wachi-yoshitaka-11-dev/deskcat/crates/README.md

# 共通Rust crate

このディレクトリには、host workspace用のlibraryを置く。

| crate | 責務 | 状態 |
|---|---|---|
| [`deskcat-protocol`](deskcat-protocol/README.md) | ESP32–Pi間のmessage型、serialization、byte列からの上限付き受信 | 作成済み（#9、#10） |
| [`deskcat-serial`](deskcat-serial/README.md) | host側のserial session。上限付きI/O、切断の観測、再接続の上限とrate limit、上限のある送信queue。**実deviceのopenは含まない** | 作成済み（#11） |
| [`deskcat-face`](deskcat-face/src/lib.rs) | `set_expression`の表情の図形（矩形の列）、受理の判定の順序、帯への分け方。LCDもSPIも知らない | 作成済み（#21） |
| [`deskcat-tap`](deskcat-tap/src/lib.rs) | ADXL345のtap検出の設定値（レジスタへ書く(address, 値)の列）、`INT_SOURCE`の読み方、`tapped`を送ってよいかの判定（boot ACK後だけ、最小間隔、製品buildはタッチの接触中と直後は送らず、見つけたtapを短く保留して接触が始まれば捨てる）。I2Cを知らない | 作成済み（#21） |
| [`deskcat-accel`](deskcat-accel/src/lib.rs) | ADXL345の連続測定（±2 g・100 Hz・FIFO Stream）の設定値（レジスタへ書く(address, 値)の列）、FIFO_STATUSとINT_SOURCEの読み方、3軸の復号、窓ごとの統計。I2Cを知らない | 作成済み（#15） |
| [`deskcat-touch`](deskcat-touch/src/lib.rs) | XPT2046の制御byteと3 byte応答の復号、raw sampleの列から触れた・離れた・撫でのeventを導く状態機械（しきい値は呼び出し側が渡す。値を持たない）。SPIを知らない | 作成済み（#14。製品buildが状態機械で撫でを判定する（#21）） |
| [`deskcat-domain`](deskcat-domain/README.md) | 感情、接触event、行動判断、純粋ロジック | 作成済み（#491） |
| `deskcat-config` | 型付き設定と検証 | 予定 |
| `deskcat-api` | 文章生成の境界とfallback動作 | 予定 |
| `deskcat-storage` | snapshot、event log、rotation、復旧 | 予定 |

各Cargo packageは、最初の着手可能なIssueを実装するときに作成する。作成したcrateはroot `Cargo.toml`の`members`へ追加する。
