wachi-yoshitaka-11-dev/deskcat/docs/hardware/README.md

# ハードウェア文書

このディレクトリは、softwareとfirmwareが必要とするハードウェア情報の正式な定義元である。

正式文書:

- `hardware-bom.md`
- `gpio-assignment.md`
- `power-budget.md`
- `servo-safety-limits.md`
- `sensor-datasheet-notes.md`
- `sd-health-check.md`
- `enclosure-and-neck.md`（#34 の設計案。方式は選定済み。現物適合は未了）
- `led-514-demo.md`（#514 の LED デモ回路案。実機での点灯試験の観察は experiment-log.md の EXP-025。継続通信の判定と赤 LED の経路は未実装）
- `experiment-log.md`（実験記録）
- `tbd-register.md`（未確定項目と解決状況の正本）

正確な部品型番、公式資料、記録済み実測値だけを使用する。不明値は`TBD`とする。

top-levelの`hardware/`は、回路図、PCB source、機構CADなど、version管理する設計sourceが存在する場合に使用する。
