wachi-yoshitaka-11-dev/deskcat/firmware/esp32/README.md

# ESP32 firmware

このディレクトリには、ESP-WROOM-32D開発ボード（秋月電子 M-13628）用のRust firmwareを置く。基板裏面silkscreenは`ESP32_DevKitc_V4`である（2026-08-15に大文字小文字を訂正。旧記載 `ESP32_DevkitC_V4`）。

専用のESP-IDF/Xtensa toolchainを使用するため、rootのhost workspaceとは別のCargo workspaceとする。

責務:

- LCD
- touch、加速度、環境sensor
- サーボPWMと強制安全上限
- JSON Lines通信
- watchdog、reset reason、診断、fail-safe動作

## 現在の状態

Issue #5 でtoolchainを固定し、最小projectのclean buildを確認した。既定の製品build（featureなし）は、Pi link、heartbeat／health snapshot、`ACCEL-01`のID読み出しとtap検出、`ENV-01`の周期測定と`environment`の送出（同じI2C busを共有する。`src/env_report.rs`）、LCDの表情描画、タッチの撫での判定を1つのmain loopで扱う（#487、#21）。表情とtapの動作は、それぞれ`face-21`と`tap-21`の試験buildから製品経路へ接続した。列挙した試験featureを指定すると試験構成を選び、従来の`tap-21,face-21,bringup-display-13`のデモを含め、各featureが有効にするI/Oは従来どおりである（ただし、`bringup-display-13`か`face-21`を含む構成は`TOUCH-CS`（GPIO21）をHighに保つ。下の「build構成と通電」の表の注記）。`bringup-i2c-15-16`は、以前のfeatureなしbuildと同じ、LCDに触れないセンサー単体試験である。構成の一覧は`src/main.rs`のmodule doc「buildの構成」節が持つ。

LCDのpinは`docs/hardware/gpio-assignment.md`の`信号inventory`が正本である。製品buildと`face-21`試験buildはLCDを初期化し、backlightを点けたまま`set_expression`の表情を描く。Pi commandを受けなくても、描ける状態になった時点で`neutral`を1回描く。`bringup-display-13`試験buildは単色fillと四隅patternを1段ずつ描く（`src/display_test.rs`）。その試験のflash・通電・目視結果は`docs/hardware/experiment-log.md`の`EXP-016`〜`EXP-018`にあるが、現在の段階描画経路と製品経路は実機で確認していない。`ACCEL-01`／`ENV-01`のID読み出しは既存のI2C driverを使う。`env-sample-16`試験buildと製品buildが、BME280のID一致後に補正係数とraw値を読み、測定設定を書いて補償値をUART0にlogする（製品buildは60 sごとに測り、session確立後に`environment`をPiへ送る。`src/env_report.rs`）。製品buildと`tap-21`試験buildは、ADXL345のIDが一致した場合だけ設定を書き、tapを検出する。`SERVO-PWM`、`ADC-*`は製品buildでは駆動しない。`TOUCH-*`は、`TOUCH-CS`（GPIO21）でLCDと同じbusのタッチを読み、撫でを判定する。`TOUCH-IRQ`（GPIO34）は使わない（下の「build構成と通電」の表の注記）。servoの安全gateは[servo-safety-limits.md](../../docs/hardware/servo-safety-limits.md)が持つ。製品buildの通電は、[Power Budget](../../docs/hardware/power-budget.md)の`製品build（featureなし）の通電の条件`が`TBD`として持つ（通電不可）。下の「build構成と通電」の表の「通電」欄は、その結果である。

`crate::led`（[#514](https://github.com/wachi-yoshitaka-11-dev/deskcat/issues/514)）は`LED-COMM`（GPIO2）と`LED-REACT`（GPIO5）を駆動する。**既定の製品buildは、起動時に両pinを出力にして消灯側へ設定し、白（GPIO2）を1秒周期で点滅させ、Piの`set_expression`で`happy`を受理したら赤（GPIO5）を1秒点ける。**LEDの2枝を配線していない台では、pinを駆動しても電流の流れる先が無い。`bringup-led-514` featureを付けた試験buildは、その前に点灯試験（赤→白→両方）を行う。`bringup-display-13`とも組み合わせられる。**白を通信成立で点灯へ切り替える判定は無い。**`BootSession::is_established`は`boot`のACKで一度立つと、Piが止まっても下りない。点灯に使うと通信喪失を示せないため、喪失を決める時間の値（`PROTO-TBD-010`／`HW-TBD-017`が未確定）が決まるまで、白は点滅のままである。赤の`happy`点灯は、`pi_link`が受理した`set_expression`だけで点く（LCDを描けない状態では拒否されるため点かない）。**この製品buildの動作は、build-onlyの確認までで、実機で動かした記録は無い。**配線と試験の手順は[led-514-demo.md](../../docs/hardware/led-514-demo.md)が持つ。実機での点灯の観察は[EXP-025](../../docs/hardware/experiment-log.md#exp-025-追加ledの点灯試験赤だけ白だけ両方)にある。

heartbeat と health snapshot は、いずれのbuildでもloopが動き続け、ESP logger の log にのみ出す（どのbuildでも出る。[#487](https://github.com/wachi-yoshitaka-11-dev/deskcat/issues/487)より前の`pi-protocol-mode`はloggingを止めており、出力されなかった。`src/console.rs`参照）。**「log へ出す」は「serial へ出ない」ではない。**logger の出力は UART0（USB）を通って serial monitor に現れる。送らないのは、protocol の message として application の serial link（#11）へ流すことである。周期は `src/config.rs` が持ち、**いずれも暫定値である**（Protocol §5.7 が heartbeat の interval を `TBD` としているため、一次資料の根拠が無い）。health snapshot は `crates/deskcat-protocol` の `Status` を組み立てて JSON 1 行として出す。**`ProtocolCounters` はすべて 0 のままである。**いずれのbuildにも`ProtocolCounters`を増やす経路が無いためである（`src/health.rs`のmodule doc参照）。

`src/protocol.rs`の`PiSession`は`hello`のsession遷移、`ping`／`get_status`への応答、`stale_session`の判定を実装し、`crates/deskcat-serial/src/peer.rs`（Pi側、Issue #12）と対になる。Pi linkを持つbuildでは、`src/pi_link.rs`の`PiLink`がPi linkのUARTから受けた行をdecodeし、`hello`／`ping`／`get_status`をこの型へ渡して応答を書き、`boot`のACKを`BootSession`へ渡す（#487）。**Pi linkはGPIOのUARTである**（`PI-UART-TX`＝GPIO13、`PI-UART-RX`＝GPIO14。pinと接続の条件の正は[gpio-assignment.md](../../docs/hardware/gpio-assignment.md)の`Pi–ESP32間のtransport`節）。`bench-servo-test-17`を有効にするbuild（`bench-servo-90-17`を含む）以外のすべてのbuild（既定buildを含む）が、UART0以外のUART（UART1）をこの2本へ割り当てて使う（[#487](https://github.com/wachi-yoshitaka-11-dev/deskcat/issues/487)。`bench-servo-test-17`のbuildは、#17の測定用buildとしてPi linkを持たない）。**既定buildも起動のたびにGPIO13をTXとして駆動し、既定buildでもJTAG debugは使えない**（gpio-assignment.mdの`PI-UART-TX`行）。**UART0（board上のUSB-UARTブリッジ、GPIO1／GPIO3）は書き込みとdebug logに使う。**例外として、`bench-servo-test-17`を有効にするbuild（`bench-servo-90-17`を含む）は、servoを動かす前に人間が入力する確認の語をstdin（UART0）から読む（[#17](https://github.com/wachi-yoshitaka-11-dev/deskcat/issues/17)。`src/main.rs`の`wait_for_bench_confirmation`）。`touch-sample-14`の試験buildも、操作の区切りの`MARK`をstdin（UART0）から別threadで読む（[#14](https://github.com/wachi-yoshitaka-11-dev/deskcat/issues/14)、`src/touch.rs`。Pi linkのUARTではない）。`debug-motion-19`の試験build（製品buildには入らない）も、`MOTION <name> <target>`の行をstdin（UART0）から別threadで読む（[#19](https://github.com/wachi-yoshitaka-11-dev/deskcat/issues/19)、`src/debug_motion.rs`。Pi linkのUARTではない）。#487より前は、UART0をbuild時のfeatureでdebug logとPi–ESP32 protocol streamのどちらかへ排他的に使っていた。詳細は`docs/protocol/esp32-pi-protocol.md`§2、`src/console.rs`参照。Pi linkを持つbuildは、`src/boot_session.rs`の`BootSession`が`boot`のACK待ち・再送・`stale_session`受信時の`sid`選び直しを行い（[#446](https://github.com/wachi-yoshitaka-11-dev/deskcat/issues/446) PR B）、受信の異常（ring bufferの満杯など）を数えてhealth snapshotの行へ出す（#487）。**Piとつないでよい場面と条件は、gpio-assignment.mdの`信号線をつないでよい条件`が持つ**（とくに条件3（つないでよい試験）と条件5（給電の構成）。ここへ書き写さない。protocolの既知の制約は`src/console.rs`）。**host testと実機での動作確認はまだ無いため、session確立の成立は主張しない**（確かめていないことは`src/pi_link.rs`のmodule doc「確かめていないこと」）。`sid`の生成方法は`src/main.rs`の`generate_sid`が決める（`PROTO-TBD-011`のうち生成方法を部分解決。PR A）。この型（`PiSession`）自体は生成方法を持たない。

| 項目 | 確定版 |
|---|---|
| Crate | `deskcat-esp32` |
| Rust target | `xtensa-esp32-espidf` |
| Rust channel | `esp-1.95.0.0`（Xtensa Rust 1.95.0.0） |
| ESP-IDF | `v5.5.3`（tools install dirは`workspace`） |
| linker | `ldproxy` |

採用根拠と確定条件は[ESP32 Rust toolchain](../../docs/toolchains/esp32-rust-toolchain.md)、導入手順は[ESP32開発端末セットアップ](../../docs/runbooks/esp32-development-machine-setup.md)、実測環境は[Version Record](../../docs/toolchains/version-records/2026-08-06-esp32-build-linux.md)にある。

## Build

**commandの正本は[検証済みコマンド](../../docs/toolchains/verified-commands.md)である。**
ESP32 Build profileの端末で、このディレクトリにて実行する。**ここへcommandを写さない**（[ADR-0018](../../docs/decisions/0018-instruction-file-structure.md)）。

`export-esp.sh`を読み込まないと失敗する。`ESP_IDF_TOOLS_INSTALL_DIR=workspace`のため、ESP-IDF本体とmanaged toolは`.embuild/`（約4.4 GB）へ展開される。`.embuild/`と`target/`は`.gitignore`で除外し、applicationの`Cargo.lock`は追跡する。

環境に`IDF_PATH`が設定されていると、`.cargo/config.toml`で選んだESP-IDF versionを上書きする。`[env]`の`force = true`はこの変数を保護できないため、**`build.rs`が設定を検出してbuildを止める。**意図した外部SDKを使う場合だけ`DESKCAT_ALLOW_EXTERNAL_IDF_PATH=1`（値は厳密に`1`。`0`や`false`では通らない）を設定して通し、出力される`cargo:warning`をVersion Recordの`IDF_PATH present`へ記録する。

**止めるのが`build.rs`とは限らない。**`IDF_PATH`の指す先が実在しない場合は、依存の`esp-idf-sys`が先に別のerror（`could not determine esp-idf version from ...`）で失敗する。どちらでもbuildは止まるが、`build.rs`のguardのmessageは出ない。実測は[Version Record](../../docs/toolchains/version-records/2026-08-06-esp32-build-linux.md)にある。

## host crateの再利用

`deskcat-protocol`、`deskcat-servo`、`deskcat-face`、`deskcat-accel`、`deskcat-tap`、`deskcat-env`、`deskcat-touch`をpath dependencyで使う。wire protocolの実装、
servoのhard limitとtrajectory limitingの実装、`set_expression`の表情の図形と受理の判定の順序、`accel-sample-15`のADXL345連続測定の設定値と復号・統計、tap検出の設定値と`tapped`の送出条件、BME280の生値と補正係数からの補償計算、`touch-sample-14`のXPT2046の制御byteと応答の復号を、
それぞれhostのtestとfirmwareで1つに保つためである。
判断の記録は[ADR-0008](../../docs/decisions/0008-firmware-protocol-crate-reuse.md)にある
（`deskcat-servo`、`deskcat-face`、`deskcat-tap`、`deskcat-accel`、`deskcat-touch`は同ADRの追記。`deskcat-env`には同ADRの追記が無い）。

```toml
deskcat-protocol = { path = "../../crates/deskcat-protocol" }
deskcat-servo = { path = "../../crates/deskcat-servo" }
deskcat-face = { path = "../../crates/deskcat-face" }
deskcat-accel = { path = "../../crates/deskcat-accel" }
deskcat-tap = { path = "../../crates/deskcat-tap" }
deskcat-env = { path = "../../crates/deskcat-env" }
deskcat-touch = { path = "../../crates/deskcat-touch" }
```

- root workspaceの`exclude = ["firmware/esp32"]`は**維持する。**lockfileはroot `Cargo.lock`と
  このディレクトリの`Cargo.lock`の2つに分かれたままでよい。
- **共有crateの`rust-version`は、host（1.97.1）とESP toolchain（rustc 1.95.0-nightly）の
  両方を満たす下限にしてある。**`crates/deskcat-protocol/Cargo.toml`、
  `crates/deskcat-servo/Cargo.toml`、`crates/deskcat-face/Cargo.toml`、`crates/deskcat-accel/Cargo.toml`、`crates/deskcat-tap/Cargo.toml`、`crates/deskcat-env/Cargo.toml`、`crates/deskcat-touch/Cargo.toml`が理由込みで宣言している。
  ここを上げるとfirmwareのbuildが`rustc 1.95.0-nightly is not supported`でcompile前に止まる。
- `crates/deskcat-protocol/**`、`crates/deskcat-servo/**`、`crates/deskcat-face/**`、`crates/deskcat-accel/**`、`crates/deskcat-tap/**`、`crates/deskcat-env/**`、`crates/deskcat-touch/**`の変更でも
  `.github/workflows/firmware.yml`が発火する。
  host側だけの変更でfirmware buildが壊れるのを検知するためである。
- `bench-servo-test-17`付きのbuildを除くbuildで、`src/servo.rs`を通って角度を出せるのは、同fileの`LimitedServo`だけである。`bench-servo-test-17`付きのbuildは、`Sg90::move_to_angle_once`でlimiterを通らずに1回動かす（`src/servo.rs`のmodule docの例外段落）。
  `bench-servo-test-17`単独の指令角は規約上の105度、派生の`bench-servo-90-17`は規約上の90度である。実機の機械的中央は未確認（`HW-TBD-010`）。buildと実行の条件は[servo-safety-limits.md](../../docs/hardware/servo-safety-limits.md#初回動作の実行手順人間とaiの作業順序)に従う。
  `Sg90`と`deskcat-servo`の`Limiter`を1つずつ所有し、`Limiter`も`Setpoint`も受理済みのtargetも
  外から受け取らず、`tick`の間隔を自分で測る。**成立の条件**（`bench-servo-test-17`の経路を除く、
  `LedcDriver`を直接作る経路は型では止められない、`unsafe`を使わない）は同fileのmodule docにある。
  **既定buildの`main()`はservoを駆動しない。**
  limiterへ渡す値（可動域、速度、加速度等）はどれも未確定であり、firmwareはまだ持たない。

`src/health.rs`がこのcrateの`Status`と`ProtocolCounters`を組み立てる。ただし**送信はしない。**
serial deviceは[#11](https://github.com/wachi-yoshitaka-11-dev/deskcat/issues/11)、
session stateとserial taskの配線は
[#12](https://github.com/wachi-yoshitaka-11-dev/deskcat/issues/12)の担当である。
現時点で示せているのは、固定toolchainで`xtensa-esp32-espidf`向けにcross compileできること、
および同crateの`status` payloadを実機上でserializeできることまでで、
**共有fixtureへの合格は主張しない。**

実機でのserializeの証拠は
[Version Recordの「2026-08-25 再検証」](../../docs/toolchains/version-records/2026-08-20-esp32-flash-boot-native.md)
にある（`status` payloadのJSON 1行と`serialize失敗 0`）。**同記録の2026-08-20の確認とは別である。**
そちらが示したのは#6の起動出力とchip名までであり、`deskcat-protocol`を呼んでいなかった。

## build構成と通電

**この表にある組み合わせについて、どのfeatureの組み合わせが、何に触れ、何を書き、通電してよいかは、この表が持つ。**表に無い組み合わせは、表の下の注記を参照する。他の文書はこの表を参照だけで指し、
build構成の説明を書き写さない（featureの一覧と、各featureが足すものは`src/main.rs`のmodule doc「buildの構成」節）。
通電の手順と条件は[Power Budget](../../docs/hardware/power-budget.md)が正本であり（`ACCEL-01`／`ENV-01`単体bring-upの手順の条件(2)は`bringup-i2c-15-16`単独、`DISP-01`追加接続の手順の条件(2)は`bringup-display-13`付きbuildを要求する。featureなしの製品buildは、同書の別の節が`TBD`を持つ）、この表の「通電」欄は、その条件を各構成に当てた結果である。

| build構成（`--features`） | LCD・backlight | ADXL345へ書く | BME280へ書く | Piへ送る | 通電（Power Budgetの手順） | 値の所在 |
|---|---|---|---|---|---|---|
| （既定・製品） | 初期化と点灯。点けたまま表情を描く。**LCDとタッチは`SpiDriver`を共有し、busは転送ごとに取る。**タッチ（`X`・`Y`・`Z1`）を20 msごとに読み、状態機械で撫でを判定する | **ADXL345のDevice IDが`0xE5`のときだけ書く**。INT線を使わず`INT_SOURCE`をI2Cで読む | **Chip IDが`0x60`のときだけ書く**（`ctrl_hum`、`ctrl_meas`。forced・×1・IIR off。60 sごとに1回測る。`src/env_report.rs`） | `boot`、ACK、`status`、`tapped`・`shaken`（IDが一致した場合）、`head_touched`（撫でと判定した場合）、`environment`（測れた量だけ。session確立後） | **不可**（`TBD`。`touch panel`の駆動電流の上界が無い。Power Budgetの`製品build（featureなし）の通電の条件`） | `crates/deskcat-face`、`crates/deskcat-tap`、`crates/deskcat-touch`、`crates/deskcat-env`、`src/touch.rs`（撫での判定の値）、`src/led.rs`（GPIO2／GPIO5。白の点滅と、`happy`を受理したときの赤の1秒点灯。上の`crate::led`の段落） |
| `no-touch-487`（単独。既定・製品の変種） | 初期化と点灯。点けたまま表情を描く（既定・製品と同じ）。**タッチは読まない** | 既定・製品と同じ | 既定・製品と同じ | 既定・製品と同じ。ただし`head_touched`は送らない | **可**（`DISP-01`追加接続の手順のうち、当てるものはPower Budgetの節が挙げる。LEDは駆動しない（GPIO2・GPIO5に触れない）。条件(7)の承認は実行する日。Power Budgetの`touchを読まない製品build（no-touch-487）の通電の条件`。実機では動かしていない） | `crates/deskcat-face`、`crates/deskcat-tap`、`crates/deskcat-env`、`src/touch.rs`の`IdleTouch` |
| `bringup-i2c-15-16` | 触れない | 書かない（Device IDを読むだけ） | 書かない（Chip IDを読むだけ） | `boot`、ACK、`status` | `ACCEL-01`／`ENV-01`単体bring-upの手順で可 | — |
| `env-sample-16`（単独） | 触れない | 書かない（Device IDを読むだけ） | **Chip IDが`0x60`のときだけ** `ctrl_hum` と `ctrl_meas` へ書き、forced測定を1回行う。raw・補償値・fault件数と、変換の所要時間（`env_conversion`）はUART0へlog | `boot`、ACK、`status`（センサー値は載せない） | **不可**（新しい書き込みを含む構成の通電手順と承認は未確定） | `crates/deskcat-env` |
| `env-sample-16-slow`（単独。`env-sample-16`を含む） | 触れない | 書かない（Device IDを読むだけ） | 上と同じ。ただしoversamplingを温度・気圧・湿度とも×16にして変換を遅くする | 上と同じ | **不可**（実機未確認） | `crates/deskcat-env` |
| `env-sample-16-repeat`（単独。`env-sample-16-slow`を含む） | 触れない | 書かない（Device IDを読むだけ） | 上と同じ（×16）。ただし変換を、最初の変換の開始から30秒、130 ms周期で繰り返す（`ctrl_meas`への書き込みも毎回）。`env_conversion`は毎回（`seq`・`started_ms`付き）、`env_raw`・`env_reading`は1回目だけ、終了時に`env_repeat_done`をUART0へlog | 上と同じ | **不可**（実機未確認） | `crates/deskcat-env` |
| `accel-sample-15`（単独） | 触れない | **Device IDが`0xE5`のときだけ**、`POWER_CTL`・`INT_ENABLE`（tapを止める）・`BW_RATE`・`DATA_FORMAT`・`FIFO_CTL`へ書き、±2 g・100 Hzの連続測定を始める。FIFOを読み、raw値と窓ごとの統計をUART0へlog | 書かない（Chip IDを読むだけ） | `boot`、ACK、`status`（センサー値は載せない） | **不可**（新しい書き込みを含む構成の通電手順と承認は未確定。2026-10-17にユーザーが承認した1回の通電が[EXP-033](../../docs/hardware/experiment-log.md#exp-033-accel-01adxl345の静止sampleaccel-sample-15の初回通電)にあり、この表の可否を変えない） | `crates/deskcat-accel`、`crates/deskcat-tap`（`INT_SOURCE`のaddress） |
| `touch-sample-14`（単独） | 初期化しない。`LCD-CS`（GPIO22）をHighに固定するだけ | 書かない（Device IDを読むだけ） | 書かない（Chip IDを読むだけ） | `boot`、ACK、`status` | **不可**（`EXP-038`はこの表の「不可」のまま、条件6つを満たさずにユーザーの承認を得て1回書き込んだ。touch用5本は`EXP-041`の終わりに足した状態のまま（同記録の「終わりの状態」）で、その後の現物は確認していない。`EXP-041`も同じく「不可」のまま、ユーザーの承認を得て1回書き込んだ。実機に書き込んだのはdevelop `79f29ea`の版（`EXP-038`）とdevelop `b9a04e8`の版（`EXP-041`。`T_IRQ`の変化と`MARK`のlog、busの持ち方の置き換えを含む）である。Power Budgetにこの構成の手順が無い。LCD module上のXPT2046はLCDのVCCで動くため、LCDのVCCを抜いたまま起動しない。実機側でユーザーの新たな承認が要る） | `crates/deskcat-touch`、`src/touch.rs` |
| `touch-lcd-14`（単独） | 初期化と点灯。表情を帯ごとに塗り続ける。**LCDとタッチは`SpiDriver`を共有し、busは転送ごとに取る**（製品buildも同じ型。握り続ける型は`touch-sample-14`だけ） | 書かない（Device IDを読むだけ） | 書かない（Chip IDを読むだけ） | `boot`、ACK、`status`。`set_expression`は`hardware_unavailable`で拒否する | **不可**（`EXP-041`はこの表の「不可」のまま、ユーザーの承認を得て1回書き込んだ（develop `b9a04e8`の版）。LCDのVCC・9本・touch用5本が挿さった構成の手順と承認が要る。Power Budgetにこの構成の手順が無い） | `crates/deskcat-touch`、`crates/deskcat-face`、`src/touch_lcd.rs` |
| `debug-motion-19`（単独。製品buildには入らない） | 触れない | 書かない（Device IDを読むだけ） | 書かない（Chip IDを読むだけ） | `boot`、ACK、`status`。UART0のconsoleから読んだ`MOTION <name> <target>`は、servoを駆動せず、catalogが空のため全て拒否する。`set_expression`は`hardware_unavailable`で拒否する | **不可**（Power Budgetにこの構成の手順が無い。実機では動かしていない） | `src/debug_motion.rs`、`crates/deskcat-servo` |
| `bringup-display-13` | 初期化と点灯。fillと四隅patternの後に消灯 | 書かない | 書かない | 同上 | `DISP-01`追加接続の手順で可 | — |
| `face-21` | 初期化と点灯。点けたまま表情を描く | 書かない | 書かない | 同上。`set_expression`に受理のACKを返しうる | **不可**（`ACCEL-01`／`ENV-01`単体の手順は`bringup-i2c-15-16`単独限定、`DISP-01`の手順は`bringup-display-13`必須） | `crates/deskcat-face` |
| `face-21,bringup-display-13` | bring-upの後も点灯のまま表情を描く（bring-upの間は`set_expression`を`busy`で拒否） | 書かない | 書かない | 同上 | `DISP-01`追加接続の手順で可（条件(7)の承認は実行する日） | `crates/deskcat-face` |
| `tap-21` | 触れない | **ADXL345のDevice IDが`0xE5`のときだけ書く**（`deskcat_tap::shake::registers`。`SHAKE`が`Some`なら8件。一致しなければ何も書かず、Device IDを読むだけ）。INT線は使わず`INT_SOURCE`をI2Cで読む | 書かない | `boot`、ACK、`status`、`tapped`・`shaken`（Device IDが`0xE5`でなければどちらも送らない） | **不可**（`ACCEL-01`／`ENV-01`単体の手順は`bringup-i2c-15-16`単独限定） | `crates/deskcat-tap` |
| `mem-probe-23,face-21,tap-21`（#23の計測用。製品buildと同じ構成（タッチの撫での判定と`ENV-01`の周期測定・`environment`の送出を除く）にlogを足す） | 初期化と点灯。点けたまま表情を描く（製品buildと同じ）。タッチは読まない（製品buildと違う） | **ADXL345のDevice IDが`0xE5`のときだけ書く**（製品buildと同じ） | 書かない（Chip IDを読むだけ） | `boot`、ACK、`status`、`tapped`・`shaken`（IDが一致した場合）。`show_text`と`set_expression`を受理する。`environment`は送らない（周期測定は製品buildだけ） | **不可**（`DISP-01`追加接続の手順の条件(2)は`bringup-display-13`を要求し、製品buildの節（Power Budgetの`製品build（featureなし）の通電の条件`。`TBD`）の対象でもない。この構成の通電は、ユーザーの承認が要る） | `src/mem_probe.rs`。health snapshotと同じ周期（10秒）で、空きheap、起動からの最小の空きheap、main taskのstackのhigh water markを1行logへ出す。**この構成だけが`unsafe`を持つ**（`main.rs`の先頭の`cfg_attr`。製品buildは`forbid(unsafe_code)`のまま） |
| `tap-21,face-21,bringup-display-13`（デモ用） | `face-21,bringup-display-13`と同じ | `tap-21`と同じ（Device IDが`0xE5`のときだけ書く） | 書かない | 上の全部。ただし`head_touched`と`environment`は送らない（撫での判定と`ENV-01`の周期測定・送出は既定・製品だけ） | `DISP-01`追加接続の手順で可（条件(7)の承認は実行する日） | `crates/deskcat-face`、`crates/deskcat-tap` |

**LCDを点けるbuild（既定・製品と、`bringup-display-13`か`face-21`を含む構成）は、`TOUCH-CS`（GPIO21）をHighに保つ**（転送の間だけLowにする）。この段の構成のうちタッチを読むのは既定・製品だけで（`src/touch.rs`の`StrokeDetector`。`no-touch-487`付きは`IdleTouch`で読まない）、`bringup-display-13`か`face-21`を含む構成は読まない（`IdleTouch`）。`touch-sample-14`・`touch-lcd-14`は別の型でタッチを読む（上の表）。GPIO21には外部10 kΩのpull-upがあり、High はその電気的な状態と同じ側である。

この表に無い組み合わせ（`bringup-led-514`、`bench-servo-test-17`・`bench-servo-90-17`（`bench-servo-test-17`を含む）、`debug-motion-19`と`face-21`・`tap-21`・`bringup-display-13`との組み合わせなど）は対象外であり、この表は通電の可否を決めていない。`bringup-led-514`は、2026-10-12にユーザーが承認した条件（LEDの2枝を足して通電すること。書き込みと各回の通電）で、ESP32単体へ通電した。承認と観察は[led-514-demo.md](../../docs/hardware/led-514-demo.md)と[EXP-025](../../docs/hardware/experiment-log.md#exp-025-追加ledの点灯試験赤だけ白だけ両方)にある。
`tap-21`が足す負荷（測定modeの`ACCEL-01`の約140 µA typ）の扱いは、Power Budgetの`face-21`の常時点灯の段落が持つ。
**揺れ（`shaken`。Protocol §4.3a、#685）の検出は、`deskcat_tap::shake::SHAKE`の暫定の値で有効になる**（値と根拠、確かめていないことは`deskcat_tap::shake`が持つ。`None`なら有効にならず、Activityを設定せず、`shaken`も送らない）。実機で`shaken`がPiへ届くことは確かめていない。
デモのジェスチャは、`tap-21`では「撫でる」ではなく「指で、ADXL345のモジュールを軽く叩く」である（閾値の根拠は`crates/deskcat-tap`）。

## 未確定の前提

機種と搭載moduleは確定している（ESP-WROOM-32D開発ボード／秋月電子 M-13628。基板にrevision表示は無い）。根拠は[hardware-bom.md](../../docs/hardware/hardware-bom.md)のMCU-01である。

**公式pin表と現物pin表記の照合は2026-08-15に完了し、[HW-TBD-001](../../docs/hardware/tbd-register.md)はcloseした**（38pinヘッダ両側のsilkが公式`J2`／`J3`と19pin×2列すべてで一致した）。照合先は[ESP32-DevKitC V4公式回路図](https://dl.espressif.com/dl/schematics/esp32_devkitc_v4-sch.pdf)と公式guideのpin description表である（秋月商品ページの添付はモジュールとチップのdatasheetのみで、boardのpin配列表を含まない）。GPIO割り当ては[gpio-assignment.md](../../docs/hardware/gpio-assignment.md)の`信号inventory`に従う。**中核chipの識別（`HW-TBD-031`）は2026-08-20に満たした。**中核chipは半田付けされた金属シールドの内側にあり刻印を読めないため、要件は2026-08-15にesptoolの報告で満たす形へ再定義され（[esp32-rust-toolchain.md](../../docs/toolchains/esp32-rust-toolchain.md)の`chip識別の満たし方`）、#6のflash時に`esptool`が`ESP32-D0WD`を報告した。**値と未加工の出力はそちらとVersion Recordが持ち、ここへ再掲しない。**

ESP-WROOM-32D datasheet v2.7にはPSRAM内蔵variantの記載が無いため、PSRAMを前提とする設定は不要である。

**flash、serial monitor、実機起動は2026-08-20に#6で実施した**（記録は[Version Record](../../docs/toolchains/version-records/2026-08-20-esp32-flash-boot-native.md)）。**確認したのは起動出力とchip名までであり、周辺回路とservoには触れていない。****USB抜き差しによる電源再投入後の起動出力は未検証である**（host側のserial portがUSB enumerate後にしか存在せず、その時点で起動出力が終わっているため。再現は`espflash`のresetによる4回で示した）。

**Issue #13の`DISP-01`driverのこの版そのものは、ESP32 Build profile端末でのbuild確認までである**（書き込んだのは`EXP-018`のB2である。driver（`src/display.rs`）は、B2と同じcommandの列を送る版として`EXP-018`の後にcommitしたものであり、それ自体は書き込んでいない。#487からbring-upの描画は帯ごとにCASET／PASET／RAMWRを送るため、bring-up全体として送るcommandの列はB2と同じではなく、実機では動かしていない）。flash・実機通電はESP32 Flash / HIL profile端末と人間の監視を要する（[Hardware Safety Policy](../../docs/governance/hardware-safety-policy.md)、初回通電）。実機での結果（単色fillの色、color order、四隅と向き、更新timing。controllerのIDは読まない）は`docs/hardware/experiment-log.md`の`EXP-016`〜`EXP-018`にある。
