wachi-yoshitaka-11-dev/deskcat/crates/deskcat-storage/README.md

# deskcat-storage

感情snapshot、event log、発話履歴、rotation、atomic update、破損復旧を扱う永続化libraryとして計画している。

Raspberry Piのストレージに適した書込み量を維持する。
