wachi-yoshitaka-11-dev/deskcat/docs/hardware/sensor-datasheet-notes.md

# Sensor and Display Datasheet Notes

> 状態: Blocked — 正確なmoduleの現物確認が必要
> 正本とする情報: Driverに必要な、データシート由来のdevice動作
>
> **公開specから確定する欄は2026-08-10に埋めた。**残る`TBD`は次のいずれかである。
> (a) 現物確認が要るもの（jumper状態、address、backlight回路）。**touch controller型番は2026-08-13に`XPT2046`と確定した**、**backlight回路は2026-09-05に`U1`の3本足（入力／GND／出力）を確定し、`LED` pinが公式User Manualの定める制御信号線であることも確認した。ただしLEDへの給電ライン（`VCC`側か`U1`出力側か）は引き続き未確定。LED個数はカプトンテープに隠れ非分解では未確認のまま残る**、
> (b) メーカーが公開していないもの（MSP2807のSPI mode／max clock、初期化sequence、消費電流）、
> (c) bench試験で決めるもの。**推定で埋めない**（[AGENTS.md](../../AGENTS.md) 推測禁止）。

## 使用方法

物理moduleごとに一つのsectionを完成させる。ICのデータシートとmodule board文書の両方を記録する。候補例をもとにsectionを埋めない。

各文書について次を記録する。

- メーカー
- 正確なmodelとsuffix
- 文書名
- Revision／date
- 公式URL
- 関連page／table
- Module回路図／pinout
- 現物識別の根拠

## LCD module

出典: メーカーdatasheet [`msp2807.pdf`](https://akizukidenshi.com/goodsaffix/msp2807.pdf)（[秋月商品ページ](https://akizukidenshi.com/catalog/g/g116265/) 添付、revision表記なし）、
[LCD Wiki MSP2807](http://www.lcdwiki.com/2.8inch_SPI_Module_ILI9341_SKU:MSP2807)。2026-08-10取得。
controllerの挙動は`ILI9341 Datasheet V1.13`（Ilitek、2011-08-05）による。2026-08-12取得。
**Ilitek公式の配布先は見つかっていないため、[Adafruitがhostする版](https://cdn-shop.adafruit.com/datasheets/ILI9341.pdf)を開いた**
（PDF metadataのTitleが`ILI9341_DS_V1.13_20110805.doc`。245page）。**mirrorであり、公式配布物との同一性は確認していない。**

> **module datasheetとcontroller datasheetが矛盾する箇所がある**（`DC/RS`の極性）。
> **その1箇所については後者を正とする。**理由は下表の`Data／command動作`欄に記す。

| 項目 | 値 |
|---|---|
| Module識別情報 | MSP2807（touch付。touch無しは MSP2806）。PCB 50.0×86.0 mm、AA 43.2×57.6 mm（datasheet記載のまま） |
| Controller IC | `ILI9341` |
| 解像度 | **現物silkは`2.8 TFT SPI 240X320 V1.2`である**（2026-08-13確認。パネルは`HSD028309 A2`）。[hardware-bom.md](hardware-bom.md) DISP-01の`240×320`と一致する。**一方メーカーdatasheetの表記は`320×240`で向きが逆である。**向きの取り方の違いと思われる。**firmwareは横向き（論理座標320×240、MADCTL `0x28`）を基準にする**（[experiment-log.md](experiment-log.md)の`EXP-018`。下の`対応orientation command`行） |
| Color format／order | RGB 65K color（16 bit/pixel、RGB565）。**2つを分けて記録する。**(1) byte order: 1 pixelを上位byteから送る（big-endian）。`0xF800`（赤）・`0x07E0`（緑）・`0x001F`（青）が、それぞれ赤・緑・青に表示された（[experiment-log.md](experiment-log.md)の`EXP-018`の写真）。(2) 色の並び: **BGR**。MADCTL（36h）の`BGR`（B3）が0のままでは赤と青が入れ替わり（`EXP-016`）、`BGR=1`で正しい色になった（`EXP-017`の目視、`EXP-018`の写真） |
| Interface | 4-wire SPI（14pin。LCDとtouchでbusを共有し、CSを分ける） |
| 供給電圧 | VCC 3.3–5 V |
| Logic電圧 | **3.3 V TTL**。`hardware-bom.md` DISP-01のとおり、5 V給電時の出力levelがメーカー資料で不明なため3.3 V給電とする |
| SPI mode／max clock | TBD（datasheetに記載なし。**現物のbench試験で確認する**） |
| Reset polarity／timing | polarityは**low activeでreset**（`RESET` pin）。timingはTBD |
| Chip-select timing | `CS`は**low activeで有効**。timingはTBD |
| Data／command動作 | `DC/RS` pin。**`low`＝command、`high`＝data。**`ILI9341 Datasheet V1.13`が`When DCX = '1', data is selected. When DCX = '0', command is selected.`と定め、4-line serial interfaceの節も`If the D/CX bit is "low", the transmission byte is interpreted as a command byte`と一致する。**MSP2807のメーカーdatasheetは`high level: register, low level: data`と逆に記載しているが、この値は採らない。**`DC/RS`はcontrollerの`D/CX`へ直結し、送出byteの解釈を決めるのはILI9341であるためである（この表の`Controller IC`欄のとおり、本moduleのcontrollerはILI9341である）。**現物での確認はLCD bring-up（[#13](https://github.com/wachi-yoshitaka-11-dev/deskcat/issues/13)）のbench試験で行う** |
| Backlight回路／電流／polarity | polarityは**highで点灯**（datasheet記載）。**回路と電流は未公開**であり、datasheetの`Power Consumption`欄は`TBD`と印字されている。**`LED` pinは公式User Manual（LCDWIKI、`2.8inch_SPI_Module_MSP2807_User_Manual_EN.pdf`、Interface Description表、Pin 8）が「LCD backlight control signal (high level lighting, if you do not need control, please connect 3.3V)」と定めており、電源ラインではなく制御信号線である。**`akizukidenshi.com`配布の`msp2807.pdf`（`Power Consumption`欄が`TBD`）とは別文書であり、2026-09-05に新たに参照した。**2026-09-05に現物の非通電導通測定を行った。**`LED` pinと`VCC` pinの間は導通なし（オーバーレンジ）であることを確認した。`U1`（3.3V LDO、刻印`662K`／`UMW S4T`）の3本足を識別した: 1本は`VCC`と導通（入力側）、1本は`GND`と導通（安定した再測定で確認）、残る1本はどちらとも非導通（出力側、消去法）。`LED` pinは、`VCC`および`U1`の3本の足のいずれとも導通しない（オーバーレンジ）ことを確認した。**これは`LED` pinが上記の通り制御信号線であることと整合する。****実際の物理LEDへ電力を供給しているライン（`R5`の先）が`VCC`側か`U1`出力側かの特定は試みたが、決められなかった。**`R5`（6.8Ω、部品が小さく確実にプローブを当てられない）の両脚は`VCC`・`U1`出力側のいずれとも非導通と読めたが、部品サイズから読み取りの信頼性が低い。代わりに`Q1`（SOT-23、刻印`J3Y`）の3本足で`VCC`・`U1`出力側との導通を試みたが、3本とも両方に非導通だった。**`Q1`はトランジスタであり、非通電・単純な抵抗測定では接合の向き次第で導通を示さないため、この方法では判定できないと判断した。**したがって、backlightのLED給電経路が`VCC`側か`U1`出力側かは、非通電の導通測定では確定できないと結論する。LED個数と、`R5`／`R6`／`Q1`／`J1`を経た正確な電流経路はパネル端のカプトンテープに隠れており未確認のまま（分解を要するため確認しない）。**配線方法はここに書かない。**配線規則の正本は[power-budget.md](power-budget.md)であり、ここへ再掲しない。接続可否と阻害対象の現在状態は[HW-TBD-024](tbd-register.md#hw-tbd-024)、[以前の接続判断の記述](tbd-register-history.md#sensor文書の接続判断の旧記述)を参照する |
| 初期化sequence | TBD（datasheetに記載なし） |
| 対応orientation command | MADCTL（36h、`ILI9341 Datasheet` §8.2.29の`MY`／`MX`／`MV`）。DeskCatの判定の向き（横向き320×240、14 pinの`J2`のheaderを右の辺。[#13の判断(2)](https://github.com/wachi-yoshitaka-11-dev/deskcat/issues/13#issuecomment-5860773100)）では**`0x28`**（`MV=1`、`BGR=1`、他は0）で、論理座標の原点が左上、`x`が右、`y`が下へ増える。`MV=0`で描いた生の座標の向きから§9.3（p.208）の表で決め、`0x28`で四隅が一致することを写真で確かめた（`EXP-018`）。値の置き場所は`firmware/esp32/src/display.rs`の`MADCTL_LANDSCAPE`。**[#34](https://github.com/wachi-yoshitaka-11-dev/deskcat/issues/34)の仮筐体で頭への載せ方が決まったら見直す** |
| Readback機能 | `SDO(MISO)`あり。**read機能が不要なら未接続でよい**とdatasheetが明記。**実機では、IDの読み出しが期待する値を返さなかった**（D3hは`EXP-016`〜`EXP-018`、DAh〜DChは`EXP-018`。`EXP-018`ではすべて`00`）。firmwareは読み出しを行わない（`firmware/esp32/src/display.rs`のmodule doc） |
| 電源投入後に必要なdelay | TBD |
| 動作／保存温度 | 動作 -20〜60 ℃、保存 -30〜70 ℃ |
| Driver／library候補 | TBD |

### pin定義（datasheet記載、14pin）

| No. | ラベル | 説明 |
|---|---|---|
| 1 | `VCC` | 5V／3.3V power input |
| 2 | `GND` | Ground |
| 3 | `CS` | LCD chip select（low有効） |
| 4 | `RESET` | LCD reset（low有効） |
| 5 | `DC/RS` | command（`low`）／data（`high`）選択。**メーカーdatasheetの14pin表は逆に記載している**（上表`Data／command動作`欄を参照） |
| 6 | `SDI(MOSI)` | SPI write |
| 7 | `SCK` | SPI clock |
| 8 | `LED` | backlight制御（high点灯） |
| 9 | `SDO(MISO)` | SPI read（不要なら未接続可） |
| 10 | `T_CLK` | touch SPI clock |
| 11 | `T_CS` | touch chip select（low有効） |
| 12 | `T_DIN` | touch SPI input |
| 13 | `T_DO` | touch SPI output |
| 14 | `T_IRQ` | touch割り込み（touch検出時low） |

### pin定義（LCDWiki公式User Manual原文、9pin。touch用5pinを除く）

**上のpin定義表はメーカーdatasheet（`msp2807.pdf`）を出典とする。**この節は同じ9pinについて、
**別文書であるLCDWiki公式User Manual**（`2.8inch_SPI_Module_MSP2807_User_Manual_EN.pdf`、
sha256 `0e0d3e57ca24213841907d845e509545819ec7303f0f43584c521a3f57a1d72c`。`Backlight回路／電流／polarity`行が
2026-09-16取得として既に引用しているものと同一file。**2026-09-22に再取得し、sha256の一致で
同一性を確認した**）の`Interface Description`表（3〜4ページ）を、原文のまま並べる。
**記憶で埋めず、資料の記載だけを根拠にする（[#13](https://github.com/wachi-yoshitaka-11-dev/deskcat/issues/13)）。**

| No. | Module Pin | 原文（User Manual, Interface Description表） |
|---|---|---|
| 1 | `VCC` | LCD power supply is positive (3.3V~5V) |
| 2 | `GND` | LCD Power ground |
| 3 | `CS` | LCD selection control signal |
| 4 | `RESET` | LCD reset control signal |
| 5 | `DC/RS` | LCD register / data selection control signal |
| 6 | `SDI(MOSI)` | LCD SPI bus write data signal |
| 7 | `SCK` | LCD SPI bus clock signal |
| 8 | `LED` | LCD backlight control signal (high level lighting, if you do not need control, please connect 3.3V) |
| 9 | `SDO(MISO)` | LCD SPI bus read data signal (can not be connected if not needed) |

**同User Manualはこの9pinについて、ESP32向けの推奨接続例を持たない**（掲載されている
接続例はArduino UNO／MEGA2560、STC89C52RC／STC12C5A60S2、STM32F103の4種のみであり、
ESP32は無い）。**したがってESP32側のGPIO割り当てはこの節では決めない。**正本は
[gpio-assignment.md](gpio-assignment.md)の`信号inventory`である（`LCD-SCLK`=GPIO18、
`LCD-MOSI`=GPIO23、`LCD-MISO`=GPIO19、`LCD-CS`=GPIO22、`LCD-DC`=GPIO17、
`LCD-RST`=GPIO16、`LCD-BL`=GPIO4。**ここへ再掲しない**）。**`VCC`／`GND`は`信号inventory`に
現れない**（ESP32の`3V3`／`GND` pinとの電源経路であり、信号pinではないため）。この経路の
安全条件は[power-budget.md](power-budget.md)と[tbd-register.md](tbd-register.md)の
`HW-TBD-024`が正本である。

必要なベンチ試験の根拠:

- 単色fill
- Color-order pattern
- 四隅の座標pattern
- Rotation
- 全体更新と部分更新の時間
- Touchとserialがactiveな状態での動作
- **`DC/RS`の極性**（module datasheetとcontroller datasheetで記載が逆であるため）

## Touch controller

出典: moduleは上記と同じdatasheet（`msp2807.pdf`。**controllerの型番は記載が無い**ため、
**型番は2026-08-13に現物chip刻印で`XPT2046`と確定した**。追跡は[tbd-register HW-TBD-003](tbd-register.md)）。
**controllerの挙動は、メーカー（SHENZHEN XPTEK TECHNOLOGY CO.,LTD）の`XPT2046 Data Sheet`による。**
表紙は`2007.5`、全30ページ。

- URL: `https://grobotronics.com/images/datasheets/xpt2046-datasheet.pdf`（販売店のmirror。XPTEKの配布先`http://www.xptek.com.cn`は表紙・頁脚に書かれているが、今回は取得していない）
- sha256: `90d1c9dcf8c53fc79e40c53f5045c3b6d7634826daece83326ff80e6076bc6c4`
- 取得日: 2026-10-21（HTTP 200、`application/pdf`、810641 byte）。PDF metadataのCreatorは`Google`、CreationDateは2013-10-31であり、**PDFの作成日は版（2007.5）の根拠にならない。版は表紙の表記による**
- **mirrorであり、XPTEK公式配布物との同一性は確認していない。**gpio-assignment.mdが既に引く`XPT2046 Datasheet（2007.5）`と同じ表記の版である
- **TIの`ADS7843` datasheetなど別ICの資料は、この節の値の根拠にしていない。**datasheet自身が`ADS7843`との互換に言及する箇所（`Internal Reference`、p.15）は、`XPT2046`の挙動の記述として読んだだけである
- **資料の欠陥**（読み取りの注意）: (1) 表4（p.15、`VBAT`／`AUXIN`／`TEMP`を含む表）の見出しが`Differential Reference Mode (SER/DFR low)`となっているが、同じ頁の表5と同じ文言であり、本文が「差動modeは`X`・`Y`・圧力の測定だけに使える。他は単一端modeを要する」と書くこととも合わない。**表4は単一端（`SER/DFR`＝1）の表の誤記と読む**（本文に基づく読み。資料内の訂正は無い）。(2) pin表（p.9）の`DOUT`の説明が`This output is high`で終わり、文が途切れている。(3) 本文は表を`Table 3`／`Table 1`などと番号がずれて参照している（`Control Byte`節が制御bitの表を`Table 3`と呼ぶが、実際の表番号は6）。**この節は表の番号ではなく、表の見出しと中身で引く**

**メーカー自身のsiteから、もう1つの版を取得した（2026-11-10、[#487](https://github.com/wachi-yoshitaka-11-dev/deskcat/issues/487)）。電源電流の行（下表）だけがこの版による。**

- URL: `http://www.xptek.com.cn/uploadfile/download/201707171401161883.pdf`（XPTEK（深圳市矽普特科技有限公司）のsite。製品一覧にあるXPT2046の製品ページ`productview.asp?id=326`の「用户手册」のlink先）
- sha256: `4041f60a16fe76523a53b689b2276b83b70844e48553c75a171622ed4a982073`
- 取得日: 2026-11-10（HTTP 200、`application/pdf`、1561902 byte、26ページ）。PDF metadataのModDateは2017-07-17、CreationDateは2011-12-06であり、**版の根拠にしない**（表紙に版の表記は読めなかった）
- **中国語の資料で、上の2007.5の版（mirror）と同じ版かどうかは照合していない**（mirrorの再取得は403で、今回は比べられなかった）。**この節のほかの行は引き続き2007.5の版による。2つの版の間で値が違うかも確かめていない**
- 品の特定: moduleの現物`U2`の刻印が`XPT2046`（上の`Module／controller識別情報`行）。メーカーのsiteの資料なので、`hardware-safety-policy.md`の分類では甲に当たる。ただし**刻印の`XPT2046`と、この資料の`XPT2046`（`-90`版かどうかを含む）が同じ品かは、刻印だけでは確かめられていない**

**下表の値のうち、「導出」と書いたものは、資料の記載から読んだ結果であり、資料が明記した値ではない。**
実機で確かめるまでは、導出と明記したまま扱う。

| 項目 | 値 |
|---|---|
| Module／controller識別情報 | Moduleは MSP2807（DISP-01と同一）。**controller ICは`XPT2046`（確定）。**現物裏面`U2`（TSSOP-16）の刻印を2026-08-13に読み取った（`XPT`ロゴ、`XPT2046`、ロット`ABDEAB`）。**メーカーdatasheetには型番の記載が無いため、刻印が唯一の根拠である**。`-90`版（`PENIRQ`のpull-upが約90 kΩ）かどうかは刻印からは判別していない |
| Touch方式 | **4線式抵抗膜のtouch screen controller。**12 bit・125 kHz samplingのSAR型ADCを内蔵する（`General Description`、p.3）。入力は`XP`／`YP`／`XN`／`YN`の4線、ほかに`VBAT`・`AUX`・温度（温度は`MUX`経由） |
| Interface | SPI（LCDとbusを共有し、`T_CS`で分ける）。信号は`T_CLK`／`T_CS`／`T_DIN`／`T_DO`／`T_IRQ`。**資料の端子名は`DCLK`／`CS`／`DIN`／`DOUT`／`PENIRQ`であり、`BUSY`も持つが、14pinのmoduleには`BUSY`の端子が出ていない**（module側の対応は`pin定義`表） |
| 供給／logic電圧 | DISP-01と同一（VCC 3.3–5 V、logic 3.3 V TTL）。**ICの規格は、`+VCC`が`Specified Performance`で2.7–3.6 V、`Operating Range`で2.2–5.25 V、`IOVDD`が1.5 V〜`VCC`**（`Electrical Characteristics`、p.6）。**3.3 V給電は`Specified Performance`の範囲内である** |
| 電源電流（`VCC`と`IOVDD`の合計） | **XPTEK site版（2026-11-10取得）の`表1 XPT2046電気特性表`による。**条件は`VCC`＝+2.7 V、`fSAMPLE`＝125 kHz、`fCLK`＝2 MHz、内部参考電圧2.5 V。**静止電流**: 内部参考off、typ 280 µA・max 650 µA。内部参考on、780 µA（max欄なし）。`fSAMPLE`＝12.5 kHzで220 µA。power-down（`CS`＝`DCLK`＝`DIN`＝`IOVDD`）3 µA。同じ頁の図（p.8）は、`VCC`＝3.3 V付近・125 kHzで約280 µA、`IOVDD`側は約30 µAを示す（図から読んだ概数）。**`CS`をhighにすると直ちにpower-downに入り、変換は打ち切られる**（`PD`＝00は変換の間だけ上電する。同資料の電源管理の節）。**touch panelの駆動**: 駆動switchの導通抵抗`YP`・`XP`が5 Ω、`YN`・`XN`が6 Ω、`X`・`Y`の駆動電流は100 ms保持で50 mA（同表の注2は「50 mAを超えない」）。**touch panelの層の抵抗は、この資料にも本repositoryにも無い**。`PENIRQ`のpull-up（公称50 kΩ）は上の`IRQ polarity／type`行 |
| AddressまたはSPI mode | **Mode 0（`CPOL=0, CPHA=0`）。導出。**(a) `DIN`は`DCLK`の立ち上がりで取り込まれる（pin表、p.9`If CS is low, data is latched on the rising edge of DCLK`）。(b) `DOUT`は`DCLK`の立ち下がりで出る（同`Data is shifted on the falling edge of DCLK`、`tDO`＝`DCLK`の立ち下がりから`DOUT`有効まで最大200 ns、`Table 9`）。(c) Figure 12（p.23）の`DCLK`は`CS`がlowになった後、先頭のclockが立ち上がるまでlowである（idle low）。**資料は「Mode 0」という語を使っていない。**addressは無い（`CS`で選ぶ） |
| 検証済み最大bus速度 | **検証済みは無い（TBD。実機で`DOUT`が読めることを確かめる）。**資料から導ける上限は**2.5 MHz**（`tCH`＝`DCLK` high最小200 ns、`tCL`＝`DCLK` low最小200 ns、`Table 9`から周期400 ns以上。導出）。電気特性表の測定条件は`fCLK = 16 × fSAMPLE = 2 MHz`（`fSAMPLE`＝125 kHz）。**8 bit modeでは「clockを最大50 %速くできる」と資料は述べる**（`8-Bit Conversion`、p.29）が、`試験build`は使わない。`15 clocks-per-conversion`は、ほとんどのMCUのserial interfaceでは1回の転送を15 clockにできないと資料が書く（p.28）ため、使わない。`16 clocks-per-conversion`の重ねる方式（p.26）も、1回24 clockの転送を重ねないこの試験buildは使わない |
| IRQ polarity／type | **touch検出時にlow。**`PENIRQ`はactive lowで、`X+`入力が`Y−`側（power-down中は`Y−`switchがon）へtouch screenを介して引かれることでlowになる（`PENIRQ Output`、p.24）。**内部pull-up付きの出力**（公称50 kΩ、36 k〜67 kΩ。`logic low 0.35 × (+VCC)`を保証するには`X+`と`Y−`の間の合成抵抗が21 kΩ未満。**`-90`版は公称90 kΩで30 kΩまで**）。**edge／levelの語は資料に無い。**動作は、touch中lowが保たれるlevel出力と読める（導出）。**測定中の動作: `X`／`Y`／`Z`測定のあいだ`PENIRQ`は無効でlowになり、`VBAT`／`AUX`／温度の測定のあいだは無効でhighになる。**最後の制御byteが`PD0=1`だと`PENIRQ`は無効のままである。**資料は、制御byteを送るあいだ`PENIRQ`に結ぶ割り込みをmaskするよう勧める**（`PENIRQ Output`）。**試験buildはISRを使わず、`T_IRQ`のlevelをpollする** |
| 制御byte | `S`（bit7、常に1）\|`A2 A1 A0`（bit6–4）\|`MODE`（bit3。0＝12 bit、1＝8 bit）\|`SER/DFR`（bit2。0＝差動、1＝単一端）\|`PD1 PD0`（bit1–0）（表6）。`PD`: `00`＝変換ごとにpower-down（`PENIRQ`有効。**最初の変換から有効**）、`01`＝reference off・ADC on（`PENIRQ`無効）、`10`＝reference on・ADC off（`PENIRQ`有効）、`11`＝常時電源on（`PENIRQ`無効）（表8）。**差動modeで`X`・`Y`・圧力を測るチャネル（表5）: `A2 A1 A0`＝`001`が`Y`位置、`101`が`X`位置、`011`が`Z1`、`100`が`Z2`。**12 bit・差動・`PD=00`にすると制御byteは、`Y`＝`0x90`、`X`＝`0xD0`、`Z1`＝`0xB0`、`Z2`＝`0xC0`（導出。bit配置から組み立てた値であり、資料が16進で示した値ではない） |
| Raw出力 | **12 bit、straight binary**（`DIGITAL INPUT/OUTPUT`表の`Data Format`、`Data Format`節）。8 bit modeもある（`MODE=1`）。**1回の変換は8 clockの転送3回（計24 clock）。**1回目の8 clockで制御byteを送り（`DOUT`は無視する）、変換結果は2回目の転送から`DOUT`へ上位bitから出る（Figure 12）。**24 clockの転送のbit位置は、図の`DOUT`が、制御byteの後でまだ`BUSY`の区間を示すlowの後に`11`から始まることと、`DOUT`が立ち下がりで変わる（Mode 0でmasterが立ち上がりで読む）ことからの導出である:** 2回目の転送の先頭bitは0、続く7 bitが`D11`〜`D5`、3回目の転送の上位5 bitが`D4`〜`D0`で、残りは0。したがって12 bitの値は`((rx[1] << 8) \| rx[2]) >> 3`と読める（**資料にこの式は無い。導出であり、実機で、復号した値がtouch無しとtouch有りで妥当な範囲に収まること（例: 上位bitを落とした値と比べて、`>> 3`が12 bitの全範囲を使うこと）を確かめるまで確定しない**） |
| 座標／強度の動作 | `X`・`Y`は差動modeで測る（`ratiometric`。資料が推奨）。**圧力は`Z1`と`Z2`（または`X`・`Y`・`Z1`）から接触抵抗を求める**（`Pressure Measurement`、p.20。式(3)`Rtouch = RX-plate × X-Position/4096 × (Z2/Z1 − 1)`、式(4)）。**`RX-plate`（`X`面板の抵抗）はmoduleのtouch panelについて未測定であり、TBD。**資料は圧力の測定に8 bit modeを勧める（「高い性能は要らない」） |
| Reset／起動sequence | **reset端子は無い。**電源投入後は、`CS=0`かつ`DCLK=IOVDD`で立ち上げるのでなければ、制御byteに`PD0=0`を書くまで約20 µAを流す（`Power Dissipation`、p.30）。**電源投入後は`PD1=0`の書き込みでreferenceをoffにする必要がある**（`Internal Reference`、p.15。`ADS7843`との互換のため、後の書き込みなしにはoffにならない）。**`PD=00`の制御byteを送れば両方を満たす。**`CS`がhighになると変換を打ち切ってpower-downに入る（internal referenceはoffにならない） |
| 変換timing | `tACQ`（acquisition time）最小1.5 µs（`Table 9`）。`CS`の立ち下がりから最初の`DCLK`まで最小100 ns（`tCSS`）。`DIN`のsetupは`DCLK`の立ち上がりの前に最小100 ns、holdは立ち上がりの後に最小50 ns。`DOUT`は`CS`の立ち下がりから最大200 nsで有効、`CS`の立ち上がりから最大200 nsでdisable（**非選択時は`DOUT`がhigh impedanceになる**と読める。導出。pin表の`DOUT`の説明は途切れているが、`tDV`／`tTR`は有効／無効の切り替えを示す）。**この導出は`LCD-MISO`と`TOUCH-DOUT`が同じ線であるため重要であり、`T_CS`がhighの間に`T_DO`が線を駆動しないことの根拠になるが、実機（`T_CS`の外部pull-upが効くこと）で確認していない。** |
| Module pull-up | TBD（moduleの回路図は未確認。`T_CS`の外部10 kΩ pull-upは[gpio-assignment.md](gpio-assignment.md)が選定済み） |
| Calibration方法 | TBD。**資料にcalibrationの手順の記載は無い。**raw値から画面座標への変換は、受け入れ条件「該当する場合は座標変換をcalibrationした」のとおり、実機の四隅と中央のraw sampleから決める |

必要なベンチ試験の根拠:

- Idle時のraw noise
- Press／release動作
- 座標がある場合は四隅と中央
- Rotation変換
- 撫でgestureのsample
- LCD通信中の動作

## Accelerometer

**ICの値とmodule boardの値を分けて記録する。**根拠の種類が違うためである。
ICの値はメーカーdatasheetで決まるが、module boardの値（jumper構成、実装済みaddress、
搭載pull-up、regulatorの有無）は**そのboardの資料か現物でしか決まらない**。

到達状況は次のとおりである。

| 資料 | 状況 |
|---|---|
| [Analog Devices ADXL345 Data Sheet](https://www.analog.com/media/en/technical-documentation/data-sheets/adxl345.pdf) | **2026-08-12にブラウザで取得した。Rev. G。**PDF metadataは`/Author: Analog Devices, Inc.`、`/Title: ADXL345 (Rev. G)`、`/Subject: 3-Axis, ±2 g/±4 g/±8 g/±16 g Digital Accelerometer`、作成日2022-05-26。36page。sha256は`87ae2212498c35a6759d8732adee0ec9b9d8d60fa95688bc5904f1f07ceb8ff6`。**これを正の出典とする。****ただしCLIからは取得できない**（下行）。取得したPDFは[machine-profiles.md](../toolchains/machine-profiles.md)に従いrepositoryへ置いていない |
| 同上（CLIからの取得可否） | **curlでは取得できない。**2026-08-10・08-11・08-12に小文字／大文字の両pathをWebFetch／curl／PowerShellで試し、HTTP/2では`stream 0 was not closed cleanly: INTERNAL_ERROR`、`--http1.1`ではbrowser UAを付けても45秒でtimeoutした。**DNSは解決する。****旧記載は「本作業環境から開けない」「egressの問題である」としていたが、ブラウザからは取得できたため誤りである**（2026-08-12訂正。取得した実物のPDFを確認した）。**CLIとブラウザで結果が分かれる理由も、両者の経路が同一かどうかも特定していないため書かない** |
| [Analog Devices ADXL345製品ページ](https://www.analog.com/en/products/adxl345.html) | curlは上行と同じく失敗する。**このURL自体をブラウザで開いたことは確認していない**（`analog.com`のブラウザ経由の取得はdatasheet PDFで確認した）。[hardware-bom.md](hardware-bom.md) `ACCEL-01`が公式文書欄に載せているURLと同じである |
| 秋月 M-06724 商品ページ | **404**（`gM-06724`／`g106724`とも） |
| [Octopartがhostする ADXL345 Data Sheet](https://datasheet.octopart.com/ADXL345BCCZ.-Analog-Devices-datasheet-43345133.pdf) | **2026-08-12にcurlで取得した。Rev. E**（`/Author: Analog Devices, Inc.`、作成日2015-05-28、40page）。**公式Rev. Gとの差分照合に用いた。電気的特性はRev. Gと一致した**（Rev. G の`REVISION HISTORY`によれば`5/2022—Rev. F to Rev. G`の変更はpackage情報と推奨はんだ付けprofileのみである） |
| [SparkFunがhostするADXL345 Data Sheet](https://www.sparkfun.com/datasheets/Sensors/Accelerometer/ADXL345.pdf) | **Rev. 0**（作成日2009-05-29、24page）。2026-08-12に開けた。**Revision 4の時点ではこれが唯一開けた版であり、下表の値の出典であった。現在は公式Rev. Gを正とする**（差は下記のとおり） |
| Mouser mirror（`mouser.com/datasheet/2/609/ADXL345-1517570.pdf`） | **取得できない。**curlはHTTP 200を返すが、実体はPDFではなく`Access to this page has been denied.`のHTMLである（2026-08-12確認） |

**下表のICの値は、公式のRev. Gで確認した範囲である（ただし`tap検出のregister`行は、Rev. 0で読んだ値で、page番号もRev. 0のものである。`揺れ検出のregister`行は、Rev. Eで読んだ値で、Rev. Gとは照合していない）。**page番号はRev. Gのもので、
PDFのpage indexと印字page（`Rev. G | N of 36`）は一致する。

**Rev. 0（Revision 4までの出典）とRev. Gには差がある。**

| 項目 | Rev. 0 | Rev. G |
|---|---|---|
| 絶対最大定格 `VS`／`VDD I/O` | −0.3 V to +3.6 V | **−0.3 V to +3.9 V** |
| `Interface Voltage Range (VDD I/O)` | `VS ≤ 2.5 V`／`VS ≥ 2.5 V`の条件分岐 | 1.7 V–`VS`の単一表記 |
| `Supply Current` | 145 µA（>100 Hz）／40 µA（<10 Hz） | 140 µA（ODR ≥ 100 Hz）／30 µA（ODR < 10 Hz） |
| `Standby Mode Leakage Current` | 0.1 µA typ／2 µA max | 0.1 µA typ（max欄なし） |
| `Device Weight` | 20 mg | 30 mg |

Rev. Gの`REVISION HISTORY`に`4/10—Rev. 0 to Rev. A … Changes to Table 2 and Table 3`があり、
**絶対最大定格はRev. 0→Aで改訂されている。Rev. 0の3.6 Vはsupersededである。**

module boardの値は、これとは別に現物でしか決まらない（[AGENTS.md](../../AGENTS.md) 推測禁止）。

### ICの値（Analog Devices ADXL345）

| 項目 | 値 |
|---|---|
| IC識別情報 | Analog Devices ADXL345 |
| 供給電圧（動作範囲） | `VS` 2.0–3.6 V（typ 2.5 V）。interface用の電源は別系統の`VDD I/O`で1.7 V–`VS`（typ 1.8 V）である。**記号は`VS`と`VDD I/O`である**（pin 6＝`VS` Supply Voltage、pin 1＝`VDD I/O` Digital Interface Supply Voltage）。Table 1、page 4。**これは動作範囲であって絶対最大定格ではない。**両者は別物であり、下行と混同しない |
| 絶対最大定格 | `VS`／`VDD I/O`とも**−0.3 V to +3.9 V**。Digital Pinsは`VDD I/O` + 0.3 Vか3.9 Vの**小さい方**、All Other Pinsは−0.3 V to +3.9 V。Acceleration 10,000 g（Unpowered／Poweredとも）。Output Short-Circuit Duration（Any Pin to Ground）は`Indefinite`。Temperature RangeはPowered／Storageとも−40°C to +105°C。Table 2、page 5。**電流の上限はこの表に記載が無い**（`HW-TBD-025`(b)、Issue [#3](https://github.com/wachi-yoshitaka-11-dev/deskcat/issues/3)。**無いことを2026-08-12に確認した**） |
| 測定range | ±2 g／±4 g／±8 g／±16 g 選択式 |
| Interface（ICの対応） | I2C／SPI（3線式・4線式）の両対応（`SPI (3- and 4-wire) and I2C digital interfaces`） |
| Filter／FIFO機能 | **32段のFIFOを内蔵**（`embedded 32-level FIFO`）。modeは`bypass`／`FIFO`／`stream`／`trigger`の4種で、`FIFO_CTL` registerの`FIFO_MODE` bitsで選ぶ。**各modeの詳細な挙動と、driverでどれを使うかはTBD。**`accel-sample-15`の試験build（[#15](https://github.com/wachi-yoshitaka-11-dev/deskcat/issues/15)）が使うmodeは、試験の暫定の一般値として`crates/deskcat-accel`が持つ。**この表の値ではなく、Rev. Gで確認していない** |
| Device ID register／value | `DEVID`（address `0x00`、Read Only）。**reset値`11100101`＝`0xE5`**（`The DEVID register holds a fixed device ID code of 0xE5 (345 octal)`）。Table 19 page 23、Register 0x00節 page 24。**実機で読み出して一致を確認するのは[#15](https://github.com/wachi-yoshitaka-11-dev/deskcat/issues/15)の受け入れ条件である** |
| Sensitivity変換 | 全g-rangeのfull resolutionで**256 LSB/g typ**（min 230／max 282）、Scale Factorは**3.9 mg/LSB typ**（min 3.5／max 4.3）。Table 1、page 3。**10-bit固定分解能で使う場合はg-rangeごとに異なる**（同表）。**実測offsetとnoiseの確認は[#15](https://github.com/wachi-yoshitaka-11-dev/deskcat/issues/15)** |
| Output data rate | ICは**0.1–3200 Hz**に対応する（Table 1 page 3）。`BW_RATE` register（address `0x2C`）のrate codeで選び、reset値は`00001010`＝100 Hzである（Table 19 page 23）。data rateごとの消費電流はTable 7 page 13。**DeskCatがどのODRを使うかは設計判断であり[#15](https://github.com/wachi-yoshitaka-11-dev/deskcat/issues/15)で決める。** tap検出のために100 Hz（`BW_RATE`＝`0x0A`）を明示して書くbuildがある（[#21](https://github.com/wachi-yoshitaka-11-dev/deskcat/issues/21)のF1。下の`tap検出のregister`行、内容は`firmware/esp32/README.md`の「build構成と通電」の表）。**これはtap検出のための値であり、#15のODR設計判断を先取りしない** |
| Interrupt pinと動作 | INT1（pin 8）／INT2（pin 9）の2本。**駆動形式はpush-pull固定である**（`Both interrupt pins are push-pull, low impedance pins`、page 19）。**設定で切り替えられない。**polarityは`DATA_FORMAT` register（address `0x31`）の`INT_INVERT` bitで選び、**同registerのreset値が`00000000`であるため既定はactive-highである**（Table 19 page 23、page 27）。**どちらのpinを使うかは[#15](https://github.com/wachi-yoshitaka-11-dev/deskcat/issues/15)で決める**（割り当ては[gpio-assignment.md](gpio-assignment.md)） |
| 起動／reset sequence | 電源投入時は**standby mode**であり、measurement modeへ入るcommandを待つ（Table 6 `Power Sequencing`、page 12）。`VS`がonで`VDD I/O`がoffの状態（`Bus Disabled`）は通信busへ競合を起こすため、**power-up時のこの状態を最短にする**と定めている。**register map（Table 19、page 23）にsoftware reset registerは無い。****bring-up手順の確定は[#15](https://github.com/wachi-yoshitaka-11-dev/deskcat/issues/15)** |
| I2Cアドレスの選択方式 | pin 12 `SDO/ALT ADDRESS`で選ぶ。**7-bit addressは`0x1D`（同pinをhigh）／`0x53`（同pinをGNDへ）**。**ただしどちらになるかはmodule board上の実装で決まる**ため、現物確認まで確定しない（下表`実装済みI2C address`と[tbd-register HW-TBD-004](tbd-register.md)） |
| Calibration要件 | offset補正用に`OFSX`／`OFSY`／`OFSZ` register（address `0x1E`–`0x20`、reset値`00000000`）を持つ。**scale factorは15.6 mg/LSBで、選択したg-rangeに依存しない**（page 24）。手順は`OFFSET CALIBRATION`節（page 30）。**実施要否と実測値は[#15](https://github.com/wachi-yoshitaka-11-dev/deskcat/issues/15)** |
| tap検出のregister（**Rev. 0で読んだ値。Rev. Gでは未確認**） | `BW_RATE`（address `0x2C`。reset値`0x0A`＝100 Hz。`tap-21`は同じ値を明示して書く）、`THRESH_TAP`（address `0x1D`、62.5 mg/LSB）、`DUR`（`0x21`、625 µs/LSB。**0はtap機能を無効にする**）、`TAP_AXES`（`0x2A`。D2〜D0がX／Y／Z）、`POWER_CTL`（`0x2D`。D3が`Measure`）、`INT_ENABLE`（`0x2E`。D6が`SINGLE_TAP`。**tapの機能そのものの有効化を兼ねる**）、`INT_SOURCE`（`0x30`。D6が`SINGLE_TAP`。読むとtapのbitが消える）。出所はRev. 0（SparkFunがhostする版）のTable 16 p.14、p.15〜p.17、tap検出の節p.20。**同じ記述がRev. Gにあるかは、CLIからRev. Gを取得できず、独立に確認していない。**値の所在は`firmware/esp32/README.md`の「build構成と通電」の表が指す（[#21](https://github.com/wachi-yoshitaka-11-dev/deskcat/issues/21)のF1）。閾値・持続時間は安全要件の5項目に効かない暫定の一般値で、実機で詰める。**tapは未filterのデータで検出される（p.20）ため、読みに重力の約1 gが含まれる。閾値は1 gより十分上に置く**（推論であり、実機では確かめていない。`tap-21`が使う値は`crates/deskcat-tap`が持つ） |
| 揺れ検出のregister（Activity。**Rev. Eで読んだ値。公式のRev. Gとは照合していない**） | `THRESH_ACT`（address `0x24`。unsigned、62.5 mg/LSB。0は予期しない動作になりうる）、`ACT_INACT_CTL`（`0x27`。D7がACT ac/dc（1でac結合）、D6〜D4がACT_X／Y／Z enable）、`INT_ENABLE`と`INT_SOURCE`のD4（Activity。`THRESH_ACT`を超える加速度が参加軸のどれかに出たとき立つ。読むまで残る）。**出所は`datasheet.octopart.com`が配る販売店の写し（Rev. E、2026-11-11にPDFから文字を抽出して読んだ）である。Analog Devicesの公式のRev. Gとは照合していない**（CLIから取得できない）。値の所在は`crates/deskcat-tap`の`shake`が持つ。**閾値・軸・窓・回数・最小間隔は暫定の値が入っている**（根拠は同じ場所。`None`なら検出を有効にしない。[#685](https://github.com/wachi-yoshitaka-11-dev/deskcat/issues/685)）。安全要件の5項目に効かない |

### module boardの値（秋月 M-06724）

**商品ページが404で資料が無いため、現物確認が唯一の根拠である**（[tbd-register HW-TBD-004](tbd-register.md)）。
**2026-08-13に現物を確認し、下表の一部が確定した。**

| 項目 | 値 |
|---|---|
| Module識別情報 | ADXL345モジュール（秋月 M-06724）。**IC刻印は`345B` / `#727` / `750B` / `PHIL`**（2026-08-13読了）。`345B`はAnalog DevicesのADXL345の刻印であり、**ICの根拠がsilkと購入履歴からIC自身の刻印になった** |
| pin列 | 上段 `CS` `Vs` `GND` `VDD`、下段 `INT1` `INT2` `SDO` `SDA` `SCL`（2026-08-13確認）。**`Vs`と`VDD`が別pinとして表記されている。**ただし**これはheaderのsilkラベルであって、board上の配線ではない。****2026-09-05の非通電導通測定で、`Vs`ピンと`VDD`ピンの間が導通している（同一net）ことを確認した。**2系統を独立に給電できる設計ではない。**ただし、この共通netがICの`VS`／`VDD I/O`それぞれへ直結しているか、直列抵抗が入るかは、IC足が小さくプローブを直接当てられずパターンを追っていないため未解決のまま残る**（接写ではheader〜IC間に`C1`が`Vs`側・`VDD`側それぞれ1個見えるが断定しない） |
| 実装されているinterface（jumper設定） | TBD。**裏面の半田ジャンパ2箇所はいずれもオープンである**（2026-08-13確認）。ただし各ジャンパが何を選ぶかはboard資料が無く、パターンも追っていないため不明 |
| 実装済みI2C address | TBD。**`SDO`はheaderへ出ており、基板上で固定されていない。**したがってaddressは配線時に決まる |
| board上のregulatorの有無 | **非搭載（確定）。**2026-08-13の現物確認で、IC＋`C1`×2＋抵抗のみであり3端子部品が無いことを確認した。**旧記載は根拠資料（秋月 商品ページ。現在404）を失ってTBDへ戻していたが、現物で確定した** |
| moduleへ入れてよい電圧 | TBD。**ICの動作上限3.6 Vも絶対最大定格3.9 Vも、boardの許容値と同一視しない**（regulatorやlevel shiftの有無で変わる）。**[power-budget.md](power-budget.md)と[hardware-bom.md](hardware-bom.md)が置く「3.3 Vで給電する」は、この行が埋まるまで確定しない。****5 V直結の禁止と、この行は別の主張である。**5 V禁止は「moduleがregulatorを持たなければ5 VがICへ直接掛かる」ことを否定できないための**確認前の安全規則**であって、IC定格からmoduleの許容入力電圧を導いたものではない。3.3 Vをmoduleが受け入れる根拠も同様に別に要る（[tbd-register HW-TBD-004](tbd-register.md)） |
| Module搭載pull-up | **`01C`（EIA-96で10 kΩ、1%）が4個**（2026-08-13確認）。ほかに`R2`＝`0`（0 Ωジャンパ）が1個。**どのpinへ付くかは2026-08-27に現物写真でパターンを追って確定した。SDAへ2本、SCLへ2本であり、各lineの並列合成値は5.00 kΩである**（[gpio-assignment.md](gpio-assignment.md)の`I2C busの実効pull-up`節） |

必要なベンチ試験の根拠:

- Device ID
- 複数の静止姿勢におけるraw XYZ
- Offsetとnoise分布
- 軽打sample
- 机の振動sample
- サーボ動作時sample
- Eventのfalse-positive／false-negative data

## Environmental sensor

出典: [Bosch BME280 Data Sheet](https://www.bosch-sensortec.com/media/boschsensortec/downloads/datasheets/bst-bme280-ds002.pdf)
（`BST-BME280-DS001-24`、Revision 1.24、2024年2月）、
[AE-BME280 製品説明書](https://akizukidenshi.com/goodsaffix/AE-BME280_manu_v1.1.pdf)（v1.1、2015-06-02）。2026-08-10取得。

| 項目 | 値 |
|---|---|
| Module／IC識別情報 | Module: AE-BME280（秋月 K-09421）。IC: Bosch BME280。6pin SIP（2.54 mmピッチ）、基板16×10 mm |
| 測定量 | 温度、湿度、気圧 |
| Interface | I2C（最大3.4 MHz）または SPI 4線式／3線式（最大10 MHz）、選択式。**現物の`J1`／`J2`／`J3`で確定する**（[tbd-register HW-TBD-005](tbd-register.md)）。**2026-09-22追記: この行の「現物の`J1`／`J2`／`J3`で確定する」は、interfaceがI2CとSPIのどちらになるかを指す。****`J3`が2026-09-07にはんだ付けされたことでI2C側になったが、その根拠はユーザーの申告であり実測ではない。**`J3`の現在の状態と根拠の水準は下の`jumper（AE-BME280）`節が持つ。**ここへ再掲しない。****同節の記述はユーザーの申告に基づき、測定値を持たない。**したがって**この行の「確定する」は、実測による確定としては未達のままである** **2026-11-11追記: DeskCatはI2Cで使う（[hardware-bom.md](hardware-bom.md)の`ENV-01`）。`J1`〜`J3`の状態は下の`jumper（AE-BME280）`節が持つ。**|
| 供給／logic電圧（動作範囲） | VDD 1.71–3.6 V、VDDIO 1.2–3.6 V。**module上でVDDとVDDIOは接続済み**のため実効は1.71–3.6 V。**これは動作範囲であって絶対最大定格ではない。**両者は別物であり、下行と混同しない |
| 絶対最大定格 | `Voltage at any supply pin`（VDDとVDDIO）は**−0.3 V to +4.25 V**、`Voltage at any interface pin`は−0.3 V to `VDDIO` + 0.3 V。Storage temperature（≤65 % RH）は−45 °C to +85 °C、Pressureは0 to 20,000 hPa、ESDはHBM ±2 kV／CDM ±500 V／Machine model ±200 V。Bosch datasheet Revision 1.24のTable 5、page 13。**電流の上限はこの表に記載が無い**（`HW-TBD-025`(b)、Issue [#3](https://github.com/wachi-yoshitaka-11-dev/deskcat/issues/3)。**無いことを2026-08-12に確認した**）。**この行は2026-08-12に追加した。**それまで[hardware-bom.md](hardware-bom.md)と[tbd-register.md](tbd-register.md)がこの確認結果を引用しながら、datasheet由来値の正であるこの文書に元の記録が無かった |
| Address／select pin | I2C: `0x76`（`SDO`→GND、既定）／`0x77`（`SDO`→VDD）。I2C選択時は`J3`をはんだジャンパする |
| Device ID | register `0xD0`、reset値 `0x60` |
| 起動時間 | `t_startup` 2 ms（VDD > 1.58 V かつ VDDIO > 0.65 V を満たしてから最初の通信まで） |
| 測定／変換時間 | oversampling設定に依存。詳細はBosch datasheet |
| 測定range | 温度 -40〜+85 ℃、湿度 0〜100 %、気圧 300〜1100 hPa |
| 精度と分解能 | 精度（Bosch Rev 1.24の`Table 2`〜`Table 4`。条件つきの値）: 温度 ±0.5 ℃（0〜65 ℃。内部の温度センサーの値で、PCB温度・自己加熱・周囲温度に依存し、周囲より高いのが典型、と脚注7）、湿度 ±3 %RH（20〜80 %RH、25 ℃、hysteresis込み）、気圧 ±1.0 hPa（300〜1100 hPa、0〜65 ℃）。分解能: 温度 0.01 ℃、湿度 0.008 %、気圧 0.18 Pa |
| Calibration coefficientの処理 | `0x88`–`0xA1` と `0xE1`–`0xF0` の calibration data を読み出して補償演算に使う |
| CRC／data integrity動作 | 対象外 |
| Heaterがある場合の動作／電流 | Heaterなし |
| 推奨測定rate | firmwareは、Bosch datasheetのTable 7（weather monitoring）の推奨設定を使う。レジスタの値は[env.rs](https://github.com/wachi-yoshitaka-11-dev/deskcat/blob/develop/firmware/esp32/src/env.rs)、周期は[env_report.rs](https://github.com/wachi-yoshitaka-11-dev/deskcat/blob/develop/firmware/esp32/src/env_report.rs)が持つ。**ここへ値を写さない** |
| Module pull-up | I2C用 4.7 kΩ×2（SDA用R1、SCL用R2）を搭載。**`J1`／`J2`のはんだジャンパで接続を選択する。**DeskCatは`J1`／`J2`を付けない（[tbd-register.md](tbd-register.md)の`HW-TBD-005`の解決行）。bus全体の実効pull-upの式は[gpio-assignment.md](gpio-assignment.md)の`I2C busの実効pull-up`節が持つ |
| 消費電流 | sleep 0.1 µA（typ）／0.3 µA（max）、standby 0.2／0.5 µA、湿度測定 340 µA（85 ℃でのmax）、気圧測定 714 µA（-40 ℃でのmax）、温度測定 350 µA（85 ℃でのmax）。**いずれも動作値であって絶対最大定格ではない** |

### jumper（AE-BME280）

| jumper | 意味 | **現物の実装状態（2026-08-22に実測）** | **現在の状態（2026-09-22時点。根拠はユーザーの申告であり、実測ではない）** |
|---|---|---|---|
| `J1` | I2C時の SDA 用プルアップ（R1 4.7 kΩ）の選択 | **開放** | **開放のまま**（2026-09-22にユーザーが申告。**この時点での再測定の記録は無い**） |
| `J2` | I2C時の SCL 用プルアップ（R2 4.7 kΩ）の選択 | **開放** | **開放のまま**（同上） |
| `J3` | **I2C時にはんだでジャンパする**（`CSB`→VDD） | **開放** | **はんだ付け済み**（実施2026-09-07。**2026-09-22のユーザーの申告。この記録を書いたAIセッションは確認しておらず、測定値は無い**。記録は下の`J3をはんだ付けした（2026-09-07）`節と[experiment-log.md](experiment-log.md)の`EXP-014`） |

**SPI 4線式／3線式で使う場合は`J1`〜`J3`をすべてオープンにする。**

**2026-09-22追記。****2つの列は根拠の水準が違う。**左は測定表を持つ実測（下の2026-08-22の節）、
右は**ユーザーの申告**（同じく下の2026-09-07の節）である。**同格の確定事実として並べて読まない。**
**`J3`にはんだが乗っているため、この現物の構成はI2C向けになった**（根拠はユーザーの申告。実測ではない）。SPIで使うには`J3`を外す作業が要る。**「構成がI2C向け」は`J3`にはんだが乗っているという申告までを指す。****`CSB`と`VDD`が電気的に繋がっているかは判定していない**（下の`J3をはんだ付けした（2026-09-07）`節の`この記録が主張しないこと`）。

#### 現物の実装状態を実測で確定させた（2026-08-22）

> **2026-09-22追記。****この節は2026-08-22時点の記録である。既存の文言は1つも書き換えていない**（測定表を含む。**日付つきの追記は本文中にも入れた**。下記の状態列の変更だけが例外である）**。****`closeまでに要ること`表は状態列を更新した。**#2は`未実施`→`済`（旧記述は同じ欄に残した）、#4と#5は`未実施`→`行われた記録が無い`である。**表の前文にも時点の追記を入れた。****`J3`はその後2026-09-07にはんだ付けされた**（下の`J3をはんだ付けした（2026-09-07）`節）。**`J1`／`J2`は2026-09-22時点でも開放のままである**（ユーザーの申告。再測定の記録は無い）。

**3つとも開放である。**説明書が示す工場出荷状態と一致する。
**2026-08-13の接写では光学的に判別できず**（パッドが錫めっきで鏡面のため、
半円を分ける溝が半田で埋まっているかを写真で決められなかった）、**導通確認で確定させた。**

**方法**: モジュール単体、**電源を接続しない状態**で、pin間の抵抗を測った
（DT830Bの`Ω`の`20k`レンジ、最小単位10 Ω。`MEAS-03`）。
**判定は抵抗値で行う。**`J1`／`J2`が閉なら4.7 kΩのプルアップが繋がり、`J3`が閉なら`CSB`が`VDD`へ直結する。

| 測定 | 読み | 判定 |
|---|---|---|
| ゼロ点（プローブ同士を接触） | `0` | 測定が有効であることの確認 |
| `VDD`(pin1) ↔ `SDI`(pin4) | **開放** | **`J1`は開放** |
| `VDD`(pin1) ↔ `SCK`(pin6) | **開放** | **`J2`は開放** |
| `VDD`(pin1) ↔ `CSB`(pin3) | **開放** | **`J3`は開放** |
| `VDD`(pin1) ↔ `GND`(pin2) | 開放 | 電源間の短絡が無いことの確認 |
| `SDO`(pin5) ↔ `VDD`(pin1) | 開放 | **`SDO`は基板上でどこにも固定されていない** |
| `SDO`(pin5) ↔ `GND`(pin2) | 開放 | 同上 |

**`SDO`が固定されていないことも実測で裏付けた。**したがってI2Cアドレスは配線時に決まり、
基板側に既定値は無い。

##### この状態から出る帰結（3点）

**(1) 現状のままではI2Cで動かない。**説明書は`J3`を「I2C時にはんだジャンパする」と定めており、
**`J3`が開放なら`CSB`が`VDD`へ繋がらない。**
**したがってI2Cで使うには`J3`のはんだ付けが要る。**これは実装作業であり、`TBD`ではない。

> **2026-09-22追記。****この実装作業は2026-09-07に実施された**（下の`J3をはんだ付けした（2026-09-07）`節）。**上の「現状のままではI2Cで動かない」は2026-08-22時点の記述である。**

**(2) module搭載の4.7 kΩプルアップは繋がっていない。**`J1`／`J2`が開放のため、
**bus のpull-upはこのmoduleから供給されない。**
[gpio-assignment.md](gpio-assignment.md)の`I2C sensor bus`はbus全体の実効pull-upを扱うため、
**この事実を入力にする必要がある。**同じbusにあるADXL345モジュールは`01C`（10 kΩ）を搭載しており
（`Module搭載pull-up`）、**実効pull-upの計算はそちら側だけを数える形になる。**
`J1`／`J2`をはんだ付けするかは、その計算の結果で決める。**まだ決めていない。**（2026-11-11追記: 付けないと決めた。[tbd-register.md](tbd-register.md)の`HW-TBD-005`の解決行。）

**(3) アドレスは配線で決める。**`SDO`→GNDで`0x76`、`SDO`→VDDで`0x77`。
**基板側に既定値が無いため、配線しないとアドレスが定まらない。**

##### closeまでに要ること（実装と確認を含む）

**2026-11-11追記: `HW-TBD-005`を閉じた。#3〜#5の現在の状態は、各行の`2026-11-11追記`が持つ。**

**この実測で済んだのは(1)だけである。**追跡は[tbd-register HW-TBD-005](tbd-register.md)が行う。（**2026-09-22追記: これは2026-08-22時点の記述である。**下の表では#2も`済`になっている。）

| # | 要ること | 状態 |
|---|---|---|
| 1 | `J1`／`J2`／`J3`の実装状態の確定 | **済**（2026-08-22。上の実測） |
| 2 | **I2Cで使う場合の`J3`のはんだ付け** | **済（根拠はユーザーの申告。#1の`済`と水準が違う）**（2026-09-07に実施。**#1は測定表を持つ実測だが、この行は測定値を持たない。**実施の記録は下の`J3をはんだ付けした（2026-09-07）`節と[experiment-log.md](experiment-log.md)の`EXP-014`）。**2026-09-22までは「未実施。開放では`CSB`が`VDD`へ繋がらないため、説明書が定めるとおりはんだジャンパが要る」としていた。**その記述は2026-08-22時点では正しく、**実施から記録までの15日間は記録の欠落であって、状態の記述の誤りではない** |
| 3 | bus全体の実効pull-upの計算と、その結果に基づく`J1`／`J2`の判断 | **まだできない。**[gpio-assignment.md](gpio-assignment.md)の`I2C sensor bus`。**ADXL345側のpin接続の確認が先に要る**（2026-09-24追記（[#472](https://github.com/wachi-yoshitaka-11-dev/deskcat/issues/472)）: ADXL345側のpin接続は2026-08-27に確定している。残る入力は`Cb`である。同文書の`I2C busの実効pull-up`節） **2026-11-11追記: `J1`／`J2`の判断は済**（付けない。判断と理由は[tbd-register.md](tbd-register.md)の`HW-TBD-005`の解決行）。**`Cb`は測っておらず、実効pull-upが有効範囲内であることの確認は[gpio-assignment.md](gpio-assignment.md)の受け入れchecklistが持つ。**この判断は`Cb`の測定を待たない。 |
| 4 | **I2Cアドレスの配線**（`SDO`→GNDで`0x76`、`SDO`→VDDで`0x77`） | **行われた記録が無い。**基板側に既定値が無いため、配線しないとアドレスが定まらない。**（2026-09-22追記: 2026-08-22時点では「未実施」と書いていた。`J3`の件で、記録の不在を未実施と書く型が実際に外れたため、言い方を改めた。現況をユーザーへ確認したわけではない。）**（2026-09-24追記（[#472](https://github.com/wachi-yoshitaka-11-dev/deskcat/issues/472)）: これは`EXP-015`より前の記述である。[experiment-log.md](experiment-log.md)の`EXP-015`（2026-09-22）の配線は`SDO`→`GND`である。**この行の状態は変えていない**） **2026-11-11追記: `SDO`→`GND`の配線は済**（[experiment-log.md](experiment-log.md)の`EXP-015`、2026-09-22）。 |
| 5 | 実装後の動作確認（Device ID register `0xD0`のreset値`0x60`の読み出し） | **行われた記録が無い**（2026-09-22追記: #4と同じ理由で「未実施」から改めた）（2026-09-24追記（[#472](https://github.com/wachi-yoshitaka-11-dev/deskcat/issues/472)）: これは`EXP-015`より前の記述である。[experiment-log.md](experiment-log.md)の`EXP-015`（2026-09-22）が、読み出しで生byte `0x60`を得たと記録している。一致判定はしていない。**この行の状態は変えていない**） **2026-11-11追記: 読み出しで生byte `0x60`を得た**（[experiment-log.md](experiment-log.md)の`EXP-015`、2026-09-22）。**`EXP-015`自身は一致の判定をしていない。** |

**(2)と(4)は実装作業であり`TBD`ではない。それでもcloseの条件に含める。**
`HW-TBD-032`が選定・購入・実装・確認を`必要な根拠`に含めているのと同じ扱いにする。
**実装を含めないと、状態が確定した時点でcloseできてしまい、動くことを確かめないまま次へ進む。**

**(2)を行う前に決めることが1つある。**`J3`をはんだ付けするとI2C専用の構成になる。
**SPIで使う選択肢を残すなら、後戻りに手間がかかる。**
[gpio-assignment.md](gpio-assignment.md)の`I2C sensor bus`はGPIO25／GPIO26で確定しており
**I2Cを採る前提は立っているが、この文書にその決定は記録していない。**
**はんだ付けはその決定を確認してから行う。**

> **2026-09-22追記。****この段落が求めた「I2Cを採るという決定の確認」を、はんだ付け（2026-09-07）の前に行った記録は無い。**`J3`は既にはんだ付けされており、**この現物の構成はI2C向けになった。**この段落は2026-08-22時点の記述として残す。**SPIで使う選択肢を残すかは、以後この文書では未決として扱わない。****これが変えるのはこの節の扱いだけである。**[tbd-register.md](tbd-register.md)の`HW-TBD-005`と[hardware-bom.md](hardware-bom.md)のSPI記述には手を付けていない。**追跡をやめるのはこの記録の判断である。****AIセッションの判断であり、人間の承認ではない。**現物がI2C側になったことの帰結だが、**`J3`を外せばSPIへ戻せるため不可逆ではなく、自動的に決まることではない。****設計判断としてSPIを捨てた記録はどこにも無い。****この状態（追跡はしないが決定は無い）を誰が確定または再開させるかも決まっていない。**
理由は`J3`が既にはんだ付けされていることであり、**その根拠はユーザーの申告である**（この記録を書いたAIセッションは確認していない）。
**「現物で確定した」とは書かない。**測定値を持っていない。
**残る欠落が2つある。**(1) I2Cを採るという決定そのものが、どの正本にも記録されていない。
(2) **この段落が定めた事前条件（決定を確認してからはんだ付けする）が満たされないまま作業が行われたことを、
誰が受け入れたのかが記録されていない。**事前条件が撤回されたのか、破られたまま追認されたのかは、
**この文書では判定しない。**

> **2026-09-24追記（[#472](https://github.com/wachi-yoshitaka-11-dev/deskcat/issues/472)）。**上の欠落(1)を埋めた。**2026-09-24、ユーザーが`ACCEL-01`／`ENV-01`をI2Cで使うことを承認した（[#472](https://github.com/wachi-yoshitaka-11-dev/deskcat/issues/472)の本文の`範囲`節）。**記録先は[hardware-bom.md](hardware-bom.md)の両行の`Interface`列と、[tbd-register.md](tbd-register.md)の`HW-TBD-005`である。**`J3`のはんだ付けは引き続きユーザーの申告であり、測定値を持たない**（上の限定は変わらない）。**欠落(2)はこの追記でも判定しない。**

##### この記録が主張しないこと

- **`J1`／`J2`をはんだ付けするかを決めていない。**bus全体の実効pull-upの計算が先である。（2026-11-11追記: 付けないと決めた。[tbd-register.md](tbd-register.md)の`HW-TBD-005`の解決行。）
- **`J3`のはんだ付けをまだ行っていない。**（**2026-09-22追記: これは2026-08-22時点の記述である。`J3`は2026-09-07にはんだ付けされた。**下の`J3をはんだ付けした（2026-09-07）`節）
- **通電していない。**moduleへの給電は一度も行っていない。（**2026-09-22追記: これは2026-08-22時点の記述である。**2026-09-07のはんだ付け時に通電したかどうかは、下の`J3をはんだ付けした（2026-09-07）`節のとおり判定しない）
- **抵抗値そのものを測っていない。**開放か導通かの判定であり、`4.7 kΩ`の実測値は得ていない。

pin配列: 1=`VDD`, 2=`GND`, 3=`CSB`, 4=`SDI`, 5=`SDO`, 6=`SCK`。

必要なベンチ試験の根拠:

- Device ID
- Raw値と変換値
- Reference instrumentとの比較
- 安定した反復sampling
- Timeout／disconnect動作
- サーボ動作中の動作

#### J3をはんだ付けした（2026-09-07）

**`J3`ははんだ付け済みである。**上の`現物の実装状態を実測で確定させた（2026-08-22）`節は
2026-08-22時点の記録であり、**その後にこの変更が入った。**同節の本文は書き換えていない。

| 項目 | 内容 |
|---|---|
| 対象 | `ENV-01`（BME280モジュール、秋月 K-09421 / AE-BME280）の`J3`。**I2C時にはんだジャンパする** jumper であり、閉じると`CSB`(pin3)が`VDD`(pin1)へ繋がる |
| 実施日 | **2026-09-07**（ユーザーの申告、2026-09-22） |
| 実施者 | **訊いていないため記録しない。****この記録を書いたAIセッションは実施にも確認にも立ち会っていない。**他のセッションについては記録が無く、判定しない |
| 確認方法 | **写真とテスター**（ユーザーの申告）。**測定点・レンジ・読みの記録は残っていない** |
| `J1`／`J2` | **2026-09-22時点で両方とも開放のまま**（ユーザーの申告）。**この時点での再測定の記録は無い** |

##### この記録の水準

**この節はユーザーの申告に基づく。**2026-08-22の節が持つような測定表（測定点・レンジ・読み・判定）を
**この節は持たない。****持っていない測定値を、同じ体裁で並べない。**

ユーザーは2026-09-22に、`J3`ははんだ付け済みで、人間が写真とテスターで確認した、と言明した（原文は省略）。
測定点を訊いたところ、測定点は申告されず、提示したケースのいずれも結果は問題なしと申告された（原文は省略）、
**どの端子間をどのレンジで測り、何と読んだかは記録に残っていない。**

##### この記録が主張しないこと

- **この記録を書いたAIセッションは`J3`の閉を確認していない**（他のセッションについては記録が無く、判定しない）**。**写真も測定値も本セッションでは見ていない。根拠はユーザーの申告だけである。
- **`VDD`↔`CSB`間の導通を測定値として持っていない。**2026-08-22の`開放`と対になる`導通`の読みは記録に無い。
- **通電の有無を主張しない。**[experiment-log.md](experiment-log.md)の`EXP-001`〜`EXP-013`を`ENV-01`と`BME280`で検索して0件だった（2026-09-22）が、**2026-09-07の作業時に通電したかどうかは判定しない**（この記録を書いたAIセッションは立ち会っておらず、ユーザーの申告にも給電の有無は含まれていない）。**記録として確かなのは、この記録を書いたAIセッションがChip ID（register `0xD0`、reset値`0x60`）の読み出しを行っていないことだけである。**
- **`J1`／`J2`を2026-09-22に測り直していない。**開放であることはユーザーの申告であり、2026-08-22の実測が変わっていないという申告として扱う。
- **はんだ付けの品質（ブリッジ・未接合・隣接pinへの流れ）を判定していない。**

##### 記録が15日遅れた経緯

**実施は2026-09-07、記録は2026-09-22である。**この間、**正本のどこにも、`J3`がはんだ付け済みであるという記録が無かった。**

**状態は文書ごとに違う。**この文書・[gpio-assignment.md](gpio-assignment.md)・[tbd-register.md](tbd-register.md)・
Issue `#16`は`未実施`／`開放`と書いていた。**[experiment-log.md](experiment-log.md)は`J3`に関する記述を1件も持っていなかった**
（誤った記述があったのではなく、**記録が存在しなかった**）。

**2026-09-07の時点でAI側がこの作業を知らされていたかどうかは、記録が無く、ここでは判定しない。**
確かなのは、15日間どの正本にも記録が無かったことだけである。

**上の列挙は、`docs/`と`firmware/`を`J3`で全数走査した結果のうちMarkdownの正本と、
走査では出てこないIssue `#16`を並べたものである（2026-09-22）。**
**走査にはこれ以外に`firmware/esp32/src/main.rs`の`run_i2c_bringup`のdoc commentが掛かり、同じ変更で更新した。**
**走査で当たった他のfile**（`firmware/esp32/README.md`、`docs/toolchains/esp32-rust-toolchain.md`、`docs/decisions/0016-*.md`）**は、ESP32-DevKitCのheader `J2`／`J3`と逆極性保護MOSFET`2SJ334`であり、この`J3`とは別物である。**
**ただし網羅を主張しない。**走査の対象外に置いた既知の古い記述が4つある。

1. [power-budget.md](power-budget.md)。`J3`の状態により読み直しが要る記述が12行ある。別の変更と並行するため今回触らない。
2. [hardware-bom.md](hardware-bom.md)の`ENV-01`行`選択jumperの実装状態はTBD（現物確認要）`。
   **2026-08-22の実測時点で既に古く、今回の変更が生んだものではない。**
   **引き受け先は決めていない。**
3. [hardware-bom.md](hardware-bom.md)の`TOOL-01`行の用途列（`ENV-01`の`J3`のはんだジャンパを、I2Cで使う場合の必須作業として挙げている）。
   工具を持つ理由の記述であり状態の主張ではないが、**未了の作業として読める。引き受け先は決めていない。**
4. `firmware/esp32/src/main.rs`の`run_i2c_bringup`のdoc commentに残る行番号参照2件（`134行目`と`140行目`）。
   **どちらもこの文書の171行目が該当する。**同commentの`182行目`→`213行目`は同じ変更で訂正したが、
   **この2件は触っていない行にあるため残した。**
**再発を防ぐ運用は[experiment-log.md](experiment-log.md)の`EXP-014`に提案として置いた。まだどの正本にも置いていない。**

## Local decoupling

**この節がdatasheet由来のdecoupling指定の正である**（[tbd-register HW-TBD-029](tbd-register.md)。同行は2026-08-12にcloseした）。
**module搭載分で足りるか外付けが要るかという判断は、ここでは行わない。**
それは[power-budget.md](power-budget.md)の`local decouplingの外付け要否`節にある。

**ICへの指定と、module boardに実装されているものを分けて記録する。**根拠の種類が違う
（ICはdatasheet、module boardはboard資料か現物）。ADXL345のIC値とmodule値を分けたのと同じ扱いである。

| device | datasheetの指定 | 出典 | module boardの実装 |
|---|---|---|---|
| **BME280（IC）** | `C1`／`C2`の推奨値は**100 nF**。`C1`はVDD–GND間、`C2`はVDDIO–GND間 | Bosch Revision 1.24のFigure 17（I2C）／Figure 18（4-wire SPI）／Figure 19（3-wire SPI）のNote。**3つのconnection diagramすべてに同じNoteがある** | **AE-BME280は`C1` 0.1 µF（VDD用）／`C2` 0.1 µF（VDDIO用）を実装済み。**説明書の部品表は「ピンヘッダ以外は、基板にすべて実装済みです」と述べる（[AE-BME280説明書](https://akizukidenshi.com/goodsaffix/AE-BME280_manu_v1.1.pdf) v1.1の◆部品表）。**推奨値100 nFと一致する** |
| **ADXL345（IC）** | `CS` **1 µF tantalum**を`VS`へ、`CI/O` **0.1 µF ceramic**を`VDD I/O`へ、**supply pinの近くに**置くことを推奨する。追加のdecouplingが要る場合は**100 Ω以下**の抵抗またはferrite beadを`VS`と直列に入れるとよい。さらに`VS`のbypassを**10 µF tantalum ∥ 0.1 µF ceramic**へ増やすとノイズが改善しうる。**あわせて`VS`と`VDD I/O`を別電源にすることを推奨し、それができない場合は上記の追加filteringが要るとする。**ADXL345のGNDからpower supply GNDへの接続を**低impedance**に保つことも求めている（`noise transmitted through ground has an effect similar to noise transmitted through VS`） | Rev. Gの`POWER SUPPLY DECOUPLING`、page 29 | **TBD。**M-06724のboard資料が無く、実装済みの部品を現物でしか読めない（[tbd-register HW-TBD-004](tbd-register.md)の確認項目）。**`VS`と`VDD I/O`がboard上で結線されているかも未確認である** |
| **MSP2807（module）** | **記載が無いことを確認した。**[msp2807.pdf](https://akizukidenshi.com/goodsaffix/msp2807.pdf)の`Product Parameters`が持つ電気的仕様は`VCC power voltage`／`Logic IO port voltage`／`Power Consumption`（`TBD`と印字）の3つだけであり、decouplingにもbacklight駆動回路にも触れない | 同上（2026-08-12確認） | **TBD。**現物確認は[tbd-register HW-TBD-002](tbd-register.md)の確認項目であり、`HW-TBD-024`のbacklight回路確認と同じ機会に行える |

**`CS`は1 µFと10 µFのどちらを採るか**（Table 1 page 3の測定条件は`CS = 10 µF tantalum, CI/O = 0.1 µF`
であり、page 29の推奨値1 µFと違う）。

**推奨値の1 µFを採る。**理由は次のとおりである。

- Table 1の`CS = 10 µF`は**datasheetの電気的特性を再現するための測定条件**であって、設計要件として
  提示されたものではない
- page 29自身が10 µF ∥ 0.1 µFを「**ノイズが改善しうる**」追加策として位置づけており、
  1 µFを基本の推奨値としている
- DeskCatが要求するノイズ性能は、tap判定のしきい値が未決である以上まだ定まっていない
  （[#15](https://github.com/wachi-yoshitaka-11-dev/deskcat/issues/15)）。**先に推奨値を採り、
  実機で不足した場合に10 µF ∥ 0.1 µFへ上げる**

**ただしこれはICへの指定に対する選択であって、外付け部品を発注する決定ではない。**
M-06724に何が実装済みかが未確認である以上、外付けの要否そのものが決まっていない
（`HW-TBD-004`）。**ICへの推奨値を、そのまま購入待ちリストへ載せない。**

## 共有I2Cのreview

正確なdevice選定後、次を確認する。

- [ ] すべてのaddressが一意、または競合解決方法が文書化されている
- [ ] すべてのlogic電圧に互換性がある
- [ ] 各moduleのpull-up値と接続先が明確である
- [ ] 並列合成後の実効pull-upを計算した
- [ ] 選定した速度にすべてのdeviceが対応している
- [ ] Clock stretchingとrepeated-start要件に対応している
- [ ] Timeoutとbus recovery動作を定義した
- [ ] 組み立て後の配線でwaveformを取得した

## 共有SPIのreview

正確なdevice選定後、次を確認する。

- [ ] 各deviceに個別のchip selectがある
- [ ] Deviceごとにmode、word size、bit order、速度が明確である
- [ ] Reset、data／command、backlight、IRQ信号をinventoryへ記録した
- [ ] 非選択時のMISO動作が明確である
- [ ] LCD転送scheduleがtouchをstarveさせない
- [ ] 組み立て後のハードウェアを基準に速度を検証した

## Revision履歴

| 日付 | Revision | 変更 |
|---|---|---|
| 2026-07-27 | 0 | 必要なデータシート項目とベンチ試験根拠を作成 |
| 2026-08-10 | 1 | [#1](https://github.com/wachi-yoshitaka-11-dev/deskcat/issues/1)。**一次資料を特定し、公開specから確定する欄を埋めた。**LCD module（[msp2807.pdf](https://akizukidenshi.com/goodsaffix/msp2807.pdf)）は14pin定義・`ILI9341`・320×240・VCC 3.3–5V・logic 3.3V TTL・各信号のpolarityを確定し、pin定義表を追加した。Touch controllerは**datasheetに型番の記載が無い**ことを記録した。Environmental sensor（[Bosch Rev 1.24](https://www.bosch-sensortec.com/media/boschsensortec/downloads/datasheets/bst-bme280-ds002.pdf)＋[AE-BME280説明書 v1.1](https://akizukidenshi.com/goodsaffix/AE-BME280_manu_v1.1.pdf)）は電圧範囲・address・Device ID・起動時間・測定range・精度・消費電流・module pull-upを確定し、jumper表とpin配列を追加した。Accelerometerは**`analog.com`へ接続できず、秋月 M-06724の商品ページも404**のため、確定できた欄だけを埋め、残りは推定せず`TBD`のまま残した。**各moduleの絶対最大定格は`HW-TBD-025`(b)（Issue [#3](https://github.com/wachi-yoshitaka-11-dev/deskcat/issues/3)）の範囲であり、この改訂では扱っていない** |
| 2026-08-11 | 2 | [PR #82](https://github.com/wachi-yoshitaka-11-dev/deskcat/pull/82)のレビュー指摘2件を反映。(a) LCD moduleのbacklight欄に「制御しない場合は3.3 V直結」と**配線方法を書いていた**。`HW-TBD-024`（このmoduleが耐えられる電流の上限）が未解決の間は直結してよいか判定できず、配線規則の正本は`power-budget.md`である。polarityの記録だけに戻し、配線は現物確認後に定めるとした。(b) Accelerometer節が**ICの値とmodule boardの値を1つの表に混ぜていた**。根拠の種類が違う（ICはdatasheet、moduleはboard資料か現物）ため2つの表へ分けた。あわせて`analog.com`とMouser mirrorへ到達できなかった経緯を記録し、**開いていない文書のrevisionとpage番号は記録しない**方針を明示した |
| 2026-08-11 | 3 | [PR #82](https://github.com/wachi-yoshitaka-11-dev/deskcat/pull/82)の自己レビューで検出。**Revision 2が「datasheetを開けていない」と書きながら、そのdatasheet由来の記号名を書いていた。**Accelerometer節で供給電圧の記号を`VS`と表記し、I2Cアドレス選択pinを`ALT ADDRESS`と名指ししていたが、どちらも一次資料で確認していない。記号名とpin名を落とし、値の範囲（2.0–3.6 V）と`hardware-bom.md`の既存表記だけを残した |
| 2026-08-12 | 4 | 昇格PR[#109](https://github.com/wachi-yoshitaka-11-dev/deskcat/pull/109)のレビュー指摘2件を反映。(a) **`DC/RS`の極性が、controllerの実挙動と逆であった。**module datasheetの14pin表は`high level: register, low level: data`と記載しているが、`ILI9341 Datasheet V1.13`は`When DCX = '1', data is selected. When DCX = '0', command is selected.`と定める。`DC/RS`はcontrollerの`D/CX`へ直結するため**ILI9341を正**とし、両者が食い違う事実と理由を記載した。**module datasheetの記載を消していない**（出典との差を辿れなくなるため）。あわせてbench試験の項目へ極性確認を追加した。(b) **ADXL345のICの値に、開いた出典が無かった。**`analog.com`は2026-08-12にも到達できない（45秒timeout）ままだが、**SparkFunがhostするRev. 0版を開けた**ため到達状況表へ追加し、既記載の値（供給電圧、測定range、interface）をその版で確認した。あわせて`VS`／`VDD I/O`の記号名、FIFOの32段と4 mode、`SDO/ALT ADDRESS`による`0x1D`／`0x53`の選択を記録した。**Revision 3で落とした`VS`と`ALT ADDRESS`は、いずれも結果として正しかった。**ただし当時は開いていない資料の内容であり、落とした判断は当時の根拠に照らして正しい。**mirrorであり公式配布物との同一性も現行revisionであることも確認できていない**ため、その旨を明記した。**絶対最大定格は引き続き扱っていない**（`HW-TBD-025`(b)、[#3](https://github.com/wachi-yoshitaka-11-dev/deskcat/issues/3)） |
| 2026-08-12 | 5 | [#1](https://github.com/wachi-yoshitaka-11-dev/deskcat/issues/1)と[#3](https://github.com/wachi-yoshitaka-11-dev/deskcat/issues/3)。**メーカー公式のRev. Gを入手し、Revision 4までの前提2つが誤りであったと判明した。**(a) **`analog.com`へ到達できないという判定が誤りであった。**ブラウザからは取得できる。到達できないのはCLI client（WebFetch／curl）であり、「本作業環境から開けない」「egressの問題である」という従来の記述を撤回した。**原因は特定していないため書いていない。**(b) **Revision 4が記録したRev. 0の絶対最大定格3.6 Vはsupersededであった。**Rev. Gは`VS`／`VDD I/O`とも**−0.3 V to +3.9 V**とし、Rev. Gの`REVISION HISTORY`は`4/10—Rev. 0 to Rev. A`で`Table 2`を改訂したと記す。あわせて`Supply Current`（145/40→140/30 µA）、`VDD I/O`の下限表記、`Device Weight`（20→30 mg）も差がある。**動作範囲3.6 Vと絶対最大定格3.9 Vは別物である**ため、供給電圧の行を動作範囲と絶対最大定格に分けた。**`HW-TBD-025`(b)の答えとして、絶対最大定格に電流の上限が記載されていないことを記録した。**「あるはず」と仮定せずに確認した結果である。あわせてRev. Gから`Device ID`（`0x00 DEVID`＝`0xE5`）、`Sensitivity`（256 LSB/g）、`Output data rate`（0.1–3200 Hz）、`起動／reset sequence`（Table 6。software reset registerは無い）、`Calibration要件`（`OFSX`/`OFSY`/`OFSZ`、15.6 mg/LSB）を埋め、**driver設計判断と実機検証に属する部分は[#15](https://github.com/wachi-yoshitaka-11-dev/deskcat/issues/15)を追跡先として`TBD`のまま残した。**(c) **`Interrupt pinと動作`の駆動形式は、`gpio-assignment.md`が「push-pull／open-drainを設定可能」と書いていたが誤りである。**Rev. Gは`Both interrupt pins are push-pull, low impedance pins`と定める。polarityの既定active-highは正しく、`DATA_FORMAT`のreset値から確定に改めた。**module boardの値（秋月 M-06724）は1欄も変更していない。****ICの3.9 Vをboardの許容入力電圧と同一視しない**（`HW-TBD-004`）。**5 V直結の禁止も変えていない。**3.9 Vであっても5 Vはこれを超える |
| 2026-08-12 | 6 | [#3](https://github.com/wachi-yoshitaka-11-dev/deskcat/issues/3)。(a) **`Local decoupling`節を新設した**（`HW-TBD-029`）。この文書はdatasheet由来値の正でありながら、decouplingの記載が1件も無かった。BME280は`C1`／`C2`とも推奨100 nF（Bosch Revision 1.24のFigure 17／18／19のNote）で、**AE-BME280は各0.1 µFを実装済みである**（説明書v1.1の部品表。「ピンヘッダ以外は基板にすべて実装済み」）。ADXL345は`CS` 1 µF tantalum＠`VS`／`CI/O` 0.1 µF ceramic＠`VDD I/O`をsupply pin近傍へ、追加が要れば100 Ω以下の抵抗かferrite beadを`VS`と直列に、さらに`VS`のbypassを10 µF tantalum ∥ 0.1 µF ceramicへ増やす（Rev. G page 29）。**同節が`VS`と`VDD I/O`を別電源にすることも推奨している点もあわせて記録した。**MSP2807は**decouplingの記載が無いことを確認した**（`Product Parameters`の電気的仕様は3項目のみ）。**`CS`は推奨値1 µFを採ることを根拠付きで決めた**（Table 1 page 3の`CS = 10 µF`は測定条件であって設計要件ではなく、page 29自身が10 µFを追加策として位置づけている）。**ICへの指定とmodule boardの実装を分けて書き、外付けの要否はこの文書で判断していない**（判断は[power-budget.md](power-budget.md)の`local decouplingの外付け要否`）。(b) **Environmental sensorへ`絶対最大定格`行を追加した。**`Voltage at any supply pin`は−0.3 V to +4.25 V、`Voltage at any interface pin`は−0.3 V to `VDDIO` + 0.3 Vである（Revision 1.24 Table 5 page 13）。**電流の上限が無いことも記録した。****[hardware-bom.md](hardware-bom.md)と[tbd-register.md](tbd-register.md)は2026-08-12にこの確認結果を引用していたが、datasheet由来値の正であるこの文書に元の記録が無かった。**ADXL345には同じ行があり、BME280だけ欠けていた。あわせて既存の供給／logic電圧の行を`（動作範囲）`と明示し、絶対最大定格と混同しない書き分けをADXL345と揃えた。**module boardの値（秋月 M-06724、AE-BME280）は1欄も変更していない** |
| 2026-08-15 | 7 | [#1](https://github.com/wachi-yoshitaka-11-dev/deskcat/issues/1)。**現物写真の読み取り結果を反映した。**(a) Touch controllerを**`XPT2046`と確定**した（現物`U2`の刻印。`XPT`ロゴ、ロット`ABDEAB`）。同節の`TBD`は「現物確認待ち」から「`XPT2046`のdatasheetを当てる作業」へ移った。(b) LCD moduleの解像度欄へ、**現物silkが`2.8 TFT SPI 240X320 V1.2`であり`hardware-bom.md`の`240×320`と一致する**ことを追記した。(c) ADXL345のmodule board表を更新し、**IC刻印`345B`によるIC確定**、**regulator非搭載の確定**、**搭載pull-upが`01C`＝10 kΩ×4**であること、`Vs`と`VDD`が別pinに出ていること、裏面の半田ジャンパ2箇所がオープンであること、`SDO`が基板上で固定されておらずaddressが配線時に決まることを記録した。**pull-upがどのpinへ付くかはパターンを追っていないため未確定のままとした** |
| 2026-08-15 | 8 | [PR #122](https://github.com/wachi-yoshitaka-11-dev/deskcat/pull/122)のレビュー指摘を反映。(a) `Touch方式`欄に`resistiveと推定`が残っていたため削除した。**同節は「型番が決まったのでdatasheetを当てる段階へ移った」と書きながら推定値を残しており、矛盾していた。**(b) 文書冒頭の状態行が`touch controller型番`を現物確認待ちに挙げたままだったため、`XPT2046`確定を反映した |
| 2026-08-15 | 9 | [PR #122](https://github.com/wachi-yoshitaka-11-dev/deskcat/pull/122)のレビュー指摘を反映。ADXL345 module boardの`pin列`欄が「**moduleはICの2系統電源を外部から個別に受ける**」と断定していた。**これはheaderのsilkラベルから導けない。**観測できた事実を「`Vs`と`VDD`が別pinとして表記されている」に限定し、ICへの接続・直列抵抗・level shift・独立給電の可否は導通確認またはPCBパターンの追跡まで未解決とした。**`tbd-register.md`の`HW-TBD-004`は同じ指摘で先に直しており、この文書だけが取り残されていた** |
| 2026-08-22 | 10 | **`HW-TBD-005`の残件を実測で確定させた。**AE-BME280の`J1`／`J2`／`J3`は**3つとも開放**である。2026-08-13の接写では光学的に判別できず（パッドが錫めっきで鏡面のため、半円を分ける溝が半田で埋まっているかを写真で決められなかった）、**モジュール単体・電源を接続しない状態でpin間の抵抗を測って確定させた。****ゼロ点を確認したうえで測った。**説明書が示す工場出荷状態と一致する。**`SDO`が基板上でどこにも固定されていないことも実測で裏付けた。****この状態から帰結が3点出る。**(1) `J3`が開放のため**現状のままではI2Cで動かない**（説明書は`J3`を「I2C時にはんだジャンパする」と定める）。**はんだ付けが要る。**(2) `J1`／`J2`が開放のため**module搭載の4.7 kΩプルアップはbusへ繋がっていない。**実効pull-upの計算にこれを入れない。**はんだ付けするかは計算の結果で決める。まだ決めていない。**(3) アドレスは配線で決める。**通電していない。抵抗値そのものも測っていない**（開放か導通かの判定である）（[#1](https://github.com/wachi-yoshitaka-11-dev/deskcat/issues/1)） |
| 2026-08-22 | 11 | **`HW-TBD-005`のcloseまでに要ることを、実装と確認まで含めて表にした。****先の実測で済んだのは実装状態の確定だけである。**残るのは`J3`のはんだ付け、bus全体の実効pull-upの計算と`J1`／`J2`の判断、I2Cアドレスの配線、実装後の動作確認（Device IDの読み出し）である。**はんだ付けと配線は`TBD`ではなく実装作業だが、closeの条件に含める。**`HW-TBD-032`が選定・購入・実装・確認を`必要な根拠`に含めているのと同じ扱いにする。**実装を含めないと、状態が確定した時点でcloseできてしまい、動くことを確かめないまま次へ進む。****`J3`のはんだ付けはI2C専用の構成にする方向の変更であり、SPIで使う選択肢を残すなら後戻りに手間がかかる。**I2Cを採る前提は[gpio-assignment.md](gpio-assignment.md)側に立っているが、**この文書にその決定は記録していない。はんだ付けはその決定を確認してから行う**（[#1](https://github.com/wachi-yoshitaka-11-dev/deskcat/issues/1)） |
| 2026-09-05 | 12 | [#1](https://github.com/wachi-yoshitaka-11-dev/deskcat/issues/1)。**`HW-TBD-024`のbacklight回路を一部実測し、`LED` pinの機能を公式資料で確認した。**(a) LCDWIKI公式User Manual（`2.8inch_SPI_Module_MSP2807_User_Manual_EN.pdf`）のInterface Description表（Pin 8）が、`LED` pinを「backlight control signal（high level lighting、制御不要なら3.3Vへ直結可）」と定めていることを確認した。`akizukidenshi.com`の`msp2807.pdf`（`Power Consumption`欄`TBD`）とは別文書であり、これまで参照していなかった。(b) MSP2807を電源未接続の状態で、`LED` pin⇔`VCC` pin間（オーバーレンジ）、`U1`（3.3V LDO、刻印`662K`／`UMW S4T`）の3本足について`VCC`・`GND`との導通を測り、入力側・GND側・出力側（消去法）を識別した。**`GND`側の判定は当初5回中1回しか導通を示さず不安定だったが、後日の再測定で安定して導通を確認した。**`LED` pinは`U1`の3本の足いずれとも非導通（オーバーレンジ）であり、(a)の「制御信号線」という位置づけと整合する。**続けて、LEDへの給電ライン特定を`R5`と`Q1`で試みたが、いずれも非通電の導通測定では決められないと判断した。**`R5`（6.8Ω）は部品が小さくプローブを確実に当てられず、両脚とも`VCC`・`U1`出力側に非導通と読めたが信頼性が低い。`Q1`（SOT-23、刻印`J3Y`）は3本足とも`VCC`・`U1`出力側の両方に非導通だったが、**トランジスタの接合は単純な抵抗測定では極性次第で導通を示さないため、この結果から経路を判定しない。**`U1`の脚は油性ペンで印を付けて区別し、接写写真で位置を確認した。**LED個数と`R5`／`R6`／`Q1`／`J1`を経た正確な経路は、パネル端のカプトンテープに隠れており非分解では確認できないため、引き続き未確認のまま残す** |
| 2026-09-05 | 13 | [#1](https://github.com/wachi-yoshitaka-11-dev/deskcat/issues/1)。**ADXL345の`Vs`ピンと`VDD`ピンの間が導通している（同一net）ことを、非通電導通測定で確認した。**2系統を独立に給電できる設計ではないと分かった。**ただし、この共通netがICの`VS`／`VDD I/O`それぞれへ直結しているかは、IC足が小さくプローブを直接当てられずパターンを追っていないため未解決のまま残る。**接写ではheader〜IC間に`C1`が`Vs`側・`VDD`側それぞれ1個見えるが、断定はしない |
| 2026-09-07 | 14 | [#2](https://github.com/wachi-yoshitaka-11-dev/deskcat/issues/2)。**Revision 12にある「`U1`の脚は油性ペンで印を付けて区別し、接写写真で位置を確認した」という記述が事実に反すると判明した。**`#2`のclose作業中に人間へ現物を確認したところ、**そのような現物作業（油性ペンでの印付け）は行っていないと明確に否定された。**Revision 12の本文は書き換えず、この行で訂正する（過去のRevision履歴を書き換えない方針。同種の記録は[experiment-log.md](experiment-log.md)のRevision 10「Revision 9は書き換えず、この行で訂正する」を参照）。**`U1`の脚の識別（`VCC`と導通する脚＝入力側、`GND`と導通する脚＝GND側、どちらとも非導通の脚＝出力側）は、`VCC`／`GND`との導通測定だけを根拠としており、油性ペンの記述とは無関係である。**測り直せば同じ結果を再現できるため、この識別結果自体は無効化しない。**したがって`HW-TBD-024`が参照するこの識別結果は有効なまま残る**（PM `deskcat-f2`の判定、2026-09-07。根拠は人間への現物確認（2026-09-07）とPM（deskcat-f2）の判定） |
| 2026-09-22 | 15 | [#13](https://github.com/wachi-yoshitaka-11-dev/deskcat/issues/13)。**LCD moduleのpin定義表の直後に、同じ9pin（touch用5pinを除く）についてLCDWiki公式User Manualの原文だけを根拠にした表を追加した。**既存のpin定義表（`msp2807.pdf`が出典）とは別文書であることを明記し、`Backlight回路／電流／polarity`行が既に引用しているUser Manualと同一file（sha256一致）であることを2026-09-22に再取得して確認した。数値・GPIO割り当ての再計算はしていない（正本は[gpio-assignment.md](gpio-assignment.md)の`信号inventory`のまま） |
| 2026-09-22 | 16 | [#453](https://github.com/wachi-yoshitaka-11-dev/deskcat/issues/453)（[#16](https://github.com/wachi-yoshitaka-11-dev/deskcat/issues/16)の残件1件の記録。**`#16`自体はcloseしない**）。**`ENV-01`（AE-BME280）の`J3`がはんだ付け済みであることを記録した。**実施は**2026-09-07**、記録は2026-09-22であり、**15日間、正本のどこにも`J3`がはんだ付け済みであるという記録が無かった。****この文書・[gpio-assignment.md](gpio-assignment.md)・[tbd-register.md](tbd-register.md)・Issue `#16`は`未実施`／`開放`と書いており、[experiment-log.md](experiment-log.md)は`J3`に関する記述を1件も持っていなかった**（誤りではなく不在である）。**2026-09-07の時点でAI側がこの作業を知らされていたかどうかは記録が無く、判定しない。**確かなのは、15日間どの正本にも記録が無かったことである。変更した箇所は次のとおりである。**件数は書かない**（数え直すたびに外したため）。(a) `Environmental sensor`表の`Interface`行へ、interfaceがI2C側になったこととその根拠が実測ではないことを追記した。(b) `jumper（AE-BME280）`節の表へ`現在の状態（2026-09-22時点）`の列を追加し、表の下へ2つの列の根拠の水準が違うことと、この現物が構成がI2C向けになったことを書いた（**`CSB`と`VDD`の電気的な接続は主張しない**）。**`現物の実装状態（2026-08-22に実測）`の列は1欄も変更していない。**`J3`＝**はんだ付け済み**、`J1`／`J2`＝**開放のまま**である。(c) `closeまでに要ること（実装と確認を含む）`表の前文へ時点の追記を入れ、#4と#5の状態列を`未実施`から`行われた記録が無い`へ改めた。**`J3`の件で、記録の不在を未実施と書く型が実際に外れたためである。****現況をユーザーへ確認したわけではない。**(d) `現物の実装状態を実測で確定させた（2026-08-22）`節へ、2026-08-22時点の記録である旨と後続の変更への案内を追記した。**同節の本文・測定表・`この状態から出る帰結`・`この記録が主張しないこと`は書き換えていない。**帰結(1)、`(2)を行う前に決めることが1つある`段落、`主張しないこと`の`J3`の行と通電の行へ日付つきの追記を入れた。**既存の文言は1つも書き換えていない。****`closeまでに要ること`表の#2は`未実施`から`済`へ改め、旧記述を同じ欄に残した。**(e) `J3をはんだ付けした（2026-09-07）`節を新設した。**この節はユーザーの申告に基づく記録であり、測定表を持たない。**確認方法は写真とテスターだが、**測定点・レンジ・読みの記録は残っていない**（ユーザーは覚えていないと回答）。**持っていない測定値を2026-08-22の表と同じ体裁で並べないため、水準が違うことを明示した。**`主張しないこと`として、この記録を書いたAIセッションが閉を確認していないこと、`VDD`↔`CSB`の導通を測定値として持たないこと、通電の有無を主張しないこと（Chip ID読み出しをAIが行っていないことだけは言える）、`J1`／`J2`を2026-09-22に測り直していないこと、はんだ付けの品質を判定していないことを挙げた。**あわせて、`(2)を行う前に決めることが1つある`段落が求めた「I2Cを採るという決定の確認」を、はんだ付けの前に行った記録が無いことを明記した。**この現物の構成はI2C向けになった（**根拠はユーザーの申告であり実測ではない。`CSB`と`VDD`の電気的な接続は判定していない**） |
| 2026-09-23 | 17 | [#461](https://github.com/wachi-yoshitaka-11-dev/deskcat/issues/461)。**`Backlight回路／電流／polarity`行の末尾が、`HW-TBD-024`が未解決の間は`LED` pinへの3.3V直結を判定できないとしていたが、この記述は2026-09-23（ユーザー承認）に偽になった。**`HW-TBD-024`は今も未公開のまま未解決だが、`LED` pinを3.3Vへ直結する構成（backlight点灯を含む）自体を一律に妨げる扱いは終了した。判断根拠・残る限定は[tbd-register.md](tbd-register.md)の`HW-TBD-024`行（[#461](https://github.com/wachi-yoshitaka-11-dev/deskcat/issues/461)）を参照し、ここへ再掲しない。値・配線規則・他の記述は変えていない |
| 2026-09-24 | 18 | [#472](https://github.com/wachi-yoshitaka-11-dev/deskcat/issues/472)（[PR #471](https://github.com/wachi-yoshitaka-11-dev/deskcat/pull/471)のCodeRabbit review指摘）。`closeまでに要ること（実装と確認を含む）`の後の段落への2026-09-22追記が挙げた欠落(1)（I2Cを採る決定がどの正本にも無い）を埋めた。**2026-09-24にユーザーがI2Cの採用を承認した**ことを日付つきの追記で残し、[hardware-bom.md](hardware-bom.md)と[tbd-register.md](tbd-register.md)の`HW-TBD-005`にも同じ決定を記録した。**欠落(2)は判定していない。**あわせて、`closeまでに要ること`表の#3〜#5へ、`EXP-015`とADXL345側のpin接続の確定（2026-08-27）より前の記述であることを日付つきで追記した。**表の状態列の判定は変えていない。既存の文言は書き換えていない** |
| 2026-09-28 | 19 | [#13](https://github.com/wachi-yoshitaka-11-dev/deskcat/issues/13)。LCD moduleの表の`Color format／order`（TBD）と`対応orientation command`（TBD）を、[experiment-log.md](experiment-log.md)の`EXP-018`の結果で埋めた。byte order（big-endian）と色の並び（BGR）は別の事柄として分けて書いた。`解像度`行の「どちらをdriverの基準にするかはbench試験で確定する」を、firmwareが横向き（320×240）を基準にすることへ改めた（物理の240×320の記述は変えていない）。`Readback機能`行へ、IDの読み出しが期待する値を返さず、firmwareは読み出しを行わないことを足した |
| 2026-10-09 | 20 | [#21](https://github.com/wachi-yoshitaka-11-dev/deskcat/issues/21)のF1。ADXL345の`ICの値`の表へ、tap検出のregister（`BW_RATE`・`THRESH_TAP`・`DUR`・`TAP_AXES`・`POWER_CTL`・`INT_ENABLE`・`INT_SOURCE`）を、Rev. 0で読んだ値として足し、`Output data rate`行に`tap-21`が100 Hzを書くことを足した（Rev. Gでの確認は未了） |
| 2026-10-18 | 21 | [#15](https://github.com/wachi-yoshitaka-11-dev/deskcat/issues/15)。`ICの値`の表の`Filter／FIFO機能`行へ、`accel-sample-15`の試験buildが使うFIFO modeは`crates/deskcat-accel`が持つ暫定の一般値であり、この表の値ではなく、Rev. Gで確認していないことを足した。製品のdriverでどれを使うかはTBDのままである |
| 2026-10-21 | 22 | [#14](https://github.com/wachi-yoshitaka-11-dev/deskcat/issues/14)。`Touch controller`節の`TBD`のうち、`XPT2046 Data Sheet 2007.5`（XPTEK、販売店mirror、sha256を記録）から読める欄を埋めた。**SPI mode（Mode 0）、bus速度の上限（2.5 MHz）、制御byteの16進値、24 clock転送のbit位置、`DOUT`のhigh impedanceは、資料が明記した値ではなく導出であり、そのまま書いた。**資料の欠陥（表4の見出しの誤記、`DOUT`の説明の途切れ）も記録した。`RX-plate`、`Module pull-up`、`Calibration方法`、検証済みbus速度は`TBD`のまま。実機には触れていない |
| 2026-10-25 | 23 | [#16](https://github.com/wachi-yoshitaka-11-dev/deskcat/issues/16)。`Environmental sensor`節の`精度と分解能`行の精度を、Bosch Rev 1.24の`Table 2`〜`Table 4`（2026-10-24に取得し直した版で、`Table 4`の頁を画像で確かめた）の条件つきの値へ直した。温度は±1 ℃と書いていたが、表は±0.5 ℃（0〜65 ℃）で、内部の温度センサーの値であることを足した。湿度（20〜80 %RH、25 ℃、hysteresis込み）と気圧（300〜1100 hPa、0〜65 ℃）には条件を足した |
| 2026-11-10 | 24 | [#487](https://github.com/wachi-yoshitaka-11-dev/deskcat/issues/487)。`Touch controller`節へ、XPTEK自身のsiteから取得した版（sha256を記録。2007.5の版との同一性は未照合）を足し、表へ「電源電流（VCCとIOVDDの合計）」行を足した（静止電流・power-down・touch panel駆動switchの導通抵抗と駆動電流）。ほかの行は変えていない |
| 2026-11-11 | 25 | [#487](https://github.com/wachi-yoshitaka-11-dev/deskcat/issues/487)。`HW-TBD-005`を閉じたことに合わせ、`Environmental sensor`節の`CRC／data integrity動作`行を`対象外`に、`推奨測定rate`行を`env.rs`（レジスタの値）と`env_report.rs`（周期）への参照に、`Module pull-up`行の未決の書き方を解決行への参照に直した。日付つきの記述は書き換えず、`Interface`行、`J1`／`J2`の判断を扱う文、`closeまでに要ること`の#3〜#5へ、日付つきの`2026-11-11追記`を足した |
| 2026-11-11 | 26 | [#685](https://github.com/wachi-yoshitaka-11-dev/deskcat/issues/685)。ADXL345の`ICの値`の表へ、揺れ検出（Activity）のregister（`THRESH_ACT`・`ACT_INACT_CTL`・`INT_ENABLE`と`INT_SOURCE`のD4）を足した。**出所はRev. E（販売店の写し）で、公式のRev. Gとは照合していない**。値は`TBD` |
