wachi-yoshitaka-11-dev/deskcat/docs/hardware/enclosure-and-neck.md

# #34 筐体・実装基板・首機構の設計案

> 状態: 3つの方式は、2026-10-14 にユーザーが選んだ（[記録](https://github.com/wachi-yoshitaka-11-dev/deskcat/issues/34#issuecomment-6172627887)）。首の固定方法は 2026-11-01 に実機側の PM が選んだ（[決定の記録](https://github.com/wachi-yoshitaka-11-dev/deskcat/issues/34#issuecomment-6552579410)）。頭の保持枠・天板の線の通り道・14線の取り回しは 2026-11-11 に実機側の PM が決めた（[下の節](#頭の保持枠天板の線の通り道14線の取り回し2026-11-11実機側の-pm現物に当てる前)）。寸法・固定具・ねじは `TBD` を含み、現物適合は未了。製作、購入、通電、サーボ駆動の許可ではない。
> 基準: [Issue #34](https://github.com/wachi-yoshitaka-11-dev/deskcat/issues/34)、[BOM](hardware-bom.md)、[電源](power-budget.md)、[GPIO](gpio-assignment.md)、[サーボ安全制限](servo-safety-limits.md)、[TBD 台帳](tbd-register.md)。日程は GitHub project 5 の board を正とする。

## 選ぶ方式と理由

| 対象 | レビューに出す方式 | 判断の根拠と範囲 |
|---|---|---|
| 胴内の実装 | 最終の電源実装先には、選定済みの片面ユニバーサル基板 `PROTO-02` を使う方式を提案する。仮筐体では未結線の基板と Pi・ESP32 の現物を仮置きし、配置と固定位置を確認する | [BOM の `PROTO-02`](hardware-bom.md) と [電源経路](power-budget.md) は大電流経路に breadboard 接点や定格不明のジャンパー線を使わず、基板パターンにも大電流を流さない。breadboard 継続は完成品の電源実装に不適。custom 基板は現物配置と配線が未確定の段階では根拠が足りない。電源部品の結線・はんだ付けは [#405](https://github.com/wachi-yoshitaka-11-dev/deskcat/issues/405) の開始条件を満たした後の作業であり、#34 の配置確認では行わない |
| 仮筐体 | 胴と頭をスチレンボードまたは段ボールで作り、着脱可能な補強板とねじ留め部を設ける。背面を開けられる構造とし、USB・端子・配線へアクセスする | [#34 の記録（回答と承認された方針）](https://github.com/wachi-yoshitaka-11-dev/deskcat/issues/34#issuecomment-5863029148)。3D プリンターは使わない。外観は [コンセプト画像](https://github.com/wachi-yoshitaka-11-dev/deskcat/blob/develop/pages/assets/deskcat-concept.jpg)を目標とするが、外形寸法と本番材料は仮筐体の現物測定後に決める |
| 首 | 1 軸の横振り。サーボ本体の取付耳を胴の補強付き天板へ固定し、垂直な出力軸のホーンを頭の底板へ固定する。頭に載せる電気部品は LCD/touch のみとする | [#34 の記録（回答と承認された方針）](https://github.com/wachi-yoshitaka-11-dev/deskcat/issues/34#issuecomment-5863029148)。これで首の回転方向と固定先を一つに絞る。ホーンの穴、ねじ、胴とのすき間は未測定であり、この記述だけでは固定方法を確定しない |

胴には Pi、ESP32、`PROTO-02`、電源関連部品、加速度センサーを収める配置と固定位置を検討する。BME280 は Pi の熱から離した通気位置を候補とし、熱影響は現物で確かめる。基板、電源部、ケーブル、サーボの交換と抜き差しが背面からできる配置にする。各基板の固定穴と電子部品の下面に干渉しない絶縁スペーサー／固定台の材質と寸法は現物から決める。#34 では未結線で現物合わせし、電源経路のはんだ付け・結線は行わない。#405 は段階 B-2 の定常電流と必要な単体確認を入力とする。GPIO の割当もここでは変更しない。

## 首と頭の固定を現物で確定する手順

1. 電源を外した状態で、LCD 基板の外形、表示・touch 面、取付穴、背面突起、14 pin の向き、サーボ本体・取付耳・ホーンの形状と穴、頭の底板を測って、寸法の値と測り方を記録する（写真は Git にも Issue にも上げない。撮った場合は値と sha256 だけを残す）。メーカーが想定しない不可逆な分解はしない。
2. LCD 基板の部品・配線・touch 面を押さえない着脱式の保持枠を頭に作る。サーボ本体は取付耳で胴の補強板へ、ホーンは頭の底板へ、どちらも帯（結束バンド）で固定する（[選んだ首の固定方法](#選んだ首の固定方法2026-11-01実機側の-pm実物に当てる前)。耳とホーンの穴には通さない）。切り込みの位置、帯の幅、緩み止め、補強板の厚さは `TBD` とし、現物で嵌合と保持を確認してから記録する。
3. サーボを駆動せず、出力軸も手で回さない。頭を軸に嵌めない状態で、頭の底板・胴天板・配線の寸法を照合し、頭の回転中心とのすき間、配線と筐体の干渉、首の想定回転方向における配線逃げを確認する。ホーンと固定具の嵌合、固定位置、干渉を寸法の値で示す。ホーンだけで頭の荷重を安全に支えられるという動作上の主張はこの確認から導かない。
4. #34 の完了条件は、全部品の配置方式、仮筐体方式、実物のサーボ・ホーンに適合する首の固定方法と干渉の確認を示し、人間が3方式を選定した記録である。サーボへの通電、荷重をかけた駆動、角度・neutral の校正はここに含めない。

後続の [#17](https://github.com/wachi-yoshitaka-11-dev/deskcat/issues/17) はサーボの電気動作の確認、[#18](https://github.com/wachi-yoshitaka-11-dev/deskcat/issues/18) は #34 の固定方法を入力とした可動域と動作制限の校正である。仮筐体を作った後に #18 を行う。頭の荷重を伴う動作適合は、必要なサーボ出力 gate と人間の監視を満たしてから後続試験で判断する。#17・#18 の結果を #34 の完了条件にはしない。

## 頭と胴の14線

[MSP2807 の資料](https://akizukidenshi.com/goodsaffix/msp2807.pdf)は LCD/touch の 14 pin を列挙する。[#34 の決定](https://github.com/wachi-yoshitaka-11-dev/deskcat/issues/34#issuecomment-5864974935)に従い、14 pin をそれぞれ首に通し、touch 側の `T_CLK`／`T_DIN`／`T_DO` を胴側で LCD 側の `SCK`／`SDI`／`SDO` と対応付ける。11線化のため頭内に分岐基板を置く案は採らない。対応表は接続の識別用であり、現物の向きと [GPIO 正本](gpio-assignment.md)との照合前に通電してよいという意味ではない。

| LCD pin | 表記 | 胴側での接続先 |
|---:|---|---|
| 1 | VCC | LCD 電源経路。電流上限・供給経路は [電源](power-budget.md)を参照 |
| 2 | GND | LCD GND 戻り。経路は [電源](power-budget.md)を参照 |
| 3 | CS | LCD-CS |
| 4 | RESET | LCD-RST |
| 5 | DC/RS | LCD-DC |
| 6 | SDI | LCD-MOSI、pin 12 と同じ信号 |
| 7 | SCK | LCD-SCLK、pin 10 と同じ信号 |
| 8 | LED | LCD-BL |
| 9 | SDO | LCD-MISO、pin 13 と同じ信号 |
| 10 | T_CLK | pin 7 と同じ信号 |
| 11 | T_CS | TOUCH-CS |
| 12 | T_DIN | pin 6 と同じ信号 |
| 13 | T_DO | pin 9 と同じ信号 |
| 14 | T_IRQ | TOUCH-IRQ |

### 仮筐体

[手持ち品についてのユーザー申告](https://github.com/wachi-yoshitaka-11-dev/deskcat/issues/34#issuecomment-5866477571)と[最新の訂正](https://github.com/wachi-yoshitaka-11-dev/deskcat/issues/34#issuecomment-5868309922)に従い、両端メスのジャンパー線14本を使う。14線を両端で番号付けし、一本ずつ導通と隣接線間の短絡がないことを電源 off で確認する。線を首に挟まず、コネクタを引っ張らないよう胴と頭の固定部へ余長を逃がす。手持ち線の長さ、端子の保持、首の動きへの適合は未確認であり、反復屈曲の最終配線として認定しない。購入候補だった圧着済み QI コードはこの段階に追加しない。

### 本番筐体の可動部ケーブルと未解決点

[後のユーザー決定](https://github.com/wachi-yoshitaka-11-dev/deskcat/issues/488#issuecomment-5868574686)に従い、本番筐体の可動部ケーブルは、その段階で手持ち品から検討する。[#34 で記録した `KRT` AWG28 の 8C＋6C](https://github.com/wachi-yoshitaka-11-dev/deskcat/issues/34#issuecomment-5864974935)は過去の候補であり、採用や購入を前提にしない。`KRT` が手持ちにあるかも未確認である。同じく、[ジャンパー線の端を切って `KRT` へはんだ付けする案](https://github.com/wachi-yoshitaka-11-dev/deskcat/issues/34#issuecomment-5868309922)は現行の製作指示ではない。手持ち品の加工は、ケーブルと端末方式を選んだ後に別途判断する。

仮筐体では14線の通り道と胴・頭側の固定位置を現物で確かめる。本番筐体では手持ち品の芯数、長さ、導体、端子の嵌合を確認してから、14本の識別と端末・絶縁方式を選ぶ。首の曲げ・ねじりを受ける区間、余長、最小曲げ半径、固定点間隔と被覆の保持方法は `TBD`。U 字の余長を設ける場合も筐体との干渉を現物で確かめ、接続部に曲げ・引張荷重を受けさせない。手持ち品には反復屈曲の資料が無いことを[#488 の決定](https://github.com/wachi-yoshitaka-11-dev/deskcat/issues/488#issuecomment-5868574686)が弱点として記録している。

LCD の消費電流、特にバックライトは `HW-TBD-024` が未解決である。選ぶ手持ち線の VCC・GND 経路も、許容電流を含む適合は未確認。給電する前に [電源](power-budget.md)の該当 gate と、線材・接点・端末を含む経路の電流条件を満たす根拠を揃える。胴側で共有信号を接続するため、実ケーブルの長さで SPI の波形・表示・touch 通信も未確認である。固定クロックと現物での試験条件は [GPIO 正本](gpio-assignment.md)および #13 の結果を参照し、#13 の文書変更と同じ行をこの Issue では編集しない。#24 の反復動作試験も別途必要である。

## #34 の現物確認と後続試験

| 対象 | #34 で人間が現物から示すもの | 後続で確認すること |
|---|---|---|
| 収納・固定 | 全部品を未結線で現物配置したときの寸法の値。Pi、ESP32、電源基板、LCD、センサー、サーボの取付位置・高さ・配線出口・USB アクセス・通気を確認し、仮筐体と固定方法を選ぶ | 電源部品のはんだ付けと実配線の確認は #405。仮筐体の外形、ねじ、固定具は現物確認まで `TBD` |
| 首 | 現物のホーン、取付耳、固定具の嵌合、固定位置、頭と胴の干渉、配線の逃げを寸法の値で確認し、固定方法を選ぶ | サーボの電気動作は #17、荷重を伴う駆動と校正は #18 の gate の下で確認する |
| 仮配線 | 手持ち線14本の識別、長さ、端子保持、1対1導通、短絡なし、首での取り回しを非通電で確認 | 通電しての SPI/touch 通信と反復動作は別途確認する |
| 本番筐体の首配線 | 仮筐体で14線の取り回しに必要な空間と胴・頭側の固定位置を現物で検討する | 本番筐体の段階で手持ち品からケーブルを検討する。端末と絶縁、許容電流、最小曲げ半径とねじり逃げ、実ケーブルでの SPI/touch 通信、#24 の反復試験は未確認 |

この案で Issue の3受け入れ条件に対する方式候補は具体化した。現物適合が揃うまで、受け入れ条件のチェックを付けず、Issue を close しない。

## 決定案と、ユーザーの選定

> 3つの決定は、2026-10-14 にユーザーが推奨のとおり選んだ。費用の判断はユーザーのものであり、購入・発注はこの文書も作業セッションも決めない。

### 前提（ユーザーの回答と、ユーザーが承認した方針。選択肢を作る前に固定する）

出所は[2026-09-28 の記録](https://github.com/wachi-yoshitaka-11-dev/deskcat/issues/34#issuecomment-5863029148)。「ユーザーの回答」の節と、AI の提案をユーザーが記録承認した「方針」の節がある。

- 3D プリンターは使えない。→ 3D 印刷の部品・筐体は選択肢に入れない。
- 首は簡単な横振り（1軸、サーボの軸を縦）。→ うなずき（2軸目）は入れない。承認された方針の文は「頭の重さは軸受けにかかり、うなずき式のように重力に逆らって支え続けない」（AI の提案をユーザーが記録承認したもの）。
- 頭に載せるのは LCD（touch 付き）だけ。→ 基板類を頭へ載せる案（ESP32 を頭へ置く案を含む）は入れない。
- 仮筐体は紙系材料。本番は仮筐体の寸法から決め、#405 のはんだ付けの前に確定する。

### 選定（2026-10-14、ユーザー）

出所は[ユーザーの回答の記録](https://github.com/wachi-yoshitaka-11-dev/deskcat/issues/34#issuecomment-6172627887)。

- 実装方式: 仮筐体ではブレッドボードのまま。電源部は `PROTO-02`。
- 筐体方式: 仮筐体は手作りで、胴の背面を開けられる。本番の材料は、仮筐体の寸法が出てから選ぶ。
- 首機構: 横振りの1軸。付属の十字形ホーンを頭の底板へ。首を通す14線は、サーボ脇を通す（2026-09-28 の「首の中心をたるませて通す」を直す案を、ユーザーが承認した。[記録](https://github.com/wachi-yoshitaka-11-dev/deskcat/issues/34#issuecomment-6172543174)）。

### 決定1: 実装方式

| 案 | 利点 | 欠点・未確認 | 出所 |
|---|---|---|---|
| A. breadboard 継続 | 手元にある。#13〜#16 の bring-up の配線を変えやすい | 電源の大電流経路に breadboard の接点を使わない方針と合わない。筐体内で固定できない。首振りの振動での抜けは未確認 | [BOM `PROTO-02`](hardware-bom.md)、[電源](power-budget.md) |
| B. ユニバーサル基板 `PROTO-02`（72×47.5 mm） | 電源部品（`PROT-OC-01`、`PROT-RP-01`、端子台）の実装先として BOM が選定済み。取付穴径 3.2 mm（BOM）。取付穴の間隔は未確認 | Pi・ESP32・周辺 module をこの基板に載せるか、別に固定してコネクタで受けるかは記録が無い。基板上の座標は着荷後の現物合わせ（Owner: Human） | [BOM](hardware-bom.md)、[秋月 100517](https://akizukidenshi.com/catalog/g/g100517/)、[#405](https://github.com/wachi-yoshitaka-11-dev/deskcat/issues/405) |
| C. custom 基板 | 寸法と接続を自由に決められる | 発注と費用が要る。現物配置と配線が決まる前は、寸法と接続の入力が無い | [#34 の記録（回答と承認された方針）](https://github.com/wachi-yoshitaka-11-dev/deskcat/issues/34#issuecomment-5863029148) |

推奨: **仮筐体では A のまま、未結線の `PROTO-02` を置き合わせる。最終の電源実装は B。**C は仮筐体の寸法が決まってから、必要が出た場合に検討する。理由は、電源経路に A が合わず、C には根拠となる寸法がまだ無いことによる。

### 決定2: 筐体方式

| 案 | 利点 | 欠点・未確認 | 出所 |
|---|---|---|---|
| A. 既製ケース | 作る手間が少ない | 頭と胴が分かれて首が通る構成に合う既製ケースがあるかは、この session では探していない。胴に既製のプラ容器を流用する案は、2026-09-28 の承認された方針にある（本番の候補） | [記録](https://github.com/wachi-yoshitaka-11-dev/deskcat/issues/34#issuecomment-5863029148) |
| B. 自作（仮は紙系、本番は容器または MDF） | 作り直しがきく。背面を開けられる。頭と胴を分けられる | 材料の厚みと、頭底板がホーンの荷重を受けられるかは未確認 | 同上 |
| C. 当面 breadboard 露出 | 追加の工作が要らない | 頭を載せた状態の #18 の校正ができない（承認された方針の「進め方」は「#18 の校正は仮筐体に頭を載せた状態で行う」）。#34 の受け入れ条件のうち、首の固定方法が示せない | [記録](https://github.com/wachi-yoshitaka-11-dev/deskcat/issues/34#issuecomment-5863029148) |

推奨: **仮筐体は B（紙系材料、背面開閉、補強板つき）。本番の材料（流用する容器か MDF か）は、仮筐体の寸法が出てから人間が選ぶ。**C は #18 の前提を満たさない。

### 決定3: 首機構

固定する形: サーボ本体の取付耳を胴の補強天板へ。出力軸は上向き。ホーンを頭の底板へ。

| 論点 | 選択肢 | 利点・欠点・未確認 |
|---|---|---|
| ホーン | 十字形／細長い両腕／短い片腕（付属品。[ユーザー申告](https://github.com/wachi-yoshitaka-11-dev/deskcat/issues/34#issuecomment-5890447239)） | 十字形と両腕は対向する2点で固定でき、片腕は1点になる。付属の十字形ホーンのねじ穴に、付属の黒いねじ（長いほう）が通ることは、ユーザーの申告（[記録](https://github.com/wachi-yoshitaka-11-dev/deskcat/issues/34#issuecomment-6172543174)）。穴径・穴間隔・軸穴の嵌合・ねじ径と長さは未測定 |
| 頭の荷重の受け方 | (a) ホーンだけで受ける／(b) 頭底板の縁を胴天板の上で滑らせて受け、軸は回すだけにする | (a)(b) とも、SG90 の出力軸が頭の鉛直荷重を受けられるかを示す一次資料は、この session では確認していない。(b) は摩擦でサーボの負荷が増え、拘束に近づく可能性がある。頭の質量と摩擦の負荷は未測定で、#18 の監視下の試験で確かめる |
| 14線の通し方 | 天板のサーボ脇の穴を通す／サーボ本体の外側を回す | 天板中央にサーボ本体を置くと、首の「中心」はサーボ本体が占める。2026-09-28 の「首の中心をたるませて通す」を「サーボ脇の穴を通す」に直すことを、2026-10-14 にユーザーが承認した。この場合、ねじれに加えて曲げと伸びを受ける。余長と最小曲げ半径は `TBD` |
| 可動域の限界 | ケーブル、頭と胴の接触のどちらで機械的に止まるか | **持続的拘束は[安全要件の5項目](../governance/hardware-safety-policy.md#安全要件の5項目)の1つ。**頭が胴またはケーブルに当たったまま PWM を出し続ける構成は、サーボの過熱の原因になる。可動域の確定は #18 だが、当たる位置が機構で決まる。#34 では干渉が起きうる位置を現物で洗い出す |

推奨: **ホーンは十字形を第一候補。荷重の受け方は、#34 では (a)(b) を寸法で比べるだけにし、荷重をかけた確認は #18 の監視下の試験に送る。14線の通し方は、サーボ脇（ユーザーが承認）。**根拠は資料の寸法で、嵌合・固定具・頭の質量は未測定である。

### 選んだ首の固定方法（2026-11-01、実機側の PM。実物に当てる前）

出所は[決定の記録](https://github.com/wachi-yoshitaka-11-dev/deskcat/issues/34#issuecomment-6552579410)（実機側の PM が直した4点）と、実機側の PM が4点を直して採用した[作業セッションの案の本文](https://github.com/wachi-yoshitaka-11-dev/deskcat/issues/34#issuecomment-6552629703)（表の「十字形」「底板の中央」「両面テープは補助」「天板の切り欠き」「(a)」はこの案に由来する）。入力は[ユーザーの回答と資料の読み取り](https://github.com/wachi-yoshitaka-11-dev/deskcat/issues/34#issuecomment-6552567539)。**PM の決定であり、実物に当てた確認ではない。受け入れ条件2は未達のままである。**

| 部位 | 選んだ方式 | `TBD`・未確認 |
|---|---|---|
| サーボ本体 | 胴の天板に切り欠きを開けて本体を通す。取付耳の上から、天板に開けた切り込み2つへ通した帯（結束バンド）をかぶせて締める。**耳の穴には通さない。付属の短い黒ねじは使わない**（段ボールにねじが効かないため） | 段ボールの厚みと、天板を何枚重ねるか（**厚みが分かってから決める**）。切り欠きの寸法。耳の穴は丸で縁が一部欠けている（ユーザーの回答。欠けの形は未確認） |
| ホーン | 十字形。頭の底板の中央へ。向かい合う2本の腕の上から、底板に開けた切り込み2つへ通した帯をかぶせて締める。**腕の穴には通さない。**両面テープは補助 | 腕の穴数（ユーザーの回答は短いほうの数字が欠けていて読み取れない）。ホーンの高さと底板の位置 |
| ホーンと出力軸 | 軸へ押し込むだけ。**軸を手で回さない**（歯車を傷めるおそれ）。中心の固定にはサーボに付属の小ねじを使う前提 | 小ねじの種類・径・長さ |
| 14線 | 天板のサーボ脇の穴を通す（2026-11-11 に、天板の縁からの切り込みへ改めた。[下の節](#頭の保持枠天板の線の通り道14線の取り回し2026-11-11実機側の-pm現物に当てる前)）。余長は「首を動かす範囲いっぱいまで回しても線が張らない長さ」 | 動かす範囲は #18 で決まるため、余長の確認は #18 の窓。最小曲げ半径。線の長さは20cm（ユーザーの申告、2026-11-01）。端子の保持は回答なし |
| 頭の荷重 | ホーンだけで受ける（(a)）で記録する | **確かめていない。#18 の監視下の試験へ送る** |

計算値（SG90 の寸法表の記号の読みによる。実物では未測定）：取付耳の面から本体の上面まで 10 mm（C−F）、耳の面から出力軸の先まで 13.3 mm（A−F）、耳の面より下に出る本体 17 mm（F）。

### 14線に関する未確認の点（推奨の根拠にしない）

頭へ通す14線は、LCD の14 pin と同じ数で、VCC・GND を含む。`gpio-assignment.md` と `power-budget.md` には、頭と胴の間を通す線の本数・ケーブルを述べた記述が無い（2026-10-14、「首」「頭と胴」などの語で検索して、記述が見つからなかった。語の検索であり、全行の通読ではない）。LCD の14 pin の定義は[sensor-datasheet-notes.md](sensor-datasheet-notes.md)の `pin定義（datasheet記載、14pin）` が持つ。首を通す線の本数と経路は、検索した範囲ではこの文書と #34 の記録にだけ現れる。VCC・GND の許容電流は、LCD のバックライト電流が未解決（`HW-TBD-024`）で、手持ちのジャンパー線の許容電流も未確認である。実ケーブル長での SPI と touch の通信は未確認。これらは推奨の理由に使わない。

資料で分かった寸法と、その出所（取得日、sha256、読み取りの注記）は、#34 の記録にある（[1](https://github.com/wachi-yoshitaka-11-dev/deskcat/issues/34#issuecomment-6172543174)、[2](https://github.com/wachi-yoshitaka-11-dev/deskcat/issues/34#issuecomment-6172627887)）。docs へは、仮筐体の寸法を決める時に載せる。

### 現物の当て合わせ（残り。非通電。2026-11-01 に1回訊いた。答えは[記録](https://github.com/wachi-yoshitaka-11-dev/deskcat/issues/34#issuecomment-6552567539)、回答のない項目は未確認のまま）

**#34 の当て合わせでは、サーボの出力軸を手で回さない**（軸の自由回転の確認は、#17 の初回動作の手順 `ホーン除去`（[servo-safety-limits.md](servo-safety-limits.md)）が持つ）。干渉の確認は、頭を軸に嵌めない状態の寸法の照合で行う。

1. サーボの取付耳の穴の間隔・穴径・厚み、ホーンの穴径・穴間隔・腕の長さ・軸穴、付属ねじの径と長さ、出力軸への嵌合（嵌めて回さない）（資料に無い）。
2. Pi Zero W と ESP32 開発ボードの高さ（ヘッダー・USB コネクタを含む）。ピンの列が実装されているか。Pi Zero W の USB の向きは公式の図から読み取った（長辺側に micro USB 2つ。図の読み取りで、測定値ではない。[記録](https://github.com/wachi-yoshitaka-11-dev/deskcat/issues/34#issuecomment-6552567539)）。MCU-01 の USB の向きは、結線表（[wiring-table.md](https://github.com/wachi-yoshitaka-11-dev/deskcat/blob/develop/hardware/breadboard-rebuild/wiring-table.md)）の MCU-01 の行が「USB を30列の側（板の端）、アンテナを12列の側にする」と記す（結線表の記述。DevKitC V4 の図は外形が違うため使わない）。
3. ADXL345 の取付穴と実装後の高さ（資料が取得できない）。取付穴は、ユーザーの回答で0個（2026-11-03、現物を抜かずに見た）。実装後の高さは未確認（`TBD`）。
4. 仮配線14本を頭と胴に仮置きしたときの有効長と、端子の保持（回答なし。線そのものの長さは 20cm の申告）。
5. 段ボールの厚み（ユーザーの回答：1枚 約2.5 mm、2枚重ね 約5 mm。2026-11-03。定規で、おおよその値（人間が測定）。この後の当て合わせは発泡スチロールで行った。[下の記録](#現物に当てた記録2026-11-03非通電発泡スチロール)）。固定具の手持ちは両面テープと結束バンド（ユーザーの回答）。
6. 机上に置ける最大寸法の希望：無し（ユーザーの回答）。

### 現物に当てた記録（2026-11-03、非通電、発泡スチロール）

[選んだ首の固定方法](#選んだ首の固定方法2026-11-01実機側の-pm実物に当てる前)を、非通電で現物に当てた。**見たことだけを書く。**答えはユーザーの回答（はい・いいえと数字）による。写真は取っていない。測定は求めていない。**サーボに通電していない。サーボの軸は回していない。ホーンは軸に嵌めていない。Pi・ESP32・14本の線には触れていない。**

- **材料：**ユーザーが、段ボールの代わりに発泡スチロールを使った（段ボールで切ったり当てたりはしていない）。厚みはユーザーの回答で、発泡スチロール1枚 約14 mm、2枚重ね 約28 mm（定規で、おおよその値。人間が測定）。
- **天板：**発泡スチロール1枚、縦40 mm × 横70 mm（作業セッションが決めた作業用の寸法。資料の値ではない）。天板を1枚にしたのは作業セッションの判断で、2枚重ねにはしていない。理由：2枚重ね（約28 mm）だと、耳の面から 17 mm 下の本体の底が、板の中に埋まって板の下へ出ないため。この 17 mm は SG90 の寸法表から出した計算値（上の「計算値」）で、実物では測っていない。
- **切り欠き：**サーボの四角い本体の外形を、軸を上にして鉛筆でなぞり、線の内側を切った。切り欠きの寸法は測っていない。
- **サーボ本体：**切り欠きに入った。耳は発泡スチロールの上に載った。本体は傾いていない（いずれも人間が確認した）。
- **耳の帯：**切り込み4か所（耳ごとに手前側と奥側の1つずつ）、結束バンド2本（耳1つに1本）。帯は耳をまたぐだけで、耳の穴には差し込まず、軸にも触れていない（止まる点B・Cの確認は、人間が確認した）。締めたあと、本体を横から軽く押して、動かなかった。締めたときに耳が割れそうな音がしたかは、訊いていない。
- **底板：**発泡スチロール1枚、縦60 mm × 横60 mm（作業用の寸法。資料の値ではない）。十字形ホーンは、60 mm 角の底板に収まった（ユーザーの回答）。
- **ホーンの帯：**切り込み4か所（向かい合う2本の腕に、腕ごとに手前側と奥側の1つずつ）、結束バンド2本。帯は腕をまたぐだけで、腕の穴には差し込まず、軸穴もふさいでいない（止まる点Dの確認は、人間が確認した）。締めたあと、ホーンを軽く押して、動かなかった。両面テープは使っていない。
- **見て答えたもの：**
  - 取付耳の穴の縁の欠けの形：選び直しの回答を求めず、2026-11-01 の回答（穴が丸く縁が一部欠けている。ねじは丸い穴には入るが縁の欠けには通らない、との申告。原文は省略）のままにする。形は未確認。
  - ホーンの短いほうの腕の穴の数：2（ユーザーの回答。質問は「1本につき何個か」）。
  - ADXL345 のモジュールの取付穴：0（上の項目3）。
- **止まる点A〜E：**Aは、人間がなぞれた。B・C・Dは、人間が確認した。Eは、手順の確認「2本とも腕の上をまたいで通ったか」が同じ内容だったため、別に訊いていない。おかしいと感じたことの申告は無かった。
- **確かめていないこと：**段ボールでの切り欠き・帯の保持。頭の重さをかけたときの保持（#18 の監視下の試験へ送る）。ホーンの軸への嵌合。14本の線の取り回しと端子の保持。帯の幅と切り込みの幅（測っていない）。発泡スチロールでの結果は、段ボールの結果の代わりにしない。
- **現物の状態：**後片付け（サーボを元の場所へ戻すこと）は未実施で、帯は切らず、サーボは天板に留めたままである。

### 頭の保持枠・天板の線の通り道・14線の取り回し（2026-11-11、実機側の PM。現物に当てる前）

**PM の決定であり、現物に当てた確認ではない。**#18 の段2で、最終と同じ荷重の頭（LCD と14線を載せ、LCD には通電しない）を使うために決める。**決めるのは、保持枠、天板の線の通り道、14線の取り回しの3つだけである。**筐体全体の設計へは広げない。材料は手持ちの発泡スチロール・段ボール・結束バンド・両面テープだけとし、購入しない。目的はデモであり、作り込まない。

**入力：**LCD 基板（`DISP-01`、MSP2807）の外形は PCB 50.0 × 86.0 mm、表示の領域は 43.2 × 57.6 mm（[sensor-datasheet-notes.md](sensor-datasheet-notes.md)の LCD module の表。datasheet の値で、現物では測っていない）。14 pin の header は、横向きにしたときの右の辺にある（同じ表の orientation の行）。底板は発泡スチロール 60 × 60 mm で、十字形ホーンを帯で留めてある（[現物に当てた記録](#現物に当てた記録2026-11-03非通電発泡スチロール)）。14線はメスオス（[wiring-table.md](https://github.com/wachi-yoshitaka-11-dev/deskcat/blob/develop/hardware/breadboard-rebuild/wiring-table.md)。#34 の決定の両端メスとは違う暫定）で、長さは 20 cm（ユーザーの申告、2026-11-01。上の[選んだ首の固定方法](#選んだ首の固定方法2026-11-01実機側の-pm実物に当てる前)の14線の行）。LCD のメス側は LCD に挿したまま、オス側は板に挿したままにする（抜いて挿し直さない。挿し間違えると電圧違いの pin へ入りうるため）。**ただし VCC の線（LCD pin 1、赤）は、[EXP-055](experiment-log.md) で板から抜いたまま、挿さない（EXP-056〜EXP-059 は抜いたままと記録し、EXP-060 以降は記録に無いので、手作業の前に抜けていることを見る）。**これが LCD に通電しない手段である（[servo-safety-limits.md](servo-safety-limits.md) の`通電前の現物確認`の (d)）。挿したままにするのは、ほかの13本である。抜いた VCC の線は束から分け、空いた端を頭の側（背板の後ろ）に帯とテープで留める。胴の側へ垂らさないのは、端子台 S の＋に入る servo 5 V の jumper wire の針（[servo-safety-limits.md](servo-safety-limits.md) の段0の2）に、空いた端が触れないようにするためである。挿したままの13本を通した LCD への回り込みがあるかは、確かめていない（`EXP-055` 以降、同じ状態のまま）。

| 部位 | 決めたこと | `TBD`・未確認 |
|---|---|---|
| 保持枠 | 段ボールの「背板」1枚を、底板の後ろの縁に立てる。背板は LCD 基板より一回り大きくし（作業用の寸法 約100 × 約65 mm。datasheet の外形に余白を足した値）、LCD を横向きで、表示面を前に向けて当てる。底板（60 mm）より横に長いので、左右にはみ出す。LCD は、基板の縁だけを背板に留める。留め方は、基板の四隅の外側の縁に、背板へ通した結束バンドをかける形とする。**部品・配線・touch 面・header には帯をかけない。**背板の下の辺は、底板の後ろの縁に沿わせ、底板の後ろ寄りに開けた切り込み2つへ通した結束バンドで留め、両面テープで補う。中央のホーンと、ホーンの帯の切り込みには重ねない | 背板の寸法は、LCD 基板の現物の外形を当ててから決める。帯をかける位置（取付穴の位置と、縁の部品の有無）。背板を留める切り込みが、ホーンの帯の切り込みと重ならない位置。背板の立ち方（倒れないか）。頭の質量と、重心が軸から後ろへずれること（どちらも測っていない） |
| 天板の線の通り道 | 天板（発泡スチロール 40 × 70 mm）の縁から、サーボの切り欠きの横まで、切り込み（スリット）を1本入れる。束ねた13本（VCC の線を除く）を、挿したまま横から滑り込ませる | 切り込みの位置（サーボの耳の帯の切り込みと重ならない所）と幅。切り込みで天板の強さが足りるか。線が切り込みから抜け出ないか（現物を当てて見る） |
| 14線の取り回し | VCC の線を除く13本を、LCD の header から背板の後ろへ回し、背板に結束バンドで1か所、緩く束ねる（端子を引っ張らない）。底板の縁を越えて下へ垂らし、天板の切り込みを通して胴の側へ出す。底板の縁と天板の切り込みの間に、首を回しても張らない余長を取る | 余長が足りるか（20 cm の線で、段2の可動域いっぱいまで回したとき）。最小曲げ半径。端子の保持 |

**頭の荷重：**ホーンだけで受ける（(a)。[選んだ首の固定方法](#選んだ首の固定方法2026-11-01実機側の-pm実物に当てる前)）。受けられるかは、#18 の段2の監視下で確かめる。

**ユーザーの手作業（#18 の段2の窓の前に、非通電で行う）：**
1. 段ボールで背板を切り、LCD を当てて大きさを合わせ、縁に帯をかけて留める（13本は挿したまま。VCC の線は抜いたまま、空いた端を背板の後ろに留める）。
2. 底板の後ろ寄りに切り込みを2つ入れ、背板を後ろの縁に立てて帯で留め、両面テープで補う。
3. 天板の縁から切り込みを入れ、束ねた13本を横から滑り込ませる。
4. 首を回さずに、余長を見て、張りそうなら束ね方を直す。

この手作業を窓のどこで行うかは、#18 の段2の窓の実行計画に書く。頭の荷重をかけた駆動の条件は、[servo-safety-limits.md](servo-safety-limits.md) の段2の節が持つ。この文書は形だけを決める。

**確かめていないこと：**LCD 基板の現物の外形と取付穴。頭の質量。背板が倒れないこと。余長が段2の可動域に足りること。端子の保持。LCD に通電しての表示（`HW-TBD-024`・#722 の TBD は変えない）。

### #17・#18・#14・#405 との関係

- [#17](https://github.com/wachi-yoshitaka-11-dev/deskcat/issues/17): 初回のサーボ動作（無負荷、ホーンを外す）は #34 を待たない。
- [#18](https://github.com/wachi-yoshitaka-11-dev/deskcat/issues/18): #34 の固定方法を入力とする。#18 の校正の完了は #34 の前提にしない。[servo-safety-limits.md の「機械組み立て」](servo-safety-limits.md#機械組み立て)の `Horn type と取付 index` などは #34 の結果を受けて #18 が埋める。
- [#14](https://github.com/wachi-yoshitaka-11-dev/deskcat/issues/14): 14線のうち touch 側の `T_CLK`／`T_DIN`／`T_DO` を胴側で LCD 側と対応付ける前提は、bring-up の配線と同じである。
- [#405](https://github.com/wachi-yoshitaka-11-dev/deskcat/issues/405): 本番筐体の寸法は、#405 のはんだ付けの前に確定する。#34 の仮筐体では電源部品のはんだ付けをしない。
