wachi-yoshitaka-11-dev/deskcat/docs/governance/hardware-safety-policy.md

# Hardware Safety Policy

> 状態: Active
> 適用範囲: DeskCatの電子回路、firmware出力、ベンチ試験、機械動作

## 1. 安全原則

いかなるfirmware機能も、損傷、予期しない動作、過熱、診断根拠の喪失を防ぐことより優先しない。

必要な電気的または機械的情報が不明な場合は、次を行う。

1. `TBD`と記録する。
2. 影響する出力を無効のままにする。
3. 必要な公式文書または測定を特定する。
4. 結果をハードウェアの正本文書へ記録した後にのみ再開する。

### 測定は現物を改変しない

**メーカーが公開対象として想定していない内部構造・情報を、分解・被覆除去など
不可逆な手段で取得しない。**安全要件5項目に効くか否かを問わない。

上の3（必要な公式文書または測定を特定する）が指す「測定」は、メーカーが提供した
外部interface（pin、コネクタなど）を、公開された条件の範囲内で使う経路に限る。
分解・被覆除去・封止の破壊など、現物を改変してメーカーが公開していない内部情報へ
アクセスする経路は含めない。

**非破壊で得られない値は、その値を必要とする構成を採らない。**値を取りにいくの
ではなく、構成を変える。

**この policy は、破壊的な確認へ進む経路を提供しない。**予備品の使用や人間の
承認を、値を取得するための例外として置かない。どうしてもその構成が必要な場合は、
[AGENTS.md](https://github.com/wachi-yoshitaka-11-dev/deskcat/blob/main/AGENTS.md)の
「判断に迷う場合は作業を止め、該当箇所を引用して人間へ確認する」に従う。**これは
人間の決定であり、この規則が用意する経路ではない。**

**ケーブルのコネクタを切って端子台へ直付けするような、通常の電子工作はこの節の
対象ではない。**その後に完成品としての定格をその区間の根拠に使えなくなる点は、
「[5項目の中での根拠の水準](#5項目の中での根拠の水準)」が扱う。

### 安全要件の5項目

**次の5項目は、外したときの帰結が部品またはboardの破損である。**
**根拠を要求し続ける。この5項目を減らさない。**

**要求する根拠の水準は、下の「[5項目の中での根拠の水準](#5項目の中での根拠の水準)」が定める。**
判定に効く数（A）は実際の値を要し、資格として求める数（B）は桁の余裕で足りる。
**この節に「一律で一次資料または実測」とは書かない。**2つの規則が並ぶと、
どちらを適用するかが決まらなくなる。

**この5項目は列挙であり、導出ではない。網羅性は証明していない。**
追加は安全側への変更であり、[ADR-0014](../decisions/0014-safety-requirements-and-general-values.md)の
改訂を要さない。**削除は要する。**

| 項目 | 外したときに起きること | 値と状態の正本 |
|---|---|---|
| **短絡** | **電源の供給能力が、経路の最弱部品の定格を上回る。****過電流保護部品（`PROT-OC-01`）が入るまで、故障電流を制限するものが経路に無い。**connectorと線材の発熱は秒から分のorderで進むため、人が読み取って電源を落とすのでは止まらない | [過電流保護（段階Cのgate）](../hardware/power-budget.md#過電流保護段階cのgate)、[power-budget](../hardware/power-budget.md)の`配線・保護表`。`HW-TBD-021`／`HW-TBD-022` |
| **逆極性** | 5 Vを逆に入れると、Pi・ESP32・moduleが同時に死ぬ | [逆極性保護のdesign review](../hardware/power-budget.md#逆極性保護のdesign-review)。`HW-TBD-030` |
| **給電経路の重複** | 電源系統は排他であり、2つ以上から同時に給電するとboardまたは電源が破損する | [ESP32の給電経路](../hardware/power-budget.md#esp32の給電経路最終の経路は未決定)。[§3 電源](#3-電源)のbackfeed確認と合わせて読む |
| **電圧違いのpinへ挿す** | 3.3 Vのpinへ5 Vを入れると、その部品が死ぬ | [§4 Logic信号とGPIO](#4-logic信号とgpio)。[GPIO割り当て](../hardware/gpio-assignment.md)。servoへ入れてよい電圧は`HW-TBD-035` |
| **servoの持続的拘束** | 開放loopのhobby servoは、機構に押し付けられても最大torqueを出し続け、静かに過熱してギアボックスが焼ける | [拘束（stall）と過負荷](../hardware/servo-safety-limits.md#拘束stallと過負荷)。`HW-TBD-020` |

**値と状態をここへ再掲しない。**正本が持つ。この表が持つのは「どれが安全要件か」だけである。
未確定項目の状態は[TBD台帳](../hardware/tbd-register.md)が正本である。

**この5項目は、gateの開閉とは別の話である。**どれが安全要件かを定めることは、
[サーボ出力を有効化してよい条件](../hardware/servo-safety-limits.md#サーボ出力を有効化してよい条件)や
技術ガイドのゲートを開くことではない。

### 5項目の中での根拠の水準

**この節は[ADR-0016](../decisions/0016-evidence-bar-inside-the-safety-requirements.md)（判定に効く数と資格として求める数を分ける）の決定を詳細化したものである。ADR-0016 は`Accepted`のまま、この節が現在の運用の正本である。**

**5項目に当たるからといって、公開された定格がすべての値に要るわけではない。**
本projectは学習とプロト開発である。**求める根拠の水準は、量産の型式認定ではない。**

**5項目の中でも、必要な根拠は2つに分かれる。分かれ目は「その数を変えたら結論が変わるか」である。**

| 種別 | 何か | 要求する根拠 |
|---|---|---|
| **A: 判定に効く数** | **機能の成否がその数で決まる。**値が違えば結論が変わる | **実際の値が要る。**一次資料でも実測でもよい。**値が無いなら、その部品を使わない** |
| **B: 資格として要求している数** | **桁の余裕で決着する。**値が多少違っても結論が変わらない | **公開されていないことだけを理由に却下しない。**経路の最悪値と比べて桁で余裕があることを示し、根拠と余裕を記録すれば足りる |

**Aの例。**ヒューズの溶断特性と電源の供給能力（切れるかどうかが決まる）。PTCの保持電流と
定常負荷（誤トリップするかが決まる）。logic閾値と駆動電圧（動くか、壊れるかが決まる）。
servoの可動域と機構の物理的境界（拘束するかが決まる）。

**Bはさらに2つに分かれる。**

**B-1: 別の条件で公開されており、余裕で決着するもの。**
例: 定常1 A付近で使う素子の`RDS(on)`が、`ID`=−15 Aでだけ規定されている。
**実在する値があるため、条件4つを満たせる。**

**B-2: どこにも公開されていないもの。**
例: 定格を1つも公開していないヒューズホルダ。遮断定格を公開していないヒューズ。
**公開されていないこと自体は却下理由にしない。**ただし**比較する実在値が無ければ
条件1を満たせない。**同等品の公開値、実測、または保守側に倒した選定で、比較対象を別に立てる。

**「同等品」と呼べる条件。3つとも満たす。**別の品の値を持ち込む以上、
**同等だと言えなければ、その値は選定品の根拠にならない。**

1. **どの品の値かを記録する。**メーカー名、型番、出所、日付。
   **粒度は、下の[一次資料に当たるもの](#一次資料に当たるもの)が乙へ課す条件2と同じである**
   （どの品に対する記述かが特定できること）
2. **選定品と違う点を書き出し、その違いが余裕の向きに働くことを示す。**構造、材料、接触の仕方、
   温度条件、電流の通り方のうち、**この値に効くものだけを見ればよい。**
   **違いが不利の向きに働く、または向きが分からない場合は使わない**
3. **保守側の値を採る。**同等品の値に幅があるときは悪い側を採る。**平均や代表値を採らない**

**3つを示せないなら、同等品の値は使わない。**実測へ回すか、保守側に倒した選定にする。
**「同じような部品だから」は同等性の根拠ではない。**

**B-2で「公開されていないから桁で余裕がある」とは言えない。**
非公開の値と桁は比べられない。言えるのは回路条件の側である
（例: 250 V定格のヒューズを5 V・3 Aの回路で遮断させる）。

#### 一次資料に当たるもの

**この文書と[AGENTS.md](https://github.com/wachi-yoshitaka-11-dev/deskcat/blob/main/AGENTS.md)は
「一次資料または実測」を繰り返し要求してきたが、「一次資料」が何を指すかを定めていなかった。**
ここで定める（[ADR-0017](../decisions/0017-what-counts-as-a-primary-source.md)）。**この節が正本である。**

**この節は、安全要件5項目に効く値だけを対象とする。**5項目に効かない値は下の
[5項目以外の扱い](#5項目以外の扱い)のとおり一般値で開始してよく、**甲乙丙の区分を通す必要は無い。
出所を問わない。**

**分かれ目は、出した主体と載り方の2つである。**

| 段 | 何か | 値の根拠としての扱い |
|---|---|---|
| **甲: メーカーの仕様書** | datasheet、製品ページの仕様表、回路図、公式SDK文書。**発行元が販売代理店を兼ねる会社であっても、その会社の自社製品についての仕様書はここに入る**（例: 秋月電子通商の`AE-`module） | **品の特定ができていれば、そのまま一次資料として使える**（特定の要求は下の段落。**表だけで読まない**） |
| **乙: メーカー自身による、仕様書以外の記述** | 公式siteのQ&A欄でのメーカー側の回答、現物に同梱された説明書、メーカーへの問い合わせの回答 | **下の3条件をすべて満たすときだけ使える** |
| **丙: メーカー以外** | **他社製品**を扱う販売代理店の商品ページ、第三者が掲載したPDF、解説記事、AIの一般知識 | **値の根拠にしない**（識別の扱いは下の[§2 必須の根拠](#2-必須の根拠)） |

**甲を使うときも、どの品に対する仕様書かが特定できることを要する。**
**これは乙の条件2と同じ問題であり、甲だから免除されるのではない。**
同名で仕様の異なる品が複数あるとき、**仕様書がメーカー発行であっても、現物がどれかを特定できなければ
その値は現物の根拠にならない。**model suffix、variant、revisionの一致を含めて確かめる。

**識別そのものの規則は[§2 必須の根拠](#2-必須の根拠)が持つ**（`正確なメーカー名とmodel suffix`、
`搭載ICだけではなくmodule boardの識別情報`を接続前に確認する）。**ここへ再掲しない。**
この節が定めるのは値の根拠としての格であり、**識別が済んでいることはその前提である。**

**甲と乙で違うのは、識別が満たせなかったときの扱いではない。**どちらも満たせなければ使えない。
違いは、識別が済んだ後に**そのまま使えるか（甲）、さらに2条件を要するか（乙）**である。

**乙を使うときの条件。3つとも満たす。**

1. **出所・日付・原文を記録する。**要約で置き換えない
2. **どの品に対する記述かが特定できる。**同名で仕様の異なる品が複数あるとき、
   現物がどれかを特定できなければ満たさない
3. **甲と矛盾しない。**矛盾する場合は甲を採る

**乙は甲の代わりではない。**甲があるならそれを使う。乙は甲に記載が無いときの手段である。

**乙は、再現可能な実測と矛盾する場合、実測を採る。**乙の条件2で現物に対する記述であることを
確かめていても、**現物を測った値のほうが強い。**[権限の優先順位](README.md#権限の優先順位)で言えば、
**甲は3、実測は4であり、乙はその4より下に置く。**

**この区分は根拠の格だけを定める。**AとBのどちらを要求するかは、上の[5項目の中での根拠の水準](#5項目の中での根拠の水準)のA／Bの表が決める。
**乙で満たせるのは、その値に要求されている水準までである。**Aの値を乙で満たした場合も、
要求はAのままであり、桁の議論へ落とさない。

**現に効いている例。**`SERVO-01`（SG90）の供給電圧`4.8–6 V`のうち、
**5項目に効くのは上限側である**（`HW-TBD-035`が問うているのは5 Vを入れてよいかであり、
**下限は下の[5項目以外の扱い](#5項目以外の扱い)の対応表により一般値で開始してよい側にある**）。**その上限の出所は乙であり、
乙の条件2を満たさない。**
公式siteに同名3品（`SG90 Digital`／`SG90 Analog`／`SG90 360 degree`）があり、
現物がどれかを特定できていないためである（`HW-TBD-035`／`HW-TBD-026`。
値と状態の正本は[TBD台帳](../hardware/tbd-register.md)であり、**ここへ再掲しない**）。

#### Bで済ませるときの条件

**4つとも満たす。**

1. **比較する最悪値を、実在する値で示す。**「たぶん大丈夫」は根拠ではない
2. **余裕を数で書く。**何倍か。桁が1つ以上あることを示す
3. **公開値が無いことを記録する。**何が公開されていないか、代わりに何で担保したかを残す
4. **Aを代替しない。**判定に効く数を余裕の議論で置き換えない

**迷ったらAとして扱う。**

#### この水準が変えないもの

**5項目そのものは変わらない。**短絡・逆極性・給電経路の重複・電圧違いのpin・servoの
持続的拘束は、引き続き根拠を要求する。**変えたのは、その中で何を根拠として認めるかである。**

**gateの開閉とも別である。**この節は有効化条件を満たすことではない。

### 5項目以外の扱い

**5項目に効かないものは、一般的な値で始めて、動かして観察してよい。**
対象は、外した場合の帰結が**「動かない」または「作り直す」に留まるもの**である。

**判断の分かれ目は「外したら壊れるか」であって「根拠が一次資料か」ではない。**

[AGENTS.md](https://github.com/wachi-yoshitaka-11-dev/deskcat/blob/main/AGENTS.md)の
「推測禁止」が挙げる8分類は、この基準で次のように分かれる。**この対応表がその正本である。**

| 推測禁止の分類 | 扱い | 理由 |
|---|---|---|
| 部品型番 | **一次資料または実測** | 型番が電圧・電流・pinoutのすべてを決める。外すと5項目のすべてに効く |
| GPIO | **一次資料または実測** | 挿し先を間違えると電圧違いのpinへ入る。起動時状態も含む |
| 供給電圧とロジック電圧。ただし**供給電圧の動作の下限を除く** | **一次資料または実測** | 電圧違いと逆極性に直結する |
| サーボPWM、可動域、速度、加速度 | **一次資料または実測** | 可動域を外すと機構へ押し付け、持続的拘束になる |
| 電源・抵抗・コンデンサ値のうち、**故障電流を決めるか制限するもの**と**耐圧** | **一次資料または実測** | 短絡の帰結を決める。耐圧を超えたcapacitorは破裂しうる |
| **供給電圧の動作の下限** | 一般値で開始してよい | 下回ると起動しないか、hangするか、書き込み中の記録が壊れうる。**下回る方向では絶対最大定格を超えないため、部品は壊れない** |
| I2Cアドレス | 一般値で開始してよい | 外れると応答しない。壊れない |
| I2C／SPIの速度とmode | 一般値で開始してよい | 外れると通信しないか化ける。壊れない |
| タッチ、加速度のしきい値 | 一般値で開始してよい | 外れると誤検知する。壊れない |
| 電源・抵抗・コンデンサ値のうち、**pull-upとdecouplingの値** | 一般値で開始してよい | 外れると通信または安定性が悪くなる。壊れない。**耐圧は上の行で扱う** |

**「電源・抵抗・コンデンサ値」は1つの分類として扱えない。**同じ分類の中に、短絡の帰結を
決めるものと、外しても動かないだけのものが混在する。**分類名で判断しない。**

**「供給電圧とロジック電圧」も1つの分類として扱えない。**上限と誤接続は部品の破損に直結するが、
**供給電圧の動作の下限を下回って起きるのは「動かない」である。**起動しないか、hangするか、
書き込み中の記録が壊れうる。

**部品が壊れないのは、下回る方向では絶対最大定格を超えないためである。**破損は定格を
超えたときに起きる。5項目が扱っているのは、いずれも定格を超える側の事象である
（過電流、逆電圧、重複給電、より高い電圧の印加、拘束時の連続torque）。
**下限はその向きに無い。**

**下限を一般値側へ移すのは供給電圧だけである。ロジック電圧は下限も一次資料側に置く。**
閾値を満たさない入力は不定になり、CMOS入力段に貫通電流が流れうる。
**「壊れない」と言い切れない。**迷ったら一次資料の側に置く。

**下限が安全要件へ伝わる経路も、現時点では無い。****「現時点では」を落として読まない。**
Piが落ちてもservoの危険にはならないが、
**そう言える理由は、servo出力そのものが有効になっていないことである**
（[サーボ出力を有効化してよい条件](../hardware/servo-safety-limits.md#サーボ出力を有効化してよい条件)。
gateが閉じており、firmwareはservoをdriveしない）。**駆動していないものは拘束しない。**

**設計上は、servoの角度・速度・通信断処理をESP32が強制する**（[AGENTS.md](https://github.com/wachi-yoshitaka-11-dev/deskcat/blob/main/AGENTS.md)の
「プロジェクト境界」）。**しかしこれは分担の定義であって、現在の実装ではない。**
通信断の検知方式とfail-safe sequenceは`HW-TBD-020`で未確定であり、
**Piの停止がESP32側で安全な出力状態へ落ちることを実機で確認していない。**

**したがってこの分担を、現時点の根拠として使わない。**
**servo出力を有効化する時点で、この経路は測り直す。**
そのとき確認するのは、**servo動作中にPiが停止し、link断が起きた状態で、
供給電圧の下限付近でもESP32が安全な出力状態へ移ることである。**
**確認するまでは、下限をこの分担で正当化しない。**
**下限を一般値側へ置く根拠は、上の「部品が壊れない」だけで足りる。**

**この切り分けは`HW-TBD-028`(a)（Pi入力で許容する最低電圧）で実際に必要になった。**
同項目は一次資料が存在しないことが確定しており、行の名前だけで「一次資料または実測」と
読むと、可変電源の購入以外に進む道が無くなる。**外しても壊れないものの確定のために
機材を買うことになる。**

**一般値で開始する場合も、記録は落とさない。**採った値、それが暫定であること、
確定させる手段を記録する。**追跡可能性は緩めていない。**緩めたのは、着手前に一次資料を
そろえる要求だけである。

**この対応表は、現在の構成（LCD、touch、環境sensor、servo）に対するものである。**
**出力を持つdeviceや、別の電圧domainを足したら、表を見直す。**

先例がある。§5のSPIは「検証済みの保守的な速度から開始し、根拠がある場合だけ速度を上げる」と
既に定めている。**速度について、この文書はもともと「一般値で開始して観察する」を採っていた。**
この節はその考え方を、5項目に効かない範囲へ明示的に広げたものである。

**迷ったら一次資料の側に置く。**

### ハードウェア文書の行は事実を書く。判定を書かない

**`docs/hardware/**` の表（`状態`欄など）には、分類名（`B-1`／`B-2`／`A`／`B`等）や
「未充足」「まだ通っていない」のような判定結果を書かない。**書くのは事実だけである。

- メーカーが何を公開しているか、していないか
- 型番・印字・ラベルにある記載そのもの
- 実測した値と、いつ・誰が・どう測ったか

**判定（この値がどの分類に当たるか、gateを通るか）は、その判定を使う側が、
読む時点でこの policy に照らしてその場で下し、根拠を添える。**

**理由。**判定を行へ書き込むと、規則が後で変わっても行は追随しない。
`CABLE-PI-PWR-01`（[hardware-bom.md](../hardware/hardware-bom.md)）がその実例である。
ある行は「5項目のいずれでもない」と記録し、別の行は同じ値を古い分類（`B-2`・未充足）に
置いたままにした。**判定を書いた時点の規則と、読む時点の規則が異なる場合に、
この食い違いが起きる。**事実だけを書けば、判定は常に読む時点の規則で下し直される。

**この節はここから先の記述に適用する。**既存の`docs/hardware/**`の行を、この節を根拠に
一括で書き換えることはしない。個々の行の適用は、その行を扱うIssueが判断する。

## 2. 必須の根拠

deviceを接続する前に、次を確認する。

- 正確なメーカー名とmodel suffix
- 搭載ICだけではなくmodule boardの識別情報
- 供給電圧
- logic電圧
- 絶対最大定格
- 通常電流とpeak電流
- pinoutとconnector方向
- 起動時状態
- 必要な外付け部品
- bus address、mode、対応速度

販売業者の掲載情報や、外観が似ているmoduleは十分な根拠にならない。
**これは識別（どの品か）に対する規則である。**定格の値については、上の「[5項目の中での根拠の水準](#5項目の中での根拠の水準)」が種別ごとの要求を定める。

**この10項目のうち、接続前に一次資料または実測を要するものと、一般値で開始してよいものの区別は、上の「[5項目以外の扱い](#5項目以外の扱い)」の対応表による。**

**識別と値を分けて読む。**

| 10項目のうち | 扱い |
|---|---|
| `bus address、mode、対応速度` | **一般値で開始してよい** |
| `必要な外付け部品`の**識別**（どの部品が要るか） | **接続前に確認する** |
| `必要な外付け部品`のうち**pull-upとdecouplingの値** | **一般値で開始してよい**（対応表による。耐圧と、故障電流を決めるか制限するものは除く） |
| `供給電圧`のうち**上限** | **接続前に確認する** |
| `供給電圧`のうち**動作の下限** | **一般値で開始してよい**（対応表による。**`logic電圧`の下限は含まない**） |
| 残る7項目 | **接続前に確認する** |

**「どの部品が要るか」と「その部品の値をいくつにするか」は別である。**
前者を外すと回路が成立しないが、後者は5項目に効かない範囲なら観察して詰められる。

## 3. 電源

- サーボをESP32のGPIO、3.3 V rail、board regulatorから給電しない。
- 容量を適切に設計した独立5 Vサーボ電源を使用する。
- ESP32、サーボ電源、周辺deviceのGNDを意図的に共通化する。
- USBと外部電源の経路にbackfeedがないか確認する。
- 電源予算には、通常電流と同時動作時のpeak電流を含める。
- regulator、wire、connector、保護deviceの定格を確認する。
- 必要なdecoupling部品を各deviceの近くへ配置する。
- 大電流のサーボ経路と、長いsensor return pathを共有させない。
- サーボ過渡動作中の5 V、3.3 V、reset動作を測定する。

一般的なsampleをコピーしてcapacitorや電源容量を決定しない。初期値を計算し、実負荷のwaveformで検証する。

## 4. Logic信号とGPIO

- 正確なboard文書に別の記載がない限り、ESP32信号を3.3 V domainとして扱う。
- 不明な出力または5 V出力をESP32入力へ直接接続しない。
- module上のpull-upと、その接続先電圧を確認する。
- 一方のdeviceだけに給電されている場合の動作を確認する。
- bootstrap、flash、debug、UART、board予約pinを確認する。
- pinをoutput modeへ切り替える前に、安全な初期出力を定義する。
- reset、LCD backlight、chip select、サーボPWMの起動時glitchを確認する。

GPIO割り当ては`docs/hardware/gpio-assignment.md`を正本とする。

## 5. I2CとSPI

### I2C

- addressの衝突を確認する。
- pull-up先の電圧と、並列合成後の実効抵抗を確認する。
- すべてのtransactionにtimeout上限を設ける。
- NACK、timeout、CRC、not-ready errorを区別する。
- 組み立てた配線で信号のrise timeとnoiseを確認する。
- サーボ動作中にもtestする。

### SPI

- 共有bus上の各deviceに個別のchip selectを割り当てる。
- 同時にactiveになるchip selectを一つだけにする。
- deviceを切り替えるたびに、そのdeviceの正しいmodeと速度を適用する。
- 長いLCD転送がタッチ入力をstarveさせないことを確認する。
- 検証済みの保守的な速度から開始し、根拠がある場合だけ速度を上げる。

## 6. サーボ

最初のPWM出力前に次を行う。

- 正確なサーボmodelを確認する。
- 電圧、電流、PWM周期、pulse width要件を確認する。
- 可能であればサーボhornまたは機械負荷を外す。
- 故障電流を制限する手段を明記する。手段が無い場合は、無いことと、代わりに何が守るのかを書く。
- 狭いpulse範囲と可動域を設定する。
- 直ちに操作できる電源遮断手段を用意する。
- 手やcableを動作範囲の外へ置く。

**この行は2026-09-22に書き換えた。**旧文「電流制限を設定でき、十分な定格を持つ電源を使用する。」は
commit `19853d0`（2026-07-28、リポジトリ最初のcommit「Establish DeskCat development foundation」）で
定型文として入り、この行に対応するユーザーの判断・承認の記録は、この文書にも、
`power-budget.md`・`hardware-bom.md`・`servo-safety-limits.md`のRevision履歴にも見つからなかった。
ユーザーが2026-09-22、「電流制限付き電源」は用意されず、実現不可能な規約が紛れ込んでいたものとして、明示的に外した（原文は省略）（[#454](https://github.com/wachi-yoshitaka-11-dev/deskcat/issues/454)）。
単に削除すると、この行が守ろうとしていた「故障電流を止める手段が要る」という問いそのものが
記録から消えるため、上の形へ置き換えた。**この書き換えは、実行できない要求を、記録できる
要求へ置き換えたものである。制御としては弱くなる**（電源の条件を満たさないまま駆動することを、
規約が禁じなくなる）。**それがユーザーの判断である**（実現不可能な規約という判断。原文は省略）。**記録としては
強くなる**——手段が無い場合に「無い」と書かせる分だけ、判断する人が実態を知れる。

Firmwareでは次を強制する。

- calibration済み最小位置
- neutral位置
- calibration済み最大位置
- 最大角速度
- 最大角加速度
- 最大command範囲
- 単位時間あたりに受理するmotion command数
- 最大連続動作時間とduty cycle
- 拘束または過負荷を検知した場合の停止
- 通信断時の定義済み動作
- resetまたはdriver故障時の定義済み動作

debug commandでもこれらの制限を迂回してはならない。

**この段落は受理判定にだけ適用する。**上限を超えたcommandは、無言で破棄せず理由を返す。

計数の境界（設定値がNのとき何番目から拒否するか）は
[Servo Safety Limits](../hardware/servo-safety-limits.md)を正本とする。
ここでは規則を再掲しない。同じ規範を2箇所に置くと、片方だけが更新されて食い違う。

**実行中の動作に対する安全停止はこれとは別である。**最大連続動作時間、duty cycle、
拘束・過負荷は、理由を返すだけでは足りず、trajectoryの中止またはPWM disableと
fault eventを要する。理由を返して動作を続ける実装にしない。
停止の要件は[Servo Safety Limits](../hardware/servo-safety-limits.md)を正本とする。

正本の分担は次のとおり。

| 対象 | 正本 |
|---|---|
| 安全要件（何を満たすか、検知時に何をするか）と計数の規則 | [Servo Safety Limits](../hardware/servo-safety-limits.md) |
| しきい値・時間・窓・上限の**実測値** | [TBD台帳](../hardware/tbd-register.md) |
| stale commandの拒否条件 | Protocolの`PROTO-TBD-013` |

可動域は小さいstepで拡大し、電流、電圧、noise、干渉、機械的clearanceを記録する。

次の場合は試験を停止する。

- 予期しない方向への動作
- 衝突または拘束
- 異音
- 過熱
- resetまたはbrownoutの反復
- 過電流
- commandまたは緊急停止応答の喪失

## 7. 人間の監視が必要な操作

次の操作では、人間が立ち会い、電源を遮断できる状態にする。

- 新しい配線revisionの初回通電
- 新しい電源の初回使用
- 初回サーボPWM
- 機構へ接続したサーボの初回動作
- 可動域の拡張
- GPIOまたは電源変更後の試験
- 意図的なbrownoutまたはfault injection
- 長時間の機械動作試験

AIエージェントはcommandとchecklistを準備できるが、人間の観察または取得済み測定値がなければ、物理的結果を確認済みと表現してはならない。

## 8. 通信のfail-safe

ESP32は次を検証する。

- message length
- JSON構造
- protocol version
- command名
- field type
- 列挙値
- 数値範囲
- commandの識別と重複
- 該当する場合はcommand age

通信断時、ESP32は承認済みのサーボfail-safe動作に従う。上限のない動作sequenceを継続したり、再接続後に古いrelative commandを再実行したりしてはならない。

この要求が成立する前提として、ESP32が通信断を自力で検知できなければならない。Heartbeat source、loss timeout、fail-safe sequenceが未確定の間は、サーボ出力を有効にしない。追跡は[HW-TBD-017／018](../hardware/tbd-register.md)で行う。

ただしこれは有効化条件の一部である。条件の全体は[Servo Safety Limits](../hardware/servo-safety-limits.md#サーボ出力を有効化してよい条件)を正本とする。ここに挙げた項目だけを満たしても、出力を有効化してよいことにはならない。

また、送信側の再起動によってmessage IDが振り直されるため、duplicate判定はsession境界を考慮しなければならない。詳細は[Protocol](../protocol/esp32-pi-protocol.md)を参照する。

## 9. Interruptとwatchdogの安全

- ISRを最小限に保つ。
- queueに上限を設け、overflowを記録する。
- logまたはserial出力によってsensor処理やwatchdogの進行をblockしない。
- watchdog feedは、重要taskが実際に進行したことを表さなければならない。
- 再起動後にreset reasonを記録する。
- watchdog、brownout、panic、external resetを区別できるfault contextを保存する。

## 10. ベンチ試験記録

次の項目を含む記録を使用する。

```text
Test ID:
Date:
Operator:
Hardware revision:
Exact components:
Wiring revision:
Power supply and current limit:
Firmware commit/profile:
Configuration:
Measurement equipment:
Procedure:
Expected result:
Measured result:
Faults:
Conclusion:
Next safe step:
```

## 11. 緊急時の対応

危険な動作が発生した場合は、次の手順を取る。

1. actuator電源を遮断する。
2. 同じcommandを繰り返し再実行しない。
3. logとreset reasonを保存する。
4. 安全に実行できる場合は、変更前に配線を撮影または記録する。
5. actuatorを外して電源railを測定する。
6. 焦点を絞ったIssueまたは実験記録を作成する。
7. 妥当な原因候補と安全な試験を定義した後にのみ、より小さい独立試験から再開する。

## Revision履歴

**この文書には従来Revision履歴の節が無かった。**この変更を機に追加した。過去の変更は追跡していない。

| 日付 | Revision | 変更 | 根拠 |
|---|---|---|---|
| 2026-09-22 | 1 | [#454](https://github.com/wachi-yoshitaka-11-dev/deskcat/issues/454)。§6サーボの「電流制限を設定でき、十分な定格を持つ電源を使用する。」を「故障電流を制限する手段を明記する。手段が無い場合は、無いことと、代わりに何が守るのかを書く。」へ書き換えた。旧文はcommit `19853d0`（2026-07-28、初期commit）の定型文で、人間の判断・承認の記録が無かった。ユーザーが2026-09-22に明示的に外した | ユーザー指示（2026-09-22） |
