wachi-yoshitaka-11-dev/deskcat/docs/hardware/power-budget.md

# Power Budget

> 状態: 範囲別に確認する（下記）。単体bring-upと電源経路全体の受け入れを区別する。
> 正本とする情報: DeskCatの電源rail、負荷、margin、測定計画

## 現在の判断への入口

| 判断する対象 | 現在状態・解除条件の確認先 | 手順・根拠 |
|---|---|---|
| ACCEL-01／ENV-01の単体bring-up | [HW-TBD-023](tbd-register.md#hw-tbd-023)の限定判断 | 本書の`ACCEL-01`／`ENV-01`単体bring-up手順。#445の範囲だけに適用 |
| DISP-01の通常接続 | [HW-TBD-024](tbd-register.md#hw-tbd-024) | 本書の`DISP-01`追加接続手順。接続判断と当日の実行承認は別 |
| 3点の定常電流測定 | [HW-TBD-025](tbd-register.md#hw-tbd-025)・[HW-TBD-024](tbd-register.md#hw-tbd-024) | [段階B-2の測定](#段階b-2の測定)。B-2a／B-2bの条件を混用しない |
| 合成給電・案Aを採る場合の再試験 | [過電流保護](#過電流保護段階cのgate)・[経路部品と定格](#経路部品と定格) | [ESP32の給電経路](#esp32の給電経路最終の経路は未決定)。段階C全条件と安全な再開判断を要する |
| 次の製品作業 | [MVPの実行順序](../planning/development-foundation-plan.md) | #464で整理した開始条件と完了条件を区別する |

過去の判断・訂正とRevisionは[判断記録](power-budget-history.md)へ分離した。
手順の条件・停止条件、測定値の導出は本書に残る。入口だけで通電を決めない。

## 確定している制約

- 初期prototypeには有線電源を使用する。
- サーボをESP32 GPIO、3.3 V、ESP32 board regulatorから給電しない。
- 外部のサーボ電源経路を使用する。
- ESP32とサーボ電源のGNDを意図的に共通化する。
- Raspberry Piのundervoltageはresetとstorage破損を引き起こす可能性がある。
- 負荷dataと測定結果が得られるまで、capacitor値と電源定格は`TBD`とする。

## 電源rail構成案

この図はarchitecture案であり、最終配線図でも通電許可でもない。
単一入力源の案は維持する。単一ACアダプターへの限定は撤回済みだが、複数構成の採用は決めていない。
[決定日・撤回理由と旧記述](power-budget-history.md#電源rail構成案の旧記述)を参照する。

```text
スイッチングACアダプター(USB ACアダプター) MicroBオス 5V3A（秋月 M-12001）— 単一入力源
│  ※plugをbreadboardへ引き込む変換部品の調達（発注・着荷）の状態は[#205](https://github.com/wachi-yoshitaka-11-dev/deskcat/issues/205)が持つ（`5 V ingress`節）
├─ 過電流保護部品（`PROT-OC-01`、5V往路へ直列。調達の状態は[#205](https://github.com/wachi-yoshitaka-11-dev/deskcat/issues/205)が持つ）
│  ※これが無い間は段階C（合成給電）へ進まない（`過電流保護（段階Cのgate）`節）
├─ Logic/Pi rail 5V（breadboard上で分岐、追加regulatorなし）
│  ├─ Raspberry Pi Zero W（PWR IN portへ）
│  │  └─ （案Aの場合のみ）USB OTG port ──[USB cable]── ESP-WROOM-32D開発ボード（秋月電子 M-13628）
│  │        ※案Aではこのcableのみで給電する
│  └─ （案Bの場合のみ）ESP-WROOM-32Dの`5V` pinへ直接
│        ESP32の最終の給電経路は未決定。#405の見直しで決め、案A・案Bはその候補（`ESP32の給電経路（最終の経路は未決定）`節）
│        Pi–ESP32の信号はGPIOのUART（`gpio-assignment.md`のtransport節）。この図には描かない
│        board上regulatorが3.3Vを生成し、board上の3V3 pinから出力
│        ├─ ADXL345（接続条件はHW-TBD-004・HW-TBD-023と単体bring-up手順を参照）
│        ├─ BME280（電源電圧DC1.71～3.6V。5V直結不可）
│        └─ MSP2807（LCD＋touch。VCC 3.3–5V対応だがlogic IOは3.3V TTL。
│              接続条件は下記のHW-TBD-024を参照）
└─ Servo rail 5V（breadboard上で分岐、直近にbulk capacitor）
   └─ SERVO-01（TowerPro SG90）
```

周辺moduleを5 V railへ直結しない。ADXL345の電圧判定と残件は[HW-TBD-004](tbd-register.md#hw-tbd-004)、
ESP32側の条件は[HW-TBD-023](tbd-register.md#hw-tbd-023)、DISP-01の通常接続判断は
[HW-TBD-024](tbd-register.md#hw-tbd-024)で確認する。IDがOpenかどうかだけで接続可否を決めない。
3点合算測定は[段階B-2の測定](#段階b-2の測定)、単体bring-upはそれぞれの手順を適用する。
合計消費電流の見積もりと実測は[負荷表](#負荷表)・[測定計画](#測定計画)を参照する。
すべての信号domainで意図的に基準GNDを共有し、接続前にUSBと外部電源間のbackfeed経路をreviewする。

## 5 V ingress（物理的な引き込み経路）

上図の「単一入力源」から`breadboard上で分岐`までの間には、**まだ実在しない物理interface**がある。
M-12001はMicro-Bオスplugであり、breadboardへ直接挿せない。

ただし**この節が埋まるまで作業全体が止まるわけではない**。段階を分ける。

| 段階 | 引き込み方 | 追加部品 | 通せる電流 |
|---|---|---|---|
| bring-up前半（**現在ここ**） | **Piを単体で起動する。**段階Aのadapter（[hardware-bom.md](hardware-bom.md)の`PSU-PI-A-02`。cable一体）のplugをPiの`PWR IN`へ挿して給電する（2026-10-11の差し替え以降。それまでは`PSU-PI-A-01`と`CABLE-PI-A-01`）。M-12001のplugは[experiment-log.md](experiment-log.md)の`EXP-012`で切断済みであり、`PWR IN`へ直挿しできない。**breadboard railを作らず、Piの5V GPIO pinへ何も接続しない** | **不要** | Pi単体のみ。gate不要（下記） |
| 合成給電以降 | 下表の端子台でM-12001のcableを受け、railへ引き出す（**2026-09-09、案Bにより「変換基板でMicro-Bを受け」から差し替え**）。Piへは別途Micro-Bオスcableで給電する | 端子台、Piへの給電cable、過電流保護部品、大電流経路の線材・接続部材。**調達（発注・着荷）の状態は[#205](https://github.com/wachi-yoshitaka-11-dev/deskcat/issues/205)が持つ。この表は持たない** | ingress定格まで（下記`ingressの電流制限`）。**保護部品の実装が前提**（`過電流保護（段階Cのgate）`） |

**servo電流をPiのconnectorとPCB traceへ通してはならない。**servoを繋ぐ前に、必ず下段の構成へ移す。

### 合成給電を部品が揃うまで行わない理由

当初は「bring-up前半ではPiの5V GPIO pinからbreadboard railを作り、ESP32とLCDとsensorを
合成給電する。合計1.0 Aを超えたら中止する」という段階を置いていた。**これは成立しない。**

そのgateが見るのはPiの`PWR IN`を通る合計電流だが、M-12001はMicro-Bオスplugの直結cableであり、
**アダプターとPiの間に測定器を挿入できない**。挿入するには途中に受け口が要る（**2026-09-09に
人間が決定した案Bにより、この受け口は端子台である。当時の記述は「変換基板」だった**）。
つまり**合成給電を許可するgateを、合成給電の構成では測れない**。測れないgateはgateではない。

したがって段階を次のように分ける。**gateが要る作業と、要らない作業を混ぜない。**

| 段階 | 内容 | 電流の扱い | 追加購入 |
|---|---|---|---|
| **A** | Piを単体でアダプターから起動する（段階Aのadapter（`hardware-bom.md`の`PSU-PI-A-02`。cable一体）のplugから`PWR IN`へ給電し、GPIOへ何も繋がない。2026-10-11の差し替えまでは`PSU-PI-A-01`から`CABLE-PI-A-01`を通して給電した。例外は下の`検証の構成の扱い`。M-12001は`EXP-012`で切断済みであり、段階Aに使えない） | gate不要。Pi単体は通常の使い方である。**2026-10-11の差し替えまで使った`PSU-PI-A-01`のlabelの出力は5.0V=1.0Aであり、Raspberry Pi公式がZero Wに推奨するPSU容量1.2 Aを下回った**（下の`(a)の一次資料は存在しない`の表の`Power supply`行）。2026-10-11以降の`PSU-PI-A-02`のlabelは`DC5V 3.0A`である（label表記であり、実測していない。極性と出力電圧も実測していない）。bssidの固定の後の1時間の監視で切断1回だった観察は、`EXP-020`の起動7にある。2026-10-11の差し替えまで使った`CABLE-PI-A-01`の型番と定格は分からなかった。**ただしこれは探索的な通電であって、電源経路の受け入れではない。**Raspberry Pi公式が要求するのは5.1 Vであり、`PSU-PI-A-02`のlabelの5 Vがそれを満たすかは未判断である。判定に使う最低電圧も未確定である（`HW-TBD-028`(a)）。**段階Aが正常に起動したことをもって、Piの電源経路を合格としない** | 不要 |
| **B-1** | ESP32を単体でPCのUSBから給電し、flashingとADC loggingを行う | gate不要。**board上のUSB portをメーカーが意図した用途で使うだけ**であり、段階Aと同じく通常の使い方である。board自身の消費以外を足さない。**PC hostのOCPは未確認であり、保護として当てにしない**（`段階B-2の測定`） | 不要 |
| **B-2** | B-1に周辺module3点（MSP2807、ADXL345、BME280）を足し、**選んだ給電経路（B-2aは`3V3` pin、B-2bは外部の3.3 V電源）**から給電して3.3 V側の定常電流を測る。5 V railもPiも使わない | **gate必要。**給電元により**B-2a**（`3V3` pinから。board上regulatorの定格と過電流／短絡保護の確認が条件）と**B-2b**（外部の電流制限付き3.3 V電源から。設定値の根拠と上限が条件）に分かれる。**どちらの条件も満たせない場合は実施しない。**経路ごとの実施条件・測定点・停止条件は`段階B-2の測定` | 不要 |
| **C** | 端子台でM-12001を受けてbreadboard railへ引き出し、そこからPi（`PWR IN`へcable）・ESP32・LCD・sensorへ合成給電する（**2026-09-09、案Bにより「変換基板」から差し替え**。**2026-10-27更新：段階Cの構成にMSP2807（LCD）は接続しない**（`MSP2807の電流上限の扱いと、段階Cの測定4（2026-10-27、#556）`））。**Piの5 V GPIO pinを経由して配電しない** | **gate必要。右列の部品がすべて揃い、`経路部品と定格`表に未確定の行が無くなり、ingressで実測できるようになるまで実施しない**（`過電流保護（段階Cのgate）`） | 端子台、Piへの給電cable、過電流保護部品、大電流経路の線材・接続部材 |

**AとB-1は通常の使い方であり、gateも追加購入も要らない。**どちらもメーカーが意図した
給電口をそのまま使い、boardやPi自身の消費以外を足さないためである。
ここには #8（Pi Rust環境）と #40（ESP32 toolchain）が収まる。

**B-2だけはgateが要る。**周辺module3点という外部負荷を足すためであり、**gateの中身は
給電経路によって違う**（`段階B-2の測定`）。

- **B-2a（`3V3` pinから給電）** — boardの設計想定を超えて`3V3` pinから外部負荷を取るため、
  `3V3` pinの電流定格と、board上regulatorの過電流／短絡保護を確認する
- **B-2b（外部の3.3 V電源から給電）** — `3V3` pinを使わないため上記は条件にならない。
  代わりに電源の電流制限が唯一の保護であり、その動作確認と無負荷出力電圧の確認を行う
- **共通** — 許容電圧範囲の確定と、周辺module3点それぞれの安全な電流上限

**検証の構成の扱い。**[gpio-assignment.md](gpio-assignment.md)の`Pi–ESP32間のtransport`節の検証の構成（PiとESP32を別々に給電し、UARTでつなぐ構成）は、
段階Aと段階B-1（ESP32に周辺moduleをつながない）を同時に行い、両者の間にUARTの信号線2本とGNDの線だけをつなぐものとして扱う。
Piの給電は段階Aのadapter（段階表のA行）である。

- PiとESP32の間で電源の線（5 V、3.3 V）をつながない。合成給電ではないため、段階Cのgateは掛からない
- 段階Aの「GPIOへ何も繋がない」の例外は、この3本だけである
- 周辺moduleをつないだ台での検証の構成は、`DISP-01`追加接続のbring-upの手順の条件(3)(a)が、その手順に限って定める
- 3本をつなぐ条件と、通電前の配線の確認は、同節の`信号線をつないでよい条件`が持つ
- この扱いを、GNDを共通にしたときのPC–Pi間の電流経路を確かめた根拠にしない（`HW-TBD-036`）

接続判断の現在状態は[HW-TBD-023](tbd-register.md#hw-tbd-023)・[HW-TBD-024](tbd-register.md#hw-tbd-024)、負荷側の共通条件は[HW-TBD-025](tbd-register.md#hw-tbd-025)を参照する。[接続判断の経緯](power-budget-history.md#接続判断の経緯)は現在状態の代わりに使わない。

**手段によっては外部電源の追加購入が要る。**
**部品待ちになるのはCだけだが、部品待ちでないこととgate不要は別である。**

段階Cの配電先は、この節の末尾で定める構成表（`servo試験以降で用いる構成を次に定める`
以下）と同じであり、**Piの5 V GPIO pinから他へ配る構成ではない**（定格の理由は同表の
`分岐点`行）。**2026-09-09に人間が決定した案Bにより、ingressは`PSU-INGRESS-01`（Micro-B変換基板）ではなく端子台で受ける構成へ変わった**（`経路部品と定格`の該当行を参照。ここへ再掲しない）。

#### 段階B-2の測定

購入前の見積もりで唯一の未知数はMSP2807の定常電流である（`負荷表`）。これは
**5 V railを立てなくても測れる。**周辺module3点はいずれも3.3 Vで動くため、3.3 Vの
給電元と周辺moduleのrailの間へ**`MEAS-01`を直列**に入れて両端電圧を読めば、3点合計の定常電流が読める。

**その給電元は`3V3` pinとは限らない。**下記のとおりB-2aとB-2bの2経路があり、測定点も
gateも経路ごとに違う。

**給電元によって守るべき対象が変わるため、B-2を2つの経路に分ける。**どちらを採るかを
先に決め、その経路の条件だけを適用する。**片方の条件をもう片方へ流用しない。**

| 経路 | 給電元 | 守るべき対象 | 故障電流を制限するもの |
|---|---|---|---|
| **B-2a** | ESP32 boardの`3V3` pin | board上のregulator | regulator自身の過電流／短絡保護（要確認） |
| **B-2b** | 外部の3.3 V電源 | 周辺module3点と配線 | **電源に設定した電流制限** |

両経路に共通するのは次だけである。

| 項目 | 内容 |
|---|---|
| 測る量 | **定常電流**（MSP2807のbacklight点灯とLCD描画、I2C通信を継続した状態） |
| 許容電圧範囲 | 周辺module3点が**moduleとして受け入れてよい電圧**の積集合とESP32のlogic levelから決める。IC単体の積集合ではない。この行が値の正であり、**3.234–3.366 Vを暫定の根拠に基づく設計判断として運用する**。無条件の保証値・worst-caseの境界ではない。導出・適用条件・backlightがU1を経由する場合の再導出条件は下記`3.3 V railの許容電圧範囲`・`3.3 V rail下限の設計判断`。module別の状態は[HW-TBD-004](tbd-register.md#hw-tbd-004)・[HW-TBD-025](tbd-register.md#hw-tbd-025)、[旧判断と訂正](power-budget-history.md#許容電圧範囲の判断記録)を参照する |
| **全moduleの安全な電流上限** | 経路によらず周辺module3点それぞれの安全な電流上限が必要。B-2bでは設定電流制限の上限、B-2aではregulatorのtrip点がmoduleに安全かを判定する。公開値を得られない場合は現物回路の確認を要し、満たさないmoduleへB-2で給電しない。**module別の充足状態・根拠は[HW-TBD-025](tbd-register.md#hw-tbd-025)**。単体通常接続の判断をこの測定のgateへ流用しない |
| **単体bring-upとB-2の区別（2026-09-21追記）** | 単体bring-upと3点合算の定常電流測定は別の範囲。現在の適用範囲は[HW-TBD-023](tbd-register.md#hw-tbd-023)・[HW-TBD-024](tbd-register.md#hw-tbd-024)、手順は本書の対象別bring-up節を読む。[2026-09-21以降の判断とpull-up電流上界の計算](power-budget-history.md#単体bring-upの判断とpull-up計算)を保存している。上界計算は負荷側の現物確認やB-2bの保護設定値を代替しない |
| 5 V railとPi | 使わない。合成給電ではないため段階Cのgateの対象外である |
| 停止手順 | 給電元を切る（B-2aはUSB cableをhost側から抜く、B-2bは電源出力を切る）。これは**停止手順であって保護機構ではない。**人が手を掛けられる状態で行い、無人で継続しない |

この2つの共通条件（許容電圧範囲、全moduleの安全な電流上限）の追跡は
[HW-TBD-025](tbd-register.md)で行う。**MSP2807の上限は未公開であり（`HW-TBD-024`）、
これが得られるまではB-2aもB-2bも実施できない。**
**ただし2026-09-28のユーザー決定により、今の接続のままの電流測定はこの規則の例外とする（次の段落）。**

**今の接続のままB-2aとして測る（2026-09-28、ユーザー決定）。**ユーザーは、段階B-2の電流を今の接続のまま測ると決めた。
決定の記録は[#488](https://github.com/wachi-yoshitaka-11-dev/deskcat/issues/488)のコメントにある。

- **対象の構成:** `ACCEL-01`／`ENV-01`（[#445](https://github.com/wachi-yoshitaka-11-dev/deskcat/issues/445)）と`DISP-01`（[#461](https://github.com/wachi-yoshitaka-11-dev/deskcat/issues/461)）を、ESP32 boardの`3V3` pinから給電する構成。
  **両Issueで接続が認められ、すでに通電して使っている。**経路はB-2aにあたる。B-2bは対象外である。
- **測り方:** `3V3` pinと周辺module3点のrailの間へ`MEAS-01`（0.1 Ω）を入れ、両端電圧を`DT830B`で読む（`DT830Bを電流測定に使うときの制約（2026-08-21）`節）。`DT830B`の電流端子は使わない。
- **この測定を止めないもの:** 上の「B-2aもB-2bも実施できない」と、下の`B-2a: 3V3 pinから給電する経路`の`実施条件（定格）`・`実施条件（保護）`。
  接続そのものは両Issueで認められて通電しており、測定で増えるのはshunt 1本だけである。
  また同節のとおり、B-2aの実施条件を満たす手段は実測しか残っておらず循環している。その実測を、この決定で行う。
- **変わらないこと:** MSP2807の安全な電流上限は未公開のままである（`HW-TBD-024`）。**測った値は確度が未取得の読みとして扱い、しきい値との照合にそのまま使わない。**
  B-2aの`停止条件（電圧）`と`停止条件（その他）`（brownout、reset、LCDの表示異常、regulator周辺の発熱）は適用する。
  `停止条件（電流）`は、基にする`3V3` pinの定格が未確定のため数値を持たない。
- **実施:** shuntを入れる配線替えは、通電前に配線を確かめてから行い、人間が監視する。停止手順は上の共通条件表のとおり（USB cableをhost側から抜く）。
- **2026-10-01に実施した**（[experiment-log.md](experiment-log.md)の`EXP-019`）。上の共通条件表の`測る量`（backlightの点灯とLCDの描画、I2C通信を継続した状態の定常電流）は得ていない。

#### B-2bの電流制限値の上限が決められない理由（要約）

**LED個数、`R5`／`Q1`の経路、`U1`の供給能力は、いずれも[tbd-register.md](tbd-register.md)の
HW-TBD-024行が持つ事実であり、ここへ再掲しない。**この節に残すのは、それらの帰結として
「B-2bの電流制限値の上限が決められない」という一文だけである。**したがって、給電構成
（次項）の電流制限値は、この上限が未解決のまま暫定値（`150 mA`、上記
`B-2b を採る決定と MSP2807 の電流制限（2026-09-07）`節）で運用するか、上限が出るまで
実施を待つかのいずれかを、実施者・PMが別途判断する必要がある。詳細はHW-TBD-024行を見る。

#### MSP2807の電流上限の扱いと、段階Cの測定4（2026-10-27、[#556](https://github.com/wachi-yoshitaka-11-dev/deskcat/issues/556)）

**机上の調査の結果と、PMの判断である。ユーザーは2026-10-27に、この記録を正本へ入れることを承認した。実機は使っていない。**
`HW-TBD-024`と`HW-TBD-025`(b)は`Open`のままで、値は書かない。

**判断。**

1. `HW-TBD-024`の上限は、公開資料からも非破壊の方法からも得られていない。
   `U1`の過電流保護`Ilimt`は、datasheetの表にtypの値しか無く、上界にならない（下の表）。
2. 段階Cの測定4（MSP2807）は行わず、「判定しない」と記録する。**測定1〜3・5と
   [#405](https://github.com/wachi-yoshitaka-11-dev/deskcat/issues/405)の配線は止めない。**
   `HW-TBD-025`(b)は、段階CでDISP-01を使わないため、段階Cの測定の条件から外れる。
   最終の構成でDISP-01を載せるときの確認は、#405の構成の見直しへ渡す。
3. メーカー・販売元への問い合わせは、予備として残し、今は送らない。通電による正常動作の電流の測定も、今は頼まない
   （単独では`HW-TBD-024`を解かない）。
4. 最終の機体でMSP2807をどう給電するかは、#405の見直しで決める。**第一候補として検討するのは、`VCC`を5 Vにし、J1を開放のままにする
   使い方である（下の回路図の注記が示す使い方。回路図が現物と同じ版なら、メーカーの指定）。**ただし、`HW-TBD-025`(a)の経路(2)が未確認とする2点
   （logic IOのlevelと、`sensor-datasheet-notes.md`のLogic電圧欄）と、回路図が現物と同じ版かどうかが解けるまでは、採らない。
   採るかどうかの決定は#405が持つ。採らないのは、3.3 Vのまま`J1`を短絡する
   使い方である（回路図どおりなら、`U1`の制限が無くなり、`HW-TBD-024`の観点で不利になる）。パネルの`Vcc`の最大3.3 Vを超えうる点は、どちらの使い方にもある（#405の見直しで扱う。#405のcommentに置く）。

**今の構成の事実。**`VCC`へ`3V3` pinの3.3 Vを入れ、J1は開放である（2026-08-13の現物確認）。回路図の注記は、
3.3 V入力のときJ1を短絡する使い方を示す。**回路図が現物と同じ版なら、今の構成は、メーカーが注記で示す使い方の外である。**
**版は確定していない（下の`回路図が現物と同じ版かどうか`）。**
**版に依らず言えること。**`U1`の入力脚が`VCC` pinと導通することは、現物の導通測定で確かめた（2026-09-05、`sensor-datasheet-notes.md`のBacklight行）。そのため`U1`の入力は、`VCC`が3.3 Vなら3.3 Vである。
`U1`の入力が、出力の目標値に`Vdrop`（160／240 mV@50 mA）を足した値を下回る領域（dropout）で動き（`3.3 V`の上側でも同じである。下の`3.3 V railの許容電圧範囲`の節）、`Ilimt`・`Ishort`・`IOUT(max)`の表の条件
（`VIN`＝出力の目標値＋1 Vまたは＋1.5 V）に入らない。**この領域での値は、datasheetに無い。**
今のデモの給電（[#461](https://github.com/wachi-yoshitaka-11-dev/deskcat/issues/461)）は、この状態で動いている。#461の承認が、回路図の注記を知ったうえでのものかは、記録に無い。

**資料と、取得した事実。**取得日はすべて2026-10-27である（回路図と仕様書のsha256は、[#556の2026-10-06のコメント](https://github.com/wachi-yoshitaka-11-dev/deskcat/issues/556#issuecomment-6018962528)の値と一致した）。

| 資料 | sha256 | 示すこと |
|---|---|---|
| LCDWikiの回路図 [`MSP2807-2.8-SPI.pdf`](https://www.lcdwiki.com/res/MSP2807/MSP2807-2.8-SPI.pdf)（Altium Designerの出力、2019-06-15） | `1d2d7af2f26d922e0c91da9118ca4ce211105b06fb4827366dd9eb30de2bacd0` | `VCC`は`U1`（XC6206）の入力、出力が`VCC3.3`。`LEDA`・`VDD`・`XPT2046`・SD slotの電源・`R4`は`VCC3.3`。`J1`（0 Ω）は`VCC`と`VCC3.3`の間。注記は「外部VCCが5 VのときJ1を開放、3.3 VのときJ1を短絡」。`R5`は10 Ω。title blockの`File:`欄は`TFT_TM022HDH26.SchDoc`で、MSP2807とは別の名前である（何の型番かは未確認）。`Title`・`Number`・`Revision`は空 |
| パネル仕様書 [`QD-TFT2803 specification_v1.1.pdf`](https://www.lcdwiki.com/res/MSP2807/QD-TFT2803%20specification_v1.1.pdf) | `58395e17e8823119c35a79b20d51e88dcc9790f1193eb521ee6c4482744b5e83` | `Back Light`は`White LED*4`。`BL CIRCUIT DIAGRAM`は4個の並列で、`LEDK`が4本。注記は`Vf=3.2V, If=60mA`（全体か1個あたりかは図に無い）。`IF`はtyp 60／max 80 mA。`Vcc`はmin 2.5／typ 2.8／max 3.3 V。許容電流のグラフは軸の名前と曲線の向きが合わず、読まない。絶対最大定格の電圧は載っていない |
| LCDWikiのUser Manual（`2.8inch_SPI_Module_MSP2807_User_Manual_EN.pdf`） | `0e0d3e57ca24213841907d845e509545819ec7303f0f43584c521a3f57a1d72c` | `Power Consumption 0.31w`。条件（`VCC`の値、backlightの状態）は書かれていない。同じ表に`Operating Voltage 5V`がある（0.31 Wの条件としては書かれていない） |
| 秋月の[`msp2807.pdf`](https://akizukidenshi.com/goodsaffix/msp2807.pdf) | `98ecfa67963b32d9553bdca3b40e5a1960a7c5220b69569d51efa5009e578d59` | `Power Consumption`は`TBD` |
| [UMW XC6206 datasheet](https://www.umw-ic.com/static/pdf/e442437afc9daa185da86486e2bfe8c5.pdf)（UTD Semiconductor、Mar.2025、13 page） | `8d8e3e30dbf48a39e0b4e11122ac242c2849b68ee8225ba0d672d83decf30504`（2026-08-15の記録と一致） | 絶対最大定格：`VIN` 9 V、`IOUT` 500 mA、`PD`（SOT-23）300 mW。3.3 V品（25 ℃、`Cin`＝`Cout`＝10 µF）：`IOUT(max)` min 100 mA（`VIN`＝出力の目標値＋1 V）、`Vdrop` typ 160／max 240 mV（`IOUT`＝50 mA）、`VIN`の範囲1.8〜8 V、`Ishort` 30 mA・`Ilimt` 380 mA（表のTyp欄にだけ値がある。条件は`VIN`＝出力の目標値＋1.5 V）。**datasheetに無いもの：`Ilimt`のminとmax、熱抵抗、周囲温度ごとの`PD`の低減、保護が折り返し型かどうか、100 mAを超える電流での`Vdrop`の表の値** |

**取得の経路。**UMWのdatasheetは、curlでの直接取得が403だった。回避せず、WebFetchが保存した原本のコピーを使い、sha256が2026-08-15の記録と一致することを確かめた。
取得したPDFはrepoへ入れない。LCDWikiのAltium library（`Altium_Package_library.zip`）はフットプリントと記号だけで、部品の値は無い。

**回路図が現物と同じ版かどうか。**番号の一致は、`R5`・`R6`・`Q1`・`U1`・`J1`・`U2`（XPT2046）である。`R5`だけ値が違う（回路図10 Ω、現物6.8 Ω）。回路図のファイル名はMSP2807ではない（上の表）。
パネルのFPC割り当て（`LEDA`が10番、`LEDK`が11〜14番）は、回路図と仕様書で一致する。**確定していない。**`LEDA`と`ILI9341`の`VDD`は、パネル端のカプトンテープの下にあり、非破壊では触れない。

**実機が使えるときの確認（今は頼まない）。**

- 無電源で、`U1`の出力脚と、`XPT2046`の`VCC`脚、SD slotの電源pin、`R4`との導通を見る。期待は、どれも`U1`の出力脚と導通し、`VCC` pinとは非導通である。
- 基板の表と裏の部品番号と値を、回路図と照合する。基板のsilkに版の表記があれば記録する。分解はしない。
- どちらも`LEDA`の位置は決めない。決まらなくてもよい形にする案（5 V給電で`VCC`を段階的に上げて入力電流を見る）は、電流制限の値の根拠が要り、`HW-TBD-024`と循環する。

**#405の見直しで、5 V給電（第一候補）を決めるときに扱う点は、#405のcommentに置く**（5 V側の短絡の保護、回路図の版、`U1`の発熱と出力電圧、`周辺moduleを5 V railへ直結しない`の例外、`HW-TBD-025`(a)の経路(2)の引き直し、#461の範囲外）。この文書には重ねて書かない。

**問い合わせの内容の案（予備。今は送らない）。**現物（`R5`＝6.8 Ω、`U1`＝662K／UMW）の、backlight電流の上限とLEDの個数、パネルの型番、`VCC`側の許容電流。
回答は乙の扱いになる（出所・日付・原文を記録し、品の特定と、甲との矛盾が無いことを確かめる）。

#### `DISP-01`初回通電の手順（給電構成の確定待ち）

**この節は次の2点が揃うまで実行しない。**(1) B-2b用の外部3.3 V電源（電流制限を設定でき、
制限が働いたことを表示できる機材）が確保され、設定する電流制限値が決まっていること。
`B-2b を採る決定と MSP2807 の電流制限（2026-09-07）`節が`150 mA`を「暫定の初期候補（単独で
通電を許可する値ではない）」として記録しているが、**同節が明記するとおり上限の3入力
（`HW-TBD-024`、`HW-TBD-025`(b)、B-2b用配線の許容電流）はいずれも未解決であり、
`実施前に満たす条件`はまだ揃っていない。**この節はその値の採否を決めない（実施者・PMが
別途判断する）。**2026-09-23（[#461](https://github.com/wachi-yoshitaka-11-dev/deskcat/issues/461)）で
`HW-TBD-024`は「`DISP-01`を3.3 V系へ通常接続すること自体」を一律に妨げる扱いではなくなったが、
**B-2b（この節が扱う、電流制限つき外部電源で給電する経路）の要求はそのまま残る。**
`HW-TBD-025`(b)の代替条件（現物回路の確認）をMSP2807が満たしていないため、上記の3入力は
依然として未解決であり、この節の実施条件は変わらない。(2) 人間が「通電してよい」と明示すること。
**AIは以下を準備するだけであり、実行と判定は人間が行う**（[Hardware Safety Policy](../governance/hardware-safety-policy.md)
「7. 人間の監視が必要な操作」）。

**給電構成（実施時に埋める。この文書は空欄のまま置く）:**

| 項目 | 値 |
|---|---|
| 使用する電源の型番 | TBD |
| 設定する電流制限値 | TBD |
| 制限動作時の表示方法 | TBD |

1. [人間] [gpio-assignment.md](gpio-assignment.md)の`電源pinの短絡・誤配線の確認（非通電）`の
   うち、`DISP-01`に適用される項目（項目1〜4）がすべて完了していることを確認する。**同表は
   2026-09-22に`ACCEL-01`／`ENV-01`向けの項目5〜7が追加され、7項目になっている**
   （[gpio-assignment.md](gpio-assignment.md) Revision 36）。
2. [人間] 電源に手を掛けられる状態（コンセント／電源出力ボタンへすぐ手が届く）を確保する。
3. [人間] 給電を開始する。**AIはこの操作を行わない。**
4. [人間] 次のいずれかを認めた場合、直ちに給電を止める。
   - 異音
   - 発熱（moduleまたは給電源）
   - 火花・変色・異臭を伴う発光（画面が点かないこと自体は`#13`の受け入れ条件未達であり
     停止理由ではないが、これらは停止理由である）
   - 電圧降下（給電源側の出力電圧が測定できる場合、垂れがあれば停止）
   - 電流制限の作動（設定値に達し、給電源が制限動作を表示した場合）
   - テスターでの異常値（`VCC`–`GND`間抵抗が通電中に急変する等）
5. [人間] 停止後、`VCC`–`GND`間抵抗を再測定し、通電前と有意に変わっていないことを
   確認してから再開の是非を判断する。
6. [AI] 結果（成功・停止のいずれも）を[experiment-log.md](experiment-log.md)へ
   `EXP-0xx`として記録する。

#### `ACCEL-01`／`ENV-01`単体bring-upの手順（ESP32`3V3` pin給電、`#445`承認範囲）

**AIは以下を準備するだけであり、実行と判定は人間が行う**（[Hardware Safety Policy](../governance/hardware-safety-policy.md)
「7. 人間の監視が必要な操作」）。

**`ENV-01`（BME280）の`J3`は、2026-09-07にはんだ付け済みと、ユーザーが申告している**（[EXP-014](experiment-log.md#exp-014-env-01bme280のj3はんだジャンパの実施記録)。
根拠はユーザーの申告だけで、測定表は無く、はんだ付けの品質と`CSB`–`VDD`間の導通は確かめていない）。
**`ENV-01`のDevice ID読み出しは、`J3`がはんだ付け済みとの申告の下で応答した**（[EXP-015](experiment-log.md#exp-015-accel-01adxl345env-01bme280のesp323v3-pin給電による初回通電とdevice-id読み出し)の`env_chip_id raw=0x60`。
応答があったことは、`J3`が閉じていることと整合するが、`J3`の導通を測ったものではない）。
**この手順は`J3`がはんだ付け済みとの申告を前提に始める。**「`J3`をはんだ付けせずに始める」選択は、
この手順に置かない。条件(1)の項目5（`CSB`→`VDD`を含む）は、通電の前に`ACCEL-01`／`ENV-01`両方について満たすことを求める。**`ENV-01`の`CSB`→`VDD`は、今は満たしたと言えない**（導通を測っていない）。

**実施前に満たす条件(1)〜(6)。**すべて満たすまで通電（手順8以降）しない。手順1〜7で確認・
充足する。根拠・出所は末尾の`条件と手順の根拠`にまとめてある。

- [ ] (1) [gpio-assignment.md](gpio-assignment.md)の`電源pinの短絡・誤配線の確認（非通電）`の
      項目1・5・6・7が完了している（`ENV-01`の項目5`CSB`→`VDD`を含む）
- [ ] (2) firmware（`main()`の`run_i2c_bringup`）が**`bringup-i2c-15-16`だけを付けたbuild**で
      ビルド済みである（書き込みは手順8で行う）。**この手順で通電してよいのは、この単体試験buildだけである。**
      featureなしの製品buildはLCDを点灯し、ADXL345のDevice IDが一致した場合は設定を書くため、
      この手順の条件(4)と両立しない。
      他の試験featureを組み合わせたbuildもこの条件を満たさない（各構成にこの条件を当てた結果は、
      `firmware/esp32/README.md`の「build構成と通電」の表）。`bringup-i2c-15-16`も
      Pi link（UART1）を持ち、GPIO13をTXとして駆動する。この手順の配線（手順1）にGPIO13は無く、
      駆動しても接続先が無い（`gpio-assignment.md`の`PI-UART-TX`行）
- [ ] (3) 電流の余裕計算（`B-2b を採る決定と MSP2807 の電流制限（2026-09-07）`節の
      2026-09-22追記、Revision 117）を確認した
- [ ] (4) `DISP-01`が`3V3` pinへ接続されていない（この節の条件(1)〜(6)はすべて、
      `ACCEL-01`／`ENV-01`だけを`3V3` pinへ接続する場合の前提である。`DISP-01`を追加接続する
      場合は、この節の条件ではなく`DISP-01`追加接続のbring-upの手順が持つ条件(1)〜(7)を
      別途満たす。特に条件(2)（`bringup-i2c-15-16`単独限定）と条件(3)（101.5 mAの計算）は、同手順の
      条件(2)（`bringup-display-13`必須）・条件(3)（4点合算の計算）と両立しない）
- [ ] (5) [gpio-assignment.md](gpio-assignment.md)の`module電源pinの独立性`／`pin header対応`と、
      受け入れchecklistの`Moduleのpull-upを並列合成した実効抵抗が有効範囲内である`が完了している
- [ ] (6) 人間が「通電してよい」と明示している

**現時点で判明している未達（列挙。網羅ではない）:** `ENV-01`の`CSB`→`VDD`（`J3`はんだ付け済みは申告で、導通は未確認。上記）、
条件(5)（現物確認が未実施。`EXP-015`以降の実施でも同じ理由で満たせていない）。詳細は末尾を参照。

1. [人間] `ACCEL-01`／`ENV-01`を配線する（`VDD`／`Vs`→ESP32の`3V3` pin、`GND`→`GND`、
   `SDA`→GPIO25、`SCL`→GPIO26、`CS`→`VDD`（ADXL345）、`SDO`→`GND`（両module）。`DISP-01`は
   配線しない）。`CSB`→`VDD`（BME280）は本節では配線しない（末尾`条件(1)の根拠`参照）。
2. [人間] [gpio-assignment.md](gpio-assignment.md)の`電源pinの短絡・誤配線の確認（非通電）`
   の該当項目（1・5・6・7）がすべて完了していることを確認する（末尾`手順2の根拠`参照）。
3. [人間] [gpio-assignment.md](gpio-assignment.md)の`module電源pinの独立性`／`pin header対応`
   と、受け入れchecklistの`Moduleのpull-upを並列合成した実効抵抗が有効範囲内である`を実施する
   （末尾`手順3の根拠`参照）。
4. [人間] `DISP-01`が`3V3` pinへ接続されていないことを確認する。**この節を単独で実施する場合の
   前提である。既に`DISP-01`が接続された状態へ本節を後から適用する意味ではない。**`DISP-01`を
   このrailへ追加接続する場合の手順は`DISP-01`追加接続のbring-upの手順（本節の下に新設）を見る。
5. [人間] 電源に手を掛けられる状態（USB cableをすぐ抜ける状態）を確保する。
6. [人間] 通電開始前に、給電を止めるまでの待機時間の上限を決めておく（末尾`手順6の根拠`参照）。
   **firmwareの書き込み自体がUSB接続＝通電を伴うため、この手順は書き込みより前に行う。**
7. [人間] 条件(6)（人間が「通電してよい」と明示すること）を満たしていることを確認する。
8. [人間] USB経由でESP32へ接続し、firmwareを書き込む。**この接続が最初の通電である。**
   **書き込みのcommand（`espflash`）は、人間が立ち会って監視している状態であれば、実機Linuxの
   AIセッションが実行してよい**（[#489](https://github.com/wachi-yoshitaka-11-dev/deskcat/issues/489)）。
   USBの接続（通電の開始）と、給電を止める判断は人間が行う。
   ESP32が有効化されると同時に、手順1で配線済みの`ACCEL-01`／`ENV-01`も`3V3` pinを
   経由して同時に通電される（`DISP-01`は手順4で未接続を確認済みのため通電されない）。
9. [人間] 書き込み中および書き込み後、次のいずれかを認めた場合、直ちに給電を止める
   （USB cableを抜く）。
   - 異音
   - 発熱（module、ESP32 board、`U2`のいずれか）
   - 火花・変色・異臭
   - 下記10の(c)（手順6で決めた待機時間の上限に達しても`run_i2c_bringup`側の出力が
     何も出ない）に至った場合
   - 下記10の(b)のうち、`ENV-01`分のlogが成功・失敗のどちらも出ないまま止まる場合
     （異常である。理由は同(b)）

   通電中のテスターによる`VCC`–`GND`間抵抗の監視は、この手順では設定していない（末尾
   `手順9の根拠`参照）。
10. [人間] シリアルログを確認する（末尾`手順10の根拠`参照）。`run_i2c_bringup`は`ACCEL-01`と
    `ENV-01`を順に読み、それぞれ独立に成功／失敗をlogへ出す（片方の失敗がもう片方の読み出しを
    止めない設計。`main.rs`の`run_i2c_bringup`実装）。
    (a) `ACCEL-01`のDevice ID読み出しの結果（成功時は生byte。期待値`0xE5`は
    [sensor-datasheet-notes.md](sensor-datasheet-notes.md)のDevice ID行が出典であり、一致するかは
    判定せず、値をそのまま記録する）がlogに出る。
    (b) `ENV-01`のDevice ID読み出しの結果（成功時は生byte、期待値`0x60`。**`J3`はんだ付け済みの
    前提なので、`ACCEL-01`と同様に成功を期待する。`env_chip_id_read_failed`（失敗）が出た場合は、
    `J3`の導通を含めて配線を疑う（`J3`の導通は未確認）。**また、`ENV-01`分のlogが成功・失敗の
    どちらも出ないまま止まるのは異常である。**
    [#451](https://github.com/wachi-yoshitaka-11-dev/deskcat/issues/451)でI2C読み出しは
    有限timeoutになり、応答が無くても短い有界の待ちのあとに必ず`Err`としてlogへ出る
    （1回あたりの上限は`firmware/esp32/src/config.rs`の`I2C_TRANSACTION_TIMEOUT_MS`、
    上限がどう効くかは`main.rs`の`run_i2c_bringup`のdoc。**どちらもここへ再掲しない**）。
    **したがって「出力が無いまま止まる」を、sensorの予期された結果として扱わない。**
    扱うと、firmwareが本当に停止している状態を見逃す。
    **この状態に至った場合は(c)と同じく手順9の停止条件として扱い、給電を止める。**
    (c) 手順6の待機時間内は`run_i2c_bringup`側の出力が何も（`ACCEL-01`分すら）出ないまま止まる
    （`ACCEL-01`の読み出し自体が止まっている状態であり、異常）。
    (a)(b)(c)いずれも確認し、待機時間・観測内容を記録する。**(a)(b)が確認でき次第、(c)と、(b)で`ENV-01`分のlogが成功・失敗のどちらも出ないまま
    止まる場合は、手順9の停止条件として、給電を止める（USB cableを抜く）。**
11. [人間] 給電を止めた後（手順9の停止、手順10の(a)(b)確認後の停止のいずれでも）、
    `VCC`–`GND`間抵抗を再測定する（末尾`手順11の根拠`参照）。通電後に「低いまま動かない」への
    変化を認めた場合は、短絡が新たに生じた可能性として再開しない。
12. [AI] 結果（成功・停止のいずれも）を[experiment-log.md](experiment-log.md)へ
    `EXP-0xx`として記録する。

##### `ACCEL-01`／`ENV-01`単体bring-upの手順：条件と手順の根拠

**この節は`DISP-01`初回通電の手順（B-2b、外部の3.3 V電源）とは別経路である。**この節は
ADXL345（`ACCEL-01`）とBME280（`ENV-01`）の2点に限り、[#445](https://github.com/wachi-yoshitaka-11-dev/deskcat/issues/445)
の2026-09-22承認によりESP32自身の`3V3` pinから給電する。**`DISP-01`はこの承認（`#445`）の対象外
であり、B-2b・将来の合成給電（段階B-2）には引き続き`B-2b を採る決定と MSP2807 の電流制限
（2026-09-07）`節が適用される。この手順はB-2のgateを開けない**（MSP2807分の`HW-TBD-024`が
未解決のまま残るため、段階B-2は引き続き実施できない。**2026-09-28のユーザー決定により、今の接続のままの電流測定は例外とした。**`段階B-2の測定`参照）。**`DISP-01`は別途`#461`（2026-09-23）で
このrail（`3V3` pin）への通常接続も認められており、その場合の手順は`DISP-01`追加接続の
bring-upの手順（本節の下）を見る。**共通条件表（`許容電圧範囲`／
`全moduleの安全な電流上限`）の「1点でも上限が無ければB-2を実施しない」は、周辺module3点を
合算する段階B-2そのものに掛かる規則であり、この単体bring-upを止めない。**根拠は共通条件表の
`単体bring-upとB-2の区別（2026-09-21追記）`行（`許容電圧範囲`はADXL345`#436`／BME280`#433`で、
`全moduleの安全な電流上限`が求める現物回路の確認は両module分とも`#430`で、それぞれ満たされたと
判定済み。**厳密な電流上限の値そのものは依然として無い**）である。

**条件(1)の根拠。**[gpio-assignment.md](gpio-assignment.md)の`電源pinの短絡・誤配線の確認
（非通電）`のうち、`ACCEL-01`／`ENV-01`に適用される項目1・5・6・7を指す。**項目5の判定基準は
`CS`→`VDD`（ADXL345、IC pin名`VDD I/O`。header silkには`VDD I/O`という表記は無く、`Vs`と同一net
の`VDD`が配線先である。[tbd-register.md](tbd-register.md)の`HW-TBD-004`(5)）、`CSB`→`VDD`
（BME280、`J3`はんだジャンパ経由。`J3`は2026-08-22時点で未はんだ（開放）と実測したが、
2026-09-07にはんだ付けされた。根拠はユーザーの申告だけである。`EXP-014`と
[tbd-register.md](tbd-register.md)の`HW-TBD-005`。導通は確かめていない）を
含む。****`SDO`→`GND`（両moduleとも）も項目5の判定基準に明記済みである。**firmwareは`ACCEL-01`の
I2C addressを`0x53`、`ENV-01`のI2C addressを`0x76`へhardcodeしており（`main.rs`。`SDO`→GNDを
前提とする値）、`SDO`の配線先が異なれば期待するaddressで応答しない。手順1が`CSB`→`VDD`（BME280）
を配線しないのは、`J3`のはんだ付けが済んでいる前提なので、board上で既に接続されているため
（`J3`のはんだ付けはこの節の対象外）。

**条件(2)の根拠。**実装commitは`4486de5`であり、`origin/develop`上に存在する。**書き込み自体は
手順8で行う（書き込みはUSB接続＝通電を伴うため、この節の実行前提には含めない）。**書き込みの
実行者は手順8が定める（[machine-profiles.md](../toolchains/machine-profiles.md)は`ESP32 Flash / HIL`
profileの必須要件を「実機 Linux に限る」「人間の監視」と定めている。同文書自体は「AIがUSB busへ
アクセスできない」とは書いていない）。USBシリアルでのlog読み取りは人間が行う（手順10）。

**条件(3)の根拠。**同計算はWi-Fi/BT不使用を前提とする。**この前提は満たされる**（現在の
firmwareの`main.rs`はWi-Fi／Bluetooth APIを一切呼び出しておらず、`Cargo.toml`にも該当featureが
無い。2026-09-22に走査して確認した。#487のPR B1の後（2026-09-30）にも、`firmware/esp32/src`、`firmware/esp32/Cargo.toml`、`firmware/esp32/sdkconfig.defaults`を`wi-fi`（`wifi`を含む）／`bluetooth`／`ble`／`bt`／`nimble`／`bluedroid`（大文字小文字を区別しない。`ble`と`bt`は語として）で走査し、commentを除いて0件であることを確かめた）。

**条件(4)の根拠。**計算はESP32＋`ACCEL-01`＋`ENV-01`の合計（約101.5 mA）であり、`DISP-01`を含まない。
`DISP-01`が同じ`3V3` railに同時接続されている場合、この計算はDISP-01分の電流を含まないままになり、
成立しない。**2026-09-23（[#461](https://github.com/wachi-yoshitaka-11-dev/deskcat/issues/461)）で、
`HW-TBD-024`は「`DISP-01`を3.3 V系へ通常接続すること自体」を一律に妨げる扱いではなくなった。**
それでも条件(4)がこの手順で未接続を求める理由は別にある。**この節の余裕計算はDISP-01分の電流を
含めずに101.5 mAとして組まれているため、DISP-01を接続すると、この手順固有の余裕計算がそのまま
では成立しなくなるからである。**`HW-TBD-024`が一律に妨げなくなったことは、この手順固有の
余裕計算を組み直したことを意味しない。

**この条件の根拠は2026-09-23に変わった。**[#451](https://github.com/wachi-yoshitaka-11-dev/deskcat/issues/451)
より前は、firmware側の理由が主だった。`main()`が`run_display_bringup`を無条件に呼び、その中で
`lcd.backlight_on()`を実行していたため、`DISP-01`が配線されているだけでbacklightへ給電された。
**`#451`で`run_display_bringup`は`bringup-display-13`か`face-21`のfeature付きbuildだけが
呼ぶようになり、当時の既定buildはLCD関連pinへ触れなかった。**#487の製品build統合以降、
この手順は`bringup-i2c-15-16`単独buildを使う。この試験buildにはbacklightを点ける経路が無い
（正は`firmware/esp32/src/main.rs`のmodule docの
「`DISP-01`のbring-upを有効にする手順」節。**ここへfeature名以外を再掲しない**）。

**それでも条件(4)は外さない。**理由が1つ減っただけである。(1) この節の電流の余裕計算は
`DISP-01`を含まない。backlightが消えていても`DISP-01`のlogic側は`3V3` railから電流を引く。
`DISP-01`を3.3 V系へ通常接続すること自体は2026-09-23（`#461`）以降妨げられていないが、この手順
固有の余裕計算（約101.5 mA）はDISP-01分を含んでおらず、接続すると計算が成立しなくなる。
**`#461`はこの手順の余裕計算を組み直すものではない。**(2) **「GPIO4がLowだから、繋いでも点かない」とは判断できない。**
`EXP-011`が確認したのはESP32側の信号レベルまでであり、`DISP-01`を接続していない状態の測定
である。**backlightをdriveする実際の回路（module側）を含めた消灯確認は、LCD接続後に残る**
（正は[gpio-assignment.md](gpio-assignment.md)の`信号inventory`の`LCD-BL`行と
[experiment-log.md](experiment-log.md)の`EXP-011`。**ここへ再掲しない**）。(3) この手順は
`#445`承認の範囲（`ACCEL-01`／`ENV-01`のESP32`3V3` pin給電）に閉じている。**`DISP-01`を
ESP32`3V3` pinへ通常接続すること自体は2026-09-23（`#461`）で別途認められたが、`#461`は
この手順（`#445`の余裕計算）へ`DISP-01`を合流させることを意味しない。**`DISP-01`を含む構成の
手順は、この節とは別になる（作成は`#13`が引き受け、`DISP-01`追加接続のbring-upの手順として
本節の下に新設済みである。同手順は`HW-TBD-024`行が既に持つ計算をそのまま参照し、余裕の
再計算はしていない）。**したがって「製品buildならLCDを繋いでよい」とは読まない。**

**条件(5)の根拠。**`main.rs`の`run_i2c_bringup`のdoc commentが「実機で動かす前に要る」と挙げる
現物確認2件を指す。**(a) `module電源pinの独立性`／`pin header対応`（[gpio-assignment.md](gpio-assignment.md)
の`ESP32の電源投入前に外部moduleがESP32 pinをdriveしない`節にある測定項目表。moduleがESP32へ
配線されるまで検証対象が存在しないため`#15`／`#16`側へ送られた確認）は、`ACCEL-01`／`ENV-01`と
も未実施である。**`ACCEL-01`の`Vs`／`VDD`間導通
（2026-09-05確認済み、[tbd-register.md](tbd-register.md)の`HW-TBD-004`(5)）は、header内部の
別pin同士が同一netであることの確認であり、この表が求める`各moduleの電源pin ⇔ ESP32の3V3 pin`
間の測定とは別の測定である。この表自体はACCEL-01についても未実施のまま残る。**(b) `Moduleの
pull-upを並列合成した実効抵抗が有効範囲内である`（受け入れchecklist、`bus容量Cb`が未測定のため
未達のまま）。**これら2件は条件(1)が引用する`電源pinの短絡・誤配線の確認（非通電）`表の対象外
であり、別途満たす必要がある。

**条件(6)の根拠。**`DISP-01`初回通電の手順の条件(2)と同じ扱い。[#445](https://github.com/wachi-yoshitaka-11-dev/deskcat/issues/445)
の2026-09-22承認は給電経路の例外であり、個々の初回通電の実施可否を自動的に認めるものではない。

**手順2の根拠。**手順1で配線済みのため、項目1の測定はESP32側の`3V3`／`GND`railを含む状態で
行うことになる。module単体を切り離した測定ではないが、判定基準（低いまま動かない＝短絡）自体は
railを含んでいても成立する（railを含む短絡もrailを含まない短絡も、同様に低いまま停滞する読みと
して現れる）。

**手順3の根拠。**`pin header対応`の対象は`信号inventory`の各signalだが、`ACCEL-IRQ`は手順1で
意図的に未配線のため、この項目の対象から除く（項目5の判定基準と同じ扱い。`ACCEL-IRQ`の配線・
確認は割り込みを使う段階で別途行う）。受け入れchecklistの`Moduleのpull-upを並列合成した実効抵抗
が有効範囲内である`は、[gpio-assignment.md](gpio-assignment.md)が定める2通りのいずれかで満たす。
**(a)** 実配線の`bus容量Cb`を実測する、または**(b)** `Cb`≤400 pFを裏付ける設計上の根拠を得る。
**実測の結果が400 pFを超え488 pF以下の場合、同文書はrise timeの計算は通るが、Standard-mode
として規定範囲内と言い切れない可能性が残ると明記している**（fall time等、rise time以外の
制約を同文書が引用した一次資料の範囲では確認できていないため）。**この場合、この項目を達成済み
とは扱わず、同文書のこの記述に従って判断する。**いずれの方法も採らない限り、この項目は未達の
まま残る。

**手順6の根拠。**firmware側はこの呼び出し（手順10）の応答時間を保証しないため、上限は実施者が
事前に決める。

**手順9の根拠。**項目1の抵抗測定は電源off状態で行う測定であり、通電中に別途計器を当てる手段は
本節のどの手順にも無い。実施者が独自に安全に監視できる場合は追加の停止根拠として使ってよいが、
この手順の必須条件ではない。

**手順10の根拠。**手順の(a)(b)(c)は`run_i2c_bringup`側（`ACCEL-01`／`ENV-01`のDevice ID
読み出し）のlogを指す。**この手順の`bringup-i2c-15-16`単独buildでは、その手前にdisplay側のlog
（`display_madctl`／`display_fill`／`display_corner_pattern`）は出ない。**[#451](https://github.com/wachi-yoshitaka-11-dev/deskcat/issues/451)
で`run_display_bringup`が`bringup-display-13`か`face-21`のfeature（既定off）の付いたbuildだけの経路に
なったためである（`main.rs`）。**`#451`より前の記述（display側のlogが先に現れるのは異常では
ない）は、この手順の試験buildについては当てはまらない。**`--features bringup-display-13`を付けて
buildした場合は従来どおりdisplay側のlogが先に出るが、その構成はこの節の対象外である
（この節は`DISP-01`を接続しない手順である。条件(4)参照）。

**読み出しが返らないまま止まることは無い。**`#451`で`run_i2c_bringup`のI2C読み出しは有限
timeoutになった。1回あたりの上限は`firmware/esp32/src/config.rs`の
`I2C_TRANSACTION_TIMEOUT_MS`が持ち、上限がどう効くかは`main.rs`の`run_i2c_bringup`の
doc commentが持つ。**どちらもここへ値を再掲しない。**busが低のまま固着していれば、読み出しは
`Err`としてlogに出る（`accel_device_id_read_failed`／`env_chip_id_read_failed`）。
**ただし実機で`Err`が返るまでの実測時間は、まだ取っていない。**上限の根拠はESP-IDF実装を
読んだものであって実機観測ではない（同doc comment）。手順6で実施者が決める待機時間の上限は、
この未実測を前提に置いたままにする。

**手順11の根拠。**[gpio-assignment.md](gpio-assignment.md)の項目1の判定基準により、条件(1)
（項目1）を通過した個体は通電前の観測が「上昇して安定」または「最初から高い値で安定」の
いずれかであったはずである（「低いまま動かない」は項目1で短絡と判定され、この節へ進まない）。

#### `DISP-01`追加接続のbring-upの手順（ESP32`3V3` pin給電、`#461`承認範囲）

**AIは以下を準備するだけであり、実行と判定は人間が行う**（[Hardware Safety Policy](../governance/hardware-safety-policy.md)
「7. 人間の監視が必要な操作」）。

**この手順はB-2bの手順（上記`DISP-01`初回通電の手順（給電構成の確定待ち）節）とは別経路である。**
B-2bは外部の電流制限つき3.3 V電源を給電元とし、その前提2点（電流制限電源の確保、設定電流制限値の
決定）は`HW-TBD-024`／`HW-TBD-025`(b)未解決のため引き続き揃わない。**この手順はESP32自身の`3V3`
pinを給電元とし**（[#461](https://github.com/wachi-yoshitaka-11-dev/deskcat/issues/461)、2026-09-23
承認）、B-2bの前提2点はこの手順には掛からない。**逆に、この手順が要求するACCEL-01／ENV-01先行接続
という前提は、B-2b側の手順には掛からない。**2つの手順の条件を混用しない。

**前提: `LED` pin配線とfirmwareのbacklight制御の関係。**`HW-TBD-024`行の2026-09-17追記・
2026-09-23追記が扱う「通常接続」はLCDWiki公式User Manualの原文（`LED` pinを3.3Vへ直結する構成）を
含むが、それに限る書き方ではない（2026-09-17追記は「`LED` pinを能動制御せず3.3Vへ直結する構成を
採っても…論点は消えない」と述べ、懸念自体を`LED` pinの配線方法に依存しないものとして立てている）。
`DISP-01`のfirmware側配線は`LCD-BL`（GPIO4、外部4.7 kΩ pull-down。[gpio-assignment.md](gpio-assignment.md)の
`信号inventory``LCD-BL`行、2026-09-06確定）経由でこの`LED` pinを能動的にHighへ駆動する。
[sensor-datasheet-notes.md](sensor-datasheet-notes.md)の`Backlight回路／電流／polarity`行が
記録するとおり、`LED` pinは`VCC`および`U1`の3本の足のいずれとも非導通（オーバーレンジ）である。
同行はこの非通電測定だけで断定しておらず、backlightの実電流が`R5`の先で`VCC`側と`U1`出力側の
どちらを経由するかも、`Q1`側の経路（接合の性質上この方法では判定できない）も未確定のまま残して
いる。**それでも、`HW-TBD-024`行の2026-09-17追記が示す枠組み（懸念は`LED` pinの配線方法に
依存しないという整理。上記）に従えば、電流上界の計算（`HW-TBD-024`行が持つ通常動作約245.4 mA・
故障時約646.5 mA）自体は`LED` pinの配線方法（GPIO経由の能動制御か、3.3Vへの直結か）に依存しない
という結論は変わらない。**この結論の根拠は、`LED` pinの非導通という個別の実測結果ではなく、
`HW-TBD-024`行がbacklight経路そのもの（`VCC`→`R5`→LED列という表記は、`VCC`直結か`U1`出力側
経由かを区別せず経路全体を指す出典側の略記であり、ここでもその意味で使う。`LED` pinとは別の
経路である）を対象に組んだ電流上界の計算が、`LED` pinの状態を入力に使っていないことにある。
`R5`先短絡の故障電流上界は`R5`の値と
rail電圧だけで決まり、通常動作の値（LCD Wikiの0.31 W）もbacklightが点灯した状態の値であって
駆動元（railかGPIOか）で変わらない。**`main.rs`のmodule docは「`run_display_bringup`が追加で
引く負荷は無い」と述べているが、これは`3V3` railの負荷合計（backlight・ILI9341ロジック分）が
`#461`の余裕計算にすでに含まれているという意味であり、GPIO4自身が吐き出す電流（`LED` pinの
入力電流）について述べたものではない。**GPIO4（`LCD-BL`）の電源domainは`VDD3P3_RTC`
（[gpio-assignment.md](gpio-assignment.md)の`reset時のpin状態（IO_MUXから）`表）である。**
この電流がESP32自身の`3V3` rail（外部から供給される`3V3` pin）を経由するかどうかを裏付ける
記録は正本のどこにも無く、断定しない。**いずれにせよ、この電流の大きさは正本のどこにも値の
記録が無く、`#461`の余裕計算の対象にもなっていない。この値を推定して足さない（`R6`（1 kΩ）が
どこへ繋がるかも未確定であり、そこから電流を導出しない）。

**ここまでは電流上界の計算が成立する根拠であり、`run_display_bringup`を実行してよいかの
承認ではない。**`main.rs`のmodule docが明記するとおり、**`#461`は接続そのものを許可するだけで、
`run_display_bringup`（初期化とbacklight点灯を行う。GPIO4によるbacklight点灯を含む。#487のPR B1から、fill・四隅patternは
この関数が返した後にmain loopの中で`crate::display_test`が進める。以下、この一連を指す）を`3V3` pin経路で実行してよいかは決めていない。**この実行の承認は、下記条件(7)で人間から
個別に得る（`#461`の残余risk受け入れを再審議するものではない。firmwareの経路を1つ実行してよいか
という別の判断である）。

**前提: `gpio-assignment.md`が`#13`（この手順）へ送った2件の確認。**この手順はいずれにも
新たに答えるものではなく、既存の記録どおり未解決のまま扱う。(1) MSP2807のlogic IOが3.3Vで
動作することの現物確認（[gpio-assignment.md](gpio-assignment.md)の`実機check（電源off）の確認方法`
節。`U1`出力経由なら`VOH`が約34–133 mV不足しうるという計算は、`ILI9341`と`XPT2046`の両方の
`VOH`を確認したうえで行われており、**`ILI9341`（`DISP-01`のcontroller）自体がこの計算の対象に
含まれている。**「moduleからESP32への向き（touchの`DOUT`／`PENIRQ`等）」という同節の例示は
touch限定ではなく、module→ESP32方向の信号一般を指しており、`LCD-MISO`もこれに含まれると読める。
**この対応は同節では確認されておらず、この手順が新たに確認するものでもない。**firmwareは
`LCD-MISO`からcontrollerのIDを読まない（手順9(a)）ため、この未解決事項は今の手順の判定には
効かない。`EXP-016`〜`EXP-018`でIDの読み出しが期待する値を返さなかった原因の候補の一つとして
残る）。
(2) 実機`DISP-01`を接続した状態でbacklightが実際に消灯していることの物理確認（[gpio-assignment.md](gpio-assignment.md)の
`競合check`節の受け入れchecklist「Resetとbacklight lineが安全な状態で起動する」項目。`信号inventory`の
`LCD-BL`行はこの項目を参照するだけで、項目自体はここに無い。同項目が「確認は`#13`（LCD bring-up）
で行う」と定める。`EXP-011`はLCD／touch未接続での測定に限る）。
**この手順は(2)を確かめる確立した手段を持たない**（`run_display_bringup`が動き出すとbacklightを
点灯させる。手順7が示すとおり、書き込み前にESP32へ残っているimageが`run_display_bringup`を
呼ばない構成とは限らず、`EXP-015`が使ったimage（`35bcc36`）はむしろ無条件に呼ぶ版であるため、
USB接続からflash書き込み完了までの間も消灯していると仮定できない。消灯状態の確立した確認は
別途・別の機会に要る）。いずれも解決したと主張せず、実施時の記録（手順11）へ未解決事項として残す。

**前提: 接続順序。**この手順は、`ACCEL-01`／`ENV-01`単体bring-upの手順（上記節、`#445`承認範囲）が
既に実施され、両moduleがESP32`3V3` pinへ接続され通電済みの状態（[EXP-015](experiment-log.md#exp-015-accel-01adxl345env-01bme280のesp323v3-pin給電による初回通電とdevice-id読み出し)）へ、
`DISP-01`を同じrailへ追加接続する場合を扱う。**まだ`ACCEL-01`／`ENV-01`を接続していない場合は、
先に同節を実施すること。**この手順の電流余裕計算（条件(3)）は、`HW-TBD-024`行が計算で出した
ESP32＋`ACCEL-01`＋`ENV-01`＋`DISP-01`の負荷合計（測定ではない。段階B-2＝周辺module3点合算の
定常電流「測定」とは別物であり、混同しない）を前提としており、`DISP-01`単独接続
（`ACCEL-01`／`ENV-01`なし）には使えない（`HW-TBD-024`行の計算自体がこの3点構成を前提として
組まれており、異なる構成への適用は同行が明示的に検証した範囲を超える。負荷が減る分には
数値上は保守側へ動く可能性が高いが、それを理由に前提を無断で広げない）。**`ACCEL-01`／`ENV-01`単体bring-upの手順の
条件(4)（`DISP-01`が`3V3` pinへ接続されていないこと）は、同節を単独で実施する場合の前提であり、
この手順（`DISP-01`を追加接続する場合）には適用しない。**この手順の条件(4)（下記）が代わりに適用
される。配線の変更（`DISP-01`の追加）は、ESP32・周辺module3点とも無給電の状態で行う
（[Hardware Safety Policy](../governance/hardware-safety-policy.md)「7. 人間の監視が必要な操作」、
新しい配線revisionの初回通電にあたる）。

**実施前に満たす条件(1)〜(7)。**すべて満たすまで通電（手順7以降。firmwareの書き込み＝
この配線revisionでの最初の通電にあたる）しない。**ただし条件(5)は例外として扱いうる**
（末尾`条件(5)の根拠`が示すとおり、`EXP-015`はこの条件が未達のまま人間の現場判断で通電した
先例を持つ。この手順でも同じ判断がありうることを明記しているのは条件(5)だけであり、他の
条件を人間の現場判断で省略してよいことにはならない）。

- [ ] (1) [gpio-assignment.md](gpio-assignment.md)の`電源pinの短絡・誤配線の確認（非通電）`の
      項目1（共通）・2（一覧照合）・3（逆極性）・4（給電経路の重複。判定基準「単一経路である
      こと」は`3V3` pinの1系統だけから受電し、USBの5V・外部3.3V電源等が同時に到達しないこと）が、
      `DISP-01`について完了している
- [ ] (2) firmwareが`--features bringup-display-13`付きでbuild済みである。**commandの正本は
      [検証済みコマンド](../toolchains/verified-commands.md)であり、ここへ写さない。**同feature
      はLCDの試験構成を選び、Pi link（UART1）も同時に動く
      （[#487](https://github.com/wachi-yoshitaka-11-dev/deskcat/issues/487)。GPIO13をTXとして駆動する。
      Piをつながない回は、手順1の配線がGPIO13を使わないため、GPIO13に接続先は無い。Piをつなぐ回は
      条件(3)(a)による。`gpio-assignment.md`の`PI-UART-TX`行）。既定の製品buildでは
      表情を描き、fill・四隅patternの試験を行わないため、受け入れ条件（初期化・fill・四隅・timing）を確認する材料と、
      controllerの識別に使うcommandの実機での効果が得られない。build-onlyのCI結果は
      実機通電の根拠ではなく、実行する端末でbuildと通電条件を別途確認する）
- [ ] (3) 電流の余裕計算（[HW-TBD-024の判断記録](tbd-register-history.md#hw-tbd-024)の2026-09-23追記）を
      確認した。**この計算はESP32＋`ACCEL-01`＋`ENV-01`＋`DISP-01`（backlight点灯＋ILI9341ロジック
      50 mA）の負荷合計（計算であり、段階B-2の定常電流「測定」ではない）を前提とする。**次の4点が
      すべて成立する場合にだけこの計算を使える。**1点でも異なれば通電を保留し、条件を揃え直す。**
      (a) `3V3` railに載る負荷はESP32本体・`ACCEL-01`・`ENV-01`・`DISP-01`だけである（servo・
      Pi・他のmoduleを同時に接続しない）。**この計算にLEDの2枝（#514）は含まない。**LEDの2枝を足す承認と、その差分の見積もりは[回路案](led-514-demo.md)の`3V3 pinへ負荷を足す条件`にある。**Piは、次をすべて満たす場合に限ってつないでよい。**Piを
      別電源で給電する。PiとESP32の間は、UARTの信号線2本とGNDの線だけにする。
      [gpio-assignment.md](gpio-assignment.md)の`信号線をつないでよい条件`の番号付きの条件をすべて守る。
      servoと他のmoduleは、今までどおり同時に接続しない。Piをつなぐと、GPIO13（`PI-UART-TX`）が
      直列抵抗の先のPiのRXを駆動する分が、`3V3` railに加わる。その上界は、Piの側の電位に関わらず、
      `3V3` railの上限の電圧を直列抵抗で割った値である（PiのRXの入力の特性は使っていない）。
      電圧は[3.3 V railの許容電圧範囲](#33-v-railの許容電圧範囲)の上限3.366 V、直列抵抗は
      [gpio-assignment.md](gpio-assignment.md)の`信号線をつないでよい条件`の1の4.7 kΩである。
      **抵抗の許容差は[hardware-bom.md](hardware-bom.md)の`RES-PULL-01`行に記録が無い。**許容差の代わりに、
      抵抗が半分（2.35 kΩ）になる保守側の仮定を置く。上界は3.366 V ÷ 4.7 kΩ ≈ 0.72 mA、半分の仮定で
      3.366 V ÷ 2.35 kΩ ≈ 1.43 mAである。この計算（[tbd-register.md](tbd-register.md#hw-tbd-024)の
      `HW-TBD-024`。計算は同節が指す元の行）の余裕と比べる。電流は、`U2`の連続定格1 Aと通常動作の
      合計約245.4 mAの差の約754.6 mAに対し、半分の仮定でも約1.43 mAで、約520倍の余裕がある。熱は、
      損失の増分を電流 × `U2`の電圧降下（`Vdrop`≈1.7 V）× `Rθja`（88 ℃/W）とし（値はどれも同じ元の行の
      熱の計算から取る）、半分の仮定で約1.43 mA × 1.7 V × 88 ℃/W ≈ 0.21 ℃である。故障時に`TSD`まで
      残る約9 ℃に対し、約40倍の余裕がある（約9 ℃は、元の行が`TSD`のtyp 150 ℃から出した残りであり、
      保証された値ではない。約40倍は、そのtypに基づく残りとの比較である）。GPIO14（`PI-UART-RX`）に
      PiのTXから入る側は、両方の電源が入っている間は`3V3` railの負荷として加わらない。ESP32の電源が
      切れてPiのTXがHighのまま残ると、入力の保護を通じて電流が流れ込みうる。これは
      [gpio-assignment.md](gpio-assignment.md)の`信号線をつないでよい条件`の後の段落と`HW-TBD-036`が扱い、
      直列抵抗で縛られるが、許容値は確かめていない。Piの電源が切れてESP32のTX（GPIO13）がHighのまま
      残ると、PiのRXの入力の保護を通じて電流が流れ込みうる。これも同じ段落と`HW-TBD-036`が扱い、
      直列抵抗で縛られるが、許容値は確かめていない。両方の電源が入っている間に、PiのTXの電位が
      ESP32の電源の電位を上回るかどうかも確かめていない。GNDを共通にしたときのPC–Pi間の電流経路も
      確かめていない（`HW-TBD-036`）。(b) ESP32はUSB経由でPCから給電する（[EXP-015](experiment-log.md#exp-015-accel-01adxl345env-01bme280のesp323v3-pin給電による初回通電とdevice-id読み出し)と
      同じ給電源。計算が`Vin=5V`前提の熱計算（`Vdrop`≈1.7 V）を使っているため、Piからの給電・
      5 V rail経由など別経路へは変えない）。(c) 周囲温度はambient 40℃の仮定に収まる範囲である。
      (d) firmwareがWi-Fi／Bluetoothを使用しない（計算の基礎となる101.54 mA自体がこの前提に
      立つ。確認結果は`ACCEL-01`／`ENV-01`単体bring-upの手順`条件(3)の根拠`が持ち、現在の
      firmwareはWi-Fi／Bluetooth APIを呼び出していないことを確認済みである）
- [ ] (4) `ACCEL-01`／`ENV-01`が`3V3` pinへ接続済み（[EXP-015](experiment-log.md#exp-015-accel-01adxl345env-01bme280のesp323v3-pin給電による初回通電とdevice-id読み出し)）であり、
      `DISP-01`が同じ`3V3` railへ追加接続されている
- [ ] (5) [gpio-assignment.md](gpio-assignment.md)の`module電源pinの独立性`／`pin header対応`と
      受け入れchecklistの`Moduleのpull-upを並列合成した実効抵抗が有効範囲内である`を確認した
      （末尾`条件(5)の根拠`参照。**`ACCEL-01`／`ENV-01`単体bring-upの手順と同じく、この条件は
      `EXP-015`の時点でも未達のまま通電された先例がある。**ただし未達の内訳は一様ではない。
      `module電源pinの独立性`測定（配線構造上物理的に成立しない）は人間の現場判断、
      `bus容量Cb`（未測定のまま進めた）はPMの判断に基づく、と`EXP-015`自身が別々に記録している）
- [ ] (6) `HW-TBD-025`(b)（現物回路の確認という手続き）がMSP2807について引き続き満たされていない
      ことを実施者が把握している。**満たされているのは既知の経路（`R5`・`U1`）の電流上界計算だけ
      であり、隠れた経路の不在は確認できていない**（[tbd-register.md](tbd-register.md)の
      `HW-TBD-024`行）
- [ ] (7) 人間が、`run_display_bringup`（GPIO4による`DISP-01`のbacklight点灯を含む）を`3V3` pin
      経路で実行することを明示的に承認しており、その記録（[Issue #13](https://github.com/wachi-yoshitaka-11-dev/deskcat/issues/13)
      のコメント等、通電前に確認できる記録）がある。**通電後に手順11で作る`EXP-0xx`は、この
      条件の記録にはならない**（承認は通電前に済んでいる必要がある）。承認を求めるときは、次を示す。
      描画は`run_display_bringup`が返った後にmain loopの中で`firmware/esp32/src/display_test.rs`が
      1段ずつ進めること。Piをつなぐかどうか。backlightが点く起動の回数（USBを挿した時点の起動、
      monitorや`espflash`が起動し直す分、書き込みの前に前のimageが動く区間を含める）。**承認した
      回数を超えそうなときは、通電の前に人間へ確かめる**

1. [人間] `DISP-01`を配線する（`VCC`→ESP32の`3V3` pin（`ACCEL-01`／`ENV-01`と共通のrail）、
   `GND`→`GND`、`LCD-CS`→GPIO22、`LCD-DC`→GPIO17、`LCD-RST`→GPIO16、`LCD-MOSI`→GPIO23、
   `LCD-SCLK`→GPIO18、`LCD-BL`→GPIO4、`LCD-MISO`→GPIO19。touch用5pinは配線しない。
   pinの正は[gpio-assignment.md](gpio-assignment.md)の`信号inventory`であり、ここへ再掲しない）。
   **`LCD-CS`／`LCD-RST`の外部10 kΩ pull-upと`LCD-BL`の外部4.7 kΩ pull-downは、この手順の対象
   外である（いずれも実装済み。`LCD-BL`のpull-downは2026-09-07、`LCD-CS`／`LCD-RST`のpull-upは
   それより前に実装済みと[gpio-assignment.md](gpio-assignment.md)冒頭の実装状況が記録する。
   ここへ個別の日付は再掲しない）。**
   配線はESP32・周辺module3点とも無給電の状態で行う。**この手順は`ACCEL-01`／`ENV-01`の既存配線
   （`EXP-015`時点のもの）が`DISP-01`を追加する間に変わっていないことを前提とする。**同moduleの
   `電源pinの短絡・誤配線の確認（非通電）`表の項目5〜7（一覧照合・逆極性確認・給電経路重複確認）の
   再確認はこの手順の対象外
   とし、疑わしい場合は`ACCEL-01`／`ENV-01`単体bring-upの手順の該当項目へ戻って確認する。
2. [人間] 手順1の配線を終えた状態で、[gpio-assignment.md](gpio-assignment.md)の
   `電源pinの短絡・誤配線の確認（非通電）`の項目1・2・3・4を実施する。
3. [人間] [gpio-assignment.md](gpio-assignment.md)の`module電源pinの独立性`／`pin header対応`
   と、受け入れchecklistの`Moduleのpull-upを並列合成した実効抵抗が有効範囲内である`を実施する
   （末尾`条件(5)の根拠`参照。**`ACCEL-01`／`ENV-01`側の`module電源pinの独立性`測定は、`EXP-015`が
   記録するとおりブレッドボード配線（ESP32側pinとmoduleの電源・信号pinが同一行にある）では
   物理的に成立しない。この手順でも同じ配線を使う限り同様に成立しない見込みであり、条件(5)は
   未達のまま人間の現場判断で先へ進む可能性がある**）。
4. [人間] 電源に手を掛けられる状態（USB cableをすぐ抜ける状態）を確保する。
5. [人間] 通電開始前に、給電を止めるまでの待機時間の上限を決めておく。**単色fillの各色と
   向きのpatternは表示したまま保つため（保つ時間は`firmware/esp32/src/config.rs`の`DISPLAY_HOLD_MS`。
   ここへ値を再掲しない）、手順9(d)のlogはその分と、描画の時間（`firmware/esp32/src/config.rs`の`DISPLAY_HOLD_MS`のdoc）の分と、描画の段と段の間の分（`firmware/esp32/src/display_test.rs`のmodule doc）だけ遅れて出る。
   条件6を確かめる回は、手順9の末尾の延長の分も加わる。上限はこれらを含めて決める。**
6. [人間] 条件(7)（`run_display_bringup`を`3V3` pin経路で実行することの明示的な承認と、
   その記録）を満たしていることを確認する。
7. [人間] USB経由でESP32へ接続し、`--features bringup-display-13`でbuildしたfirmwareを書き込む。
   **この接続がこの配線revisionでの最初の通電である。**
   **書き込みのcommand（`espflash`）は、人間が立ち会って監視している状態であれば、実機Linuxの
   AIセッションが実行してよい**（[#489](https://github.com/wachi-yoshitaka-11-dev/deskcat/issues/489)）。
   USBの接続（通電の開始）と、給電を止める判断は人間が行う。
   ESP32が有効化されると同時に、`ACCEL-01`／
   `ENV-01`（既存配線）と`DISP-01`（今回追加）が`3V3` pinを経由して同時に通電される。
   **書き込み前にESP32へ入っているfirmwareのimageは、`run_display_bringup`を呼ばない構成とは
   限らない。**`EXP-015`が使ったimage（commit `35bcc36`）は`#451`（`bringup-display-13`
   feature gateの導入）より前の版であり、`run_display_bringup`を無条件に呼ぶ（feature gate
   自体が存在しない。`main.rs`のmodule docが「`#451`より前、`run_display_bringup`は既定build
   でも無条件に呼ばれ」と記録するとおり）。**このimageが残っていれば、USB接続の直後から
   （flash書き込みが完了する前に）`DISP-01`が駆動され、backlightが点灯すると想定する。**
   その電流は条件(3)の計算（backlight点灯・ILI9341ロジック動作を含む想定）の範囲内であり、
   この点だけを理由に手順を止めない。**ただし、この間に生じるlogやbacklightの状態は、条件(7)が
   管理する`run_display_bringup`の実行（この手順が対象とする実行）とは無関係であり、手順9の
   判定材料にしない。**手順9で確認するのは、書き込み完了後に実行される
   `--features bringup-display-13` build由来のlogだけである。**この間に旧imageが出したlogと
   backlightの状態は、手順9の判定とは別に、手順11の`Measured result`／`Faults`へ記録する。
8. [人間] USB接続（手順7）の直後から、書き込み中および書き込み後まで通して、次のいずれかを
   認めた場合、直ちに給電を止める
   （USB cableを抜く）。
   - 異音
   - 発熱（`DISP-01`、`ACCEL-01`、`ENV-01`、ESP32 board（`U2`周辺を含む）のいずれか）
   - 火花・変色・異臭
   - 電圧降下（給電源側の出力電圧が測定できる場合、垂れがあれば停止）
   - 手順5で決めた待機時間の上限に達しても、手順9が挙げる(a)〜(d)いずれのlogも一切出ないまま
     止まる場合（`run_display_bringup`・`run_i2c_bringup`とも出力が無い状態）
   - 手順9(a)は出た（成功または`display_driver_new_failed`／`display_init_failed`）のに、
     `i2c_driver_new_failed`も含め、`accel_device_id`・`env_chip_id`関連のlogが待機時間内に
     一切出ない場合（下記`失敗時の扱い`参照）
   - `accel_device_id`関連のlogは出たにもかかわらず、`env_chip_id`関連のlogだけが待機時間内に
     一切出ない場合（下記`失敗時の扱い`参照）

   **通電中のテスターによる`VCC`–`GND`間抵抗の監視は、この手順では設定していない**
   （`ACCEL-01`／`ENV-01`単体bring-upの手順`手順9の根拠`と同じ理由。同根拠が挙げるのは、
   この手順のどの段階にも通電中に計器を当てる手段を設定していないという実施上の理由であり、
   実施者が独自に安全に監視できる場合はその手段を追加の停止根拠として使ってよい）。

   **`HW-TBD-024`が記録する故障時の熱余裕は`TSD`まで約9℃と薄い**（`R5`の先が短絡した場合。
   [HW-TBD-024の判断記録](tbd-register-history.md#hw-tbd-024)）。発熱の確認は`DISP-01`周辺と
   ESP32 board（`U2`周辺）の両方で行う。
9. [人間] シリアルログを確認する。`main()`は`run_display_bringup`を`run_i2c_bringup`より先に
   呼ぶ（`main.rs`）。`hb`のseqだけを見て行が抜けたと判断しない。抜けは`bringup_hb`と`hb`の行を
   合わせて見る（`main.rs`の`service_bringup_step`のcomment）。
   (a) `display_madctl`（初期化が済んだことと、書き込んだMADCTLの値・論理座標の幅と高さ。
   受け入れ条件「Controller識別情報と初期化の根拠」の初期化の側）。**firmwareはcontrollerの
   IDを読まない**（`firmware/esp32/src/display.rs`のmodule doc。`EXP-018`でどのregisterも期待する
   値を返さなかったため。controllerの識別は、moduleのsilkと資料、およびcommandが実機で
   期待どおりに効いたことで記録する）、
   (b) `display_fill`×5色（受け入れ条件「単色fillが正しい」「Color orderが正しい」
   「更新timingを測定した」。`elapsed_us`を記録する。`elapsed_us`は#487から意味が変わったので、
   `EXP-016`〜`EXP-018`の値と比べない（`firmware/esp32/src/display_test.rs`のmodule docの「logの行」）。各色は`hold_ms`だけ表示したまま保たれるので、
   その間に色ごとに写真を撮る）、
   (c) `display_pattern_element`と`display_corner_pattern`（受け入れ条件「四隅とorientationが正しい」。
   続く`display_pattern_hold`の`hold_ms`の間に、`J2`のheaderを入れて写真を撮る。patternの見方と
   一致の判定のしかたは`firmware/esp32/src/display_test.rs`のmodule docの「四隅pattern」節が持つ（#487のPR B1の前は`main.rs`の`run_corner_pattern`のdoc commentが持っていた）。軸の線の描画失敗は
   `display_axis_failed`として出て、後続を止めない）。**受け入れ条件
   「単色fillが正しい」「Color orderが正しい」「四隅とorientationが正しい」は、logに加えて
   人間がpanelを目視（写真記録）で確認し、その結果を手順11へ記録したときだけ達成とする。**
   logだけでは描画処理の実行結果を示すにとどまり、実際の色順・四隅位置・orientationを
   保証しない。
   (d) `accel_device_id`・`env_chip_id`（`ACCEL-01`／`ENV-01`の読み出し。期待値は
   [sensor-datasheet-notes.md](sensor-datasheet-notes.md)のDevice ID行。**`ENV-01`の`J3`
   （`CSB`→`VDD`）は`EXP-014`によれば2026-09-07にはんだ付けされたとユーザーが申告している。
   ただし`EXP-014`自身が明記するとおり、この記録は測定値を持たずユーザーの申告のみを根拠とし、
   閉（導通）は確認されていない。**`J3`をはんだ付けしていない場合は、この手順では
   扱わない**（`ACCEL-01`／`ENV-01`単体bring-upの手順も、`J3`がはんだ付け済みの前提で始める。この手順は、`EXP-015`が記録する
   両device IDの読み出し成功（`accel_device_id raw=0xe5`、`env_chip_id raw=0x60`。一致・不一致の
   判定はEXP-015自身も行っていない）からの追加接続であり、この配線を変えていない。**`EXP-015`の
   値は別セッション（実機Linux）が実施した結果の報告であり、この手順を書いているセッションが
   直接読み取ったものではない。**それでも、`J3`のはんだ付け申告単独より、応答が実際にあった
   という記録の方が強い根拠である）。

   **失敗時の扱い。**(a)〜(d)は独立ではない。**firmwareのcode（`main.rs`の`run_display_bringup`と、#487からは`display_test.rs`の`DisplayBringup::poll`）は、
   (a)（`display_madctl`）の段階で`display_driver_new_failed`または`display_init_failed`が出た場合、
   その場で関数を`return`し、(b)（`display_fill`）・(c)（`display_corner_pattern`）は一切
   実行されない。**この場合、(b)(c)のlogが無いのは異常ではなく(a)の失敗の帰結であるため、
   (b)(c)を個別の停止条件として扱わない。**(a)が成功した場合（`display_madctl`が出た場合）、`display_backlight_on_failed`が
   出ても(b)(c)は続けて実行される。(b)は色ごとに独立しており、ある色の`display_fill_failed`が
   他の色の実行を止めない。(c)は`display_corner_background_failed`が出た場合その場で`return`し
   四隅の描画自体を行わないが、四隅のうち1つの`display_corner_failed`は他の隅の描画を止めない。
   (d)（`accel_device_id`・`env_chip_id`）は(a)(b)(c)から独立している。**ただし(d)自身の内部は
   完全に独立ではない。**`run_i2c_bringup`は`I2cDriver::new`が失敗すると`i2c_driver_new_failed`
   を出してその場で`return`し、`accel_device_id`・`env_chip_id`のどちらのlogも一切出ない。
   `I2cDriver::new`が成功した後は、`main.rs`の`run_i2c_bringup`の実装（`accel`読み出しと`env`
   読み出しが独立したmatch文であり、`accel`側の`Err`がreturnを伴わないこと）が示すとおり、
   `accel_device_id`の失敗が`env_chip_id`の読み出しを止めない（両方とも有限timeoutを持つ）。

   **したがって、失敗logが出た項目は未達として記録し、それが原因で実行されなかった後続項目
   （(a)の失敗による(b)(c)の不在、(c)の背景描画失敗による四隅描画の不在、`i2c_driver_new_failed`
   による`accel_device_id`・`env_chip_id`双方の不在）は同じ理由によるものとして記録し、個別の
   停止条件としては扱わない。**それ以外の理由でlogが欠ける場合（下記）は停止条件として扱う。

   - (a)自体（成功・失敗いずれのlogも）が待機時間内に一切出ない場合
   - (a)は出た（成功または失敗）にもかかわらず、`i2c_driver_new_failed`も含め
     `accel_device_id`・`env_chip_id`関連のlogが待機時間内に一切出ない場合
   - `accel_device_id`関連のlog（成功または`accel_device_id_read_failed`）は出たにもかかわらず、
     `env_chip_id`関連のlog（成功または`env_chip_id_read_failed`）だけが待機時間内に一切出ない場合
     （`accel`読み出しと`env`読み出しは独立したmatch文であり、`accel`側が終われば`env`側は
     必ず有限timeout内に何らかのlogを出す設計である。出ないのは異常である）

   これらは`ACCEL-01`／`ENV-01`単体bring-upの手順の手順10(b)(c)と同じ考え方（firmwareが実際に
   停止している可能性を、bring-up未実施の予期された結果と誤認しない）に基づく扱いであり、
   手順8の停止条件として給電を止める。今回の配線変更（`DISP-01`追加）が原因である可能性を
   優先して調べる。

   **(a)〜(d)について、実行されるべきものがすべて出そろったら（成功・失敗いずれの結果で
   あっても）、給電を止める。**継続して観察する必要が無い限り、通電を漫然と続けない。
   **ただし、条件6を確かめる回は、`display_pattern_hold`の行より後の`health`の行が1行出るまで
   給電を続ける。**その間も手順8の停止条件は効く。出なければ、描画の最後の区間の値は得られて
   いないと手順11に記録する。
10. [人間] 給電を止めた後、`VCC`–`GND`間抵抗を再測定する。測定点は手順2の項目1（`DISP-01`の
    `VCC`／`GND`。ESP32・`ACCEL-01`・`ENV-01`と共通のrailを含む）と同一とし、手順2で得た
    通電前の読みと比較する。通電後に「低いまま動かない」への変化を認めた場合は、短絡が
    新たに生じた可能性として再開しない。
11. [AI] 結果（成功・停止のいずれも）を[experiment-log.md](experiment-log.md)へ`EXP-0xx`として
    記録する。**`main.rs`のmodule docが明記するとおり、記録は[Hardware Safety Policy](../governance/hardware-safety-policy.md)
    「10. ベンチ試験記録」の形式（Test ID／Date／Operator／Hardware revision／Exact components／
    Wiring revision／Power supply and current limit／Firmware commit/profile／Configuration／
    Measurement equipment／Procedure／Expected result／Measured result／Faults／Conclusion／
    Next safe step）に従う。**受け入れ条件6件（[Issue #13](https://github.com/wachi-yoshitaka-11-dev/deskcat/issues/13)）
    のうち何が確認でき、何が未達のまま残るかを明記する。**「更新中も通信とwatchdogがactiveである」
    （条件6）は、Piを条件(3)(a)に従ってつなぎ、#487のB2（Pi→ESP32の`hello`／`ping`／`get_status`を受信の
    経路へつなぐ変更）がmergeされたbuildを使う回で確かめる。Piをつながない回では条件6を示せない。
    条件6を確かめる回では、次を記録する。`health`の行の`max_read_gap_ms`と`overrun_ticks`、
    `heartbeat_overrun`の行の有無、描画の間に`task_wdt`のerrorのlogが出たかどうか、Pi側のhostのlog
    （描画の間に送ったrequestと、返ったACKの対応）、`rx_buffer_full`と`rx_fifo_overflow`。task watchdogが
    有効であることは、書き込むdebug profileのbuildで生成されたsdkconfigの`CONFIG_ESP_TASK_WDT_EN`・
    `CONFIG_ESP_TASK_WDT_INIT`で確かめる。`CONFIG_ESP_TASK_WDT_PANIC`の設定も記録する。次は根拠にしない。保持の間に出た
    `hb`の行。`reset_reason`と`rst:`の行。ESP32の側のUARTの誤りのcounterと`ProtocolCounters`。

##### `DISP-01`追加接続のbring-upの手順：条件の根拠

**条件(1)の根拠。**[gpio-assignment.md](gpio-assignment.md)の項目2（一覧との目視照合）・項目3
（逆極性・電圧違いpinの確認）が求める確認内容は給電元によらず成立し、そのまま適用する。項目4
（給電経路の重複確認）はB-2b経由の接続を前提に元々書かれていたが、[gpio-assignment.md](gpio-assignment.md)
Revision 39で、給電元（B-2bか`3V3` pinか）ごとに参照先の節が変わる形へ更新済みである。この手順
（`3V3` pin経路）を実施する際は、項目4が定める判定基準「単一経路であること」（`3V3` pinの1系統
だけから受電し、USBの5V・外部3.3V電源等が同時に到達しないこと）を適用する。

**条件(2)の根拠。**`main.rs`の`run_display_bringup`は製品buildと`bringup-display-13`か`face-21`の試験buildが
持つ関数である。ただしfill・四隅・timingの試験を行うのは`bringup-display-13`付きbuildだけである。受け入れ条件のうち初期化の記録は
この関数のlogから、fill・四隅・timingの記録は`crate::display_test`（`firmware/esp32/src/display_test.rs`）のlogから得る。controllerの識別は、moduleのsilkと資料、およびこの関数が
送るcommandの実機での効果から記録する（logだけの証拠にはしない）。

**条件(3)の根拠。**[HW-TBD-024の判断記録](tbd-register-history.md#hw-tbd-024)の2026-09-23追記が持つ
電流上界の計算（通常動作約245.4 mA、`R5`先短絡の故障時約646.5 mA）は、`ACCEL-01`／`ENV-01`が
既に`3V3` pinへ接続されている状態（`#445`、`EXP-015`）へ`DISP-01`を足した合計として組まれている。
**この手順はその前提（条件(3)(a)〜(d)、ESP32＋`ACCEL-01`＋`ENV-01`＋`DISP-01`の負荷合計という
計算上の前提。段階B-2の定常電流「測定」とは別物）を満たす場合にだけ、この計算をそのまま使える。**
値の再掲はしない。

**条件(4)の根拠。**`ACCEL-01`／`ENV-01`単体bring-upの手順の条件(4)は「`DISP-01`未接続」を
求めるが、それは同節固有の電流余裕計算（約101.5 mA、`DISP-01`分を含まない）がDISP-01の追加で
成立しなくなるためである（同節`条件(4)の根拠`）。この手順は逆に`DISP-01`の接続を前提とし、
条件(3)の計算（ESP32＋`ACCEL-01`＋`ENV-01`＋`DISP-01`の負荷合計）を使うことでその前提を
成立させる。

**条件(5)の根拠。**`ACCEL-01`／`ENV-01`単体bring-upの手順の条件(5)と同じ根拠（同節
`条件(5)の根拠`）であり、[EXP-015](experiment-log.md#exp-015-accel-01adxl345env-01bme280のesp323v3-pin給電による初回通電とdevice-id読み出し)は
この条件が未達（`module電源pinの独立性`が測定として成立しない配線だった）のまま、人間の現場判断で
通電された記録を持つ。**この手順もその状態を引き継ぐ可能性がある。**同じ現場判断を今回も行うか、
先に条件を満たすかは人間が判断する（条件(7)）。

**条件(6)の根拠。**[HW-TBD-024の判断記録](tbd-register-history.md#hw-tbd-024)の2026-09-23追記が明記する
とおり、`#461`の承認は接続を許可するだけであり、「MSP2807が耐えられる電流の上限」自体
（`HW-TBD-024`が問う値）にも、`HW-TBD-025`(b)（現物回路の確認）にも答えていない。この手順は
その残余riskをユーザーが受け入れた範囲の中で実施する。

**条件(7)の根拠。**`main.rs`のmodule docが明記するとおり、`#461`は`DISP-01`の`3V3` pinへの
接続そのものを許可するだけであり、`run_display_bringup`（GPIO4によるbacklight点灯を含む）を
`3V3` pin経路で実行してよいかは決めていない。**この承認は`#461`の残余risk受け入れを再審議する
ものではない。**`#461`が既に受け入れた残余risk（未知の経路の可能性、故障時の熱余裕の薄さ、`R5`の
公差不明）は変わらない。ここで人間から個別に得るのは、firmwareの実行経路を1つ実行してよいかと
いう別の判断であり、条件(1)〜(4)(6)（および条件(5)の例外規定に従った状態）を満たしたうえで問う。

**`face-21` feature（[#21](https://github.com/wachi-yoshitaka-11-dev/deskcat/issues/21)）の常時点灯。**
条件(3)の計算は、`HW-TBD-024`の判断記録の2026-09-23追記が「通常動作（定常）」として出した値（約245.4 mA、
熱の見積もりも定常状態）であり、点灯の時間では限っていない。そのため、backlightを点けたまま動かす
`face-21`の通常動作は、この計算に含まれる。ただし、この計算は周囲40 ℃（`Rθja` 88 ℃/W）を仮定する。
筐体に入れた状態は、この計算に含まれない。故障時（`R5`の先の短絡）の電流上界は、`R5`の値とrail電圧だけで
決まり、点灯の長さを入力に使っていない（`DISP-01`追加接続のbring-upの手順の前提の節）。
`face-21`付きbuildの実行は、実行する日に、条件(7)と同じ形（`3V3` pin経路でbacklightを点けたまま
動かすことの承認）で人間から1件得る。**`DISP-01`追加接続の手順の条件(2)は`bringup-display-13`付きbuildを要求する。**そのため、`face-21`単独と`tap-21`単独は、この手順でも通電してよいbuildではない。featureなしの製品buildの通電は、次の節が`TBD`として持つ（各構成にこの条件を当てた結果は、`firmware/esp32/README.md`の「build構成と通電」の表）。`tap-21`は`ACCEL-01`を測定modeにする。その約140 µA typ（`sensor-datasheet-notes.md`の`Supply Current`行、Rev. G、ODR 100 Hz以上）は、条件(3)の計算（約245.4 mA）が内訳として持つ101.54 mA（内訳は本書の「この2点限定の給電」の行）に既に含まれる。`tap-21`が足す負荷は、この計算の外には無い見込みである。

##### 製品build（featureなし）の通電の条件

[#487](https://github.com/wachi-yoshitaka-11-dev/deskcat/issues/487)の範囲である。**この節は、featureなしの製品buildを`3V3` pin給電で通電してよいと書かない（`TBD`）。**

**`DISP-01`追加接続の手順の条件(2)は、この`TBD`の理由ではない。**条件(2)の本文が挙げる理由は、`#13`のbring-upの受け入れ条件（初期化・fill・四隅・timing）を確かめる材料であり、電流や熱の条件ではない。製品buildは、その試験を行わない。

**不可の理由。**製品buildは`TOUCH-CS`（GPIO21）で`XPT2046`を読む（`firmware/esp32/README.md`の「build構成と通電」の表）。`XPT2046`が`touch panel`へ流す駆動電流は、`touch`の5本を挿しても挿さなくても上界が無い。挿す構成は、`TOUCH-CS`がlowの割合に上界が無い（読みの間隔は`firmware/esp32/src/touch.rs`の`POLL_INTERVAL_MS`以上だが、lowの間に割り込みや他のtaskが入る時間の上限は、コードからは出せない）。挿さない構成は、module側の`T_CS`・`T_CLK`・`T_DIN`が浮き、`module`のpull-upは`TBD`である（[sensor-datasheet-notes.md](sensor-datasheet-notes.md)の`Module pull-up`行）。資料の駆動電流の上限（50 mA。同`電源電流`行）を平均として置くと、温度の増分は約7.5 ℃（約149.6 ℃/A。[HW-TBD-024の判断記録](tbd-register-history.md#hw-tbd-024)の熱の計算の式）で、LEDを足した故障時の余裕（`TSD`まで約5.2 ℃、[回路案](led-514-demo.md)の`3V3 pinへ負荷を足す条件`）を超える。実際の平均は、割合と`touch panel`の層の抵抗（資料にも本repositoryにも無い）で決まり、どちらも分からない。

**要る根拠。**`touch panel`の駆動電流の上界、または同等の実測。測定手段を使うなら、その仕様を先に確定する（`MEAS-05`の値は[hardware-bom.md](hardware-bom.md)が確定値として使わないと定めている）。これまでの窓（`EXP-038`・`EXP-041`・`EXP-044`）は、記録として指すだけで、この節の根拠にしない。

##### touchを読まない製品build（`no-touch-487`）の通電の条件

[#487](https://github.com/wachi-yoshitaka-11-dev/deskcat/issues/487)の範囲である。feature `no-touch-487`を単独で付けた製品build（`firmware/esp32/README.md`の「build構成と通電」の表）は、`3V3` pin給電で通電してよい。実行する日に、条件(7)と同じ形で人間から1件承認を得る。実機ではまだ動かしていない。

- **`XPT2046`とLEDの扱いは、通電してよいとしている`face-21,bringup-display-13`と同じである。**`TOUCH-CS`（GPIO21）は、`firmware/esp32/src/main.rs`の`run_display_bringup`が`touch::IdleTouch::with_shared_bus`で出力Highにして保つ（`firmware/esp32/src/touch.rs`の`PinDriver::output`と`set_high`。以後main loopが終わらないかぎり保持する）。この呼び出しは`face-21,bringup-display-13`の構成と同じ行で、`IdleTouch`は転送せず、`XPT2046`へ命令を送らない。LEDは、`mod led`と`Leds::new`が`bringup-led-514`か`deskcat_product_led`（`firmware/esp32/build.rs`。`no-touch-487`では出さない）のときだけ有効であり、この構成は`crate::led`を作らず、GPIO2・GPIO5に触れない。前提は、その構成と同じ配線である（`GPIO21`の外部10 kΩのpull-upと、`T_CS`が挿さっているか否か）。この節は、`XPT2046`の電流の値を新たに主張しない。
- **ADXL345とBME280への書き込み。**安全要件の5項目に効かない（書き込みはregisterの設定であり、外れても測れないか誤検出になる）。電流は、条件(3)の計算の内訳（101.54 mA。本書の「この2点限定の給電」の行）に`ACCEL-01`と`ENV-01`が入っている。`firmware/esp32/README.md`の`env-sample-16`の行にある「新しい書き込みを含む構成の通電手順と承認は未確定」は、その試験buildの行の注記であり、この構成には当てない。
- **`DISP-01`追加接続の手順のうち、この構成に当てるのは、条件(1)・(3)〜(7)、手順1〜4・手順6、書き込むimageをこの構成のbuildに置き換えた手順7、手順8のうち異音・発熱・火花・変色・異臭・電圧降下による停止、手順10、手順11の記録の形式だけである。**条件(2)は、電流や熱の条件ではない（直前の`製品build（featureなし）の通電の条件`の節）。

##### 3.3 V railの許容電圧範囲

**この節は上の`許容電圧範囲`行の導出である。値の正はその行であり、この節ではない。**
他の文書はその行を参照し、値を書き写さない。**見出し階層上は直前の`ACCEL-01`／`ENV-01`単体
bring-upの手順・条件と手順の根拠の小節のように見えるが、この節が導出する`許容電圧範囲`行は
`段階B-2の測定`節の共通条件表にあり、その節の続きである。**（`DISP-01`初回通電の手順を
挟んだことで生じた見出し階層のずれは`#447`由来であり、本節の追加でさらに1段離れた。**見出し
levelの再構成はこの差分の範囲外とする。**）

積集合を取る対象は各moduleが**moduleとして受け入れてよい電圧**である。**IC単体の動作範囲を
代入しない**（board上のregulatorやlevel shiftの有無で変わるため）。

| module | moduleとして受け入れてよい電圧 | 出典 | 積集合に使えるか |
|---|---|---|---|
| `DISP-01`（MSP2807） | VCC **3.3–5 V**。logic IOは3.3 V TTL | [msp2807.pdf](https://akizukidenshi.com/goodsaffix/msp2807.pdf)の`Product Parameters`（`VCC power voltage`／`Logic IO port voltage`）。**module levelの資料である** | **使える** |
| `ENV-01`（AE-BME280） | VDD **1.71–3.6 V**。module上でVDDとVDDIOは結線済みのため実効も同じ | [AE-BME280説明書](https://akizukidenshi.com/goodsaffix/AE-BME280_manu_v1.1.pdf) v1.1の`主な仕様`（電源電圧DC1.71V〜3.6V）。**module levelの資料である** | **使える** |
| `ACCEL-01`（秋月 M-06724） | **IC自体の動作範囲と同一（`VS` 2.0–3.6 V）と2026-09-18に判定した**（module boardの資料は無いが、ユーザーへの確認結果から regulator等の能動部品が存在しないと判断した（推論であり、ユーザーの発言そのものではない）。この判定は対GNDの絶対値として見た場合であり、正しく製造された個体を前提とする。この前提（製造欠陥前提の故障モードを範囲外とする）は`#0PM`の判定である。**2026-09-21、この前提について人間の承認を得た**（PMが判定を提示し、ユーザーが承認した。2026-09-21より前は「人間の最終承認が未了である。承認されなければこの行も未解決へ戻る」としていた）（[tbd-register.md](tbd-register.md)の`HW-TBD-004`）。2026-09-18より前は「TBDのまま」としていた。詳細は[HW-TBD-004](tbd-register.md)） | ユーザーへの確認（口頭申告）と[tbd-register.md](tbd-register.md)の`HW-TBD-004` | **使える（2026-09-21、人間の承認を得た）**（2026-09-18から。正しく製造された個体を前提とする判定である。**それ以前は「一般には使えない」としていた。2026-09-21より前は「人間の最終承認が未了。承認されるまでの暫定」としていた**） |

**2026-09-06に確定した`3.3 V rail下限の設計判断`のrail値（3.234–3.366 V）に対しては、`ACCEL-01`について暫定の根拠に基づく設計判断を置く。**根拠はICの`VS`動作範囲2.0–3.6 V（typ 2.5 V。sensor-datasheet-notes.mdの`供給電圧（動作範囲）`行に既に記録済みのため値を再掲しない）とADXL345のsupply current **140 µA（ODR ≥ 100 Hz、typ値）**である。3.234–3.366 Vは`VS` 2.0–3.6 Vの内側に両端とも余裕を持って入る（下側余裕約1.234 V、上側余裕約0.234 V）。headerとIC足の間の直列抵抗は現物未確認のままだが、下側余裕を使い切る抵抗値は`1.234 V ÷ 140 µA ≈ 8.8 kΩ`である。

**この140 µAはtyp値であり、worst-caseの境界ではない。**sensor-datasheet-notes.mdが記録するとおり、ADXL345のdatasheet（Rev. G）には`Supply Current`のmax欄が無く、絶対最大定格にも電流の上限は記載が無い（`HW-TBD-025`(b)が既にこの事実を確認している）。**したがって`8.8 kΩとの3桁差`は、確認された最大電流に対する余裕ではなく、typ値に対する余裕にすぎない。**実際の消費電流がtypを上回った場合、この余裕は縮む。**worst-caseの境界を得る手段は、ADXL345のdatasheetからは得られない。**headerからIC電源pinまでの実際の直列抵抗をパターン追跡で確認するか、実測（電流・電圧の実測）によるしかない。

**`HW-TBD-025`(a)は、このrail値についてはこの暫定の根拠に基づく設計判断として確定する。**`hardware-safety-policy.md`の「供給電圧の動作の下限」に当たり安全要件5項目に該当しないため、**一般値で開始してよい分類に基づく暫定の設計判断として運用してよい。**同policyが求める記録（採った値・それが暫定であること・確定させる手段）は次のとおりである。値はtyp 140 µAに基づく評価（8.8 kΩとの3桁差）、暫定であることは上記のとおりworst-caseの保証ではないこと、確定させる手段はheaderからIC電源pinまでの直列抵抗のパターン追跡または実測である。**この暫定判断を「未解決」へ戻さない。**より強い根拠（worst-case電流での再評価、または直列抵抗の実測）が得られた場合に限り、この判断を更新する。**これは`HW-TBD-025`(a)（このrail値に対する扱い）の判断であり、`HW-TBD-004`（module一般としての受け入れ電圧範囲の確定。I2Cアドレス等も含む）をcloseするものではない。**

**この段落は、この節の冒頭が禁じている「IC単体の動作範囲を代入する」ことをしているように読める。していない理由をここに書く。**
冒頭の規則が代入を禁じる理由として挙げているのは**board上のregulatorとlevel shiftの有無**である。
この2つがあると、headerへ入れた電圧とICが受ける電圧が別物になるためである。
**`ACCEL-01`については、そのうちregulatorの有無が現物確認で解決している。**
2026-08-13の現物確認で**regulatorは非搭載**（IC＋`C1`×2＋抵抗のみで、3端子部品が無い）と確定した
（正は[tbd-register.md](tbd-register.md)の`HW-TBD-004`。**ここへ再掲しない**）。
**能動的なlevel shiftについては断定しない**（[tbd-register.md](tbd-register.md)の`HW-TBD-004`が
「直列抵抗やlevel shiftの有無をパターンで追っていないため断定しない」と明記しており、ここでも
新しい証拠なくそれを覆さない）。**ただし断定する必要もない。**この段落が示すのは、**受動的な
電圧降下（現物確認で排除できない経路）について、typ値140 µAに基づく評価では下側余裕約1.234 Vが
覆うという暫定の見積りである**。**能動的なlevel shiftの有無そのものは、この段落では閉じない。**引き続き
`HW-TBD-004`の範囲であり、`HW-TBD-004`はcloseしていない。

**2026-09-18訂正。**上の`3.3 V railの許容電圧範囲`表の`ACCEL-01`行は、現在の状態を述べる行（この値の正）であるため直接更新した（旧文「module一般としての受け入れ電圧範囲はTBDのまま」「一般には使えない」は、行内に過去の判断の経緯として残した。書き換えたのではなく、現在の状態を最新化した）。一方、上記2段落の「能動的なlevel shiftについては断定しない」「引き続き`HW-TBD-004`の範囲であり、`HW-TBD-004`はcloseしていない」は、この日付時点の判断の経緯を述べており書き換えない。**前提が変わった経緯は次のとおりである。**ユーザーへ確認したところ回答を得た（質問と確認した部品の内訳（回答の原文は省略した）は[tbd-register.md](tbd-register.md)の`HW-TBD-004`を参照し、**ここへ再掲しない**）。**同行が示すとおり（推論であり、ユーザーの発言そのものではない）、この回答は作業セッションが提示した一覧（5行・合計10個。IC・`C1`×2・`R1`×4・`R2`×1・裏面の半田ジャンパ×2）に対するものであり、この一覧の呼称を提示時に「6種8個」と誤っていたことも同行が記録している。**このうち裏面の半田ジャンパ2箇所は未橋絡のpadであり、部品として数えるかどうかに関わらず電流経路には無い（判定と根拠は[tbd-register.md](tbd-register.md)の`HW-TBD-004`。**ここへ再掲しない**）。したがって、`Vs`／`VDD`の経路に、この一覧以外の未知の部品（能動的なlevel shift段、未知の追加抵抗）が入る余地は無いと判断できる。このうちpull-up4個は`ACCEL-SDA`／`ACCEL-SCL`用と特定済みで電源経路ではなく、`0`Ωジャンパは電源経路上にあっても電圧降下を生まない。**確定したのはここまでである。**headerの共通net（`Vs`／`VDD`）からICの`VS`／`VDD I/O`各pinまでの経路（直結か、`0`Ωを経由するか、断線しているか）は、IC足が小さくパターンを追えていないため未確定のまま残る（[tbd-register.md](tbd-register.md)の`HW-TBD-004`）。**ただしこの未確定は電圧の判定に効かない。**受動素子は電圧を上げず、能動部品が存在しないことは確定しているため、ICが受け取る電圧はheaderに入れた電圧を超えない。経路が断線していれば起きるのはmoduleが動作しないことであり、過電圧ではない。**したがって`ACCEL-01`分は満たされたと判定する**（`#433`がBME280について行った判定と同じ形。**MSP2807分（`HW-TBD-024`）は残る**）。**あわせて「headerからICへの経路のうち片方だけ断線した場合」を検討した。**この判定（IC自体の動作範囲を超えない）は各pinを対GNDの絶対値として見た場合であり、正しく製造された個体を前提とする。`VDD I/O`のトレースだけが断線した場合に`Digital Pins`の相対定格（`VDD I/O`基準）へ触れうる懸念は把握したが、これは購入品の製造欠陥を前提とする故障モードであり範囲外とした（BME280（`#16`）も同じ理由で対象外。詳細は[tbd-register.md](tbd-register.md)の`HW-TBD-004`を参照し、ここへ再掲しない）。`moduleへ入れてよい電圧`はIC自体の動作範囲（`VS` 2.0–3.6 V。Analog Devices Rev. G）と同一とする。**`HW-TBD-004`自体は実装済みI2Cアドレスの残件があり、closeしていない。**

**したがってheaderの電圧は、regulatorを経ない限りICへそのまま、または受動部品を経て届く。**
下側余裕は約1.234 Vであり、**typ値140 µAに基づけば、介在する受動部品が合計でこれを超えて
電圧を落とす場合に限り結論が変わる**（直列抵抗については`8.8 kΩ`との3桁差）。**ただしこの140 µAは
worst-caseの値ではないため、実際の消費電流がtypを上回れば、この見積りは前倒しで崩れうる。**
**これは規則の例外であって、規則の適用の省略ではない。**例外が成り立つのは
`ACCEL-01`について**regulator非搭載が現物で確定しているから**であり、
**この根拠を持たないmoduleへ同じ扱いを広げない。**`ACCEL-01`についても、この見積りは
**worst-caseを示す確定判断ではなく、暫定の根拠に基づく設計判断のままである。**

**この積集合はservoを含まない。**`SERVO-01`は3.3 V railではなく5 Vのservo railから給電するため、
この表の対象外である。**ただし対象外であることは、確認しなくてよいことを意味しない。**
`PSU-SERVO-01`が供給する5 Vをservoへ入れてよいかは、
**[tbd-register.md](tbd-register.md)の`HW-TBD-035`が追跡する**（2026-08-24に登録）。
**この節でservoの入力電圧を判定しない。値も条件もここへ再掲しない。**

**ESP32側も積集合の一員である。**この3.3 V railはESP-WROOM-32D module自身の`VDD33`でもあるため、
moduleの推奨動作条件はperipheral 3点と同じ資格で積集合へ入る。**2026-08-12時点ではたまたま
bindingになっていないだけであり、「ESP32は積集合に関与しない」とは書かない**（`ACCEL-01`分が
入って下限が動けば、上限側は依然としてESP32 moduleが決める）。

| 対象 | 積集合へ入れる値 | 出典 |
|---|---|---|
| ESP-WROOM-32D module（`VDD33`） | **3.0–3.6 V**（推奨動作条件） | 下記のとおり |

- **module自身の電源**: 推奨動作条件は
  **3.0／3.3／3.6 V**（min／typ／max）、絶対最大定格は**−0.3〜3.6 V**である
  （[ESP32-WROOM-32D & ESP32-WROOM-32U Datasheet](https://documentation.espressif.com/esp32-wroom-32d_esp32-wroom-32u_datasheet_en.pdf) v2.7、Table 14／Table 13、page 26。
  **推奨動作条件と絶対最大定格は別物であり、下限の判定に使うのは推奨動作条件の3.0 Vである**）
- **logic level**: [`電圧domain`節](gpio-assignment.md#電圧domainすべての外部pull-upに適用)のとおり、
  この設計に5 V logicは存在しない

したがって2026-08-12時点で置けるのは`DISP-01` ∩ `ENV-01` ∩ ESP-WROOM-32D moduleの積集合であり、
**その値を上の`許容電圧範囲`行へ暫定値として置いた。****確定値ではない。**
`ACCEL-01`分の一般的な受け入れ電圧範囲が入ると下限が上がりうるため、確定形で書かない。**2026-09-06に、この積集合から出た具体的なrail値（3.234–3.366 V）について`ACCEL-01`の暫定の根拠に基づく設計判断を置いた**（上表`ACCEL-01`行の注記。**typ値に基づく評価であり、worst-caseの境界ではない**）。**このrail値に関する限り、`HW-TBD-025`(a)の`ACCEL-01`側はこの暫定判断で確定している。**より強い根拠（worst-case電流での再評価、または直列抵抗の実測）が得られるまで、この判断を「未解決」へ戻さない。

###### 暫定値の下限は、そのままでは成立しない

**下限3.3 Vはrailの公称値と同一であり、下振れの余裕が原理的に無い。**加えて`U2`側の値が
すでにこれを下回る。

| 事実 | 値 | 出典 | 根拠の種類 |
|---|---|---|---|
| 暫定の積集合の下限 | 3.3 V | 上表（`DISP-01`のVCC下限） | **module levelの一次資料** |
| 現物の`U2 = UMW LD1117-3.3`の出力電圧 | **3.234–3.366 V**（typ 3.300 V、`IOUT = 10 mA`、`VIN = 5 V`、`TJ = 25 ℃`。固定版の出力精度は2%） | [UMW LD1117 datasheet](https://www.umw-ic.com/static/pdf/a5e0c99cefdefaf03cfa7777b369e45b.pdf) Mar.2025の`9.Electrical Characteristics`、`Output Voltage`行（`LD1117-3.3`） | **現物の一次資料**（`HW-TBD-023`。2026-08-15に刻印`LD1117AG` / `33AQVCUV`とdatasheetのSOT-223 templateの一致でメーカーを特定した） |

**2026-08-15に、この行の根拠が参照設計から現物へ移った。**それ以前は参照設計の`AMS1117-3.3`の値
（狭い方3.251–3.349 V、広い方3.201–3.399 V）を暫定値として置いていたが、**現物の`U2`は`AMS1117-3.3`ではない。**
**結論は変わらない。**現物の下限3.234 Vも3.3 Vを下回るためである。

**この2つを並べると、`3V3` pinの出力は規定どおりでも下限3.3 Vを割りうる。**したがって
**B-2aは、暫定値のままでは`許容電圧範囲`条件を満たせる保証が無い。****これは現物のdatasheetで確定した事実であり、
もはや「メーカーが判明すれば変わりうる」という留保は付かない。**

**B-2bも進まないが、理由は違う。**外部電源なら設定点を上げられるため、regulatorのtoleranceは
関係しない。**それでも進まないのは、許容電圧範囲が経路によらない共通条件であり、その範囲自体が
まだ確定していないからである。**確定していない範囲に対して「範囲内である」ことは確認できない。

よって**この下限が成立する形になるまで、B-2はどちらの経路でも実施しない。**

**この矛盾を数値の丸めや「3.3 Vは公称値だろう」という解釈で埋めない**（[AGENTS.md](../../AGENTS.md) 推測禁止）。
`msp2807.pdf`はVCCについて`3.3V~5V`の一行しか持たず、toleranceも絶対最大定格も示さない。
**下限が公称値なのか絶対最小値なのかは、この資料からは決まらない。**

解決経路は3つあり、いずれも人間の判断か現物確認を要する。**別の台帳行は立てない。**
これは`許容電圧範囲`そのものの中身であるため、[HW-TBD-025](tbd-register.md)(a)で追跡する。

| 経路 | 状況 |
|---|---|
| (1) MSP2807のmodule level資料に下限の性質（公称か絶対最小か）を求める | **不可。**2026-08-12に確認した。`msp2807.pdf`に該当する記載が無い |
| (2) MSP2807のVCCを5 V railへ移す（module specは3.3–5 Vを許す） | **引き続きBlocked。**`HW-TBD-002`は2026-09-06にcloseしたが、close内容はpin配列・電源pin照合（`VCC`→`U1`入力側、`GND`→`U1`のGND側）・decoupling実装の3点のみであり、この経路が要求する「logic IOのlevel shiftの有無」（`VCC`を5 Vへ上げたときILI9341の出力が5 Vになりうるか）は確認項目に含まれていない。`sensor-datasheet-notes.md`のLogic電圧欄も「5 V給電時の出力levelがメーカー資料で不明なため3.3 V給電とする」のまま、close後も未更新である。**したがってこの経路は、この2点と、回路図が現物と同じ版かどうかが解けるまで採らない。****2026-10-27更新：#405の見直しで、最終の機体の第一候補として検討する。採るかどうかの決定は#405が持つ**（`MSP2807の電流上限の扱いと、段階Cの測定4（2026-10-27、#556）`） |
| (3) 周辺module用に別途3.3 V regulatorを置き、設定点とtoleranceで下限を成立させる | **採らない。**下の`3.3 V rail下限の設計判断`のとおり、部品追加なしで下限を成立させる経路(4)を採ったため不要になった |

###### 3.3 V rail下限の設計判断（2026-09-06）

**採る経路: (1)〜(3)のいずれでもない第4の経路。**暫定下限3.3 V（`DISP-01`のVCC下限、一次資料の範囲の下端）を**下回って運用することを受け入れる**形で下限を確定する。3.3 Vが「公称値」だったという読み替えではない。一次資料（`hardware-bom.md`／`sensor-datasheet-notes.md`）が示す`VCC 3.3–5 V`はそのまま範囲であり、3.3 Vはその最小値である。

**下限値: 3.234 V**（`U2 = UMW LD1117-3.3`のdatasheet値。上表`現物のU2=UMW LD1117-3.3の出力電圧`の値、**直接のdatasheet値**）。`ACCEL-01`のmodule許容電圧（`HW-TBD-004`）が確定し、その下限がこの値を上回る場合は置き換える。

**この3.234 Vを「無条件の保証最小出力」として扱わない。**datasheetがこの値に付けている条件は
**`IOUT = 10 mA`、`VIN = 5 V`、`TJ = 25 ℃`**である（上表に記載のとおり）。
**実際の負荷電流、実際の接合温度、実際の入力電圧におけるworst-caseの下限は、この値では示されていない。**
したがってこの下限は、**その条件下のdatasheet値を採る**という設計判断であって、
あらゆる動作条件で3.234 Vを下回らないという主張ではない。

**それでもこの値で下限を確定する理由**（分類は下記`分類と根拠水準`のとおり）。
この項目は`hardware-safety-policy.md`の「供給電圧の動作の下限」であり、**安全要件5項目に該当しない。**
同policyは、該当しない項目を**一般値で開始してよい**と定め、
**採った値・それが暫定であること・確定させる手段を記録すること**を求めている。この段落がその記録である。

**確定させる手段。**`U2`出力の実測である。`#13`（LCD bring-up）で`DISP-01`の`VCC` rail電圧と
`U1`出力電圧を先に実測すると下の`#13`への記録節が定めており、**その実測が実負荷・実温度での値を与える。**
接合温度の前提（`TJ = 25 ℃`）については周囲温度`T`が`MEAS-04`の実測量である。
**実測が3.234 Vを下回った場合は、この下限値を実測側へ置き換える。**

**上限値3.366 Vも同じ条件（`IOUT = 10 mA`、`VIN = 5 V`、`TJ = 25 ℃`）下のdatasheet値であり、
無条件の値として扱わない。**実測の入力・負荷・温度が異なれば上限側も変わりうる。**確定させる
手段は下限と同じ実測（`#13`での`VCC` rail電圧・`U1`出力電圧の実測、周囲温度`T`は`MEAS-04`）である。
**実測が3.366 Vを上回った場合は、この上限値も実測側へ置き換える。**

**この値で判定してよい範囲。**`DISP-01`のmodule仕様（`VCC` 3.3–5 V）の下端を下回っているため、
**「moduleが機能的に正常動作する」ことをこの下限が保証するとは主張しない。**
表示不良に遭遇した場合の扱いは下の`#13`への記録節にある。
**保証しないと言えるのは機能であって、部品が壊れないことは`分類と根拠水準`のとおり別に押さえてある。**

**分類と根拠水準**（[hardware-safety-policy.md](../governance/hardware-safety-policy.md)の対応表）: この下限は「供給電圧の動作の下限」に当たり、安全要件5項目のいずれにも該当しない。下回っても絶対最大定格を超えず、部品は壊れない（起動しないかhangするか、書き込み中の記録が壊れうるだけ）。「ロジック電圧の下限は一次資料側に置く」という同policyの例外は、異なる電圧domain間のlevel mismatch（貫通電流のリスク）を指す。本rail上の`DISP-01`／`ENV-01`／ESP32は同一railを共有しており、rail全体が一様に振れても跨domainの閾値ずれは生じないため、この例外には当たらない。**先例: `HW-TBD-028`(a)**（Pi入力の最低許容電圧）。同policyはこの項目を、一次資料が存在せず確定のためだけに機材購入が必要になる同じ構造の例として挙げ、「一般値で開始してよい」分類に位置づけている（同policy「5項目以外の扱い」節）。**ここで先例として指すのは分類の適用であり、`HW-TBD-028`(a)自体の値がtbd-register.mdで確定した、という意味ではない**（同行は本稿執筆時点でも数値未確定のまま残っている）。

**`DISP-01`内部のLDO(`U1`)を通した場合の追加の裏付け。**`DISP-01`のboard上には`U1`（UMW `XC6206P332MR`、3.3 V固定LDO、`VCC`入力）が実装されている（`hardware-bom.md` DISP-01、2026-08-13現物確認／2026-08-15品番特定）。[UMW XC6206 datasheet](https://www.umw-ic.com/static/pdf/e442437afc9daa185da86486e2bfe8c5.pdf) Mar.2025 `8.Electrical characteristics`は、出力3.3 V品のVdropを`2.6V≤Vout(T)≤3.3V`区分でtyp 160 mV／max 240 mV（`Iout`=50 mA）と規定する。**したがって`U1`が3.3 Vを完全に規制するために必要な`Vin`は3.46〜3.54 Vであり、`VCC`=3.3 V（rail上限側の値）でも既に`U1`はdropout領域にある。**これは3.234 Vを受け入れて新たに生じる状態ではなく、rail電圧が3.3〜3.6 Vのどこにあってもこの構成（3.3 V rail上に3.3 V品のLDOを直列に置く構成）では常に生じている状態である。

**ILI9341への実際の供給電圧は、経路を問わず次の2通りいずれでも成立する**（ILI9341の`VDDI`／`VCI`が`U1`出力経由か`VCC`直結かのパターン追跡は未了。`HW-TBD-002`はpin配列・電源pin・decouplingの3点のみを確認範囲としており、`HW-TBD-024`もbacklightのLED電流経路（`R5`／`R6`／`Q1`／`J1`）を対象とするだけで、いずれもこのcontroller自身の給電経路を確認範囲に含んでいない。**したがってこの点は現状どのTBD行にも明示的には属していない**）。

| 経路 | ILI9341供給の見積り | `VCI`下限2.5 Vに対する余裕 |
|---|---|---|
| `VCC`直結（`U1`を経由しない） | 3.234 V（`U2`の直接値） | 約0.73 V |
| `U1`出力経由 | 約2.99 V（**導出値。**`Vin` 3.234 V − `Vdrop` max 240 mV@50 mA。`U1`のdropout curveは非公開のため近似であり、実測値ではない） | 約0.49 V |

いずれの経路でも、ILI9341自身の最小動作電圧（[ILI9341 Datasheet V1.11](https://cdn-shop.adafruit.com/datasheets/ILI9341.pdf) §18.2.1 `General DC Characteristics` p.236。`VCI`（analog operating voltage）Min 2.5 V／Typ 2.8 V／Max 3.3 V。`VDDI`（logic）の値は[gpio-assignment.md](gpio-assignment.md#電圧domainすべての外部pull-upに適用)が既に記録済みのため、ここへ値を再掲しない）を満たす。

**受容の条件（caveat。本文としてここに置き、脚注にしない）。**上記の余裕計算は、ILI9341ロジック単体（`Iout`=50 mA相当の最悪ケース）の負荷条件で成立する。backlightのLED電流が`U1`を経由するかは`HW-TBD-024`で未解決であり、経由すると判明した場合は実効負荷電流が50 mAを大きく超えうるため`Vdrop`が増え、この余裕計算は崩れる。**`HW-TBD-024`がbacklight電流の`U1`経由を確定させた場合、この下限は再導出を要する。**

**`#13`（LCD bring-up）への記録。**表示不良に遭遇した場合、driverや結線を疑う前に、`DISP-01`の`VCC`rail電圧と`U1`出力電圧を先に実測する。rail電圧の低下と`U1`のdropoutは、ここまでの記述のとおり既知の受け入れ済みリスクである。

##### 通常動作の上限は保護ではない

**下に定める電流上限と電圧範囲は、通常動作で守るべき値であって、短絡や配線ミスのときの
電流を制限しない。**上限を超えたら人が止めるという運用は、段階Cについて
`過電流保護（段階Cのgate）`で否定したものと同じである。**人による監視は保護機構ではない。**
故障電流を制限するのは、B-2aではregulatorの保護、B-2bでは電源の電流制限である。

##### B-2a: `3V3` pinから給電する経路

**PC hostのOCPはUSB入力を制限するだけで、`3V3` branchを負荷超過から守らない。**
この経路で増える負荷はすべてESP32 board上のregulatorが供給するため、**先に壊れうるのは
hostではなくregulatorである**。したがってgateは`3V3`側に置く。

| 項目 | 内容 |
|---|---|
| 測定点 | ESP32 boardの`3V3` pinと周辺module3点のrailの間。`MEAS-01`を直列に入れ、両端電圧をDT830Bで読む（`DT830Bを電流測定に使うときの制約（2026-08-21）`の2026-09-28の決定） |
| 実施条件（定格） | `3V3` pinの外部供給可能電流の定格を一次資料または現物回路で確認する（`hardware-bom.md`の部品受け入れchecklist、`MCU-01`）。**確認できるまでB-2aを実施しない** |
| 実施条件（保護） | board上regulatorの過電流保護／短絡保護の有無と動作（制限電流、折り返し特性、熱shutdownの有無）を**一次資料または現物回路で確認する**。**保護が無い、または確認できない場合はB-2aを採らない**（B-2bへ移る。**ただしB-2bにも固有の条件があり、共通条件は両経路に掛かる**）。**2026-08-15時点で確認は完了していない。**`U2`＝UMW `LD1117-3.3`は電流制限`Ilimit` min 1.25 A／max 1.6 Aと熱shutdown`TSD` typ 150 ℃を持つことまでは確定したが、**短絡保護の有無と折り返し特性はdatasheetに記載が無い。記載が無いことを「保護が無い」とも「保護がある」とも読まない**（[AGENTS.md](../../AGENTS.md) 推測禁止）。**この項目が求めているのは短絡・配線ミス時の動作であり、そこが未確定である以上、この条件は満たされていない。****あわせて分かったのは、電流制限のtrip点がこの品の定格1 Aより上にあり、`IOUT` 1.0–1.25 Aの区間は電流制限が動作しない範囲だということである。**この区間で熱shutdownが働くかは放熱条件次第でありdatasheetからは決まらない（`HW-TBD-023`(c)） |
| 電流の上限 | 上記電流定格の**80%**（この文書のderating規則と揃える）。**定格そのものを上限にしない** |
| 停止条件（電流） | 3.3 V branchの定常電流がこの上限に達した時点で中止する |
| 停止条件（電圧） | `3V3` railの電圧が共通の許容電圧範囲を外れた時点で中止する。**下限割れはregulatorが電流を出しきれていない兆候**であり、`MEAS-01`両端の読みが上限内でも中止する |
| 停止条件（その他） | ESP32のbrownout、reset、LCDの表示異常、**regulator周辺の発熱**を認めた場合も中止する |
| 上限に達した場合 | 3点の合計が`3V3` pinの供給能力に収まらないということであり、**枠を超えたまま続けない。**B-2bへ移るか、段階Cまで延期する（**2026-10-27更新：段階CではMSP2807を測らない。#405の見直しまで残る**（`MSP2807の電流上限の扱いと、段階Cの測定4（2026-10-27、#556）`））。あわせて`配線・保護表`のとおり別途3.3 V regulatorを追加する構成の検討へ戻る |

あわせてregulatorの**種別**（LDOかswitchingか）も確認する。5 V側への換算根拠に使う（下記）。
**2026-08-15に`LDO`と確定した**（`HW-TBD-023`(b)）。

この経路の実施条件（定格、種別、過電流／短絡保護）の追跡は[HW-TBD-023](tbd-register.md)で行う。
**2026-08-15時点で確定したのは種別と、保護のうち制限電流・熱shutdownの有無だけである。****短絡保護と折り返し特性は未確定であり、`実施条件（保護）`は満たされていない。**残るもう一つは定格である。その定格は
**Espressifがboard levelで公開しておらず、`U2`のdatasheetでも埋まらない。**
ICの供給能力は上限を与えるだけであり、datasheetのNote 1は`Rθja`が実装方法で変わると明記している。
**したがってB-2aの`実施条件（定格）`を満たす手段は、現状では現物の実測しか残っていない。**
**その実測はB-2そのものであるため、この経路は循環している。**
**経路はB-2bを採った**（`B-2bを採る決定とMSP2807の電流制限（2026-09-07）`節。**ここへ再掲しない**）。
**2026-09-28、ユーザーは今の接続（`3V3` pin）のままB-2aとして電流を測ると決めた**（`段階B-2の測定`。この循環する実測を、その決定で行う）。
**判断材料として次の2点を`HW-TBD-009`へ渡す。**(1) B-2aの`実施条件（定格）`は資料では埋まらず循環すること。
(2) B-2aが頼るregulatorの保護は、**短絡・配線ミス時の動作がdatasheetから決まらず、
`IOUT` 1.0–1.25 Aの区間は電流制限が動作しない範囲である**こと。

##### B-2b: 外部の3.3 V電源から給電する経路

`3V3` pinを使わないため、**regulatorの定格も保護も条件にならない。**代わりに、
**電源に設定した電流制限が唯一の保護**である。設定値に根拠が無ければ保護として成立しない。

###### 実施前に満たす条件

**「設定値を表示している」ことは「その値で電流を制限する」ことの証明ではない。**
また電流制限は**出力電圧の誤りを防がない**。B-2bの実施前に次を満たす。

| 条件 | 内容 |
|---|---|
| 使う電源 | **電流制限値を設定でき、制限が働いたことを表示できる電源。**設定できない電源は使わない |
| **全moduleの安全な上限** | 共通条件のとおり（上記`両経路に共通するのは次だけである`）。**B-2bではこれが電流制限値の上限そのものになる。****3点とも公開値からは上限を得られない。**MSP2807は定格が未公開であり（`HW-TBD-024`）、**ADXL345とBME280は絶対最大定格が公開されているものの、そこに電流の上限は記載が無い**（2026-08-12確認）。いずれも現物回路（電流制限抵抗等）の確認か一次資料が要る。得られない限り**B-2bは成立しない**（未知数が3点あり、一部を測っても埋まらないため） |
| **電流制限の動作確認** | 設定値で実際に制限が働くことを、**周辺moduleを繋ぐ前に確認する。**出力へ既知の負荷（または短絡）を与え、電流が設定値で頭打ちになり表示が制限中を示すことを記録する。**確認できない電源は使わない** |
| **無負荷出力電圧の確認** | 周辺moduleを繋ぐ前に、**無負荷の出力電圧を測り、共通の許容電圧範囲内であることを確認する。**電流制限は電圧の誤りを防がない |

**MSP2807の安全な電流上限の追跡は[HW-TBD-024](tbd-register.md)で行う。**これは共通条件(b)の一部であり、**得られるまではB-2bもB-2aも成立しない。**

###### B-2b を採る決定と MSP2807 の電流制限（2026-09-07）

**採る経路: B-2b（外部の3.3 V電源。`3V3` pinを使わない）。**
提案: PM（`deskcat-f2`）、2026-09-07。承認: ユーザー。根拠は次の4点である。

1. **B-2aの`実施条件（定格）`は一次資料では埋まらず、実測（B-2そのもの）でしか埋まらないため
   循環する**（上記`B-2a: 3V3 pinから給電する経路`）
2. **B-2aが頼るregulator（`U2` UMW `LD1117-3.3`）は短絡・配線ミス時の動作がdatasheetから
   決まらず、`IOUT` 1.0–1.25 Aの区間は電流制限が動作しない**（同上）
3. **B-2bは`3V3` pinを使わないため、regulatorの定格も保護も条件にならず、`HW-TBD-023`の
   循環を経路ごと回避できる**
4. **同じ形の循環を、この文書は2026-08-09（Revision 17）に既に解いている。**「案が確定するまで
   通電しない」という書き方から、「経路を絞り、電流制限と監視を付けたbring-upを許可する」という
   書き方へ変えたのが先例である

**`HW-TBD-023`(a)はB-2bでは実施条件にならない。**ただし`HW-TBD-023`はcloseしない
（`3V3` pin給電を将来採る場合に引き続き要る）。

B-2bの選択と、通常接続の限定判断は別である。現在の適用範囲は
[HW-TBD-023](tbd-register.md#hw-tbd-023)と[HW-TBD-024](tbd-register.md#hw-tbd-024)、
承認時の残余risk・#445と#461の区別は[判断経緯](power-budget-history.md#b-2bと通常接続の判断経緯)を参照する。
以下の2点限定の計算はACCEL-01／ENV-01を対象とし、MSP2807を含めない。

この2点限定の給電について、`U2`の余裕を確認した(MSP2807を含まない場合)。想定合計電流は、ESP32-WROOM-32D board(Wi-Fi/BT不使用時)+ ADXL345(140µA typ)+ BME280(測定mode時、後述)の合計として見積もる。ESP32-WROOM-32D boardの電流は、本file後半の`負荷表`節（Wi-Fi idle行）が挙げる文献値約80〜100mAを用いる。**`実施前に満たす条件`(3)がWi-Fi/BT不使用を前提とするのに対し、この値は`Wi-Fi idle`（Wi-Fi機能自体は初期化されているが通信していない状態）の文献値であり、Wi-Fi機能を一切初期化しない現在のfirmwareの状態とは厳密には異なる。Wi-Fi idleはWi-Fi不使用より消費電流が高い側（保守側）だと考えられるが、その関係を示す一次資料は確認していない。****この値を`U2`の出力側電流（`Iout`）として扱う**（`負荷表`の当該行は`ESP32 3V3出力`ではなく`Logic`railの board電流として記録されたものであり、`U2`出力側の負荷という位置づけは本行が置く解釈である）。参考として、Espressif公式[ESP32 Series Datasheet v5.3](https://documentation.espressif.com/esp32_datasheet_en.pdf) Table 4-2「Power Consumption by Power Modes」(4.3節、p.30)はchip単体のModem-sleep・240MHz dual-coreの電流を30〜68mAと記載している。**ただし100mAとの差(約32mA)がboard上の他の消費(WROOM内のflash、USB-UARTブリッジ、電源LED)を覆うかどうかは確認していない。**bridgeの品種も特定していないため、「100mAが保守的である」とは断定しない。BME280は`sensor-datasheet-notes.md`の`消費電流`行（Bosch datasheet由来）が湿度測定340µA(max)・気圧測定714µA(max)・温度測定350µA(max)を挙げており、単純合算では約1.4mAとなる（`負荷表`の「<1mA」は同時発生を想定しない書き方であり、単純合算の約1.4mAより保守的ではない。以下ではこの1.4mAを用いる）。以上より`Iout`の合計は約101.5 mAとなる（ADXL345 0.14mA＋BME280 1.4mA＋ESP32 100mA＝101.54mA、小数第2位を四捨五入）。`U2`の連続定格（`Iout`の定格）1Aに対する電流の余裕は1A÷101.5mAで約9.85倍。

**損失の計算には`U2`自身の`Iq`（quiescent current）も要る。**`Iq`は`U2`（UMW LD1117-3.3）のdatasheetの規格値（実測値ではない）で確認済みであり（[UMW LD1117 datasheet](https://www.umw-ic.com/static/pdf/a5e0c99cefdefaf03cfa7777b369e45b.pdf)の`9.Electrical Characteristics`、`Quiescent Current`行。typ 5 mA／max 10 mA。本file`5 V側への換算には根拠が要る`の段落に既存記録がある。行番号は版により
動くため節の見出しで参照する）、`Iq`は`U2`の`Iout`定格を消費しない（`Iout`に含めない）が、`Vin`側からそのまま流れて損失に加わる（`Iin ≒ Iout + Iq`）ため、**保守側として`Iq` max 10 mAを損失計算に加える。**損失(Vin=5V、Schottky降下を無視した保守値、`Vdrop`≈1.7V)は約222.6mW（`Vdrop`×`Iout`の172.6mW＋`Vin`×`Iq(max)`の50mW）、温度上昇は約19.6℃（222.6mW×88℃/W。`Rθja`＝88℃/Wの出所は[HW-TBD-023の判断記録](tbd-register-history.md#hw-tbd-023)行が既存記録として持つ値であり、**同行もdatasheetの具体的なtable／page番号までは記録していない**。この文書はその既存記録をそのまま用いる）、ambient 40℃(仮定)で`TJ`は約59.6℃。`U2`のdatasheetが持つ温度関連の値は**熱shutdown`TSD` typ 150℃**であり（[HW-TBD-023の判断記録](tbd-register-history.md#hw-tbd-023)。この値を記録したのは`power-budget.md`自身のRevision 45である）、この`power-budget.md`自身は`TJ(max)`（絶対最大接合温度）としての値を記録していない。**`tbd-register.md`の`HW-TBD-023`は「datasheetのNote 1が与えるPD(max)=(TJ(max)-Tamb)/Rθjaに`TJ(max)` 150℃と`Rθja` 88℃/Wを入れる」という形でこの2つを同じ150℃の数値として扱っているが、これは`TSD`とは別の観点（絶対最大定格）からの言及であり、同行自身も`TSD`と`TJ(max)`が同一の150℃であることを明示的に述べてはいない。****したがって以下の余裕は「`TSD`（熱shutdownが動作し始める温度のtyp値）までの余裕」であり、`TJ(max)`までの余裕ではない。**`TSD`とambientの差110℃÷温度上昇19.590…℃（四捨五入前）で、`Rθja`がdatasheetの88℃/Wより約5.62倍悪化すると`TSD`に届く計算になる。**board-levelの内訳を確認していない不確かさが結論に影響しないことを、ESP32の項を仮に2倍(約200mA)へ置いて確認した。**その場合`Iout`合計は約201.5mA、電流の余裕は`U2`の連続定格1A比で約4.96倍、損失は約392.6mW（`Vdrop`×`Iout`の342.6mW＋`Vin`×`Iq(max)`の50mW）、温度上昇は約34.550…℃(四捨五入前。ambient 40℃で`TJ`約74.55℃)、`TSD`までの悪化許容倍率は約3.18倍（110℃÷34.550…℃、四捨五入前の値から算出。基準ケースと同じ丸め方に揃えた）であり、結論(実装依存性は結論を変えない、`TSD`に対しても十分な余裕がある)は変わらない。`I_VDD`(min 0.5A。[ESP32-WROOM-32D & ESP32-WROOM-32U Datasheet v2.8](https://documentation.espressif.com/esp32-wroom-32d_esp32-wroom-32u_datasheet_en.pdf) Table 14「Recommended Operating Conditions」。**これはEspressifが電源側に要求する供給能力の下限（規格値）であり、実際の消費電流の見積りではない。**したがって熱側の感度確認（上記の2倍試算）とは別の軸であり、0.5Aを熱計算の入力に使わない。この確認は「`U2`が規格上要求される供給能力を満たせるか」だけを見る)の確認では、`U2`の連続定格から残る余力は1A−101.5mAで約898.5mAであり、0.5Aを上回る。この評価はWi-Fi/BT不使用、ambient 40℃(仮定)、Vin=5V(保守側の見積り)の前提でのみ成立する。

**MSP2807の電流制限値。**初回設定値は**暫定の初期候補**であり、**単独で通電を許可する値ではない。**
LCD Wikiのtypical消費「0.31 W」（≈94 mA）を上回るという以外の根拠を持たず、**その「0.31 W」自体が
「typicalの消費であって耐えられる上限ではない」**（下表）。したがって150 mAがMSP2807を壊さない
ことは示されていない。`HW-TBD-024`（MSP2807が耐えられる真の電流上限）を確定させるものでもない。
**`HW-TBD-024`はcloseしない。**

**B-2bの保護は、この開始値が担うのではない。**上記`実施前に満たす条件`の4条件（電流制限値を
設定・確認できる電源であること、**全moduleの安全な上限**、電流制限が実際に働くことの事前確認、
無負荷出力電圧の事前確認）と、下記`手順と停止条件`の停止条件（電圧、その他の異常、上限に達した
場合の扱い）が担保する。**ただし`全moduleの安全な上限`は4条件のうち唯一未解決であり**
（上記のとおり`HW-TBD-024`と`HW-TBD-025`(b)が揃うまで導出できない）、**だからこそB-2bを実施
できない。**

| 項目 | 値 | 導出 |
|---|---|---|
| 初回設定値 | **150 mA** | LCD Wikiの「0.31 W」（≈94 mA@3.3 V。下表のとおり判定根拠にはしない）を上回る値。**厳密な導出は不要であり、この値自体を判定に使わない。****暫定の初期候補である（保護を証明する値ではない）** |
| 判定根拠にしない値 | LCD Wikiの「0.31 W」（≈94 mA@3.3 V） | **`HW-TBD-024`が既に「typicalの消費であって耐えられる上限ではない」と明記している。**ここでも判定根拠にせず、誤トリップの傾向を見る目安としてのみ扱う |
| 他の周辺module | ADXL345 140 µA typ、BME280 1 mA未満 | `負荷表`。桁で無関係 |

**引き上げの上限は、いま決められない。**下記`手順と停止条件`の`電流制限値の上限`行が
「上げてよい上限は、判明している中で最も低い上限とする。上記`全moduleの安全な上限`の最小値と、
給電に使う配線の許容電流の小さい方」と定めており、**入力は3つある。**(1) MSP2807の安全な
電流上限（`HW-TBD-024`）、(2) ADXL345／BME280の現物回路確認（`HW-TBD-025`(b)）、
(3) **B-2bの3.3 V給電に使う配線の許容電流**（`WIRE-PWR-01`と同じ選定規則を要求するが、
B-2b用の配線はまだ選ばれていない）。**3つとも未解決である以上、上限は導出できない。**

- **`U1`（XC6206P332MR）の数値は上限の根拠にできない。**過電流保護`Ilimt` typ 380 mA
  （保証値ではない）と絶対最大`IOUT` 500 mAはdatasheet値として存在するが、**backlight電流が
  `U1`を経由するかは`HW-TBD-024`で未解決である**（経由しない場合、VCC側の合計を`U1`の値で
  縛る根拠が無い）。したがってこれらは「破壊しないことの参考」に留め、上限の導出には使わない
- **`過電流保護（段階Cのgate）`の240 mA境界（`境界は240 mAへ広がった（2026-08-26）`）は
  この節で使わない。**あの値は**5 V入力側へ換算した値**であり、正本自身が「**3.3 V側の測定値と
  直接比べない**」と定めている（同節）。**加えて`B-2bの結果で言えないこと`が明記するとおり、
  B-2bの測定値に`Iin ≒ Iout + Iq`等の換算を適用してはならない**（この式は`U2`を実際に電流が
  通る場合にのみ成り立つ物理的な関係であり、B-2bは`U2`を経由しないため適用できる根拠が無い）。
  **したがってB-2bの結果だけでは、ingressの5 V側予算にMSP2807が収まるかどうかを判定できない。**
  その判定にはB-2a経由の値（`HW-TBD-023`の循環により現状得られない）か、段階Cでの実測（**2026-10-27更新：段階CではMSP2807を測らない**（`MSP2807の電流上限の扱いと、段階Cの測定4（2026-10-27、#556）`））が
  別途要る（**次に読む者が同じ誤りをしないための注記。**2026-09-07に、この240 mA境界を
  B-2b側の電流制限の上限として提案したのはPM（`deskcat-f2`）である。**単位系（5 V入力側の
  換算値と3.3 V側の設定値）の誤りに気づいたのもPMであり**、差分をreviewして自ら指摘した。
  **ただしPMが最初に出した是正案（「換算を書いてから使う」）も、`B-2bの結果で言えないこと`と
  「5 V側へ足せるのはB-2aで得た値だけ」の2箇所に反しており、正本が禁じる操作だった。**これを
  見つけて止めたのは`#3`の作業セッションである。**その結果、PMが上限の提案そのものを撤回した。**
  ここに経緯を残すのは、**PMの提案であっても正本と食い違えば止めてよい**ことを次に読む者へ
  示すためである）

**下記`手順と停止条件`の`電流制限値の決め方`（低い値から始めて段階的に上げる）は変えない。**
ただし上げてよい範囲は`電流制限値の上限`行が決めており、その上限は上記3つの入力
（`HW-TBD-024`、`HW-TBD-025`(b)、B-2b用配線の許容電流）がすべて揃うまで存在しない。**上限が
無い状態では、ある設定値まで上げてよいかを判定できない。**したがって150 mAでトリップしたら、
原因（backlight点灯時か、初期化時の突入か、どの操作で起きたか）を記録したうえで**その場で止め、
3つの入力が揃ってから`電流制限値の決め方`の手順へ戻る。**

**この値だけではB-2bを実施できない。**残る2点がある。
- **電流制限の上限そのものが、上記3つの入力がすべて揃うまで未解決である**（`HW-TBD-024`＝
  MSP2807、`HW-TBD-025`(b)＝ADXL345とBME280の現物回路確認、B-2b用配線の許容電流＝未選定）
- **`実施前に満たす条件`が要求する「電流制限値を設定でき、制限が働いたことを表示できる電源」が、
  2026-09-07時点で`hardware-bom.md`に存在しない。**B-2bの実施には、この電源の
  確保も要る

**周囲温度は`MEAS-04`で記録する。**この節の値は温度条件の明記された数値に依存していないため
現時点で読み替えは要らないが、実施時の記録項目としては残す。

###### 手順と停止条件

| 項目 | 内容 |
|---|---|
| 測定点 | 外部電源の出力と周辺module3点のrailの間。`MEAS-01`を直列に入れ、両端電圧を読む（`DT830Bを電流測定に使うときの制約（2026-08-21）`の2026-09-28の決定）。電源側の電流表示は参考とし、**判定は`電流の測定点と読みの確かさの基準`による** |
| 配線 | **外部電源のGNDをESP32のGNDへ接続する**（信号線の基準を合わせるため）。`3V3` pinへは何も接続しない。**外部電源と`3V3` pinを同時に周辺railへ繋がない** |
| 電流制限値の決め方 | **低い値から始めて段階的に上げる。**各段で電圧と電流を記録し、周辺module3点が正常動作する最小の設定値を採る。**制限が働いている間（電圧が設定電圧を保てない間）の読みを定常電流として採用しない** |
| 電流制限値の上限 | 上げてよい上限は、**判明している中で最も低い上限**とする。上記`全moduleの安全な上限`の最小値と、給電に使う配線の許容電流（`WIRE-PWR-01`と同じく公開値のある品を使う）の小さい方 |
| 停止条件（電圧） | rail電圧が共通の許容電圧範囲を外れた時点で中止する。**電流制限が働いて電圧が落ちている場合も中止**とし、設定値を上げるかどうかは上の上限の範囲内で判断する |
| 停止条件（その他） | ESP32のbrownout、reset、LCDの表示異常、**module周辺の発熱**を認めた場合も中止する |
| 上限に達した場合 | 上限まで上げても正常動作しないということであり、**枠を超えたまま続けない。**MSP2807の実測を延ばし（**2026-10-27更新：段階Cでは測らない。#405の見直しまで残る**（`MSP2807の電流上限の扱いと、段階Cの測定4（2026-10-27、#556）`））、経路に必要な定格の見積もりを別に立て直す（**2026-09-09、案Bにより「変換基板の選定根拠」から差し替え**） |

###### B-2bの結果で言えないこと

**B-2bの電流は外部電源から出ており、ESP32 boardのregulatorを通らない。**したがって
B-2bの結果は**周辺module3点の負荷の見積もりにしか使えない**。次は言えない。

| 言えないこと | 理由 |
|---|---|
| `3V3` pinの供給能力が足りること | その電流はpinを通っていない |
| board上regulatorの保護が働くこと | regulatorを通っていない |
| 5 V側の消費（`Iin ≒ Iout + Iq`等の換算） | regulatorを通らないため、入力側の電流が発生しない |

**これらを言うには、B-2a（`3V3` pin経由）を行うか、段階Cで別途3.3 V regulatorを
追加した構成を個別に評価する必要がある。**B-2bの結果を`3V3` pinの承認や5 V側への
換算の根拠に使わない。**測定結果には、B-2aとB-2bのどちらで得たかを必ず記録する。**

**どちらの経路も成立しない場合は、B-2を行わない。**MSP2807の実測を延ばす（**2026-10-27更新：段階Cでは測らない。#405の見直しまで残る**（`MSP2807の電流上限の扱いと、段階Cの測定4（2026-10-27、#556）`））。

##### PC host側の扱い

参考として、使用するhost portの機種名・port種別と公表供給能力を記録する。ただし
**公表供給能力は能力値であって、OCPが動作するしきい値ではない。**hostのOCP特性は
未確認であり、**この測定の保護として当てにしない。**保護を担うのは`通常動作の上限は
保護ではない`で定めた手段、すなわち**確認済みのboard上regulatorの過電流／短絡保護か、
電流制限値を設定した外部3.3 V電源のどちらか**である。`3V3`側の上限も人による監視も
保護ではない。

USB portを通る合計は`3.3 V branchの実測値 ＋ ESP32 board自身の消費`で見積もれる
（ESP32側は負荷表の文献値を上限側で採る）。**Wi-Fiを停止した状態で測り**、この
見積もりの不確かさを減らす。この合計は5 V側への換算とhost側の余裕の把握に使う値で
あって、停止条件そのものではない。

**5 V側への換算には根拠が要る。**この測定で得るのは3.3 V側の電流であり、ingressを
通る5 V側の電流ではない。ESP32 board上のregulatorが**LDOであれば**入力電流は出力電流に
ほぼ等しく（`Iin ≒ Iout + Iq`）、3.3 V側の実測値をそのまま5 V側の寄与として足せる。
switching regulatorであれば電力比で決まるため、この足し方は成り立たない。

**2026-08-15に種別が確定した。`U2`はUMW `LD1117-3.3`であり、LDOである**（`HW-TBD-023`(b)）。
したがって`Iin ≒ Iout + Iq`の側が成り立ち、**`Iq`は同datasheetでtyp 5 mA／max 10 mA**である
（[UMW LD1117 datasheet](https://www.umw-ic.com/static/pdf/a5e0c99cefdefaf03cfa7777b369e45b.pdf)
Mar.2025の`9.Electrical Characteristics`、`Quiescent Current`行。条件は`4.25V ≤ VIN ≤ 6.5V`）。
**ただしこの換算だけで5 V側の必要量を確定しない。**`Iin ≒ Iout + Iq`は**`U2`を通る分にしか掛からない。**
board上で`EXT_5V`から直接取られる負荷があれば別に数える必要があり、**その有無は参照設計の回路図でしか見ていない。**
**現物の`U2`は参照設計の`AMS1117-3.3`ではなくUMW `LD1117-3.3`であった**（`HW-TBD-023`）。
**部品が違った以上、回路図が現物の負荷構成を代表する保証も無い。**現物のboardで`EXT_5V`の直接負荷を
追跡するまで、**この換算値をingress予算の受け入れ判定に使わない。**直接負荷が実在した場合、この換算は
その分を落とし、5 V ingressの負荷を過小に見積もる。

servo試験以降で用いる構成を次に定める。

| 項目 | 内容 |
|---|---|
| 必要な部品 | 端子台（`114217`、6 A。**2026-09-09、案Bにより「Micro-Bメスreceptacleの2.54 mm変換基板（DIP化キット）」から差し替え**）。M-12001のcableをMicro-Bプラグの手前で切り、そこからbreadboard railへ5 V／GNDを引き出す。**調達（発注・着荷）の状態は[#205](https://github.com/wachi-yoshitaka-11-dev/deskcat/issues/205)が持つ。この表は持たない**。着荷済み（[hardware-bom.md](hardware-bom.md) `WIRE-PWR-01`）。この区間を配線するときの手順（2026-09-09、PM判断）: (1) cableを切って端子台へネジ止めする。(2) **下流（`PROT-OC-01`以降）に何も繋がない状態で**、`通電前の配線確認手順`の`確認の方法`3（テスターで導通を読む）に従いVBUS・GNDの対応を確認する。(3) 合っていることを確認してから下流を繋ぐ。**この区間自体は`通電前の配線確認手順`の対象には含めない**（`逆接可否表`の`M-12001 → 端子台`行を参照。この区間の逆接はMOSFETの担当であり、手順の担当ではない。ここへ再掲しない）。**2026-09-10、(1)を実施した。**ユーザーがcableを切り端子台へ接続した。極性は、切り落としたplug片を手元に残る`PSU-INGRESS-01`のreceptacleへ挿して判定した（記録は[experiment-log.md](experiment-log.md)の`EXP-012`。プラグの金属シェルを基準にした判定は不成立だった）。**(2)(3)の下流接続はまだ行っていない**（`PROT-OC-01`・分岐点は未実装。通電もまだ行っていない）。**2026-09-16の訂正。**この文は`EXP-013`（2026-09-14〜09-15）より前の状態を述べたものである。いまは次のとおりである。**(2)を実施し、通電も行った**（[experiment-log.md](experiment-log.md)の`EXP-013`）。**(3)を満たしたかどうかを、`EXP-013`は判定していない。****順序は手順どおりである**（試験0を下流無接続・非通電で行い、そのあと下流を繋いで通電した。`EXP-013`の試験0と試験1）。**未決なのは、その確認が`確認の方法3`(ii)の記録要件を満たしているかであって、順序ではない。**`PROT-OC-01`と分岐点は**`PROTO-02`への実装が未了である**（`EXP-013`はブレッドボード上の仮組みで行った）。**この訂正は、(3)の未決も、`通電前の配線確認手順`の充足状態も動かさない**（同手順については`経路部品と定格`の`M-12001のcableを受ける端子台`行が持つ。**ここへ再掲しない**） |
| 分岐点 | 端子台の直後にbreadboard railへ入れ、そこからlogic railとservo railへ分ける。この構成では**Piの5 V GPIO pinを経由して他へ配らない**（下記の定格問題） |
| Piの5 V入力 | breadboard railからMicro-Bオスcableで`PWR IN`へ入れる。PiのUSB OTG portはPiへの給電に使わない（**2026-09-28、[#446](https://github.com/wachi-yoshitaka-11-dev/deskcat/issues/446)のユーザー決定でPi linkがGPIOのUARTへ変わったため、「PiのUSB OTG portはPi link専用とし、給電に使わない」から差し替え**） |
| Servo railの5 V入力 | breadboard railから分岐し、直近にbulk capacitorを置く |
| **ESP32の5 V入力** | **未決定。**[#405](https://github.com/wachi-yoshitaka-11-dev/deskcat/issues/405)の実装設計の見直し（はんだ付けの前）で決める。案A（PiのUSB OTG portからのVBUS単独給電）と案B（`5V` pin給電）はその候補として残す（下記`ESP32の給電経路（最終の経路は未決定）`）。**2026-09-28、[#446](https://github.com/wachi-yoshitaka-11-dev/deskcat/issues/446)のユーザー決定（最終の経路は#405で決める）に合わせて「案Aで確定・実測待ち（2026-08-22、人間の判断）。PiのUSB OTG portからのVBUS単独給電。案BはA不成立時の再検討先として残す」から差し替え** |

### ESP32の給電経路（最終の経路は未決定）

**2026-09-30追記（[#446](https://github.com/wachi-yoshitaka-11-dev/deskcat/issues/446)）。**ユーザーは、PiとESP32の間を最終の製品構成でもGPIOのUARTでつなぎ、
ESP32のUSBは書き込みとdebug専用にすると決めた（[別電源とUARTの採用](https://github.com/wachi-yoshitaka-11-dev/deskcat/issues/446#issuecomment-5863027108)、
[最終構成でもUART](https://github.com/wachi-yoshitaka-11-dev/deskcat/issues/446#issuecomment-5863142360)）。この節は次のとおり読む。

- **検証の構成:** Piは段階Aのadapter（`5 V ingress`節の段階表のA行）、ESP32はPCのUSBから、別々に給電し、GNDを共通にする。
  信号線をつないでよい条件は`gpio-assignment.md`の`信号線をつないでよい条件`が持つ。**ここへ書き写さない。**
- **ESP32の最終の給電経路は、[#405](https://github.com/wachi-yoshitaka-11-dev/deskcat/issues/405)の実装設計の見直し（はんだ付けの前）で決める。**
  ユーザーの決定は、別電源とUART、最終構成もUART、この一文の3つである。
- **案Aは今の計画ではない。**PiのUSB OTG portからESP32へ給電した状態では、Piと信号線をつながない（同条件の5）。
- 下の案A・案B、それぞれのgateと受け入れ試験は、#405で見直す候補としてこの文書に残す（PM（#0PM）の作業指示による扱い。ユーザーの決定ではない）。
  **値は変えていない。**案A・案Bを採る条件（同条件の5との関係を含む）は、#405の見直しで改めて決める。それまで、下の当時の記録の条件は1つも外さない。
- 2026-08-22に案Aを本線とした判断は、下の`案Aを本線に確定した（2026-08-22、人間の判断。2026-09-28に置き換わった。以下は当時の記録）`に当時の記録として残す。

[Espressifの公式guide](https://docs.espressif.com/projects/esp-idf/en/v5.1/esp32/hw-reference/esp32/get-started-devkitc.html)は、
電源3系統（Micro USB port／`5V` header pin／`3V3` header pin）が**排他**であり、
**2つ以上から同時に給電するとboardまたは電源が破損しうる**と警告している。
**「排他である」だけでなく、破られたときの帰結が破損である**という点がこの節の前提である
（同じ記述が`hardware-bom.md`の`MCU-01`にもある。**食い違わせない**）。

**この警告は案の選択そのものに効く。**案Aと案Bを同時に満たす配線
（**USBを繋いだままbreadboardの5 Vを`5V` pinへも入れる**、など）は、案Aでも案Bでもなく
**警告が禁じている状態**である。**どちらか一方を選び、選んだ側の口だけを使う。**

**段階B-2aとの関係をこの文書の読みとして書いておく。**公式guideが並べる3つはいずれも
**boardへ給電する入口**であり、B-2aは`3V3` pinから**外部へ供給する**側である。したがって
**この文書は、B-2aを排他制約の対象として扱わない。**ただし**これはguideの明示の記述ではなく、
警告の対象を読み取った結果である。****B-2aに固有のgate（`3V3` pinの電流定格とboard上regulatorの
過電流／短絡保護）はこの読みとは無関係に必要であり、1つも免除されない**（`段階B-2の測定`）。

一方、Pi linkはUSB serialに確定しており（`gpio-assignment.md`のtransport節）、
**Pi linkを繋いだ時点でESP32のUSB VBUSは通電する**。したがって「`5V` pinから給電しつつ
USBでPiと繋ぐ」構成は、そのままでは排他制約に反する。次のどちらかを選ぶ。

**2026-09-30追記。**上の段落と次の表は、Pi linkがUSB serialだった当時の前提で書いた。Pi linkは2026-09-28に
GPIOのUARTへ変わり（`gpio-assignment.md`のtransport節）、ESP32のUSBは書き込みとdebug専用になった。
**それでも、`5V` pinから給電したまま書き込みやdebugのためにUSBを繋げば、VBUSと`5V` pinは同時に生きる。**
案Bの排他制約の問題は、USBを繋ぐ理由が変わっただけで残る。
**表の比較は当時のものであり、#405の見直しで候補として見直す。**表の内容と案Bの受け入れ試験は変えていない。

| 案 | 内容 | 未解決の点 |
|---|---|---|
| A: USB VBUS単独給電 | ESP32はPiからのUSB cableだけで給電し、`5V` pinへは何も接続しない。配線が最も単純で排他制約にも反しない | PiのUSB OTG portが、ESP32のpeak（文献値で最大約500 mA spike）とMSP2807の3V3負荷を合わせた電流を供給できるか。Pi自身の入力電流もその分増える |
| B: `5V` pin給電＋USBはdata用 | ESP32を`5V` pinから給電し、USBはPi linkにのみ使う | VBUSと`5V` pinが同時に生きる。公式ESP32-DevKitC V4はVBUS保護のSchottky diodeを実装しているが、**この秋月基板が同じ保護を持つかは未確認**。逆流の有無を現物回路で確認するまで承認しない |

**案Aで確定した**（2026-08-22、人間の判断）。PiのUSB port供給能力の実測（`測定計画`）で不足が判明した場合は
案Bへ切り替え、そのとき秋月基板のVBUS保護有無を回路で確認する。
**この判断は2026-09-28のユーザー決定で置き換わった**（この節の冒頭の追記）。

**回路の確認だけでは案Bを承認しない。**保護diodeが在ることを回路図や現物で確かめても、
**実際に逆流しないことを測ったことにはならない。**案Bを採るには、次の受け入れ試験を通す。

| 確認 | 内容 |
|---|---|
| 組み合わせ1 | `5V` pinから給電し、USBを接続する。**USB VBUS側へ流れ込む電流を測って記録する** |
| 組み合わせ2 | USBから給電し、`5V` pinを接続する。**`5V` pin側へ流れ込む電流を測って記録する** |
| 合格条件 | **両方で、非給電側への逆流が測定分解能の範囲で認められないこと。**片方だけの確認で合格としない |

**この2つを測るまで案Bはblockedである。**測定分解能（使用する計器と最小読み取り値）も
あわせて記録する。**「逆流は無いはずである」で通さない。**

**案Aと案Bはどちらも段階C（合成給電）の話であり、段階Cのgate（端子台、過電流保護部品、
大電流経路の線材が揃うこと。**2026-09-09、案Bにより「変換基板」から差し替え**）を満たすまで実施しない。**
それまでのESP32への通電は、段階B-1／B-2の経路（PCのUSBから給電）で行う。3つを混同しない。

| 経路 | いつ | 電流制限 | 排他制約 |
|---|---|---|---|
| **段階B-1: PC → ESP32のMicro USB** | いま可能 | board上のUSB portをメーカーが意図した用途で使う。**PC host portのOCPは未確認であり、保護として当てにしない**（`段階B-2の測定`） | 満たす（USBのみ。`5V` pinへ何も繋がない） |
| **段階B-2a: 同上＋`3V3` pinから周辺module3点** | `3V3`側のgateを満たしてから | 通常動作の上限は`3V3` pin電流定格の80%。**故障電流を制限するのはboard上regulatorの過電流／短絡保護（要確認）。**PC hostのOCPは`3V3` branchを守らない（`段階B-2の測定`） | 満たす（USBのみ。`5V` pinへ何も繋がない） |
| **段階B-2b: 周辺module3点を外部3.3 V電源から** | 電流制限値の根拠と上限を定めてから | **故障電流を制限するのは電源に設定した電流制限。**`3V3` pinは使わず、GNDのみESP32と共通化する（`段階B-2の測定`） | 満たす（ESP32はUSBのみ。`5V` pinへ何も繋がない） |
| 案A: Pi → ESP32のMicro USB | 段階Cから | **PiのUSB OTG portの供給能力。**値は未確認で、ingressでの実測とあわせて確かめる。実測するまで案Aを常用しない | 満たす（USBのみ） |
| 案B: breadboard rail → ESP32の`5V` pin | 段階Cから、かつ回路確認後 | ingressの上限（`ingressの電流制限`） | **満たさない恐れがある。**USBを繋ぐとVBUSと`5V` pinが同時に生きる |

**案Bは、秋月基板のVBUS保護diodeの有無を回路で確認するまで通電しない。**
確認前に`5V` pin給電とUSB接続を同時に行うと、保護が無い場合に逆流経路ができる。

#### 案Aを本線に確定した（2026-08-22、人間の判断。2026-09-28に置き換わった。以下は当時の記録）

**2026-09-30追記（[#446](https://github.com/wachi-yoshitaka-11-dev/deskcat/issues/446)）。この節は2026-09-28より前の状態を書いたものである。**
2026-09-28のユーザー決定（別電源とUART、最終の経路は#405で決める）により、案Aは本線ではなくなった（決定から導いた扱い）。**現行の状態は`ESP32の給電経路（最終の経路は未決定）`節の冒頭の追記が持つ。**
**この節の条件は、[#405](https://github.com/wachi-yoshitaka-11-dev/deskcat/issues/405)の見直しで改めて決めるまで、1つも外さない。**
下の`案Bを削除しない理由`の「案Aが不成立と判定されるまで、案Bへ進まない」と「判定の前に`5V` pin給電とUSB接続を同時に行わない」も、そのまま効く。

**ESP32の給電経路は案A（PiのUSB OTG portからのVBUS単独給電）を本線とする。**
**この決定は人間が2026-08-22に行った。**案Bの逆流riskと、受け入れ試験の重さを見たうえでの判断である。

**案Aを本線にしても、段階Cのgateは変わらない。**端子台（**2026-09-09、案Bにより「変換基板」から差し替え**）、過電流保護部品、大電流経路の線材が
揃うまで実施しない。**残るgateはPiのUSB OTG portの供給能力の実測だけである。**

##### 案Bを削除しない理由

**案Aが実測で不成立だった場合の再検討先として残す。**削除すると、次に同じ検討をやり直すことになる。

| 項目 | 内容 |
|---|---|
| **採らない理由(1)** | **逆流経路の恐れ。**`5V` pin給電とUSB接続を同時に行うと、秋月基板のVBUS保護diodeが無い場合に逆流経路ができる |
| **採らない理由(2)** | **帰結が破損である。**逆流は動作不良ではなく機器の破損に至りうる |
| **採らない理由(3)** | **受け入れ試験が2通り要る。**回路でのdiode有無の確認と、逆流の実測の両方を通す必要がある |
| **再検討の条件** | **案Aが実測で不成立の場合に限る。**そのうえで逆流の実測2通りに合格することを条件とする |

**案Aが不成立と判定されるまで、案Bへ進まない。**判定の前に`5V` pin給電とUSB接続を同時に行わない。

##### PiのOTG port供給能力に一次資料が無い（2026-08-22の調査）

**この項目は実測しか道が無い。**調査の結果を残す。**次に同じ空振りを繰り返さないためである。**

- Raspberry Piの Product Information Portal（`pip.raspberrypi.com`）で公開されているのは
  **Zero（非W）V1.3のreduced schematics**（文書番号 `RP-008366-DS`）**だけである。**
  **Zero W用のschematicsとproduct briefは公開されていない。**
- 非WのZeroの回路図PDFは**テキストが抽出できない**（ベクター描画）。かつ**手元はZero W V1.1で別基板**であり、
  読めたとしても根拠にならない。
- 「電源入力とOTGコネクターの電源・GNDは銅トレースのみで直結」というforumのmoderatorの記述があるが、
  **公式engineerの回答ではなく一次資料ではない。**

**したがって`未確認`という記載は妥当であり、埋めるには実測が要る。**

いずれの通電も、人が電源を落とせる状態で監視して行う。

#### Pi link経路に許容電流の公開要求を課さない（2026-08-22）

**2026-09-30追記（[#446](https://github.com/wachi-yoshitaka-11-dev/deskcat/issues/446)）。**この節の「Pi link経路」は、Pi linkがUSB serialだった当時の呼び名であり、
案AのUSB cable（PiのUSB OTG port → ESP32のMicro USB）を指す。Pi linkは今はGPIOのUARTである（`gpio-assignment.md`のtransport節）。
**案Aは今の計画ではない**（`ESP32の給電経路（最終の経路は未決定）`節の冒頭の追記）。この節と、その下の`故障電流と温度上昇はこの判定に入っていない（2026-08-26に追記）`の判定と条件は、
[#405](https://github.com/wachi-yoshitaka-11-dev/deskcat/issues/405)で案Aを採るなら要る確認として残す。

**AWG／許容電流を公開している品から選ぶという規則は、5 V ingressの大電流経路に対して書かれたものである**
（`WIRE-PWR-01`／`CABLE-PI-PWR-01`。規則の本体は`経路部品と定格`）。
**Pi link経路（案A）はその対象外とする。**理由と、代わりの判定方法を書く。

##### 対象外とする理由

| 理由 | 内容 |
|---|---|
| **電流の水準が違う** | この経路を流れるのはESP32の消費分（文献値でpeak約500 mA）であり、ingressのgate（暫定1.08 A以下。2026-10-27に40 ℃基準の0.896 A以下へ当て直した）が通す電流とは水準が違う。**この行は2026-08-22まで「桁が違う」と書いていた。**gate値が2026-08-25に1.0 Aへ下がり（`判明している最小定格が1.25 Aへ下がった（2026-08-25）`）、**peak 500 mAとの比は桁ではなくなった**ため表現を直した。**2026-08-26にgate値は1.08 Aへ動いたが（`最小定格は1.35 Aへ上がった（2026-08-26）`）、桁ではないという結論は変わらない。**この行だけでは対象外の根拠として弱い。**対象外とする判断は下の2行（上限を決めるものが違う／市販品がAWGを公開していない）が支えており、**それらはgate値に依存しない。**[#174](https://github.com/wachi-yoshitaka-11-dev/deskcat/pull/174)の決定は引き直さない |
| **上限を決めるものが違う** | 上限はUSB規格とPiのport能力で決まる。**ケーブルの太さで決まらない。**ingressの経路は最弱部品の定格で決まるのであって、ここは事情が違う |
| **市販品がAWGを公開していない** | 下表のとおり、公開されているのは線材規格（`UL2725`）までである。**規則を課しても満たす品が市販されていない** |

**市販OTGケーブルの公開情報**（2026-08-22に確認）。

| 製品 | 公開されている線材情報 | AWG |
|---|---|---|
| サンワサプライ `AD-USB18`（microBオス-Aメス、10 cm） | 線材規格 `UL2725`、ケーブル直径3.8 mm、金メッキpin | **非公開** |
| 秋月 USB OTGケーブル microB 10 cm（通販113430） | 電線外径3.8 mm | **非公開** |
| サンワサプライ `KU-RMCB1W`（A-microB 1 m） | 線材規格 `UL2725` | **非公開** |
| StarTech `UUSBOTG` | — | **確認できず**（公式spec表を取得できなかった） |

**AWG表示がある品を選べたとしても、それだけでは定格にならない。**
`HW-TBD-022`のとおり、**AWGから許容電流への換算方法が未確定である**
（`線材の許容電流をどう確定させるか`。周囲温度・束ね方・許容温度上昇を決めないと定格にならない）。

##### 代わりの判定方法

**判定は実測とし、判定量は「ESP32入力電圧が下限を割らないこと」1つにする。**

**判定はPi側とESP32側の両方を測る。片側では足りない。**

**`ADC-5V`はESP32の`GPIO33`であり、ESP32側の5 V nodeを測る。**
**Piの`PWR IN`やOTGの`VBUS`を測っていない。**
したがって`ADC-5V`だけでは、**OTG負荷がPiの入力電流を増やしたときにPi側の電圧が保たれるかを示せない。**
（この点は[PR #174](https://github.com/wachi-yoshitaka-11-dev/deskcat/pull/174)の自動reviewの指摘である。
**それまでこの節は`ADC-5V`1つで両方を判定できると書いていた。誤りである。**）

| 測る側 | 測る点 | 判定量 | 下限／停止条件 |
|---|---|---|---|
| **ESP32側** | ESP32の5 V入力（`ADC-5V`＝`GPIO33`） | **入力電圧**と**入力電流**（定常とpeak） | **4.6 V**（現物の`U2`のdatasheetによる。上表） |
| **Pi側** | **Piの`PWR IN`とOTGの`VBUS`** | **電圧**（OTG負荷をかけた状態） | **未確定。**Piの最低入力電圧の条件は別に定める必要がある（`HW-TBD-023`(a)とは別の量である） |

**Pi側の下限が定まっていないため、案Aのgateは両方を測るまで開かない。**
`ロジック電圧、電源経路、起動時 GPIO が未確認なら実機駆動しない`という規則の対象である。

**停止条件は両側に置く。**どちらかが下限を割った時点で止める。
**片側だけが下限を満たしたことを合格として扱わない。**

| 項目 | 内容 |
|---|---|
| 判定量 | **ESP32入力電圧** |
| 下限 | **4.6 V**（現物の一次資料に基づく） |
| 下限の出所 | **現物の`U2`＝UMW `LD1117-3.3`のdatasheet。**`IOUT = 1 A`（この品の定格上限）でのdropout最大1.30 Vから`3.3 + 1.30`で導く。**より軽い負荷なら要求は下がる**（`500 mA`で4.55 V、`100 mA`で4.50 V）。正は`定義した値をどの段階で照合するか`の(b)行と`3.3 V railの許容電圧範囲` |
| **`HW-TBD-023`の扱い** | **(b)(c)は2026-08-15に確定しており、この下限は暫定ではない。**ただし**`3V3` pinから取ってよい電流の上限は別途未確定である**（同(a)）。**Pi側の最低電圧の条件も別である** |
| あわせて記録する量 | **ESP32の定常電流とpeak** |

**下限そのものは現物の一次資料で確定している。**
**ただしこの判定を合格として扱えるのは、下の2点を両方測ってからである。**

##### この書き分けが変えていないこと

- **5 V ingressの大電流経路への公開要求は変えていない。**`WIRE-PWR-01`と`CABLE-PI-PWR-01`は
  引き続き`経路部品と定格`の規則の対象である。
- **`経路部品と定格`表の行を増やしていない。**Pi link経路はingressのgate対象経路ではない。
- **段階Cのgateを緩めていない。**端子台（**2026-09-09、案Bにより「変換基板」から差し替え**）、過電流保護部品、大電流経路の線材は引き続き要る。

##### 故障電流と温度上昇はこの判定に入っていない（2026-08-26に追記）

**上の`代わりの判定方法`が測るのは、正常動作時の電圧と電流だけである。**
**短絡したときの故障電流も、そのときの温度上昇も見ていない。**
[PR #235](https://github.com/wachi-yoshitaka-11-dev/deskcat/pull/235)の手動reviewの指摘であり、
[#236](https://github.com/wachi-yoshitaka-11-dev/deskcat/issues/236)で追記した。**この節はgateを開けない条件を増やす。緩めない。**

**この経路の故障電流を制限しうるものは2つだが、どちらも現時点では根拠にできない。**

| 制限しうるもの | 現在の状態 | 根拠にできない理由 |
|---|---|---|
| **PiのUSB OTG portの供給能力と保護** | **未確認** | 上の`PiのOTG port供給能力に一次資料が無い（2026-08-22の調査）`のとおりである。**Zero W用のschematicsとproduct briefは公開されておらず、port側に電流制限素子が入っているかを一次資料で確認できていない。**同節が引くforumの記述（電源入力とOTGコネクターが銅トレースのみで直結）は**一次資料ではないため根拠にしないが、もし事実なら制限素子は無いことになる。****安全側では「制限は無いかもしれない」として扱う。**「USB規格が上限を決める」は規格の話であって、この現物の保護の話ではない |
| **上流の`PROT-OC-01`**（ingressのPTC、`Ihold` 1.35 A） | **未実装**（調達の状態は[#205](https://github.com/wachi-yoshitaka-11-dev/deskcat/issues/205)が持つ） | 実装されるまで**経路に過電流保護部品が1つも無い**（`通電前の配線確認手順`が逆極性について述べているのと同じ状態である）。**加えて、この素子はPi branch全体を通す位置にあり、Pi link経路だけを守る素子ではない。**さらに`遮断までの時間`の合否判定が未確定である（**3 Aでのtrip時間はグラフから確定値として読めず（`3 Aでのトリップ時間を読み、線材と嵌合接点の判定で止まった（2026-08-27）`）、比較する「最弱部品の熱時定数」もどの経路部品についても未確定である**） |

**温度上昇は評価する根拠が無い。**この節の上にある`対象外とする理由`の`市販OTGケーブルの公開情報`の表のとおり、OTG cableはAWGを公開しておらず、
**AWGが分かったとしても許容電流への換算方法が`HW-TBD-022`で未確定である**
（周囲温度・束ね方・許容温度上昇を決めないと定格にならない）。
**したがって「この電流なら何度上がるか」を書ける材料が無い。**

**次の3つを、案Aのgateを開けない条件へ加える。**従来の条件（Pi側の最低電圧が未確定であること）に足す。
**2026-09-30追記。**この3つは、[#405](https://github.com/wachi-yoshitaka-11-dev/deskcat/issues/405)で案Aを採るなら要る確認である。

1. **PiのUSB OTG portの電流制限の有無と値**（一次資料または実測。**未確認**）
2. **短絡時にこの経路を守るものの特定**（`PROT-OC-01`の実装、またはport側の保護の確認。**どちらも未了**）
3. **温度上昇の評価方法**（`HW-TBD-022`の換算方法の確定に従属する）

**この3つは新しい値を1つも確定していない。**未確定であることを、判定に入っていない量として明示しただけである。
**値の追跡先は`HW-TBD-022`（換算方法）と`HW-TBD-021`（保護部品）であり、この節へ再掲しない。**

### ingressの電流制限（未解決）

**上限は経路上の全部品の定格のうち最小値で決まる。**connectorの一般定格ではない。
候補構成で**定格が判明している部品のうち**最小なのは`PROT-OC-01`へ選定したPTCの
`Ihold` 1.35 Aである（**2026-08-25に変換基板の1ピンあたり1.5 Aから1.25 A（ヒューズ）へ下がり、
2026-08-26にPTCへ変更して1.35 Aへ上がった。**`最小定格は1.35 Aへ上がった（2026-08-26）`）。
Micro-B connectorの一般定格（約1.8 A）を上限に使うと、1.35〜1.8 Aの測定値が
「合格」になってしまう。

#### 経路部品と定格

**最小値を出すには、経路上の部品を漏れなく並べる必要がある。**1点だけを見て
「最弱部品の80%」を名乗らない。5 Vの往路、GNDの戻り、保護部品を含めて次を確定させる。
**戻り経路は往路と同じ電流を通す**ため、往路だけを数えない。

| 経路要素 | 定格（定常電流） | 根拠 | 状態 |
|---|---|---|---|
| 入力電源 M-12001の出力 | 5 V／3 A | [秋月商品ページ](https://akizukidenshi.com/catalog/g/g112001/) | 確定（上限を決めるのは下の最小値であり、この値ではない） |
| M-12001に直付けされたcable | 5 V／3 A（製品の出力定格に含める） | **メーカーはcable導体の個別定格を示していないが、この導体はM-12001に直付けされた同一製品の一部であり、メーカーは5 V／3 Aを出力できる製品として販売している。**したがって製品の出力定格がこの区間を含むものとして扱う。**この論法はcable導体そのものに対するものであり、末端の処理（plugか、切って端子台へ受けるか）には依らない。**別途購入するcable（`CABLE-PI-PWR-01`）にはこの論法を適用しない（別製品であり、plugの定格が導体の定格を保証しない） | 確定（製品定格に含まれるものとして扱う）。**2026-09-09に人間が、この出力cableをMicro-Bプラグの手前で切り、導体を下記の端子台へ受ける構成（案B）を決定した。**終端方法（端子台へ直接ネジ止めか、はんだで線先を太らせるか）は`M-12001のcableを受ける端子台`行を参照。**ここへ再掲しない。****2026-09-10、ユーザーがcableをMicro-Bプラグの手前で切り、端子台へ接続した**（極性判定の記録は[experiment-log.md](experiment-log.md)の`EXP-012`）。**通電はまだ行っていない。****2026-09-16の訂正。**この文は`EXP-013`（2026-09-14〜09-15）より前の状態である。**通電は行った**（[experiment-log.md](experiment-log.md)の`EXP-013`）。**`通電前の配線確認手順`の充足状態は動かない**（`経路部品と定格`の`M-12001のcableを受ける端子台`行が持つ。**ここへ再掲しない**）。 |
| M-12001のcableを受ける端子台 | 6 A | **2026-09-09の人間の決定（案B）により追加した行。**[秋月 通販114217](https://akizukidenshi.com/catalog/g/g114217/)（Cixi Wanjie Electronic `WJEK254-2.54-02P-140-00A`、`定格電流：6A`／`定格電圧：150V`、`適合電線範囲(AWG)：18〜26`）。**同品は他の行（`CABLE-PI-PWR-01`をrail側で受ける端子台、分岐点）で既に選定済みの品と同一である。**着荷済み（[hardware-bom.md](hardware-bom.md) `WIRE-PWR-01`）。**2026-09-09、ユーザーが撮影したcable印字の写真により終端方法を確定した。**印字は`E520447`／`AWM STYLE 2464`／`20AWG`／`80℃`／`300V`／`VW-1`／`CU AWM I A`／`FTI`／製造元名（`Xiamen Seebest-B...`、末尾は写真で切れており未確認）。**`20AWG`は端子台の適合電線範囲（`AWG18〜26`）の内側であるため、はんだで線先を太らせる必要はなく、端子台へ直接ネジ止めする。****この`20AWG`は`hardware-bom.md`の`PSU-SERVO-01`行（Revision 61、`PSU-PI-01`＝M-12001の現物確認として記載）が2026-08-22に既に記録していた値と一致する（裏付け）。**`PSU-PI-01`自体はBOM表に独立の行を持たず、`PSU-SERVO-01`行の記述とRevision履歴でのみ扱われている。`E520447`（UL file number）／`2464`（UL flexible cordの型式）／`80℃`／`300V`／`VW-1`／`FTI`（難燃性の試験規格）／製造元名は今回新たに得た一次資料であり、`hardware-bom.md`の`PSU-SERVO-01`行へ追記する。**`20AWG`の表示は定格の主張には使わない**（換算方法が未確定。`HW-TBD-022`。既存規則を維持する）。cableの許容電流は引き続き`M-12001に直付けされたcable`行のとおり、製品出力定格5 V／3 Aに含まれるものとして扱う。**芯数（2C／4Cのような複数芯表記）は印字に無かったが、2026-09-10にcableを切った際に確認した。赤・黒の2本だけであり、それ以外の導体は無かった**（`PROTO-02`（ユニバーサル基板）への直接はんだ付けは採らない。既に端子台が確定したため対象外）。**2026-09-10、ユーザーがcableをMicro-Bプラグの手前で切り、端子台へ接続した。**極性（VBUS／GND）はプラグの金属シェルを基準にした判定が不成立だったため、手元に残る`PSU-INGRESS-01`のreceptacleを使って判定し直し、赤＝VBUS・黒＝GNDとして端子台へネジ止めした（記録は[experiment-log.md](experiment-log.md)の`EXP-012`）。**ただし`確認の方法3`(ii)が要求するテスター自体の自己確認（プローブ短絡・開放時の表示値）は記録できておらず、この判定は`通電前の配線確認手順`の記録要件を満たしていないため、同手順としては未完了のままである（詳細は`EXP-012`）。**この区間の極性は初回通電時に下流を繋ぐ前の電圧確認で確定させる（`サーボ接続前`checklist）。通電はまだ行っていない。**2026-09-16の訂正。**直前の1文は`EXP-013`（2026-09-14〜09-15）より前の状態である。**通電は行った。****ただし、同手順としては未完了であることは変わらない。**`EXP-013`の試験0は各導体が端子台のどちらの足へ出るかを同定したが、**赤＝VBUS・黒＝GNDの同定そのものは`EXP-012`のplug破片による判定に依存している**（[experiment-log.md](experiment-log.md)の`EXP-013`の試験0）。**そして`EXP-012`は、`確認の方法3`(ii)が要求するテスター自体の自己確認の表示値を記録していない**（同欄の上の記述）。**したがって同(ii)の記録要件は依然として満たされていない** | **品は確定済みで着荷済み。**この区間の実装方法は「端子台へ直接ネジ止め」で確定した（2026-09-09、`20AWG`の実測に基づく）。**2026-09-10、実装（切断・端子台への接続）を完了した。通電は未了である**。**2026-09-16の訂正。**この文は`EXP-013`（2026-09-14〜09-15）より前の状態である。**通電は行った**（[experiment-log.md](experiment-log.md)の`EXP-013`）。**`通電前の配線確認手順`の充足状態は動かない**（同じ行の`根拠`列が持つ。**ここへ再掲しない**）。 |
| 過電流保護部品が連続通電できる電流 | **1.35 A**（**2026-08-26にPTCへ変更したため、この量は保持電流`Ihold`である。**23 ℃基準） | **2026-08-26に方式をPTCへ変更した**（`方式をPTCへ変更した（2026-08-26、人間の判断）`。**2026-08-25の決定はヒューズ＋ホルダで`In` 1.25 Aだった**（`方式と品番を決定した（2026-08-25）`、Littelfuse 218 Series `02181.25HXP`の`Electrical Characteristics`表として当時の記録に残る））。Bourns `MF-R135`のdatasheet。**定格は周囲23 ℃基準であり、同datasheetの`Thermal Derating Chart`が減額を与える** | **選定済み**（[hardware-bom.md](hardware-bom.md)の`PROT-OC-01`は`Status`＝`Selected`）。**方式はPTCで確定しており、品はBourns `MF-R135`である**（2026-08-26、人間の判断）。**品番は差し替えうるが、差し替えても方式と保持電流`Ihold` 1.35 Aは変わらない**（書き分けの正本は[hardware-bom.md](hardware-bom.md)の`PROT-OC-01`行であり、ここへ再掲しない）。**調達（発注・着荷）の状態は[#205](https://github.com/wachi-yoshitaka-11-dev/deskcat/issues/205)が持つ。この表は持たない。実装は未了である。この行が経路の最小値である**（`最小定格は1.35 Aへ上がった（2026-08-26）`）。**2026-09-09、案Bの反映で入力元がM-12001のcableを受ける端子台へ変わったが、挿入位置（端子台の直後、分岐点より手前）は変わらず、この行の値も変わらない**（[`挿入位置`](#挿入位置)節を参照。**ここへ再掲しない**） |
| 逆極性保護のP-ch MOSFET（`102846`／`2SJ334`） | 30 A（`ID` DC） | **2026-08-25に確定した。**東芝 `2SJ334`。[datasheet](https://akizukidenshi.com/goodsaffix/2sj334.pdf)（2006-11-14、sha256 `c01da93643cb1cb11075d9137897655c556989de647c38368d5c487274d5da46`）。**この表の最小値に対して桁が違うため、経路の最小定格にはならない。****ただし直列素子であるため電圧降下は経路に効く。**`RDS(on)`は`VGS`=−4 V・`ID`=−15 Aで最大60 mΩであり、**1.0 Aで最大60 mV相当**の降下になる（**`VGS` ≤ −4 Vが成り立つ場合の値である。**実回路の`VGS`は未確定である。`VGSが未確定である（2026-08-27）`）。**[ADR-0016](../decisions/0016-evidence-bar-inside-the-safety-requirements.md)の区分では`B-1`（別の条件で公開されており、余裕で決着する）である。**`Bで済ませるときの条件`への当てはめは`2SJ334をB-1として通す根拠（2026-08-26）`にある。挿入位置と実装方法は`保留を同日に解除し、品番を確定した（2026-08-25、人間の判断）` | 確定。**調達（発注・着荷）の状態は[#205](https://github.com/wachi-yoshitaka-11-dev/deskcat/issues/205)が持つ。この表は持たない。**　**2026-09-09、案Bの反映で入力元が端子台へ変わったが、基板上の配置（分岐点より手前に直列）は変わらない**（`基板上の配置`節を参照。**ここへ再掲しない**） |
| 端子台から分岐点までの5 V線 | **最悪側の条件（周囲40 ℃、`η0`=0.60）で約4.2 A**（2026-10-26。`線材3行の周囲温度と条数を最悪側に置く（2026-10-26、#525）`）。参考：**周囲30℃・2条密着（`η0=0.85`）で約6.6 A**（2026-08-26にグラフから読んだ。当時は周囲温度と条数が未確定であり、`111641は許容電流が公開されている（2026-08-25）`節の表で候補を並べていた。**2026-10-26更新：`PROT-OC-01`より下流の連続電流の許容電流の値について、最悪側の条件で確定した（短絡安全は含まない）**（`線材3行の周囲温度と条数を最悪側に置く（2026-10-26、#525）`）） | **2026-08-25に品を確定した。**[秋月 通販111641](https://akizukidenshi.com/catalog/g/g111641/)（住友電気工業、絶縁体`イラックスA`、導体断面積 0.3054 mm²＝**0.3 sq**、より線12本／0.18 mm、仕上がり外径1.55 mm、温度max. 90 ℃）。**この品は許容電流が公開されている**（`線材の許容電流をどう確定させるか（2026-08-22の調査）`の`111641は許容電流が公開されている（2026-08-25）`）。**数値はグラフの読み取りであり、2026-08-26に読了した。**読んだ点は同節にある。**2026-09-09、案Bの反映で起点が「変換基板」から「端子台」へ変わったが、区間そのもの（`PROT-OC-01`／`PROT-RP-01`より下流〜分岐点）と品・数値は変わらない**（旧行名は`変換基板から分岐点までの5 V線`） | **最悪側の条件で確定（`PROT-OC-01`より下流の、連続電流の許容電流の値に限る。短絡安全は含まない。端子台から`PROT-OC-01`までは`TBD`）**（周囲温度は`MEAS-04`で実測し、配列は[#405](https://github.com/wachi-yoshitaka-11-dev/deskcat/issues/405)が決める）**2026-10-26、ユーザーが最悪側の条件での確定を承認した（`PROT-OC-01`より下流の、連続電流の許容電流の値に限る。短絡安全は含まない。端子台から`PROT-OC-01`までは`TBD`）**（`線材3行の周囲温度と条数を最悪側に置く（2026-10-26、#525）`。**ここへ再掲しない**）。 |
| `CABLE-PI-PWR-01`をrail側で受ける端子台 | 6 A | **2026-08-25に品を確定した。**[秋月 通販114217](https://akizukidenshi.com/catalog/g/g114217/)（Cixi Wanjie Electronic `WJEK254-2.54-02P-140-00A`、2.54 mm／2P、`定格電流：6A`／`定格電圧：150V`、`適合電線範囲(AWG)：18〜26`、動作温度−40〜105 ℃）。**線材の仕上がり外径1.55 mm（AWG22相当）は適合範囲内である。**`rail側の受け方は②（直付け）で確定した（2026-08-24、人間の判断）`で分けた行 | 確定。**調達（発注・着荷）の状態は[#205](https://github.com/wachi-yoshitaka-11-dev/deskcat/issues/205)が持つ。この表は持たない。**　**この端子台への`CABLE-PI-PWR-01`の適合は、2026-09-15に確認した。**`電線外径 3.8mm`は**被覆を含む cable 全体の外径であって、端子へ入れる導体の寸法ではない。**外径から適合を推論しない、という規則は変わらない。**確かめるのは導体の寸法か、実際の締結と保持であるうち、前者を満たした。**`109314`のcable本体の被覆印字（[hardware-bom.md](hardware-bom.md)の`CABLE-PI-PWR-01`行、2026-09-03記録）に`22AWG/2C`とあり、電源対（VBUS／GND）の導体は22AWGである。**端子台の適合電線範囲（`AWG18〜26`）の内側であり、適合する。**この適合は許容電流の適合ではない（`CABLE-PI-PWR-01`のB-2分類には触れない。`経路部品と定格`の同行を参照）。**この判定は`rail側の受け方は②（直付け）で確定した（2026-08-24、人間の判断）`の構成（cableを切り、導体を端子台へ入れる）に対するものである。**印字は2026-09-03と2026-09-15の2回、12日空けて独立に読み取られ、判断に効く`22AWG/2C`の部分は一致した**（`FT1`／`FTI`の表記差と`DePuK`の有無は不一致だが、いずれも本判定には効かない。表記は既存の2026-09-03記録（より鮮明な拡大写真での再確認）を正とする）。**　**`111641`（`0.3sq`、仕上がり外径1.55mm）についての適合とは別に扱う。** |
| 分岐点（logic railとservo railへ分ける接続部材） | **未確定**（端子台は6 A。**基板上の節点は未検証**） | **2026-08-25に構成を確定した。**分岐の節点はユニバーサル基板上のはんだ接続で作り、[秋月 通販114217](https://akizukidenshi.com/catalog/g/g114217/)（`定格電流：6A`／`定格電圧：150V`／`適合電線範囲(AWG)：18〜26`）を**6個**発注して、Pi branch・logic rail・servo railの3分岐の終端に使う（残り3個は予備）。**基板は[秋月 通販100517](https://akizukidenshi.com/catalog/g/g100517/)**（片面ガラス・ユニバーサル基板 Cタイプ 72×47.5 mm、FR-4、ランドピッチ2.54 mm、穴径1 mm、はんだメッキ）**を2枚**。**はんだ接続そのものに定格は無い。**この行の定格は端子台の値であり、**節点の導体は`111641`の線材が決める** | 確定。**調達（発注・着荷）の状態は[#205](https://github.com/wachi-yoshitaka-11-dev/deskcat/issues/205)が持つ。この表は持たない。**　**構成の選定と節点の検証状態は別である。**`6 A`は端子台`114217`自身の定格であって、**この基板のランド・スルーホールめっき・はんだ接続を評価したものではない。**線材`111641`の許容電流も**節点の導体についての根拠であって、基板側の根拠ではない。****配置・導通・絶縁の確認が済むまで、基板上の節点を定格付き部材としても検証済みの節点としても扱わない。**品の選定は済んでいる。**未確定なのは節点である。** |
| `CABLE-PI-PWR-01` Micro-Bオスcable | **非公開**（型番表記`2A`、被覆印字`22AWG/2C`） | **2026-08-25に品を確定した。**[秋月 通販109314](https://akizukidenshi.com/catalog/g/g109314/)（USB2.0 Aオス-マイクロBオス 0.5 m、¥150）。**仕様欄が公開しているのは`長さ：500mm`と`電線外径：3.8mm`だけであり、AWGも導体断面積も許容電流も記載が無い**（型番の`USB CABLE A-MICROB(2A L0.5m)`にある`2A`が何の定格かの説明も無い）。**メーカーは許容電流もAWGも公開していない。**cable本体の被覆印字は`22AWG/2C`である（[hardware-bom.md](hardware-bom.md)の`CABLE-PI-PWR-01`行、2026-09-03記録、2026-09-15に別セッションが独立に再読し一致）。**「非公開だから桁で余裕がある」とは書かない。**負荷側の上界は実在値で示されている。通す電流はPi branchの分だけであり、`負荷表`のRaspberry Pi Zero Wのstress時**350 mA**が上界である。**導体側の許容電流に関する選択肢は次のとおりである。**(1) 同等品の公開値（例: USB 2.0の規格が電源対に課す導体の下限）。(2) 実測（導体抵抗か温度上昇）。(3) 公開値のある品への変更。**(3)の候補として[通販107666](https://akizukidenshi.com/catalog/g/g107666/)**（Useconn `MOUSB-5BM103AS`、ケーブル取付用Micro-Bオス、`定格電圧：30V`／`定格電流(1ピン)：1A`）**を1個発注してある。**導体は`111641`（許容電流が公開されている）になる。**採用した場合、コネクタの1 Aがこの表の新しい最小値になり、上限が0.8 Aへ下がって定常見積840 mAを下回る**（**この表の最小値が幹線だけを見るのか分岐も含むのかは、この文書で定めていない**）。**2026-08-25に人間がこの行へ許容電流の公開を求めないと決めている**（「調達を止めない」という判断）。**2026-09-17訂正（[#424](https://github.com/wachi-yoshitaka-11-dev/deskcat/issues/424)）。**右の`状態`列から分類名（`B-2`）を落とし、事実（許容電流がメーカー資料に無い）へ差し替えた。**`未確定`という評価そのものは変えていない。**この経路の最小値へ算入するかどうかの判定（`確定`／`未確定`をどちらにするか）は、ingressの上限1.08 Aと安全要件5項目の「短絡」に触れるため、本Issueでは扱わない。**[tbd-register.md](tbd-register.md)の`HW-TBD-022`が`CABLE-PI-PWR-01`の許容電流評価と選定を引き続き追跡しており、この判定の引き受け先とする**（同行は「この行はcloseしない」を繰り返し明記している）。過去のRevision行も書き換えていない | **未確定**（許容電流がメーカー資料に無い） |
| `CABLE-PI-PWR-01`のMicro-B plugとPiの`PWR IN` receptacleの嵌合接点 | TBD | **2026-08-24に追加した。**②を採ってもPi側のplugとreceptacleは残るため、この嵌合接点はPi branchの電流を通す。**この行はPi branch内（Pi側）であり、ingress側とは別である。**（**2026-09-09、案Bの反映でingress側のMicro-B嵌合行は表から外れたため、参照先の記述を削除した。この行自体はingressの経路変更の影響を受けず、TBDのまま残る**。追跡は[tbd-register.md](tbd-register.md) `HW-TBD-007`）。定格は一次資料で確認する（Raspberry Pi Zero W側のreceptacle定格は`HW-TBD-007`の範囲） | **未確定** |
| servo railの5 V線 | **最悪側の条件（周囲40 ℃、`η0`=0.60）で約4.2 A**（2026-10-26。`線材3行の周囲温度と条数を最悪側に置く（2026-10-26、#525）`）。参考：**周囲30℃・2条密着（`η0=0.85`）で約6.6 A**（2026-08-26にグラフから読んだ。当時は周囲温度と条数が未確定であり、`111641は許容電流が公開されている（2026-08-25）`節の表で候補を並べていた。**2026-10-26更新：`PROT-OC-01`より下流の連続電流の許容電流の値について、最悪側の条件で確定した（短絡安全は含まない）**（`線材3行の周囲温度と条数を最悪側に置く（2026-10-26、#525）`）） | 上の`端子台から分岐点までの5 V線`と同じ品（`111641`）。**数値も同じである**（同じ品なので同じ曲線を読む） | **最悪側の条件で確定（`PROT-OC-01`より下流の、連続電流の許容電流の値に限る。短絡安全は含まない。端子台から`PROT-OC-01`までは`TBD`）**（周囲温度は`MEAS-04`で実測し、配列は[#405](https://github.com/wachi-yoshitaka-11-dev/deskcat/issues/405)が決める）**2026-10-26、ユーザーが最悪側の条件での確定を承認した（`PROT-OC-01`より下流の、連続電流の許容電流の値に限る。短絡安全は含まない。端子台から`PROT-OC-01`までは`TBD`）**（`線材3行の周囲温度と条数を最悪側に置く（2026-10-26、#525）`。**ここへ再掲しない**）。 |
| GND戻り経路（各railからstar pointまで） | **最悪側の条件（周囲40 ℃、`η0`=0.60）で約4.2 A**（2026-10-26。`線材3行の周囲温度と条数を最悪側に置く（2026-10-26、#525）`）。参考：**周囲30℃・2条密着（`η0=0.85`）で約6.6 A**（2026-08-26にグラフから読んだ。当時は周囲温度と条数が未確定であり、`111641は許容電流が公開されている（2026-08-25）`節の表で候補を並べていた。**2026-10-26更新：`PROT-OC-01`より下流の連続電流の許容電流の値について、最悪側の条件で確定した（短絡安全は含まない）**（`線材3行の周囲温度と条数を最悪側に置く（2026-10-26、#525）`）） | 同上（`111641`）。`GND topology`節の構成に従う。**戻り経路は往路と同じ電流を通す** | **最悪側の条件で確定（`PROT-OC-01`より下流の、連続電流の許容電流の値に限る。短絡安全は含まない。端子台から`PROT-OC-01`までは`TBD`）**（2026-10-26。品は確定、数値は2026-08-26に読了。`T`は`MEAS-04`で実測する量である。Owner: Human。配列は[#405](https://github.com/wachi-yoshitaka-11-dev/deskcat/issues/405)が決める。**導体の許容電流評価そのものは2026-08-29の人間承認が及ぶ範囲であり新規判断を要さない**（`HW-TBD-022`を閉じるために残っていることの(4)を参照。**ここへ再掲しない**）。**`GND topology`節のstar point構成の確認（`方式1で残っている未解決3点`の3）は別に残る**。**2026-09-12、「段階B-1での通電確認」という記述を削除した。**`方式1の記録係をこのtopologyへ足すとき（HW-TBD-034 作業3）`が段階B-1の`確認できない`側にstar pointを置いており、両立しなかった。**段階B-1で何を確認できるかの正は`方式1の記録係をこのtopologyへ足すとき（HW-TBD-034 作業3）`であり、ここへ再掲しない**）**2026-10-26、ユーザーが最悪側の条件での確定を承認した（`PROT-OC-01`より下流の、連続電流の許容電流の値に限る。短絡安全は含まない。端子台から`PROT-OC-01`までは`TBD`）**（`線材3行の周囲温度と条数を最悪側に置く（2026-10-26、#525）`。**ここへ再掲しない**）。**上の「新規判断を要さない」が及ぶのは2条密着までで、最悪側の条件は2026-10-26のユーザー承認が及ぶ（`PROT-OC-01`より下流の連続電流の許容電流の値に限る。短絡安全は含まない）。** |
| servo rail低側のshunt抵抗 | 電力定格5 W／0.1 Ωから逆算して約7 A相当。**メーカーが電流定格として示した値ではない** | `hardware-bom.md` MEAS-01。servo戻り専用であり、logic側は通らない | Selected |

**未確定が1つでも残る間、上限を確定値として扱わない。**現時点で言えるのは
「判明している最弱部品が`PROT-OC-01`のPTC（`MF-R135`）の`Ihold` 1.35 Aであるから、上限は
**その80%である1.08 A以下**である」までであって、1.08 Aそのものではない。**2026-10-27：温度の基準を40 ℃へ揃え、上限は0.896 A以下へ当て直した**（`上限を40 ℃基準の0.896 Aへ当て直す（2026-10-27、#405）`）。未確定の要素が
これより低い定格を持てば上限は下がる。**2026-09-12訂正。**旧文は「**嵌合接点の定格は判明している（1.5 A）が、その他の未確定要素**
（`CABLE-PI-PWR-01`の嵌合接点など）**が残っている**」だった。**その1.5 Aは変換基板`PSU-INGRESS-01`側の
嵌合接点の値であり、2026-09-09の案Bによりingress側のMicro-B嵌合行は上表から外れている。**
**上表に残る嵌合接点はPi側の1行だけで、その定格は`TBD`である**（`CABLE-PI-PWR-01`のMicro-B plugと
Piの`PWR IN` receptacleの嵌合接点）。**そのほかにも分岐点・`CABLE-PI-PWR-01`・線材3行の未確定が残る。****2026-10-26更新：線材3行は、`PROT-OC-01`より下流の連続電流の許容電流の値について最悪側の条件で確定した（短絡安全は含まない）**（`線材3行の周囲温度と条数を最悪側に置く（2026-10-26、#525）`）。**端子台から`PROT-OC-01`までの区間、分岐点、`CABLE-PI-PWR-01`の未確定は残る。**
**したがって未確定は現に残っている。**
**あわせて、上表に現れていない経路要素の候補が1つあった**（次節`rail側の受け方は②（直付け）で確定した（2026-08-24、人間の判断）`）。**②を採ったため、その要素は上表に現れない。**

#### rail側の受け方は②（直付け）で確定した（2026-08-24、人間の判断）

**上表を読んだだけでは、最弱部品が1.5 Aの要素1つ（嵌合接点、変換基板側で決まる）だと読める。
そう読むと「変換基板を別品へ替えれば上限が上がる」という逃げ道があることになるが、rail側の
実装方法によってはその逃げ道が塞がりうる。**この節はその条件と、決定の経緯を残すために置く。
**②を採ったため、逃げ道は塞がっていない**（`②を採ったことで`以下）。

**なおこの節は2026-08-24時点の記述である。**2026-08-25に`PROT-OC-01`を選定した結果
**判明している最小定格はヒューズの1.25 Aへ下がり、2026-08-26に方式をPTCへ変更して
1.35 Aへ上がった**（`最小定格は1.35 Aへ上がった（2026-08-26）`）。**いずれの値も嵌合接点の
1.5 Aを下回るため、変換基板を交換しても上限は上がらないという結論は変わらない。**下の
逃げ道の議論は、当時の最小値である嵌合接点の1.5 Aについてのものである。

`CABLE-PI-PWR-01`（breadboard rail → Piの給電）をrail側で受ける方法が決まっていなかった。

| 方法 | 上表への影響 | 採否 |
|---|---|---|
| ① rail側にAメスの口を立て、市販のA-microBケーブルを挿す | **経路要素が1つ増える。**候補品の定格は`定格電流(合計)：1.5A`であり、**通過電流としていくらになるかは「合計」の定義が公開されていないため確定しない**（次の小節） | **採らない** |
| ② ケーブルを加工し、線をrailへ直付けする | この要素は経路に現れない。導体の定格は`CABLE-PI-PWR-01`の行で扱う | **採用（2026-08-24）** |

**2026-08-24に人間が②を採ると決定した。**終端は端子台のねじ止めとし、その部材は`WIRE-PWR-01`で
選ぶ（**未選定**）。**したがってこの要素は`経路部品と定格`表に現れない。購入待ちリストへも足さない。**
②なら購入自体が不要であり、起票も要らなくなった。

##### ①の候補品の定格は「1ピン」ではなく「合計」だった（2026-08-24の訂正）

**この節は2026-08-24まで、①の候補品の定格を「1ピンあたり1.5 A」と書いていた。誤りである。**
商品ページを一次資料として確認した結果、表記は**合計**であった。

| 部品 | 商品ページの表記 | 出典 |
|---|---|---|
| ①の候補（「USBコネクターDIP化キット (Aメス)」、2.54 mmピッチ、¥140） | **`定格電流(合計)：1.5A`** | [秋月 通販107429](https://akizukidenshi.com/catalog/g/g107429/)（2026-08-24取得） |
| `PSU-INGRESS-01`（「電源用マイクロUSBコネクターDIP化キット」、¥130） | **`定格電流(1ピン)：1.5A`** | [秋月 通販110972](https://akizukidenshi.com/catalog/g/g110972/)（2026-08-24取得） |

**両者は同値ではない。**したがって、この節が置いていた**「①を採っても上限は動かない。1.5 Aは
`PSU-INGRESS-01`と同値であり、最小値は変わらない」という主張を撤回する。**誤った定格表記の上に
立っていた。

**「合計」の定義は商品ページに無い。**ピンの総和という読みなら、電源経路は5 Vの往路とGNDの戻りで
2ピンを使うため通過電流の上限は`1.5 A ÷ 2`になり、`窓が閉じる境界（2026-08-22の計算）`の上限も
その値まで下がる。コネクタ全体の通過電流という読みなら同値である。**どちらとも断定しない**
（[AGENTS.md](../../AGENTS.md) 推測禁止）。**②を採ったため、この未確定は経路に入らない。**
将来①へ戻す場合は、メーカーへ「合計」の定義を確認することがその前提になる。

**あわせて分かったこと**: `PSU-INGRESS-01`は商品名が「**DIP化キット**」であり、商品ページは
基板寸法図を持つ。**組み立てを要する品である。**商品ページは組立手順もセット内容も明記して
おらず、この時点では「未組立である」と断定できる記載が無かった（[AGENTS.md](../../AGENTS.md) 推測禁止）。
**2026-09-03の着荷時現物確認で未組立であることを確定した**（正は[hardware-bom.md](hardware-bom.md)の
`PSU-INGRESS-01`行。同梱物は未組立のキットであり、緑色の小基板・ピンヘッダ・microBメス
receptacle・乾燥剤が個別部品として同一袋に入っている。**ここへ再掲しない**）。
組み立てに要る工具は同文書で扱う。

**②を採ったことで、`HW-TBD-021`の前提から①の制約が消えた。**保護部品の選定は「判明している
最弱部品の定格」を上限に置く（**上限の数値はここへ再掲しない。**正は
`最小定格は1.35 Aへ上がった（2026-08-26）`。2026-08-25時点の記録は
`判明している最小定格が1.25 Aへ下がった（2026-08-25）`にある）。
②では**rail側の**1.5 Aの要素が現れない。**ただし変換基板を交換するだけで上限が上がるとは言えない。**
Pi側のplugとreceptacleの嵌合接点、`CABLE-PI-PWR-01`の導体、`WIRE-PWR-01`の線材と接続部材が
いずれも`TBD`であり、**変換基板の交換で外れるのは「現時点で判明している」最小値だけである**
（`経路部品と定格`）。

**なお、この節に出てくる1.5 Aは変換基板の候補品の値であり、品が変われば変わる**（`経路部品と定格`）。

#### 線材の許容電流をどう確定させるか（2026-08-22の調査）

**この節は2026-08-22の調査であり、当時の件数のまま残す。**当時は上表の`TBD` 6行のうち5箇所が
`WIRE-PWR-01`と`CABLE-PI-PWR-01`の未選定に起因していた（残り1行は`過電流保護部品が連続通電できる電流`で、
`PROT-OC-01`の未選定に起因し`HW-TBD-021`の側で扱っていた）。**2026-08-25に品を確定させたため件数は変わった。
現在の状態は上表そのものを見る**（`111641は許容電流が公開されている（2026-08-25）`）
（`HW-TBD-022`）。**選定の規則は「公称許容電流が公開されている部品を選ぶ」である。**
その規則を満たす経路を調べた。**選定はしていない。**

##### 販売元が公開しているのは計算式であって数値ではない

秋月電子は電線の製品ページから、住友電工の`SUPPLEMENTARY DATA 許容電流計算式`（2014.02）へ
リンクしている（取得物の sha256 は
`31f3293f0c0c84c527eee9f1f5b4800fb5aa759706ccb5d6ec85be4ce1326dc8`）。同資料の式は次のとおりである。

```text
I = η0 * sqrt( (T1 - T) / (r * R) )
  r  = r0 * { 1 + a*(T1 - 20) }        a(銅) = 0.00393
  R  = R1 + R2
  R1 = (P1 / 2pi) * ln(d2/d1)          [degC cm/W]
  R2 = 10 * P2 / (pi * d2)             [degC cm/W]
```

| 記号 | 意味 | 同資料が与える値 |
|---|---|---|
| `T1` | 電線の最高許容温度 | 一般PVC 60 ℃／耐熱PVC 80・105 ℃ ほか材料別の表がある |
| `T` | 周囲温度 | **使う側が決める** |
| `P1` | 絶縁被覆の固有熱抵抗 | PVC 600、PE 450、ナイロン 450 ほか材料別の表がある |
| `P2` | 表面放散の固有熱抵抗 | `500 + 10*d2`（`d2 < 40`のとき） |
| `η0` | 多条布設の低減率 | 1条・中心間隔`S=d`で1.00。条数と間隔の表がある |
| `d1`／`d2` | 導体外径／電線外径 | **電線の仕様から取る** |
| **`r0`** | **20 ℃における導体抵抗（規格値）** | **同資料は与えない。電線の仕様から取る** |

**したがって`r0`が公開されていない製品では、この式を評価できない。**

##### 候補として見た製品では`r0`が公開されていない

[秋月 106753](https://akizukidenshi.com/catalog/g/g106753/)（耐熱ビニル絶縁電線 UL1015 AWG18）の
製品ページが公開しているのは次までである。

| 項目 | 値 |
|---|---|
| 導体断面積 | AWG18 |
| 導体直径 | 1.21 mm |
| 仕上がり外径 | 2.8 mm |
| 構成導体 | 34本／0.18 mm |
| 定格電圧 | 600 V |
| 温度max. | 105 ℃ |
| 絶縁体材質 | 塩化ビニル |
| 導体種類 | スズメッキ軟銅 |

**`導体抵抗`と`許容電流`のいずれも公開されていない**（2026-08-22に確認）。
`d1`／`d2`／`T1`／`P1`は揃うが、**`r0`が無いため式を評価できない。**
**したがってこの製品は、現時点では選定規則を満たさない。**

##### 第三者の公開値は食い違っており、条件も揃っていない

同じ`UL1015 AWG18`について、電線の製造者ではない出典が許容電流を公開しているが**値が一致しない。**

| 出典 | 許容電流 | 条件の記載 |
|---|---|---|
| 検索結果に現れた記載 | 19.2 A | 30 ℃ |
| [電線ナビ](https://www.densen-navi.com/item/ul1015/ul1015-awg18)（発行 KYOWA HARMONET） | **18 A** | **無い** |

**どちらも電線の製造者ではなく、算出条件も一致していない。**
**したがって`WIRE-PWR-01`の定格としてこの数値を採らない。**

##### それでも判断に効くことが1つある

**上の値がどちらであっても、AWG18級の線材は経路の既知の最小値より一桁大きい。**
現時点の既知の最小は`PROT-OC-01`のPTCの`Ihold` 1.35 Aである（上表。**2026-08-25に嵌合接点の
1.5 Aから1.25 A（ヒューズ）へ下がり、2026-08-26にPTCへ変更して1.35 Aへ上がった**）。
**したがって、AWG18級を選ぶ限り線材が最弱部品になる可能性は低い。**

**これは非メーカー値との比較であり、定格の確定ではない。**
上表の`TBD`は埋めない。**「線材は最弱ではない」と確定するには、選んだ製品の公開値が要る。**

##### 線材と接続部材で受け入れ条件が違う

**`r0`は導体の証拠であって、接続部材の接点定格を証明しない。**
`許容電流計算式`は**絶縁電線の導体**についての式であり、接点の発熱や嵌合の抵抗を扱っていない。
**したがって同じ条件で両方を判定できない。**
（この区別は[PR #175](https://github.com/wachi-yoshitaka-11-dev/deskcat/pull/175)の自動reviewの指摘である。
**それまでこの節は両方へ同じ条件を課していた。**）

| 対象 | 受け入れ条件 |
|---|---|
| **線材・cable**（`WIRE-PWR-01`、`CABLE-PI-PWR-01`の導体） | **許容電流そのもの**、または**製造者が公開する`導体抵抗`（`r0`）**のいずれか。後者なら上の式で評価でき、**周囲温度と条数を明示した導出**として記録できる |
| **接続部材**（分岐点の部材、connector、端子台） | **製造者が公開する電流定格。**`r0`では代用できない。**接点の定格は導体抵抗から出ない** |

**plugの定格で導体を代用しない**という既存の規則は、この区別と同じ向きである。
**cableは導体と接点の両方を持つため、両方の条件を満たす必要がある。**

##### 111641は許容電流が公開されている（2026-08-25）

**上の2小節は`UL1015 AWG18`（秋月 通販106753、絶縁体は塩化ビニル）についての調査である。
その結論は当該製品については変わらない。****ただし別の製品では事情が違う。**

**2026-08-25に`WIRE-PWR-01`の線材を[秋月 通販111641](https://akizukidenshi.com/catalog/g/g111641/)
（住友電気工業「耐熱電子ワイヤー 1m×10色 導体外径0.75mm(AWG22相当)」）で確定した。**
**この品は`r0`ではなく許容電流そのものが公開されている。**

**根拠は上と同じPDFの2ページ目である。**取得物の sha256 は
`31f3293f0c0c84c527eee9f1f5b4800fb5aa759706ccb5d6ec85be4ce1326dc8` で、
**2026-08-22に記録した値と一致する。同一文書である**（2026-08-25に再取得して照合した）。
**上の2小節が使っていたのは1ページ目の式だけであり、2ページ目を見ていなかった。**

2ページ目は`各種電線の許容電流 / Permissible Current of Various Kinds of Electronic Wires`として
4つのグラフを載せる。そのうち1つが**`イラックス®A電線（定格温度90℃）`**で、
`0.2sq`／`0.3sq`／`0.5sq`／`0.75sq`／`1.25sq`／`2.0sq`／`3.5sq`の曲線を持つ。
横軸は`最高許容温度と周囲温度の差（℃）`、縦軸は`許容電流（A）`である。

| 製品ページの記載 | グラフ側 |
|---|---|
| 絶縁体材質 **`イラックスA`** | グラフの対象が`イラックス®A電線` |
| 導体断面積 **`0.3054 mm²`** | 曲線 **`0.3sq`** |
| 温度max. **`90 ℃`** | グラフの但し書き`定格温度90℃` |

**3点とも一致する。したがってこの品の許容電流はメーカーが公開している。**
`線材と接続部材で受け入れ条件が違う`の表が線材へ課す条件
（**許容電流そのもの、または`r0`のいずれか**）を、**許容電流の側で満たす。**

**多条布設の低減率`η0`も同PDFの1ページ目にある。**5 Vの往路とGND戻りを束ねるなら**2条**であり、
中心間隔`S=d`で`η0 = 0.85`、`S=2d`で`0.95`、`S=3d`で`1.00`である。

**2026-08-26に数値を読んだ。**両軸が対数目盛のグラフであるため、`0.3sq`曲線の両端を
400 dpiで描画して pixel 座標から読み、上の式が`I`を`T1 - T`の平方根に比例させることを使って換算した。

| 読んだ点 | `T1 - T` | 許容電流 |
|---|---|---|
| 曲線の左端 | 約 10.8 ℃ | 約 3.15 A |
| 曲線の右端 | 約 97.4 ℃ | 約 10.0 A |

**2点から求めた傾きは 0.525 で、理論値 0.5 と読み取り誤差の範囲で一致する。**
以下は理論傾き 0.5 で換算した。**基準点は`I(T1 - T = 100 ℃) = 10.0 A`である**
（読み取り幅は約 9.6〜10.0 A。左端から換算すると 9.59 A、右端から換算すると 10.13 A）。

`T1 = 90 ℃`は商品ページの`温度max.`とグラフ表題の`定格温度90℃`が一致する。

| 周囲温度`T` | `T1 - T` | 許容電流（`η0 = 1`、単条） | 2条`S=d`（`η0 = 0.85`） |
|---|---|---|---|
| 25 ℃ | 65 ℃ | 約 8.1 A | 約 6.9 A |
| 30 ℃ | 60 ℃ | 約 7.8 A | **約 6.6 A** |
| 40 ℃ | 50 ℃ | 約 7.1 A | 約 6.0 A |

**周囲温度`T`は決めていない。**上は候補を並べたものである。**2026-10-26更新：周囲温度は40 ℃に置いた**（`線材3行の周囲温度と条数を最悪側に置く（2026-10-26、#525）`）。
**`T`を決めるのは運用の判断であり、`MEAS-04`で実測する量である。Owner: Human。**
**条数と配列も決めていない**（実配線が存在しない。2026-10-26更新：条数は最悪側の条件で置いた。配列は#405が決める）。追跡は[HW-TBD-022](tbd-register.md)。

**有効数字は2桁までとみなす。**メーカーが数値表を出しておらず、
**グラフからの読み取りがこの品について得られる最良の精度である。**

**この節が主張しないこと。**

- **（2026-08-26時点）線材が最弱部品でないとは、まだ言えない。**2026-08-26に数値を読んだが、**周囲温度`T`と条数・配列が未確定であるため、上表の該当行は読み取り条件つきの値である。**`PROT-OC-01`は同じく2026-08-26にヒューズからPTC(`Ihold` 1.35 A)へ変更されているため、比較の基準は1.35 Aである(`HW-TBD-021`の状態欄が正。ここへ再掲しない)。読んだ範囲（周囲25〜40℃、2条密着で約6.0〜6.9 A）はいずれも1.35 Aより大きいが、**周囲30℃で約4.9倍、40℃の最悪ケースで約4.4倍であって桁ではない。**`ADR-0016`の`B`が求める余裕として足りるかは、2026-08-29に人間がこの倍率を「足りる」側の判断として採用した(経緯は[tbd-register.md](tbd-register.md)の`HW-TBD-022`の該当追記が正。ここへ再掲しない)。**2026-10-26更新：最悪側の条件で、ユーザーが`PROT-OC-01`より下流の連続電流の許容電流の値の確定を承認した（短絡安全は含まない）**（`線材3行の周囲温度と条数を最悪側に置く（2026-10-26、#525）`）。
- **`UL1015 AWG18`について上の2小節が書いたことを撤回しない。**同製品は絶縁体が塩化ビニルで、
  2ページ目のどのグラフの対象でもない（グラフは`イラックスA`／`UL3443`／`UL10368`／`UL3385`である）。
- **接続部材（端子台）はこの根拠では埋まらない。**端子台`114217`は
  **製造者が公開する電流定格6 A**で別に満たしている（`経路部品と定格`）。

##### `HW-TBD-022`を閉じるために残っていること

1. ~~**`WIRE-PWR-01`**: 上表の**線材・cableの条件**を満たす品を選ぶ。~~
   **2026-08-25に`111641`で選定した**（`111641は許容電流が公開されている（2026-08-25）`）。
   **残るのはグラフからの許容電流の読み取りである。**
2. ~~**分岐点の接続部材**~~ **2026-08-25に構成を確定した。**
   分岐の**節点**は`PROTO-02`（ユニバーサル基板、秋月 通販100517）上の**はんだ接続**で作り、
   端子台`114217`（**製造者が公開する電流定格6 A**）を6個発注して各branchの終端に使う
   （Pi branch・logic rail・servo railの3分岐＋予備3）。
   **1極あたり3本を1つの端子で受けるのではなく、節点を基板上に作って各branchを別々の端子台で終端する。**
   **はんだ接続そのものに定格は無く、節点の導体は`111641`が決める。**
   **残るのは基板上の配置である**（着荷後に現物合わせ。Owner: Human）。
3. ~~**`CABLE-PI-PWR-01`**: Micro-Bオスcable。**未調査。**~~
   **2026-08-25に秋月 通販109314で確定した。****ただし同品は許容電流もAWGも公開しておらず、
   上表の線材・cableの条件を満たさない。****同日、人間がこの行へ許容電流の公開を求めないと決めた**
   （根拠の置き方と、`Proposed`のADRへ依拠しない理由は`経路部品と定格`の同行）。
   **したがってこの項目は「条件を満たして閉じる」のではなく「AIが条件を課さないことを提案し、人間が承認して閉じる」。**
   **Pi側の嵌合接点の定格は`TBD`のまま残る。**
4. **GND戻り経路**: 往路と同じ電流を通すため、同じ規則で選ぶ。**線材は`111641`で同じ品であり、
   許容電流の読み取り値も往路と同じ**（周囲25〜40℃・2条密着で約6.0〜6.9 A。Revision 77が
   往路2本とGND戻りの3行へ同時に読み取り値を入れている）。**導体の許容電流評価について、
   2026-08-29に人間が下した「`PROT-OC-01`の`Ihold` 1.35 Aに対し約4.4〜4.9倍の余裕は足りる」
   という判断の対象は`WIRE-PWR-01`（導体）そのものであり、往路・戻り路を区別していない。
   したがって導体の評価については新規の人間判断を要さない**（AI判断としてここに明記する）。**2026-10-26：この判断が及ぶのは2条密着までである。最悪側の条件は、同日のユーザー承認が及ぶ（`PROT-OC-01`より下流の連続電流の許容電流の値に限り、短絡安全は含まない。`線材3行の周囲温度と条数を最悪側に置く（2026-10-26、#525）`）。**
   **ただし残る2点は別である。**(a) **周囲温度`T`と条数・配列は未確定のまま残る**（2026-09-08時点。**2026-10-26更新：`PROT-OC-01`より下流の連続電流の許容電流の値について、最悪側の条件で確定した（短絡安全は含まない）。配列は[#405](https://github.com/wachi-yoshitaka-11-dev/deskcat/issues/405)が決める。**`T`は
   `MEAS-04`で実測する量である。Owner: Human）。(b) この行は`GND topology`節の構成に従うが、
   **同節のstar point構成そのものの確認は完了していない**（**2026-09-09、案Bにより阻害要因を「変換基板が揃うまで」から「端子台へcableを切って留めるまで」へ差し替え**。**2026-09-12更新。**旧文の阻害要因は「端子台へcableを切って留めるまで」で、**その作業は2026-09-10に完了した**（[experiment-log.md](experiment-log.md)の`EXP-012`。**通電は未了**）。**この項目が未解決であることは変わらない。****残る理由をこの訂正では判定しない**（次のPull Requestで扱う）。あわせて「段階B-1での通電確認」という記述を削除した。`方式1の記録係をこのtopologyへ足すとき（HW-TBD-034 作業3）`と`方式1で残っている未解決3点`の3が正であり、**ここへ再掲しない**）。
   **2026-09-08時点では、この行は「確定した」とは書けなかった。2026-10-26更新：(a)は`PROT-OC-01`より下流の連続電流の許容電流の値について、最悪側の条件で確定した（短絡安全は含まない）。(b)のstar point構成の確認は[#405](https://github.com/wachi-yoshitaka-11-dev/deskcat/issues/405)が持ち、残る。`GND戻り経路`行の「確定」は導体の許容電流についてであり、star point構成の確認を含まない**（正は`GND戻り経路（各railからstar pointまで）`行）。

**2026-08-22時点のこの節は選定していなかった。**選定規則を評価可能な形にし、候補が満たすべき
公開項目を特定しただけである。**線材の選定は2026-08-25に行った**（上記）。

##### 線材3行の周囲温度と条数を最悪側に置く（2026-10-26、[#525](https://github.com/wachi-yoshitaka-11-dev/deskcat/issues/525)）

**実配線が無いため、実測ではなく、条件を最悪側に置いたときの値を整理したものである。**`111641は許容電流が公開されている（2026-08-25）`の読み取りに、`η0`の表を読み直して当てた。

- **取得物。**住友電工`SUPPLEMENTARY DATA 許容電流計算式`（2014.02。[秋月 PC-CALCULATION-FORMULA.pdf](https://akizukidenshi.com/goodsaffix/PC-CALCULATION-FORMULA.pdf)）。sha256 `31f3293f0c0c84c527eee9f1f5b4800fb5aa759706ccb5d6ec85be4ce1326dc8`。**2026-10-26に再取得し、2026-08-25の記録と一致した。**1ページ目の`η0`の表を画像で読み直した。
- **`η0`（多条布設の低減率の表。材料にも`T1`にもよらず、中心間隔`S=d`の行）。**`T1`=90 ℃は別の表（最高許容温度）の値である。1条 1.00、2条 0.85、3条 0.80、4条（2×2）0.70、6条（1列）0.70、6条（2×3）0.60。**8条、9条、12条は`S=d`に値が無い**（表は`ー`）。`S=2d`は8条 0.85、9条 0.80、12条 0.80。
- **周囲温度。**40 ℃に置く。**M-12001の動作温度の上限（[秋月 g112001](https://akizukidenshi.com/catalog/g/g112001/)の`動作温度max.：40℃`）に揃えた設計上の仮定であり、室温の実測ではない。**実測する量（`MEAS-04`）は変わらない。
- **値。**40 ℃の単条は約7.1 A（上の表。換算式では7.07 A）。**`η0`=0.60を掛けると約4.2 A**（25 ℃は8.06 A×0.60で約4.8 A）。有効数字は2桁とみなす。
- **条数の条件。**8本以上を`S=d`で束ねない（表に値が無い）。6本以内の`S=d`か、12本以内の`S=2d`以上で配線する。表にある条数は1、2、3、4、6、8、9、12だけで、5、7、10、11条の束は、次に多い条数の値を使う（表の値は条数が増えても上がらない）。13本以上は束ねない。**実配線の配列は[#405](https://github.com/wachi-yoshitaka-11-dev/deskcat/issues/405)が決める。**
- **この値で、`PROT-OC-01`より下流の線が、連続電流について最弱部品にならない理由。**最悪側の約4.2 Aは、`PROT-OC-01`の`Itrip`（23 ℃で2.70 A、40 ℃で2.24 A。`datasheetが与える量`）より大きい。**比べる軸は「どの部品より先に線材が限界に達するか」である。****これが言えるのは、連続して流れる電流についてである。**下流で短絡したときの電流はM-12001の公開されていない特性で決まり、PTCが実際に止めるまでの時間（トリップ時間）を線材と比べる評価は、この節では行っていない。**したがって下流の「確定」は、連続電流の許容電流の値（約4.2 A）の確定にとどめ、短絡安全（短絡しても線が最弱にならないこと）は確定の範囲に含めない。**`servo-safety-limits.md`の`承認の状態`は、同じ線材について、短絡時の電流がM-12001の出力定格3 Aを超えない場合だけ経路が守れるとしている。
- **`PROT-OC-01`より上流の区間は確定しない。**`挿入位置`は`PROT-OC-01`を端子台の直後に置き、段階Cの`MEAS-01`は端子台の直後・`PROT-OC-01`の手前に入る。端子台から`PROT-OC-01`までの区間（測定中の`MEAS-01`を含む）と、その区間の短絡の電流が戻る経路は、`PROT-OC-01`の保護の外である。M-12001の短絡時の特性は公開されておらず（`servo-safety-limits.md`の`承認の状態`）、出力定格3 Aは短絡時の電流の上限ではない。**この区間は`TBD`とし、[#405](https://github.com/wachi-yoshitaka-11-dev/deskcat/issues/405)の構成で扱う。**
- **前の判断との違い。**2026-08-29の人間の判断は、2条密着（周囲30 ℃で約4.9倍、40 ℃の最悪ケースで約4.4倍）を対象にしていた。この節の条件は上の「条数の条件」のとおりで、前提が変わっている。
- **2026-10-26、ユーザーが、この条件で、`PROT-OC-01`より下流の線について上の3行を確定にすることを承認した。**同日、確定を下流に限り、上流を`TBD`にすることを承認し、さらに下流の確定を連続電流の許容電流の値に限り、短絡安全を含めないことも承認した。周囲温度40 ℃は設計上の仮定で、`MEAS-04`で実測する。配列は[#405](https://github.com/wachi-yoshitaka-11-dev/deskcat/issues/405)が決める。

##### Pi側の嵌合接点と`CABLE-PI-PWR-01`：USB-IFの原本で分かったこと（2026-10-26、[#525](https://github.com/wachi-yoshitaka-11-dev/deskcat/issues/525)）

**どちらの行も埋まらない。**何が分かり、何が足りないかを記録する。

- **取得物。**[USB 2.0 Specification一式](https://www.usb.org/sites/default/files/usb_20_20250603.zip)（2026-10-26取得、zipのsha256 `5fe9c53c04033818af396e8852b3acbca5c3a76ba92fab549fd81cd0ea7b3692`）。中の`Micro-USB_final/Micro-USB_1_01.pdf`（MicroUSB Specification to the USB 2.0 Specification Revision 1.01、2007-04-04。sha256 `64157f55767eb32ab0d999e0ddff637744d0feaf316f05203826e7e0b0a9d883`）と`usb_20.pdf`（Revision 2.0。sha256 `d39698a33486c399124af92bd02e4f978fd9a836b5cf4e52e6e4633eb1d89f61`）を読んだ。
- **Micro-Bの接点の定格。**Micro-USB仕様の`5.3.2`は、contact 1と5に1.8 A（同時にcontact 2、3、4に0.5 A）、周囲25 ℃で測り、どの点も温度上昇が+30 ℃を超えないこと、を要求する。**これは仕様に適合する接続器が満たす要求であり、`メーカーが許容電流を定義した温度上昇条件`の形をしている。**
- **それでも埋まらない理由。**Pi Zero W上のreceptacleの型番、製造元、この仕様への適合の主張が、公開資料から見つかっていない（Zero Wのreduced schematicsは取得できない。`(a)の一次資料は存在しない`）。**`同等品`の条件1（どの品の値かを記録する）を満たせない。**1.8 Aはこの品の値と言えない。
- **cableの導体。**USB 2.0仕様の`6.6.1`は電源対を28〜20 AWGとし、`6.6.3`の`Table 6-6`が導体抵抗の上限を与える（22 AWGは5.74 Ω/100 m）。**導体の許容電流の規定は無い。**
- **上界の計算（参考）。**Pi branchの350 mA（`負荷表`のstress時）、0.5 m、往復で、`0.0574 Ω × 0.35 A ≒ 20 mV`、`0.35² × 0.0574 ≒ 7 mW`。**前提は、現物のcableが22 AWG相当で規格の導体抵抗を満たすことであり、確認していない。**被覆印字は`22AWG/2C`だが規格適合の表示は無い。**この計算は許容電流の値ではない。**
- **足りないもの。**(1) Pi上のreceptacleの特定（現物の確認であり、人の作業）。(2) 現物のcableの導体抵抗（公開値か実測）。**5項目に効くTBDを、残るriskとして受け入れない**（[hardware-safety-policy.md](../governance/hardware-safety-policy.md)の`5項目の中での根拠の水準`）。

##### ingressのshuntの挿入降下とU2の入力余裕の見積もり（2026-10-26、[#525](https://github.com/wachi-yoshitaka-11-dev/deskcat/issues/525)）

**見積もりである。**値は既存の節の値を、上限1.08 Aで並べ直した。1.08 Aは、2026-10-27に当て直した上限0.896 Aより大きい電流である。ただしPTCの抵抗は23 ℃の値で、40 ℃の値は無いため、降下の見積もりが安全側に残るとは言えない。`MEAS-01`を入れるのは測定中だけである。

| 項目 | 値 | 出典と扱い |
|---|---|---|
| 公称 | 5 V | M-12001の商品ページ（`出力電圧：5VDC`）。**出力電圧の誤差とリップルの公開値は同ページに無い**（2026-10-26確認） |
| `MEAS-01` | 0.1 Ω × 1.08 A = 108 mV（許容差±5 %で最大113 mV） | はんだ付けしない場合の扱い。**ブレッドボードに挿すと接点抵抗が加わり、この値を上限にできない**（下） |
| `PROT-OC-01`（PTC） | 初期 0.065〜0.115 Ω → 最大124 mV。トリップ後 0.17 Ω → 184 mV | `datasheetが与える量` |
| `PROT-RP-01`（MOSFET） | 最大60 mΩ × 1.08 A = 65 mV | `RDS(on)`は`VGS` ≦ −4 Vの値で、実回路の`VGS`は未確定 |
| 合計 | 初期 302 mV／トリップ後 362 mV | 上の和 |
| `U2`入力 | 4.698 V／4.638 V | 5 Vから引いた値 |
| 要求 | 4.6 V（`IOUT`=1 A）。500 mAなら4.55 V | `(b)のESP32 board 5 V入力の導出` |
| 余裕（4.6 V） | 98 mV／38 mV | 4.55 Vなら148 mV／88 mV |

- **`MEAS-01`の付け方で、表は上限にならない。**(1) ブレッドボードに挿す場合：`EXP-035`の段2bは、約0.27 Aでシャント本体が29.1 mV、両リードの接点が約0.33 Ωずつ（約82 %）と記録している。段階Cの大電流経路はブレッドボードを通さない。(2) はんだ付けする場合：抵抗値の変化は±(2 %＋0.05 Ω)で、上限は約0.157 Ω（0.1 Ω×1.05×1.02＋0.05 Ω）、1.08 Aで約170 mVである。**トリップ後の合計は170＋184＋65＝419 mV、`U2`入力は約4.581 Vで、4.6 Vの要求を下回る**（初期は170＋124＋65＝359 mV、約4.641 V、余裕41 mV）。**余裕の符号が負になる条件がある。**トリップ後の値は、0.17 Ωを運転中の抵抗として置いた仮の値で、datasheetからは言えない。余裕の判定には使わない（下の`段階Cの構成は変えない`の項）。
- **配線の降下は含まれていない。**`111641`は標準の銅の体積抵抗率（0.017241 Ω·mm²/m）と断面積0.3054 mm²から約0.0565 Ω/m、往復で約0.113 Ω/mである（より線は更に高い。メーカーの導体抵抗は取得していない）。**`U2`へ流れる電流が0.5 A、0.3 mなら約17 mV。**
- **M-12001の出力誤差の公開値が無いため、余裕が正だとは言えない。**トリップ後（4.6 Vの要求）では38 mVであり、5 Vの約0.8 %で消える（0.17 Ωを運転中の抵抗として置いた仮の値で、datasheetからは言えない。余裕の判定には使わない）。**参考として、`EXP-013`の試験1は無負荷で`5.35`と表示した（`DT830B`、確度は未取得、無負荷）。判定には使わない。**
- **余裕が負になる場合は、段階Cの構成（[#405](https://github.com/wachi-yoshitaka-11-dev/deskcat/issues/405)）の設計の問題である。**この節では直さない。
- **段階Cの構成は変えない（2026-10-27、[#405](https://github.com/wachi-yoshitaka-11-dev/deskcat/issues/405)）。**`PROT-OC-01`の0.17 Ωは、datasheetの`1 Hour (R1) Post-Trip Resistance`の`Max.`（`at 23 °C`）である。datasheetの本文は、トリップからの時間と23 ℃のほかに、測定の条件（電源を外して測るか、通電中か）を書いていない。**この文書は、トリップから復帰した後の運転で、抵抗がこの値まで上がりうるかどうかを、datasheetから言えない。**そのため、トリップ後（0.17 Ω）の組の`U2`入力の余裕は計算できないものとして扱う。表の「トリップ後」の列（PTC 184 mV、合計 362 mV、`U2`入力 4.638 V、余裕 38 mV（4.55 Vなら88 mV））と、上の`MEAS-01`の付け方の項の(2)の計算（トリップ後の合計 419 mV、約4.581 V）は、0.17 Ωを運転中の抵抗として置いた場合の仮の値であり、余裕の判定には使わない。一方、初期抵抗の最大0.115 Ωの組（`MEAS-01`あり・はんだ付けの最大0.157 Ω、`PROT-RP-01`の最大0.060 Ω）は、上限を40 ℃基準の0.896 Aへ当て直したため（`上限を40 ℃基準の0.896 Aへ当て直す（2026-10-27、#405）`）、`U2`入力が5 V − 0.332 Ω × 0.896 A ≒ 4.703 Vで、4.6 Vの要求に対し約100 mVの余裕という見積もりになる（PTCの抵抗は23 ℃の値で、40 ℃の抵抗の資料は無い。配線の降下とM-12001の出力誤差も含まない）。**M-12001の出力誤差が分からず、余裕が正だとは言えない点は、上の項のまま残る。**`U2`の入力が足りないときに起きるのはESP32のbrownoutとresetであり、安全要件の5項目に入らない。そのため、測定中の`MEAS-01`を含む構成は変えず、ESP32をPCのUSBへ切り替える手順も足さない。brownoutとresetは、停止条件として観察する（`段階Cで`MEAS-01`を直列に入れている間の電圧の見張り方（2026-10-26の案、#525）`）。表の電流1.08 Aは上側の見積もりである。

#### 大電流経路にbreadboard接点とジャンパー線を使わない

`hardware-bom.md`の`PROTO-01`が示すとおり、手持ちのbreadboardとジャンパー線は
**個別の許容電流がメーカー資料で確認できない**。定格の無い部品を経路に入れると
最小値が原理的に出せず、上表がいつまでも埋まらない。

したがって**gate対象の大電流経路（ingress → 分岐点 → 各railの5 V往路、および
GND戻り）は、公称許容電流のある線材と接続部材で構成する**（`WIRE-PWR-01`）。
breadboard接点とジャンパー線は、信号線と、ESP32の`3V3` pinから取る小電流branchに限る。

保守的な仮定値を置いて済ませる案は採らない。根拠の無い電流値を確定値として
扱わないというproject規則（`AGENTS.md`の推測禁止）に反するためである。
追跡は[HW-TBD-022](tbd-register.md)で行う。

#### deratingと判定量

**derating: 上表の定格の最小値の80%を上限とする。**判明している最弱部品（`PROT-OC-01`の
PTC`Ihold` 1.35 A）だけで計算すれば`1.35 A × 0.8 = 1.08 A`（23 ℃基準）だが、未確定の行が残る間は
これが最小値である保証がない。上限は**0.896 A以下**（40 ℃基準。23 ℃基準は1.08 A）である（**2026-08-25に1.2 Aから1.0 Aへ下がり、
2026-08-26にPTCへ変更して1.08 Aへ上がった。**`最小定格は1.35 Aへ上がった（2026-08-26）`）。**2026-10-27に、温度の基準を40 ℃へ当て直し、上限は0.896 A以下になった**（`上限を40 ℃基準の0.896 Aへ当て直す（2026-10-27、#405）`）。

**評価するのは定常値（平均電流）であり、過渡peakではない。**connectorとPCB traceの
電流定格は`I²R`による発熱と放熱の釣り合いで決まる熱の制限であり、時定数は秒から分の
orderである。µsからmsのspikeは発熱にほとんど寄与しないため、peakでこの上限を
評価すると過剰に厳しくなる。

**したがってingressの電流は定常値で測る。**測定点は[#525](https://github.com/wachi-yoshitaka-11-dev/deskcat/issues/525)で定める。
ESP32 ADCによるpeak captureは、この上限の判定には使わない。

peakが問題になるのは別の現象であり、別の量で見る。

| 現象 | 見る量 | 測定点 |
|---|---|---|
| connectorとtraceの過熱 | **定常／平均電流** | ingress（測定点は[#525](https://github.com/wachi-yoshitaka-11-dev/deskcat/issues/525)で定める） |
| peakによる電圧降下（Piのbrownout） | **電圧droop** | `ADC-5V`、`ADC-3V3`（`gpio-assignment.md`） |
| servoのstall電流 | peak電流 | `ADC-SHUNT`（同上） |

ingress低側へshuntを入れてESP32 ADCで測る案は採らない。star pointを基準にすると
adapter return側は`I × R`だけ**負**の電位になり、ESP32のADCでは測れない
（pin破損のriskもある）。high-side current sense ICで解決できるが、
上記のとおりこの上限の判定にpeakが要らないため、部品を追加しない。

80%とする理由は次のとおり。定格は連続通電の条件下で決まる値であり、本projectには
定格側にも測定側にも不確かさが残る。

- servoの連続動作電流は負荷依存で幅がある
- テスターの読みは平均値であり、動作条件によって変わる
- 線材と接続部材を定格既知の品へ置き換えても、接続部の接触抵抗と実装の個体差は残る。
  部品単体の定格が決まったときの条件より不利になりうる

**判定は定常電流で行う。**負荷表の文献値でも、連続側の合計（ESP32 240 mA＋Pi 350 mA
＋LCD未確認＋servoの連続動作分）は候補構成の上限（0.896 A以下。40 ℃基準。`上限を40 ℃基準の0.896 Aへ当て直す（2026-10-27、#405）`）に迫る。
したがって次のいずれかが要る。

- 実測でservoを含む**定常電流の合計**が、**`経路部品と定格`表の最小値の80%以下**に
  収まることを示す。収まらない場合は`servo-safety-limits.md`のtrajectory制限
  （可動域、速度、duty cycle）でservoの連続動作電流を下げ、再度実測する
- または、servo railのingressをMicro-Bを経由しない、より定格の高いconnectorへ変更する。
  その場合も上限は同じ規則（新しい最小値の80%）で決め直す

**peakをこの判定に使わない。**peakは`ADC-5V`／`ADC-3V3`による電圧droopと、
brownout・resetの有無を見るために使う。connector定格の判定には用いない。

#### marginの定義（#3 条件5）

**電源、wire、connectorの定格にmarginを含めた、とは次を指す。**設計に対する定義であり、実配線の検証ではない。

- **規則:** 経路の上限は、`経路部品と定格`表の定格の最小値の80%とする（上記）。値はその表が持ち、ここへ写さない。
- **対象:** 入力電源、線材とcable、端子台と嵌合接点、保護部品、測定用shuntを含み、5 Vの往路とGNDの戻りの両方を数える。この表の最小値が幹線だけを見るのか分岐も含むのかは、同表の`CABLE-PI-PWR-01`行のとおり未定である（`HW-TBD-022`）。
- **前提:** 電源は1系統として扱う（[#3の決定2](https://github.com/wachi-yoshitaka-11-dev/deskcat/issues/3#issuecomment-5863139535)）。机上の作業の前提であり、最終の決定ではない。1系統かservo用を分けるかは、[#17](https://github.com/wachi-yoshitaka-11-dev/deskcat/issues/17)のservo電流の実測の後に[#405](https://github.com/wachi-yoshitaka-11-dev/deskcat/issues/405)で決める。ESP32の最終の給電経路も未決定であり、#405で決める。分けた場合は、系統ごとにこの規則を当て直す。[hardware-safety-policy.md](../governance/hardware-safety-policy.md)の`3. 電源`の「独立5 Vサーボ電源」との関係は、電源の最終の決定（#405）で人間が決める。
- **判定量:** 定常電流。測定点と読みの確かさは[#525](https://github.com/wachi-yoshitaka-11-dev/deskcat/issues/525)で定める。
- **根拠にしないもの:** 同表に未確定の行が残る間の上限値（確定値として扱わない）。connectorの一般定格。この定義があること自体（段階Cのgateを開かない）。
- **未確定の行の解消**は、段階Cの初回通電の前提として扱う（`サーボ接続前`の「`経路部品と定格`表に未確定の行が残っていない」）。追跡は[tbd-register.md](tbd-register.md)の各行が持つ。

### 過電流保護（段階Cのgate）

上限を超えたことを**テスターで読んで人が電源を落とす**のは検知であって保護ではない。
M-12001は5 V／3 Aを供給でき、候補構成で**定格が判明している部品のうち最小**は1.35 Aである
（`経路部品と定格`。未確定の要素がより低ければ、守るべき値はさらに下がる）。上限を超えた状態は、
**人が読み取って手を動かすまでの間、連続して流れ続ける**。connectorと線材の発熱は
秒から分のorderで進む（`ingressの電流制限`）ため、この運用では止められない。

**したがって段階C（合成給電）は、過電流保護部品を選定して実装するまで実施しない。**
これは段階Cのgateの一つである（他に端子台（**2026-09-09、案Bにより「変換基板」から差し替え**）、大電流経路の線材、`経路部品と定格`表に
未確定の行が無いことがある。全部は段階表の`C`行と`受け入れ条件`にまとめてある）。
測定計画の`サーボ接続前`checklistにも同じ確認を置く。

#### 挿入位置

**2026-09-09に人間が決定した案Bにより、ingressの受け方をMicro-B変換基板（`PSU-INGRESS-01`）
から端子台（`114217`）へのネジ止めへ変えた。**挿入位置そのものは変わらない。**M-12001の
cableを受ける端子台の直後、5 Vの往路へ直列**に1個入れる。**GND戻り側には入れない。**
`GND topology`節のstar point構成が崩れ、`ADC-SHUNT`の基準電位が動くためである。

#### 選定基準

**先に方式を決める。**PTCとヒューズでは、メーカーが公開する量そのものが違う。
方式を決めずに基準だけ書くと、どちらのdatasheetを見ればよいか定まらない。
**方式の決定は段階Cのgate値を計算する前に行う。**

| 方式 | 復帰 | メーカーが公開する主な量 |
|---|---|---|
| ポリスイッチ（PTC） | 自己復帰 | 保持電流（`Ihold`）、trip電流（`Itrip`）、trip時間、周囲温度による減額 |
| ガラス管ヒューズ＋ホルダ | 交換式 | 定格電流（`In`）、時間-電流特性（溶断時間）、遮断定格（breaking capacity）、`I²t` |

bring-upでは上限を意図的に探るため、**復帰の手間が運用に効く**。交換式を選ぶなら予備を用意する。

##### 方式と品番を決定した（2026-08-25）

> **この節の方式は2026-08-26に変更された。現行の方式はPTCである**
> （`方式をPTCへ変更した（2026-08-26、人間の判断）`）。
> **以下はガラス管ヒューズを採ると決めた時点の記録であり、書き換えていない。**
> **却下の判断（PTCを採らない）だけが撤回された。**選定の手順と一次資料の扱いは変わっていない。

**方式はガラス管ヒューズ＋ホルダである。PTCは採らない。****品番も選定した。**
**ただし「選定した」は`選定順序（循環にしない）`の手順3を満たしたという意味であって、
その品を買えることまでは確認していない**（`入手性はこの節で確認していない（2026-08-26）`）。
決定の出所は[#205](https://github.com/wachi-yoshitaka-11-dev/deskcat/issues/205)であり、
**PTCを採らなかった理由と、同じ理由で2 A品も採れなかった経緯は同Issueの本文が持つ。
ここへ再掲しない。**

| 項目 | 選定 |
|---|---|
| ヒューズ | Littelfuse **218 Series**（5×20 mm、Time-Lag、ガラス管）、品番 **`02181.25HXP`**（1.25 A／**250 V（AC）**） |
| ホルダ | 秋月 通販110521（`FUC-03A`）。**適用ヒューズ径はø5.2 mm**（メーカー図面。`経路部品と定格`のヒューズホルダ行が正）。**ヒューズ本体は5.2 mm径×20 mmであり径は合う**（`Dimensions`の`0218 000P`は`5.2 +0.1/−0.2`径、`20 +0.5`長）。**ただし2個のクリップの取り付け間隔は図面が与えていない。**長さ方向を受けるのは基板側の穴位置である |

**品番はcartridge型である。**`Part Numbering System`は`0218 xxxx M X E P`の`Option Codes`を
`Blank : Cartidge Type Fuse`／`E : Axial Lead Fuse`と定めており、`02181.25HXP`には`E`が無い。
**ホルダで受ける構成に合う型である**（`HX`は`Packaging`表のbulk 100個入り）。

**一次資料はメーカーのdatasheetである。**`littelfuse.com`は403で取得できないため、
Farnellがhostする同一文書を使った（[218 Series datasheet](https://www.farnell.com/datasheets/3689252.pdf)。
© 2020 Littelfuse、`Revised: BA.08/26/20`。sha256
`a3ad65e22b9514bab92ea69ee1b107be5de8ce42b271f4181401d1b7d031ffec`。**2026-08-25に取得し、
同一性をhashで確認した**）。

| datasheetが与える量 | 1.25 A品の値 | 出所 |
|---|---|---|
| 定格電流 `In` | **1.25 A**（表の値）。**基準は周囲25 ℃である**（`Temperature Re-rating Curve`が25 ℃に基準線を引き、そこで`PERCENT OF RATING`が100%になる）。**曲線は温度とともに減額するため、25 ℃を超える環境では定格を下げて扱う。****曲線はグラフであり、特定の温度での減額率をここへ数値として書かない**（読み取り値を確定値にしない。[AGENTS.md](../../AGENTS.md) 推測禁止） | `Electrical Characteristics`表、`Temperature Re-rating Curve` |
| 定格電圧 | **250 V（AC）。**同表の列見出しは`Voltage Rating (V)`だが、遮断定格の欄は`@ 250 VAC`と交流で表記されている。**DC定格は同datasheetに無い**（下記） | 同表 |
| 遮断定格（`Interrupting Rating`） | **35 A @ 250 VAC。****これは交流の定格であり、この経路（5 V DC）の遮断能力の根拠にならない**（下記`遮断能力はDCで未確定である`）。同列は`0.032 A`〜`3.15 A`の行を覆う結合cellであり、**1.25 A行にも適用される**（**text抽出では空欄に見えるため、2026-08-25に図で確認した**） | 同表 |
| 溶断`I²t`（`Nominal Melting I²t`） | 12.65 A²sec | 同表 |
| 冷抵抗（`Nominal Cold Resistance`） | 0.0446 Ω | 同表 |
| 定格電流時の最大電圧降下 | **150 mV** | 同表 |
| 動作温度 | −55〜+125 ℃ | `Product Characteristics`表の`Operating Temperature`行 |
| 準拠規格 | `IEC 60127-2, Sheet 3`（Time-Lag） | `Features` |

**溶断の関門は`% of Ampere Rating`で与えられる**（`0.125A - 6.3A`の行。1.25 A品はこの帯にある）。

| 関門 | 1.25 Aでの電流 | 開放時間 |
|---|---|---|
| 150% | 1.875 A | `60 minutes, Minimum`（**60分以内には溶断しないことの保証であり、切れないことの保証ではない**） |
| 210% | 2.625 A | `120 sec., Maximum` |
| 275% | 3.4375 A | `600 ms., Min.; 10 sec. Max.` |
| 400% | 5 A | `150 ms., Min.; 3 sec. Max.` |
| 1000% | 12.5 A | `20 ms., Min.; 300 ms. Max.` |

**M-12001の供給上限3 Aは定格の240%である。**210%（2.625 A）の関門を超えているため、
**3 Aでの溶断は120秒以内である。**ただし**これはdatasheetが240%の点そのものに与えた値ではない。**
関門が与えられているのは210%であり、`Average Time Current Curves`が示すとおり
**溶断時間は電流に対して単調に減少する**ため、210%で120秒以内なら240%でもそれより短い。
**この一段の推論を挟んでいることを記録しておく。**
**[#205](https://github.com/wachi-yoshitaka-11-dev/deskcat/issues/205)がPTCを却下した2つ目の条件
（トリップ電流 < 電源の最大供給）を、この品は満たす。**

###### 遮断能力はDCで未確定である

**`方式によらない基準`の`遮断能力`は、M-12001が供給しうる最大電流（3 A）を安全に遮断できることを
求めている。この項目は満たせていない。**

**このdatasheetが与える`Interrupting Rating`は`35 A @ 250 VAC`であり、交流の定格である。**
表中のどの定格電流の行も`VAC`表記であり、**`DC`という語は同文書に1度も現れない**
（2026-08-25に全文で確認した）。**この経路は5 V DCである。**

**交流の遮断定格から直流の遮断能力を導かない**（[AGENTS.md](../../AGENTS.md) 推測禁止）。

> **2026-08-26に方式をPTCへ変更したため、この未確定はPTCでは解消する。**
> Bourns `MF-R135`の`Imax`は**40 A**で、datasheetは電圧を`Vmax 30 V`（直流）として与えている
> （`方式をPTCへ変更した（2026-08-26、人間の判断）`）。
> **以下はガラス管ヒューズを採る場合の記録として残す。**
**交流には電流零点があり、直流には無い。**遮断はこの2つで同じ条件ではないため、
**交流で与えられた値が直流でも成り立つとは言えない。****どちらが厳しいかをこの文書では順位付けしない。**
一次資料が交流の値しか与えていない、という事実だけを根拠にする。
**「5 Vと低電圧だから問題ない」も根拠にしない。**メーカーが5 V DCに対する値を与えていない以上、
それは推定である。

**したがって`遮断能力`は未確定のまま`HW-TBD-021`に残る。**解くには、メーカーがこの品へ与える
DC定格を一次資料で確認するか、DC定格が公開されている品へ替えるかのどちらかが要る。
**この項目が未確定であることは、`記録するtrip動作`の`M-12001の供給上限での動作`行の合否にも及ぶ。**

**溶断そのものは別の話である。**3 Aで120秒以内に溶けることは上の関門から言える。
**溶けることと、溶けるときのアークを安全に断ち切れることは別の量である。**この節が未確定と
しているのは後者だけである。

###### 入手性はこの節で確認していない（2026-08-26）

**この節が確定させたのは方式と、一次資料から読める品の特性である。****どこから買えるかは
確認していない。**調達は[#205](https://github.com/wachi-yoshitaka-11-dev/deskcat/issues/205)が持つ（[#204](https://github.com/wachi-yoshitaka-11-dev/deskcat/issues/204) (6)）。

**同Issueから入手性の報告が来ている。****ただし報告の中身は確度が揃っていない。**
同Issueが**販売店のページを直接取得して確認できた**のは次の2点である。

- **`digikey.jp`が`02181.25HXP`について`This product is no longer available at DigiKey`を表示すること**
- **米国のDigiKeyでは在庫があること**（買うとすれば国際発送になる）

**それ以外は直接取得できていない。**他の販売店に在庫が無いことは**検索結果に現れなかった
という消極的な証拠**であり、代替候補の価格・在庫・特性は**検索結果のsnippet経由**である。
**この文書ではそれらを根拠に採らない。**

**当方でも一次で確認できなかった。**DigiKey（日・米）、RS日本、マルツ、Mouser日本の
いずれも自動アクセスを拒否した（2026-08-26に試行）。**したがってこの文書は入手の可否を
判定しない。**確定するのは調達側であり、この節はその結果を待つ。

**方式と定格は、品が替わっても変わらない。**ガラス管ヒューズ＋ホルダ、定格電流1.25 Aである。
**下限（`1.25 × 0.8 = 1.0 A > 0.84 A`）と上限（経路の最小定格）も、定格電流で決まるため変わらない。**

**変わるのは品目別の数値である。**関門、溶断`I²t`、冷抵抗、定格電流時の電圧降下は品に依存する。
**とくに適合規格が変わると関門の刻みが変わる。**この品が適合するのは`IEC 60127-2 Sheet 3`だが、
**別の規格に適合する品が代替候補に挙がっている**（規格名と関門の値は**同Issueでも一次資料を
取得できておらず、ここへ書かない**）。
**したがって品番が変わったら、上の`datasheetが与える量`と関門の表を取り直す。**
`遮断能力はDCで未確定である`の判定も、品ごとに引き直す。

**発注する品が確定した時点でこの節を更新する。**それまで`02181.25HXP`は
**「一次資料で特性を確認した候補」であって、購入が確定した品ではない。**

**それでもこの節はgateを開けない。**残っているものが5つある。

1. **調達（発注・着荷）の状態は[#205](https://github.com/wachi-yoshitaka-11-dev/deskcat/issues/205)が持つ。この節は持たない。**
   `記録するtrip動作`のうち**実装後にしか埋まらない欄**（復帰と予備の有無、確認方法の実行）が空である
2. **ホルダの定格が一次資料に無い。**記載が無いことの確認と、ヒューズ側のdatasheetが
   ホルダによる減額の参照を求めている点は、**`経路部品と定格`のヒューズホルダ行が正である**
   （**ここへ再掲しない**）。**したがって同表には未確定の行が残り、上限は確定しない**
3. **`遮断までの時間`の合否判定ができない。**判定条件は「最弱部品の熱時定数より短いこと」であり、
   **その熱時定数はどの経路部品についても未確定である。**溶断時間の側は上表で公開値が揃っている
4. **定常電流での締め直しの判断が段階B-2に従属する**（`判明している最小定格が1.25 Aへ下がった（2026-08-25）`）
5. **DCでの遮断能力が未確定である**（`遮断能力はDCで未確定である`）。**メーカーが与えているのは交流の定格だけである**

**あわせて記録する。****このヒューズは5 V経路に直列の電圧降下を持ち込む。**
定格電流時の最大電圧降下は150 mVであり、**`逆極性保護のdesign review`が直列Schottkyについて
述べた「5 V予算を食う」という論点が、規模を変えてこの部品にも掛かる。**
**想定定常840 mA（定格の67%）での降下はdatasheetが与えていない**
（公開されているのは定格電流時の値だけである）。
**冷抵抗0.0446 Ωから計算した値を、その降下として使わない。**溶断直前まで抵抗は温度で上がるため、
冷抵抗は下限側の値である（[AGENTS.md](../../AGENTS.md) 推測禁止）。

**直列素子はヒューズだけではない。**逆極性保護のP-ch MOSFET（東芝`2SJ334`、[#205](https://github.com/wachi-yoshitaka-11-dev/deskcat/issues/205)で発注対象）が
同じ5 Vの往路に入る。**予算はこの2つを合わせて見る必要がある。**

| 直列素子 | 降下 | 条件 |
|---|---|---|
| `PROT-OC-01`（ヒューズ） | **最大150 mV** | **定格電流1.25 Aでの値。**想定定常840 mAでの値はdatasheetに無い |
| 逆極性保護のP-ch MOSFET（`2SJ334`） | `RDS(on) × I`。**最大60 mΩ**から、1.0 Aで**最大60 mV** | **`RDS(on)`の規定条件は`VGS = −4 V`、`ID = −15 A`である**（[2SJ334 datasheet](https://akizukidenshi.com/goodsaffix/2sj334.pdf) 東芝 2006-11-14、sha256 `c01da93643cb1cb11075d9137897655c556989de647c38368d5c487274d5da46`。2026-08-25取得。`VGS = −10 V`では最大38 mΩ）。**1 A付近の値をdatasheetは与えていない。**5 V railでは`VGS`が−5 V付近になる**見込みだが確定していない**ため、**−4 Vの欄を採るのが安全側である**（**`VGS` ≤ −4 Vが成り立つ場合の値である。**実回路の`VGS`は未確定である。`VGSが未確定である（2026-08-27）`） |

**この2つを足した値を合計降下として書かない。**条件（電流）が違うためである。
**`ID`(DC) −30 Aであり、MOSFETは経路の最小定格にならない**（最小はヒューズの1.25 Aのままである。
`経路部品と定格`）。**5 V予算への影響は`受け入れ条件`の(b)で扱い、この節では確定させない。**

##### 方式をPTCへ変更した（2026-08-26、人間の判断）

**方式はPTC（ポリマーPTC、自己復帰型）である。**品はBourns **`MF-R135`**（秋月 通販113013、¥40）。
**2026-08-25の`方式と品番を決定した（2026-08-25）`は書き換えていない。**この節が現行である。

###### 変更した理由

**[#205](https://github.com/wachi-yoshitaka-11-dev/deskcat/issues/205)の訂正③が置いた前提が誤っていた。**
訂正③はPTCを却下した理由を「**在庫のあるPTCに条件を満たす品が無い**」としていたが、
**当時見たのは3品番（`100507`／`112629`／`101344`）だけであり、秋月のPTCカテゴリには41件ある。**
**条件を満たす品が実在した。**

| 理由 | 内容 |
|---|---|
| **遮断能力が直流で埋まる** | `Imax` **40 A**。datasheetは`Vmax`を**30 V（直流）**として与えている。**`遮断能力はDCで未確定である`が挙げた問題が、この方式では起きない** |
| **余裕が広い** | `Ihold` **1.35 A** ＞ ヒューズの定格 1.25 A。**MSP2807の許容上限が広がる**（`境界は240 mAへ広がった（2026-08-26）`） |
| **温度減額が表で公開されている** | 訂正③がPTCを却下した根拠「保持電流は温度で2〜3割下がる」は、**この品では数値の表になっている**（下表）。推測で却下する必要がなかった |
| **bring-upに向く** | `選定基準`が「bring-upでは上限を意図的に探るため、復帰の手間が運用に効く。交換式を選ぶなら予備を用意する」と書いている。**自己復帰は交換を要さない** |

**PTCが全ての点でヒューズに勝るわけではない。****速度ではヒューズが上である。**
`Itrip`直上（定格に近い過電流）でのトリップの遅さはPTCの既知の弱点であり、
`3 Aでのトリップ時間を読み、線材と嵌合接点の判定で止まった（2026-08-27）`が示すとおり、
`M-12001`の供給上限3 A（`Itrip`の111%）でのtypトリップ時間は少なくとも数百秒に及ぶ。
**ガラス管ヒューズ（`02181.25HXP`）はこの帯で明確な関門を持っていた**（`方式と品番を決定した
（2026-08-25）`の関門表）。**210%（2.625 A）で`120 sec., Maximum`という保証がある。**
M-12001の3 Aは定格の240%であり、210%の関門より確実に速く溶断する
（`Average Time Current Curves`が示す単調減少性による）。**したがって「PTCを選んだから
速く済む」という理解は誤りである。**PTCを選んだ理由は上表の4点（DCでの遮断能力・余裕・
温度減額の公開・bring-upへの適性）であり、**`Itrip`直上での速度はPTCの弱点として残る。**
この弱点が、`HW-TBD-021`の詰まりの本体（嵌合接点1.5 Aが3 Aの200%を長時間受ける）を
生んでいる。

###### datasheetが与える量

出典は[MF-R Series datasheet](https://akizukidenshi.com/goodsaffix/mfr.pdf)（Bourns。sha256 `7d980de97abdadc53465454d48a39c6926f1287a2fcfca77d0520a7512245fe4`。2026-08-26取得）である。

| 量 | `MF-R135`の値 |
|---|---|
| `Vmax` | **30 V** |
| `Imax` | **40 A** |
| `Ihold`（保持電流） | **1.35 A** |
| `Itrip`（トリップ電流） | **2.70 A** |
| 抵抗 | 初期抵抗 最小0.065 Ω／最大0.115 Ω／トリップの1時間後（`R1`）の最大0.17 Ω（datasheetの列は`Initial Resistance`の`Min.`・`Max.`と、`1 Hour (R1) Post-Trip Resistance`の`Max.`） |
| `Max. Time to Trip` | **5×`Ihold`＝6.75 Aで 7.3 秒** |
| 消費電力（トリップ状態） | 0.80 W |
| 試験条件 | `Hold Current`: 30 min. at `Ihold` → `No trip`／`Trip Cycle Life`: `Vmax`, `Imax`, 100 cycles → `No arcing or burning`／`Trip Endurance`: `Vmax`, 48 hours → `No arcing or burning` |

**温度減額（`Thermal Derating Chart - Ihold / Itrip (Amps)`）。**

| 周囲温度 | `Ihold` / `Itrip` |
|---|---|
| 23 ℃（基準） | **1.35 / 2.70** |
| 40 ℃ | 1.12 / 2.24 |
| 50 ℃ | 1.04 / 2.08 |
| 60 ℃ | 0.92 / 1.84 |

**`方式によらない基準`への当てはめ。**

| 基準 | 判定 |
|---|---|
| 連続通電できる電流の下限 | **`1.35 × 0.8 = 1.08 A`**。`ingressに必要な定格の見積もり`のMSP2807を除く合計840 mAを**上回る** ✓ **（23 ℃基準。2026-10-27に40 ℃基準の0.896 Aへ当て直した。840 mAを56 mA上回る ✓。`上限を40 ℃基準の0.896 Aへ当て直す（2026-10-27、#405）`）** |
| 連続通電できる電流の上限 | **1.35 A**。`経路部品と定格`の他の判明値（嵌合接点1.5 A）**以下** ✓ **2026-09-14訂正。この✓は2026-08-26時点の記録であり、現在の判定ではない。**比較相手としていた嵌合接点1.5 Aは変換基板`PSU-INGRESS-01`側の値であり、**2026-09-09の案Bで経路から外れた。****比較相手は`経路部品と定格`の保護対象側の最弱部品である**（**`PROT-OC-01`自身は含まない。**同表の判明値の最小は`PROT-OC-01`のPTCであるため、単に「最小値」と書くと循環する）。**案B後の比較相手の具体の値は、この訂正では特定しない。**保護対象側がどこから始まるか（`挿入位置`は`PROT-OC-01`をM-12001のcableを受ける端子台の直後に置く）と、**この表の最小値が幹線だけを見るのか分岐も含むのかが、同表の`CABLE-PI-PWR-01`行のとおりこの文書で定まっていない。****したがって✓が成立するかどうかは、比較相手が特定できるまで確定しない。****同表に残る未確定（分岐点・`CABLE-PI-PWR-01`・線材3行・Pi側嵌合接点の`TBD`）のいずれかが1.35 Aを下回れば覆る。****2026-10-26更新：線材3行は、`PROT-OC-01`より下流の連続電流の許容電流の値について最悪側の条件で確定した（短絡安全は含まない）**（`線材3行の周囲温度と条数を最悪側に置く（2026-10-26、#525）`）。**残る未確定は、分岐点・`CABLE-PI-PWR-01`・Pi側嵌合接点である。**端子台から`PROT-OC-01`までの区間は`PROT-OC-01`の保護の外であり、この表の比べる相手ではない（`線材3行の周囲温度と条数を最悪側に置く（2026-10-26、#525）`で`TBD`）。**提案はPM、承認はユーザー（2026-09-13に取得。正本への反映は2026-09-14）** |
| 遮断特性 | `Itrip` **2.70 A** ＜ M-12001の供給上限3 A。**電源がトリップさせられる** ✓ |
| 定格電圧 | `Vmax` **30 V** ≫ 5 V ✓ |
| 遮断能力 | `Imax` **40 A** ≧ 3 A。**直流の値である** ✓ |

###### 上限1.08 Aは据え置く（2026-09-14）

**2026-10-27：この判断のうち、温度の基準（23 ℃）は当て直した。**`上限を40 ℃基準の0.896 Aへ当て直す（2026-10-27、#405）`が現行である。**以下は2026-09-14の記録であり、書き換えていない。**

**案B後も上限1.08 Aを見直さない。****提案はPM、承認はユーザー（2026-09-13に取得。正本への反映は2026-09-14）。**

理由は4点である。

- **導出の入力が変わっていない。**`1.08 = 1.35 × 0.8`であり、係数0.8は`選定順序（循環にしない）`の手順4が定める規則の側の定数である。**手順4が取るのは`経路部品と定格`の最小値であり、現時点でその最小が`PROT-OC-01`の`Ihold`である。****未確定の行が1.35 Aを下回って確定すれば最小が入れ替わり、上限は導出し直しになる。**
  案Bが経路から外したのは変換基板側の嵌合接点で、この導出に入っていない。
- **上げる要求が無い。**上限を上げたい動機になっていた詰まり（**嵌合接点の定格1.5 Aに対し、その200%にあたる3 Aを長時間受ける**）は
  案Bで対象を失った。**この詰まりは経路が持つかどうかの問題であって、1.08 Aの導出に入っていた量ではない。**需要側は`ingressに必要な定格の見積もり`の定常合計だが、**MSP2807が唯一の未知数**の
  ままであり、上げる必要があるかを言える材料が無い。
- **上げる手段が塞がっている。**上げるには`Ihold`の大きいPTCへ替えることになるが、
  **`Itrip` = 2 × `Ihold`が`MF-R`系列で成り立つかは未確認である。比を一般値で置かない**（**`MF-R135`自身の`Itrip` 2.70 Aはdatasheetの実値であり、この比から導いたものではない。**未確認なのは他品番へ同じ比を当てられるかである）
  （[AGENTS.md](../../AGENTS.md) 推測禁止）。候補ごとにdatasheetを読む作業が要り、
  さらに[tbd-register.md](tbd-register.md)の`HW-TBD-021`が「方式と定格電流は品が替わっても変わらないが、
  関門・`I²t`・冷抵抗は品に依存するため取り直しになる」と書いている。
- **`PROT-OC-01`は安全要件5項目の「短絡」に入る**（[Hardware Safety Policy](../governance/hardware-safety-policy.md)）。
  **動かす理由が無いときに動かさない。**

**再検討の引き金は案Bではない。**
**段階B-2でMSP2807の定常電流を実測し、`ingressに必要な定格の見積もり`の定常合計が1.08 A以上になったときである**（境界そのものが閉じる側である。`窓が閉じる境界（2026-08-22の計算）`）。
そのときの逃げ道は
`servo予算の見直しで窓を広げる（2026-08-26、人間の判断）`が持つ。**ここへ再掲しない。**

**`PROT-OC-01`は`MF-R135`のままである。gateは1つも開かない。**

###### 上限を40 ℃基準の0.896 Aへ当て直す（2026-10-27、[#405](https://github.com/wachi-yoshitaka-11-dev/deskcat/issues/405)）

**提案はPM、承認はユーザー（2026-10-27）。**`上限1.08 Aは据え置く（2026-09-14）`の、温度の基準だけを改める。係数0.8と、最小値が`PROT-OC-01`の`Ihold`であることは変えない。

- **理由。**`線材3行の周囲温度と条数を最悪側に置く（2026-10-26、#525）`は、周囲温度を40 ℃に置いた（M-12001の動作温度の上限に揃えた設計上の仮定）。1.08 Aは`Ihold`の23 ℃の値（1.35 A）から出しており、PTCだけ23 ℃のままだと、経路の温度の前提が混ざる。
- **値**（`Thermal Derating Chart`の点。補間しない）。

| 周囲温度 | `Ihold` | 上限（× 0.8） | 840 mAとの差 |
|---|---|---|---|
| 23 ℃ | 1.35 A | 1.08 A | +240 mA |
| 40 ℃ | 1.12 A | **0.896 A** | **+56 mA** |
| 50 ℃ | 1.04 A | 0.832 A | −8 mA（成立しない） |

- **採る値。**設計の基準は40 ℃の0.896 Aである。測定のときは、`MEAS-04`で読んだ温度が40 ℃以下なら0.896 Aを使う（23 ℃以下でも1.08 Aへ戻さない）。**40 ℃を超えたら、続けずに止める。**M-12001の動作温度の上限が40 ℃であり、40 ℃を超える環境では電源そのものが定格の外にあって、構成が成立しない。PTCの低減で上限を下げて続ける根拠にならない。0.832 Aは50 ℃のPTCの計算値として表に残すだけで、運転の許容ではない。**40 ℃は設計の仮定であり、実測ではない**（筐体の中の温度は、`MEAS-04`で測るまで分からない）。
- **MSP2807の境界。**5 V入力側に換算した電流`x`について、LEDを含まない構成は`840 + x < 896`、すなわち`x < 56 mA`。LEDを含む構成は`864.4 + x < 896`、すなわち`x < 31.6 mA`。23 ℃の240 mA／215.6 mAは、室温の値として残る。**MSP2807の電流が分からない間は、この境界に入るとは言えない。**`EXP-019`の読みは3.3 V側の3点の合計で、5 V入力側に換算した`x`と直接比べない（MSP2807単独の値ではない）。
- **変わらないこと。**`PROT-OC-01`は`MF-R135`のままである。gateは1つも開かない。上限を下げる方向の改訂であり、安全要件5項目の「短絡」に効く値を緩めていない。
- **PTCの抵抗は23 ℃の値である。**datasheetに40 ℃の抵抗は無い。`ingressのshuntの挿入降下とU2の入力余裕の見積もり（2026-10-26、#525）`の降下は23 ℃の値で、電流は上限1.08 Aで置いている（電流の比は0.896 / 1.08 ≒ 0.83倍である。抵抗が23 ℃の値のままなら降下も0.83倍になるが、40 ℃の抵抗は分からない）。

###### 遮断能力は「制限」で満たしたと判断した（2026-08-27、PMの判断）

**上表の`遮断能力`の判定（`Imax` 40 A ≧ 3 A）は、項目名が要求する動作と、PTCが実際に行う
動作が一致しないという論点を残す。****`方式によらない基準`の`遮断能力`は「M-12001が供給しうる
最大電流（3 A）を安全に遮断できること」と定義されており、この項目名はヒューズを想定して付いた。
**PTCは遮断（開放）しない。**高抵抗化して電流を絞るだけであり、トリップ後も約160 mAが流れ続ける
（`この変更が主張しないこと`）。**したがって「遮断」という語を字義どおりに取るなら、PTCはこの
項目を満たさない。**

**この項目は「制限」で満たしたことにする。2026-08-27、PMの判断である。**根拠は基準の目的である。

[Hardware Safety Policy](../governance/hardware-safety-policy.md)の安全要件5項目のうち「短絡」は
「**connector と線材の発熱は秒から分の order で進むため、人が読み取って電源を落とすのでは
止まらない**」と書いている。**この文が求めているのは、故障電流を最弱部品の定格以下へ、
人の介入より速く落とすことである。**電流を止める機構が「遮断（開放）」か「制限（高抵抗化）」
かは、この文の要求に現れない。

`Imax` 40 A ≧ 3 Aは、**PTC自身がM-12001の最大出力3 Aを通しても壊れない（アーク・焼損しない）
こと**を確認する。そのうえでトリップが進めば、経路電流は`Ihold`／`Itrip`の帯からトリップ状態の
約160 mAへ絞られ、**最弱部品（嵌合接点1.5 A）の定格を大きく下回る。**これは「遮断」ではなく
「制限」による到達だが、**基準が求める帰結（故障電流を最弱部品の定格以下へ落とすこと）は
制限でも遮断でも同じように得られる。**

**したがって`遮断能力`の項目名だけで判定を押し切らない。**判定の根拠は項目名ではなく、
この基準が短絡から何を守ろうとしているか（安全要件5項目の「短絡」の文言）に置く。
**この判断は方式の可否そのものではない。**方式（PTC）は既に人間が確定させている
（`方式をPTCへ変更した（2026-08-26、人間の判断）`冒頭）。**ここで判断したのは、確定した方式に
対して`方式によらない基準`の`遮断能力`という既存の項目名をどう当てはめるかだけである。**

###### この変更が主張しないこと

- **PTCは遮断しない。**高抵抗化して絞るだけであり、**トリップ後も電流が流れ続ける。**
  トリップ状態の消費電力0.80 Wから、5 Vでは**約160 mA**が流れ続ける計算になる。
  **これはdatasheetが与えた値ではなく、電力からの見積りである。**
  ただし同datasheetは`Trip Endurance`を`Vmax, 48 hours`で`No arcing or burning`と規定している。
- **抵抗が上側へ寄る。**初期0.065〜0.115 Ω、トリップ後0.17 Ω。1 Aで115〜170 mVの降下になる。
  **トリップを繰り返すと上側へ寄るため、5 V予算に効く。**`Trip Cycle Life`は100 cyclesである。
- **3 Aでのトリップ時間を数値で持っていない。**datasheetが与えるのは`5×Ihold＝6.75 A`での7.3秒
  （最大）だけである。**3 Aは`Itrip` 2.70 Aを超えるためトリップはするが、時間は
  `Time to Trip`のグラフを読むまで確定しない。**
- **50 ℃を超えると下限を割る。**上の減額表で`Ihold`が1.04 Aになり、`1.04 × 0.8 = 0.832 A`が
  840 mAを下回る。**卓上の想定では問題にならないが、周囲温度の記録は要る。**
- **ヒューズホルダは経路から外れる。**`MF-R135`はスルーホール品で基板へ直付けするため、
  ホルダを通らない。**`110521`の調達（発注・着荷）の状態は
  [#205](https://github.com/wachi-yoshitaka-11-dev/deskcat/issues/205)が持つ。この文書は持たない。**
- **gateは1つも開かない。**方式と品が変わっただけである。

###### 3 Aでのトリップ時間を読み、線材と嵌合接点の判定で止まった（2026-08-27）

**短絡時に流れるのは電源の上限3 Aであり、`Itrip` 2.70 Aの111%である。**`Itrip`の直上は、
PTCのTime to Trip特性上もっともトリップが遅い帯である。datasheetが数値で与えるのは
`5×Ihold＝6.75 Aで7.3秒（最大）`の1点だけであり、3 Aの点は`Typical Time to Trip at 23 ºC`
グラフを読むまで確定しない（`この変更が主張しないこと`）。**このグラフを読んだ。**

**読み取り方法。**出典は`方式をPTCへ変更した（2026-08-26、人間の判断）`が持つ
[MF-R Series datasheet](https://akizukidenshi.com/goodsaffix/mfr.pdf)（Bourns、sha256
`7d980de97abdadc53465454d48a39c6926f1287a2fcfca77d0520a7512245fe4`）の4ページ目、
`Typical Time to Trip at 23 ºC`の下側グラフ（横軸`Fault Current (Amps)`、縦軸
`Time to trip (Seconds)`、両軸とも対数目盛、`MF-R090-0-9`〜`MF-R1100`の系列を収める）。
**この曲線群のうち左から3本目が`MF-R135`である**（凡例`MF-R090-0-9`／`MF-R110`／`MF-R135`／
`MF-R160`／`MF-R185`／`MF-R250`…の並びと、各曲線がグラフ上端（縦軸1000秒の位置）へ入る
電流値が、Electrical Characteristics表の各品番の`Itrip`に対して概ね一定の比率になることの
両方で照合した）。**このグラフは`Typical`（typ）であり、`Max`ではない。**同datasheetは
`Max. Time to Trip`のグラフを別に持たず、`5×Ihold`点の数値（表）だけが`Max`保証である。

600 dpiおよび1200 dpiでPDFをrasterizeし、pixel座標を軸の目盛（decade線と数値label）へ
最小二乗で較正した（横軸: `10^0.1〜10^2`の目盛13点、残差最大0.01 decade。縦軸: `1000〜0.001秒`
の7 decade線、残差最大0.03 decade）。較正の妥当性は、`MF-R135`曲線上で読んだ
`I=6.75 A`の`typ`値（約4.2秒）が、表の`Max. Time to Trip`（7.3秒、`max`）より短いという
関係が成り立つことで確認した（`typ < max`は物理的に正しい向きである）。

**読み取った点。**グラフの縦軸最大値は1000秒である。`MF-R135`曲線は、この上端（1000秒の
罫線）のごく直下、電流にして約2.97〜3.06 A（antialiasingを含む線の太さの範囲）でグラフの
描画領域へ入る。**この範囲は3.00 Aをまたいでいる。**曲線が上端へ入る直前の帯
（`I`=3.037〜3.48 A、`t`=909〜98秒）で連続に読めた点から`log₁₀(t) = a + b・log₁₀(I − Itrip)`
の形（`Itrip`=2.70 A、`a`=1.71、`b`=−2.61、残差最大0.03 decade）へ回帰し、**この式を3.00 Aへ
外挿すると約1190秒になる。**ただしこれは外挿であり、**グラフが実際に描いている範囲を
超える。**[AGENTS.md](../../AGENTS.md)の推測禁止に従い、この外挿値そのものを確定値として
扱わない。

**結論。**`MF-R135`の`Typical Time to Trip`グラフは、3.00 Aにおける読み取り可能な点を
提供しない。**曲線がグラフの上端（1000秒）へ到達する電流は3.00 A付近であり、3.00 Aちょうど
の値はグラフの描画範囲の外（1000秒以上）にあるか、境界そのものに一致する。**確度をもって
言えるのは「**3 Aでのtypトリップ時間は、少なくとも数百秒（10分前後）以上であり、datasheetの
プロット範囲（1000秒）に達するか、それを超える**」という下界だけである。**これは
`Itrip`のごく直上ほどトリップが遅くなるというPTCの一般的挙動（`方式をPTCへ変更した`冒頭が
指摘した「`Itrip`の直上はもっともトリップが遅い領域」）と整合する。**

**この時間で線材と嵌合接点が持つかを確認した。**

- **`WIRE-PWR-01`（`111641`、AWG22相当）。**`111641は許容電流が公開されている（2026-08-25）`
  節が読んだ連続許容電流は、周囲25〜40 ℃・2条密着で約6.0〜6.9 Aである。**3 Aはこの連続許容
  電流の範囲内であり、継続時間によらず線材はこの根拠で持つ。**線材はこの経路の制約にならない。
- **嵌合接点（Micro-Bオスplugとreceptacleの嵌合接点、`経路部品と定格`の該当行、定格1.5 A）。**
  **3 Aはこの定格の200%である。**この接点にはPTCのような時間-電流特性（一次資料）が
  無く、**「1.5 A定格の接点が200%の電流を数百秒以上通したときに持つかどうか」を判定する
  一次資料がこの文書に無い。**連続定格を超える電流を長時間（少なくとも数百秒、datasheetの
  プロット範囲では1000秒以上の可能性がある）通すことは、一般に接点の熱的な定格を超える
  方向であるが、**この経路がその条件で「持たない」と確定させる一次資料も、「持つ」と
  確定させる一次資料も無い。**

**したがって、この判定はここで止める。**3 Aの点はグラフから確定値として読めず（上記の
とおり境界上にあるか外挿を要する）、かつ読めた下界（少なくとも数百秒）のもとで嵌合接点が
持つかを判断する一次資料も無い。**設計判断（方式の再検討を含む）はPMへ上げる。**
`HW-TBD-021`はcloseしない。

**2026-09-09に人間が設計判断を決定した（案B）。**M-12001の出力cableをMicro-Bプラグの
手前で切り、導体を端子台（`114217`、6 A）へ受ける（終端方法は`経路部品と定格`の
`M-12001のcableを受ける端子台`行を参照。ここへ再掲しない）。**この判定が対象としていた
嵌合接点（Micro-Bオスplugとreceptacleの嵌合接点、定格1.5 A）は、この決定により経路から
外れる。**したがって「1.5 A定格の接点が200%の電流を数百秒以上通したときに持つか」という
この節の未解決の問い自体が、ingress側については対象を失う。**詳細と、この行が残す他の
条件は[tbd-register.md](tbd-register.md) `HW-TBD-021`行を参照。ここへ再掲しない。**
**2026-09-10、ユーザーがcableをMicro-Bプラグの手前で切り、端子台へ接続した（記録は[experiment-log.md](experiment-log.md)の`EXP-012`）。通電はまだ行っていない。****2026-09-16の訂正。**この文は`EXP-013`（2026-09-14〜09-15）より前の状態である。**通電は行った**（[experiment-log.md](experiment-log.md)の`EXP-013`）。**`通電前の配線確認手順`の充足状態は動かない**（`経路部品と定格`の`M-12001のcableを受ける端子台`行が持つ。**ここへ再掲しない**）。

###### 最小定格は1.35 Aへ上がった（2026-08-26）

**2026-08-26に方式をPTCへ変更した**（`方式をPTCへ変更した（2026-08-26、人間の判断）`）。
**保護部品が連続通電できる電流が1.25 A（ヒューズ定格）から1.35 A（PTCの`Ihold`）へ上がった。**

| 量 | 2026-08-25まで | 2026-08-26以降 |
|---|---|---|
| 判明している最小定格 | 1.25 A（ヒューズの定格電流） | **1.35 A（PTCの`Ihold`、23 ℃基準）** |
| 上限（gate値）＝最小定格 × 0.8 | 1.0 A 以下 | **1.08 A 以下** |

**保護部品は依然としてこの表の最小値である。**嵌合接点の1.5 Aより低いままであり、
`選定順序（循環にしない）`手順4のminの対象であることも変わらない。

**定常の見積り840 mA（MSP2807を除く）に対する余裕は29%である**（`(1.08 − 0.84) / 0.84`）。
**2026-08-25までは19%だった。**

**周囲温度で下がる。**`Ihold`は40 ℃で1.12 A、50 ℃で1.04 Aになる（`方式をPTCへ変更した（2026-08-26、人間の判断）`の減額表）。
**50 ℃では`1.04 × 0.8 = 0.832 A`となり840 mAを下回るため、上限が成立しない。**
**したがって周囲温度の記録は任意ではなく要件である。**測定のたびに周囲温度を記録し、
`MEAS-04`（手持ちのSwitchBot温湿度計。`hardware-bom.md`の`MEAS-04`）で摂氏を読む。
**記録が無い測定は、この節の上限（1.08 A）がどの温度で成立していたかを示せない。****2026-10-27：上限は40 ℃基準の0.896 Aへ当て直した**（`上限を40 ℃基準の0.896 Aへ当て直す（2026-10-27、#405）`）。**この節の1.08 Aは23 ℃の値である。**

###### 境界は240 mAへ広がった（2026-08-26）

**2026-10-27：この境界は23 ℃の値である。**40 ℃基準では、LEDを含まない構成で56 mA、LEDを含む構成で31.6 mAになる（`上限を40 ℃基準の0.896 Aへ当て直す（2026-10-27、#405）`）。

```text
(840 + x) / 0.8 < 1350     =>     840 + x < 1080     =>     x < 240 mA
```

| 量 | 2026-08-22 | 2026-08-25 | 2026-08-26以降 |
|---|---|---|---|
| 上限に置いた定格 | 1500 mA（嵌合接点） | 1250 mA（ヒューズ） | **1350 mA（PTCの`Ihold`）** |
| MSP2807の許容上限 | `x < 360 mA` | `x < 160 mA` | **`x < 240 mA`** |

**境界の240 mAそのものが閉じる側である**（下限が厳密不等号であるため）。
**段階B-2の合否の境界が、ヒューズを採っていたときより緩んだ。**

**この値も周囲温度に従属する。**40 ℃なら`(840 + x) / 0.8 < 1120`で`x < 56 mA`まで狭まる。
**23 ℃を前提にした値である。**
**[#514](https://github.com/wachi-yoshitaka-11-dev/deskcat/issues/514)のLEDを含まない構成の値である。**LEDを足す場合は`#514のLEDを追加する場合の差分`（23 ℃で`x < 215.6 mA`）を使う。

##### 窓が閉じる境界（2026-08-22の計算）

**この節は2026-08-22時点の計算である。2026-08-25に`PROT-OC-01`を選定して判明している
最小定格が下がり、2026-08-26に方式をPTCへ変更して上がったため、窓と境界の現行値は
`境界は240 mAへ広がった（2026-08-26）`が持つ（2026-08-25時点の記録は次の
`判明している最小定格が1.25 Aへ下がった（2026-08-25）`にある）。****以下は当時の計算として残す。**

**`選定順序（循環にしない）`は「下限と上限が両立しない場合」の対処を定めているが、
その境界値を計算していなかった。**手順1〜3の入力は揃っているため計算できる。**新しい仮定は置いていない。**

入力は次の2つで、いずれもこの文書の既存の表から取る。

- **負荷側の想定定常電流**: `ingressに必要な定格の見積もり`の各branch
- **保護対象の最弱部品の定格**: `経路部品と定格`の最小値。**現時点で判明している最小は嵌合接点の1.5 A**

```text
下限  I > (定常電流の合計) / 0.8         ... 連続通電できる電流の80%が想定負荷を「上回る」
上限  I <= (最弱部品の定格)              ... 最弱部品が焼けるまで通さない
```

**下限は厳密不等号である。**`方式によらない基準`は`その電流の80%が、想定する定常電流の合計を上回ること`
と定めており、**等号を含まない。**したがって`合計 / 0.8`そのものは窓に入らない。

**MSP2807を除いた合計は 240 + 350 + 250 = 840 mA である**（ESP32 board、Raspberry Pi Zero W、
SERVO-01の割り当て予算）。**MSP2807は未確認であり、これが唯一の未知数である。**

| 量 | 値 |
|---|---|
| 下限（MSP2807を除く） | **I > 1050 mA**（840 / 0.8。**1050 mA そのものは含まない**） |
| 上限（判明している最弱部品） | **I <= 1500 mA** |
| **窓** | **1050 < I <= 1500 mA** |

**MSP2807の定常電流を`x`とすると、窓が空でない条件は次になる。**

```text
(840 + x) / 0.8 < 1500     =>     840 + x < 1200     =>     x < 360 mA
```

**したがって、MSP2807の定常電流が360 mA以上になると窓は閉じる。**
**境界の360 mAそのものが閉じる側である。**そのとき下限が上限に達し、
**両方を満たす保護部品は存在しない。**

**これは保護部品の選定の問題ではない。**`選定順序（循環にしない）`の末尾が定めるとおり、
**経路の定格が負荷に対して足りていないという結論**であり、対処は
servo railのingressをMicro-Bを経由しない経路へ変更するか、
`servo-safety-limits.md`のtrajectory制限で定常電流そのものを下げるかである。

**この境界値は段階B-2の測定に対する合否の境界になる。**
`段階B-2の測定`でMSP2807の3.3 V側定常電流を測り5 V側へ換算した値が**360 mA以上**なら、
**保護部品の選定へ進む前に経路の変更か制限の締め直しを決める。**
**ただしこの360 mAを段階B-2の合否に使わない。**2026-08-25に境界が下がり、
2026-08-26に方式をPTCへ変更したことで再び動いており、
**段階B-2へ課す現行の境界は`境界は240 mAへ広がった（2026-08-26）`が持つ**
（2026-08-25時点の記録は`判明している最小定格が1.25 Aへ下がった（2026-08-25）`にある）。

**この計算が主張しないこと。**

- **上限の1500 mAは確定値ではない。**`経路部品と定格`には未確定の行が残っており、
  **より低い定格の要素が現れれば上限は下がり、窓はさらに狭くなる**（360 mAの境界も下がる）。
  **2026-08-25にこれが実際に起きた**（次節）。
  **上限を上げる手段はrail側の実装方法に依存する。**2026-08-24に②（直付け）で確定したため
  rail側のAメスは経路に現れないが、**変換基板を交換するだけで上限が上がるとは言えない**
  （Pi側の嵌合接点と線材・接続部材が`TBD`である。`rail側の受け方は②（直付け）で確定した（2026-08-24、人間の判断）`）。
- **方式（PTC／ヒューズ）を決めていない。**窓は方式によらない基準から出したものであり、
  **方式ごとの追加条件**（遮断特性、遮断能力、周囲温度による減額）**は別に満たす必要がある。**
- **品番を選んでいない。**窓の中に実在の品があるかは調べていない。
- **servoの250 mAは割り当て予算であって実測値ではない。**予算を改訂する場合は
  `ingressに必要な定格の見積もり`が定める正式改訂の手順を踏み、この計算をやり直す。

###### 判明している最小定格が1.25 Aへ下がった（2026-08-25）

> **この節の値は2026-08-26に更新された。現行の最小定格は1.35 A、上限は1.08 A（どちらも23 ℃基準）である。2026-10-27に、上限は40 ℃基準の0.896 Aへ当て直した**（`上限を40 ℃基準の0.896 Aへ当て直す（2026-10-27、#405）`）
> （`最小定格は1.35 Aへ上がった（2026-08-26）`）。
> **以下はガラス管ヒューズ1.25 Aを採っていた時点の記録であり、書き換えていない。**

**入力のうち上限側が変わった。**`経路部品と定格`の最小値が、嵌合接点の1.5 Aから
`PROT-OC-01`のヒューズの定格電流1.25 Aへ下がった（`方式と品番を決定した（2026-08-25）`）。
**保護部品は`選定順序（循環にしない）`手順4のminの対象である**ため、選定した品自身が
経路の最小値になりうる。**このやり直しはその帰結である。**

**下限は変わらない。**負荷側の想定定常電流（MSP2807を除く840 mA）に変更が無いためである。

```text
下限  I > 840 / 0.8 = 1050 mA     ... 1050 mA そのものは含まない（厳密不等号）
上限  I <= 1250 mA                ... 判明している最弱部品＝ヒューズの定格電流
```

| 量 | 2026-08-22 | 2026-08-25 |
|---|---|---|
| 判明している最小定格 | 1500 mA（嵌合接点） | **1250 mA（ヒューズの`In`）** |
| 窓 | 1050 < I <= 1500 mA | **1050 < I <= 1250 mA** |
| ingressの上限（gate値） | 1200 mA以下 | **1000 mA以下** |
| MSP2807の許容上限（窓が閉じる境界）。**5 V入力側へ換算した値である** | 360 mA | **160 mA** |

**選定した1.25 Aは窓の上端であり、窓の中にある**（上限は等号を含む）。
境界の計算は次のとおりである。

**`x`は、MSP2807の定常電流を5 V入力側へ換算した値である。**
**段階B-2が測るのは3.3 V側であり、その測定値をそのまま`x`へ代入しない。**
**換算前の3.3 V側の値を代入すると、実際のingress電流が上限を超える負荷を窓の中と判定しうる。**
（この明示は[PR #235](https://github.com/wachi-yoshitaka-11-dev/deskcat/pull/235)の手動reviewの指摘であり、[#236](https://github.com/wachi-yoshitaka-11-dev/deskcat/issues/236)で追記した。**境界値は変えていない。**）

**換算の規則と、それが今は受け入れ判定に使えない理由は、上の[PC host側の扱い](#pc-host側の扱い)が正本である。**
**ここへ再掲しない。**同節が持っているのは、`Iin ≒ Iout + Iq`が成り立つこと（`U2`はLDOであると
2026-08-15に確定した）、`Iq`の一次資料値、**5 V側へ足せるのはB-2aで得た値だけであること**、および
**`EXT_5V`の直接負荷を現物で追跡するまでこの換算値をingress予算の受け入れ判定に使わないこと**である。

**したがってこの境界は、換算の式が書けることとは別に、まだ判定に使えない。**
**段階B-2の測定値が出ても、同節の条件を満たすまで合否を出さない。**

MSP2807の定常電流を5 V入力側へ換算した値を`x`とすると、窓が空でない条件は

```text
(840 + x) / 0.8 < 1250     =>     840 + x < 1000     =>     x < 160 mA
```

**したがってMSP2807の定常電流を5 V入力側へ換算した値が160 mA以上になると窓が閉じる。
境界の160 mAそのものが閉じる側である。****3.3 V側の測定値と直接比べない。**閉じた場合の結論は2026-08-22の計算と変わらず、**保護部品の選定の問題ではなく
経路の定格が足りていないという結論**である（`窓が閉じる境界（2026-08-22の計算）`。
**対処の2案もそこにある。ここへ再掲しない**）。

**この改訂が主張しないこと。**

- **保護部品を入れたことで上限が上がったのではない。下がった。**「保護部品を付けたから
  余裕ができた」と読まない。**定常見積840 mAに対する上限1000 mAの余裕は19%である**
  （[#205](https://github.com/wachi-yoshitaka-11-dev/deskcat/issues/205)）
- **「ヒューズを経路の最弱点に置いたから経路の定格を測らなくてよい」とは言えない。**
  経路には1.5 Aの嵌合接点が残っており、**1.5〜2.625 Aの帯では、このヒューズが120秒以内に
  溶断することが保証されない**（`方式と品番を決定した（2026-08-25）`の関門表。1.5〜1.875 Aは
  `60 minutes, Minimum`により**60分以内には溶断しない**ことが保証され、1.875〜2.625 Aは
  **どちらにも保証が無い**）。**その帯の電流は、1.5 A定格の接点を定格超過で流れうる。
  この帯を守るのは保護部品ではなく、上限1000 mAの運用側である**
- **1250 mAも確定値ではない。**ホルダの定格が未記載であり、`経路部品と定格`には
  ほかにも未確定の行が残る。**より低い定格が現れれば上限と境界はさらに下がる**
- **締め直しの判断はしていない。**境界が下がったことで段階B-2の合否は厳しくなったが、
  **段階B-2は`HW-TBD-025`の共通条件が未確定で実施できない**（`段階B-2の測定`）。
  **とくにMSP2807の安全な電流上限が未公開である限り、B-2aもB-2bも実施できない。**
  （2026-09-28のユーザー決定で、今の接続のままの電流測定は例外とした。`段階B-2の測定`参照）
  **2026-08-26に人間が方針を決めた**（`servo予算の見直しで窓を広げる（2026-08-26、人間の判断）`）

###### servo予算の見直しで窓を広げる（2026-08-26、人間の判断）

**窓が閉じるかどうかは、段階B-2でMSP2807を測るまで分からない。**そして段階B-2は
`HW-TBD-025`の共通条件が未確定で実施できない。**この行き止まりに対して、2026-08-26に
人間が「servo予算の見直しで窓を広げる」方針を採った。**

**測定を待たずに動かせる量が1つあるためである。**`ingressに必要な定格の見積もり`の
servo行の値は、**実測値ではなく設計上の割り当て予算**である（同節が明記している）。
**予算を下げれば下限が下がり、MSP2807に許される幅が広がる。**
**この節へその値を書かない。**この判断で動く値そのものであり、書けば必ず古くなる。

**関係は次のとおりである。**`ingressに必要な定格の見積もり`のservo予算を`S`、
MSP2807の定常電流を`x`とすると、窓が空でない条件は

```text
(ESP32 + Pi + S + x) / 0.8 < 判明している最小定格
```

**左辺の`S`と`x`は同じ側にあり、係数が等しい。****したがって`S`を下げた分だけ、
`x`に許される幅がそのまま同じだけ増える**（1対1である）。

**ここへ再掲しない。**`S`を変えたときの新しい境界は、上の1対1の関係で同節の値から動かせる。
**定数をこの節へ書かない。**右辺が最小定格に従属し、最小定格は今後も動きうるためである
（実際に2026-08-25に1.5 Aから1.25 Aへ動いた）。

**この方針が変えないもの。**

- **gate値は変わらない。**上限は`最小定格 × 0.8`で決まり、`S`に依存しない
- **`PROT-OC-01`の選定も変わらない。**`S`を下げると下限が下がるだけであり、
  選定した品の定格電流は引き続き窓の中にある
- **測定を省けるわけではない。**段階Cでは実際の定常電流を測り、gate値に収まることを確認する。
  **`S`はそのとき守られていることを示す対象であって、示さずに済ませる値ではない**

**この方針はまだ実行されていない。**新しい`S`の値が決まっていないためである。
**値を決めるには2つが要る。**

1. **`S`をいくつにするかの判断。**AIが提案し、人間が承認する
2. **その`S`が実際に守られること。**`servo-safety-limits.md`の可動域・速度・duty cycleで
   強制する。**予算を下げても、servoがそれを超えて引けば意味が無い**

**実行するときは`ingressに必要な定格の見積もり`が定める正式改訂の手順を踏む。**
**電源側とservo側の片方だけを変えない。**

##### 方式によらない基準

| 基準 | 内容 |
|---|---|
| 連続通電できる電流の下限 | **その電流の80%が、想定する定常電流の合計（`ingressに必要な定格の見積もり`）を上回ること。**単に上回るだけでは足りない。この電流が経路の最小値になった場合、上限はその80%になるため、80%の側で判定しないと選んだ直後に上限が想定負荷を下回る。**PTCなら保持電流、ヒューズなら定格電流がこの「連続通電できる電流」である** |
| 連続通電できる電流の上限 | **保護対象の最弱部品の定格以下**であること。これを超える品は、最弱部品が焼けるまで電流を通し続ける |
| 遮断特性 | 過負荷時に、最弱部品の熱定格を超える電流が**その部品の熱時定数より短い時間で**止まること。**時間-電流特性が公開されている品を選ぶ** |
| 定格電圧 | 5 Vに対して余裕があること |
| 遮断能力 | M-12001が供給しうる最大電流（3 A）を安全に遮断できること。**ヒューズでは`breaking capacity`として公開される。PTCは遮断せず高抵抗化するため、この量の扱いが異なる。方式ごとにメーカー資料で確認する** |

**方式を決めたうえで、具体的な品番と数値は発注直前にメーカーの一次資料（時間-電流特性）で選び、
選定後にこの節へ記録する。**現時点は`TBD`である。記憶や一般値で置かない
（`AGENTS.md`の推測禁止）。追跡は[HW-TBD-021](tbd-register.md)で行う。

#### 記録するtrip動作

**品番と数値を書くだけでは、3 Aを供給できる電源に対して最弱部品を守れるか判定できない。**
「何Aで切れるか」だけでなく「**その電流で何秒かかるか**」「**運用電流では切れないか**」が
揃って初めて、最弱部品の熱定格を超える前に止まると言える。選定後に次を記録する。

**採った方式の欄だけを埋める。**もう一方の欄は「採用せず」と記録する。

| 記録する項目 | PTCを採る場合 | ヒューズを採る場合 | 合否の判定 |
|---|---|---|---|
| 定常電流継続時の動作 | 保持電流（`Ihold`）の公表値と、その周囲温度条件 | 定格電流（`In`）の公表値と、その周囲温度条件 | 想定する定常電流の合計を連続して流してもtrip／溶断しないこと。するなら品を選び直す |
| 遮断へ移行する電流 | trip電流（`Itrip`）。**保持電流とは別の値である** | 時間-電流特性上で、対象時間内に溶断する電流 | 保護対象の最弱部品の定格を超える電流で確実に切れること |
| 遮断までの時間 | 上記`Itrip`におけるtrip時間 | 上記電流における溶断時間 | **最弱部品の熱時定数より短いこと。**時間-電流特性から読み、読んだ点（電流・時間・温度条件）を記録する |
| M-12001の供給上限での動作 | 3 Aを流したときのtrip時間 | 3 Aを流したときの溶断時間。あわせて**遮断定格（breaking capacity）が3 A以上**であること | 最弱部品が熱定格を超える前に切れること |
| 通過エネルギー | PTCは遮断せず高抵抗化するため、`I²t`は通常公開されない。**公開が無いことを記録する** | **`I²t`（溶断`I²t`）**。公開されていれば記録する | 最弱部品が耐えられる範囲であること。判定できない場合はその旨を記録する |
| 復帰 | 自己復帰。復帰条件（電源を切る必要の有無、復帰後の抵抗値の戻り）を記録する | 交換式。**予備の有無**を記録する | bring-upでは上限を意図的に探るため、復帰の手間が運用に効く |
| 確認方法 | メーカーの時間-電流特性（一次資料）か、**電流制限を設定できる電源を使った実測**のどちらか | 同左 | 記憶や一般値で埋めない。どちらで確認したかを明記する |

**この記録が揃うまで段階Cを実施しない。**方式・品番・数値の記載だけでgateを通したと扱わない。

**`MF-R135`（PTC）の記入状況（2026-08-27）。**定常電流継続時の動作・遮断へ移行する電流・
復帰・確認方法は`方式をPTCへ変更した（2026-08-26、人間の判断）`の`datasheetが与える量`が
埋めている。**`M-12001の供給上限での動作`（3 Aでのtrip時間）は`3 Aでのトリップ時間を読み、
線材と嵌合接点の判定で止まった（2026-08-27）`のとおり、確定値としては読めなかった
（下界のみ）。****`遮断までの時間`と`通過エネルギー`は、比較対象の熱時定数と`I²t`耐量が一次資料に無いため判定できない**（**2026-09-12訂正。**旧文は
「最弱部品（嵌合接点1.5 A）の熱時定数と`I²t`耐量」だったが、**同嵌合接点は2026-09-09の案Bで経路から外れた。**
比較対象は`経路部品と定格`の**保護対象側の最弱部品**であり（**`PROT-OC-01`自身は含まない。**同表の判明値の
最小は`PROT-OC-01`のPTCであるため、単に「最小値」と書くと循環する）、**具体の品はこの訂正では特定しない**）。したがってこの表は
**未充足のまま残る。**

#### 選定順序（循環にしない）

保護部品も線材も経路上の部品であり、その定格は`経路部品と定格`表の1行である。
一方でingressの上限はその表の最小値から決まる。**「上限が決まってから部品を選ぶ」
と書くと循環する。**次の順序で決め、逆流させない。

| 順 | 決めるもの | 入力（何を参照するか） |
|---|---|---|
| 1 | **負荷側の想定定常電流の合計** | `ingressに必要な定格の見積もり`の各branch。**経路側の定格もgate値も参照しない** |
| 2 | **線材・接続部材（`WIRE-PWR-01`）の定格** | 下限は`許容電流 × 0.8 ＞ 手順1の合計`。公称許容電流のある品から選ぶ。**gate値を参照しない** |
| 3 | **保護部品（`PROT-OC-01`）の方式と、連続通電できる電流** | まず方式（PTC／ヒューズ）を決める。下限は`その電流 × 0.8 ＞ 手順1の合計`、上限は`その電流 ≦ 手順2までに確定した最弱部品の定格`。**gate値を参照しない** |
| 4 | **ingressの上限（gate値）** | 手順1〜3で確定した`経路部品と定格`表の最小値 |

```text
上限 = min(経路部品の定格すべて。保護部品が連続通電できる電流と線材の許容電流を含む) × 0.8
```

手順1〜3はいずれも**負荷側の見積もりと候補部品の公表定格だけ**を入力とし、gate値を
参照しない。したがって`WIRE-PWR-01`が未確定でも手順2から順に埋められる。
gate値は最後に一度だけ計算する。**手順4の結果を手順2や3の入力に使わない。**

**下限と上限が両立しない場合は、経路の定格を上げる。**想定定常電流の合計が最弱部品の
定格に近いと、下限（連続通電できる電流の80%が想定負荷を上回る）を満たす保護部品が、上限
（その電流が最弱部品の定格以下）を満たさなくなる。**これは保護部品の選定の問題ではなく、
経路の定格が負荷に対して足りていないという結論である。**その場合は、servo railの
ingressをMicro-Bを経由しないより定格の高い経路へ変更するか、`servo-safety-limits.md`の
trajectory制限で定常電流そのものを下げる。`ingressの電流制限`の末尾に挙げた2案と同じ選択である。

### ingressに必要な定格の見積もり

ingressを実測できるのは段階Cであり、段階Cのgate（端子台（**2026-09-09、案Bにより「変換基板」から差し替え**）、過電流保護部品、大電流経路の
線材）を満たす必要がある。しかもそのうち2つは、この見積もりを入力として選ぶ
（`選定順序（循環にしない）`）。したがって購入前の見積もりは、
**実測できるbranchは実測し、実測できないbranchは根拠のある保守的な上限を置いて**足す。
定常電流はこの足し方をしてよい（peakと違い、時間的に重なる前提を置く必要がない）。
足す値は、**同時に継続しうる動作条件での定常電流**とする。

| branch | 見積もりの根拠 | 値 |
|---|---|---|
| ESP32 board | 文献値。Wi-Fi TXを継続した場合 | 240 mA |
| Raspberry Pi Zero W | 公式specのstress時。上限側を採る | 350 mA |
| MSP2807（LCD＋backlight＋touch） | **未確認。段階B-2（3.3 V側で定常電流を測る）で実測できる。ここが唯一の未知数である。**実施には**共通条件**（許容電圧範囲と全moduleの安全な電流上限。`HW-TBD-025`）に加えて、B-2a（`3V3` pinの定格とregulator保護の確認）かB-2b（電流制限の動作確認、無負荷出力電圧の確認）のどちらかの条件が要る。**どちらの経路で得た値かを必ず記録する。**5 V側へ足せるのは**B-2aで得た値だけ**である（B-2bはregulatorを通らないため入力側の電流が発生しない。`B-2bの結果で言えないこと`）。**どちらの条件も満たせない場合、この行は段階Cまで実測待ちのまま残る。****2026-10-27更新：段階Cの測定4も行わないと決めた（`MSP2807の電流上限の扱いと、段階Cの測定4（2026-10-27、#556）`）。この行の実測は、最終の構成を決める#405の見直しまで残る** | **実測待ち** |
| SERVO-01（SG90） | **実測できない**（servoへ5 Vを供給する経路がingressしかないため）。**datasheetの保証値ではなく、設計上の割り当て予算である。**一般に示されるSG90の連続動作電流（概ね100〜250 mA）の上限側を採った。stall電流は採らない（connector定格は熱の制限であり、stallは過渡のため） | 250 mA（**予算**） |

**#514のLEDを追加する場合の差分。**上表と本書の「840 mA＋MSP2807」「MSP2807の境界240 mA」はLEDを含まない既存構成の見積もりである。[初回デモ回路案](led-514-demo.md)では3V3 railに最大`2 × 3.6 V / 313.5 Ω + 2 × 3.6 V / 5 kΩ ≈ 24.4 mA`（2本のLED枝と2本のpull抵抗）を数える。LEDの電流はGPIOから出る。その電流が`3V3` pinを通るかは記録が無く、安全側の仮定として数える（[初回デモ回路案](led-514-demo.md)の`3V3 pinへ負荷を足す条件`）。pullの10 kΩは許容差の記録が無いため、抵抗の半分（5 kΩ）として見積もる。313.5 Ωは電流制限抵抗`R`（330 Ωの`CF25J330RB`）のdatasheetの許容差の下限である。ESP32 board上のLDO入力電流の増分も約24.4 mAと置くと、合成給電の基礎値は `840 + 24.4 = 864.4 mA`、PTCの連続通電下限 `1.35 A × 0.8 = 1080 mA` に対するMSP2807の境界は `864.4 + x < 1080`、すなわち **`x < 215.6 mA`** となる（`x`は5 V入力側に換算したMSP2807の定常電流）。**240 mAの境界をLED追加後へ流用しない。**240 mAと同じく**23 ℃を前提にした値である**。**2026-10-27に上限を40 ℃基準の`1.12 A × 0.8 = 896 mA`へ当て直した**ため、設計の基準は`864.4 + x < 896`、すなわち`x < 31.6 mA`である（`上限を40 ℃基準の0.896 Aへ当て直す（2026-10-27、#405）`）。この計算は`R`のdatasheetの許容差の下限での見積もりであり、実機のLED電流、3V3 railの電圧・regulator余裕、MSP2807の電流はまだ測っていない。LEDを含めた合成給電の受け入れはこれらの確認後に行う（2026-10-27更新：段階CではMSP2807を測らない。`MSP2807の電流上限の扱いと、段階Cの測定4（2026-10-27、#556）`）。**上限は`marginの定義`の規則（定格の最小値の80%）による値である（1080 mAは23 ℃、896 mAは40 ℃）。測った電流を合否に使うときは`電流の測定点と読みの確かさの基準`に従い、`DT830B`の読みは合否に使わない。読みを合否に使える条件は[#525](https://github.com/wachi-yoshitaka-11-dev/deskcat/issues/525)が持ち、LED電流の実測値はその条件が定まるまで記録にとどめる。****これは段階C（合成給電）の境界であり、段階B-2a（ESP32 boardの`3V3` pinから取る）の負荷にLEDを数えてよいかは別の問いである。**そちらは[初回デモ回路案](led-514-demo.md)の`3V3 pinへ負荷を足す条件`が持ち、人間の承認は2026-10-12に得た（[#514のコメント](https://github.com/wachi-yoshitaka-11-dev/deskcat/issues/514#issuecomment-6124265343)）。

servoの250 mAは**割り当てた予算**であり、測って得た値ではない。実機がこれを継続して
超えないことは、`servo-safety-limits.md`のtrajectory制限（可動域、速度、duty cycle）で
担保する。**この予算は同文書の動作制限表へ`最大連続電流`として渡してある。**
渡さずに電源側だけで持つと、firmwareが何を守ればよいか分からないまま実装される。

**ただし渡すだけでは強制されない。**予算が守られていることは、`測定計画`の`サーボ試験`と
`servo-safety-limits.md`の受け入れchecklistで、**承認範囲内の最悪動作における定常電流の
実測**として確認する。そのとき強制していた可動域・速度・duty cycleを同文書へ記録する。

**実測でこれを超えた場合、既定の対処は制限を締めることである。**`servo-safety-limits.md`の
可動域・速度・duty cycleを締めて再測定する。

**ingressの定格を上げるだけでは、この予算の違反は解消しない。**250 mAはservoの動作制限へ
渡した値であり、経路側の定格とは別の量である。経路の定格を上げても、firmwareが守るべき
値は変わらない。予算そのものを変えるには次の**正式改訂**を踏む。

1. `ingressに必要な定格の見積もり`のservo行を新しい値へ改訂し、合計を再計算する
2. `servo-safety-limits.md`の動作制限表の`最大連続電流`を同じ値へ改訂する（片方だけ変えない）
3. 新しい合計に対して`選定順序（循環にしない）`をやり直し、線材・保護部品・gate値を決め直す
4. 両文書のRevision履歴へ改訂理由を残し、受け入れchecklistを最初から通し直す

締めるか改訂するかを選ぶのであって、**測定値に合わせて判定を緩めるのではない**。

未知数はMSP2807の1つだけである。**この未知数には上限がある。****5 V入力側へ換算した値が240 mA以上になると過電流保護部品の選定の窓が閉じる**（#514のLEDを含まない構成。LEDを足す場合は`#514のLEDを追加する場合の差分`の215.6 mA。境界そのものが閉じる側である。**3.3 V側の測定値と直接比べない**）（`境界は240 mAへ広がった（2026-08-26）`。**2026-08-22の360 mAが2026-08-25に160 mAへ下がり、2026-08-26にPTCへ変更して240 mAへ広がった。**この値は判明している最弱部品の定格に依存するため、より低い定格が現れればさらに下がる。**23 ℃を前提にした値である。40 ℃基準では56 mA（LEDを含む構成は31.6 mA）である**。`上限を40 ℃基準の0.896 Aへ当て直す（2026-10-27、#405）`）。**したがって段階B-2の測定は、この境界に対する合否の判定でもある。**`3V3` pinの定格を確認したうえで段階B-2で測り、regulatorの種別を確認して5 V側へ
換算すれば合計が確定し、**保護部品（`PROT-OC-01`）の品をingressの実測を待たずに選べる**（**2026-09-09、案Bにより「変換基板の品」から差し替え**）。

段階Cの実測がこの見積もりを超えた場合、**超えたbranchによって扱いが分かれる**。
servo branchは上記の正式改訂の手順による。それ以外のbranchは、この表の見積もりを
実測値へ改め、`選定順序（循環にしない）`を手順1からやり直す。
**実測値に合わせてgate値だけを引き上げる、という直し方はしない。**

**この表が見積もるのは負荷側の消費電流であり、経路側の定格ではない。**上限を決める
のは`ingressの電流制限`の`経路部品と定格`表であって、この表ではない。混同しない。

この制約は`受け入れ条件`にも数値として記載している。

## 負荷表

| Rail | 負荷 | 数量 | Typical電流 | 最大連続電流 | Transient／peak | 根拠 | 確度 |
|---|---|---:|---:|---:|---:|---|---|
| Logic | ESP-WROOM-32D board | 1 | 約80〜100mA（WiFi idle） | 約240mA（WiFi TX時、文献値） | 短時間で最大約500mA相当のspikeが報告例あり | [ESP32技術資料](https://www.espressif.com/sites/default/files/documentation/esp32_datasheet_en.pdf)を含む複数の技術資料（[参考](https://lastminuteengineers.com/esp32-sleep-modes-power-consumption/)） | **文献値。実測前** |
| Logic | Raspberry Pi Zero W | 1 | 約140mA（公式spec） | 実測未定 | Stress時最大約350mAの報告例あり | [Raspberry Pi公式spec](https://www.raspberrypi.com/products/raspberry-pi-zero-w/) | **文献値。実測前** |
| ESP32 3V3出力 | MSP2807（LCD＋backlight＋touch） | 1 | TBD（メーカー未公開） | TBD | TBD | 秋月商品ページに電流記載なし。logic IOが3.3V TTLのため3.3V給電とする（`電源rail構成案`参照）。backlight込みの電流次第では3V3 pinの供給能力を超える可能性があり、その場合は別途3.3V regulatorが必要。2026-10-01に周辺module3点を合わせた電源pinの電流を読んだ（[experiment-log.md](experiment-log.md)の`EXP-019`。MSP2807単独の値ではない） | Blocked（**入手済み・単独の実測は未実施**） |
| ESP32 3V3出力 | ADXL345（accelerometer） | 1 | 140µA typ（ODR ≥ 100Hz。standbyは0.1µA typ） | **TBD**（`HW-TBD-025`(b)） | **TBD**（`HW-TBD-025`(b)） | 消費電流の出典は[ADXL345 Data Sheet](https://www.analog.com/media/en/technical-documentation/data-sheets/adxl345.pdf) Rev. G Table 1 page 4およびTable 7 page 13（**data rate別の表で最大は140µAである。ただしtyp値であり、datasheetにmax欄は無い**）。**旧記載はDigi-Keyの解説記事を出典としていたが、2026-08-12にメーカー一次資料へ差し替えた**（Revision 37）。**Logic 5V railへは直結しない。****確認前の安全規則である**（ICの動作上限3.6Vも絶対最大定格3.9Vも超えうるため。**IC定格からmodule boardの許容入力電圧は決まらない**）。**3.3Vも唯一の候補であって確定ではない**（`HW-TBD-004`）。**旧記載の「M-06724はregulator非搭載のため3.3V直結必須」は、根拠資料（秋月 商品ページ。現在404）を失ったため2026-08-12に削除した**（Revision 36） | **文献値。実測前** |
| ESP32 3V3出力 | BME280（environment sensor） | 1 | 数µA〜1mA未満（測定mode時） | 無視できるほど小さい想定 | 無視できるほど小さい想定 | Bosch公式BME280データシート（一般値）。現物付属説明書の電源電圧DC1.71～3.6Vのため5V直結不可（Logic 5V railへは直結しない） | **文献値。実測前** |
| ESP32 3V3出力 | #514の白・赤LEDと起動用pull | 各2 | TBD（白の3.3 Vでの点灯量は未確認） | 最大約24.4 mA（3.6 V、330 Ω−5%のLED枝×2と、許容差の記録が無いため5 kΩとして見積もった10 kΩ pull×2から計算した値。実測ではない。GPIOの電流が`3V3` pinを通るかは記録が無く、安全側の仮定として数えた） | 同左 | [初回デモ回路案](led-514-demo.md)。合成給電の差分計算は上の「#514のLEDを追加する場合の差分」 | 回路案・実機未確認 |
| Servo | TowerPro SG90 | 1 | 数十〜数百mA（動作時、負荷依存） | **250 mAを予算として割り当て**（`ingressに必要な定格の見積もり`）。実測値はTBD | **動作電流としてのメーカー回答値は0.5〜2 A（負荷依存の広い範囲）。**この欄が指すtransient／peak電流そのものは未確定である（実測が要る。`HW-TBD-010`／`011`）。**`データシート値`という表記を2026-08-24に外した。****この値はメーカーが`operation current`として述べたものであり、transient／peak／stallの実測ではない**（`The operation current for our SG90 is about 0.5A - 2A.`）。**2026-08-25に、この欄の中で種別を書き分けた**（[#193](https://github.com/wachi-yoshitaka-11-dev/deskcat/issues/193)）。**値は落としていない。`TBD`へ戻したのでもない**（[PR #194](https://github.com/wachi-yoshitaka-11-dev/deskcat/pull/194)の判断は維持する）。**250 mAの予算、`確度`欄の`文献値。実測必須`、gate値はいずれも変えていない。** | [TowerPro公式 SG90 Digital](https://towerpro.com.tw/product/sg90-7/)（**公式のdatasheet PDFは無い。**この0.5〜2 Aは仕様表ではなくDigital側ページのQ&A欄にある`admin`（メーカー側）の回答（2021-11-07）にのみ由来し、**Analog側ページは`Reviews (0)`である。どちらの品かが未確定なため、variantに依存しない値として扱わない。**正は[hardware-bom.md](hardware-bom.md) `SERVO-01`） | **文献値。実測必須（`tbd-register.md` HW-TBD-010／011。model自体はHW-TBD-006で解決済み）。予算250 mAと実測の扱いは変えていない** |

**重要**: 上表の大半は「文献値」であり、この文書の目的である実測値ではない。特にLogic railの同時最大peak
（ESP32 TX spike＋Pi stress＋LCD backlight）とServoのstall電流が重なる最悪caseは、単一電源(M-12001、5V/3A)の
margin不足リスクがある。実測するまで、この表の値を最終受け入れの根拠にしない。

**量ごとに見る対象が違う。**connector定格の判定は**定常電流**（テスター直列、
`ingressの電流制限`）、servoのpeakは`ADC-SHUNT`、peakによる電圧降下は
`ADC-5V`／`ADC-3V3`である。混同しない。

## 容量計算

**rail間の従属関係**: 負荷表の`ESP32 3V3出力` railは独立した電源ではなく、ESP32 board上の
regulatorが`Logic` railの5Vから作っている。したがって入力電源（M-12001）の容量を求めるときは、
3V3 railの負荷も5V rail側の消費に含める。regulatorの変換効率と自己消費があるため、
3V3側で消費した電力に対して5V側の消費はそれ以上になる。3V3 railを独立した予算として扱い、
入力電源の合計から除外しない。

**電力で見る上の議論と、電流で見る換算を混同しない。**ingressの上限は**電流**で判定する
（`ingressの電流制限`）ため、3.3 V側の実測値から5 V側の**電流**を出す必要がある。その換算は
regulatorの種別に依存し、LDOなら`Iin ≒ Iout + Iq`、switchingなら電力比で決まる。手順と
前提は`段階B-2の測定`に置く。**2026-08-15に種別がLDOと確定したため、`Iin ≒ Iout + Iq`を採る**
（`U2`＝UMW `LD1117-3.3`。`HW-TBD-023`(b)）。

各railについて次を満たす。

```text
required_continuous_current
  >= sum(maximum simultaneous continuous loads) × design margin

required_transient_current
  >= sum(simultaneous credible transient loads)
```

採用したdesign marginとその理由を記録する。不明なpeak値を割合marginで隠さない。

一次近似によるcapacitor見積もり:

```text
ΔV ≈ I × Δt / C
```

最終値では、電源の応答、配線抵抗、capacitor ESR、測定したサーボwaveformを考慮する。

## 配線・保護表

| 項目 | 要件 | 選定値／部品 | 根拠 | 状態 |
|---|---|---|---|---|
| 入力電源 | 電圧、連続電流、peak電流 | スイッチングACアダプター MicroBオス 5V／3A（秋月 M-12001） | [秋月商品ページ](https://akizukidenshi.com/catalog/g/g112001/) | Selected（実測でmargin確認要）。**なおRaspberry Pi公式documentationは全modelが5.1 V供給を要求すると述べており、この品の5 Vとは一致しない**（`受け入れ条件`の`(a)の一次資料は存在しない`。可否の判断は[HW-TBD-007](tbd-register.md)／[HW-TBD-009](tbd-register.md)） |
| **5 V ingress interface** | Micro-Bオスplugの cable を切り、breadboard railへ5 V／GNDを引き出す物理変換 | **調達（発注・着荷）の状態は[#205](https://github.com/wachi-yoshitaka-11-dev/deskcat/issues/205)が持つ。この表は持たない**。**2026-09-09、案Bにより端子台（秋月`114217`、6 A）で受ける構成へ変わった**（旧候補はMicro-Bメスreceptacleの2.54 mm変換基板、秋月 g110972、定格1ピン1.5 A）。M-12001のplugは`EXP-012`で切断済みであり、`PWR IN`へ直挿しできない。段階A・B-1（検証の構成）の間のPiの給電は、段階Aのadapter（`hardware-bom.md`の`PSU-PI-A-02`。cable一体。2026-10-11の差し替えまでは`PSU-PI-A-01`と`CABLE-PI-A-01`）で代用する | `5 V ingress`節の段階表 | **Blocked（合成給電（段階C）までに端子台から先の実装が必要。段階A・B-1（検証の構成）は段階Aのadapterで進行可。段階B-2はPiも5 V railも使わず、この行の実装に依らない）** |
| ESP32の5 V入力経路 | 3系統（Micro USB／5V pin／3V3 pin）の排他制約を守る | **未決定。**[#405](https://github.com/wachi-yoshitaka-11-dev/deskcat/issues/405)の実装設計の見直し（はんだ付けの前）で決める。案A（PiのUSB OTG portからのVBUS単独給電）と案B（`5V` pin給電）はその候補として残す。検証の構成ではPCのUSBから給電する（`gpio-assignment.md`の`信号線をつないでよい条件`の5）。**2026-09-28、[#446](https://github.com/wachi-yoshitaka-11-dev/deskcat/issues/446)のユーザー決定（最終の経路は#405で決める）に合わせて「案Aで確定（2026-08-22、人間の判断）。PiのUSB OTG portからのVBUS単独給電を本線とする。案B（`5V` pin給電＋USBはdata用）は採らないが、案Aが実測で不成立の場合の再検討先として残す」から差し替え** | Espressif ESP32-DevKitC V4文書（3系統は排他）。`ESP32の給電経路（最終の経路は未決定）`節。2026-08-22の判断は同節の`案Aを本線に確定した（2026-08-22、人間の判断。2026-09-28に置き換わった。以下は当時の記録）` | **Blocked**（#405で経路を決めるまで。PiのUSB OTG portの供給能力は、**一次資料は存在しない**ためこの項目は実測しか道が無い。調査結果は同節に記録した。案Bの再検討は案Aの不成立が判定されてからであり、そのときは秋月基板のVBUS保護diodeの有無の回路確認と逆流の実測2通りが条件になる。案A・案Bを採る条件は#405で改めて決める。**2026-09-28、同じ決定に合わせて「残るgateはPiのUSB OTG portの供給能力の実測だけである」を削った**） |
| Piの5 V入力経路 | PWR IN portから給電し、USB OTG portはPiへの給電に使わない（**2026-09-28、[#446](https://github.com/wachi-yoshitaka-11-dev/deskcat/issues/446)のユーザー決定でPi linkがGPIOのUARTへ変わったため、「USB OTG portはPi link専用とする」から差し替え**） | 段階C以降: breadboard railからMicro-Bオスcableで`PWR IN`へ。段階A（Pi単体起動）: `PSU-PI-A-02`（cable一体）のplugから`PWR IN`へ給電し（2026-10-11の差し替えまでは`PSU-PI-A-01`から`CABLE-PI-A-01`を通した）、**GPIOへは何も接続しない**（例外は`5 V ingress`節の`検証の構成の扱い`） | Raspberry Pi Zero W公式回路（PWR INはdata線未接続の給電専用） | Selected（cableの調達（発注・着荷）の状態は[#205](https://github.com/wachi-yoshitaka-11-dev/deskcat/issues/205)が持つ。段階Aは合成給電ではないため電流gateの対象外） |
| Logic regulator／経路 | Pi／ESP32／周辺deviceの要件 | 追加regulatorなし。M-12001の5Vをbreadboard rail経由でそのまま供給するのは**Piのみ確定**（ESP32は上行のとおり給電経路が未決定）。周辺module3点（MSP2807、ADXL345、BME280）は5V railへ直結せず、ESP32 board上の3V3 pinから給電する（理由は`電源rail構成案`参照） | `hardware-bom.md` PSU-PI-01、DISP-01、TOUCH-01、ACCEL-01、ENV-01 | Blocked（ESP32の給電経路が未決定。加えて定常電流の合計と3V3 pinの供給能力が未実測） |
| Servo regulator／経路 | 正確なservo要件 | 追加regulatorなし。M-12001の5Vをbreadboard上で別railに分岐し、直近にbulk capacitorを配置 | `hardware-bom.md` PSU-SERVO-01 | Selected（bulk capacitor容量は実測待ち） |
| Backfeed防止 | USB／外部電源の共存 | TBD | 回路図review | Blocked |
| Servo bulk capacitor | 測定した過渡電流への対応 | 電解コンデンサ470μF／16V（秋月 g108426、ルビコンWXA）。**10個入手済み**（2026-08-08着荷。2026-08-12に購入履歴と照合して訂正した）。使用個数は2〜3個を想定 | [秋月商品ページ](https://akizukidenshi.com/catalog/g/g108426/)。最終容量はESP32＋shunt抵抗によるADC loggingで確定 | Candidate（**部品は入手済み。使用個数が実測待ち**） |
| 電流測定用shunt抵抗 | 波形測定の手段（Oscilloscope代替） | セメント抵抗5W0.1Ω（秋月、SQP5WJ0R1B、¥30）×1〜2個。ESP32 ADCで電圧降下をsamplingし、電流波形を近似する | [秋月商品ページ](https://akizukidenshi.com/catalog/g/g117836/) | Selected（Oscilloscope未所持のため、その購入を避けて低costで対応。**低側に挿入すること**。理由は`測定計画`参照） |
| Local decoupling | 各deviceのデータシートに従う | **datasheetが指定する値と配置は確定した**（[HW-TBD-029](tbd-register.md)は2026-08-12にclose）。値の正は[sensor-datasheet-notes.md](sensor-datasheet-notes.md)の`Local decoupling`節であり、ここには再掲しない。**`ENV-01`は外付け不要**（module上に`C1`／`C2`各0.1 µFを実装済み）。**`ACCEL-01`／`DISP-01`／`MCU-01`は外付けの要否がTBD。**判断は`local decouplingの外付け要否`節 | 各deviceのdatasheet（同節に出典を記載）。**要否はboardの実装でしか決まらないため、現物確認に従属する** | **一部確定**（`ENV-01`は外付け不要で確定。残る3点の**現物確認**は`ACCEL-01`が[HW-TBD-004](tbd-register.md)、`DISP-01`が[HW-TBD-002](tbd-register.md)、`MCU-01`が[HW-TBD-023](tbd-register.md)。**gateは維持している**） |
| Wire gauge／許容電流 | **定常電流**と配線長。許容電流（ampacity）は導体の発熱と放熱で決まる熱の制限であり、判定量は定常電流である。peakは配線長による電圧降下として`ADC-5V`／`ADC-3V3`のdroop測定で確認する | TBD（`WIRE-PWR-01`が未選定）。**gate対象の大電流経路にbreadboard接点とジャンパー線を使わず、公称許容電流のある線材・接続部材で構成する**（`ingressの電流制限`の`大電流経路にbreadboard接点とジャンパー線を使わない`） | 製品資料／計算。判定量の根拠は`ingressの電流制限` | Blocked（[HW-TBD-022](tbd-register.md)） |
| Connector定格 | **定常電流**と誤接続防止 | 上限は**経路上の全部品（保護部品が連続通電できる電流を含む）の定格の最小値の80%**。判明している最弱部品は`PROT-OC-01`のPTC（`MF-R135`）の`Ihold`（23 ℃で1.35 A、40 ℃で1.12 A）であるため**0.896 A以下**（40 ℃の1.12 A × 0.8。23 ℃基準は1.08 A。`上限を40 ℃基準の0.896 Aへ当て直す（2026-10-27、#405）`）だが、未確定の経路要素が残るため確定値ではない（`経路部品と定格`。**2026-08-25に1.2 Aから1.0 Aへ下がり、2026-08-26にPTCへ変更して1.08 Aへ上がった**）。判定はpeakではなく定常電流で行う（定格は熱の制限のため） | `5 V ingress`節の`ingressの電流制限` | **Blocked（経路部品の定格がすべて確定し、実測で定常電流が上限内に収まることを示すか、servo railのingressを高定格connectorへ変更するまで承認しない）** |
| 過電流保護 | 故障電流の制限。M-12001は3 Aを供給でき、テスターの読みと手動停止では最弱部品が発熱する前に電流を止められない | **方式・品番とも2026-08-25に決定し（ガラス管ヒューズ）、2026-08-26に方式をPTCへ変更した。**Bourns `MF-R135`（秋月 通販113013、`Ihold` 1.35 A／`Vmax` 30 V直流）。**`Vmax`が直流で与えられているため、ヒューズで問題になった`DCでの遮断能力は未確定である`は生じない**（`遮断能力は「制限」で満たしたと判断した（2026-08-27、PMの判断）`）。**調達（発注・着荷）の状態は[#205](https://github.com/wachi-yoshitaka-11-dev/deskcat/issues/205)が持つ。この表は持たない。**選定の全文と一次資料値は`過電流保護（段階Cのgate）`の`方式をPTCへ変更した（2026-08-26、人間の判断）`。**この品の保持電流が経路の最小値になり、ingressの上限は1.08 Aへ上がった**（同節の`最小定格は1.35 Aへ上がった（2026-08-26）`） | `5 V ingress`節の`過電流保護（段階Cのgate）`。品の一次資料は[MF-R Series datasheet](https://akizukidenshi.com/goodsaffix/mfr.pdf) | **Blocked（段階Cのgate。**方式と品番は決まったが**未実装であり（調達の状態は[#205](https://github.com/wachi-yoshitaka-11-dev/deskcat/issues/205)が持つ）、`記録するtrip動作`のうち実装後にしか埋まらない欄が空である。**加えて**3 Aでのtrip時間が確定値として読めておらず**（`3 Aでのトリップ時間を読み、線材と嵌合接点の判定で止まった（2026-08-27）`）、**嵌合接点が持つかの判定はPMへ上げている。**`経路部品と定格`表の未確定行も残る。**trip値の締め直しの判断は段階B-2に従属する。**[HW-TBD-021](tbd-register.md)） |
| 逆極性保護 | 配線リスク | **要否と方式は2026-08-24に人間が承認した**（承認範囲の全文は`逆極性保護のdesign review`の`決定（2026-08-24）`が持つ）。**承認内容は1と2の両方であり、守る区間が違う。****1（ingressのP-ch MOSFET）は2026-08-25に品番が確定した**（東芝`2SJ334`。[#205](https://github.com/wachi-yoshitaka-11-dev/deskcat/issues/205)。**同日に一度保留され、同日のうちに解除された。**経緯と品の定格は`逆極性保護のdesign review`節内の記録が持つ）。**未実装である。実装方法（向き、ゲート抵抗の値、基板上の配置）は2026-09-03に決定した**（`実装方法を決定した（2026-09-03）`）。**決定しただけであり、実装はまだ済んでいない。**調達の状態は[#205](https://github.com/wachi-yoshitaka-11-dev/deskcat/issues/205)が持つ。**2（極性が固定される接続方法と通電前の配線確認手順）は2026-08-25に手順を作成した**（`通電前の配線確認手順`）。**1は下流の手配線区間を守らない。**守る区間の定義は同節の確認箇所表が持つ。**`3V3` pin → 周辺module3点の区間は、2026-08-26に2（通電前の配線確認手順）の対象へ加えた**（従来は1でも2でも守っていなかった）。**1は引き続き守らない**（ingressに1個入るだけである） | Design review。**逆接が起こりうる区間の洗い出しと方式ごとの電圧降下の代償**は同節 | **一部確定。**承認内容の1は品番が確定し、2は手順を作成した。**ただし`Blocked`が残る**（[HW-TBD-030](tbd-register.md)）: **1が未実装である**（実装方法は2026-09-03に決定したが、実装そのものはまだ済んでいない。実装までは経路に逆極性の保護部品が1つも無い。調達の状態は[#205](https://github.com/wachi-yoshitaka-11-dev/deskcat/issues/205)が持つ）、**色分けを成立させる接続部材が未選定**（`WIRE-PWR-01`。[HW-TBD-022](tbd-register.md)）、**2026-08-26に人間がcloseしないと判断した**（[HW-TBD-030](tbd-register.md)。**closeの条件は「方式が決まったこと」ではなく「守れる状態になったこと」と定めた**）。**`3V3` pin → 周辺module3点の区間は2026-08-26に2の対象へ加えたが、1は引き続き守らない。****段階Cの配線承認は与えていない** |

### local decouplingの外付け要否

**datasheetが指定する値と配置の正は[sensor-datasheet-notes.md](sensor-datasheet-notes.md)の
`Local decoupling`節である。**ここで決めるのは**module搭載分で足りるか、外付けが要るか**だけである。

| device | module搭載分 | 外付けの要否 | 根拠 |
|---|---|---|---|
| `ENV-01`（AE-BME280） | **`C1` 0.1 µF（VDD用）／`C2` 0.1 µF（VDDIO用）を実装済み。**説明書は「ピンヘッダ以外は基板にすべて実装済み」と述べる | **不要。**Bosch datasheetの推奨値100 nFを搭載分が満たす | **この表の4点のうち、資料だけで要否が決まるのはこの1点だけである** |
| `ACCEL-01`（秋月 M-06724） | **TBD** | **TBD** | board資料が無く、実装済みの部品を現物でしか読めない（`HW-TBD-004`の確認項目）。**ICへの推奨値を、そのまま「外付けで要る部品」として扱わない** |
| `DISP-01`（MSP2807） | **TBD** | **TBD** | メーカーdatasheetにdecouplingの記載が無いことを確認した（`HW-TBD-029`で確定済み）。現物確認は`HW-TBD-002`の確認項目であり、`HW-TBD-024`のbacklight回路確認と同じ機会に行える |
| `MCU-01`（ESP32 board） | 参照設計では`U2`の入出力とも22 µF | **TBD** | **参照設計由来であり現物の事実ではない**（`HW-TBD-023`の確認項目(d)）。`hardware-bom.md`の`MCU-01`と同じ扱いにする |

**購入待ちリストへは何も足さない。**外付けが要ると確定した部品が1つも無いためである。
現物確認で必要と分かった時点で`hardware-bom.md`の購入待ちリストへ行を足す。

### 逆極性保護のdesign review

**2026-08-24に人間が下記の推奨案を承認した。**この節の
`決定（2026-08-24）`がその承認内容である。**方式は決まったが、品番と定格は未確定であり、
`配線・保護表`の`逆極性保護`行は`Blocked`のままである。**

**下表は段階C（合成給電）の構成に、段階B-2の周辺module配線を加えたものである。**
段階A・B-1にはbreadboard railが無く、Piは段階Aのadapter（段階表のA行）から`PWR IN`へ、ESP32はUSBへ直挿しする。
2026-10-11の差し替えまでの`PSU-PI-A-01`と`CABLE-PI-A-01`はUSBの嵌合であり、**そもそも極性を間違えられない**（`合成給電を部品が揃うまで行わない理由`）。2026-10-11以降の`PSU-PI-A-02`は、plugの形と極性を確かめておらず、この表の区間に入れていない（可否の分類は決めていない。[hardware-bom.md](hardware-bom.md)の`PSU-PI-A-02`）。
**検証の構成（`5 V ingress`節の`検証の構成の扱い`）でPiとESP32の間につなぐGNDの線とUARTの信号線は手配線であり、この前提から外れる。**
その確認は、この節の手順の対象ではなく、[gpio-assignment.md](gpio-assignment.md)の`信号線をつないでよい条件`の6が持つ。
**段階B-2は例外で、`3V3` pinから周辺module3点へ引く配線が手配線になる**（表の最終行）。

**要否の核心は、逆接が起こりうるのが手配線区間だけだという点である。**

| 区間 | 逆接の可否 | 理由 |
|---|---|---|
| M-12001 → 端子台 | **可**（**2026-09-09に`不可`から改めた**。旧区間名は`M-12001 → PSU-INGRESS-01`） | **2026-09-09にPM（`deskcat-f2`）の設計判断（案B）により、この区間が手配線になったためである。**M-12001の出力cableをMicro-Bプラグの手前で切り、端子台（`114217`）へ受ける（終端方法は`経路部品と定格`の`M-12001のcableを受ける端子台`行を参照。ここへ再掲しない）。**Micro-Bの嵌合による極性固定はもう無い。**端子台でVBUSとGNDを入れ替える誤りが起こりうる。**ただしPMが基板上の配置（入力側 → `PROT-OC-01`（PTC）→ `PROT-RP-01`（MOSFET。Drain=入力側／Source=分岐点側）→ 分岐点）を実測で確認したうえで、この区間の逆接はMOSFETが守ると判定した（2026-09-09、PM判断）。**入力側で極性を入れ替えても、MOSFETより下流は守られる。逆電圧に晒されるのは`PROT-OC-01`（PTC）だけであり、**同部品のdatasheet（[MF-R Series datasheet](https://akizukidenshi.com/goodsaffix/mfr.pdf)、Bourns）には極性の指定が無く（全ページを確認した。`polarity`等の語も無く、外形図も対称形状）、PTCは非極性の受動部品であるため害が無い。**したがってこの区間は`通電前の配線確認手順`の対象には含めない**（MOSFETの担当であり、手順の担当ではない。同手順の「守る区間が違う」という既存の分担を変えない、というPMの判断）。**ただし2点、次を明記する。**(1) この区間は従来（Micro-Bの嵌合固定）は逆接が起こりえなかったが、案Bにより起こりうる区間へ変わる。**したがって案BはMOSFET（`PROT-RP-01`）の実装の重要度を上げる**（従来、この区間に対するMOSFETのingress保護は起こりえない事象への備えだったが、案Bでは起こりうる事象への備えになる）。(2) MOSFETは`未実装`である（`逆極性保護のdesign review`節）。**実装されるまで、この区間には保護が無い**（同節の`通電前の配線確認手順が主張しないこと`が既に述べる一般的な警告と同じ） |
| 端子台 → breadboard rail（`PROT-OC-01`／`PROT-RP-01`経由） | **可** | 手配線。**2026-09-09に案Bの反映で`PSU-INGRESS-01` → breadboard railから区間名を改めた。**区間の可否・保護の扱いは変わらない |
| rail → Piの`PWR IN` | **可**（**2026-08-24に`不可`から改めた**） | **rail側が手配線になったためである。**`CABLE-PI-PWR-01`は②（直付け）で確定し、rail側は端子台へのねじ止めになった（`rail側の受け方は②（直付け）で確定した（2026-08-24、人間の判断）`）。**Pi側のMicro-B plugが固定するのはpinの並びであって、どちらの導体が+5 Vかではない。**端子台でVBUSとGNDを入れ替えると、Piへ逆電圧が掛かる。**ingressのP-ch MOSFETはこの区間より上流にあり、守れない** |
| rail → ESP32の`5V`／GND | **可** | 手配線 |
| rail → servo rail | **可** | 手配線 |
| `3V3` pin → 周辺module3点 | **可** | 手配線 |

**したがってingress 1箇所に保護部品を入れても、下流の手配線区間は守れない。**
「逆極性保護部品を付けたから安全」とは言えない構造である。

方式候補と代償を並べる。**電圧降下は5 V側の余裕に直接効くため、`受け入れ条件`の(a)(b)と
切り離して選べない。**

| 方式 | 電圧降下 | 代償と論点 |
|---|---|---|
| 直列Schottky diode | `Vf` 数百 mV order | **5 V予算を食う。**ただし**採否を確定できない。**比較対象の4.6 Vは**2026-08-15に現物の`U2`（UMW `LD1117-3.3`）のdatasheetによる値になり、条件も`IOUT = 1 A`（この品の定格上限）で明確になった**（`(b)のESP32 board 5 V入力の導出`）。**部品が未確認であることを理由とした保留は解消した。**それでも採否は決まらない。**`3V3`から取ってよい電流の上限がboard levelで未確定であり**（`HW-TBD-023`(a)）、**Pi側も(a)が未確定で余裕を評価できない**ためである。**実負荷を確認するまで、この方式の採否を決めない**（`HW-TBD-028`(b)） |
| P-ch MOSFETによるideal diode | `Rds(on) × I`。品次第で桁が変わる | 電圧降下を小さくできる。**ただし具体値は品番を選ばないと出ない。**`Vgs`定格と、逆接時に確実にoffになる回路構成の確認が要る |
| 逆並列diode＋fuse（crowbar） | 順方向は0 | `PROT-OC-01`と組み合わせられる。**ただし溶断までの間、負荷に逆電圧が掛かる。**保護対象が耐えるかを別途評価する必要がある |

**決定（2026-08-24）**

**人間が次の1と2をあわせて承認した。**1だけでは閉じないため、2を承認範囲に含めている。

1. ingressへ**P-ch MOSFETによる逆極性保護**を置く。直列Schottkyは上表の理由で採らない
2. **下流の手配線区間は保護部品では守らない。**極性が固定される接続方法（色分けと極性付き接続部材）と、
   通電前の配線確認手順で守る。**接続部材そのものの選定は`WIRE-PWR-01`が持つ**（`hardware-bom.md`。
   **極性が固定されることを選定条件へ渡す。規則をここへ再掲しない**）。
   **この対象にはrail → Piの`PWR IN`区間の端子割り当てを含める。**②を採ったことでrail側が手配線になり、
   **端子台でVBUSとGNDを入れ替えるとPiへ逆電圧が掛かる**（上表）。**ingressのMOSFETより下流であり、
   1では守れない。**Piは逆接で壊れうる3 deviceのうちの1つであるため、この区間を落とさない
3. 品番と定格は`PROT-OC-01`と同じく**発注直前に一次資料で確定する。**この節では品番を挙げない

**この承認はgateを開けない。****2で守ると決めたのは方針であって手順ではなく、手順の作成は
`HW-TBD-030`に残っていた。****その手順は2026-08-25に作成した**（`通電前の配線確認手順`）。
**それでもgateは開かない**（同節の`この手順が主張しないこと`）。

**1のP-ch MOSFETは2026-08-25に品番が確定した**（東芝`2SJ334`。
[#205](https://github.com/wachi-yoshitaka-11-dev/deskcat/issues/205)。
**同日に一度保留され、同日のうちに解除された。**経緯と品の定格は同節内に別途記録がある）。
**それでも1は下流の手配線区間を守らない。**MOSFETはingressに1個入るだけであり、
**この節の逆接可否表で`可`となっている区間は2が守る。**

#### 通電前の配線確認手順

**これが`決定（2026-08-24）`の2の実体である。**

**保護部品では代替できない。**1のP-ch MOSFET（`2SJ334`）は品番が確定したが、
**ingressに1個入るだけであり、下流の手配線区間の逆接は守らない**（`決定（2026-08-24）`の2、
および上の逆接可否表）。**したがってこの手順は保護部品と択一ではなく、
保護部品が守らない区間を受け持つ。**

**加えて、MOSFETは未実装である**（調達の状態は[#205](https://github.com/wachi-yoshitaka-11-dev/deskcat/issues/205)が持つ。
実装方法も未決）。**実装されるまでは、経路に逆極性の保護部品が1つも無い。**
**その間、手順を飛ばした通電は逆極性保護が無い状態の通電である。**

**対象は上の逆接可否表で`可`となっている区間だけである。**`不可`の区間は嵌合で極性が
固定されるため確認の対象にしない。**分類の正はその表であり、ここへ再掲しない。**

##### 確認する箇所

| 確認箇所 | 何を確認するか | この手順で守るか |
|---|---|---|
| 端子台の出力・GND出力のパッドと、そこから出る5 V幹線・GND戻り | パッドの表記と線の色が対応していること（**2026-09-09、案Bにより`PSU-INGRESS-01`の出力パッドから差し替え。対象・扱いは変えていない**） | **守る** |
| 分岐点の節点（ユニバーサル基板上のはんだ接続） | 5 Vの往路とGND戻りが、基板上で意図した節点に落ちていること。**構成は[#205](https://github.com/wachi-yoshitaka-11-dev/deskcat/issues/205)が決めた**（節点はユニバーサル基板上のはんだ接続、端子台は各branchの終端）。**想定した絶縁の確認は別項目である**（`測定計画`の`サーボ接続前`の導通・絶縁確認） | **守る** |
| 各branchの終端（端子台） | branchごとの`+5 V`側とGND側の端子割り当て。**logic rail、servo rail、Piへの給電のそれぞれについて見る** | **守る** |
| **rail → Piの`PWR IN`**（`CABLE-PI-PWR-01`のrail側終端。②の直付け・ねじ止め） | 加工したcableのどちらの導体がPiの`VBUS`へ行くか。**被覆の色はplug内の結線を保証しないため、導通で確認する**（この区間の分類は上の可否表に従う） | **守る。ただし導体とplug pinの対応を導通で確認した記録が要る** |
| rail → ESP32の`5V`／`GND` | ESP32 board側のpin表記と線の色 | **守る** |
| rail → servo rail | servo railへ分岐する2線（+5 VとGND）の割り当て。**servoのsignal線はこの手順の対象ではない** | **守る** |
| `3V3` pin → 周辺module3点（段階B-2） | module側のsilk表記と、`3V3`側・GND側それぞれの導体の対応。**色で追えないため、確認の方法の3（導通）で読む** | **守る**（**2026-08-26に`守らない`から改めた**）。**この区間は上の逆接可否表で`可`であり、この手順の対象の定義に入る。**除外していた理由は`WIRE-PWR-01`の赤黒の色分けが掛かっていないことだが、**色分けが掛からないことは確認が要らないことを意味しない。**確認の方法の2は既に「**色が付いていない導体が1本でも経路にある場合、目視だけで判定しない**」と定めており、その場合の手段は3（導通）である。**加えて、この区間の誤配線は安全要件の`電圧違いのpinへ挿す`に当たる**（[hardware-safety-policy.md](../governance/hardware-safety-policy.md)の`安全要件の5項目`）。**人間の監視は保護機構の代わりにならない** |

##### 確認の方法

1. **電源を接続しない。**Piと各部へ給電しているadapter（段階Aは`PSU-PI-A-02`、段階Cは`M-12001`）をコンセントから抜いた状態で始める。
   **通電はこの手順の全項目が済んでからである**
2. **目視で色を追う。**5 Vの往路は赤、GND戻りは黒に固定する
   （**この割り当ては**[#205](https://github.com/wachi-yoshitaka-11-dev/deskcat/issues/205)**が決めた**。
   `決定（2026-08-24）`の2が言う「色分け」の具体である）。**色分けが成立する前提は部材側にあり、
   選定条件は`WIRE-PWR-01`が持つ**（[hardware-bom.md](hardware-bom.md)。**規則をここへ再掲しない**）。
   **色が付いていない導体が1本でも経路にある場合、目視だけで判定しない**
3. **テスターで導通を読む。**測る前に次の2つを確認する。**(i) 対象が0 Vであること**
   （電源を外していても、`Servo bulk capacitor`の電解コンデンサに電荷が残りうる。
   残っていれば安全に放電させ、0 Vを再確認してから測る。**電圧が残ったまま抵抗rangeを当てない**）。
   **(ii) DT830B自身が正しく読めること**（プローブ同士を接触させた短絡と、離した開放の2状態で
   期待どおりの表示になることを確認する）。そのうえで、目視で追えない箇所
   （加工したcableの導体とplug pinの対応、端子台の内部結線）を
   **DT830Bの抵抗rangeでpinと導体の対応として読む。**
   **測り方の先例は`HW-TBD-005`である**（`J1`／`J2`／`J3`の開放を、
   **電源を接続しない状態でpin間の抵抗を測って**確認した。その実測の記録は
   [sensor-datasheet-notes.md](sensor-datasheet-notes.md)にある）。
   **電源を接続して電圧を読むのではない**
4. **記録する。**確認した箇所、方法（目視／導通）、日付を
   [experiment-log.md](experiment-log.md)へ残す。**導通で読んだ箇所は、導通側と開放側の
   実測値と、そのどちらを合格としたかも残す**（`HW-TBD-005`の記録と同じ粒度である）。
   **記録が無い確認は、次の通電ではやり直しになる**
5. **配線を触ったらやり直す。**電源経路の線を1本でも抜き差ししたら、それは新しい配線revisionであり、
   この手順を最初から通す。**その初回通電には人間の立ち会いが要る**
   （[hardware-safety-policy.md](../governance/hardware-safety-policy.md)の
   `人間の監視が必要な操作`が`新しい配線revisionの初回通電`と`GPIOまたは電源変更後の試験`を挙げている）

**`測定計画`の`サーボ接続前`checklistの極性確認は、この手順を指す。**

##### この手順が主張しないこと

- **逆接が起きないことを保証しない。**目視と導通確認は人の作業であり、**保護部品と違って
  失敗しうる。**手順は失敗の確率を下げるが、0にはしない
- **段階Cの配線承認を与えない。**この手順が書かれたことは[HW-TBD-030](tbd-register.md)の
  closeでもない（MOSFETが未実装であり、経路に逆極性の保護部品が1つも無いため）
- **段階B-2を実施してよいとは言わない。**この手順は`3V3` pin → 周辺module3点の区間も対象にするが（上表。**2026-08-26に対象へ加えた**）、段階B-2の実施条件は別である（`HW-TBD-025`の共通条件と、B-2aまたはB-2bの条件）。**確認手順を通したことをB-2の実施可否の根拠にしない**
- **P-ch MOSFETの代わりになるとは言っていない。**部品が与える保証と人の確認は同じ強さではない。
  **そもそも守る区間が違う**（MOSFETはingress、この手順は下流の手配線区間）。
  **承認内容の2を満たしたと見るかはHumanの判断である**

#### 1（P-ch MOSFET）を保留した（2026-08-25、人間の判断）

> **この保留は同日のうちに解除された。現在の状態は「品番を確定し発注する」である**
> （`保留を同日に解除し、品番を確定した（2026-08-25、人間の判断）`）。
> **以下は保留を決めた時点の記録であり、書き換えていない。**

**上の決定は書き換えない。**承認内容そのものは2026-08-24のまま残す。
**2026-08-25に、そのうち1の実装だけを当面保留すると人間が決めた。**
[#205](https://github.com/wachi-yoshitaka-11-dev/deskcat/issues/205)の発注に
P-ch MOSFETを含めていない。

| 項目 | 内容 |
|---|---|
| 保留するもの | **承認内容の1**（ingressのP-ch MOSFETによる逆極性保護）。**部品を発注しない** |
| 代替 | **承認内容の2**（極性が固定される接続方法と通電前の配線確認手順）。端子台`114217`で赤黒を色分けして固定する |
| 理由 | 端子台でねじ止めするため、**逆接は通電前の目視で防げる**という判断 |

**この保留が意味することを、3つ明記する。**

- **逆接のriskは消えていない。**保留は判断であって、riskの解消ではない。
- **保留により、承認内容の2が唯一の防御になった。**上の決定は「1だけでは閉じないため2を承認範囲に含めている」
  と書いており、**1と2は補い合う関係だった。**1を外すと、**ingress側の逆接も2で守ることになる。**
  上表が示すとおり、逆接で壊れうるdeviceはPi・ESP32・周辺module 3点である。
- **その2の手順は、まだ書かれていない。**上の段落のとおり`通電前の配線確認手順`は未作成である。
  **したがって現時点で実効的な防御は存在しない。**手順を書くまで段階Cの配線承認は与えられない
  （`HW-TBD-030`はcloseしない。**承認内容の2の手順が書かれ、実装されるまで**）。

**保留を解除する場合は、上の決定の1へ戻る。**この節はそのときのために、外した内容と理由を残している。

##### 保留を同日に解除し、品番を確定した（2026-08-25、人間の判断）

**上の保留は書き換えない。**同日のうちに人間が**保留を解除**した。
[#205](https://github.com/wachi-yoshitaka-11-dev/deskcat/issues/205)の発注を
**まとめ買いに切り替えた**ためであり、送料が一度で済むうちに買う判断である。
**2026-08-24の承認内容の1（ingressへP-ch MOSFETを置く）へ戻った。**

**品番を確定した。**東芝 **`2SJ334`**（P-channel MOSFET、JEITA `SC-67`／東芝 `2-10R1B`、
2.54 mmピッチのスルーホール。秋月 通販102846、¥110）。

| 項目 | 値 | 5 V railでの当てはめ |
|---|---|---|
| `VDSS` | **−60 V** | 5 Vに対して十分。逆接時の逆電圧にも耐える |
| `VGSS` | **±20 V** | `VGS`は5 V rail で**未確定**（実装方法が決まっていない。約−5 Vになる見込みだが、その根拠は無い。`VGSが未確定である（2026-08-27）`）。**見込みの値は`VGSS` ±20 Vの定格内** |
| `ID`（DC） | **−30 A** | ingressの上限に対して桁が違う。**経路の最小定格にならない**（最小値は`経路部品と定格`が持つ） |
| `Vth` | **−0.8〜−2.0 V**（`VDS`=−10 V、`ID`=−1 mA） | **実回路の`VGS`が未確定のため、ONするかを判定できない。**`Vth`は導通が始まる電圧であり、**完全導通の条件でもない。**下記「`VGS`が未確定である」を参照 |
| `RDS(on)` | **`VGS`=−4 V、`ID`=−15 A で 標準46 mΩ／最大60 mΩ**（`VGS`=−10 Vで 標準29 mΩ／最大38 mΩ） | **`VGS` ≤ −4 Vが成り立つ場合**、1.0 Aで**電圧降下 最大60 mV相当、発熱 60 mW**。（**`RDS(on)`の規定条件は`ID`=−15 Aであり、1 A付近の値をdatasheetは与えていない。「1.0 Aで最大60 mV」は条件を移した値である。**5 V railでは`VGS`が−5 V付近になる見込みであり、その場合は−4 Vの欄を採るのが安全側である。ただし見込みは確定していない**（`VGSが未確定である（2026-08-27）`） |
| `Rth(ch-a)` | 62.5 ℃/W | 60 mWなら温度上昇は約3.8 ℃ |

出典は[2SJ334 datasheet](https://akizukidenshi.com/goodsaffix/2sj334.pdf)（東芝、2006-11-14。
sha256 `c01da93643cb1cb11075d9137897655c556989de647c38368d5c487274d5da46`。2026-08-25取得）である。

##### 2SJ334をB-1として通す根拠（2026-08-26）

**`RDS(on)`が運用電流（約1.0 A）で規定されていないことについて、
[ADR-0016](../decisions/0016-evidence-bar-inside-the-safety-requirements.md)の`B-1`として扱う。**
`Bで済ませるときの条件`（[Hardware Safety Policy](../governance/hardware-safety-policy.md)）への当てはめは次のとおりである。

| 条件 | 当てはめ |
|---|---|
| **1. 比較する最悪値を、実在する値で示す** | `RDS(on)`の規定条件 **`VGS`=−4 V・`ID`=−15 A で 最大60 mΩ**（datasheetの実在値。**素子の値の正は[hardware-bom.md](hardware-bom.md)の`PROT-RP-01`である**）。運用側の最悪値は**経路の上限**であり、その正は`判明している最小定格が1.25 Aへ下がった（2026-08-25）`。**ここへ数値を再掲しない** |
| **2. 余裕を数で書く** | **運用側の値はこの節へ再掲しない**（正は`最小定格は1.35 Aへ上がった（2026-08-26）`。2026-08-25時点の記録は`判明している最小定格が1.25 Aへ下がった（2026-08-25）`にある）。その値を`I`とすると、datasheetの規定条件`ID`=−15 Aは`I`の**15倍**、`ID`(DC) −30 Aは**30倍**である（いずれも`I` = 1 A 前後の場合）。**どちらも桁が1つ以上ある** |
| **3. 公開値が無いことを記録する** | **運用電流域の`RDS(on)`はdatasheetに無い。**代わりの担保は、**同じ`VGS`では`ID`が小さいほど自己発熱が減るため、15 Aでの最大値60 mΩを1 Aへ当てるのが保守側になる**という点である。**これは物理からの推論であり、datasheetが述べた値ではない。**したがって記録するのは「60 mV相当」であって「60 mV」ではない |
| **4. Aを代替しない** | **逆極性保護が効くかどうかを決めるのは`RDS(on)`ではない。**5 V railで十分にONするかであり、その入口は`Vth` **−0.8〜−2.0 V**（`VDS`=−10 V、`ID`=−1 mA。**値の正は[hardware-bom.md](hardware-bom.md)の`PROT-RP-01`**）という**実在値でAとして押さえてある**。**実回路の`VGS`は未確定である**（5 V railなら約−5 Vになる見込みだが、実装方法が決まっていないため根拠が無い。`VGSが未確定である（2026-08-27）`）。**したがって`Vth`との比較も`RDS(on)`の規定条件との比較も、いまは成立しない。**`VGS` ≤ −4 Vが成り立つなら`Vth`の最悪値−2.0 Vに対して2.5倍になるが、**それは前提つきの数である。****そもそも`Vth`が示すのは導通の開始であって完全導通ではない。**`RDS(on)`はそのうえでの電圧降下の議論であり、成否の判定には使っていない |

**この節が主張しないこと。**`RDS(on)`の値そのものを1 A域で確定したとは主張しない。
**保守側であることを示しただけである。**確定させるなら実測が要る。

**ゲート抵抗は手持ちで足りる。**`RES-PULL-01`の10 kΩが1袋（100本入）ある
（[hardware-bom.md](hardware-bom.md)）。**追加購入はしていない。**

**5 V予算に効くのは電圧降下のほうである。****この素子は5 Vの往路に直列に入るため、
過電流保護部品の降下と足して見る必要がある。**単独では1.0 Aで最大60 mV相当だが（上表の条件の但し書きと`VGSが未確定である（2026-08-27）`を参照。**`VGS` ≤ −4 Vが成り立つ場合の値である**）、
**同じ往路にはヒューズも直列に入っており、そちらの降下は別に公開されている。**
**合算の扱いは`過電流保護（段階Cのgate）`側が持つ。ここで合計値を出さない**
（片方だけを見て「小さい」と判断しないため）。

**この解除で変わらないこと。**

- **承認内容の2は依然として必要である。**MOSFETはingressに1個入るだけであり、
  **その下流の手配線区間（端子台でVBUSとGNDを入れ替える誤り）は守れない**（上表の逆接可否）。
  **2026-09-09に訂正: 「通電前の配線確認手順は、まだ書かれていない」としていたが誤りだった。**
  同手順は前日のRevision 72（2026-08-25）で既に作成済みであり（[`通電前の配線確認手順`](#通電前の配線確認手順)節）、この節が新設された時点で既に古かった。
- **実装方法（向き、ゲート抵抗の値、基板上の配置）は決めていない。**品番と定格を確定しただけである。
- **`配線・保護表`の`逆極性保護`行は`Blocked`のままである。**`HW-TBD-030`もcloseしない。

##### `VGS`が未確定である（2026-08-27）

**`VGS`≒−5 Vという前提は、実装方法が決まっていないため確定していない。**
同じ`PROT-RP-01`について、**ゲート抵抗の回路上の役割も最終値も未決定であり、`VGS`の確定方法も決まっていない**
（[hardware-bom.md](hardware-bom.md)の`PROT-RP-01`）。**この状態では、実回路が最悪条件で`VGS` ≤ −4 Vを保つ根拠が無い。**
**したがって次を主張しない。**
- **実回路の`VGS`が−5 V付近になること**
- **`VGS`=−4 Vの`RDS(on)`規定（max 60 mΩ）を実回路へ適用してよいこと**
- **完全導通すること**
**上の数値は、`VGS` ≤ −4 Vが成り立つ場合の値である。**成り立つかどうかは実装が決まってから判断する。
**判断は`HW-TBD-030`の実装確定に従う。この節では決めない。**
**`2SJ334`をB-1として通す判断そのものは、`Vth`が実在値であることに拠っており、この未確定はそれを覆さない。**
覆るのは**電圧降下と発熱の見積り**であり、それは成否の判定に使っていない。**`VGS`=−10 V側の規定（max 38 mΩ）は使っていない。**実回路がその条件を満たさないためである。****`ID` −30 Aは経路の上限に対して桁が違うため最小定格にはならない（上限はこの表の最小値の80%で決まる（`deratingと判定量`））。**ゲート抵抗は`RES-PULL-01`の手持ちから取る。**保留を記録した節は書き換えず、解除の節を別に置いた。****承認内容の2の通電前の配線確認手順は未作成のままであり、`配線・保護表`の`逆極性保護`行は`Blocked`を維持した。**(b) **分岐点の構成を確定した。**分岐の節点は`PROTO-02`（ユニバーサル基板、秋月 通販100517）上のはんだ接続で作り、端子台`114217`を**6個**（Pi branch・logic rail・servo railの3分岐＋予備3）で各branchを終端する。**はんだ接続そのものに定格は無く、節点の導体は`111641`が決める。**(c) **`CABLE-PI-PWR-01`を秋月 通販109314で確定した。****同品は導体の許容電流もAWGも公開しておらず、この行の従来の選定規則を満たさない。****同日、人間がこの行へ許容電流の公開を求めないと決め、同日その扱いが正本にも入った**（[Hardware Safety Policy](../governance/hardware-safety-policy.md)の`安全要件の5項目`と`5項目以外の扱い`。根拠は[ADR-0014](../decisions/0014-safety-requirements-and-general-values.md)、**`Accepted`**）。**Pi link経路では[#174](https://github.com/wachi-yoshitaka-11-dev/deskcat/pull/174)が既に同じ判断をしている。**通す電流はPi branchの分だけで、`負荷表`のPi Zero Wのstress時350 mAが上界である。**自作用の選択肢として通販107666（`定格電流(1ピン)：1A`）も1個発注したが、採用すると1 Aが経路の新しい最小値になり上限が0.8 Aへ下がって定常見積840 mAを下回るため、採否は未決である。**(d) `経路部品と定格`表へ`PROT-RP-01`の行を足し、`分岐点`と`CABLE-PI-PWR-01`の行を書き換えた | [#205](https://github.com/wachi-yoshitaka-11-dev/deskcat/issues/205)、[#204](https://github.com/wachi-yoshitaka-11-dev/deskcat/issues/204)(3)、[2SJ334 datasheet](https://akizukidenshi.com/goodsaffix/2sj334.pdf)（東芝 2006-11-14、sha256 `c01da93643cb1cb11075d9137897655c556989de647c38368d5c487274d5da46`、2026-08-25取得）、秋月 通販102846／100517／109314／107666／114217（2026-08-25取得）、ユーザーからの決定 |

##### 実装方法を決定した（2026-09-03）

**向き、ゲート抵抗の値、基板上の配置を決定した。**`VGSが未確定である（2026-08-27）`が
未決定として残していた3点のうち、ゲート抵抗の回路上の役割と`VGS`の確定方法を含む。

**向き（2026-09-04訂正）。**2SJ334のdatasheet（[出典](https://akizukidenshi.com/goodsaffix/2sj334.pdf)、
東芝、2006-11-14、sha256 `c01da93643cb1cb11075d9137897655c556989de647c38368d5c487274d5da46`）
の1ページ目に掲載された外形図・pin配列図が`1. ゲート 2. ドレイン 3. ソース`（SC-67パッケージ、
現品を刻印面から見て左から1・2・3）と明記している。**2026-09-03時点ではSourceを`PROT-OC-01`
（PTC）側（入力側）、Drainを分岐点（rail）側（出力側）としていたが、[PR #342](https://github.com/wachi-yoshitaka-11-dev/deskcat/pull/342)
のCodeRabbit `full review`の指摘を受けて再検討し、逆にする。**Drainを`PROT-OC-01`（PTC）
側（入力側）へ、Sourceを分岐点（rail）側（出力側）へつなぐ。**直列順序は
**端子台**（2026-09-09、案Bにより`PSU-INGRESS-01`から差し替え。当時の記述は`PSU-INGRESS-01`だった）
**→ `PROT-OC-01`（PTC）→ `PROT-RP-01`（この向き）→ 分岐点**とする
（`hardware-bom.md`の行の並びと一致させた。**定常状態では直列順序自体は電流を変えないため、
この順序自体が保護動作を左右するものではない**）。Gateは、向きに関わらず共通GND戻り
（`GND topology`のstar point）へ抵抗を介してつなぐ（**この接続先は今回の訂正で変えていない**）。

**訂正の理由。**2026-09-03時点の記述は、`channel`がOFFであれば逆流を防げるという前提で
向きを決めていたが、**内蔵diodeはDrain-Source間に構造として存在し、channelと並列である。**
`channel`がOFFでも、diodeが順バイアスであれば電流はdiodeを通る。**したがって「channelを
OFFにする向き」だけを基準に選ぶと、diodeの向きを見落とす。**2026-09-03の向きでは、
`逆接可否表`が`可`とする手配線区間（**2026-09-09、案Bにより端子台の2つのパッド**（当時の記述は`PSU-INGRESS-01`だった）**から`PROTO-02`上の
PTC・MOSFET入力までの配線）でVBUSとGNDが入れ替わった場合、Source側（入力側）は真のGND、
Gate側（共通GND戻り経由）は真の+5 Vとなって`VGS`≒+5 Vとなり**channelは確実にOFFになる
が、下流の分岐点（Drain側）は下流loadの帰路（共通GND戻り＝この時真の+5 V）を通じて
引き上げられうるため、DrainがSourceより高くなり得て、**内蔵diode（Drain側がSource側より
高いときに導通する）は順バイアスのまま導通する。channelの状態はこの導通を止めない。**

**訂正後の向きでは、同じ故障で次のようになる。**Drain（入力側）は真のGND、Source（分岐点側）
は下流loadの帰路経由で真の+5 Vへ引き上げられうる。**このときDrainがSourceより高くなること
はない**（Sourceを引き上げる電流は、Gateと同じ共通GND戻り＝star pointから下流loadを
経由してSourceへ流れ込む経路しかなく、star point自身の電位を超えて引き上げることはできない
ため、Sourceはstar point（=Gateの電位）以下に留まる）。**したがってDrain（真のGND、常に
最低電位）がSourceより高くなることはなく、内蔵diodeは逆バイアスのまま導通しない。**同時に
`VGS` = Gate − Source は、SourceがGate（=star point）以下である限り0以上であり、
`Vth`（−0.8〜−2.0 V）よりON側（より負）にはならないため、**channelもOFF側に留まる。**
diode・channelの両方が、下流の帰路（backfeed）の大きさによらず阻止側になる（**backfeed
の実際の大きさ・機構は測定していない。ここで使っているのは「Sourceがstar pointの電位を
超えられない」という配線トポロジーの制約であり、backfeedの値そのものではない**）。

**正しい極性でのVGS。**Drain側（入力側）が+5 Vへ立ち上がる際、Source（分岐点側）は
最初0 Vであるため、内蔵diode（Drain側が高いときに導通）がまず順バイアスとなり、分岐点を
充電する。Sourceの電位が上がるにつれ`VGS`（= Gate（≒0 V）− Source）が負に深くなり、
`Vth`を超えた時点でchannelが導通を始め、以降はchannel（`RDS(on)`はdiodeの順方向降下
よりずっと小さい）が主経路になる。**定常状態でのSourceの電位・`VGS`の見積りは2026-09-03
時点の値（Source側+5 V、`VGS`≒−5 V）から変わらない**（channelが主経路を取れば、Sourceは
Drain（入力+5 V）にほぼ等しくなるため）。**ただし起動直後の短い区間はdiode経由での充電に
依存する。**この区間でdiodeを通る電流は、本回路の運用電流（約1 A）ではなく、**直列の
`PROT-OC-01`（PTC、`Ihold` 1.35 A）・配線抵抗・分岐先bulk capacitorの容量・電源側の
供給能力（`M-12001` 5 V/3 A）で決まる突入電流であり、この値そのものを測っていない。**
datasheetの`IDR`（連続−30 A）と比較できる実在値をまだ持たないため、**「diodeの定格に
十分な余裕がある」とは主張しない。**`PROT-OC-01`（PTC）がこの区間でどう振る舞うか
（分岐先bulk capacitorの充電電流との相互作用を含む）は測定していない。**
`RDS(on)`規定（`VGS`=−4 V）の適用に実回路の最悪条件で`VGS` ≤ −4 Vが成り立つ根拠がまだ
無いことも、2026-09-03時点から変わらない（**`VGS`≒−5 Vと`RDS(on)`規定の適用は条件付きの
見積りのままである**。`Vth`が実在値であることに拠る`B-1`の判断そのものは覆らない。
`2SJ334をB-1として通す根拠`を参照）。

**ゲート抵抗の値は10 kΩとし、`RES-PULL-01`の手持ち（秋月 125103、1袋100本入、追加購入なし）
から取る。**根拠は次の2点で、いずれも同datasheetの実在値である。

**次の2値は、いずれも実動作範囲のworst-caseではなく、`Ciss`のtyp値・`IGSS`の指定条件に
基づく条件付きの見積りである。**安全上限として扱わない。

| 検討 | datasheetの値 | 10 kΩでの評価（条件付き見積り） |
|---|---|---|
| `VGS`確定の速さ（RC時定数） | 入力容量`Ciss` **3300 pF（typ、`VDS`=−10 V、`VGS`=0 V、f=1 MHz）**。**typ値であり、maxの規定はdatasheetに無い** | `τ = R × Ciss ≒ 10 kΩ × 3300 pF ≒ 33 µs`。**`Ciss`の測定条件と同じくSourceを固定電位と仮定した参考値であり、typ値に基づく見積りである。**実機の`Ciss`がこれより大きい場合はより長くなりうる。**worst-caseの`τ`はdatasheetから得られない。**Sourceの電位が起動時に変化する実回路でのgate charge過程やturn-on時間そのものではないため、実際の速さの判定には使わない（詳細は`ゲート抵抗の役割を確定する`を参照） |
| leakageによる基準電位のずれ | ゲート漏れ電流`IGSS` **最大±10 µA（`VGS`=±16 V、`VDS`=0 V）**。**`max`欄の値だが、測定条件`VGS`=±16 Vは実回路（±5 V付近）と異なる** | `IGSS(max) × 10 kΩ = 100 mV`。**実回路の`VGS`（±5 V付近）は測定条件（±16 V）より小さく、実際の漏れ電流はこれ以下と見込まれるが、この見込みは確定しない。**測定条件が違う値をそのまま流用した条件付きの上限であり、実動作範囲でのworst-caseを別途示すものではない。それでも100 mVは`VGS`の判定（±5 V）に対して無視できる |

**なお、絶対最大定格表は`VDGR`（ドレイン・ゲート間電圧）の測定条件として`RGS = 20 kΩ`を
用いているが、これは測定条件であって、ゲート抵抗の許容範囲を示す条件ではない。**
**この回路のゲート抵抗はGateと共通GND戻りの間にあり、通常極性ではSourceは約+5 V付近になるため、**
`VDGR`の測定条件（`RGS`はGate-Source間ではなくGate-Drain間の直列抵抗）とは接続も電圧の
掛かり方も異なる。**したがって`RGS = 20 kΩ`をこの回路の10 kΩの根拠として使わない。**
10 kΩの根拠は上表の`Ciss`によるRC時定数と`IGSS`による基準電位のずれの2点に限る。

**ゲート抵抗の役割を確定する。**`VGSが未確定である（2026-08-27）`は役割の候補として
`VGS`の確定・突入時のdi/dt・放電経路の3つを挙げ未決としていた。**主目的は`VGS`の確定である**
（Gateを共通GND戻りへ基準づけ、floatingにしない）。**上記`τ ≒ 33 µs`は、`Ciss`の測定条件
（`VDS`=−10 V、`VGS`=0 V）と同じくSourceを固定電位と仮定したRC時定数の参考値であり、
実回路のgate charge過程やturn-on時間そのものではない。**訂正後の向きでは、起動直後は
内蔵diodeでSourceの電位自体が上昇し、Gate-Source間電圧も同時に変化するため、**この`τ`を
「gate charge過程がその時間だけ遅れる」「turn-onが十分速い」の根拠として使わない。**
実回路のturn-on時間を主張するには、負荷容量と寄生抵抗を含む過渡解析または実測が要り、
**どちらも行っていない。**電源を外した際は同じ抵抗がgateの放電経路になる（この役割は
Sourceの電位に依存しない）。

**この向きが主張しないこと。**上の「訂正後の向き」の議論は、**この文書が既に置いている
前提（下流loadの帰路経由で分岐点の電位が動きうること）と、Sourceが配線上star point
（Gateの基準）を超えられないという配線トポロジーの制約から導いた結論であり、
backfeedの実測に基づくものではない。**次を主張しない。

- **「向きを直したから安全になった」という主張。**この節が示すのは、上記の1つの故障
  シナリオ（手配線区間でのVBUS/GND入れ替え）でdiode・channelの双方が阻止側になる
  ということであり、他の故障モード（例えば分岐点より下流の手配線での逆接、
  `3V3` pin → 周辺module3点の区間など）を検証したものではない。**それらは`PROT-RP-01`
  1個の保護範囲外であり、`通電前の配線確認手順`側で守る**（従来と同じ扱い）。
- **完全遮断であるという主張。**`Vth`は導通の開始点であって完全なOFFを保証する値ではなく、
  漏れ電流（`IGSS`）や現物のばらつきまでは評価していない。
- **`PROT-OC-01`（PTC）の過渡特性やbackfeedの実測値を確認したという主張。**確認していない。
  必要になれば`HW-TBD-030`または新規TBDで扱う。
- 下流3 device（Pi、ESP32、周辺module）が内蔵diodeの順方向電圧相当の逆電圧に耐えるかどうかは、
  引き続きこの節では評価しない。

**通電を伴う検証は行っていない。**この判定は一次資料（datasheet）とこの文書が既に置いている
配線トポロジーの記述だけから導いており、実機での確認は別途必要になりうる。

**基板上の配置。**`PROTO-02`（ユニバーサル基板）上で、`PROT-OC-01`（PTC）と
`PROT-RP-01`（MOSFET）はいずれも入力パッド側（分岐点より手前）に直列で置く。
**2026-09-09に人間が決定した案Bにより、入力元がMicro-B変換基板（`PSU-INGRESS-01`）から
端子台（`114217`）へ変わったが、分岐点より手前に直列という配置そのものは変わらない。****MOSFETのDrainリードをPTC側（入力側）、Sourceリードを分岐点側（出力側）へ
向け**（2026-09-04訂正。従来はSource/Drainが逆だった）、Gateリードから共通GND戻りへの
配線は最短距離で取る（gate抵抗もこの経路に直列で挿入する）。
**現物合わせでの正確な座標・穴位置は、`PROTO-02`の残作業と同じく着荷後に決める。**
この節が決めるのは向き・直列順序・配線トポロジーであり、現物のレイアウト座標ではない。

出典は[2SJ334 datasheet](https://akizukidenshi.com/goodsaffix/2sj334.pdf)（東芝、2006-11-14。
sha256 `c01da93643cb1cb11075d9137897655c556989de647c38368d5c487274d5da46`。2026-09-03に
1ページ目のpin配列図、2ページ目の電気的特性表（`Ciss`／`IGSS`／`VDSF`）を確認、2026-09-04に
向きの訂正にあたり同じ表を再確認）、[PR #342](https://github.com/wachi-yoshitaka-11-dev/deskcat/pull/342)のCodeRabbit `full review`、
[#205](https://github.com/wachi-yoshitaka-11-dev/deskcat/issues/205)。

## 測定計画

**測定手段**: **この節が書かれた時点ではoscilloscopeを所有していないものとしていたが、2026-08-20に手持ちのdigital storage oscilloscope（`MEAS-05`。`QUIMAT DSO Shell`）が現物で判明した。****下記の既定手段は、その採否が決まるまで変えない**（採否は`HW-TBD-034`の`(1) 測定器の採否`であり人間の判断である）。**2026-09-14に採否を決定した。**方式1の記録係はArduino Uno R3単独である（正は[power-budget.md](power-budget.md#測定計画)の`測定器の採否を決定した（2026-09-14）`。**ここへ再掲しない**）。既定手段は、セメント抵抗0.1Ω（shunt）を
**servo railのGND戻り経路（低側／low-side）**に挿入し、その両端電圧をESP32のADCでsamplingする方法
（「ESP32＋shunt抵抗によるADC logging」）とする。定常電流はデジタルテスター（DT830B）でも確認できるが、
サーボ起動時のms単位の過渡変化にはADC loggingを使う。使用するADC pinは`gpio-assignment.md`で予約済み
（`ADC-SHUNT`＝GPIO32、`ADC-5V`＝GPIO33、`ADC-3V3`＝GPIO36。すべてADC1）。

**この測定手段そのものが`HW-TBD-034`で再検討の対象になっている**（`電源過渡の測定方式のdesign review`）。
**方針はここでは変えない。**この測定系で何を保証しないかは
`ESP32自身のADCは測定対象から独立していない`が定める。

### Pi Zero Wには低電圧検出が無い

**Piのbrownoutをsoftwareで検出できると仮定しない。**

[Raspberry Pi公式documentation](https://www.raspberrypi.com/documentation/computers/raspberry-pi.html)の
`Power supply warnings`は、供給電圧が4.63 V（±5 %）を下回ったことを検出してkernel logへ記録する
低電圧検出回路について、**`On all models of Raspberry Pi since the Raspberry Pi B+ (2014) except the Zero range`**
と述べている。**`SBC-01`はRaspberry Pi Zero Wであり、この`Zero range`に該当する。**

**この一次資料が支えるのは、低電圧検出回路が無いことだけである。**`reset reason`を取得できるかどうかは
この資料が述べておらず、**この文書でも「取得できない」とは主張しない。**必要なら別途確認する。

帰結は2つある。

- **kernel logのundervoltage警告が出ない。**しきい値4.63 Vも、
  Pi Zero Wの動作範囲の下限としては使えない（そもそも検出回路の動作点であって動作範囲の下限ではない）
- **量によって手段が違う。**Pi入力の**定常電圧**はDMMで読める。**瞬時的な電圧低下（droop）と
  rippleは`ADC-5V`の実測でしか捉えられない**（DMMでは捉えられない）。分圧用抵抗（10 kΩ×4）は
  **入手済みである**（`hardware-bom.md`の`MEAS-01`。2026-08-12に購入履歴と照合して訂正した）。
  **したがってADC測定系は部品待ちではなく、実装と検証が残るだけである。****ただし実装できても合否は判定できない。**
  判定に使う最低電圧が`HW-TBD-028`(a)として未確定だからである。
  **2026-09-06にPMが(a)を要件から外すと決定したため、Pi側の電圧判定は対象外である**（復帰条件を満たすまで合否判定を行わない）
  （`(a)を要件から外す（2026-09-06、PM決定）`。観測自体は[#247](https://github.com/wachi-yoshitaka-11-dev/deskcat/issues/247)の診断作業として引き続き行える）

**ESP32側は別である。**ESP32は自身でbrownoutを検出するため、ESP32のbrownoutとreset reasonの
確認は有効であり、そのまま維持する。**Piと同じ扱いにしない。**

**ただしそれは「resetが起きた事実」であって、rail waveformを外部から連続観測したことではない。**
ESP32自身のADCで`ADC-5V`／`ADC-3V3`を測る構成には別の限界があり、
`ESP32自身のADCは測定対象から独立していない`で扱う。**この2つを混同しない。**

判定に使う電圧の値そのものは`受け入れ条件`の(a)にあり、**現時点で確定していない**
（一次資料に無いことを確認済み）。

### ESP32自身のADCは測定対象から独立していない

**測定対象がESP32自身の電源であるとき、そのESP32のADCで測った結果を独立した観測として扱わない。**

`測定計画`が定める測定系は、`ADC-5V`（GPIO33）と`ADC-3V3`（GPIO36）をESP32のADC1で読む
（`gpio-assignment.md`）。**この2つはどちらも、ESP32自身の給電がそこから導かれるrailである。**
3.3 Vはboard上regulatorの出力そのものである。5 V ingressは、案BならESP32の`5V` pinへ直接入り、
案AでもPiのUSB OTG portを経てESP32へ届く（`ESP32の給電経路（最終の経路は未決定）`）。
**どちらの案でも、5 V側の異常はESP32の動作へ直接効く。**そしてESP32が止まればADCも止まる。
**測りたい区間と、測定器が止まる区間が同じである。**

**この節が述べるのは、観測できない区間があることだけである。**ESP32のbrownout検出が働かないとは
述べていないし、ADC loggingが無価値だとも述べていない。`reset reason`を取得できることも変わらない。
**述べるのは、取得できるものが何であるかである。**

**`Pi Zero Wには低電圧検出が無い`とは別の問題である。**あちらはPi自身に検出回路が無いことを述べている。
こちらは検出回路の有無ではなく、**測定系が測定対象から給電されていること**である。
**ESP32は検出回路を持つが、この問題からは免れない。**

帰結は2つある。

- **量によって独立性の要否が違う**
- **未観測区間が3種ある。**どれも「起きなかった」ことの根拠にならない

| 量 | ESP32自身のADCで測ってよいか | 理由 |
|---|---|---|
| `ADC-SHUNT`（GPIO32。servo railの電流） | **条件つきで可** | 監視対象はservoでありESP32ではない。**ただしESP32がresetすれば記録はそこで途切れる** |
| `ADC-5V`（GPIO33。5 V rail） | **独立性が要る** | ESP32の給電はこのrailから導かれる（候補の案Bは`5V` pinへ直接、案AはPiのUSB OTG port経由。最終の経路は[#405](https://github.com/wachi-yoshitaka-11-dev/deskcat/issues/405)で決める）。**測りたい区間が、測定器の止まる区間と同じである** |
| `ADC-3V3`（GPIO36。3.3 V rail） | **独立性が要る** | 同上。ESP32のlogic電源そのものである |
| ESP32のbrownoutと`reset reason` | 可。**ただし別の量である** | **resetが起きた事実**を示す。rail waveformを外部から連続観測したことにはならない |

未観測区間は次の3種である。

| 区間 | 長さ | 正 |
|---|---|---|
| sample間 | sample間隔ぶん。**目標sample rateを達成しても0にはならない** | `Sample rateとlog形式`（sample rateの値は**ここへ再掲しない**） |
| ESP32のbrownout／reset中から再起動完了まで | **TBD。**この長さ自体を測っていない | — |
| capture windowの外 | 取得方式が`burst capture`であるため、1回のcaptureの長さの外は観測しない。**連続観測ではない** | `Sample rateとlog形式`（buffer長も同様に**再掲しない**） |

**何を保証しないか。**次を主張しない。

- 「電源過渡をすべて実測済みである」
- 「sample間隔より短いexcursionは起きなかった」
- 「ESP32がresetした区間のrail電圧は範囲内だった」。**その区間の波形は記録されていない。
  `reset reason`はその代わりにならない**
- 「capture window外の過渡は起きなかった」。**window外は観測対象ですらない**

**したがって`受け入れ条件`の(c)(d)の合否判定は`Blocked`のままである**（`(c)(d)の導出規則`と
`定義した値をどの段階で照合するか`。**ここへ再掲しない**）。
**[技術ガイド](../DeskCat_Microcontroller_Development_Guide.md)のゲートAが求める
「起動時の電源過渡をすべて実測」も、この測定系では満たせない。**

**2026-08-16に方式1（独立した外部観測）を採用した。**ただし**測定器の採否、実装、基準電圧の校正、
取得方式、GND topology、必要帯域の一次資料は未解決である。**材料と残りは`電源過渡の測定方式のdesign review`にあり、
追跡は[tbd-register.md](tbd-register.md)の`HW-TBD-034`である。**方式が決まったことを、
測定できるようになったことと読み替えない。**
**2026-09-14に採否を決定した。**方式1の記録係はArduino Uno R3単独である（`測定器の採否を決定した（2026-09-14）`）。**上の列挙のうち決定したのは測定器の採否だけである。**実装・基準電圧の校正・取得方式・GND topology・必要帯域の一次資料は未解決のままである。

### 電源過渡の測定方式のdesign review

**2026-08-16に人間が方式1を採ると決定した。**
**ただし`HW-TBD-034`はcloseしない。**決まったのは方式であって、**測定器の採否も実装も未了である****2026-09-14訂正: 決定したのは採否だけである。実装（項目2）は残る。**方式1の記録係はArduino Uno R3単独である（`測定器の採否を決定した（2026-09-14）`）。**この記述は決定前のものである。**
（未解決の全数と close 条件は[tbd-register.md](tbd-register.md)の`HW-TBD-034`が持つ。
**件数をここで数えない**）。

論点の出所は[#3](https://github.com/wachi-yoshitaka-11-dev/deskcat/issues/3)の2026-08-16の追記である。
**「Oscilloscopeを購入する」と先に結論づけるものではない**ことは追記自身が明記しており、
**実際にoscilloscopeは購入しない。**購入しないという判断は変わらない。**ただし2026-08-20に、手持ちのdigital storage oscilloscope（`MEAS-05`。`QUIMAT DSO Shell`）が現物で判明した。****したがって候補はArduino Uno R3だけではない。**下の`手持ちの候補`を参照する。**どちらを採るかは決まっていない**（`HW-TBD-034`の`(1) 測定器の採否`。人間の判断である）。**2026-09-14に採否を決定した。**方式1の記録係はArduino Uno R3単独である（`測定器の採否を決定した（2026-09-14）`）。**この記述は決定前のものである。**

**方式1を採ったことでゲートAの改訂は不要になった。**
[技術ガイド](../DeskCat_Microcontroller_Development_Guide.md)は現状のままとする。

#### 方式1: 独立した外部観測を導入する — **採用**

監視対象のESP32がresetしている間も含めて、rail waveformを外部から連続観測する。
**2026-08-16に採用を決定した。**

| 項目 | 現状 |
|---|---|
| 必要帯域の根拠 | **TBD。**現在の根拠は「servo起動の過渡はms order」だけであり、`Sample rateとlog形式`はその目標sample rateを**「未実測の設計目標であり、受け入れの根拠にしない」**と自ら述べている。**必要帯域を決めるには、想定するtransientの立ち上がり時間を一次資料または実測で押さえる必要がある。**ここに値を置かない（[AGENTS.md](../../AGENTS.md) 推測禁止）。**2026-10-26、(6)の一次資料は得られていない。**servoの起動transientの公開値が無い（`SG90`は製品ページの仕様表だけで、突入電流の波形が無い。`HW-TBD-026`と同じ）。**実測の機会は[#17](https://github.com/wachi-yoshitaka-11-dev/deskcat/issues/17)の受け入れ条件`5 Vと3.3 Vのtransientを取得した`である**（servoの通電が要るため、机上では埋まらない） |
| 候補の種別 | (1) 2 ch以上のdigital oscilloscope、(2) PCへ接続するUSB oscilloscopeまたはdata logger、(3) **監視対象とは別のmicrocontroller＋ADC**。(3)も、監視対象のESP32がresetしても記録が続く点では(1)(2)と同じ性質を持つ。**ただし(3)が塞ぐのは「記録係が監視対象と一緒に止まる」区間だけであり、sample間の未観測区間は残る**（`ESP32自身のADCは測定対象から独立していない`）。**「data logger」を名乗る製品には長時間記録向けの低速品も含まれる。**必要な時間分解能を満たすかを、品ごとにメーカー資料で確かめる |
| **手持ちの候補（購入不要）** | **Arduino Unoを所持している**（[hardware-bom.md](hardware-bom.md)の`初期製作の明示的な対象外`。同表の`Not used`は**real-time controllerとして採らない**という意味であり、**測定機材として使えないという意味ではない**）。PCのUSBから給電すれば監視対象のESP32とは別電源になるため、****独立給電**の条件は満たしうる（**「独立した観測」の成立は別である。**`電源過渡の測定方式のdesign review`）。**上記(3)にあたる |
| **手持ちの候補（購入不要）その2** | **2026-08-20に現物の写真でdigital storage oscilloscopeの所持が判明した**（[hardware-bom.md](hardware-bom.md)の`MEAS-05`）。筐体の表示は`DSO Shell`／`QUIMAT`、操作部は`V/DIV`／`SEC/DIV`／`TRIGGER`／`OK`と`ADJ`ノブ、入力は**BNC 1系統**である。**2026-08-21にJYE Techの`DSO150`のmanualを取得した。ただし現物の筐体表示は`QUIMAT`であり、同一機種である根拠は無いため、manualの数値はこの現物に対しては参考値である**（[PR #160](https://github.com/wachi-yoshitaka-11-dev/deskcat/pull/160)の自動reviewの指摘）（値の正は[hardware-bom.md](hardware-bom.md)の`MEAS-05`。**ここへ再掲しない**）。**channel数は現物の入力系統数が1であることから確定でき、上記(1)（2 ch以上）を満たさない。****これはmanualに依らない現物の観測である。**`ADC-5V`と`ADC-3V3`を同時に見られない。**これは判定できないのではなく、満たさないと確定した。**帯域・sample rate・入力範囲・記録長は**同manualの参考値であり、この現物では未確認である。****`Record length`が固定である点が採否に効く**（`2つの手持ち候補は代替ではなく相補である（2026-08-21の材料）`）。**垂直確度は同manualに記載が無く、未取得のままである。****電源は外部のDC入力で、PCにも測定対象にも依存しない。**適合する電源も手元にあり、plugの実物適合も確認した。**したがって独立給電の条件は満たす**（[hardware-bom.md](hardware-bom.md)の`MEAS-05`）。**ただし「独立した観測」の成立は別である**（同じ行の`その1`と同じ扱いにする）。独立給電は必要条件の1つにすぎず、**GND topology、入力headroom、実機での動作は別に検証が要る。****この品ではそのいずれも検証していない。****channel数が1で(1)を満たさないことも変わらない。****2026-08-21に初回通電し、画面が表示されることを確認した**（異音・発熱・異臭なし。人間が基板のそばで観察）。**BNCには何も接続していない。**確認したのは電源が入り画面が出ることまでで、**波形の取得も垂直確度の確認もしていない。**したがって**測定器として使えることは依然として確認できていない。**確認項目が埋まるまで採否を判断しない（[AGENTS.md](../../AGENTS.md) 推測禁止） |
| 手持ち候補の確認項目 | **2026-08-16に(a)(b)(c)を一次資料で確定した**（下記`手持ち候補の現物識別`）。(a) 現物の刻印とArduino公式資料が一致。(b) sample rateは**2026-08-17に実測し、必須要件を2 channel同時で満たした**（値の正は`手持ち候補に固有の制約: SRAMと取得方式`。未加工の観測は[experiment-log.md](experiment-log.md)の`EXP-001`）。(c) 入力範囲は**0〜V<sub>CC</sub>**。**ただし直結の可否は別条件であり、`5 V railをADCへ直結する条件`を満たすまでdividerを外さない。**(d) **USB給電での動作は2026-08-17以降の実測で確認した**（`EXP-001`／`EXP-002`／`EXP-003`。**いずれもPCのUSB給電のみ**）。**2026-08-22には監視対象のESP32へ接続した状態でも異常が無いことを確認した**（`EXP-003`）。**加えて未解決が3点ある**（`方式1で残っている未解決3点`）。**方式1の採用は決定済みだが、この品の採否は確定していない****2026-09-14に採否を決定した。**方式1の記録係はArduino Uno R3単独である（`測定器の採否を決定した（2026-09-14）`）。**この記述は決定前のものである。** |
| 手持ち候補に固有の論点 | **GND topologyが変わる。**外部の記録係を足すと、その GND を測定対象のどこへ落とすかを決める必要がある。`GND topology（測定前に必ず確定させる）`が定めたstar point構成を崩さないこと、およびPCのGNDが経路へ入ることの影響を、**配線前に確定させる。**未確定のまま測定しない |
| 品番と概算 | **TBD。**`PROT-OC-01`と同じく、**発注直前にメーカーの一次資料で確定する。**この節では品番を挙げない |
| 増える部品 | **手持ちのArduino Unoが上記の確認項目を満たせば、購入は不要になりうる。**満たさない場合に限り(1)(2)のいずれか1点と、必要なprobe・配線。**[hardware-bom.md](hardware-bom.md)の購入待ちリストへは、この節では何も足さない。**方式は2026-08-16に決まったが、この品で足りるかは未確認である。**この段階で発注対象へ載せると、要るかどうか決まっていない購入が発注時の唯一の参照先に載る（`local decouplingの外付け要否`節と同じ扱い） |

**方式1を採る場合、[技術ガイド](../DeskCat_Microcontroller_Development_Guide.md)のゲートAは現状のままでよい。**

##### 測定器の採否を決定した（2026-09-14）

**方式1の記録係はArduino Uno R3単独とする。QUIMAT DSO Shellは記録係としては採らない。**
**提案はPM、承認はユーザー（2026-09-13に取得。正本への反映は2026-09-14）。**[tbd-register.md](tbd-register.md)の`HW-TBD-034`の項目1である。

理由は4点である。

- **方式1が塞ぐと決めた区間は`capture window外`と`brownout／reset中`の2つである。**
  `sample間`が残ることは方式によらず維持する規則であり（`方式2: ADC loggingに限定し、合格主張を狭める`の末尾）、
  **Arduinoの約208 µsは方式1の失格要件ではなく、方式1を採ると決めた2026-08-16の時点で受け入れた残余である**（208 µsの値は`2つの手持ち候補は代替ではなく相補である（2026-08-21の材料）`にある）。
- **Arduinoはその2区間を塞ぐ設計である。**連続streamingであり、2 ch同時取得とCSVでの持ち出しは
  `EXP-001`の実測である（**manual由来の参考値ではない**）。
  **ただし`EXP-001`はArduino単体とPCで完結しており、DeskCat側へ接続していない。**
  **監視対象のresetを跨いで記録が続くことは設計上の帰結であって、実測ではない。**
  **記録係が対象と一緒に止まらないこと（独立給電）も候補条件のままであり、`HW-TBD-034`の項目6bに従属する。**
- **DSO Shellは記録係の要求を満たさない。**根拠は現物の観測に置く。
  **channel数が1であることは現物の観測で確定しており**（`2つの手持ち候補は代替ではなく相補である（2026-08-21の材料）`）、
  `候補の種別`の(1)「2 ch以上のdigital oscilloscope」に当たらない。PCへの持ち出し方法も未確認である。
- **併用も今は採れない。**DSOが何を足すかを言うには帯域・記録長・垂直確度のどれかを根拠にする必要があるが、
  **いずれもmanual由来で現物未確認である**（筐体表示は`QUIMAT`、manualは`DSO150`で同一機種の根拠が無い）。
  いま併用と書けば未確認の値を根拠にしたことになる（[AGENTS.md](../../AGENTS.md) 推測禁止）。

**採用の範囲を限定する。**採ったのは**記録係の役割**についてであり、**必要帯域を満たすという主張は含まない。**
`HW-TBD-034`の項目6（必要帯域の一次資料）は独立に残り、この採用では埋まらない。
**DSO Shellの`Analog bandwidth 0–200 kHz`は根拠にならない。**理由は2つあり、**必要帯域そのものが`TBD`で比較相手が無いことと、この値がmanual由来で現物未確認であることである。****同じ理由で、Arduinoのsample rateも「足りる」根拠として書かない。**

**DSO Shellは捨てない。**項目6が解け、その必要帯域がArduinoの`sample間`では足りないと判明したときに、
**帯域側の計測器として別途判断する。**そのときは**現物同定を先に埋める**（manualの値がこの現物に当てはまるかが決まらない限り、帯域・記録長・垂直確度のいずれも根拠に使えない）。**PCへの持ち出し方法も要る。**
**いまの記録係の判断には数えない。**

**この採用が覆る条件を書いておく。**`HW-TBD-034`の項目6b（Power Treeのschematic粒度の確認）で**記録係が監視対象と一緒に止まらないことが否定された場合、Arduinoは`brownout／reset中`を塞げず、採用は覆る。**
**2026-10-26更新。**項目6bのうち、電源電流経路の直列・制御の役割とGNDは回路図で確認し、否定されていない（`手持ち候補の現物識別`の`給電経路は`の行）。**backfeed経路は、回路図の確認の範囲外で未確認である。**

**gateは1つも開かない。**方式1の実装（`HW-TBD-034`の項目2）は別に残る。

##### 2つの手持ち候補は代替ではなく相補である（2026-08-21の材料）

**採否は人間の判断であり、この節は判断しない。**材料だけを置く。
DSO Shellの値の出所はJYE Tech Ltd. `DSO150 Shell User Manual Rev. 07`の`Specifications`である
（URLとsha256は[hardware-bom.md](hardware-bom.md)の`MEAS-05`。**ここへ再掲しない**）。

**この値は参考値である。**現物の筐体表示は`QUIMAT`であり、**同manualの`DSO150`と同一機種である根拠は無い**
（[PR #160](https://github.com/wachi-yoshitaka-11-dev/deskcat/pull/160)の自動reviewの指摘）。
**したがって下表のDSO Shell側の値のうち、manual由来のものはこの現物では未確認である。**
**現物の観測に基づくのはchannel数（入力系統が1）と外部DC給電だけである。**
**このため下の比較は採否の判断材料であって、判断そのものではない。**
Arduino側の値は`EXP-001`の実測である（[experiment-log.md](experiment-log.md)）。

| 論点 | Arduino Uno R3 | DSO Shell |
|---|---|---|
| 取得方式 | **連続streaming。**長さはtransportで決まり、reset区間を跨いで記録が続く | **単発capture。`Record length`が1024 pointsに固定である**（`Trigger position`は`Center of buffer`なのでpre-trigger側も残る） |
| channel数 | **2 ch同時**（`ADC-5V`と`ADC-3V3`を並べて見られる） | **1系統のみ** |
| sample rate | 1 chあたり実測4808.9 Sample/s（125 kHz時） | `1MSa/s`（`Analog bandwidth 0 -- 200KHz`） |
| **sample間の未観測区間** | 約208 µs残る。**`HW-TBD-034`が立った理由そのものである** | 1 MSa/sなら約1 µs。**ただし1024 pointsの窓の中だけである** |
| 分解能 | 10 bit（`DS40002061B`） | `12 bits`。**垂直確度はmanualに記載が無く未取得** |
| 独立給電 | PCのUSBから給電するため、**ESP32とGNDがPC内部で共通化される** | **`9V DC`外部給電。PCにも測定対象にも依存しない** |
| 記録の持ち出し | **host側へstreamし、CSVとtestで再現できる**（治具はmerge済み） | **manualの`Specifications`にPCへの出力が無い。**画面の`Save Waveform`のみで、再現可能な形での持ち出し方法は未確認 |

**どちらも単独では方式1の要求を満たさない。****2026-09-14に採否を決定した。**方式1の記録係はArduino Uno R3単独である（正は[power-budget.md](power-budget.md#測定計画)の`測定器の採否を決定した（2026-09-14）`。**ここへ再掲しない**）。**この「満たさない」は2品の能力の比較であって、記録係として採るかどうかとは別である。**`sample間`が残ることは方式によらず維持する規則であり、失格要件ではない（`方式2: ADC loggingに限定し、合格主張を狭める`の末尾）。

- **DSO Shellは連続observationができない可能性が高い。**`Record length`が固定であるため（**値はmanualの参考値であり、この現物では未確認である**）、
  **brownoutからresetを経て復帰するまでの全区間**を1回のcaptureで覆えるとは限らない。
  **覆えるかは`必要帯域の根拠`と観測したい区間長が決まるまで判定できない**（どちらも`TBD`である）。
- **Arduinoはsample間の未観測区間を消せない。**約208 µsが残る。
  連続streamingで`capture window外`は消えたが、**`sample間`は残っている。**

**したがって「oscilloscopeが手に入ったのでArduinoは不要」とはならない。**
**逆も成らない。**2つを併用する案が成立するかも、この節では判断しない。

**`Analog bandwidth 0 -- 200KHz`は`必要帯域`を満たす根拠にならない。**
**必要帯域そのものが`TBD`である**ため、比較する相手が無い。
**「200 kHzあるから足りる」と書かない。**

**副産物**: DSO Shellの`Input impedance`は`1M ohm/20pF`と確定した。
**DT830Bでは判定できなかった§24.5.2の`high impedance voltmeter`要求は、この機材では判定できる。**
ただし**比率法を採る判断は変えない**（AREFへ何も接続しない方法の方が条件が少ない）。

##### 手持ち候補の現物識別

**2026-08-16に現物の写真で確定した。通電はしていない。**

| 項目 | 読み取った刻印 | 位置 |
|---|---|---|
| board model | **`UNO R3`**（`BOARD MODEL` / `UNO R3`。`OPEN-SOURCE ELECTRONICS PROTOTYPING PLATFORM` / `MADE IN ITALY` / `WWW.ARDUINO.CC`） | 裏面silkscreen |
| microcontroller | **`ATMEGA328P-PU`**（`ATMEL`ロゴ、DIP-28、socket実装。ロット`1344`） | 表面のDIP部品 |
| USB-serial変換 | **`MEGA16U2`**（`ATMEL`ロゴ、QFN。ロット`1336`） | 表面、USB connector寄り |
| 電源regulator | `D113rC` / `17-50`（SOT-223） | 表面。**型番は未特定。**この節では使わない |
| analog入力 | `A0`〜`A5`の6本が`ANALOG IN`として実装されている | 表面silkscreen |
| その他 | `CE`、`FCC`、`RoHS COMPLIANT`。`SDA` / `SCL`のpad表記あり | 裏面 |

刻印はArduinoの公式資料と一致した。**board側は一次資料で裏付けが取れている。**

| 確認できたこと | 一次資料 |
|---|---|
| `ZU4`＝`ATMEGA328P-PU`、`U3`＝`ATMEGA16U2`。**現物の刻印と一致する** | [UNO R3 schematic](https://docs.arduino.cc/resources/schematics/A000066-schematics.pdf)（`UNO-TH_Rev3e`）、[UNO R3 User Manual](https://docs.arduino.cc/resources/datasheets/A000066-datasheet.pdf) SKU A000066 の`3.1 Board Topology` |
| **USB-B connectorから給電される。**`To connect the UNO R3 to your computer, you'll need a USB-B cable. This also provides power to the board` | User Manual `4.1 Getting Started - IDE` |
| 給電経路は`USBVCC → OPAMP → +5V → ATMEGA328P-PU`。**監視対象のDeskCat側railを通らない。****これはPower Treeのblock図の粒度の記述である。**同図の`OPAMP`が電源電流経路に直列なのか、MOSFETを制御する側なのかは**この出典からは決まらない。****`F1`、`T1`、GND、backfeed経路のschematic粒度での一致は未確認であり、`HW-TBD-034`で扱う。****独立給電はそれまで候補条件として扱う****2026-10-26更新（[#525](https://github.com/wachi-yoshitaka-11-dev/deskcat/issues/525)、`HW-TBD-034`の項目6b）。**公式の[UNO R3 schematic](https://docs.arduino.cc/resources/schematics/A000066-schematics.pdf)（`UNO-TH_Rev3e`、sha256 `2c1041200352485393108e03c5117a07d4ea03954654485526c2c56cd01f7a42`、2026-10-26取得）を読んだ。**図の読み取りは目視である。**USBの`VBUS`は`F1`（`MF-MSMF050-2` 500 mA）を経て`USBVCC`になり、`T1`（`FDN340P`、P-ch MOSFET）を経て`+5V`へ入る。**`T1`が電源電流経路に直列である。**`U5A`（`LMV358`）は`VIN`の分圧と`+3V3`を比べて`T1`のgateを駆動する制御側であり、電源電流は通らない。`VIN`側は`D1`（`M7`）と`U1`（`NCP1117ST50T3G`）を経て`+5V`へ入る。GNDは単一のnetに見える。**backfeed経路（Arduinoが給電されていない間に、dividerとGNDを通って回り込む経路）は、この回路図の確認の範囲外で、未確認である。****この確認は、USB給電のとき`+5V`がDeskCat側のrailを通らないことの、schematic粒度の裏付けである。**独立した観測の成立（GND topology、PC groundの影響、入力headroom、実機での動作）は別に残る。 | User Manual `3.3 Power Tree`（block図）、UNO R3 schematic（2026-10-26。粒度は上の更新のとおり） |
| USB connectorからの最大入力電圧`VUSBMax` **5.5 V** | User Manual `2.2 Power Consumption` |
| `A0`〜`A5`が`ADC[0]`〜`ADC[5]`（`PC0`〜`PC5`）としてheaderへ出ている。**boardに分圧は入っていない** | User Manual `5.1 JANALOG`、schematic |
| `AREF`がheaderへ出ており、`C4` 100 nFでGNDへ落ちている。`AVCC`は`+5V`から`L2` 10 µH経由 | schematic |
| `IOREF`は`Reference for digital logic V - connected to 5V` | User Manual `5.1 JANALOG` |

**この経路図が裏付けるのは「独立給電」だけである。**PCのUSBから給電する限り、Arduino側の`+5V`は
DeskCatの5 V ingressから導かれない。**したがって監視対象がbrownoutしても記録係は停止しない。**

**これは「独立した観測」が成立したことを意味しない。**独立給電は必要条件の1つにすぎず、
残る条件は別に検証する。**GND topology**（`手持ち候補に固有の論点`）、**PC groundが経路へ入る影響**、
**入力headroom**（`5 V railをADCへ直結する条件`）、**実機での動作**である。
**これらの検証が済むまで`HW-TBD-034`はOpenのままとする。**

**ADCの性能値は`DS40002061B`で確定した。**現物のPDIP-28（同文書の`SPDIP`）を対象に含む版である。

| 項目 | 値 | 出典 |
|---|---|---|
| 分解能 | **10 bit** | §24.1 Features、Table 29-15 |
| channel数 | **6**（`6 Multiplexed Single Ended Input Channels`。`2 Additional`は`TQFP and VQFN Package only`であり**現物には無い**） | §24.1 |
| sample rate | **最大76.9 kSPS。最大分解能では最大15 kSPS**（`Up to 76.9kSPS (Up to 15kSPS at Maximum Resolution)`） | §24.1 |
| conversion time | **13〜260 µs**（Free Running Conversion） | §24.1、Table 29-15 |
| ADC clock | **50〜1000 kHz** | Table 29-15 |
| 入力電圧範囲 | **0〜V<sub>CC</sub>**。`V_IN`は`GND`〜`V_REF` | §24.1、Table 29-15 |
| 基準電圧`V_REF` | **1.0 V〜AV<sub>CC</sub>。**AREF外部入力、AV<sub>CC</sub>、内蔵1.1 Vから選ぶ | §24.1、§24.2、Table 29-15 |
| 内蔵基準`V_INT` | **min 1.0／typ 1.1／max 1.2 V** | Table 29-15 |
| 絶対確度 | **2 LSB**（`V_REF = 4V, V_CC = 4V, ADC clock = 200kHz`）。**ADC clock 1 MHzでは4.5 LSBへ悪化する** | Table 29-15 |
| 入力帯域 | typ **38.5 kHz** | Table 29-15 |

出典: [ATmega48A/PA/88A/PA/168A/PA/328/P megaAVR Data Sheet](https://ww1.microchip.com/downloads/en/DeviceDoc/ATmega48A-PA-88A-PA-168A-PA-328-P-DS-DS40002061B.pdf)
`DS40002061B`（© 2020 Microchip Technology Inc.）§24 `Analog-to-Digital Converter`、§29.8 `ADC Characteristics`。
sha256 `b9b9d83cda56a95d999ea8d54fe5a540748ae9020e5e7ae19b913d384ba9320e`、2026-08-16取得。

**確認項目(b)(c)はこれで満たされる見込みである。**必須要件の1 kSample/s以上（`Sample rateとlog形式`）に対し
最大分解能でも15 kSPSある。

**ただし「目標帯（5〜10 kSample/s）にも入る」は、この品では成立しない。**
15 kSPSに要るADC clockは、1変換あたりの cycle 数を13.5（Table 24-1）とすれば約202.5 kHz、実測どおり13とすれば195 kHzである。**後者は50〜200 kHzの規定内に入る。****それでもこの品では出せない。prescalerの分周比は2の冪しか選べず**
（Table 24-5 `ADC Prescaler Selections`。2／4／8／16／32／64／128）。
16 MHzから作れるのは125 kHzの次が250 kHzであり、**50〜200 kHzの規定内に収まるのは125 kHzだけである。**
したがって**規定内で選べる最速は125 kHzに限られ、そこから出るrateは目標帯へ届かない。**
実測値と、そこから決めた既定は`手持ち候補に固有の制約: SRAMと取得方式`にある（**ここへ再掲しない**）。

入力範囲が0〜V<sub>CC</sub>であるため、
**AV<sub>CC</sub>を基準に採れば5 V railを分圧なしで測れる可能性がある**（ESP32側で要った10 kΩ×2のdividerが不要になる）。
**ただし無条件ではない。**下記`5 V railをADCへ直結する条件`を満たすまで、dividerを外さない。
**ただし下の基準電圧の論点が未解決であり、この品の採否は確定していない。****2026-09-14に採否を決定した。**方式1の記録係はArduino Uno R3単独である（正は[power-budget.md](power-budget.md#測定計画)の`測定器の採否を決定した（2026-09-14）`。**ここへ再掲しない**）。**方式1の採用は決定済みである。方式の決定と測定器の採否を混同しない。**

**2 channelを同時に見る場合、1 channelあたりの実効rateは下がる。**`ADC-5V`相当と`ADC-3V3`相当を
両方見るなら、上記のrateをchannel数で割った値で評価する。
**この割り算どおりになることは2026-08-17に実測で確認した**（1 chと2 chで合計取得rateが変わらなかった。
[experiment-log.md](experiment-log.md)の`EXP-001`）。

**channel切り替えの扱いは§24.5で確定した**（2026-08-17。同節はそれまで`未確認`としていた）。
free running modeでは、ISRから`ADMUX`を書き換えても**次に上がる結果は「前のchannel」のもの**である。

> In Free Running mode, always select the channel before starting the first conversion. …
> Since the next conversion has already started automatically, **the next result will reflect the
> previous channel selection.** Subsequent conversions will reflect the new channel selection.
> （§24.5.1 `ADC Input Channels`、`DS40002061B`-page 251）

**帰結: 現在の`ADMUX`でsampleにchannelのtagを付けると、labelが1つずれて入れ替わる。**
値そのものは正常に見えたままlabelだけが誤るため、**同じ電圧を2 channelへ入れて確認しても検出できない。**
確認には**異なる既知電圧**を入れる必要がある。
§24.5本体はAuto Triggering下での`ADMUX`更新の安全な条件を3つに限定しており、ISRから書くのは
「trigger source flagのclear前」にあたる。**1変換ぶんの遅れを織り込んだ実装で、実測により
channelの大小関係が入力と一致することを確認した**（`EXP-001`）。

##### 手持ち候補に固有の制約: SRAMと取得方式

**ATmega328PのSRAMは2 KBである**（`DS40002061B` Features `2Kbytes internal SRAM`。
[UNO R3 User Manual](https://docs.arduino.cc/resources/datasheets/A000066-datasheet.pdf)も`2 kB SRAM`）。
**これは`Sample rateとlog形式`が定めるburst captureの前提を満たさない。**

同節は1回のcaptureで最低200 msを要求し、必要RAMを`sample rate × 2 byte × 0.2 s`と定めている。
最大分解能の15 kSPSでは**6 KB**となり、**2 KBに収まらない。**
**buffer長を短くする代替は同節が既に禁じている**（「短くしても取り逃がしたpeakは戻らない」）。

**ただしburst captureを採る理由自体がArduino側には無い。**ESP32がburst captureにしたのは、
Pi–ESP32間のUSB serialが1本しかなく、**Protocolがそのbaudを共有transport parameterとして持つ**
ためである（`Sample rateとlog形式`）。**Arduinoの USBはProtocolと無関係であり、測定に専有できる。**

したがって**連続streamingを選べる。**成立すれば次の2つが同時に片付く。

- SRAM 2 KBの制約が効かなくなる（溜めないため）
- **未観測区間のうち`capture window外`が消える**（`ESP32自身のADCは測定対象から独立していない`）。
  **`sample間`は残る**

**2026-08-17に実測し、2026-08-18に治具の集計の誤りを直して取り直した。**確認はArduino単体で行い、DeskCat側へは接続していない。
未加工の観測と手順は[experiment-log.md](experiment-log.md)の`EXP-001`にあり、
**ここに置くのは要件と照合する値だけである。**

| ADC clock | 2 channel同時・合計 | 1 channelあたり | 取りこぼし | 最大分解能の規定（§24.4の50〜200 kHz） |
|---|---|---|---|---|
| **125 kHz**（ADPS 7。**既定**） | 9617.9 Sample/s | **4808.9 Sample/s** | 0 | **規定内** |
| 250 kHz（ADPS 6） | 19236.7 Sample/s | 9618.4 Sample/s | 0 | **規定外。分解能を落とす取引になる** |

**上表は取りこぼしもblock欠番も0だった条件の値である**（125 kHzはbaud 500000、250 kHzはbaud 1000000）。
baudを入れ替えても同じrateが出た。
**PCの壁時計から出した値とArduino自身の`micros()`から出した値が0.1 %以内で一致している。**
**baud 115200では取りこぼしが出る**（transportが律速。1 sampleあたり2.1875 Bを要し、
**実baudは公称より+2.1 %高い**ため約5.4 kSample/sが上限になる。
`DS40002061B` Table 20-7 が16 MHz・U2X=1の`UBRRn`と誤差を与えている。導出は
[experiment-log.md](experiment-log.md)の`EXP-001`）。**測定にはbaud 500000以上を使う。**

**`Sample rateとlog形式`が定める必須要件を、2 channel同時で満たした**（**要件値はここへ再掲しない**）。
**したがってSRAM 2 KBは取得方式の障害にならない。**

**既定を125 kHzとする理由**: 目標帯へ届かせるには250 kHzが要るが、それは上表のとおり
§24.4が最大分解能に求める範囲を外れる。一方で**目標帯そのものの根拠は`TBD`である**
（`電源過渡の測定方式のdesign review`の`必要帯域の根拠`、および`Sample rateとlog形式`が
目標sample rateを「未実測の設計目標であり、受け入れの根拠にしない」と述べている）。
**根拠が未確定の目標のために、一次資料が保証している分解能を手放さない。**
250 kHzの実測値は上表に残してあり、**必要帯域が確定した時点で選び直せる。**
2026-08-18の判断であり、判断したのは人間である（実測は2026-08-17）。

**この2択に中間は無い。**prescalerの分周比が2の冪に限られるため、
16 MHzからは125 kHzの次が250 kHzになる（`手持ち候補の現物識別`）。
**規定内で目標帯へ届く設定は存在しない。**

**取得rateは`ADC clock / 13`と一致した。**Table 24-1が`Auto Triggered conversions`に
与える13.5 cyclesとは一致しない。**この差の機序は確定していない。**実測値を採る（`EXP-001`）。

##### 5 V railをADCへ直結する条件

**入力範囲が`0〜V_CC`であることは、DeskCatの5 V railを直結してよい根拠にならない。**

ここでの`V_CC`は**Arduino側のAV<sub>CC</sub>**であり、PCのUSBから作られる
（`VUSBMax`は5.5 V。`手持ち候補の現物識別`）。一方、監視対象の5 V railは`PSU-PI-01`（M-12001）が供給する。
**この2つは独立した電源であり、常にどちらが高いとも言えない。**

**帰結**: 監視対象側の過渡がArduinoのAV<sub>CC</sub>を超えると、
**入力範囲を外れてclippingするか、入力保護へ電流が流れる。**
**そしてAV<sub>CC</sub>を超える区間こそ、記録したい過渡である場合がある。**

したがって次のいずれかを満たすまで、**dividerを外さない。**

- **divider を残す**（ESP32側と同じ扱い。分圧比は実装時に決める）。**これが既定である**
- または、**入力保護とheadroomの予算を定義して検証する。**両電源の最大値の差、
  ADC入力の絶対最大定格、直列抵抗による保護電流の上限を数値で示し、**一次資料で裏付ける。**
  **`TBD`。この文書には値を置かない**

**未検証のまま直結しない。**[AGENTS.md](../../AGENTS.md)は、電源経路が未確認なら実機駆動しないと定めている。

##### 基準電圧が未解決である（設計上の論点）

**どの基準を採っても、そのままでは絶対電圧の合否判定に使えない。**

| 基準の採り方 | 分圧 | 問題 |
|---|---|---|
| AV<sub>CC</sub>（Arduino自身の5 V） | **不要** | その5 VはUSBから作られる（UNO R3 schematic）。**`OPAMP`と`T1`（`FDN340P`）のどちらが電源電流経路に直列で、どちらが制御側かは未確認である**（`手持ち候補の現物識別`のPower Treeの行と同じ扱い。schematic粒度の確認は`HW-TBD-034`で行う）。**2026-10-26に確認した。`T1`が直列、`OPAMP`（`U5A`）が制御側である**（`手持ち候補の現物識別`のPower Treeの行）。**精密基準ではない。**測定値はArduino側5 Vに対する相対値になる |
| 内蔵1.1 V | **必要**（5 V／3.3 Vとも1.1 Vを超えるため） | `V_INT`は**min 1.0／typ 1.1／max 1.2 V**で、**個体差が±約9 %ある**（Table 29-15）。校正なしに絶対値を主張できない |
| AREFへ外部基準 | 品次第 | 精密基準の追加購入が要る。**品番と定格は未選定** |

**したがって、既知の基準に対する校正か、外部基準の追加のどちらかが要る。**
**これを解かないまま、絶対電圧の合否判定に使わない。**`HW-TBD-028`(b)の閾値は絶対電圧であり、
**相対値では照合できない。**

##### 採る校正方法と、2026-08-18時点で採れた値

**外部精密基準は追加しない**（未選定であり、購入待ちリストにも載っていない）。
**AV<sub>CC</sub>を基準にして内蔵1.1 Vを読み、この個体の実値を割り出す比率法**を採る。

```text
V_INT_actual = (VBGの生ADC値 / 1024) × AVCC実測
```

**§24.5.2は、素直に見える代替に条件を付けている。**同節は`VREF`を`high impedance source`と述べ、
AREF pinでの測定に`high impedance voltmeter`を要求し、`only a capacitive load should be connected`
とも述べている。**DT830Bの直流電圧測定の入力インピーダンスは未取得であり、
この要求を満たすか判定できない。**したがって**AREF pinを直接測る方法には依らない。**
比率法はAREFへ何も接続しないため、この条件を回避できる。
（**「満たさない」と断定しているのではない。**判定に必要な値が無いため、依存しないという選択である）

2026-08-18に採れた値（AV<sub>CC</sub>基準、10 bit、単発変換、n = 64を4回反復。
未加工の観測は[experiment-log.md](experiment-log.md)の`EXP-001`）。

| 入力 | MUX（§24.9.1 Table 24-4） | mean / 1024 |
|---|---|---|
| `1.1V (VBG)` | `1110` | **0.220535〜0.220688** |
| `0V (GND)` | `1111` | 0.000000 |

**分母は1024である。**§24.7 が単端変換の結果を `ADC = (V_IN × 1024) / V_REF` と定めており、
`0x3FF represents the selected reference voltage minus one LSB` もこれと整合する。
**慣習的に使われる1023ではない。**

**ADC offsetは現分解能では検出されなかった**（内部`0V`と、`GND`へ配線した入力がいずれも0）。

**手順上の必須条件が実測で裏付けられた。**§24.4は「bandgapは安定するまで最初の値が誤りうる」と
述べており、実際に`VBG`へ切り替えた直後の1変換だけが126〜161とばらつき、以降は安定した。
**切替直後の変換を捨てる。**§24.5.2の「基準を切り替えた直後の1変換を捨てる」も併せて守る。

**ただし「1変換捨てれば足りる」とは言えない。**上の観測は4 traceであり、
**周囲温度を記録していない1条件下のものである。**AV<sub>CC</sub>・温度・channel切り替えの
条件が変われば必要数が変わりうる（下記`温度とAV`<sub>`CC`</sub>`の依存が、この品では詰めきれない`）。
**手順としては余裕を持たせた数を捨てる。**実際に捨てた数は
[experiment-log.md](experiment-log.md)の`EXP-001`にある。

##### DT830Bを電流測定に使うときの制約（2026-08-21）

**この文書の複数の手順がDT830Bで電流を測ることを前提にしているが、使う端子も測定時間も余裕も書いていなかった**
（[PR #158](https://github.com/wachi-yoshitaka-11-dev/deskcat/pull/158)の自動reviewの指摘）。
**端子を誤ると測定器を壊し、しきい値を下回る読みが実電流の上限を証明しない。**
一次資料は付属取扱説明書と本体表示である（正は[hardware-bom.md](hardware-bom.md)の`MEAS-03`。**値をここへ再掲しない**）。

| 制約 | 内容 |
|---|---|
| **端子の選択** | `VΩmA`端子はヒューズ付きだが上限が低い。`10A`端子は上限が高いが**取扱説明書が「保護ヒューズは働きません」と明記している。**上限は`MEAS-03`が持つ |
| **時間制限** | **`10A`端子には本体表示の時間制限がある。**取扱説明書も高い電流域では過熱防止のため測定時間を制限している。上限値は`MEAS-03`が持つ |
| **接続の向き** | 電流測定は**回路へ直列**に入れる（取扱説明書）。並列に入れると測定器を短絡経路にする |
| **測定後の復帰** | 取扱説明書は`10A`端子使用後に**リードを`VΩmA`端子へ戻す**ことと、`計測後、必ず戻さないで電圧を測定するとテスターを損傷する`ことを述べている |
| **burden voltage** | **未取得。**取扱説明書に記載が無い。電流端子で測ると測定器の内部抵抗ぶん電圧が落ち、**5 V系では落ちた電圧が測定対象の動作を変えうる。**評価していない。**2026-09-28の決定以降、段階B-2・#17・段階Cの電流では電流端子を使わない**（段階B-2では電圧rangeで`MEAS-01`の両端を読む。`MEAS-01`の挿入降下はこの欄の対象外）。電流端子を使う場合の制約として残す |
| **確度** | **取得できない**（`基準電圧が未解決である（設計上の論点）`の`DT830Bの一次資料で分かったこと（2026-08-21）`）。DC電圧の`最小単位`（`MEAS-01`の両端を読むrange。電流端子を使う場合はDC電流の`最小単位`）はrangeごとに`MEAS-03`が持つ |

**したがって、DT830Bの読みだけで電流のgateを通さない。**

- **`Peak電流`や`定常電流`のしきい値との照合に、確度が未取得の読みをそのまま使わない。**
  しきい値を下回る読みは、**実電流がhardwareの上限を下回ることを証明しない。**
- **合否の最悪ケース余裕を出すには、range別の確度が要る（電流端子を使う場合はburden voltageも要る）。確度は未取得である。**
- **段階B-2以降の電流gateは`Blocked`のままである。**この節はgateを開けない。
- 代替として**特性の判っているshuntか、確度が公開されている測定器**を使う道がある。
  **どちらも未選定であり、購入待ちリストにも載せていない**（必要性が確定していないためである）。
  **2026-09-28にshuntを選んだ（次の項目）。**確度が公開されている測定器は購入しない（同日のユーザー決定。次の項目）。
- **2026-09-28、ユーザーが電流の測り方を決めた**（[#3](https://github.com/wachi-yoshitaka-11-dev/deskcat/issues/3)のコメントに記録）。段階B-2、servoの確認（[#17](https://github.com/wachi-yoshitaka-11-dev/deskcat/issues/17)）、段階Cの電流は、手持ちのshunt（[hardware-bom.md](hardware-bom.md)の`MEAS-01`、0.1 Ω）の両端電圧から求める。DT830Bの電流端子は使わない。
  **同日、ユーザーは測定器を追加で購入しないと決め、段階B-2の電流を、今の接続（[#445](https://github.com/wachi-yoshitaka-11-dev/deskcat/issues/445)・[#461](https://github.com/wachi-yoshitaka-11-dev/deskcat/issues/461)で認めた構成）のまま、`MEAS-01`の両端電圧を手持ちの`DT830B`で読んで測ると決めた**（[#488](https://github.com/wachi-yoshitaka-11-dev/deskcat/issues/488)のコメントに記録）。`MEAS-01`はbreadboardに挿して使い、はんだ付けしないため、抵抗値は許容差±5 %、温度係数±300 ppm/℃で扱い、校正しない（値は[#3](https://github.com/wachi-yoshitaka-11-dev/deskcat/issues/3)の2026-09-28の調査コメントが、秋月の商品ページが示す資料`CementResistor.pdf`から読んだもの。同資料はメーカー名を本文に持たない）。**この扱いは、はんだ付けせずに使う場合に限る。**同資料ははんだ付け後の抵抗値の変化を±(2 %＋0.05 Ω)と規定しており、0.1 Ωに対して大きいため、段階C以降に`MEAS-01`をはんだ付けして使う場合は、この扱いを当てはめない。**`DT830B`は電圧rangeでも確度を取得できないため、測定値の確かさは評価できない。この制約は測定結果とあわせて記録する。**測った値を電流のgateの合否にどう使うかは、この節の上の規則（確度が未取得の読みを、しきい値との照合にそのまま使わない）に従う。段階B-2の実施条件（`段階B-2の測定`）の改訂は、別のPull Requestで行う。

**この節が定めたのは、`MEAS-01`の両端電圧を電圧rangeで読む方式までである（2026-09-28の決定）。**読みを合否に使える条件は定めていない。
**それは`電流の測定点と読みの確かさの基準`が`#525`へ送っている。**

##### DT830Bの一次資料で分かったこと（2026-08-21）

**付属の日本語取扱説明書を確認した**（`ミニデジタルテスター 取扱説明書`。発行はウィキャン株式会社。
現物は[hardware-bom.md](hardware-bom.md)の`MEAS-03`）。

**確度は記載されていない。**同書は`測定レンジと最小単位`を表で示すが、
**range別の確度（`±(x % + n digit)`）も、確度を保証する基準温度も載せていない。**
本体表示にも無い。**したがって確度は、この品に付属する一次資料からは得られない。**

**それでも校正の不確かさに下限は与えられる。**同書の直流電圧の`最小単位`は次のとおりである。

| DC電圧range | 最小単位 |
|---|---|
| 200 mV | 0.1 mV |
| 2000 mV | 1 mV |
| **20 V** | **10 mV** |
| 200 V | 100 mV |
| 1000 V | 1 V |

**5 V railを測るには20 Vrangeを使う**（2000 mVrangeは上限2 Vで足りない）。
したがって**AV<sub>CC</sub>の読みの不確かさは、少なくとも最小単位の10 mVある。**
5 V付近では約0.2 %にあたる。比率法では相対誤差がそのまま`V_INT_actual`へ伝わるため、
**1.1 V付近で約±2 mVに相当する。**

**これは下限であって確度ではない。確度が未取得なので実際はこれより悪い。**
**「±10 mVである」と書かない。「少なくとも±10 mVある」と書く。**

**本体表示と取扱説明書が食い違っている。**本体は`VΩmA`端子に`1000V⎓MAX`／`750V~MAX`と表示するが、
取扱説明書の`禁止事項`は`600Vを越える電圧は計測しないで下さい`と述べている。
**DeskCatの測定はいずれも5 V系であり、この食い違いは今回の用途に影響しない。**
**原因は特定していない。**低い方（600 V）を上限として扱う。

##### `5V` pinと`AVCC` pinの差（2026-08-22の調査）

**`EXP-002`で測ったのは電源ヘッダの`5V` pinであり、ATmega328Pの`AVCC` pinではない。**
その差が未評価であるため、得られた`V_INT`は代理値ベースの推定にとどまる
（[PR #158](https://github.com/wachi-yoshitaka-11-dev/deskcat/pull/158)の自動reviewの指摘）。
**経路を一次資料で特定した。差そのものはまだ出せない。**

**経路**: `+5V` → **`L2`（10 µH インダクタ）** → `AVCC`（pin 20）。
出典は[UNO R3 schematic](https://docs.arduino.cc/resources/schematics/A000066-schematics.pdf)（`UNO-TH_Rev3e`）で、
取得物の sha256 は `2c1041200352485393108e03c5117a07d4ea03954654485526c2c56cd01f7a42` である。

**したがって直流の差は`I_AVCC × DCR(L2)`である。**

**`DCR(L2)`はこのschematicから得られない。**同図は`L2`を`10uH`という値だけで示し、
**部品番号を与えていない**（`BLM21`の表記はUSB側の`L1`に付いている）。
**したがって差を上限で縛れない。**必要なのは`L2`のDCR（部品番号または実測）である。

**代わりの経路を3つ検討し、いずれも採らなかった。**

| 案 | 採らない理由 |
|---|---|
| `AVCC`（pin 20）を直接プローブする | 隣が pin 19 と pin 21 であり、**プローブが滑れば短絡する。**socket実装で足が露出しているぶん危険が増す |
| `AREF` pinを測って`AVCC`の代わりにする | §24.5.2 は`VREF`を`high impedance source`と述べ`high impedance voltmeter`を要求する。**DT830Bの入力インピーダンスは取扱説明書にも記載が無い。**低インピーダンスなら`AREF`を`5V`側へ引っぱるため、**読みは差の下限になる。上限が要るので使えない** |
| `5V` pinをADCへ入れて比を見る | `AVCC < V(5V pin)`であるため**full scaleで飽和する。**符号が分かるだけで、既知の情報しか得られない |

**残る手段は2つである。**

1. **`L2`の両端をDT830Bの`200m`レンジで測る**（最小単位0.1 mV）。`L2`は基板上のSMD部品であり、
   **現物で位置を特定できれば測れる。未実施である。**
2. **`L2`のDCRを一次資料で得る。**部品番号がschematicに無いため、Arduino公式のBOMか現物の刻印が要る。

**2026-08-22に、`L2`のDCRを得ずに(1)を解いた。**`L2`は`0805`でプローブが当てられなかったため、**pin 20を直接測って差の上限を与えた**（[experiment-log.md](experiment-log.md)の`EXP-005`。位置はArduino公式のboard reference designから求めた）。**`DCR(L2)`は依然として未取得だが、差そのものを上限で縛れたため算出が要らなくなった。****上限は`EXP-002`が記録している不確かさに埋もれる。**

##### それでも基準電圧は未解決である（2026-08-22に解消。以下は当時の記録）

**この節は2026-08-22より前の状態を書いたものである。**挙げている未取得の2項目はいずれも決着した。**AV<sub>CC</sub>の実測は`EXP-002`で行い、`5V` pinと`AVCC` pinの差の上限は`EXP-005`で与えた。****DT830Bのrange別確度と基準温度は、取得できないことが確定した**（`DT830Bの一次資料で分かったこと（2026-08-21）`）。**現行の状態は`方式1で残っている未解決3点`の(1)が持つ。**

**得られたのは比だけであり、絶対電圧ではない。**確定には次が要る。

- **AV<sub>CC</sub>（`5V` pin）のデジタルテスター（DT830B）による実測** — 未取得
- **DT830B自身のrange別確度**（`±(x % + n digit)`）と**確度を保証する基準温度** — **未取得。
  この値はrepository内のどこにも記録がない。**校正の精度はこれが上限になるため、
  **テスターの確度を超える主張をしない。**取扱説明書または本体表示から一次情報を取る。
  なお同一型番を複数のvendorが名乗っており、**手元の実物のbrandも合わせて確認する**
- **測定時の周囲温度 — 記録していない。**2026-08-18の測定時に温度計を用意しておらず、
  **測っていない。**内蔵基準は温度で動くため、**この測定は温度条件を伴わない値である。**
- **再校正の条件 — 決められない。**下記の2点が未確定であるため、数値条件を置けない

**これらが揃うまで校正の不確かさは`TBD`であり、`HW-TBD-028`(b)の絶対電圧の閾値へ照合しない。**

##### 温度とAV<sub>CC</sub>の依存が、この品では詰めきれない

**`DS40002061B`は、ATmega328Pの内蔵基準について温度依存の図を載せていない。**
`Calibrated Bandgap Voltage vs. Temperature`の図があるのはATmega88PAとATmega168PAだけであり
（Figure 31-175、Figure 31-270）、**ATmega328P向けは`Calibrated Bandgap Voltage vs. V<sub>CC</sub>`
（Figure 31-365）である。**同じ文書はATmega328のBOD閾値やRC oscillatorには温度図を載せているため、
**内蔵基準の温度図が無いのは網羅の都合ではない。**

**帰結が2つある。**

- **温度を記録していないことの影響を、一次資料から見積もれない。**この品の温度係数が
  公開されていないためである。したがって**温度は測って記録するしかなく、
  それを欠いた今回の値は温度条件が不明な測定である**
- **比率法は、AV<sub>CC</sub>が変わると成り立たなくなりうる。**Figure 31-365 が示すのは
  内蔵基準そのものがV<sub>CC</sub>に依存することであり、**ある
  AV<sub>CC</sub>で求めた`V_INT`を別のAV<sub>CC</sub>へそのまま持ち込めない。**
  ArduinoのAV<sub>CC</sub>はPCのUSB由来で変動しうる（`手持ち候補の現物識別`）。
  **図から数値を引き写さない**（軸の目盛りは仕様値ではない）

**したがって作業2の合格条件（換算係数と手順が別の人が同じ結果を再現できる形で残っていること）は
満たしていない。**温度条件が記録されておらず、AV<sub>CC</sub>依存の扱いも決まっていない。

#### 方式1で残っている未解決3点

**方式は決まったが、これらが解けるまで測定を根拠にできない。**`HW-TBD-034`はOpenのままである。

**2026-08-22時点で1と2は解けた。****3は段階B-1で実測はできたが未解決である**（GNDの確認が片側だけであり、star point構成の確認も残る）。
**ただし3が解けても`HW-TBD-034`はcloseしない。**この3点はclose条件の一部であって全数ではない
（全数は[tbd-register.md](tbd-register.md)の`HW-TBD-034`の`必要な根拠`欄が持つ）。

| # | 未解決 | 状態（2026-08-22時点） | 解けないと何が起きるか | どこで解くか |
|---|---|---|---|---|
| 1 | **基準電圧の校正** | **解けた**（2026-08-22。未加工の観測は[experiment-log.md](experiment-log.md)の`EXP-002`と`EXP-005`）。比率法でAV<sub>CC</sub>を実測し、周囲温度を記録して`V_INT`のこの個体の実値を確定した。**`DS40002061B`の規定内である。****代理値の限定は`EXP-005`で解消した。**`5V` pinと`AVCC` pin（pin 20）の差を直接測り、**その上限がテスターのゼロ点以下で、`EXP-002`が記録している不確かさに埋もれることを確認した。****したがってその不確かさの範囲で絶対値として扱える。****確度を超える主張はしていない。**テスターのrange別確度は取得できないことが確定しているため、不確かさは`最小単位`とADC量子化から出した下限である | 測定値が基準に対する相対値のままになり、`HW-TBD-028`(b)のような**絶対電圧の閾値と照合できない** | `基準電圧が未解決である（設計上の論点）` |
| 2 | **SRAM 2 KBに対する取得方式** | **解けた**（2026-08-17）。連続streamingが必須要件を2 channel同時で満たすことを実測した | burst captureでは200 ms分を溜められない | `手持ち候補に固有の制約: SRAMと取得方式` |
| 3 | **GND topologyへの影響** | **未解決**（2026-08-22。未加工の観測は[experiment-log.md](experiment-log.md)の`EXP-003`と`EXP-004`）。**(i) GNDの両極性の確認は`EXP-004`で解消した。**DT830Bの`200m`レンジ（最小単位0.1 mV、極性を読める）で測り、**ESP32の`GND`はArduinoの`GND`より低く、ADCの1 LSBより大きいoffsetがADCの死角にあった。****`GND`の直結はoffsetを縮めるが消さない。****(ii) star point構成そのものの確認が残る。****2026-09-09、案Bにより阻害要因を「変換基板`PSU-INGRESS-01`が揃うまで」から「端子台へcableを切って留めるまで」へ差し替えた。****2026-09-12更新。**旧文の阻害要因は「端子台へcableを切って留めるまで」で、**その作業は2026-09-10に完了した**（[experiment-log.md](experiment-log.md)の`EXP-012`。**通電は未了**）。**この項目が未解決であることは変わらない。****残る理由をこの訂正では判定しない**（次のPull Requestで扱う）。**したがって(ii)により未解決である。****異常は無かった**（異音・発熱・reset・brownoutのいずれも無し。人間が基板のそばで観察） | star point構成を崩すと**全ADC値がずれる。****`GND`の直結でoffsetが消えないことが実測で分かったため、star pointの設計は「直結すれば同電位になる」という前提で行えない**（`EXP-004`）。**未完了なのは、star point・5 V ingress・shuntを含む完全なtopologyである** | `GND topology（測定前に必ず確定させる）`と、`電源過渡の測定方式のdesign review`の方式1の表にある`手持ち候補に固有の論点`の行 |

**1と2はArduino単体で確認でき、DeskCat側へ接続しない。**3はDeskCat側の配線を伴う。
**いずれもUSBを扱える端末が要るため、Docs / Review端末では実施できない**
（[machine-profiles.md](../toolchains/machine-profiles.md)。**ただしArduinoは測定器であって開発端末ではなく、
profileの新設は要さない。**デジタルテスターと同じ扱いである）。

**3が済むまで、この測定系で得た値を受け入れ判定に使わない。**

**3の(ii) star point構成の実配線での確認は[#405](https://github.com/wachi-yoshitaka-11-dev/deskcat/issues/405)の受け入れ条件が持つ**（`HW-TBD-034`(5)）。#3は持たない。

#### 方式2: ADC loggingに限定し、合格主張を狭める — **採らない**

**2026-08-16に人間が方式1を採ると決定したため、この方式は採らない。**

内容は、未観測区間の存在を認めたうえで、ゲートAの合格条件を
「起動時の電源過渡をすべて実測した」から**「測定分解能とsampling継続区間の範囲で承認範囲内であった」へ
後退させる**ものだった。**安全側の要求を下げる方向の改訂である。**

**改訂が要る箇所の全数と、その未適用の改訂案は削除した。**方式1では
[技術ガイド](../DeskCat_Microcontroller_Development_Guide.md)のゲートAを改訂しないため、
適用先が無い案を正本に残すと、後から誤って適用されうる。**削除の経緯はRevision履歴に残す。**

**方式1を採っても、`ESP32自身のADCは測定対象から独立していない`が挙げた限定は消えない。**
独立した記録係を入れて`capture window外`と`brownout／reset中`を塞いでも、**`sample間`は残る。**
「電源過渡をすべて実測済み」と扱わない規則は、方式によらず維持する。

### GND topology（測定前に必ず確定させる）

低側shuntをGND戻り経路に入れると、shunt両端に電位差が生じる。この電位差がESP32のGND基準を
動かすか否かは、**どこにshuntを入れるかで決まる**。曖昧なまま測ると、ESP32側のGNDが浮いて
全ADC値がずれるか、あるいはservo電流がshuntを迂回して過小評価になる。次の一つに固定する。

```text
                        ┌─ Pi GND
                        ├─ ESP32 GND          ← logic戻り。shuntを通らない
                        └─ 周辺module GND
                        │
5V ingress GND ─────────┴── star point ──┬──[ shunt 0.1Ω ]── servo GND 端子
 (adapterのreturn。        （共通GND基準。 │                        ▲
  star pointと同一node）    ESP32 ADCの    │            servo戻りだけが通る
                            0 V基準）      │
                                           └ ADC-SHUNT(GPIO32)は
                                             servo GND端子側をこのnode基準で測る
```

- **shuntはservo戻り専用**とし、star pointとservo GND端子の間だけに入れる。
- **ESP32のGNDはstar pointへ直結**し、shuntを経由させない。これによりservo電流はESP32のGND基準を動かさない。
- ADCが測るのは、**servo GND端子側のnode（GPIO32）を、ESP32 GND＝star pointを基準とした単端測定**である。
  この電位差がそのまま `I_servo × 0.1Ω` になる。差動amplifierは使わない。
- 測定される極性が正になるよう、shuntの向き（どちら側をstar pointに繋ぐか）を配線時に記録する。
- **許容するGND offset**: shunt両端の電位差は最大で `2 A × 0.1Ω = 0.2 V`。この0.2 Vは
  **servo側にのみ現れ、logic側には現れない**構成であることを、電源off時の導通checkで確認する（[#405](https://github.com/wachi-yoshitaka-11-dev/deskcat/issues/405)の受け入れ条件）。
  logic GNDとservo GNDの間に0.1Ωが入ってしまっている配線は不可とする。

この構成が取れない場合（star pointを作れない、shuntを迂回する戻り経路が残る等）は、
**測定を実施しない**。誤ったtopologyでの実測値は、電源承認の根拠にしない。

#### 方式1の記録係をこのtopologyへ足すとき（`HW-TBD-034` 作業3）

**上図のstar pointは`5V ingress GND`を含む。****2026-09-09に人間が決定した案Bにより、
その5 V ingressは変換基板`PSU-INGRESS-01`ではなく端子台でM-12001を受けて作る**（当時の
記述は`PSU-INGRESS-01`だった。正は[経路部品と定格](#経路部品と定格)。ここへ再掲しない）。
**調達（発注・着荷）の状態は[#205](https://github.com/wachi-yoshitaka-11-dev/deskcat/issues/205)が持つ**。
**上図の完全な構成は、現時点では組めない。****2026-09-12更新。**旧文はこの理由を「cableを端子台へ切って留める作業がまだのため」としていたが、**その作業は2026-09-10に完了した**（[experiment-log.md](experiment-log.md)の`EXP-012`。**通電は未了**）。**組めないこと自体は変わらない。****残る理由をこの訂正では判定しない**（次のPull Requestで扱う）。

**組める範囲は段階B-1に限られる。**同節（`5 V ingress`）は段階B-1を
「ESP32を単体でPCのUSBから給電し、flashingとADC loggingを行う」と定め、
**gateも追加購入も要らない**としている。段階Cが端子台への実装を要するのに対し、B-1は要さない。

**段階B-1で作業3のうち確認できること**を次に限定する。**これ以上を主張しない。**

| 確認できる | 確認できない |
|---|---|
| **PCのGNDが経路へ入る影響。**記録係（Arduino）はPCのUSB給電であり、そのGNDはPC側へ繋がる。ESP32もPCのUSB給電なので、**両者のGNDがPC内部で共通化される**。この経路が測定へ与える影響は段階B-1で評価できる | **servo戻りとshuntを含むstar point。**shuntはservo戻り専用である。**2026-09-12訂正。**旧文は「servoも`PROT-OC-01`も未購入である」だったが、**どちらも未購入ではない**（`SERVO-01`は[hardware-bom.md](hardware-bom.md)の同行が現物確認済みと記録し、`PROT-OC-01`は同fileのRevision 89が2026-09-08の現物刻印の照合を記録している。**調達（発注・着荷）の状態は[#205](https://github.com/wachi-yoshitaka-11-dev/deskcat/issues/205)が持ち、値も日付もここへ再掲しない**）。 |
| **記録係のGNDをESP32 GNDへ落としたときのADC値の妥当性**（既知電圧を入れた状態での照合） | **`5V ingress GND`とstar pointの同一node性。****2026-09-09、案Bにより阻害要因を「変換基板が無いため」から「端子台へcableを切って留めていないため ingress そのものが無い」へ差し替えた。****2026-09-12更新。**旧文の阻害要因は「端子台へcableを切って留めていないため ingress そのものが無い」で、**その作業は2026-09-10に完了した**（[experiment-log.md](experiment-log.md)の`EXP-012`。**通電は未了**）。**この項目が未解決であることは変わらない。** |
| **入力headroom**（`5 V railをADCへ直結する条件`。dividerは既定で残す） | **`ADC-SHUNT`の基準電位**。**2026-09-12訂正。**旧文は「shuntが無い」だった。**「無い」が未所持を指すのか未接続を指すのかは、旧文からは読み取れない。****所持はしている**（記載は[hardware-bom.md](hardware-bom.md)の`MEAS-01`。**ここへ再掲しない**）。**未接続かどうかはこの訂正では判定しない**（次のPull Requestで扱う）。 |

**段階B-1で得た結果を、段階Cのtopologyの検証として扱わない。**`HW-TBD-034`の未解決3点のうち
(3)は、**star point構成そのものの確認を含むため、完了していない。****2026-09-09、案Bにより阻害要因を「変換基板が揃うまで」から「端子台へcableを切って留めるまで」へ差し替えた。****2026-09-12更新。**旧文の阻害要因は「端子台へcableを切って留めるまで」で、**その作業は2026-09-10に完了した**（[experiment-log.md](experiment-log.md)の`EXP-012`。**通電は未了**）。**この項目が未解決であることは変わらない。****残る理由をこの訂正では判定しない**（次のPull Requestで扱う）。

**2026-08-22に段階B-1を実施した。**上表の`確認できる`3項目はすべて実測した
（未加工の観測は[experiment-log.md](experiment-log.md)の`EXP-003`。**値をここへ再掲しない**）。
**`確認できない`3項目は手を付けていない。****2026-09-12更新。**旧文の理由は「shuntもservoも端子台への実装も無い」だった（**2026-09-09、案Bにより「変換基板も無い」から差し替え**）。**このうち端子台への実装は完了した**（M-12001のcableを受ける側。2026-09-10。[experiment-log.md](experiment-log.md)の`EXP-012`。**通電は未了**）。**shuntとservoの「無い」が未所持を指すのか未接続を指すのかは旧文からは読み取れず、どちらも所持はしている。未接続かどうかはこの訂正では判定しない**。**3項目に手を付けていないことは変わらない。****残る理由をこの訂正では判定しない**（次のPull Requestで扱う）。

**入力headroomの実測は、この節の`5 V railをADCへ直結する条件`を定量的に裏付けた。**
ADCのfull scaleはArduinoのAV<sub>CC</sub>であり、監視対象の5 V railとの差が
**AV<sub>CC</sub>の数%しかない。**railがその差を超えて跳ねればfull scaleを超えて飽和し、
**その区間の波形が失われる。****したがってdividerを外さない。**
**これまでこの判断の理由は定性的だった。**具体値は`EXP-003`が持つ。

**PCのGNDが経路へ入る影響は、上表のとおり段階B-1で先に評価できる。**
これは(3)の全部ではなく一部である。

### Sample rateとlog形式

`115200 8N1`のUSB serialは実効約11.5 kB/sであり、16 bit sampleを連続で流すと
framingを除いても約5.7 kSample/s、text encodeではさらに落ちる。**したがって連続streamingはしない。**

| 項目 | 方式 |
|---|---|
| 取得方式 | **burst capture**。ESP32のRAMへ一定期間ぶんを溜め、取得停止後にserialでdumpする。sample rateをserial帯域から切り離す |
| 必要な時間分解能 | servo起動の過渡はms order。これを追うため**1 kSample/s以上**を必須要件とする |
| 目標sample rate | 5〜10 kSample/s（ADC1・oneshot loop、Wi-Fi停止時）。**確定値は実機で測って実験記録へ残す**。sample rate自体は測定treatmentのparameterであり、`HW-TBD-014`が決めるlinkのbaudとは別のfieldである |
| dumpに使うbaud | **`HW-TBD-014`／`PROTO-TBD-001`で決めるlinkのbaudをそのまま使う。**測定用に別のbaudを勝手に選ばない。Pi–ESP32間のUSB serialは1本しかなく、Protocolがそのbaudを共有transport parameterとして持つ（[protocol](../protocol/esp32-pi-protocol.md)の§2）。別baudを使うなら、Protocolを停止する測定modeと両端の再設定手順、通常channelとの排他を先に定義する必要がある |
| Wi-Fiの扱い | capture中はWi-Fiを停止する。Wi-Fi動作中はADC sampling rateが大きく落ちる。ADC2はWi-Fi有効時に使用不可のため、そもそも測定へ割り当てていない |
| buffer長 | 1回のcaptureで最低200 ms（servo起動の突入を含む長さ）。必要RAMは`sample rate × 2 byte × 0.2 s`で見積もる |
| log形式 | dump時はCSV（`時刻[us],生ADC値`）とし、生値のまま出す。電流への換算は事後にPC側で行い、換算式と分圧比を実験記録へ残す |
| CSVを出してよい条件 | **Protocolが動作していない専用の測定modeでのみ出力する。**[Protocol](../protocol/esp32-pi-protocol.md)は「channelから送信するすべてのbyteは有効にframe化されたmessageの一部でなければならない」と定めており、生CSVをJSON Lines channelへ混ぜるとこれに反してPi側のparseを壊す。測定firmwareはProtocol sessionを確立せず、同じlinkでJSON LinesとCSVを同時に流さない。Protocol稼働中に採取したい場合はsampleをProtocol messageへ載せる必要があり、それはProtocol側の変更であってこの文書の範囲外である |

上表の「目標sample rate」は未実測の設計目標であり、受け入れの根拠にしない。

**実測が1 kSample/s未満だった場合、buffer長の短縮で代替しない。**buffer長は取得できる
「期間」を決めるだけで、sample間隔を詰めない。短くしても取り逃がしたpeakは戻らない。
その場合は次のいずれかを取る。

- ADC側を改善して1 kSample/s以上を達成する（Wi-Fi停止、oneshotからDMA continuousへ、
  channel数の削減など）。改善後に再測定する
- または、**必須要件そのものを見直す**。servo起動の過渡が実際には何msなのかを
  別手段（テスターの応答では足りないため、より低速な現象へ分解する等）で確認し、
  新しい根拠を添えて要件を書き換える

いずれも取れない場合は、**この測定手段では電源承認の根拠を作れない**と結論し、
測定機材の追加を検討する。要件を満たさない測定値を、満たしたものとして扱わない。
**測定機材の追加は`電源過渡の測定方式のdesign review`の方式1にあたる。**
**sample rateが要件を満たしても未観測区間は残る**ことは
`ESP32自身のADCは測定対象から独立していない`が扱う。**この2つは別の論点である。**
**linkのbaudを測定の都合で上げる場合は、`HW-TBD-014`／`PROTO-TBD-001`の決定そのものを
変える扱いとし、Protocol側と揃えて確定させる。**片側だけ変更しない。

**ADC入力範囲の制約（必ず守る）**: ESP32のADC入力はおおむね0〜3.3Vであり、これを超える電圧を
直接加えるとpinを破損する。したがって次を守る。

- shuntは必ず低側に置く。高側（5V側）に置くと両端が5V付近になりESP32 ADCで測定できない。
- **低電流側の精度に注意する。**0.1Ωのshuntでは、電流0.5 Aで50 mV、0.1 Aで10 mVにしかならない。
  ESP32のADCは入力0付近の直線性が悪く、減衰0 dBでも実用域はおおむね100 mV以上である。
  したがってこの構成が素直に測れるのは**約1 A以上**であり、typical電流帯（数十〜数百mA）の
  絶対値精度は期待しない。servo起動時のpeakとその継続時間を捉えることを主目的とし、
  小電流の定常値はデジタルテスター（DT830B）側で確認する。
- 5V railそのものの電圧を観測する場合は、直接ADCへ入れず**分圧抵抗で3.3V未満へ落としてから**入力する。
  分圧比は1/2（10 kΩ／10 kΩ）を既定とし、`gpio-assignment.md`と一致させる。実施時に実測した抵抗値を記録する。
- 5V系とESP32のGNDは共通化済みである前提に立つ（`確定している制約`参照）。共通GNDでない状態で
  低側shunt測定を行わない。

### サーボ接続前

**この段階は端子台（案B。2026-09-09に人間が決定。当時の記述は変換基板`PSU-INGRESS-01`だった）、
過電流保護部品（`PROT-OC-01`）、大電流経路の
線材・接続部材（`WIRE-PWR-01`）が揃ってから実施する。**合成給電の電流をingressで測る
必要があり、端子台が無いとアダプターとPiの間に測定器を挿入できない
（`合成給電を部品が揃うまで行わない理由`）。保護部品が無いと上限を超えた電流を
止められない（`過電流保護（段階Cのgate）`）。線材が定格既知でないと`経路部品と定格`表の
最小値が出ず、そもそも上限を判定できない。**servoはまだ繋がない。**

揃う前にできるのは、`5 V ingress`節の段階A、段階B-1、および`3V3` pinの定格を確認したうえでの段階B-2（Pi単体の起動、ESP32の
PC USBからのflashing、周辺module3点の3.3 V側定常電流の実測）と、段階Aと段階B-1を同時に行う検証の構成（同節の`検証の構成の扱い`）だけである。これらは
合成給電ではないため、下記の測定を必要としない。

- [ ] **過電流保護部品の方式（PTC／ヒューズ）が決まり、選定・実装され、`記録するtrip動作`の
      各項目（定常電流継続時の動作、遮断へ移行する電流、遮断までの時間、3 Aでの動作と遮断定格、
      通過エネルギー、復帰、確認方法）が採った方式の欄で`過電流保護（段階Cのgate）`節に
      記録されている。**方式・品番・数値の記載だけでは通さない
- [ ] **gate対象の大電流経路が`WIRE-PWR-01`で構成され、breadboard接点とジャンパー線を通っていない**
- [ ] **`経路部品と定格`表に未確定の行が残っていない**（残る間は上限が確定せず、合否を判定できない）
- [ ] 電源offで導通と想定した絶縁を確認する
- [ ] **極性を確認する。**手順は`配線・保護表`の`逆極性保護のdesign review`の
      `通電前の配線確認手順`である（**確認箇所・方法・記録先はそこが正であり、ここへ再掲しない**）。
      **保護部品では守っていない**ため、この項目を飛ばすと逆極性保護が無い状態で通電することになる
- [ ] **M-12001 → 端子台区間の極性は、初回通電時に下流（`PROT-OC-01`以降）を繋ぐ前に、端子台の2端子間の電圧を符号付きで読んで確定させる。**
      同区間は`通電前の配線確認手順`の対象外（MOSFETの担当）であり、非通電での判定（[experiment-log.md](experiment-log.md)の`EXP-012`）は
      テスター自体の自己確認の記録要件（`確認の方法3`(ii)）を満たしていない。**したがって、この通電時の電圧確認が同区間の極性を
      確定させる場所である。**M-12001をアダプターへ挿し、**赤プローブをVBUSとして配線した端子、黒プローブをGNDとして配線した端子へ当てて電圧を読む。約`+5 V`（正の値）なら想定どおり、負の値が出た場合は極性が逆である。**確認してから
      下流を繋ぐ。**初回通電には人間の立ち会いが要る**（[hardware-safety-policy.md](../governance/hardware-safety-policy.md)の
      `人間の監視が必要な操作`）
- [ ] 確認済み部品に適した電流制限を設定する
- [ ] 無負荷の各railを測定する
- [ ] **ingressを通る合計電流を段階的に測る。**端子台の直後・`PROT-OC-01`の手前（アダプター側）に
      測定点を置き（**2026-09-09、案Bにより「変換基板の直後」から差し替え**）、
      各段階で記録する。**`ingressの電流制限`の上限（経路部品の定格の最小値の80%）を
      超えた時点で中止**する。**中止は人の操作であり保護ではない。**上限を超えた電流を
      実際に止めるのは`PROT-OC-01`である
  - [ ] 測定1: Piのみ（ESP32・周辺module未接続）
  - [ ] 測定2: ＋ESP32（Wi-Fi停止、idle）
  - [ ] 測定3: ＋ESP32のWi-Fi TXを動作させた状態
  - [ ] 測定4: ＋MSP2807（backlight点灯を含む）。**2026-10-27、行わない（判定しない）と決めた**（`MSP2807の電流上限の扱いと、段階Cの測定4（2026-10-27、#556）`）。段階Cの構成にMSP2807を接続しない。測定5（＋ADXL345、BME280）は、MSP2807を足さない構成で行う
  - [ ] 測定5: ＋ADXL345、BME280（**ADXL345は`HW-TBD-004`がcloseするまで接続しない**）

  （この1〜5は段階C内の測定順序であり、`5 V ingress`節の段階A／B-1／B-2／Cとは別の
  番号体系である。混同しない）
- [ ] 各段階で**ingressの定常電流**を、[#525](https://github.com/wachi-yoshitaka-11-dev/deskcat/issues/525)で定める測定点で記録する。
      これが`ingressの電流制限`の判定量である（connector定格は熱の制限のため）
- [ ] 各段階で**5 Vと3.3 Vの電圧droop**を`ADC-5V`／`ADC-3V3`で記録する。
      **この項目はdivider（10 kΩ／10 kΩ）の実装と検証に従属する**（抵抗は入手済み。
      実装と検証が残る。`受け入れ条件`の`定義した値をどの段階で照合するか`）。
      peakによる電圧降下はここで捉える。**ESP32のbrownoutとreset reasonもあわせて確認する**
      （ESP32は自身でbrownoutを検出する）。**Piのundervoltage警告は当てにしない**
      （`Pi Zero Wには低電圧検出が無い`）。**reset reasonはresetの事実であって、その区間の
      rail波形ではない**（`ESP32自身のADCは測定対象から独立していない`）
- [ ] ESP32 board上3V3 pinの外部供給可能電流の定格を確認する。**段階B-2aでは**、周辺module3点（MSP2807、ADXL345、BME280）を接続した状態で3V3 rail電圧と電流を実測する。**段階Cでは、ADXL345とBME280だけを接続して実測し、MSP2807は接続しない**（2026-10-27更新。測定4を行わない。`MSP2807の電流上限の扱いと、段階Cの測定4（2026-10-27、#556）`）。**ADXL345を繋ぐのは`HW-TBD-004`がcloseした後である**（`電源rail構成案`の`（接続不可）`）。3V3 pinの供給能力を超える場合は別途3.3V regulatorを追加する。**定格の確認は段階B-2aの実施条件でもある**（`段階B-2の測定`）。実測自体を段階B-2で先に済ませてよい。段階Cで再測するのは、5 V railからの給電に切り替えた後の値を確認するためである
- [ ] **ESP32の給電経路を決め、そのgateを実測で埋める**（`ESP32の給電経路（最終の経路は未決定）`節）。**経路は[#405](https://github.com/wachi-yoshitaka-11-dev/deskcat/issues/405)の見直しで決める**（**2026-09-28、[#446](https://github.com/wachi-yoshitaka-11-dev/deskcat/issues/446)のユーザー決定（最終の経路は#405で決める）に合わせて「案の選択は2026-08-22に済んでいる（案Aで確定。人間の判断）。残るのは実測だけである。」から差し替え**）。**案Aを採る場合は、**PiのUSB OTG portからESP32＋3V3負荷を給電したときの電流とESP32入力電圧を実測し、ESP32のundervoltageとbrownoutが起きないことを確認する。**Pi側とESP32側を別に測る。****`ADC-5V`は`GPIO33`でESP32側の5 V nodeを測るものであり、Piの`PWR IN`やOTGの`VBUS`を測っていない。**Pi側はundervoltage警告が出ないため実測が要るが、**`ADC-5V`では代用できない。****Pi側の下限は未確定であり、両方を測るまで案Aのgateは開かない**（`Pi link経路に許容電流の公開要求を課さない（2026-08-22）`の判定表）。ESP32側の合否は`HW-TBD-028`(a)とは別に、現物の`U2`のdatasheetによる4.6 Vで判定できる。**不足した場合に案Bへ切り替える**。そのとき秋月基板のVBUS保護diodeの有無を回路で確認してから`5V` pinとUSBを同時接続する
- [ ] サーボなしでlogicへ給電し、電流を記録する（上記の段階測定の結果をそのまま用いる）
- [ ] UndervoltageなしでESP32とPiがbootすることを確認する
- [ ] 外部電源とUSB間のbackfeed動作を確認する
- [ ] **電流の測定点と読みの確かさを決める**（[#525](https://github.com/wachi-yoshitaka-11-dev/deskcat/issues/525)。決まるまで電流の読みを合否に使わない）
- [ ] **方式1の記録係を実装し、必要帯域とPower Treeを確かめる**（`HW-TBD-034`(2)(6)(6b)）
- [ ] **実配線に対して、4文書の合格主張を照合し直す**（`HW-TBD-034`(7b)。(2)と[#405](https://github.com/wachi-yoshitaka-11-dev/deskcat/issues/405)のstar point確認の後）

### サーボ試験

**2026-09-28追記（[#17](https://github.com/wachi-yoshitaka-11-dev/deskcat/issues/17)）。**ユーザーは、はんだ付け（[#405](https://github.com/wachi-yoshitaka-11-dev/deskcat/issues/405)）より前のservoの確認（#17〜#19）を、servo専用の別電源と故障電流の制限手段で行うと決めた。その条件と状態は[servo-safety-limits.md](servo-safety-limits.md)の`承認の状態`の項目6が持つ（ここへ再掲しない）。**次の段落の下段構成への移行は、はんだ付け後の最終構成でservoを試験する場合に適用する。**

**この段階に入る前に、`5 V ingress`節の下段構成（端子台＋Piへの給電cable
＋過電流保護部品＋大電流経路の線材。**2026-09-09、案Bにより「Micro-Bメス変換基板」から差し替え**）へ移す。**Pi直挿しのままservoを繋ぐと、servo電流が
PiのconnectorとPCB traceを通る。

- [ ] ingressを端子台経由へ移し、Piの5 V GPIO pinから他へ配電していないことを確認する
- [ ] 可能であれば機械負荷を外す
- [ ] `GND topology`節のstar point構成が実配線で成立していることを、電源off時の導通checkで確認する（logic GNDとservo GNDの間にshuntが入っていないこと）
- [ ] ADC loggingが必須要件の1 kSample/s以上を満たすことを確認し、実測sample rateを記録する
- [ ] サーボ5 VとESP32 3.3 Vを同時にcaptureする（5V側は分圧してからADCへ入れる。上記「ADC入力範囲の制約」に従う）
- [ ] 起動時の電源電流を記録する
- [ ] 小さく低速な動作時の電流を記録する
- [ ] 承認範囲内で想定される最悪動作時の電流を記録する
- [ ] **その最悪動作でservo railの定常電流が250 mA（`ingressに必要な定格の見積もり`で
      割り当てた予算）以下であることを確認する。**超える場合は`servo-safety-limits.md`の
      可動域・速度・duty cycleを締めて再測定する。**ingressの定格を上げるだけでは
      この項目は合格にならない**（予算はservoの動作制限へ渡した値であり、経路側の
      定格とは別の量である）。予算そのものを変える場合は下記の正式改訂の手順を踏む
- [ ] **そのとき強制していた可動域、最大速度、最大加速度、最大連続動作時間、最大duty cycleを
      `servo-safety-limits.md`の動作制限表へ記録する**（予算を守らせているのはこれらの値である）
- [ ] **ESP32の**brownoutまたはreset reasonを記録する。**Piのundervoltage警告は出ないため当てにしない**（`Pi Zero Wには低電圧検出が無い`）。**記録できるのはresetが起きた事実だけであり、その区間のrail波形は残らない**（`ESP32自身のADCは測定対象から独立していない`）
- [ ] LCDとsensor通信を動作させた状態でも反復する
- [ ] 正確なsetupと電流制限が承認されるまでstall testを行わない

## 受け入れ条件

### 電源品質の数値制限

**この節が`HW-TBD-028`の5項目の正である。**他の文書はここを参照し、値を書き写さない。

**5項目とも規則は定義した。数値は下表の`状態`列のとおりで、確定したものと他の未解決項目へ
従属するものがある。****規則が確定していることと、数値が確定していることは違う**（この区別は
下の確定済み表と同じ扱いである）。

**2026-08-25に`確定／従属／一次資料無し`列を足した。**5項目それぞれについて、**数値が確定して
いるのか、どの行に従属するのか、一次資料が存在しないのかを1つの列で読めるようにするためである。**
**この列は数値を追加していない。**既に本文と`状態`列にあった従属関係を、項目ごとに揃えて書き出した
ものである（**Ownerは`Joint`である**。**2026-09-06にPM（`deskcat-f2`）が(a)を受け入れ試験の
閾値として要求しない（要件から外す）と決定した。**下記`(a)を要件から外す（2026-09-06、PM決定）`節が
根拠と範囲と復帰条件を持つ。**(a)以外の数値・判定・受け入れ承認は引き続きJointが下すものである**）。

| 項目 | 定義した規則 | 数値 | **確定／従属／一次資料無し** | 状態 |
|---|---|---|---|---|
| **(a)** Pi入力で許容する最低電圧 | Piの入力端で、メーカーが示す動作範囲の下限を下回らないこと | **対象外**（2026-09-06。**下記`(a)を要件から外す（2026-09-06、PM決定）`のとおり、受け入れ試験の閾値として要求しない**） | **一次資料無し。**この点は変わらない（下記`(a)の一次資料は存在しない`）。**PM（`deskcat-f2`）が2026-09-06に、要件から外す決定を下した**（Owner `Joint`。[HW-TBD-028](tbd-register.md)） | **対象外。**一次資料に最低電圧も許容範囲も無いことを確認したうえで、受け入れ試験の閾値としては要求しないと決定した（下記`(a)を要件から外す（2026-09-06、PM決定）`） |
| **(b)** ESP32入力／3.3 Vで許容する最低電圧 | 2つに分ける。**ESP32 boardの5 V入力**はboard上regulatorが3.3 Vを出し続けられる入力電圧を下回らないこと。**3.3 V rail**は`3.3 V railの許容電圧範囲`の下限を下回らないこと | 5 V入力: **4.6 V**（**2026-08-15に現物の`U2`＝UMW `LD1117-3.3`のdatasheetによる値になった。**`IOUT = 1 A`（この品の定格上限）でのdropout最大1.30 Vから導いており、より軽い負荷なら要求は下がる）。3.3 V rail: `許容電圧範囲`行の下限に従う（**再掲しない**） | **2つに分かれる。****5 V入力側は確定**（現物の`U2`のdatasheetによる。ただし`3V3`から取ってよい電流の上限は`HW-TBD-023`(a)に従属し、**閾値として公表するかは未判断**）。**3.3 V rail側は従属**（`HW-TBD-025`(a)と`HW-TBD-004`）。**あわせて`PROT-OC-01`のPTCが5 V経路へ直列の電圧降下を持ち込む**（初期抵抗0.065〜0.115 Ω・トリップ後0.17 Ωから、1 Aで115〜170 mV相当。**2026-08-26にPTCへ変更してから抵抗が上側へ寄る点が新たに効く**（トリップを繰り返すたびに上側へ寄る）。`方式をPTCへ変更した（2026-08-26、人間の判断）`） | 5 V入力は**現物の一次資料に基づく**（`HW-TBD-023`(b)(c)は2026-08-15に確定）。**ただし`3V3`から取ってよい電流の上限は別途未確定である**（`HW-TBD-023`(a)）。**3.3 V railの下限は2026-09-06に確定した**（`3.3 V rail下限の設計判断`節。3.234 V。**条件付きのdatasheet値であり、同節の`この3.234 Vを「無条件の保証最小出力」として扱わない`を併せて読む**）。**2026-09-08に訂正した。**それ以前は「3.3 V railは確定しない（`暫定値の下限は、そのままでは成立しない`の3経路）」と書いており、Revision 88を反映していなかった。**残るのは`HW-TBD-004`（module一般としての受け入れ電圧範囲）であって、railの下限ではない。****(a)を要件から外したことによる影響は無い**（(b)は(a)に従属していない） |
| **(c)** 最大定常ripple | 下記`(c)(d)の導出規則`。DC設定誤差とrippleを足した**瞬時値**が許容電圧範囲の内側に収まること | **数値は従属**（ESP32側）。**Pi側は対象外** | **従属。**ESP32側の数値は(b)の下限に従属する。**合否判定はさらに`HW-TBD-034`に従属する**（未観測区間があるため、閾値が確定しても測定値から合格を導けない）。**Pi側は(a)が対象外のため、恒久的に数値を持てない**（下記`(a)を要件から外す（2026-09-06、PM決定）`） | ESP32側は(b)の下限が決まるまで確定しない。**Pi側は対象外（2026-09-06）** |
| **(d)** 最大transient droopと継続時間 | 同上にdroopを加える。**許容するdroopの深さは許容電圧範囲の下限まで**であり、**そこを外れた状態の許容継続時間は0である** | **深さは従属（ESP32側）。Pi側は対象外。継続時間は0で確定** | **2つに分かれる。****継続時間0は確定済み**（この行で唯一の確定値である。**(a)を要件から外しても変わらない**）。**深さはESP32側が(b)に従属し、Pi側は(a)が対象外のため恒久的に数値を持てない。**合否判定はさらに`HW-TBD-034`に従属する | ESP32側の深さは(b)に従属。**Pi側は対象外（2026-09-06）**。継続時間0は確定のまま |
| **(e)** connector／wireで許容する最大温度上昇 | 経路上の各部品について、**そのメーカーが許容電流を定義した温度上昇条件**を超えないこと。経路の上限は各部品の値の最小値とする | **数値は従属** | **従属。**`HW-TBD-021`／`HW-TBD-022`／`HW-TBD-007`。**2026-08-26に`HW-TBD-021`の方式がヒューズ＋ホルダからPTCへ変更されたため**（`方式をPTCへ変更した（2026-08-26、人間の判断）`）、**以前ここに記録していた「ヒューズホルダ（`FUC-03A`）は定格が一次資料に無く、従属先が解けても数値が出ない」という一次資料無し要素は無くなった。**PTCはスルーホール品を基板へ直付けするため、ホルダという経路要素自体が存在しない。**ただし(e)全体の従属状態は変わらない。**`HW-TBD-021`／`HW-TBD-022`／`HW-TBD-007`の他の経路要素（嵌合接点、`CABLE-PI-PWR-01`等）は引き続き未選定・未確認である | 経路部品が未選定（`HW-TBD-021`／`HW-TBD-022`／`HW-TBD-007`）。**一次資料に無い温度上昇値を代わりに置かない** |

**許容するbrownout／reset回数は0回で確定している。**これは上表の5項目には含めない
（`HW-TBD-028`の範囲外である）。受け入れ試験でESP32のbrownoutとresetが1回でも起きたら不合格とする。

**Pi側はこの回数で判定できない。**Raspberry Pi Zero Wには低電圧検出回路が無く、
undervoltageをsoftwareで数えられないためである（`Pi Zero Wには低電圧検出が無い`）。
**0回という規定をPiについて満たしたと主張しない。**Pi側で低電圧を捉える手段は`ADC-5V`の
droop実測だけであり、**2026-09-06にPMが(a)を要件から外すと決定したため、その合否判定は
対象外である**（復帰条件を満たすまで行わない）（`(a)を要件から外す（2026-09-06、PM決定）`。`ADC-5V`による観測自体は
[#247](https://github.com/wachi-yoshitaka-11-dev/deskcat/issues/247)の診断作業として引き続き行える。
合否を導けないだけである）。**この差し替えは判定を緩めるものではなく、
softwareで数えられないものを数えたことにしないための書き分けである。**

#### (a)の一次資料は存在しない

**「あるはず」と仮定せず、存在するかを先に当たった。**結果は次のとおりである。

| 当たった先 | 結果 |
|---|---|
| [Raspberry Pi公式documentationの`Power supply`](https://www.raspberrypi.com/documentation/computers/raspberry-pi.html) | **`All models require a 5.1V supply`**と述べるのみで、**許容範囲も最低電圧も示さない。**`Typical power requirements`表が`Zero W`に与えるのは推奨PSU容量1.2 Aとbare-board動作電流150 mAであり、電圧の下限ではない |
| 同`Power supply warnings` | 低電圧検出回路は**`except the Zero range`**と明記されており、**しきい値4.63 V（±5 %）はPi Zero Wに適用されない**（下記`Pi Zero Wには低電圧検出が無い`） |
| `datasheets.raspberrypi.com`のZero W向けproduct brief／reduced schematics | **取得できない。**`rpizerow`のproduct briefとreduced schematicsはいずれも404であり、取得できるのは`rpizero`向けのreduced schematicsだけである（2026-08-12確認）。**当たったpathの範囲での結果であり、Raspberry Piが他の場所で公開していないことまでは確認していない** |

**したがって(a)は確定しない。**低電圧検出のしきい値4.63 Vは、(i) 動作範囲の下限ではなく検出回路の
動作点であり、(ii) 公式が明示的にZero rangeを除外している。**二次情報でも代用しない**
（[AGENTS.md](../../AGENTS.md) 推測禁止）。

**帰結: 段階AでPiの低電圧を判定する手段が二重に無い。**判定に使う値が無く、Pi自身の検出回路も無い。
Pi入力の**定常電圧はDMMで読める**が、**droopとrippleは`ADC-5V`の実測でしか捉えられない**。
分圧用抵抗は入手済みであり（`hardware-bom.md`の`MEAS-01`）、**残るのは実装と検証である。**
**いずれにせよ合否は判定できない。**判定に使う閾値が(a)として未確定だからである。

**あわせて記録する。**公式documentationが要求するのは**5.1 V**であるのに対し、選定済みの
`PSU-PI-01`（秋月 M-12001）は**5 V**である。**この差の可否はここでは判断しない**
（`HW-TBD-007`／`HW-TBD-009`）。

#### (a)を要件から外す（2026-09-06、PM決定）

**この決定の状態語は`対象外`である。`Blocked`と書かない**（2026-09-08に統一した）。
`Blocked`は未解決の必須gateが残っていることを表し、`対象外`は判定の対象でないことを表す。
(a)は要件から外したため後者である。**復帰条件（可変電源の調達、またはPi Zero W向け一次資料の公開）を
満たすまで合否判定を行わない。**復帰条件が残ることは`Blocked`であることを意味しない。

**決定: (a)を受け入れ試験の閾値として要求しない。**この決定はPM（`deskcat-f2`）が2026-09-06に
下した。**「実測で決める」か「要件から外す」の2択のうち後者を採った。**

**判断材料**（決定に用いた根拠）:

- **外しても新たに失われる能力は無い。**上記のとおりこの節は既に「段階AでPiの低電圧を判定する
  手段が二重に無い」「いずれにせよ合否は判定できない」と記していた。**(a)が無い今日の時点でも
  Pi入力のundervoltage起因の不具合は事実上判定不能であり、「要件から外す」はこの状態を
  TBDとして残し続けるか対象外と明示するかの違いにすぎない**
- **外しても壊れない。**(a)は[hardware-safety-policy.md](../governance/hardware-safety-policy.md)の
  「供給電圧の動作の下限」に分類され、安全要件5項目のいずれにも該当しない。下回っても絶対最大定格を
  超えず、起きるのは起動しない・hangする・SDカードへの書き込み中の記録が壊れる、のいずれかである
- **「実測で決める」は可変電源の調達を伴う。**調達判断は[#205](https://github.com/wachi-yoshitaka-11-dev/deskcat/issues/205)の範囲であり、この節では扱わない

**外すものと外さないもの:**

| 対象 | 扱い |
|---|---|
| (a)（Pi入力で許容する最低電圧） | **対象外。**受け入れ試験の閾値として使わない |
| Pi側の(c)(d)（最大定常ripple、最大transient droopの深さ） | **対象外。**(a)に従属するため恒久的に数値を持てない |
| ESP32側の(b)と、それに従属するESP32側の(c)(d) | **対象外にしない。**(a)を要件から外したことによる影響は無い |
| (d)の継続時間0 | **対象外にしない。**これは(a)とは独立に成立している確定値である |
| `HW-TBD-007`／`HW-TBD-009`（`PSU-PI-01`の5Vと公式要求5.1Vの適合性） | **対象外にしない。**別の問い（nominal値の適合性）であり、(a)の決定では自動的に解決しない。引き続きOpen |
| [#247](https://github.com/wachi-yoshitaka-11-dev/deskcat/issues/247)の診断作業（`EXP-010`の独立観測系によるbaseline比較） | **対象外にしない。**この観測は絶対値に対する合否ではなく`EXP-010`のbaseline（アイドル5.293 V、build負荷で平均−14.8 mV／瞬時最深−18.6 mV）との比較であり、閾値の不在は観測する能力を妨げない |

**復帰条件。**外すのは恒久的な放棄ではない。次のいずれかが起きた場合、(a)を要件へ戻せる。

- 可変電源が調達された場合（実測で決める道が開く）
- Raspberry Pi財団がZero W向けのschematicまたはregulatorの型番を公開した場合（一次資料が得られる）

**2026-10-04追記（ユーザーの購入申告）。**可変・電流制限付き電源が購入された
（[hardware-bom.md](hardware-bom.md#ベンチ電源)の`PSU-BENCH-01`）。上の調達による復帰条件を
再検討する材料が得られた。**2026-10-31追記：現物確認と初回使用は[EXP-051](experiment-log.md#exp-051-ベンチ電源psu-bench-01を無負荷と負荷ボードで初めて使いccに入ることを確かめた)に記録した（DeskCatの回路はつながない）。**Piへ接続する経路・設定値・測定手順の承認、
最低入力電圧の確定についての記録は未取得である。**購入だけで(a)やPi側の(c)(d)の合否判定を再開しない。**
要件へ戻す範囲と試験計画を人間が確認するまでは、上記の`対象外`の扱いを維持する。
追跡は`HW-TBD-028`と[#525](https://github.com/wachi-yoshitaka-11-dev/deskcat/issues/525)で行う。
既存の給電経路とサーボ試験の構成を、この購入記録だけで置き換えない。

**経緯の記録（4.63 Vを一度置いて取り下げたこと）。**この決定に至る過程で、2026-09-06に一度
`HW-TBD-028`(a)へ暫定値4.63 Vを置いたが、後に取り下げた（commit `d5fc023`をrevert）。
**取り下げの理由はPMの誤りである。**PM（`deskcat-f2`）が「`hardware-safety-policy.md`を正本とし
一般値側へ置く」と決定した際、この節（`(a)の一次資料は存在しない`）を読んでいなかった。
同節は既に低電圧検出のしきい値4.63 Vを検討したうえで、**(i) 動作範囲の下限ではなく検出回路の
動作点であること、(ii) 公式がPi Zero Wを明示的に除外していること**を理由に名指しで却下していた。
PMはこの却下を読まないまま「別モデルの閾値を借用してよい」との決定を下し、その決定にもとづき
暫定値4.63 Vが置かれた。**PM自身がこの誤りを発見し、revertを指示した。**「借用値を置く」道は
本節の決定（「実測で決める」か「要件から外す」の2択）では選択肢に入れていない。

#### (b)のESP32 board 5 V入力の導出

**2026-08-15に根拠が参照設計から現物へ移った。**2026-08-13の現物確認で`U2`の刻印が
`LD1117AG` / `33AQVCUV`であり参照設計の`AMS1117-3.3`ではないことが判明し、2026-08-15に
その刻印が**UMW（UTD Semiconductor Co., Limited）の`LD1117-3.3`（SOT-223）**のdatasheetが図示する
SOT-223 template（1行目`LD1117AG`、2行目`xxAQwwT S`）と一致することを確認した（`HW-TBD-023`）。
**以下は現物のdatasheetによる導出である。**参照設計の`AMS1117`のdatasheet値
（dropout最大1.3 V＠`IOUT ≤ 0.8 A`）はもう使わない。

現物の`U2`は`UMW LD1117-3.3`（LDO、1 A）であり、dropout電圧`Vdrop`は**最大1.30 V**（`IOUT = 1 A`）と
規定されている（[UMW LD1117 datasheet](https://www.umw-ic.com/static/pdf/a5e0c99cefdefaf03cfa7777b369e45b.pdf)
Mar.2025の`9.Electrical Characteristics`、`Dropout Voltage`行。`IOUT = 500 mA`で最大1.25 V、
`IOUT = 100 mA`で最大1.20 V）。したがってこの品の定格上限である1 Aまで3.3 Vを出し続けるには入力に
**3.3 + 1.30 = 4.6 V**が要る。

**数値は参照設計から導いていた値と一致するが、根拠は入れ替わった。**以前は別部品のdatasheetの、
しかも`IOUT ≤ 0.8 A`という条件付きの値だった。**現在は現物の部品のdatasheetであり、条件はこの品の
定格上限である`IOUT = 1 A`である。**より軽い負荷なら要求は下がる（`500 mA`で4.55 V、`100 mA`で4.50 V）。

**それでも4.6 Vを無条件の合格下限として公表しない。**残る条件が1つある。

- **`3V3` pinがboard levelで何Aまで出してよいかが未確定である**（`HW-TBD-023`(a)。Espressifは公開しておらず、
  **ICのdatasheetでも埋まらない**）。4.6 Vは`IOUT`がIC定格上限の1 Aに達しても成り立つ値であるため
  **負荷が増えても破れないが、これは「1 Aまで取ってよい」という意味ではない。**
  board側の定格が無い以上、取ってよい電流の上限は依然として不明である

**`HW-TBD-028`(b)の可否はここでは判断しない。**この節が変えたのは根拠の質だけである。
4.6 Vは**別部品由来の暫定値から、現物の部品のdatasheetによる値になった。**
したがって**5 V入力側について「現物の`U2`が未確認である」という理由でのBlockedは解消した。**
**ただし(b)は3.3 V rail側も含む項目であり、そちらは引き続き`HW-TBD-025`(a)に従属する。**
閾値として確定させるかどうかは`HW-TBD-028`で扱う。

#### (c)(d)の導出規則

**推奨動作条件は瞬時値の制約である。**ESP32-WROOM-32Dのdatasheetは絶対最大定格を
「恒久的な損傷を与えうるstress ratingであり、機能動作を意味しない」と定義したうえで、
**動作はTable 14 Recommended Operating Conditionsに従うべきである**と述べる。
**時間平均を許す記述は無い。**したがって次を規則とする。

- 定常・過渡を問わず、rail電圧の**瞬時値**が許容電圧範囲の内側にあること
- (c) `公称値 − DC設定誤差 − ripple(p-p)/2 ≥ 許容電圧範囲の下限`。
  **上限側も同様に**`公称値 ＋ DC設定誤差 ＋ ripple(p-p)/2 ≤ 許容電圧範囲の上限`
- (d) 上式にdroopの深さを加えたものが同じ不等式を満たすこと。**範囲を外れたら継続時間によらず不合格、
  内側なら継続時間を問わない。**よって**範囲を外れた状態の許容継続時間は0である**

**「継続時間0」は設計上の判定規則であって、メーカーが述べた値ではない。**datasheetが時間領域の
許容を示していないため、安全側に倒して置いたものである。

**照合の分解能は測定側で決まる。**`ADC-5V`／`ADC-3V3`のsample rateは1 kSample/s以上と定めており
（`Sample rateとlog形式`）、それより短いexcursionは捉えられない。**判定は「測定分解能の範囲で
範囲を外れないこと」であり、それ以上を主張しない。**

**したがってこのsample列は(d)の「継続時間0」規則を合格にできない。**規則はすべての瞬時値を対象に
するが、1 kSample/sのADCはsample間のより短いexcursionを観測できず、**「観測されなかった」は
「起きなかった」ではない。**受け入れを開けるには、想定するtransientすべてに対して測定帯域と
triggerを検証するか、規則自体を測定可能なenvelopeへ定義し直すかのどちらかが要る。
**それまで(d)の合否判定は`Blocked`のままとし、sampleした測定値から合格を導かない。**

**未観測区間はsample間だけではない。**ESP32自身のADCで測る構成では、**ESP32がbrownout／resetして
samplingが止まる区間**と、**burst captureのwindowの外**も観測できない。どちらにも同じ結論が及ぶ
（`ESP32自身のADCは測定対象から独立していない`。**ここへ再掲しない**）。

#### 定義した値をどの段階で照合するか

**照合（実測）はこの文書の定義とは別の作業である。**段階は`合成給電を部品が揃うまで行わない理由`の
段階表に対応づける。

**「測れる段階」と「合否を判定できるか」は別の列に分ける。**測定はgateさえ満たせば進められるが、
**判定には確定した閾値と、検証済みの測定系の両方が要る。**現状はどの項目も判定側が揃っていない。

| 項目 | 測れる段階 | 測定のgate | **合否判定** |
|---|---|---|---|
| (a) Pi入力の最低電圧 | **段階A**（Piを単体でアダプターから起動） | **DMMで直流値を読むだけなら不要**（追加購入も不要）。**`ADC-5V`でdroopまで見るならdividerの実装と検証が要る**（抵抗は入手済み。実装と検証が残る）。**[#247](https://github.com/wachi-yoshitaka-11-dev/deskcat/issues/247)の診断作業としての観測は、以下の合否判定と無関係に行える** | **対象外（2026-09-06、PM決定。復帰条件を満たすまで合否判定なし）。**閾値`HW-TBD-028`(a)を受け入れ試験の要件から外したため（`(a)を要件から外す（2026-09-06、PM決定）`）。復帰条件（可変電源の調達、またはPi Zero W向け一次資料の公開）が満たされない限り、この項目の合否は判定しない |
| (b) ESP32入力／3.3 Vの最低電圧 | 5 V入力側は**段階B-1**。3.3 V rail側は周辺moduleを足す**段階B-2** | 段階B-1は**不要**。段階B-2は**必要** | **Blocked。**5 V入力側の4.6 Vは**2026-08-15に現物の`U2`のdatasheetによる値になった**ため、部品未確認を理由とするBlockedは解消した（閾値として確定させるかは`HW-TBD-028`で扱う）。**3.3 V rail側の閾値は2026-09-06に確定した**（`3.3 V rail下限の設計判断`節。3.234 V。**条件付きのdatasheet値である**）。**2026-09-08に訂正した。**それ以前は「閾値そのものが未確定」と書いており、Revision 88を反映していなかった。**この項目が引き続きBlockedである理由は閾値の不在ではなく、下記の未観測区間である。****加えて、測定系がESP32自身であることによる未観測区間がある**（`HW-TBD-034`）。**(a)を要件から外したことによる影響は無い**（(b)は(a)に従属していない） |
| (c) 最大定常ripple | 段階A／B-1で各railを単独で、段階Cで合成後を測る。**両者を混ぜない** | **段階を問わず`ADC-5V`／`ADC-3V3`のdivider（10 kΩ／10 kΩ）の実装と検証が要る。**rippleはDMMでは捉えられず、この文書が定める測定手段はADC loggingだけである。**抵抗は入手済みであり**（`hardware-bom.md`の`MEAS-01`）、**残るのは実装と検証である。**段階Cはこれに加えて段階Cのgateが要る | **ESP32側はBlocked。**5 V入力側と3.3 V rail側の下限はいずれも確定しているが（3.3 V railは`3.3 V rail下限の設計判断`節。**2026-09-08に訂正した。**それ以前は「下限が決まらないと不等式を評価できない」と書いており、Revision 88を反映していなかった）、**下限が決まっても、未観測区間があるため測定値から合格を導けない**（`HW-TBD-034`）。**Pi側は対象外**（(a)を要件から外したため。`(a)を要件から外す（2026-09-06、PM決定）`） |
| (d) 最大transient droopと継続時間 | **段階C**（servo起動過渡を含む）。段階A／B-1では出ない | **必要。**段階Cのgateに加えて、(c)と同じく`ADC-5V`／`ADC-3V3`のdividerの実装と検証が要る（抵抗は入手済み） | **継続時間0は確定している。**ESP32側の深さの下限も(b)のとおり2026-09-06に確定した。**この項目が引き続きBlockedである理由は下限の不在ではなく、sample間・reset中・capture window外の未観測区間があるため、「継続時間0」規則をsampleした測定値から合格にできないことである**（`(c)(d)の導出規則`、`ESP32自身のADCは測定対象から独立していない`、`HW-TBD-034`）。**Pi側の深さは(a)を要件から外したため対象外** |
| (e) connector／wireの最大温度上昇 | **段階C**。`HW-TBD-021`／`HW-TBD-022`の部品が揃ってから | **必要** | **Blocked。**経路部品が未選定で、比較対象となるメーカー定義の温度上昇条件が存在しない |

**段階AとB-1の探索的な起動そのものにgateも追加購入も要らない。**DMMで読める直流値は、閾値が
決まる前でも取ってよい。

**ただしADC loggingを使う測定は別である。**`ADC-5V`／`ADC-3V3`のdivider（10 kΩ／10 kΩ、
`gpio-assignment.md`が比1/2を規定）は**抵抗こそ入手済みだが、実装と検証が残る**
（`hardware-bom.md`の`MEAS-01`）。**実装して検証するまでrippleもdroopも測定に着手できない。**
rippleはDMMで代替できない。

**ただし5項目とも、現時点で合否は判定できない。**測定値を記録してよいが、**そこから受け入れの
合否を導かない。**`servo-safety-limits.md`の受け入れchecklistのPi側項目も、2026-09-08にこの表と
同じ`対象外`へ揃えた（この時点までは`Blocked`のままであり、状態語が2文書で食い違っていた）。

**段階AとB-1を実施してよいこと自体は変えていない。**変えたのは、そこで得た値を受け入れ判定に
使わないという点だけである。

### 求め方が確定している制約

次は上表とは別の制約であり、承認時に実測値がこれを満たすことを確認する。
規則が確定していることと、数値が確定していることは違う。**5 V ingressの上限は
規則としては確定しているが、経路部品に未確定が残るため数値としては未確定である**
（`経路部品と定格`）。

| 制約 | 値 | 根拠 |
|---|---|---|
| **合成給電時にingressを通る定常電流** | **経路上の全部品（過電流保護部品が連続通電できる電流を含む）の定格の最小値の80%以下。**判明している最弱部品は`PROT-OC-01`のPTC（`MF-R135`）の`Ihold`（23 ℃で1.35 A、40 ℃で1.12 A）であるため**0.896 A以下**（40 ℃の1.12 A × 0.8。23 ℃基準は1.08 A。`上限を40 ℃基準の0.896 Aへ当て直す（2026-10-27、#405）`）だが（**2026-08-25に1.2 Aから1.0 Aへ下がり、2026-08-26にPTCへ変更して1.08 Aへ上がった。**`最小定格は1.35 Aへ上がった（2026-08-26）`）、`経路部品と定格`表に未確定の行が残る間は**確定値として扱わない**。**connector一般定格（約1.8 A）を上限に使わない**。超えたら直ちに中止する | connector定格は熱の制限であり、評価量は定常値である。最弱部品が経路全体の上限を決める。1.5〜1.8 Aの測定値を「合格」としないため。80%の根拠は`ingressの電流制限` |
| **合成給電時にservo railを通る定常電流** | **250 mA以下**（`ingressに必要な定格の見積もり`で割り当てた予算）。承認範囲内の最悪動作で確認する。**超えた場合はservoの動作制限を締めて再測定する。ingressの定格を上げるだけでは合格にしない**（予算の改訂は同節の正式改訂の手順による） | 予算を超えるとingressの見積もりが崩れる。強制点は`servo-safety-limits.md`の可動域・速度・duty cycleであり、経路側の定格ではない |
| 段階Cのgate部品の実装 | **合成給電の前に必須。**(1) **方式（PTC／ヒューズ）を決めたうえで**過電流保護部品を実装し、**`記録するtrip動作`の各項目**（定常電流継続時の動作、遮断へ移行する電流、遮断までの時間、3 Aでの動作と遮断定格、通過エネルギー、復帰、確認方法）を採った方式の欄で`過電流保護（段階Cのgate）`節へ記録する。**方式・品番・数値の記載だけでは通さない。**(2) gate対象の大電流経路を`WIRE-PWR-01`で構成し、breadboard接点とジャンパー線を通さない。(3) `経路部品と定格`表に未確定の行を残さない | テスターの読みと手動停止は検知であって保護ではない（M-12001は3 Aを供給できる）。「何Aで切れるか」だけでは、最弱部品の熱定格を超える前に止まるかを判定できない。**方式によって公開される量も違う。**定格不明の部品が経路にある間は最小値が出せず、上限も判定できない |
| 段階B-2の実施条件 | **共通:** 許容電圧範囲（周辺module3点が**moduleとして受け入れてよい電圧**の積集合とESP32のlogic level。**IC単体の動作範囲ではない**）を確認する。**B-2a（`3V3` pin給電）:** `3V3` pinの電流定格を確認し定常電流をその80%以下に保つ。かつ**board上regulatorの過電流／短絡保護を一次資料か現物回路で確認する。****B-2b（外部3.3 V電源給電）:** (i) 周辺module3点すべてに安全な電流上限があること（**MSP2807は未公開のため現状無い**）、(ii) 設定値で実際に電流が制限されることをmodule接続前に確認、(iii) 無負荷出力電圧が許容範囲内であることをmodule接続前に確認、の3つを満たす。設定値の根拠（低い値から段階的に上げる）と上限（上記(i)の最小値と配線許容電流の小さい方）を記録する。`3V3` pinは使わない。**B-2bの結果は`3V3` pinの承認にも5 V側への換算にも使えない。****どちらも成立しない場合はB-2を実施せず、測定を段階Cまで延ばす（2026-10-27更新：段階CではMSP2807を測らない。#405の見直しまで残る（`MSP2807の電流上限の扱いと、段階Cの測定4（2026-10-27、#556）`））** | PC hostのOCPはUSB入力を制限するだけで`3V3` branchを守らない。**先に壊れうるのはboard上のregulatorである。**通常動作の上限は短絡・配線ミス時の電流を制限せず、人による監視も保護機構ではない。**B-2aとB-2bでは守るべき対象も保護手段も違うため、片方の条件をもう片方へ流用しない**（`段階B-2の測定`） |
| ADC入力へ加える最大電圧 | 3.3 V以下（5 V／3.3 V railは分圧比1/2を経由） | ESP32のADC入力範囲 |
| ADC loggingのsample rate | 1 kSample/s以上 | servo起動過渡がms orderであるため。`Sample rateとlog形式`節 |
| logic GNDとservo GND間に許容する直列抵抗 | 0Ω（star point直結。shuntを経由させない） | `GND topology`節 |

### 電流の測定点と読みの確かさの基準

電流の測り方の決定は`DT830Bを電流測定に使うときの制約（2026-08-21）`が持つ（ここへ再掲しない）。

| 量 | 測定点 |
|---|---|
| 段階B-2（B-2a）の3点合計の定常電流 | `段階B-2の測定`の`今の接続のままB-2aとして測る（2026-09-28、ユーザー決定）`の構成 |
| 段階B-2（B-2b）の3点合計の定常電流 | `B-2b: 外部の3.3 V電源から給電する経路`の手順の測定点 |
| 段階C（合成給電）の合計電流 | 端子台の直後・`PROT-OC-01`の手前（`サーボ接続前`の記述が正。ここへ再掲しない）。**`MEAS-01`は5 V往路の線に入れる前提で書く（`deratingと判定量`は`ingress低側へshuntを入れてESP32 ADCで測る案は採らない`と定める。`GND topology`は`5V ingress GND`をstar pointと同一nodeに置く）。具体の使い方は[#17](https://github.com/wachi-yoshitaka-11-dev/deskcat/issues/17)の結果を受けて決める（`TBD`）** |

#### 読みを合否に使える条件（2026-10-26の案、[#525](https://github.com/wachi-yoshitaka-11-dev/deskcat/issues/525)）

**この条件は案である。人間の承認までは、段階Cの電流の読みを合否に使わない。**

- **判定。**`I_read + U ≦ 上限`。上限は`経路部品と定格`の最小値の80%（`marginの定義（#3 条件5）`）。
- **`U`に入れてよい項。**一次資料に値があり、その値の測定条件が実際の使い方と一致する項だけである。**値が無い項は、推測で置かない。**
- **`U`を組めないときは、その段階を「判定しない」と記録する。**合格とも不合格とも書かない。
- **`U`の項。**(1) `MEAS-01`の許容差±5 %と温度係数±300 ppm/℃（はんだ付けしない場合のみ。はんだ付け後は±(2 %＋0.05 Ω)で、0.1 Ωに対し大きく使えない）。(2) `MEAS-01`の温度変化（温度を測る手段が無く、値が無い）。(3) 両端電圧を読む計器の確度。(4) 計器が基準電圧を使う場合、その校正の不確かさ（`EXP-002`・`EXP-005`の比率法の値。`V_INT`は1.1122 V、不確かさは少なくとも±0.0033 V）。
- **測定中の電圧の見張りが成立していること**（下の案）。

##### 手持ちの機材の評価

| 機材 | 確度の一次資料 | 評価 |
|---|---|---|
| `DT830B`（200 mVレンジ、最小単位0.1 mV） | 無い（`DT830Bの一次資料で分かったこと（2026-08-21）`） | **使えない。**(3)の項に値が置けない |
| `DSO Shell` | 垂直確度の記載が無い。manualは`DSO150`のもので、現物との同一性が未確認 | **使えない** |
| Arduino Uno R3のADC | `DS40002061B` `Table 29-15`の絶対確度は2 LSB（**Typ欄の値で、Max欄は空である。保証値ではない**）。**条件は`V_REF`=4 V、`V_CC`=4 V、ADC clock 200 kHzである**（取得日・sha256は`ADCの性能値は`の表の出典） | **使えない。**Unoは`V_CC`が約5 V（USB給電）で、100 mV（1 A）を読むなら内蔵1.1 Vを基準にする。**どちらも条件と一致せず、その条件での絶対確度は記載が無い。**`MEAS-01`を5 V往路へ入れると、両端が5 V付近で、単端のADCは差の100 mVを読めない（`V_REF`=`AV_CC`なら1 LSBは約4.9 mV）。**戻りへ入れる案は採らない**（`GND topology`） |
| `PSU-BENCH-01`（`SPS-3010V`） | `SPS-3010V`の説明書（ユーザーの写真、2026-10-31）が、表示精度`0.5%+5digit`、表示分解能（電圧0.01 V・電流0.001 A）、CV／CCの変動率とリップルの上限を載せる。測定条件は説明書に無い。`EXP-051`で、無負荷5.00 V（`DT830B` 5.02 V）とCC（0.100 A、3.80 V）を観察した。`SPS-3010M`の値を流用しない | 判定は書かない（`hardware-safety-policy.md`の事実だけの規則。判定は[#525](https://github.com/wachi-yoshitaka-11-dev/deskcat/issues/525)が下す）。`U`の項としての確度の扱いは未決 |
| ESP32のADC | `MEAS-01`の両端を読む用途として評価していない | **使えない**（既存の方針のとおり、peak captureはこの判定に使わない） |

**結論。**手持ちの機材に、`U`を一次資料の値だけで組める測定器は無い。**段階Cの電流の読みは、現時点では合否に使えない。**`#525`の受け入れ条件「電流の読みの確かさの基準を満たす測定器を決めた」は、手持ちだけでは満たせない。**これは人間の判断が要る事実であり、この節は購入の案を扱わない。**

#### 段階Cで`MEAS-01`を直列に入れている間の電圧の見張り方（2026-10-26の案、[#525](https://github.com/wachi-yoshitaka-11-dev/deskcat/issues/525)）

**この節は手順の案であり、確定ではない。段階Cの前に人間の承認が要る。承認までこの手順を実施しない。**

- **前提。**計器が1台のため、`DT830B`で`MEAS-01`の両端を読む間は、同じ計器で電圧を見られない（`EXP-019`）。
- **見る電圧。**負荷側の5 V（`U2`の入力側。star pointを基準にする）。段階Cでは`MEAS-01`が5 V ingressに入るため、効くのは3.3 V railではなく`U2`の入力余裕である（`ingressのshuntの挿入降下とU2の入力余裕の見積もり（2026-10-26、#525）`）。
- **(a) Arduinoの1 chで、負荷側5 Vを連続に読む。**`ADC-5V`と同じ1/2分圧を通し、ArduinoのGNDはESP32のGNDへ落とす（分圧で5 V側を読む構成は`EXP-030`が使った）。**`MEAS-01`の電流はArduinoで読まない**（上の評価）。
- **(b) ESP32のbrownoutとresetを、事後の停止条件にする。**記録できるのは事実だけで、その区間の波形は残らない（`ESP32自身のADCは測定対象から独立していない`）。
- **採らない手順。**`MEAS-01`を短絡して読む手順。短絡の部材は、大電流経路にjumper線を通さない規則（`大電流経路にbreadboard接点とジャンパー線を使わない`）に当たり、付け外しは新しい配線revisionになる（`通電前の配線確認手順`の`確認の方法`）。
- **採らない。**`DSO Shell`による電圧の目視（確度が未確認）。
- **停止の閾値の数値は`TBD`。**`U2`の要求（4.6 V、または4.55 V）に、(a)のADCの誤差を足して決める。**(a)のADCの誤差は、条件が一致しないため値が置けない**（上の評価）。
- **GND topologyとの両立。**`MEAS-01`は5 V往路に入れるため、`GND topology`は変わらない。ArduinoのGNDをESP32のGNDへ落とす影響は、段階B-1の`EXP-003`・`EXP-004`が評価した。**ただし両者は、段階Cのtopology（star pointと`5V ingress GND`の同一node性）の検証ではないと明記している。**その確認は[#405](https://github.com/wachi-yoshitaka-11-dev/deskcat/issues/405)の受け入れ条件が持ち、未確認である。

## Revision履歴

[従来のRevision履歴](power-budget-history.md#revision履歴)を参照する。過去の番号・日付・根拠は保持し、
重複した93も再採番しない。今後は手動連番を追加せずGitのcommitとIssue／PRで版を識別する。
部品・配線・実験のrevisionとは別であり、それらの識別は続ける。
