wachi-yoshitaka-11-dev/deskcat/docs/hardware/tbd-register.md

# Hardware TBD Register

> 状態: Active
> 目的: 安全な実装を妨げる未確定情報を追跡する

## 優先度

| 優先度 | 意味 |
|---|---|
| P0 | 電源、配線、または最初の関連driverを妨げる |
| P1 | Featureの受け入れまたは安全な統合を妨げる |
| P2 | 後のmilestoneまで保留できる |

## 未解決項目

電源接続の判断に関わる4項目は、同じ台帳内の短い項目別表で読む:
[HW-TBD-004](#hw-tbd-004)、[HW-TBD-023](#hw-tbd-023)、[HW-TBD-024](#hw-tbd-024)、[HW-TBD-025](#hw-tbd-025)。
その他の項目は次の表に置く。

| ID | 優先度 | 不足している情報／判断 | 必要な根拠 | 妨げる対象 | 対応Issue | Owner | 状態 |
|---|---|---|---|---|---|---|---|
| HW-TBD-007 | P0 | **残: 5 V ingressの変換部品の購入と、connector定格の検証。**電源modelはM-12001（5 V／3 A）と確定し、現物も2026-08-08に着荷済み。ただしMicro-Bオスplugをbreadboardへ引き込む変換部品が未購入である（候補: 秋月 g110972、定格1ピン1.5 A）。上限は経路上の全部品の定格の最小値の80%（**値の正は[power-budget.md](power-budget.md)の`判明している最小定格が1.25 Aへ下がった（2026-08-25）`であり、ここへ再掲しない。**未確定の経路要素が残るため確定値ではない。HW-TBD-021／022）であり、**判定は定常電流で行う**（connector定格は熱の制限のため）。**段階A（Pi単体起動）と段階B-1（ESP32をPCのUSBから給電）はこの行に依存せず進められる。ただし段階Aは探索的な通電であって、Piの電源経路の受け入れではない。**M-12001の5 VがRaspberry Pi公式の要求する5.1 Vを満たすかはこの行で未判断であり、判定に使う最低電圧も`HW-TBD-028`(a)として未確定である。**段階Aが正常に起動したことをもって合格としない。****段階B-2（周辺module3点から3.3 V側の定常電流を測る）も同様だが、B-2自体が共通条件のHW-TBD-025と、経路別のHW-TBD-023（B-2a）またはHW-TBD-024（B-2b）にBlockedされている。**なお**合成給電（段階C）はこの部品が要る。****2026-08-12に電源modelそのものについて1件判明した。**Raspberry Pi公式documentationは全modelが**5.1 V**供給を要求すると述べているが、選定済みのM-12001は**5 V**である。**この差の可否はまだ判断していない。**判定に使う最低電圧が`HW-TBD-028`(a)として未確定であり（一次資料に無いことを確認済み）、**電圧の余裕を評価する根拠が無い**ためである。**部品の選定は変更していない**。**2026-08-27の追記。**`PROT-OC-01`をPTCへ変更した経緯で、`HW-TBD-021`の詰まりの本体は保護部品の性能ではなく、この行が持つ`Micro-Bオスplugとreceptacleの嵌合接点`（変換基板側1ピンあたり1.5 A）であると判明した（正は[power-budget.md](power-budget.md)の`3 Aでのトリップ時間を読み、線材と嵌合接点の判定で止まった（2026-08-27）`。**ここへ再掲しない**）。**確認項目を1つ足す。**変換基板（秋月`110972`、`AE-MRUSB-DIP`。DIP化キット）は`VBUS`をブレイクアウトする複数pinを持ちうる。**`VBUS`を複数pinへ渡して並列に受ければ、実効的な定格が1ピンあたり1.5 Aより上がる可能性がある。****着荷後、現物のpin配列とパターン（`VBUS`が何本のpinへ出ているか、pin間がボード上で導通しているか）を確認する。**非通電で行える。この確認は`HW-TBD-021`の詰まりを解く経路の1つであり、確認結果は`power-budget.md`の`経路部品と定格`へ反映する。**2026-09-13訂正（この列について）。****(a) 上限の「正」の指定が古い。**上の`判明している最小定格が1.25 Aへ下がった（2026-08-25）`は、正本側で「この節の値は2026-08-26に更新された」と明示された当時の記録である。**現行の正は`最小定格は1.35 Aへ上がった（2026-08-26）`である**（値をここへ再掲しない）。**(b) 「着荷後、現物のpin配列とパターンを確認する」は残作業ではない。**2026-09-08に実施済みであり（この行の状態欄）、さらに2026-09-09の案Bで`PSU-INGRESS-01`が経路から外れたため、`HW-TBD-021`の詰まりを解く経路としての意味も失っている。**この列の過去の記述は書き換えていない。** | 変換部品の選定＋実測。確定済み部分の根拠: [hardware-bom.md](hardware-bom.md) PSU-PI-01／PSU-SERVO-01、[power-budget.md](power-budget.md#5-v-ingress物理的な引き込み経路)。**5.1 Vと5 Vの差についての根拠**: [Raspberry Pi公式documentation](https://www.raspberrypi.com/documentation/computers/raspberry-pi.html)の`Power supply`（`All models require a 5.1V supply`。2026-08-12取得）。**同documentationは許容範囲を示さないため、5 Vが範囲内かどうかもこの資料からは決まらない**。**2026-09-13訂正（この列について）。**冒頭の「変換部品の選定＋実測」は案B（2026-09-09、人間の決定）で対象を失った。端子台（`114217`、着荷済み）へcableを直接ネジ止めする構成であり、新たな変換部品の購入も選定も要らない。**「変換部品の選定＋実測」に代わって残るのは`CABLE-PI-PWR-01`のPi側`PWR IN` receptacle定格の検証である**（この行の状態欄）。**これはこの行の残件を網羅したものではない。**M-12001の5 VとRaspberry Pi公式要求5.1 Vの適合性は、この行の列3が「この行で未判断」と記録するとおり、未判断のまま残る。**過去の記述は書き換えていない。** | 初回統合通電 | [#3](https://github.com/wachi-yoshitaka-11-dev/deskcat/issues/3)、[#525](https://github.com/wachi-yoshitaka-11-dev/deskcat/issues/525) | Human | Open（範囲を縮小。**2026-08-12に電源modelの供給電圧について未判断の論点が1件加わった**）**2026-09-08に`AE-MRUSB-DIP`のpin配列を現物確認した（非通電、テスターの導通チェック）。**引き出しpinは4本あり、うち2本（シルク印刷`+`側）が`VBUS`として導通で1グループ、残り2本（シルク印刷`-`側）が`GND`として導通で1グループ、receptacle金属シェルは`GND`側グループに含まれることを確認した。`VBUS`グループと`GND`グループの間には導通が無い（短絡していない）。**したがって`VBUS`は2本のpinへ出ている。**ただし、**この2本が基板上で導通していることと、外部配線を2本とも使えば実効的な電流定格が1ピンあたり1.5 Aより上がることは別である。**receptacle内部の配線（内部traceの幅・銅箔厚）はメーカーが公開しておらず、receptacleの内部端子そのものがボトルネックである可能性を排除できないため（[AGENTS.md](../../AGENTS.md) 推測禁止）。**したがってこの確認だけでは`HW-TBD-021`の詰まりは解けない。**確認結果は[power-budget.md](power-budget.md)の`経路部品と定格`へ反映する **2026-09-09に人間が決定した案B（`WORK-INSTRUCTIONS-INGRESS-PLAN-B.md`）により、この行の「connector定格の検証」の対象が変わる。**`PSU-INGRESS-01`（`AE-MRUSB-DIP`）は5 V ingressの経路から外れるため、**同品のconnector定格（1ピンあたり1.5 A）はもう経路の判定に効かない。****ただし`CABLE-PI-PWR-01`のPi側`PWR IN` receptacle定格（`経路部品と定格`表の該当行、定格`TBD`）はPi branch内にあり、ingressの経路変更の影響を受けずそのまま残る。**この行の追跡対象は今後こちらが中心になる。**あわせて、この行冒頭の「残: 5 V ingressの変換部品の購入」は案Bにより対象を失った。**案Bは端子台（`114217`、着荷済み）へcableを直接ネジ止めする構成であり、新たな変換部品の購入は不要である。**残るのは「connector定格の検証」（上記のとおり対象が`CABLE-PI-PWR-01`のPi側receptacleへ移った）だけである。**2026-09-10、ユーザーがM-12001の出力cableをMicro-Bプラグの手前で切り、端子台へ接続した**（極性判定の記録は[experiment-log.md](experiment-log.md) `EXP-012`）。**通電はまだ行っていない。**`PROT-OC-01`の実装はこの作業に含まれず別途残る。****2026-09-12、この行の「合成給電（段階C）はこの部品が要る」が案B決定を反映していないことを確認したが、この訂正では扱わない**（次のPull Requestで扱う） **2026-09-13、その1件を訂正する**（**上の記録は書き換えず、ここへ追記する**）。**「なお合成給電（段階C）はこの部品が要る」は案Bにより成立しない。**ingressは端子台（`114217`）でM-12001を受ける構成になり、`PSU-INGRESS-01`は[hardware-bom.md](hardware-bom.md)で`Not used`である。**段階Cにこの変換部品は要らない。****ただし段階Cがこの行にBlockedされる関係は変わらない。**この行の追跡対象が`CABLE-PI-PWR-01`のPi側`PWR IN` receptacle定格へ移っており、それはPi branch内に残るためである。**追跡対象が移ったことは、この行の2026-09-09の記録にある。**`経路部品と定格`のその行（`CABLE-PI-PWR-01`のMicro-B plugとPiの`PWR IN` receptacleの嵌合接点）が定格`TBD`のまま残り、段階Cのgateの条件の1つが同表に未確定の行が無いことである（**gateの条件はこれだけではない。正は[power-budget.md](power-budget.md)の`合成給電を部品が揃うまで行わない理由`の段階表。ここへ再掲しない**）。**値・上限・gate・受け入れ条件は1つも変えていない。** |
| HW-TBD-008 | P0 | GPIO割り当て | Board／module回路図＋競合review | すべてのhardware driver | [#2](https://github.com/wachi-yoshitaka-11-dev/deskcat/issues/2) | Joint | **004によりBlocked**（**001と003は2026-08-15、002は2026-09-06にclose。006と029も解決済み**）。下書きは[gpio-assignment.md](gpio-assignment.md)にあるが、[競合check](gpio-assignment.md#競合check)に未完了項目が残る。**001のcloseでpin配列の前提は成立した** |
| HW-TBD-009 | P0 | 電源予算とbackfeed review | 部品電流＋回路図＋測定計画 | Servoと全体統合 | [#3](https://github.com/wachi-yoshitaka-11-dev/deskcat/issues/3)、[#525](https://github.com/wachi-yoshitaka-11-dev/deskcat/issues/525) | Joint | **004**、007、**021、022、023、024、025**、および**028、030、034**によりBlocked（**001と003は2026-08-15、002は2026-09-06にclose。006と029も解決済み。029は2026-08-12にclose**。下書きは[power-budget.md](power-budget.md)にあるが、実測値が皆無。021と022が解決するまで合成給電（段階C）へ進めず、**合成給電の実測と受け入れが始まらない**。段階Aと段階B-1は021／022に依存せず実施できる。**段階B-2は021／022には依存しないが、共通条件の025と、経路別の023（B-2a）または024（B-2b）にBlockedされている。****025(a)は`HW-TBD-004`に加えて、3.3 V rail下限の両立方式の決定にもBlockedされている**（2026-08-12に判明）。B-2の3.3 V側の実測はingress部品の選定にも要るため、023と024はその選定も止めている。**なお2026-08-12に、`PSU-PI-01`の5 VがRaspberry Pi公式の要求する5.1 Vと一致しないことが判明した。**予算の判定に使う最低電圧は`028`(a)として未確定であり、**この差の可否は評価できない**（`007`）。**034は2026-08-16に追加した。**同日に方式1（独立した外部観測）を採用済みだが、close条件が未達であり、**閾値が確定しても、測定値から受け入れの合否を導けない。**未解決なのは方式の選択ではなく、測定器の採否とclose条件である**（全数は`HW-TBD-034`の`必要な根拠`欄）**） |
| HW-TBD-010 | P1 | サーボの機械的可動域とneutral | 監視下calibration | 首振り動作の受け入れ | [#18](https://github.com/wachi-yoshitaka-11-dev/deskcat/issues/18) | Human | 007–009、**026**、および首機構（[#34](https://github.com/wachi-yoshitaka-11-dev/deskcat/issues/34)）によりBlocked |
| HW-TBD-011 | P1 | サーボの速度／加速度制限 | 電流・動作試験 | Motion profile | [#17](https://github.com/wachi-yoshitaka-11-dev/deskcat/issues/17)、[#18](https://github.com/wachi-yoshitaka-11-dev/deskcat/issues/18) | Joint | 010によりBlocked |
| HW-TBD-013 | P1 | 軽打／持ち上げしきい値 | サーボ動作を含む取得済みraw sample | 軽打／持ち上げ動作の受け入れ | [#15](https://github.com/wachi-yoshitaka-11-dev/deskcat/issues/15) | Joint | 004、008によりBlocked |
| HW-TBD-014 | P1 | 最終serial baudと最大line length | Pi／ESP32 transport test | Protocol v1の受け入れ | なし（未起票） | Joint | 候補値あり |
| HW-TBD-017 | P0 | 通信断の検知方式（heartbeat source、loss timeout） | Protocol合意＋latency測定。正本: [servo-safety-limits](servo-safety-limits.md#通信断時動作)、[protocol](../protocol/esp32-pi-protocol.md#13-未決定事項) | サーボの実機動作全般 | [#18](https://github.com/wachi-yoshitaka-11-dev/deskcat/issues/18) | Joint | Open |
| HW-TBD-018 | P0 | 通信断時のfail-safe sequenceの選択と検証、および**recovery／reconnect動作**（断からの復帰時にサーボ出力を再有効化してよい条件と手順） | 監視下の機械試験（PWM断時の首の挙動、および復帰時の挙動）。正本: [servo-safety-limits](servo-safety-limits.md#通信断時動作) | #20、MVP受け入れ | [#18](https://github.com/wachi-yoshitaka-11-dev/deskcat/issues/18) | Joint | 010、017、PROTO-TBD-013によりBlocked |
| HW-TBD-019 | P0 | 起動時とdriver故障時のサーボ出力状態（PWM driver初期化前のGPIO state、開始mode、enableまでのdelay、Pi未接続時、reset後、driver故障検知時） | 無負荷でのPWM測定＋起動時glitch確認。正本: [servo-safety-limits](servo-safety-limits.md#起動時とdriver故障時の動作) | 初回統合通電 | [#17](https://github.com/wachi-yoshitaka-11-dev/deskcat/issues/17) | Joint | 010、**027**によりBlocked |
| HW-TBD-020 | P1 | 実行時のサーボ安全制御（採用する検知／予防手段、電流しきい値と判定時間、連続動作時間の上限、duty cycle窓と上限、検知時の物理動作、復帰条件、秒あたり受理command数、単一commandの最大変化量、command timeout、duplicate履歴の保持期間とretry window、retired sessionの保持件数と期間） | 電流測定手段の選定＋温度／電流試験。**正はfield単位**で[下表](#hw-tbd-020のfield単位の正)に定める。要件は[servo-safety-limits](servo-safety-limits.md#拘束stallと過負荷)、link側は[protocol](../protocol/esp32-pi-protocol.md#13-未決定事項) | 長時間動作とM6耐久試験 | [#17](https://github.com/wachi-yoshitaka-11-dev/deskcat/issues/17)、[#24](https://github.com/wachi-yoshitaka-11-dev/deskcat/issues/24) | Joint | 009、全fieldのresolution evidence未記録、およびPROTO-TBD-005／011／012／013／014未解決によりBlocked |
| HW-TBD-021 | P0 | **5 V ingressの過電流保護部品（`PROT-OC-01`）の選定とtrip値。**M-12001は3 Aを供給でき、候補構成で定格が判明している部品のうち最小は**`PROT-OC-01`の定格電流である**（**2026-08-25に変換基板の嵌合接点から入れ替わった。****2026-08-26に方式がヒューズからPTC（Bourns `MF-R135`、`Ihold` 1.35 A）へ変更されている**（この行の状態欄の`2026-08-26の更新`が正。**ここへ再掲しない**）。値の正は[power-budget.md](power-budget.md)の`最小定格は1.35 Aへ上がった（2026-08-26）`。**ここへ再掲しない**。HW-TBD-022が解決するまで、これが真の最小値である保証はない）。現状は「上限を超えたらテスターの読みで人が電源を落とす」だけであり、connectorと線材が発熱する前に電流を止める手段が無い | メーカーの時間-電流特性（一次資料）に基づく選定。選定基準・挿入位置・上限との関係は[power-budget.md](power-budget.md#過電流保護段階cのgate) **2026-08-22に、部品が満たすべき数値の窓と、窓が閉じる境界を計算した。選定はしていない。**手順1〜3の入力は既存の表から揃うため計算できる。**MSP2807を除いた定常電流の合計から下限が出て、判明している最弱部品の定格が上限になる。****MSP2807の定常電流が一定値を超えると窓が閉じ、両方を満たす保護部品が存在しなくなる。**そのときは保護部品の選定の問題ではなく**経路の定格が足りないという結論**である（値と限定の正は[power-budget.md](power-budget.md)の`窓が閉じる境界（2026-08-22の計算）`。**ここへ再掲しない**）。**方式は2026-08-25にヒューズで決定し、品番も選定した**（[#205](https://github.com/wachi-yoshitaka-11-dev/deskcat/issues/205)。**PTCを採らなかった理由と、同じ理由で2 A品も採れなかった経緯は同Issueの本文が持つ。ここへ再掲しない。**選定内容と一次資料値の正は[power-budget.md](power-budget.md)の`方式と品番を決定した（2026-08-25）`。**未購入である**）。**2026-08-26にこの決定は覆り、方式はPTCへ変更されている**（この行の状態欄の`2026-08-26の更新`が正。**ここへ再掲しない**）。**その結果、保護部品自身が経路の最小定格になり、窓とgate値が下がった**（正は同節と`判明している最小定格が1.25 Aへ下がった（2026-08-25）`。**値をここへ再掲しない**）。**上限も確定値ではない**（`経路部品と定格`に未確定の行が残っており、より低い定格が現れれば窓は狭くなる） **2026-08-22に境界の不等号を厳密不等号へ揃えた。**`方式によらない基準`は`その電流の80%が想定する定常電流の合計を上回ること`と定めており**等号を含まない。****したがって下限は`I > 合計/0.8`であり、境界の値そのものは窓に入らない。****MSP2807の定常電流が境界値以上になると窓が閉じる**（境界そのものが閉じる側である。値の正は[power-budget.md](power-budget.md)の`窓が閉じる境界（2026-08-22の計算）`。**ここへ再掲しない**） | **合成給電（段階C）**。保護部品の選定・実装まで実施しない | [#3](https://github.com/wachi-yoshitaka-11-dev/deskcat/issues/3)、[#405](https://github.com/wachi-yoshitaka-11-dev/deskcat/issues/405)、[#525](https://github.com/wachi-yoshitaka-11-dev/deskcat/issues/525) | Human | Open（**2026-08-22に窓と境界を計算した。その時点では選定も方式の決定もしていなかった**（方式と品番は2026-08-25に決まった。下記）**。****この境界は段階B-2でのMSP2807の測定に対する合否の境界になる。境界値以上で窓が閉じる。**その場合は保護部品の選定へ進む前に、経路の変更か`servo-safety-limits.md`の制限の締め直しを決める。**2026-08-25に方式と品番が決まった**（[#205](https://github.com/wachi-yoshitaka-11-dev/deskcat/issues/205)。ヒューズ。**PTCは採らない**）。**それでもcloseしない。****残るのは(0) 実際に買える品番の確定**（**2026-08-25時点の品番は一次資料で特性を確認した候補であり、購入は確定していない**（`digikey.jp`が取扱終了を表示している。**他の販売店は一次で確認できていない**）**。**入手性は[#205](https://github.com/wachi-yoshitaka-11-dev/deskcat/issues/205)が持つ。**方式と定格電流は品が替わっても変わらないが、関門・`I²t`・冷抵抗は品に依存するため取り直しになる。**正は[power-budget.md](power-budget.md)の`入手性はこの節で確認していない（2026-08-26）`）、**(1) 購入と実装、および`記録するtrip動作`のうち実装後にしか埋まらない欄、(2) ヒューズホルダの定格**（**商品ページにもdatasheetにも記載が無いことを確認済み。**ヒューズ側のdatasheetはホルダによる減額の参照を求めているが、その資料が存在しない）、**(3) `HW-TBD-022`**（経路の最小定格の確定）、**(4) `遮断までの時間`の合否判定**（判定条件の「最弱部品の熱時定数」がどの経路部品についても未確定である。溶断時間の側は公開値が揃った）、**(5) DCでの遮断能力**（**メーカーが与えるのは交流の定格だけであり、この経路は5 V DCである。**交流の遮断定格から直流を導かない。正は[power-budget.md](power-budget.md)の`遮断能力はDCで未確定である`。**ここへ再掲しない**）、**(6) trip値の締め直しの判断**である。 **2026-09-13訂正。**上の(0)〜(6)は2026-08-25のヒューズ＋ホルダ決定のもとで書いた並びであり、**(2)と(5)は2026-08-26の方式変更（PTC、`MF-R135`）の後は同じようには残らない。****(2) ヒューズホルダの定格は対象を失った。**ホルダという経路要素自体が無くなったためである（この行の`2026-08-26の更新`が既に「ヒューズホルダは経路要素から外れた」と書いている。**ここへ再掲しない**）。**(5) DCでの遮断能力は、正本が解消したものとして記録している。**(5)が挙げていた理由は**メーカーが与えるのは交流の定格だけである**ことであり、`MF-R135`のdatasheetは定格を直流で与えている（正は[power-budget.md](power-budget.md)の`方式をPTCへ変更した（2026-08-26、人間の判断）`の`変更した理由`の表。**値をここへ再掲しない**）。**ただし「遮断能力」の項目そのものは、datasheetだけで満たしたものではない。**同じ`方式をPTCへ変更した（2026-08-26、人間の判断）`節の下位節`遮断能力は「制限」で満たしたと判断した（2026-08-27、PMの判断）`が、**PTCは遮断（開放）しないため、この項目は「制限」で満たしたことにすると記録している。****残る条件の全体をこの訂正では確定しない。**この行は「実際に買える品番の確定」について、2026-08-27の記録では`(0)`として**解消したと書き**、2026-09-09の記録では`(1)`として**残る条件に挙げている**（元の並びの`(1)`は「購入と実装」である）。**番号の対応だけでなく、この項目が解消済みか残存かが食い違っている。****揃えるのはこの訂正の範囲外であり、この行の残件として`#3`に残る。****(6)は段階B-2に従属する。**段階B-2は`HW-TBD-025`の共通条件が未確定で実施できず、**とくにMSP2807の安全な電流上限が未公開である限りB-2aもB-2bも実施できない。****2026-08-26に人間が方針を決めた。****servo予算の見直しで窓を広げる**（正は[power-budget.md](power-budget.md)の`servo予算の見直しで窓を広げる（2026-08-26、人間の判断）`。**関係式も値もここへ再掲しない**）。**測定を待たずに動かせる量がservo予算だけだからである。****ただしまだ実行していない。**新しい予算値が未定であり、決めるには(1)いくつにするかの設計判断と、(2)その値が`servo-safety-limits.md`の可動域・速度・duty cycleで実際に強制されること、の2つが要る。**実行するときは`ingressに必要な定格の見積もり`（**2026-09-09、PM承認の節見出し改名により`変換基板に必要な定格の見積もり`から差し替え**）の正式改訂の手順を踏み、電源側とservo側の片方だけを変えない。**窓が閉じた場合の結論（保護部品の選定の問題ではなく経路の定格が足りないという結論）は[power-budget.md](power-budget.md)が持つ。**ここへ再掲しない**）。**2026-08-26の更新**: **方式をPTCへ変更した**（人間の判断。[#205](https://github.com/wachi-yoshitaka-11-dev/deskcat/issues/205)）。Bourns `MF-R135`（秋月 通販113013）。**却下の前提が誤っていた。**訂正③は「在庫のあるPTCに条件を満たす品が無い」としていたが、**当時見たのは3品番だけで、秋月のPTCカテゴリには41件ある。条件を満たす品が実在した**（値と理由の正は[power-budget.md](power-budget.md)の`方式をPTCへ変更した（2026-08-26、人間の判断）`。**ここへ再掲しない**）。**判明している最小定格は1.25 Aから1.35 Aへ上がり、上限は1.0 Aから1.08 Aへ、MSP2807の境界は160 mAから240 mAへ広がった。****ヒューズホルダは経路要素から外れた**（PTCは基板へ直付けするため）。**2026-08-27の更新**: **`M-12001の供給上限3 Aでのtrip時間をdatasheetのTime to Tripグラフから読んだ。**確定値としては読めなかった。曲線がグラフの描画上限（1000秒）へ入るのが電流にして約2.97〜3.06 Aであり、3.00 Aはこの範囲をまたぐ。**読めたのは下界（少なくとも数百秒、1000秒に達するか超える可能性がある）だけである**（読み取り方法と根拠は[power-budget.md](power-budget.md)の`3 Aでのトリップ時間を読み、線材と嵌合接点の判定で止まった（2026-08-27）`。**ここへ再掲しない**）。**線材（`111641`）は連続許容電流（約6.0〜6.9 A）が3 Aを上回るため、継続時間によらず持つ。****嵌合接点（定格1.5 A）は3 Aがその200%であり、この下界の時間で持つかどうかを判定する一次資料が無い。****それでもcloseしない。**`記録するtrip動作`の`遮断までの時間`と`通過エネルギー`は、最弱部品側の熱時定数と`I²t`耐量が非公開のため依然として判定できない。**この判定はPMへ上げた。****`(0) 実際に買える品番の確定`は解消した**（秋月で買える）。**発注は次に秋月で買う機会にまとめる**。**2026-08-27、PMの判断。**「持つ」として扱わない（一次資料が無い。ADR-0016の`A`＝判定に効く数であり、桁の余裕や推定では埋められない）。**方式の再検討はしない。PTCを維持する。**ヒューズへ戻すと`DCでの遮断能力が未確定`という別の未検証の穴と、日本での入手性の問題へ戻るだけである。**詰まりの本体はPTCの性能ではない。**`Ihold`を定常840 mAより上に置く必要がある限り、`Itrip`とM-12001の供給上限3 Aの間には必ず遅い帯が残る（方式によらない）。**詰まりの本体は嵌合接点が1.5 Aのままであることである。**変換基板（秋月`110972`）の`VBUS`を複数pinへ渡せば実効定格が上がる可能性があり、`HW-TBD-007`へ着荷後の現物確認項目として追加した。**したがってHW-TBD-021の詰まりを解く経路は保護部品の再選定ではなく、HW-TBD-007の現物確認である** **2026-09-08にその`HW-TBD-007`の現物確認（`VBUS`引き出しpinの導通チェック、非通電）を実施した。**`VBUS`は引き出しpin4本のうち2本へ出て導通していることを確認したが、receptacle内部の配線（trace幅・銅箔厚）が非公開であるため実効定格は上げられなかった（正は[power-budget.md](power-budget.md)の`経路部品と定格`の該当行と本台帳`HW-TBD-007`。**ここへ再掲しない**）。**したがってこの行が名指ししていた「`HW-TBD-007`の現物確認」という経路は尽きた。**嵌合接点1.5 Aという詰まりは残っている。**次の経路は未決である（PMへ上げた、2026-09-08）** **2026-09-09に人間が設計判断を決定した（案B、`WORK-INSTRUCTIONS-INGRESS-PLAN-B.md`）。**M-12001の出力cableをMicro-Bプラグの手前で切り、端子台（`114217`、6 A）へ直接ネジ止めする。**この決定により、この行が詰まりとして名指ししていた嵌合接点（Micro-Bオスplugとreceptacleの嵌合接点、1.5 A）そのものが経路から外れる。**したがって「1.5 A定格の接点が200%の電流を数百秒以上通したときに持つか」という未解決の問いは、ingress側については対象を失った。**最小定格を自分で確かめた。**`経路部品と定格`表を全部足し合わせた結果、`PROT-OC-01`（PTC）の`Ihold` 1.35 Aが引き続き経路の最小値であり、外れた1.5 Aの2行はもともと最小値ではなかったため、最小定格・gate値（1.08 A以下）とも変わらない。**ただしこの行はcloseしない。**残る条件（(1)実際に買える品番の確定、(4)遮断までの時間の合否判定、(6)trip値の締め直しの判断が段階B-2に従属すること等）は、この設計判断の対象外であり、Plan Bとは独立に残る。**「A1が解けた」とは書かない**（Pi側の嵌合接点は`TBD`のまま残り、追跡は`HW-TBD-007`）。**2026-09-10、ユーザーがcableをMicro-Bプラグの手前で切り、端子台へ接続した**（極性はプラグの金属シェル基準の判定が不成立だったため、手元に残る`PSU-INGRESS-01`のreceptacleで判定し直した。記録は[experiment-log.md](experiment-log.md) `EXP-012`）。**通電はまだ行っていない。**この行が対象とする保護部品（`PROT-OC-01`）の選定・実装はこの作業に含まれず、引き続きOpenである。**2026-10-27：上限を40 ℃基準の0.896 Aへ当て直した**（[power-budget.md](power-budget.md)の`上限を40 ℃基準の0.896 Aへ当て直す（2026-10-27、#405）`。ユーザーの承認）。上の「gate値（1.08 A以下）」は23 ℃基準の値である。 |
| HW-TBD-022 | P0 | **大電流経路の線材・接続部材（`WIRE-PWR-01`）と`CABLE-PI-PWR-01`の選定と許容電流。**（`CABLE-PI-PWR-01`は[power-budget.md](power-budget.md#経路部品と定格)で同じ規則の適用対象であり、2026-08-11の照合でこの行に含めることを明示した。）手持ちのbreadboardとジャンパー線は個別の許容電流がメーカー資料で確認できず、経路の最小定格を出せない。最小定格が出ないとingressの上限（経路部品の定格の最小値の80%）が確定しない。**2026-08-25に線材と端子台を選定した。**線材は秋月 通販111641（住友電気工業、絶縁体イラックスA、0.3054 mm²＝0.3 sq）で、**この品は許容電流が公開されている**（同社`許容電流計算式`PDFの**2ページ目**の`イラックス®A電線（定格温度90℃）`の`0.3sq`曲線。**取得物のsha256は2026-08-22に記録した値と一致し、同一文書の当時見ていなかったページである**）。端子台は秋月 通販114217（**製造者が公開する電流定格6 A**、適合AWG18〜26） | 公称許容電流が公開されている線材・接続部材の選定。決定の根拠は[power-budget.md](power-budget.md#経路部品と定格) **2026-08-22に選定規則を評価可能な形にした。選定はしていない。**販売元が公開しているのは住友電工の`許容電流計算式`（式と材料別の係数表）であって数値ではない。**式の入力のうち`r0`（20 ℃における導体抵抗の規格値）だけが電線側の仕様から来るため、`r0`が公開されていない製品では式を評価できない。**候補として見た秋月の`UL1015 AWG18`は`導体抵抗`も`許容電流`も公開していない。**第三者の公開値は18 Aと19.2 Aで食い違い、条件の記載も揃っていない。****したがって定格として採らない。**詳細は[power-budget.md](power-budget.md)の`線材の許容電流をどう確定させるか（2026-08-22の調査）`。**ここへ再掲しない** **2026-08-22に、線材・cableと接続部材で受け入れ条件が違うことを分けた。****`導体抵抗`は導体の証拠であって接点の定格を証明しない。**線材・cableの導体は「許容電流そのものか製造者が公開する`導体抵抗`のいずれか」、**接続部材は「製造者が公開する電流定格」**である（正は[power-budget.md](power-budget.md)の`線材と接続部材で受け入れ条件が違う`。**ここへ再掲しない**）。**cableは導体と接点の両方を持つため、両方の条件を満たす必要がある。** | ingressの上限の確定、**合成給電（段階C）** | [#3](https://github.com/wachi-yoshitaka-11-dev/deskcat/issues/3)、[#525](https://github.com/wachi-yoshitaka-11-dev/deskcat/issues/525) | Human | Open（**2026-08-22に選定規則を評価可能な形にした。選定はしていない。**残るのは(1) **線材・cableの条件**を満たす品の選定、(2) 分岐点の接続部材（**未調査**）、(3) `CABLE-PI-PWR-01`（**未調査**）、(4) GND戻り経路である。**AWG18級なら経路の既知の最小値1.5 Aより一桁大きいことは分かったが、これは非メーカー値との比較であり定格の確定ではない**（**2026-09-12追記。**この1.5 Aは当時の最小値であり、変換基板`PSU-INGRESS-01`側のMicro-B嵌合接点の値である。**同接点は2026-09-09の案Bで5 V ingressの経路から外れた**（**この行が主題とする`CABLE-PI-PWR-01`のPi側嵌合接点とは別である。**Pi側は同行の後段のとおり`TBD`のまま残る）。**現在の最小値は[power-budget.md](power-budget.md)の`経路部品と定格`が持つ。ここへ再掲しない**）。`経路部品と定格`の表の`TBD`は埋めていない。****2026-08-24に選定条件が2つ増えた。**(1) `CABLE-PI-PWR-01`をrail側で受ける端子台がこの行の接続部材に入る（rail側の受け方が②（直付け）で確定したため）。(2) **手配線区間の接続部材は極性が固定される形であること**（`HW-TBD-030`の承認内容の2から渡された条件である）。**どちらも正は[power-budget.md](power-budget.md)であり、ここへ再掲しない**）。**2026-08-25の更新**: 選定が2件済み、**3件が残る。**(1) **線材の許容電流の数値がまだ読めていない。**グラフからの読み取りであり、**周囲温度`T`と条数と`η0`を先に決める必要がある**（`η0`は2条・中心間隔`S=d`で0.85。同PDFの1ページ目）。読んだ点を添えて`経路部品と定格`の3行（往路2本とGND戻り）へ入れる。(2) **分岐点の接続部材は未選定であり、2026-08-25の発注に含めていない。**端子台114217は`CABLE-PI-PWR-01`をrail側で受ける分であって分岐点の部材ではなく、**1極あたり3本（入力1・出力2）を受ける形が決まっていない。**(3) `CABLE-PI-PWR-01`は未選定のまま（導体と接点の両方の条件が要る）。**この行はcloseしない**。**2026-08-25の追記**: **分岐点の構成と`CABLE-PI-PWR-01`が決まり、残るのは線材の許容電流の読み取りだけになった。**(1) 分岐の節点は`PROTO-02`（ユニバーサル基板、秋月 通販100517）上のはんだ接続で作り、端子台`114217`を6個（3分岐＋予備3）で各branchを終端する。**はんだ接続に定格は無く、節点の導体は`111641`が決める。**(2) `CABLE-PI-PWR-01`は秋月 通販109314で確定したが、**同品は許容電流もAWGも公開していない。****同日、人間がこの行へ許容電流の公開を求めないと決め、同日その扱いが正本にも入った**（[Hardware Safety Policy](../governance/hardware-safety-policy.md)の`安全要件の5項目`と`5項目以外の扱い`。根拠は[ADR-0014](../decisions/0014-safety-requirements-and-general-values.md)、**`Accepted`**。**ここへ再掲しない**）。**ただし[ADR-0016](../decisions/0016-evidence-bar-inside-the-safety-requirements.md)の`B-2`であり、比較する実在値が無いため`Bで済ませるときの条件`の1を満たしておらず、この行はまだ通っていない**（負荷側のPi branch上界350 mAは実在値だが、導体側が無い。満たす道は[power-budget.md](power-budget.md)の`経路部品と定格`の同行。**ここへ再掲しない**）。(3) **残るのは線材の許容電流の数値の読み取りである**。**2026-08-26の追記**: **その読み取りを実施した。**`0.3sq`曲線の両端をpixel座標から読み、式が`I`を`T1 - T`の平方根に比例させることを使って換算した。基準点は`I(T1 - T = 100 ℃) = 10.0 A`で、**周囲30℃・2条密着（`η0=0.85`）なら約6.6 A**である（周囲25℃で約6.9 A、40℃で約6.0 A）。**数値と読んだ点の正は[power-budget.md](power-budget.md)であり、ここへ再掲しない。****これで`ADR-0016`の`B-2`が求める「比較する実在値」が導体側にも揃った。**`PROT-OC-01`は2026-08-26にヒューズからPTC(`Ihold` 1.35 A)へ変更されている(HW-TBD-021の状態欄が正。ここへ再掲しない)ため、比較の基準は1.25 Aではなく1.35 Aである。**現行の基準(1.35 A)に対しては約4.4〜4.9倍(周囲30℃で約4.9倍、40℃の最悪ケースで約4.4倍)であり、桁ではない。****2026-08-29に、人間がこの倍率を「桁で余裕がある」の基準として足りるとみなし、この点を承認した。**この承認は`WIRE-PWR-01`・`CABLE-PI-PWR-01`双方の導体側許容電流の評価にのみ及ぶ。****この承認は2条密着までである。2026-10-26に、ユーザーが最悪側の条件（周囲40 ℃、6条以内の`S=d`か12本以内の`S=2d`以上）で、`PROT-OC-01`より下流の線について線材3行を確定にすることを承認した。この確定は連続電流の許容電流の値に限り、短絡安全は含まない（短絡時の電流はM-12001の未公開の特性で決まる）。端子台から`PROT-OC-01`までの区間は`TBD`である**（[power-budget.md](power-budget.md)の`線材3行の周囲温度と条数を最悪側に置く（2026-10-26、#525）`。値と条件はそこが正）。**周囲温度`T`と条数・配列は決めていない**（2026-10-26更新：周囲温度と条数は最悪側の条件で置いた（`PROT-OC-01`より下流）。決めていないのは配列である。`T`は`MEAS-04`で実測する量である。Owner: Human）。**残るのは(4) GND戻り経路である。****ただしこれは線材・接続部材の選定作業における残件であって、closeの条件のすべてではない。****`CABLE-PI-PWR-01`の短絡安全の受け入れは未了である。**同品を`B-2`として扱うことは**証拠区分と選定上の評価**であり、**短絡時の故障電流・保護動作・温度上昇に対する安全受け入れを表さない。両者は独立している。****したがって`B-2`が通っても、短絡安全の受け入れが済むまで段階Cのgateは開かない。**条件と判定の正本は[power-budget.md](power-budget.md)であり、**ここへ再掲しない。****この行はcloseしない** **2026-09-08に(4) GND戻り経路を検討し、「確定した」と一度書いたがPM（`deskcat-f2`）のレビューで訂正した。**`GND戻り経路`は往路と同じ電流を通すため線材は往路と同じ`111641`であり、読み取り値（周囲25〜40℃・2条密着で約6.0〜6.9 A）も往路と同一である。**この行自身が「この承認は`WIRE-PWR-01`・`CABLE-PI-PWR-01`双方の導体側許容電流の評価にのみ及ぶ」と明言しており、往路・戻り路の使用箇所を区別していない。同じ導体（`111641`）を戻り経路にも使う以上、この評価はここにも及ぶと判定する。**したがって導体の評価分については新規の人間判断を要さない（この最後の一文はAI判断としてここに明記する）。****2026-10-26：この判断が及ぶのは2条密着までである。最悪側の条件は、同日のユーザー承認が及ぶ（`PROT-OC-01`より下流の連続電流の許容電流の値に限り、短絡安全は含まない）。**ただし残る2点があり、(4)は解けていなかった（2026-09-08時点。2026-10-26に(a)は`PROT-OC-01`より下流の連続電流の許容電流の値について最悪側の条件で確定し（短絡安全は含まない）、(b)が残る）。**(a) 周囲温度`T`と条数・配列は未確定のまま残る（2026-09-08時点。`T`は`MEAS-04`で実測する量である。Owner: Human）。(b) 同経路は`GND topology`節の構成に従うが、star point構成そのものの確認が別に残る（`power-budget.md`の`方式1で残っている未解決3点`の3）。**2026-09-12に訂正した。**旧文は「変換基板が揃うまで完了しない（…段階B-1での通電確認）」で、**2026-09-09の案B決定を反映しておらず、かつ確認がどの段階の何に当たるかをこの行が独自に述べていた。前提・段階・確認方法をこの行では述べない。**正は[power-budget.md](power-budget.md)の`GND戻り経路（各railからstar pointまで）`行と`方式1の記録係をこのtopologyへ足すとき（HW-TBD-034 作業3）`。**ここへ再掲しない。****`CABLE-PI-PWR-01`の短絡安全の受け入れも別に残る。**この項目は2026-09-08にPM（`deskcat-f2`）が`HW-TBD-021`の詰まり（変換基板側の嵌合接点1.5 Aが`PROT-OC-01`のItrip直上での遅いtripに耐えるか）と同根と判定し、**`HW-TBD-007`の着荷後の現物確認項目（変換基板`VBUS`を複数pinへ渡せるかの現物確認）待ちとした。**ただし2026-09-08のCodeRabbit `full review`指摘（[PR #369](https://github.com/wachi-yoshitaka-11-dev/deskcat/pull/369)）を受け訂正する。**この現物確認が解くのは変換基板側の嵌合接点（ingress側）の実効定格だけである。**`CABLE-PI-PWR-01`自身（downstream側のcableとPi側嵌合接点）が`PROT-OC-01`のトリップまでの故障電流・保護動作・温度上昇に耐えるかは、この現物確認では証明されない別の証拠が要る**（`power-budget.md`の`HW-TBD-022`を閉じるために残っていることの3が「Pi側の嵌合接点の定格は`TBD`のまま残る」と明記するとおり）。**したがってこの項目は、変換基板`VBUS`の現物確認・`GND topology`のstar point構成確認に加え、`CABLE-PI-PWR-01`downstream側の独立した安全受け入れの3点すべてが揃うまでこの行はcloseしない** **2026-09-09に人間が設計判断を決定した（案B、`WORK-INSTRUCTIONS-INGRESS-PLAN-B.md`）。**M-12001の出力cableをMicro-Bプラグの手前で切り、端子台（`114217`）へ直接ネジ止めする。これにより`変換基板側の嵌合接点`という要素自体が経路から外れ、上記3点のうち1点目（変換基板`VBUS`の現物確認）は対象を失う。**残る2点（`GND topology`のstar point構成確認、`CABLE-PI-PWR-01`downstream側の独立した安全受け入れ）はこの決定の影響を受けず、そのまま残る。****`CABLE-PI-PWR-01`の短絡安全の受け入れ（A1）はこの決定では解けない**（Pi側の嵌合接点はingressの経路変更と無関係にTBDのまま残る。追跡は`HW-TBD-007`）。**2026-09-10、ユーザーがM-12001の出力cableをMicro-Bプラグの手前で切り、端子台（`114217`）へ直接ネジ止めした**（極性判定の記録は[experiment-log.md](experiment-log.md) `EXP-012`）。**通電はまだ行っていない。**`WIRE-PWR-01`（`111641`）・`CABLE-PI-PWR-01`側の選定・許容電流評価はこの作業の対象外であり、引き続きこの行が扱う範囲として残る **2026-09-17追記（[#424](https://github.com/wachi-yoshitaka-11-dev/deskcat/issues/424)）。**2026-08-26の追記が`CABLE-PI-PWR-01`について述べる証拠区分の評価（[power-budget.md](power-budget.md)の該当行が持つ）と、短絡時の故障電流・保護動作・温度上昇に対する安全受け入れは、独立した別の判定である。**証拠区分の評価が通っても、短絡安全の受け入れが済むまで段階Cのgateは開かない。**過去の記録は書き換えていない **2026-10-06追記（[#446](https://github.com/wachi-yoshitaka-11-dev/deskcat/issues/446)）。**段階Aと段階B-1のPiの給電に使う`CABLE-PI-A-01`も、この行で追跡する（2026-10-11に給電経路から外れた。[hardware-bom.md](hardware-bom.md)の`CABLE-PI-A-01`）。**後継の`PSU-PI-A-02`のcable一体の線も、短絡安全の対象経路として、この行で追跡する**（許容電流は未確認。[hardware-bom.md](hardware-bom.md)の`PSU-PI-A-02`）。 |
| HW-TBD-026 | P0 | **SG90の電気的駆動条件。**(a) 制御logic要件（ESP32のGPIOは3.3 Vだが、SG90のlogic閾値が未確定であり、3.3 V driveで確実に動作するかを判定できない。[servo-safety-limits.md](servo-safety-limits.md#サーボ識別情報)は現物確認まで確定しないとしている）、(b) PWM周期／rate（50 Hzは一般値であり、確定値として採らない）、(c) 許容最小／最大pulse幅（データシート由来の電気的な駆動範囲。**機械的可動域は`HW-TBD-010`**）。**Stall／peak電流と無負荷／動作電流の実測は`HW-TBD-010`／`HW-TBD-011`の範囲であり、この行では重複させない**。**2026-08-24に一次資料を確認した。結論は「(a)(b)(c)のいずれも一次資料に記載が無い」である。****まず公式のdatasheet PDFが存在しないことが確定した。**[TowerPro公式のDownload](https://towerpro.com.tw/download/)にファイルの掲載がなく、製品ページにも`.pdf` linkがない。**したがって一次資料は製品ページの仕様表だけである。**仕様表が載せているのは`Operating voltage: 4.8v`、`Stall torque: 1.8kg/cm(4.8v)`、`Operating speed`、`Dead band width: 1us`、`Temperature range: 0℃-55℃`、重量・寸法・gear種別・plug種別・wire長であり、**logic閾値（V_IH／V_IL）、PWM周期／rate、許容pulse幅の3つはどこにも無い。****項目別**では次のとおりである。**(a) 記載が無い。**したがって**3.3 V driveの可否をこの資料では判定できず、level shifterの要否も決まらない。****「一般に3.3 Vで動く」という情報は一次資料ではないため採らない**（[AGENTS.md](../../AGENTS.md) 推測禁止）。判断は人間へ渡す。**部品を先に決めない。****(b) 記載が無い。**`50 Hz`は出所を持たない一般値のままである。**(c) 記載が無い。****しかも2026-08-24の再検証で、メーカーが直接聞かれても答えていないことが分かった。**`sg90-7`のQ&A欄で客が2022-03-02に「What is the range for the pulse width to control the angle? Online it says 1ms-2ms but that doesn't seem to cover the full 180 degree range.」と質問しているが、**同日の`admin`の回答はpulse幅に触れず、角度の話に替わっている。**得られたのは`Dead band width: 1 us`の1点だけであり、**これは許容pulse幅範囲ではなく範囲の内側の分解能に当たる量である。この値からpulse幅範囲を導かない。****さらに、適用する一次資料のページ自体が特定できないことが判明した。**公式サイトには同名で**2品**ある。`SG90 Digital`（`Operating speed: 0.1sec/60degree(4.8v)`）と`SG90 Analog`（同`0.12sec/60degree(4.8v)`）で、torque・電圧・dead band・寸法・温度範囲は同一である。**現物ラベル`TOWER PRO Micro servo 9g SG90`はこの2品を区別しない。**`HW-TBD-006`（正確なservo model）の解決記録はDigital側のページだけを引いている。[hardware-bom.md](hardware-bom.md) `SERVO-01`は2026-08-24に両ページを併記したが、**どちらの品かは未確定のままである。****`HW-TBD-006`は解決済みであり、この行では再openしない。**どちらの品かの判断と、`HW-TBD-006`を再openするかの判断は人間へ渡す。**なお(a)(b)(c)は2品で差の出る項目ではなく、どちらのページにも記載が無い。****したがってこの判別が付いても(a)(b)(c)は埋まらない。****2026-08-24の生HTML再検証で、variantについて2件追加で判明した。**(1) **同名の製品は2つではなく3つある。**`SG90 360 degree`（連続回転、SKU`SG90 360 degree`）が別に存在する。寸法が`23×12.5x22mm`で他2品の`23×12.2x29mm`と異なり、`Operating Angle: 360 degree`・`Direction: CCW`を持つため**現物とは別物と見られるが、断定していない**（現物の寸法を測っていない）。(2) **`Operating speed`でDigital／Analogを判別する根拠は弱い。**Analog側ページは箇条書きが`0.12 sec/60degree(4.8v)`だが、**同一ページの`PRODUCT CONFIGURE TABLE`は`Speed(sec/60deg) 0.1`と書いており、ページ内で矛盾している。****一次資料が自己矛盾しているため、速度の実測で品を判別できるとは言えない。****さらに、`4.8–6 V`と`0.5–2 A`の出所はDigital側ページに限られる。****Analog側ページは`Reviews (0)`であり、この2つの値はどちらもDigital側にしか無い**（2026-08-24確認）。**出所の格は2026-08-24の生HTML再検証で1段上がった。****匿名のreviewではなく、`admin`（メーカー側）の回答である**（2021-11-07。`The operation current for our SG90 is about 0.5A - 2A. Voltages from 4.8V - 6V are fine.`）。**それでも仕様表の値ではなくQ&A欄の記述であり、`Operating voltage`の仕様表記載は`4.8v`だけである。****したがってこの2値は、どちらの品かが未確定な状態で、片方の品のページのreview欄だけを出所とする値である。****variantに依存しない定格として扱わない。**`定格電圧範囲`を`TBD`へ戻すか、`Peak／stall電流`を実測まで`TBD`とするかは、**closeした`HW-TBD-006`の扱いと`HW-TBD-010`／`011`の範囲に掛かるため、この行では判断しない。人間へ渡す。****あわせて、この行の範囲外だが`HW-TBD-010`（機械的可動域）に関わる記述をQ&A欄で見つけた。**`admin`が2022-03-02に**「all of our normal servos are operating 0-150 degrees unless specify 180 or 360 degrees」**と述べている。**メーカーが可動域を0〜150度と言っており、hobby servoで一般に前提される180度を否定している。****この行では値として記録しない**（機械的可動域は`HW-TBD-010`であり、`HW-TBD-026`と重複させない）。**`HW-TBD-010`のcalibrationは監視下の実測で決めるものであり、この記述を確定値に採らない。**事実の存在だけを人間へ渡す。**なお、同じ`データシート値`という誤帰属が`HW-TBD-006`の解決記録にも残っていた**（`定格電圧4.8–6 V、stall電流はデータシート値0.5–2 A`）。**2026-08-26に訂正した（[#193](https://github.com/wachi-yoshitaka-11-dev/deskcat/issues/193)）。値は変えておらず、close済みの行を再openしたのでもない。**この行で記録したのは値ではなく、一次資料に何が有って何が無いかである**（[servo-safety-limits.md](servo-safety-limits.md#サーボ識別情報)が「datasheetの代表値を確定値として採らない」と定める） | **メーカー資料では(a)(b)(c)は埋まらないことが2026-08-24に確定した。**公式のdatasheet PDFが存在せず、一次資料である製品ページの仕様表にこの3項目の記載が無いためである（`HW-TBD-023`(a)と同じ構造。**メーカーが公開していないものを推定で埋めない**）。**残る手段は無負荷試験と実測だけであり、それは007／009によりBlockedである。****「datasheetが無い」の検証方法を明記する。**要約に依らず生HTMLで確認した。`robots.txt`が指す`wp-sitemap.xml`からsite全体の**203 URLを列挙し、`.pdf`は0件**。SG90の3ページと`/download/`の生HTMLに**`.pdf`へのlinkが0件**、**`datasheet`／`data sheet`／`spec sheet`の語も0件**。**いずれもHTTP 200で実体を取得しており、403や空応答ではない**（2026-08-24）。根拠とした一次資料は[TowerPro公式 SG90 Digital](https://towerpro.com.tw/product/sg90-7/)、[TowerPro公式 SG90 Analog](https://towerpro.com.tw/product/sg90-analog/)、[TowerPro Download](https://towerpro.com.tw/download/)（いずれも2026-08-24取得）である。**第三者掲載の`Soldered_101246.pdf`を一次資料に採らない。**TowerPro発行と確認できず、取得もできないためである（詳細と扱いは[hardware-bom.md](hardware-bom.md) `SERVO-01`が正）。**(a)については、閾値が確定しないままlevel shifterの要否を決めない。**要件は[servo-safety-limits.md](servo-safety-limits.md#サーボ識別情報)の識別情報表 | `SERVO-PWM`の駆動条件の確定、servoの実機動作全般 | [#17](https://github.com/wachi-yoshitaka-11-dev/deskcat/issues/17) | Joint | Open（**データシートから確定できる部分は2026-08-24に着手し、完了した。結果は「(a)(b)(c)のいずれも一次資料に記載が無い」であり、値は1つも確定していない。**この行に残るのは無負荷試験を要する範囲であり、**007／009によりBlocked**である。**あわせて人間へ渡す判断が残る**（level shifterの要否、どちらの品か、review欄由来の値の扱いなど。**全数はこの行の`不足している情報／判断`欄が正であり、ここで数え直さない**）。**2026-08-25に、3品目`SG90 360 degree`の除外／該当を決める判定基準を確定した。判定は寸法で行う。****これは「現物の品の特定」の全体を解く基準ではない。**寸法で決まるのは3品目かどうかだけであり、**`Digital`と`Analog`の分離は寸法では不可能である**（両者は`23×12.2x29mm`で同一）。仕様表の`Dimension`は`23×12.2x29mm`（`Digital`／`Analog`）に対し**`23×12.5x22mm`（`360 degree`）**であり、**高さが29 mmと22 mmで7 mm違う。定規で判別できる。**幅と奥行の差は0.3 mm（`12.2`対`12.5`）しかないため**判定に使わない。****3ページの仕様表を一次資料から直接再確認した**（2026-08-25。生HTMLを取得して`Dimension`行を読み、`Digital`＝`23×12.2x29mm`／`Analog`＝`23×12.2x29mm`／`360 degree`＝`23×12.5x22mm`を確認した）。**同時に、3品目の仕様表だけが持つ項目も確認した**（`Operating Angle: 360 degree`、`Direction: CCW`、`Control system: Digital`、`Stall torque: 1.3kg/cm(4.8v), 1.5kg/cm(6V)`、`Operating speed: 110RPM(4.8V);130RPM(6V)`、`Operating voltage: 4.8v-6V`、SKU`SG90 360 degree`）。**他2品は`Stall torque: 1.8kg/cm(4.8v)`で`Operating speed`は`sec/60degree`表記である。****ただしこれらはいずれも通電または治具を要するため、判定には使わない。判定は寸法だけで行う。****SKU名だけで断定しない。**現物ラベルは`TOWER PRO Micro servo 9g SG90`であり`360 degree`の文字が無いが、**ラベルがSKU全体を載せるとは限らないため、状況証拠にとどめる。寸法を主根拠、ラベルを補強とする。****2026-08-28に高さを実測した（[Issue #257](https://github.com/wachi-yoshitaka-11-dev/deskcat/issues/257)。27 mm）。**[PR #258](https://github.com/wachi-yoshitaka-11-dev/deskcat/pull/258)がIssue本文の記述をこの行へ反映し漏らしていたため、2026-08-29に反映する。**測定条件（2026-08-29に追記で判明）: 器具はメジャー（巻尺）、端点は筐体の底面から出力軸側の最上部まで。**メジャーは目盛りの読み取りと先端フックの遊びにより、この程度の寸法では定規より誤差が乗るが、**具体的な誤差値は校正されていないため確定値として書かない。**それでも`SG90 360 degree`の仕様値22 mmとの差5 mmは、想定しうる読み取り誤差を超える。**`23×12.2x29mm`（Digital／Analog）との差2 mmについては、仕様表がどの端点を基準に29 mmとしているかが不明であり、この差はその不明に由来しうる。断定しない。****`23×12.2x29mm`（Digital／Analog）側に近く、`23×12.5x22mm`（360 degree）との差5 mmより有意に近いため、`SG90 360 degree`ではないと判定した。****`Digital`と`Analog`の分離は試みない。**両者は寸法が同一で外形では分けられず、分離できる量（`Operating speed`など）は通電を要して`007`／`009`によりBlockedであり、**かつ`HW-TBD-035`の判断には影響しない**（どちらも仕様表は`4.8v`単独）。**`Digital`／`Analog`のどちらかは未確定のまま残る。この行はcloseしない**）。**2026-09-22追記（初回動作着手に伴うユーザーの決定）。**ユーザーが、`Digital`／`Analog`の識別を確定させずに初回動作へ進めることを決定した（現物袋の表示`TH270`が識別の手がかりにならないことは、`HW-TBD-035`行の2026-08-30の調査記録が正であり、ここへ再掲しない）。**「識別できた」のではない。「識別を要さない構成で進める」というユーザーの判断である。**根拠: 本行が既に確認したとおり、両ページの`Operating voltage`・`Stall torque`・`Dead band width`は同一であり、(a)(b)(c)（logic閾値・PWM周期／rate・許容pulse幅）はどちらのページにも記載が無い。したがってDigital／Analogいずれであっても、駆動に使う標準的なhobby servo信号（約50 Hz、パルス幅1〜2 ms。**いずれも一般値であり、この決定によって確定値へ格上げしない**）の前提は変わらない。両者の相違として一次資料から確認できるのは`Operating speed`（Digital`0.1sec/60degree`／Analog`0.12sec/60degree`）だけであり、**本行が既に指摘したとおりAnalog側ページ内で`0.1`とも`0.12`とも矛盾表記があるため、速度による判別根拠は弱い。**したがって相違は動作時の観察でしか確認できない量として扱う。**この決定は(a)(b)(c)を1つも埋めない。**gateの状態、`Digital`／`Analog`未確定の扱い、この行をcloseしない判断はいずれも変えない） |
| HW-TBD-027 | P0 | **`RES-PULL-01`（`SERVO-PWM`の外部pull-down）の抵抗値と本数。**GPIO27はreset時にhigh-Zであり、外部pull-downはPWM driver初期化前にservoが不定pulseを受けないための**必須**部品である。それにもかかわらず抵抗値が未選定である。**部品は10 kΩと4.7 kΩが各1袋2026-08-08に着荷しており、未購入ではない**（[hardware-bom.md](hardware-bom.md) `RES-PULL-01`）。**残るのは必要な本数と抵抗値の選定と実装であり、手元の2種で足りるとは限らない。****この行は`TBD`セルではなく、同じ行の登録時の記述「未購入・未選定」から登録した**（**同記述は2026-08-15に「一部入手済み・未選定」へ訂正済みである。登録根拠として引いた文言は現在のBOMには無い**）（[区別の基準](#区別の基準)） | 抵抗値の選定（ESP32のGPIO駆動能力とservo側入力インピーダンスから決める）。要件は[gpio-assignment.md](gpio-assignment.md#信号inventory)の`SERVO-PWM`行、部品は[hardware-bom.md](hardware-bom.md) `RES-PULL-01`（**同部品は`LCD-RST`／`LCD-CS`のpull-upもまかなう。そちらは`HW-TBD-032`**）。**選定だけではcloseしない。**必要な根拠は[HW-TBD-027の証拠契約](#hw-tbd-027の証拠契約)に定める。**値を決めた文書だけでcloseすると、pull-downが実装されていないのに`HW-TBD-019`のBlockedが外れる** | 初回統合通電、`HW-TBD-019`の起動時状態の確定 | [#2](https://github.com/wachi-yoshitaka-11-dev/deskcat/issues/2) | Human | Open（**2026-08-25に証拠契約の項目1（抵抗値と本数の選定）を満たした。`4.7 kΩ`×`1本`である。****2026-08-26に人間が、この抵抗値を一般値で開始してよい側に置くと決めた**（正本は[hardware-safety-policy.md](../governance/hardware-safety-policy.md)の対応表。「pull-upとdecouplingの値」と「サーボPWM、可動域、速度、加速度」の両方に読めたため判断を要した）。**pull-down自体が必須であることは変わらない。**導出は[gpio-assignment.md](gpio-assignment.md)の`起動時状態を確定させる外部pull`節にあり、**ここへ再掲しない。**reset時のGPIO27が`oe=0, ie=0`＝**内部pullが無い真のhigh-Z**であることをESP32 Datasheet v5.3の`IO_MUX`で確認した。**上限は計算できない。**SG90の`logic閾値`が一次資料に無いため（`HW-TBD-026`(a)）「Lowと解釈される上限電圧」が得られない。**そのため、駆動側の下限に余裕がある範囲で未知に強い側（低い値）を採った**（4.7 kΩでの駆動負荷は`IOH` typ 40 mAの1.8 %、既知漏れによる持ち上がりは0.235 mV）。**残るのは証拠契約の項目2〜4である**（購入は不要。10 kΩと4.7 kΩが各1袋100本入で着荷済みのため、**項目2は`残作業`の`未購入`を消す作業に相当する**）。**2026-08-29に、初回通電後のGPIO27を実測した（[gpio-assignment.md](gpio-assignment.md)のRevision 23）。0 Vであり、pull-down正常。USB抜き差しによる再現性も確認した。**ただし**証拠契約の項目4が求める測定条件（ESP32をresetに保持した状態で測る）を厳密には満たしていない。**測定はUSB電源投入直後の値であり、この board にfirmwareが書き込まれているかを確認していない。**firmwareが書き込まれておらずGPIO27を能動的に駆動していないなら条件を満たすが、確認できていないため、**項目4は「満たした」とは言わず、この制約つきの実測として記録するにとどめる。**同日改めて、**証拠契約の項目4が求める条件を満たす実測を行った。**servoは接続せず、servo電源も投入していない。**人間がESP32のENピンを押し続け、resetに保持した状態**（reset保持中はGPIO27が`oe=0, ie=0`のhigh-Zになることが保証されるため、firmwareの書き込み状態は条件に影響しない）で、`SERVO-PWM`（GPIO27）の信号線（緑線）とGND（オレンジ線）の間をテスターDT830B（**DC電圧20Vレンジ**）で測定し、**0.00 Vだった。**測定条件（servo未接続・servo電源未投入・ESP32をresetに保持）を満たした実測である。**ただし判定閾値は`HW-TBD-026`が決まるまで確定しないため、この値だけで「Lowである」とは結論しない。**証拠契約の項目4はこれで満たした。**項目2・項目3の状態はこの追記では確認・変更していない。****判定閾値は`HW-TBD-026`が決まるまで確定しないため、この行は026より先にcloseできない**） |
| HW-TBD-028 | P1 | **電源品質の数値制限。**(a) Pi入力で許容する最低電圧、(b) ESP32入力／3.3 Vで許容する最低電圧、(c) 最大定常ripple、(d) 最大transient droopと継続時間、(e) connector／wireで許容する最大温度上昇。**許容するbrownout／reset回数は0回で確定済みであり、この行に含めない。****2026-08-12に5項目とも規則を定義した。数値が確定したのは(d)の継続時間0だけである**（値の正は[power-budget.md](power-budget.md#受け入れ条件)の`電源品質の数値制限`節。**ここへ再掲しない**）。残りは下記のとおり他の行に従属するか、一次資料が存在しない | **実測ではなく定義が先である。**各deviceのdatasheetの動作電圧範囲と絶対最大定格、および線材・connectorの温度定格から上限・下限を定める。実測はその後の受け入れ試験で照合する。要件は[power-budget.md](power-budget.md#受け入れ条件)が挙げている一覧。**2026-08-12時点の項目別の状況は次のとおり。****(a) 一次資料が存在しないことを確認した。**Raspberry Pi公式documentationは`All models require a 5.1V supply`と述べるのみで許容範囲も最低電圧も示さず、Zero W向けのproduct briefとreduced schematicsも公開されていない。**低電圧検出のしきい値4.63 Vは`except the Zero range`と明記されており、このboardに適用されない。二次情報でも代用しない**（[AGENTS.md](../../AGENTS.md) 推測禁止）。**帰結として段階AでPiの低電圧を判定する手段が二重に無い**（判定値が無く、Pi自身の検出回路も無い。[power-budget.md](power-budget.md)の`Pi Zero Wには低電圧検出が無い`）。**(b)** ESP32 boardの5 V入力は参照設計のdropout最大1.3 Vから4.6 Vと導いたが、**参照設計由来であり現物の`U2`は未確認である**（`HW-TBD-023`）。3.3 V rail側は`HW-TBD-025`(a)に従属する。**(c)(d)** 推奨動作条件が瞬時値の制約であることから導出規則を定めた。深さは(a)(b)の下限に従属する。**(e)** 規則だけを定めた。経路部品が未選定のため数値は`HW-TBD-021`／`HW-TBD-022`／`HW-TBD-007`に従属し、**一次資料に無い温度上昇値を代わりに置いていない**。**照合できる段階の対応表も同節に置いた。****測れる段階・測定のgate・合否判定を別の列に分けている**（(a)は段階A、(b)は5 V入力側が段階B-1で3.3 V rail側が段階B-2、(c)は段階A／B-1と段階Cを分ける、(d)(e)は段階C。**段階AとB-1はgateも追加購入も要らない**）。**ただし合否判定は5項目とも`Blocked`である。**測定はgateさえ満たせば進められるが、判定には確定した閾値と検証済みの測定系の両方が要り、現状はどの項目も揃っていない。**測定値を記録してよいが、そこから受け入れの合否を導かない。****2026-08-16に、測定方式の独立性と合格主張を張ってよい範囲を`HW-TBD-034`として分離した。**この行が扱うのは**数値**であり、034が扱うのは**測定方式と主張の範囲**である。**ここへ034の内容を再掲しない。****2026-08-25に、5項目それぞれが「確定済み」「どの行に従属するか」「一次資料が存在しないのか」のどれなのかを、正本の表の列として揃えた**（[power-budget.md](power-budget.md)の`電源品質の数値制限`。**数値は1つも追加していない。**既に本文と状態列にあった従属関係を項目ごとに書き出したものである。**列の内容をここへ再掲しない**）。**あわせて(e)について、一次資料が存在しない要素が1件確定した。**`HW-TBD-021`で選定したヒューズホルダである（**確認の内容と根拠は[power-budget.md](power-budget.md)の`経路部品と定格`のヒューズホルダ行が正。ここへ再掲しない**）。**この要素は従属先が解けても数値が出ない** **2026-09-13訂正。**この(e)についての記述（2026-08-25の追記）は現在成立しない。**2026-08-26に`HW-TBD-021`の方式がヒューズ＋ホルダからPTC（`MF-R135`）へ変更され、ヒューズホルダは経路要素そのものが無くなった。**正本は既に反映しており、[power-budget.md](power-budget.md#受け入れ条件)の`電源品質の数値制限`の(e)行が、**以前その(e)行に記録していた一次資料無し要素は無くなったと明記している**（逐語ではない。**ここへ再掲しない**）。**同表の(e)行の分類は`従属`であって`一次資料無し`ではない。****あわせて、根拠として名指しした`経路部品と定格`のヒューズホルダ行は現在存在しない**（**[power-budget.md](power-budget.md)には同行を「正」と指す記述が2件残るが、いずれも`方式と品番を決定した（2026-08-25）`節の中にあり、同節は冒頭で2026-08-26の方式変更を明示している。この訂正では扱わない**）。**(e)が`HW-TBD-021`／`HW-TBD-022`／`HW-TBD-007`へ従属したままであることは変わらない。** | 電源系の受け入れ承認、合成給電（段階C）の合否判定 | [#3](https://github.com/wachi-yoshitaka-11-dev/deskcat/issues/3)、[#525](https://github.com/wachi-yoshitaka-11-dev/deskcat/issues/525) | Joint | Open（**規則は5項目とも定義済み。数値は(d)の継続時間0のみ確定。**(a)は一次資料が無いため確定せず、(b)〜(e)は`HW-TBD-004`／`023`／`021`／`022`／`007`と、`HW-TBD-025`(a)の下限の両立に従属する。**照合（実測）は未着手である。段階A／B-1は他のgateを要さずに測れるが、測れることと合否を判定できることは別である。**(a)は判定値も測定系も無いため、段階Aで得た値から受け入れの合否を導かない。**(c)(d)は閾値が確定しても`HW-TBD-034`が解けるまで合否を判定できない。****2026-08-25に5項目の内訳を正本の表へ列として明示した**（確定は(d)の継続時間0と(b)の5 V入力側、一次資料無しは(a)と(e)のヒューズホルダぶん、残りは従属。**2026-09-13訂正: (e)のヒューズホルダぶんは、正本側で2026-09-07に取り消されている**（[power-budget.md](power-budget.md) Revision 91。**2026-08-26はPTCへの方式変更の日であって、正本が(e)を取り消した日ではない**）。**どの項目が`一次資料無し`かは、正本の`電源品質の数値制限`の分類列が持つ。****正は[power-budget.md](power-budget.md)であり、ここへ再掲しない**）。**Ownerは`Joint`のままである。**2026-08-25時点ではこの行に「数値をAIが決めない」と書いていたが、**2026-09-06にPM（`deskcat-f2`）が(a)を受け入れ試験の閾値として要求しない（要件から外す）と決定した。**根拠・範囲（Pi側の(c)(d)も対象外、ESP32側の(b)(c)(d)と`HW-TBD-007`／`HW-TBD-009`と`#247`の診断は対象外にしない、(d)の継続時間0は確定のまま）・復帰条件の正は[power-budget.md](power-budget.md#受け入れ条件)の`(a)を要件から外す（2026-09-06、PM決定）`節。**ここへ再掲しない。**この決定に至る過程で一度(a)へ暫定値4.63 Vを置き取り下げた経緯（PMが`power-budget.md`の`(a)の一次資料は存在しない`節を読まずに決定したことが原因。PM自身が発見しrevertした）も同節に記録した。**(a)以外の数値・判定は、AIが提案し人間が承認する形で決める**）**2026-10-04追記。**可変・電流制限付き電源の購入がユーザーから申告された（[hardware-bom.md](hardware-bom.md#ベンチ電源)の`PSU-BENCH-01`）。現物確認・使用・最低入力電圧の測定の記録は未取得。復帰条件に関する現在の扱いは[power-budget.md](power-budget.md#受け入れ条件)の同日追記を参照する。OwnerとOpenの状態は変更していない。 |
| HW-TBD-030 | P1 | **逆極性保護の要否と方式。**登録時点は[power-budget.md](power-budget.md)の`配線・保護表`で`TBD`／`Blocked`のまま残っていた（**同行は2026-08-25に`一部確定`へ変えた。**下記）。配線ミス時にPi、ESP32、周辺module3点が同時に破損しうる。**2026-08-12にdesign reviewの材料と推奨案を用意した**（[power-budget.md](power-budget.md)の`逆極性保護のdesign review`節）。**登録時点では決定していない。**採否はAIが提案し人間が承認する。その承認を経るまで確定として扱わない。**要否と方式は2026-08-24に承認された**（状態欄。**行はcloseしていない**）。**2026-08-25に承認内容の1の品番が確定した**（東芝`2SJ334`。[#205](https://github.com/wachi-yoshitaka-11-dev/deskcat/issues/205)。**同日に一度保留され、同日のうちに解除された。**経緯と品の定格の正は[power-budget.md](power-budget.md)の`逆極性保護のdesign review`節内の記録である。**ここへ再掲しない**）。**同日に承認内容の2の手順も作成した**（同文書の`通電前の配線確認手順`）。**1と2は択一ではなく、守る区間が違う** | Design review。**2026-08-12に用意した材料**: (1) 逆接が起こりうる区間の洗い出し。**極性付きconnectorで固定される区間（M-12001→変換基板、rail→Piの`PWR IN`）では起こらず、起こりうるのは手配線区間だけである。**したがって**ingress 1箇所に保護部品を入れても下流の手配線区間は守れない。****この区間の分類は2026-08-24に変わった。**rail側の受け方が②（直付け）で確定してrail側が手配線になったため、**`rail→Piの PWR IN`は`可`である**（正は[power-budget.md](power-budget.md)の`逆極性保護のdesign review`の逆接可否表。**ここへ再掲しない**）。**2026-08-12の材料としての記述は残し、分類の訂正をここに置く。**(2) 方式ごとの電圧降下の代償。**直列Schottkyは5 V予算を食う。ただし採否は確定しない。**比較対象の4.6 Vは`IOUT ≤ 0.8 A`かつ参照設計の`U2`という条件付きの導出値であって確定した合格下限ではなく、**現物の`U2`と実負荷を確認するまで判断できない**（`HW-TBD-023`、`HW-TBD-028`(b)）。P-ch MOSFETによるideal diodeは降下が小さいが品番を選ばないと具体値が出ない。逆並列diode＋fuseは溶断までの間、負荷に逆電圧が掛かる。(3) 推奨案はingressへP-ch MOSFETを置き、**下流の手配線区間は保護部品ではなく極性が固定される接続方法と通電前の配線確認手順で守る**というもので、**2026-08-24に人間がこれを承認した**（状態欄）。**品番と定格は`PROT-OC-01`と同じく発注直前に一次資料で確定する。**(4) **2026-08-25に品番が確定した**（東芝`2SJ334`。[#205](https://github.com/wachi-yoshitaka-11-dev/deskcat/issues/205)。**同日に保留され同日のうちに解除された。**定格と経緯の正は[power-budget.md](power-budget.md)の`逆極性保護のdesign review`節内の記録。**ここへ再掲しない**）。(5) **承認内容の2の実体である通電前の配線確認手順を2026-08-25に作成した。**確認箇所、方法（目視と導通）、記録先、通電前であることの明記、**守る区間と守らない区間の書き分け**を含む（正は[power-budget.md](power-budget.md)の`通電前の配線確認手順`。**ここへ再掲しない**） | 合成給電（段階C）の配線承認 | [#3](https://github.com/wachi-yoshitaka-11-dev/deskcat/issues/3)、[#405](https://github.com/wachi-yoshitaka-11-dev/deskcat/issues/405)、[#525](https://github.com/wachi-yoshitaka-11-dev/deskcat/issues/525) | Human | Open（**要否と方式は2026-08-24に人間が承認した。closeはしない。**承認内容の正は[power-budget.md](power-budget.md)の`逆極性保護のdesign review`の`決定（2026-08-24）`である（**ここへ再掲しない**）。**2026-08-24時点で残っていたのは(1) 品番と定格の一次資料での確定、(2) 通電前の配線確認手順の作成、(3) 極性が固定される接続部材の選定**（`HW-TBD-022`の`WIRE-PWR-01`側で選ぶ）**である。****2026-08-24のreview指摘で、(2)(3)の対象にrail → Piの`PWR IN`区間が加わった。**②（直付け）を採ったことでrail側が手配線になり、端子台でVBUSとGNDを入れ替えるとPiへ逆電圧が掛かる。**ingressのMOSFETより下流であり、承認内容の1では守れない。****方式が決まっただけでは段階Cの配線承認は与えられない。****2026-08-25に(1)の品番が確定し、(2)を作成した**（[#205](https://github.com/wachi-yoshitaka-11-dev/deskcat/issues/205)。品番は東芝`2SJ334`。**同日に保留され同日のうちに解除された。**正は[power-budget.md](power-budget.md)の`逆極性保護のdesign review`節内の記録と`通電前の配線確認手順`）。**2026-08-26に人間がcloseしないと判断した。**判断の理由は下の(ii)〜(iv)であり、**いずれも「記録が足りない」ではなく「実際に守られていない」ものである。****(i) 承認内容を満たしたと見るかは、AIが提案し人間が承認する。2026-08-26時点では「まだ満たしていない」である。****(ii) MOSFETが未実装である。****実装方法（向き、ゲート抵抗の値、基板上の配置）は2026-09-03に決定した**（正は[power-budget.md](power-budget.md)の`実装方法を決定した（2026-09-03）`。**決定しただけであり、実装そのものはまだ済んでいない。**）。**実装されるまで経路に逆極性の保護部品は1つも無い。****(iii) 色分けを成立させる接続部材が未選定である**（`HW-TBD-022`の`WIRE-PWR-01`）。**(iv) `3V3` pin → 周辺module3点の区間について、通電前の配線確認手順を実施した記録が無い。****2026-08-26に同手順の対象へ加えたが**（[#236](https://github.com/wachi-yoshitaka-11-dev/deskcat/issues/236)。正は[power-budget.md](power-budget.md)の`通電前の配線確認手順`の確認箇所表）、**対象に入れたことと実施したことは別である。**実施と記録は段階B-2の実施時であり、まだ行っていない。**なお、この区間を承認内容の1（ingressのP-ch MOSFET）が守らないことは、closeの条件ではない。****MOSFETはingressに1個入るだけであり、下流の手配線区間を守らないのは設計上の限定である。****恒久的に真であるため、close条件に置くとこの行は永久にcloseできない**（2026-08-26に(iv)の書き方を改めた。[PR #238](https://github.com/wachi-yoshitaka-11-dev/deskcat/pull/238)のreview指摘）。**守る手段は2の側であり、2の実施記録を(iv)の条件とする。****この3つが解けたら再度Humanが判断する。**closeの条件は「方式が決まったこと」ではなく「守れる状態になったこと」だと2026-08-26に定めた。**2026-09-04追記: [PR #342](https://github.com/wachi-yoshitaka-11-dev/deskcat/pull/342)のCodeRabbit `full review`の指摘を受け、(ii)の向き（Source/Drain）を訂正した**（内蔵diodeがchannelと並列であるため、旧い向きでは逆接時にchannelがOFFでもdiodeが導通していた。正と検証は[power-budget.md](power-budget.md)のRevision 87）。**(ii)（MOSFET未実装）の状態は変わらない。この行はcloseしない** **2026-09-09訂正: 上の`2026-08-12にdesign reviewの材料と推奨案を用意した`欄が「極性付きconnectorで固定される区間（M-12001→変換基板、rail→Piの`PWR IN`）では起こらず」としていたが、2026-09-09にPM（`deskcat-f2`）の設計判断（案B）により`M-12001 → 変換基板`（現`端子台`）は手配線へ変わり、この前提は成立しない。**同区間の逆接は、PMが基板上の配置を実測で確認したうえでMOSFET（`PROT-RP-01`）が守ると判定した（正は[power-budget.md](power-budget.md)の`逆極性保護のdesign review`の`逆接可否表`。**ここへ再掲しない**）。**過去の記録（2026-08-12時点の材料）は書き換えない。ここに訂正を記す** |
| HW-TBD-034 | P1 | **電源過渡の測定方式と、合格主張を張ってよい範囲。**[power-budget.md](power-budget.md#測定計画)の測定系は`ADC-5V`／`ADC-3V3`をESP32自身のADCで読むが、**そのESP32自身の給電が導かれるrailを測っているため、brownout／resetでsamplingが止まる区間を独立に観測できない。**sample間とburst captureのwindow外にも未観測区間がある。**この状態で「起動時の電源過渡をすべて実測した」とは主張できない。****論点の出所は[#3](https://github.com/wachi-yoshitaka-11-dev/deskcat/issues/3)の2026-08-16の追記であり、この行は同日に登録した。****同日に人間が方式1（独立した外部観測）を採ると決定した。**oscilloscopeは購入せず、手持ちのArduino Uno R3を候補とする。**技術ガイドのゲートAの改訂は不要になった。****数値の項目ではない**（数値は`HW-TBD-028`。**ここへ再掲しない**） | **人間による方式の決定。**材料と全数の改訂対象は[power-budget.md](power-budget.md#測定計画)の`ESP32自身のADCは測定対象から独立していない`と`電源過渡の測定方式のdesign review`に置いた（**値も規則もここへ再掲しない**）。方式1は独立した外部観測を導入する案で、**必要帯域の根拠は`TBD`である**（一次資料が要る。[AGENTS.md](../../AGENTS.md) 推測禁止）。**手持ちのArduino Unoが候補にあり、成立すれば購入は不要になりうる**（[hardware-bom.md](hardware-bom.md) Revision 47）。**2026-08-16に現物の刻印で`UNO R3`／`ATMEGA328P-PU`／`MEGA16U2`まで確定した**（通電なし）。**同日に`DS40002061B`でADCの分解能・sample rate・入力範囲・基準電圧も確定した**（値の正は[power-budget.md](power-budget.md#測定計画)。**ここへ再掲しない**）。**それでも採否は決まっていない。**基準電圧が未解決で**校正か外部基準が要り**、USB給電での動作とGND topologyへの影響も未確認である。**2026-09-14に採否を決定した。**方式1の記録係は**Arduino Uno R3単独**とし、QUIMAT DSO Shellは記録係としては採らない（捨てない）。**提案はPM、承認はユーザー（2026-09-13に取得。正本への反映は2026-09-14）。****採用の範囲は記録係の役割に限り、必要帯域を満たす主張を含まない。**下の項目6（必要帯域の一次資料）は独立に残る。**理由と限定の正は[power-budget.md](power-budget.md#測定計画)の`測定器の採否を決定した（2026-09-14）`であり、ここへ再掲しない。****これにより項目1は解決した。項目2（方式1の実装）は残る。****方式2（ADC loggingへ限定し合格主張を狭める案）は採らないことになった。**ゲートAの合格主張を狭める＝安全側の要求を下げる方向であり、方式1を採ったことで適用先も無くなった。closeには次の全部が要る。**(1) 測定器の採否、(2) 方式1の実装、(3) 基準電圧の校正（または外部基準の採用）、(4) SRAM 2 KBに対する取得方式、(5) GND topologyへの影響の確認、(6) 必要帯域の一次資料、**(6b) Power Treeのschematic粒度の確認**（`F1`／`T1`／`OPAMP`の役割、どちらが電源電流経路に直列でどちらが制御側か、GNDとbackfeed経路の一致。**block図の粒度では足りない**）、(7a) 設計に対して4文書（技術ガイド、[hardware-safety-policy.md](../governance/hardware-safety-policy.md)、power-budget.md、#3）の合格主張が一致したことの確認、(7b) 実配線に対する(7a)の照合し直し。****(1)〜(6)の値と規則の正はpower-budget.mdであり、ここへ再掲しない。****実装と文書整合だけでcloseしない。****(7b)は(2)と(5)の後に行う**。**2026-09-28、ユーザーが[#3](https://github.com/wachi-yoshitaka-11-dev/deskcat/issues/3)を机上の作業と人間の承認だけで閉じると決めた（B案。#3のコメントに記録）。****この行のcloseを#3のcloseと切り離す。**#3が持つのは(7a)である。(5) star point構成の実配線での確認は[#405](https://github.com/wachi-yoshitaka-11-dev/deskcat/issues/405)が持つ。(2) 方式1の実装、(6) 必要帯域の一次資料、(6b) Power Treeの確認、(7b)は、段階Cの初回通電の前提として[#525](https://github.com/wachi-yoshitaka-11-dev/deskcat/issues/525)が持つ（[power-budget.md](power-budget.md)の`サーボ接続前`）。**(7a)が済んでも、この行はcloseしない。** | **[技術ガイド](../DeskCat_Microcontroller_Development_Guide.md)のゲートA**（起動時の電源過渡の実測）、および`HW-TBD-009`（電源予算とbackfeed review） | [#3](https://github.com/wachi-yoshitaka-11-dev/deskcat/issues/3)、[#405](https://github.com/wachi-yoshitaka-11-dev/deskcat/issues/405)、[#525](https://github.com/wachi-yoshitaka-11-dev/deskcat/issues/525) | Human | Open（**2026-08-16に方式1で決定済み。closeはしない。****方式1の技術的な未解決3点のうち、2026-08-22時点で解けたのは(1)と(2)である。(3)はGNDの両極性の確認は解消したが、star point構成の確認が残るため未解決である**（正は[power-budget.md](power-budget.md#測定計画)の`方式1で残っている未解決3点`。**ここへ値も状態の詳細も再掲しない**）。**(2) SRAM 2 KBに対する取得方式は2026-08-17に解けた**（未加工の観測は[experiment-log.md](experiment-log.md)の`EXP-001`）。**(1) 基準電圧の校正は2026-08-22に解けた。**比率法で比を実測し、**AV<sub>CC</sub>の代理値**（`5V` pin）と周囲温度を記録した。**以下の限定は2026-08-22に解消した。当時の経緯として残す。**`5V` pinは`AVCC` pinと同一nodeではなく、当初はその差を測っておらず上限も与えていなかったため、得られた`V_INT`は代理値ベースの推定であって絶対値ではないとしていた（[PR #158](https://github.com/wachi-yoshitaka-11-dev/deskcat/pull/158)の自動reviewの指摘。**限定を書いたうえで解決済みにするのは、限定を書いていないのと同じである**）。**その後、`5V` pinと`AVCC` pin（pin 20）の差を直接測り、上限がテスターのゼロ点以下で、記録済みの不確かさに埋もれることを確認した**（正は[power-budget.md](power-budget.md#測定計画)の`方式1で残っている未解決3点`、未加工の観測は[experiment-log.md](experiment-log.md)の`EXP-005`。**ここへ再掲しない**）。**したがってその不確かさの範囲で絶対値として扱える。****確度を超える主張はしていない。**デジタルテスターのrange別確度は取扱説明書にも本体表示にも無く**確度そのものは取得できないことが確定したため、`最小単位`から不確かさの下限を出している**（正は[power-budget.md](power-budget.md)の`DT830Bの一次資料で分かったこと（2026-08-21）`）。未加工の観測は[experiment-log.md](experiment-log.md)の`EXP-002`。**同日に測定器2品の記載も直した。**テスターの型番は**現物の本体表示`DT830B`**であり、#55以来の`MAS830L`は誤りだった。温度計は**手持ち品で要件を満たし購入不要になった**（[hardware-bom.md](hardware-bom.md)の`MEAS-03`／`MEAS-04`）。**(3) GND topologyへの影響は2026-08-22に段階B-1を実施したが、未解決である。**人間が基板のそばで観察している状態で通電し、**異常は無かった**（異音・発熱・reset・brownoutのいずれも無し）。段階B-1で実測できたのは3項目（ADC値の妥当性、GNDの結合の影響、入力headroom）である。**入力headroomの実測はdividerを外せないことの定量的な根拠になった。****それでも解けていない。理由が2つある。****(i) GNDの両極性の確認は2026-08-22に解消した。**極性を読める手段で測り、**ESP32の`GND`がArduinoの`GND`より低く、ADCの1 LSBより大きいoffsetがADCの死角にあったことが分かった。`GND`の直結はoffsetを縮めるが消さない**（正は[power-budget.md](power-budget.md#測定計画)の`方式1で残っている未解決3点`、未加工の観測は[experiment-log.md](experiment-log.md)の`EXP-004`。**ここへ再掲しない**）。**(ii) star point構成そのものの確認が残る**（値と限定の正は[power-budget.md](power-budget.md#測定計画)の`方式1で残っている未解決3点`、未加工の観測は[experiment-log.md](experiment-log.md)の`EXP-003`。**ここへ再掲しない**）。**2026-08-20に実施可能範囲を確定した。**star point構成は`5V ingress GND`を含み、それは変換基板`PSU-INGRESS-01`で作るものだが**同品は未購入であるため完全な構成は組めない。組める範囲は段階B-1に限られ、そこで確認できるのはPCのGNDが経路へ入る影響までである**（正は[power-budget.md](power-budget.md)の`GND topology（測定前に必ず確定させる）`。**ここへ再掲しない**）。**2026-09-12、この前提が2026-09-09の人間の決定（案B）を反映していないため訂正する。**(a) **ingressは変換基板ではなく端子台でM-12001を受ける**（`PSU-INGRESS-01`は[hardware-bom.md](hardware-bom.md)で`Not used`）。(b) **「同品は未購入」は当時の事実であり、訂正しない**（[hardware-bom.md](hardware-bom.md)の`PSU-INGRESS-01`行が「2026-08-25に発注する品として確定した」と記録しており、この記述の日付 2026-08-20 はそれより前だからである。**発注日そのものは同fileが持たない**。**調達の状態の正は[#205](https://github.com/wachi-yoshitaka-11-dev/deskcat/issues/205)であり、ここへ再掲しない**）。**成立しなくなったのは「変換基板が要る」という阻害要因のほうである。**(c) **端子台への接続は2026-09-10に完了した**（[experiment-log.md](experiment-log.md)の`EXP-012`。**通電は未了**）。**したがって(3)の阻害要因は「変換基板が揃うまで」ではない。(3)が完了していないことは変わらない。残る理由をこの訂正では判定しない。**正は[power-budget.md](power-budget.md)の`方式1の記録係をこのtopologyへ足すとき（HW-TBD-034 作業3）`であり、**ここへ再掲しない。****測定器の採否も未確定である。**2026-09-14訂正: 採否は決定した。**方式1の記録係はArduino Uno R3単独である（`必要な根拠`欄の同日の追記。正は[power-budget.md](power-budget.md#測定計画)の`測定器の採否を決定した（2026-09-14）`）。**項目2（方式1の実装）は残る。****2026-08-20に現物の写真で`QUIMAT DSO Shell`の所持が判明し、**この文書と[power-budget.md](power-budget.md)が#55以来「oscilloscopeは所有していない」前提で候補をArduino Uno R3に限っていたことが誤りだと分かった。**2026-08-21にJYE Techの`DSO150`のmanualを取得したが、**現物は`QUIMAT`であり同一機種である根拠が無いため数値は参考値である。****参考値では`Record length`が固定であり、それが正しければArduinoの連続streamingを置き換えられず、入力もBNC 1系統である。****したがって2品は代替ではなく相補であり、どちらも単独では方式1の要求を満たさない**（2026-09-14訂正: これは2品の能力の比較であって、記録係として採るかどうかとは別である。記録係はArduino Uno R3単独と決定した）****（正は[power-budget.md](power-budget.md)の`2つの手持ち候補は代替ではなく相補である（2026-08-21の材料）`。**ここへ再掲しない**）。**DSO Shellは2026-08-21に初回通電し、画面が表示されることを確認した**（異音・発熱・異臭なし。人間が基板のそばで観察）。**BNCには何も接続しておらず、波形の取得も垂直確度の確認もしていないため、測定器として使えることは確認できていない。****方式と測定器の判断は人間が下すものであり、この行では判断しない。****この3点はcloseの条件の一部であって全数ではない。**close条件は`必要な根拠`欄が持つ。**いずれもUSBを扱える端末が要り、Docs / Review端末では実施できない**） |
| HW-TBD-035 | P0 | **servoへ入れてよい電圧。**`PSU-SERVO-01`はM-12001（5 V）から分岐したservo railであり、**この5 Vをservoへ入れてよいかを確認した文書が無い。**[hardware-bom.md](hardware-bom.md) `SERVO-01`の`定格電圧範囲`は`4.8–6 V`だが、**2026-08-24の一次資料確認で、この範囲の出所が仕様表ではなく`SG90 Digital`ページのQ&A欄にある`admin`（メーカー側）の回答だと判明した**（2021-11-07。`Voltages from 4.8V - 6V are fine.`）。**製品ページの仕様表が載せる電圧は`Operating voltage: 4.8v`だけであり、供給予定の5 Vはこれより上である。**つまり**5 Vの可否は、仕様表ではなくQ&A欄の1文だけに依っている。**しかも**`SG90 Analog`ページは`Reviews (0)`でこの記述が無く、現物がどちらの品かも未確定である**（`HW-TBD-026`）。**そして同名の3品目`SG90 360 degree`は、仕様表そのものが`Operating voltage: 4.8v-6V`を載せている。****つまりどの品かによって、`4.8–6 V`に仕様表の裏付けがあるかどうかが変わる。**3品目は`Operating Angle: 360 degree`の連続回転で寸法も`23×12.5x22mm`（他2品は`23×12.2x29mm`）と異なるため、**現物とは別物である可能性が高い。**2026-08-28の実測（27 mm、[Issue #257](https://github.com/wachi-yoshitaka-11-dev/deskcat/issues/257)）で`SG90 360 degree`ではないと判定した（下の証拠契約の条件1。**Digitalと Analogの分離は未達のまま**）。**[power-budget.md](power-budget.md)の`許容電圧範囲`の積集合は3.3 V railの周辺module3点とESP32の`VDD33`だけを対象としており、servoを含まない。**servo railは5 Vで別系統のため積集合の対象外であるが、**代わりに確認する項目も存在しない。****したがってservoの入力電圧は、どの文書でも適合を確認されていない。**扱いは`HW-TBD-004`の`moduleへ入れてよい電圧`と同じ型である（IC・部品の定格から基板・製品の許容入力を導かない） | **メーカーの一次資料では埋まらない見込みである。**公式のdatasheetが存在せず（`HW-TBD-026`）、仕様表は`4.8v`単独である。**Q&A欄の回答を根拠として採ってよいかは2026-08-26に決まった**（[ADR-0017](../decisions/0017-what-counts-as-a-primary-source.md)。メーカー自身による仕様書以外の記述は3条件を満たすときだけ使える）。**この行の`4.8–6 V`は、その乙の条件2（どの品に対する記述かが特定できる）を満たさないため、現状では採れない。**採れないあいだに残る手段は、(1) メーカーへの問い合わせ、(2) 4.8 Vを供給する構成へ変える、(3) 監視下で5 Vを入れて挙動を観察する、のいずれかである。**(3)は通電を伴うため`007`／`009`のgateに従う。****この行では5 Vを入れてよいと決めない。****closeに必要な記録は[HW-TBD-035の証拠契約](#hw-tbd-035の証拠契約)に定める。**関連は[servo-safety-limits.md](servo-safety-limits.md#サーボ識別情報)の識別情報表と[power-budget.md](power-budget.md)の`許容電圧範囲` | servoへの給電、`SERVO-PWM`の駆動条件の確定、servoの実機動作全般 | [#17](https://github.com/wachi-yoshitaka-11-dev/deskcat/issues/17) | Human | Open（**2026-08-24に登録した。**`HW-TBD-026`の調査で判明した、追跡されていなかった項目である。**2026-08-26に、Q&A欄の回答を根拠として採ってよいかの規則が決まった**（[ADR-0017](../decisions/0017-what-counts-as-a-primary-source.md)。乙は3条件を満たすときだけ使える）。**この行の`4.8–6 V`は、その乙の条件2（どの品に対する記述かが特定できる）を満たしていない**（**下の証拠契約の条件番号とは別の体系である。**理由と追跡先は[HW-TBD-035の証拠契約](#hw-tbd-035の証拠契約)が持つ）。**したがって残るのは規則の判断ではなく品の特定であり、`対応Issue`列を[#17](https://github.com/wachi-yoshitaka-11-dev/deskcat/issues/17)単独へ改めた**（2026-08-26。従来は[#193](https://github.com/wachi-yoshitaka-11-dev/deskcat/issues/193)を併記していた））。**2026-08-25に、証拠契約の項目1のうち「3品目`SG90 360 degree`の除外／該当」を決める判定基準を確定した。****項目1の全体を解く基準ではない。**寸法で分離できるのは3品目だけであり、**`Digital`と`Analog`の判別には使えない**（両者は寸法が同一である）。**その分離は試みない**（通電を要して`007`／`009`によりBlockedであり、かつこの行の判断には影響しない。どちらも仕様表は`4.8v`単独である）。判定は寸法で行い、**高さが29 mm前後なら`Digital`または`Analog`、22 mm前後なら`360 degree`である**（正は`HW-TBD-026`の状態欄。**ここへ再掲しない**）。**3ページの仕様表は2026-08-25に一次資料から直接再確認した。****この判定が[ADR-0017](../decisions/0017-what-counts-as-a-primary-source.md)の段を決める。**`360 degree`なら仕様表そのものが`Operating voltage: 4.8v-6V`を載せているため**甲（メーカーの仕様書）**になり、他2品なら**仕様表は`4.8v`単独で、`4.8–6 V`の出所はQ&A欄の`admin`回答だけ＝乙（メーカー自身による仕様書以外の記述）**にとどまる。**そして寸法の実測は、どちらに転んでも要る。**同policyは**甲についても「どの品に対する仕様書かが特定できること」を要求し、「これは乙の条件2と同じ問題であり、甲だから免除されるのではない」と明記している。****つまりこの実測は、乙の条件2を解くためだけでなく、甲を使う場合の前提としても必要である。****したがって項目1を解かないまま条件4（合否判定の基準）を決めると、根拠の強さを取り違える。****2026-08-28に高さを実測した（[Issue #257](https://github.com/wachi-yoshitaka-11-dev/deskcat/issues/257)。27 mm。正は`HW-TBD-026`の状態欄。ここへ再掲しない）。**[PR #258](https://github.com/wachi-yoshitaka-11-dev/deskcat/pull/258)がIssue本文の記述をこの行へ反映し漏らしていたため、2026-08-29に反映する。**`SG90 360 degree`ではないと判定できたため、[ADR-0017](../decisions/0017-what-counts-as-a-primary-source.md)の段は乙（メーカー自身による仕様書以外の記述）に確定した。****ただし`Digital`と`Analog`の分離はこの実測ではできず、項目1が求める「現物の品の特定」は`Digital`か`Analog`のどちらであるかの1点が未達のまま残る。この行はcloseしない**）。**2026-08-30、人間が袋に`TH270`と印字されていることを報告した。**現物識別（証拠契約の項目1）の新しい手掛かりになりうるため調査した。**結論は「不明」である。**TowerPro公式site（SG90 Digital／Analog／360 degreeの3ページ、Downloadページ）、servodatabase等のSG90関連の実在ページ、主要な販売代理店ページのいずれにも`TH270`という文字列は見つからなかった。**実在が確認できた`TH270`は4件あり、いずれもservoとも本リポジトリの部品とも無関係である**（DMC／Daniels製crimp tool用turret head `M22520/1-12`、Standard Motor Products製throttle position sensor、Sencor製weather station用sensor、Tommy Hilfiger腕時計の型番）。**Web検索toolの要約が「Tower Pro TH270 SG90 Micro Servo」という趣旨の記述を返したことが複数回あったが、実際の検索結果リンクの中にその表題を持つものは1件も無く、要約段階での誤生成と判断した。この記述を採らない**（[AGENTS.md](../../AGENTS.md) 推測禁止。丙にも該当しない出所不明の記述）。**したがって`TH270`は現物識別にも`HW-TBD-035`の根拠にも使えない。**袋の表示自体（`TH270`のみ、他に記載なし）は[hardware-bom.md](hardware-bom.md) `SERVO-01`へ記録した。**項目1の未達（`Digital`／`Analog`の判別）はこの調査によっても変わらない** |
| HW-TBD-036 | P2 | **PiとESP32の間のUART（`PI-UART-TX`／`PI-UART-RX`）で、片方だけ電源が入っているときの回り込みについて、採った対策が安全だという根拠と、GNDを共通にしたときのPC–Pi間の電流経路。**検証の構成では、PiとESP32を別電源で給電する（2026-09-28決定。最終構成の給電経路は[#405](https://github.com/wachi-yoshitaka-11-dev/deskcat/issues/405)の実装設計の見直しで決める）。ESP32の入力の上限はVDD＋0.3 Vであり、ESP32の電源が切れているときにPiの送信線がHighだと上限を超える。**2026-09-28、ユーザーの決定で、対策を手持ち品で決めた。**2本の信号線にそれぞれ直列4.7 kΩ（流れ込む電流は計算で最大約0.7 mA）を入れ、UARTの信号線は両方の電源が入っている間だけつなぐ（電源を切る前に外す）。予期しない電源断（cableの抜け、PCのsleepなど）では手順が働かず、直列抵抗だけが電流を抑える。**残るのは、流れ込んでよい電流がESP32にもPiにも公開されておらず、0.7 mAが安全だという保証が無いこと**と、PC–Pi間の電流経路を確認していないことである。ユーザーはこの弱点を記録したうえで対策を採った。正本: [gpio-assignment.md](gpio-assignment.md)の`Pi–ESP32間のtransport`節 | 流れ込み電流の許容値を示す一次資料、または実測 | なし（2026-09-28以降、信号線の接続は`gpio-assignment.md`の`信号線をつないでよい条件`に従って行い、この行では止めない） | [#446](https://github.com/wachi-yoshitaka-11-dev/deskcat/issues/446) | Joint | 対策を決定済み（2026-09-28、ユーザー決定。購入なし）。保証値が無いことを弱点として記録している。接続を止めないためP2とし、最終構成の給電経路（#405）を決めるときに再評価する。決定の記録: [#488](https://github.com/wachi-yoshitaka-11-dev/deskcat/issues/488) |
| HW-TBD-037 | P0 | **#514のLEDデモ回路・表示の実機成立。**白`OSPW5111B-QR`／赤`OSHR5161A-QR`の各1本を使う。初回デモはGPIO2（白、Highで点灯）／GPIO5（赤、Highで点灯）、各電流制限抵抗`R`（330 Ωの`CF25J330RB`。調達は発注Issue [#538](https://github.com/wachi-yoshitaka-11-dev/deskcat/issues/538)）の直列と10 kΩの起動用pullを使う[回路案](led-514-demo.md)を選んだ。回路の計算は済み、2026-10-12に赤だけ・白だけ・両方の点灯試験を実機で行った（観察は[EXP-025](experiment-log.md#exp-025-追加ledの点灯試験赤だけ白だけ両方)。出所は[#514のコメント](https://github.com/wachi-yoshitaka-11-dev/deskcat/issues/514#issuecomment-6125063215)・[6125489454](https://github.com/wachi-yoshitaka-11-dev/deskcat/issues/514#issuecomment-6125489454)・[6125555742](https://github.com/wachi-yoshitaka-11-dev/deskcat/issues/514#issuecomment-6125555742)）。未了の項目は[回路案](led-514-demo.md)の状態行が持つ。通信断のheartbeat／timeoutは未実装で、白の点灯（通信成立）への切り替えは入れていない。`set_expression`で`happy`を受理したときの赤の1秒点灯と白の点滅は製品buildに入れた（build-onlyの確認までで、実機で動かした記録は無い）。点灯試験用のfirmware（`bringup-led-514` feature）は実機へ書き込んで起動した（[EXP-025](experiment-log.md#exp-025-追加ledの点灯試験赤だけ白だけ両方)。[回路案](led-514-demo.md)の`点灯試験用のfirmware`） | **LEDの2枝を足して通電することへの人間の承認（その電流は安全側の仮定として`3V3`系に数える）。2026-10-12にユーザーが承認した（[#514のコメント](https://github.com/wachi-yoshitaka-11-dev/deskcat/issues/514#issuecomment-6124265343)）**（`HW-TBD-023`の例外は、#445と#461に、LEDの2枝（#514）を足した。判断材料は[回路案](led-514-demo.md)の`3V3 pinへ負荷を足す条件`）。`RES-LED-01`の接続前の実測は、2026-10-12のユーザーの判断で取りやめた（[#538のコメント](https://github.com/wachi-yoshitaka-11-dev/deskcat/issues/538#issuecomment-6124219128)）。赤→白→2本の順の通電・起動・点灯の観察は2026-10-12に行った（[EXP-025](experiment-log.md#exp-025-追加ledの点灯試験赤だけ白だけ両方)）。残るのは、[回路案](led-514-demo.md)の状態行にある未了の項目である。段階C（合成給電）の境界はLEDの差分を[Power Budget](power-budget.md)の`#514のLEDを追加する場合の差分`で計算した（23 ℃で`x < 215.6 mA`。実測前）。LED電流の実測後に見直す（読みを合否に使うかは[Power Budget](power-budget.md)の`電流の測定点と読みの確かさの基準`に従い、`DT830B`の読みは合否に使わない。条件は[#525](https://github.com/wachi-yoshitaka-11-dev/deskcat/issues/525)が持つ）。protocolの継続通信を実装・検証し、製品buildの`happy`受信と合わせて、Pi停止・再接続・撫で操作を実機で確認する。白が暗い場合は駆動回路を見直す | LEDの配線・通電・hardware依存driver・統合表示。用途と本数はユーザーが承認済み。色の割当て、抵抗の型番、初回デモ回路はAIが選定し、人間の承認はまだ無い | [#514](https://github.com/wachi-yoshitaka-11-dev/deskcat/issues/514)、[#538](https://github.com/wachi-yoshitaka-11-dev/deskcat/issues/538) | Joint | Open（2026-10-01。2026-10-12に、通電の承認と点灯の観察を記録した（[EXP-025](experiment-log.md#exp-025-追加ledの点灯試験赤だけ白だけ両方)）。[回路案](led-514-demo.md)の状態行にある未了の項目と、protocol連携が残る） |

## 現在状態と根拠の読み方

以下の4項目は現在の判定を短く記載し、以前の行全文を[判断記録](tbd-register-history.md)へ移した。
判断記録の古いOpen／Blockedや「まだ無い」は当時の記述であり、現在状態を更新する場所ではない。
値・安全条件の正本は各行のリンク先、状態と妨げる対象はこの台帳が持つ。

### HW-TBD-004

| 項目 | 現在の判定 |
|---|---|
| 優先度 | P0 |
| 不足している情報／判断 | 実装済みI2C address（SDO配線で選ぶ）。header〜ICの経路は未確認 |
| 必要な根拠 | [現物確認・経緯・承認（回答の原文は省略）](tbd-register-history.md#hw-tbd-004)。moduleへ入れてよい電圧の判定は済み。正しく製造された個体を前提とし、経路確認済みとは主張しない |
| 妨げる対象 | addressは一般値扱いで着手を止めない。給電の条件は[電源文書](power-budget.md#段階b-2の測定)で別に確認する |
| 対応Issue | [#1](https://github.com/wachi-yoshitaka-11-dev/deskcat/issues/1)、[#3](https://github.com/wachi-yoshitaka-11-dev/deskcat/issues/3) |
| Owner | Human |
| 状態 | Open（範囲を縮小） |

電圧の判断根拠、2026-09-21の人間承認、
旧(1)〜(6)の現物情報は[元の行全文](tbd-register-history.md#hw-tbd-004)。未確認経路を確認済みにしない。

### HW-TBD-023

| 項目 | 現在の判定 |
|---|---|
| 優先度 | P0 |
| 不足している情報／判断 | (a) 3V3 pinの外部供給可能電流、(c) 短絡・折り返し特性、(d) decouplingの内訳・容量。(b) LDO種別は確定 |
| 必要な根拠 | [部品同定・資料・限定判断](tbd-register-history.md#hw-tbd-023)。(a)はboard levelで非公開、実測が必要。(c)は電流制限・熱shutdownのみ確定、(d)は個数まで確認 |
| 妨げる対象 | B-2a。(a)未確定では許可しない。B-2bは別条件。ACCEL-01／ENV-01の限定判断は#445、DISP-01の通常接続は[HW-TBD-024](#hw-tbd-024)を参照。**LEDの2枝（[#514](https://github.com/wachi-yoshitaka-11-dev/deskcat/issues/514)。白＝GPIO2、赤＝GPIO5、各330 Ωと各10 kΩ pull-down）は、2026-10-12のユーザーの承認（[#514のコメント](https://github.com/wachi-yoshitaka-11-dev/deskcat/issues/514#issuecomment-6124265343)）による例外である。その電流は安全側の仮定として`3V3`系に数える。書き込みと初回通電は、別の承認（版・起動の回数・停止条件）を取る。**いずれも本項の値の解決ではない |
| 対応Issue | [#1](https://github.com/wachi-yoshitaka-11-dev/deskcat/issues/1)、[#3](https://github.com/wachi-yoshitaka-11-dev/deskcat/issues/3) |
| Owner | Human |
| 状態 | Open |

部品同定・(a)〜(d)の証拠と
限定判断は[元の行全文](tbd-register-history.md#hw-tbd-023)。

### HW-TBD-024

| 項目 | 現在の判定 |
|---|---|
| 優先度 | P0 |
| 不足している情報／判断 | MSP2807が耐えられる電流の上限。U1の供給能力だけでは決まらない |
| 必要な根拠 | [調査・測定・#461の承認と計算](tbd-register-history.md#hw-tbd-024)。公開資料と非通電導通測定ではbacklight経路・LED個数を確定できず、上限は未解決。非破壊の原則を維持する |
| 妨げる対象 | B-2（B-2a／B-2b）とB-2bの制限値決定。**DISP-01のESP32 3V3 pinへの通常接続（backlight点灯、ACCEL-01／ENV-01への追加を含む）は#461の承認範囲**。B-2・外部電源・段階Cへ広げない。**2026-10-27：段階Cの測定4は、MSP2807を接続せず行わない（[power-budget.md](power-budget.md)の`MSP2807の電流上限の扱いと、段階Cの測定4（2026-10-27、#556）`節）** |
| 対応Issue | [#1](https://github.com/wachi-yoshitaka-11-dev/deskcat/issues/1)、[#3](https://github.com/wachi-yoshitaka-11-dev/deskcat/issues/3)、[#405](https://github.com/wachi-yoshitaka-11-dev/deskcat/issues/405)、[#461](https://github.com/wachi-yoshitaka-11-dev/deskcat/issues/461)、[#556](https://github.com/wachi-yoshitaka-11-dev/deskcat/issues/556) |
| Owner | Human |
| 状態 | Open（接続判断と上限値を区別。2026-10-27：上限は公開資料からも非破壊の方法からも得られていない。`U1`の`Ilimt`はtypのみ。最終の構成は#405の見直しで決める） |

#461は残余riskの受け入れ判断であり、
上限値や下流module保護の証明ではない。通常動作と故障時を分けた計算、R5の公差不明、
未知の枝、U1の保証範囲と熱の限定は[元の行全文](tbd-register-history.md#hw-tbd-024)で読む。
接続許可とfirmware実行の承認も別である。実行には[電源文書](power-budget.md)の
`DISP-01`追加接続手順の条件(1)〜(7)・停止条件を用い、人間の当日の判断を得る。

2026-10-01の段階B-2（[experiment-log.md](experiment-log.md)の`EXP-019`）は、この行を解いていない。

2026-10-27の判断（資料のsha256、`U1`のdatasheetの値、回路図の`J1`の注記、今の構成の事実）は[power-budget.md](power-budget.md)の`MSP2807の電流上限の扱いと、段階Cの測定4（2026-10-27、#556）`節にある。

2026-11-10（[#487](https://github.com/wachi-yoshitaka-11-dev/deskcat/issues/487)）：featureなしの製品buildの通電は、`touch`の5本の挿し有無にかかわらず、`XPT2046`が`touch panel`へ流す駆動電流に上界が無く、[power-budget.md](power-budget.md#製品buildfeatureなしの通電の条件)が`TBD`として持つ。この行が問う`MSP2807`の電流の上限とは別の未確認で、この行の状態は変えない。

### HW-TBD-025

| 項目 | 現在の判定 |
|---|---|
| 優先度 | P0 |
| 不足している情報／判断 | B-2共通条件。(a) moduleとしての許容電圧範囲、(b) 全moduleの安全な電流上限／代替の現物回路確認 |
| 必要な根拠 | (a) [電源文書の許容電圧範囲](power-budget.md#段階b-2の測定)の限定付き設計判断を使う。(b) ACCEL-01／ENV-01は確認済み、DISP-01は未達。[判定の出所と訂正](tbd-register-history.md#hw-tbd-025) |
| 妨げる対象 | B-2a／B-2bとも。(b)は**電流の大きさでなく現物回路確認の手続き**を判定する。HW-TBD-024の通常接続判断・電流上界計算を代替にしない |
| 対応Issue | [#3](https://github.com/wachi-yoshitaka-11-dev/deskcat/issues/3)、[#405](https://github.com/wachi-yoshitaka-11-dev/deskcat/issues/405)、[#556](https://github.com/wachi-yoshitaka-11-dev/deskcat/issues/556) |
| Owner | Human |
| 状態 | Open（(b)のDISP-01が残る。2026-10-27：段階CではDISP-01を使わず、最終の構成での確認は#405の見直しへ渡す） |

(a)のrail値は条件付きの設計判断であり、
無条件の保証値ではない。ILI9341ロジック単体負荷を前提とする下限の再導出条件は
[電源文書](power-budget.md#段階b-2の測定)、公開値不在の確認とmodule別の(b)判定は
[元の行全文](tbd-register-history.md#hw-tbd-025)に残す。

2026-10-01の段階B-2（[experiment-log.md](experiment-log.md)の`EXP-019`）は、この行を解いていない。

## 対応Issue列

`対応Issue`列は、その`TBD`を**解消する作業Issue**を指す。台帳を見た人が
「この`TBD`を解くのはどのIssueか」を判断できるようにするための列である。

逆方向（Issue → TBD）は、[#65](https://github.com/wachi-yoshitaka-11-dev/deskcat/issues/65)で
[#1](https://github.com/wachi-yoshitaka-11-dev/deskcat/issues/1)と[#3](https://github.com/wachi-yoshitaka-11-dev/deskcat/issues/3)の本文へ対応表を追加した。
**この2件以外のIssue本文には対応表が無い。**そのため、この列が両方向を辿れる唯一の起点である行が多い。

### 記載規則

| 場面 | 書き方 |
|---|---|
| 対応Issueが1件 | `[#N](https://github.com/wachi-yoshitaka-11-dev/deskcat/issues/N)` |
| 複数Issueに跨る | 該当Issueを`、`で区切って**すべて**列挙する。**主従を付けない。**どれか一つが解決しても行はcloseしない |
| 対応Issueが無い | `なし（未起票）`と書く。**空欄にしない。**空欄では「未記入」と「対応Issueが無い」を区別できない |

書くのは**解消する側**のIssueだけである。その`TBD`が解けるのを待っている側のIssueは書かない。
両方を書くと列が依存関係の写しになり、「どれを進めれば解けるか」が読めなくなる。
待っている側は`妨げる対象`列と各Issueの依存関係が表す。

**同じIssue番号が`妨げる対象`と`対応Issue`の両方に現れたら、どちらかが誤りである。**
待っている側が解消する側を兼ねることはない。

どのIssueが解消するかは、**その行の`必要な根拠`列が求める作業を範囲に含むか**で判定する。
Issueの題名や扱う領域の近さで決めない。たとえば`HW-TBD-019`の根拠は
「無負荷でのPWM測定＋起動時glitch確認」であり、これを範囲に持つのは
[#17](https://github.com/wachi-yoshitaka-11-dev/deskcat/issues/17)である。
[#20](https://github.com/wachi-yoshitaka-11-dev/deskcat/issues/20)は同じ状態を**検証する**側であって、値を決める側ではない。

行を追加するときは、この列も同時に埋める。埋められないなら`なし（未起票）`とし、
下の一覧へ加える。

### closeしたIssue番号の扱い

**Issueがcloseされていても、その`TBD`が解決済みであることを意味しない。**
台帳の行のcloseは[解決手順](#解決手順)の1〜8による別の判定であり、Issueのcloseとは一致しない。
Issueは受け入れ条件を満たせばcloseされるが、`TBD`は根拠の記録、正本文書への反映、
関連Issueのblocked解除まで終えて初めてcloseする。

この列のIssueがcloseされたら次を行う。**列の記載は消さない。**

1. [解決手順](#解決手順)の1〜8を満たしたかを確認する
2. 満たしていれば[解決済み項目](#解決済み項目)へ移す
3. 満たしていなければ行を残す。残作業を担うIssueが無くなったなら、起票してこの列へ追加する

### 対応Issueが無い行

| 行 | 対応Issueが無い理由 |
|---|---|
| `HW-TBD-014` | 値の正はProtocol側（`PROTO-TBD-001`／`PROTO-TBD-002`）であり、この台帳が負うのは実機transport testの実施責任である。**そのtestを受け入れ条件に持つIssueが無い。**[#10](https://github.com/wachi-yoshitaka-11-dev/deskcat/issues/10)は上限を超えた入力の扱い、[#11](https://github.com/wachi-yoshitaka-11-dev/deskcat/issues/11)はbaudを設定として扱うことを受け入れ条件としており、いずれも**値の決定を条件に含まない** |

## Owner列

`Owner`列は、**その行に残っている行為を誰が行うかを示す。****「誰が中身を決めるか」を示す列ではない。**

| 値 | 意味 |
|---|---|
| `Human` | 人間しかできない行為だけが残っている（現物を見る、はんだ付けする、買う、監視下で通電する） |
| `Joint` | 人間しかできない行為と、机上で閉じる行為の両方が残っている |
| `AI` | 机上で閉じる行為だけが残っている（一次資料の読み取り、導出、値・方式・要否の提案） |

**この列は、提案を誰が出すかを示さない。****提案はAIが出し、承認は人間が行う。**
これはどの行でも同じであるため、列では区別しない。

`Owner: Human`は「人間が値を決める」ではなく、「**人間が手を動かさないと先へ進まない**」を意味する。
**`Owner`を、AIが提案を出さない理由として引用しない。**AIが提案を出さない理由になるのは、
一次資料が無いこと（[AGENTS.md](../../AGENTS.md) 推測禁止）と、実測が要ることだけである。

**この定義は2026-09-07に置いた。****それ以前に各行へ付けた値は、この定義に照らして付けたものではない。**
各行の値は、その行の`対応Issue`を進めるときに、残っている行為を読み直して合わせる。

## 登録範囲

`status:blocked`判定の根拠は、**この台帳と[Protocol TBD register](../protocol/esp32-pi-protocol.md#13-未決定事項)の和集合**である。
どちらか一方だけを見ると、もう一方の未解決項目がgateを素通りする。

台帳に無い未確定事項は着手可否のgateを素通りするため、次を守る。

- 正本文書の本文に`TBD`と書いた安全・電気・機械項目は、必ずこの台帳へ行を追加する。表の`TBD`セルだけで管理しない。
- 追加した行から、値を確定させる正本文書へリンクする。
- Protocol側の未決事項は`PROTO-TBD-*`で管理し、ここでは行を重複させない。
  **ただしIssueのblocked判定では、`PROTO-TBD-*`も同じ強さで扱う。**
  行を重複させないのは記述の重複を避けるためであり、gateの対象から外す意味ではない。

Issueの着手可否を判断するときは、次の両方を確認する。

1. この台帳の`HW-TBD-*`で、そのIssueを妨げる行が解決済みか
2. Protocol側の`PROTO-TBD-*`で、そのIssueを妨げる行が解決済みか

protocol実装Issue（M2系）は、hardware側TBDが未解決でも`PROTO-TBD-*`だけで
blockedになりうる。逆にhardware Issueが`PROTO-TBD-*`でblockedになることもある。

両方に関係する項目は、片方を正、もう片方を参照とする。

正・参照はIDの単位ではなくfieldの単位で決める。片方が解決しても、もう片方を自動でcloseしない。

| このIDの正 | 対応するprotocol側ID | field単位の正 |
|---|---|---|
| HW-TBD-014 | PROTO-TBD-001、PROTO-TBD-002 | baudと最大line長の値はProtocol側。実機transport testの実施責任はこの台帳 |
| HW-TBD-017 | PROTO-TBD-010 | heartbeat方式（何をheartbeatとするか）はProtocol側。loss timeoutの実測値はこの台帳 |
| HW-TBD-018 | PROTO-TBD-013 | fail-safe sequenceの選択と機械試験はこの台帳。**recovery／reconnect動作（復帰時の物理的な再有効化条件と手順）もこの台帳**。Stale commandの拒否条件はProtocol側であり、復帰時にどのcommandを受理するかは`PROTO-TBD-013`が決める |
| HW-TBD-019 | — | この台帳 |
| HW-TBD-020 | PROTO-TBD-005、PROTO-TBD-011、PROTO-TBD-012、PROTO-TBD-013、PROTO-TBD-014 | `PROTO-TBD-005`はduplicate履歴の保持期間とretry window。`PROTO-TBD-011`はretired sessionの保持件数と期間（`PROTO-TBD-005`とは別モデル。下限は独立に満たす）に加え、`sid`生成・衝突回復・`hello`の有限retry上限を持つ。`PROTO-TBD-013`はCommand timeoutのstale command拒否条件。`HW-TBD-020`をcloseするには、対応IDの一部fieldだけでなく下記の全fieldと各Protocol TBD全体の解決が必要 |

### HW-TBD-027の証拠契約

**closeに必要な記録をここで一意に定める。**「実装した」「測ってLowだった」という主張だけでは
closeしない。次の4点がすべて揃うまでOpenとする。

| # | 条件 | 記録先 | 記録する内容 |
|---|---|---|---|
| 1 | 抵抗値と本数の選定 | [gpio-assignment.md](gpio-assignment.md#信号inventory)の`SERVO-PWM`行 | 決めた抵抗値・本数と、ESP32のGPIO駆動能力およびservo側入力インピーダンスから導いた根拠 |
| 2 | 購入 | [hardware-bom.md](hardware-bom.md)の`RES-PULL-01` | 型番と入手日。`残作業`の`未購入`を消す |
| 3 | 実装 | この台帳の`HW-TBD-027`行 | 実装日と接続先（`SERVO-PWM`とGNDの間であること） |
| 4 | reset中の実測 | この台帳の`HW-TBD-027`行 | 下の測定条件と、測定した電圧値 |

測定条件は次を満たす。**満たさない測定はこの行の根拠にしない。**

- **servoを接続せず**、servo電源も投入しない状態で測る。servo側の入力が並列に入ると、
  pull-downだけの効果を分離できない
- **ESP32をresetに保持した状態**で測る。GPIO27がhigh-Zになるのはこの区間であり、
  通常起動後の測定では何も確認したことにならない
- 測定点は`SERVO-PWM`の信号線とGNDの間である

**判定閾値は`HW-TBD-026`が決まるまで確定しない。**「Lowである」と言うには、SG90が
Lowと解釈する電圧の上限が要る。それは`HW-TBD-026`の`制御logic要件`である。
**したがって`HW-TBD-027`は`HW-TBD-026`より先にcloseできない。**測定値だけを記録して
「Lowだった」と結論しない。

### HW-TBD-035の証拠契約

**closeに必要な記録をここで一意に定める。**「メーカーが4.8–6 Vと言っている」という主張だけでは
closeしない。**Q&A欄の回答は、それ単独ではこの行を閉じる根拠にならない。**
次の4点がすべて揃うまでOpenとする。

| # | 条件 | 記録先 | 記録する内容 |
|---|---|---|---|
| 1 | **現物の品の特定**、または**現物に適用できるメーカー資料** | この台帳の`HW-TBD-035`行 | `SG90 Digital`／`SG90 Analog`／`SG90 360 degree`のどれであるかと、その判定根拠。**寸法の実測は3品目を除外する手段になる**（`23×12.2x29mm` 対 `23×12.5x22mm`）。**Digitalと Analogは寸法が同一のため、寸法では分離できない。**`Operating speed`も**Analog側ページが自己矛盾しているため判別に使えない**（箇条書き`0.12`／同ページの`PRODUCT CONFIGURE TABLE`は`0.1`） |
| 2 | **servo入力電圧の実測** | この台帳の`HW-TBD-035`行 | 下の測定条件と、測定した電圧値 |
| 3 | **測定条件の記録** | 同上 | 下記の条件を満たしたことと、満たせなかった条件 |
| 4 | **合否判定の基準** | 同上 | 判定に使った上限・下限と、その出所 |

**条件ごとの追跡先。**条件1〜3は[#17](https://github.com/wachi-yoshitaka-11-dev/deskcat/issues/17)（サーボ電気動作のcharacterization）の範囲である。同Issueの受け入れ条件は`正確なservo dataを記録した`・`外部電源と電流制限を記録した`・`5 Vと3.3 Vのtransientを取得した`を持つ。**ただし`servoの入力端での電圧測定`を名指ししてはいない。**#17を追跡先に置くのはservoの電気動作の検証がそこへ集約されているためであり、**条件2・3の文言そのものはこの台帳が持つ。****品の特定そのものは`HW-TBD-026`（同じく#17）が持つ。****条件4が待っていた規則は、2026-08-26に[ADR-0017](../decisions/0017-what-counts-as-a-primary-source.md)として決まった。**メーカー自身による仕様書以外の記述（乙）は3条件を満たすときだけ根拠にできる。**この行の`4.8–6 V`は、その乙の条件2（どの品に対する記述かが特定できる）を満たさない**（同名3品があり現物がどれか未確定）。**ADR-0017の乙の条件番号であり、この節の条件1〜4とは別の体系である。****したがって条件4に残るのは規則の判断ではなく、条件1が解けた後の適用であり、それは条件1〜3と同じ#17の範囲である。****`対応Issue`列を#17単独へ改めた**（2026-08-26。従来は#193を併記していた）。**条件そのものも判定基準もここで変えていない。**

測定条件は次を満たす。**満たさない測定はこの行の根拠にしない。**

- **servo railの、servoの入力端で測る。**電源側やbreadboard railの別の点で測ると、
  経路の電圧降下を含めた実際の入力電圧が分からない
- **servoが動作している状態と停止している状態の両方で測る。**起動時の突入電流で
  railが落ちるため、静止時の値だけでは入力電圧の範囲を示せない
- 給電経路は`PSU-SERVO-01`の実構成とする。**別の電源で測った値を代用しない**

**判定基準はこの行では確定していない。**「5 Vを入れてよい」と言うには、この品が受け入れて
よい電圧の上限が要る。**その上限の出所として何を採るかが、この行の未解決の本体である。**

- 現物が`SG90 360 degree`だと確定すれば、**仕様表の`4.8v-6V`が使える**
- `SG90 Digital`／`SG90 Analog`だと確定した場合、**仕様表は`4.8v`単独であり、上限の出所が無い。**
  Q&A欄の回答を採るか、メーカーへ問い合わせるか、4.8 V供給へ変えるかの**判断が要る**

**したがって条件1が解けるまで、条件4の判定基準は決まらない。**測定値だけを記録して
「5 Vで問題なかった」と結論しない。**`HW-TBD-035`は`HW-TBD-026`の品の特定に従属する。**

### HW-TBD-020のfield単位の正

`HW-TBD-020`は対象fieldが多いため、field単位で正を一つだけ定める。
二つの文書が同じfieldの正を名乗ると、片方だけを見た判断が起きる。

分担の原則は次のとおり。**[servo-safety-limits](servo-safety-limits.md)は安全要件と
有効化ゲートの正本**（何を満たすべきか、検知したら何をするか）であり、
**この台帳は実測値の正本**（しきい値、時間、上限の数値）である。
正でない側は evidence 及び参照として扱い、値や要件をそこで確定しない。

| Field | 正 | もう一方の役割 |
|---|---|---|
| 採用する検知／予防手段 | [servo-safety-limits](servo-safety-limits.md#拘束stallと過負荷)（安全要件としての選択） | この台帳は選定試験のevidence |
| 検知したときの物理動作 | [servo-safety-limits](servo-safety-limits.md#拘束stallと過負荷)（trajectory中止かPWM disableか） | この台帳は機械試験のevidence |
| 復帰条件 | [servo-safety-limits](servo-safety-limits.md#拘束stallと過負荷)（復帰を許す条件） | この台帳は冷却時間の実測値 |
| 電流しきい値と判定時間 | この台帳（電流測定） | 安全要件側は値を再掲しない |
| 連続動作時間の上限 | この台帳（温度試験） | 同上 |
| Duty cycle窓と上限 | この台帳（温度試験） | 同上 |
| servoの秒あたり受理command数 | この台帳（温度／電流試験） | 同上 |
| 単一commandの最大変化量 | この台帳（動作・安全試験） | 同上 |
| Command timeout | この台帳（Protocol／fail-safe試験） | 同上。Protocol側のstale command拒否条件はPROTO-TBD-013 |
| duplicate履歴の**保持期間** | PROTO-TBD-005（**現在のsession**用）。下限: 遅延messageの最大生存時間＋再送window | — |
| duplicate履歴の**retry window** | PROTO-TBD-005。制約: 保持期間以下であること。window > 保持期間だと、windowの内側でも履歴が消えている状態が生じる | — |
| duplicate履歴の**保持件数の上限とoverflow時の動作** | PROTO-TBD-005。受理budget（PROTO-TBD-012）と保持結果の最大sizeから件数上限を導出する。上限超過時は最も古いentryをevictし、evict済みentryへの再送は`duplicate_expired`で拒否する（新規commandとして実行しない） | —。件数側が無いと、保持期間内でも無制限にentryが増え、Memory予算を超える |
| retired sessionの**保持期間** | PROTO-TBD-011（**retired `sid`を`stale_session`で遮蔽する**ため）。下限: 遅延messageの最大生存時間＋再送window。確定値は時間値`T_retention`と単位を一組で記録する | —。PROTO-TBD-005とは目的が異なる別モデルであり、一方から他方を導出しない |
| retired sessionの**保持件数** | PROTO-TBD-011。`PROTO-TBD-012`の遷移上限を任意の連続windowあたり`N_transition`回、window長を`T_window`、retired保持期間を同じ時間単位の`T_retention`としたとき、下限を`N_transition × ceil(T_retention / T_window)`件とする。保持期間がwindowの端数を含む場合は切り上げ、必要なsessionを取りこぼさない | —。件数側を決めないと、保持期間内でも古い`sid`が押し出され`stale_session`で遮蔽できない |
| link全体の負荷管理parameter | PROTO-TBD-012（protocol負荷試験）。session遷移上限は任意の連続`T_window`あたり`N_transition`回として回数、window長、時間単位を一組で記録し、固定window境界で上限を迂回できない方式にしてPROTO-TBD-011の保持件数式へ渡す | — |
| fault eventの名前とpayload schema（3原因を区別） | PROTO-TBD-014 | — |

HW-TBD-017は、heartbeat方式とloss timeoutの両方が確定するまでcloseしない。
HW-TBD-018は、fail-safe sequenceとrecovery／reconnect動作の両方が確定するまでcloseしない。
片方だけでcloseすると、残る一方が持ち主のないままサーボ出力のgateを素通りする。

`HW-TBD-020`は、上表の**全field**について、正本へ確定した要件または値、根拠へのlink、
適用条件、review結果がfield単位で記録されるまでcloseしない。さらに、対応する
`PROTO-TBD-005`、`PROTO-TBD-011`、`PROTO-TBD-012`、`PROTO-TBD-013`、
`PROTO-TBD-014`がProtocolの未決定事項表からすべて削除され、Revision履歴に解決根拠が
残ることを必要とする。一つでもfieldのevidenceまたは対応Protocol TBDが欠ける場合は、
`HW-TBD-020`を未解決のまま保ち、サーボ出力の有効化gateを開かない。

**`HW-TBD-017`・`HW-TBD-018`・`HW-TBD-019`・`HW-TBD-020`の4つがすべてcloseしたら、
[ADR-0023](../decisions/0023-no-model-checking-for-now.md)を見直す。**
同ADRは「状態機械の遷移が未確定であること」を理由にモデル検査を見送っている。
**4つのcloseが意味するのは、同ADRが再検討の起点として挙げた条件が揃ったことである。
決定が自動的に反転するわけではない。**判断そのものは同ADRが持つ。

**この段落を`HW-TBD-020`の節へ置いたのは、close条件の散文が`017`・`018`・`020`とも
この節に集まっているためである。**見出しは`020`だけを名指ししているが、**見直しの対象は4件である。**
とくに`019`は、この節にclose条件の散文を持たない。**4件から外さない。**
同項目が扱うサーボ出力状態を状態機械の遷移として数えるのは**ADR-0023の起案者の読みである**
（この台帳は同項目を遷移とは書いていない）。その範囲は
[未解決項目](#未解決項目)の`HW-TBD-019`の行が持ち、**同行の`必要な根拠`欄が「正本:」として指す
[起動時とdriver故障時の動作](servo-safety-limits.md#起動時とdriver故障時の動作)が最終的な正本である**
（`reset後`の限定はそちらにある）。**ここへ写さない。**

**再検討の条件の正本はADR-0023側である。**この段落が持つのは、同ADRの決定理由の一文、
見直しの起点となるID 4件、それが何を意味しないかの注意、`019`を外さないための注意、
`019`を遷移と数えるのが同ADRの起案者の読みであることの断り、範囲の参照先、
この節へ置いた理由、および正本がどちらにあるかの明示である。
**各TBDのclose条件も、再検討の可否の判断も、ここへ複製しない。**

関連する安全要件は[Servo Safety Limits](servo-safety-limits.md)を参照する。

## 本文との照合手順

台帳に行が無い`TBD`はgateを素通りするため、正本文書の本文と台帳を全数照合する。
手順は再実行できる形で残し、**使用したpatternそのものをreviewの対象とする。**
過去に狭いpatternで「0件」と誤報告した例がある（[hardware-bom.md](hardware-bom.md)のRevision 19。
3語から9語へ広げて5件の漏れが出た）。

### 対象範囲

| 区分 | 対象 |
|---|---|
| 対象 | `docs/hardware/`配下、`docs/decisions/`、`docs/toolchains/` |
| 対象外 | `docs/backlog/`、`docs/toolchains/version-records/`、Issue本文 |

version-recordは実施時点のsnapshotであり、遡って改変しない。
`docs/protocol/`の未決事項は`PROTO-TBD-*`として別に管理するため、この照合には含めない
（[登録範囲](#登録範囲)を参照）。**protocol側の全数照合はまだ実施していない。**

### 抽出command

```bash
# 1) 対象範囲の全出現
grep -rn "TBD" docs/hardware docs/decisions docs/toolchains \
  --include="*.md" --exclude-dir=version-records --exclude=tbd-register.md

# 2) 識別子参照を除いた「本文のTBD」
grep -rnE "TBD" docs/hardware docs/decisions docs/toolchains \
  --include="*.md" --exclude-dir=version-records --exclude=tbd-register.md \
  | grep -vE "(HW|PROTO)-TBD-[0-9]{3}"
```

**この台帳自身を`--exclude`で外している。**台帳の`TBD`は行の識別子か、この節のような
自己言及であり、いずれも登録対象ではない。外さないと、この節を書き足すだけで件数が動き、
前回と比較できなくなる。台帳の行そのものは、定義上すでに登録済みである。

**command 2)は行単位で除外するため、識別子と本文の`TBD`が同じ行にあると本文側も落ちる。**
1)と2)の差分（識別子を含む行）を必ず開き、**その行の識別子が、同じ行の`TBD`を
指しているか**を確認する。指していなければ登録漏れである。この確認を省くと、
表の1行に複数の`TBD`セルがある文書で漏れが出る。

差分は次の2つに分かれる。目視が要るのは後者だけである。

1. 行に現れる`TBD`が**識別子だけ**の行。本文の`TBD`を含まないため、落ちるものが無い
2. 識別子を除いても`TBD`が残る行。**この行を開いて、識別子が同じ行の`TBD`の登録先かを確かめる**

2 の絞り込みは次で行う。「TBD台帳」という台帳名も識別子と同じ扱いで外す。

```bash
grep -rnE "TBD" docs/hardware docs/decisions docs/toolchains \
  --include="*.md" --exclude-dir=version-records --exclude=tbd-register.md \
  | grep -E "(HW|PROTO)-TBD-[0-9]{3}" \
  | sed -E 's/(HW|PROTO)-TBD-[0-9]{3}//g; s/TBD ?台帳|TBD register//g' \
  | grep "TBD"
```

### 区別の基準

`TBD`という語は、識別子としても、説明文中の「未確定である」という語としても使われる。
**数える前に次の3段で区別する。**

1. **識別子**: `HW-TBD-\d{3}`／`PROTO-TBD-\d{3}`の一部。台帳行への参照であり、新規登録の対象ではない。上のcommand 2)で機械的に除く
2. **本文の`TBD`**: 値または判断が未確定であることを示す記述。表のセル、箇条書き、散文を問わない
3. 2 のうち**安全・電気・機械項目**、および**下記の識別項目**に当たるものだけが登録対象である

**識別項目とは、正本文書が確定条件として挙げている部品・chipの同定である。**安全・電気・機械の
どれにも当たらないが、**満たされないと正本文書が状態を上げられない**ため追跡する。
`HW-TBD-031`（ESP32 chipの識別。**登録時の要件は「chipの刻印」であり、2026-08-15に書き換えた**）が
これに当たり、[ESP32 Rust Toolchain](../toolchains/esp32-rust-toolchain.md)が
`検証済み`ではなく`build検証済み`にとどまっていた理由の一方であった。
**2026-08-20に満たされ、同文書は`検証済み`へ昇格した**（`esptool` 4.12.0が`ESP32-D0WD`を報告した）。
**この行は解決手順を通して2026-08-25にcloseした。**登録対象としての性質（識別項目）は変わらない。
**この段を明記するまで、031は基準3のどれにも当てはまらないまま登録されていた**
（2026-08-11の全数分類で登録し、[PR #105](https://github.com/wachi-yoshitaka-11-dev/deskcat/pull/105)のreviewで基準側の不足を指摘されて補った）。
`HW-TBD-001`〜`005`も同じ性質を持つが、いずれもGPIO割り当てや給電経路という
電気項目を直接blockするため、基準3の1つ目で拾えている。

3 に当たらないものは対象外とし、**1件ごとに理由を残す。**次の類型が繰り返し現れる。

| 類型 | 例 | 対象外とする理由 |
|---|---|---|
| **この台帳の名前** | 「TBD台帳」「TBD register」 | 識別子と同じく台帳への参照である。**command 2)の正規表現では除けないため、目視で分ける** |
| 規則文 | 「不明値は`TBD`とする」「識別情報が`TBD`の間はdriver開発を開始しない」 | 特定の未確定値を指していない |
| 凡例 | [toolchains/README.md](../toolchains/README.md)の状態ラベル表の`TBD`行 | 語の定義であり、未確定値ではない |
| Revision履歴 | 「実GPIO割り当てはすべて引き続きTBD」 | 過去時点の記録であり、現在の未確定を表さない |
| firmwareまたは文書運用の項目 | `Firmware board configuration ID`、公式文書欄の`TBD` | 安全・電気・機械項目ではない |
| 既存行が包含するtemplateの空欄 | [sensor-datasheet-notes.md](sensor-datasheet-notes.md)の未記入セル | module単位で`HW-TBD-002`〜`004`が既に追跡している。cell単位の行を追加しない |

**この基準は`TBD`という語だけを見る。**「未選定」「未決定」「未購入」のように、
`TBD`以外の語で書かれた未確定は上のcommandに掛からない。実際、`HW-TBD-027`は
`TBD`セル（公式文書欄）ではなく同じ行の「未購入・未選定」から登録した（**この記述は2026-08-15に「一部入手済み・未選定」へ訂正した。訂正後も`TBD`の語は無く、この例が成り立たなくなったわけではない**）。
**`TBD`だけを走査した照合は、この1件を取り落とす。**

### command 3) `TBD`以外の語で書かれた未確定

patternは2群からなる。**群ごとに正本を1つだけ置く。**同じ語の一覧を2箇所に書くと、
片方だけを広げた状態で「走査した」と言えてしまう。実際に過去、狭いpatternで
「0件」と誤報告している。

| 群 | 語 | 正本 |
|---|---|---|
| A: 調達状態 | `未購入`／`購入`／`発注`／`未選定`／`未確定`／`Required`／`Blocked`／`手配`／`調達` | [hardware-bom.md](hardware-bom.md#購入待ちリスト)の発注前の走査。**この台帳では再定義しない** |
| B: 検証状態 | `未実装`／`未測定`／`未確認`／`未検証` | **この節。**部品が手元にあっても、実装・測定・確認が済んでいない状態を指す |

**群Bを発注前の走査へ足さない。**あちらの目的は発注漏れの検出であり、`未測定`や`未検証`は
買う対象を示さない。混ぜると発注時に無関係なhitを読ませることになる。

```bash
# 群A（正本はhardware-bom.md）と群B（正本はこの節）を合わせて走査する。
grep -rnE "未購入|購入|発注|未選定|未確定|Required|Blocked|手配|調達|未実装|未測定|未確認|未検証" \
  docs/hardware docs/decisions docs/toolchains \
  --include="*.md" --exclude-dir=version-records --exclude=tbd-register.md
```

**このcommandはtracked Markdownしか見ない。**GitHubのIssue本文・Pull Request本文・
commentはどの引数にも入らず、台帳への登録漏れを生む経路になっていた
（[#289](https://github.com/wachi-yoshitaka-11-dev/deskcat/issues/289)）。群A（調達状態）だけを
GitHub側へ広げる報告専用の補助scriptが`scripts/scan_procurement_mentions.py`にある。
**このcommandを代替しない。**群Bを含まず、判定も止めず、tracked Markdown側は
引き続きこのcommandで走査する。

```bash
python3 scripts/scan_procurement_mentions.py --owner wachi-yoshitaka-11-dev --repo deskcat
```

**発注前の走査とこの command 3) は出力先が違う。**あちらは`購入待ちリスト`への計上漏れを探し、
こちらは台帳への**登録**漏れを探す。群Aが重なっていても判定は別であるため、
一方を実施したことをもって他方を済ませたとしない。

hitは[区別の基準](#区別の基準)の3段に掛けたうえで、次のいずれかへ分類する。**分類結果は
[実施記録](#実施記録)へ残す。**

| 分類 | 扱い |
|---|---|
| 既存の台帳行が包含する | 行番号を記録し、新規登録しない |
| 安全・電気・機械の未確定で、包含する行が無い | **新規登録する。**`HW-TBD-027`がこれに当たる |
| 発注状態のみを表す（部品は決まっており購入していないだけ） | 台帳の対象外。`購入待ちリスト`側で追う |
| 規則文・凡例・Revision履歴 | 上表の類型と同じ理由で対象外 |

### 逆方向（台帳にあるが本文から`TBD`が消えた行）

本文から`TBD`表記が消えても、台帳行を自動でcloseしない。closeは[解決手順](#解決手順)の1〜8による別の判定である。
現在該当するのは次の2種で、いずれも**行を残す**と判断した。

| 行 | 状態 | 扱い |
|---|---|---|
| `HW-TBD-008` | [gpio-assignment.md](gpio-assignment.md)は全信号へGPIOを割り当て済みで、**GPIO割り当てそのものについての`TBD`表記は残っていない**（同fileに残る`TBD`は`Firmware board configuration ID`とRevision履歴であり、いずれも別件） | 競合checkに未完了項目が残るため行を残す。この事情は同行の状態欄に記載済みである |
| `HW-TBD-013` | しきい値の正本はこの台帳であり、正本文書側に`TBD`行を持たない | 実測値の正本を台帳側に置く方針（[HW-TBD-020のfield単位の正](#hw-tbd-020のfield単位の正)と同じ構造）に従い、行を残す |

### 実施記録

件数は上のcommandをそのまま実行した値である。

| 照合日 | 1) | 2) | 差分（1−2） | 差分のうち目視した行 | 追加した行 | 実施 |
|---|---|---|---|---|---|---|
| 2026-08-10 | 219 | 136 | 83 | 30。**いずれも同じ行の`TBD`を指す識別子であり、漏れ0件**。残る53行は行中の`TBD`が識別子だけで、落ちる本文`TBD`が無い | `HW-TBD-026`〜`HW-TBD-030`（5件） | [#72](https://github.com/wachi-yoshitaka-11-dev/deskcat/issues/72) |

読み方を2点補う。`grep -n`が数えるのは**出現回数ではなく行数**であり、1行に複数の`TBD`が
あっても1と数える。また2)のhitは候補であって登録対象ではない。
[区別の基準](#区別の基準)で3段に分けたうえで判定する。

件数は照合を実施したcommitに対する値である。文書を変更すれば動くため、
**次の照合では件数を突き合わせず、commandを再実行して判定する。**

追加した5行の出所は次のとおりである。**どの記述から登録したかを残さないと、次の照合で
同じ記述を二重登録するか、逆に「既に登録済み」と誤って飛ばす。**

| 行 | 出所 |
|---|---|
| `HW-TBD-026` | [servo-safety-limits.md](servo-safety-limits.md#サーボ識別情報)の`サーボ識別情報`表。`制御logic要件`・`PWM周期／rate`・`許容最小／最大pulse`が`TBD` |
| `HW-TBD-027` | [gpio-assignment.md](gpio-assignment.md#信号inventory)の`SERVO-PWM`行。**`TBD`ではなく「未購入・未選定」**から登録した（**登録時の記述である。同記述は訂正済みで、両文書とも「未購入」とは書いていない**）。[command 3)](#command-3-tbd以外の語で書かれた未確定)を設けた契機である |
| `HW-TBD-028` | [power-budget.md](power-budget.md#受け入れ条件)の受け入れ条件。電源品質の数値制限が未定義 |
| `HW-TBD-029` | [power-budget.md](power-budget.md)の`配線・保護表`。local decouplingが`TBD`／`Blocked`（**登録時点の状態。同行は2026-08-12にcloseした**） |
| `HW-TBD-030` | [power-budget.md](power-budget.md)の`配線・保護表`。逆極性保護が`TBD`／`Blocked`（**登録時点の状態。要否と方式は2026-08-24に人間が承認したが、品番・定格が未確定で、同行は`Blocked`のまま。行もcloseしていない**） |

**2026-08-10の記録は、command 2)の136件をどう分類したかを残していない。**上表の「漏れ0件」は
差分83行についての判定であり、136件の候補そのものについての判定ではない。
**2026-08-11に、command 2)の136件とcommand 3)の156件を全件分類した。**内訳を下に残す。

### 2026-08-11の全数分類

commit `52661b9` に対して実行した。**件数は文書を変更すれば動く。**次回は件数を
突き合わせず、commandを再実行して判定する。

#### command 2)（本文の`TBD`）136件

| 分類 | 件数 | 内訳 |
|---|---|---|
| 既存行が包含する（templateの空欄） | 57 | [sensor-datasheet-notes.md](sensor-datasheet-notes.md)の4 module節。`HW-TBD-002`〜`005`がmodule単位で追跡する |
| 既存行が包含する（安全・電気・機械） | 32 | servo識別情報と駆動条件 7（`HW-TBD-010`／`011`／`026`）、機械組み立て 8（`HW-TBD-010`。`PWM停止時の重力による動作`は`HW-TBD-018`の監視下機械試験）、拘束・過負荷 6（`HW-TBD-020`）、経路部品と定格 6（`HW-TBD-021`／`022`）、負荷表 1（`HW-TBD-024`）、配線・保護表 3（`HW-TBD-009`／`029`／`030`）、受け入れ条件 1（`HW-TBD-028`） |
| 既存行が包含する（BOMの列） | 9 | `Address／mode`列 4（`HW-TBD-003`／`004`／`005`／`016`）、`Peak電流`列 4（[power-budget.md](power-budget.md#測定計画)の測定計画が包含。段階ごとに`HW-TBD-007`／`021`／`022`でgate済みであり、部品ごとの行を足すと二重管理になる）、`RES-PULL-01` 1（`HW-TBD-027`／`032`） |
| Revision履歴・履歴的記述 | 13 | 過去時点の記録。「従来は`TBD`／`Blocked`だった」を含む |
| 規則文 | 12 | 「不明値は`TBD`とする」「`TBD`が残る項目は一般値を使わない」等。特定の未確定値を指していない |
| 台帳への参照 | 10 | 「追跡は`HW-TBD-021`で行う」「field単位の正は台帳に定義」等 |
| firmware／文書運用の項目 | 1 | [gpio-assignment.md](gpio-assignment.md)の`Firmware board configuration ID` |
| 凡例 | 1 | [toolchains/README.md](../toolchains/README.md)の状態ラベル表 |
| 未分類 | 0 | — |
| **新規登録** | **1** | **`HW-TBD-031`**（ESP32 chipの刻印）。[esp32-rust-toolchain.md](../toolchains/esp32-rust-toolchain.md)が「刻印の読み取りはTBD台帳の追跡対象にはなっていない」と**自ら書いていた** |

#### command 3)（`TBD`以外の語）156件

| 分類 | 件数 | 内訳 |
|---|---|---|
| 既存行が包含する | 63 | `未購入`／`未選定`／`未確定`の大半は`HW-TBD-007`／`021`／`022`／`023`／`024`／`025`／`027`が追跡する部品と値。`未確認`は`HW-TBD-001`〜`005`の現物確認 |
| Revision履歴 | 34 | 過去時点の記録。`power-budget.md`と`hardware-bom.md`のRevision履歴が長いため件数が大きい |
| 規則文・状態ラベル・確定済み記述 | 23 | 表header、`Required`／`Blocked`の凡例、確定済みの購入履歴への言及など |
| 発注状態のみ | 21 | 部品は決まっており購入していないだけ。**調達はIssueで追う**（[購入待ちリスト](hardware-bom.md#購入待ちリスト)節が方針を持つ） |
| 文書運用・toolchain状態 | 13 | ADR-0002／0004／0007、[machine-profiles.md](../toolchains/machine-profiles.md)、toolchain索引。安全・電気・機械項目ではない |
| 未分類 | 0 | — |
| **新規登録** | **2行（1件）** | **`HW-TBD-032`**（`LCD-RST`／`LCD-CS`のpull-upと`LCD-BL`のpull-down）。[gpio-assignment.md](gpio-assignment.md#信号inventory)の受け入れchecklistが「**未実装のため要対応**」と書いていたが、`HW-TBD-027`は`SERVO-PWM`のpull-downだけを対象としており含んでいなかった |

群Aだけなら122件、群Bだけなら41件である（重なる行があるため合計は一致しない）。
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
