wachi-yoshitaka-11-dev/deskcat/docs/hardware/gpio-assignment.md

# GPIO Assignment

> 正本とする情報: ESP32 boardのpin割り当て

## 現在の判断への入口

GPIO割り当ての完了と、実機接続・サーボ出力の許可は別の判断である。
値は[信号inventory](#信号inventory)、現在の達成・未達と根拠は[競合check](#競合check)を読む。
未達項目の確認方法は[実機check](#実機check電源offの確認方法)、#2が対象とした範囲は
[初回bring-upの範囲](#初回bring-upの範囲)、サーボ有効化は[専用gate](servo-safety-limits.md#サーボ出力を有効化してよい条件)に従う。
[冒頭にあった日付付きの経緯](gpio-assignment-history.md#gpio承認とbring-up範囲の経緯)を保存した。

> **2026-11-11追記。****`HW-TBD-005`を閉じた**（`J1`／`J2`は付けない。[tbd-register.md](tbd-register.md)の解決行）**。**この文書にある、`J1`／`J2`をはんだ付けするかを「まだ決めていない」「別途計算が要る」などとする記述は、それぞれの日付の時点のものである。**現在の判断は解決行が持つ。**現在の節であった`J1`／`J2`の判断の節と、その節を前提とする`確定した入力・まだ確定できない1つの入力`の項3末尾の1文だけは削除した。
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
