wachi-yoshitaka-11-dev/deskcat/pages/assets/deskcat-concept.jpg

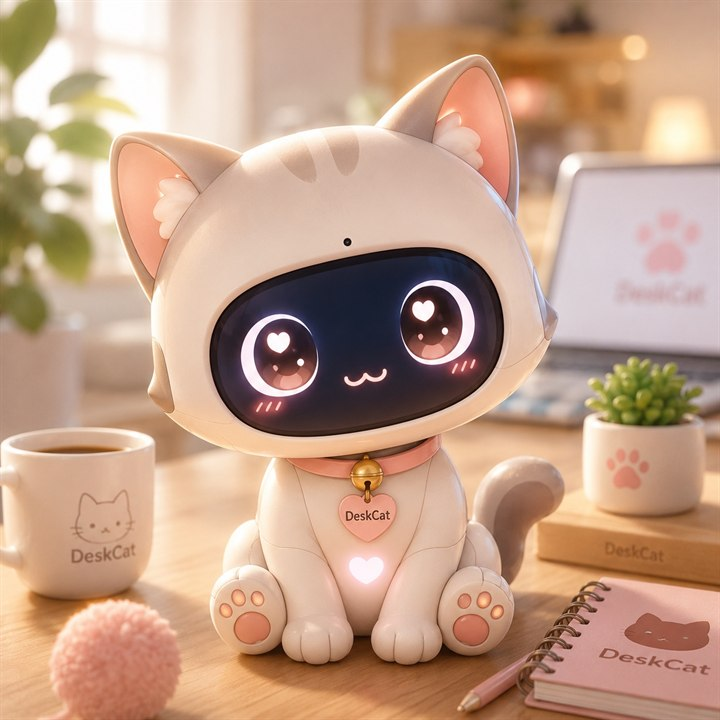
pages/assets/deskcat-concept.jpg
