wachi-yoshitaka-11-dev/deskcat/docs/hardware/hardware-bom.md

# Hardware Bill of Materials

> 状態: Draft — 正確なmoduleは現物確認が必要
> 正本とする情報: 部品識別情報と一次資料

## 規則

- 正確なメーカー、model、suffix、module boardの識別情報を記録する。
- 候補例を採用済み部品として扱わない。
- メーカーのデータシートとmodule回路図を個別にリンクする。
- deviceの識別情報が`TBD`の間はdriver開発を開始しない。
- 部品識別に使用した現物の表示または写真referenceを記録する。
- 部品を交換する場合は、既存行を黙って変更せず新しいBOM revisionとして記録する。

## 状態ラベル

| 状態 | 意味 |
|---|---|
| `Selected` | 初期DeskCat製作で使用する予定 |
| `Required` | 機能は必要だが、正確な部品は未選定 |
| `Candidate` | 評価中 |
| `Deferred` | 初期MVPには含めない |
| `Not used` | 初期製作の対象外と明示済み |

## 計算機とstorage

| Ref | 機能 | 部品／module | 状態 | 正確なメーカー／suffix | 公式文書 | 電源 | Peak電流 | 根拠／残作業 |
|---|---|---|---|---|---|---|---|---|
| MCU-01 | Real-time I/O controller | ESP-WROOM-32D開発ボード（秋月電子 M-13628） | Selected | モジュール: ESP-WROOM-32D。**module刻印で確定**（`ESPRESSIF` / `ESP32-WROOM-32D` / `FCC ID : 2AC7Z-ESPWROOM32D` / `IC : 21098-ESPWROOM32D` / `CMIIT ID : 2018DP2467` / 技適 `Ⓡ 211-171102` / KC `R-CRM-esp-ESPWROOM32D` / NCC `CCAH18LP020IT7`。2026-08-13読了）。基板silkscreen: **`ESP32_DevKitc_V4`**（Espressif ESP32-DevKitC V4リファレンスデザイン、38pin／wide版）。**silkの大文字小文字を2026-08-15に訂正した**（旧記載 `ESP32_DevkitC_V4`。現物は大文字`K`・小文字`c`で、公式回路図のtitle block `ESP32_DevKitc_V4` と一致する）。基板の日付コードは`30 18` | [秋月商品ページ](https://akizukidenshi.com/catalog/g/g113628/)（**添付はESP-WROOM-32Dモジュールとチップのdatasheetのみ。boardのpin配列表・回路図は含まない**）、[Espressif ESP32-DevKitC V4公式guide](https://docs.espressif.com/projects/esp-idf/en/v5.1/esp32/hw-reference/esp32/get-started-devkitc.html)（`J2`／`J3`のpin description表）、[ESP32-DevKitC V4公式回路図](https://dl.espressif.com/dl/schematics/esp32_devkitc_v4-sch.pdf)（title block `ESP32_DevKitc_V4`、2017-12-06） | USB Micro-B 5 V入力、board上regulatorで3.3V生成。経路は公式V4リファレンス設計の回路図で`VBUS → D3 BAT760-7（Schottky）→ EXT_5V → U2 → VDD33 → J2 pin1`、入出力とも22µF。**回路図上にヒューズ・ポリスイッチは無い**（`LESD5D5.0CT1G`×3はESD保護であって過電流保護ではない）。**ただし現物の`U2`は回路図と違う部品である。****2026-08-13の刻印読み取りで`LD1117AG` / `33AQVCUV`を確認した。回路図の`AMS1117-3.3`ではない。**どちらもSOT-223の3.3V LDOでpin互換の二次ソースだが部品が違い、`33`は3.3V版を示すと解される。回路図に無い保護部品は現物にも見当たらなかった。**2026-08-15に`U2`のメーカーを特定した。UMW（UTD Semiconductor Co., Limited）の`LD1117-3.3`（SOT-223）である**（[UMW LD1117 datasheet](https://www.umw-ic.com/static/pdf/a5e0c99cefdefaf03cfa7777b369e45b.pdf) Mar.2025、`14.Ordering information`。2026-08-15取得。根拠は刻印templateの一致であり、詳細は[tbd-register HW-TBD-023](tbd-register.md)）。**確定した仕様**: 1 A LDO、出力3.3 V版の電圧範囲**3.234–3.366 V**、dropout **最大1.30 V＠`IOUT=1A`**（`500mA`で1.25 V、`100mA`で1.20 V）、電流制限`Ilimit` **min 1.25 A／max 1.6 A**、熱shutdown`TSD` **typ 150 ℃**、`Rθja`（SOT-223）88 ℃/W。**短絡保護と折り返し特性はdatasheetに記載が無い。****記載が無いことを「保護が無い」と読み替えない**（[AGENTS.md](../../AGENTS.md) 推測禁止）。したがって**故障時にどの保護がどの順で効くかは決まっていない。****確実に言えるのは、電流制限のtrip点1.25 Aが1 Aの定格より上にあるため、`IOUT` 1.0–1.25 Aの区間は電流制限が動作しない範囲だということである。**この区間で熱shutdownが働くかどうかは放熱条件次第であり、datasheetからは決まらない。**資料が無いTBD**: `3V3` pinの外部供給可能電流の定格（Espressifはboard levelで公開しておらず、**IC側のdatasheetでも埋まらない**。ICの能力は上限を与えるだけであり、`Rθja`はdatasheetのNote 1が実装方法で変わると明記している）と`3V3` railの許容電圧範囲。これらは[power-budget.md](power-budget.md)の**段階B-2a（`3V3` pin給電）を実施してよいかのgate**であり、**参照設計の回路図だけではgateを開けない**（`段階B-2の測定`）。追跡は[tbd-register HW-TBD-023](tbd-register.md)。**配線規則の正本は[power-budget.md](power-budget.md)であり、この列では定めない。**なお公式guideは、給電経路がMicro USB／`5V` pin／`3V3` pinの3択で排他であり、2つ以上から同時に給電するとboardまたは電源が破損しうると警告している | TBD（現物測定予定） | 現物写真のpin表記（`D0`–`D3`／`CMD`／`CLK`相当がheaderに露出）、購入履歴、および基板裏面silkscreen「**`ESP32_DevKitc_V4`**」から機種確定。旧記載の「ESP32-DevKitC-32E」は誤りのため訂正。**旧記載の「Espressif公式ESP32-DevKitCではない」も根拠が無いため削除した**（Revision 29）。Flash予約pinの露出をGPIO割当時に要注意 |
| SBC-01 | 高水準controller | Raspberry Pi Zero W（ヘッダなし版。ピンヘッダを別途ハンダ付け） | Selected | Board revision: `V1.1`（基板裏面silkscreen「Raspberry Pi Zero W V1.1 © Raspberry Pi 2017」で確認） | [Raspberry Pi公式製品ページ](https://www.raspberrypi.com/products/raspberry-pi-zero-w/)、[Raspberry Pi公式documentation](https://www.raspberrypi.com/documentation/computers/raspberry-pi.html)（`Power supply`） | 5 V入力（micro USB）。connectorと電流予算はTBD。**公式documentationは`All models require a 5.1V supply`と述べる**が、**許容範囲も最低電圧も示していない**（2026-08-12に当たって確認した。あわせて`datasheets.raspberrypi.com`も当たったが、`rpizerow`のproduct briefとreduced schematicsはいずれも404であった。取得できるのは`rpizero`向けのreduced schematicsだけである）。**したがって`HW-TBD-028`(a)の最低電圧は確定しない。**同documentationの`Typical power requirements`表が`Zero W`に与えるのは推奨PSU容量1.2 Aとbare-board動作電流150 mAである。**あわせて低電圧検出回路は`except the Zero range`と明記されており、しきい値4.63 Vはこのboardに適用されない。**帰結は[power-budget.md](power-budget.md)の`Pi Zero Wには低電圧検出が無い`。**要求電圧5.1 Vと`PSU-PI-01`の5 Vが一致しない点の可否は、この行では判断しない**（[tbd-register HW-TBD-007](tbd-register.md)／[HW-TBD-009](tbd-register.md)） | TBD | 購入履歴で品名「RPI-ZERO-W」（`WH`ではない）と基板裏面のrevision表示を確認。写真のheaderは別購入の細pin headerを自分でハンダ付けしたものと推定。旧記載の「WH」は訂正 |
| SD-01 | Piのbootとstorage | Samsung EVO Plus microSDHC 32GB | Selected | Samsung。Speed Class: UHS Speed Class 1（`U1`表示） | **現行lineupに該当なし。**Samsungが公開する[EVO Plus microSD data sheet](https://download.semiconductor.samsung.com/resources/data-sheet/2023_samsung_data_sheet_microsd_card_evo_plus_rev.1.0.pdf)（2023年版 Rev 1.0）は**64GB／128GB／256GB／512GBのmicroSDXCのみ**を対象とし、32GB microSDHCを含まない。**この資料を現物の根拠に使わない** | SBCから供給 | TBD | カード本体のprint（`SAMSUNG EVO Plus 32 microSDHC U1`）で確認済み。Piのslotは空だったため、この手持ちcardを新たに使用する。**32GB microSDHC版は旧モデルであり、現行の公式資料から仕様を引けない。**識別は現物printを正とする（2026-08-10確認）。**メーカー表示については2026-08-13時点でも変わらない。**2026-08-12にcard内部registerを読み（`manfid=0x00001b`／`oemid=0x534d`／`name=EB1QT`／`date=07/2018`／`csd=400e00325b590000ee7f7f800a404000`／`scr=02b5800200000000`／`ssr=0000000005000000040090000f051c00`）、2026-08-13に読み方を[Part 1 Physical Layer Simplified Specification Version 9.10](https://www.sdcard.org/downloads/pls/)（2023-12-01）と照合した（[sd-health-check.md](sd-health-check.md)）。**`32`／`microSDHC`／`U1`の各表示はregisterと一致する**（`CSD_STRUCTURE`＝1かつ容量29.80 GiBでSDHC、`UHS_SPEED_GRADE`＝`1h`で`U1`相当、`SPEED_CLASS`＝`04h`でClass 10、`SD_SPEC`系でPhysical Layer Version 3.0X）。**ただし`Samsung`だけはregisterで裏付けられない。**同仕様書はMIDを「SD-3C, LLCが管理・定義・割り当てる」番号と規定するのみで**登録簿を収録しておらず**、`manfid=0x1b`がSamsungであることも`oemid`の`"SM"`がSamsungを指すことも検証できない。**2026-08-15に[SD-3C](https://www.sd-3c.com/Licensees.aspx)も確認したが、同社が公開するのはライセンシーの社名一覧でありMIDとの対応表は無い。したがって規格を定める側と割り当てる側の両方が公開していないため、この経路に見込みが無いとして追跡を打ち切った**（[sd-health-check.md](sd-health-check.md) Revision 12。**網羅的に探したわけではないため「一次資料が存在しない」とは書かない**）。**メーカー表示の正は引き続き現物printである。****使用前の健全性（health）checkを実施した。判定は`Partial`である。**実施日は`f3`による検査が2026-08-12、registerの読み方の一次資料照合とraw device試験が2026-08-13である（[sd-health-check.md](sd-health-check.md)、[#114](https://github.com/wachi-yoshitaka-11-dev/deskcat/issues/114)）。`f3`が書き込んだ全空き領域（29.80 GiB）へ位置依存dataを書いて読み戻し、`Data LOST`は0 sectorであった（**容量詐称は確認されず、検査範囲に読み書き不良も確認されなかった**）。**検査範囲はfile systemの空き領域であり、metadata領域と予約領域は含まない。****ただし書込み速度6.11 MB/sは10 MB/sに達していない。****この端末ではcardの速度を判定できず、追跡を打ち切った。**cardは`SPEED_CLASS`＝Class 10と`UHS_SPEED_GRADE`＝`U1`の2つを申告するが、**hostのSD clockが33 MHzで、`Class 10`の測定条件40 MHz（High Speed Mode。Ver 9.10 Table 4-61／4-62）にも`U1`の条件（UHS bus mode。Section 4.13.3）にも達しない**（`timing spec`＝`sd high-speed`、`dmesg`＝`new high speed SDHC card`）。仕様書は`Host needs to use higher frequency clock than that of measurement condition.`と明記する（Section 4.13.1.8.1）。**別cardを用意しても解決しない。速度はこの個体の用途（Piのbootとstorage）で効く要素ではないため、別hostでの測り直しも行わない。**file systemを外したraw deviceへの直接書込み（`O_DIRECT`）でも7.4 MB/sであり、**FAT32だけでは10 MB/s未達を説明できない**（読み出しはFAT32経由19.15 MB/s、raw 20.3 MB/s）。**ただし「FAT32が主因ではない」とまでは言えない。**2つの測定はI/O方式と対象範囲も異なり、寄与率を出せる比較になっていない。**card・host controller（Ricoh `1180:E823`）・file systemの寄与率は分離していない。ただし分離の前に、そもそもこの端末は測定条件を満たしていない**（上記のclock不足）。**判定するには40 MHz超のHigh Speed ModeかUHS-Iで駆動できるhostが要る。別cardでは解決しない。****「速度を確認済み」としても「card不良」としても扱わない。****ただしこれはhost側の結果である。**測定はx86_64のUbuntu host上でRicoh `1180:E823` SDHCI controllerを介して行っており、**Piへのimage書き込み、Piでのboot、PiのSD host controllerとの互換性はいずれも未確認である。**「Piのbootに使ってよい」という判断はこの記録だけでは下せない |

## Display、入力、sensor

| Ref | 機能 | 部品／module | 状態 | 正確なIC／module | Interface | Address／mode | 電源／logic | 公式文書 | 残作業 |
|---|---|---|---|---|---|---|---|---|---|
| DISP-01 | LCDの顔 | MSP2807（2.8インチSPI TFT、ILI9341、タッチパネル付） | Selected | ILI9341（LCD controller）。240×320。裏面にmicroSDスロット搭載 | 4-wire SPI | TBD | VCC 3.3–5V、**logic IOは3.3V TTL**。5V給電時の出力levelがメーカー資料で不明なため、安全側に倒して3.3V給電とする（`power-budget.md`参照） | [秋月商品ページ](https://akizukidenshi.com/catalog/g/g116265/)（[datasheet](https://akizukidenshi.com/goodsaffix/msp2807.pdf)）、[LCD Wiki](http://www.lcdwiki.com/2.8inch_SPI_Module_ILI9341_SKU:MSP2807) | **入手済み（2026-08-08着荷）**。現物のpin配列、backlight回路、VCC pin表記を確認して受け入れchecklistを完了させる（**touch controller型番は2026-08-13に`XPT2046`と確定し、`HW-TBD-003`は2026-08-15にcloseした**）。**backlight回路の確認は、このmoduleが耐えられる電流の上限（メーカー未公開）を得るためにも要る**（[power-budget.md](power-budget.md)の段階B-2の**共通**gate。B-2a／B-2bのどちらを選んでも要る。追跡は[tbd-register HW-TBD-024](tbd-register.md)、共通条件全体は[HW-TBD-025](tbd-register.md)）。**メーカーdatasheetの`Power Consumption`欄は`TBD`と印字されており、未公開であることが一次資料で確認できた**（2026-08-10）。同datasheetは14pinのinterface定義、`ILI9341`、4-wire SPI、VCC 3.3–5V、Logic IO 3.3V(TTL)、動作温度-20〜60℃までは記載するが、**touch controllerの型番と消費電流は記載しない**。**なお解像度をdatasheetは`320×240`と表記しており、この列の`240×320`と向きが逆である。****現物のsilkは`2.8 TFT SPI 240X320 V1.2`であり、この列の表記と一致する**（2026-08-13確認。パネルは`HSD028309 A2`）。向きの取り方の違いと思われるが、driverの基準は現物のbench試験で確定する（[sensor-datasheet-notes.md](sensor-datasheet-notes.md#lcd-module)）。**2026-08-13の現物確認で、board上に3.3V LDO（`U1`、刻印`662K` / `UMW S4T`）が実装されていることが判明した。**moduleが「VCC 3.3–5V」を受けられる理由がこれであり、**このLDOの供給能力がmoduleの電流上限を決める要素になる**（`HW-TBD-024`）。**2026-08-15にメーカーと品番を特定した。UMW（UTD Semiconductor Co., Limited）の`XC6206P332MR`（SOT-23、3.3V）である**（[UMW XC6206 datasheet](https://www.umw-ic.com/static/pdf/e442437afc9daa185da86486e2bfe8c5.pdf) Mar.2025、`13.Ordering information`が`UMW XC6206P332MR`をMarking `662K`／SOT-23として載せ、2行目を`UMW yww`と図示している。2026-08-15取得）。**`662K`は複数社が二次ソースする刻印であり、決め手は2行目の`UMW`と発注表の組み合わせである。**供給能力は`IOUT(max)` **min 100 mA**、過電流保護`Ilimt` typ 380 mA、短絡電流`Ishort` typ 30 mA、絶対最大`IOUT` 500 mA、`PD`（SOT-23）300 mW。**同datasheetは本文で「250 mA」とも述べるが、表の保証値は100 mAである。****ただしこれでもmoduleの電流上限は決まらない。**backlightのLED列が`U1`の出力側にあるか`VCC`側にあるかを確認していないためであり、上流なら`U1`の能力はbacklight電流を制限しない。backlight回路の部品値は`R5`＝6.8 Ω、`R6`＝1 kΩ、`Q1`＝`J3Y`、`J1`＝オープン。**ただしLED個数と接続はカプトンテープで隠れており目視で確認できない** |
| TOUCH-01 | 撫で操作／選択入力 | MSP2807のタッチパネル部（DISP-01と同一module） | Selected | **`XPT2046`（確定）。**現物裏面`U2`（TSSOP-16）の刻印を2026-08-13に読み取った（`XPT`ロゴ、`XPT2046`、ロット`ABDEAB`）。**メーカーdatasheetには型番の記載が無く、刻印が唯一の根拠である**（追跡は[tbd-register HW-TBD-003](tbd-register.md)） | 4-wire SPI（LCDと共有、CSは別） | TBD | DISP-01と同一（3.3V給電） | 同上 | DISP-01と一体のため同時購入。**入手済み（2026-08-08着荷）**。撫で動作は連続touch座標(x,y)の変化として検出する想定。**Touch controller型番は2026-08-13に現物chip刻印で`XPT2046`と確定した。**残るのはdriverに要る動作仕様（SPI mode、最大bus速度、raw出力、calibration）であり、`XPT2046`のdatasheetを当てる段階へ移った |
| ACCEL-01 | 軽打／持ち上げ／姿勢 | ADXL345モジュール（秋月 M-06724） | Selected | Analog Devices ADXL345。I2C／SPI選択式、tap／double-tap／free-fall検出をhardware内蔵 | I2CまたはSPI（3線式／4線式）、選択式。**DeskCatではI2Cで使う**（2026-09-24、ユーザー承認。[#472](https://github.com/wachi-yoshitaka-11-dev/deskcat/issues/472)の本文の`範囲`節） | Address等はTBD（現物のjumper／pin設定確認要） | **動作範囲**は`VS` 2.0–3.6V（interface電源は別系統の`VDD I/O`で1.7V–`VS`）、**絶対最大定格**は`VS`／`VDD I/O`とも−0.3V〜**+3.9V**である（Rev. G Table 1 page 4／Table 2 page 5。**動作上限と絶対最大定格は別物であり、混同しない**）。**Logic 5V railへは直結しない。これは確定した規則である。ただし根拠はIC定格からの導出ではなく、確認前の安全規則である**（moduleがregulatorを持たない場合、5VはICへ直接掛かり、動作上限3.6Vも絶対最大定格3.9Vも超える。その可能性を否定できないため禁止する。**IC定格からmodule boardの許容入力電圧は決まらない**）。**給電は3.3Vと2026-09-18に判定した**（moduleがこの電圧を受け入れる根拠は、ユーザーによる現物再確認である。判定根拠は[tbd-register.md](tbd-register.md)の`HW-TBD-004`を参照し、ここへ再掲しない。IC自体の動作範囲`VS` 2.0–3.6 Vと同一とした。3.3Vはこの範囲の内側にある。**headerからICへの経路自体は未確認のまま残るが、経路の形は電圧の上限に効かないため判定を妨げない**——対GNDの絶対値として見た場合であり、正しく製造された個体を前提とする。受動素子は電圧を上げず、能動部品が存在しないことは確定しているため。**片方のトレースだけが断線する懸念も検討したが、購入品の製造欠陥を前提とする故障モードであり範囲外とした（`#0PM`の判定。**2026-09-21、この判定について人間の承認を得た**（PMが判定を提示し、ユーザーが承認した）。2026-09-21より前は「人間の最終承認が未了。承認されなければこの行も未解決へ戻る」としていた）。**理由の全文は同行を参照）。**2026-09-18より前は「給電は3.3Vを唯一の候補とするが、まだ確定していない。IC定格と整合する候補はこれだけだが、moduleがその電圧を受け入れることの根拠は別に要る（module boardの資料が入手できず、`moduleへ入れてよい電圧`は未確定である）」としていた。この過去の記述は判断の経緯として残し、書き換えない。**同じセル内の「`regulatorの有無は現物で確認する`」も解決済みである（2026-08-13の現物確認で非搭載を既に確認しており、2026-09-18の判定はさらに未知の直列部品の不在も含めて判定した）。****「M-06724はregulator非搭載」という前提の根拠資料は現在アクセスできない**（秋月 商品ページが404。2026-08-10確認）ため、**regulatorの有無は現物で確認する**（[tbd-register HW-TBD-004](tbd-register.md)）。仮に搭載されていても5V直結の判断は変わらないが、moduleへ入れてよい電圧の上限は動作上限3.6VともIC定格3.9Vとも同一とは限らない（**3.3Vで確定した場合の**最終構成ではESP32 board上の3V3 pinから給電する。**段階B-2の測定中に限り外部3.3 V電源から給電する経路（B-2b）がある**。配線規則の正本は`power-budget.md`の`段階B-2の測定`であり、ここには再掲しない） | [Analog Devices ADXL345製品ページ](https://www.analog.com/en/products/adxl345.html)、[ADXL345 Data Sheet（メーカー公式PDF）](https://www.analog.com/media/en/technical-documentation/data-sheets/adxl345.pdf)（**Rev. G、2022年5月**。2026-08-12取得） | DeskCatの軽打／持ち上げ判定にtap／free-fall検出hardwareが適合するため採用決定。KXR94-2050（同時購入、秋月）は不採用・spare保管。Interface選択jumperと実装済みaddressは現物確認が必要。**公式文書欄を訂正した**（2026-08-10）。従来はDigi-Keyの解説記事だけを載せており、メーカーのdatasheetをリンクしていなかった。**公式PDF（Rev. G）は2026-08-12にブラウザで取得し、内容を確認した**（読み取った範囲は[sensor-datasheet-notes.md](sensor-datasheet-notes.md)の`ICの値`）。**ただしCLI clientからは取得できない**（WebFetch／curl／PowerShellのいずれも失敗する）。**「`analog.com`へは本作業環境から接続できない」という旧記載は誤りであったため2026-08-12に訂正した。**ブラウザからは取得できる。**取得できないのはCLI clientである。****Revision 32までが依拠していたSparkFun版はRev. 0であり、絶対最大定格がsupersededであった**（Rev. 0は3.6V、Rev. Gは3.9V）。また**秋月 M-06724の商品ページは現在404**（`gM-06724`／`g106724`とも）であり、「regulator非搭載」の根拠資料へアクセスできない。**2026-08-13の現物確認でregulator非搭載を確認した**（IC＋`C1`×2＋抵抗のみで3端子部品が無い）。**同時に判明した現物の事実**: IC刻印は`345B` / `#727` / `750B` / `PHIL`で、`345B`がAnalog DevicesのADXL345の刻印である（**ICの根拠がsilkと購入履歴からIC自身の刻印になった**）。**搭載pull-upは`01C`＝EIA-96で10 kΩ（1%）が4個**、ほかに`R2`＝`0`（0 Ωジャンパ）。裏面の半田ジャンパ2箇所はいずれも**オープン**。pin列は上`CS Vs GND VDD`、下`INT1 INT2 SDO SDA SCL`で、**`Vs`と`VDD`が別pinとして表記されている**（**headerのsilkラベルであり、board上の配線ではない。2系統を独立に給電してよいかは未解決である**）。**残るのは実装済みI2C addressと`moduleへ入れてよい電圧`である**（追跡は[tbd-register HW-TBD-004](tbd-register.md)）。**2026-09-18訂正: `moduleへ入れてよい電圧`は解決した（上記）。残るのは実装済みI2C addressのみである。** |
| ENV-01 | 温度／湿度／気圧 | BME280使用温湿度・気圧センサモジュールキット（秋月 K-09421） | Selected | Bosch BME280 | I2C（最大3.4MHz）またはSPI 3線式／4線式（最大10MHz）、選択式。**DeskCatではI2Cで使う**（2026-09-24、ユーザー承認。[#472](https://github.com/wachi-yoshitaka-11-dev/deskcat/issues/472)の本文の`範囲`節） | `SDO`は`GND`へ配線する（addressは[sensor-datasheet-notes.md](sensor-datasheet-notes.md)の`Address／select pin`行）。`J3`ははんだ付け済みである（**ユーザーの申告であり、実測ではない**）。`J1`／`J2`は付けない（[tbd-register.md](tbd-register.md)の`HW-TBD-005`の解決行） | DC1.71V～3.6V。**5V直結不可**、最終構成ではESP32 board上の3V3 pinから給電する。**段階B-2の測定中に限り外部3.3 V電源から給電する経路（B-2b）がある**（配線規則の正本は`power-budget.md`の`段階B-2の測定`） | [Bosch BME280 Data Sheet](https://www.bosch-sensortec.com/media/boschsensortec/downloads/datasheets/bst-bme280-ds002.pdf)（`BST-BME280-DS001-24`、Revision 1.24、2024年2月）、[秋月商品ページ K-09421](https://akizukidenshi.com/catalog/g/g109421/)、[AE-BME280製品説明書](https://akizukidenshi.com/goodsaffix/AE-BME280_manu_v1.1.pdf)（v1.1、2015-06-02） | 説明書記載値を使用。**公式文書欄を訂正した**（2026-08-10）。従来は「現物付属の製品説明書」とだけ書きURLが無く、Boschのdatasheetもリンクしていなかった。なお秋月がホストする`BST-BME280_DS001-10.pdf`はRevision 1.0世代のため、**Bosch公式の現行版（1.24）を正とする**。説明書から確定した仕様: **`J1`＝I2C時のSDA用プルアップ(4.7kΩ)選択、`J2`＝同SCL用、`J3`＝I2C時にはんだジャンパ（SPI 4W／3W時はJ1〜J3すべてオープン）**。I2Cアドレスは`0x76`（SDO→GND、既定）／`0x77`（SDO→VDD）。6pin SIPは1=VDD, 2=GND, 3=CSB, 4=SDI, 5=SDO, 6=SCK。VDDとVDDIOは基板上で接続済み。Chip ID register `0xD0`、reset値`0x60`。`J1`／`J2`／`J3`の状態と根拠の水準は[sensor-datasheet-notes.md](sensor-datasheet-notes.md)の`jumper（AE-BME280）`節が持つ |
| LED-COMM-01 | Pi–ESP32通信状態の外部表示 | 白色発光ダイオード×1（手持ち5本） | Selected | OptoSupply `OSPW5111B-QR`。2026-10-01にユーザー提供の包装写真で`Part NO.: OSPW5111B-QR`、`Lot NO.: JEC10003`、`Color: white`、`QTY: 5pcs`を確認。販売品も同型番・メーカーで一致 | ESP32 GPIO2から電流を出して駆動（source。電流制限抵抗`R`の直列、10 kΩ pull-down。`R`は`RES-LED-01`）。[初回デモ回路案](led-514-demo.md) | 該当なし | 初回デモはGPIOから`R`で電流制限（GPIOの電流が`3V3` pinを通るかは記録が無く、安全側の仮定で3V3系に数える。330 Ωの許容差の下限で最大11.5 mAの計算。実測前）。[メーカーdatasheet](https://akizukidenshi.com/goodsaffix/OSPW5111B-QR.pdf) Rev A.0：順方向電圧2.8–4.0 V（typ 3.4 V、20 mA・25 ℃）、DC順方向電流の絶対最大定格30 mA。点滅は直流点灯の繰り返しなので、peakも上の最大値（計算）と同じ | [OptoSupply datasheet](https://akizukidenshi.com/goodsaffix/OSPW5111B-QR.pdf)（販売店掲載のメーカー作成資料）、[販売店の同型番ページ](https://akizukidenshi.com/catalog/g/g101170/) | 袋には`Vf: 2.9-3.6 V`、`Typ: 7000mcd@20mA`、`If(max): 30mA`、`V.A.: 15 deg`とある。**袋のVfとdatasheetの2.8–4.0 Vは一致しない。**袋の測定条件は不明なので、狭い2.9–3.6 Vを回路の設計保証値にしない。20 mA・15°で明るい指向性LEDのため、外部表示の明るさと拡散を確認する。通信成立・喪失はESP32側の受信状態から判定する。点灯意味と初回デモ回路は[回路案](led-514-demo.md)へ記録した。未了の項目は[回路案](led-514-demo.md)の状態行が持つ（起動・点灯の観察は[EXP-025](experiment-log.md#exp-025-追加ledの点灯試験赤だけ白だけ両方)）。現行firmwareは継続通信を判定できないため、通信状態の表示は未実装。点灯試験と白の点滅だけを`bringup-led-514` featureで実装した（実機での観察は[EXP-025](experiment-log.md#exp-025-追加ledの点灯試験赤だけ白だけ両方)。[HW-TBD-037](tbd-register.md)） |
| LED-REACT-01 | 猫の反応の外部演出 | 赤色発光ダイオード×1（手持ち約20本、10本入り×2袋） | Selected | OptoSupply `OSHR5161A-QR`。ユーザーが書籍用スターターパーツセット`K-03249`由来と申告し、示した[セット写真](https://cba.sakura.ne.jp/imagekit3/kit686i1.jpg)の赤色LEDの2袋とも同型番。デモ用の部品識別として採用（2026-10-01）。個々のロット照合は着手条件にしない | Piが反応を判断し、ESP32 GPIO5から電流を出して駆動（source。`R`の直列、10 kΩ pull-down）。[初回デモ回路案](led-514-demo.md) | 該当なし | 初回デモはGPIOから`R`で電流制限（GPIOの電流が`3V3` pinを通るかは記録が無く、安全側の仮定で3V3系に数える。330 Ωの許容差の下限で最大11.5 mAの計算、実測前）。[メーカーdatasheet](https://akizukidenshi.com/goodsaffix/OSHR5161A-QR.pdf)：Vf 1.8–2.6 V（typ 2.1 V、20 mA・25 ℃）、DC順方向電流の絶対最大定格50 mA。LEDを短絡した場合の枝電流の計算値は、330 Ωの許容差の下限で11.5 mA。実機での点灯の観察は[EXP-025](experiment-log.md#exp-025-追加ledの点灯試験赤だけ白だけ両方)。LED電流の実機測定は未実施 | [OptoSupply `OSHR5161A-QR` datasheet](https://akizukidenshi.com/goodsaffix/OSHR5161A-QR.pdf) | [#514](https://github.com/wachi-yoshitaka-11-dev/deskcat/issues/514)の猫の演出用。写真の袋には`Vf: 1.8-2.0V`、`QTY: 10PCS`と読めるが、datasheetの広いVf範囲を回路検討に用いる。初回デモは`happy`で1秒点灯する案（[回路案](led-514-demo.md)）。未了の項目は[回路案](led-514-demo.md)の状態行が持つ（起動・書き込み・点灯の観察は[EXP-025](experiment-log.md#exp-025-追加ledの点灯試験赤だけ白だけ両方)）。Piの判断をESP32へ伝える方法は既存の`set_expression`を候補とするが、現行firmwareは受け取った`set_expression`をlogに出すだけで、赤LEDを点けない。点灯試験の区間だけ赤を点ける`bringup-led-514` featureを実装した（実機での観察は[EXP-025](experiment-log.md#exp-025-追加ledの点灯試験赤だけ白だけ両方)。[HW-TBD-037](tbd-register.md)） |
| COLOR-01 | 環境色 | I2C対応デジタルカラーセンサモジュール S11059-02DT（秋月 K-08316） | Deferred | Hamamatsu S11059-02DT | I2C | TBD | TBD | [Hamamatsu公式](https://www.hamamatsu.com/us/en/product/type/S11059-02DT/index.html) | 初期MVPでは選定しない。将来featureで再検討する際の識別情報として記録 |

部品候補は、正確な現物識別と公式文書の確認後に追加する。候補例や類似部品を採用済みとして扱わない。

## 駆動系と電源

| Ref | 機能 | 部品／module | 状態 | 正確なmodel | 定格電圧 | Peak／stall電流 | 公式文書 | 残作業 |
|---|---|---|---|---|---|---|---|---|
| SERVO-01 | 首振り | TowerPro Micro servo 9g SG90 | Selected | TowerPro SG90 | 4.8–6V（外部5 V系はproject方針）。**出所を2026-08-24に訂正した。**TowerPro公式製品ページの仕様表の記載は`Operating voltage: 4.8v`だけであり、**4.8–6 VはDigital側ページのQ&A欄にある`admin`（メーカー側）の回答（2021-11-07）にのみ由来する。仕様表由来の値ではなく、Analog側ページは`Reviews (0)`である**（[tbd-register HW-TBD-026](tbd-register.md)） | **動作電流としてのメーカー回答値は0.5–2 A（負荷依存）。**この列が指すpeak／stall電流そのものは未確定である（実測が要る。`HW-TBD-010`／`011`）。**`データシート値`という表記を2026-08-24に外した。****この値は、メーカーが`operation current`として述べたものであり、peak／stallの実測ではない**（`The operation current for our SG90 is about 0.5A - 2A.`）。**2026-08-25に、この列の中で種別を書き分けた**（[#193](https://github.com/wachi-yoshitaka-11-dev/deskcat/issues/193)）。**値は落としていない。`TBD`へ戻したのでもない**（[PR #194](https://github.com/wachi-yoshitaka-11-dev/deskcat/pull/194)の判断は維持する）。**列を新設して値を移す設計変更も行っていない。**この0.5–2 Aは、仕様表ではなくDigital側ページのQ&A欄にある`admin`（メーカー側）の回答（2021-11-07）にのみ由来する（Analog側にreviewは無い）。**どちらの品かが未確定なため、variantに依存しない値として扱わない。**実測の扱いは変えない（peak／stallの確定は`HW-TBD-010`／`011`の範囲である） | [TowerPro公式 SG90 Digital](https://towerpro.com.tw/product/sg90-7/)、[TowerPro公式 SG90 Analog](https://towerpro.com.tw/product/sg90-analog/)。**公式サイトにSG90のdatasheet PDFは無い。**[Download](https://towerpro.com.tw/download/)にファイルの掲載がなく、製品ページにも`.pdf` linkがない（2026-08-24確認）。**したがって一次資料は製品ページの仕様表だけである。**[Soldered_101246.pdf](https://www.mouser.com/catalog/specsheets/Soldered_101246.pdf)は**TowerPro発行と確認できていない第三者掲載のPDFであり、2026-08-24時点でこの環境から取得できない**（`HTTP/2 200`を返すが`content-type`は`text/html`で、Akamaiの`x-reference-error`を伴う）。**sha256を記録できないため、他の品と同じ一次資料の扱いにしない** | ラベル現物確認済み。Peak／stall電流と機械的可動域は`power-budget.md`の測定計画に従い実測が必要（[tbd-register HW-TBD-010／011](tbd-register.md)）。**2026-08-24に電気的駆動条件の一次資料を確認した。(a)制御logic要件、(b)PWM周期／rate、(c)許容最小／最大pulse幅はいずれも公式の仕様表に記載が無く、`HW-TBD-026`はcloseしていない。**確認結果の全数と、**公式サイトに同名3品（`SG90 Digital`／`SG90 Analog`／`SG90 360 degree`）**があり現物ラベルで判別できない点は[tbd-register HW-TBD-026](tbd-register.md)が正である（**ここへ再掲しない**）。**旧記載は「同名2品」であった。**3品目の`SG90 360 degree`はRevision 64（2026-08-24）で判明していたが、**この欄には反映されていなかった。****2026-08-25に判定基準を確定した。判定は寸法で行う。**仕様表の`Dimension`が`23×12.2x29mm`（`Digital`／`Analog`）と**`23×12.5x22mm`（`360 degree`）**で、**高さが29 mmと22 mmで7 mm違う。**幅と奥行の差は0.3 mmしかないため判定に使わない。**寸法で分離できるのは3品目だけである。`Digital`と`Analog`の判別には使えない**（両者は寸法が同一）。**3ページの仕様表を一次資料から直接再確認した**（2026-08-25。生HTMLを取得して`Dimension`行を読んだ）。**2026-08-28に高さを実測した（[Issue #257](https://github.com/wachi-yoshitaka-11-dev/deskcat/issues/257)。27 mm）。**29 mm側に近く、`SG90 360 degree`ではないと判定した。**`Digital`と`Analog`の判別は未達のままである**（正は[tbd-register HW-TBD-026](tbd-register.md)）。**2026-08-30に、袋の表示を追加で記録した。**現物が入っていた袋には`TH270`とのみ印字されており、メーカー名・数量・色・バーコード・原産国その他の記載は無い。**`TH270`の意味は調査したが確定できなかった**（TowerPro公式サイト、SG90関連の実在ページ、主要な販売代理店ページのいずれにも同文字列は見つからない。実在が確認できた`TH270`はDMC/Daniels製crimp tool turret head、Standard Motor Products製throttle position sensor、Sencor製weather station用sensor、腕時計の型番であり、いずれもservoとも当リポジトリの部品とも無関係である）。**事実として記録する：検索toolの要約は`Tower Pro TH270 SG90 Micro Servo`という趣旨の表題を複数回返したが、実際の検索結果リンクの中にその表題を持つものは1件も無い。これは要約段階の誤生成であり、実在する記述ではない**（次にこの文字列を調べる者が同じ要約を受け取り得るため、既に確認済みの誤りとして記録する）。**したがってこの表示を現物識別または`HW-TBD-035`の根拠として使わない。**調査経緯の正は[tbd-register HW-TBD-035](tbd-register.md)。**ここへ再掲しない** |
| PSU-SERVO-01 | サーボ電源 | PSU-PI-01と同一のACアダプターから分岐したservo rail | Selected（入力源は確定。分岐後の部品はTBD） | 入力はPSU-PI-01と共通（M-12001）。Servo直近のbulk capacitorは候補として電解コンデンサ470μF／16V（秋月 g108426、ルビコンWXA）を想定するが、最終容量は実測待ち（`power-budget.md`配線・保護表）。**2026-08-22に`PSU-PI-01`（M-12001）のcable外被の表示`20AWG`を記録した（現物確認、定格の主張には使わない）。**2026-09-09、ユーザーが案B（[power-budget.md](power-budget.md)の`M-12001のcableを受ける端子台`行）の終端方法確定のため同じcableの印字を再度撮影し、`E520447`（UL file number）／`AWM STYLE 2464`（UL flexible cordの型式）／`20AWG`／`80℃`／`300V`／`VW-1`／`CU AWM I A`／`FTI`（難燃性の試験規格）／製造元名（`Xiamen Seebest-B...`、末尾は写真で切れており未確認）を確認した。**`20AWG`は2026-08-22の記録と一致（裏付け）。他は今回新たに得た一次資料である。****いずれも定格の主張には使わない**（換算方法が未確定。`HW-TBD-022`） | 5V（共通入力からの分岐） | TBD | [秋月商品ページ](https://akizukidenshi.com/catalog/g/g112001/) | Servo起動時の過渡電流を吸収するbulk capacitorの容量選定と、logic railへの影響評価が必要（`power-budget.md`測定計画、[tbd-register HW-TBD-007](tbd-register.md)） |
| PSU-INGRESS-01 | ACアダプターのplugをbreadboardへ引き込む物理変換 | Micro-Bメスreceptacleの2.54mm変換基板（DIP化キット） | **Not used（2026-09-09、案Bにより`Selected`から変更。2026-09-09、PM確認済み）** | **2026-09-09に人間が決定した案B（M-12001のcableを切って端子台へ受ける構成。終端方法は[power-budget.md](power-budget.md)の`経路部品と定格`の`M-12001のcableを受ける端子台`行を参照）により、5 V ingressの経路から外れた。**組立済みの現物は手元に残り、破棄はしていない（状態ラベルの`Not used`＝「初期製作の対象外と明示済み」に照らして提案した。案Bが覆った場合の代替経路として再検討しうる）。**2026-08-25に発注する品として確定した。**秋月 通販110972「電源用マイクロUSBコネクターDIP化キット」`AE-MRUSB-DIP`（¥130、**電源専用**、`定格電圧：30V`／`定格電流(1ピン)：1.5A`、microBメス／L型／スルーホール）。**2026-09-03着荷、現物の表示を写真で確認した。**個装のバーコードラベルは`¥130(税込)`／`参考 ¥119`／バーコード`2900001109727`／ロット`250109 K0740`／型番`AE-MRUSB-DIP`／品名『電源用マイクロUSBコネクターDIP化キット』／通販コード`110972`／内容量`1セット`と印字されており、既存の記載と一致する。**同梱物は未組立のキットであり**、緑色の小基板・ピンヘッダ・microBメスreceptacle・乾燥剤（シリカゲル）が個別部品として同一袋に入っている（**組立の要否・手順は別途要る**）。**発注と着荷の状態は[#205](https://github.com/wachi-yoshitaka-11-dev/deskcat/issues/205)が持つ。この表は追わない。** | 5V | ingress全体を通る電流。上限は経路上の全部品の定格の最小値の80%。**値の正は[power-budget.md](power-budget.md)の`判明している最小定格が1.25 Aへ下がった（2026-08-25）`であり、ここへ再掲しない。****未確定の経路要素が残るため確定値ではない** | [秋月 通販110972](https://akizukidenshi.com/catalog/g/g110972/)（2026-08-25取得。**添付は参考資料(基板寸法図)のPDFだけであり、組立手順もセット内容も無い**） | **調達（発注・着荷）の状態は[#205](https://github.com/wachi-yoshitaka-11-dev/deskcat/issues/205)が持つ。この表は持たない。****2026-09-09、案Bにより、この品は経路から外れた。**合成給電（段階C）の測定挿入点・保護部品・線材の現行の要件は[power-budget.md](power-budget.md)の`経路部品と定格`・`servo試験以降で用いる構成`が正本である。**ここへ再掲しない**（案B以前は、この品自身が段階Cの前提だった。旧い経緯は[hardware-bom.md](hardware-bom.md)本行のRevision履歴を参照） |
| CABLE-PI-PWR-01 | breadboard railからPiへの給電 | Micro-Bオスcable | Selected（許容電流は非公開のまま） | **2026-08-25に品を確定した。**[秋月 通販109314](https://akizukidenshi.com/catalog/g/g109314/)「USBケーブル USB2.0 Aオス-マイクロBオス 0.5m」（`USB CABLE A-MICROB(2A L0.5m)`、¥150）。**この品は導体の許容電流もAWGも公開していない。**仕様欄にあるのは`長さ：500mm`と`電線外径：3.8mm`だけで、型番の`2A`が何の定格かの説明も無い。**したがってこの行の従来の選定規則（許容電流またはAWGが公開されている品を選ぶ）を満たさない。**同等品の公開値・実測・`107666`への変更という選択肢と、`107666`を採った場合の帰結は[power-budget.md](power-budget.md)の`経路部品と定格`の同行が持つ。ここへ再掲しない。****2026-08-25に人間がこの行へ許容電流の公開を求めないと決めた**（同日のユーザーの指示。内容は記録しない（ai-agent-policy.md））。**同日、この扱いは正本にも入った。**[Hardware Safety Policy](../governance/hardware-safety-policy.md)の`安全要件の5項目`（短絡／逆極性／給電経路の重複／電圧違いのpinへ挿す／servoの持続的拘束）と`5項目以外の扱い`（**5項目に効かないものは、一般的な値で始めて、動かして観察してよい**）がそれであり、根拠は[ADR-0014](../decisions/0014-safety-requirements-and-general-values.md)（**`Accepted`**、2026-08-25）である。**この行は5項目のいずれでもない。****Pi link経路では[#174](https://github.com/wachi-yoshitaka-11-dev/deskcat/pull/174)が既に同じ判断をしている。****あわせて自作用の選択肢として[通販107666](https://akizukidenshi.com/catalog/g/g107666/)**（Useconn `MOUSB-5BM103AS`、ケーブル取付用Micro-Bオス、`定格電圧：30V`／`定格電流(1ピン)：1A`、¥60）**を候補として選んだ。**導体は`111641`（許容電流が公開されている）になる。**採用した場合、コネクタの1 Aが経路の新しい最小値になり、ingressの上限が0.8 Aへ下がって定常見積840 mAを下回る。****rail側の受け方は2026-08-24に②（ケーブルを加工して直付け）で確定している。**USB-Aオスplugを切り落とし、VBUSとGNDの2本を`WIRE-PWR-01`の端子台へねじ止めする。**Pi側のmicro-Bオスplugは加工しない**（極性がコネクタで固定される）。**ただしPi側のMicro-B plugとPiの`PWR IN` receptacleの嵌合接点は残り、`経路部品と定格`表の1行である**（定格は`TBD`）。**2026-09-03着荷を写真で確認した。**`109314`のcable本体の印字を、より鮮明な拡大写真で再確認した。**印字は`AWM E337974 2725 VW-1 80℃ 30V 28AWG/1P 22AWG/2C [判読できない記号] AWM I A 80℃ 30V FT1 DePuK`**であり、**`E337974`はULのFile Number（AWM = Appliance Wiring Material区分）である。****File Numberからメーカー名の特定を試みた。**`iq.ul.com/awm/File.aspx?FN=E337974`（file単位の照会画面）は旧systemの現行仕様として恒常的に案内文だけを返す作りになっており、queryを問わずFile Numberでの直接照会はできない。**新system（`iq.ulprospector.com`）はCloudflareのbot対策（`Warning: Blocked`、HTTP 403）でcurl・WebFetchからのaccessを拒否し、本環境にはinteractiveなbrowser toolも接続されていない。**そこで`iq.ul.com/awm/company.aspx?Style=<style番号>`（styleに対して認可されている全社を列挙する、同じ旧systemの生きているendpoint）を使い、cable本体の印字にある`2725`を含め、USBケーブルで一般的な`AWM`style（`2464`／`2517`／`2725`／`2835`／`20276`／`21198`）の6件について認可企業一覧（あわせて2,000社超）を全件取得し`E337974`を検索したが、**いずれにも該当が無かった。****したがってメーカー名は特定できなかった。**近い番号`E337936`は`Style 2725`の一覧に存在したが、**印字はE337974であり、桁の見誤りとして扱う根拠は無い。****これ以上の特定には、UL Product iQへの人間による直接ログイン（company名からの逆引き、または別styleの網羅的な照合）が要る。****`2C`は電源用と見られる2導体（VBUSとGND）を指すと解される。****この情報は#204(3)の免除の判断を変えない**（免除は許容電流の公開を求めないという判断であり、公開の有無にかかわらず既に適用済みである）。**File Number単体・AWG表記単体では、この行が本来求める「許容電流そのもの、または製造者が公開する`導体抵抗`」のいずれの証拠にもならない**（`線材の許容電流をどう確定させるか（2026-08-22の調査）`が同じ理由で秋月`UL1015 AWG18`のAWG表記のみを不十分とした前例と同じ扱いである）。**メーカーが特定できれば、そのメーカーの公開資料を追って`導体抵抗`または許容電流を確認できる可能性があり、****この点は未解決のまま残す。**`107666`は個装バッグに『`C-07666`／`MOUSB-5BM103AS`／ケーブル取付用USBコネクタ(microBタイプ、オス)』の印字があり、**既存の記載（Useconn `MOUSB-5BM103AS`）と一致する。****発注と着荷の状態は[#205](https://github.com/wachi-yoshitaka-11-dev/deskcat/issues/205)が持つ。この表は追わない。** | 5V | Piの消費電流。**通すのはPi branchの分だけであり、[power-budget.md](power-budget.md)の`負荷表`のPi Zero Wのstress時350 mAが上界である。****この品の導体の定格は非公開であり、観察で扱う** | [秋月 通販109314](https://akizukidenshi.com/catalog/g/g109314/)、[秋月 通販107666](https://akizukidenshi.com/catalog/g/g107666/)（いずれも2026-08-25取得） | **調達（発注・着荷）の状態は[#205](https://github.com/wachi-yoshitaka-11-dev/deskcat/issues/205)が持つ。この表は持たない。** **合成給電（段階C）から必要。**段階Cではbreadboard railからこのcableでPiの`PWR IN`へ入れる（[power-budget.md](power-budget.md)の段階表）。段階A・段階B-1までは不要で、それまでのPiの給電は、2026-10-11の差し替えまでは`PSU-PI-A-01`と`CABLE-PI-A-01`、以降は`PSU-PI-A-02`（cable一体）で行う（M-12001のplugは`EXP-012`で切断済みであり、直挿しできない）。**調達の単位は[#205](https://github.com/wachi-yoshitaka-11-dev/deskcat/issues/205)が持つ** **公開値の免除は、この cable を短絡安全の対象から外さない。**選定規則を満たさないことと、5 V branch の wire／connector として短絡（発熱）の安全要件に掛かることは別である。**この cable は短絡安全の対象経路に含まれる。**[Hardware Safety Policy](../governance/hardware-safety-policy.md)の安全要件5項目の1つ目（短絡）は、**公開値の有無で免除されない。****したがって、この行を「条件免除により完了」と読まない。**短絡安全の受け入れは未了のまま残っている（[tbd-register.md](tbd-register.md)の`HW-TBD-021`／`HW-TBD-022`が扱う）。 |
| PSU-PI-A-01 | 段階AのPiの給電（[power-budget.md](power-budget.md)の段階表のA行） | USB ACアダプター（USB-A） | **Not used（2026-10-11、段階Aの給電から外した。`PSU-PI-A-02`へ差し替えた。`EXP-020`が参照するため行は残す）** | ELECOM ADAPTER、モデル`NY-PW012-0001000`。labelの文字はユーザーの書き写し（2026-10-02）：入力「100V～240V 50/60Hz MAX0.2A」、出力「5.0V=1.0A」。ユーザーの手持ち | 5.0V（label）。Raspberry Pi公式は5.1 Vを要求し、満たすかは未判断 | 1.0A（label）。Raspberry Pi公式がZero Wに推奨するPSU容量1.2 Aを下回る | メーカーの資料は確かめていない | この組み合わせでPiが動いた観察は[experiment-log.md](experiment-log.md)の`EXP-020`。2026-10-11に段階Aの給電から外した（出所：[#446の記録](https://github.com/wachi-yoshitaka-11-dev/deskcat/issues/446#issuecomment-6109307768)） |
| CABLE-PI-A-01 | `PSU-PI-A-01`からPiの`PWR IN`への給電 | USB-A→Micro-Bのcable | **Not used（2026-10-11、段階Aの給電から外した。`PSU-PI-A-02`のcable一体の線へ差し替えた。`EXP-020`が参照するため行は残す）** | `TBD`（ユーザーの手持ち。印字は無い） | `TBD` | `TBD` | `TBD` | 型番と定格は分からない。本体表記が無い。このcableが`EXP-009`の「表記なし」と同じ現物かは、同定していない。この cable は短絡安全の対象経路に含まれる。許容電流とAWGは不明で、`HW-TBD-022`で追跡する。段階Aと段階B-1のPiの給電に使う（段階Aに使うことは、ユーザーが決めた。[#446の記録](https://github.com/wachi-yoshitaka-11-dev/deskcat/issues/446#issuecomment-5952463629)）。段階Aは探索的な通電である。同記録は、新しい電源の初回使用のため人間が立ち会うとしている。**2026-10-11に給電経路から外れた**（出所：[#446の記録](https://github.com/wachi-yoshitaka-11-dev/deskcat/issues/446#issuecomment-6109307768)）。#247の2026-09-28の決定に対する例外（[#446のcomment](https://github.com/wachi-yoshitaka-11-dev/deskcat/issues/446#issuecomment-6098371129)。範囲は、探索的な段階Aと段階B-1、人間の立ち会い、本体に表記のあるcable〔107607〕へ差し替えるまで）の対象は、この品を使っていた間だけである。**この例外は終了した**（ユーザーの決定、2026-10-12。2026-10-11に給電が`PSU-PI-A-02`のcable一体の線へ替わり、この品は使わない。[#446のclose時のcomment](https://github.com/wachi-yoshitaka-11-dev/deskcat/issues/446#issuecomment-6126183055)）。 |
| PSU-PI-A-02 | 段階AのPiの給電（[power-budget.md](power-budget.md)の段階表のA行。2026-10-11の差し替え以降。段階B-1〔検証の構成〕のPiの給電も、段階Aのadapterで代用する。同書の`5 V ingress`節の段階表） | AC100-240V入力のACアダプター（cable一体。先端にplug） | Selected（段階A：ユーザーの決定（[#446の記録](https://github.com/wachi-yoshitaka-11-dev/deskcat/issues/446#issuecomment-5952463629)は段階Aの給電を決めたもので、112001への差し替えの決定は記録を確認できない）。段階B-1：[power-budget.md](power-budget.md)の`5 V ingress`節の記述（段階Aのadapterで代用する）に従う。いずれも実測ではない。`PSU-PI-A-01`と`CABLE-PI-A-01`の後継） | 品はユーザーが`112001`と呼ぶ（[#446の記録](https://github.com/wachi-yoshitaka-11-dev/deskcat/issues/446#issuecomment-6104039603)）。秋月の通販コード`112001`は`PSU-SERVO-01`行の`M-12001`が指すコードと同じだが、ユーザーが書き写したlabelの文字に型番は含まれない。labelの文字はユーザーの書き写し（2026-10-11、[#446の記録](https://github.com/wachi-yoshitaka-11-dev/deskcat/issues/446#issuecomment-6104039603)）：入力「AC100-240V 41-55VA 50/60Hz」、出力「DC5V 3.0A」。別に`20AWG`の印字がある。**M-12001と同じ品かは、ユーザーの申告であり、表記だけでは決めない**（[#446の記録](https://github.com/wachi-yoshitaka-11-dev/deskcat/issues/446#issuecomment-6104068278)）。cable一体で、`CABLE-PI-A-02`は無い（`107607`はPiの給電に使わない） | 5V（label）。**この個体の出力電圧は実測していない。**Raspberry Pi公式は5.1 Vを要求し、満たすかは未判断 | 3.0A（label） | メーカーの資料は確かめていない | **極性と出力電圧を実測していない。事前測定を行わない決定はユーザーが行った**（[#446の記録](https://github.com/wachi-yoshitaka-11-dev/deskcat/issues/446#issuecomment-6105175775)）。`EXP-012`の極性判定は別の個体のcableで行ったもので、この個体には当てはめない。plugの形も確かめていない。**cable一体の線は、短絡安全の対象経路に含まれる。**許容電流は未確認である（`20AWG`の印字だけがあり、定格の主張には使わない）。[tbd-register.md](tbd-register.md)の`HW-TBD-022`で追跡する。この組み合わせでPiが動いた観察は[experiment-log.md](experiment-log.md)の`EXP-023`（約6分）と`EXP-024`（2026-10-12。Piはuptime 22時間47分で連続して電源が入っていた。ESP32側の端を挿した状態で`deskcatd`が`active`だったのは、journalの`Started`（JST 20:53:03）から`Stopped`（20:54:39）までの約1分36秒。Piでのbuild 19分34秒。負荷をかけた長時間の運転は試していない） |
| CABLE-PI-LINK-01 | Pi–ESP32間のUSB serial link | USB OTG cableまたはMicro-B ⇔ Micro-B OTG変換（PiのUSB OTG port ⇔ ESP32のMicro USB） | Selected（手持ちで充当） | **2026-09-28、Pi linkはGPIOのUARTへ変わり、このcableのPi linkとしての役割は終わった**（[#446](https://github.com/wachi-yoshitaka-11-dev/deskcat/issues/446)。正は[gpio-assignment.md](gpio-assignment.md)の`Pi–ESP32間のtransport`節）。**ESP32の給電を兼ねる役割（案A）は、今の計画ではない。**[power-budget.md](power-budget.md)の`ESP32の給電経路（最終の経路は未決定）`節の改訂（[#488](https://github.com/wachi-yoshitaka-11-dev/deskcat/issues/488)の`A4`）で、案Aは[#405](https://github.com/wachi-yoshitaka-11-dev/deskcat/issues/405)の見直しの候補として残した（PM（#0PM）の作業指示による扱い。ユーザーの決定ではない）。**本体表記の無いUSBケーブルは使わない**（[#247](https://github.com/wachi-yoshitaka-11-dev/deskcat/issues/247#issuecomment-5863026168)のユーザーの決定。機序は測定していない）。**[EXP-009](experiment-log.md)の「表記なし」がどの現物かは同定していない。****この列の以下の記述と、後ろの列の記述は、2026-09-28より前の状態であり、当時の記録として残す。**手持ちで充当する。購入不要**（2026-08-22）。**案Aで確定したため、このcableがESP32の給電を兼ねる**（正は[power-budget.md](power-budget.md)の`案Aを本線に確定した（2026-08-22、人間の判断。2026-09-28に置き換わった。以下は当時の記録）`）。**現物確認（2026-08-22、所有者の申告）**: USB OTGケーブル（`Aメス（ジャック）⇔ micro-Bオス`）**1本**、ノーブランド品、**表示なし**。A-microBケーブル**5本**（1 m は**`28AWG`の印字あり**でESP32↔PCのflashingに現用。50 cm／100 cm／110 cm／150 cm は**いずれも表示なし**）。**50 cmを推奨する。**最短であるため電圧降下が最小になり、かつflashing用の1 mと用途が競合しない | — | **この経路に許容電流の公開要求を課さない**（正は[power-budget.md](power-budget.md)の`Pi link経路に許容電流の公開要求を課さない（2026-08-22）`。**ここへ再掲しない**）。**判定は実測とし、判定量はESP32入力電圧が下限を割らないことである。****下限は暫定であり確定していない**（`HW-TBD-023`）。**市販OTGケーブルは軒並みAWGを公開しておらず、公開されているのは線材規格までである。**そのため公開要求を課しても満たす品が市販されていない | — | **FND-001〜003には不要。**M2（protocol実装）で必要になる。それまでESP32はPCからUSBで給電・flashingする。transportの確定内容は[gpio-assignment.md](gpio-assignment.md)、給電を兼ねるか否かは[power-budget.md](power-budget.md)の`ESP32の給電経路（最終の経路は未決定）`節 **2026-08-22に案Aで確定したため、この行は給電を兼ねる前提で読む。****購入待ちリストからは外した。** |
| PROTO-01 | 試作用配線 | ブレッドボード(秋月 EIC-3901、6穴版)、ミニブレッドボードBB-601(スケルトン)×2、クリップ付コード5色45cm×10本、細いピンヘッダ20P×5(Pi header用に一部使用済み) | Selected | 手持ち品。個別の許容電流はメーカー資料未確認 | 回路に従う | **gate対象の大電流経路には使わない**（許容電流がメーカー資料で確認できず、経路の最小定格を出せないため）。信号線と、ESP32の`3V3` pinから取る小電流branchに限る | TBD | 現物写真・購入履歴で確認済み。**大電流経路（5 V ingress → 分岐点 → 各railの往路、およびGND戻り）は`WIRE-PWR-01`で構成し、breadboard接点とジャンパー線を通さない。**決定の根拠は[power-budget.md](power-budget.md)の`大電流経路にbreadboard接点とジャンパー線を使わない` |
| PROTO-02 | スルーホール部品の実装先 | 片面ガラス・ユニバーサル基板 Cタイプ（72×47.5 mm） | Selected | **2026-08-25に追加した。**秋月 通販100517（¥120）。FR-4（ガラスエポキシ）、板厚1.6 mm、ランドピッチ**2.54 mm**、穴径1 mm、取付穴径3.2 mm、片面、はんだメッキ仕上げ。**2枚（1枚は予備）。****この行はどの文書にも無かった。**`PSU-INGRESS-01`（`110972`）・`PROT-OC-01`のホルダ（`110521`）・`WIRE-PWR-01`の端子台（`114217`）・`PROT-RP-01`（`102846`）は**いずれもスルーホール実装品**であり、`大電流経路にbreadboard接点とジャンパー線を使わない`という決定がある以上、**はんだ付けする実装先が要る。**それにもかかわらず`ユニバーサル基板`は2026-08-25時点で`docs/`全体の走査で**0件**だった。**`工具`節が`TOOL-01`について記録したのと同じ型の漏れである**（`発注漏れを防ぐ方法（この文書に残す教訓）`） | 回路に従う | **ランドとはんだ接続に電流定格は無い。**大電流経路の導体は`WIRE-PWR-01`の線材が決める。**基板上のパターンで大電流を流さず、節点は線材のはんだ接続で作る** | [秋月 通販100517](https://akizukidenshi.com/catalog/g/g100517/)（2026-08-25取得） | **調達（発注・着荷）の状態は[#205](https://github.com/wachi-yoshitaka-11-dev/deskcat/issues/205)が持つ。この表は持たない。** **基板上の配置（ingressからヒューズ、MOSFET、分岐点、各端子台までのレイアウト）は未決である。**着荷後に現物合わせで決める。**2026-09-03着荷を写真で確認した。****基板シルクに`PICO 94V-0`と`2546`の印字があり、当初「刻印は確認できていない」と誤って記録していたため訂正する**（写真を再確認して判明。`94V-0`はUL 94の難燃性区分表記、`PICO`は基材のbrand名または製品ラインと見られるが、**メーカー名そのものの特定はしていない**。`2546`はロットまたは金型番号と見られるが未確認）。**筐体への固定は[#34](https://github.com/wachi-yoshitaka-11-dev/deskcat/issues/34)の範囲であり、この行では扱わない** **この基板の節点に定格は無い。**端子台`114217`の`定格電流 6A`は**端子台自身の定格であって、この基板のランド・スルーホールめっき・はんだ接続を評価したものではない。**線材`111641`の許容電流も**節点の導体（線材）についての根拠であって、基板側の根拠ではない。****したがって節点は未確定である。**配置、導通、絶縁の確認が済むまで、**この基板上の分岐点を定格の付いた部材として扱わない。**追跡は[tbd-register.md](tbd-register.md)の`HW-TBD-022`。 |
| PROTO-03 | 試作用の汎用部品 | 秋月電子 K-03249『武蔵野電波のブレッドボーダーズ　誰でも作れる！　遊べる電子工作』スターターパーツセット（手持ち） | Candidate | 秋月の部品表PDFの「梱包数量」による内訳: ブレッドボード `EIC-301`×2、ブレッドボード・ジャンパーワイヤ `EIC-J-L`×1、ジャンパーワイヤ15cm 赤×10・黒×10、LED 赤×20・白×5、カーボン抵抗 10Ω×3・100Ω×11・220Ω×4・270Ω×7・470Ω×3・680Ω×10・1kΩ×8・4.7kΩ×3・10kΩ×5・20kΩ×6・39kΩ×4・100kΩ×8・220kΩ×4・470kΩ×5・1MΩ×3、タイマーIC `LMC555`×5、トランジスタ `2SC1815`×4、ダイオード `1N4148`×2、フィルム（マイラ）コンデンサ 0.047μF×2、積層セラミックコンデンサ 0.01μF×10（5mmピッチ）・0.1μF×10（2.54mmピッチ）、電解コンデンサ 1μF×4・3.3μF×2・10μF×3・22μF×3・220μF×4、半固定抵抗器 `3362P-103LF`（10kΩ）×4・`3362P-503LF`（50kΩ）×3・`3362P-104LF`（100kΩ）×2、7セグLED `A-551SRD`×1、圧電ブザー `SPT08`×1。**数も型名も値も部品表の記載であり、現物と照合していない。**数は梱包数量で、手元の残数ではない | **部品表には、抵抗のW数、コンデンサの耐圧、電流定格などが載っていない。これらは全部品で`TBD`である。**メーカーも部品表に記載が無く、特定していない。どの定格を一次資料か実測で確かめるかは、用途を割り当てるときに[hardware-safety-policy.md](../governance/hardware-safety-policy.md#5項目以外の扱い)の対応表で決める | ブレッドボードとジャンパーワイヤは、`PROTO-01`と同じく**gate対象の大電流経路には使わない**。信号線と、ESP32の`3V3` pinから取る小電流branchに限る。根拠は[power-budget.md](power-budget.md)の`大電流経路にbreadboard接点とジャンパー線を使わない` | 秋月の部品表PDF [ブレッドボーダーズ_スターターパーツセット.pdf](https://web.archive.org/web/20120216184428/http://akizukidenshi.com/download/%83u%83%8C%83b%83h%83%7B%81%5B%83_%81%5B%83Y_%83X%83%5E%81%5B%83%5E%81%5B%83p%81%5B%83c%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)。PDFのmetadataの作成日は2009-12-21で、下記の商品ページ保存版にある発売日（2009/12/21）と一致する。取得したのはWayback Machineが2012-02-16に保存した版である（sha256 `3abe143c481383e79580d84fc5d774ffa21e75ba103f616b5b6dc06fe58f6a2a`、2026-10-01取得）。商品ページは2026-10-01時点で`gK-03249`から`g103249`へ転送され404になるため、[2012-06-16保存版](https://web.archive.org/web/20120616095205/http://akizukidenshi.com/catalog/g/gK-03249/)を見た。商品ページは同PDFを付属資料として載せている。**このPDFは販売元の付属資料であり、部品メーカーの資料ではない。**PDFには「リストにある部品につきまして、書籍の型番と一部異なる場合がございます」と「弊社（株式会社秋月電子通商）のキットではございません」とあり、商品ページには「このパーツセットのサポートは㈱秋月電子通商では行いません」とある | **2026-10-01にユーザーが手持ちと申告した。現物はまだ確認していない。**手元のセットが部品表と同じ版か、使用済みの部品があるかは確かめていない。用途はまだ割り当てていない |
| PROT-OC-01 | 5 V ingressの過電流保護 | **PTC（ポリマーPTC、自己復帰型）**（2026-08-26に方式変更。**ガラス管ヒューズ＋ホルダは採らない**）。**方式と保持電流1.35 Aは品が替わっても変わらない。品番は候補である** | Selected | **2026-08-26に方式をPTCへ変更した**（人間の判断。[#205](https://github.com/wachi-yoshitaka-11-dev/deskcat/issues/205)）。Bourns **`MF-R135`**（秋月 通販113013、¥40税込／¥37税抜、在庫749、内容量1個、スルーホール、8.9×3×18.9 mm）。確定した値は`Vmax` **30 V**／`Imax` **40 A**／`Ihold` **1.35 A**／`Itrip` **2.70 A**／抵抗 初期抵抗 最小0.065 Ω・最大0.115 Ω・トリップの1時間後（`R1`）の最大0.17 Ω／`Max. Time to Trip` **5×`Ihold`＝6.75 Aで7.3秒**／トリップ状態の消費電力 0.80 W。**温度減額が表で公開されている**（23 ℃で1.35／2.70、40 ℃で1.12／2.24、50 ℃で1.04／2.08、60 ℃で0.92／1.84）。**変更の理由と、この方式が主張しないことは[power-budget.md](power-budget.md)の`方式をPTCへ変更した（2026-08-26、人間の判断）`が持つ。ここへ再掲しない。****2026-08-25まではガラス管ヒューズ＋ホルダだった**（Littelfuse `02181.25HXP`。同節の`方式と品番を決定した（2026-08-25）`が当時の記録として残る）。**PTCは基板へ直付けするため、ヒューズホルダは経路要素から外れた。****ヒューズホルダ（秋月 通販110521、`FUC-03A`）の調達の扱いは[#205](https://github.com/wachi-yoshitaka-11-dev/deskcat/issues/205)が持つ。**PTCへの方式変更に伴い、同Issueは再発注時に`110521`を`113013`（PTC）へ差し替えるとしている（訂正⑪⑫）。**2026-09-08に現物刻印を照合した。**部品本体（黄色いdisc状、ラジアルリード）に`R135`（`MF-R135`のBourns定番の部分刻印。プレフィックス`MF-`を落とす表記）と、その下に日付／ロットコードと見られる`5334S`が刻印されている。あわせてBourns社のロゴ（三角形の意匠）も刻印されている。**型番の刻印は一致した。****`5334S`の年週コードとしての復号はメーカー資料に対応表が無く、行わない**（[AGENTS.md](../../AGENTS.md) 推測禁止） | **確定。`Vmax` 30 V（直流。メーカーがDC定格として与える）。**要求5 Vに対して十分な余裕がある。**PTCはスルーホール品を基板へ直付けするため、ヒューズ＋ホルダで生じていた「組立品としての定格が出ない」という問題は起きない**（ホルダは経路要素から外れた）。**ヒューズ時代の`遮断能力はDCで未確定である`という論点も、Vmaxが直流で与えられているため生じない**（同文書の`方式をPTCへ変更した（2026-08-26、人間の判断）`） | **PTCの保持電流`Ihold` 1.35 Aがこの「連続通電できる電流」である。****2026-08-26以降、これが経路上で判明している最小定格であり、ingressの上限を決める**（上限の値の正は[power-budget.md](power-budget.md)の`上限を40 ℃基準の0.896 Aへ当て直す（2026-10-27、#405）`と`最小定格は1.35 Aへ上がった（2026-08-26）`。**ここへ再掲しない**。品を替えるときは、温度による上限を当て直す要がある）。遮断能力はM-12001の3 Aに対し`Imax` **40 A**で満たす。**`Vmax`が直流で与えられているため、ヒューズで問題になった交流の定格から直流を導く読み替えが起きない** | [MF-R Series datasheet](https://akizukidenshi.com/goodsaffix/mfr.pdf)（Bourns。sha256 `7d980de97abdadc53465454d48a39c6926f1287a2fcfca77d0520a7512245fe4`。2026-08-26取得）、[秋月 通販113013](https://akizukidenshi.com/catalog/g/gP-13013/)（2026-08-26取得） | **調達（発注・着荷）の状態は[#205](https://github.com/wachi-yoshitaka-11-dev/deskcat/issues/205)が持つ。この表は持たない。** **段階C（合成給電）のgate。**M-12001は3Aを供給でき、テスターの読みと手動停止では最弱部品が発熱する前に電流を止められない。選定基準・挿入位置・上限との関係は[power-budget.md](power-budget.md)の`過電流保護（段階Cのgate）`。追跡は[tbd-register HW-TBD-021](tbd-register.md) |
| PROT-RP-01 | 5 V ingressの逆極性保護 | P-channel MOSFET | Selected | **2026-08-25に確定した。**東芝 **`2SJ334`**（秋月 通販102846、¥110、JEITA `SC-67`／東芝 `2-10R1B`、2.54 mmピッチのスルーホール、3端子）。確定した値は`VDSS` **−60 V**／`VGSS` **±20 V**／`ID`(DC) **−30 A**／`Vth` **−0.8〜−2.0 V**（`VDS`=−10 V、`ID`=−1 mA）／`RDS(on)` **`VGS`=−4 V・`ID`=−15 A で 標準46 mΩ・最大60 mΩ**（`VGS`=−10 Vで 標準29 mΩ・最大38 mΩ）／`Rth(ch-a)` 62.5 ℃/W。**2026-09-03に実装方法（向き、ゲート抵抗の値、基板上の配置）を決定し、2026-09-04にCodeRabbit（[PR #342](https://github.com/wachi-yoshitaka-11-dev/deskcat/pull/342)の`full review`）の指摘を受けて向きを訂正した。**2026-09-03時点ではSourceを`PROT-OC-01`側、Drainを分岐点側としていたが、**現在の向きはDrainを`PROT-OC-01`側（入力側）、Sourceを分岐点側（出力側）である。**訂正の理由は[power-budget.md](power-budget.md)のRevision 87が正本であり、ここへ再掲しない。Gateは共通GND戻りへ10 kΩ（`RES-PULL-01`の手持ち）を介してつなぐ（向きに関わらず変えていない）。正しい極性で`VGS`≒−5 Vとなり`Vth`を超えて導通するが、**`RDS(on)`規定（`VGS`=−4 V）の適用には実回路の最悪条件で`VGS` ≤ −4 Vが成り立つ根拠がまだ無く、条件付きの見積りのままである。**訂正後の向きでも完全遮断は主張しない（他の故障モード・下流3 deviceの耐量・`PROT-OC-01`の過渡特性は未評価）。**詳細と根拠は[power-budget.md](power-budget.md)の`実装方法を決定した（2026-09-03）`（2026-09-04訂正）が正本であり、ここへ再掲しない。**（**2026-08-25時点の判断（保留とその解除）は[power-budget.md](power-budget.md)の`保留を同日に解除し、品番を確定した（2026-08-25、人間の判断）`に日付付きの記録として残る。**）**2026-09-03着荷を写真で確認した。**TO-220相当の黒色3端子部品を拡大写真で確認した。**刻印は`J334`（2行目）、ロット`5Z`（3行目）**であり、[2SJ334 datasheet](https://akizukidenshi.com/goodsaffix/2sj334.pdf)の`現品表示`図（1行目に社名ロゴと製品名・略号、2行目にロットNo.という配置）と一致する。**品番`2SJ334`が現物の刻印で裏付けられた。****発注と着荷の状態は[#205](https://github.com/wachi-yoshitaka-11-dev/deskcat/issues/205)が持つ。この表は追わない。** | 5 V | 経路を直列に通る。**`ID` −30 Aは経路の上限に対して桁が違うため最小定格にならない**（上限の正は[power-budget.md](power-budget.md)）**。****効くのは電圧降下のほうである** | [2SJ334 datasheet](https://akizukidenshi.com/goodsaffix/2sj334.pdf)（東芝、2006-11-14。sha256 `c01da93643cb1cb11075d9137897655c556989de647c38368d5c487274d5da46`、2026-08-25取得）、[秋月 通販102846](https://akizukidenshi.com/catalog/g/g102846/) | **調達（発注・着荷）の状態は[#205](https://github.com/wachi-yoshitaka-11-dev/deskcat/issues/205)が持つ。この表は持たない。** **段階Cの配線承認のgate。**品番と定格に加え、実装方法（向き、ゲート抵抗の値、基板上の配置）も2026-09-03に決定した（正は[power-budget.md](power-budget.md)の`実装方法を決定した（2026-09-03）`。ここへ再掲しない）。**決定しただけであり、実装（部品の取り付け）はまだ済んでいない。**`HW-TBD-030`の承認内容の2の通電前の配線確認手順も未作成である。**MOSFETはingressに1個入るだけで、下流の手配線区間の逆接は守れない。**追跡は[tbd-register HW-TBD-030](tbd-register.md) |
| WIRE-PWR-01 | 大電流経路の線材・接続部材 | 公称許容電流が公開されている線材と、5 V railの分岐に使う接続部材（**`CABLE-PI-PWR-01`をrail側で受ける端子台を含む。**2026-08-24に②で確定したため） | Selected（線材の許容電流の**数値は未読**） | **2026-08-25に品を確定した。**線材は秋月 通販111641「耐熱電子ワイヤー 1m×10色 導体外径0.75mm(AWG22相当)」（**住友電気工業**、絶縁体`イラックスA`、導体断面積 **0.3054 mm²＝0.3 sq**、より線12本／0.18 mm、仕上がり外径1.55 mm、温度max. 90 ℃、導体スズメッキ軟銅）。**この品は許容電流が公開されている。**根拠は同社の[許容電流計算式](https://akizukidenshi.com/goodsaffix/PC-CALCULATION-FORMULA.pdf)（2014.02）**2ページ目**の`各種電線の許容電流`グラフにある`イラックス®A電線（定格温度90℃）`の**`0.3sq`曲線**であり、絶縁体・断面積・定格温度の3点が製品ページの記載と一致する。**したがってこの行の選定規則（許容電流そのもの、または製造者が公開する`導体抵抗`のいずれか）を許容電流の側で満たす。****ただし数値はまだ読んでいない**（グラフからの読み取りであり、周囲温度と条数と`η0`を先に決める。正は[power-budget.md](power-budget.md)の`111641は許容電流が公開されている（2026-08-25）`）。接続部材のうち**`CABLE-PI-PWR-01`をrail側で受ける端子台**は秋月 通販114217「ターミナルブロック 2.54mm 2P 緑 縦」（Cixi Wanjie Electronic `WJEK254-2.54-02P-140-00A`、`定格電流：6A`／`定格電圧：150V`、`適合電線範囲(AWG)：18〜26`、ねじ止め、動作温度−40〜105 ℃）で確定した。**線材の仕上がり外径1.55 mm（AWG22相当）は適合範囲内である。****2026-08-25に数量を6個へ確定した**（Pi branch・logic rail・servo railの3分岐の終端に各1個、残り3個は予備）。**分岐点（logic railとservo railへ分ける接続部材）の構成も2026-08-25に確定した。**分岐の節点は`PROTO-02`のユニバーサル基板上のはんだ接続で作り、端子台は各branchの終端に使う。**はんだ接続そのものに定格は無く、節点の導体は`111641`が決める。****2026-09-03着荷、現物の表示を写真で確認した。**線材（`111641`）のパッケージラベルは『住友電工製 耐熱電子ワイヤー イラックス®A絶縁電線』／`AWG22相当 [0.3mm²(12/0.18)]`／`1m×10色`／型番表記`0.3sq (12/0.18) AWG22×10`／通販コード`111641`／バーコード`2900001116411`と印字されており、**この行が既に記録している仕様**（住友電工、イラックスA、0.3054 mm²＝0.3 sq、12本／0.18 mm、AWG22相当）**と一致する。**端子台（`114217`）も着荷を確認した。緑色2Pブロックを複数個視認した。**成型品自体に定格の印字は無く**、定格は引き続き秋月商品ページの公表値（`WJEK254-2.54-02P-140-00A`）に拠る。**発注と着荷の状態は[#205](https://github.com/wachi-yoshitaka-11-dev/deskcat/issues/205)が持つ。この表は追わない。** | 5V | 経路の最小定格を決める要素の一つ。定格が公開されている品だけを使う。**端子台の6 Aは経路の最小ではない。線材の許容電流は未読である** | [秋月 通販111641](https://akizukidenshi.com/catalog/g/g111641/)（線材）、[許容電流計算式](https://akizukidenshi.com/goodsaffix/PC-CALCULATION-FORMULA.pdf)（住友電工 2014.02、sha256 `31f3293f0c0c84c527eee9f1f5b4800fb5aa759706ccb5d6ec85be4ce1326dc8`）、[秋月 通販114217](https://akizukidenshi.com/catalog/g/g114217/)（端子台）。いずれも2026-08-25取得 | **調達（発注・着荷）の状態は[#205](https://github.com/wachi-yoshitaka-11-dev/deskcat/issues/205)が持つ。この表は持たない。** breadboard接点とジャンパー線は許容電流がメーカー資料で確認できず、`power-budget.md`の`経路部品と定格`表を埋められない。**gate対象の大電流経路をこの部材へ置き換える**ことで最小定格を確定させる。追跡は[tbd-register HW-TBD-022](tbd-register.md) **2026-08-22に選定規則を評価可能な形にした。選定はしていない。**販売元が公開しているのは許容電流の**計算式**であって数値ではなく、**式の評価には`導体抵抗`（20 ℃の規格値）が要る。**候補として見た秋月の`UL1015 AWG18`（106753）は`導体抵抗`も`許容電流`も公開していない（公開されているのは導体直径1.21 mm、仕上がり外径2.8 mm、構成34本／0.18 mm、定格電圧600 V、温度max. 105 ℃、絶縁体 塩化ビニル、導体 スズメッキ軟銅）。**第三者の公開値は食い違っており定格に採らない。****候補が満たすべき条件は対象で違う。線材・cableの導体は「許容電流そのものか製造者が公開する`導体抵抗`のいずれか」、接続部材は「製造者が公開する電流定格」である。`導体抵抗`では接点の定格を代用できない**（正は[power-budget.md](power-budget.md)の`線材の許容電流をどう確定させるか（2026-08-22の調査）`。**ここへ再掲しない**）。**2026-08-24に選定条件が2つ増えた。**(1) `CABLE-PI-PWR-01`をrail側で受ける端子台がこの品に含まれる（②で確定したため）。(2) **手配線区間の接続部材は極性が固定される形であること**（`HW-TBD-030`の承認内容の2。保護部品では下流を守らないと決めたため、接続方法側で担保する）。**どちらも正は[power-budget.md](power-budget.md)であり、規則をここへ再掲しない。** **端子台への適合は品ごとに状態が違う。**`111641`（`0.3sq`、仕上がり外径1.55mm）は端子台`114217`への適合を確認済みである。**`CABLE-PI-PWR-01`（`109314`）の適合は未確認である。**同品の仕様欄にあるのは`電線外径 3.8mm`だけで、**これは被覆を含む cable 全体の外径であって、端子へ入れる導体の寸法ではない。外径から適合を推論しない。****確かめるのは導体の寸法か、実際の締結と保持である。**詳細は[power-budget.md](power-budget.md)の`経路部品と定格`が持つ。 |
| RES-LED-01 | 白・赤LEDの電流制限 | 330 Ωの抵抗×2本（各LEDへ1本ずつ直列） | Selected | FAITHFUL LINK INDUSTRIAL CORP. `CF25J330RB`（秋月 125331）。メーカーのdatasheet『CF series / Carbon Film Fixed Resistors』の`How To Order`で`CF`／`1/4W = 25`／`J = ± 5%`／`B = Bulk`。330 Ωの`330R`表記は表に例が無く、`2.3K = 2K3`と同じ書き方からの読み。`CF25J330RB`以外の抵抗は使わない | RCWV＝√(定格電力×抵抗値)＝√(0.25 W×330 Ω)≈9.1 V（計算。datasheetの式）。`Max. Working Voltage` 250 Vはdatasheetが示す最大使用電圧の上限で、この抵抗値の定格ではない | 短絡時の各枝の電流は、datasheetの許容差の下限（313.5 Ω）、3.6 Vで11.5 mA（計算）。抵抗の損失は41.3 mW（計算）で、70 ℃での定格1/4 Wの約17%。datasheetは`Power rating at 70℃`を`1/4W`とし、`POWER GRAPH`は155 ℃で0%まで直線で下がる形を示す | [FAITHFUL LINK CF series datasheet](https://akizukidenshi.com/goodsaffix/cf.pdf)（メーカー作成の資料を秋月が掲載した写し。版と日付の記載は無い。sha256 `0035f42051d04cd054a880826d6d53d4e6c606c44309c9b925262c0b61258f55`、2026-10-03取得）、[秋月の製品ページ](https://akizukidenshi.com/catalog/g/g125331/) | AIの選定（人間の承認はまだ無い）。調達は発注Issue [#538](https://github.com/wachi-yoshitaka-11-dev/deskcat/issues/538)。電流制限をかけるのはESP32のGPIOからの電流で、その電流が`3V3` pinを通るかは記録が無く、安全側の仮定で3V3系に数える。**テスターでの値の実測は行わない**（2026-10-12のユーザーの判断。品は袋の表示で確かめた。[#538のコメント](https://github.com/wachi-yoshitaka-11-dev/deskcat/issues/538#issuecomment-6124219128)。[初回デモ回路案](led-514-demo.md)の`段階的な確認`の1）。回路と単体試験は[初回デモ回路案](led-514-demo.md) |
| RES-PULL-01 | GPIOの外部pull-up／pull-down | 抵抗一式 | Selected | **入手済み。値と本数は2026-08-25に選定した**（`SERVO-PWM`の振り分けは2026-08-26に決着）。**10 kΩ（秋月 125103）と4.7 kΩ（秋月 125472）が各1袋100本入、2026-08-08に着荷している。**未購入ではない。****選定した内訳は`SERVO-PWM`のpull-downが4.7 kΩ×1本、`LCD-CS`／`LCD-RST`／`TOUCH-CS`のpull-upが各10 kΩ×1本である**（計4本）。**いずれも一般値で開始してよい側である**（`SERVO-PWM`の振り分けは2026-08-26に人間が決めた。正本は[hardware-safety-policy.md](../governance/hardware-safety-policy.md)の対応表）。**`LCD-BL`のpull-downは4.7 kΩ×1本で、2026-09-06に確定した**（導出は[gpio-assignment.md](gpio-assignment.md)の`LCD-BLを4.7 kΩにした理由`）。**この5本（4.7 kΩ×2と10 kΩ×3）は手元の2種でまかなえる。この5本については追加の発注は要らない。****`TOUCH-IRQ`は外部pullを付けない**（XPT2046の`PENIRQ`が内部pull-up付きの出力であるため。**外部pull-upは有害である**）。**値の正本と導出は[gpio-assignment.md](gpio-assignment.md)の`起動時状態を確定させる外部pull`節および信号inventoryの`Pull`列であり、ここへ再掲しない。****5本ともブレッドボードへ実装済みである**（`LCD-BL`は2026-09-07。**`LCD-BL`は外部pull-downの存在そのものの確認が残る。**実装の記録と残る確認は[gpio-assignment.md](gpio-assignment.md)の信号inventoryと`競合check`節が持つ）。****現物の表示・値の確認はしていない**（`着荷済み`と`受け入れ済み`の区別）。I2C busのpull-upは別の計算であり、同文書の`I2C busの実効pull-up`節が持つ。**2026-09-28、Pi–ESP32間のUARTの信号線2本にそれぞれ直列に入れる4.7 kΩ（計2本）に、手持ちの4.7 kΩを充当する**（[#446](https://github.com/wachi-yoshitaka-11-dev/deskcat/issues/446)。正は[gpio-assignment.md](gpio-assignment.md)の`Pi–ESP32間のtransport`節）。pullではないため、上の内訳には含めていない | 3.3V | 信号線のみ。大電流経路ではない | TBD | **`SERVO-PWM`の外部pull-downは「推奨」ではなく必須**であり、high-Z期間中にservoが動くことを防ぐ唯一の手段である（[gpio-assignment.md](gpio-assignment.md)）。LCD-CS／TOUCH-CS／LCD-RST／LCD-BL／TOUCH-IRQ／I2Cのpullもここに含める。**#514の初回デモ案（AIの選定、未承認）では、手持ち10 kΩをGPIO2とGPIO5のpull-downへ各1本使う**（[回路案](led-514-demo.md)）。**この2本は上の確定した5本に含めない** |
| MEAS-01 | 電流波形測定（Oscilloscope代替） | セメント抵抗5W0.1Ω（秋月 g117836、SQP5WJ0R1B、¥30）、および分圧用カーボン抵抗10kΩ×4 | Required | 秋月 SQP5WJ0R1B（shunt）×5本。分圧用は**カーボン抵抗1/4W 10kΩ（秋月 125103、`RD25S 10K`）1袋100本入** | — | shuntはservo rail全電流を通す。5W定格に対し0.1Ω×2A²＝0.4Wで余裕あり。5W／0.1Ωから逆算した電流定格は約7A相当 | shunt: [秋月商品ページ](https://akizukidenshi.com/catalog/g/g117836/)。分圧用: [秋月 125103](https://akizukidenshi.com/catalog/g/g125103/) | **shunt・分圧用抵抗とも入手済み（2026-08-08着荷）。**shuntは5本、分圧用は10kΩ 1袋100本入である（`ADC-5V`と`ADC-3V3`で各2本、計4本を使う。[gpio-assignment.md](gpio-assignment.md)が分圧比1/2を規定済み）。**2026-08-12に購入履歴と照合して訂正した。**それまで「分圧用は未購入」と記載していたが誤りであり、**MSP2807・M-12001と同一の発注に含まれていた。**発注漏れではなく記録漏れである。**したがって`ADC-5V`／`ADC-3V3`の配線は部品待ちではない。**shuntはservo rail低側へ挿入する。挿入位置とGND topologyの制約は[power-budget.md](power-budget.md)の`GND topology`節、ADC pinは[gpio-assignment.md](gpio-assignment.md)。2026-10-01に段階B-2で1本を使った（[experiment-log.md](experiment-log.md)の`EXP-019`） |
| MEAS-02 | 電源過渡の独立した記録（**候補。採否未決定**。**2026-09-14に記録係として採用を決定した**） | Arduino Uno R3（手持ち） | Candidate | `BOARD MODEL UNO R3`（裏面silkscreen）。microcontroller `ATMEGA328P-PU`（`ATMEL`ロゴ、DIP-28、socket実装、ロット`1344`）、USB-serial変換 `MEGA16U2`（同、QFN、ロット`1336`）。**2026-08-16に現物の刻印で確認し、Arduino公式資料と一致した** | PCのUSBから給電（`VUSBMax` 5.5 V）。**DeskCat側のrailから給電しない**（独立給電の条件を満たす候補である）。**ただし独立給電だけでは「独立した観測」は成立しない。**GND topology、PC groundの影響、入力headroom、実機動作の検証が別に要る（正は[power-budget.md](power-budget.md)の`電源過渡の測定方式のdesign review`） | — | [UNO R3 User Manual](https://docs.arduino.cc/resources/datasheets/A000066-datasheet.pdf)（SKU A000066）、[UNO R3 schematic](https://docs.arduino.cc/resources/schematics/A000066-schematics.pdf)（`UNO-TH_Rev3e`）、[ATmega48A/PA/88A/PA/168A/PA/328/P Data Sheet](https://ww1.microchip.com/downloads/en/DeviceDoc/ATmega48A-PA-88A-PA-168A-PA-328-P-DS-DS40002061B.pdf) `DS40002061B`（sha256 `b9b9d83cda56a95d999ea8d54fe5a540748ae9020e5e7ae19b913d384ba9320e`、2026-08-16取得） | **購入対象ではない。手持ちである。****2026-08-16に方式1（独立した外部観測）が採用され、この品はその候補である。**2026-09-14に採否を決定した。**方式1の記録係はArduino Uno R3単独である（正は[power-budget.md](power-budget.md#測定計画)の`測定器の採否を決定した（2026-09-14）`。**ここへ再掲しない**）。**残るのは技術的な充足の判定である。**以下は決定前の記述である。**採否そのものは未確定で、未解決の全数とclose条件は[tbd-register.md](tbd-register.md)の`HW-TBD-034`が持ち、方式1の技術的な3点は[power-budget.md](power-budget.md)の`方式1で残っている未解決3点`が正である（**ここへ再掲しない**）（[power-budget.md](power-budget.md)の`電源過渡の測定方式のdesign review`。**ここへ再掲しない**）。**2026-08-17に初めて通電し、PCのUSB給電で動作することを確認した**（**DeskCat側へは接続していない。**未加工の観測は[experiment-log.md](experiment-log.md)の`EXP-001`）。**採否は未確定のままである。****2026-09-14に採否を決定した。**方式1の記録係はArduino Uno R3単独である（正は[power-budget.md](power-budget.md#測定計画)の`測定器の採否を決定した（2026-09-14）`。**ここへ再掲しない**）。**開発端末ではなく測定器であり、[machine-profiles.md](../toolchains/machine-profiles.md)のprofileは要さない**（`MEAS-01`やデジタルテスターと同じ扱い） |
| MEAS-03 | 電圧・電流の実測（デジタルテスター） | **`DT830B`**（手持ち） | Candidate | **未確認。**本体表示は`DT830B` / `DIGITAL MULTIMETER`のみで**brand表記が無い。**同一型番を複数vendorが供給しているため、**確度の一次資料をどのメーカーに求めるかが決まらない。**付属取扱説明書の発行はウィキャン株式会社である | **測れる電圧の上限が本体表示と取扱説明書で食い違う。**本体表示は`VΩmA`端子`1000V⎓MAX`／`750V~MAX`、`COM`端子`500V⎓MAX`。取扱説明書の`禁止事項`は`600Vを越える電圧は計測しないで下さい`である。**低い方（600 V）を上限として扱う。原因は特定していない。**DeskCatの測定はいずれも5 V系であり影響しない。DC電圧range／最小単位は`200mV`=0.1 mV／`2000mV`=1 mV／**`20V`=10 mV**／`200V`=100 mV／`1000V`=1 V | **測れる電流の上限と時間制限。**`VΩmA`端子は`500mA⎓MAX FUSED`、**`10A`端子は`10A⎓MAX MAX 10SEC EACH 15MIN UNFUSED`**（本体表示）。**取扱説明書は`10A端子では保護ヒューズは働きません`と明記している。**DC電流range／最小単位は`200µA`=0.1 µA／`2000µA`=1 µA／`20mA`=0.01 mA／`200mA`=0.1 mA／`10A`=10 mA。同書は`200mA以上10A以下と推察される場合`は`10A`端子を使い、`200mA以上での測定は過熱防止のため15秒以内`と述べる。内蔵ヒューズは`0.5A 250V`・長さ20 mm・直径5 mm | **取得済み。**付属の日本語取扱説明書『ミニデジタルテスター 取扱説明書』（発行: ウィキャン株式会社）。**range構成と最小単位は載っているが、range別の確度と基準温度は載っていない**（2026-08-21に確認）。**入力インピーダンスも載っていない** | **2026-08-20に現物の表示で型番を訂正した。この文書は#55以来この品を`MAS830L`と記載していたが、現物は`DT830B`である。**型番の記載に現物確認が入っていなかった（訂正の経緯はRevision 51）。**この文書に行が無いまま各所の測定手順で使われていた。**`段階B-2の測定`、`5 V ingress`、`Sample rateとlog形式`が既にこの品を前提にしている。**2026-08-21に付属の取扱説明書を確認した結果、range別の確度（`±(x % + n digit)`）と基準温度は取扱説明書にも本体表示にも載っていないことが確定した。**同書が示すのは`測定レンジと最小単位`までである。**したがって確度はこの品の一次資料からは得られない。****代わりに最小単位から不確かさの下限が定まる。**DC電圧の最小単位は`200mV`=0.1 mV／`2000mV`=1 mV／**`20V`=10 mV**／`200V`=100 mV／`1000V`=1 V であり、5 V railは20 Vrangeで測るため**読みの不確かさは少なくとも10 mV（5 V付近で約0.2 %）ある。****これは下限であって確度ではない**（正は[power-budget.md](power-budget.md)の`DT830Bの一次資料で分かったこと（2026-08-21）`）。**本体表示と取扱説明書が食い違っている。**本体は`1000V⎓MAX`／`750V~MAX`だが、取扱説明書の`禁止事項`は`600Vを越える電圧は計測しないで下さい`である。**5 V系の測定には影響しない。原因は特定していない。**低い方を上限として扱う。取扱説明書から得たその他: ヒューズは`0.5A 250V`／長さ20 mm／直径5 mm、付属品は日本語取扱説明書と赤・黒テストコード各1（コード長350 mm）、本体寸法124×68×27 mm・130 g（電池含む）。**入力インピーダンスは取扱説明書にも記載が無く、未取得のままである**（§24.5.2の`high impedance voltmeter`要求の判定に使えない）。`HW-TBD-034`作業2の校正はこの確度が上限になるため、**取得するまで校正の不確かさは`TBD`である**（正は[power-budget.md](power-budget.md)の`基準電圧が未解決である（設計上の論点）`）。**本体表示から読み取れたのは次までである。**DC電圧 `200m`／`2000m`／`20`／`200`／`1000`、AC電圧 `200`／`750`、DC電流 `200µ`／`2000µ`／`20m`／`200m`／`10`、抵抗 `200`／`2000`／`20k`／`200k`／`2000k`、diode test、`hFE`、NPN／PNPのtransistor socket、`CE`。端子の定格表示は`10A⎓MAX MAX 10SEC EACH 15MIN UNFUSED`、`VΩmA 1000V⎓MAX 750V~MAX 500mA⎓MAX FUSED`、`COM 500V⎓MAX`。**確度・入力インピーダンス・基準温度はいずれも本体に無い。****購入対象ではない。手持ちである**  **2026-08-21に列の対応を直した。**取扱説明書の記述を`定格電圧`欄、電源情報を`Peak／stall電流`欄に置き、`公式文書`欄を`—`にしていた。**この表の header（`正確なmodel`／`定格電圧`／`Peak／stall電流`／`公式文書`／`残作業`）と照合せず、同じ文書の別の表の header と突き合わせていたためである**（[PR #158](https://github.com/wachi-yoshitaka-11-dev/deskcat/pull/158)の自動reviewの指摘）。**残作業**: DT830Bの読みは電流gateの合否に使わない（正は[power-budget.md](power-budget.md)の`電流の測定点と読みの確かさの基準`）。読みを合否に使える条件は`#525`が定める。電流端子を使う場合は、使う端子、リード位置、測定時間の上限、burden voltageも要る（正は同文書の`DT830Bを電流測定に使うときの制約`）。 **2026-08-22に抵抗レンジが一時的に使えなくなり、切り分けた。**症状は「電圧は測れるが、抵抗とダイオードの両方が全レンジで開放表示になる」だった。**ヒューズは切れていない。**外部回路（`3V3`→ヒューズ→10 kΩ→`GND`）で電圧を読み、接続点が`3.30 V`を示したことで導通を確認した（`10 kΩ`が無いと測定点が浮くため直列に入れた）。**ヒューズを抜き差しして戻したあと、既知の`10 kΩ`で3レンジを確認した。**表示は`20k`で`10.0`前後、`200k`で`10`前後、`2000k`で`010`であり、**いずれも`10 kΩ`として整合する**（`2000k`は最小単位1 kΩのため`010`が期待値）。**プローブ短絡（ゼロ点）も`0`に戻った。****確認できたのはこの3レンジだけである。****`200 Ω`レンジ、ダイオード、電流測定の正常性は確認していない。**したがって**「計器は正常」と全体について断定しない。****原因はヒューズの接触が疑われる。**抜き差しの後に復旧したという**相関**であり、**ヒューズ接点をセレクタ・リード・ソケットその他の内部接点から切り分けていない。****電池は`20k`では原因ではない**（8.59 Vを保っていた）。**`200 Ω`レンジでは電池アイコンが出て4.78 Vまで落ちる。**最小レンジが最も電流を要求するためである。**電圧低下を観測しているため、`200 Ω`・ダイオード・電流測定は電池を交換して再確認するまで使わない。****消耗品の規格**: 電池は`006P`／`9V`（`NEDA 1604`／`6F22`）、ヒューズは`0.5A 250V`・長さ20 mm・直径5 mm（いずれも取扱説明書）。**購入待ちリストへは足さない。**ヒューズは導通を確認しており不足していない。**電池は2026-08-24に手持ちがあることを所有者が申告したため、購入不要と確定した。****ただし再確認はまだ実施していない。**交換したら`200 Ω`・ダイオード・電流測定を既知の値で再確認し、その結果をこの行へ記録する。**2026-10-01時点で、電池は交換済みである（ユーザーの申告。交換後の再確認の記録は無い）。****交換しても段階B-2の電流gateは開かない。**2026-09-28以降、段階B-2・#17・段階Cの電流は電流端子ではなく`MEAS-01`の両端電圧から求める（段階B-2ではその両端を電圧rangeで読む）。**電圧rangeの確度も取得できず**、電池とは別の理由でgateが閉じている（burden voltageは電流端子を使う場合の量であり、この読み方では当たらない。正は[power-budget.md](power-budget.md)の`DT830Bを電流測定に使うときの制約（2026-08-21）`。**ここへ再掲しない**）。**教訓**: 計器の故障を疑ったら、**既知の抵抗で確かめる**。プローブ短絡の表示だけで故障と決めない。**部品の故障だけでなく接触も候補に入れる。****物理状態を変えたら測り直す**（ヒューズを抜き差しした時点で状態が変わっていた）。**確認した範囲を超えて結論を広げない**（3レンジの確認から計器全体の正常を導かない） |
| MEAS-04 | 測定時の周囲温度の記録 | **SwitchBot 温湿度計**（手持ち） | Candidate | **未確認。**現物は`SwitchBot`製の温湿度計であるが、**model名・型番は筐体正面からは読み取れていない。**背面labelまたはappの表示で確認する。**ただし要件の充足には型番を要さない**（下記） | 電池駆動（現物に電池iconの表示がある）。**種別・電圧は未確認** | — | **未取得。**SwitchBot公式のproduct仕様。**要件の充足判定には使わない**（要件は`摂氏で読め、記録できること`であり、確度を含まない） | **2026-08-21に手持ち品で要件を満たすことを確認した。購入は不要になった。**要件は`摂氏で読め、記録できること`で、**精密さは要さない。**現物は摂氏を**小数第1位まで**表示し、湿度も併記する。**要件を上回っている。****確度は要件に含まれない。**この作業で温度を記録する目的は補正値の算出ではなく、**別の人が同じ条件を再現できるようにすることである**（後述のとおり補正は一次資料が無くて算出できない）。したがって**型番と確度が未取得のままでも要件は満たす。**`HW-TBD-034`作業2で必要と判明した品である。ATmega328Pの内蔵基準は温度で動き、**`DS40002061B`はATmega328Pの内蔵基準の温度依存の図を載せていない**（`vs. Temperature`があるのはATmega88PAとATmega168PAのみ。328P向けは`vs. V`<sub>`CC`</sub>）。**したがって温度を記録しないと影響を一次資料から見積もれず、別の人が再現できない。**2026-08-18の測定では用意しておらず**未測定のまま記録した**（[experiment-log.md](experiment-log.md)の`EXP-001`）。**購入待ちリストへ追加した**  **2026-08-21に列の対応を直した**（`MEAS-03`と同じ誤りである）。 |
| MEAS-05 | 電源過渡の独立した外部観測（`HW-TBD-034` 方式1の候補） | **`DSO Shell`**（`QUIMAT`。手持ち） | Candidate | **未確認。**筐体の表示は`DSO Shell`と`QUIMAT`のみである。**2026-08-21に裏面・側面・電源面を撮影して確認した結果、裏面には表示が一切無い**（ねじ穴4箇所とBNCの突出のみ。銘板・型番・serial・製造元表示のいずれも無い）。**したがって版・型番のsuffixは筐体からは得られない。**基板上の表示または購入元の記録から辿る | **`9V DC (8 – 10V)`**（公式manualの`Specifications`）。筐体表示は`9V DC`。同manualは`9V power supply (center positive)`と`5.5 x 2.1mm plug`／`DC jack is 5.5mm dia. with 2.1mm core`を要求する。**入力側の`Max input voltage`は`50Vpk (1X probe)`**（筐体表示も`Max 50Vpk`）。入力結合は`AC`／`DC`／`GND`の3位置 | **`Current consumption ~120mA @ 9V`**（公式manualの`Specifications`）。同manualは電源に`200mA (or higher) current capacity`を要求する。**手持ちアダプターは`9V ⎓ 1A`・center positiveで、電圧・極性・電流容量・plug形状のすべてを満たす**（`MODEL:0910`。`CE`・class II・PSE・WEEEの表示。2026-08-21に銘板を正面から確認し、通電せずplugの実物適合も確認した）。**2026-08-21に初回通電した。**`PWR`を`ON`にして**画面が表示されることを確認した。異音・発熱・異臭は無かった。**人間が基板のそばで観察している状態で行った（[Hardware Safety Policy](../governance/hardware-safety-policy.md)）。**BNCには何も接続せず、`Test Signal output`にも何も接続せず、本体単体で通電した**（異常が出たときに本体側かcable側かを切り分けられるようにするためである）。**同日にmanualの`Step 5 Calibration`に沿った自己確認も通した。**cableのBNC側を`BNC Connector`へ、赤クリップを`Test Signal output`へ接続し、**黒クリップは接続しない**（manualの`leave the black clip un-connected`）。入力結合を`GND`で0 V線を確認したのち`DC`へ切り替え、**画面に矩形波が表示されることを確認した。****これによりtest signal出力→BNC→アナログ前段→ADC→表示の経路が通ることが確認できた。****それでも測定器として使えることは主張しない。****垂直確度はmanualの`Specifications`に記載が無く未取得**であり、帯域・時間軸・分圧比のいずれも実測していない。**既知電圧に対する読みの照合も、DeskCatのrailへの接続もしていない。** **2026-08-22に同じ状態で画面の測定値も読んだ。**`Freq`は**1.000〜1.026 kHz**、`Vpp`は**3.40 V**であった。**どちらも校正の基準には使えない。**(a) **`Freq`の一致は時間軸の独立した検証にならない。**test signalも時間軸も同一の本体クロックから作られるため、クロックがずれれば両方が一緒にずれ、読みは1 kHzのままになる。**絶対精度は確認できていない。****ただし約2.6 %のばらつきは、クロック誤差ではなくこの設定での測定分解能**（`Record length 1024 points`と時間軸の刻み）**を示すと考えられる。原因は特定していない。**(b) **`Vpp`は基準値ではない。**manualの`Step 5 Calibration`が`Push ADJ to set the amplitude to 0.1V`と述べており、**test signalの振幅は可変である。**3.40 Vはそのときの設定での値であり、**固定の基準電圧ではない。****垂直確度は依然として未取得であり、この読みからは導けない。** | **取得済み。**JYE Tech Ltd. `DSO150 Shell User Manual Rev. 07`（<https://jyetech.com/wp-content/uploads/2019/01/dso150-shell-user-manual.pdf>。sha256 `599fb2b4926c234c26eb110cb76dedb436e0acbde4f9f25f562baf1592a713a2`）。**現物の筐体表示は`QUIMAT`であり、このmanualはJYE Techの`DSO150`のものである。同一機種であるという根拠は無い。**側面表示（`Max 50Vpk`、`AC`／`DC`／`GND`、BNC 1系統、`9V DC`）が同manualの記載と一致するため**同系統と見られるが、これは一致の観測であって同定ではない。****したがって同manualの`Specifications`の数値は、この現物に対しては参考値として扱う**（[PR #160](https://github.com/wachi-yoshitaka-11-dev/deskcat/pull/160)の自動reviewの指摘。**JYE Techは`QUIMAT`を正規品として扱っていないという指摘も受けた**）。**基板上の表示または購入元の記録でmodel／revisionを特定するまで、帯域・sample rate・入力範囲・記録長・入力インピーダンスを確定値として使わない** | **2026-08-20に現物の写真で存在が判明した。この文書に行が無く、`power-budget.md`は#55以来「Oscilloscopeは所有していないため使用しない」と記載していた。**筐体の表示は`DSO Shell`／`QUIMAT`、操作部は`V/DIV`／`SEC/DIV`／`TRIGGER`／`OK`と`ADJ`ノブである。**2026-08-21に側面と電源面の表示を読み取った。**入力は**BNC 1系統のみ**で、そのそばに**`Max 50Vpk`**と表示がある。入力結合の切替は**`AC`／`DC`／`GND`**の3位置slide switchである。別に**`⊓⊔1KHz`**と表示された金属片があるが、これは**switchではなく`Test Signal output`（1 kHz矩形波の出力端子）である**（公式manualの側面パネル説明。**2026-08-21に訂正した。**側面のslide switchは`SW1 : 2P3T`の入力結合切替だけで、**test signalにon/offのswitchは無い**）。同manualの`Step 5 Calibration`は`Connect the red clip to the test signal terminal and leave the black clip un-connected`と述べ、**本体の出力を本体の入力へ折り返して確認する**手順を定めている。電源は**`9V DC`のbarrel jackと`PWR`（`OFF`／`ON`）**であり、**PCにも測定対象にも依存しない。****channel数は入力系統数から1と読めるが、帯域・sample rate・垂直確度・記録長は依然として未取得であり、この行に書かない**（[AGENTS.md](../../AGENTS.md) 推測禁止。`HW-TBD-034`の`必要帯域の根拠`も`TBD`のままである）。**入力用のcableは手持ちにある。**BNCオス→赤・黒のクリップ2本のtest leadを所持している（2026-08-21に現物確認）。**分圧比の表示は無く、減衰比は未確認である。****現物に取扱説明書は付属していなかったため、2026-08-21に製造元の公式manualを取得した**（上記）。同manualの`Specifications`は次のとおりである。`Max realtime sample rate 1MSa/s`、`Analog bandwidth 0 -- 200KHz`、`Sensitivity range 5mV/div - 20V/div`、`Max input voltage 50Vpk (1X probe)`、`Input impedance 1M ohm/20pF`、`Resolution 12 bits`、**`Record length 1024 points`**、`Timebase range 500s/Div -- 10us/Div`、`Trigger modes Auto, Normal, and Single`、`Trigger position Center of buffer`、`Dimension 105 x 75 x 22mm`、`Weight 100 gram`。**`Record length`が固定されている点が方式1の採否に直接効く**（**値は参考値である**）（連続streamingではなく単発capture。**評価は[power-budget.md](power-budget.md)の`方式1`が持ち、ここへ再掲しない**）。**入力impedanceはmanualの参考値であり、この現物では未確認である。**確定すればDT830Bで判定できなかった§24.5.2の`high impedance voltmeter`要求の判定に使える見込みだが、**現時点では使えない。****垂直方向の確度は同manualの`Specifications`に記載が無く、未取得である。****2026-08-21に初回通電と自己確認を通した**（同じ行の`定格電圧`欄に記録した。画面の測定値の読み取りだけは2026-08-22である）。**それでも測定器として使えることは主張しない。**垂直確度が未取得で、既知電圧に対する読みの照合もDeskCatのrailへの接続もしていない。`HW-TBD-034`の`(1) 測定器の採否`は人間の判断であり、**この行は現物が存在するという事実の記録にとどめる**（正は[power-budget.md](power-budget.md)の`方式1`）。**2026-09-14に採否を決定した。**方式1の記録係はArduino Uno R3単独である（正は[power-budget.md](power-budget.md#測定計画)の`測定器の採否を決定した（2026-09-14）`。**ここへ再掲しない**）。**購入対象ではない。手持ちである**  **2026-08-21に列の対応を直した**（`MEAS-03`と同じ誤りである）。 |

## ベンチ電源

**製作物へ組み込む電源とは別に、試験用の機材として記録する。**2026-10-04にユーザーが
可変・電流制限付き電源の購入を申告した。購入日・到着日、現物の表示、使用結果は未確認である。

| Ref | 用途 | 品 | 状態 | 公式資料で確認したこと | 根拠／残作業 |
|---|---|---|---|---|---|
| PSU-BENCH-01 | 電圧・電流を設定するベンチ試験用電源 | Jesverty `SPS-3010V`（型番はユーザーの申告、2026-10-06。**旧記載の`SPS-3010M`は誤記であり訂正した**） | Candidate | **メーカーの製品ページは`SPS-3010V`について未取得である。** **付属の説明書（日本語、p.1〜p.11）は、ユーザーが写真で提示した（2026-10-31）。**説明書は型名の列に`SPS-3010V`を載せ、出力0–30 V・0–10 A・300 W、入力`AC100V±5% 50/60Hz`、表示精度`0.5%+5digit`、表示分解能（電圧0.01 V・電流0.001 A）、ヒューズ`T8A`、保護は過電流保護（OCP）と過熱保護と記す。**販売ページ[Amazon.co.jp B0DDPVDWPZ](https://www.amazon.co.jp/dp/B0DDPVDWPZ)（2026-10-06取得）の出力0–32 Vとは、説明書の0–30 Vが異なる**（販売者の記載であり、メーカーの仕様書ではない）。現物のラベル表記はユーザーの読みで`3010V SPS`・`AC100V 50/60Hz`。説明書は、接地極の無いコンセントでは筐体を接地すること、接地が無いとEMI耐性が下がり稀に表面から軽い感電を感じる恐れがあることを記すが、**接地線の付け先は記さない**。付属の接地用の線はプラグの付け根から出ている線だけである（ユーザーの申告）。**[EXP-051](experiment-log.md#exp-051-ベンチ電源psu-bench-01を無負荷と負荷ボードで初めて使いccに入ることを確かめた)で、接地なし・出力端子に何もつながない状態の5.00 V出力（本体5.00 V、`DT830B` 5.02 V）と、負荷ボードの前でのCC（0.100 Aで止まり、CC LED点灯、3.80 V）を観察した。**OCP（有効にしていない）、OPN、過熱保護、ヒューズ、USB充電ポート、リップル、10 Aまでの出力、上の2点以外の確度は未確認。**`SPS-3010M`の値を`SPS-3010V`へ流用しない** | 購入の根拠はユーザーの申告（2026-10-04。型番の訂正は2026-10-06）。現物の初回使用は[EXP-051](experiment-log.md#exp-051-ベンチ電源psu-bench-01を無負荷と負荷ボードで初めて使いccに入ることを確かめた)（接地なし、DeskCatの回路はつながない）。DeskCatの回路へつなぐ経路・設定値・接続部材はTBD（#18の段1の分だけ、[servo-safety-limits.md](servo-safety-limits.md#段1の前のservo-電源の経路の測れる区間の発熱の実測案)に案を書いた。承認していない。窓の前に現物で確かめる項目（銘板の型番、−とGNDの導通、OCPの設定）は未確認）。初回使用は[Hardware Safety Policy](../governance/hardware-safety-policy.md#7-人間の監視が必要な操作)に従う |

**購入は、既存の`PSU-PI-01`／`PSU-SERVO-01`を交換する決定ではない。**試験に使う場合は
[power-budget.md](power-budget.md)で経路・設定値・保護を決め、測定結果を記録する。
Pi最低入力電圧の扱いは同文書の[受け入れ条件](power-budget.md#受け入れ条件)を参照する。

## 工具

**この表は部品ではなく、部品を組み立て・接続するための工具を扱う。**`MEAS-*`（測定器）と同じく
購入対象かどうかを判断するために置く。**2026-08-24に新設した。**それまで工具の記録が
repositoryのどこにも無く、下記patternの走査で**追跡file全体で0件**だった。
**この文書が`PSU-INGRESS-01`を「DIP化キット」として扱い、[sensor-datasheet-notes.md](sensor-datasheet-notes.md)が
`ENV-01`の`J3`をI2Cで使うためのはんだジャンパとして要求しているのに、それを行う手段の記録が
無かった。**「残作業列に書いただけで発注時に見えない」失敗と同じ型である（`購入待ちリスト`節）。

走査に使ったpatternを残す。

```text
はんだごて / 半田ごて / ハンダごて / 圧着工具 / TOOL-
```

| Ref | 用途 | 品 | 状態 | 現物の確認 | 要る箇所 | 残作業 |
|---|---|---|---|---|---|---|
| TOOL-01 | はんだ付け | はんだごて（手持ち） | Selected | **2026-09-08に現物確認した。**Miniware `TS-80`（USB Type-C給電式）。本体刻印で確認した。こて先は刻印`TS D25`（Miniware `TS-D25`、chisel/flat-blade形状。ロット刻印と見られる`FS34`もあわせて刻印されている）で、平型であることは目視でも確認した（`B02`＝円錐型とは異なる）。電源は`QC3.0`／`9V/2A`と本体または付属ケーブルの表示で確認した。**switch-science（`TS-80`固有の製品ページ）は消費電力を記載していない。**`30 W (Max)`・`100–400℃`は、`TS80P`（上位後継機種）の販売店ページ（eBay等）から得た値であり、**`TS-80`と`TS80P`が同一のW数・温度域を持つという機種間の同等性はメーカー資料で確認していない。**したがってこの2値は`TS-80`固有の一次資料でも第三者資料でもなく、**別機種の第三者資料として参考値の位置づけに留める**（[AGENTS.md](../../AGENTS.md) 推測禁止）。Miniware公式サイトは`TS-80`の掲載を終了しており（`theminiware.com`で404、`switch-science`も「販売終了」と明記）、`TS-80`自身の一次資料でのW数・温度域の直接確認はできていない。****はんだ（線材）と、こて台・スポンジ等の付随品の有無は引き続き未確認である** | `PSU-INGRESS-01`の組み立て（商品名が「DIP化キット」。**未組立であることは2026-09-03の着荷時現物確認で確定した**（同行を参照）。[power-budget.md](power-budget.md)の`①の候補品の定格は「1ピン」ではなく「合計」だった（2026-08-24の訂正）`）、`ENV-01`の`J3`のはんだジャンパ（I2Cで使う場合は必須。[sensor-datasheet-notes.md](sensor-datasheet-notes.md)）。**`CABLE-PI-PWR-01`のrail側終端には要らない**（②を採り端子台のねじ止めとしたため。[power-budget.md](power-budget.md)の`rail側の受け方は②（直付け）で確定した（2026-08-24、人間の判断）`） | **購入対象ではない。手持ちである。**型番・こて先形状・入力仕様は2026-09-08に現物確認済み。**W数・温度域は`TS-80`固有の一次資料でも第三者資料でも未確認のまま残る**（`TS80P`の第三者資料による`30 W (Max)`・`100–400℃`のみで、機種間の同等性は未確認）。**はんだ（線材）と、こて台・スポンジ等の付随品の有無は未確認である** |
| TOOL-02 | 圧着 | 圧着工具 | Deferred | **所有していない**（2026-08-24、所有者の申告） | **現時点では無い。**②では端子台のねじ止めで終端する想定であり、圧着を要さない。**ただし端子台そのものは`WIRE-PWR-01`として未選定である** | **購入待ちリストへは足さない。必要性が確定していない。**`WIRE-PWR-01`が選ぶ接続部材が圧着端子を要求した場合に必要になる。**その場合、工具は端子シリーズごとに専用である**（ダイスが対応していないと使えない）ため、**部材の選定より先に工具を選ばない**（[power-budget.md](power-budget.md)の`選定順序（循環にしない）`と同じ倒し方である） |
| TOOL-03 | はんだ付け時の基板・部品の保持 | goot `ST-94`（作業ヘルパー クリップ・サポ） | Candidate | 購入の申告（2026-10-04）。現物未確認。[太洋電機産業の製品ページ](https://www.goot.jp/products/detail/st_94)で型番と用途を確認した（同日）。保持具であり、`TOOL-01`のこて台・スポンジ等の有無は別に確認する | はんだ付け作業の補助。個別の対象物への使用結果は未記録 | 現物・保持状態を確認する。メーカーの注意事項は、安定した場所で使用し、クリップ先端に熱が加わる場合は先端カバーを外すこと、穴あけ等の負荷がかかる作業には使用しないことを記載する |
| TOOL-04 | 配線の被覆剥離 | VESSEL `3500E-2`（単線・より線用） | Candidate | 購入の申告（2026-10-04）。現物未確認。[ベッセルの製品ページ](https://www.vessel.co.jp/product/stripper/141012/)で型番と適用電線を確認した（同日）。適用はAWG18／20／22／24／26／28／30 | 配線製作の補助。実際の線材との適合・剥離結果は未確認 | 使用する線材に合う刃を確認する。メーカーの注意事項は、活線で作業しないこと、適用電線・使い方を確認することを記載する。`TOOL-02`の圧着工具とは別の工具である |

**状態ラベルは`状態ラベル`節の定義を流用する。**工具は製作物の部品ではないため定義がそのままは
当てはまらない。**この表では`Selected`を「使う予定があり手元にある」、`Deferred`を「現時点では
要らない」と読む。**別の語を新設せず、読み替えを明示する側を採った。

**この表は工具の確度や校正を扱わない。**測定器の確度は`MEAS-*`の各行が持つ。

## 購入待ちリスト

**この文書では調達を管理しない。発注はIssueで管理する。**

買おうとしているものの一覧、通販コード、価格、在庫、発注の可否は、**その発注のIssueが持つ**
（例: [#205](https://github.com/wachi-yoshitaka-11-dev/deskcat/issues/205)）。
買えばIssueはcloseし、記録は残らない。**この文書に残すのは、買った後も残るものだけである。**

**発注時に見る先は、その時点でopenな発注Issueである。**複数あるなら全部を見る。
**この文書の部品表を発注リストの代わりに使わない。この文書は調達の状態を持たない。**
部品表の`残作業`列が持つのは設計の状態だけであり、**`未購入`／`購入待ち`／`発注済み`と
いった調達の状態は置かない。**調達へ言及する必要がある行は、状態そのものを書かずに
発注Issueを指す（`PSU-INGRESS-01`／`CABLE-PI-PWR-01`／`PROTO-02`／`PROT-OC-01`／
`PROT-RP-01`／`WIRE-PWR-01`の6行が[#205](https://github.com/wachi-yoshitaka-11-dev/deskcat/issues/205)を指している）。**何を買うかは発注Issueが持つ。**

| この文書に残す | Issueが持つ |
|---|---|
| 部品、定格、メーカー型番、現物の識別、出所（一次資料のURLとsha256） | 買おうとしているものの一覧 |
| 販売元の品番と単価（**再現性のため。**同じものを買えるように） | 在庫数、発注の可否、送料をまとめる判断 |
| その枠が**未選定**であること（設計の状態） | **`未購入`／`購入待ち`という調達の状態** |

**なぜ分けるか。**買えば消える情報を追跡下に置くと、状態が変わるたびにPull Requestが要る。
この文書は31回のcommitのうち相当数を「候補にした」「購入待ちへ足した」「リストから外した」に
費やしている。**部品と定格が確定したときは設計判断でありPull Requestを通す価値があるが、
「まだ買っていない」を「買った」に変えるのは調達の記録である。**

### 発注漏れを防ぐ方法（この文書に残す教訓）

**部品が必要と判明したら、判明した時点で部品表へ行を足す。**`残作業`列に「未購入」と書くだけで
終わらせない。**書いた本人以外には発注時に見えないため、過去に実際の発注漏れを起こしている**
（2026-08-08、`PSU-INGRESS-01`／`CABLE-PI-PWR-01`／`CABLE-PI-LINK-01`の3点が発注に載らなかった）。

**品の確定に実測が要るものは、実測できる状態になってから選ぶ。**定格不足による買い直しを
避けるためである。そのぶん発注が後ろへずれる。**ずれる場合は、発注Issueへ「何を待っているか」を書く。**
**保護部品を先に入れることは、この原則を免除しない**（保護部品は短絡を止めるが、
連続電流の上限は経路の最弱部品が決める）。

**パターン走査には原理的な限界がある。**`未購入`／`未選定`／`Required`等で走査しても、
**文書が必要性を認識していない品は出てこない。**`MEAS-05`（oscilloscope）は
`power-budget.md`が「Oscilloscopeは所有していないため使用しない」と書いていたため
どのパターンにも掛からず、現物の写真で所持が判明するまで検出できなかった。
**走査は漏れの検出であって、網羅の証明ではない。**

## 初期製作の明示的な対象外

| 部品 | 状態 | 理由 |
|---|---|---|
| Arduino Uno | Not used（**controllerとして**） | 初期のreal-time controllerはESP32とする。**この`Not used`は役割の判断であって、所持していないという意味でも、他の役割に使えないという意味でもない。****2026-08-16に、電源過渡の独立した測定機材の手持ち候補として`HW-TBD-034`の材料に入れた**（[power-budget.md](power-budget.md)の`電源過渡の測定方式のdesign review`）。**2026-08-16に現物の刻印でboardと搭載品を確定した。**`BOARD MODEL UNO R3`（裏面silkscreen）、microcontrollerは`ATMEGA328P-PU`（`ATMEL`ロゴ、DIP-28、socket実装、ロット`1344`）、USB-serial変換は`MEGA16U2`（同、QFN、ロット`1336`）。`A0`〜`A5`の6本が`ANALOG IN`として実装されている。**2026-08-17に初めて通電した**（PCのUSB給電のみ。**DeskCat側へは接続していない。**詳細は`MEAS-02`行と[experiment-log.md](experiment-log.md)の`EXP-001`）。**ただし採否は未決定である。****2026-09-14に採否を決定した。**方式1の記録係はArduino Uno R3単独である（正は[power-budget.md](power-budget.md#測定計画)の`測定器の採否を決定した（2026-09-14）`。**ここへ再掲しない**）。ADCの分解能・sample rate・入力範囲・基準電圧は、同日に`DS40002061B`（現物のSPDIPを対象に含む版）で確定した**（値と出典は[power-budget.md](power-budget.md)の`手持ち候補の現物識別`。**ここへ再掲しない**）。**ただし採否は未決定である。****2026-09-14に採否を決定した。**方式1の記録係はArduino Uno R3単独である（正は[power-budget.md](power-budget.md#測定計画)の`測定器の採否を決定した（2026-09-14）`。**ここへ再掲しない**）。未解決の全数とclose条件は[tbd-register.md](tbd-register.md)の`HW-TBD-034`が持つ（**ここへ再掲しない**）。**この行は購入対象ではない** |
| Raspberry Pi Pico | Not used | 初期のreal-time controllerはESP32とする |
| Camera | Not used | Projectのprivacyとscopeに関する決定 |
| Microphone | Not used | Projectのprivacyとscopeに関する決定 |
| Audio output | Not used | 静かなdesktop動作を維持する |
| LCDキャラクターディスプレイモジュール（HD44780系、手持ち） | Not used | 文字専用でgraphic表示不可のため、DISP-01の要件（「顔」としての画像表示）を満たさない |

## 部品受け入れchecklist

各部品を**受け入れ済み**として扱う前に、次を確認する。

**このchecklistは`状態`列の`Selected`のgateではない。**`Selected`は上の状態ラベル定義の
とおり「初期製作で使用する予定」を表すだけであり、部品が特定できた時点で付与する。
このchecklistは、**GPIO割り当てと電源budgetを承認するためのgate**である。

> **現状（2026-08-15時点）**: 下のchecklistは**どの部品についても未完了**である。**2026-08-15の現物確認で`U2`／`U1`の識別は進んだが、下のchecklistの項目はいずれも完了していない**（Revision履歴を参照）。
> `状態`列の`Selected`は「初期製作で使用する予定」（上の状態ラベル定義）を表しており、
> **受け入れ完了を意味しない**。特に次の点が未了である。
>
> - MSP2807（DISP-01／TOUCH-01）とM-12001（PSU-PI-01／PSU-SERVO-01）は**2026-08-08に着荷したが、
>   現物の表示・pin配列・電流をまだ確認していない**。
> - **同じ発注で届いた受動部品も、現物の表示・値を確認していない**（`MEAS-01`のセメント抵抗5本と
>   カーボン抵抗10kΩ、`RES-PULL-01`向けのカーボン抵抗4.7kΩ、Servo bulk capacitorの電解コンデンサ470μF16V）。
>   **入手済みであることと、値が表示どおりであることは別である**（2026-08-12に購入履歴と照合して追記した）。
> - 全部品でpeak電流が未実測である（`power-budget.md`の測定計画）。
> - ADXL345とBME280のinterface選択jumper、実装済みaddressが現物未確認である。
>
> このchecklistが部品ごとに完了するまで、GPIO割り当てと電源budgetを承認済みとして扱わない。

- [ ] 現物に記載された正確な表示を読んだ
- [ ] Module boardの識別情報が明確である
- [ ] Revision／dateを含む公式データシートへリンクした
- [ ] Module回路図または検証済みpinoutへリンクした
- [ ] 供給電圧とlogic電圧が明確である
- [ ] **周辺module3点（MSP2807、ADXL345、BME280）とESP-WROOM-32D module自身の`VDD33`がmoduleとして受け入れてよい電圧の積集合、およびESP32のlogic levelから、3.3 V railの許容電圧範囲を確定した**（**この3.3 V railはESP32 module自身の電源でもあるため、module supplyも積集合の一員である。**2026-08-12時点でbindingでないだけであり、対象から外さない。[power-budget.md](power-budget.md)の段階B-2の**共通**条件。**給電経路に関わらず必要**であり、B-2bを選んでも省略できない。追跡は[tbd-register HW-TBD-025](tbd-register.md)）。**積集合を取る対象はIC単体の動作範囲ではない。ADXL345分は`HW-TBD-004`が解けるまで確定しない**（`moduleへ入れてよい電圧`が未確定であるため）。**未了の理由は2つある**（2026-08-12時点。値の正は[power-budget.md](power-budget.md)の共通条件表の`許容電圧範囲`行であり、ここへ再掲しない）。(1) 上記のとおりADXL345分が欠けている。(2) **`DISP-01`と`ENV-01`から出る暫定値の下限が、そのままでは成立しない**（下限がrailの公称値と同一で下振れ余裕が無く、`U2`の出力下限がそれを割る。**2026-08-15に`U2`のメーカーを特定し、この記述の根拠が参照設計の`AMS1117`から現物の`LD1117-3.3`へ移った。出力電圧範囲は3.234–3.366 Vであり、下限が3.3 Vを割る点は変わらない。****別行は立てず`HW-TBD-025`(a)で追跡する**）
- [ ] **周辺module3点それぞれについて、耐えられる電流の上限を持っている**（同じく**共通**条件。追跡は[tbd-register HW-TBD-025](tbd-register.md)。**MSP2807は未公開のため現状は無く、その分は`HW-TBD-024`**。**2026-08-15に`U1`（board上LDO）をUMW `XC6206P332MR`と特定し、そのdatasheetから`U1`を通る分の上限は得た**（絶対最大`IOUT` 500 mA、`PD` 300 mW、保証`IOUT(max)` min 100 mA）。**それでもmoduleとしての上限は満たせない。**backlightのLED列が`U1`の出力側にあるか`VCC`側にあるかが未確認であり、上流なら`U1`の能力は掛からないためである。**残るのは通電を要さない現物確認**（backlight経路のパターン追跡とLED個数）である。**ADXL345とBME280は2026-08-12にdatasheetを確認した。両者とも絶対最大定格は公開されているが、電流の上限は記載が無い**（ADXL345 Rev. G Table 2 page 5、BME280 Rev. 1.24 Table 5 page 13）。**したがって3点すべてについて、この項目をdatasheetからは満たせない。**現物回路の確認か、上限を得られないなら当該moduleへB-2で給電しない）
- [ ] **B-2a（`3V3` pin給電）を採る場合:** Board上regulatorの種別（LDO／switching）、`3V3` pinが外部へ供給できる電流の定格、および**過電流保護／短絡保護の有無と動作**を確認した（`MCU-01`のみ。電流定格と電圧範囲は通常動作の上限にすぎず、短絡・配線ミス時の電流を制限するのは過電流／短絡保護である。保護が無いか確認できない場合はB-2aを採らない）。**2026-08-15時点で埋まったのは種別だけである。****種別はLDO**（`U2`＝UMW `LD1117-3.3`）。**保護は部分的にしか埋まっていない。**電流制限`Ilimit` min 1.25 A／max 1.6 Aと熱shutdown`TSD` typ 150 ℃は確定したが、**短絡保護と折り返し特性はdatasheetに記載が無く、記載が無いことは無いことの確認にならない。**この項目が求めているのは**短絡・配線ミス時の動作**であり、そこが未確定である以上**この項目は満たせていない。****あわせて分かったのは、`IOUT` 1.0–1.25 Aの区間は電流制限が動作しない範囲だということである。**この区間で何が電流を絞るかは決まっていない。**残る`3V3` pinの外部供給可能電流の定格も、Espressifが公開しておらずICのdatasheetでも埋まらない**（[tbd-register HW-TBD-023](tbd-register.md)）
- [ ] **B-2b（外部3.3 V電源給電）を採る場合:** 電流制限値を設定でき制限中を表示できる電源であること、**設定値で実際に電流が制限されることをmodule接続前に確認したこと**、**無負荷出力電圧が許容範囲内であることをmodule接続前に確認したこと**を記録した（表示は制限動作の証明ではなく、電流制限は出力電圧の誤りを防がない）
- [ ] 通常電流とpeak電流が明確、または測定予定がある
- [ ] Connector方向とpin 1が明確である
- [ ] Bus設定と起動sequenceが明確である
- [ ] 必要なpull-up、capacitor、level shiftingが明確である
- [ ] 入手性と代替リスクを記録した
- [ ] `gpio-assignment.md`と`power-budget.md`を更新した

## Revision履歴
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
