wachi-yoshitaka-11-dev/deskcat/hardware/breadboard-rebuild/README.md

# ブレッドボードの組み直し配置（#512）

> 状態: **2026-10-31 に組んだ**（[EXP-052](../../docs/hardware/experiment-log.md)）。通電前の導通20項目は期待どおり、`bringup-led-514` で LED が点いた。組んだ後に、この配置が `../breadboard/layout.svg` になった。組み直す前の配線の記録は、[実験記録](../../docs/hardware/experiment-log.md) の `Wiring revision` と、Git の履歴にある組み直す前の `../breadboard/layout.svg` である。
> この文書は配線の許可ではない。通電、書き込み、UART の信号線の接続、サーボの駆動は、それぞれの正本の条件と承認に従う。

| file | 中身 |
|---|---|
| [`layout.svg`](layout.svg) | 配置図（3枚の板と、板の外へ出る線） |
| [`wiring-table.md`](wiring-table.md) | 結線表。各線の両端の穴、硬い・柔らかいの別、硬いものの長さ、抵抗の値と位置、LED の向き、足を切る部品 |
| [`generate.py`](generate.py) | 配置の正本のデータ。図と結線表をここから生成し、手で直さない。生成の前に、穴の重複、ESP32 の下の穴の使用、硬いものと抵抗の交差と足の上の通過、論理接続の食い違い、5 V の安全（下の `配置の考え方` の5）を検査する |

```bash
python3 -I hardware/breadboard-rebuild/generate.py --check
```

## 判断の出所

| 判断 | 誰が | 記録 |
|---|---|---|
| ブレッドボードを最終版として扱い、配置を最適化して組み直す。足を程よく切る。LED は結線表に向きを書く。`PROTO-02` へ移す電源部は切らない。板の中は硬いジャンパーを優先する。module はブレッドボードに挿す。大きいブレッドボードの追加購入はなるべく避ける | ユーザー（2026-10-23） | VM 側の PM からの作業指示 |
| 硬いジャンパーは被覆ありで長さが多数ある。`ACCEL-01` と `ENV-01` はピンヘッダが付いている。EIC-3901 の電源列の読み（下記）。`ACCEL-01` の2列の間隔は、実機が手元に無く分からない | ユーザーの回答（2026-10-23） | このセッションの質問への回答 |
| 首を通る14本は、手持ちとして記録のある両端メスのジャンパー線を使い、胴側は B2 に立てた細ピンヘッダ（`PROTO-01`）14本で受ける | VM 側の PM の決定（2026-10-23）。**2026-10-31 に、メスオス線のオス側を直接挿す形に変えた（実機側の PM の判断。ユーザーの原文は EXP-052）。細ピンヘッダは使っていない** | 作業セッションへの連絡 |
| 5 V の安全の3点（GPIO33 へは分圧器を通ってだけ届く、5 V の列の両隣を空ける、サーボの電源と Pi の給電をブレッドボードに通さない）を検査に入れる | VM 側の PM の判断（2026-10-23） | 作業セッションへの連絡 |
| 板の割り当て、穴の位置、線の種類、pull 抵抗を LCD 側の板へ移すこと、組み直した直後に抜いておく線 | **AI（作業セッション）が設計した。人間の承認は得ていない** | この文書と `generate.py` |

## 使う板

手持ちの `PROTO-01`（[BOM](../../docs/hardware/hardware-bom.md)）だけを使う。購入は要らない。

| ID | 板 | 載せるもの |
|---|---|---|
| B1 | EIC-3901（6穴版） | ESP32、ESP32 の J2 側の pull、3V3／GND の電源列、UART とサーボ信号の直列抵抗、LED 2枝、ADC-5V の分圧 |
| B2 | BB-601（1枚目） | 首を通る LCD の14本の受け口、LCD 側の pull（CS・RST・T_CS・BL） |
| B3 | BB-601（2枚目） | `ENV-01`、`ACCEL-01`、ADC-3V3 の分圧 |

組み直す前の配線に使っていた a〜j 行・30列の板は使わない（型番が記録に無い）。B2 は B1 の上の辺（J3 の側）に並べて置き、J3 から B2 への線（S5〜S12）を短くする。B3 の置き場所は仮筐体で決める。

## 配置の考え方

1. **ESP32 の向き。**EIC-3901 に挿すと、片側に1穴、反対側に2穴が残る（ユーザーの申告と写真）。電源列は下側の1組だけなので、2穴の側を電源列の側に置く。J2（3V3・GND・I2C・SERVO-PWM）を下の J 行に、J3 を上の B 行にし、USB を板の端（30列の側）に出す。この向きで、J2-1（3V3）、J2-9・10（I2C）、J2-11（GPIO27）、J2-14（GND）の列が電源列の穴の列（1〜6・9〜14・17〜22・25〜30）とそろい、pull 抵抗と電源の硬いジャンパーを L 行から電源列へ縦にまっすぐ挿せる。アンテナの下と近く（9〜11列）は使わない。
2. **J3 側は1穴しか残らない。**LCD の CS・RST・T_CS の pull-up と BL の pull-down は、ESP32 の脇ではなく B2（LCD の受け口の板）に置く。同じ導体の上の位置が変わるだけで、論理接続は今と同じである。
3. **LCD の14本。**首を通す線は14本である。2026-10-31 の組み直しで、LCD に付いているメスオス線のメス側を LCD のピンに挿したまま、オス側を B2 の穴へ直接挿した（細ピンヘッダは使っていない。[enclosure-and-neck.md](../../docs/hardware/enclosure-and-neck.md) の `仮筐体` の両端メスとは違う暫定で、首の経路の長さは未確認。実機側の PM の判断）。SCK と T_CLK、SDI と T_DIN、SDO と T_DO は同じ列に挿して共有する（[#34 の決定](https://github.com/wachi-yoshitaka-11-dev/deskcat/issues/34#issuecomment-5864974935)、[enclosure-and-neck.md](../../docs/hardware/enclosure-and-neck.md) の `頭と胴の14線`）。これで共有のためのジャンパーが要らない。
4. **センサーを別の板にする。**B3 は ESP32 と Pi から離して胴に固定できる。`ENV-01` を Pi の熱から離すこと、`ACCEL-01` を胴に固定すること（[enclosure-and-neck.md](../../docs/hardware/enclosure-and-neck.md)）に合わせられる。B3 の置き場所は仮筐体で決める。
5. **短絡しにくさ。**硬いジャンパーと抵抗・LED は縦か横の直線だけにし、両端の間の穴を空け、互いに交差させない（`generate.py` が検査する）。長い距離と板をまたぐ所は柔らかい線にする。5 V は ESP32 の 5V pin から ADC-5V の分圧へ行く S18 だけで、行き先の B1 G8 の列（下半分の8列）は電源列の穴が無い列で、下半分の両隣（7列と、使わない9列）は空けてある。`generate.py` は、5 V の導体に触れる部品が R11（先は GPIO33）だけで、GPIO33 には R11 と R12（先は GND）だけが触れること、5 V の列の両隣に ESP32 自身のピン以外が無く、その上をほかの部品が通らないこと、板の外へ出る線にサーボの電源と Pi の給電が無いことを検査する。
6. **大電流はブレッドボードを通さない。**サーボの電源と GND の戻り、Pi の給電、`MEAS-01` の shunt はブレッドボードに載せない（[power-budget.md](../../docs/hardware/power-budget.md) の `大電流経路にbreadboard接点とジャンパー線を使わない`、BOM の `PROTO-01`）。サーボを ESP32 から給電しない。ブレッドボードを流れるのは信号と、ESP32 の `3V3` pin から取る小電流の枝と、ADC-5V の分圧の電流（5V pin から 10 kΩ＋10 kΩ）だけである。
7. **論理接続は変えない。**載せる回路は今の記録（基準図、EXP-022、EXP-025、EXP-028、EXP-038）と同じ節点の組である。この設計が KiCad 回路図（`../deskcat.kicad_sch`）の更新を新たに要することは無い。測定器の線（`MEAS-02` の Arduino）と、今つながっていない GPIO32 の線は載せない（`wiring-table.md` の `載せないもの`）。

## 値と並びの出所

| 何 | 出所 |
|---|---|
| ESP32 の J2・J3 の並び | [gpio-assignment.md](../../docs/hardware/gpio-assignment.md) の `Board識別情報`（公式回路図 `ESP32_DevKitc_V4`、2017-12-06。基板の silk と照合済み） |
| ESP32 の GND の3本（J2-14、J3-1、J3-7）が基板の中で同じ GND であること（検査の前提。Pi の GND の線 X3 を J3-7 に挿す） | 同じ公式回路図。現物の導通は測っていない |
| ESP32 の上から見た向き（USB を右にすると J3 が上、J2 が下） | 下の行の Espressif の寸法図（裏から見た図）で、上の列が J3（左から CLK … GND）、USB が左、アンテナが右である。表から見ると左右が入れ替わり、USB が右、J3 が上になる（図からの読み）。挿すときは基板の silk で確かめる |
| ESP32 の寸法（ヘッダー長 48.2 mm、全長 54.4 mm、幅 27.9 mm） | [Espressif ESP32-DevKitC V4 Getting Started Guide](https://docs.espressif.com/projects/esp-idf/en/v5.1/esp32/hw-reference/esp32/get-started-devkitc.html) の `Board Dimensions` の図（`esp32-devkitc-dimensions-back.jpg`、sha256 `52d81d696ebdb0c804d30b5d5361f1eaabca886cafc16b14edf48abdc0de02f1`、2026-10-23取得）。アンテナが1番ピンの先へ約6 mm 出ることは、この図の寸法の差（54.4 − 48.2 mm）から読んだもので、9〜11列を使わない根拠にした |
| EIC-3901 の行・列（30行、6×2列、電源1組） | [秋月 112366](https://akizukidenshi.com/catalog/g/g112366/)（2026-10-23取得）。電源行数は「5×4」と書かれているが、写真では各6穴×4組に見え、ユーザーが写真の読みを（原文省略）と答えた。図は写真の読みに従う |
| EIC-3901 の電源列（L 行側が −、外側が ＋、穴は 1〜6・9〜14・17〜22・25〜30 列、赤の列は14と17の間を赤い部品でつなぐ） | ユーザーの写真の読みと、ユーザーの回答（2026-10-23） |
| BB-601（17行、5×2列、45×34.5 mm） | [秋月 105155](https://akizukidenshi.com/catalog/g/g105155/)（白の品。販売終了。2026-10-23取得）。手持ちはスケルトンの品で、同じ型番として扱った |
| `ACCEL-01` のピン（上段 CS Vs GND VDD、下段 INT1 INT2 SDO SDA SCL） | [sensor-datasheet-notes.md](../../docs/hardware/sensor-datasheet-notes.md) の `module boardの値（秋月 M-06724）`（2026-08-13の現物確認）。2026-10-23 のユーザーの写真の silk とも一致した |
| `ACCEL-01` の上段の列（CS が INT1 の上、VDD が SDA の上） | 2026-10-23 のユーザーの写真の読み。記録とメーカーの資料には無い（商品ページは404、同文書） |
| `ENV-01` のピン（VDD GND CSB SDI SDO SCK） | 同文書の AE-BME280 の `pin配列`。2026-10-23 のユーザーの写真の silk とも一致した。基板の `J3` などのはんだジャンパの状態は写真から判断せず、同文書の `J3をはんだ付けした（2026-09-07）` を正とする（この設計はジャンパに触れない） |
| 各 module の今のつなぎ方（CS–VDD の茶のループ、SDO を GND、CSB と INT1・INT2 はつながない） | 組み直す前の `../breadboard/layout.svg`（基準図①。Git の履歴にある） |
| LCD の14 pin と共有 | [enclosure-and-neck.md](../../docs/hardware/enclosure-and-neck.md) の `頭と胴の14線`。2026-10-23 のユーザーの写真（裏面の silk、`2.8 TFT SPI 240X320 V1.2`）の並び VCC GND CS RESET DC SDI(MOSI) SCK LED SDO(MISO) T_CLK T_CS T_DIN T_DO T_IRQ と一致した |
| pull の値と向き、I2C の pull-up、UART の直列 4.7 kΩ、ADC の分圧 | [gpio-assignment.md](../../docs/hardware/gpio-assignment.md) の `信号inventory`、`起動時状態を確定させる外部pull`、`Pi–ESP32間のtransport` |
| LED 2枝と 330 Ω（`CF25J330RB`） | [led-514-demo.md](../../docs/hardware/led-514-demo.md) |
| サーボ信号の直列 330 Ω | [experiment-log.md](../../docs/hardware/experiment-log.md) の `EXP-028`（GPIO27 とサーボの黄の穴のあいだに入ったまま）。GPIO の正本には無い試験の部品で、残すかどうかは #17・#18 の側が決める |

## 残った `TBD`

- **ACCEL-01 の上段4本の行。**組んだ結果：2列の間隔は6穴分（ユーザーの計測、2026-10-31）で、上段は b 行になり、上の a 行が空き穴になる。基板の印字が当初の読みと左右逆だったため、上段は 3〜6 列（VDD 3、GND 4、Vs 5、CS 6）、下段は SCL 2、SDA 3、SDO 4、INT2 5、INT1 6 とした（[EXP-052](../../docs/hardware/experiment-log.md)）。
- **module の本体の大きさ。**`ENV-01` の本体を板の外へ出す向きで、ピンの名前の順が結線表と同じになるか。`ACCEL-01` の本体が B3 の10・11列（H9・H10）にかかるか。
- **溝の幅と電源列までの距離。**EIC-3901 は写真から、溝が3ピッチ、L 行から − の列が3ピッチ、＋ の列が4ピッチと読んだ（目安）。BB-601 の溝の幅は記録が無く、図は3ピッチで描いた。H1〜H4・H9・H10 の長さと、電源列へ下りる抵抗・LED の足の長さは現物で合わせる。
- **電源列の導通。**− の列（青）が全長でつながっていること、＋ の列（赤）が赤い部品で14〜17列の間をつながっていること。メーカーの説明は「赤い電源ラインは2系統に分けられる」だけで、青の列の分断については書いていない。
- **細ピンヘッダの残数。**首の14本は細ピンヘッダを使わなかったので、要らなくなった。

## 組み直しで気をつけること

- 組み直しは電源を切った状態で行う（ESP32 の USB、Pi、サーボの電源を外す）。初回通電と回路変更後の試験は人間が監視する（[Hardware Safety Policy](../../docs/governance/hardware-safety-policy.md)）。通電前の照合は実機側が行う。
- 通電の前に、ESP32 の向きを基板の silk で確かめる。J2-1（3V3）が B1 の J 行・12列、J2-19（5V）が J 行・30列、J3-1（GND）が B 行・12列に挿さっていること。向きは寸法図からの読みであり（`値と並びの出所`）、逆向き（180度回した向き）に挿すと、H1（3V3）が J3-19（CLK、flash 用）に、H2（GND）が J3-6（GPIO21）につながる。
- 組み直した直後に抜いておく線は、結線表の `組み直した直後` 欄にある（Pi との UART の線の ESP32 側の端と Pi の GND の線、サーボの信号線と GND を共通にする線）。LED の GPIO の線（S19・S20）は、実機側の PM の決定（2026-10-31）で、USB を挿す前に挿し、窓の間は抜き差ししない。抜いておく線を挿すのは、それぞれの正本の条件を満たしたときだけである。
- 組み直した後、実機側が実験記録の `Wiring revision` と `../breadboard/layout.svg` を同じ PR で更新する（[hardware/README.md](../README.md)）。そのとき、この配置から変えた所があれば、ここの `generate.py` も直す。
