wachi-yoshitaka-11-dev/deskcat/docs/DeskCat_Microcontroller_Development_Guide.md

# DeskCat マイコン開発技術ガイド

> 対象: DeskCat の ESP32 ファームウェア開発
> 状態: 設計・実装前の技術基準
> 作成日: 2026-07-27
> 最終改訂: 2026-07-31

---

## 0. この文書の目的

この文書は、DeskCat の ESP32 ファームウェアを設計・実装するための、プロジェクト固有の技術基準である。次の用途を想定している。

- ESP32 の回路・ピン・電源設計を確定する
- Rust／ESP-IDF ファームウェアを段階的に実装する
- LCD、タッチ、加速度、環境センサ、サーボを安全に統合する
- Raspberry Pi Zero W との UART 通信を安定化する
- AI コーディングを使いながら、誤推定・回帰・危険な自動操作を防ぐ
- 実機不具合をログ、計測器、デバッガで切り分ける
- 将来の部品変更や OTA に耐える構造を作る

本書の数値例や構造案は、次の三段階で区別する。

| 表記 | 意味 |
|---|---|
| **確定** | 承認済みのADR、Governance、正本文書で合意済み |
| **推奨** | 根拠を示した DeskCat 向けの設計推奨。採用判断が必要 |
| **TBD** | 部品型番、公式データシート、回路の確定が必要。確定に要する根拠の水準は[Hardware Safety Policy](governance/hardware-safety-policy.md#5項目の中での根拠の水準)に従う。安全要件5項目に効かない値は[同ポリシーの5項目以外の扱い](governance/hardware-safety-policy.md#5項目以外の扱い)により一般値で開始してよい |

GPIO 番号、センサ型番、I/O 電圧、通信速度、サーボ角度、しきい値などを AI の記憶だけで確定してはならない。どの値に採用部品の公式資料または実機での確認を要するかは、[Hardware Safety Policy](governance/hardware-safety-policy.md#5項目以外の扱い)の対応表に従う（安全要件5項目に効かない値は一般値で開始してよい）。

### 0.1 読み方

| 目的 | 主に読む節 |
|---|---|
| 本書の原則と開発姿勢を把握する | 1–2 |
| ESP32 と Raspberry Pi の責務を決める | 3–4 |
| 部品、電源、GPIO を設計する | 5–7 |
| MCU／Rust／RTOS の基礎を確認する | 8–10 |
| 通信と各周辺機能を実装する | 11–18 |
| 立ち上げ、デバッグ、ビルド、試験を進める | 19–24 |
| OTA、安全、AI 開発運用を設計する | 25–29 |
| TBD、次の成果物、完了条件を確認する | 30–34 |

---

## 1. 最初に守るべき原則

DeskCat のマイコン開発では、以下を最上位のルールとする。

1. 要求、制約、受け入れ条件は人間が決める。
2. 部品仕様は販売ページや AI 回答ではなく、メーカーのデータシートで確認する。
3. GPIO、電源、通信、機械可動域は、実機確認前に推測で固定しない。
4. ハードウェア単体、デバイス単体、通信単体を先に検証し、最後に統合する。
5. 一度に完成品を生成させず、小さい実装と実測を積み重ねる。
6. 「動いた」だけでなく、観測可能なログ、カウンタ、状態取得手段を用意する。
7. ISR は短く保ち、重い処理はタスクまたはメインループへ渡す。
8. サーボは ESP32 から給電しない。外部電源を使い、GND を共通化する。
9. サーボ角度、速度、加速度、連続動作時間にソフトウェア上の安全制限を設ける。
10. Raspberry Pi と ESP32 の責務を混ぜない。
11. AI の修正後は、対象機能だけでなく既存機能の回帰も確認する。
12. AI が生成した低レベル初期化コードを、公式 SDK の初期化より先に信用しない。
13. ビルド、書き込み、ログ取得、テストの手順を CLI で再現可能にする。
14. 不具合解析では、仮説より先に完全なエラー、再現条件、ログ、波形を集める。
15. 未確定事項を暗黙の仮定で埋めず、TBD として管理する。

---

## 2. 本書が前提とする開発姿勢

DeskCat は、AI エージェントを併用しながら、実時間 I/O と可動機構を持つ機器を開発する。この組み合わせで崩れやすい前提を、あらかじめプロジェクトの姿勢として固定する。

### 2.1 AI を併用する開発で崩れやすい前提

AI は候補比較、文書化、定型コード生成を大きく加速する。一方で、次が起こりうる前提で運用する。

- 存在しない製品仕様、誤った型番解釈、古い情報を、確信のある文体で返すことがある。
- 公式資料を渡しても、最終的な型番、外形、電圧、精度、供給性は人間の確認が必要である。
- 利用者の記述に同調し、誤った前提をそのまま補強することがある。
- ある不具合を修正した際に、過去の補正やしきい値が意図せず失われる回帰が起こる。
- 複数の AI が同じ回答をしても、それは根拠ではなく分布の一致でしかない。

対策は、正式仕様、決定記録（ADR）、受け入れテストを、プロジェクトの判断基準線として維持することである。
ただしこれらは「ハードウェアの事実」の根拠ではない。部品の挙動、電圧、timing、範囲のうち、
[安全要件5項目](governance/hardware-safety-policy.md#安全要件の5項目)に効く値は、
メーカー公式資料または実測を根拠とする（[Governance の権限の優先順位](governance/README.md#権限の優先順位)）。
5項目に効かない値は、[同ポリシーの5項目以外の扱い](governance/hardware-safety-policy.md#5項目以外の扱い)により
一般値で開始してよい。
ADR とテストが決めるのは、その根拠をどう採用し、何を受け入れ条件とするかである。
詳細は [AI Agent Policy](governance/ai-agent-policy.md) を参照する。

### 2.2 段階的立ち上げを設計の初期条件にする

センサ、通信、機構を一度に実装せず、単体で観測できる状態を先に作る。DeskCat では次の順序を標準とする。

1. 電源と静的な電気確認
2. ビルド、書き込み、起動ログ
3. USB シリアル単体
4. I2C 単体・デバイス一個
5. LCD 単体
6. タッチ単体
7. 加速度単体
8. Pi–ESP32 通信単体
9. サーボ単体（無負荷）
10. 統合
11. 長時間・異常試験

サーボを通信より後に置くのは、サーボ安全制限が通信断の検知（`HW-TBD-017`）に依存するためである。
通信単体が動く前にサーボへ通電すると、断を検知できない状態で機構を駆動する。
ゲートの依存関係（ゲート B はゲート A の完了を前提とする）とも、この順序で一致する。

この順序は作業の分解方法を示すものであり、**実機を駆動してよいという判断ではない**。
通電のゲートは、基板側とサーボ側で分ける。サーボを扱わない段階まで
サーボ固有の `TBD` で止める必要はなく、逆にサーボ側を基板側の条件だけで通してもならない。

**ゲート A: 基板の初回通電（step 1–8）**

- 通電する各 device について、[Hardware Safety Policy](governance/hardware-safety-policy.md)が要求する
  根拠一式が揃っている。**電圧の確認だけでゲート A を通さない。**
  - 正確なメーカー名と型番
  - 絶対最大定格
  - 通常時とピーク時の消費電流
  - pinout
  - 必要な外付け部品（pull-up、デカップリング、保護素子）
- 各 device の供給電圧とロジック電圧を、公式資料で確認済みである
- 電源経路と backfeed の有無を確認済みである。**配線レビューだけを根拠にしない。**
  内部保護経路の有無は外形からは判断できないため、**メーカー資料の記述、または
  制御した条件下での実測**を根拠とする。どちらも示せない device は、
  接続前に[TBD台帳](hardware/tbd-register.md)へ記録し、未解決のまま接続しない
- 人間が立ち会い、直ちに電源を遮断できる
- 停止条件（異音、発熱、brownout、過電流）を事前に定義してある

起動時 GPIO 状態は初回通電前には実測できない。データシートと board 回路図で
**予測**したうえで通電し、初回通電時に実測して[GPIO Assignment](hardware/gpio-assignment.md)へ記録する。

**この初回通電では、外部負荷とアクチュエータをすべて切り離す。**
予測は実測の代わりにならない。予測できた pin であっても、実測前に負荷を接続すれば、
予測が外れたときに意図しない駆動がそのまま起きる。測定のための通電が、
それ自体で実機を動かしてはならない。

- **サーボは信号線ごと切り離す。**外部 5 V を断っただけでは足りない。
  信号線が残ると、ESP32 の起動時 GPIO がサーボ内部回路へ電流を注入しうる。
  非動作時の backfeed 耐性は採用サーボのデータシートまたは実測で示す必要があり
  （`HW-TBD-009`）、示せるまで電源線と信号線の両方を外す
- バックライトその他の負荷は、給電を断つか駆動段を無効にする
- **対象を駆動しない計測器だけを当てる。**測定項目で選ぶ
  - 電圧、ロジック電圧: テスタ
  - brownout、電源の短時間降下、起動時の電源過渡: オシロスコープ。DMM では捉えられない
  - 起動時 GPIO の遷移: ロジックアナライザまたはオシロスコープ

**ゲート A の合格条件は、実測値が承認範囲内であることである。**測定を実施して記録しただけでは通過しない。

- 供給電圧、ロジック電圧、消費電流、起動時の電源過渡、起動時 GPIO 状態を**すべて実測**してある
- 各実測値が、絶対最大定格と通常時・ピーク時の消費電流に照らして**承認範囲内**である
- 実測値を[GPIO Assignment](hardware/gpio-assignment.md)へ記録してある

**未測定の項目が一つでもある場合、または実測値が承認範囲外だった場合、ゲート A は不合格である。**
範囲外の結果を記録したことをもって通過扱いにしてはならない。ゲート B はゲート A の完了を前提とするため、
ゲート A が不合格の間はゲート B へも進まない。原因を除去して再測定し、承認範囲内に収まるまで、
**外部負荷とアクチュエータは切り離したままにする。**測定値が不明な項目についても同じ扱いとする。

実測値を[GPIO Assignment](hardware/gpio-assignment.md)へ記録したあとに接続してよいのは、
**アクチュエータ以外の負荷だけ**である。

**サーボの電源線と信号線は、ゲート B を満たすまで接続も通電もしない。**
GPIO の実測記録はゲート B の条件の一部でしかなく、
[Servo Safety Limits の有効化条件](hardware/servo-safety-limits.md#サーボ出力を有効化してよい条件)、
`HW-TBD-009`（backfeed review）、通信断検知が揃うまでは再接続を許さない。

**ゲート B: サーボ電源投入と初回動作（step 9）**

ゲート A に加えて、[Servo Safety Limits の有効化条件](hardware/servo-safety-limits.md#サーボ出力を有効化してよい条件)を**すべて**満たす。
本書では条件を再掲しない。再掲すると正本との差分が生じ、片方だけを見た判断を招く。

サーボ初回動作は、[Hardware Safety Policy](governance/hardware-safety-policy.md#7-人間の監視が必要な操作)が人間の監視を必須としている操作である。
必ず[Servo Safety Limits](hardware/servo-safety-limits.md#calibration手順)の手順に従う。
本書の順序を根拠に、これらを省略してはならない。

センサ値が不正なときは、回路、基準電圧、ADC、ライブラリ上限、ソフトウェア補正を順に切り分ける。通信は既知のダミーデータで先に検証し、同期、長さ、連番、分割、欠落を観測可能にする。

### 2.3 抽象化の下を観測できる状態を保つ

HAL や SDK が隠している層を、必要なときに観測できることを設計条件とする。

- SoC は CPU、ROM、RAM、周辺回路で構成され、周辺回路はメモリマップド・レジスタとして操作される。
- 起動時の初期スタック準備、`.data`／`.bss` の初期化、クロック設定は、アプリ実行前に完了している必要がある。ただし**その担当と実行時点は target、ブート段階、リンカ・スクリプト、ツールチェーンによって異なる**。ROM ブートローダ、起動コード、SDK のいずれが行うかを、対象ごとに確認する。
- ピンや周辺回路の設定は、この低レベル起動処理とは別の段階で行う。ESP-IDF では component 初期化段階や `app_main` 以降が通常であり、BSS clear と同じ「起動直後」に置かれるとは限らない。
- コンパイラ、リンカ、変換ツール、書き込みツール、デバッガの役割を理解していれば、IDE の外でも原因を追える。
- リンカ・マップとサイズ情報から、コードと静的データの配置を確認できる。
- GDB、OpenOCD、UART ログは相互補完する。ただしデバッガによる停止は WDT を誘発し、timing 依存の不具合を隠すことがある（§21.5）。観測手段自体が対象を乱しうる点を前提に使い分ける。
- センサ固有処理はアダプタへ閉じ込め、上位層には共通の測定値、状態、エラーだけを見せる。
- 初期化順序とデバイス依存関係を設定へ明示すると、統合時の競合を減らせる。

分類は次のとおりである。他の MCU へ当てはめる際は、どの層の話かを確認する。

| 区分 | 該当する項目 |
|---|---|
| SoC 一般に共通する概念 | SoC の構成（CPU／ROM／RAM／周辺回路）、周辺回路のメモリマップド・レジスタ操作 |
| 一般的な組込み開発／ツール運用 | リンカ・マップとサイズ情報の読み方、GDB／OpenOCD／UARTログなど観測手段の相互補完 |
| target・ブート段階・ツールチェーン依存 | スタック、`.data`、`.bss`、クロックの初期化。**どの段階で誰が行うかは target とブートローダ、リンカ・スクリプトで決まる** |
| ESP-IDF／ESP32 固有 | ピンと周辺回路の初期化段階（component 初期化や `app_main` 以降）。デバッガ停止が WDT を誘発する挙動（デバイスのデバッグ構成に依存） |
| DeskCat のプロジェクト設計方針 | センサ固有処理をアダプタへ閉じ込める境界。初期化順序と依存関係を設定へ明示する方針 |

アダプタ境界と初期化順序の明示は SoC 一般の性質ではなく、本プロジェクトが選んだ設計である。

いずれも DeskCat のハードウェア定数ではない。
**ESP32 で実際にどう起きるかは、必ず Espressif の公式資料で確認する。**
ブートステージ、初期化順序、リンカ配置、デバッガ構成は SoC ごとに異なる。

| 確認する対象 | 公式資料 |
|---|---|
| 起動シーケンスと初期化順序 | [ESP-IDF Startup Flow](https://docs.espressif.com/projects/esp-idf/en/stable/esp32/api-guides/startup.html) |
| バイナリ配置とサイズ情報 | [ESP-IDF Binary Size Analysis](https://docs.espressif.com/projects/esp-idf/en/stable/esp32/api-guides/performance/size.html) |
| デバッガ構成 | [ESP-IDF JTAG Debugging](https://docs.espressif.com/projects/esp-idf/en/stable/esp32/api-guides/jtag-debugging/index.html) |

これらの資料で確認した内容のうち、DeskCat の設計判断に影響するものは、
本書ではなく該当する正本文書（GPIO、電源、toolchain）へ記録する。

他アーキテクチャ（STM32／Cortex-M など）向けの解説やサンプルを参照する場合は、レジスタ番地、ベクタ・テーブル、スタートアップ・コード、ペリフェラル設定を DeskCat の ESP32 へそのまま流用してはならない。アーキテクチャ、ブート、割り込み、SDK がいずれも異なる。参照してよいのは考え方であり、値ではない。

---

## 3. DeskCat のシステム境界

### 3.1 確定している役割分担

| 装置 | 主な責務 |
|---|---|
| ESP-WROOM-32D開発ボード（秋月電子 M-13628） | LCD 描画、サーボ制御、タッチ検出、加速度取得、環境センサ取得、即時の安全制御 |
| Raspberry Pi Zero W | 感情・状態モデル、自律動作方針、独り言生成、ログ保存、API、長期的な判断 |
| UART | ESP32 と Raspberry Pi 間の通信経路（2026-09-28 に USB シリアルから変更。pin と接続の条件は [GPIO Assignment](hardware/gpio-assignment.md) の `Pi–ESP32間のtransport` 節が正本） |

この分担から、ESP32 は「実時間 I/O コントローラ」、Pi は「高水準の行動・状態コントローラ」と考える。

### 3.2 ESP32 に置くべき処理

- サーボ PWM の生成
- サーボの絶対的な角度・速度・加速度制限
- タッチ、加速度、環境センサの取得
- 入力のデバウンス、一次フィルタ、異常値除外
- LCD の描画プリミティブと描画状態
- Pi から来た命令の構文・範囲検証
- 通信断時の安全状態
- ウォッチドッグへの応答
- ハードウェア自己診断と状態報告

Pi が不正な角度や過大な速度を指示しても、ESP32 側で拒否または制限する。安全境界を Pi のアプリケーションだけに依存させない。

### 3.3 Raspberry Pi に置くべき処理

- 感情値や人格状態の更新
- 行動パターンの選択
- 長時間の履歴と学習用ログ
- API や外部サービスとの通信
- 複雑な文章生成
- ユーザー設定の永続管理
- ESP32 の状態をまとめた運用監視

### 3.4 二重実装を避ける

たとえば「撫でられたら喜ぶ」は次のように分ける。

1. ESP32 がタッチをデバウンスして `head_touched` イベントを発行する。
2. Pi が感情状態を更新し、表情と首動作を決定する。
3. Pi が `set_expression` と `play_motion` を送る。
4. ESP32 が範囲を検証し、LCD とサーボへ反映する。
5. ESP32 が結果または拒否理由を返す。

この flow は[正本の protocol](protocol/esp32-pi-protocol.md)の Draft 2 に基づく設計であり、
**検証済みの動作ではない**。conformance fixture が未作成（`PROTO-TBD-016`）で、
host と firmware の実装も存在しないため、どの message も相互接続で確認していない。

入力の意味付けと人格判断は Pi、安全な実行は ESP32 という境界を維持する。

---

## 4. 要求をハードウェア仕様へ落とす

### 4.1 要求表

実装前に、各機能を次の形式で確定する。

| 機能 | 入力 | 出力 | 期限・周期 | 失敗時 | 受け入れ条件 |
|---|---|---|---|---|---|
| 表情表示 | Pi の表情命令 | LCD | TBD | 直前の安全な表情を維持 | 指定パターンが実機表示される |
| 撫で検出 | タッチ | イベント | TBD | 未検出として扱う | 誤検出率と検出率が基準内 |
| 衝撃検出 | 加速度 | イベント | TBD | センサ異常を通知 | 指定試験で一度だけ通知 |
| 首動作 | Pi の動作命令 | サーボ | TBD | 中立または停止 | 可動域を越えず滑らかに動く |
| 環境測定 | 温湿度等 | 測定値 | TBD | stale／error を通知 | 基準計との差が許容内 |
| 状態通信 | 各状態 | JSON Lines | TBD | 再接続・再同期 | 欠落を検出できる |

周期やしきい値は、ユーザー体験、部品仕様、CPU 負荷、通信量を見て決める。AI に一般値を入れさせて確定扱いにしない。

### 4.2 品質要求

機能要求だけでなく、次も明記する。

- 起動時間
- 通信断からの復帰時間
- 電源再投入後の状態
- 連続稼働時間
- サーボ動作中の再起動有無
- センサ故障時の縮退動作
- LCD 更新中の入力取りこぼし
- 設定破損時の既定値復旧
- ファームウェアのバージョン識別
- ログ量と保存方針
- 将来の部品変更可能性

### 4.3 受け入れ条件は測定可能にする

悪い例:

- 反応が速い
- 滑らかに動く
- 通信が安定している

良い形式:

- 入力イベント受信から表情命令受付までの 95 パーセンタイルが `TBD ms` 以下
- サーボ目標値の更新間隔に `TBD ms` を超える停止がない
- `TBD 時間` の連続試験で再起動が 0 回
- シリアルの欠番、再送、パース失敗数を取得できる

値自体は試作後に確定してよいが、測り方は先に決める。

---

## 5. 部品選定とデータシート読解

### 5.1 AI に任せてよい作業

- 候補部品の一覧化
- 比較表のひな型作成
- データシートから確認箇所の抽出
- 複数候補の長所・短所の整理
- ドライバ構造のたたき台作成
- テスト観点の列挙

### 5.2 人間が確認すべき項目

- 正確なメーカー名と型番、末尾記号
- 供給電圧と I/O 電圧
- 絶対最大定格
- ピン配置とパッケージ
- 消費電流、起動時・ピーク電流
- 通信方式、アドレス、最大クロック
- 起動時間、変換時間、応答時間
- 測定範囲、精度、分解能、温度依存
- 内蔵プルアップ、外付け部品の要否
- CRC、校正係数、データ変換式
- リセット条件、電源投入順序
- 製造状態、供給性、代替候補
- モジュール基板に載っているレギュレータやレベル変換
- 実物のコネクタ、外形、取付穴、ケーブル方向

同じセンサ IC でも、ブレークアウト基板によって I/O 電圧、プルアップ先、アドレス設定、レギュレータの有無が異なる。

### 5.3 データシート確認票

部品ごとに次を記録する。

```text
部品名:
メーカー:
正確な型番:
資料 URL／版／日付:
実装モジュール名:
供給電圧:
ロジック電圧:
ピーク電流:
通信方式:
通信条件:
ピン:
起動シーケンス:
測定／制御範囲:
変換式:
エラー検出:
既知の制約:
DeskCat での用途:
未確認事項:
実機確認結果:
```

### 5.4 複数の一次情報を関連付ける

最低でも次を組み合わせる。

- MCU／SoC の公式データシート
- MCU のテクニカル・リファレンス
- 開発ボードの回路図とユーザーガイド
- 各周辺部品の公式データシート
- 採用モジュール基板の回路図
- ESP-IDF と Rust バインディングの公式資料

MCU 単体の GPIO と、開発ボード上で実際に空いている GPIO は同じではない。フラッシュ、USB-UART、ブートストラップ、LED などによる占有も確認する。

---

## 6. 電源と信号の基礎

### 6.1 電源系を信号系より先に設計する

DeskCat はサーボを含むため、電源設計が最優先である。サーボの急な電流変化は、ESP32 のブラウンアウト、LCD の乱れ、I2C エラー、シリアル切断の原因になり得る。

**確定事項:**

- サーボは外部 5 V 系から給電する。
- ESP32 の 3.3 V ピンや GPIO からサーボへ給電しない。
- ESP32、サーボ電源、各モジュールの GND は共通化する。

**要設計:**

- 5 V 電源の連続電流とピーク電流
- ESP32 側電源とサーボ側電源の分岐
- 逆流防止
- バルク・コンデンサとデカップリング
- 電源投入・切断順序
- USB 給電と外部給電を同時使用する場合の経路

### 6.2 電流予算

電源容量は平均電流だけで選ばない。

```text
必要連続電流 >= 各機器の最大連続電流の合計 × 設計余裕
必要ピーク電流 >= 同時に発生し得るピーク電流の合計
```

サーボは無負荷動作電流ではなく、起動、加速、拘束に近いピークを確認する。LCD バックライト、Wi-Fi 送信、センサヒータがある場合もピークを含める。

電圧降下の一次見積りには次を使える。

```text
ΔV ≈ I × Δt / C
```

ただし、実際には電源内部抵抗、配線抵抗、コンデンサ ESR、負荷波形が影響する。最終判断はオシロスコープで ESP32 入力電圧と 5 V 系を同時観測して行う。

### 6.3 デカップリングと配線

- 各 IC の電源ピン近傍に、データシート指定のデカップリングを置く。
- サーボの大電流経路をセンサ GND 経路と可能な範囲で分離し、電源入口付近で合流させる。
- 電源と GND の線を細く長くしない。
- I2C、SPI、PWM をサーボ電源線と長距離平行に走らせない。
- 試作配線でも、信号と GND の戻り経路を意識する。
- コネクタの抜き差し、逆接、半挿しを想定する。

### 6.4 ロジック電圧

ESP32 側の信号を原則 3.3 V 系として扱い、5 V 信号を直接入力しない。各端子の許容電圧は採用ボードの公式資料で確認する。

確認事項:

- モジュールの信号電圧
- モジュール基板のプルアップ先
- 双方向信号のレベル変換方式
- 起動前に相手側だけ給電される場合の逆流
- 未給電デバイスの入力保護ダイオード経由電流

### 6.5 ノイズと安全

- サーボ制御値に上限、下限、最大変化率を設ける。
- 起動中はサーボ信号を安全状態に保つ。
- GPIO を出力に切り替える前に、安全な出力ラッチ値を準備する。
- LCD リセット、バックライト、サーボ PWM は起動時グリッチを確認する。
- 外部に触れる端子や長いケーブルには ESD／過電圧対策を検討する。
- 機械的ストッパへ押し付け続けない。

---

## 7. GPIO 割り当て

### 7.1 割り当て前に全端子を棚卸しする

部分ごとに GPIO を決めると、最後に衝突する。次を一度に表へ載せる。

- LCD の SPI、CS、DC、RESET、BACKLIGHT
- タッチ・コントローラの SPI／I2C、CS、IRQ
- 加速度センサの I2C／SPI、IRQ
- 環境センサの I2C、任意の IRQ
- サーボ PWM
- USB-UART／書き込み／ログ
- ブートストラップ端子
- 開発ボード上で予約済みの端子
- 内蔵フラッシュ等が使用する端子
- 将来拡張端子

### 7.2 GPIO 管理表

```markdown
| GPIO | 開発ボード端子 | 用途 | 方向 | 起動時状態 | Pull | 速度/駆動 | 共有 | 制約 | 根拠 |
|---|---|---|---|---|---|---|---|---|---|
| TBD | TBD | LCD SCLK | Out | Low/TBD | None | TBD | SPI bus | boot制約確認 | 回路図 p.xx |
```

各行に根拠資料を記録する。AI が生成した表だけでは根拠にならない。

### 7.3 起動端子と予約端子

ESP32 には起動モードや内蔵機能に関係する端子がある。外部回路のプルアップ／プルダウンが起動条件へ影響しないかを確認する。

チェック:

- リセット直後に外部回路が端子を駆動しないか
- 書き込みモードに入れなくならないか
- 起動ログ用 UART と競合しないか
- 開発ボード上の USB-UART 回路と衝突しないか
- 入力専用または機能制限のある端子でないか

### 7.4 ピン競合をテスト可能にする

GPIO 表だけでなく、ファームウェアの設定にも単一の定義元を作る。

- ピン番号を各ドライバへ直書きしない
- ボード設定モジュールへ集約する
- 同じ GPIO の二重割り当てをビルド時または起動時に検出する
- 起動ログへ最終割り当てを出す
- 回路リビジョンをファームウェア設定と対応付ける

---

## 8. マイコン内部で起きていること

### 8.1 SoC の構成

一般的な SoC は次を含む。

- CPU コア
- ROM とフラッシュ
- SRAM
- 割り込みコントローラ
- クロック、リセット、電源管理
- GPIO
- UART、I2C、SPI
- タイマ、PWM
- ADC などの周辺回路
- ウォッチドッグ
- 無線機能

CPU は周辺回路を専用命令だけでなく、特定アドレスのレジスタへの読み書きとして操作する。このため、誤ったアドレス、クロック未供給、ピン機能未設定、初期化順序の誤りがあると動作しない。

### 8.2 リセットからアプリまで

概念的には次の順で動く。

1. リセット要因を受ける。
2. ROM ブートローダが起動する。
3. フラッシュ上のブートローダ／アプリを検証・ロードする。
4. スタックと実行環境を準備する。
5. 初期値付き静的データを RAM へ配置する。
6. ゼロ初期化領域をクリアする。
7. CPU、クロック、メモリ、SDK を初期化する。
8. ドライバ、タスク、アプリを開始する。

Rust／ESP-IDF では大部分をフレームワークが担う。理解は必要だが、初期段階から独自スタートアップやレジスタ直接操作へ置き換える理由にはならない。

### 8.3 メモリ領域

一般的な実行ファイルには次の領域がある。

| 領域 | 内容 | 注意点 |
|---|---|---|
| `.text` | 命令 | フラッシュ容量、実行位置 |
| `.rodata` | 定数、文字列 | 大量ログ文字列や画像で増える |
| `.data` | 初期値付き静的変数 | フラッシュと RAM の両方を使う |
| `.bss` | ゼロ初期化静的変数 | RAM を消費する |
| stack | 関数呼出し、局所変数 | タスクごとの深さ不足に注意 |
| heap | 動的確保 | 断片化、失敗処理、長期安定性 |

DeskCat では画像素材、描画バッファ、JSON バッファ、タスク・スタックが RAM を大きく消費し得る。ビルド結果のサイズと、実行時の最小空きヒープを監視する。

### 8.4 リンカ・マップ

リンク時の map ファイルやサイズ表示で確認する。

- どのオブジェクトがフラッシュを消費しているか
- 大きい静的バッファがどこにあるか
- 不要コードが除去されているか
- 画像やフォントが意図した領域にあるか
- デバッグ版とリリース版の差

原因不明の容量超過を、ライブラリを無作為に削ることで直さない。まず map と size を見る。

### 8.5 クロック

CPU、周辺回路、通信速度、PWM はクロックに依存する。

- CPU クロック
- APB 等の周辺バス・クロック
- UART ボーレート
- I2C／SPI クロック
- PWM 周期と分解能
- RTOS tick と高分解能タイマ

クロック設定を変えると、複数の周辺機能へ影響する。サーボ周期だけを直すつもりでシステム全体の時間基準を変更しない。

### 8.6 リセット要因

起動時に少なくとも次を識別してログへ出す。

- 電源投入
- 外部リセット
- ソフトウェア・リセット
- ウォッチドッグ
- ブラウンアウト
- パニック／例外後の再起動
- OTA や更新に伴う再起動

再起動回数と直前の異常状態を Pi へ報告できるようにする。

---

## 9. ESP32／Rust／ESP-IDF の開発方針

### 9.1 採用方針

承認済みのproject方針に従い、初期候補は次とする。

- 言語: Rust
- ターゲット: ESP-WROOM-32D開発ボード（秋月電子 M-13628）
- SDK: ESP-IDF 系
- HAL: `esp-idf-hal` 系
- 実行環境: `std` 利用可能な ESP-IDF 構成
- 描画: 初期 MVP は単純な図形描画を優先

正確な Rust ツールチェーン、ESP-IDF、crate のバージョンは実装開始時に公式資料で組み合わせを確認し、ロックファイルと開発手順へ固定する。

### 9.2 HAL を使う理由

HAL は次を提供する。

- 端子と周辺回路の型安全な所有
- 公式 SDK の初期化経路
- GPIO、SPI、I2C、PWM の共通化
- RTOS やドライバとの整合
- レジスタ直接操作より保守しやすい API

HAL に問題がある場合も、いきなり全面的なレジスタ直書きへ移行しない。

1. 完全なエラーと条件を取得する。
2. 公式 SDK の制約を確認する。
3. ドライバ・ログを増やす。
4. 最小再現コードを作る。
5. 必要な箇所だけ低レベル API を検討する。

`unsafe` は原則禁止とし、不可避な場合はスコープ、根拠、不変条件、テストを明記してレビューする。

### 9.3 所有権と共有資源

Rust の所有権は、同じ SPI や I2C を複数ドライバから無制御に触る問題を防ぐ助けになる。ただし共有バスは明示的に設計する。

- バス所有者を一つにする
- 各デバイス設定を分離する
- 排他区間を短くする
- ロック中に待ち時間の長い処理をしない
- ISR から通常の mutex を取得しない
- デバイスごとの SPI 速度やモード切替を保証する

### 9.4 推奨モジュール境界

```text
firmware/
├─ src/
│  ├─ main.rs
│  ├─ board/          # GPIO、バス、ボードリビジョン
│  ├─ drivers/        # LCD、touch、accelerometer、environment、servo
│  ├─ protocol/       # JSON Lines、型、検証、連番
│  ├─ tasks/          # input、display、motion、communication、health
│  ├─ domain/         # イベント、測定値、表情、動作
│  ├─ diagnostics/    # ログ、カウンタ、自己診断
│  └─ config/         # 安全範囲、周期、校正値
├─ tests/
├─ scripts/
└─ docs/
```

実際のディレクトリ名はリポジトリ作成時に決めるが、ハードウェア依存コード、プロトコル、ドメイン判断を混在させない。

### 9.5 設定値

次はコードへ散在させず、型付き設定として集約する。

- GPIO
- I2C／SPI 速度
- デバイス・アドレス
- LCD の寸法と向き
- タッチ座標変換
- サーボ最小・中立・最大
- サーボ最大速度・加速度
- 入力デバウンス
- 加速度イベントしきい値
- センサ取得周期
- 通信タイムアウト
- 最大メッセージ長

安全に関係する値には、設定ファイルで変更可能な範囲そのものにも上限を設ける。

---

## 10. 割り込み、タスク、イベント

### 10.1 ISR の責務

割り込み処理で行うこと:

- 割り込み要因を確認・解除する
- 必要最小限の値または時刻を取得する
- イベントまたはフラグをキューへ渡す
- オーバーランをカウントする

割り込み処理で行わないこと:

- JSON の生成や解析
- LCD の全画面描画
- I2C／SPI の長いトランザクション
- 動的メモリ確保
- ブロッキング待機
- 長いログ出力
- サーボ動作シーケンス
- 複雑なデバウンス

### 10.2 タスク分割の推奨

| タスク | 責務 | 主な入力 | 主な出力 |
|---|---|---|---|
| communication | Pi との送受信、パース、応答 | UART RX | コマンド、イベント送信 |
| input | タッチ、加速度、環境センサ | IRQ／周期タイマ | 正規化イベント、測定値 |
| display | 表情状態の描画 | 表情コマンド | LCD |
| motion | 軌道生成、安全制限 | 動作コマンド | PWM |
| health | WDT、統計、故障状態 | 各タスクの heartbeat | status、再初期化 |

タスク数を増やすこと自体が目的ではない。優先度逆転、ロック競合、スタック不足が起きない最小構成にする。

### 10.3 イベント駆動

上位層はデバイスの生データではなく、意味のあるイベントを扱う。

```text
TouchStarted
TouchContinued
TouchEnded
TapDetected
ImpactDetected
OrientationChanged
EnvironmentUpdated
SensorFault
CommunicationLost
```

生の割り込み一回をそのまま「撫でられた」と判断しない。時系列、継続時間、変化量、デバウンスを用いる。

### 10.4 デバウンス

入力ごとに状態機械を用意する。

```text
Idle
  └─ candidate detected → Candidate
Candidate
  ├─ stable for threshold → Active
  └─ disappeared → Idle
Active
  └─ released for threshold → Idle
```

しきい値は実測データから決める。ログへ raw 値、判定値、状態遷移時刻を出せるようにする。

### 10.5 ウォッチドッグ

- 各重要タスクが定期的に進行していることを確認する。
- 単に WDT を feed する専用タスクだけを動かさない。
- 再起動前に可能な範囲で原因を保存する。
- 起動後に WDT リセット回数を報告する。
- デバッガ停止中の WDT 挙動を理解する。
- 長い描画、センサ待ち、ログ出力でタスクが占有されないようにする。

---

## 11. UART／USB シリアル通信

### 11.1 初期方針

**確定している候補:**

- UART（2026-09-28 に USB シリアルから変更。物理 link の正本は [ESP32–Pi protocol](protocol/esp32-pi-protocol.md) の §2）
- JSON Lines
- 115200 bps
- 最大 1 メッセージ 1024 bytes

115200 bps と 1024 bytes は候補値であり、実際のログ量、遅延、Pi 側実装を測定して確定する。

### 11.2 UART の基礎

一般的な UART は次を合わせる。

- ボーレート
- データ・ビット
- パリティ
- ストップ・ビット
- フロー制御

候補は 115200、8 data bits、no parity、1 stop bit、no flow control だが、両端で同じ設定を明示する。

非同期シリアルは、スタート・ビット、データ・ビット、任意のパリティ、ストップ・ビットで一文字を表現する。一般的な 8N1 では、1 byte の送信に概ね 10 bit を使う。

概算:

```text
実効 byte/s ≈ baud / 10
115200 bps の場合 ≈ 11520 byte/s
```

ここから JSON のオーバーヘッド、OS バッファ、ログ、応答を差し引く。大きな状態を高頻度に送らない。

### 11.3 JSON Lines の規則

- 1 行 1 JSON オブジェクト
- 改行はメッセージ境界
- 文字コードは UTF-8
- 送信途中の改行を文字列へ直接入れない
- 最大長を受信前に制限する
- 構文エラー行は破棄し、カウンタと理由を残す
- 未知フィールドは互換性方針に従う
- 同じポート上の全出力を JSON とし、通常ログで破壊しない

### 11.4 エンベロープ

**wire formatの正本は[ESP32–Pi protocol](protocol/esp32-pi-protocol.md)である。**
本書はエンベロープやmessage名を定義しない。実装時は必ず正本を参照する。

以前の版では本書に実装案のJSON例を載せていたが、正本と`sid`／`id`／message名が
食い違っていた。二重定義は、どちらを実装したか分からない状態を作るため廃止した。

本書が扱うのは、エンベロープに最低限どういう情報が必要かという設計上の観点だけである。

最低限必要な情報:

- プロトコル・バージョン
- **セッション識別子**（送信側の再起動を受信側が検知するため）
- **セッション内で単調増加するメッセージ識別子**
- メッセージ種別
- 単調増加時刻
- payload

応答・結果メッセージ（ACK、error、完了イベント、status 応答）だけが持つ情報:

- 成功／失敗
- 機械判定可能なエラー・コード
- 対象コマンドのsession識別子とmessage識別子

長い動作の完了イベントも結果メッセージであり、この一覧の対象である。
どのメッセージがどれを必須とするかは[正本のprotocol](protocol/esp32-pi-protocol.md)に従う。

`hello`、`boot`、`ping`、コマンドは要求であり、結果を持たない。
これらを全メッセージ共通の必須情報として扱うと、要求と応答の wire format が食い違う。

この一覧は設計上の必要条件である。**field名、順序、必須性、同一性の判定規則は
[正本のenvelope定義](protocol/esp32-pi-protocol.md#3-envelope)に従う。**
本書へ再掲すると正本との差分が生じるため、ここでは定義しない。

### 11.5 コマンド処理

コマンド受信時の順序:

1. 行長を確認する。
2. JSON 構文を検証する。
3. バージョンを確認する。
4. コマンド名を確認する。
5. 必須フィールドと型を確認する。
6. 値の範囲を確認する。
7. 安全制限を適用する。
8. 実行キューへ登録する。
9. 受付または拒否を応答する。
10. 必要なら完了イベントを返す。

「受付」と「動作完了」は異なる。サーボの長い動作は、即時 ACK と後続の完了イベントに分ける。

### 11.6 再送と冪等性

通信再接続や応答欠落に備える。

- `(sid, id)` の組で重複を検出する。`id` 単独では送信側の再起動後に誤判定する。
- `set_expression` のような状態設定は冪等にする。
- 相対移動コマンドの再送は二重動作を起こすため、`(sid, id)` の組を記録する。
- Pi は timeout 後に無条件再送せず、状態照会するか、**payload を変えずに**同一 `(sid, id)` で再送する。
- 内容を変えて送る場合は新しい `(sid, id)` を割り当てる。同じ identity のまま payload を変えると、受信側は duplicate と判定して旧結果を返すか、変更後のコマンドを抑止する。相対移動では二重動作または意図しない抑止になる。
- ESP32 は直近に処理した**セッション識別子とメッセージ識別子の組**と、その結果を保持する。メッセージ識別子だけを保持すると、送信側の再起動後に旧セッションと衝突し、誤った結果を返すか新規コマンドを抑制する。
- 現在の session の duplicate 履歴は、**遅延メッセージの最大生存時間と再送 window の合計を下回らない期間**保持する（`PROTO-TBD-005`）。「短期間」で済ませない。早く捨てると、遅延した同一 `(sid, id)` が未知と判定され、遅延コマンドが新規コマンドとして実行される。相対移動では二重動作になる。
- retired session は、個々の `(sid, id)` と結果ではなく **retired `sid` の集合**として保持する。保持件数の上限によって、**保持期間の満了前に retired `sid` を追い出さない**（`PROTO-TBD-011`）。
- **ACK が必要なコマンドの再送は timeout 後の 1 回までとする**（[protocol §9](protocol/esp32-pi-protocol.md#9-retryとduplicate処理)）。
- **その 1 回でも ACK が無ければ、実行結果を終端的に「不明」として扱う。**同じ非冪等コマンドを
  新しい `(sid, id)` で再実行せず、link を安全側へ倒して診断を報告する。
- **`get_status` は自動再実行の根拠にならない。**session が有効なら状態照会で実状態を
  取り直してよいが、その結果を見て自動で再送してはならない。timeout も照会結果も、
  それ自体では再実行を発生させない。再実行は**別の明示的な要求**として行い、安全条件と
  実状態を改めて確認したうえで、新しいコマンドとして発行する。
  **timeout を根拠にした自動再実行の経路を実装へ残さない。**
- **`boot` はこの 1 回制限の対象外である。**session 確立の唯一の経路であり、諦めると復旧できない。
  再送方針は[protocol §4.1](protocol/esp32-pi-protocol.md#41-boot)を正本とする。

### 11.7 再接続と状態同期

**正確なsequenceとmessage名は[ESP32–Pi protocol §10](protocol/esp32-pi-protocol.md#10-reconnect)を正本とする。**
本書では設計上の要点だけを示す。

- **link の再接続と session の遷移は別物である。**serial port が切れて繋がり直しただけなら、両側は同じ session を継続してよい。この場合 duplicate 履歴を破棄しない。
- session が変わるのは、**envelope、version、`type` 別 payload schema、および `reason` と `sid` の整合まで検証を通った `hello`／`boot` の `sid` が、現在の session と異なるとき**だけである。`reason` が `port_reopen`／`resync` なのに `sid` が異なる、あるいは `startup` なのに `sid` が同じ message は `invalid_payload` で拒否し、session state、duplicate 履歴、遷移 budget、cooldown のいずれも変更しない。**process の再起動では、送信側は直前と異なる新しい `sid` を選ぶ。**乱数による retired `sid` との衝突は完全には排除できないため、`stale_session`を受けた場合だけprotocol §3.1の有限な衝突回復を行う。serial link の切断と再接続だけでは `sid` を変えない。受信側は、`sid` の変化を見ただけでは切り替えず、検証を通った `hello`／`boot` の遷移確定をもって切り替える。
- 受信側は、**session遷移を確定したときだけ**、相手の**現行 session の**ID 追跡と duplicate 履歴を破棄する。同一 session の再送では破棄せず、保持した結果を返す。
- 遷移前の現行 `sid` は retired 集合へ移し、保持期間の満了まで残す。**retired session の個々の `(sid, id)` と結果を残すのではない。**
  遅延して届いた旧 session の message は、retired `sid` との一致によって
  `stale_session` で拒否する。保持期間内の retired `sid` を件数上限で追い出すと、
  その message が未知の session 遷移候補へ戻るため、満了前に追い出さない（`PROTO-TBD-011`）。
- 状態同期は、実際の状態を取得してから望ましい状態を再送する順で行う。
- **再接続直後に、以前の相対動作コマンドを再実行しない。**

以前の版では本書が独自のsequence（ESP32が`hello`、Piが`status.get`）を記載していたが、
正本ではESP32が`boot`、Piが`hello`と`get_status`を送る。逆方向の記述だったため削除した。

### 11.8 受信実装

- 固定上限付きバッファを使う。
- 改行まで読み、上限超過時は次の改行まで捨てる。
- UTF-8 不正、JSON 不正、未知コマンドを別カウンタにする。
- 一部だけ届くことを前提にする。
- 複数行が一度に届くことを前提にする。
- RX 処理とコマンド実行を分離する。
- TX 詰まりでセンサや WDT を停止させない。

---

## 12. I2C

### 12.1 基礎

I2C は一般に SDA と SCL の 2 線を複数デバイスで共有する。オープンドレインのためプルアップ抵抗が必要である。

確認事項:

- 7-bit／10-bit アドレス
- 同一アドレスの競合
- 供給電圧とプルアップ先
- バス速度
- プルアップ抵抗
- 配線長とバス容量
- clock stretching
- repeated start の要否
- 起動後の待ち時間
- 変換完了待ち
- CRC

### 12.2 プルアップ

複数モジュールにプルアップが実装されていると、並列合成で抵抗値が小さくなり過ぎることがある。反対に、抵抗が大きすぎると立上りが遅くなる。

設計では I2C 仕様とデバイスの sink 電流、バス容量を使って範囲を決め、実機波形を確認する。プルアップの抵抗値自体は[一般値で開始してよい](governance/hardware-safety-policy.md#5項目以外の扱い)。ただし接続先の電圧は[安全要件5項目](governance/hardware-safety-policy.md#安全要件の5項目)の「電圧違いのpinへ挿す」に効くため、回路図または実測で確認する。

### 12.3 ドライバの読み出し

センサによって次が異なる。

- レジスタ・アドレス幅
- エンディアン
- 一回の読み出し長
- 連続読み出し可否
- 自動アドレス増加
- repeated start
- CRC 単位
- 測定開始コマンドと待ち時間

ライブラリのバッファ上限や、一度に読めるサイズも確認する。デバイス側が大きなデータを返せても、ドライバやライブラリ側の上限で読み切れないことがある。デバイス仕様とソフトウェア実装の上限は別物として、両方を確認する。

### 12.4 タイムアウトと復旧

- 全トランザクションに timeout を設ける。
- NACK、timeout、CRC、not ready を区別する。
- 一時的失敗は回数制限付きで再試行する。
- SDA が Low 固着した場合の復旧方針を設ける。
- デバイス再初期化とバス再初期化を分ける。
- 連続失敗時は故障状態へ移し、他デバイスを巻き込まない。

### 12.5 検証順序

1. 電源と静止時電流を確認する。
2. SDA／SCL のアイドル電圧を確認する。
3. バス・スキャンまたは既知 ID レジスタを読む。
4. 最小速度で単発読み出しを行う。
5. raw byte をログする。
6. データシートの変換式を適用する。
7. 基準器と比較する。
8. 周期取得を行う。
9. サーボ動作中にもエラー率を測る。

---

## 13. SPI、LCD、タッチ

### 13.1 SPI の基礎

一般的な信号:

- SCLK
- MOSI
- MISO
- デバイスごとの CS

デバイスごとに異なる条件:

- SPI mode
- 最大クロック
- bit order
- word size
- CS setup／hold
- half／full duplex
- DMA 制約

### 13.2 バス共有

LCD とタッチが同じ SPI バスを共有できる場合でも、次を保証する。

- CS は個別にする。
- 同時に二つの CS を有効化しない。
- デバイス切替時に mode と速度を正しく設定する。
- LCD の長い DMA 転送がタッチ IRQ を長時間待たせない。
- MISO を使わないデバイスがバスを駆動し続けない。
- RESET、DC、BACKLIGHT、IRQ は個別管理する。

### 13.3 LCD の立ち上げ

1. 電源、ロジック電圧、バックライト経路を確認する。
2. RESET と BACKLIGHT の安全な起動状態を確認する。
3. 最小 SPI 速度で初期化する。
4. 単色塗りを表示する。
5. 四隅と座標軸が分かるテスト・パターンを表示する。
6. 回転、幅、高さ、色順を確定する。
7. 小さい矩形更新を行う。
8. 表情プリミティブを描く。
9. 実機のちらつき、色、フォント、更新時間を確認する。

PC 上のシミュレータは座標や状態遷移の確認には有効だが、実 LCD の色順、転送速度、アンチエイリアス、視認性は代替できない。

### 13.4 初期 MVP の描画方針

DeskCat は画像素材を使わない方針のため、次の図形を組み合わせる。

- 背景矩形
- 目の楕円、線、弧
- 口の線、弧
- 必要最小限の文字

利点:

- フラッシュ容量を抑えやすい
- 表情パラメータを補間しやすい
- 色や寸法をコードで一元管理できる
- 画像アセットのライセンス管理が不要

描画コマンドを直接プロトコルへ露出させず、`happy`、`surprised` などの表情状態を ESP32 内で描画へ変換する。

### 13.5 タッチ

タッチ方式によって、raw 値、座標、圧力、IRQ、校正が異なる。

確認事項:

- LCD 座標とタッチ座標の原点・向き
- 回転時の変換
- raw min／max
- 押下・解放しきい値
- ノイズとチャタリング
- 長押し、タップ、撫での分類
- LCD 更新中の読み出し遅延
- SPI 共有時の速度

SPI クロックの上限は、[安全要件5項目に効かない](governance/hardware-safety-policy.md#5項目以外の扱い)ため、保守的な一般値から開始し、実機での観察をもとに上げてよい。採用 IC のデータシートは参考にするが、確定を待つ必須条件ではない。IC を確定していない
現時点では、実動作速度に関する具体的な主張を本書に置かない。

「データシート最大値では動作しないことがある」は、モジュール基板、配線長、プルアップ、
ドライバの影響を想定した**検証仮説**である。採用 IC の公式資料または実測で裏付けるまで、
確定した挙動として扱わない。速度低下を切り分けの第一手と決め打ちもしない。
配線、電源、初期化順序、割り込み設定も同じ症状を起こす。

### 13.6 タッチ座標の校正

少なくとも四隅と中央を用いて raw 座標から画面座標への変換を決める。

- 軸入替
- X／Y 反転
- オフセット
- スケール
- 必要ならアフィン変換

校正値には、対象ディスプレイ、回転、回路リビジョンを関連付ける。

---

## 14. 加速度センサ

### 14.1 目的を分ける

DeskCat で想定される用途:

- 軽いタップの検出
- 強い衝撃の検出
- 傾きまたは転倒の検出
- サーボ動作に伴う自己振動の把握

同じ加速度値でも用途ごとに帯域、しきい値、継続時間が異なる。

### 14.2 raw 値からイベントまで

1. raw XYZ を取得する。
2. 感度設定に従って物理単位へ変換する。
3. オフセットを校正する。
4. 必要なフィルタを適用する。
5. 重力成分と動的成分を目的に応じて扱う。
6. 大きさ、差分、時間窓を計算する。
7. ヒステリシス付きでイベントを判定する。
8. 再トリガ抑制を行う。

例:

```text
magnitude = sqrt(x² + y² + z²)
dynamic = |magnitude - gravity_reference|
```

これは考え方の例であり、しきい値はセンサ・レンジ、設置方向、筐体、サーボ振動の実測から決める。

### 14.3 自己振動との区別

サーボ動作中は加速度イベントが誤発火し得る。

選択肢:

- サーボ動作状態を判定器へ入力する
- サーボ固有の周波数帯をフィルタする
- イベントしきい値を状態に応じて変える
- サーボ指令と加速度時系列をログし、特徴を比較する

イベントを全面的に無効化すると本当の衝撃も見逃すため、実測に基づいて設計する。

### 14.4 校正と試験

- 静止状態を複数姿勢で測る
- 分散、温度変化、個体差を記録する
- 指定の軽いタップを繰り返す
- 机の振動、キーボード、歩行振動を試す
- サーボの全動作パターンを試す
- イベントの真陽性、偽陽性、見逃しを集計する

---

## 15. 環境センサ

### 15.1 共通測定モデル

上位層へは raw レジスタではなく、測定値と品質を返す。

```rust
struct Measurement<T> {
    value: T,
    timestamp_ms: u64,
    quality: MeasurementQuality,
}

enum MeasurementQuality {
    Valid,
    Stale,
    NotReady,
    OutOfRange,
    SensorFault,
}
```

これは設計例であり、実装時に Rust の型とシリアライズ方針を確定する。

### 15.2 センサ固有処理を閉じ込める

ドライバ内部:

- レジスタ操作
- 測定開始
- 変換待ち
- CRC
- 校正係数
- raw 値の変換
- センサ固有エラー

上位層:

- 物理量
- 単位
- 測定時刻
- freshness
- 共通エラー

### 15.3 ブロッキングを避ける

測定に長い待ち時間があるセンサは、上位要求のたびに同期測定しない。

推奨:

1. センサ・タスクが周期的に測定を開始する。
2. 完了後に結果をキャッシュする。
3. 上位層は最新値と時刻を読む。
4. 古い場合は `Stale` を明示する。

### 15.4 共通ライフサイクル

将来の部品交換を考え、概念的に次を揃える。

```text
open → configure → start → read/update → stop → close
```

単純なセンサに不要な段階があっても、最も複雑な候補を基準にインターフェースを検討する。ただし抽象化を先に作り過ぎず、異なる二種類目の実装で妥当性を確認する。

### 15.5 エラー分類

- Bus
- Timeout
- Checksum
- NotReady
- OutOfRange
- InvalidCalibration
- UnsupportedConfiguration
- DeviceIdentityMismatch

ログには共通分類と、デバッグ用のセンサ固有詳細を残す。

---

## 16. サーボ制御

### 16.1 電気的前提

- サーボ電源は外部 5 V 系とする。
- ESP32 とサーボ電源の GND を共通化する。
- PWM 信号レベルの適合性をサーボ仕様で確認する。
- 起動・停止・拘束時の電流を確認する。
- 電源電圧降下を ESP32 側と同時観測する。

### 16.2 PWM

一般的なホビーサーボには周期的なパルス幅制御が使われるが、周期、最小／中立／最大パルス幅は製品ごとに確認する。

変換の概念:

```text
commanded_angle
  → mechanical clamp
  → speed/acceleration limiting
  → calibrated pulse width
  → hardware PWM
```

「0–180 度」「1–2 ms」などの一般値を、採用サーボの確定値として使わない。

### 16.3 必須の安全制限

- ソフト最小角
- ソフト最大角
- 中立角
- 最大角速度
- 最大角加速度
- 一回の最大動作量
- 連続動作時間
- 通信断時の動作
- センサ／電源異常時の動作

機械可動域は、サーボ単体の仕様より筐体の干渉で狭くなることがある。低速・小範囲から実機校正する。

### 16.4 軌道生成

Pi から目標角だけを受け、ESP32 が一定周期で補間する構造を推奨する。

- step 変化をそのまま PWM へ入れない
- 最大変化量を時間基準で制限する
- 滑らかさが必要なら加減速を設ける
- 新しい命令で軌道を置き換える規則を決める
- 停止と中立復帰を別コマンドにする

### 16.5 フェイルセーフ

通信断時の選択肢:

- 現在位置を一定時間保持後、PWM を停止
- 低速で中立へ戻して停止
- 現在位置を保持

どれが安全かは機構とサーボ特性による。無通電時に首が落下するか、PWM 停止で保持力が失われるかを実機確認して決める。

### 16.6 試験

1. サーボを機構から外して信号を確認する。
2. 狭いパルス範囲で動作確認する。
3. 電源電流と電圧を測る。
4. 機構へ取り付け、狭い角度から広げる。
5. 左右端の機械余裕を記録する。
6. 速度・加速度を段階的に上げる。
7. LCD、I2C、シリアルを同時動作させる。
8. 通信断、再起動、電源断を試す。

---

## 17. ADC とアナログ計測

初期 DeskCat に ADC 利用が含まれるかは未確定だが、電源監視や将来センサで必要になる可能性がある。

### 17.1 ADC 値をそのまま電圧とみなさない

確認事項:

- 分解能
- 有効範囲
- 減衰／入力レンジ設定
- 基準電圧と個体差
- 入力インピーダンス
- 非直線性
- 校正 API
- サンプリング時間
- 無線動作との干渉

### 17.2 推奨手順

1. raw code を保存する。
2. 既知の 2 点以上を基準器で測る。
3. 公式校正機能を確認する。
4. offset と gain を分けて扱う。
5. 複数サンプルの平均、中央値、外れ値除去を比較する。
6. 必要なら RC ローパスを設計する。
7. サーボ停止時と動作時を比較する。

基準電圧を思い込みで固定すると、その上に載る補正コード全体が系統的に誤る。しかも各測定値はもっともらしい範囲に収まるため、発見が遅れる。基準電圧は必ず採用 MCU と実回路で確認し、確認前の補正係数を確定値として扱わない。

---

## 18. ドライバ抽象化

### 18.1 抽象化の目的

抽象化はコードを美しく見せるためではなく、次に備えるために行う。

- センサ供給停止
- 別メーカーへの変更
- 同時比較評価
- シミュレータや fake 実装
- 故障注入テスト

### 18.2 共通化するもの

- 測定対象の物理量
- 値と単位
- 時刻
- freshness
- ライフサイクル
- 共通エラー

### 18.3 共通化し過ぎないもの

- 特定センサだけの自己診断
- 特殊測定モード
- ヒータ制御
- FIFO や割り込みの詳細
- 固有校正手順

固有機能は capability として分離し、最小共通 API を膨らませない。

### 18.4 実装手順

1. ドメイン型と最小インターフェースを作る。
2. 一つ目の実デバイスを実装する。
3. fake 実装で上位テストを書く。
4. 性質の異なる二つ目の候補で抽象化を検証する。
5. 必要な差だけ capability として追加する。

既知の一製品を暗黙に想定した「汎用」インターフェースにしない。

---

## 19. 段階的な立ち上げ計画

一度に全機能を統合しない。各段階で成果物、観測手段、合格条件を持つ。

### Phase 0: 設計資料を確定

成果物:

- 正式な部品表
- 回路図
- GPIO 表
- 電源予算
- プロトコル仕様
- 安全制限表
- テスト計画

合格条件:

- 全端子の用途と根拠が記録されている
- ロジック電圧が整合している
- サーボ電源経路が ESP32 から分離されている
- TBD が一覧化されている

### Phase 1: ビルドと書き込み

実装:

- 最小アプリ
- 起動ログ
- firmware version
- reset reason
- heartbeat

合格条件:

- クリーン環境から CLI でビルドできる
- 書き込み後に起動を確認できる
- 電源再投入でも同じ動作をする
- バージョンとリセット要因を取得できる

### Phase 2: UART／USB シリアル

実装:

- JSON Lines parser
- `hello`／`boot`
- `ping`
- `get_status`
- エラー応答

合格条件:

- 分割受信と複数行受信を処理できる
- 最大長超過から復帰できる
- 不正 JSON で再起動しない
- 連番とパース失敗数を確認できる

### Phase 3: GPIO と単純出力

実装:

- 安全な GPIO 初期値
- 任意の確認用出力またはボード LED

合格条件:

- 起動時グリッチが許容範囲
- GPIO 割り当てが起動を妨げない

### Phase 4: I2C とセンサ一個

実装:

- I2C 初期化
- device ID 読み出し
- raw 値取得
- 変換値取得
- timeout／CRC 等のエラー

合格条件:

- 連続取得でエラー率を測定できる
- センサ切断を検出し、復旧または fault 化できる

### Phase 5: SPI と LCD

実装:

- 単色表示
- テスト・パターン
- 図形描画
- 最小表情

合格条件:

- 向き、色、座標が一致する
- 更新中も通信と WDT が動く
- 電源再投入で確実に初期化する

### Phase 6: タッチ

実装:

- raw 取得
- 座標校正
- 押下／解放
- 撫でイベント

合格条件:

- LCD 更新との同時動作で取りこぼしを測定できる
- 誤検出と見逃しが受け入れ基準内

### Phase 7: 加速度

実装:

- raw XYZ
- 校正
- フィルタ
- tap／impact イベント

合格条件:

- サーボ停止時と動作時の判定特性を記録する
- 再トリガ抑制が動作する

### Phase 8: Pi–ESP32 プロトコル単体

実装:

- 正本の[protocol](protocol/esp32-pi-protocol.md)に従う envelope と session 判定
- `hello`／`boot` と ACK
- duplicate 抑止（`(sid, id)`）
- 受理上限と送出上限
- 通信断の検知

合格条件:

- 共有 conformance fixture に両側が合格する

  **この fixture はまだ存在しない**（`PROTO-TBD-016`）。Rust workspace が未生成で、
  置き場所となる crate が無いためである。以下の項目は、fixture を作成したあとに
  検証する対象であって、現時点で実行できる手順ではない。
  **fixture が揃うまで Phase 8 の合否を判定しない。**
  作成後は `crates/deskcat-protocol/tests/fixtures/` を基準に、host と firmware が
  同一 file で合格することをもって判定する。
- ACK の相関が `(reply_sid, reply_to)` で成立し、旧 session の ACK を受理しない
  - **応答側envelope自身の `sid`** も検証する。`reply_sid`／`reply_to` が現在の要求と一致していても、
    応答側envelopeの `sid` が現在の相手sessionと異なるACKは拒否する。fixtureには、`reply_sid`と
    `reply_to`を変えずに応答側envelopeの`sid`だけを変えたcaseを含め、拒否されることを確認する
- `type`、payload schema、方向の検証を通った message について、session 遷移を開始しない
  message の未知 `sid`、または retired `sid` を `stale_session` で拒否し、duplicate 履歴を
  破棄しない。未知の `sid` を使う `hello`／`boot` は、`reason` と `sid` の整合を含む
  session 遷移条件へ進める。retired `sid` と衝突する場合は session 確立 message も
  `stale_session` で拒否する
- 未知の message type を、`sid` の状態にかかわらず `unknown_type` で拒否し、`unknown_types` を増加させる。retired・未知の `sid` であっても `stale_session` を返さない（判定順序が正本どおりであること）
- session 遷移の budget と cooldown が働き、超過を `rate_limited` で拒否する
- retry の終了条件が成立する。`hello` と `boot` の両方について、`(reply_sid, reply_to)` **および応答側envelopeの `sid`** で要求を参照する終端 ACK と、同一 `(sid, id)` の再送に対する保持結果を検証する
- **一般の ACK 必須・非冪等コマンド**についても retry 契約を検証する。`hello`／`boot` だけでは
  Draft 2 の 1 回制限を検証したことにならない。次を fixture で確認する
  - 再送は**同一 payload・同一 `(sid, id)` で最大 1 回**であること
  - その 1 回でも ACK が無ければ結果が**終端的に不明**になり、そこで停止すること
  - **新しい `(sid, id)` による自動再実行が発生しない**こと。`get_status` の応答を
    受け取った場合も、それを根拠に自動再送しないこと
  - `boot` だけが 1 回制限の対象外であること（§4.1）
- 保持 ACK が duplicate 応答上限で抑制されず、予約容量から返ること。`hello`／`boot` に限らず
  受理済みコマンドへの ACK でも成立すること
- **`hello` の `reason` と `sid` の対応**を検証する。`reason` ごとに期待結果が逆になるため、
  fixture を `reason` 別に分ける
  - `port_reopen`／`resync` は**現在の `sid` を維持**する。同一 `sid` のため session 遷移は起きず、
    duplicate 履歴も破棄されない
  - `startup` は**新しい `sid`** を使う。現在の `sid` と同じ `startup` は `invalid_payload` で拒否する
  - `port_reopen`／`resync` なのに `sid` が現在と異なる message も `invalid_payload` で拒否する
  - いずれの拒否でも、**session state、duplicate 履歴、遷移 budget、cooldown を変更しない**
  - host と firmware が同じ fixture で同じ判定になること
- 受理上限と送出上限が働き、`status` と安全 event の帯域が枯渇しない
- 通信断を検知でき、`HW-TBD-017` の heartbeat 方式が確定している

各項目の正確な要件は[正本の protocol](protocol/esp32-pi-protocol.md)に従う。
本書では再掲せず、fixture で検証する対象として列挙するにとどめる。

**この Phase が完了するまでサーボへ通電しない。**サーボ安全制限は通信断の検知に
依存しており、断を検知できない状態で機構を駆動しないため（§2.2 のゲート B）。

### Phase 9: サーボ単体

実装:

- 外部電源
- 狭い可動域
- PWM 校正
- 速度／加速度制限
- emergency stop

合格条件:

- 電圧降下で ESP32 が再起動しない
- 機械端へ衝突しない
- 通信断時に安全動作する

### Phase 10: 統合

統合順:

1. 通信 + LCD
2. 通信 + タッチ
3. 通信 + 加速度
4. 通信 + サーボ
5. 全センサ + LCD
6. 全機能 + サーボ
7. Pi の感情ロジック

各追加前後で、既存の受け入れテストを再実行する。

### Phase 11: 長時間・異常試験

- 1 時間、8 時間、目標連続時間
- シリアル抜き差し
- Pi 再起動
- ESP32 再起動
- センサ切断
- 不正 JSON
- 最大頻度コマンド
- サーボ連続動作
- 低電圧に近い条件
- LCD 高頻度更新
- ログ大量発生

合格条件:

- 各試験について、**判定値を事前に決めてから実行する。**実行後に基準を決めない
- **開始条件として、[ゲートB](#phase-9-サーボ単体)（[Servo Safety Limitsの有効化条件](hardware/servo-safety-limits.md#サーボ出力を有効化してよい条件)。`HW-TBD-017`／`018`／`019`を含む）が
  Phase 9から継続して成立していること。さらに`HW-TBD-020`と`PROTO-TBD-012`が解決・承認済みであること。**
  いずれか一つでも未解決、未承認、または成立していないならPhase 11を開始しない。誤って試験を実行して結果を
  記録しても、Phase 11を完了または合格扱いにしない
- 次の観測値を記録し、いずれも承認範囲内であること。範囲は`HW-TBD-020`および
  `PROTO-TBD-012`の確定値に従い、本書で数値を決めない
  - 意図しない reset の回数（目標は 0。1 回でも原因を特定するまで合格としない）
  - heartbeat 欠落の回数と最大連続欠落
  - 通信 error（`parse_errors`、`unknown_types`、`suppressed_responses`）の件数
  - 電源電圧の最小値と、brownout しきい値に対する余裕
  - サーボと電源部の最高温度
  - データ欠落（送ったコマンドに対する ACK・完了 event の未達件数）
- **停止条件。**次のいずれかを観測した時点で試験を中止し、不合格として原因調査へ戻る
  - 発煙、異臭、異音、触れられない温度
  - 過電流保護またはサーボの安全制限が作動した
  - 意図しない reset、または watchdog による再起動
  - 電源電圧が brownout しきい値へ到達した
- **判定値を超えた実行は合格にしない。**異常を記録したうえで完了扱いにしない

---

## 20. 観測可能性

### 20.1 起動時に出す情報

- firmware version
- build identifier
- protocol version
- board revision
- reset reason
- uptime 起点
- GPIO／主要設定の要約
- 検出したデバイス ID
- 各ドライバ初期化結果
- 設定の読み込み結果
- 過去の fault／再起動カウンタ

秘密情報、Wi-Fi 資格情報、署名鍵、ホストの環境変数は出力しない。

### 20.2 定期 status

```text
uptime
free memory / minimum free memory
task heartbeat
UART RX/TX bytes
parse errors
oversize lines
unknown commands
I2C transaction/error count
SPI error count
sensor last update / error
display frame/update count
servo state / clamp count
watchdog/reset count
event queue high-water mark
```

### 20.3 エラー・コード

人が読む文章だけでなく、機械判定可能なコードを持つ。

```text
UART_LINE_TOO_LONG
JSON_PARSE_ERROR
PROTOCOL_VERSION_UNSUPPORTED
COMMAND_UNKNOWN
COMMAND_RANGE_ERROR
I2C_NACK
I2C_TIMEOUT
SENSOR_CRC_ERROR
SENSOR_NOT_READY
SPI_TRANSFER_ERROR
LCD_INIT_FAILED
SERVO_COMMAND_CLAMPED
SERVO_POWER_FAULT
QUEUE_OVERFLOW
```

### 20.4 デバッグ・コマンド

本番コマンドと明確に区別し、必要ならビルド設定で無効化する。

- 各センサ raw dump
- I2C device identity
- GPIO 状態
- LCD test pattern
- サーボ狭範囲テスト
- カウンタ一覧
- fault 履歴
- 設定表示
- 自己診断実行

危険な出力テストは安全上限を迂回できないようにする。

### 20.5 ログとプロトコルを混ぜない

同一 UART を使う場合は、全行を有効な JSON にするか、明確に多重化する。自由形式の `printf` が JSON Lines の途中へ入る設計は避ける。

---

## 21. 実機デバッグ

### 21.1 AI へ渡す情報

不具合報告には次を含める。

```text
目的:
期待動作:
実際の動作:
再現率:
再現手順:
ボードと回路リビジョン:
部品の正確な型番:
電源条件:
ツールチェーンと SDK:
変更したコミット:
完全なビルドエラー:
完全な起動ログ:
直前に試したこと:
測定した電圧／波形:
まだ試していないこと:
```

ログの一行だけを切り出すより、失敗前後を含む完全な流れを渡す。

### 21.2 仮説と証拠を分ける

```markdown
| 仮説 | 期待される証拠 | 確認方法 | 結果 | 判定 |
|---|---|---|---|---|
| サーボ電源降下 | 3.3 V低下と同時にbrownout | オシロ同時測定 | TBD | TBD |
| I2C pull-up過小 | Low電流過大、波形異常 | 抵抗実測・波形 | TBD | TBD |
```

AI の説明がもっともらしくても、証拠なしに確定しない。

### 21.3 切り分けの順序

1. 再現条件を固定する。
2. 直前の変更を確認する。
3. 電源と GND を測る。
4. 初期化結果と reset reason を確認する。
5. 最小構成で再現する。
6. 通信波形と raw byte を確認する。
7. ドライバの詳細ログを有効にする。
8. データシートの該当条件を読み直す。
9. 速度を下げる、転送を小さくする等で境界を探る。
10. 修正後に元の受け入れテストを再実行する。

転送長の偶奇、初期化順序の依存、特定サイズでのみ現れる境界条件といった不具合は、一般的な仮説の列挙では見落としやすい。網羅的な境界値テストと、詳細ログ、実測波形、データシートの記述の突き合わせで特定する。

### 21.4 計測器

#### デジタル・マルチメータ

- 電源電圧
- 配線導通
- 抵抗値
- 静止電流

#### オシロスコープ

- サーボ動作時の 5 V／3.3 V
- 起動時電源波形
- PWM パルス幅
- I2C 立上り
- SPI クロックと CS
- リセット信号

#### ロジック・アナライザ

- UART byte
- I2C アドレス、ACK、データ
- SPI mode、CS、転送内容
- タイミング関係

計測器の GND 接続で短絡しないよう、測定対象の基準と機器の接地を確認する。

### 21.5 デバッガ

デバッガで確認できること:

- breakpoint
- backtrace
- 変数
- メモリ
- レジスタ
- task 状態
- fault 発生位置

注意:

- 停止中もサーボや外部機器は動作し得る。
- デバッガ停止で WDT が発火する場合がある。
- タイミング依存不具合は breakpoint で消えることがある。
- デバッガだけでなく UART ログと波形を併用する。

ESP32 で利用する具体的な JTAG、GDB、OpenOCD 系手順は、採用ボードと ESP-IDF の対応版に合わせて別途確定する。

---

## 22. ビルド、書き込み、再現性

### 22.1 CLI を基準にする

IDE は使用してよいが、次を CLI で再現できるようにする。

- 環境確認
- format
- lint
- unit test
- build
- image size 表示
- flash
- monitor
- 必要な生成処理

人と AI が同じコマンドを使えることが重要である。

### 22.2 バージョン固定

- Rust toolchain
- ESP-IDF
- target／linker
- crate
- Python 等の補助ツール
- 書き込みツール

を記録する。依存更新は機能変更と分けて行い、更新前後で実機試験する。

### 22.3 成果物

各ビルドについて追跡できるようにする。

- firmware version
- Git commit
- dirty flag
- build profile
- target board
- protocol version
- 設定／回路 revision
- binary hash
- size report

### 22.4 Debug と Release

Debug だけ、Release だけで検証しない。

- 最適化でタイミングや未初期化問題の現れ方が変わる
- Debug ログで処理速度が変わる
- Release で panic 情報が減る
- バイナリ・サイズとスタック使用量が変わる

受け入れ試験は最終的に配布予定の profile で行う。

---

## 23. テスト戦略

### 23.1 テスト層

| 層 | 対象 | 実行場所 |
|---|---|---|
| unit | パーサ、変換、状態機械、範囲制限 | PC |
| property／fuzz | JSON、入力境界、重複、任意 byte | PC |
| integration | タスク間、fake driver、プロトコル | PC／ESP32 |
| driver | 実センサ、LCD、PWM | ESP32 実機 |
| HIL | Pi–ESP32、電源断、切断、連続動作 | 結合環境 |
| acceptance | ユーザー行動と MVP シナリオ | 完成試作 |

### 23.2 PC 上でテストするもの

- JSON Lines の分割・結合
- 最大長境界
- 不正 UTF-8／不正 JSON
- 未知フィールド
- 連番の欠落・重複
- サーボ clamp
- 軌道計算
- タッチ状態機械
- 加速度イベント状態機械
- stale 判定
- エラーからの状態遷移

ハードウェア依存部分を trait／adapter で分離すると、PC で高速に回帰試験できる。

### 23.3 実機でしか確認できないもの

- 電源品質
- GPIO 起動状態
- I2C／SPI 波形
- LCD の見え方
- タッチ座標
- 加速度ノイズ
- サーボ可動域と負荷
- 無線やサーボによる干渉
- 実時間性
- 長時間メモリ安定性

### 23.4 故障注入

- センサを外す
- CRC 不正を fake で返す
- timeout を発生させる
- JSON を途中で切る
- 最大長を超える
- Pi を再起動する
- ESP32 を再起動する
- Pi–ESP32 間の通信を断ち、つなぎ直す（UART の信号線は、Pi と ESP32 の両方に電源が入っている間だけつなぐ。条件は [GPIO Assignment](hardware/gpio-assignment.md) の `Pi–ESP32間のtransport` 節が正本）
- コマンドを重複させる
- キューを意図的に満たす
- サーボ命令を範囲外にする

故障時に「止まらない」だけでなく、故障を観測し、安全に縮退し、復旧できることを確認する。

### 23.5 MVP シナリオ

#### 表情

1. 起動する。
2. LCD が既定表情を表示する。
3. Pi から `happy` を送る。
4. ESP32 が ACK する。
5. 実 LCD が happy 表情になる。

#### 撫で

1. タッチ raw 値を取得する。
2. 撫で操作を行う。
3. 一回の意味イベントを送る。
4. Pi が happy を決める。
5. LCD と首動作が安全に実行される。

#### 軽い衝撃

1. 規定の軽い tap を与える。
2. 加速度イベントを一度送る。
3. Pi が surprised を決める。
4. 誤った連続イベントが出ない。

#### 通信断

1. 動作中に Pi–ESP32 間の通信を断つ（UART の信号線の条件は §23.4 と同じ）。
2. ESP32 が安全状態へ移る。
3. 再接続後に hello／status 同期する。
4. 古い相対動作を再実行しない。

---

## 24. GUI／表情実装

### 24.1 開発ループ

```text
表情仕様
  → 描画コード
  → PCシミュレーション
  → ESP32ビルド
  → 実LCD表示
  → 目視・計測
  → 修正
```

PC のスクリーンショット比較は有効だが、最終判断は実 LCD で行う。

### 24.2 表情を状態として定義する

表情名だけでなく、描画パラメータを構造化する。

```text
FaceState
  eye_shape
  eye_open
  eye_offset
  mouth_curve
  mouth_open
  color_scheme
  transition_duration
```

MVP では必要最小限にし、過度な汎用 GUI フレームワーク導入を避ける。

### 24.3 部分更新

全画面更新と部分更新を比較する。

- 転送時間
- ちらつき
- 実装複雑性
- タッチ待ち時間
- RAM 使用量

部分更新を行う場合、前フレームの消去、重なり、dirty rectangle の漏れをテストする。

---

## 25. OTA を将来導入する場合

初期 MVP は USB 書き込みを優先する。OTA を追加する場合は、単にネットワークから受け取ったバイナリを上書きしない。

### 25.1 必要要素

- 更新クライアント
- 配布サーバ
- 署名済みイメージ
- デバイス上の署名検証
- A/B または同等の復旧可能なパーティション
- 更新状態管理
- 起動確認
- rollback
- 電源断耐性
- バージョン・ダウングレード方針

### 25.2 鍵管理

- 秘密署名鍵をデバイスへ入れない。
- 秘密鍵をリポジトリへ入れない。
- デバイスには検証に必要な公開情報だけを置く。
- CI／署名環境の権限を分離する。

### 25.3 更新シーケンス

1. manifest を取得する。
2. 対象ハードウェアとバージョンを確認する。
3. secondary slot へ書く。
4. hash と署名を検証する。
5. 次回起動先を更新する。
6. 再起動する。
7. self-test と Pi 通信を確認する。
8. 成功を確定する。
9. 失敗または timeout なら旧版へ戻す。

### 25.4 フラッシュ設計

パーティション容量だけでなく、erase sector、アラインメント、ブートローダ制約、NVS、ログ領域を確認する。容量計算が成立していても A/B swap が成立するとは限らない。target 固有のパーティション offset とサイズ、消去単位のアラインメント、ブートローダの制約、OTA パーティションのサポート状況を個別に確認する。特に内部フラッシュと外部フラッシュが混在する構成では、セクタ構成の差が前提を崩しうるため確認対象に含める。

---

## 26. 安全性とセキュリティ

### 26.1 実機安全

- サーボの機械可動域をハードとソフトで制限する。
- 初回試験は機構から外すか、狭い範囲で行う。
- 緊急停止手段を用意する。
- 手やケーブルの挟み込みを確認する。
- 異音、発熱、拘束時は直ちに電源を切る。
- 電源容量と配線温度を確認する。

### 26.2 入力検証

Pi は信頼できる同一装置内の相手でも、通信データは検証する。

- 最大長
- JSON 型
- 数値範囲
- 列挙値
- 文字列長
- コマンド頻度
- 重複
- 期限切れ

### 26.3 秘密情報

- `.env` をコミットしない。
- シリアル・ログへ秘密を出さない。
- AI へ API key や資格情報を貼らない。
- crash dump や CI log に含まれる可能性を確認する。

### 26.4 AI エージェントの権限

- 作業ディレクトリを限定する。
- 削除、外部送信、依存導入は確認可能にする。
- API 使用上限を設ける。
- 実行ログを保持する。
- 生成差分をレビューする。
- 出所不明の skill、rule、plugin を実行前に読む。
- 不可視 Unicode や外部から取得した命令を確認する。

安全クリティカルな角度制限、電流保護、通信断処理を LLM の実行時判断へ任せない。決定論的なコードと設定で実装する。

---

## 27. AI コーディングの実務

### 27.1 AI へ先に「調査だけ」を依頼する

新しい周辺機能では、最初の依頼を実装ではなく次にする。

- 仕様の要約
- 不明点
- 必要な一次資料
- GPIO／電源／通信上のリスク
- 最小検証手順
- テスト項目

不明点を解決してからコード生成へ進む。

### 27.2 良い依頼に含める情報

- 対象ボードと正確な部品型番
- 回路図と GPIO 表
- SDK、Rust、crate のバージョン
- 期待する振る舞い
- 禁止事項
- 受け入れ条件
- 既存設計との境界
- 変更可能なファイル
- 実行すべきテスト
- 実機確認が必要な項目

### 27.3 一 issue 一目的

例:

- LCD 単色表示
- JSON Lines parser
- タッチ raw 読み出し
- サーボ clamp

を別 issue にする。LCD、センサ、サーボ、通信を一つの生成依頼にしない。

### 27.4 AI レビューの使い分け

レビュー観点を分ける。

- 仕様適合
- 電気的前提
- エラー処理
- 並行処理
- メモリ
- セキュリティ
- 回帰
- テスト不足

複数 AI の指摘は候補であり、互いに一致しても一次資料と実機確認を省略しない。

### 27.5 回帰を防ぐ

- 正式仕様を一つにする。
- 決定ログを残す。
- 修正前にテストを書く。
- 変更を小さくする。
- 既存の校正・補正コードの意図をコメントとテストで固定する。
- AI に「既存の振る舞いを列挙してから変更する」と指示する。
- diff で意図外変更を確認する。

別の問題を修正した際に、過去に決めた補正値やしきい値が黙って失われる回帰は起こりやすい。値そのものは Git 履歴や過去のビルドから拾えることがあるが、**その値を選んだ根拠、適用条件、確認方法は復元しにくい**。根拠がコード中の定数としてしか残っていない場合は特にそうなる。テストと決定記録がない状態で、AI による全面書き換えを採用しない。

---

## 28. 決定ログと実験ログ

### 28.1 Architecture Decision Record

```markdown
# ADR-XXX: 決定名

- 状態: proposed / accepted / superseded
- 日付:
- 背景:
- 選択肢:
- 決定:
- 根拠:
- 利点:
- 欠点:
- 実機証拠:
- 影響するファイル:
- 再検討条件:
```

記録対象の例:

- ESP32 と Pi の責務
- JSON Lines 採用
- LCD 描画方式
- I2C／SPI 共有方式
- サーボ通信断動作
- OTA 導入判断

### 28.2 実験ログ

```markdown
# EXP-XXX: 実験名

- 日時:
- 目的:
- 仮説:
- ハードウェア構成:
- 回路 revision:
- firmware commit:
- 電源条件:
- 設定:
- 手順:
- raw data:
- 観測結果:
- 結論:
- 次の実験:
```

サーボ可動域、タッチしきい値、加速度判定、I2C 速度は実験ログを根拠に確定する。

---

## 29. 実装時のレビュー・チェックリスト

### 29.1 ハードウェア

- [ ] 正確な部品型番を確認した
- [ ] 公式データシートの版を記録した
- [ ] 全電源電圧が整合している
- [ ] 絶対最大定格を越えない
- [ ] ピーク電流を含む電源予算がある
- [ ] サーボは外部電源である
- [ ] GND の戻り経路を確認した
- [ ] GPIO 表が完成している
- [ ] boot／予約端子と衝突しない
- [ ] I2C のプルアップ先と合成抵抗を確認した
- [ ] SPI デバイスごとの CS がある
- [ ] 起動時の出力状態が安全である
- [ ] コネクタ誤挿入対策を検討した

### 29.2 ドライバ

- [ ] device identity を確認する
- [ ] timeout がある
- [ ] エラーを分類する
- [ ] raw 値を取得できる
- [ ] 変換式の根拠がある
- [ ] CRC／校正係数を処理する
- [ ] 再初期化方針がある
- [ ] 切断時に他デバイスを停止させない
- [ ] カウンタと最終成功時刻がある
- [ ] fake 実装または単体テストがある

### 29.3 並行処理

- [ ] ISR が短い
- [ ] ISR 内で allocation／blocking をしない
- [ ] バスの所有者が明確である
- [ ] ロック順序が明確である
- [ ] キュー上限がある
- [ ] overflow を検出する
- [ ] タスク・スタックを測定した
- [ ] WDT が各重要タスクの進行を確認する

### 29.4 プロトコル

- [ ] バージョンがある
- [ ] 最大行長がある
- [ ] 連番がある
- [ ] ACK と完了を区別する
- [ ] 範囲外入力を拒否する
- [ ] 重複コマンドを処理する
- [ ] 再接続時に状態同期する
- [ ] 全ログがフレーミングを壊さない
- [ ] 不正入力テストがある

### 29.5 サーボ

- [ ] 外部 5 V 電源
- [ ] 共通 GND
- [ ] PWM 仕様を実機・データシートで確認
- [ ] ソフト最小／最大
- [ ] 速度／加速度制限
- [ ] 通信断動作
- [ ] 起動時グリッチ確認
- [ ] 電圧波形確認
- [ ] 機械干渉確認
- [ ] emergency stop

### 29.6 リリース

- [ ] format／lint／test が成功
- [ ] clean build が成功
- [ ] final profile で実機試験した
- [ ] firmware version が正しい
- [ ] size／最小空きメモリを確認した
- [ ] reset reason と fault log を確認した
- [ ] 電源再投入試験をした
- [ ] Pi 再接続試験をした
- [ ] MVP シナリオを完走した
- [ ] 未解決 TBD と既知問題を記録した

---

## 30. 現時点で推測してはいけない項目

次は採用部品と実機が確定するまで TBD のまま管理する。**この一覧は TBD として追跡する対象を示すものであり、
根拠の水準を定めるものではない。**どの値に一次資料または実測を要し、どの値が一般値で開始してよいかは、
[Hardware Safety Policy](governance/hardware-safety-policy.md#5項目以外の扱い)の対応表が正本である。

- LCD コントローラ型番
- LCD 寸法、解像度、色順、SPI mode、最大実用速度
- タッチ方式、コントローラ、座標校正、しきい値
- 加速度センサ型番、レンジ、ODR、イベントしきい値
- 環境センサ型番、測定周期、精度、ヒータ有無
- サーボ型番、電源電流、PWM 周期、パルス幅
- 首機構の安全可動域
- サーボ最大速度・加速度
- 全 GPIO 番号
- I2C アドレスと速度
- I2C プルアップ抵抗
- SPI 共有可否とデバイスごとの速度
- Pi–ESP32 間 UART の最終ボーレート
- JSON Lines の最終最大長
- 各タスク周期と優先度
- タッチ・加速度のデバウンス
- 通信断 timeout
- WDT timeout
- 電源容量、コンデンサ値、保護回路
- OTA の要否とパーティション

---

## 31. 次に作成すべき開発資料

本書を基準に、実装開始前または各フェーズで次を追加する。

1. `docs/hardware/hardware-bom.md`
2. `docs/hardware/gpio-assignment.md`
3. `docs/hardware/power-budget.md`
4. `docs/protocol/esp32-pi-protocol.md`
5. `docs/hardware/servo-safety-limits.md`
6. `docs/hardware/sensor-datasheet-notes.md`
7. `Firmware_Architecture.md`
8. `Bringup_Test_Plan.md`
9. `Hardware_Experiment_Log.md`
10. `Firmware_Debug_Runbook.md`

各資料は同じ値を重複管理せず、正式な定義元を明記する。

---

## 32. 推奨する直近の作業順

1. 実際に購入・使用する全モジュールの写真、型番、URL、データシートを集める。
2. 開発ボード回路図と各モジュール回路図から GPIO 候補表を作る。
3. サーボを含む電源予算と配線図を作る。
4. LCD、タッチ、加速度、環境センサのバス条件を比較する。
5. GPIO 競合と起動端子を解消する。
6. Pi–ESP32 プロトコル（現行 Draft 2）の最小仕様を決める。`sid` を含む envelope は[正本](protocol/esp32-pi-protocol.md)に従う。
7. Rust／ESP-IDF の最小プロジェクトと固定バージョンを作る。
8. 起動ログ、reset reason、heartbeat を実装する。
9. JSON Lines の `hello`、`boot`、`ping`、`get_status` を実装する。
10. 周辺機能を Phase 4 以降の順で一個ずつ立ち上げる。

---

## 33. 本書の位置付けと適用範囲

本書は DeskCat プロジェクトが自ら維持する技術基準であり、外部資料の複製や要約ではない。

| 区分 | 本書での扱い | 適用上の注意 |
|---|---|---|
| DeskCat の承認済み方針 | 役割分担、Rust、UART、JSON Lines、MVP 範囲、サーボ電源、安全方針 | ADR と Governance が正本。本書は適用方法を示す |
| 一般的な組込み開発の作法 | 段階的立ち上げ、観測可能性、抽象化境界、故障注入、回帰防止 | 一般論であり、DeskCat の値を決める根拠にはならない |
| 部品固有の値 | 本書には記載しない | 根拠の水準は[Hardware Safety Policy](governance/hardware-safety-policy.md#5項目の中での根拠の水準)に従う。安全要件5項目に効かない値は一般値で開始してよい |

本書における[権限の優先順位](governance/README.md#権限の優先順位)は Governance に従う。本書は、承認済みの安全制限、GPIO 割り当て、プロトコル仕様、ADR、およびメーカー公式資料より下位である。本書の記述がそれらと矛盾する場合は、上位の文書に従い、本書を改訂する。

**DeskCat の実測記録も、上の表で部品固有の値の根拠としている以上、権限の順序に位置づける。**
実測が本書の記述と食い違った場合、次のいずれかを満たす実測記録が本書より上位である。

- 対象（部品、個体、firmware 版）、条件、適用範囲、記録場所が特定できる
- 承認済みの安全制限、GPIO 割り当て、TBD 台帳のいずれかへ取り込まれている

これらを満たさない実測は、本書を改訂する根拠にならない。条件を書き残していない測定は
再現できず、別の個体や条件へ一般化できないためである。取り込みの手順は
[TBD 台帳](hardware/tbd-register.md)に従う。

本書の価値は、個別のコードを持ち込むことではなく、ブラックボックス化された SDK の下にある電源、信号、メモリ、割り込み、初期化、通信を観測し、証拠に基づいて開発する姿勢を、DeskCat の作業手順として固定することにある。

### 33.1 着想元

本書の構成は、次の資料の読解を通じて着想を得ている。DeskCat 固有の設計判断は本プロジェクト向けに作成した。
外部資料の本文、図表、コードは転記していない。

**本書には一般的な組込み開発の作法も含む**（[§33 本書の位置付けと適用範囲](#33-本書の位置付けと適用範囲)の表を参照）。
その部分まで DeskCat 固有と主張しない。また本書に現れる数値のうち、対象、条件、
適用範囲をメーカー公式資料または管理された実測で確認できないものは、技術値として
使用せず`TBD`として管理する。provenance は監査のために記録するが、値の検証または
採用の根拠とはみなさない。説明用の数値例を残す場合は、非規範的な例であり、
設計値、制限値、testの期待値として使用してはならないことを明記する。
資料を削除済みで照合できない以上、「数値を含まない」とは主張できない。

| 項目 | 内容 |
|---|---|
| 資料 | Interface 2026年8月号（CQ出版社） |
| 号に掲載された候補資料 | 特集「Vibe Codingで本格開発」および別冊付録。**本書が参照した資料がこのどちらであったか、あるいは両方であったかは未確認**である。参照した資料は削除済みで照合できない |
| 特集タイトル | 「Vibe Codingで本格開発 ― 要件定義からコード実装まで」 |
| 別冊付録 | 「AIエージェントでひもとくマイコン開発環境」 |
| 発売日 | 2026年6月25日 |
| 号のページ URL | <https://interface.cqpub.co.jp/magazine/202608/>（2026-07-31に到達を確認）。出版社が長期の可用性を保証しているかは未確認であり、恒久 URL とは主張しない |
| 著者 | 号のページには、特集記事のタイトルと著者名の対応が掲載されている。ただし**本書が参照したのがどの記事・付録かを、削除済みの資料と照合できない**。したがって著者を特定できず、個人名を本書へ転記しない |
| ライセンス・再利用条件 | unknown。出版物の通常の著作権表示以外を確認していない |
| 入手経路 | ユーザーが一時的にローカルへ提供 |
| 現在の保持状況 | 必要な検討を終えた時点で削除済み。リポジトリには含まない |
| 再配布可否 | 未確認。方針は下記「次はDeskCatが採用する運用方針」を参照する |
| 公開前 review | 本書は Pull Request の差分として repository 所有者の review を経て公開する |
| 法務レビュー | 未実施 |

号のページから確認できる書誌情報（タイトル、発売日、URL）は一次情報として記録した。
`unknown` は、確認できていないことをそのまま残したものである。
記事と著者の対応は、資料を削除済みで照合できないため推測で埋めない。
値が必要になった場合は、同じ号を再入手して確認し、この表を更新する。

書誌情報を残すのは、後から出所を辿れる状態を保つためである。
どの資料を読んだかを記録しないと、判断の経緯を再現しにくくなる。

この記録は、本書が独立した著作物であることを証明するものではない。
また記録が無いことが、第三者による確認を不可能にするわけでもない。
できるのは provenance の保存であり、法的評価はそこから別途行う。

次はDeskCatが採用する運用方針であり、法務レビューを経た法的判断ではない。
判断に迷う場合や第三者から指摘を受けた場合は、この方針を根拠に押し通さず、
公開を止めて人間の確認を求める。

- 書誌情報（誌名、出版社、号）は記録する。出所を追跡可能にするためであり、
  記録しなければ、どの資料を参照したかを後から辿れない。
- **ページ範囲を伴う内容の要約は記載しない。**原著作物の構成に依存した記述となり、
  再配布可否を確認できない資料の公開に近づくため、保守的側に倒す。
- 上記は[README](https://github.com/wachi-yoshitaka-11-dev/deskcat#参考資料と生成data)と
  [AI Agent Policy](governance/ai-agent-policy.md)の公開規則を、本書へ適用したものである。
- **再配布可否が未確認の資料由来の記録は、その事実（unknown）を書いたままにする。**
  「再配布可能な内容だけで構成する」のように、未確認の状態を確認済みへ書き換えない。
  再配布可否が確認できるまで、当該記録の公開は人間または法務レビューの承認を必要とする。

著作権法上の評価そのもの（何が著作物か、何が引用の範囲か）は本書では判断しない。
必要になった時点で法務・コンプライアンスの確認を受ける。

外部資料から得た示唆を本書へ取り込む場合は、次を守る。

- 外部資料の本文、図表、コードを引用・転記しない。
- ページ範囲や章構成に依存した要約を置かない。
- 主張の種類ごとに根拠を張り替える。
  - ハードウェアと部品の挙動: メーカー公式資料または DeskCat の実測。
  - DeskCat の設計判断とプロトコル規則: ADR、Governance 文書、または正本のプロトコル文書。
- 再配布可否を確認できない資料を、リポジトリへ追加しない。

### 33.2 参照したが本書へ反映していない外部資料

[§33.1 着想元](#331-着想元)は、**本書の構成の着想元**を記録する表である。
ここは違う。**参照はしたが、本書の構成にも記述にも反映していない資料**を記録する。
同じ表へ足すと、本書の構成がその資料から着想を得たという誤った記録になる。

| 項目 | 内容 |
|---|---|
| 資料 | Interface 2026年9月号（CQ出版社） |
| 特集タイトル | 「AI時代の開発ツール300＋」（副題「定番の手法がもっと便利に」）。**号のページの表記であり、誌面からの転記ではない** |
| 発売日 | 2026年7月24日。**号のページの表記は「7月24日」で年が無い。**年は repository 所有者の申告による（2026-09-03）。[§33.1](#331-着想元)の8月号（2026年6月25日）との刊行間隔とも整合する |
| 号のページ URL | <https://interface.cqpub.co.jp/magazine/202609/>（2026-09-03に到達を確認）。出版社が長期の可用性を保証しているかは未確認であり、恒久 URL とは主張しない |
| 記事と著者 | **本書へ転記しない。**資料は照合可能な状態にあるが、[§33.1](#331-着想元) と同じ保守側に倒す |
| ライセンス・再利用条件 | unknown。出版物の通常の著作権表示以外を確認していない |
| 入手経路 | ユーザーが一時的にローカルへ提供 |
| 現在の保持状況 | ユーザーのローカルにある。リポジトリには含まない |
| 再配布可否 | 未確認 |
| 公開前 review | 本節は Pull Request の差分として repository 所有者の review を経て公開する |
| 法務レビュー | 未実施 |

**この資料は[ADR-0017](decisions/0017-what-counts-as-a-primary-source.md)の丙に当たる。**
メーカー以外が出した掲載情報であり、**安全要件5項目に効く値の根拠にしない。**
同 ADR の区分が対象とするのはその範囲であり、5項目に効かない値の扱いは
[ADR-0014](decisions/0014-safety-requirements-and-general-values.md)に従う。
**DeskCat の設計判断の根拠にもしない。**設計判断とプロトコル規則の根拠は、
[§33.1](#331-着想元) の規則どおり ADR、Governance 文書、または正本のプロトコル文書とする。

この資料から得た示唆を扱う場合も、[§33.1](#331-着想元) の
「外部資料から得た示唆を本書へ取り込む場合」の規則をそのまま適用する。
**ここへ再掲しない。**とくに、ページ範囲や章構成に依存した要約を本書へ置かない。

---

## 34. 完了の定義

DeskCat のマイコン側 MVP は、単に各部品が一度動いた時点では完了ではない。少なくとも次を満たした状態を完了とする。

- LCD が既定表情、happy、surprised を安定表示する
- タッチから一度の意味イベントを生成できる
- 軽い衝撃から一度の意味イベントを生成できる
- サーボが安全範囲と速度制限内で首を動かす
- サーボ動作中も ESP32 がブラウンアウトしない
- Pi と JSON Lines でコマンド、ACK、イベント、status を交換できる
- 不正入力、通信断、センサ切断から安全に復旧または縮退する
- 起動理由、fault、エラー・カウンタを取得できる
- クリーン環境からビルドと書き込みを再現できる
- PC テスト、実機テスト、MVP シナリオが記録付きで合格する
- GPIO、電源、プロトコル、安全制限の根拠資料が揃っている

この条件を満たして初めて、Pi 側の感情モデルや自律行動を安心して積み上げられる。
