wachi-yoshitaka-11-dev/deskcat/hardware/breadboard-rebuild/wiring-table.md

<!-- generate.py が生成する。手で直さない。 -->
# 組み直しの結線表（#512）

穴の書き方: `B1 L12` は主板の L 行・12列、`B1 −25` は主板の − の列の25列の下の穴、`B2 e3` は LCD 板の e 行・3列。
配置の考え方、値と並びの出所、`TBD` は [README.md](README.md) にある。

## 板と module

| 何 | どこへ | 向き |
|---|---|---|
| ESP32 DevKitC V4（`MCU-01`） | B1。J3（GND 23 22 … CLK）を B 行の12〜30列、J2（3V3 EN VP … 5V）を J 行の12〜30列 | USB を30列の側（板の端）、アンテナを12列の側にする。B 行の上に1穴（A）、J 行の下に2穴（K・L）が残る |
| `ENV-01`（AE-BME280） | B3 の a 行。VDD 10、GND 11、CSB 12、SDI 13、SDO 14、SCK 15 | 本体を板の外（上の辺の外）へ出す向き。ピンの名前の順が逆になる向きしか取れないときは止める（TBD） |
| `ACCEL-01`（M-06724） | 下段5本を B3 の f 行。SCL 2、SDA 3、SDO 4、INT2 5、INT1 6（基板の印字で左から）。上段4本は 3〜6列の b 行（VDD 3、GND 4、Vs 5、CS 6）。2列の間隔は6穴分（ユーザーの計測、2026-10-31） | 2列が溝をまたぐ向き。上段の上の a 行が空き穴になる |

## 抵抗（足は切る）

| ID | 値 | 品 | 端1 | 端2 | 用途 |
|---|---|---|---|---|---|
| R1 | 4.7 kΩ | `RES-PULL-01` | B1 L20 — GPIO25（I2C SDA） | B1 ＋20 — 3V3（J2-1 から） | I2C SDA の pull-up |
| R2 | 4.7 kΩ | `RES-PULL-01` | B1 L21 — GPIO26（I2C SCL） | B1 ＋21 — 3V3（J2-1 から） | I2C SCL の pull-up |
| R3 | 4.7 kΩ | `RES-PULL-01` | B1 L22 — GPIO27（SERVO-PWM） | B1 −22 — GND | SERVO-PWM の pull-down |
| R4 | 4.7 kΩ | `RES-PULL-01` | B1 A1 — GPIO14（PI-UART-RX） | B1 A5 — PI_TXD（Pi pin 8 TXD 側） | UART 直列（Pi→ESP32） |
| R5 | 4.7 kΩ | `RES-PULL-01` | B1 C2 — GPIO13（PI-UART-TX） | B1 C6 — PI_RXD（Pi pin 10 RXD 側） | UART 直列（ESP32→Pi） |
| R6 | 330 Ω | `CF25J330RB` | B1 E3 — GPIO27（SERVO-PWM） | B1 E7 — SERVO_SIG（サーボの黄の線の側） | サーボ信号の直列（EXP-028） |
| R7 | 330 Ω | `CF25J330RB` | B1 H5 — GPIO2（LED-COMM） | B1 H1 — LED_W_A（白LEDのアノード） | 白LEDの電流制限 |
| R8 | 330 Ω | `CF25J330RB` | B1 I2 — GPIO5（LED-REACT） | B1 I6 — LED_R_A（赤LEDのアノード） | 赤LEDの電流制限 |
| R9 | 10 kΩ | `RES-PULL-01` | B1 L5 — GPIO2（LED-COMM） | B1 −5 — GND | LED-COMM の pull-down |
| R10 | 10 kΩ | `RES-PULL-01` | B1 L2 — GPIO5（LED-REACT） | B1 −2 — GND | LED-REACT の pull-down |
| R11 | 10 kΩ | `MEAS-01 分圧用` | B1 K8 — 5V（J2-19 の 5V pin） | B1 K4 — GPIO33（ADC-5V） | ADC-5V 分圧の上 |
| R12 | 10 kΩ | `MEAS-01 分圧用` | B1 L4 — GPIO33（ADC-5V） | B1 −4 — GND | ADC-5V 分圧の下 |
| R13 | 10 kΩ | `RES-PULL-01` | B2 e3 — GPIO22（LCD-CS） | B2 f3 — 3V3（J2-1 から） | LCD-CS の pull-up |
| R14 | 10 kΩ | `RES-PULL-01` | B2 e4 — GPIO16（LCD-RST） | B2 f4 — 3V3（J2-1 から） | LCD-RST の pull-up |
| R15 | 10 kΩ | `RES-PULL-01` | B2 e10 — GPIO21（TOUCH-CS） | B2 f10 — 3V3（J2-1 から） | TOUCH-CS の pull-up |
| R16 | 4.7 kΩ | `RES-PULL-01` | B2 e8 — GPIO4（LCD-BL） | B2 f8 — GND | LCD-BL の pull-down |
| R17 | 10 kΩ | `MEAS-01 分圧用` | B3 g10 — 3V3（J2-1 から） | B3 g14 — GPIO36（ADC-3V3） | ADC-3V3 分圧の上 |
| R18 | 10 kΩ | `MEAS-01 分圧用` | B3 h14 — GPIO36（ADC-3V3） | B3 h11 — GND | ADC-3V3 分圧の下 |

## LED（足は切っていない。向きをこの表で残す）

| ID | 品 | アノード（長い足） | カソード（短い足） |
|---|---|---|---|
| D1 | 白 LED-COMM-01（OSPW5111B-QR） | B1 L1 | B1 −1 — GND |
| D2 | 赤 LED-REACT-01（OSHR5161A-QR） | B1 L6 | B1 −6 — GND |

## 硬いジャンパー（被覆あり）

長さは両端の穴の間隔（ピッチ＝2.54 mm の数）。溝をまたぐものと電源列へ下りるものは、写真からの目安で TBD（現物で合う長さを選ぶ）。色は長さで決まるので、現物の長さの色が正である。

| ID | 端1 | 端2 | 長さ（ピッチ） | 信号 | 色（長さで決まる） |
|---|---|---|---|---|---|
| H1 | B1 L12 | B1 ＋12 | 4（目安、TBD） | 3V3（J2-1 から） | 黄 |
| H2 | B1 L25 | B1 −25 | 3（目安、TBD） | GND | 橙 |
| H3 | B2 e1 | B2 f1 | 3（目安、TBD） | 3V3（J2-1 から） | 橙 |
| H4 | B2 e2 | B2 f2 | 3（目安、TBD） | GND | 橙 |
| H5 | B2 j1 | B2 j3 | 2 | 3V3（J2-1 から） | 赤 |
| H6 | B2 i3 | B2 i4 | 1 | 3V3（J2-1 から） | 灰 |
| H7 | B2 h4 | B2 h10 | 6 | 3V3（J2-1 から） | 青 |
| H8 | B2 g2 | B2 g8 | 6 | GND | 青 |
| H9 | B3 e10 | B3 f10 | 3（目安、TBD） | 3V3（J2-1 から） | 橙 |
| H10 | B3 e11 | B3 f11 | 3（目安、TBD） | GND | 橙 |
| H11 | B3 c11 | B3 c14 | 3 | GND | 橙 |

## 柔らかい線（両端オス）

| ID | 端1 | 端2 | 信号 | 色 | 組み直した直後 |
|---|---|---|---|---|---|
| S1 | B1 ＋26 | B2 b1 | 3V3（J2-1 から） | 赤 | 挿す |
| S2 | B1 −26 | B2 b2 | GND | 黒 | 挿す |
| S3 | B1 ＋27 | B3 b10 | 3V3（J2-1 から） | 赤 | 挿す |
| S4 | B1 −27 | B3 b11 | GND | 黒 | 挿す |
| S5 | B1 A14 | B2 b3 | GPIO22（LCD-CS） | 茶 | 挿す |
| S6 | B1 A23 | B2 b4 | GPIO16（LCD-RST） | 橙 | 挿す |
| S7 | B1 A22 | B2 b5 | GPIO17（LCD-DC） | 黄 | 挿す |
| S8 | B1 A13 | B2 c6 | GPIO23（LCD-MOSI） | 緑 | 挿す |
| S9 | B1 A20 | B2 c7 | GPIO18（LCD-SCLK） | 青 | 挿す |
| S10 | B1 A24 | B2 b8 | GPIO4（LCD-BL） | 紫 | 挿す |
| S11 | B1 A19 | B2 c9 | GPIO19（LCD-MISO） | 灰 | 挿す |
| S12 | B1 A17 | B2 b10 | GPIO21（TOUCH-CS） | 青 | 挿す |
| S13 | B1 K16 | B2 b11 | GPIO34（TOUCH-IRQ） | 灰 | 挿す |
| S14 | B1 K20 | B3 g3 | GPIO25（I2C SDA） | 白 | 挿す |
| S15 | B1 K21 | B3 g2 | GPIO26（I2C SCL） | 茶 | 挿す |
| S16 | B1 K14 | B3 f14 | GPIO36（ADC-3V3） | 白 | 挿す |
| S17 | B1 K19 | B1 G4 | GPIO33（ADC-5V） | 緑 | 挿す |
| S18 | B1 K30 | B1 G8 | 5V（J2-19 の 5V pin） | 青 | G8 側を先に挿し、K30 側を後に挿す（5 V の端を最後にする） |
| S19 | B1 A26 | B1 G5 | GPIO2（LED-COMM） | 橙 | 挿す（USB を挿す前に挿し、窓の間は抜き差ししない。実機側の PM の決定、2026-10-31） |
| S20 | B1 A21 | B1 G2 | GPIO5（LED-REACT） | 黄 | 挿す（USB を挿す前に挿し、窓の間は抜き差ししない。実機側の PM の決定、2026-10-31） |
| S21 | B1 K23 | B1 F1 | GPIO14（PI-UART-RX） | 黄 | K23 側を抜いておく。挿すのは gpio-assignment.md の `信号線をつないでよい条件` を満たすときだけ（ESP32 側の端で抜き差しする） |
| S22 | B1 K26 | B1 F2 | GPIO13（PI-UART-TX） | 橙 | K26 側を抜いておく。条件は S21 と同じ |
| S23 | B1 K22 | B1 F3 | GPIO27（SERVO-PWM） | 黄 | 挿す |
| S24 | B3 h3 | B3 b13 | GPIO25（I2C SDA） | 緑 | 挿す |
| S25 | B3 h2 | B3 b15 | GPIO26（I2C SCL） | 橙 | 挿す |
| S26 | B3 c10 | B3 の5列（ACCEL-01 上段の Vs）の、上段より上の空き穴（a 行） | 3V3（J2-1 から） | 赤 | 挿す |
| S27 | B3 d11 | B3 の4列（ACCEL-01 上段の GND）の、上段より上の空き穴（a 行） | GND | 黒 | 挿す |
| S28 | B3 の6列（ACCEL-01 上段の CS）の、上段より上の空き穴（a 行） | B3 の3列（ACCEL-01 上段の VDD）の、上段より上の空き穴（a 行） | 3V3（J2-1 から） | 赤 | 挿す |
| S29 | B3 g4 | B3 i11 | GND | 黒 | 挿す |

## 板の外へ出る線（柔らかい線）

| ID | 板の端 | 板の外の端 | 信号 | 色 | 組み直した直後 |
|---|---|---|---|---|---|
| X1 | B1 D5 | Pi の header pin 8（GPIO14 `TXD`） | PI_TXD（Pi pin 8 TXD 側） | 紫 | 板の側を挿す。Pi の header 側は挿していない（EXP-052）。以後の抜き差しは S21 の K23 側で行い、Pi の header 側では抜き差ししない |
| X2 | B1 D6 | Pi の header pin 10（GPIO15 `RXD`） | PI_RXD（Pi pin 10 RXD 側） | 青 | 板の側を挿す。Pi の header 側は挿していない（EXP-052）。以後の抜き差しは S22 の K26 側で行い、Pi の header 側では抜き差ししない |
| X3 | B1 A18 | Pi の header pin 39（GND） | GND | 黒 | A18 側を抜いておく。挿す前に、gpio-assignment.md の `信号線をつないでよい条件` の6の開放側の値を読む |
| X4 | B1 D7 | サーボの plug の黄の穴 | SERVO_SIG（サーボの黄の線の側） | 黄 | D7 側を抜いておく。挿すのは #17 のサーボの試験、または #18 の段0・段1（docs/hardware/servo-safety-limits.md の「#18の校正（案）」の段0の2）の手順と承認に従うときだけ |
| X5 | B1 −30 | 端子台S の −（ESP32 の GND をサーボの GND と共通にする線。EXP-034 の Wiring revision、組み直す前の基準線。Git の履歴にある組み直す前の hardware/breadboard/layout.svg） | GND | 黒 | −30 側を抜いておく。条件は X4 と同じ。#18 の段0・段1では、板の外の端を端子台S の − の穴へ挿さず、クリップ付コードで端子台S の − に入ったシャントの足を挟む（同じ段0の2） |

## 首を通る LCD の14本（メスオス線のオス側を直接挿す）

今の仮組で LCD に付いているメスオス線のメス側を LCD のピンに挿したまま、オス側を下の穴へ直接挿す。細ピンヘッダ（`PROTO-01`）は使わない。#34 の決定（両端メス）とは違う暫定で、首の経路の長さは未確認（#34）。ユーザーの原文（省略）（2026-10-31）を受けた実機側の PM の判断。

| LCD pin | 表記 | 挿す穴 | 信号 | 線の色（LCD に付いている線。記録の色。色は記録どおり（人間の回答）） |
|---:|---|---|---|---|
| 1 | VCC | B2 a1 | 3V3（J2-1 から） | 赤 |
| 2 | GND | B2 a2 | GND | 黒 |
| 3 | CS | B2 a3 | GPIO22（LCD-CS） | 茶 |
| 4 | RESET | B2 a4 | GPIO16（LCD-RST） | 橙 |
| 5 | DC/RS | B2 a5 | GPIO17（LCD-DC） | 黄 |
| 6 | SDI | B2 a6 | GPIO23（LCD-MOSI） | 緑 |
| 7 | SCK | B2 a7 | GPIO18（LCD-SCLK） | 青 |
| 8 | LED | B2 a8 | GPIO4（LCD-BL） | 紫 |
| 9 | SDO | B2 a9 | GPIO19（LCD-MISO） | 灰 |
| 10 | T_CLK | B2 b7 | GPIO18（LCD-SCLK） | 紫 |
| 11 | T_CS | B2 a10 | GPIO21（TOUCH-CS） | 青 |
| 12 | T_DIN | B2 b6 | GPIO23（LCD-MOSI） | 緑 |
| 13 | T_DO | B2 b9 | GPIO19（LCD-MISO） | 黄 |
| 14 | T_IRQ | B2 a11 | GPIO34（TOUCH-IRQ） | 灰 |

## 足を切る部品・切らない部品

- 切る: 抵抗 18 本（R1〜R18）。穴の奥まで入る長さを残し、板の上に出る金属を短くする。LED（D1・D2）の足は切っていない（実機側の PM の決定、2026-10-31）。
- LED は長い足（アノード）を確かめ、上の表の穴に挿してから、向きを表と照らした（足は切っていない）。
- 切らない: `PROTO-02` へ移す電源部の部品（`PROT-OC-01` の PTC、`WIRE-PWR-01` の端子台と線、`MEAS-01` の shunt）。どれもブレッドボードに載せない。
- module（ESP32、`ENV-01`、`ACCEL-01`）のピンは切らない。

## 載せないもの

- `MEAS-02`（Arduino）の線（A0・GND）と、EXP-030 の Arduino 用の 10 kΩ 分圧（a10–a12、b12–b14）。測定器であり、必要なら実機側が試験のときに足す。
- `MEAS-01` の shunt と GPIO32（`ADC-SHUNT`）の線。shunt はサーボの電流を通すのでブレッドボードに載せない。GPIO32 の線は今の配線に無く、足すかどうかは #17・#405 で決める（J2-7 の列 B1 K18・L18 を空けてある）。
