wachi-yoshitaka-11-dev/deskcat/hardware/bench-18/wiring-table.md

<!-- generate.py が生成する。手で直さない。 -->
# #18 の窓と段1の servo 電源の経路の結線表

`PSU-BENCH-01` から端子台 A・B・S、`MF-R135`、シャント、jumper wire まで。`MEAS-02`（Arduino）の線は、測定のためだけの一時配線なので描かない（[hardware/README.md](../README.md)）。この表は配線の許可ではない。通電と駆動は [servo-safety-limits.md](../../docs/hardware/servo-safety-limits.md) の条件と、その回の実行承認に従う。

## 節点（電気的に同じ点）

| 節点 | 信号・極性 | その点にある物 |
|---|---|---|
| N1 | PSU の＋（MF-R135 の手前） | PSU の＋端子、新しい線（PSU＋）、端子台の穴 A赤、MF-R135 の足1 |
| N2 | MF-R135 の後。W+ と赤の jumper wire（servo の＋側） | MF-R135 の足2、端子台の穴 B1、赤い線 W+（B1側）、赤い線 W+（S＋側）、端子台の穴 S＋、赤の jumper wire の針（S＋側）、赤の jumper wire の針（負荷側） |
| N3 | servo の−側（シャントの手前） | 端子台の穴 B2、シャントの足2、茶の jumper wire の針（B2側）、茶の jumper wire の針（負荷側） |
| N4 | PSU の−と GND（シャントの後） | 端子台の穴 S−、シャントの足1、黒い線 W−（S−側）、黒い線 W−（A黒側）、端子台の穴 A黒、新しい線（PSU−）、PSU の−端子 |

## 端子台の6穴（各穴に2本）

| 穴 | 入る2本 | 節点 |
|---|---|---|
| A赤 | 新しい線（PSU＋）、MF-R135 の足1 | N1 |
| A黒 | 新しい線（PSU−）、黒い線 W−（A黒側） | N4 |
| B1 | MF-R135 の足2、赤い線 W+（B1側） | N2 |
| B2 | シャントの足2、茶の jumper wire の針（B2側） | N3 |
| S＋ | 赤い線 W+（S＋側）、赤の jumper wire の針（S＋側） | N2 |
| S− | 黒い線 W−（S−側）、シャントの足1 | N4 |

## 線と部品

| ID | 何 | 端1（節点） | 端2（節点） | 色 | 備考 |
|---|---|---|---|---|---|
| L1 | 新しい線（`WIRE-PWR-01`、AWG22相当） | PSU の＋端子（N1） | 新しい線（PSU＋）（N1） | 色は現物で記録（TBD） | PSU の出力端子（ねじ）へ、A赤の穴へ。＋−の照合は小節8 |
| L2 | 新しい線（`WIRE-PWR-01`、AWG22相当） | PSU の−端子（N4） | 新しい線（PSU−）（N4） | 色は現物で記録（TBD） | PSU の出力端子（ねじ）へ、A黒の穴へ。同上 |
| L3 | `MF-R135`（PTC） | MF-R135 の足1（N1） | MF-R135 の足2（N2） | — | A赤の穴と B1 の穴の間 |
| L4 | 赤い線 W+ | 赤い線 W+（B1側）（N2） | 赤い線 W+（S＋側）（N2） | 赤 | B1 の穴と S＋の穴の間 |
| L5 | 黒い線 W− | 黒い線 W−（S−側）（N4） | 黒い線 W−（A黒側）（N4） | 黒 | S−の穴と A黒の穴の間 |
| L6 | シャント（`MEAS-01`） | シャントの足2（N3） | シャントの足1（N4） | — | B2 の穴と S−の穴の間 |
| L7 | 赤の jumper wire（両端オス） | 赤の jumper wire の針（S＋側）（N2） | 赤の jumper wire の針（負荷側）（N2） | 赤 | (D)・(B) では両端メスの jumper wire（赤側）へ、段1では servo の plug の赤へ |
| L8 | 茶の jumper wire（両端オス） | 茶の jumper wire の針（B2側）（N3） | 茶の jumper wire の針（負荷側）（N3） | 茶 | (D)・(B) では両端メスの jumper wire（茶側）へ、段1では servo の plug の茶へ |

## 負荷（N2 と N3 の間）

窓の (D)・(B) と段1は、同じ2本の jumper wire の負荷側の針に、別の物をつなぐ。**両端メスの jumper wire は窓の (D)・(B) の間だけ使い、段1では外して servo の plug を jumper wire の針に挿す。**メス側の接点はハウジングの中にあり、プローブが届かない。

- **窓の (D)・(B)：**赤い jumper wire の針（負荷側、N2） → 両端メスの jumper wire（赤側） → `MEAS-01` の予備（セメント抵抗。赤側の足 → 茶側の足） → 両端メスの jumper wire（茶側） → 茶の jumper wire の針（負荷側、N3）
- **段1：**赤の jumper wire の針（負荷側、N2） → servo の plug の赤 → （servo 本体） → servo の plug の茶 → 茶の jumper wire の針（負荷側、N3）

## プローブを当てる点と区間（窓の (B)）

`DT830B` のプローブが届く金属だけを点にする。穴の中の導体（線の導体、jumper wire の針、メス側の接点）には届かないので、足の無い穴（S＋、A黒）は隣の区間に含め、届く点の連なりで13区間に区切る。

| 点 | 何 | 節点 |
|---|---|---|
| P1 | PSU の＋の端子の金属 | N1 |
| P2 | A赤の端子の金属 | N1 |
| P3 | MF-R135 の足1 | N1 |
| P4 | MF-R135 の足2 | N2 |
| P5 | B穴1の端子の金属 | N2 |
| P6 | S＋の端子の金属 | N2 |
| P7 | 抵抗（`MEAS-01` の予備）の赤側の足 | N2 |
| P8 | 抵抗（`MEAS-01` の予備）の茶側の足 | N3 |
| P9 | B穴2の端子の金属 | N3 |
| P10 | シャントの足2 | N3 |
| P11 | シャントの足1 | N4 |
| P12 | S−の端子の金属 | N4 |
| P13 | A黒の端子の金属 | N4 |
| P14 | PSU の−の端子の金属 | N4 |

| 区間 | 点 | 含むもの |
|---:|---|---|
| 1 | P1 ↔ P2 | 新しい線（＋）と、その両端の接点（PSU の＋端子、A赤の穴） |
| 2 | P2 ↔ P3 | A赤の穴の、MF-R135 の足1の接点 |
| 3 | P3 ↔ P4 | MF-R135 |
| 4 | P4 ↔ P5 | B穴1の穴の、MF-R135 の足2の接点 |
| 5 | P5 ↔ P6 | 赤い線 W+ と、その両端の接点（B穴1、S＋の穴） |
| 6 | P6 ↔ P7 | S＋の穴の jumper 側の接点、赤の jumper wire、針とメスの接点、両端メスの jumper wire（赤側） |
| 7 | P7 ↔ P8 | 負荷（抵抗の2本の足の間） |
| 8 | P8 ↔ P9 | 両端メスの jumper wire（茶側）、針とメスの接点、茶の jumper wire、B穴2の穴の jumper 側の接点 |
| 9 | P9 ↔ P10 | B穴2の穴の、シャントの足2の接点 |
| 10 | P10 ↔ P11 | シャント |
| 11 | P11 ↔ P12 | S−の穴の、シャントの足1の接点 |
| 12 | P12 ↔ P13 | 黒い線 W−と、その両端の接点（S−の穴、A黒の穴） |
| 13 | P13 ↔ P14 | 新しい線（−）と、その両端の接点（A黒の穴、PSU の−端子） |

## ESP32 から出る線（`breadboard-rebuild/wiring-table.md` の X4・X5。段0のまま）

| ID | 板の端 | 板の外の端 | 信号 | 色 |
|---|---|---|---|---|
| X4 | B1 D7 | servo の plug の黄（段1。窓の (A) では `MEAS-02` の A0 を `X4` の servo 側の端につなぐ） | SERVO_SIG | 黄 |
| X5 | B1 −30 | クリップ付コード（`PROTO-01`）で、S− の穴に入ったシャントの足1（N4）を、穴と本体のあいだの金属で挟む。(A) と、9 の判断の後の段1でつなぐ。(C)〜(B) の間は外す（小節1・9） | GND | 黒 |
