wachi-yoshitaka-11-dev/deskcat/docs/toolchains/version-records/2026-08-10-esp32-build-ci.md

# Version Record: ESP32 firmware build（CI）

> 対象: [#42](https://github.com/wachi-yoshitaka-11-dev/deskcat/issues/42)
> 位置づけ: [2026-08-06 の開発端末での記録](2026-08-06-esp32-build-linux.md)を、**別環境で再現したかどうか**の記録

判定語は [Version Record Template](../version-record-template.md) の「判定」節が正本である。

初回の検証は Linux x86_64 の開発端末 1 台で行った。本記録は、Pull Request #86 の tree を
GitHub Actions の `ubuntu-24.04` runner で clean build した結果である。

**実行は同一 commit ではない。**内訳は次のとおりで、**`firmware/` 配下と workflow 本体の差分は
`Record toolchain versions` step の追加だけである**（他は文書 file）。

| # | run | commit | cache | 結果 |
|---|---|---|---|---|
| 1 | 31359366171（初回） | 663a486 | 無し | success |
| 2 | 31359366171（再実行） | 663a486 | 有り | success |
| 3 | 31360185538 | 8889281 | 有り | success |
| 4 | 31361473690 | 397929a | 有り | **failure**（下記） |
| 5 | 31361652671 | 1ee78fa | 有り | success |

run 4 は、review 対応で足した step が `ldproxy --version` を実行し、`ldproxy` が panic して失敗した。
command を `command -v ldproxy` へ改めた run 5 で成功している。
**run 5 以降、`firmware/` 配下と `.github/workflows/` に差分は無い**（以後の commit は文書のみ）。
したがって run 5 の結果は、この Pull Request の最終状態に対しても有効である。
**workflow が誤った command で正しく失敗することは、この失敗で確認できた。**

## 記録

```text
Record ID: 2026-08-10-esp32-build-ci
Date: 2026-08-10
最終有効な検証日時: 2026-08-10T06:26:26Z（run 31361652671、上表の#5。commit 1ee78fa）
  最後に成功したrunを採る。上表の#3（run 31360185538、06:01:41Z）ではない。
  #3も成功しているが、その後に#4の失敗と#5の成功があり、#5がこの記録の最終状態に対応する。
Machine profile: CI（[Machine Profiles](../machine-profiles.md)）
Operator role: 自動実行（人間の介在なし）
Repository commit: 上表のとおり run ごとに異なる（663a486／8889281／397929a／1ee78fa）。いずれも Pull Request #86 の head
Working tree clean: yes（checkout 直後。workflow は tree を変更しない）

OS name: Ubuntu
OS version: 24.04（runner image `ubuntu-24.04`、provisioner 20260707.563）
CPU architecture: x86_64
Userspace bitness: 64
Container / VM / native: VM（GitHub-hosted runner）

Rustup version: runner image 既定（記録せず）
Rust channel: esp-1.95.0.0（`rustup show active-toolchain` が
  `esp-1.95.0.0 (overridden by '<workspace>/firmware/esp32/rust-toolchain.toml')` を出力）
Rust compiler version: rustc 1.95.0-nightly (95e5bda86 2026-04-15) (1.95.0.0)
  commit-hash: 95e5bda868c960c607597bc03ed9e8f0ad26226d / commit-date: 2026-04-15
  LLVM version: 21.1.3
Rust host: x86_64-unknown-linux-gnu
Installed Rust targets: xtensa-esp32-espidf
Cargo version: cargo 1.95.0-nightly (f2d3ce0bd 2026-03-21) (1.95.0.0)
rustfmt version: rustfmt 1.9.0-nightly (95e5bda868 2026-04-15)
Clippy version: clippy 0.1.95 (95e5bda868 2026-04-15)
Linker identity and version: ldproxy（action の `ldproxy: true` で導入。path 解決のみ確認）
  ※ `ldproxy` は linker wrapper であり `--version` を受け付けない。単体実行すると
    `Cannot locate argument '--ldproxy-linker <linker>'` で panic する。版は取得できない。
esp-clang: esp-20.1.1_20250829（`LIBCLANG_PATH` の path 要素より）

ESP32 only:
  Physical board: 接続なし（build-only。flash と serial monitor は実行しない）
  Module marking: 該当なし
  Board revision: 該当なし
  Rust target: xtensa-esp32-espidf
  espup version: 使用せず。この CI では espup を導入していない。
    Xtensa toolchain を入れたのは esp-rs/xtensa-toolchain v1.7.0（commit ec6d365 へ固定）である。
    開発端末の記録（espup 0.17.1）とは導入経路が違うため、同じ field として読み比べない。
  cargo-generate version: 使用せず
  ldproxy version: 取得不可（上記の理由）。導入は path 解決で確認
  espflash version: 導入せず（flash を行わないため）
  ESP-IDF version: v5.5.3（`.cargo/config.toml` が `force = true` で固定）
  ESP-IDF source/commit: esp-idf-sys が取得。取得先は `.embuild`
  ESP-IDF tools location mode: workspace（`ESP_IDF_TOOLS_INSTALL_DIR`）
  IDF_PATH present: no
  IDF_TOOLS_PATH present: no
  Template repository: 該当なし（既存 tree を build）
  Template commit: 該当なし
  sdkconfig/defaults identity: 追跡下の `firmware/esp32/sdkconfig.defaults`
  USB-UART identity: 該当なし

**上の toolchain 値は workflow の `Record toolchain versions` step の出力である。**
action の `version` 入力や `rust-toolchain.toml` の記述（＝要求値）ではなく、
runner に実際に入ったものを記録している。

Commands run:
  rustup show active-toolchain / rustc --version --verbose / cargo --version
  cargo fmt --version / cargo clippy --version / command -v ldproxy
  cargo fmt --all -- --check
  cargo clippy --all-targets --locked -- -D warnings
  cargo build --locked
Expected result: 3 command すべてが成功する
Actual result: 成功した 4 回すべてで 3 command が成功（上表の 1・2・3・5）。run 4 は step の誤りで失敗
Build duration: 下の「所要時間」を参照
Peak memory if measured: 未測定
Storage delta if measured: 未測定。cache 対象の合計は 327 MB（342,784,591 B）
Generated artifact identity: 未取得。**本記録は artifact の同一性を主張しない**（下記）
Log or evidence path: GitHub Actions run 31359366171／31360185538／31361473690／31361652671（上表）
Known differences from documented profile:
  - 実機 Linux ではなく GitHub-hosted の VM である
  - board を接続していない。flash、serial monitor、実機起動は行っていない
  - `.embuild` を cache していないため、ESP-IDF は run ごとに取得している
Conclusion: Partial（build-only の command はすべて成功。未実行・未測定の項目が残るため下記）
Next action: required status check の必須化を別途判断する
未実行・未測定の項目:
  - peak memory と storage delta（template では任意項目）
  - flash、serial monitor、実機起動（CI profile の対象外。#6 の範囲）
  - 成果物の sha256（比較の基準にできないため取得しない。下記）
```

## 所要時間

下表は上表の run 1〜3 の内訳である。run 1 は cache 無し、run 2 と 3 は run 1 が保存した cache を復元している
（いずれも `Cache hit ... on the primary key`）。

| step | cache 無し（1 回目） | cache 有り（2 回目） | cache 有り（3 回目） |
|---|---|---|---|
| Set up job | 1 s | 2 s | 1 s |
| Checkout | 0 s | 1 s | 1 s |
| Cache restore | 1 s（miss） | 8 s（hit） | 8 s（hit） |
| Install Xtensa Rust toolchain | 58 s | 53 s | 62 s |
| Format | 0 s | 0 s | 0 s |
| Lint | 263 s | 185 s | 219 s |
| Build | 19 s | 14 s | 20 s |
| Cache save | 5 s | 0 s | 0 s |
| **合計** | **349 s** | **264 s** | **311 s** |

cache 対象は `~/.cargo/registry`、`~/.cargo/git`、`firmware/esp32/target` の 3 つで、
復元 size は 327 MB（342,784,591 B）だった。

run 5（cache 有り）は **299 s** だった。cache 有りの実測は **264 s / 299 s / 311 s** の 3 点である。

### この数字をどう読むか

cache 有りの 3 回が **264 s / 299 s / 311 s** と 47 s の幅でばらついている。`Lint` 単体でも 185〜219 s である。
**cache による差（349 s に対して 38〜85 s）は、runner 側のばらつきと同じ桁にある。**

したがって **この試行回数では「cache で何 % 速くなる」と言える精度が無い。**
言えるのは次の 2 点だけである。

- cache 有りの 3 回は、いずれも cache 無しの 1 回より速かった
- 差は最大でも 85 s であり、**全体（約 5 分）を大きく変える規模ではない**

`.embuild` を cache しない構成では、**ESP-IDF の取得と build が毎 run 発生する。**
cache 有りでも `Lint` が 185〜219 s 掛かるのは主にこの分である。cache が効いているのは
crate の取得と再 compile であって、支配的な部分ではない。
所要時間を本気で縮めるなら、**削るべきは `.embuild` の再取得であって、この cache ではない。**
それは上限 10 GB との兼ね合いで採らなかった（次節）。

### `.embuild` を cache しない判断

`.cargo/config.toml` が `ESP_IDF_TOOLS_INSTALL_DIR = "workspace"` を固定しており、
ESP-IDF 本体と managed tool が `.embuild` へ入る。開発端末での実測は **4.4 GB** であり、
repository あたりの cache 上限 10 GB に対して大きい。単一 entry が上限の半分近くを占めると、
LRU eviction で他の cache を追い出す。

**この判断の代償は上の所要時間そのものである。**速度を取るなら `.embuild` を cache する側に
倒すことになるが、その場合は上限との兼ね合いを別途評価する必要がある。
現状は「毎 run 約 5 分」を受け入れて、cache 上限を圧迫しない側を選んでいる。

## artifact の同一性について

**本記録は成果物の sha256 を取得していない。**開発端末の記録が
「記録した入力を揃えても sha256 は一致しなかった（実測）」と結論しており、
環境が違う CI で一致を期待する根拠が無い。**取得しても比較の基準にできないため取らない。**

本記録が主張するのは、**同じ commit と同じ lockfile が、別環境で clean build を通ること**である。
`--locked` が成功していることは、`Cargo.lock` からの逸脱が無いことを示す。

## 「検証の移送」との対応

[Machine Profiles](../machine-profiles.md) の「検証の移送」が別端末へ求める項目を、本記録が満たすかを示す。

| 求められる項目 | 本記録 |
|---|---|
| OS と CPU architecture | Ubuntu 24.04 / x86_64 |
| container、VM、実機のどれか | **VM**（GitHub-hosted runner） |
| toolchain と target | Xtensa Rust 1.95.0.0（`esp-1.95.0.0`）/ `xtensa-esp32-espidf` |
| linker と SDK | ldproxy / ESP-IDF v5.5.3 |
| repository commit | 663a486 ／ 8889281（差分は文書のみ） |
| lockfile が変更されていないこと | `--locked` が成功 |
| clean build の結果 | 成功（fresh runner。`target` は cache 復元しうるが、初回は cache 無しで成功している） |

同文書は「ESP32 の build-only 検証」について **Docker 上の Linux を使ってよい**と定めており、
「container で得た結果を実機の根拠として扱わない」制限は flash と実機試験に掛かる。
本記録は build-only であり、flash と実機起動を主張しない。

## 制限

- **実機動作を一切主張しない。**flash、serial monitor、boot 確認は [#6](https://github.com/wachi-yoshitaka-11-dev/deskcat/issues/6) の範囲である
- runner image は GitHub が更新する。将来の run が同じ image とは限らない
- **CI では compiler の実体を観測している。**`Record toolchain versions` step の `rustc --version --verbose` が `1.95.0.0` を出力しており、[#74](https://github.com/wachi-yoshitaka-11-dev/deskcat/issues/74) が残した穴（名前は合っているが中身が違う）は、**CI 上に限っては塞がっている**。ただし出力を記録するだけで、**期待値と自動照合してはいない**。手元 build も対象外である
- peak memory と storage delta は未測定である
- **`ldproxy` の版は取得できない。**linker wrapper であり `--version` を受け付けず、単体実行すると
  `Cannot locate argument '--ldproxy-linker <linker>'` で panic する。導入の確認は path 解決までである
