wachi-yoshitaka-11-dev/deskcat/docs/hardware/experiment-log.md

# 実験記録

**この文書の日付はすべてJST（UTC+9）である。**[CONTRIBUTING.md](https://github.com/wachi-yoshitaka-11-dev/deskcat/blob/main/CONTRIBUTING.md)が`日付はJST（UTC+9）で判断する`と定めている。
**JSTの`00:00`から`08:59`に行った作業は、UTCでは前日の日付になる。**GitHubのAPIやreview toolがUTCで日付を判定すると、**実施済みの記録が未来日に見える。**
実際に[PR #160](https://github.com/wachi-yoshitaka-11-dev/deskcat/pull/160)と[PR #163](https://github.com/wachi-yoshitaka-11-dev/deskcat/pull/163)でこの食い違いが指摘されている。**日付をUTCへ読み替えない。**

[README](README.md)が正式文書として挙げる`実験記録`の実体である。書式は
[技術ガイド](../DeskCat_Microcontroller_Development_Guide.md)の`28.2 実験ログ`に従う。

**この文書は未加工の観測を残す場所である。**受け入れ要件と照合する値の正は各正本文書側に置き、
ここからは参照するだけにする。数値をここと正本の両方に正として置かない。

| 実験 | 対象 | 値の正 |
|---|---|---|
| [EXP-001](#exp-001-連続streamingの実効sample-rate) | `HW-TBD-034` 作業1・作業2 | [power-budget.md](power-budget.md)の`手持ち候補に固有の制約: SRAMと取得方式`、`基準電圧が未解決である（設計上の論点）` |
| [EXP-002](#exp-002-内蔵基準電圧の校正比率法) | `HW-TBD-034` 作業2 | [power-budget.md](power-budget.md)の`基準電圧が未解決である（設計上の論点）` |
| [EXP-003](#exp-003-段階b-1でのgnd-topologyと入力headroom) | `HW-TBD-034` 作業3 | [power-budget.md](power-budget.md)の`GND topology（測定前に必ず確定させる）` |
| [EXP-004](#exp-004-gnd-offsetを両極性で測る) | `HW-TBD-034` 作業3 | [power-budget.md](power-budget.md)の`GND topology（測定前に必ず確定させる）` |
| [EXP-005](#exp-005-5v-pinとavcc-pinの差の上限) | `HW-TBD-034` 作業2 | [power-budget.md](power-budget.md)の`基準電圧が未解決である（設計上の論点）` |
| [EXP-006](#exp-006-ポーリングログの試運転) | [#247](https://github.com/wachi-yoshitaka-11-dev/deskcat/issues/247)測定計画3節 | 値の正なし（手順が機能することの検証記録） |
| [EXP-007](#exp-007-journal永続化と直後のpi再起動) | [Hardware Safety Policy](../governance/hardware-safety-policy.md) §11、[#247](https://github.com/wachi-yoshitaka-11-dev/deskcat/issues/247) | 値の正なし（事象記録） |
| [EXP-008](#exp-008-段階b-1でのpi単体build負荷比較とesp32側基準値) | `HW-TBD-023`（この記録は判定に使っていない） | 値の正なし（`HW-TBD-023`が未確定であり、正本側に置ける確定値がまだ無い） |
| [EXP-009](#exp-009-案aの再現3回と停止時刻の記録) | [#247](https://github.com/wachi-yoshitaka-11-dev/deskcat/issues/247) | 値の正なし（事象記録。原因は未確定） |
| [EXP-010](#exp-010-pi入力の独立観測系の構築と初回測定) | `HW-TBD-034` 方式1のPi入力への拡張 | [power-budget.md](power-budget.md)の`5 V railをADCへ直結する条件`、`GND topology（測定前に必ず確定させる）` |
| [EXP-011](#exp-011-en保持での起動時状態の再測定lcd-cslcd-rsttouch-cslcd-bl) | `#2`受け入れchecklist項目6・7 | [gpio-assignment.md](gpio-assignment.md)の`競合check` |
| [EXP-012](#exp-012-m-12001cableのplug側破片を使ったvbusgnd極性判定) | `HW-TBD-021`／`022`（案Bのingress実装） | [power-budget.md](power-budget.md)の`M-12001のcableを受ける端子台` |
| [EXP-013](#exp-013-ブレッドボード上でのingress保護回路ptcmosfetの通電検証) | `HW-TBD-030`（`PROT-RP-01`の向き）、`HW-TBD-034`（`この試験から次へ渡すもの`の宛先） | 値の正なし（仮組みでの動作確認。定格表の検証ではない） |
| [EXP-014](#exp-014-env-01bme280のj3はんだジャンパの実施記録) | `HW-TBD-005`（`J3`のはんだ付け。**closeしていない**） | 値の正なし（**測定値を1つも持たない。**状態の正は[sensor-datasheet-notes.md](sensor-datasheet-notes.md)の`jumper（AE-BME280）`節） |
| [EXP-015](#exp-015-accel-01adxl345env-01bme280のesp323v3-pin給電による初回通電とdevice-id読み出し) | [#15](https://github.com/wachi-yoshitaka-11-dev/deskcat/issues/15)／[#16](https://github.com/wachi-yoshitaka-11-dev/deskcat/issues/16)受け入れ条件 | [sensor-datasheet-notes.md](sensor-datasheet-notes.md)のDevice ID行、[gpio-assignment.md](gpio-assignment.md)の`電源pinの短絡・誤配線の確認（非通電）`表 |
| [EXP-016](#exp-016-disp-01msp2807esp323v3-pin追加接続のbring-upcontroller識別単色fill四隅pattern) | [#13](https://github.com/wachi-yoshitaka-11-dev/deskcat/issues/13)受け入れ条件 | 値の正なし（bring-upの記録。判定は#13） |
| `EXP-017`（見出しに`—`を含み、`scripts/validate_doc_links.py`がanchorを確かめられないためlinkしない） | [#13](https://github.com/wachi-yoshitaka-11-dev/deskcat/issues/13)受け入れ条件 | 値の正なし（bring-upの記録。判定は#13） |
| [EXP-018](#exp-018-disp-01msp2807横向きの向きの決定と単色fill色の並び四隅の写真記録idの読み出しの打ち止め) | [#13](https://github.com/wachi-yoshitaka-11-dev/deskcat/issues/13)受け入れ条件1〜5 | 値の正なし（bring-upの記録。判定は#13） |
| [EXP-019](#exp-019-段階b-2今の接続のまま-b-2aの周辺-module-3点の-33-v-側の電流と電圧) | [#3](https://github.com/wachi-yoshitaka-11-dev/deskcat/issues/3)の段階B-2（`HW-TBD-024`／`HW-TBD-025`は解いていない） | 値の正なし（確度が未取得の読み。[power-budget.md](power-budget.md)の`負荷表`は、この記録を参照するだけで値を持たない） |
| [EXP-020](#exp-020-段階aのpiの給電を手持ちのadapterへ移しwi-fiの切断を切り分けpiのuartを設定した) | [#446](https://github.com/wachi-yoshitaka-11-dev/deskcat/issues/446)の受け入れ条件4の準備。段階AのPiの給電（`PSU-PI-A-01`と`CABLE-PI-A-01`）、Wi-Fiの切断の観察、PiのUARTの設定 | 値の正なし（観察の記録。電源の適否は判断していない） |
| [EXP-021](#exp-021-叩いて表情が変わるデモの通電) | [#21](https://github.com/wachi-yoshitaka-11-dev/deskcat/issues/21)の通電。叩いて表情が変わるデモ（ADXL345の`tapped`、Piの`set_expression`、LCDの表情） | 値の正なし（試験の記録。`THRESH_TAP`の値は`crates/deskcat-tap`が持つ。所在は[firmware/esp32/README.md](https://github.com/wachi-yoshitaka-11-dev/deskcat/blob/develop/firmware/esp32/README.md)の`build構成と通電`の表） |
| [EXP-022](#exp-022-周辺moduleをつないだesp32へpiをuartでつなぎlcdの描画の間の通信を確かめた受け入れ条件6) | [#13](https://github.com/wachi-yoshitaka-11-dev/deskcat/issues/13)受け入れ条件6 | 値の正なし（試験の記録。判定は#13） |
| [EXP-023](#exp-023-piの給電を112001へ差し替えuartの通信を確かめた) | [#446](https://github.com/wachi-yoshitaka-11-dev/deskcat/issues/446)の受け入れ条件4。段階AのPiの給電の差し替え（`PSU-PI-A-02`）と、UART越しの`serial_link`の確認 | 値の正なし（観察の記録。電源の適否は判断していない） |
| [EXP-024](#exp-024-deskcatdの常駐systemdをpiへ導入し電源投入での起動とfailedからの戻しを確かめた) | [#446](https://github.com/wachi-yoshitaka-11-dev/deskcat/issues/446)の受け入れ条件4。deskcatdのsystemd unitの導入、Piの起動での自動の開始、failedとreset-failedでの戻し、ESP32のfirmwareの特定 | 値の正なし（観察の記録。電源の適否は判断していない） |
| [EXP-025](#exp-025-追加ledの点灯試験赤だけ白だけ両方) | [#514](https://github.com/wachi-yoshitaka-11-dev/deskcat/issues/514)の追加LED（白＝GPIO2、赤＝GPIO5）の点灯試験（赤だけ・白だけ・両方） | 値の正なし（観察の記録。起動時の電位・電流・rail電圧は計測していない） |
| [EXP-026](#exp-026-piの独り言show_textをlcdへ出し受理と拒否のackと表情の戻りを確かめた) | [#23](https://github.com/wachi-yoshitaka-11-dev/deskcat/issues/23)の実機確認。Piの`deskcatd`の独り言（`show_text`）、受理と拒否のACK、表示期限の後の表情の戻り | 値の正なし（試験の記録。描画時間とRAMの最大使用量は測っていない） |
| [EXP-027](#exp-027-pi-zero-wでdeskcatdを直接buildしhttps接続とsystemd-credentialと偽esp32での常駐を観察した) | [#522](https://github.com/wachi-yoshitaka-11-dev/deskcat/issues/522)の[ADR-0026](../decisions/0026-cloud-speech-generation.md)の決定2・3・5・7が確認を求める項目のうち、Piの上の作業（直接build、キーなしのHTTPS接続、systemd credential、偽ESP32での常駐） | 値の正なし（観察の記録。ADR-0026の確認項目を満たしたとは書かない。実ESP32との常駐と`--cloud-speech`有効時は未確認） |
| [EXP-028](#exp-028-sg90の初回のサーボ動作の試み測定用buildジャンパー線の接続2回試みた) | [#17](https://github.com/wachi-yoshitaka-11-dev/deskcat/issues/17)の初回のサーボ動作の試み（測定用build `bench-servo-test-17`、ジャンパー線の接続、PTC直列。2回） | 値の正なし（観察の記録。サーボの線の並び、電流・transient、1回目の動きが指令だったことは確かめていない。**#17の受け入れ条件は満たしていない**） |
| [EXP-029](#exp-029-piのserial_linkで実portgpio-uartdevserial0を開き行の往復とprotocolの往復と信号線を外したときの観察を行った) | [#11](https://github.com/wachi-yoshitaka-11-dev/deskcat/issues/11)の実port（GPIO UARTの`/dev/serial0`、115200）での`serial_link`の実行（600秒）と、信号線を抜いた観察（少なくとも1分55秒）。存在しないpathのopen失敗をPi上で別に見た（実portの切断ではない） | 値の正なし（観察の記録。`boot`→ACK→`get_status`→`status`と`ping` 3件のACKを実portで観察した。切断は観測されず、**#11の受け入れ条件3・4は実portで得られていない**。非通電の確認の項目2〜4と条件6の数値は申告だけ） |
| [EXP-030](#exp-030-sg90の測定用buildgo17入りでサーボを接続しない状態と接続した状態のpwmac投入と動作時の5-vと33-vの変化をarduinoで記録した) | [#17](https://github.com/wachi-yoshitaka-11-dev/deskcat/issues/17)の受け入れ条件2・5・6（段1・段1b・段2と再駆動2回） | 値の正なし（観察の記録。条件5の値は`HW-TBD-034`が未解決のため合否を導かない） |
| [EXP-031](#exp-031-bme280env-01の試験buildenv-sample-16でraw値と変換値を観測しswitchbotの表示と並べた) | [#16](https://github.com/wachi-yoshitaka-11-dev/deskcat/issues/16)の実機確認。BME280（`ENV-01`）のraw値と変換値の観測、`MEAS-04`（SwitchBot）の表示との並置 | 値の正なし（観測の記録。確度・気圧・timeout・disconnect・CRC・not-readyは取れていない） |
| [EXP-032](#exp-032-piのserial_linkで実portgpio-uartを開きlink-probeによる切断の判定と再接続の上限11とplay_motionの拒否の4経路12を観察した) | [#11](https://github.com/wachi-yoshitaka-11-dev/deskcat/issues/11)の実port（GPIO UARTの`/dev/serial0`、115200）でのlink probeによる切断の判定と再接続の上限の観察と、[#12](https://github.com/wachi-yoshitaka-11-dev/deskcat/issues/12)の`play_motion`の拒否4経路の確認 | 値の正なし（観察の記録。受け入れ条件を満たしたとは書かない。「1回の喪失判定と回復」だけの観察、実motionの非二重実行は取れていない） |
| [EXP-033](#exp-033-accel-01adxl345の静止sampleaccel-sample-15の初回通電) | [#15](https://github.com/wachi-yoshitaka-11-dev/deskcat/issues/15)の静止sample（`accel-sample-15`、ESP32の`3V3` pin給電、LCDは切り離し） | 値の正なし（観察の記録。offset、個体の感度、noiseの下限は確かめていない） |
| [EXP-034](#exp-034-sg90の90度指令でshuntを戻りに入れた配線ユーザーの申告導通は未確認でac投入時と動作時のarduinoの読みとreset回数を記録した) | [#17](https://github.com/wachi-yoshitaka-11-dev/deskcat/issues/17)の90度指令の測定窓。shunt（`MEAS-01`）をサーボのGNDの戻りに入れた配線（ユーザーの申告。導通は未確認）でのArduinoの読み（AC投入時と動作時。記録Bは欠番1件を含む。位置は動作の約28秒前）と、ESP32のreset回数 | 値の正なし（観測の記録。電流への換算の確度は主張しない。`HW-TBD-034`は未解決） |
| [EXP-035](#exp-035-サーボを外し既知の負荷で戻りの経路の抵抗を調べa0の読みと電流の関係を記録した) | [#17](https://github.com/wachi-yoshitaka-11-dev/deskcat/issues/17)の案2の窓。サーボを外し、`EXP-034`の戻りの経路へ330 Ωの並列の負荷（10本・20本）をつないだときのArduinoの読み（A0）と、レーン間の電圧。段2bで、負荷20本のまま戻りの経路を6区間に分けた電圧降下（`DT830B`の`200 mV`レンジ）。窓の終わりにサーボ系の線を外した | 値の正なし（観測の記録。サーボの電流は主張しない。`HW-TBD-034`は未解決） |
| [EXP-036](#exp-036-bme280env-01の変換時間をoversampling-1倍と16倍で観察しその間のheartbeatの間隔を記録したenv-sample-16とenv-sample-16-slow) | [#16](https://github.com/wachi-yoshitaka-11-dev/deskcat/issues/16)の受け入れ条件5（遅い変換が上位taskをblockしない）の実機観察。`env-sample-16`（oversampling ×1）と`env-sample-16-slow`（×16）を、起動ごとの`env_conversion`の所要時間と、heartbeat・health snapshotの間隔で比べた。各3回、30秒ずつ | 値の正なし（観測の記録。BME280の確度、受け入れ条件5の判定は主張しない） |
| [EXP-037](#exp-037-lcdをつないだesp32へmem-probe-23のbuildaと製品buildbを書き込みpiの独り言show_textで描画時間とheapstackを観察した) | [#23](https://github.com/wachi-yoshitaka-11-dev/deskcat/issues/23)の実機の窓。LCDをつないだESP32へ、`mem-probe-23`のbuild（A）と製品build（B）を書き込み、Piの独り言（`show_text`）の描画時間（`accept_to_draw_ms`）と、Aの`mem_probe`（空きheap、最小の空きheap、main taskのstack残量）を、固定文（10字・13字）で観察した | 値の正なし（観測の記録。RAMの最大使用量は測っていない。`PROTO-TBD-007`は未解決。BのESP32のログは取れていない） |
| [EXP-038](#exp-038-touch-sample-14のbuildでlcd-module上のxpt2046touch-01のraw値をtouch用5本を足した配線で観察した) | [#14](https://github.com/wachi-yoshitaka-11-dev/deskcat/issues/14)の実機の窓。touch用の5本を足し、`touch-sample-14`のbuildでXPT2046のraw値（X・Y・Z1・Z2、`T_IRQ`のlevel）をidleと操作の間に観察した | 値の正なし（観測の記録。操作の指示35回に対し`irq_low=1`の連続する塊は9個で、原因は調べていない。受け入れ条件の判定は書かない） |
| [EXP-039](#exp-039-製品buildfeatureなしでadxl345accel-01を叩きtappedがpiへ届いてsurprisedがlcdに出るまでを観察した) | [#22](https://github.com/wachi-yoshitaka-11-dev/deskcat/issues/22)の実機の窓。製品build（featureなし）で、ADXL345のmoduleを指で軽く叩いた間の経路（`tap_detected`→`tapped`→Pi→`set_expression Surprised`→`face_drawn`）と、静止区間の`tap_detected`の件数を観察した | 値の正なし（観測の記録。12件の標本で`B − A`は540〜550 ms。静止区間は1回目60秒で0件、取り直しは`deskcatd`が止まっていてPiに届く経路ではない。Pi側のlogに受理の行は無い。受け入れ条件の判定は書かない） |
| [EXP-040](#exp-040-製品buildfeatureなしを入れ替えたdeskcatddevelop-c9c3d25につないでtapのsurprisedまでをpi側の受信時刻つきで取りpiに届く経路で静止区間を2回取った) | [#22](https://github.com/wachi-yoshitaka-11-dev/deskcat/issues/22)の2回目の実機の窓。製品build（featureなし）を、入れ替えた`deskcatd`（develop `c9c3d25`）につなぎ、ADXL345のmoduleを叩いた間の経路をPi側の受信時刻つきで取り、Piに届く経路で静止区間を2回取った | 値の正なし（観測の記録。ESP32の`Send`は9件、Pi側の`tapped_received`は9件、`B − A`は540〜590 ms（8件）、静止区間の`tap_detected`は60秒×2とも0件。受け入れ条件の判定は書かない） |
| [EXP-041](#exp-041-touch-sample-14とtouch-lcd-14をtouch用5本を足した配線で動かしmarkの時刻つきで見逃しを数えlcdを描きながらtouchを読んだ) | [#14](https://github.com/wachi-yoshitaka-11-dev/deskcat/issues/14)の2回目の実機の窓。製品build（書き込みなし）でLCDの描画を目視し、`touch-sample-14`で操作ごとの`MARK`と`T_IRQ`の変化の時刻を突き合わせ、`touch-lcd-14`でLCDを描きながらtouchを読んだ | 値の正なし（観測の記録。受け入れ条件の判定は書かない） |
| [EXP-042](#exp-042-bme280env-01の試験buildenv-sample-16-repeatで変換を繰り返す間のheartbeatの間隔switchbotとの並置橙の線sdiを抜いた起動を観察した) | [#16](https://github.com/wachi-yoshitaka-11-dev/deskcat/issues/16)の受け入れ条件3・4・5の実機観察。変換を繰り返す試験build（`env-sample-16-repeat`）で、heartbeatの間隔とmax_read_gap_msを5回の起動で取り、SwitchBotとBME280の値を3点並べ、橙の線（SDI）を抜いた起動で`env_fault`の分類を見た | 値の正なし（観測の記録。確度、not-ready・`i2c_timeout`の実機での出力、受け入れ条件の判定は書かない） |
| [EXP-043](#exp-043-accel-01adxl345の静止sampleを5姿勢で取りaccel-sample-15叩く強さを段階づけてtap_detectedを合図の時刻つきで数えたtap-21) | [#15](https://github.com/wachi-yoshitaka-11-dev/deskcat/issues/15)の受け入れ条件の実機観察。`accel-sample-15`で5姿勢の静止sampleを取って3軸のoffsetと感度をあてはめ、`tap-21`で叩く強さを段階づけて`tap_detected`を合図の時刻つきで数えた | 値の正なし（観測の記録。受け入れ条件の判定は書かない） |
| [EXP-044](#exp-044-製品buildfeatureなしdevelop-f3a3a97をesp32に書き込みdeskcatddevelop-c9c3d25につないで撫で長押し軽く触れるのstroke判定の回数とhead_touchedからhappyまで叩く回帰を観察した) | [#21](https://github.com/wachi-yoshitaka-11-dev/deskcat/issues/21)の実機の窓。製品build（develop `f3a3a97`）を書き込み、`deskcatd`につないで、撫で・長押し・軽く触れるの`stroke`判定の回数と、`head_touched`から`Happy`まで、叩く回帰を観察した | 値の正なし（観測の記録。受け入れ条件の判定は書かない） |
| [EXP-045](#exp-045-sg90の90度指令と105度指令で端子台に付けたシャントの両端電圧をarduinoで記録しac投入時と動作時の読みとreset回数を取った) | [#17](https://github.com/wachi-yoshitaka-11-dev/deskcat/issues/17)の実機の窓。シャントの足を端子台の穴へ直接入れ、戻りの経路からブレッドボードの接点を外した配線で、90度指令（Run 1）と105度指令（Run 2。取り直し）のAC投入時と動作時のA0（Arduino）の読みとreset回数を記録した | 値の正なし（観測の記録。受け入れ条件の判定は書かない） |
| [EXP-046](#exp-046-mem-probe-23のbuildへshow_textの最悪入力を送りackと描画時間とheapとstackを取りキー無しのcloud-speechの起動を観察した) | [#23](https://github.com/wachi-yoshitaka-11-dev/deskcat/issues/23)の実機の窓（`PROTO-TBD-007`）。`mem-probe-23,face-21,tap-21`のbuildへ、Piの送り手からshow_textの最悪入力（20字・duration 30000 msの受理と、duration 0・30001、21字、884 byteの拒否）を送り、ACK、`accept_to_draw_ms`、`mem_probe`（空きheap、最小の空きheap、main taskのstack残量）を取り、キー無しの`--cloud-speech`の起動（Piのwarn、ローカルのshow_text）を観察した | 値の正なし（観測の記録。製品build（撫で付き）の絶対のメモリの余裕は測っていない。受け入れ条件と`PROTO-TBD-007`の判定は書かない） |
| [EXP-047](#exp-047-2-channelの内部11-v基準のarduino-loggerでa0とa1のchラベルのずれと同じ点の差をarduinoだけで取り無給電のpwmをa0とa1で記録した) | [#17](https://github.com/wachi-yoshitaka-11-dev/deskcat/issues/17)の実機の窓A。2 channel・内部1.1 V基準のArduino loggerを、C−1（Arduino だけ。A0＝3V3・A1＝GND、両方GND、両方を分圧の中点）とC0（AC なし・PWM・サーボのプラグ付き）で確かめ、chラベルのずれ、同じ点の差、無給電のPWMのA0・A1の読みを記録した | 値の正なし（観測の記録。受け入れ条件の判定は書かない） |
| [EXP-048](#exp-048-端子台に付けたシャントの両端電圧をac投入と小動作と330オームの抵抗の並列の既知の負荷でarduinoとdt830bに並べて取った) | [#17](https://github.com/wachi-yoshitaka-11-dev/deskcat/issues/17)の実機の窓B。端子台に付けたシャントの両端電圧を、AC投入と小動作（D）と、330 Ωの並列の既知の負荷（E1・E1b）で、Arduinoの読みと`DT830B`の直接の読みに並べた。ADCは電流によらず約3.6 mV小さく出た（原因は未特定） | 値の正なし（観測の記録。受け入れ条件の判定は書かない） |
| [EXP-049](#exp-049-5-vと3v3の電圧をac投入と小動作のときにarduinoで取り3v3は取れ5-vは取れなかった) | [#17](https://github.com/wachi-yoshitaka-11-dev/deskcat/issues/17)の実機の窓（5 V・3V3）。サーボ側5 V（1/2分圧）と3V3を、AC投入と小動作のときにArduino（AVCC基準）で記録した。3V3は、AC前・AC投入・待機・動作付近の各区間で678〜681カウント（記録全体では676〜682）で変わらず、5 V（A0）は1023に張り付いて取れなかった。取り直しは行わなかった | 値の正なし（観測の記録。受け入れ条件の判定は書かない） |
| [EXP-050](#exp-050-662入りの製品buildで撫でる叩くなどを各5回取り撫でたときのtapは0件だった) | [#21](https://github.com/wachi-yoshitaka-11-dev/deskcat/issues/21)の実機の窓（#662入りの製品build）。撫でる・叩く・撫でて離してすぐ叩く・叩いてすぐ撫でるを各5回。撫での窓（最初の5回と取り直しの5回）でtapを見つけた件は0。離れて1250〜1820 msのtap 24件はすべて`DropTouch`。保留は10件とも300 ms | 値の正なし（観測の記録。判定は[#21のcomment](https://github.com/wachi-yoshitaka-11-dev/deskcat/issues/21#issuecomment-6499717081)） |
| [EXP-051](#exp-051-ベンチ電源psu-bench-01を無負荷と負荷ボードで初めて使いccに入ることを確かめた) | [#525](https://github.com/wachi-yoshitaka-11-dev/deskcat/issues/525)。`PSU-BENCH-01`（`SPS-3010V`）の新しい電源の初回使用（無負荷と負荷ボード。DeskCat の回路はつながない） | 値の正なし（初回使用の記録。`PSU-BENCH-01`の行は[hardware-bom.md](hardware-bom.md)） |
| [EXP-052](#exp-052-組み直した3枚の板で初回通電しbringup-led-514のled点灯と導通を取った) | [#512](https://github.com/wachi-yoshitaka-11-dev/deskcat/issues/512)・[#514](https://github.com/wachi-yoshitaka-11-dev/deskcat/issues/514)の実機の窓。ブレッドボードを3枚（ESP32の板、LCDの板、センサーの板）に組み直し、通電前の導通20項目、ESP32のUSBだけの初回通電、`bringup-led-514`の書き込み、LEDの点灯（赤→白→2本→白の点滅）、抵抗の両端と3V3の電圧を取った。導通20項目は期待どおり、LEDは設計どおりに点き、加速度センサー（`0xe5`）と温度センサー（`0x60`）のI2C読み出しが成功した | 値の正なし（観測の記録。判定は書かない） |
| [EXP-053](#exp-053-専用キーをpiへ置き偽esp32を相手に--cloud-speechを4件通した) | [#522](https://github.com/wachi-yoshitaka-11-dev/deskcat/issues/522)の実機の窓。専用キーをPiへ置き、現在のdevelop `f2c4ea1`を直接buildして、偽ESP32を相手に`--cloud-speech`で動かした。4件の`show_text`が届いた | 値の正なし（観測の記録。専用Workspaceへの計上は未確認で、実ESP32・LCDでの表示も未確認） |
| [EXP-054](#exp-054-首の固定方法を発泡スチロールの天板と底板に非通電で当てた) | [#34](https://github.com/wachi-yoshitaka-11-dev/deskcat/issues/34)の実機の窓（非通電）。サーボ本体を天板の切り欠きへ入れて耳の上に結束バンドをかぶせ、十字形ホーンを底板へ結束バンドで留めた | 値の正なし（観測の記録。詳細は[enclosure-and-neck.md](enclosure-and-neck.md#現物に当てた記録2026-11-03非通電発泡スチロール)。段ボールでの当て合わせと、頭の重さをかけた保持は未確認） |
| [EXP-055](#exp-055-段0の1回目の窓校正build0fd97bfの値でサーボを接続せずpwmの波形と拒否を取り動作が141-msで止まった) | [#18](https://github.com/wachi-yoshitaka-11-dev/deskcat/issues/18)の段0の1回目の窓。サーボを接続せず、PWMの波形（周期19.97〜20.07 ms、幅1.56〜1.66 ms）と拒否を取った。動作は2回とも約141 msで止まった | 値の正なし（観測の記録。判定の語を書かない） |
| [EXP-056](#exp-056-段0の2回目の窓703入りの校正buildでmotion-calib-103を3回出し3回とも約101-msで止まった) | [#18](https://github.com/wachi-yoshitaka-11-dev/deskcat/issues/18)の段0の2回目の窓。#703入りの校正buildで時刻の列を取り、動作は3回とも約101 msで止まった | 値の正なし（観測の記録。判定の語を書かない） |
| [EXP-057](#exp-057-段0の3回目の窓704入りの校正buildでthreadphasestopの時刻の列を取り動作が約141-msと約101-msで止まった) | [#18](https://github.com/wachi-yoshitaka-11-dev/deskcat/issues/18)の段0の3回目の窓。#704入りの校正buildで、threadとphaseとstopの時刻の列を取った。動作は約141 msと約101 msで止まった | 値の正なし（観測の記録。判定の語を書かない） |
| [EXP-058](#exp-058-段0の4回目の窓書き直さない校正buildで動作1回ごとのパルスの本数をarduinoで数え同じ回のlogと並べた) | [#18](https://github.com/wachi-yoshitaka-11-dev/deskcat/issues/18)の段0の4回目の窓。書き直さない校正buildで、動作1回ごとのパルスの本数をArduinoで数え、同じ回のlogと並べた（4本・4本・2本） | 値の正なし（観測の記録。判定の語を書かない） |
| [EXP-059](#exp-059-段0の5回目の窓708入りの校正buildで出力を3-tickに1回へ間引いた動作のtickの間隔と出力したtickの時間を取りstopbusyratelimitedmax_commandsの後を観察した) | [#18](https://github.com/wachi-yoshitaka-11-dev/deskcat/issues/18)の段0の5回目の窓。[#708](https://github.com/wachi-yoshitaka-11-dev/deskcat/issues/708)入りの校正buildで、tickの間隔（18.44〜21.55 ms）と出力したtickの時間（最大632 µs）を取り、STOP・Busy・RateLimited・max_commandsの後を観察した | 値の正なし（観測の記録。判定の語を書かない） |
| [EXP-060](#exp-060-段1の前の窓と段1task-wdt-の-panic-resetpsu-の負極と-esp32-の-gnd-の読みi_limの平坦部4-countを取り段1で-servo-へ指令を出し発熱の実測は行わなかった) | [#18](https://github.com/wachi-yoshitaka-11-dev/deskcat/issues/18)の段1の前の窓と段1。task WDT の panic reset、PSU の−と ESP32 の GND の読み、`I_lim`の平坦部を取り、段1で servo へ指令を出した。発熱の実測は行わなかった | 値の正なし（観測の記録。判定の語を書かない） |
| [EXP-061](#exp-061-accel-01adxl345で静止机を叩く机を手で揺らすの3つを各30秒取ったaccel-sample-15) | [#15](https://github.com/wachi-yoshitaka-11-dev/deskcat/issues/15)・[#685](https://github.com/wachi-yoshitaka-11-dev/deskcat/issues/685)の材料。`accel-sample-15`で、静止・机を叩く・机を手で揺らすの3つを、各30秒（5秒×6窓）取った | 値の正なし（観測の記録。判定の語を書かない） |
| [EXP-062](#exp-062-窓-b製品-buildno-touch-487を-pi-とつなぎ表情温湿度叩く揺れcompanion独り言713-を見た夜と朝の2回) | [#487](https://github.com/wachi-yoshitaka-11-dev/deskcat/issues/487)・[#713](https://github.com/wachi-yoshitaka-11-dev/deskcat/issues/713)。製品 build（`no-touch-487`）を Pi とつなぎ、表情・温湿度・叩く・揺れ・Companion・独り言・#713 を夜と朝の2回で見た | 値の正なし（観測の記録。判定の語を書かない） |

**大容量の生dataはこのrepositoryへ入れていない。**保存場所は
[development-foundation-plan.md](../planning/development-foundation-plan.md)の
「実験ログと大容量計測データの正式な保存場所を最初の実験Issueで決める」が未確定であり、
**この文書の新設をもってその決定としてよいかは人間の確認を待つ。**
確定するまで、CSV等は`hardware/measurement/.gitignore`で追跡対象から外している。

---

## EXP-001: 連続streamingの実効sample rate

- **日時**: 2026-08-17（初回測定）、**2026-08-18（治具を直して取り直し）**。いずれもJST
- **目的**: `HW-TBD-034`の未解決3点のうち、(2)「SRAM 2 KBに対する取得方式」と
  (1)「基準電圧の校正」の測定側を解く。**連続streamingで何Sample/s出るかを実測し**、
  `Sample rateとlog形式`の必須要件と突き合わせる。あわせてAV<sub>CC</sub>基準での
  内蔵1.1 V基準の生ADC値を採る
- **仮説**:
  1. 連続streamingは`Sample rateとlog形式`の必須要件を2 channel同時で満たす（**要件値はここへ再掲しない**）
  2. `DS40002061B` Table 24-1 の`Auto Triggered conversions`は13.5 cyclesであり、
     ADC clock 125 kHzでは合計約9.26 kSample/sになる
  3. free running modeでISRから`ADMUX`を書くと、§24.5.1により結果のchannel帰属が
     1変換ぶん遅れる。したがって素朴に現在の`ADMUX`でtagを付けるとlabelが入れ替わる
- **ハードウェア構成**:
  - 測定器: Arduino Uno R3（`MEAS-02`。`BOARD MODEL UNO R3`／`ATMEGA328P-PU`／`MEGA16U2`）
  - USB idは`2341:0043`（Arduino SA, Uno R3 CDC ACM）として認識。**serial番号は記録しない**
  - **DeskCat側へは一切接続していない。**Arduino単体とPCだけで完結する
  - 開発端末: 実機のLinux（Ubuntu 24.04.4、kernel 7.0.0-28-generic、x86_64、
    `systemd-detect-virt: none`）。ADR-0005の要求を満たす
- **回路 revision**: 配線は治具のみ。`A0` → Arduinoの`3V3` pin、`A1` → Arduinoの`GND`。
  **抵抗を入れていない。**分圧も外部電源も使っていない。
  2 channelへ意図的に異なる電圧を入れて、channel帰属の入れ替わりを検出できる形にした
- **firmware commit**: 治具は`hardware/measurement/`配下にある。初回測定時はrepository commit `3a34aef`、
  取り直し時は同じbranchのreview指摘修正後（`測定治具のreview指摘4件を直す`）である
- **電源条件**: ArduinoはPCのUSBからのみ給電。`VUSBMax` 5.5 V。監視対象への通電は行っていない。
  **DeskCat側のrailを通らないことの裏付けは、公式Power Treeのblock図の粒度までである**
  （`手持ち候補の現物識別`）。**schematic粒度での一致は未確認であり、独立給電は候補条件のままである。**
  この実験はそれを前進させていない
- **設定**:
  - 治具: `hardware/measurement/arduino-transient-logger`（連続streaming）と
    `hardware/measurement/arduino-vref-calibrate`（基準電圧）
  - 集計: `hardware/measurement/adc_stream_rate.py`（Python 3標準ライブラリのみ）
  - toolchain: `arduino-cli` 1.5.1（公式releaseのtarballをsha256照合して導入）、
    `arduino:avr` 1.8.8、`avr-gcc` 7.3.0-atmel3.6.1-arduino7、`avrdude` 8.0.0-arduino1
  - ADC基準はAV<sub>CC</sub>（`REFS1:0 = 01`。`DS40002061B` Table 24-3）
  - 取得方式は**連続streaming**。burst captureではない
  - `dialout` group追加後、再loginしていないため全serial操作を`sg dialout -c '...'`で実行
  - **周囲温度: 未測定。**温度計を用意していなかった。**内蔵基準は温度で動くため、
    基準電圧側の値は温度条件を伴わない測定である**（作業1のsample rateは温度条件を要さない）
- **手順**:
  1. board無しで parser の自己testを通す（`test_adc_stream_rate.py`、22 case）
  2. sketchをcompileし、`arduino-cli compile --upload`でuploadする
  3. 各条件でstreamingを受け、届いたsample数・取りこぼし・block欠番を数える
     （初回測定は8〜10秒、取り直しは各条件10秒。採用区間は9.85〜9.97秒、受信blockは750〜1502件）
  4. 起動直後の4 blockを捨てる（過渡を除くため。捨てた数も報告させる）
  5. channel別の生ADC値の大小関係が、手順で入れた既知電圧と一致するか確認する
  6. 基準電圧側は単発変換で`GND`／`VBG`／`A0`／`A1`を読み、切替直後の生値も並べて記録する

### raw data

sample rateの測定（各条件10秒。`ADC clock = F_CPU / 2^ADPS`、F_CPU = 16 MHz）。

| channel数 | ADPS | ADC clock | baud | 実効rate 合計 | 1 ch当たり | 取得rate（Arduino時計） | ISRが捨てたsample | block欠番 | 予約bit破れ |
|---|---|---|---|---|---|---|---|---|---|
| 2 | 7 | 125 kHz | 1000000 | 9613.9 | 4807.0 | 9615.4 | 0 | 0 | 0 |
| 2 | 7 | 125 kHz | 500000 | 9617.9 | **4808.9** | 9615.4 | 0 | 0 | 0 |
| 2 | 7 | 125 kHz | 115200 | 5379.3 | 2689.7 | 9615.4 | **41851** | 0 | 0 |
| 2 | 6 | 250 kHz | 1000000 | 19236.7 | **9618.4** | 19230.8 | 0 | 0 | 0 |
| 2 | 6 | 250 kHz | 500000 | 19232.8 | 9616.4 | 19230.8 | 0 | 0 | 0 |
| 1 | 7 | 125 kHz | 1000000 | 9618.0 | 9618.0 | 9615.4 | 0 | 0 | 0 |
| 1 | 6 | 250 kHz | 1000000 | 19235.1 | 19235.1 | 19230.8 | 0 | 0 | 0 |

単位はSample/s。「実効rate」はPCの壁時計（`time.monotonic()`）基準で届いたsample数から、
「取得rate」はArduino自身の`micros()`基準でISRが取得したsample数から出した。
**どの条件でも区間収支が閉じた**（`取得 = 届いた + 捨てた + ring滞留の増減 + 回線上の欠落`）。
header XOR不一致は全条件で0である。

**太字の2行は[power-budget.md](power-budget.md)の`手持ち候補に固有の制約: SRAMと取得方式`が
要件照合用に抜粋している条件である。**同節が要件と照合する値の正であり、この表は未加工の観測の正である。
**再測定したら両方を更新する**（片方だけ古くする事故を実際に起こしている。下記`訂正`）。

**この表は2026-08-18に取り直した値である。**`dropped` を32 bitへ広げてheaderが24 Bになったため、
**同じ条件を再度すべて測り直した。**125 kHz・2 chでは反復しても0.1 %以内で再現している
（4807.0／4808.9／4808.7 Sample/s）。2026-08-17の初回測定は、
壁時計rateの分子と分母の区間が揃っておらず**約0.5 %低く出ていた**（下記`訂正`）。

channel別の生ADC値（10 bit、AV<sub>CC</sub>基準）。

| 条件 | ch0（`A0` = `3V3` pin） | ch1（`A1` = `GND`） |
|---|---|---|
| ADPS 7（125 kHz） | min 672 / max 676 / mean 673.2 | min 0 / max 0 / mean 0.0 |
| ADPS 6（250 kHz） | min 672 / max 676 / mean 673.2〜673.4 | min 0 / max 0 / mean 0.0 |

基準電圧側（単発変換、ADPS 7、n = 64、切替後8変換を捨てた。4回反復）。

| 入力 | MUX | min | max | mean | mean / 1024 |
|---|---|---|---|---|---|
| `0V (GND)` | `1111` | 0 | 0 | 0.000 | 0.000000 |
| `1.1V (VBG)` | `1110` | 225 | 226 | 225.828〜225.984 | **0.220535〜0.220688** |
| `A0` | `0000` | 673 | 674 | 673.297〜673.437 | 0.657516〜0.657654 |
| `A1` | `0001` | 0 | 0 | 0.000 | 0.000000 |

**分母は1024である**（§24.7 `ADC = (V_IN × 1024) / V_REF`）。**慣習の1023ではない。**

切替直後の生値（`VBG`。捨てる必要があることを値で示すために並べた）。

```text
# settle VBG : 126 226 226 226 226 226 226 226 226 226
# settle VBG : 127 226 226 226 226 226 226 226 226 226
# settle VBG : 158 226 226 226 226 226 226 226 226 226
# settle VBG : 161 226 226 226 226 226 226 226 226 226
```

### 観測結果

1. **必須要件は2 channel同時で満たした。**最も遅い条件でも1 channelあたり2689.7 Sample/sである。
   ただしその条件（baud 115200）は取りこぼしを41851件出しており、**rateを満たすことと
   取りこぼしが無いことは別である。**
2. **baud 115200はtransportが律速している。**1 blockはheader 24 B + payload 256 Bで
   128 sampleを運ぶため1 sampleあたり**2.1875 B**である。
   **ここで公称baudを使うと計算が実測より低く出る。**`DS40002061B` Table 20-7 は
   f<sub>osc</sub> 16 MHz・U2X=1・115.2 kbps の`UBRRn`を**16**、**Error を +2.1 %**としており、
   実baudは約117.6 kbpsになる。8N1では1 byteに10 bitを要するので約11765 B/sであり、
   **2.1875 Bで割ると約5378 Sample/sとなる。実測5379.3はこれと0.02 %で一致する。**
   なお500000と1000000は同表で Error 0.0 % であり、この効果は出ない
   （どちらもADC側が律速し、取りこぼしは0になった）。
3. **取得rateはchannel数に依存しなかった。**1 chと2 chで合計取得rateが同じ値になり、
   1 channelあたりのrateは合計をchannel数で割った値と一致した。
4. **仮説2は外れた。**取得rateは全条件で`ADC clock / 13`と一致した
   （125000 / 13 = 9615.38に対し実測9615.4、250000 / 13 = 19230.77に対し実測19230.8）。
   Table 24-1が`Auto Triggered conversions`に与える13.5 cyclesとは一致しない。
   **この差の機序はこの測定では確定していない。**実測値を採り、差がある事実を記録する。
5. **仮説3は当たった。**§24.5.1の1変換遅れを織り込んだchannel帰属で、
   全条件で`ch0 > ch1`（673 対 0）となり、入れた既知電圧の大小関係と一致した。
   **段数を誤ると値は正常に見えたままlabelだけが入れ替わるため、
   異なる既知電圧を入れることがこの確認の前提である。**
6. **`DS40002061B` §24.4の「bandgapは安定するまで最初の値が誤りうる」が実測で見えた。**
   `VBG`へ切り替えた直後の1変換だけが126〜161とばらつき、以降は226で安定した。
   **ただしこれは4 traceの観測であり、しかも周囲温度を記録していない1条件下のものである。**
   **「捨てるのは1変換で足りる」と一般化しない。**AV<sub>CC</sub>・温度・channel切り替えの
   条件が変われば必要数が変わりうる。**手順は`CAL_DISCARD=8`を維持する**（余裕を持たせた値であり、
   1変換で足りたのはこのrunに限った観測である）。
7. **ADC offsetは現分解能では検出されなかった。**内部の`0V (GND)`（MUX `1111`）と、
   `GND`へ配線した`A1`がいずれも0を返した。
8. `A0`のmin/max幅は125 kHzでも250 kHzでも4 LSB（672〜676）に収まり、
   **この測定では両者の差を分離できなかった。**§24.4 は250 kHzが最大分解能の規定外である
   と述べているが、**その影響をこの観測で定量してはいない。**
9. **transportは常に無損失とは言えない。**2026-08-18の1回目の取り直しでは、7条件のうち2条件で
   予約bitの破れを1件検出し、その block を読み捨てた結果 block欠番が1件出た
   （約750〜1500 blockに対し1件）。**parserが検出して読み捨て、収支もその欠落を正しく説明した。**
   **`dropped`を32 bitへ広げた後の取り直しでは、7条件すべてで0件だった。**
   したがって**発生率は低いが0とは言えない**。取りこぼし（ISRがringに入れられなかった件数）とは
   別の事象である。
10. **壁時計基準と Arduino 時計基準の rate が 0.1 % 以内で一致した。**
   初回測定でこの2つに約0.5 %の差があったのは測定系の集計の誤りであり、下記`訂正`のとおりである。

### 訂正（2026-08-18）

**初回測定で記録した値には、測定系の集計に起因する誤りがあった。**
[PR #145](https://github.com/wachi-yoshitaka-11-dev/deskcat/pull/145)の自動reviewの指摘を
2巡受けて確認し、**いずれも妥当であったため治具を直して同じ条件を取り直した。**
上の`raw data`は最後に取り直した値である。**wire formatが変わった回では全条件を再測定している。**

| 何が誤っていたか | 影響 | 直し方 |
|---|---|---|
| 壁時計rateの分子と分母が同じ区間でなかった（捨てたblockの時間が分母に残っていた） | **実効rateが約0.5 %低く出ていた。**壁時計と`micros()`の差を「window端の副作用」と誤って説明していた | 分子・分母をともにblock受信時刻の区間へ揃えた |
| ADC変換式の分母に1023を使っていた | 校正比が約0.098 %ずれていた | §24.7 の `ADC = (V_IN × 1024) / V_REF` に従い1024へ直した |
| `taken`がring滞留分を含むことを収支から差し引いていなかった | 正常な測定に対して「不整合」を誤報しうる状態だった（実測では誤報は出ていない） | headerへ`pending`を追加して差し引いた |
| CSVの時刻indexを単調加算だけで進めていた | 回線上でblockを失うと以降の時刻ずれが累積した。**上記9のとおりこの欠落は実際に起きるため、実害のある誤りだった** | blockごとに`taken - pending`から引き直し、`lost_blocks`もguardへ入れた |
| **`dropped`をwire formatで16 bitにしていた** | **baud 115200では10秒で41851件に達するため約16秒でwrapする。**境界では差が0に見え、**CSVのguardを誤って通す** | 32 bitへ広げた（header 22 B → 24 B）。parser・README・testも揃え、桁落ちしないことをtestで固定した |
| **`micros()`のwrapを跨ぐ取得を弾いていなかった** | 約4295秒を超えると`us_delta()`が残余しか返さず、Arduino時計基準のrateとCSVの時刻が誤りになる | `--seconds`を4000未満に制限し、wrapしないPCの単調時計で判定してrateとCSVを抑止した |
| **`Arduino Uno`行に「通電はしていない」が残っていた** | 同じ文書の`MEAS-02`行が初回通電を記録しており、現況が2箇所で食い違っていた | 初回通電の事実へ揃えた |
| **手順に記録したtest件数が古かった** | 実体と合っていなかった | 実数へ揃えた |

**結論は変わっていない。**1 channelあたりの実測値は125 kHzで4808.9 Sample/sとなり、
**依然として目標帯には届かない。**取得rateが`ADC clock / 13`と一致することも変わらない。

### 訂正（2026-08-20）

**測定に使う機材の記載に、現物と食い違うものがあった。**どちらも観測値そのものには影響しない。
`raw data`と`観測結果`は取り直していない。

| 何が誤っていたか | 影響 | 直し方 |
|---|---|---|
| **デジタルテスターの型番を`MAS830L`と書いていた。現物の本体表示は`DT830B`である** | **この実験の観測値には影響しない。**テスターはこの実験では使っていない（`次の実験`で使う予定として挙げていただけである）。**ただし作業2の残りをこの型番で計画していたため、確度の一次資料を誤ったメーカーに求めるおそれがあった** | 現物の本体表示で`DT830B`へ訂正した。**確度・入力インピーダンス・基準温度は本体に表示が無く、依然として未取得である**（[hardware-bom.md](hardware-bom.md)の`MEAS-03`） |
| **oscilloscopeを所有していない前提で方式1の候補をArduino Unoに限っていた** | **この実験の観測値には影響しない。**この実験はArduino Unoで行っており、その結果は有効である。**ただし「独立した外部観測」の候補が1つしか無いという前提が誤っていた** | 2026-08-20に現物の写真で`QUIMAT DSO Shell`の所持が判明したため、[hardware-bom.md](hardware-bom.md)へ`MEAS-05`として登録し、[power-budget.md](power-budget.md)の`方式1`へ候補として並記した。**帯域・sample rate・channel数・確度はいずれも未取得であり、採否は判断していない** |

**この実験の結論は変わらない。**

### 結論

- **仮説1: supported。**連続streamingは必須要件を2 channel同時で満たす。
  **burst captureを採らずに済み、SRAM 2 KBの制約は取得方式の障害にならない。**
- **仮説2: rejected。**上記4のとおり実測は`ADC clock / 13`だった。
- **仮説3: supported。**上記5のとおり。
- **作業2の合格条件は満たしていない。**「換算係数と手順が別の人が同じ結果を再現できる形で
  残っていること」に対し、**周囲温度を記録しておらず**、`DS40002061B`はこの品の内蔵基準の
  温度図を載せていないため**影響を一次資料から見積もれない**。さらに同文書の
  `Calibrated Bandgap Voltage vs. V`<sub>`CC`</sub>（Figure 31-365）が示すとおり
  **内蔵基準はV<sub>CC</sub>にも依存するため、あるAV<sub>CC</sub>で求めた値を
  別のAV<sub>CC</sub>へ持ち込めない。**正は[power-budget.md](power-budget.md)の
  `温度とAV`<sub>`CC`</sub>`の依存が、この品では詰めきれない`にある
- **基準電圧は未解決のままである。**得られたのはAV<sub>CC</sub>に対する比
  （`VBG`が約0.2206）だけで、**絶対電圧にするにはAV<sub>CC</sub>自身の実測が要る。**
  `V_INT_actual = (VBGの生ADC値 / 1024) × AVCC実測`である。
  **デジタルテスター（DT830B）による5 V pinの実測と、テスター自身の確度が未取得であり、
  校正の不確かさは`TBD`である。**確度を超える主張をしない。
- **`HW-TBD-034`はcloseしない。**解いたのは未解決3点のうち(2)と、(1)の測定側だけである。
  (3)「GND topologyへの影響」は未着手であり、**DeskCat側への接続と通電を伴うため
  人間の立ち会いが要る。**
- **`MEAS-02`の採否は未確定である**（**この記録の時点。下の追記を見る**）。
  **追記（2026-09-14）: 採否は決定した。**方式1の記録係はArduino Uno R3単独である（正は[power-budget.md](power-budget.md#測定計画)の`測定器の採否を決定した（2026-09-14）`。**ここへ再掲しない**）。**これとは別の判断として、この品で足りるかは(1)と(3)が解けるまで判定しない。****採否の決定と、足りるかの判定は、同じものではない。**
- **未観測区間について新たな主張をしない。**正本（`ESP32自身のADCは測定対象から独立していない`）は
  未観測区間を3種に分け、**独立した記録係で塞げるのは`brownout／reset中`と`capture window外`の2種だけで、
  `sample間`は残る**と定めている。この実験が示したのは**`capture window外`を塞ぐ取得方式が成立する**ことまでである。
  **`brownout／reset中`は塞げていない。**独立給電がまだ候補条件であり（schematic粒度が未確認）、
  監視対象へ通電もしていない。**`sample間`は方式によらず残る。**
  **（2026-08-22の追記）`EXP-003`で監視対象のESP32へ接続して測定した。**
  **ただし`EXP-003`は静的な条件比較であり過渡を測っていないため、`brownout／reset中`を塞げていないという結論は変わらない。**
  したがって「電源過渡をすべて実測済み」とは扱わない。

### 次の実験

1. **作業2の残り**: DT830Bで5 V pinの実電圧を測り、`V_INT_actual`を確定する。
   あわせて**テスター自身のrange別確度**（`±(x % + n digit)`）と**確度を保証する基準温度**、
   および**測定時の周囲温度（温度計を用意する）**を記録する。
   **AV<sub>CC</sub>依存の扱いも決める**（何Vで校正した値をどこまで適用してよいか）。
   **これが揃うまで校正の不確かさは`TBD`であり、作業2は合格条件を満たさない。**
2. **作業3**: GND topologyの確定とDeskCat側への接続。**通電を伴い、人間の立ち会いが要る。**
   配線図を先に書き、電源off時の導通チェックで図どおりであることを確認してから通電する。
   `5 V railをADCへ直結する条件`に従い、**dividerは既定で残す。**
3. **必要帯域の根拠**（`電源過渡の測定方式のdesign review`で`TBD`）。
   これが確定するまで、ADC clockの既定を規定外の250 kHzへ動かさない。

---

## EXP-002: 内蔵基準電圧の校正（比率法）

**目的**: ATmega328Pの内蔵基準電圧`V_INT`のこの個体の実値を、絶対電圧として確定する。
`HW-TBD-034`作業2。方法の正本は[power-budget.md](power-budget.md)の
`採る校正方法と、2026-08-18時点で採れた値`である。**ここへ方法を再掲しない。**

**実施日**: 2026-08-21。実機Linux。**Arduino Uno R3のUSB給電のみ。servoも外部電源も繋いでいない。**

### 条件

| 項目 | 値 |
|---|---|
| sketch | `hardware/measurement/arduino-vref-calibrate`（`CAL_ADPS`=7、`CAL_DISCARD`=8、`CAL_SAMPLES`=64） |
| ADC clock | 125 kHz（`f_cpu`=16 MHz、`adps`=7）。`DS40002061B` §24.4の50〜200 kHzの規定内 |
| 基準 | `AVCC`（`REFS1:0`=01。Table 24-3） |
| **周囲温度** | **23.4 ℃**（`MEAS-04`。SwitchBot 温湿度計） |
| **`AVCC`実測** | **5.04 V**（`MEAS-03`。DT830B、`V⎓`の20 Vrange） |
| 配線 | `A0`→`3V3` pin、`A1`→`GND` pin のジャンパ2本（`EXP-001`と同じ） |

**`AVCC`は代理値である。**測ったのは電源ヘッダの`5V` pinであり、
ATmega328Pの`AVCC` pinと同一nodeではない（Uno R3では`+5V`からフィルタを経る）。
**直流の差が無視できるという根拠は持っていない。**この限定を付けたまま記録する。

### raw data

serial出力の`VBG`行、n=64を6回反復。

```text
VBG  mux=0xE n=64 min=225 max=226 mean=225.984 ratio=0.220688
VBG  mux=0xE n=64 min=225 max=226 mean=225.984 ratio=0.220688
VBG  mux=0xE n=64 min=225 max=226 mean=225.875 ratio=0.220581
VBG  mux=0xE n=64 min=225 max=226 mean=225.984 ratio=0.220688
VBG  mux=0xE n=64 min=225 max=226 mean=225.984 ratio=0.220688
VBG  mux=0xE n=64 min=225 max=226 mean=225.969 ratio=0.220673
```

同時に採れた他の入力。

```text
GND  mux=0xF n=64 min=0   max=0   mean=0.000   ratio=0.000000
A0   mux=0x0 n=64 min=673 max=674 mean=673.312 ratio=0.657532   (3V3 pinへのジャンパ)
A1   mux=0x1 n=64 min=0   max=0   mean=0.000   ratio=0.000000   (GND pinへのジャンパ)
```

入力切替直後の値（`CAL_SHOW_SETTLE`=10）。**§24.4の安定待ちが見える。**

```text
# settle GND : 0 0 0 0 0 0 0 0 0 0
# settle VBG : 126 226 226 226 226 226 226 226 226 226
# settle VBG : 127 226 226 226 226 226 226 226 226 226
# settle VBG : 151 226 226 226 226 226 226 226 226 226
# settle VBG : 149 226 226 226 226 226 226 226 226 226
```

### 算出

```text
ratio(VBG) の平均 = 0.220668   (min 0.220581 / max 0.220688 / 幅 0.000107)
V_INT_actual      = 0.220668 x 5.04 V = 1.1122 V
```

不確かさの内訳。**いずれも下限であって確度ではない。**

| 由来 | 量 | 相対 |
|---|---|---|
| ADC量子化（±0.5 LSB。10 bit） | ±0.000488（ratio） | 0.221 % |
| `AVCC`実測（20 Vrangeの最小単位10 mV） | ±0.010 V | 0.198 % |
| **合成** | **±0.0033 V** | **0.297 %** |

### 観測結果

1. **`V_INT`の代理値ベースの推定は 1.112 V。不確かさは少なくとも ±0.003 V である。**
   **（2026-08-22の追記）`EXP-005`により、この差は0.1 mV未満と分かった。下の不確かさ ±0.003 V に埋もれるため、その範囲で絶対値として扱える。**
   **以下は2026-08-22より前の記述である。上の追記のとおり`EXP-005`で解消した。**
   **これは絶対値ではない。**AV<sub>CC</sub>として測ったのは`5V` pinであり、   **`AVCC` pinとの差は測っておらず上限も与えていないため、上の±0.003 Vにその差が入っていない。**
2. **`DS40002061B` Table 29-15の規定内である**（min 1.0／typ 1.1／max 1.2 V）。typ から **+12 mV**。
   個体差が±約9 %あるという記載と整合する。
3. **6回の反復の幅は0.000107（ratio）で、量子化1 LSB（0.000977）より小さい。**
   反復間のばらつきは量子化より下にある。
4. **`GND`（`mux=0xF`）は6回すべてで min=max=0 だった。**現分解能でADC offsetは検出されない。
   `EXP-001`と同じ結果である。
5. **`§24.4`の安定待ちが再現した。**`VBG`へ切り替えた直後の1変換だけが126〜151に外れ、
   2変換目以降は226で一定になる。**`CAL_DISCARD`=8はこれを覆う。**
6. `A0`（`3V3` pinへのジャンパ）は 0.657532 × 5.04 = **3.314 V** と出た。
   **これはArduinoの3V3レギュレータ出力であり、ESP32側の3.3 Vではない。**
   `HW-TBD-028`の判定には使わない。
7. **確度は主張していない。**DT830Bのrange別確度はメーカーが公開しておらず
   （取扱説明書にも本体表示にも無い）、**上の±0.003 Vは最小単位と量子化から出した下限である。**

### この記録が主張しないこと

- **温度による補正はしていない。**`DS40002061B`はATmega328Pの内蔵基準の温度依存の図を載せていない
  （`vs. Temperature`はATmega88PAとATmega168PAのみ。328P向けは`vs. V`<sub>`CC`</sub>）。
  **したがって23.4 ℃以外の温度での値をこの記録から導けない。**温度は再現のために記録している。
- **`AVCC`そのものを測ってはいない**（上記のとおり`5V` pinの代理値である）。
- **別のAV<sub>CC</sub>（別のUSB port、別のPC）へこの値を持ち越せない。**
  比率法は測ったAV<sub>CC</sub>に紐づく。
- **`HW-TBD-028`(b)(c)(d)の合否判定には使っていない。**判定は`Blocked`のままである。

### 結論

**（2026-08-22の追記）`EXP-005`で`5V` pinと`AVCC` pinの差の上限を測り、その差が`EXP-002`の不確かさに埋もれることを確認した。****したがって下記の限定は実質的に解消し、作業2は完了した。以下は当時の記録である。**

**（以下は2026-08-22より前の記述である。上の追記のとおり解消した。）**

**作業2は完了していない。**`V_INT`は**代理値に基づく推定として得られただけ**であり、**`5V` pinと`AVCC` pinの差を測るか上限を与えるまで絶対電圧として扱えない**（[PR #158](https://github.com/wachi-yoshitaka-11-dev/deskcat/pull/158)の自動reviewの指摘）。**限定を書いたうえで完了扱いにするのは、限定を書いていないのと同じである。**

**それでも進んだ部分は残る。**方法が確定し、代理値と周囲温度が実測され、
**測定条件（温度、`AVCC`の代理値、ADC clock、反復回数）がすべて記録されたため、別の人が同じ条件を再現できる。**
**再現性は作業2の合格条件の一部であり、それは満たした。**
**残るのは絶対電圧としての確定であり、そのためには`5V` pinと`AVCC` pinの差を測るか上限を与える必要がある。**

## EXP-003: 段階B-1でのGND topologyと入力headroom

**目的**: `HW-TBD-034`作業3のうち、段階B-1で確認できる範囲を実測する。
**確認できる範囲と、確認できない範囲は事前に確定させてある**
（正は[power-budget.md](power-budget.md)の`方式1の記録係をこのtopologyへ足すとき（HW-TBD-034 作業3）`。**ここへ再掲しない**）。

**実施日**: 2026-08-22（**JST**。[CONTRIBUTING.md](https://github.com/wachi-yoshitaka-11-dev/deskcat/blob/main/CONTRIBUTING.md)が`日付はJST（UTC+9）で判断する`と定めている。**UTCでは前日になる**）。実機Linux。**人間が基板のそばで観察している状態で行った。**

### 構成

| 項目 | 内容 |
|---|---|
| 記録係 | Arduino Uno R3。sketchは`hardware/measurement/arduino-vref-calibrate`（`CAL_ADPS`=7、n=64） |
| 監視対象 | ESP32 DevKitC。firmwareは[#6](https://github.com/wachi-yoshitaka-11-dev/deskcat/pull/155)の最小firmware（**peripheralを初期化せず、GPIOを駆動しない**） |
| 給電 | **両方ともPCのUSBのみ。**servoも外部電源も接続していない |
| 入力 | `A0`→ESP32の`3V3` pin、`A1`→ESP32の`GND` pin |
| 電圧の実測 | DT830B（`MEAS-03`）、`V⎓`の20 Vrange |

**servoも変換基板も過電流保護部品も使っていない。**段階Cの構成は組んでいない。

### 2条件で読んだ

| 条件 | GNDの結合 |
|---|---|
| **A** | **直結なし。**両方がPCのUSBで動いているため、GNDはPC経由でのみ共通である |
| **B** | **`Arduino GND`と`ESP32 GND`を1本で直結した** |

`A1`はADCの入力（高インピーダンス）であり、**GNDの結合にはならない。**

### raw data

各条件でn=64を6回反復した`ratio`の統計。

| 入力 | 条件 | mean | min | max | 幅 |
|---|---|---|---|---|---|
| `A0`（ESP32 `3V3`） | A | 0.661377 | 0.661301 | 0.661453 | 0.000152 |
| `A0`（ESP32 `3V3`） | B | 0.661789 | 0.661682 | 0.661896 | 0.000214 |
| `A1`（ESP32 `GND`） | A | 0.000000 | 0.000000 | 0.000000 | 0 |
| `A1`（ESP32 `GND`） | B | 0.000000 | 0.000000 | 0.000000 | 0 |
| `VBG` | A | 0.220665 | 0.220612 | 0.220703 | 0.000091 |
| `VBG` | B | 0.220579 | 0.220444 | 0.220688 | 0.000244 |

DT830Bによる実測（条件Bの状態）。

| 測った点 | 読み |
|---|---|
| ESP32の`3V3` | 3.34 V |
| ESP32の`5V` | 4.82 V |
| Arduinoの`5V`（AV<sub>CC</sub>の代理値） | 5.04 V |

**`A1`が浮いていたときの記録も残す。**配線前、`A1`をどこにも繋いでいない状態では
**試行1** `n=64 min=438 max=483 mean=454.2`／**試行2** `n=64 min=478 max=832 mean=686.4`／**試行3** `n=64 min=346 max=770 mean=545.4` と
**毎回まったく違う値になり、幅も数百LSBあった。**接続後は`min=max=0`で完全に安定した。
**確認できたのは「浮いた入力では値が不安定になる」ことである。****未接続を判定するしきい値も誤判定の試験も無いため、「測定系が未接続を検出できる」とは書かない**（[PR #160](https://github.com/wachi-yoshitaka-11-dev/deskcat/pull/160)の自動reviewの指摘）。

### 観測結果

1. **ADCの読みは既知電圧と一致した。**AV<sub>CC</sub>の代理値5.04 Vを使うと、
   条件Aは3.3333 V、条件Bは3.3354 Vとなり、**DT830Bの3.34 Vに対する差は −6.7 mVと −4.6 mV**である。
   **どちらも20 Vrangeの最小単位（10 mV）以下**であり、分解能の範囲で一致している。
2. **GNDを直結すると`A0`が +0.42 LSB（約 +2.1 mV）上がった。**
   条件内のばらつき（Aが0.156 LSB、Bが0.219 LSB）より大きく、**1 LSB（4.92 mV）より小さい。**
   平均を採って初めて見える大きさである。**（2026-08-22の追記）`EXP-004`でGND offsetを両極性で測った結果、この差はGND offsetの変化（+2.7 mV）で説明できることが分かった。差は0.62 mVで条件内のばらつき以内である。**
3. **この差はDT830Bでは裁定できない。**+2.08 mVは20 Vrangeの最小単位の約1/4.8であり、
   **ADCの方が分解能が高い。**テスターでは差の存在を確認も否定もできない。
4. **`A1`は両条件でmin=max=0だった。****これが示すのは片側だけである。**ADCは単端であり負電圧を測れないため、
   **`0`は「ESP32の`GND`がArduinoの`GND`より1 LSB以上高くはない」ことしか意味しない。**
   **ESP32の`GND`が低い側にずれている場合、入力は測定範囲の外であり、保護構造の影響で同じく`0`と観測されうる。**
   **その状態はADCが保証する測定範囲ではないため、`0`から差の絶対値を結論できない。**
   **（2026-08-22の追記）`EXP-004`で両極性を測った。ESP32の`GND`はArduinoの`GND`より低く、条件Aで−6.5 mV、条件Bで−3.8 mVだった。**
   **1 LSB（4.92 mV）より大きいoffsetが、まさにADCの死角にあった。**
   **したがってGNDの確認は片側（正方向のみ）であり、両極性を測れる手段を用意するまで完了しない**
   （[PR #160](https://github.com/wachi-yoshitaka-11-dev/deskcat/pull/160)の自動reviewの指摘）。
5. **`VBG`は条件間でほぼ動かなかった**（−0.09 LSB）。基準側が変わっていないため、
   `A0`の変化は入力側の変化である。
6. **入力headroomは 0.22 V（AV<sub>CC</sub>の4.4 %）しかない。**
   ADCのfull scaleがAV<sub>CC</sub>の5.04 Vで、ESP32の5 V railが4.82 Vである。
   **各読みの最小単位が10 mVなので、差の不確かさは少なくとも ±20 mV。**
   **したがってheadroomは少なくとも 0.20〜0.24 V の範囲にある**（確度が未取得なので実際はこれより広い）。
7. **抜き差しで条件が壊れていないことを確認した。**`A0`のジャンパを`3V3`から抜いて電圧を測り、
   戻したあとの`A0`は条件Bとの差が **−0.08 LSB（−0.4 mV）**で、条件内のばらつきより小さい。
   **入力電流は測定していない。**確認できたのは**この条件でジャンパを抜き差ししてもrailの変化を観測しなかった**ことである。**「ADCの入力は電流を流さない」とは書かない**（[PR #160](https://github.com/wachi-yoshitaka-11-dev/deskcat/pull/160)の自動reviewの指摘）。
8. **異常は無かった。**異音、発熱、ESP32のresetやbrownout、ADC値の異常のいずれも観測されなかった。
   **GNDを直結した瞬間にも変化は無かった。**

### この記録が主張しないこと

- **段階Cのtopologyの検証ではない。**star point構成は`5V ingress GND`を含み、
  それを作る変換基板`PSU-INGRESS-01`は未購入である。**したがって(3)は完了していない。**
  **（2026-09-12の追記）「それを作る変換基板`PSU-INGRESS-01`は未購入である」は2026-09-09の案B決定より前の記述である。**
  ingressは端子台でM-12001を受ける構成へ変わり、同品は経路から外れた（[hardware-bom.md](hardware-bom.md)で`Not used`。
  **同表記は役割の判断であって、所持の有無を意味しない**）。**「未購入」は当時の事実であり、訂正しない**
  （[hardware-bom.md](hardware-bom.md)の`PSU-INGRESS-01`行が「2026-08-25に発注する品として確定した」と記録しており、この実験の実施日 2026-08-22 はそれより前だからである。**発注日そのものは同fileが持たない**）。
  **成立しなくなったのは「変換基板が要る」という阻害要因のほうである。**
  **この項目が未解決であることは変わらない。残る理由をこの追記では判定しない**（[power-budget.md](power-budget.md)側の次のPull Requestで扱う）。
- **`5V ingress GND`とstar pointの同一node性、servo戻りとshuntを含むstar point、
  `ADC-SHUNT`の基準電位はいずれも確認していない。**shuntもservoも接続していない。
- **観測項目2の差の原因を特定していない。**GNDの直結が何を変えたかは説明していない。
- **`HW-TBD-028`の合否判定には使っていない。**判定は`Blocked`のままである。
  ESP32の`5V`が4.82 Vだったことも、**判定値との照合には使わない**
  （DT830Bの確度が未取得であり、`DT830Bを電流測定に使うときの制約`と同じ理由で
  読みだけでgateを通さない）。
- **過渡を測っていない。**これは静的な条件比較であり、起動時の電源過渡の観測ではない。

### 結論

- **段階B-1で確認できる3項目はすべて実測できた。**ADC値の妥当性、GNDの結合の影響、入力headroomである。
- **入力headroomが0.22 Vしかないことは、dividerを外せないことの定量的な根拠である。**
  `power-budget.md`の`5 V railをADCへ直結する条件`はdividerを既定として残していたが、
  **これまで理由は定性的だった。**5 V railが220 mVを超えて跳ねればfull scaleを超えて飽和し、
  **その区間の波形が失われる。**起動時の過渡を追う用途に対して、上に4.4 %の余裕は足りない。
- **(3) GND topologyへの影響は、段階B-1で実測はできたが解けていない。**理由が2つある。
  **(i) GNDの確認が片側だけである**（上の観測4。単端ADCの`0`は正方向しか縛らない）。
  **(ii) star point構成そのものの確認が残り、それは変換基板が揃うまでできない。**
  **したがって段階B-1を実施しても、この項目は未解決である。**
  **（2026-09-12の追記）「変換基板が揃うまで」は2026-09-09の案B決定より前の記述である。**
  **この項目が未解決であることは変わらない。残る理由をこの追記では判定しない**（[power-budget.md](power-budget.md)側の次のPull Requestで扱う）。

## EXP-004: GND offsetを両極性で測る

**目的**: `EXP-003`が単端ADCでは片側しか縛れなかったGNDの電位差を、極性を読める手段で測る。
`HW-TBD-034`作業3の(3)の残作業である。

**実施日**: 2026-08-22（**JST**。[CONTRIBUTING.md](https://github.com/wachi-yoshitaka-11-dev/deskcat/blob/main/CONTRIBUTING.md)が`日付はJST（UTC+9）で判断する`と定めている。**UTCでは前日になる**）。実機Linux。**人間が基板のそばで観察している状態で行った。**
**構成は`EXP-003`と同じ**（Arduino Uno R3とESP32 DevKitCをともにPCのUSBで給電。servoも外部電源も接続していない）。

### 測定手段

**DT830Bの`V⎓`の`200m`レンジ**（最小単位0.1 mV。`MEAS-03`）。
**このレンジを選んだ理由は2つある。**

1. **極性を読める。**負の入力に対して`−`を表示する（取扱説明書の`ディスプレイ`の節）。
   **単端ADCは負電圧を測れないため、この点が決定的である。**
2. **最小単位が0.1 mVで、ADCの1 LSB（4.92 mV）より約49倍細かい。**

赤プローブをESP32の`GND`、黒プローブをArduinoの`GND`へ当てた。
**したがって読みは`V(ESP32 GND) − V(Arduino GND)`である。**

### raw data

| 条件 | GNDの結合 | 読み |
|---|---|---|
| A | 直結なし（PC経由でのみ共通） | **−6.5 mV** |
| B | `Arduino GND`と`ESP32 GND`を1本で直結 | **−3.8 mV** |

### 観測結果

1. **ESP32の`GND`はArduinoの`GND`より低い。**両条件で符号が負である。
   **これは`EXP-003`の単端ADCが構造的に観測できない側である。**
2. **offsetはADCの1 LSBより大きい。**条件Aの6.5 mVは1 LSB（4.92 mV）を超える。
   **したがって`EXP-003`で`A1`が`min=max=0`だったのは、offsetが小さかったからではない。**
   **測れる大きさのoffsetが、ADCの死角にあったからである。**
   [PR #160](https://github.com/wachi-yoshitaka-11-dev/deskcat/pull/160)の自動reviewの指摘は仮定ではなく、実際にこうなっていた。
3. **`GND`の直結はoffsetを消さない。**−6.5 mVから−3.8 mVへ縮むが**残る。**
4. **`EXP-003`の`A0`の差の原因が説明できる。**`A0`はArduinoの`GND`基準でESP32の`3V3`を測るため、
   **GND offsetがそのまま乗る。**offsetが+2.7 mV変化したことに対し、
   **ADCが見た`A0`の差は+2.08 mVだった。差は0.62 mVで、`EXP-003`の条件内のばらつき（1.1 mV）以内である。**
   **2つの独立した測定手段が整合している。**
   `EXP-003`の観測2で「原因は特定していない」としていたが、**この説明で整合する。**
5. **GND offsetを入れるとADC値の妥当性の一致が良くなる。**
   DT830BはESP32の`GND`基準で`3V3`を3.34 Vと読んだ。Arduinoの`GND`基準へ換算すると
   条件Aは3.3335 V、条件Bは3.3362 Vになる。**ADCの実測は3.3333 Vと3.3354 Vで、
   差は−0.16 mVと−0.78 mVである。**
   **offsetを入れる前の差（−6.7 mVと−4.6 mV）より1桁小さい。**

### この記録が主張しないこと

- **offsetの原因を特定していない。**PCの内部でGNDが共通化される経路の抵抗、
  USB cableの抵抗、両boardの消費電流のいずれが効いているかは調べていない。
- **（2026-08-22の追記）このレンジには0.2 mVのゼロ点オフセットがある**（`EXP-005`のゼロ点確認）。**上の絶対値はその系統誤差を持つ。**
  **ただし2条件の差は影響を受けない**（定数オフセットは引き算で消える）。**したがってADCが見た差と整合するという結論は変わらない。**
- **DT830Bの確度は未取得である。**上の値は最小単位0.1 mVの読みであり、
  **確度を超える主張はしない**（正は`DT830Bの一次資料で分かったこと（2026-08-21）`）。
  **確度が未取得であるため、6.5 mVという値そのものの不確かさは`TBD`である。**
- **`HW-TBD-028`の合否判定には使っていない。**判定は`Blocked`のままである。
- **これは静的な測定である。**過渡中のoffsetの振る舞いは測っていない。
  **起動時にoffsetがどう動くかは分からない。**
- **段階Cのtopologyの検証ではない。**star point構成は変換基板`PSU-INGRESS-01`が揃うまで組めない。
  **（2026-09-12の追記）「変換基板`PSU-INGRESS-01`が揃うまで」は2026-09-09の案B決定より前の記述である。**
  **star point構成が組めていないことは変わらない。残る理由をこの追記では判定しない**（[power-budget.md](power-budget.md)側の次のPull Requestで扱う）。

### 結論

- **(3)のうち「GNDの確認が片側だけである」という不足は解消した。**両極性で測り、符号と大きさを得た。
- **それでも(3)は完了しない。**star point構成そのものの確認が残る。
- **設計に効く事実が1つ出た。`GND`の直結はoffsetを消さない。**
  数mVのoffsetは`HW-TBD-028`の絶対電圧の判定値に対して余裕の少ないところで効く。
  **star pointの設計は、直結すればoffsetが消えるという前提で行えない。**

## EXP-005: `5V` pinと`AVCC` pinの差の上限

**目的**: `EXP-002`が`AVCC`の代理として測った`5V` pinと、実際の`AVCC` pinの差を縛る。
`HW-TBD-034`の未解決3点のうち(1)の残作業である。

**実施日**: 2026-08-22（**JST**）。実機Linux。**人間が基板のそばで観察している状態で行った。**
**Arduino Uno R3のUSB給電のみ。servoも外部電源も接続していない。**

### 測る場所を一次資料で決めた

`AVCC`は`+5V`から`L2`（10 µH）を経てpin 20へ至る（`5V` pinと`AVCC` pinの差（2026-08-22の調査））。
**`L2`は`0805`（2.0 × 1.25 mm）で、DT830Bのプローブでは当てられなかった。**

**代わりにpin 20を直接測った。**ATmega328Pはsocket実装（`DIL28-3`）でpin間隔が2.54 mmあり、
`0805`のパッドより当てやすい。位置はArduino公式のboard reference designから求めた。

| 項目 | 値 |
|---|---|
| 出典 | `UNO-TH_Rev3e.brd`（<https://content.arduino.cc/assets/UNO-TH_Rev3e.zip>。sha256 `680cba4a0e6fb3a42ebc0d7055a1c924baabc19ebfd328e8da4454fa8fed7145`） |
| `L2` | `package="0805" value="10uH" x="39.116" y="8.128"`。**メーカー品番は無い**（`library="Induttanze"`） |
| pin 20（`AVCC`） | `x=42.545 y=12.573`（`ZU4`が`x=46.355 y=16.383`、`rot="R180"`の`DIL28-3`から算出） |
| 座標系 | 基板外形は68.58 × 53.34 mm。**原点は写真で見たときの左下**（DC jackが`x=5.334 y=8.382`、USBが`y=38.100`であることから決めた） |
| 目印 | `POWER`ヘッダの列（`y=2.540`）から上へ10.0 mm、`5V` pin（`x=38.100`）から右へ4.4 mm |

**pin 22は`GND`である。**`AVCC`と`GND`を短絡させると`L2`と5 V系に電流が流れるため、
**pin 19／21／22へ同時に触れない**ことを条件にした。

### raw data

DT830Bの`V⎓`の`200m`レンジ（最小単位0.1 mV）。赤プローブは`5V` pinへ中継したジャンパへ固定し、
黒プローブだけを動かした。

| 測定 | 表示 |
|---|---|
| `5V` pin → pin 20（`AVCC`） | **`00.2`** |
| **ゼロ点確認**（両プローブを同一点へ当てる） | **`00.2`** |

**2つの表示は同一である。**どちらも`XX.X`形式で0.2 mVと読める
（同レンジで測った`EXP-004`の`-06.5`も同じ形式である）。

**これはゼロ法（null測定）である。**測定対象を入れても表示が動かなかったため、
**差はこのレンジの分解能を動かせていない。**

**この読み方が置いている前提を明示する。**
**(a) 表示の丸めが2回の測定で同じように働き、ヒステリシスが無いこと。**取扱説明書にこの点の記載は無く、**確かめていない。**
**(b) 表示が安定していたこと。****記録していない。**ふらついていた場合、「同じ表示」の意味は弱まる。**次に同種の測定を行うときは、安定かふらつきかを記録する。**

### 観測結果

1. **このレンジには0.2 mVのゼロ点オフセットがある。**両プローブを同一点へ当てて`00.2`が出た。
   理屈上そこは0 Vであるため、**表示はテスター自身のオフセットである。**
2. **`5V` pinとpin 20の差は、このレンジの分解能未満である。**
   ゼロ点と測定値が**同じ表示**であったため、**差は表示を1 count動かすには足りなかった。**
   1 countは0.1 mVである。**したがって差の上限は0.1 mVである。**
   **差の値そのものは得られていない。**0でも0.09 mVでも同じ表示になる。
   **上限だけが言える。**
3. **この上限は、`EXP-002`が既に記録している不確かさに埋もれる。**2つの量と比べる。
   **(a) `AVCC`実測そのものの分解能は10 mV**（20 Vレンジの最小単位）で、**0.1 mVはその100分の1**である。
   **(b) `V_INT`へ伝わった合成の不確かさは少なくとも ±0.003 V**で、
   **0.1 mVが`V_INT`へ与える影響は約0.02 mV**（比率0.2206を掛ける）であり、**その130分の1以下**である。
   **どちらと比べても支配項にならない。**

### この記録が主張しないこと

- **差の値を測ってはいない。上限を与えただけである。**0.1 mVより細かい分解能はこの計器に無い。**ゼロ法で上限を与えただけである。**
- **`L2`のDCRは未取得のままである。**board fileにもメーカー品番が無い。
  **差を`I_AVCC × DCR`から算出したのではなく、直接測って上限を与えた。**
- **ゼロ点オフセットの原因を特定していない。**
- **表示が安定していたかを記録していない。**上の前提(b)のとおりである。
- **表示の丸めの挙動を確かめていない。**上の前提(a)のとおりである。**したがって上限0.1 mVは、その2つの前提のもとでの値である。**
- **確度は未取得である**（正は`DT830Bの一次資料で分かったこと（2026-08-21）`）。
  **上限0.1 mVは最小単位からの値であり、確度を超える主張はしない。**
- **`HW-TBD-028`の合否判定には使っていない。**判定は`Blocked`のままである。

### `EXP-004`への影響

**同じゼロ点オフセットは`EXP-004`のGND offsetの読みにも乗っている。**

- **絶対値**（条件Aと条件Bの読み）は**0.2 mVの系統誤差を持つ。**
- **2条件の差は影響を受けない。**定数オフセットは引き算で消える。
  **したがって「ADCが見た差と整合する」という`EXP-004`の結論は変わらない。**

### 結論

**(1) 基準電圧の校正は解けた。**

代理値の限定が実質的に解消した。**`5V` pinと`AVCC` pinの差は0.1 mV未満であり、
`V_INT`へ与える影響は約0.02 mV、`EXP-002`が既に記録している不確かさ
（少なくとも ±0.003 V）の130分の1以下である。**
したがって`EXP-002`の`V_INT`を、**その不確かさの範囲で絶対値として扱える。**

**それでも`HW-TBD-034`はcloseしない。**(3)のstar point構成の確認が残り、
close条件は3点だけではない。

## EXP-006: ポーリングログの試運転

**目的**: [#247](https://github.com/wachi-yoshitaka-11-dev/deskcat/issues/247)（2026-08-25、案AでESP32へ通電した際にPiが落ちた事象）が記録した「低電圧flagが再起動で消えて事後に確認できなかった」を防ぐため、`vcgencmd get_throttled`／`measure_volts`を1秒間隔でpollingし、reboot跨ぎでもファイルへ残る仕組み（`rail_logger.py`）を作り、実機で動くことを確かめる。

**実施日**: 2026-08-28（JST）。Raspberry Pi Runtime実機（`deskcat-pi`）。

### 構成

- 対象コマンド: `vcgencmd get_throttled`、`vcgencmd measure_volts core`（`sdram_c`／`measure_temp`も同時取得）
- 各書き込みごとに`flush()`と`os.fsync()`を行う。新規file作成時はdirectory entryも`fsync`する
- 絶対時刻でscheduleする（`sleep(interval)`の単純な積み上げは標本間隔を単調に伸ばすため）
- ESP32は接続していない。案Aの再試験は行っていない

### 結果

| 3節が要求した性質 | 結果 |
|---|---|
| `get_throttled`と`measure_volts core`を一定間隔で取得 | OK。`sudo`不要（実行userが`video` group所属） |
| タイムスタンプ付きでローカルfileへ追記 | OK。CSV。ISO8601（`+0900`）、monotonic経過秒、`boot_id`、`/proc/uptime`、`MemAvailable`を併記 |
| 毎行flush／sync | OK。実機で再起動をまたいで確認した。**再起動前に存在した18行について**、再起動後も同一の`sha256`であり`cmp`も一致した（その後に5 sampleが追記されている。file全体のhashではなく、再起動前の18行分を対象にした） |
| flagだけでなく実測値も残す | OK。`get_throttled`のraw文字列と16進値の両方を残す。bitを解釈して合否を出さない（`HW-TBD-023`が未確定であるため） |
| bootをまたいだ推移が追える | OK。同一fileへappendし、`boot_id`列と`# session start/end`行で境界が読める |

標本間隔の実測（初版の誤りを1件直した）:

| | 修正前 | 修正後 |
|---|---|---|
| 指定 | 1 s | 1 s |
| 実測min/max/平均 | — | 0.9980 / 1.0020 / 1.0002 s |
| 15 sampleの総経過 | — | 14.003 s |

初版は`sleep(interval)`を作業時間に上乗せしていたため、標本間隔が1.075 sへ伸びていた（`vcgencmd`4回と`fsync`の所要が毎周期積み上がる）。絶対時刻でscheduleするよう直した。

参考値（判定には使わない）: アイドル時の`measure_volts core`は1.2000Vで安定し、logger起動直後の1 sampleだけ1.3500Vを示した。CPUの周波数・電圧scalingによる差と解されるが、確認していない。**`measure_volts core`はSoC内部のcore railであり、`PWR IN`の入力電圧ではない。**この値をPi入力電圧の代用にしない。

### この記録が主張しないこと

- **案Aについて何も主張しない。**ESP32を接続していない
- **`PWR IN`の入力電圧を測っていない。**取れたのはSoC内部railの値だけである
- **落ちた瞬間を捉えたわけではない。**捉える仕組みが動くことを確認しただけである
- **完全な電源断では末尾（ポーリング間隔未満）が失われうる。**Piが応答停止した後の状態は捉えられない
- **SDへの書き込みが毎行発生する。**測定窓の外で回し続けるものではない

### 結論

reboot跨ぎで値を失わない仕組みが機能することを実機で確認した。**この仕組みは`EXP-007`で（意図しない形で）実地検証された。**

## EXP-007: journal永続化と直後のPi再起動

**目的**: [#247](https://github.com/wachi-yoshitaka-11-dev/deskcat/issues/247)のPM決定（2026-08-29）に従い、`journalctl`の`Storage`を`persistent`化し（`SystemMaxUse=32M`上限付き）、kernelログが再起動をまたいで残る状態にする。その直後にPiが実際に再起動した事象を記録する。

**実施日**: 2026-08-29（JST）。Raspberry Pi Runtime実機（`deskcat-pi`）とDocs/Review端末（ssh経由）。sudo操作はユーザーの承認を得て実施した。

### journal永続化の実施

- `/etc/systemd/journald.conf.d/50-persistent-storage.conf`に`Storage=persistent`／`SystemMaxUse=32M`を追加し、`systemd-journald`を再起動
- `/var/log/journal/`に実file（`system.journal`／`user-1000.journal`）ができたことを確認した

### 再起動事象

**何をしていたか**: 測定計画6節の残り2項目のうち「Pi単体でのbuild負荷比較」を実施しようとしていた。検証済みでない条件（`cargo build --release`）で建て直し、さらにその完了確認中に**別の検証済みコマンドのbuildをもう一度重ねて起動してしまい、空きメモリ68MiBの状態で2つのcargo buildが同時に動く状態を作った（AI側の判断ミス）。**二重buildを解消しようとssh経由で`kill`コマンドを送った直後、Piがネットワークから応答しなくなった。

タイムライン（`journalctl`と`boot_id`による再構成、時刻はJST）:

| 時刻 | 内容 |
|---|---|
| 02:47頃 | `--release`buildが依然として稼働中（見落とし）に、debug buildをさらに起動。空きメモリ68MiB |
| 02:48:29–02:48:35 | 二重build解消のための`kill`コマンドがssh接続。正常に切断（`disconnected by user`） |
| 02:48:35 | rail loggerのCSVの最後の行。以降、記録が途切れる（`# session end`行が無い＝正常終了ではない） |
| 02:48:41 | 新しい`boot_id`（`85d4479e…`）でkernelログが開始。旧bootとの間はわずか6秒 |
| 02:48:41 | journal再起動時、旧journalファイルが「corrupted or uncleanly shut down」として作り直された（正常なshutdownでは起きない） |
| 02:59頃 | ping応答が復帰。人間が物理的に立ち会っており、その時点でLEDは点灯、DT830B読みは5.30V（プローブを固定した状態） |

### 追加の観測

- **`throttled`の低電圧sticky bitは、新bootで`0x0`**（このboot中は低電圧未検出）。旧boot終了直前の最後のポーリング行（02:48:35時点）も`throttled=0x0`だった
- **新bootのfilesystemは`orphan cleanup`のみでEXT4エラー無し**

### この記録が主張しないこと

- **原因を確定していない。**証拠は「AI側の二重build（メモリ逼迫）が引き金」という仮説を、タイミングの近さから支持するが、旧bootのkernelログにOOM killerの記録が一つも無いため断定できない
- **物理的な短絡が引き金だった可能性を完全には排除できない。**ただしタイムラインは、後で報告された「プローブを外したらLEDが消え、その後点滅した」という観察より前に再起動が始まっていたことを示しており、それが新たな短絡ではなく既に始まっていた同じ再起動の起動シーケンス（SDカードアクセスによる点滅）だった可能性を示唆する
- **1秒間隔のポーリングでは、間隔未満の瞬間的な電圧降下は検出できない。**`throttled=0x0`の記録は、この限界の範囲内でのものである
- `docs/hardware/`の値は変更していない。案Aの再試験は行っていない

### 是正

- 今後、Pi上のcargo buildはAGENTS.md検証済みコマンドのみを使い、同時に2つ以上走らせない。`--release`など未検証条件は使わない
- DT830Bのプローブは、GPIO pinへ手持ちで当てず、線を延長して固定する（本事象後に対応済み）

### 結論

**Piは実際に再起動した（`boot_id`変化で確定）。**原因は特定できていない。journal永続化は意図通り機能し、この事象が期せずして`journalctl -b -1`が使えることの実地確認になった（`EXP-006`参照）。

## EXP-008: 段階B-1でのPi単体build負荷比較とESP32側基準値

**目的**: 測定計画6節「待たない」項目のうち残る2件（Pi単体でのbuild負荷比較、ESP32側の基準値〈段階B-1〉）を実測する。`EXP-007`の事象を踏まえ、検証済みコマンド1つだけを同時実行なしで使い、DT830Bのプローブは線を延長して固定してから測定した。

**実施日**: 2026-08-30（JST）。Raspberry Pi Runtime実機（`deskcat-pi`）とDocs/Review端末（ssh経由、およびPC USB直結）。人間が物理的に立ち会い、DT830Bのプローブ当てと読み取りを行った。

### 測定点の限界

- Pi側: `PWR IN`ポート直前は、M-12001のcableがreceptacleへ直挿しの構成（`PSU-INGRESS-01`未着荷）のため物理的に触れられない。**代わりにGPIO 40pinヘッダ pin2(5V)/pin6(GND)で近似した。**Pi公式資料によれば、GPIO 5V pinはUSB入力と同一railだが、USB側にあるfuse／TVS／filterの保護回路を経由しない。Zero W自体の回路図は非公開のため、この保護回路による電圧降下の有無・大きさは確認できていない
- ESP32側: `5V`ピン（Micro USBコネクタ直近）で近似した。この秋月基板の`5V`ピンがVBUSへ保護diodeを介するか直結かは未確認（[power-budget.md](power-budget.md)既知のTBD）
- DT830Bの確度そのものは一次資料に無く取得できない。`±10 mV`はDT830Bの最小表示単位から出る不確かさの下限であり、確度そのものではない。真の確度は不明でこの下限より悪い可能性がある
- `HW-TBD-023`の暫定値を合否の基準に使っていない。以下は記録のみで、合否判定はしていない

### 項目2: Pi単体build負荷比較

ESP32は接続せず、Piの`PWR IN`をGPIO pin2/pin6で近似測定した。ポーリングログ（`EXP-006`と同じ仕組み）も並行して動かした。

| 条件 | 実測(V) | 備考 |
|---|---|---|
| アイドル | 5.29〜5.30 | 安定 |
| build中（`cargo build --locked -p deskcat-serial`、13.35秒、16:41:08〜16:41:22 JST） | 5.27〜5.28 | ロガーの`volts_core`（SoC内部rail、参考値）も同時刻に`1.2000V`→`1.3500V`、温度も40℃→42℃台へ上昇。時間的に一致 |
| build後 | 5.28〜5.30 | アイドルへ復帰 |

`throttled`は測定を通して`0x0`。約10〜20 mVの低下が見えるが、**有意性は判断しない**（DT830Bの確度が不明であり、この差が測定確度の内か外かを決められないため）。ロガーのCSVは今回`# session end`行で正常終了した（`EXP-007`の事象では同じ行が欠けており、それが異常終了の根拠の1つだった。今回はその対比になる）。

### 項目3: ESP32側の基準値（段階B-1、PC給電）

PCのUSBからESP32を給電した状態（cargo buildは実行していない）で測定。

| 条件 | 実測(V) |
|---|---|
| アイドル（PC給電、`5V`ピン） | 4.82〜4.83、安定 |

**Pi側の実測（5.29V付近）と単純比較しない。**給電元（M-12001経由 対 PCのUSBポート）が異なり、経由する保護回路・降下要因も異なるため、この2値の差から何かを結論しない。

### この記録が主張しないこと

- **`PWR IN`・Micro USBコネクタそのものの電圧ではない。**いずれもGPIO/5Vピンでの近似であり、途中の保護回路による降下は未確認
- **合否を判定していない。**`HW-TBD-023`は依然TBDのまま
- **案Aの再試験は行っていない。**OTG供給能力の実測も行っていない（段階Cまで待つ）

### 結論

測定計画6節「待たない」3項目（`EXP-006`〜本記録）は、いずれも着手し、いま取れる範囲の値を取った。**ただし項目2は、測定計画5節が定める測定点（`PWR IN`直前）では測れていない。**5節は「経路の途中で測ると、降下を含めた実際の入力電圧が分からない」と理由を明記しており、今回のGPIO pin代用はこの条件を満たさない。**`PSU-INGRESS-01`が着荷してcableの受けがbreakoutになれば、その点で測り直せる。それまで、この値を「Piの`PWR IN`入力電圧」として扱わない。**同じ理由で、ESP32側の`5V`ピンもMicro USBコネクタそのものの代用ではない。

**（2026-09-12の追記）「`PSU-INGRESS-01`が着荷してcableの受けがbreakoutになれば」は2026-09-09の案B決定より前の記述である。**
同品は5 V ingressの経路から外れ（[hardware-bom.md](hardware-bom.md)で`Not used`）、ingressは端子台でM-12001を受ける。
**したがってこの測り直しの道筋は成立しない。****この値を「Piの`PWR IN`入力電圧」として扱わない点は変わらない。**
**測り直しに何が要るかは、この追記では判定しない。**

## EXP-009: 案Aの再現3回と停止時刻の記録

**目的**: [#247](https://github.com/wachi-yoshitaka-11-dev/deskcat/issues/247)の事象（2026-08-25、案AでESP32へ通電した際にPiが落ちた）が、2026-08-31に3回再現した。**測定計画が予定した作業ではなく、作業者が現物を操作して実施したものである。**起きた事実と、残った証拠だけを記録する。

**実施日**: 2026-08-31（**JST**）。Raspberry Pi Runtime実機（`deskcat-pi`）。**人間が現物を操作し、立ち会っている。**

### 構成

| 項目 | 内容 |
|---|---|
| Pi | `PSU-PI-01`（M-12001）から`PWR IN`で給電 |
| ESP32 | PiのUSB OTG portへUSB cableで接続（**案A**） |
| 記録 | **3回目のみ**`rail_logger.py`が1秒間隔で稼働していた。1回目と2回目は稼働していない |
| railの観測 | **無い。**この時点でPi入力の観測系は未構築である（構築は`EXP-010`） |

**servoも変換基板も過電流保護部品も使っていない。段階Cのgateは開いていない。**

### raw data

boot境界（`journalctl --list-boots`）。

| boot_id | 最初の行 | 最後の行 |
|---|---|---|
| `85d4479e…` | 2026-08-30 02:48:41 | **2026-08-31 21:17:01** |
| `1ec1cffa…` | 2026-08-31 21:37:22 | **2026-08-31 21:40:50** |
| `6f86a80e…` | 2026-08-31 21:43:45 | 2026-08-31 22:22:14 |
| `c3408831…` | （下の`時刻の注記`を参照） | 稼働中 |

3回目の停止時刻（`rail_logger.py`のCSV）。

- 最終行 **`2026-08-31T22:23:16+0900`**
- **`# session end`行が無い**（正常終了なら付く）
- 次のbootの`uptime -s`は`2026-08-31 22:23:21`（**5秒後**）

停止直前の6サンプル（22:23:11〜22:23:16、1秒間隔）。

```text
throttled=0x0  volts_core=1.2000V  volts_sdram_c=1.2000V  39.0'C  MemAvailable 331708〜331748 kB
```

**6行とも同じである。**

異常終了の印。

| 起動 | `EXT4-fs orphan cleanup` | `journal ... corrupted or uncleanly shut down` |
|---|---|---|
| `1ec1cffa` | 21:37:23 | 21:37:26 |
| `6f86a80e` | 21:43:46 | 同boot内で検出 |
| `c3408831` | 22:21:15※ | 22:21:19※ |

※ NTP同期前の時刻である（下記）。`EXT4-fs error`と`I/O error`は`c3408831`で**0件**。

ESP32のUSB enumerate。

| boot | 記録 |
|---|---|
| `1ec1cffa` | 21:37:43 `cp210x converter now attached`（**起動時に既に接続されていた**） |
| `6f86a80e` | 21:44:05 同上 |
| `c3408831` | 22:31:33 disconnect ／ 22:32:01 attach ／ 22:48:57 disconnect ／ 22:49:03 attach ／ 22:49:10 disconnect |

**落ちる引き金になった接続そのものは記録に残っていない。**接続の瞬間にPiが停止するため、そのbootのjournalが書かれない。上のattachはいずれも**再起動後のenumerate**である。

cable別の回数（**作業者の申告**。journalからは導けない）。

| cable | 接続 | 落ちた |
|---|---|---|
| 本体表記 `E226000` ／ `<28AWG/1P AND 28AWG/2C>` | 2 | **0** |
| **本体表記なし** | 3 | **3** |

### 時刻の注記（読み間違えると矛盾して見える）

**Pi Zero WにRTCは無い。**boot `c3408831`の`Initial clock synchronization`は**22:25:31**であり、
**このbootのそれ以前のtimestampはNTP同期前の値である。**`journalctl --list-boots`が
このbootの最初の行を`22:21:15`と表示するのはそのためで、**停止時刻(22:23:16)より前に見えるが実際には後である。**

**停止したboot `6f86a80e`は21:47:27に時刻同期を済ませていた。**したがってCSVの`22:23:16`は同期後の値である。
**この記録では停止時刻としてCSV側を採る。**

### 観測結果

1. **3回とも電源断相当の停止である。**shutdown手順の記録が無く、次の起動で`orphan cleanup`とjournalの不整合が出ている。**`EXP-007`（2026-08-30 02:48）と同じsignatureである。**
2. **file systemは無事である。**`EXT4-fs error`と`I/O error`は0件だった。
3. **停止の1秒前まで、pollingで取れる量に前兆が無い。**最後の6サンプルは完全に平坦である。
4. **`throttled=0x0`は電圧について何も語らない。**`SBC-01`（Pi Zero W）には低電圧検出回路が無く、**この品でこのbitが立つことは期待できない**（正は[power-budget.md](power-budget.md)の`Pi Zero Wには低電圧検出が無い`）。
5. **journalよりCSVの方が停止時刻を細かく与えた。**journalの最終行は22:22:14で、実際の停止より約1分早い。**1秒間隔のpollingがその差を埋めた。**
6. **cableを替えると結果が変わっている**（上表。**作業者の申告**）。**試行は時間的に交互である**（表記あり→表記なし→表記なし→表記あり）。

### この記録が主張しないこと

- **原因を確定していない。電圧を測っていない。**この3回にrailの観測は無い。
- **cable差を確定していない。**5試行では、完全に分かれても偶然の確率は0.1までしか下がらない。**統計だけでは固まらない。**
- **表記なしcableの電源線の太さは不明である**（表記が無い）。**「cable」は導体の太さ・接触抵抗・長さ・個体の不良を含む束であり、どれが効いたかを分けていない。**
- **`E226000`の帰属先を確認していない。**UL file番号の形式だが、一次資料に当たっていない。
- **`28AWG/1P AND 28AWG/2C`の`2C`を電源線と読むことの一次資料に当たっていない。**
- **PiのUSB OTG portの供給能力を実測していない。**
- **どのgateも開いていない。**段階Cの部品は未実装のままである。
- **`HW-TBD-023`／`HW-TBD-028`の判定に使っていない。**

### 結論

- **2026-08-31に案Aが3回実施され、3回ともPiが電源断相当で停止した。**うち1回は停止時刻を1秒精度で記録できた。
- **software側のpollingで取れる量には前兆が無い。**原因を詰めるには、railの電圧をpolling間隔より細かく観測する必要がある。**その測定系が`EXP-010`である。**
- **cableによる差は観測されたが確定していない。**確定には機序の測定が要る。

## EXP-010: Pi入力の独立観測系の構築と初回測定

**目的**: `HW-TBD-034`方式1（独立した外部観測）を**Piの5 V入力へ拡張し**、msオーダーの過渡を記録できる測定系を組む。`EXP-009`が示したとおり、1秒間隔のpollingでは停止の前兆が取れない。**この記録は測定系が動くことの確認であり、合否の判定ではない。**

**実施日**: 2026-09-01（**JST**。UTCでは前日になる）。Raspberry Pi Runtime実機（`deskcat-pi`）と実機Linux（`wacchi-deskcat-dev`）。**人間が現物を操作し、立ち会っている。**

### 構成

| 項目 | 内容 |
|---|---|
| 記録係 | Arduino Uno R3。sketchは`hardware/measurement/arduino-transient-logger`（`LOGGER_ADPS`=7、`LOGGER_NCH`=2、`LOGGER_BAUD`=1000000）。PCのUSBから給電 |
| 監視対象 | Piの5 V入力。**GPIO 40pinヘッダ`pin2`(5V)／`pin6`(GND)** |
| 入力 | `A0`→分圧のnode、`A1`→Arduinoの`3V3` pin |
| 分圧 | 上側10 kΩ×1本、下側10 kΩ×3本直列（`MEAS-01`のカーボン抵抗1/4W 10 kΩ） |
| 電圧の実測 | DT830B（`MEAS-03`）。GND電位差は`V⎓`の`200m`、電圧は`20V` |
| Pi側 | `rail_logger.py`を1秒間隔で並行稼働 |
| **ESP32** | **接続していない。**`journalctl`の最後のUSB事象は2026-08-31 22:49:10の`USB disconnect`であり、以降この測定まで接続事象が無い |

**案Aを実施していない。servoも変換基板も過電流保護部品も使っていない。**

### 段1: 繋ぐ前のGND電位差

**PiはM-12001、ArduinoはPCのUSBで、給電元が違う。**`EXP-004`はArduinoとESP32の間を測ったが、**あれは両方がPCのUSBでGNDがPC内部で既に共通だった条件である。**今回は共通点が無いため、繋ぐ前に測った。

**最も高いrangeから順に下げ、`200m`（最小単位0.1 mV）まで到達した。**赤プローブをPiの`pin6`、黒プローブをArduinoの`GND`へ当てた。

| 条件 | 読み |
|---|---|
| `V(Pi GND) − V(Arduino GND)` | **+0.2 mV** |
| プローブを入れ替え | **符号が反転した** |
| ゼロ点（プローブ短絡） | **00.0** |
| 表示の安定性 | わずかにふらつく |

**`EXP-004`のESP32–Arduino間（−6.5 mV）より1桁小さい。**ADCの1 LSB（4.92 mV）の約1/25である。

**なお`EXP-005`は`200m`レンジのゼロ点を0.1 mV以下と記録しているが、今回のゼロ点は`00.0`だった。**ゼロ点は条件によって変わりうる。**測るたびに読む。**

### 段2: 分圧

抵抗の実測（DT830Bの`20k`レンジ）。**4本とも 9.86 kΩ。**組み立て後の実測は**上側 9.86 kΩ／下側 29.6 kΩ**。

```text
分圧比 r = 29.6 / (9.86 + 29.6) = 0.7501
```

**比は4本が揃っていれば絶対値が打ち消える**（`3R/(R+3R)`）。したがって計器の絶対確度がこの比に効かない。

| 項目 | 値 |
|---|---|
| 分圧比 | **0.7501** |
| ADCの1 LSB（入力換算） | 4.922 mV（AV<sub>CC</sub>代理値5.04 V / 1024） |
| **1 LSBのrail換算** | **6.56 mV** |
| 飽和するrail電圧 | 6.72 V |
| railから引く電流 | 134 µA |
| ADCから見たsource抵抗 | 7.4 kΩ |

**分圧は外していない。**この対象では**定常値の時点でAV<sub>CC</sub>を超えている**（Piのrailが5.29 V、Arduinoの代理値が5.04 V）。`power-budget.md`の`5 V railをADCへ直結する条件`は「対象側の過渡がAV<sub>CC</sub>を超えうる」としているが、**この対象では常時超えている。**

### 段3: 配線

- **分圧の下側はPiの`pin6`へ戻した。**ArduinoのGND側へ戻していない
- **接続順はGNDが先、信号が後**
- 上側10 kΩが直列に入るため、分圧nodeがGNDへ短絡してもPiから流れるのは約0.5 mA

**`A1`にArduinoの`3V3` pinを入れた。**ADCはAV<sub>CC</sub>基準の比率測定であり、**AV<sub>CC</sub>はPCのUSBから作られる別電源である。**AV<sub>CC</sub>が動けばch0のrail換算値も同じ割合で動くため、**対照として同時に読む。**

### raw data

**接続後、A0を繋ぐ前のDT830B（`20V`レンジ）。**

| 測った点 | 読み |
|---|---|
| Pi `pin2` ↔ `pin6` | **5.29 V** |
| 分圧node ↔ Pi `pin6` | **3.94 V** |

**比から予想される分圧出力は 5.29 × 0.7501 = 3.97 V であり、実測は 28 mV 低い。**

**取得3本**（いずれも60秒、`LOGGER_NCH`=2、実効104.0 µs/sample＝1 channelあたり208 µs間隔）。

| 取得 | ch0 平均 | ch1 平均 | 取りこぼし | block欠番 | XOR不一致 |
|---|---|---|---|---|---|
| アイドル1 | 806.0 | 673.5 | 0 | 0 | 0 |
| アイドル2 | 806.6 | 673.6 | 0 | 0 | 0 |
| build | 806.2 | 673.6 | 0 | 0 | 0 |

**アイドル1の外れ値。**ch0に平均から大きく外れた値が**225件**あり、**すべて約100 msの窓に収まっていた**（取得開始から22.4秒後。壁時計 2026-09-01T01:42:43頃）。5つのかたまりに分かれ、最長は29.7 msの118件連続である。値は0が210件、残りが2〜594に散っている。**アイドル2とbuildの取得では0件だった。**

**アイドル1の外れ値を除いた統計**（ch0、n=287,967）: 平均 806.665、標準偏差 1.043（rail換算 6.84 mV）、rail換算の平均 **5.2930 V**。

**build条件の区間別**（`BUILD_START 2026-09-01T01:48:48.221+0900`、`BUILD_END 01:49:01.961+0900`、`cargo build --locked -p deskcat-serial`、12.52秒）。

| 区間 | n | ch0 平均 | 標準偏差 | rail換算 | ch1 平均 |
|---|---|---|---|---|---|
| build前 | 65,606 | 806.720 | 0.929 | **5.2934 V** | 673.564 |
| **build中** | 66,057 | **804.461** | 1.355 | **5.2786 V** | 673.558 |
| build後 | 156,529 | 806.633 | 0.972 | **5.2928 V** | 673.565 |

**1秒ごとの推移**（build開始を0秒とする。rail換算、build前の平均806.720からの差）。

| 秒 | 差 | 秒 | 差 |
|---|---|---|---|
| −4〜−1 | −0.3〜+1.9 mV | +9 | −13.9 mV |
| **+0** | **−16.9 mV** | +10 | −14.7 mV |
| **+1** | **−18.6 mV** | +11 | −15.8 mV |
| +2 | −14.9 mV | +12 | −15.3 mV |
| +3 | −14.3 mV | +13 | −15.7 mV |
| +4〜+8 | −13.0〜−13.8 mV | +14 | −7.4 mV |
| | | +15 | −4.3 mV |
| | | +16〜+17 | −0.4〜−0.3 mV |

**Pi側のpolling log（1秒間隔、同時刻）。**

```text
01:48:47  throttled=0x0  volts_core=1.2000V  37.9'C  MemAvailable 337852
01:48:50  throttled=0x0  volts_core=1.3500V  39.0'C  MemAvailable 333376
01:48:59  throttled=0x0  volts_core=1.3500V  40.1'C  MemAvailable 310948
01:49:05  throttled=0x0  volts_core=1.2000V  39.0'C  MemAvailable 321052
```

### 観測結果

1. **測定系は成立した。**3本の取得すべてで取りこぼし0、block欠番0、XOR不一致0である。**1 channelあたり208 µs間隔で、必須要件の1 kSample/s以上を満たす。**
2. **ADCの読みが分圧の設計値と一致した。**アイドル時のch0は806 counts前後で、`5.29 V × 0.7501 / 4.922 mV = 806`である。
3. **DT830Bが分圧出力を28 mV低く読んだのは、計器自身の負荷で説明が付く。**分圧の出力インピーダンスは7.4 kΩであり、計器の入力インピーダンスが1 MΩ程度なら0.73 %下がって3.94 Vになる。**ただしこの計器の入力インピーダンスは未取得であり、断定しない**（正は[power-budget.md](power-budget.md)の`DT830Bの一次資料で分かったこと（2026-08-21）`）。**換算には抵抗実測から出した0.7501を使い、DT830Bの3.94 Vは別に記録する。**ADC側にはこの負荷が出ない（入力leakは最大1 µAで、7.4 kΩに対して最大7.4 mV）。
4. **build負荷でrailが 14.8 mV 下がった。**806.720 → 804.461 counts である。
5. **低下はbuild開始の1秒以内に現れ、終了の直後に戻った。**最深は+1秒の−18.6 mV、回復は+14秒から始まり+16秒で基準へ戻る。**`BUILD_START`／`BUILD_END`と一致する。**
6. **この低下はAV<sub>CC</sub>の変動ではない。**対照のch1（Arduinoの`3V3`）は3区間で 673.564／673.558／673.565 であり、**差は0.006 counts しかない。**
7. **数の裏付け。**各区間6.6万サンプル、標準偏差1 count前後であり、平均の標準誤差は0.03 mVに満たない。**14.8 mVはその桁を大きく超える。**
8. **build中はばらつきも増えた。**標準偏差が0.929→1.355 counts（rail換算6.1→8.9 mV）へ上がる。
9. **2つの時間軸が突き合わせられた。**Arduino側CSVの壁時計anchorと、Pi側polling logのISO8601が同じ窓を指している（`volts_core`の1.2000V→1.3500V、温度上昇、`MemAvailable`の減少）。
10. **`EXP-008`はDT830Bで「約10〜20 mVの低下」を見ながら「有意性は判断しない」としていた。****今回の14.8 mVはその範囲に入る。**

### この記録が主張しないこと

- **`PWR IN`の入力電圧ではない。**M-12001のcableがreceptacleへ直挿しで触れられないため（`PSU-INGRESS-01`未着荷）、GPIO 40pinヘッダの`pin2`/`pin6`で代用した。**GPIOの5V pinはUSB入力と同一railだが、USB側にあるfuse／TVS／filterの保護回路を経由しない。****Zero Wの回路図は非公開であり、この保護回路による降下の有無・大きさは確認できていない。**`EXP-008`と同じ限定である。
- **絶対値の確度を主張しない。**rail換算の絶対値はAV<sub>CC</sub>の代理値5.04 V（最小単位10 mV）、分圧比の不確かさ、入力leakによる最大10 mVの系統offsetを含む。**精度が高いのは変化量の方である。**
- **DT830Bの確度そのものは取得できない。**`±10 mV`は最小単位から出る不確かさの下限であり確度ではない。
- **合否を判定していない。**`HW-TBD-023`と`HW-TBD-028`はTBDのままである。
- **star point構成を確定させていない。**あれはservo shunt側の話で、`PSU-INGRESS-01`の着荷後に残る。**`HW-TBD-034`の未解決3点のうち(3)は解けていない。**
  **（2026-09-12の追記）「`PSU-INGRESS-01`の着荷後に残る」は2026-09-09の案B決定より前の記述である。**同品は経路から外れた。
  **この項目が未解決であることは変わらない。残る理由をこの追記では判定しない**（[power-budget.md](power-budget.md)側の次のPull Requestで扱う）。
- **cable差を検証していない。**それにはESP32の接続が要り、案Aにあたる。**この測定でESP32は接続していない。**
- **アイドル1の約100 msの乱れの原因を特定していない。**値が0付近であることは入力が一瞬開いた形と整合するが、**railが0 Vへ落ちたのではない**（Piは再起動していない）。**アイドル2とbuildでは再発していない。**
- **`EXP-009`の3回の停止について、この測定は何も語らない。**停止時にこの測定系は動いていない。
- **どのgateも開いていない。servoを繋いでいない。**

### 結論

- **Piの5 V入力を、1 channelあたり208 µs間隔・rail換算6.56 mV/LSBで観測できる測定系が成立した。**部品の着荷を待たずに組めている。
- **既知の負荷変化で波形が取れることを確認した。**`cargo build`で14.8 mVの低下が現れ、開始と終了に時間的に一致し、終了後に戻る。
- **対照chにより、AV<sub>CC</sub>の変動ではないことを分離できた。**`3V3`を同時に読む構成がこの分離を可能にした。**ただし`3V3`の生成経路をschematic粒度で確認していないため、これをAV<sub>CC</sub>の補正には使っていない。**
- **`HW-TBD-034`はcloseしない。**(3) GND topologyは`PSU-INGRESS-01`の着荷まで完了しない。**この測定で得た値を受け入れ判定に使わない。**
  **（2026-09-12の追記）「`PSU-INGRESS-01`の着荷まで」は2026-09-09の案B決定より前の記述である。**同品は経路から外れた。
  **この項目が未解決であることは変わらない。残る理由をこの追記では判定しない**（[power-budget.md](power-budget.md)側の次のPull Requestで扱う）。

## EXP-011: `EN`保持での起動時状態の再測定（`LCD-CS`／`LCD-RST`／`TOUCH-CS`／`LCD-BL`）

**目的**: `#2`受け入れchecklist項目6（Reset／backlight lineが安全な状態で起動）と項目7（Touch CS lineが安全な状態で起動）を判定する。**2026-08-29の実測（`LCD-CS`＝3.30 V、`LCD-RST`＝3.30 V、`GPIO21`＝3.30 V）は`EN`保持なしで行われており、「pull-upが効いている」場合と「firmwareがpinをHighへ駆動している」場合を区別できなかった。**`EN`を押し続けてESP32をresetに保持すれば、firmwareが動かない状態でpull-up単体の効果だけを測れる（`fc42332`の`SERVO-PWM`測定と同じ方法）。あわせて、本日（`#2`の段1）新規実装した`LCD-BL`のpull-down（`4.7 kΩ`、GPIO4）についても、起動時にLowへ確定していることをこの機会に測る。

**実施日**: 2026-09-07（JST）。人間が物理的に立ち会い、DT830Bのプローブ当てと読み取りを行った。

### 構成

| 項目 | 内容 |
|---|---|
| 給電 | ESP32単体、PCのUSBから（段階B-1）。**Piは接続していない。servoは未接続・servo電源未投入** |
| `EN`保持 | `EN`ピンを指で押し込み、テープで基板へ貼り付けて固定した |
| プローブ固定 | 黒プローブ（GND側）をクリップでブレッドボードのGND帯へ固定し、赤プローブを片手で各測定点へ当てた |
| 計器 | DT830B、DC電圧`20V`レンジ |
| 測定対象 | `LCD-CS`(GPIO22)、`LCD-RST`(GPIO16)、`TOUCH-CS`(GPIO21)、`LCD-BL`(GPIO4)。いずれも対GND |

### 結果

| 信号 | GPIO | 実測 | 期待値 | 判定 |
|---|---|---|---|---|
| `LCD-CS` | 22 | **3.31 V** | High（外部pull-up`10 kΩ`が効く） | 一致 |
| `LCD-RST` | 16 | **3.31 V** | High（外部pull-up`10 kΩ`が効く） | 一致 |
| `TOUCH-CS` | 21 | **3.31 V** | High（外部pull-up`10 kΩ`が効く） | 一致 |
| `LCD-BL` | 4 | **0.00 V** | Low（reset中にLowへ確定） | 一致 |

**4点とも、`EN`を押した状態と離した状態とで値に変化が無いことを、作業者が申告した。**中止条件（異音・異臭・発熱・煙・変色・想定と桁が違う電圧・`DT830B`の表示が不安定）はいずれも認めなかった。

### この記録が主張しないこと

- **確度は主張しない。**`DT830B`の確度そのものは未取得であり、`±10 mV`程度は最小単位からの不確かさの下限にすぎない
- **`LCD-BL`の極性（`active-high`）はここでは検証していない。**確認したのは「firmware初期化前にLowへ確定していること」だけである
- **`LCD-BL`（GPIO4）の0.00 Vは、外部pull-downの存在を証明しない。**`reset時のpin状態`表（`IO_MUX`）のとおり、GPIO4は`LCD-CS`／`LCD-RST`／`TOUCH-CS`（いずれも`oe=0, ie=0`＝内部pull無し）と異なり、`oe=0, ie=1, wpd`＝**内部weak pull-down（typ 45 kΩ）が有効**である。したがって外部`4.7 kΩ`が未接続でも`EN`保持下では0.00 Vを示しうる。**この測定では外部pull-downの実装有無を切り分けられない。**外部pull-downの存在自体は本日の配線作業（段1）で確認済みだが、この電圧測定はその証拠ではない
- **実機のLCD／touch panelは接続していない。**SPI通信が実際に成立するかはここでは判定しない（`#13`の範囲）
- **`EN`解放直後・firmware起動直後の過渡は測っていない。**`EN`保持中の定常値のみである
- **`ACCEL-SDA`／`ACCEL-SCL`（本日新規実装したpull-up）はここでは測っていない。**I2C bus側の確認は別項目（`#2`のclose条件から外れた項目3）が扱う

### 結論

**`LCD-CS`／`LCD-RST`／`TOUCH-CS`は、`EN`保持下（firmware非動作）でも3.31 Vを維持した。**この3信号は内部pullが無いため、この結果は外部pull-upの効果をfirmwareのHigh駆動と切り分けて確認したことを意味する。**`LCD-BL`も同条件で0.00 Vを維持し、reset中にbacklightがOffへ確定していることを確認した。**ただしGPIO4は内部weak pull-downが有効なため、この0.00 Vだけでは外部pull-downが効いているとは言えない（上記「主張しないこと」参照）。**いずれにせよ、項目6が要求する「reset中に安全な状態（backlight Off）にあること」自体は満たしている。****`#2`受け入れchecklist項目6・7を達成とする。**

## EXP-012: M-12001cableのplug側破片を使ったVBUS／GND極性判定

**目的**: 案B（[power-budget.md](power-budget.md)の`M-12001のcableを受ける端子台`行）に従い、M-12001の出力cableをMicro-Bプラグの手前で切り、端子台（`114217`）へ受ける。**この区間（M-12001 → 端子台）は`通電前の配線確認手順`の対象外である**（`逆接可否表`の設計判断により、この区間の逆接保護はMOSFET（`PROT-RP-01`）が担当する扱いのため）。**ただしMOSFETは未実装であり、現時点でこの区間には手順・部品のどちらの保護も無い。**そのため、慎重のため`確認の方法3`の枠内（電源を接続しない状態でDT830Bの抵抗レンジを使う）で、切る前に導体の色とVBUS／GNDの対応を独自に確認した。

**実施日**: 2026-09-10（JST）。ユーザーが物理的に作業し、Claude Code（本セッション）が手順の指示と記録を行った。

### 構成

| 項目 | 内容 |
|---|---|
| 対象cable | M-12001の出力cable。印字は`E520447`／`AWM STYLE 2464`／`20AWG`等（[hardware-bom.md](hardware-bom.md) `PSU-SERVO-01`行、[power-budget.md](power-budget.md) Revision 101） |
| 計器 | DT830B、抵抗レンジ |
| 治具 | `PSU-INGRESS-01`（`AE-MRUSB-DIP`。案Bにより経路からは外れているが、破棄していない現物。[hardware-bom.md](hardware-bom.md)の状態欄）のreceptacle。**2026-09-08に実測済み**（[tbd-register.md](tbd-register.md) `HW-TBD-007`）: シルク印刷`+`側2 pin＝`VBUS`グループ（導通）、`-`側2 pin＝`GND`グループ（導通）、両グループ間は非導通 |
| 給電 | **無し。**M-12001はコンセントから抜いた状態で作業した |

### 試行1: プラグの金属シェルを基準にした判定（不成立）

**Micro-Bプラグの手前で外被を一部剥き、露出した2本の導体（赤・黒）を確認した。**それ以外の色の導体は無く、**2本の導体のみ**であることをユーザーが申告した。

プラグの金属シェルと、赤・黒それぞれの導体との導通をDT830Bの抵抗レンジで測った。

| 導体 | シェルとの導通 |
|---|---|
| 赤 | オーバーレンジ（導通なし） |
| 黒 | オーバーレンジ（導通なし） |

**2026-09-08にreceptacle側で確認した「金属シェルがGND側グループに含まれる」という対応は、このplug側では成立しなかった。**したがってシェルを基準にした判定は放棄した。**原因は特定していない**（プローブの接触不良か、このcable・plugの構造がreceptacle側と異なる〈USBケーブルではシールドがplug端でGNDに落ちていない構造がありうる〉かは切り分けていない）。

### 試行2: `PSU-INGRESS-01`のreceptacleを基準にした判定

**切り落としたplug側の破片を`PSU-INGRESS-01`のreceptacleへ挿し、変換基板の`+`側pin・`-`側pinそれぞれと、plug片から出る赤・黒の導体との導通を測った。**

| 組み合わせ | 導通 |
|---|---|
| 赤 ↔ `+`側pin | 導通 |
| 赤 ↔ `-`側pin | オーバーレンジ |
| 黒 ↔ `-`側pin | 導通 |
| 黒 ↔ `+`側pin | オーバーレンジ |

**判定: 赤導体＝VBUS、黒導体＝GND。**

**上表の4通りは、導通と開放が相補的に分かれている**（赤↔`+`と黒↔`-`が導通、赤↔`-`と黒↔`+`がオーバーレンジ。全部が導通、または全部が開放という結果にはなっていない）。**これは計器がこの時点で導通と開放を弁別できていたことの内部的な証拠である。**ただし、これは`確認の方法3`(ii)が要求するテスター自体の自己確認（プローブ短絡・開放時の表示値の記録）の代わりにはならない。

この判定に基づき、**端子台へ赤（VBUS）・黒（GND）をネジ止めした（2026-09-10、ユーザーが物理的に実施）。通電はまだ行っていない。****この判定は行ったが、`確認の方法3`(ii)の記録要件を満たしていないため、同手順としては未完了のままである**（下記`この記録が主張しないこと`）。

### この記録が主張しないこと

- **テスター自体の自己確認（プローブ短絡→導通表示、開放→開放表示）は、ユーザーの申告のみであり、具体的な表示値は記録していない。**したがって試行1・試行2の測定そのものの信頼性を、この記録だけで独立に保証できない。**試行2の4通りが相補的なpatternを示したことは計器が弁別できていたことの傍証にはなるが、`確認の方法3`(ii)の記録要件を満たしたことにはならない**
- **試行1が不成立だった原因は特定していない。**プローブの接触不良の可能性を排除していない
- **通電後の実測ではない。**極性が実際に正しいかは、通電後の`測定計画`の確認まで確定しない
- **段階Cの配線承認を与えない。**MOSFETは引き続き未実装であり、この区間には保護部品が無い（`逆接可否表`、`通電前の配線確認手順`の`この手順が主張しないこと`と同じ限定）
- **`PROT-OC-01`（PTC）の実装状況はここでは扱わない。**別作業である

### 結論

**赤導体＝VBUS、黒導体＝GNDと判定し、端子台へその対応でネジ止めした。**M-12001の出力cableの切断・端子台への接続はこれで完了したが、**通電はまだ行っていない。**芯数は2本（赤・黒のみ）であることを確認した。

## EXP-013: ブレッドボード上でのingress保護回路（PTC・MOSFET）の通電検証

**目的**: `PROT-OC-01`（PTC、Bourns `MF-R135`）と`PROT-RP-01`（P-ch MOSFET、東芝`2SJ334`）を直列に仮組みし、通電して次を実測する。(1) 正しい極性で導通すること、(2) 逆極性で阻止すること、(3) 負荷を繋いで給電できること、(4) 訂正前後の向きで挙動が分かれること。

**(3)について。**この記録が(3)の手段として採った給電（ESP32の`5V` pinから）は、**正本が定める経路の外だった。**`ESP32への給電経路が、正本の定める経路の外だった`の節を参照。**(3)そのものを試験項目として立ててよかったかは、この記録では判断しない。**

**(4)を置いた理由。**[power-budget.md](power-budget.md)のRevision 87（2026-09-04）が`PROT-RP-01`のSource/Drainを入れ替えた訂正の根拠は、datasheetと、同文書が既に置いている配線トポロジーの記述だけであり、**実測が無かった。**

**実施日**: 2026-09-14〜2026-09-15（JST）。試験0〜3と作業ミスの発見が09-14、試験4と復帰の確認が09-15である。ユーザーが物理的に作業し、Claude Code（`terminal-114217-assembly`セッション）が手順の指示と記録を行った。

### この記録が`EXP-013`である経緯（作業範囲の変更）

**AIが作成した作業指示書 `WORK-INSTRUCTIONS-003-A1.md`**（**リポジトリ外であり、正本ではない**）は、`EXP-013`を「端子台から下流の基板組立（はんだ付け、非通電）」の記録とする予定だった。**2026-09-14にユーザーが2つの判断を下し、範囲が変わった。**

1. **はんだ付けは、ブレッドボードで動作を確認してからにする。**
2. **「この作業は非通電である」という範囲設定を撤回する。****同記述はAIが書いた作業指示書に由来し、人間が承認したものではない**とユーザーが明言した。

**この2件はセッション内の口頭の判断であり、Issue・Pull Request・正本のいずれにも独立した記録が無い。**この節がその記録である。したがって`EXP-013`はブレッドボードでの通電検証の記録とし、**基板組立は`EXP-014`とする。**（**2026-09-22追記: この予約は成立しなかった。**`EXP-014`は`ENV-01`の`J3`はんだ付けの記録が取った。番号を先に予約しない、という`#0PM`の判定（2026-09-22）による。**この判定はPMセッションのものであり、正本文書に置かれた規則ではない。**`PROTO-02`上の実装と配置の確定は、その記録を書く時点で空いている番号を取る）

### 構成

| 項目 | 内容 |
|---|---|
| 電源 | M-12001（5 V／3 A）。出力cableは`EXP-012`で端子台（[hardware-bom.md](hardware-bom.md)の`WIRE-PWR-01`が持つ秋月 通販114217）へネジ止め済み |
| 保護 | `PROT-OC-01` → `PROT-RP-01`（**Drain=入力側／Source=出力側**）。Gateは10 kΩを介してGND戻りへ。**定格値は[hardware-bom.md](hardware-bom.md)の各行が持つ。ここへ再掲しない** |
| 抵抗 | ゲート用と、試験4の帰路代役用に**別々の2本**。いずれも`RES-PULL-01`（秋月125103、**公称10 kΩ・許容差±5%**）。**個別の実測は行っていない** |
| 実装 | **ブレッドボード上の仮組み。**`PROTO-02`（[hardware-bom.md](hardware-bom.md)のユニバーサル基板）**へのはんだ付けは行っていない** |
| 負荷 | 無し（試験1・2）、ESP32 DevKitC（試験3）、10 kΩ（試験4）。ESP32には[gpio-assignment.md](gpio-assignment.md) Revision 32で実装済みの抵抗7本が接続されたままである |
| 計器 | DT830B |

#### この記録で使う呼び名

**この記録に固有の呼び名であり、正本の用語ではない。**

| 呼び名 | 指すもの |
|---|---|
| **足①／足②** | 端子台の裏から出ている2本のスルーホール足。**赤導体が入っているネジ側と導通するほうを足①、黒導体側を足②とした**（試験0で同定した） |
| **赤の列／青の列** | ブレッドボードの電源用の2列。**通常時、足①を挿した列を赤の列、足②を挿した列を青の列と呼ぶ。**逆極性の試験ではこの2列へ挿す端を入れ替える。**呼び名は場所を指し、その時点の極性を指さない。**本文で「GND戻り」と書いた箇所は、**極性によらず青の列を指す** |

### 試験0: 端子台の極性と内部結線（非通電）

[power-budget.md](power-budget.md)の`servo試験以降で用いる構成`節の`必要な部品`行が定める手順の**(2)**である。同行は(2)を「**下流（`PROT-OC-01`以降）に何も繋がない状態で、`通電前の配線確認手順`の`確認の方法`3（テスターで導通を読む）に従いVBUS・GNDの対応を確認する**」と定めている。**手順(1)(2)(3)はこの行にあり、`経路部品と定格`の`M-12001のcableを受ける端子台`行には無い**（同文書Revision 97が、実務上の配線手順を確認箇所表からこの行へ移したと記録している）。`EXP-012`は(1)（cableを切って端子台へネジ止め）までしか実施していなかった。

**下表の4測定は、下流（`PROT-OC-01`以降）に何も繋がない状態で採った。**

**計器の自己確認**（[power-budget.md](power-budget.md)の`通電前の配線確認手順`の`確認の方法`3(ii)が求めるもの）: 抵抗`2000`レンジで、プローブ開放`1`（オーバーレンジ）、短絡`003`。

| 測定 | 表示 | 判定 |
|---|---|---|
| 赤側ネジ ↔ 足① | `003`で安定 | **短絡時の自己確認と同じ表示。**リード分と区別できず、**この経路の抵抗は分解能以下**。**足① = 赤導体側** |
| 黒側ネジ ↔ 足② | `003`で安定 | 同上。**足② = 黒導体側** |
| 赤側ネジ ↔ 足② | 低い値から上昇し`1480`付近で安定 | M-12001の出力回路を経由（反対の極） |
| 黒側ネジ ↔ 足① | 同上 | 同上 |

**赤導体＝VBUS、黒導体＝GNDという同定そのものは、`EXP-012`のplug破片による判定に依存している。**この試験0が足したのは、その導体が端子台のどちらの足へ出るかである。

**測定中に、値が時間とともに上昇する現象を観測した。**放電した状態でプローブを当てた瞬間は0 Ω付近を示し、充電が進むにつれ上昇して安定する。**M-12001の出力平滑コンデンサによるものと推定したが、原因は確定していない。**容量も時定数も測っておらず、M-12001の内部回路の一次資料も無い。**瞬時値を導通の判定に使わない。****この現象を観測したのは抵抗レンジでの測定であり、後続の電圧・電流測定の読みに及ぶかどうかは見ていない。**

**この現象を知らずに瞬時値を読み、赤と黒の間が2 Ωで短絡していると誤って判定しかけた。**

**副次的に分かったことが1つある。**赤側ネジ ↔ 足②が導通するには`赤ネジ→赤導体→M-12001→黒導体→黒ネジ→足②`の経路が成立している必要がある。**したがって両方の導体が、端子台の金属と電気的に繋がっている。**ネジ頭と足の間の導通だけでは、この判定はできない。**ただしこの読みはM-12001の内部に支配されており、締結部の接触抵抗に上界を与えない。「被覆を噛んでいない」ことも「機械的に保持されている」ことも示さない。**

**5 V往路とGND戻りの間の読みは、下流に何も繋がない状態で`1480`付近（リード分`003`を含む）である。**この値はM-12001の出力回路によるものであり、**両者の間の絶縁を「オーバーレンジ」で判定できないことを意味する。**実測値であって、M-12001の公表仕様ではない。**この値を今後の判定に使うなら、判定のしきい値とともに正本側へ置く必要がある。この記録は置き場所を決めていない。**

### 試験1: 正しい極性・無負荷

| 測定点 | 表示 |
|---|---|
| 入力（赤の列 ↔ 青の列） | `5.35` |
| 出力（`PROT-RP-01`のSource ↔ 青の列） | `5.35` |

**レンジはDC電圧`20V`、最小単位は0.01 Vである。**両者は同じ表示であり、**言えるのは「差は0.01 Vより小さい」ことまでで、「差が0である」ことではない。**`EXP-002`・`EXP-005`が同じ計器で採った扱い（確度を取得していないため、最小単位から不確かさの下限を出す）と同じ形である。

**この試験は下流に負荷を繋いでいない。**流れるのは計器の入力電流とリーク分だけと見込まれるが、**その大きさは測っていない。**

**`5.35`は構成表の公称（5 V）より高い。**この乖離が電源側のものか計器側のものかを、**この記録は判定しない。**計器の確度を取得していないためである。

### 試験2: 逆極性・無負荷

**ブレッドボード側のジャンパー2本を入れ替えて逆極性にした。**端子台のネジは触っていない。

| 測定点 | 表示 |
|---|---|
| 出力（Source ↔ 青の列） | `0.01` |

**`0.01`は最小単位1 count分の表示であり、この計器でこのレンジでは、0と1 countを区別する以上の分解能は無い。**言えるのは「出力は最小単位1 count以下に留まった」ことまでである。

**この結果だけをRevision 87の訂正の裏付けとして使えない。**下流に何も繋いでおらず、訂正前後を分ける機序（試験4を参照）が成立しないためである。

### 試験3: 正しい極性・ESP32を接続

| 測定点 | 表示 |
|---|---|
| ESP32 | **起動した**（基板上のLED点灯。**目視による。他の起動確認は行っていない**） |
| 入力（赤の列 ↔ 青の列） | `5.3` |
| 出力（Source ↔ 青の列） | `5.3` |
| 電流（Source ↔ ESP32の`5V`ピンの間に直列挿入） | `32.2` mA（`200m`レンジ） |

**表の値はいずれも、ESP32を`PROT-RP-01`のSource側へ繋ぎ直した後の測定である**（繋ぎ直しの経緯は`測定中に生じた作業ミス`）。`5.3`と`5.35`は同じ`20V`レンジの表示であり、**末尾の桁が省略されているのか実際にその表示だったのかを、この記録は区別していない。**そのため無負荷時との差を数値として扱わない。

**32.2 mAには、ESP32へ接続されたままの抵抗7本の分が含まれる。**内訳は分けていない。

**電流の読みについて。**[power-budget.md](power-budget.md)の`DT830Bを電流測定に使うときの制約`は、この計器のburden voltageが未取得であり確度も取得できないこと、**この読みだけで電流のgateを通さないこと**を定めている。この32.2 mAも同じ扱いとし、gateの判定には使わない。

**`RDS(on)`について。**[hardware-bom.md](hardware-bom.md)が記録する値は`VGS`=−4 V・`ID`=−15 Aの条件のものであり、**[power-budget.md](power-budget.md)は「実回路が最悪条件で`VGS` ≤ −4 Vを保つ根拠が無い」として、この値を実回路へ適用してよいとは主張していない。**この記録もその限定の下にあり、降下の見積りを行わない。

### 試験4: 向きを変えた2条件の比較（下流loadの帰路の代役を入れた逆接条件）

**試験1〜3は`PROT-RP-01`の向きによる違いを見ていない。**Revision 87が訂正の根拠とした機序は、訂正前後のどちらも**逆接時に下流loadの帰路を経由して出力側が引き上げられること**を前提にしている（同文書の`訂正後の向きでは、同じ故障で次のようになる`）。**試験2は下流に何も繋いでおらず、引き上げる経路が存在しない。**したがって訂正前の向きでも同じ結果になると考えられる。**訂正前の向き・無負荷の条件は取っていないため、これは機序の記述から導いた予測であって観測ではない。**

そこで**ESP32を外し、10 kΩを出力側とGND戻りの間に入れ、下流loadの帰路の代役とした。**そのうえで**端子台からの2本を入れ替えて逆極性にした**（試験2と同じ操作）。Pi・`CABLE-PI-PWR-01`は繋いでいない。**この状態から、向きだけを変えて2条件を取った。**

| | `PROT-RP-01`の向き | 電源の確認（赤の列↔青の列） | 出力↔青の列 | 判定 |
|---|---|---|---|---|
| **A** | **訂正後**（Drain=入力側／Source=出力側） | `-5.35` | `0` | 阻止 |
| **B** | **訂正前**（Source=入力側／Drain=出力側） | **測っていない** | `4.85` | 導通 |

**Bの`4.85`について、プローブの当て方と符号を記録していない。****向きの変更は、`PROT-RP-01`本体を挿し替えずに行った。**ブレッドボード上で、`PROT-OC-01`からの線と帰路代役の10 kΩの挿し先を、**`PROT-RP-01`のDrainの足が挿さっている行とSourceの足が挿さっている行の間で入れ替えている**（`2SJ334`のpin配列は刻印面から見て左から`1.ゲート 2.ドレイン 3.ソース`。正は[power-budget.md](power-budget.md)の`実装方法を決定した（2026-09-03）`）。**3本の足はいずれも同じ行に挿さったままで、Gate—GND戻りの10 kΩも動いていない。****端子台からの2本（極性）も触っていない。****ただしBの時点で極性を測っていないため、この記録はBが逆極性であったことを測定では示していない。**

**レンジはDC電圧`20V`、最小単位は0.01 V。**Aの`0`が意味するのは「出力とGND戻りの電位差は0.01 Vより小さい」ことである。Aの電源確認は**赤プローブを赤の列、黒プローブを青の列へ当てて読んだ。**負号は、このとき赤の列が低電位側であること、すなわち極性が反転していることを示す。**ゲート抵抗は両条件で接続したままである。**

**試験2の`0.01`と試験Aの`0`の差を、この記録は解釈しない。**どちらも最小単位1 count以下であり、この計器では区別できない。

**Aは1度やり直している。**最初の試行でも出力`0`を得たが、**そのとき端子台がブレッドボードから抜けており、電源が回路へ届いていなかった。****「阻止した」と「電源が来ていない」は、出力の読みでは区別できない。**最初の手順には電源の存在を確認する測定が無く、その欠陥をこの事象で発見した。**やり直しでは出力を読む前に赤の列↔青の列を読み、`-5.35`を確認したうえで出力の`0`を得ている。**上表のAはやり直したほうの値である。

**抜けた箇所の判定は、作業者の目視の申告による。**線と端子台のねじ止めについても、外れていないという申告のみで、締結を測り直していない。

**試験0〜3（09-14）と試験4・復帰（09-15）の間、仮組みを保持したか組み直したかを記録していない。**したがって「向きだけを変えた2条件」が成立する範囲は、**試験4のAとBの間に限る。**

#### Bで観測された電圧

Bで10 kΩの両端に`4.85`が掛かっている。**この電圧が`PROT-RP-01`の内蔵diodeとchannelの並列に掛かった残りと対応するが、この記録はその値を確定しない。**理由は3つある。

- **試験Bの時点で入力電圧を測っていない**（上表）。引き算の相手が無い
- **試験Bでchannelが確実にOFFであることを測っていない。**逆接時に`VGS` ≥ 0となることは配線トポロジーから導けるが、実測ではない
- **10 kΩは公称値であり、許容差±5%の幅を持つ。**電流の算出にその幅が乗る

**datasheetの`VDSF`（内蔵diodeの順方向電圧）は`IDR` = −30 Aでの最大1.7 Vのみを与えており、この桁の電流の値を持たない。**この記録はその空欄を埋めない。

#### 復帰を確認した

**試験Bのあと、`PROT-RP-01`を訂正後の向き（Drain=入力側）へ戻し、端子台からの2本を正極性へ戻した。**そのうえで出力↔青の列を読み、`5.35`を得た。**このとき帰路代役の10 kΩは出力↔青の列の間に入ったままで、ESP32は繋いでいない。**

**この測定が示すのは、極性が正極性であることと、入力から出力まで経路が繋がっていることである。****向きが戻ったことは、この測定では弁別できない。**正極性では訂正前の向きでも導通すると考えられるためである（**この条件は取っていない。**機序の記述から導いた予測である）。**向きの復帰は、上の2本の線をどの列へ挿し戻したかの目視による。****弁別できる確認（逆極性で出力が`0`に戻ることの再確認）は行っていない。**

**試験Bは既知の誤った向きで通電する試験であり、戻し忘れると以後の通電がすべて逆極性保護の無い状態になる。**この記録は、次に通電する者がその状態を引き継がないために置く。

#### この試験から次へ渡すもの

**出力が`0`であることを結果として使う試験では、出力を読む前に、電源が回路へ届いていることを読む。**

`0`は「阻止した」とも「電源が来ていない」とも読める。**どちらも同じ表示になるため、出力の読みだけでは区別できない。**この記録の試験Aは、最初の試行でその区別ができておらず、やり直しになった。

**これはこの試験に固有の穴ではない。**同じ形は、「電流が流れないこと」「信号が出ないこと」「エラーが出ないこと」を結果として使うすべての測定にある。**期待する結果が「何も起きないこと」であるとき、測定系が死んでいても同じ表示になる。****期待どおりの表示が出たときほど気づけない。**

**この文はこの記録に置いたものであって、手順の正本ではない。**規則として立てるなら[power-budget.md](power-budget.md)の`測定計画`側へ置く。**そこへ渡す残件である。**

**当面の宛先は`HW-TBD-034`である。**同項が扱う方式1の実装は、「brownoutが起きなかった」「resetしなかった」という**「何も起きないこと」を結果として使う測定**であり、この穴の直上にある。索引表の`EXP-013`行がこの対応を指している。

### 測定中に生じた作業ミス（記録）

**AI（本セッション）の指示の誤りにより、ESP32を一時的に保護部品の手前へ接続して通電した。**

仮組みの定義では赤の列は`PROT-OC-01`の手前だったが、**AIが自分が2つ前のメッセージで定義した回路を見直さずに「赤の列 → ESP32の`5V`ピン」と指示し、そのまま通電させた。****ESP32は`PROT-OC-01`も`PROT-RP-01`も通らずに給電された。**気づいたのは、ユーザーが電圧値を報告した後である。

**この間、経路に過電流保護部品が無い。**[hardware-safety-policy.md](../governance/hardware-safety-policy.md)の安全要件5項目の「短絡」が「**過電流保護部品（`PROT-OC-01`）が入るまで、故障電流を制限するものが経路に無い**」として挙げている状態にあたる。**部品の破損は確認していない。**この間ESP32は起動しており、その後の試験3でも同じESP32が起動しているが、**通電後に部品や動作を系統的に確認したわけではない。****事後確認の要否について、PMが判定を出した（2026-09-15）。**内容は「系統的な事後確認は行わない」である。根拠は3点である。(1) **この通電では故障を観測していない**（ESP32は起動し、入力側は`5.30`。その後の試験3でも同じESP32が保護経路を通って起動し`32.2` mAだった）。**ただし保護部品の手前を流れた電流、`PROT-OC-01`／`PROT-RP-01`の状態、潜在的な劣化は確認していない。**(2) M-12001が3 Aまで供給できることと、3 Aが流れたことは別である。(3) **定格を超えた量が部品へ掛かった記録が1つも無い**（**記録の不在であって、超過の不在ではない**）。

**この判定はAIセッション（PM）の提案であり、人間の承認を受けていない。**[AGENTS.md](../../AGENTS.md)は「PMの指摘・提案・作業指示書は、人間の承認を代替しない」と定めている。**したがって現時点で発効していない。承認されるまで、事後確認を要さないものとして扱わない。**

> **2026-09-16の訂正。**直前の段落（「この判定はAIセッション（PM）の提案であり…発効していない」）は2026-09-15時点の記述である。
>
> **2026-09-16、ユーザー（人間）がこの判定を承認した。**したがって**この判定は発効している。**
>
> **あわせて、ユーザーがESP32を無事と判断した**（判断はユーザーによる。理由は記録しない。ただし、この判断は、起動の確認以外の点検の結果ではない。ai-agent-policy.md）。**記録上、起動の確認の手段は、試験3は基板上のLEDの目視、作業ミスの間は記録していない。****この記録に書かれているESP32の起動は、作業ミスの間と試験3の2回である**（**ユーザーの判断がこの2回を指していたかを、この記録は述べない**）（この記録でESP32へ通電したのはその2回である。**この記録の範囲（2026-09-14〜09-15）より後にESP32を使ったかどうかを、この記録は述べない**）。**それ以外の点検を行った記録は無い。****試験3の起動について確認したのは、基板上のLEDの点灯までである**（試験3の表。**目視による**）。**作業ミスの間の起動については、確認の手段を記録していない。**
>
> **この判断はESP32についてのみである。**`PROT-OC-01`／`PROT-RP-01` の状態には触れない。**両素子は未確認のままである。**
>
> **書き換えないのは、直前の段落である。**下の`承認された場合に閉じる条件`が置いている限定（**未確認の部品状態に対する残余リスクの受容であって、部品状態を確認したことにも、段階Cの安全要件を満たしたことにもならない**）は、**この訂正では変わらない。**「無事と判断した」は点検の結果ではない。
>
> **`承認された場合に閉じる条件`は、承認により現に有効な残件になった。**この記録に書かれている2回の起動は、いずれも同条件が言う「次にこのESP32を使うとき」より前の出来事である。**同条件が満たされたという記録は無い。「無事と判断した」が同条件を満たしたという記録も無い。**（**いずれも記録の不在であって、事実の不在ではない。**この記録は範囲外について述べない。）
>
> **この承認と判断は、セッション内で口頭により与えられた。**Issue・Pull Request・正本のいずれにも独立した記録は無い。**この訂正がその記録である**（2026-09-14の2件と同じ扱い）。
>
> `EXP-013` は、この判定が**発効していない提案のまま** `develop` へ入った（[PR #404](https://github.com/wachi-yoshitaka-11-dev/deskcat/pull/404)、2026-09-16 merge）。**承認と判断はその後である。**発効していなかった期間が実在したことを、記録として残す。

**承認された場合に閉じる条件。**新しい試験は行わず、次にこのESP32を使うときの起動を見ることで閉じる。**これは未確認の部品状態に対する残余リスクの受容であって、部品状態を確認したことにも、段階Cの安全要件を満たしたことにもならない。**異常が出たときに疑う先として、この節を指す。

**この判定が言っていないこと。**判定したのは**起きなかったことについて**であって、**指示の出し方が正しかったということではない。**保護部品を通らない経路で通電させた指示そのものは誤りである。

**この間に読んだのは入力側の`5.30`だけである。**これは保護部品より手前の値であり、その位置の値としては有効である。ジャンパーを`PROT-RP-01`のSource側へ移して測り直したものが試験3である。**保護部品を通った値と通らない値を比較できる組は取っていない。**

### ESP32への給電経路が、正本の定める経路の外だった

**この記録でESP32へ通電した2回（試験3と、上の作業ミスの間）は、いずれも`5V` pinからの給電である。**[power-budget.md](power-budget.md)の`ESP32の給電経路`は、次を定めている。

> **案Aと案Bはどちらも段階C（合成給電）の話であり、段階Cのgate（端子台、過電流保護部品、大電流経路の線材が揃うこと。2026-09-09、案Bにより「変換基板」から差し替え）を満たすまで実施しない。**それまでのESP32への通電は、段階B-1／B-2の経路（PCのUSBから給電）で行う。3つを混同しない。

**段階Cのgateは満たしていない。**したがってこの2回の給電は、この定めの外である。**AIが同節を開かずに手順を出した。**

**排他制約（Micro USB／`5V` pin／`3V3` pinの2つ以上から同時に給電しない）は満たしている。**作業前にPCのUSBを抜いており、ESP32が載ったブレッドボードには抵抗7本のほかに電源へ繋がるものが無いことを作業者が確認している。**これは作業者の申告であり、この記録で独立に検証していない。**案Bがblockedである理由（VBUSと`5V` pinが同時に生きたときの逆流）は、USBを外しているため生じていない。

**次も同じ経路は使わない（2026-09-15、PMの判定）。**`ESP32の給電経路`の定めどおり、段階Cのgateを満たすまで、ESP32への通電は段階B-1／B-2の経路（PCのUSBから給電）で行う。**例外を作らない。****これは正本が既に定めていることの再確認であり、新しい許可を与えるものではない。**したがって承認待ちの状態に依らず、**正本の定めがそのまま効いている。**

### 正本との食い違いを残している

**この記録は`power-budget.md`を1文字も変更していない。**そのため次の食い違いが残る。

- 同文書の`servo試験以降で用いる構成`の`必要な部品`行は「**(2)(3)の下流接続はまだ行っていない**」「**通電もまだ行っていない**」と書いている
- 同文書の`経路部品と定格`の`M-12001のcableを受ける端子台`行は「同手順としては**未完了**のまま」「**通電はまだ行っていない**」と書いている

**この記録が確定させたのは(2)の実施と通電である。**この2つについては、**未決なのは正本の記述をどう直すかであって、実体の状態ではない。**

**(3)については別である。**この記録は「(3)を満たしたかどうかは判定しない」としている（`結論`）。**引用した正本の2文は(3)にも掛かっており、そちらについては実体の状態も未決である。**

**したがって、正本のこれらの記述を「古い」として一律に消せない。**(2)と通電の部分と、(3)の部分を分けて判定する必要がある。**その判定はこの記録では行わない。****引き受け先は決めていない。**この記録は残件を挙げるだけで、誰がいつ解消するかを定めていない。

> **訂正（2026-09-16）。**上の段落は書き換えない。**引き受け先が決まった。**[#407](https://github.com/wachi-yoshitaka-11-dev/deskcat/issues/407)（昇格[PR #383](https://github.com/wachi-yoshitaka-11-dev/deskcat/pull/383)のCodeRabbit指摘5件の解消）が引き受け、**決めたのはPM（別セッション）である**（2026-09-16）。**これはAIセッションの判定である。****人間は`#407`の起票を承認しており、その本文はこの引き受けを受け入れ条件として含む。****ただし引き受けそのものを個別に承認したという記録は無い。****PMの判定そのものについて、Issue・Pull Request・正本のいずれにも独立した記録は無い。この訂正がその記録である。**同Issueで[power-budget.md](power-budget.md)を全数走査し、同じ主張を持つ5箇所を訂正した（上に引用した2箇所に加え、`M-12001に直付けされたcable`行、`M-12001のcableを受ける端子台`行の状態欄、`選定基準`節）。**(2)の実施と通電を反映し、(3)の未決と`通電前の配線確認手順`の記録要件の未充足は、どちらも残した。****この記録の測定値も結論も変えていない。**

### この記録が主張しないこと

- **計器の自己確認を記録したのは抵抗`2000`レンジだけである。**DC電圧`20V`レンジと電流`200m`レンジについては、自己確認の表示値を記録していない。**`確認の方法`3(ii)は通電前の導通確認に掛かる手順であり、通電後の電圧・電流測定はその対象ではない。**したがってこれは同手順の未達ではないが、**これらのレンジの読みには、計器が正しく読めていたことの独立な裏付けが無い**
- **`経路部品と定格`表の検証ではない。**ブレッドボードの接点が経路に入っており、[power-budget.md](power-budget.md)の`大電流経路にbreadboard接点とジャンパー線を使わない`が定める構成規則を満たさない。**この仮組みは同規則に対する例外を主張するものではなく、規則の対象である「gate対象の大電流経路」を構成したとも主張しない**
- **段階C（合成給電）を開かない。**Piは接続していない
- **32.2 mAは最大時の値ではない。**Wi-Fi停止、周辺module未接続の値である
- **`PROT-OC-01`（PTC）の保護動作を試験していない。**この記録で読んだ最大の電流は32.2 mAであり（**起動時の突入は測っていない**）、**過電流時の挙動（trip、trip時間、復帰）は1つも測っていない。**表題の「保護回路の通電検証」は、直列に入れた状態で導通したことまでを指す
- **電流経路がchannelか内蔵diodeかを決めていない**
- **試験Aで阻止した素子が`PROT-RP-01`であることを決めていない。**経路は`PROT-OC-01`（PTC）との直列であり、**Aで確認したのは`PROT-OC-01`の手前まで電源が来ていることである。****試験Aの時点で**同素子が電流を通せる状態であったことを示す測定は取っていない（試験3と試験Bは`PROT-OC-01`を通した測定だが、**試験Aの直前に`PROT-OC-01`からの線を動かしている**）
- **試験Bが逆極性であったことを、測定では示していない。**AとBの間で端子台からの2本を触っていないという事実によるものである
- **試験4が観測したのは、1点だけである。**下流loadの帰路を10 kΩ1本で代替した条件での観測であり、**ESP32・Pi・servoやそれらのbulk capacitorは繋いでいない。**実際の負荷は抵抗1本ではなく、電流も桁が違う。**試験AとBで入力電圧が同じであったことも測っていない**
- **起動時の過渡を測っていない**
- **逆極性保護が機能すると主張しない。**観測したのは上記の条件での阻止であって、`逆極性保護のdesign review`が承認した範囲の全体ではない。**同節が既に述べるとおり、`PROT-RP-01`はingressに1個入るだけで下流の手配線区間を守らない**
- **`確認の方法`5（電源経路の線を1本でも抜き差ししたら新しい配線revisionであり、手順を最初から通す。初回通電には人間の立ち会いが要る）を、この記録の各配線変更について通していない。****該当する操作は、この記録に書いてあるだけで6回前後ある**（試験1→2の極性入れ替え、試験2→3の極性戻しとESP32接続、作業ミスの繋ぎ直し、試験3→4Aの構成変更と極性入れ替え、4A→4Bの付け替え、復帰）。**回数を確定していない。****人間（作業者本人）は全行程に立ち会っているが、手順の再実施の記録は無い**
- **嵌合接点について何も足さない。**Piを接続していないため、`経路部品と定格`の「`CABLE-PI-PWR-01`のMicro-B plugとPiの`PWR IN` receptacleの嵌合接点」行（定格`TBD`）は動かない
- **`CABLE-PI-PWR-01`をrail側で受ける端子台の「締結と保持」についても何も足さない。**この記録が測ったのはM-12001を受けるingress側の端子台であり、別の接続部位である
- **star point構成については何も述べていない。**この仮組みのGND戻りはブレッドボード上の単一の列であり、star point・`MEAS-01`のshunt・`ADC-SHUNT`を含むtopologyは組んでいない
- **`HW-TBD-007`／`021`／`022`／`030`／`034`のいずれもcloseしない。**上限1.08 Aも動かさない
- **はんだ付けは行っていない。**`PROTO-02`上の実装と配置の確定は`EXP-014`である（**2026-09-22追記: この番号の予約は成立しなかった。**`EXP-014`は`ENV-01`の`J3`はんだ付けの記録が取った。**2026-09-22時点で`origin/develop`の見出しは`EXP-013`が最後であり、`EXP-014`の見出しは存在しなかった**（この段落の予約は本文中の言及であって、見出しではない）。番号を先に予約しない、という`#0PM`の判定（2026-09-22）による。**この判定はPMセッションのものであり、正本文書に置かれた規則ではない。****`PROTO-02`上の実装と配置の確定は、その記録を書く時点で空いている番号を取る。**この予約以外の記述は変更していない）

### 結論

**`PROT-RP-01`の向きを変えた2条件で、出力の読みが分かれた。**訂正後は`0`（このとき赤の列↔青の列に`-5.35`を確認）、訂正前は`4.85`である。

**この違いを向きに帰すには2つの前提が要り、どちらもこの記録は測定で示していない。**試験Bが逆極性であったこと（`主張しないこと`）と、試験Aで阻止した素子が`PROT-RP-01`であること（同）である。**したがって「向きを弁別した」とは書かない。**

**読みの分かれ方の向きは、同訂正が述べた機序が予想する向きと一致している。****機序そのものを確かめたわけではない**（電流経路がchannelか内蔵diodeかを決めていないため）。Revision 87はそれまでdatasheetと配線トポロジーからの机上の議論だけを根拠にしており、**この回路に通電した記録はこれが最初である。**

**観測したのは、下流の帰路を10 kΩ1本で代替した条件の1点である。**実際の負荷・電流・容量での確認ではなく、起動時の過渡も測っていない。**試験AとBで入力電圧が同じであったことも測っていない。**

**目的(1)（正しい極性で導通すること）と(2)（逆極性で阻止すること）について。**(1)は試験3で導通を観測した（試験1で流れたのは計器の入力電流だけであり、電流を通せることの観測ではない）。(2)は試験2・4Aで出力が最小単位付近に留まることを観測した。**ただし試験2は下流に何も繋いでおらず、向きによらず同じ読みになると考えられる条件である**（試験4の冒頭。**予測であって観測ではない**）。**阻止した素子も特定していない**（`主張しないこと`）。

**目的(3)（負荷を繋いで給電できること）について。**ESP32を繋いで起動させ、`32.2` mAを読んだ。**達したとみなす。**ただしその手段（`5V` pin給電）が正本の定める経路の外だったことは別節のとおりで、**項目を立ててよかったかはこの記録では判断しない。**

**正極性では、ESP32を動作させた。**電流は`32.2` mA。入力と出力は同じ表示（`5.3`）だったが、**末尾の桁の扱いを区別していないため、差の上限をこの記録では与えない。**

**試験Bのあと訂正後の向きと正極性へ戻し、出力`5.35`を測定した。**ただしこの測定は極性と導通を示すもので、**向きの復帰は目視による。**

あわせて、`servo試験以降で用いる構成`の`必要な部品`行が定める手順の**(2)に当たる確認を行った。**足①が赤導体側、足②が黒導体側である。**同行の(3)（合っていることを確認してから下流を繋ぐ）を、この記録が満たしたかどうかは判定しない。**同行は下流としてbreadboard railを挙げており、**この記録の下流接続がそれに当たるかは正本側で確定させる話である。**この記録は自分の読みを置かない。**正本側の記述は未更新であり、食い違いが残っている。**

## EXP-014: `ENV-01`（BME280）の`J3`はんだジャンパの実施記録

**目的**: `ENV-01`（AE-BME280）をI2Cで使うために要る`J3`のはんだジャンパ（`CSB`→`VDD`）の実施を記録する。
**この記録は実験ではなく、既に行われた現物作業の事後記録である。**
**この記録を書いたAIセッションは実施にも確認にも立ち会っていない**（他のセッションについては記録が無く、判定しない）。**実施者は訊いていないため記録しない。**

**実施日**: **2026-09-07**。**記録日**: 2026-09-22。
**実施日の根拠は、15日後（2026-09-22）のユーザーの回答だけである。**写真・作業ログ・購入履歴などと照合していない。**時刻系（JST）も確認していないため書かない。**

> **この記録は、他の`EXP`と水準が違う。**測定表（測定点・レンジ・読み・判定）を**持たない。**
> 根拠は**ユーザーの申告だけ**である。2026-08-22の導通確認（[sensor-datasheet-notes.md](sensor-datasheet-notes.md)の
> `現物の実装状態を実測で確定させた（2026-08-22）`）は測定表を持つが、**この記録は持っていない。**
> **持っていない測定値を、同じ体裁で並べない。**

### 構成

| 項目 | 内容 |
|---|---|
| 対象 | `ENV-01`。BME280モジュール（秋月 K-09421 / AE-BME280）。**部品の特定は[hardware-bom.md](hardware-bom.md)の`ENV-01`行が正である** |
| 対象jumper | `J3`。**I2C時にはんだでジャンパする** jumper であり、閉じると`CSB`(pin3)が`VDD`(pin1)へ繋がる（[AE-BME280製品説明書 v1.1](https://akizukidenshi.com/goodsaffix/AE-BME280_manu_v1.1.pdf)。jumperの意味の正は[sensor-datasheet-notes.md](sensor-datasheet-notes.md)の`jumper（AE-BME280）`節） |
| 作業 | `J3`のはんだ付け |
| 確認方法 | **写真とテスター**（ユーザーの申告） |
| 給電 | **`EXP-001`〜`EXP-013`を`ENV-01`と`BME280`で検索して0件だった**（2026-09-22）**。****2026-09-07の作業時に通電したかどうかは、この記録では判定しない**（この記録を書いたAIセッションは立ち会っておらず、ユーザーの申告にも給電の有無は含まれていない） |

### 得たもの

**`J3`ははんだ付け済みである。**

ユーザーは2026-09-22に、`J3`ははんだ付け済みで、人間が写真とテスターで確認した、と言明した（原文は省略）。

**そのうえで、記録に要る3点をAIが個別に質問し、ユーザーが回答した。**

| 質問 | 回答 |
|---|---|
| `J3`のはんだ付けを実施したのはいつか | **2026-09-07** |
| テスターで何を測ったか | **測定点は、ユーザーは覚えておらず、提示したケースのいずれも結果は問題なしだったと申告された（人間の回答。原文は省略）** |
| `J1`／`J2`の現在の状態は | **`J1`／`J2`とも開放のまま（回答。原文は省略）** |

**`J1`／`J2`が開放であることは、この3つ目の質問への回答である。**`J3`の言明から導いたものではない。

**2つ目の質問の選択肢を逐語で残す。**「`VDD`↔`CSB` の導通を測った」「別の測り方をした」「測定点までは覚えていない」の3つで、設問文に「2026-08-22 の開放確認は `VDD`(pin1)↔`CSB`(pin3) の抵抗を測り開放でした」と添えた。
**したがって、提示したケースが何を指すかは確定できない。****同日の測定表にある他の測定点まで含むのかは、回答からは決まらない。**
**加えて、問題なしという回答の意味は端子によって逆である**（`J3`では導通、`J1`／`J2`では開放）。
**したがってこの回答を測定結果として使わない。**`J3`＝はんだ付け済み、`J1`／`J2`＝開放は、
**1つ目と3つ目の回答、および冒頭の言明に拠る。**

**どの端子間をどのレンジで測り、何と読んだかは記録に残っていない。**
2026-08-22の記録が持つ`VDD`(pin1) ↔ `CSB`(pin3)の読みに対応する2026-09-07時点の読みは、**この記録には無い。**

### `J1`／`J2`の状態

**2026-09-22時点で両方とも開放のまま**である（上の3つ目の質問への回答）。
**この時点での再測定の記録は無い。**2026-08-22の実測結果が変わっていないという申告として扱う。

**この状態は、依存している判断を1件そのまま生かす。**[power-budget.md](power-budget.md)の
`単体bring-upとB-2の区別`行が置いたADXL345の片側断線時fault電流上界は、
**BME280側の`J1`／`J2`が開放であることを前提としている。****この前提が崩れていないことの根拠は、2026-09-22のユーザーの回答だけである。****再測定はしていない**（`J1`／`J2`の実測は2026-08-22が最後である）。**「前提が確認された」とは書かない。「変わっていないという申告を得た」である。**
（[#16](https://github.com/wachi-yoshitaka-11-dev/deskcat/issues/16)が2026-09-21に引き受けていた条件付きの再計算である。**引き受けの記述は同Issueの本文にあり、リポジトリ内の文書には無い**（[power-budget.md](power-budget.md)のRevision 115は同じ件を`#15`へ帰属させている）。）

**判定した範囲を明示する。**同行の上界は`SDA`／`SCL`の2 lineに載るpull-upだけを入力にしており、
`J1`／`J2`はその2 lineへBME280側の4.7 kΩを足すかどうかを決めるjumperである。**足されていない。**
**`J3`が閉じたことで新たに生じたのは`CSB`(pin3)↔`VDD`(pin1)の接続であり、`SDA`／`SCL`ではない。**
**ただしこの記録は、`J3`の閉が同上界へ影響しないことを測定で確かめてはいない。**
判定したのは**pin配列と各jumperの意味という資料上の事実**からであり
（`J3`＝`CSB`→`VDD`、`J1`／`J2`＝`SDI`／`SCK`へのpull-up選択。正は
[sensor-datasheet-notes.md](sensor-datasheet-notes.md)の`jumper（AE-BME280）`節）、
**実配線と実測によるものではない。**

### この記録が主張しないこと

- **この記録を書いたAIセッションは`J3`の閉を確認していない**（他のセッションについては記録が無く、判定しない）**。**写真も測定値も、記録した本セッションでは見ていない。根拠はユーザーの申告だけである。
- **`VDD`↔`CSB`間の導通を測定値として持っていない。**2026-08-22の`開放`と対になる`導通`の読みは記録に無い。
- **通電の有無を主張しない。**`EXP-001`〜`EXP-013`を`ENV-01`と`BME280`で検索して0件だった（2026-09-22）が、**2026-09-07の作業時に通電したかどうかは判定しない**（この記録を書いたAIセッションは立ち会っておらず、ユーザーの申告にも給電の有無は含まれていない）。**記録として確かなのは、この記録を書いたAIセッションがChip ID（register `0xD0`、reset値`0x60`）の読み出しを行っていないことだけである。**
- **`J1`／`J2`を2026-09-22に測り直していない。**
- **はんだ付けの品質を判定していない。**ブリッジ、未接合、隣接pinへの流れのいずれも確認していない。
- **`HW-TBD-005`をcloseしていない。**closeに要る5項目のうち、この記録が新たに`済`にしたのは`J3`のはんだ付け1件だけである（済ませたのは2026-09-07の現物作業であって、この記録ではない）。**5項目それぞれの現在の状態は[sensor-datasheet-notes.md](sensor-datasheet-notes.md)の`closeまでに要ること（実装と確認を含む）`表が持つ。ここへ件数を再掲しない。**
- **[power-budget.md](power-budget.md)を1文字も変更していない。**同文書の`ACCEL-01`／`ENV-01`単体bring-up手順の条件(1)項目5は未更新のまま残る（理由は`結論`）。

### 記録が15日遅れた

**実施は2026-09-07、記録は2026-09-22である。**
この15日間の状態を、文書ごとに分けて書く。**同じではない。****この表は網羅ではない**（対象外に置いた古い記述3件は[sensor-datasheet-notes.md](sensor-datasheet-notes.md)の`記録が15日遅れた経緯`節に挙げる。うち`power-budget.md`の12行だけ下の`結論`でも扱う）。

| 文書 | 2026-09-22までの状態 |
|---|---|
| [sensor-datasheet-notes.md](sensor-datasheet-notes.md) | `J3`＝**開放**、`closeまでに要ること`の#2＝**未実施**と書いていた |
| [gpio-assignment.md](gpio-assignment.md) | 4箇所が`J3`未実施を前提にしていた（`ENV-SDA`行・`I2C sensor bus`行・項目5の判定基準の3箇所が「はんだ付けが要る」、`I2C addressの選択`節の1箇所が「アドレス配線は`J3`のはんだ付けと同じ機会に行う」） |
| [tbd-register.md](tbd-register.md) | `HW-TBD-005`が「済んでいるのは実装状態の確定だけである」と書いていた |
| **この文書** | **`J3`に関する記述が1件も無かった。**誤った記述があったのではなく、**記録が存在しなかった** |
| `firmware/esp32/src/main.rs` | `run_i2c_bringup`のdoc commentが「BME280側は`J3`のはんだ付けが要る」と現在形で書いていた。**Markdownの正本ではないが、`firmware/`の走査で当たったため同じ変更で更新した** |
| Issue [#16](https://github.com/wachi-yoshitaka-11-dev/deskcat/issues/16) | 残件に「`ENV-01`の`J3`はんだジャンパ（未実施）」と書いていた。**この記録のPull Requestでは直せない**（fileではないため）。本文の更新は[#453](https://github.com/wachi-yoshitaka-11-dev/deskcat/issues/453)の作業として別途行う |

**判明したのは2026-09-22にユーザーが言明したときである。**
それまでAI側はこの欠落を検出していない。**記載が無いことを「やっていない」と読んだためである。**

**2026-09-07の時点でAI側がこの作業を知らされていたかどうかは、記録が無く、この記録では判定しない。**
**したがって「AIが聞いたのに書かなかった」とも「AIは知らなかった」とも書かない。**
**確かなのは、15日間どの正本にも記録が無かったことだけである。**

**`EXP-013`が記録する2026-09-14の決定との関係を書いておく。**
**同決定（上の決定の節）には、対象を限定する語が無い。****`ENV-01`の`J3`を含むかどうかを、この記録では判定しない。****確かなのは、`J3`のはんだ付け（2026-09-07）が同決定（2026-09-14）より前であることだけである。**

**以後の運用として提案する**: 人間が現物で行った作業は、AIが知った時点で正本か`EXP-0xx`へ残す（**この記録では`J3`の実施者を訊いていないため特定していない。**運用としては人間一般を指す）。
**AIが同席していない作業は、AIが知らなければ残せない。**そのため、
現物作業の有無をAI側から訊く機会を、bring-up手順の着手時に置くのがよい。
**これは提案であり、まだどの正本にも置かれていない。****この記録は手順を1文字も変更していない。**
**置くかどうかと置き先を決めるのは人間である。残ることとして挙げる。**

### 結論

**`ENV-01`の`J3`は2026-09-07にはんだ付け済みであり、この現物の構成はI2C向けになった。****根拠はユーザーの申告だけである。実測ではない。****「構成がI2C向け」は`J3`にはんだが乗っているという申告までを指し、`CSB`と`VDD`が電気的に繋がっていることは主張しない**（下記`この記録が主張しないこと`）。
**`J1`／`J2`は開放のままである。**

**`J3`が閉じたことで、条件(1)項目5のうち1件が「`J3`未はんだのため対象外」ではなくなった。**[power-budget.md](power-budget.md)の
`ACCEL-01`／`ENV-01`単体bring-up手順の条件(1)項目5のうち、`ENV-01`の`CSB`→`VDD`である。
**ただし「はんだ付けされている」と「`CSB`と`VDD`が電気的に繋がっている」は別である。**未接合の可能性を判定していないため、**接続の成立自体をこの記録は主張しない。****項目5の確認も未実施である。**下記のとおり。
**同手順は`J3`をはんだ付けしてから始めるか、せずに始めるかを選ばせており、はんだ付け済みの側が確定した。**

**ただしこの記録では[power-budget.md](power-budget.md)を変更していない。**理由は2つである。
(1) 別セッションが同文書を並行して編集している。**該当はcommit `62219b4`**（`#454`。`docs/governance/hardware-safety-policy.md`／`docs/hardware/power-budget.md`／`docs/hardware/servo-safety-limits.md`から制約2件を削除する変更。branch `claude/deskcatremove-constraints-ef34e0`へpush済みで、**2026-09-22時点でPull Requestは未作成**）。同commitは`power-budget.md`のRevision履歴へ`94`を追加している（**`origin/develop`（`35bcc36`）の同fileは`118`まであり、この`94`は番号として衝突している。本記録はこの点を判定せず、引き受け先も決めていない。`62219b4`側で扱う話である**）。
(2) **条件の更新は、この記録が正本へ入ってからが順序として正しい。**先に書くと、根拠が正本に無い状態で「満たした」と書くことになる。

**残っているのは条件(1)項目5だけではない。**同文書で`J3`の状態に依存する記述は、`ACCEL-01`／`ENV-01`単体bring-up手順とその根拠節に**12行ある**（2026-09-22に`origin/develop`（`35bcc36`）の版へ`grep 'J3' docs/hardware/power-budget.md`で全数を数えた。**`62219b4`がmergeされれば変わりうる。**同fileの`J3`の出現は34行、うち21行は逆極性保護MOSFET`2SJ334`の一部でありこの`J3`とは無関係である。残る13行のうち12行が手順とその根拠節にあり、`J3`の状態が変わったら読み直しが要る（うち291行目は「`J3`の選択によらず異常」と述べる行で判定自体は状態に依存しないが、**同じ手順の中にあるため読み直しの対象に数えた**）。**13行目（2245行目）は測り方の先例として2026-08-22の開放確認を引く参照であり、現在の状態を主張していないため更新の対象にならない**）。**「1行直せば終わる」ではない。**

**引き受け先はまだ決まっていない。**同文書の上記12行の更新は、
**この記録のPull Requestと、上記`62219b4`（`#454`）の変更の両方がmergeされた後に決める。**

**この12行の引き受け先は、[#453](https://github.com/wachi-yoshitaka-11-dev/deskcat/issues/453)の範囲外である**（同Issueの`対象外`節）。**両Pull Requestのmerge時点で引き受けるIssueが無ければ、その時点で起票が要る。**担当を決めるのはPMセッター（`#0PM`）であり、**これはAIセッションの役割分担であって、正本文書に置かれた規則でも、人間の承認でもない。****この記録はその判定を代行しない。**

**手順を実行する人のために、この2つの関係を書いておく。**
項目5が求めているのは**配線が正しいことの現物確認（非通電）**であり、
`J3`については「はんだ付けされているか」を見ることである。
**この記録が示すのは、はんだ付けされている**という申告である。
**したがって、項目5を事前充足として飛ばしてよいという意味ではない。**
`J3`をはんだ付けせずに始める選択肢が消えた、という意味である。
**手順の実施時には、他の項目と同じように`J3`の閉を現物で確認する。**
**この記録は測定値を持たないため、その確認の代わりにならない。**

## EXP-015: `ACCEL-01`（ADXL345）／`ENV-01`（BME280）のESP32`3V3` pin給電による初回通電とDevice ID読み出し

**目的**: [#445](https://github.com/wachi-yoshitaka-11-dev/deskcat/issues/445)の2026-09-22承認（周辺module3点のうち`ACCEL-01`／`ENV-01`の2点に限り、ESP32自身の`3V3` pinから給電する）に基づき、[power-budget.md](power-budget.md)の`ACCEL-01／ENV-01単体bring-upの手順`を実施し、両moduleのDevice ID読み出しを試みる。[#15](https://github.com/wachi-yoshitaka-11-dev/deskcat/issues/15)／[#16](https://github.com/wachi-yoshitaka-11-dev/deskcat/issues/16)の受け入れ条件の判定材料とする。`ENV-01`の`J3`（`CSB`→`VDD`のはんだジャンパ）は事前にはんだ付け済みという前提で実施した（[EXP-014](#exp-014-env-01bme280のj3はんだジャンパの実施記録)参照。同記録は根拠をユーザーの申告のみに置き、測定値を持たない）。

**実施日**: 2026-09-22（JST）。

**実施者**: 配線、非通電確認（項目1・5・6・7）、通電中の監視、通電後の再測定はユーザーが物理的に行った。firmwareのbuildと書き込み、シリアルログの読み取り実行は別のClaude Codeセッション（実機Linux上、「Linux実機」）が行った。この記録の作成はDeskCat ACCEL-01/ENV-01 bring-up support（本セッション、VM上のworktree）が行った。**本セッションはUSB busへアクセスできず、配線・通電・実測のいずれも行っていない。**

### 構成

| 項目 | 内容 |
|---|---|
| 給電 | ESP32単体、PCのUSBから（`ACCEL-01`／`ENV-01`は`3V3` pin経由で同時通電）。`DISP-01`は未配線（条件(4)） |
| firmware commit | `35bcc36d74b7347201c0aade20a45715300b0475`。`run_i2c_bringup`実装（`4486de5`）、`SERVO-01` driver追加（`059743b`）、UART0 mode切替（`28bc38b`）のいずれも`35bcc36`の祖先である（＝`35bcc36`がこれら3つの変更をすべて含む）ことを`git merge-base --is-ancestor`で確認済み（Linux実機セッションの申告） |
| build | `cargo build --locked`（debug、条件(2)用）と`cargo build --locked --release`（flash用）。featureフラグ指定なし（`default = []`のまま、`pi-protocol-mode`は無効）。boot logの`App version=35bcc36-dirty`と一致（`dirty`はbuild時の一時的な`[workspace]` shimによるものとLinux実機セッションが申告） |
| 配線 | `ACCEL-01`: `Vs`/`VDD`→`3V3`、`GND`→`GND`、`SDA`→GPIO25、`SCL`→GPIO26、`CS`→同module上の`VDD`、`SDO`→`GND`。`ENV-01`: `VDD`→`3V3`、`GND`→`GND`、`SDI`→GPIO25（共有）、`SCK`→GPIO26（共有）、`SDO`→`GND`、`CSB`は外部配線せず`J3`はんだジャンパ経由（下記`この記録が主張しないこと`参照） |
| 待機時間の上限 | 3分（180秒）。`run_i2c_bringup`のI2C通信timeoutは`esp_idf_svc::hal::delay::BLOCK`（無期限）であり、この上限に技術的根拠は無い（firmware側が保証する値ではなく、実施前に人間が承諾した運用上の値） |

### 通電前の非通電確認（条件(1)、[gpio-assignment.md](gpio-assignment.md)の`電源pinの短絡・誤配線の確認（非通電）`表）

| # | 項目 | 結果 |
|---|---|---|
| 1 | `VCC`–`GND`間短絡検出 | `ACCEL-01`と`ENV-01`の`VDD`/`Vs`が同一ブレッドボード行に配線されているため、moduleごとの分離測定はできず、合算で1回測定した。プローブ接触時**1341 Ω**、数秒後**1210 Ωで安定**。「低いまま動かない」には該当せず、正常と判定した |
| 5 | 一覧との目視照合 | ユーザーが実施し、一致・異常なしと申告 |
| 6 | 逆極性・電圧違いpinの確認 | 同上 |
| 7 | 給電経路の重複確認 | 同上 |

**条件(5)(a)（`module電源pinの独立性`／`pin header対応`、[gpio-assignment.md](gpio-assignment.md)の別の受け入れchecklist項目）は満たしていない。**`ACCEL-01`/`ENV-01`の`VDD`/`Vs`、`SDA`、`SCL`がいずれもESP32側の対応pin（`3V3`、GPIO25、GPIO26）と同一ブレッドボード行に直接刺さっており、「moduleの電源pin ⇔ ESP32のpin」という2点間の抵抗測定が物理的に成立しない（同一node）。**この状態のまま、人間の現場判断で通電へ進んだ。**配線を分離して測定し直すか、この制約のまま受け入れるかは持ち越し。

`bus容量Cb`（受け入れchecklistの別項目、実効pull-up抵抗の並列合成が有効範囲内であること）は未測定のまま通電した。PM（`#0PM`）が「通電を止めない」と判定し、人間がこの判定を受けて条件(6)（通電してよい）を明示した。**判定の技術的根拠（数値・導出）はこの記録では特定できないため書かない。**判定があった事実だけを記録する。

### 通電と結果（手順8〜10）

USB接続によりfirmware書き込み＝初回通電。約3分間、異音・発熱（module、ESP32 board、`U2`）・火花・変色・異臭はいずれも認めなかった（ユーザーの申告）。

シリアルログ:

| 対象 | 生byte | 期待値（出典） |
|---|---|---|
| `ACCEL-01`（`accel_device_id`） | `raw=0xe5` | `0xE5`（[sensor-datasheet-notes.md](sensor-datasheet-notes.md)のDevice ID行） |
| `ENV-01`（`env_chip_id`） | `raw=0x60` | `0x60`（同上） |

**一致・不一致の判定はこの記録では行わない**（[power-budget.md](power-budget.md)の手順10が「一致するかは判定せず、値をそのまま記録する」と定めているため）。両方とも応答が得られたため、手順10の運用（`(a)(b)`が確認でき次第、給電を止める）に従い、この時点で給電を停止した。手順9の停止条件（異音・発熱・火花・変色・異臭、または3分無出力）はいずれも発生しなかった。

給電停止後、`VCC`–`GND`間抵抗を再測定した（`DT830B`、2000Ωレンジ）: **1218 Ω**（通電前の安定値1210 Ωに近い値。「低いまま動かない」への変化は認められなかった）。

### この記録が主張しないこと

- **Device ID読み出しの「一致」は判定していない。**生byteと期待値を併記しているだけであり、達成の主張ではない
- **`ENV-01`の`J3`（はんだジャンパ）を、この記録の一部として現物確認していない。**「はんだ付け済み」は別セッション（DeskCat BME280 J3はんだ付け記録、実施日2026-09-07）の申告に基づく。今回`env_chip_id`が応答した事実は、`J3`が機能している（`CSB`が`VDD`へ接続されている）ことと整合するが、この記録単独でその状態を検証したものではない
- **条件(5)(a)（`module電源pinの独立性`／`pin header対応`）は未達のまま進めた。**「配線方式のため測定不能」という制約を記録するだけで、代替手段で満たしたとは主張しない
- **`bus容量Cb`（実効pull-up抵抗の並列合成が有効範囲内であること）は未測定のまま。**PM判定に基づき進めたが、この記録が同項目を満たしたとは主張しない
- **3分という待機時間の上限に技術的根拠は無い。**firmware側のI2C通信timeoutは無期限（`BLOCK`）であり、この上限を超えなかったことは「異常が無かった」ことの傍証にはなるが、「何秒以内に応答する」という保証を示すものではない
- **`ACCEL-IRQ`（割り込み）、`DISP-01`との同時動作、Pi側との通信は範囲外。**この記録では扱っていない
- **通電後の抵抗再測定（1218 Ω）は短絡の有無の簡易確認であり、moduleの健全性を精密に証明するものではない**
- **本セッション（記録者）は配線・通電・実測のいずれも物理的に行っていない。**実施はユーザーとLinux実機セッションによる
- **計器（`DT830B`）自体の自己確認（短絡→導通表示、開放→開放表示）は記録していない。**`EXP-012`／`EXP-013`と同じ限定であり、この記録単独で測定系の信頼性を独立に保証できない
- **この記録の生byte・抵抗値は、このセッションが直接見たシリアルログや写真ではなく、ユーザーとの会話での報告に基づく。**Linux実機セッションが読んだシリアルログの原文そのものは、このセッションには渡されていない

### 結論

`ACCEL-01`（ADXL345）・`ENV-01`（BME280）とも、ESP32`3V3` pin給電下でDevice ID読み出しに応答があった（生byte: `0xe5`、`0x60`）。通電中・通電後とも異常の兆候は認められなかった。**条件(5)(a)は未達のまま通電に至っており、この点は正本（`power-budget.md`）の手順の想定（条件を満たしてから通電）と食い違う。**`Issue #15`／`#16`の受け入れ条件はいずれも未達（配線・初回通電という現物作業は完了したが、calibration・sampling等のソフトウェア側の検証は残っている）。この判定は記録者からPM（`#0PM`）へ報告し、PMは異論無しと確認した。その後、`EXP-014`との相互参照linkを追加した版の本文をPMが読み、祖先関係の記述の反転（`firmware commit`行）と`bus容量Cb`の判定根拠の帰属（数値の出所を特定できないため削除した）の2点を指摘した。いずれもこの記録の現在の本文へ反映済みである。

## EXP-016: `DISP-01`（MSP2807）ESP32`3V3` pin追加接続のbring-up（controller識別・単色fill・四隅pattern）

**目的**: [power-budget.md](power-budget.md)の「`DISP-01`追加接続のbring-upの手順（ESP32`3V3` pin給電、`#461`承認範囲）」を実施し、`ACCEL-01`／`ENV-01`が既に`3V3` pinへ接続・通電済みの状態（[EXP-015](#exp-015-accel-01adxl345env-01bme280のesp323v3-pin給電による初回通電とdevice-id読み出し)）へ`DISP-01`を追加接続する。[Issue #13](https://github.com/wachi-yoshitaka-11-dev/deskcat/issues/13)の受け入れ条件6件のうち1〜5の判定材料とする。

**実施日**: 2026-09-27（JST）。

**実施者**: 配線、非通電確認、通電中の監視、停止判断、写真・動画撮影はユーザーが物理的に行った。firmwareのbuild、書き込み（`espflash`）、シリアルログの読み取りは実機Linuxのセッション（本記録の作成者）が行った。**手順7（書き込み）は正本（`power-budget.md`）が`[人間]`と指定しているが、実際にはユーザーの立ち会い・監視のもとでこのセッションが`espflash`を実行した。手順の指定と異なる。**詳細はFaultsを参照。

### 構成

| 項目 | 内容 |
|---|---|
| 給電 | ESP32単体、PCのUSBから。`ACCEL-01`／`ENV-01`は既存配線（`EXP-015`）のまま、`DISP-01`を同じ`3V3` railへ追加接続 |
| firmware commit | `9fdaee417e7803df9c928b54d8b390bc7dc3f9a0`（`origin/develop`）。試験直前に`origin/develop`を再確認し、進行が無い（`9fdaee4`のまま）ことを確認した上でこのcommitのbuildを使用した。試験後に`origin/develop`が`bb5cfc2`（`#446` PR B、[PR #480](https://github.com/wachi-yoshitaka-11-dev/deskcat/pull/480)）へ進んだが、この記録の対象は`9fdaee4`のbuildである（`#0PM`の判定） |
| build | `--features bringup-display-13`（debug）。`cargo fmt`（既定構成）／`cargo clippy --all-targets --locked -- -D warnings`（既定構成・`bringup-display-13`構成の両方）／`cargo build --locked`（同）すべて成功。Version Record: [2026-09-26-esp32-build-bringup-display-13-native-linux.md](../toolchains/version-records/2026-09-26-esp32-build-bringup-display-13-native-linux.md) |
| 配線（`DISP-01`、9本） | 基板印字での対応: `VCC`→ESP32`3V3` pin、`GND`→GND、`CS`→GPIO22、`RESET`→GPIO16、`DC/RS`→GPIO17、`SDI`→GPIO23、`SCK`→GPIO18、`LED`→GPIO4、`SDO`→GPIO19。touch用5pinは未配線 |
| 待機時間の上限 | 5分（ユーザーが通電開始前に決定） |

### 条件(1)〜(7)の充足状況

条件(1)（電源pinの短絡・誤配線の確認）・(2)（`bringup-display-13` build済み）・(3)（電流余裕計算の前提(a)〜(d)）・(4)（`ACCEL-01`／`ENV-01`接続済みへの追加）・(6)（`HW-TBD-025`(b)未解決の把握）・(7)（`run_display_bringup`実行の承認記録、[Issue #13コメント](https://github.com/wachi-yoshitaka-11-dev/deskcat/issues/13#issuecomment-5804046159)）はいずれも満たした。

**条件(5)（`module電源pinの独立性`／`pin header対応`）は未達のまま通電に至った。**`EXP-015`と同じ理由（ESP32側の対応pinとmoduleの電源・信号pinが同一ブレッドボード行にあり、2点間の抵抗測定が物理的に成立しない）。確認できたのは「他のGPIO・5V rail・GND・`3V3`への意図しない導通が無いこと」だけである。この状態のまま、ユーザーの現場判断で通電へ進んだ（ユーザーの言葉: （原文省略））。

### 通電前の非通電確認（`gpio-assignment.md`の`電源pinの短絡・誤配線の確認（非通電）`表、項目1〜4）

| # | 項目 | 結果 |
|---|---|---|
| 1 | `VCC`–`GND`間短絡検出 | 2000Ωレンジで測定。プローブ接触時**2000**、数秒後**1212 Ωで安定**。「低いまま動かない」には該当せず、正常と判定した |
| 2 | 一覧との目視照合 | ユーザーが実施し、9本すべて一致・touch用5本は未配線と申告 |
| 3 | 逆極性・電圧違いpinの確認 | 同上、異常なしと申告 |
| 4 | 給電経路の重複確認 | 同上、単一経路（`3V3` pin）であることを申告 |

### Faults（実施中に生じた想定外の事象。手順9の判定とは区別して記録する）

- **手順7（書き込み）は正本が`[人間]`と指定しているが、実際にはこのセッション（AI）が`espflash`を実行した。**ユーザーは立ち会い・物理的な監視（異音・発熱・変色・異臭の確認、停止判断）を行ったが、コマンドの実行そのものは手順の指定と異なる。**この経緯の中で、ESP32のUSBポートを、同じマシンに接続されていたArduino Unoのポート（`/dev/ttyACM0`）と取り違え、そちらへの書き込み・接続を複数回試行して失敗した。**`lsusb`でUSBデバイス一覧を確認し、`Silicon Labs CP210x`（`/dev/ttyUSB0`）が正しいESP32のポートであると判明してから、以降の試行を`/dev/ttyUSB0`へ切り替えた。
- **配線作業中（通電前）、旧firmware（前回書き込んだ`bringup-display-13`構成）が動作している状態でUSBを接続した際、backlightが一瞬点灯してすぐ消えたことをユーザーが観測した。**これは`power-budget.md`の手順7が明記する想定内の事象（書き込み前に残っている旧imageが`run_display_bringup`を呼びうる）であり、この記録の手順9判定には使っていない。
- **`DISP-01`の`VCC`ジャンパ配線の途上で、moduleのheader pin（`VCC`）を一度曲げ、その後まっすぐに戻した。**pin単体の健全性（表側先端と基板裏はんだ部分の導通、ほぼ0Ω）は確認済みで、これ自体が原因ではなかった。
- **`DISP-01`の`VCC`とESP32の`3V3` pinの間の導通が、複数回の測定でオーバーレンジ（未導通）だった。**`VCC`–`GND`間、pinの健全性はいずれも正常だったため、ブレッドボードの接触不良（該当ジャンパ経路のどこか）が原因と推定される。ジャンパの取り扱い・接続し直しの後、再測定で**0 Ω**（導通あり）を確認し、以降の通電試験へ進んだ。**断線箇所（ジャンパ線自体か、ブレッドボードの接触か）は特定できていない。**
- **`ADC-5V`測定用の配線（青、GPIO33用の分圧回路の一部）が、`DISP-01`配線作業中に一時的に脱落した。**復旧後、(a) USB抜去でESP32board上のLEDが消灯することを確認し独立電源でないことを確認、(b) 分圧回路の構成（`5V pin`→抵抗→分圧点→`GPIO33`、分圧点→抵抗→`GND`）が保たれていることをユーザーが申告した。この配線は`DISP-01`回路とは無関係である。**この脱落・復旧の際にUSBが抜けていたかどうかは不明（ユーザーが覚えていない）。**
- **配線を変えた（`VCC`ジャンパの付け直し、`VCC` header pinの曲げ・戻し、`ADC-5V`配線の脱落・復旧）後、`gpio-assignment.md`の`電源pinの短絡・誤配線の確認（非通電）`項目1〜4（手順2）をやり直さずに、`VCC`–`3V3`間の導通だけを確認して通電を再開した。**条件(1)は、項目1〜4が`DISP-01`について完了していることを通電の前提にしている。配線を変えた後の状態について、この前提を確かめ直さずに通電した。
- **ソフトウェア（`pyserial`経由のRTS pin toggle）によるESP32のリセットは、本機では機能しないことを複数回の試行で確認した。**`espflash`自身が内部で行うhard reset（flash完了後）は機能する。USBの完全な抜き差し（電源の再投入）も確実にリセットを引き起こした。
- **試験中に同じマシンへ接続されていたArduino Unoについて、DeskCatのブレッドボード（GND・5V・信号線のいずれか）への接続は無く、PCのUSBに挿してあっただけであることをユーザーに確認した。**条件(3)(a)（`3V3` railの負荷は4点のみ）・項目4（給電経路の重複）の前提には影響しない。

### 通電と結果（手順7〜10）

複数回の通電・書き込みを行った（`VCC`接触不良の切り分けのため）。**この記録が判定に使うのは、`VCC`導通（0 Ω）を確認した後に実施した試験である。**通電中・通電後とも、異音・発熱（`DISP-01`、`ACCEL-01`、`ENV-01`、ESP32 board）・火花・変色・異臭はいずれも認めなかった（ユーザーの申告、複数回）。

シリアルログ（`--features bringup-display-13` build、`espflash flash --monitor`で取得）:

```text
I (621) deskcat_esp32: display_id raw=[00, 00, 00, 00] matches_ili9341=false
E (621) deskcat_esp32: display_id_mismatch expected_id_hi=0x93 expected_id_lo=0x41 got_hi=0x00 got_lo=0x00
I (871) deskcat_esp32: display_fill name=black color=0x0000 elapsed_us=244820
I (1121) deskcat_esp32: display_fill name=red color=0xf800 elapsed_us=244779
I (1371) deskcat_esp32: display_fill name=green color=0x07e0 elapsed_us=244752
I (1621) deskcat_esp32: display_fill name=blue color=0x001f elapsed_us=244767
I (1871) deskcat_esp32: display_fill name=white color=0xffff elapsed_us=244773
I (2171) deskcat_esp32: display_corner_pattern elapsed_us=39995
I (2171) deskcat_esp32: accel_device_id raw=0xe5
I (2181) deskcat_esp32: env_chip_id raw=0x60
```

（複数回の試行で、`display_fill`のelapsed_usは244752〜244820 usの範囲に収まり、`display_corner_pattern`のelapsed_usは全試行で39995 usと一定だった。いずれも再現性があった）

**目視・写真・動画による確認（ユーザー実施）**:

- **backlight**: bring-up実行中（約2.2秒間）のみ点灯を複数回にわたり再現性をもって確認した。それ以外の時間は消灯している（firmwareが明示的に消灯させる処理は`main.rs`に見当たらないため、原因は未確認のまま残す）。
- **単色fill**: 黒→青→緑→赤→白の順で表示された（firmware側の送信順は黒→赤→緑→青→白）。**黒・緑・白は一致、赤と青が入れ替わって表示された。**
- **四隅pattern**: 4隅それぞれに色付きの四角が表示された（写真2枚で確認。基板を180度回転させて撮った2枚の内容が対角に一致しており、同一フレームであることを確認した）。firmware（`main.rs`の`run_corner_pattern`）の指定は左上=赤、右上=緑、左下=青、右下=白（背景は黒）。写真での見え方は、左上=青系、右上=緑、左下=赤系（写真では薄いピンクがかって写っている。反射・露出の影響の可能性）、右下=青系（本来白だが、青みがかって写っている。安価なLCDパネルの視野角特性、または写真のホワイトバランスの影響である可能性があり、電気的な問題である証拠は無い）。**色は上記の赤/青入れ替わりと整合しており、四隅の物理的な配置（orientation）自体はfirmwareの意図（左上/右上/左下/右下）と一致していると判断する。**
- **「上下」の判断基準**（DeskCatへ搭載時にどちらを上にするか）は、正本（`sensor-datasheet-notes.md`の`対応orientation command`行、`TBD`）にも`display.rs`のmodule docにも定義が無く、この試験で新たに決定するものでもない。この記録は「firmwareが指定した論理座標`(0,0)`が、物理的にどちらの隅に対応するか」を示すにとどまる。

### 通電後の抵抗再測定（手順10）

`DISP-01`の`VCC`–`GND`間、2000Ωレンジ。通電前**1212 Ω**→通電直後の測定で**オーバーレンジ**。「低いまま動かない」への変化ではないため、この時点では新たな短絡の兆候は無いと判定した。

**この読みの整合性について、同日（2026-09-27、JST。PMの指摘を受けて）USBを抜いた状態で再測定した。**結果: (a) `DISP-01`の`VCC`pin⇔ESP32の`3V3` pin間の導通=**0 Ω**（導通あり）、(b) `DISP-01`の`VCC`–`GND`間=**1212 Ω**（手順2の項目1の値と一致）。**この再測定は、上記「通電直後のオーバーレンジ」と同じ`VCC`–`GND`間の測定でありながら異なる値を示しており、整合していない。**測定点・レンジ・手順が同一であることは確認したが、値の食い違いの原因（測定時点でのジャンパ接触状態の違い、プローブの当て方の違い等）は特定できていない。**この食い違いにより、上記「通電と結果」節が記録した試験の間、`DISP-01`の`VCC`接触が安定して保たれていたかどうかは確認できない。**（受け入れ条件の判定への留保は下表に記載する）

### 受け入れ条件との対応（[Issue #13](https://github.com/wachi-yoshitaka-11-dev/deskcat/issues/13)）

| # | 受け入れ条件 | 判定 | 根拠 |
|---|---|---|---|
| 1 | Controller識別情報と初期化の根拠 | **未達** | `display_id raw=[00,00,00,00]`、期待値`0x9341`と不一致。書き込み方向（`MOSI`／`SCLK`／`CS`／`DC`）はfillの実測結果（後述）から機能していると判断できるため、原因は読み出し方向（`MISO`）または`RESET`関連の可能性が高い。`gpio-assignment.md`が事前に記録していた`MISO`方向の`VOH`余裕不足の懸念（約34–133 mV不足の可能性）が一因である可能性がある。特定はできていない。**加えて、手順10の再測定（上記）が`VCC`–`GND`間で整合しない値を示しており、`VCC`の接触が試験中を通じて安定していたかは確認できない。この`display_id`不一致が接触不良の影響である可能性も排除できない** |
| 2 | 単色fillが正しい | **部分的**（色の正しさは条件3参照） | 5色とも一様に表示され、ちらつき等の異常は無かった（目視・写真）。fill自体の実行は正常 |
| 3 | Color orderが正しい | **未達** | 赤と青が入れ替わって表示される（黒・緑・白は一致）。`ILI9341`のcolor order設定（`COLMOD`／`MADCTL`のBGRビット等）がpanelの実際の配線と一致していない可能性が高い |
| 4 | 四隅とorientationが正しい | **orientation（位置）は一致、色は条件3に従う** | 4隅の物理配置はfirmwareの意図と一致。「上下」の絶対的な正解は正本に定義が無く、DeskCat搭載時の向きという別の設計判断を要する |
| 5 | 更新timingを測定した | **達成** | `display_fill`×5色（elapsed_us≈244752〜244820）、`display_corner_pattern`（elapsed_us=39995）を記録した |
| 6 | 更新中も通信とwatchdogがactiveである | **未達（既知）** | このbuildは`pi-protocol-mode`と排他のため実protocol sessionを確立できない。依存先は[#446](https://github.com/wachi-yoshitaka-11-dev/deskcat/issues/446)およびLCD・通信同時動作のfirmware変更（`#13`残作業） |

### この記録が主張しないこと

- **`display_id`不一致の根本原因（`MISO`か`RESET`か、あるいは別要因か）は特定していない。**さらなる切り分け（信号レベルの実測、オシロスコープ等）を要する
- **色入れ替わり（赤/青）の修正箇所（firmwareのcolor order設定変更）は行っていない。**この記録は現象の確認までである
- **backlightが bring-up 完了後に消灯する挙動の原因は特定していない。**firmwareが明示的に消灯させているのか、単に何も保持していないだけなのかは未確認
- **`DISP-01`の`VCC`接触不良の断線箇所（ジャンパ線自体かブレッドボードの接触か）は特定していない。**再現性の確認や部品交換による切り分けは行っていない
- **写真・動画は現場（ユーザーの手元）に保管されており、この記録に添付・commitしていない。**内容の記述はユーザーの申告と、共有された画像2枚の目視に基づく
- **DeskCat搭載時の「上」の向きは、この記録では決定していない。**別途の設計判断が要る
- **条件(5)（`module電源pinの独立性`／`pin header対応`）は未達のまま通電した。**`EXP-015`と同じ制約であり、この記録で解消したとは主張しない
- **`ACCEL-01`／`ENV-01`のDevice ID読み出し（`raw=0xe5`、`raw=0x60`）は期待値と一致しているが、これは`EXP-015`で既に確認済みの再確認であり、新規の知見ではない**

### 結論

`DISP-01`（MSP2807）をESP32`3V3` pinへ追加接続してのbring-upを実施した。**受け入れ条件のうち、条件5（timing測定）は達成、条件2（fillの実行自体）は部分的に達成、条件1（controller識別）・3（color order）・6（通信とwatchdog）は未達、条件4（orientation）は位置についてのみ確認できた（色は条件3のバグを反映）。**通電中・通電後とも安全上の異常（異音・発熱・変色・異臭・新たな短絡）は認めなかった。試験の過程で`DISP-01`の`VCC`配線に一時的な接触不良が見つかり、修正したが、手順10の再測定でこの接触の安定性に食い違いが見つかり、試験全体を通じて`VCC`が安定して接続されていたかは確認できていない。**手順7（書き込み）を正本の指定と異なりAIが実行したこと、配線変更後に手順2をやり直さなかったことも、正本からの逸脱として記録する。**`Issue #13`の受け入れ条件6件のうち、条件5以外は達成していない。

## EXP-017: `DISP-01`（MSP2807）`BGR=1`適用後の再確認——色順の確認と、四隅・格子patternでの位置の食い違いの発見

**目的**: `EXP-016`で見つかった赤/青入れ替わりに対する`#485`（MADCTL `BGR=1`）の修正を実機で確認し、`display_id`不一致の追加切り分けを行う。[Issue #13](https://github.com/wachi-yoshitaka-11-dev/deskcat/issues/13)受け入れ条件1・3・4の判定材料とする。

**実施日**: 2026-09-27（JST）。

**実施者**: 配線確認（非通電）、通電中の監視、停止判断、写真撮影はユーザーが行った。firmwareの変更・build・書き込み（`espflash`）・シリアルログの読み取りは実機Linuxのセッション（本記録の作成者）が行った。**手順7（書き込み）は正本（`power-budget.md`）が`[人間]`と指定しているが、実際にはユーザーの立ち会い・監視のもとこのセッションが`espflash`を実行した。`EXP-016`に続いて2回目の同じ逸脱である。**

### 構成

| 項目 | 内容 |
|---|---|
| 給電・配線 | `EXP-016`から変更なし。`DISP-01`の`VCC`ジャンパを挿し直して導通を再確立した（下記「配線変更後の再確認」参照）。pin割り当て・backlight制御経路・SPI構成は変更していない |
| firmware base commit | `0797525`（このworktreeのHEAD、`#485`のMADCTL `BGR=1`）。**`git diff 0797525 a404de2`は空（tree同一）であることを確認した。**`a404de2`は`origin/develop`上でこのcommitをsquash mergeした結果であり、内容は同一である |
| **firmwareの追加変更（未commit）** | 本記録の試験のため、`firmware/esp32/src/main.rs`へ診断用の暫定変更を加えた。**この変更はcommitしていない。**現時点のsha256: `2143d7d3b7228f94a8ba428a446939a2a2f3bd00643f99f052091d1fa6430e07`（`git diff --stat`: 80行追加・2行削除、`display.rs`は変更なし）。変更内容は3段階: (a) `run_corner_pattern`実行後に1秒間隔で無限に再描画するloopを追加、(b) `corners`配列のGREEN/BLUE割り当てを一時的に入れ替え、(c) 四隅pattern（2箇所のみ）では位置由来か色の値由来かを切り分けられないため、新規関数`run_grid_pattern`（4列×5行・20 cell、外側＋内側に別色の入れ子四角、`[RED,GREEN,BLUE,WHITE]`巡回）を追加し、loopの呼び出し先をこちらへ切り替えた |
| build | `--features bringup-display-13`（debug）。各段階で`cargo fmt --check`／`cargo clippy --all-targets --locked -- -D warnings`／`cargo build --locked`をすべて実行し成功（scratchpad上のworktree外copyでbuild） |

### 条件(7)の範囲についての記録

[Issue #13コメント](https://github.com/wachi-yoshitaka-11-dev/deskcat/issues/13#issuecomment-5804046159)が承認した条件(7)は、`run_display_bringup`の内容（controller識別→単色fill→四隅pattern）を前提にしていた。**本記録の試験は、その内容を診断目的で変更している**（無限loop化、色割り当て入れ替え、四隅pattern→格子patternへの差し替え）。**実行経路（`run_display_bringup`が呼ばれること）・使用pin・backlight制御は`#485`から変えていない**が、描画内容自体は承認時点の前提と異なる。**この変更をユーザーが指示・承認した上で実施した**（ユーザーの言葉:（原文省略））が、承認の記録が会話内のみであり、正本・Issueへの記録はこの`EXP-017`が初出である。**無限loop化によりbacklightが継続点灯し続けたが、これは条件(3)（電流余裕計算）が前提とする通常動作（backlight点灯を含む）の範囲内である（`#0PM`が確かめた判断）。**

### 配線変更後の再確認（`gpio-assignment.md`の`電源pinの短絡・誤配線の確認（非通電）`項目1〜4、`DISP-01`の`VCC`）

- 項目1（`VCC`–`GND`間短絡検出）: `DISP-01`の`VCC`ジャンパを挿し直し、2000Ωレンジで複数回測定。挿し直し前後・ケーブルを動かしても**1212 Ω**で安定（`EXP-016`の基準値と一致）。
- `VCC`pin⇔ESP32`3V3` pin間の導通: **0 Ω**（複数回、安定）。
- **`MISO`線（`DISP-01`の`SDO` pin⇔ESP32 GPIO19）の導通確認を実施した。**結果: **0 Ω**（導通あり、単純な断線ではない）。`display_id`不一致の原因切り分けに使える情報として記録するが、原因の断定はしない。
- 項目2〜4（目視照合・逆極性確認・給電経路重複確認）: ユーザーが実施し、`EXP-016`と変わらないと申告。
- **手順10（通電後の抵抗再測定）は行っていない。**

### backlightが消灯する挙動について

**`EXP-016`ではこの挙動を「原因未確認」としていたが、firmwareのsourceを読んで説明がついた。実測では確かめていない。**

`Ili9341`構造体は`bl: PinDriver<'d, Output>`を持つ（`display.rs` 147〜152行）。`run_display_bringup`（無限loop追加前の版）が`run_corner_pattern`実行後に関数を抜けると、`lcd`（と`bl`）がdropされる。`esp-idf-hal 0.46.2`の`impl Drop for PinDriver`（`gpio.rs` 1153〜1157行、このセッションでsourceを直接読んで確認した）は`gpio_reset_without_pull(self.pin)`を呼び、同関数（`gpio.rs` 1384行〜、同様にsourceを確認した）は`GPIO_MODE_DISABLE`・`pull_up_en=DISABLE`・`pull_down_en=DISABLE`でpinを再設定する。GPIO4（`LCD-BL`）は`EXP-011`が記録した外部`4.7 kΩ` pull-downにより、この時点でLowへ落ちる。**backlightがsoftware駆動でHighを保っていたのが、`lcd` dropによる暗黙のGPIOリセットで失われ、外部pull-downでLowになる、という一連の流れがsource上で説明できる。**電源側の問題ではない。**この経路をsourceの読解で示しただけであり、実測（オシロスコープ等でGPIO4の電圧推移を確認する等）では確認していない。**

### 単色fill色順の確認（受け入れ条件3）

シリアルログ（`display_fill`）は黒→赤→緑→青→白の順で送信。**目視結果: 黒→赤→緑→青→白の順で一致した（`EXP-016`で見つかった赤/青入れ替わりは解消した）。**この確認は**画面全体を単色で塗る`fill_screen`によるものであり、位置に関係しない。**複数回のflash（無限loop化版・GREEN/BLUE入れ替え版・格子pattern版のいずれも単色fill部分は共通）で再現性を確認した。**目視のみ。写真記録は無い。**`power-budget.md`の手順9は「logに加えて人間がpanelを目視（写真記録）で確認」したときに達成としており、**写真記録が無いため、正本が定める達成の条件は満たしていない。**「目視で確認した」限りで記録する。

### 四隅pattern・格子patternでの位置の食い違い（受け入れ条件4、未解決）

**この節は上記の色順確認とは別の現象であり、原因を共有するとは主張しない。**

四隅patternの目視結果のうち、**firmwareの版を直前に明示した上でユーザーが直接その場で述べた**ものは次の2件である（**いずれも背景は黒ではなく濃紺に見えた**。写真のwhite balance等の影響である可能性があり、電気的な問題である証拠はない）:

| 表示条件 | firmwareの版 | 左上 | 右上 | 左下 | 右下 |
|---|---|---|---|---|---|
| 無限loop化版・継続表示（写真あり） | `corners`配列: 右上=GREEN・左下=BLUE（元の割り当て） | 赤 | 青 | 緑 | 白 |
| 無限loop化版・継続表示 | `corners`配列: 右上=BLUE・左下=GREEN（GREEN/BLUEを入れ替え） | 赤 | 緑 | 青 | 白 |

firmwareが右上の座標に指定した色は、1行目ではGREEN、2行目ではBLUEである。実際に右上の位置に見えた色は、1行目ではBLUE（＝firmwareが左下に指定した色）、2行目ではGREEN（＝firmwareが左下に指定した色）だった。左下についても同様に、firmwareが左下に指定した色ではなく右上に指定した色が見えた。**色は、firmwareがその座標へ指定した値には従っていない。指定どおりの色は、意図と別の位置（右上の座標に指定した四角が左下に、左下の座標に指定した四角が右上に）に現れている。**色の値そのものに原因があるのではなく、**位置（どちらの座標に描かれるか）が入れ替わっている。**

**ほかに、診断用の変更を入れる前のbuild（`0797525`そのまま、単発flash）でも四隅patternを目視したが、見え方とfirmwareの版・flashの回・timingの対応を、会話記録から確実に再構成できなかった**（後日この記録を書く際に複数回試みたが、結果が一致しなかった）。したがってこの回の観測は上表に含めない。

格子pattern（20 cell、写真あり）でも同じ性質が見られた。firmwareが`COLS=4`（`WIDTH`軸のつもり）×`ROWS=5`（`HEIGHT`軸のつもり）で意図した配置に対し、**実際に写真で見えたのは4行×5列で、物理的な「行」ごとに色が同じで「列」方向には変わらないパターンだった。**この見え方は、色を決めるのがfirmwareの`col`変数（`WIDTH`軸のつもり）のみであり`row`変数（`HEIGHT`軸のつもり）が色に影響しないという計算結果と一致する。**四隅の結果と同じく、色の値ではなく座標の対応関係の食い違いである。**

**この観測から、「firmwareが`x`（CASET）に渡す値と`y`（PASET）に渡す値が、物理的にどちらの軸へ対応するか」について、firmwareの想定と実際の見え方が食い違っている、とまでは言えるが、それ以上の断定はしない。**理由:

- **向きの基準が無い。**「縦」「横」「右上」は、moduleをどちら向きに持って見たかに依存する。本記録の上記2件の写真および格子patternの写真では、module上の目印（左上の緑色tab、左edgeの`J4`表記の小pin header、右edgeの`J2`表記の長いpin header）が同じframe位置に写っており、**このセッション内では同じ持ち方だったと判断できる。**しかし`EXP-016`の写真は本記録の作成時点でこのセッションから参照できず、`EXP-016`と本記録の間で基準となる向きが同一だったかは確認できない。
- `CMD_CASET`=0x2A・`CMD_PASET`=0x2B（標準値、取り違えなし）、`set_window`のx0/x1→CASET・y0/y1→PASET対応は確認済み。MADCTLは本記録の試験を通じて`BGR=1`のまま変えていない（`MY`/`MX`/`MV`は`0`のまま）。**`EXP-016`（`MADCTL=00h`）時点では、色の入れ替わりを差し引くと四隅の位置はfirmwareの意図と一致していたと記録されている。**BGRビットだけを変えて位置の対応関係が変わる理由は無いはずだが、本記録はこの食い違いの原因を特定していない。

### `display_id`（受け入れ条件1、未解決）

本記録の試験期間中、複数回のflashにわたり`display_id`のraw値を確認した。少なくとも`[00,00,00,00]`／`[ff,ff,ff,ff]`／`[00,40,71,fb]`の3種類の異なる値を観測しており、期待値`0x9341`とはいずれも不一致だった。**flashの回数・順序・各flashのfirmware版との対応は、会話記録から確実に再構成できなかった**（後日この記録を書く際に複数回試みたが、結果が一致しなかった）。安定した固定値ではないこと自体は、複数回の観測から確からしい。原因は特定していない（`MISO`導通は上記のとおり確認済みで、単純な断線ではない）。

### この記録が主張しないこと

- 四隅・格子patternでの位置の食い違いの原因（MADCTLのbit配置の想定違い、clone chipの個体差、その他）は特定していない
- 単色fillの色順修正（`BGR=1`）と、四隅・格子patternの位置の食い違いが同一原因であるとは主張しない。**別の未解決事項として扱う**
- `EXP-016`と本記録の間で、moduleを持つ向きの基準が同一だったかは確認していない
- backlight消灯の説明はsourceの読解によるものであり、実測（オシロスコープ等）では確認していない
- `display_id`不一致の原因は特定していない
- 本記録のfirmware変更（無限loop化、色配列入れ替え、格子pattern）はいずれも診断用でありcommitしていない。**本番のbring-up手順には含まれない**
- 条件(7)の承認範囲を、描画内容の変更について厳密には超えている（上記「条件(7)の範囲についての記録」参照）
- 単色fillの色順確認は目視のみであり、正本の手順9が定める写真記録による達成の条件は満たしていない
- 手順10（通電後の抵抗再測定）は行っていない
- **この記録は、試験の後に会話から再構成した。flashごとの版・log・見え方の対応は、直接引用できたもの以外は確認できていない。**次回以降の実機試験では、試験中にflashごとの表（時刻、firmwareの版またはdiffのsha256、`display_id`等のlog行、目視した見え方）をその場で作ることが要る

### 結論

`#485`（MADCTL `BGR=1`）は、画面全体の単色fillにおける赤/青入れ替わりを解消した（目視で確認したが、写真記録が無いため正本の達成条件は満たしていない）。一方、四隅・格子patternでは、色の値ではなく位置（座標の対応関係）が入れ替わるという別の未解決現象が見つかった（受け入れ条件4は未達のまま）。`display_id`不一致（受け入れ条件1）も未解決。`MISO`線の導通は確認済みで単純な断線ではないが、これが`display_id`不一致の原因かどうかは特定できていない。手順7（書き込み）を正本の指定と異なりAIが実行したこと（`EXP-016`に続いて2回目）、手順10（通電後の抵抗再測定）を行っていないことも、正本からの逸脱・未実施として記録する。安全上の異常は認めなかった。

## EXP-018: `DISP-01`（MSP2807）横向きの向きの決定と、単色fill・色の並び・四隅の写真記録、IDの読み出しの打ち止め

**目的**: [Issue #13](https://github.com/wachi-yoshitaka-11-dev/deskcat/issues/13)の受け入れ条件1〜4の証拠を揃える。(1) Read ID1〜3（DAh・DBh・DCh）を読み、D3hが期待する値を返さない理由を切り分ける。(2) 単色fillの5色を写真で記録する。(3) 判定の向き（横向き320×240、14 pinの`J2`のheaderを右の辺。[#13の判断(2)](https://github.com/wachi-yoshitaka-11-dev/deskcat/issues/13#issuecomment-5860773100)）に合うMADCTLの`MY`／`MX`／`MV`を写真から決め、その値で四隅が一致することを確かめる。

**実施日**: 2026-09-28（JST）。

**実施者**: 通電中の監視、USBの抜き差し、停止の判断、動画の撮影とスクリーンショットの切り出し、通電後の抵抗測定はユーザーが行った。firmwareのbuild、書き込み（`espflash`）、シリアルlogの読み取り、flashごとの表の作成は実機Linuxのセッション（本記録の作成者）が行った。**書き込みは、ユーザーの指示（原文省略）でこのセッションが実行した。**

**flashごとの表は、試験中にその場で作った。**本記録の時刻・log・見え方は、その表から写した。

### 構成（[Hardware Safety Policy](../governance/hardware-safety-policy.md)「10. ベンチ試験記録」の項目）

| 項目 | 内容 |
|---|---|
| Test ID | `EXP-018` |
| Hardware revision／Exact components | `EXP-017`と同じ。`MCU-01`（[hardware-bom.md](hardware-bom.md)。書き込み時の表示はchip revision v1.0）、`ACCEL-01`、`ENV-01`、`DISP-01`（MSP2807、silk `2.8 TFT SPI 240X320 V1.2`、panel `HSD028309 A2`） |
| Wiring revision | `EXP-017`から変更なし。**`EXP-017`の後に配線を変えた記録は無く、ユーザーからも変更の申告は無かった。**このため[power-budget.md](power-budget.md)の`DISP-01`追加接続の手順2（非通電確認の項目1〜4）はやり直していない（PMの判断） |
| Power supply and current limit | ESP32はPCのUSBから給電。`3V3` railに載るのはESP32・`ACCEL-01`・`ENV-01`・`DISP-01`だけ。servoとPiは接続していない。port確認で`CP210x`（`/dev/ttyUSB0`）だけが見え、Arduino（`ttyACM*`）は接続されていなかった。電流制限は`#461`の範囲（`HW-TBD-024`の計算）のまま。**周囲温度は測っていない。**[power-budget.md](power-budget.md)の条件(3)(c)（ambient 40℃の仮定に収まる）の成立は、測定では確かめていない |
| 条件(7) | [#13 comment（条件(7)の承認）](https://github.com/wachi-yoshitaka-11-dev/deskcat/issues/13#issuecomment-5868974805)。通電の前に記録した。backlightの点灯が起動1回あたり約2秒から約20秒へ延びること、Read ID1〜3の読み出しを足すこと（Interface Iなら`MOSI`の線で出力がぶつかりうる）を示したうえでの承認である。B2の手順8・9の(a)の読み替えと、待ち時間の上限（60秒、ユーザーがAIに任せた）も同じcommentにある |
| Measurement equipment | テスター（2000Ωレンジ。機種はこの試験では記録していない）。表示の記録はユーザーの動画 |
| build | debug profile、`--features bringup-display-13`。repositoryの外に置いたdetachedのworktreeでbuildし、`.embuild`は共有した（**clean buildではない**）。`Cargo.lock`は変えていない |

### firmware（書き込んだ3本）

| 呼び名 | 元 | 変更 | ELF sha256 |
|---|---|---|---|
| B1 | commit `213a107`（[PR #497](https://github.com/wachi-yoshitaka-11-dev/deskcat/pull/497)のhead）そのまま | なし。MADCTL=`0x08`。D3hと、DAh・DBh・DChを各1回読む | `6412e46370483987d7dc5ab1f8086d0cfcb139d8d4d74e4261b617720a2fa53d` |
| B1' | `213a107`＋診断用のpatch（commitしていない。`git diff`のsha256 `b9d0057dcf002764ffcc948586b8a5c6e3524024cadc6f6d706e184a9d1d9b6e`） | IDを1つも読まない。MADCTL=`0x08`、`WIDTH`／`HEIGHT`=240／320（B1と同じ生の座標） | `94e43cfa932ccea8dad8a99820fc22ced3673ffcfdd903d054386a1eb64f50b5` |
| B2 | `213a107`＋診断用のpatch（commitしていない。`git diff`のsha256 `ebeec01e67fce9f4f8662616e441aba069d32e599be239217f4d3d9c1f1e231f`） | IDを1つも読まない。MADCTL=`0x28`（`MV=1`、`BGR=1`）、`WIDTH`／`HEIGHT`=320／240 | `22e3ad3e97671675be03f8ce80fa2d40f7bf2f864f669c04ea6d9a71a3067d44` |

B2は、`MY`／`MX`の4通り（`0x28`・`0x68`・`0xa8`・`0xe8`）を通電の前にbuildしておき、B1'の写真から決めた1本（`0x28`）だけを書き込んだ。**B1'は、B1の写真を撮れなかったため、IDを読まずに撮り直すために足した。**PMに連絡がつかなかったため、「読まない版なら、読み出しを重ねないという決め事に反しない」とユーザーに示して、PMの確認より前に実行した。B2は、PMの判断（書き込んでよい）の後に実行した。

**本記録の後に`firmware/esp32/src/display.rs`・`main.rs`へ入れた変更（MADCTL=`0x28`、`WIDTH`／`HEIGHT`=320／240、IDの読み出しのcodeの削除）は、B2と同じcommandの列を送る。**B2との違いは、`display_madctl`の行の末尾の`id_reads=skipped`を外したことと、呼ばれていなかった読み出しの関数を消したことである。**その版そのものは書き込んでいない。**

### flashごとの表（時刻はこの端末のJST）

| # | 時刻 | 事象 | 主なlog | 見え方（ユーザーの申告と写真） |
|---|---|---|---|---|
| 0 | 20:31:45までに | USB接続 | — | 書き込み前のimage（`EXP-017`の診断buildの見込み。未確認）による表示は、判定に使わない |
| 1 | 20:33:10〜20:35:00 | B1を書き込み、monitor | 下記「B1のlog」 | **写真は撮っていない。**撮る向きと`J2`が何かを、このセッションが伝えていなかったため |
| 2 | 20:41:25〜20:42:55 | B1'を書き込み、monitor。ユーザーは書き込みの前から録画した | `display_madctl value=0x08 width=240 height=320 id_reads=skipped`、fill×5、`display_corner_pattern elapsed_us=89985`、`accel_device_id raw=0xe5`、`env_chip_id raw=0x60` | 5色とpattern（下記） |
| 3 | 20:53:32〜20:55:02 | B2を書き込み、monitor。ユーザーは書き込みの前から録画した | `display_madctl value=0x28 width=320 height=240 id_reads=skipped`、fill×5、`display_corner_pattern elapsed_us=89989`、accel `0xe5`、env `0x60` | pattern（下記） |

どの起動でも、`rst:0x1 (POWERON_RESET)`が2回出た。原因は調べていない。monitorの中でreset（Ctrl+R）はしていない。IDの読み出しは、B1の起動1回で各registerを1回ずつだけ行った。

### B1のlog（条件1）

```text
I (622) deskcat_esp32: display_id raw=[00, 00, 00, 00] matches_ili9341=false
E (622) deskcat_esp32: display_id_mismatch expected_id_hi=0x93 expected_id_lo=0x41 got_hi=0x00 got_lo=0x00
I (632) deskcat_esp32: display_rdid register=id1 cmd=0xda raw=[00, 00]
I (632) deskcat_esp32: display_rdid register=id2 cmd=0xdb raw=[00, 00]
I (642) deskcat_esp32: display_rdid register=id3 cmd=0xdc raw=[00, 00]
I (902) deskcat_esp32: display_fill name=black color=0x0000 elapsed_us=244770 hold_ms=3000
I (4152) deskcat_esp32: display_fill name=red color=0xf800 elapsed_us=244739 hold_ms=3000
I (7402) deskcat_esp32: display_fill name=green color=0x07e0 elapsed_us=244722 hold_ms=3000
I (10652) deskcat_esp32: display_fill name=blue color=0x001f elapsed_us=244737 hold_ms=3000
I (13902) deskcat_esp32: display_fill name=white color=0xffff elapsed_us=244717 hold_ms=3000
I (17252) deskcat_esp32: display_corner_pattern elapsed_us=90021
I (20262) deskcat_esp32: accel_device_id raw=0xe5
I (20272) deskcat_esp32: env_chip_id raw=0x60
```

### 写真（動画から切り出したスクリーンショット）

**写真と動画はcommitしていない**（`EXP-016`と同じ扱い。手や部屋が写っているため）。切り出した画像は実機端末のrepositoryの外に保管し、元の動画はユーザーの手元にある。

| 画像 | 取った動画 | sha256 | 見えた内容 |
|---|---|---|---|
| fill 黒 | B1' | `d34848fef532f0ea06ba25350402a46c09788b7dc2ca4127d04cdebed0e81c0f` | 画面全体が一様に暗い。横向きで、右の辺に`J2`のheaderとsilk `J2`、左の辺に`J4`が写る（5枚とも同じ） |
| fill 赤 | B1' | `f33ef891d564057283ef31bce84803085d25c0068592b58e413579e8193d213b` | 画面全体が一様に赤。細かい網目の模様が写るが、撮影のmoiréの見込み |
| fill 緑 | B1' | `76664ad75a1984b11fe492f67fa7799824c35af3e77e86980e5a8463004d2887` | 画面全体が一様に緑 |
| fill 青 | B1' | `aaae94ba797aa297a1a62506c730b56ea6107aa279bc07ee78338b3374819563` | 画面全体が一様に青。赤と同じ網目の模様 |
| fill 白 | B1' | `b1f706f964c7bc337de43b0a62566ef85b9450c6810e4be280e58cdcda138153` | 画面全体が一様に白（やや青み） |
| pattern | B1' | `7779997545e0b5870148098e48c45c21a5671be4c71f814eb29f0e392a5c6de9` | 赤・大（`origin`）＝左上。破線（`y_axis`、行＝PASETの増える向き）＝左上から右へ。実線（`x_axis`、列＝CASETの増える向き）＝左上から下へ。緑（`x_end`）＝左下、青（`y_end`）＝右上、白・小（`far`）＝右下 |
| pattern | B2 | `cfbb83684550d7186e60f27e78d69fd6351b40de3ba620333aff32cff319d5a1` | 赤・大（`origin`）＝左上、緑（`x_end`）＝右上、青（`y_end`）＝左下、白・小（`far`）＝右下。実線＝左上から右へ、破線＝左上から下へ（破線は約6本で、`y_axis`の168 pxに合う） |

ユーザーの申告：fillの色の順は黒・赤・緑・青・白（firmwareが送った順と同じ）。**B2の後に、B1'のpatternのスクリーンショットを1枚、B2のものと取り違えて受け取った。**ユーザーが取り違えを訂正した（原文は省略）ので差し替えた。取り違えた1枚は、会話の途中で送られたため、fileとして残っていない。

**5色のframeはB1'（MADCTL=`0x08`）から取った。**これを条件2・3の証拠に使う理由: fillは画面全体を塗るため、向きによって見え方が変わらない。B1'とB2の違いはMADCTLの`MV`・`MY`・`MX`だけで、`BGR`（B3）は同じである。

### 向きの決め方（条件4）

ILI9341 Datasheet V1.11 §9.3 MCU to memory write/read direction（p.208）の表では、`MV=1`のとき、CASETは`MY=0`なら物理のpage（0〜319）へ、`MY=1`なら`319−page`へ向かう。PASETは`MX=0`なら物理のcolumn（0〜239）へ、`MX=1`なら`239−column`へ向かう。

B1'（`MV=0`）の写真で、破線（PASET＝物理のpageの向き）は右へ、実線（CASET＝物理のcolumnの向き）は下へ伸びていた。したがって`MV=1`、`MY=0`、`MX=0`で、論理の`x`は右へ、`y`は下へ伸び、原点は左上に来る。→ MADCTL=`0x28`。**この読み方は、PM（`#0PM`）が§9.3 p.208の表と照合した。**読み方は、2本の線がどちらも原点から伸びていることを前提とする（`213a107`の`run_corner_pattern`は、どちらの軸も`origin`から描く）。

**B2（`0x28`）の写真で、論理の四隅が物理の四隅と一致した。**

補足: `MV=0`の横向きでは、生の座標は転置に見える（左上は合い、右上と左下が入れ替わる）。`EXP-017`の四隅の記録（左上は合い、右上と左下が入れ替わる）はこれと一致する。`EXP-016`の四隅の記録（位置は意図どおり）は、横向きではない向きで見ていた見込みがある。どちらの向きで見たかの記録が無いため、確かめられない。

### IDの読み出しの結果と切り分け（条件1）

**事実:**
- B1で、D3hの4 byteも、DAh・DBh・DChの各2 byteも、すべて`00`だった。DBh（ID2）の値の範囲は、datasheetでは80h〜FFhであり、`00`はその外である。
- `DISP-01`の`SDO`とESP32のGPIO19（`LCD-MISO`）の間の導通は0 Ω（`EXP-017`）。
- D3hの値は、`EXP-016`では`00000000`、`EXP-017`では複数回の書き込みで3種類（`00000000`、`ffffffff`、`004071fb`）だった。今回はすべて`00`だった。値が変わった理由は分からない。

**残る候補（どちらも断定しない）:**
- 読み出しのdataが`SDO`に出ていない。§7.1.10（p.38）の4-wire serialの図では、Interface Iは読み出しdataを`SDA`（この配線では`MOSI`の線）へ出す。
- module上で、controllerの`SDO`が`SDO(MISO)`のpinへ引き出されていない。

**限界:** どちらかは、moduleを改変しない方法では確かめられない。**読み出しはB1で打ち止めにした。**この後のfirmwareは、IDを読まない（`firmware/esp32/src/display.rs`のmodule doc）。

### 通電後の抵抗再測定（手順10）

USBを抜いた後、`DISP-01`の`VCC`–`GND`間、2000Ωレンジで**1210 Ω**（ユーザーの申告）。通電前の基準値（`EXP-016`・`EXP-017`）は1212 Ω。「低いまま動かない」への変化ではない。

### Faults

- 実施前の条件(3)(c)（周囲温度がambient 40℃の仮定に収まる）を、測定で確かめずに通電した。
- 停止条件（手順8）にかかる事象は、どの起動でも無かった。異音・発熱・火花・変色・異臭について、ユーザーからの申告は無かった。logは、どの起動でも待ち時間の上限（60秒）より前に(a)〜(d)まで出そろった。
- B1の写真を撮れなかった（上記）。そのため、起動が1回（B1'）増えた。B1'ではIDを読んでいない。
- B2では、試験の時点でmerge済みだった手順9の(a)（`display_id`）の代わりに、`display_madctl`の行、または`display_driver_new_failed`／`display_init_failed`の行で(a)を判断した（条件(7)と同じcommentで、通電の前にユーザーが確認した）。

### 受け入れ条件との対応（[Issue #13](https://github.com/wachi-yoshitaka-11-dev/deskcat/issues/13)）

| # | 受け入れ条件 | 判定 | 根拠 |
|---|---|---|---|
| 1 | Controller識別情報と初期化の根拠 | **達成**（[判断(1)](https://github.com/wachi-yoshitaka-11-dev/deskcat/issues/13#issuecomment-5860773100)による） | (a) 識別情報: moduleのsilk（`2.8 TFT SPI 240X320 V1.2`）と、MSP2807の資料がcontrollerを`ILI9341`としていること（[sensor-datasheet-notes.md](sensor-datasheet-notes.md)のLCD moduleの表）。(b) 初期化の根拠: `display.rs`のmodule docが引くdatasheetの節（SWRESET、SLPOUT、COLMOD、MADCTL。CASET／PASETの制約は`fill_rect`のdoc）と、そのcommandが実機で期待どおりに効いたこと（`BGR`で赤と青の入れ替わりが解消、`MV`で向きが§9.3の表のとおりに変わった）。(c) 読み返し: 上記の結果と切り分け |
| 2 | 単色fillが正しい | **達成** | 5色の写真（B1'）で、画面全体が一様に塗れた。`display_fill`×5のlog |
| 3 | Color orderが正しい | **達成** | 同じ写真と、ユーザーの申告（黒・赤・緑・青・白の順）。送った色と見えた色が一致した |
| 4 | 四隅とorientationが正しい | **達成**（判断(2)の向き） | B2の写真で、論理の四隅が物理の四隅と一致した。`display_pattern_element`と`display_corner_pattern`のlog |
| 5 | 更新timingを測定した | 達成（`EXP-016`で達成済み） | 今回も`display_fill`は約244.7〜244.9 ms。patternは内容を変えたため約90.0 ms |
| 6 | 更新中も通信とwatchdogがactiveである | 未達 | このbuildはprotocol sessionを動かさない。[#487](https://github.com/wachi-yoshitaka-11-dev/deskcat/issues/487)の統合buildと[#446](https://github.com/wachi-yoshitaka-11-dev/deskcat/issues/446)の後に確かめる |

### この記録が主張しないこと

- IDの読み出しが期待する値を返さない原因は特定していない
- `POWERON_RESET`が起動ごとに2回出る理由は調べていない
- 本記録の後にcommitしたfirmware（B2と同じcommandの列）そのものは書き込んでいない
- `EXP-016`が横向きではない向きで見ていたことは確かめていない（見込み）
- 条件4の判定の向きは、[#34](https://github.com/wachi-yoshitaka-11-dev/deskcat/issues/34)の仮筐体で頭への載せ方が決まったら見直す

### 結論

MADCTL=`0x28`（`MV=1`、`BGR=1`）で、判定の向き（横向き、`J2`を右）の論理の四隅が物理の四隅と一致した。単色fillの5色と色の並びも、写真で記録した。IDの読み出しは、どのregisterも期待する値を返さず、moduleを改変しない方法ではこれ以上切り分けられないため、打ち止めにした。受け入れ条件1〜5は達成、6は未達である。

### Next safe step

- 受け入れ条件6は、[#487](https://github.com/wachi-yoshitaka-11-dev/deskcat/issues/487)（firmwareの統合build）と[#446](https://github.com/wachi-yoshitaka-11-dev/deskcat/issues/446)（UARTでの接続）の後に確かめる
- 仮筐体で向きが変わる場合は、`display.rs`の`MADCTL_LANDSCAPE`と`WIDTH`／`HEIGHT`を変え、四隅を写真で確かめ直す

## EXP-019: 段階B-2（今の接続のまま B-2a）の、周辺 module 3点の 3.3 V 側の電流と電圧

[#3](https://github.com/wachi-yoshitaka-11-dev/deskcat/issues/3)の段階B-2。[power-budget.md](power-budget.md)の`段階B-2の測定`の`今の接続のままB-2aとして測る（2026-09-28、ユーザー決定）`による。

| 項目 | 内容 |
|---|---|
| Test ID | `EXP-019` |
| Date | 通電は 2026-10-01（JST）。非通電の確認は 2026-09-30〜2026-10-01 |
| Operator | 配線の変更と戻し、非通電の測定、通電中の監視、USB の抜き差し、停止の判断、テスターの読み取りはユーザー。firmware の build、書き込み（`espflash`）、serial log の読み取り、起動し直し、時刻の表の作成は実機 Linux の AI セッション（本記録の作成者） |
| Hardware revision／Exact components | `EXP-018`と同じ（`MCU-01`、`ACCEL-01`、`ENV-01`、`DISP-01`）。加えて`MEAS-01`（秋月 117836、`SQP5WJ0R1B`）1本 |
| Wiring revision | 基準は`EXP-018`の配線。穴の番号は、ユーザーが2026-09-30に作った配線の地図（画像。commit していない。sha256 `978e2c6f85ad42fc28a43d8f2a4f7cf5c7ecfd580c57e0880608784113257b6b`）による。測定の間だけ、3点の電源の線を、ブレッドボードの上の＋列（3V3）の30番（`DISP-01` VCC）→`b11`、4番（`ACCEL-01` Vs/VDD）→`c11`、1番（`ENV-01` VDD）→`d11`へ移し、`MEAS-01`を上の＋列11番と`a11`に挿し、測定用のジャンパを上の＋列10番（点A）、`e11`（点B）、上の－列（GND）10番（点C）に差した。測定の後に元へ戻した（ユーザーの申告） |
| Power supply and current limit | ESP32 は PC の USB から給電（`/dev/ttyUSB0`、`CP2102N`）。servo と Pi は接続していない。電流制限は設けていない（[power-budget.md](power-budget.md)の`B-2a: 3V3 pinから給電する経路`、`HW-TBD-023`） |
| Firmware commit/profile | commit `52a8142`の`--features bringup-display-13`、debug profile に、`firmware/esp32/src/config.rs`の`DISPLAY_HOLD_MS`を`3_000`から`15_000`へ変える patch（commit していない。option なしの`git diff`の出力の sha256 `ed36fb79531f808ab142d560e470ce97ca589c79552334b2106cb4a615691752`）を当てた。ELF sha256 `e92109b69fd35a23ddbac9ab73c59dca103853304423d41107f19f5be50ff115`。clean build ではない。試験の時点の`develop`は`710c67f`で、[#487](https://github.com/wachi-yoshitaka-11-dev/deskcat/issues/487)の PR B は merge されていなかった |
| Configuration | 条件(7)（[power-budget.md](power-budget.md)の`DISP-01`追加接続のbring-upの手順の条件(7)）の承認: [#3 comment](https://github.com/wachi-yoshitaka-11-dev/deskcat/issues/3#issuecomment-5914517437)（通電の前。patch を当てた build、backlight を点ける起動4回）。停止条件: 20V レンジの表示が 3.23 V 以下または 3.37 V 以上（PM `#0PM`の判断）、brownout、予定外の reset、LCD の表示異常、regulator 周辺と部品の発熱、異音・異臭・変色、log が150秒出ない。停止はユーザーが USB を host 側から抜く |
| Measurement equipment | `MEAS-03`（`DT830B`）1台。200Ω、2000Ω、20V、200mV のレンジ。ワニ口のクリップで挟み、通電中は付け替えていない。確度は取得できない（[hardware-bom.md](hardware-bom.md)の`MEAS-03`）。周囲温度は`MEAS-04` |
| Procedure | 非通電の確認の後、3回通電した。回1 は点B–点C（20V）、回2 は点A–点C（20V）、回3 は`MEAS-01`の2本の線の間（200mV）を読んだ。ワニ口の付け替えとレンジの切り替えは USB を抜いている間に行った。回3 の通電の前に、ワニ口が隣の線やジャンパに触れていないことを、ユーザーが目で確かめた（ユーザーの回答。回答は試験の後に得た）。回1・回2 のどちらかで停止条件の値に達したら回3 は行わない、と通電の前に決めた |
| Expected result | 停止条件に当たる事象が無く、各区間の表示が読めること |
| Measured result | 下の3つの表と、`戻した後` |
| Faults | 下記 |
| Conclusion | 下記 |
| Next safe step | 下記 |

**非通電の確認**（レンジと表示はユーザーの申告）

| # | 測った所 | レンジ | 表示 |
|---|---|---|---|
| M0 | リード同士 | 200mV | `00.2` |
| M0 | リード同士 | 200Ω | `0` |
| M0' | リード同士を押し当てた（取り直し） | 200Ω | `01.6` |
| M2a | ESP32 の`3V3` pinと、3点それぞれの電源 pin（電源の線を移した後、`MEAS-01`もジャンパも挿す前） | 2000Ω | 3つともオーバーレンジ |
| M1 | 点B–点C | 2000Ω | `1217` |
| M2 | 点A–点B | 200Ω | `02.2` |
| M2b | `MEAS-01`の2本の線（穴より上） | 200Ω | `01.7` |
| M2c | 点A–`MEAS-01`の＋列側の線 | 200Ω | `01.9` |
| M2d | 点B–`MEAS-01`の`a11`側の線 | 200Ω | `01.9` |
| M3 | 点A–点C | 2000Ω | `1806`→`1215` |
| M6 | 周囲温度 | `MEAS-04` | 25.0 ℃ |

**時刻の表**（この端末の JST。読みはユーザーの申告）

| # | 時刻 | 事象 | 主な log | 読み |
|---|---|---|---|---|
| 1 | 00:39:35 | 回1: USB を挿した | — | — |
| 2 | 00:39:43 | 書き込みの command が、環境変数の値の誤りで起動せずに止まった | `invalid value '1' for '--skip-update-check'` | — |
| 3 | 00:40:12〜 | 書き込み（ELF `e92109b6…`）、monitor | `App version: 52a8142-dirty`、`POWERON_RESET`×2、`hold_ms=15000` | — |
| 4 | 00:41:58〜00:42:13 | 起動1: 白 | `display_fill name=white` | 点B–点C **3.30 V** |
| 5 | 00:42:29〜 | bring-up の後（画面が暗い。ユーザーの申告） | `accel_device_id raw=0xe5`、`env_chip_id raw=0x60` | 点B–点C **3.33 V** |
| 6 | 00:43:04 | USB を抜いた | — | — |
| 7 | 00:46:09〜 | 回2: USB を挿した（挿した時刻は記録していない）。この時刻に monitor を開き、起動し直した | `POWERON_RESET`×1 | — |
| 8 | 00:47:19〜00:47:34 | 起動2: 白 | — | 点A–点C **3.30 V** |
| 9 | 00:47:49〜 | bring-up の後（画面が暗い。ユーザーの申告） | accel `0xe5`、env `0x60` | 点A–点C **3.34 V** |
| 10 | 00:48:51 | USB を抜いた | — | — |
| 11 | 00:50:10〜 | 回3: USB を挿した（挿した時刻は記録していない）。この時刻に monitor を開き、起動し直した | `POWERON_RESET`×1 | — |
| 12 | 00:50:17〜00:51:50 | 起動3（1回目） | — | 読みなし |
| 13 | 00:53:28〜 | monitor を開き直し、起動し直した | `POWERON_RESET`×1 | — |
| 14 | 00:53:36〜00:55:08 | 起動3 | accel `0xe5`、env `0x60` | 下の表 |
| 15 | 00:55:46〜00:57:26 | monitor を開き直し、起動4 | `POWERON_RESET`×1。accel `0xe5`、env `0x60` | 下の表 |
| 16 | 00:57:44 | USB を抜いた | — | — |

回1・回2 で読んだ4つの表示は、どれも停止条件の値に達しなかったので、回3 を行った。serial log を取っていた区間に、brownout と、上の表に無い reset は出なかった。LCD の表示異常・発熱・異音・異臭・変色の申告は無かった。

**回3 の読み**（200mV、`MEAS-01`の2本の線の間）

| 区間 | 起動3 | 起動4 |
|---|---|---|
| 黒・赤・緑・青 | `04.4` | `04.4` |
| 白 | `04.3` | `04.3` |
| 四隅の pattern | `04.4` | `04.4` |
| bring-up の後（画面が暗い。ユーザーの申告） | `00.5` | `00.5` |

M0 の 0.2 mV を引き 0.1 Ω で割ると、bring-up の後以外の区間が約 41〜42 mA、bring-up の後が約 3 mA（計算）。

**戻した後**: 測定用のジャンパ3本と`MEAS-01`を抜き、3点の電源の線を上の＋列30番・4番・1番へ戻した（ユーザーの申告）。上の＋列–上の－列は 2000Ω で`1276`→`1214`。項目1〜7 はやり直していない（ユーザーの判断。その後は通電していない）。

### Faults

- 条件(7)の承認（backlight を点ける起動4回）を超えた。書き込んだ版の起動は少なくとも7回（表示を最後まで行った5回と、回2・回3 で USB を挿してから monitor を開くまでの2回）。起動1 の前の`POWERON_RESET`×2（時刻の表の行3）が、書き込んだ版の起動の回数に当たるかは分からない（`EXP-018`でも、どの起動でも2回出ている）。回1 では書き込む前の image（何かは記録していない）が約37秒動いた。起動3 の1回目に読みが無かったため起動し直したが、その前にユーザーにも PM にも確かめていない。手順は USB を挿した時点の起動を回数に入れておらず、PM（`#0PM`）も見落とした（[#3 の訂正](https://github.com/wachi-yoshitaka-11-dev/deskcat/issues/3#issuecomment-5932401221)）。
- `DISP-01`追加接続の手順からの逸脱: 手順10（通電後の`VCC`–`GND`間の再測定）を行っていない。[gpio-assignment.md](gpio-assignment.md)の非通電の確認の項目1を module の pin ではなく列と rail の単位で測り、項目2〜7 を現物ではなく配線の地図と照らして行った。
- [#3 の決定1](https://github.com/wachi-yoshitaka-11-dev/deskcat/issues/3#issuecomment-5863139535)の「B-2 の測定より前に（要る確かさを）確定させる」は、満たさないまま測定した。測定は、後の[#488 の決定](https://github.com/wachi-yoshitaka-11-dev/deskcat/issues/488#issuecomment-5868418510)（手持ちの`DT830B`で測り、確度が分からないことは弱点として記録する）に基づく。この決定が順序の条件を外したかどうかは、決定の文に書かれていない。
- 最初は上の＋列11番と`a11`の間に`MEAS-01`ではなくジャンパが挿してあった。指示が「`MEAS-01`を挿す」とだけ書き、セメント抵抗であることを書いていなかったためである。通電の前に差し替えた（差し替える前の M1 `1209`、M2 `02.5`、M3 `1512`→`1209`）。
- [hardware-bom.md](hardware-bom.md)の`MEAS-03`行は「`200 Ω`・ダイオード・電流測定は電池を交換して再確認するまで使わない」と定めている。その定めを確かめずに 200Ω レンジを使った。電池はユーザーの申告で交換済みで、測定中に電池のマークは出なかったが、交換後の再確認の記録は無い。電流は、電流端子ではなく 200mV の電圧レンジで読んだ。
- 書き込みの command を1回、環境変数の値の誤りで止めた。chip には書いていない。
- 起動3 の1回目は、区間の時刻の連絡がユーザーに届かず、読みが無い。AI のセッションが途中で切り替わり、monitor もそこで止まった。
- 起動4 の前に monitor を止めるとき、`pkill -f`の pattern が実行した shell 自身にも一致し、その shell も止まった。
- 回3 の間は電圧を見ていない。

### この記録が主張しないこと

- 3点それぞれの電流
- 測った値が、MSP2807 の安全な電流上限（`HW-TBD-024`）や`3V3` pinの定格（`HW-TBD-023`）を下回ること
- [power-budget.md](power-budget.md)の段階B-2の共通条件の`測る量`（backlight の点灯と LCD の描画、I2C 通信を継続した状態の定常電流）
- 測っていない電流（GPIO4 から`DISP-01`の`LED` pin へ流れる電流、上の＋列にある pull-up と分圧器の電流、信号線を通って module へ入る電流）
- 3.3 V 側の電圧が[power-budget.md](power-budget.md)の`許容電圧範囲`行の範囲の中にあること
- 200Ω レンジの読みが正しいこと
- log の無い区間（USB を挿してから monitor を開くまでと、monitor が止まっていた区間）に brownout や reset が無かったこと。`POWERON_RESET`の原因
- 試験した firmware が、試験の時点の`develop`の firmware と同じ動きをすること
- 3点の電源の線が戻ってつながっていること
- 読んだ点以外の区間と、log の無い区間で、停止条件を監視したこと

### Conclusion

今の接続（`3V3` pin給電）のまま、3点の電源 pin へ入る合計電流は、確度が未取得の読みとして、bring-up の後以外の区間が約 41〜42 mA、bring-up の後が約 3 mA だった。3.3 V 側の電圧の読みは、白の区間と bring-up の後で 3.30〜3.34 V だった（確度が未取得）。

### Next safe step

- 次の通電（[#446](https://github.com/wachi-yoshitaka-11-dev/deskcat/issues/446)の条件4、または[#13](https://github.com/wachi-yoshitaka-11-dev/deskcat/issues/13)の条件6）の前に、戻した後の配線で非通電の確認（項目1〜7）をやり直す。通電したら、表示と`accel_device_id`／`env_chip_id`の応答で、3点の電源の線がつながっていることを確かめる
- monitor の process は、次からは PID を指定して止める

## EXP-020: 段階AのPiの給電を手持ちのadapterへ移し、Wi-Fiの切断を切り分け、PiのUARTを設定した

[#446](https://github.com/wachi-yoshitaka-11-dev/deskcat/issues/446)の受け入れ条件4の試験の準備。M-12001のplugは`EXP-012`で切断済みであり、[power-budget.md](power-budget.md)の段階表のA行が定める段階Aの給電に、M-12001は使えない。

| 項目 | 内容 |
|---|---|
| Test ID | `EXP-020` |
| Date | 2026-10-02〜2026-10-03（JST） |
| Operator | adapterとcableの抜き挿し、監視中の目視（LED、発熱、異臭）はユーザー。ssh経由の読み出し、監視、Piの設定の変更と再起動はAIセッション（ユーザーの指示（原文省略）による） |
| Hardware revision／Exact components | `SBC-01`（Raspberry Pi Zero W Rev 1.1）、`SD-01`。adapterは`PSU-PI-A-01`（②）とANKER `A2014`（③、USB-C PD）。cableは`CABLE-PI-A-01`と`CABLE-PI-PWR-01` |
| Wiring revision | PiのGPIOには何もつないでいない。ESP32はつないでいない |
| Power supply and current limit | 起動ごとに下の表のとおり。電流制限は設けていない |
| Firmware commit/profile | 対象外（ESP32を使っていない）。PiはRaspberry Pi OS（kernel `6.18.34+rpt-rpi-v6`、`raspi-config` 20260522） |
| Configuration | 承認：②での初回起動とPiの設定（[#446の記録](https://github.com/wachi-yoshitaka-11-dev/deskcat/issues/446#issuecomment-5952463629)）、bssidの固定（ユーザーの回答（原文省略））。③への切り替えと`CABLE-PI-PWR-01`への切り替えは、ユーザー自身の判断と操作である。`CABLE-PI-A-01`：本体表記が無い。`EXP-009`の「表記なし」と同じ現物かは、同定していない。 |
| Measurement equipment | この端末からのping（1 sおき）とssh。Pi上の`journalctl`（`Storage=persistent`）、`nmcli` |
| Procedure | 下の表の順に起動した。Piが届いている間にsshで前の起動のjournalを読んだ。bssidの固定の後と、②と`CABLE-PI-A-01`へ戻した後に、それぞれ1時間監視した。最後にPiのUARTを設定し、再起動して確かめた |
| Expected result | Piがnetworkから消えず、`/dev/serial0`が`ttyAMA0`を指すこと |
| Measured result | 下の表と`PiのUARTの設定` |
| Faults | 下記 |
| Conclusion | 下記 |
| Next safe step | 下記 |

**起動ごとの結果**（時刻はJST。routerと中継機は同じSSIDを出す。値は書かない）

| 起動 | adapter／cable | bssidの固定 | 観察 |
|---|---|---|---|
| 1 | ②／`CABLE-PI-A-01` | なし | 21:45:03にsshで届いた（uptime 2 min、`throttled=0x0`。`SBC-01`（Pi Zero W）には低電圧検出が無く、この値は電圧について何も語らない（`EXP-009`））。00:45:44には届かない（ARP `FAILED`）。ユーザーの回答：LEDは点いたまま、発熱・異臭なし、誰も触れていない |
| 2 | 同上（01:16ごろ抜き挿し） | なし | 01:18:58にsshが1回届き、01:22:16には届かない。journalは03:10:36まで続いた。`CTRL-EVENT-DISCONNECTED`（`reason=0 locally_generated=1`）が144回。routerと中継機の間を行き来し、終わりは`Association request to the driver failed`が続いた |
| 3 | 同上（03:12ごろ挿し直し） | なし | 起動2と同じ形 |
| 4 | ③／`CABLE-PI-A-01`（変換コネクタ） | なし | 32 minで`CTRL-EVENT-DISCONNECTED`が46回。routerのSIGNALは70、中継機は49 |
| 5 | ③／`CABLE-PI-PWR-01`（変換コネクタ） | なし | 約28 minは切断0回、ping 1702/1704。11:04:13に1回切れて中継機へ移り、11:04:46から`Association request to the driver failed`が続いて、挿し直しまで戻らない。journalは続いていた |
| 6 | 同上（12:16ごろ挿し直し） | 12:27にrouterへ固定 | 12:27:39〜13:29:00の監視で、固定の後の切断は4回、どれもrouterへすぐ戻った。`driver failed` 0回、ping 3587/3594、5分おきのsshは12回とも届いた |
| 7 | ②／`CABLE-PI-A-01`（18:17ごろ挿し替え） | あり | 18:17:57〜19:20:40の監視で、切断1回、`driver failed` 0回、ping 3589/3595、sshは12回とも届いた |

**bssidの固定**：NetworkManagerの接続（netplanが作ったもの）の`802-11-wireless.bssid`をrouterへ固定した。変える前に`/etc/netplan`をPi上へ写し、10分後に元へ戻す`systemd-run`のtimerを先に仕掛けてから変え、届いた後にtimerを止めた。netplanのyamlに`bssid`の行が足された。

**PiのUARTの設定**（[gpio-assignment.md](gpio-assignment.md)の`Pi側の設定`）

- 変える前に`/boot/firmware/config.txt`と`cmdline.txt`をPi上の`*.before-446`へ写した。戻せなくなったときは、card readerでmicroSDをこの端末で読み、写しから戻す
- `systemctl is-enabled hciuart`は`not-found`で、この手順は行っていない
- `config.txt`の最後の`[all]`の下へ`dtoverlay=disable-bt`を足した
- 対話の画面の代わりに`raspi-config nonint do_serial_cons 1`（serialのlogin shellを無効）と`raspi-config nonint do_serial_hw 0`（serial port hardwareを有効）を使った。引数の意味と変えるfileは、Pi上の`/usr/bin/raspi-config`（sha256 `b82c777132fa945a7b548e6826493f2f65364b062973860467d525a468e1d5a3`）の`do_serial_cons`・`do_serial_hw`・`do_serial`で確かめた
- diff：`config.txt`は`[all]`の下に`dtoverlay=disable-bt`と`enable_uart=1`、`cmdline.txt`は`console=serial0,115200`が消えた
- 再起動の後：`/dev/serial0 -> ttyAMA0`（root:dialout）、`/proc/cmdline`に`console=serial0`は無い、`serial-getty@ttyAMA0`は`inactive`、journalに`hci_uart`の行は無い、`deskcat`は`dialout`に入っている

### Faults

- 作業セッションは`EXP-012`を確かめずに、M-12001を`PWR IN`へ挿す手順を立て、ユーザーのM-12001を切ったという発言（原文は省略）を、コンセントから抜いたことと読み違えた
- 作業セッションは一度「②と③は別のcable」とPMへ送った（実際は同じcableで、③は変換コネクタを通した）
- 起動5の監視は、この端末の裏の実行の上限で11:04ごろに止まった（sshの最後の読みは11:01:19）
- 起動6の最初の読みで、固定の後の3回の切断を固定の操作によるものと注記したが、journalの時刻で固定の後の切断と分かった

### この記録が主張しないこと

- 電源経路の受け入れ。`PSU-PI-A-01`が公式の推奨1.2 Aを下回ることは変わらない
- ③がPDでない機器へ5 Vを出すこと
- 切断の原因。adapter、cable、routerのchannel、Wi-Fiの省電力のどれが効いたかは切り分けていない
- `/dev/serial0`を開けること、UARTで通信できること

### Conclusion

journalが続いた起動（起動2・5）では、Piは止まっておらず、Wi-Fiだけが切れていた。中継機へ移った後に`Association request to the driver failed`が続いて戻らない形であり、bssidをrouterへ固定した後は、②と`CABLE-PI-A-01`でも1時間networkから消えなかった。PiのUARTは、`dtoverlay=disable-bt`と`raspi-config`の2つの設定の後に、`/dev/serial0`は`ttyAMA0`を指していた。

### Next safe step

- Piでhostの`serial_link` exampleをbuildする（PiのGPIOには何もつながない）
- UARTの線をつなぐ条件4の試験は、[gpio-assignment.md](gpio-assignment.md)の`信号線をつないでよい条件`に従う

## EXP-021: 叩いて表情が変わるデモの通電

**目的**: [#21](https://github.com/wachi-yoshitaka-11-dev/deskcat/issues/21)のデモ（ADXL345のモジュールを叩く→`tapped`→Piの`set_expression`→LCDの表情）の通電の記録。[#13](https://github.com/wachi-yoshitaka-11-dev/deskcat/issues/13)の受け入れ条件6の試験（2026-10-07〜08。日付は、#13の承認と結果のcommentの時刻による）は、この記録に入れない。その記録は[#13のcomment](https://github.com/wachi-yoshitaka-11-dev/deskcat/issues/13#issuecomment-6042642898)にある。

**実施日（JST）**: 2026-10-09。

**実施者**: 電源、USBとUART線の抜き差し、通電中の目視、ADXL345のモジュールを叩くことはユーザー。firmwareのbuild、書き込み、ESP32のシリアルlogの記録は#21のセッション（AI）。`deskcatd`の起動と停止は#446のセッション（AI）。

### 構成

| 項目 | 内容 |
|---|---|
| Test ID | `EXP-021` |
| Date／Operator | 上の「実施日」「実施者」 |
| Firmware commit/profile | 下の「firmware」の表 |
| Configuration | 下の「条件(7)の承認」の行と、「firmware」の表 |
| Hardware revision／Exact components | `MCU-01`（ESP32）、`ACCEL-01`（ADXL345）、`ENV-01`（BME280）、`DISP-01`（MSP2807）、`SBC-01`（Raspberry Pi Zero W） |
| Expected result | 叩くとLCDの表情が変わる |
| Procedure | 下の「試験」の「時刻」と「ESP32のlog」。順序: USBを挿す、flash、起動の確認、UART線を挿す、`deskcatd`の起動、叩く、UART線を先に抜く、`deskcatd`の停止、monitorの停止、USBを抜く |
| 停止条件 | 発熱、異臭、LCDの異常（乱れ、点滅）、電圧降下を認めたとき。Piがpingに応じなくなる、またはsshが切れたとき（先にESP32側の線を抜く）。最初の2分は目視、表情が変わる証拠が出たらすぐ止める、上限15分（根拠の無い暫定の値。承認の記録のとおり） |
| Wiring revision | 周辺module3点の配線は、`EXP-018`の後に`EXP-019`を経て戻した配線のまま（ユーザーの回答。質問と回答は[#21のcomment](https://github.com/wachi-yoshitaka-11-dev/deskcat/issues/21#issuecomment-6077223726)にある）。[power-budget.md](power-budget.md)の`DISP-01`追加接続のbring-upの手順の条件(1)は再測定していない。`EXP-019`の`Next safe step`が求めた非通電の確認（項目1〜7）をやり直した記録は無い。UART線のESP32側の端は、承認の順序（[#21のcomment](https://github.com/wachi-yoshitaka-11-dev/deskcat/issues/21#issuecomment-6077223726)）では、両方の電源が入った状態で挿し、先に抜く。挿した、抜いたという報告は、ユーザーの会話での回答による。[gpio-assignment.md](gpio-assignment.md)の`信号線をつないでよい条件`の条件1（直列4.7 kΩ）、条件5のGND共通、条件6（通電前の目視と導通の確認）を、このデモで確かめた記録は無い（ユーザーの回答だけ。質問と回答は上のcomment）。条件5の別電源は、下の「Power supply and current limit」の行にある。`HW-TBD-036`（片方だけ電源が入っているときの回り込み）は、[tbd-register.md](tbd-register.md)で、対策を決定済み（2026-09-28）、保証値が無いことを弱点として記録している状態である |
| Power supply and current limit | ESP32はPCのUSBから給電（`3V3` pin経路で周辺module3点へ）。Piは手持ちのadapter ②（`PSU-PI-A-01`）と、本体表記の無い手持ちのcable（[hardware-bom.md](hardware-bom.md)の`CABLE-PI-A-01`も本体表記が無い。同じ現物かは、同定していない）。電流制限は設けていない |
| 条件(7)の承認（[power-budget.md](power-budget.md)の`DISP-01`追加接続のbring-upの手順） | [#21のcomment](https://github.com/wachi-yoshitaka-11-dev/deskcat/issues/21#issuecomment-6077223726)（常時点灯を含む）。通電の前に記録した |
| Measured result | 下の「試験」 |
| Measurement equipment | 測定器を使っていない（ESP32のシリアルlogとユーザーの目視） |

### firmware

| commit | `firmware/`のtree | `firmware/esp32/`のtree | features／profile | ELF sha256 | sdkconfig sha256 |
|---|---|---|---|---|---|
| `cd878542a4772d762599224af3e770b30d895fcf` | `b230cc82d0e957b16bb97bc21fef610b9f66f4e4` | `4f6d000fee192a82044382555090436e13199276` | `tap-21,face-21,bringup-display-13`、debug | `14297916fbb00b7ec58d19542c6131c394717876334d26384e56ae89a42f676b` | `97b835f65058e5ee7ca510b2e74e365f393ee1da2137ee52a72a151ed184d7d3` |

`cargo build --locked`、repositoryの外のdetached worktree（CIはこれらのfeature構成をbuildしていない）。sdkconfig（表のsha256）は、`CONFIG_ESP_TASK_WDT_EN=y`、`CONFIG_ESP_TASK_WDT_INIT=y`、`CONFIG_ESP_TASK_WDT_TIMEOUT_S=5`で、`CONFIG_ESP_TASK_WDT_PANIC`だけが未設定。1130〜1133行で読んだ。flashの前に`sha256sum -c`で照合した（出力は保存していない）。

### 試験

**時刻（2026-10-09。JSTとZ〔UTC〕を併記。JSTはZに9時間を足した値）**: flash開始17:22:24 JST（08:22:24Z。`flash-start.txt`と`monitor.log`の1行目）。flash完了08:23:12Z（17:23:12 JST。`Flashing has completed!`のlogの時刻）。その後、`monitor.log`に`POWERON_RESET`が2回あり（15行目と40行目）、app のlogは2回目からである。この記録のuptimeは、2回目の`POWERON_RESET`からの値で、2回目の時刻は記録していない。`deskcatd`の起動08:26:57Z（17:26:57 JST。Piの時計）、停止08:29:51Zごろ（17:29:51 JST）。monitor停止17:31:02 JST（08:31:02Z。`monitor-stop.txt`の時刻。停止の操作の後に書いた。`monitor.log`自身の末尾は17:30:58 JST）。USBを抜いた時刻は記録していない。

**ESP32のlog（`monitor.log`。sha256 `1c60c727600ec35d7779d51a6fa08ee4045e5f44b62404e9c7d5da0d3a193698`。端末のlocalで、repositoryに入れない）**:

- 起動: `display_bringup_done`（uptime 20.6秒）、`face_show name=Neutral`、`accel_device_id raw=0xe5`、`env_chip_id raw=0x60`、`tap_configured bw_rate=0x0a thresh_tap=0x18 dur=0x10 tap_axes=0x07 poll_interval_ms=20`
- 接続: uptime 36.9秒に`boot_terminated reason=RecoveryBudgetExhausted`（`deskcatd`が起動する前。下の「時刻の関係」）。uptime 224.8秒に`pi_rx_hello`、続いて`boot_resumed`（`previous=Terminated(RecoveryBudgetExhausted)`）、uptime 224.9秒に`boot_established`。`rst:0x1 (POWERON_RESET)`の行が2回ある（flash完了の後。1回目は`esp_image: segment 0:`の行の後に出力が無いまま、2回目の`POWERON_RESET`が来ている）
- `tapped`の送出（`pi_tx`）: 9回。uptime 247.6〜336.1秒。`tapped`のid: 6、8、9、10、12、15、17、18、20
- `pi_rx_set_expression`の受理: 9件（`Neutral` 5件〔うち1件は`boot_established`の直後の`set_expression`のid 4〕、`Surprised` 4件）。`Surprised`は`tapped`のid 6、12、15、20の後。（`tapped`のid〔ESP32のtx〕と`set_expression`のid〔Piのtx〕は別の系列で、数値が重なる。以下の「id」は、書いてある限り`tapped`のidである。）`tapped`のid 8、9、10、17、18の直後には、`Surprised`の`set_expression`が無かった（`Neutral`の`set_expression`は、その後に別に受理されている）。**`Surprised`の`set_expression`が無かった理由は未確認**。時刻の事実: id 8・9・10（uptime 249.3〜250.3秒）は、`tapped`のid 6の後の`Surprised`の受理（247.65秒）から`Neutral`の受理（252.37秒）までの間に出ている。id 17・18（263.5、264.7秒）は、`tapped`のid 15の後の`Surprised`の受理（262.15秒）から`Neutral`の受理（266.77秒）までの間に出ている。`Surprised`の`set_expression`があった`tapped`のid 6・12・15・20は、いずれも直前の`Neutral`の受理の後。`Surprised`から`Neutral`までが4.72秒と4.62秒の2回には、その間に`tapped`が3回と2回あり、2.07秒と2.09秒の2回には無い
- 描画側の`face_show`: `Surprised`は4件（uptime 247.663、258.993、262.153、336.143秒）、`Neutral`は6件（20.613〔起動〕、225.013〔`boot_established`の直後〕、252.373、261.063、266.773、338.233秒）。受理と描画は別の事象で、どちらもlogの行である
- tapの内訳（最後の`tap_detected`の行）: `sent=9 dropped_no_session=315 dropped_too_soon=20`。`dropped_no_session`は検出の回数であって、叩いた回数ではない（uptime 58.1〜156.7秒の区間で、`pi_rx_hello`〔uptime 224.8秒〕より前）。`dropped_too_soon`の20件は、uptime 247.653〜336.133秒の区間（`boot_established`の後）で、この区間の検出は`sent`と合わせて29件。`tap_detected`の行は344件で、`sent`、`dropped_no_session`、`dropped_too_soon`の合計と同じ
- 最後の`health`の行: `overrun_ticks=0`、`snapshot_errors=0`、`pi_uart_rx_buffer_full=0`、`pi_uart_rx_fifo_overflow=0`。`panic`、`heartbeat_overrun`、`task_wdt`の行は0件。`health`の行46件の`max_read_gap_ms`は19〜67（最後の行は50）
- 時刻の関係: 3つの時計がある。ESP32のuptime、PCの時計（flash完了08:23:12Zは`flash.out`、monitor停止08:31:02Zは`monitor-stop.txt`の時刻）、Piの時計（`deskcatd`の起動08:26:57Z、停止08:29:51Zごろ）。PCとPiの時計を直接照合した記録は無い。uptime 0をflash完了（08:23:12Z）に置くと、uptime 224.8秒は約08:26:57Zで、`deskcatd`の起動とほぼ一致する（uptime 0の置き方は近似。実際のuptime 0は2回目の`POWERON_RESET`で、flash完了より後なので、この置き方で算出した時刻は、実際より早い側にある）。この置き方で、最初の`Surprised`の受理（uptime 247.65秒）は約08:27:20Zで、`deskcatd`の停止まで約2分30秒、monitorの停止まで約3分40秒

**ユーザーの申告**（出所は、#21のセッションの会話からの転記。commentには無い）: 叩いた後、LCDの表情が驚いた顔に変わり、2秒ほどで戻った。最初の2分のLCDの観察とUART線を挿したことへの回答は、両方とも問題なし。叩いた回数、間隔、叩き方、変わった回数は申告に無い。logの`face_show name=Surprised`から`face_show name=Neutral`まで: 4.71、2.07、4.62、2.09秒（4回。`set_expression`の受理の間隔は、上の「ESP32のlog」にある）。約2秒という申告が4回のどれに当たるかは分からない。UART線の状態と配線の変更についての質問と回答は、[#21のcomment](https://github.com/wachi-yoshitaka-11-dev/deskcat/issues/21#issuecomment-6077223726)にある。

**Pi側**（#446のセッションの報告。Piで読んだ事実。この記録を書いたセッションは、Piの側を確かめていない。確かめた箇所は、その箇所に書く）: `deskcatd`のlog（`deskcatd-20261009T082657Z.log`、sha256 `b35a89377c2c556d7314e9076eb01b46ef0cdbcdac94ac90e0648beebba9846d`）は3行。起動の前後で`throttled=0x0`、journalの警告は0件。
`deskcatd`の同定: sourceは`ddf16c9`（[#569](https://github.com/wachi-yoshitaka-11-dev/deskcat/pull/569)、F2）の`apps/`、`crates/`、`Cargo.toml`、`Cargo.lock`の79 file。Piには`git`も`.git`も無く、この記録の端末で`git archive`したtreeをsshでPiへ展開した。79 fileのsha256は、この端末の`git archive ddf16c9`と全件一致（`sha256sum -c`。fileの集合も一致）。**firmwareのcommit（`cd878542`）とは違う。**`ddf16c9`から`cd878542`への`apps/`、`crates/`、`Cargo.*`の差は、`crates/deskcat-tap`（追加）、`Cargo.toml`、`Cargo.lock`、`crates/README.md`（`git diff --stat`で確かめた）。`Cargo.lock`のsha256 `b1d8ca0e7a3188e9bb68c83953ef33be8ad7df2f779b0591f210729dc3461a61`、`apps/deskcatd/src/main.rs`のsha256 `60636adeb604d4bae1e2de1dcee13068db98a514611e58b6a33473d40374efff`（どちらも`git show ddf16c9:`の内容と一致を、この記録を書いたセッションが確かめた）。`rustc 1.97.1 (8bab26f4f 2026-07-14)`、`cargo 1.97.1 (c980f4866 2026-06-30)`。command `cargo build --locked -p deskcatd`、build 2026-10-09 04:09:39Z〜04:10:38Z（13:09:39〜13:10:38 JST。Piの時計）、成果物`target/debug/deskcatd`のsha256 `238339ebda46d5b1ac92e63f7740a37cec9326c8df650c227449e39762d9fc20`（8,992,404 byte。#446の報告による。この記録を書いたセッションはPiで再計算していない）。`--locked`は、#446が発行したcommandの報告による。logにcommand行は無い（記録が無い）。`Cargo.lock`のsha256は、buildの前後で一致している。buildの`Compiling`は`deskcat-domain`と`deskcatd`の2件。`SBC-01`（Pi Zero W）には低電圧検出が無く、`throttled=0x0`は電圧について何も語らない（[power-budget.md](power-budget.md)の`Pi Zero Wには低電圧検出が無い`節、`EXP-009`）。

### 起動の回数（backlightが点く起動。計算であり、実測ではない）

USBを挿した時点の起動と、`monitor.log`の`POWERON_RESET`の行2回（flash完了の後。1回目は`esp_image: segment 0:`の行の後に出力が無い）。全部を起動と数えても3回で、承認した範囲（最大5回。[#21のcomment](https://github.com/wachi-yoshitaka-11-dev/deskcat/issues/21#issuecomment-6077223726)の「含む」の欄にある見積もりで、計算であり実測ではない）に収まる。

### Faults

- USBを抜いた時刻を記録していない
- 停止条件のうち、電圧降下は、観測する手段が無かった（測定器を使っていない）。Piがpingに応じなくなる、またはsshが切れたことの監視は、記録していない。上限15分は、flash開始17:22:24 JSTからmonitor停止17:31:02 JSTまでが約8分38秒で、起点の取り方による
- uptime 58.1〜156.7秒に`dropped_no_session`が315件ある。手順のどの段（UART線を挿す前か後か）に当たるかは記録していない（UART線を挿した時刻も記録していない）。uptime 0をflash完了に置く近似では、この区間は、停止条件の「最初の2分は目視」（flash完了から）の中に重なりうる
- 停止条件「表情が変わる証拠が出たら、すぐ止める」について、証拠を認めた時刻は記録していない。最初の`Surprised`の受理（uptime 247.65秒、約17:27:20 JST）からmonitorの停止（17:31:02 JST）まで約3分40秒で、その間に`tapped`のid 20（uptime 336.1秒）が出ている。満たしたかは、この記録から判定できない
- [gpio-assignment.md](gpio-assignment.md)の`信号線をつないでよい条件`の条件3が挙げる試験は、#446の受け入れ条件4、#11、#12、#13の受け入れ条件6である。このデモは#21の通電で、この列挙に#21は含まれない。承認は[#21のcomment](https://github.com/wachi-yoshitaka-11-dev/deskcat/issues/21#issuecomment-6077223726)にあり、条件3の列挙を更新した記録は無い
- `monitor.log`に`POWERON_RESET`の行が2回ある（上の「ESP32のlog」）。`EXP-018`は「どの起動でも、`rst:0x1 (POWERON_RESET)`が2回出た。原因は調べていない」と記録している。`EXP-018`は「起動ごとに2回出る理由は調べていない」とも書いている。`EXP-019`は、書き込み後の最初の起動で2回、monitorを開き直した起動で1回と記録し（時刻の表の行3、7、11、13、15）、`POWERON_RESET`の原因を主張しないとしている
- [power-budget.md](power-budget.md)の`DISP-01`追加接続のbring-upの手順の条件(1)（[gpio-assignment.md](gpio-assignment.md)の非通電の確認の項目1〜4）を、このデモの前に行った記録は無い。`EXP-019`の`Next safe step`が求めた非通電の確認（項目1〜7）も同じ。出所: 上の「Wiring revision」の行
- gpio-assignment.mdの`信号線をつないでよい条件`の条件1（直列4.7 kΩ）、条件5のGND共通、条件6（通電前の目視と導通の確認）を確かめた記録は無い。条件5の別電源は、上の「Power supply and current limit」の行にある。条件2（両方の電源が入ってからつなぐ、先に外す）は、承認の順序と、挿した、抜いたというユーザーの会話での報告だけが出所で、両方の電源が入っていたことを示す時刻は記録していない。条件4（人間の監視）は上の「実施者」のとおり。UART線を挿した時刻と抜いた時刻は記録していない。出所: 同じ行
- power-budget.mdの`DISP-01`追加接続のbring-upの手順の条件(3)(a)のPiをつなぐ場合の条件は、gpio-assignment.mdの条件1・5のGND共通・6の記録が、上の行のとおり無い。同手順の条件(3)(c)の周囲温度と、条件(6)の実施者の把握は、記録していない
- 同手順の条件(5)（`module電源pinの独立性`／`pin header対応`、pull-upの実効抵抗）を確かめた記録は無い。同手順の条件(2)が課すVersion Recordまたは相当の記録は、このデモのbuildについて作っていない（上の「firmware」の表が、commit、tree、sha256を持つ）
- gpio-assignment.mdの条件3が挙げるfirmwareの対応範囲（`boot`とそのACK、`hello`／`ping`／`get_status`）の外の`tapped`（ESP32→Pi）と`set_expression`（Pi→ESP32）を、UARTに流した。出所: [esp32-pi-protocol.md](../protocol/esp32-pi-protocol.md)の§4.3、§5.2と、上の「ESP32のlog」

### この記録が主張しないこと

- 常時点灯の熱の適否（発熱は測っていない）
- `POWERON_RESET`の原因
- power-budget.mdの`DISP-01`追加接続のbring-upの手順の条件(1)、(3)(c)、(5)、(6)と、gpio-assignment.mdの`信号線をつないでよい条件`の条件1・2・5のGND共通・6が満たされていたこと
- 閾値（1.5 g）の適否、静止中に`tapped`が出ないこと、end-to-endのlatency
- #13の受け入れ条件6の試験の結果（別の記録が#13のcommentにある）

### Conclusion

このデモで、ESP32のlogに`tapped`の送出と、`Surprised`の`set_expression`の受理と、`face_show name=Surprised`が出た。叩いた時刻との対応は記録していない。ユーザーの申告は、上の「ユーザーの申告」のとおり。`tapped` 9回のうち5回には、直後の`Surprised`の`set_expression`が無かった（理由は未確認）。

### Next safe step

- `tapped`のid 8、9、10、17、18の直後に`Surprised`の`set_expression`が無かった理由を調べる
- [gpio-assignment.md](gpio-assignment.md)の`信号線をつないでよい条件`の条件3（つないでよい試験の列挙と、firmwareが対応する範囲）の更新は、別のdocsの変更で、ユーザーの決定が要る
- 閾値を変える場合は、別の版のfirmwareと追加の起動の回数の承認が要る
- [#21](https://github.com/wachi-yoshitaka-11-dev/deskcat/issues/21)の受け入れ条件のチェックとcloseの判断は、この記録に含めない

## EXP-022: 周辺moduleをつないだESP32へPiをUARTでつなぎ、LCDの描画の間の通信を確かめた（受け入れ条件6）

**目的**: [#13](https://github.com/wachi-yoshitaka-11-dev/deskcat/issues/13)の受け入れ条件6「更新中も通信とwatchdogがactiveである」の試験の記録。`EXP-021`（[#21](https://github.com/wachi-yoshitaka-11-dev/deskcat/issues/21)のデモ）とは別の試験で、この記録に`EXP-021`の内容は入れない。結果の最初の記録は[#13のcomment](https://github.com/wachi-yoshitaka-11-dev/deskcat/issues/13#issuecomment-6042642898)にある。

**実施日（JST）**: 2026-10-07〜08。承認のcommentの時刻は2026-10-07 23:55 JST（14:55:33Z）と2026-10-08 01:35 JST（16:35:50Z）、書き込みの完了は2026-10-08 01:24:43 JST（16:24:43Z）、3回目のmonitorの開始は2026-10-08 01:42:57 JST（16:42:57Z）。JSTはZに9時間を足した値。

**実施者**: 電源、USBとUART線の抜き差し（手順の指示は作業セッション〔AI〕）、テスターの測定、通電中の目視はユーザー（どの区間に立ち会い、何を見たかは記録していない）。firmwareのbuild、書き込み、ESP32のシリアルlogの記録は#13のセッション（AI）。Piの`serial_link`のbuildと起動、Piの停止は#446のセッション（AI）。

### 構成

| 項目 | 内容 |
|---|---|
| Test ID | `EXP-022` |
| Date／Operator | 上の「実施日」「実施者」 |
| Firmware commit/profile | 下の「firmware」の表 |
| Configuration | 構成（v）。周辺module（`ACCEL-01`、`ENV-01`、`DISP-01`）をつないだESP32へ、PiをUARTの信号線2本とGNDの線でつなぐ（[#13のcomment](https://github.com/wachi-yoshitaka-11-dev/deskcat/issues/13#issuecomment-5952038994)） |
| Hardware revision／Exact components | `MCU-01`（ESP32）、`ACCEL-01`（ADXL345）、`ENV-01`（BME280）、`DISP-01`（MSP2807）、`SBC-01`（Raspberry Pi Zero W） |
| Wiring revision | 周辺module3点の配線は、`EXP-018`の後に`EXP-019`を経て戻した配線のまま変えていない。これは、ユーザーの言葉として、承認のcommentが承認の範囲に記録している（[#13のcomment 6040631378](https://github.com/wachi-yoshitaka-11-dev/deskcat/issues/13#issuecomment-6040631378)）。[power-budget.md](power-budget.md)の`DISP-01`追加接続のbring-upの手順の条件(1)は再測定していない。`EXP-019`の`Next safe step`が求めた非通電の確認（項目1〜7）をやり直した記録は無い。新しく足した線は、Piとの信号線2本（各線に直列4.7 kΩ）とGND線で、足した位置は「試験」に書く |
| Power supply and current limit | ESP32はPCのUSBから給電（`3V3` pin経路で周辺module3点へ）。Piは手持ちのadapter ②（`PSU-PI-A-01`）と、本体表記の無い手持ちのcable（[#446のcomment](https://github.com/wachi-yoshitaka-11-dev/deskcat/issues/446#issuecomment-5952463629)の決定）。電流制限は設けていない |
| 条件(7)の承認（[power-budget.md](power-budget.md)の`DISP-01`追加接続のbring-upの手順） | [#13のcomment 6040631378](https://github.com/wachi-yoshitaka-11-dev/deskcat/issues/13#issuecomment-6040631378)（通電の前に記録した）と、起動の回数の追加の[comment 6042340375](https://github.com/wachi-yoshitaka-11-dev/deskcat/issues/13#issuecomment-6042340375)（2回目以降のmonitorの前に記録した） |
| 条件(5)の扱い | 測らずに通電した。[#13のcomment 6040402283](https://github.com/wachi-yoshitaka-11-dev/deskcat/issues/13#issuecomment-6040402283)。pull-upの実効抵抗は未測定 |
| Measurement equipment | `DT830B`（`MEAS-03`。抵抗`2000`レンジ。GND線の確認と通電後の`VCC`–`GND`間）。ESP32のシリアルlog。Pi側`serial_link`のlog |
| Measured result | 下の「試験」の節（時刻、ESP32のlog、Pi側） |
| Expected result | 描画（5色の塗り、四隅のpattern、保持）の間もPi linkの受信とheartbeatが回り、Piの`ping`にACKが返る。task watchdogが有効である |
| Procedure | 順序は、前の#13セッションの会話の転記である（引き継ぎ書経由で、元の会話は参照できない）。時刻を持つのは、下の「試験」の「時刻」の表の範囲だけ。計画上の順序（実際は、Faultsの2行目のとおり、UART線を挿したままUSBを抜いた）: 電源を全部抜く、テスターの確認、GND線を足して読む、UART線のPi側の端を足す、Piのadapterを挿す、ESP32のUSBを挿す、書き込み、UART線のESP32側の端を挿す、Piの`serial_link`を起動、monitor、UART線を抜く、ESP32のUSBを抜く、Piを停止してadapterを抜く、`VCC`–`GND`間の再測定 |
| 停止条件 | [power-budget.md](power-budget.md)の`DISP-01`追加接続のbring-upの手順の手順8のとおり（ここへ抜き書きしない）。「橙と黄を先に抜いてからUSBを抜く」は、前の#13セッションの会話の計画として引き継ぎ書にある。信号線を先に外す順序は、[gpio-assignment.md](gpio-assignment.md)の`信号線をつないでよい条件`の条件2が定める。橙と黄という色の指定には、docsにもcommentにも出所が無い。給電を止める判断の上限は、書き込み後の起動から約1分（[#13のcomment 6040631378](https://github.com/wachi-yoshitaka-11-dev/deskcat/issues/13#issuecomment-6040631378)） |

### firmware

| commit | `firmware/`のtree | `firmware/esp32/`のtree | features／profile | ELF sha256 | sdkconfig sha256 |
|---|---|---|---|---|---|
| `2e165dc2f48725bd2f62829bca7fbde30b8f2971` | `86dd0e758591f4c03fea30864d6e1f02d983b8a9` | `c560d3449ee786543712c993df384a1818bcf2b6` | `bringup-display-13`、debug | `9308e09871043158b2036a01369bcda2bef8115e610fed94b0487026dc6e8f8d` | `97b835f65058e5ee7ca510b2e74e365f393ee1da2137ee52a72a151ed184d7d3` |

`cargo build --locked --features bringup-display-13`、repositoryの外のdetached worktree。sdkconfig（表のsha256）は、`CONFIG_ESP_TASK_WDT_EN=y`、`CONFIG_ESP_TASK_WDT_INIT=y`、`CONFIG_ESP_TASK_WDT_TIMEOUT_S=5`で、`CONFIG_ESP_TASK_WDT_PANIC`だけが未設定。Pi側: `serial_link`（`cargo build --locked -p deskcat-serial --example serial_link`）。ソースは`develop`の`36ba8f38`（Piの既存のtreeが古く、`git archive`で別のdirectoryへ展開した）。起動の引数は`--baud 115200 --duplicate-capacity 16 --duplicate-retention-ms 60000 --ping-count 2000`（`--seconds`は回ごとに違い、下の「試験」にある。必須の`--port`もあるが、報告は値を挙げていない）。出所: #446のセッションの報告（commentには無い）。`serial_link`のbinary（Pi上の`target/debug/examples/serial_link`）のsha256は`64a3c3a9d7fe3d8330a57b556891bc6766bec0972bc6e8f121a2f4de0db40439`（2026-10-10に#446が報告した。2026-10-07の試験の時点のbinaryと同一かは、確かめていない）。

### 試験

**時刻（2026-10-07〜08。JSTとZ〔UTC〕を併記）**: 次は、ESP32のlogとflashのlogにある時刻。

| 時刻（Z） | 事象 | 出所 |
|---|---|---|
| 16:23:29 | `espflash board-info`（接続して情報を読む。ESP32が起動し直る） | #13のセッションのtool出力（logは保存していない） |
| 16:23:56〜16:24:43 | flash（`Flashing has completed!`は16:24:43） | `flash.log` |
| 16:27:48 | 1回目のmonitorの開始（timeout 130秒。logはuptime 119.68秒まで。黄が`12`に刺さっていた） | `monitor-start.txt`、`monitor.log` |
| 16:35:50 | 起動の回数の追加の承認の記録 | #13のcomment 6042340375 |
| 16:36:35 | 2回目のmonitorの開始（timeout 240秒。ESP32のUSBを挿し直した後に開始。橙と黄を挿した時点がmonitorの開始の前か後かは、前の#13セッションの会話の転記〔引き継ぎ書経由〕が2通りに書いており、確定しない） | `monitor2-start.txt`、`monitor2.log` |
| 16:42:57 | 3回目のmonitorの開始（timeout 150秒） | `monitor3-start.txt`、`monitor3.log` |

Piの時計の時刻は次のとおり。出所: #446のセッションの報告（commentには無い。3回目の時刻は、#446が読んだPi上のlogの時刻と一致した）。Piの時計とこの端末の時計の差は測っていない。`serial_link`のbuild 15:50:41〜16:05:29Z（exit=0）。1回目のmonitorの間の`serial_link`は16:27:34Zに起動、`--seconds 180`。2回目は16:38:22Zに起動（`--seconds 240`）。3回目は、16:42:40Zから`/dev/serial0`の1byteを待つ待機の`wait_then_run.sh`を動かし、`first_byte`は16:43:05.513Z、`serial_link`（`--seconds 240`）を起動した。Piの`sudo shutdown -h now`は16:47:21Z。halt完了は見ていない。adapterを抜いた時刻と、haltの前か後かは記録していない。

**ユーザーの測定と目視（前の#13セッションの会話の転記。引き継ぎ書経由で、元の会話は参照できない。commentに出所のある項目は、commentを指す。指していない項目は、この転記だけが出所である）**:
- `DT830B`の自己確認（抵抗`2000`レンジ）: 短絡`003`、開放`1`
- GND線を挿す前の開放側: Piのpin 6とESP32の右列の一番端のGND（`23`の隣）の間が`1`
- GND線（灰色のジャンパ）をPiのpin 39とESP32の右列の`21`の次のGNDへ挿した後、同じ2点間（と転記にある。挿す前はPiのpin 6とESP32の`23`の隣、挿した後はpin 39と`21`の次と書かれた位置が違い、同じGND同士かは確かめていない）: `006`（数秒間、短絡の表示と同程度のまま変わらなかった。「同程度」の基準は転記に無い）
- UART線2本のPi側の端: 紫がpin 8、青がpin 10（[#13のcomment 6042340375](https://github.com/wachi-yoshitaka-11-dev/deskcat/issues/13#issuecomment-6042340375)にもある）。ブレッドボード上の抵抗は、紫の線に`h1`–`h4`、青の線に`i2`–`i5`（各線に4.7 kΩが1本）。Piの5 Vのpinに線も抵抗も触れていない
- ESP32側の端: 橙が`14`。黄は1回目のmonitorの時点で`12`に刺さっていた（`13`が正）。`13`は`PI-UART-TX`、`14`は`PI-UART-RX`（[gpio-assignment.md](gpio-assignment.md)の`物理接続`の行）。1回目に`hello`が0件だった理由は確かめていない。`13`へ挿し直した。挿し直した時点が2回目のmonitorの開始の前か後かは、この転記では確定しない（橙と黄の位置と挿し直しの予定は[#13のcomment 6042340375](https://github.com/wachi-yoshitaka-11-dev/deskcat/issues/13#issuecomment-6042340375)にある）
- 通電後（Piを停止してadapterを抜いた後）の`DISP-01`の`VCC`–`GND`間（`2000`レンジ）: `1381`から`1211`へ下がって安定（[#13のcomment 6042642898](https://github.com/wachi-yoshitaka-11-dev/deskcat/issues/13#issuecomment-6042642898)にもある）
- LCD（目視）: この転記では、2回目の起動の報告は黒・赤・緑・青・パターンの順で白が無く、3回目の報告は黒・赤・緑・青・白・パターンの順で白がある。[#13のcomment 6042642898](https://github.com/wachi-yoshitaka-11-dev/deskcat/issues/13#issuecomment-6042642898)は、白まで出たのを2回目と3回目の起動と書く。ESP32のlogは、3回とも`display_fill name=white`の行が出ている（uptime 14202 ms、14202 ms、14312 ms）。これは描画の命令が走った証拠であり、目視の証拠ではない。写真は無い。写真はGitにもIssueにも上げていない

**ESP32のlog（`monitor.log`、`monitor2.log`、`monitor3.log`。sha256はそれぞれ`bb0d892c379e8c0f65ab79de10b8a717cf994abacf2aeadade36d655df5541b3`、`08bfeb522ef2f7a836450071ac44f8b367737435537adcc2a433085f85af999d`、`e6da4feb6504d8917a83e2a48d47ae29b886cdc73f0b910db78f3437d7584cf0`。端末のlocalで、repositoryに入れない）**:

| 回 | `rst:0x1 (POWERON_RESET)` | `boot` | 描画 | `health`（uptime 20169 ms） |
|---|---|---|---|---|
| 1 | 1回 | `boot_tx`を送り続け、uptime 36.9秒に`boot_terminated reason=RecoveryBudgetExhausted`。`pi_rx_hello`は0件 | `display_fill`×5、`display_pattern_hold`、`display_bringup_done`（uptime 20.6秒）が出た | `overrun_ticks=0`、`max_read_gap_ms=66`、`pi_uart_rx_buffer_full=0`、`pi_uart_rx_fifo_overflow=0` |
| 2 | 1回 | uptime 36.9秒に`boot_terminated`。uptime 98.8秒に`pi_rx_hello`、続いて`boot_resumed`と`boot_established` | 同上 | `overrun_ticks=0`、`max_read_gap_ms=66`、`pi_uart_rx_buffer_full=0`、`pi_uart_rx_fifo_overflow=0` |
| 3 | 1回 | uptime 762 msに`pi_rx_hello`、942 msに`boot_established` | 同上。`display_fill`の最初の行はuptime 1002 ms、`display_pattern_hold`は17.76秒、`display_bringup_done`は20.76秒 | `overrun_ticks=0`、`max_read_gap_ms=77`、`pi_uart_rx_buffer_full=0`、`pi_uart_rx_fifo_overflow=0` |

- 3回目: 描画の間（`display_fill`の最初の行のuptime 1.002秒から`display_bringup_done`の直前の`pi_tx`の行〔20.752秒〕まで）に、`pi_tx`の行のACKが837件ある（最後のidは840。窓の中のid 3〜840のうち、id 4は`status`で、残りがACK。欠けも重複も無い。id 1と2〔762 msのACK〕は窓の前）。3回目のlog全体の`pi_tx`のACKは2002件。その後の`health`を含め、3回のlogの全ての`health`の行（3回目は14行、uptime 10〜140秒）で`overrun_ticks=0`。`heartbeat_overrun`と`task_wdt`の行は、1〜3回目のどのlogにも0件。`accel_device_id raw=0xe5`、`env_chip_id raw=0x60`が3回とも出た
- 3回とも、`display_madctl value=0x28 width=320 height=240`が出た。`display_fill`の行は各回5色分で、`elapsed_us`を持つ（値はlogにある）
- 根拠にしないもの: 保持の間の`hb`の行、`reset_reason`と`rst:`の行、ESP32側のUART誤りのcounterと`ProtocolCounters`

**Pi側（3回目の`serial_link`。出所: #446のセッションが、Pi上の`runlogs`の3回目のlog〔`serial_link-20261007T164240Z.log`、6022行〕を読み取り専用で読んだ報告〔2026-10-10〕。この記録を書いたセッションは、Piのlogを直接は読んでいない）**: 終了時のcounters `bytes_in=222251 bytes_out=138757 frames_in=2003 rejected_in=1`、`disconnects=0 reconnect_attempts=0 timeouts=0 retries=3833`、`dropped_out=0 discarded_on_disconnect=0 encode_failed=0`、`session_switches=1 duplicate_replays=0 stale_sessions=0 duplicate_expired=0`、`invalid_payloads=0 rate_limited=0 unmatched_acks=0 unapproved_hello_acks=0 unknown_types=0`、`pings_sent=2000 ping_acks=2000 ping_rejected=0 ping_retries=0 ping_gave_up=0`。`retries=3833`の意味は確かめておらず、結論の根拠にしていない。経過240.014秒、log出力の失敗0件。WARNは1件で、7行目（起動直後）の`code=InvalidEnvelope cause=InvalidUtf8 { valid_up_to: 0 }`（1 invalid byte、0 valid byte。`rejected_in=1`に対応）。ERRORは0件。時刻（Piの時計、Z）は、待機開始16:42:40、最初の1 byte受信16:43:05、logの最終更新16:47:05。`sid=5156`。このlogのsha256は`2ffb8238a28543941ae1651530ef26bd2b1b72d0d11352223b0f5adfaf8fdace`。このlogが持つのは件数のcounterだけで、個々のrequestとACKを1件ずつ対応づけた行は持たない。1回目の`serial_link`は`bytes_in=0`。

### 起動の回数（backlightが点く起動。計算であり、実測ではない）

最初の承認（[#13のcomment 6040631378](https://github.com/wachi-yoshitaka-11-dev/deskcat/issues/13#issuecomment-6040631378)）は最大6回、追加の承認（[comment 6042340375](https://github.com/wachi-yoshitaka-11-dev/deskcat/issues/13#issuecomment-6042340375)）は、前の承認に加えて最大3回（承認の合計は最大9回）。追加の承認の前の起動は、comment 6042340375が最大5回と数えた（挙げているのは4件で、5回目は特定していない。USBを挿した時点、`espflash board-info`、書き込みの後、monitor付きの再起動）。この記録が数えたのは、追加の承認の後に3回（USBを挿した時点、2回目のmonitor、3回目のmonitor）。合計は最大8回で、承認の合計（最大9回）の内。USBを挿した時点の起動と、書き込みの後の起動は、`monitor`を開く前のため、logが無い。

### Faults

- 1回目のmonitorで、黄を`13`ではなく`12`に挿していた。`boot`のACKは0件（ユーザーの目視で`12`と判明）。`12`は`MTDI`で、[gpio-assignment.md](gpio-assignment.md)の`LCD-RST`の注意1は、reset時の`MTDI`をHighへ引くと`VDD_SDIO`が1.8 Vになり3.3 V前提が崩れると書く。黄（ESP32のTX線のはず）が`12`にあった間のreset時の`MTDI`の電位と`VDD_SDIO`への影響は、評価していない。ESP32は起動し、logが出た。Pi側のpin 10の状態は記録していない
- 作業セッション（AI）の手順の誤りで、UART線をESP32に挿したまま、ESP32のUSBを抜いた。Piは動いたままだった。[gpio-assignment.md](gpio-assignment.md)の`信号線をつないでよい条件`の条件2（片方の電源を切るときは先に信号線を外す）に反する状態で、持続時間は記録していない（数分と見積もった。根拠は転記に無い。[comment 6042340375](https://github.com/wachi-yoshitaka-11-dev/deskcat/issues/13#issuecomment-6042340375)も「数分」と書く）。Piの送信線がHighのまま、電源の無いESP32の入力に4.7 kΩ越しにつながった状態で、`HW-TBD-036`の弱点の状態。ESP32の電気的な損傷の有無を判定していない（`accel_device_id`と`env_chip_id`は3回とも出た）。この事象が各monitorのどの前だったかは記録していない。ユーザーは、この違反を知った上で追加の3回を承認した（[comment 6042340375](https://github.com/wachi-yoshitaka-11-dev/deskcat/issues/13#issuecomment-6042340375)）。損傷の確認はlogからの読みだけで（[comment 6042642898](https://github.com/wachi-yoshitaka-11-dev/deskcat/issues/13#issuecomment-6042642898)のFaults (e)）、テスターなどで確かめた記録は無い
- 給電を止める判断の上限（書き込み後の起動から約1分）より後も、給電を続けた。monitorのtimeoutは130秒、240秒、150秒で、`serial_link`の`--seconds`は180と240。この延長を判断した者と、延長の承認の記録は無い（承認の範囲が書いたのは約1分で、どのcommentにも延長の承認は無い）。その区間が人間の監視下にあったかは記録していない。超過の長さは、USBを抜いた時刻が未記録のため出せない
- 条件(1)（非通電の確認、gpio-assignment.mdの項目1〜4）は再測定していない。`EXP-019`の`Next safe step`が求めた非通電の確認（項目1〜7）もやり直した記録が無い。根拠は、ユーザーの回答（上の「Wiring revision」の行）だけである。これは、[power-budget.md](power-budget.md)の「実施前に満たす条件(1)〜(7)」の節に反する逸脱で、同節は条件(5)以外を省略してよいとする記述を持たない。条件(4)は、上の構成の表のとおり
- 条件(5)（`module電源pinの独立性`／`pin header対応`、pull-upの実効抵抗）を測っていない
- gpio-assignment.mdの`信号線をつないでよい条件`の条件6（通電前の確認）は、新しく足した線（GND線、UART線のPi側の端）だけを確かめたと転記にある。GNDの測定点が正本の方法に合うかは、判定していない（上の転記のとおり、挿す前と挿した後で測った点が違う）。ESP32側の端は、正本が（条件6の下の項目で）条件2でつなぐ前に目で確かめると定めるが、挿し先が`12`だったことは見つけられなかった。目視した時刻は記録していない。条件1の4.7 kΩは、ユーザーの回答が出所で、抵抗の値の測定はしていない。条件2について、時刻を記録した事象は上の表にある範囲だけで、両方の電源が入っていた時刻とUART線を挿した時刻の対応は、記録していない
- [power-budget.md](power-budget.md)の`DISP-01`追加接続のbring-upの手順の条件(2)（条件(1)と同じく、前述の「実施前に満たす条件(1)〜(7)」の節に反する）が課すVersion Recordまたは相当の記録を、このbuildについて作っていない（上の「firmware」の表が、commit、tree、sha256を持つ）。条件(3)(c)の周囲温度と、条件(6)の実施者の把握は、記録していない
- USBを挿した時刻、Piのadapterを挿した時刻、UART線のESP32側の端を挿した、抜いた時刻、USBを抜いた時刻を記録していない。書き込みの途中でLCDが点いたというユーザーの申告があるが、どの起動かは確かめていない
- 最初の書き込みの前に、`espflash board-info`で1回、ESP32を起動した（時刻の表の1行目）。書き込み前のimageの版は記録していない。[power-budget.md](power-budget.md)の手順7が、この区間のlogとbacklightの状態を`Measured result`／`Faults`へ記録するよう求める。記録できるのは、この起動のlogが無いことと、LCDの状態を記録していないことである
- 手順10が比べる通電前の`VCC`–`GND`間の読み（手順2の項目1）は、この試験で取っていない（条件(1)を再測定していない）。上の通電後の読みは比較の相手を持たない。比べるかどうかは、この記録では判定せず、#13に置く
- 手順11が求める受け入れ条件6件の確認／未達の明記を、この記録は持たない（扱うのは条件6の試験だけで、判定は#13）。
- 手順8の発熱、異音、異臭の確認の方法と結果を、記録していない。給電側の電圧降下は測っていない。停止条件に当たる報告は、[#13のcomment 6042642898](https://github.com/wachi-yoshitaka-11-dev/deskcat/issues/13#issuecomment-6042642898)に無い
- 手順11が求める、描画の間にPiが送ったrequestとESP32が返したACKの対応は、取っていない。Pi側のlogは件数のcounterだけを持ち、1件ずつの対応づけを持たない（#446の報告）。ESP32のlogのACK837件（上）と、Pi側の送信の記録は、突き合わせていない
- [#13のcomment 6042642898](https://github.com/wachi-yoshitaka-11-dev/deskcat/issues/13#issuecomment-6042642898)は、描画の間のACKを「約709件」と書く。709は、ack の id が17.67秒の行で709だった値で、件数ではない。件数は、この記録の値（837件）が正である。同じcommentの「最初のmonitor（約112秒）」は、`monitor.log`の最後の行のuptime 119.68秒と合わない。また同commentは、LCDで白の塗りまで出たのを2回目と3回目の起動とするが、上の転記では、2回目の報告に白が無かった。どちらが正かは、確かめていない
- Piの時計とこの端末の時計の差を測っていない。Pi側のlogの時刻とESP32のlogの時刻は、この表の範囲では対応づけていない
- Pi側のlogは、この記録を書いたセッションが直接は読んでいない。内容は#446のセッションの報告（上）による。`InvalidUtf8`の1 byteが、待機側が消費した1 byteの後の`boot`の残りかどうかは、確かめていない（#13のcomment 6042642898の読みは、行の中身を持たない段階の推測だった）
- `monitor.log`、`monitor2.log`、`monitor3.log`にそれぞれ`POWERON_RESET`が1回ある。`EXP-018`は、どの起動でも2回出たと記録し、原因を調べていない。`EXP-019`は、書き込み後の最初の起動で2回、monitorを開き直した起動で1回と記録している（時刻の表の行3、7、11、13、15）。この3回のlogは、1回ずつである
- この試験で流した通信は、`boot`とそのACK、`hello`、`ping`、`get_status`とその応答である（[gpio-assignment.md](gpio-assignment.md)の条件3が挙げるfirmwareの対応範囲）。`get_status`の応答は、ESP32のlog（3回目）の`pi_tx frames=[("ack", 3), ("status", 4)]`の行にある

### この記録が主張しないこと

- 保持の間の`hb`の行、`reset_reason`と`rst:`の行、ESP32側のUART誤りのcounterと`ProtocolCounters`を、通信とwatchdogのactiveの根拠にしていない
- debug profileでは`CONFIG_ESP_TASK_WDT_PANIC`が未設定で、task watchdogが発火してもresetしない。この試験では、`task_wdt`のerrorのlogが出なかったことだけを記録している。watchdogがactiveであることは、sdkconfigの設定値からの推定で、動作の観測は無い。logの不在をactiveの証拠にしない
- 手順8の停止条件を監視したとは主張しない（確認の方法と結果は、Faultsのとおり記録していない）
- `EXP-021`（#21のデモ）の内容を含まない
- #13の受け入れ条件は6件あり、この試験が扱うのは条件6の試験だけで、条件6の確認／未達の判定も、この記録ではしない（判定は#13。Faults参照）。各条件の状況は#13の本文（2026-10-07T16:52:45Zの版。内容は転記していない）にある。条件1〜5の記録は、この試験の範囲外である。受け入れ条件のチェックとcloseの判断を含まない

### Conclusion

3回目のmonitorで、ESP32のlogに、描画の間（uptime 1.002〜20.752秒）の`pi_tx`のACK837件、描画の窓の内側（uptime 20.169秒）の`health`の`overrun_ticks=0`、`max_read_gap_ms=77`、`heartbeat_overrun`と`task_wdt`の行が0件であることが出た。Pi側の報告は`pings_sent=2000 ping_acks=2000`（ユーザーの回答では各線に4.7 kΩを直列に入れた構成で、baud 115200で成立した）。黄が`12`に刺さっていた1回目では、`boot`のACKは0件だった。ESP32側は3回目のmonitor（timeout 150秒）、Pi側は`--seconds 240`で、観測した区間が違う。Piの時計との差は測っておらず、ESP32の`pi_rx_hello`（uptime 762 ms）とPiの`first_byte`（16:43:05.513Z）の前後は対応づけていない。

### Next safe step

- #446の報告による数字と`rejected_in=1`の行の中身（その報告はrepositoryにもIssueにも保存されていない）を、Piの`serial_link`のlog（sha256は上）で確かめ、結果をcommentに残す
- 条件(1)の非通電の確認と、条件(5)のpull-upの実効抵抗は、この記録の範囲外で、別の機会に要る
- [gpio-assignment.md](gpio-assignment.md)の条件6（ESP32側の端の、つなぐ前の目視）を、挿し先の取り違いを見つけられる手順にするかは、別のdocsの変更で、ユーザーの決定が要る
- ESP32の電気的な損傷の確認（`accel_device_id`と`env_chip_id`の応答の読みだけでは判定していない）と、手順10の比較（通電前の`VCC`–`GND`間の読みを取った後）は、別の機会に要る
- 黄が`12`（`MTDI`）にあった間のreset時の電位と`VDD_SDIO`への影響の評価は、まだ無い。この試験の後の`EXP-021`（2026-10-09、同じ`MCU-01`）にも、この評価の記録は無い。次の通電の前に要る
- #13の受け入れ条件のチェックとcloseの判断は、この記録に含めない

## EXP-023: Piの給電を112001へ差し替え、UARTの通信を確かめた

[#446](https://github.com/wachi-yoshitaka-11-dev/deskcat/issues/446)の受け入れ条件4の試験。段階AのPiの給電を、`PSU-PI-A-01`と`CABLE-PI-A-01`から112001（cable一体のACアダプター。[hardware-bom.md](hardware-bom.md)の`PSU-PI-A-02`）へ差し替えた。記録の出所は[#446のcomment 6109307768](https://github.com/wachi-yoshitaka-11-dev/deskcat/issues/446#issuecomment-6109307768)である。Pi側の事実は#446のセッション（AI）がsshで読んだ報告で、ESP32側のlogはこの記録の作成者は読んでいない。

| 項目 | 内容 |
|---|---|
| Test ID | `EXP-023` |
| Date | 2026-10-11（Piの時計で、通信の確認は13:00:51Z〜13:02:36Z。差し替えと起動の時刻の記録は無い。運転は約6分である〔#446のcomment 6109307768〕。Piの時計とこの端末の時計の差は測っていない） |
| Operator | 給電の差し替えと電源の入り切り、信号線の接続、目視（熱・異音・焦げ臭さ）はユーザー（初回の通電に立ち会った）。sshでの読み出しと`deskcatd`／`serial_link`の起動は#446のセッション（AI） |
| Hardware revision／Exact components | `SBC-01`（Raspberry Pi Zero W）、`MCU-01`（ESP32）。adapterは`PSU-PI-A-02`（112001。label：入力`AC100-240V 41-55VA 50/60Hz`、出力`DC5V 3.0A`。cable一体） |
| Wiring revision | `PSU-PI-A-02`のcableのplugを、Piの`PWR IN`へ挿した。信号線のESP32側の端は、ユーザーが戻した（ユーザーの申告）。Pi側の端とGND線は触っていない。それ以外の配線の変更の有無は、comment 6109307768に記録が無い |
| Power supply and current limit | Piは`PSU-PI-A-02`。ESP32はUSBでつないで給電した（給電元は、comment 6109307768に記載が無い）。電流制限は設けていない。**112001の極性と出力電圧は実測していない**（事前測定を行わない決定はユーザー。[#446のcomment 6105175775](https://github.com/wachi-yoshitaka-11-dev/deskcat/issues/446#issuecomment-6105175775)）。事前測定を行わない決定はユーザーが行った |
| Firmware commit/profile | ESP32：**書かれているfirmwareのbuildは確かめていない**。Pi：`deskcatd`は`ddf16c9`のソースのbuild（sha256は先頭8桁`238339eb`だけを記録する。#446のcomment 6109307768は末尾を`9c20`と書くが、`EXP-021`の記録の完全な値の末尾は`9fc20`で食い違う。Piで再計算していない）、`serial_link`のsha256は`64a3c3a9…0439` |
| Configuration | 112001への差し替えと初回の通電は、ユーザーが立ち会った（[#446のcomment 6109307768](https://github.com/wachi-yoshitaka-11-dev/deskcat/issues/446#issuecomment-6109307768)）。**差し替えと初回の通電の承認を記録したcommentは確認できない**（関連するcommentは、表記の記録〔[6104039603](https://github.com/wachi-yoshitaka-11-dev/deskcat/issues/446#issuecomment-6104039603)〕、出力端の形の申告〔[6104068278](https://github.com/wachi-yoshitaka-11-dev/deskcat/issues/446#issuecomment-6104068278)〕、事前測定を行わない決定〔[6105175775](https://github.com/wachi-yoshitaka-11-dev/deskcat/issues/446#issuecomment-6105175775)〕で、いずれも承認ではない）。順序は、条件2（[gpio-assignment.md](gpio-assignment.md)の`信号線をつないでよい条件`）に従い、ESP32の電源を入れた後で、信号線のESP32側の端を戻した。Pi側の端とGND線は触っていない |
| Measurement equipment | テスター等は使っていない（電圧・電流を測った記録は無い）。Piの`vcgencmd get_throttled`、Pi上のlog |
| Procedure | Piの給電を差し替え、Pi単独で起動（信号線のESP32側の端は外したまま）。起動の確認の後、ESP32を入れ、信号線の端を戻して、`deskcatd`を約40秒動かし、続けて`serial_link --ping-count 20`を実行した |
| Expected result | Piが起動し、UARTでESP32と通信できること |
| Measured result | 下記 |
| Faults | 下記 |
| Conclusion | 下記 |
| Next safe step | 下記 |

### 結果

- 熱・異音・焦げ臭さは無かった（ユーザーの申告）
- Pi単独の起動：差し替え後2分で`throttled=0x0`、`/dev/serial0`あり、`deskcatd`は動いていない。起動時のカーネルlogに`EXT4-fs: orphan cleanup on readonly fs`が1行あるが、I/Oエラーは無く、rootは`rw`。**Pi Zero Wは低電圧を検出しないので、`throttled=0x0`は電圧について何も語らない**（`EXP-009`）
- `deskcatd`：Piの時計で13:00:51Zに起動。logは3行で、`hello`を送り、ESP32のACKに「応答送信側のsessionが未承認のため受理しない」というWARNが1件出た（`EXP-021`の`deskcatd`のlogと同じ形）
- `serial_link --ping-count 20`：13:01:56Z〜13:02:36Z。`state: Connected`、`pings_sent=20 ping_acks=20 ping_rejected=0 ping_retries=0 ping_gave_up=0`、`rejected_in=0`、`disconnects=0`、`timeouts=0`、`unmatched_acks=0`。`retries=785`（`SessionCounters::retries`は、送信の再送ではなく、I/Oの進捗が無かった回数である〔`crates/deskcat-serial/examples/serial_link.rs`のdoc〕。#446のcomment 6109307768は「`hello`の再送を含む」と書くが、この実装と合わない。内訳は読んでいない）
- logのsha256：`serial_link`は`fcf8bc86…e1a0`、`deskcatd`は`9eb02203…cf03`

### Faults

- **この試験の前の出来事（旧adapterの運転中）：**2026-10-11T01:10:46Zに、停止の命令を送ろうとしてsshをつないだところ`No route to host`で届かず（名前は引けたが、pingに応答が無かった）、停止の命令は実行されなかった。ユーザーがPiの電源を切った。切る前のPiの状態は確かめていない。SDカードへの影響の確認は、次の起動に回した。原因は特定しておらず、過去のWi-Fiの切断の記録（`EXP-020`）と同じ原因かも分からない（[#446のcomment 6105181072](https://github.com/wachi-yoshitaka-11-dev/deskcat/issues/446#issuecomment-6105181072)）。この試験の約6分の間に、sshが届かなくなったことは記録していない
- `retries=785`の内訳を読んでいない
- ESP32に書かれているfirmwareのbuildを確かめていない。ESP32側のlogを読んでいない
- 112001の電圧、極性、plugの形を測っていない。Piの入力電圧を測った記録は無い
- 起動時のカーネルlogの`EXT4-fs: orphan cleanup on readonly fs`が、直前の電源断（上）によるものかは確かめていない
- [gpio-assignment.md](gpio-assignment.md)の`信号線をつないでよい条件`のうち、条件2（順序）以外の確認の記録が、comment 6109307768に無い：条件1（各信号線への直列4.7 kΩ）、条件5（別々に給電し、GNDを共通にする）、条件6（通電前のGNDの線とUARTの線のPi側の端の確認）。確認したか否かは、この記録からは分からない
- 条件3（firmwareとhostがこのUARTに対応している）は、ESP32に書かれているfirmwareのbuildを確かめていないため、この記録からは確かめられない（`ping`のACKが返ったことは、対応の証拠の一部にとどまる）

### この記録が主張しないこと

- 電源経路の受け入れ。極性と電圧を実測していない
- 112001が安全であること、または`PSU-PI-A-01`より優れていること。電圧を測っておらず、比較していない
- 長時間の運転。運転したのは約6分だけである
- `throttled=0x0`を電圧の根拠とすること
- 直前のssh不通の原因

### Conclusion

112001で、Piは差し替え後2分で起動し、UART越しに`serial_link`の`ping`20件に20件のACKが返った。熱・異音・焦げ臭さの申告は無かった。電源の適否は、この記録では判断しない。

### Next safe step

- 112001で長く運転する場合は、人間の監視のもとで行い、その前に、sshが届かなくなった件（上）の原因を切り分ける（Piのjournalで、Wi-Fiの切断かPiの停止かを分ける）
- ESP32のfirmwareのbuildを確かめてから、次の通電に進む

## EXP-024: deskcatdの常駐（systemd）をPiへ導入し、電源投入での起動とfailedからの戻しを確かめた

[#446](https://github.com/wachi-yoshitaka-11-dev/deskcat/issues/446)の受け入れ条件4の試験。`deploy/systemd/deskcatd.service`をPiへ導入し、Piの起動での自動の開始、ESP32とつながらないときの再起動とfailed、`reset-failed`と`restart`での戻しを観察した。記録の出所は[#446のcomment 6123783146](https://github.com/wachi-yoshitaka-11-dev/deskcat/issues/446#issuecomment-6123783146)（導入と起動の確認）と[comment 6123004894](https://github.com/wachi-yoshitaka-11-dev/deskcat/issues/446#issuecomment-6123004894)（firmwareの特定）である。承認は[comment 6123867297](https://github.com/wachi-yoshitaka-11-dev/deskcat/issues/446#issuecomment-6123867297)に問いと回答の文面を保存した。時刻はUTCで、「ユーザーの報告」の時刻は、報告を受けて作業セッション（AI）が記録した時刻である。

| 項目 | 内容 |
|---|---|
| Test ID | `EXP-024` |
| Date | 2026-10-12（UTC 11:01〜11:55。JST 20:01〜20:55。内訳：Piでのbuild 11:01:28〜11:21:02、ESP32のflashの読み出し 11:04:39〜11:05:03、導入 11:40ごろ〔Pi上のfileの更新時刻がJST 20:40:25〜20:40:37、UTC 11:40:25〜11:40:37〕、起動の確認 11:45:25〜11:55。点灯は11:45:25から） |
| Operator | ESP32のUSBの抜き挿し、Piの電源の入れ直し、信号線のESP32側の端の抜き挿しと挿し先の目視、LCDと熱・異音・焦げ臭さの目視はユーザー。sshでの導入、`systemctl`の操作、journalの読み出し、ESP32のflashの読み出しは作業セッション（AI） |
| Hardware revision／Exact components | `SBC-01`（Raspberry Pi Zero W）、`MCU-01`（ESP32、revision v1.0、flash 4MB）。adapterは`PSU-PI-A-02`（112001） |
| Wiring revision | 信号線2本とGND線は、`EXP-023`のまま。ユーザーの申告：前回（2026-10-11）の接続から、ESP32側の端の抜き挿し以外に配線を動かしていない（問いの文面は[comment 6123783146](https://github.com/wachi-yoshitaka-11-dev/deskcat/issues/446#issuecomment-6123783146)）。測定も目視もしていない |
| Power supply and current limit | Piは`PSU-PI-A-02`（極性と出力電圧は実測していない。事前測定を行わない決定はユーザー。[comment 6105175775](https://github.com/wachi-yoshitaka-11-dev/deskcat/issues/446#issuecomment-6105175775)）。ESP32はこの端末のUSBから給電。電流制限は設けていない |
| Firmware commit/profile | ESP32：flashのapp descriptorの`app_elf_sha256`が`14297916fbb00b7ec58d19542c6131c394717876334d26384e56ae89a42f676b`で、`EXP-021`の表のELF sha256（commit `cd878542a4772d762599224af3e770b30d895fcf`、`tap-21,face-21,bringup-display-13`、debug）と全桁一致。読んだのは先頭0x100 byteだけで、imageの残りは読んでいない。Pi：`deskcatd`はdevelop `f0925027619066ace3153f30a52fe2607e940297`のsourceのbuild（debug。sha256 `38a47c1567d1e6748a05552c675dba4eb0f581a6054f2c82a55d8a3f67b684a5`）、`deskcatd.service`のsha256は`032541225e9ec62d02391dab6bea9b0ea5bb544b85aef4bc1fc4c3a3873ca8de` |
| Configuration | 承認3件：[comment 6123867297](https://github.com/wachi-yoshitaka-11-dev/deskcat/issues/446#issuecomment-6123867297)。点灯時間の上限は「1回の通し・30分」（根拠の無い暫定値）。条件1・5（[gpio-assignment.md](gpio-assignment.md)の`信号線をつないでよい条件`）：前回からの配線のままというユーザーの申告だけで、測定も目視もしていない。条件6：ESP32側の端を挿す前に、ユーザーが挿し先を目で確かめた（申告：13と14に合っている）。GND線の導通確認はこの回はしていない（2026-10-11の接続の分は[comment 6122958112](https://github.com/wachi-yoshitaka-11-dev/deskcat/issues/446#issuecomment-6122958112)の申告）。条件2：切るときは先にESP32側の端を外してからUSBを抜いた |
| Measurement equipment | テスター等は使っていない。Piの`vcgencmd get_throttled`、`systemctl`、`journalctl` |
| Procedure | 下の「導入」と「起動の確認」 |
| Expected result | Piの起動で`deskcatd`が始まる。ESP32側の端を外した間は`HelloRetryExhausted`で再起動し、約150秒で`failed`になる（承認の問いに書いた見込み。根拠は`daemon.rs`のmodule docと`deskcatd.service`の値からの計算で、実測ではない）。端を挿した後は`reset-failed`と`restart`でESP32とつながる |
| Measured result | 下記 |
| Faults | 下記 |
| Conclusion | 下記 |
| Next safe step | 下記 |

### 導入（Piに書き込む操作。ESP32・信号線・電源には触れていない）

- build：develop `f0925027`の`apps/`・`crates/`・`Cargo.*`（85 file）をPiの新しいdirへ展開し、`cargo build --locked -p deskcatd`（debug、targetも新規）。開始11:01:28Z、終了11:21:02Z（記録した時刻の差は19分34秒）。cargoの表示は`Finished … in 19m 32s`。exit 0。peak RSSは248,644 kB（5秒ごとのsamplingの最大値）。この間、Piは再起動せず、カーネルlogに低電圧・OOM・I/Oエラーの行は無かった。`throttled=0x0`と、このlogは電圧の根拠ではない
- 配置：専用ユーザー`deskcatd`（system、nologin）、`/usr/local/bin/deskcatd`、`/etc/deskcatd/deskcatd.env`（`DESKCATD_PORT=/dev/serial0`、`DESKCATD_BAUD=115200`）、`/etc/systemd/system/deskcatd.service`（develop `deploy/systemd/`のまま）。`systemd-analyze verify`は警告なし。`daemon-reload`と`enable`。startはしていない
- 手順は[deploy/README](https://github.com/wachi-yoshitaka-11-dev/deskcat/blob/develop/deploy/README.md)の`導入`に書いた

### 起動の確認

| 時刻（Z） | 事実 |
|---|---|
| 11:04:39〜11:05:03 | `espflash read-flash`でflashの2か所を読んだ（partition tableと、appの先頭0x100 byte）。`--after no-reset`で、2回とも`Staying in bootloader`。firmwareは実行していない。partitionは`nvs`・`phy_init`・`factory`の3つ（appは`factory`の1つ） |
| 11:45:25 | ユーザーがESP32のUSBを挿し直した（firmwareの最初の起動。ESP32側の信号線の端は外れた状態）。この時刻から点灯の上限30分 |
| 〜11:47 | ユーザーの報告：LCDが点いた、異常なし |
| 11:45:55 | Piに停止の命令（`deskcatd`は`inactive`、`throttled=0x0`） |
| 11:47:28 | ユーザーの報告：Piの電源を入れ直した、LEDは点滅している |
| 11:49:21 | sshが届いた。uptime 2分。`deskcatd`はPiの起動で自動で始まっていて、ESP32とつながらず`HelloRetryExhausted`（終了コード75）で終わり、systemdが再起動していた。1回の実行は約2秒、`RestartSec`の3秒を足して約5〜12秒の周期 |
| 11:51:27 | journal：`Start request repeated too quickly`（`NRestarts=30`）。11:51:40の確認で`failed` |
| 〜11:52:56 | ユーザーがESP32側の端を2本挿した（時刻の報告は無い）。挿す前の目視：13と14に合っている。ユーザーの申告：熱・異音・焦げ臭さ・LCDの乱れ・電圧降下は無かった |
| 11:52:56 | `systemctl reset-failed deskcatd`と`systemctl restart deskcatd`。11:53:11に`active`（`NRestarts=0`）。`hello(Startup)`を送り、ESP32のACKに「応答送信側のsessionが未承認のため受理しない」というWARNが1件（`EXP-021`・`EXP-023`と同じ形）。11:54:21まで再起動0回、`throttled=0x0` |
| 〜11:54 | ユーザーの報告：ADXL345を叩いたら、LCDの表情が変わった |
| 11:54:39 | `systemctl stop deskcatd`（`inactive`、`enabled`のまま）。ログは`Deactivated successfully` |
| 〜11:55 | ユーザーがESP32側の端を2本抜き、その後でESP32のUSBを抜いた（時刻の報告は無い。記録したのは11:55:28） |

終わりの状態：ESP32は電源なしで、ESP32側の端は外れている（ユーザーの申告）。Piは電源が入っていて（112001）、`deskcatd`は`enabled`・`inactive`。Pi header側の端とGND線は触っていない。点灯の合計は約10分（上限30分の内）。数えた起動：ESP32のfirmwareの起動1回（11:45:25）、Piの電源の入れ直し1回。Piは、11:45:55の停止の前、uptime 22時間47分で連続して電源が入っていた。

### Faults

- 承認の問いに書いた「約150秒で`failed`」は、実測と合わなかった。`failed`は、Piの起動（約11:47:25）から約4分後（11:51:27）で、`NRestarts=30`に達した時点である。1回の再起動の周期は約5〜12秒で、幅がある。この間のjournalの時刻は、一部が飛んでいる（`timedatectl`は`System clock synchronized: yes`。同じjournalに、`systemd-timesyncd`の`Initial clock synchronization`がJST 20:49:26に記録されている。時刻の飛びとの関係は確かめていない）。そのため、周期と時間の対応は読みきれない
- 同じ日の11:39ごろ、この端末からPiの名前が一度引けなくなり、数秒後に戻った。原因は切り分けていない
- 叩いた回数、どの表情に変わったか、`set_expression`の送出のlogは無い（`deskcatd`はinfo水準で送出をlogしない）。ESP32側のlogは読んでいない（monitorを開いていない）
- 条件1（各信号線への直列4.7 kΩ）、条件5（別給電・GND共通）は、ユーザーの申告だけで、測定も目視もしていない。条件6のGND線の導通確認の測定値は、この回は取っていない
- 条件3（firmwareとhostがこのUARTに対応している）の根拠は、descriptorの先頭0x100 byteの一致までで、imageの残りは読んでいない
- 「ユーザーの報告」の時刻は、報告を受けて記録した時刻で、挿した時刻・抜いた時刻の報告は無い
- 起動の確認の間、Piの入力電圧は測っていない。`throttled=0x0`は、Pi Zero Wが低電圧を検出しないため、電圧について何も語らない（`EXP-009`）

### この記録が主張しないこと

- 電源経路の受け入れ。極性と電圧を実測していない
- PiとESP32を同時に入れたときに、`deskcatd`が自動でESP32とつながること。Piが上がった時点でESP32側の端は外れていて、端を挿した後は`reset-failed`と`restart`を手で実行した
- `deskcatd`の長時間の運転、updateの手順、`RestartSec`などの値が適切であること（どれも根拠は無い。選び直しの回数の上限は`PROTO-TBD-011`が未確定で、`RestartSec`と`--startup-deadline-ms`に対応するTBDの登録は無い）
- ESP32のimage全体の一致、`tapped`から表情までの時間

### Conclusion

Piの起動で`deskcatd`が自動で始まった。ESP32側の端を外した間は`HelloRetryExhausted`（終了コード75）で再起動を繰り返し、Piの起動から約4分で`failed`になった。端を挿した後、`reset-failed`と`restart`で`active`になった。`hello`へのESP32のACKは届いたが、`deskcatd`は「応答送信側のsessionが未承認のため受理しない」というWARNを出した（`EXP-021`・`EXP-023`と同じ形）。`active`は、sessionの確立を示さない。ユーザーの申告では、叩くとLCDの表情が変わった。電源の適否は、この記録では判断しない。

### Next safe step

- PiとESP32を同時に入れて、`deskcatd`が自動でESP32とつながるかの確認（人間の監視と、新しい承認が要る）
- `retries`の観察、updateの手順、`failed`になった後の自動の復帰が要るかは、運用を見てから決める（ユーザーの判断）
- ESP32側のlogと、`set_expression`の送出の記録の取り方

## EXP-025: 追加LEDの点灯試験（赤だけ・白だけ・両方）

[#514](https://github.com/wachi-yoshitaka-11-dev/deskcat/issues/514)の追加LED（白＝GPIO2、赤＝GPIO5）を、赤だけ→白だけ→両方の順に点灯させた。ESP32単体で、Pi linkの信号線は接続しない。**[回路案](led-514-demo.md)の`段階的な確認`の2と3のうち、点灯の観察だけを行った。**`R`両端の電圧の読み、`boot:` logのstrapping値と起動modeの確認、電源railの電圧・LED電流・発熱の計測、白の枝をつないだ状態での書き込みは行っていない（ユーザーの指示で、抵抗の値の実測も行わない）。この記録は、各comment（出所）にある事実だけを書く。

| 項目 | 内容 |
|---|---|
| Test ID | `EXP-025` |
| Date | 2026-10-12（JST） |
| Operator | 配線、USBの抜き差し、目視はユーザー。書き込み、reset、ログの取得は#514のセッション（AI） |
| Hardware revision／Exact components | `MCU-01`（ESP32-DevKitC V4）、`LED-COMM-01`（白）、`LED-REACT-01`（赤）、`RES-LED-01`（330 Ω×2。袋の表示はFAITHFUL LINKの`CF25J330RB`。[#538 comment 6124184737](https://github.com/wachi-yoshitaka-11-dev/deskcat/issues/538#issuecomment-6124184737)）、`RES-PULL-01`（10 kΩ×2）、ブレッドボード、ジャンパー線 |
| Wiring revision | 各枝は GPIO → 330 Ω → LEDのアノード → カソード → GND、GPIOとカソード側のGNDの間に10 kΩ。白はGPIO2、赤はGPIO5。GNDはESP32のGNDにつながる`-`レール経由（ユーザーの申告）。LEDの極性は、脚の長さと樹脂のふちの平らな面が反対側であることで確かめた（ユーザーの申告）。`3V3`には何もつないでいない。Pi linkの信号線はESP32側の端を外し、ブレッドボードの導体に触れないことをユーザーが目視で確かめた（[#514 comment 6125689974](https://github.com/wachi-yoshitaka-11-dev/deskcat/issues/514#issuecomment-6125689974)）。2回目の試験ではGPIO5の線を外した（[comment 6125489454](https://github.com/wachi-yoshitaka-11-dev/deskcat/issues/514#issuecomment-6125489454)） |
| Power supply and current limit | ESP32はPCのUSBのみ。電流制限は各枝の330 Ω（短絡側の最悪約11.5 mAは[回路案](led-514-demo.md)の計算値） |
| Firmware commit/profile | developの`63c2e7d`に`bringup-led-514`を足したbuild（artifactのsha256は先頭16桁`f0e1f61f8d86d7f9`）。`espflash` 4.5.0。実機Linuxの端末（`systemd-detect-virt`＝`none`）（[#514 comment 6125689974](https://github.com/wachi-yoshitaka-11-dev/deskcat/issues/514#issuecomment-6125689974)、[comment 6125063215](https://github.com/wachi-yoshitaka-11-dev/deskcat/issues/514#issuecomment-6125063215)） |
| Configuration | 承認は[#514 comment 6124265343](https://github.com/wachi-yoshitaka-11-dev/deskcat/issues/514#issuecomment-6124265343)（LEDの2枝を足して通電すること）と[comment 6125689974](https://github.com/wachi-yoshitaka-11-dev/deskcat/issues/514#issuecomment-6125689974)（書き込みと各回の通電の版・回数・停止条件）にある。抵抗の値をテスターで測らない判断は[#538 comment 6124219128](https://github.com/wachi-yoshitaka-11-dev/deskcat/issues/538#issuecomment-6124219128) |
| Measurement equipment | 使っていない。ログ（UART0）とユーザーの目視 |
| Procedure | 1回目（赤だけ）：書き込み、書き込み直後のresetからの起動を観察。2回目（白だけ）と3回目（両方）：書き込みはせず、USBを挿し、`espflash reset`をかけてログを取った |
| Expected result | `led phase`が`lamp_red`→`lamp_white`→`lamp_both`→`link_unconfirmed`の順に進むこと（[回路案](led-514-demo.md)の`点灯試験用のfirmware`） |
| Measured result | 下記 |
| Faults | 下記 |
| Conclusion | 下記 |
| Next safe step | 下記 |

### 結果

- ログの`led phase`は、3回とも`lamp_red`（uptime 78 ms、赤 on）、`lamp_white`（約10.1 s、白 on・赤 off）、`lamp_both`（約20.1 s、両方 on）、`link_unconfirmed`（約30.1 s、白の点滅へ・赤 off）の順だった。`led_init_error`と`led_write_error`は出ていない（[comment 6125063215](https://github.com/wachi-yoshitaka-11-dev/deskcat/issues/514#issuecomment-6125063215)、[6125489454](https://github.com/wachi-yoshitaka-11-dev/deskcat/issues/514#issuecomment-6125489454)、[6125555742](https://github.com/wachi-yoshitaka-11-dev/deskcat/issues/514#issuecomment-6125555742)）。
- ユーザーの目視の申告：赤だけの構成では、赤が約10秒点灯→消灯→約10秒点灯→消灯の順だった。白だけの構成では、白が約10秒から点灯し、はっきり見え、約30秒から1秒周期で点滅した。両方の構成では、0〜10秒が赤、10〜20秒が白、20〜30秒が両方、30秒以降が白の点滅だった（同じ3つのcomment）。
- 起動時の一瞬の点灯（目視の申告）：白だけの構成では、USBを挿した瞬間とresetの瞬間のどちらでも、白は光らなかった。両方の構成では、resetの瞬間に白は光らなかった。赤は、このfirmwareでは起動の直後から点灯するため、起動の瞬間の一瞬の点灯は判別できない。旧firmwareでUSBを挿した起動で、赤は光らなかった（同じ3つのcomment）。
- 熱・異音・異臭は、ユーザーの申告では無かった（同じ3つのcomment）。
- 赤の試験の書き込み後のログに、`boot_tx`の再試行と`boot_terminated reason=RecoveryBudgetExhausted`が出た。Piにつないでいない構成である（[comment 6125689974](https://github.com/wachi-yoshitaka-11-dev/deskcat/issues/514#issuecomment-6125689974)）。

### Faults

- 白の試験の1回目のログ取得は、`espflash monitor`がログを出さずに終わった。`espflash reset`の後に`cat`でUART0を読む方法へ替えて取り直した（[comment 6125689974](https://github.com/wachi-yoshitaka-11-dev/deskcat/issues/514#issuecomment-6125689974)）。
- `-`レールがESP32のGNDピンにつながっていることは、ユーザーの申告に頼った。導通は測っていない（[comment 6125489454](https://github.com/wachi-yoshitaka-11-dev/deskcat/issues/514#issuecomment-6125489454)）。

### この記録が主張しないこと

- GPIO2／GPIO5の起動時の電位。TRM v5.8は`GPIO_OUT_REG`のresetの値を規定していない（[#514 comment 6124124400](https://github.com/wachi-yoshitaka-11-dev/deskcat/issues/514#issuecomment-6124124400)）。目視の申告は、ROMの挙動と電位の実測を代替しない
- `段階的な確認`の2と3のうち、`R`両端の電圧の読み、`boot:` logのstrapping値と起動modeの確認、白の枝をつないだ状態での書き込み。行っていない
- LEDの電流、`3V3` railの電圧、`U2`の温度。計測していない
- Piとの通信中の動作。継続通信の判定と、`set_expression`から赤LEDへの経路は未実装である
- 長時間の運転
- 330 Ωの抵抗値。袋の表示だけで確かめ、テスターでは測っていない（ユーザーの判断。[#538 comment 6124219128](https://github.com/wachi-yoshitaka-11-dev/deskcat/issues/538#issuecomment-6124219128)）

### Conclusion

赤だけ・白だけ・両方の構成で、ログの`led phase`の順と、ユーザーが申告した点灯の順は同じだった。

### Next safe step

- 継続通信の判定と`set_expression`から赤LEDへの経路の実装の後に、`段階的な確認`の4を、人間の監視のもとで行う
- 起動時の電位を実測で確かめる手段を決める

## EXP-026: Piの独り言（show_text）をLCDへ出し、受理と拒否のACKと表情の戻りを確かめた

[#23](https://github.com/wachi-yoshitaka-11-dev/deskcat/issues/23)の実機確認。Piの`deskcatd`が送る独り言（`show_text`）を、ESP32がLCDへ描き、ACKを返し、表示期限の後に表情へ戻ることを観察した。記録の出所は[#23のcomment 6145205989](https://github.com/wachi-yoshitaka-11-dev/deskcat/issues/23#issuecomment-6145205989)（結果）である。承認は[comment 6145032343](https://github.com/wachi-yoshitaka-11-dev/deskcat/issues/23#issuecomment-6145032343)、通電前の配線の事実は[comment 6145008461](https://github.com/wachi-yoshitaka-11-dev/deskcat/issues/23#issuecomment-6145008461)に、問いと回答の文面を保存した。時刻はUTCである。

| 項目 | 内容 |
|---|---|
| Test ID | `EXP-026` |
| Date | 2026-10-13（UTC 12:00〜12:08。JST 21:00〜21:08） |
| Operator | ESP32のUSBの抜き挿し（BOOTを押したままの挿し込みを含む）、信号線のESP32側の端の抜き挿し、LCDと熱・異臭の目視はユーザー。flashの読み出しと書き込み、ESP32のログの取得、sshでの`deskcatd`の起動と停止は作業セッション（AI） |
| Hardware revision／Exact components | `SBC-01`（Raspberry Pi Zero W）、`MCU-01`（ESP32-DevKitC V4）、`DISP-01`、`ACCEL-01`、`ENV-01`。Piのadapterは`PSU-PI-A-02`（112001） |
| Wiring revision | 信号線2本とGND線は、`EXP-024`のまま。ユーザーの申告：`EXP-024`の後に、GNDの線の両端と、UARTの線のPi側の端を動かしていない（[comment 6145008461](https://github.com/wachi-yoshitaka-11-dev/deskcat/issues/23#issuecomment-6145008461)）。導通は測っていない。[#514](https://github.com/wachi-yoshitaka-11-dev/deskcat/issues/514)のLEDの線（GPIO2・GPIO5）は、通電の前にESP32のpinから抜いた（同comment。LED・抵抗・GNDのレールはブレッドボードに残っている）。servoはつないでいない |
| Power supply and current limit | Piは`PSU-PI-A-02`（極性と出力電圧は実測していない。[#446のcomment 6105175775](https://github.com/wachi-yoshitaka-11-dev/deskcat/issues/446#issuecomment-6105175775)）。Piは試験の前から電源が入ったまま。ESP32はこの端末のUSBから給電。電流制限は設けていない |
| Firmware commit/profile | ESP32：develop `a77177c`の`tap-21,face-21,bringup-display-13`（debug。**製品buildではない**）。ELFのsha256は`34d9959b36aca4560f07b23dbec8c7d97a4dc418c5e1505160822f9a7adab1dc`で、書き込みの前に照合した。書き込みの前のflashは、ROMのdownload modeで読んだapp descriptorの`app_elf_sha256`の先頭16桁が`f0e1f61f8d86d7f9`で、`EXP-025`のbuildと一致した（前のfirmwareは走らせていない）。Pi：`deskcatd`は`EXP-024`と同じbuild |
| Configuration | `deskcatd`はsystemdのunitを使わず、loginユーザーで手で起動した。引数はunitと同じ値に、1回目は`--speech-min-interval-ms 20000 --speech-duration-ms 5000 --verbose`、2回目は`--speech-min-interval-ms 20000 --speech-duration-ms 30001 --verbose`を足した。unitは変えていない |
| Measurement equipment | 使っていない。ESP32のログ（UART0）、`deskcatd`のログ、ユーザーの目視 |
| Procedure | BOOTを押したままUSBを挿し、flashの先頭を読む → 書き込み（書き込みの後の起動1回。monitorはresetせずに付けた）→ 表情が出た後に、信号線のESP32側の端を挿す → `deskcatd`の1回目 → 止めて2回目 → 信号線のESP32側の端を抜き、その後でUSBを抜く |
| Expected result | 1回目：`show_text`が受理され、表示期限の後に表情へ戻る。2回目：表示時間がfirmwareの上限（`crates/deskcat-face`の`MAX_TEXT_DURATION_MS`）を超えるため、`out_of_range`で拒否される |
| Measured result | 下記 |
| Faults | 下記 |
| Conclusion | 下記 |
| Next safe step | 下記 |

### 結果

- 書き込みの後の起動は1回（12:01:46）。bring-upの後に表情（`Neutral`）が描かれた。信号線をつなぐ前に`boot_terminated reason=RecoveryBudgetExhausted`が出た（`EXP-021`と同じ形）
- 1回目（12:05:44〜12:07:09）：`hello`でsessionが確立し、`show_text`を5件受理した（約20秒ごと）。各件で、受理から5.00秒後に`text_expired_restore_face`が出て、表情が描き直された。Piの`deskcatd`は受理のACKを5件受けた。ユーザーの申告：日本語の文が出る、読める、顔に戻る
- 1回目の間に、`tapped`の送出と、`set_expression`（`Surprised`、続いて`Neutral`）の受理が1回ずつあった
- 2回目（12:07:09〜12:07:23）：ESP32は`text_rejected category=Duration code=OutOfRange`を出し、`out_of_range`の拒否ACKを返した。Piの`deskcatd`は固定的な拒否として独り言を止めた
- ESP32のログに`panic`は無い。healthの行の`pi_uart_rx_buffer_full`と`pi_uart_rx_fifo_overflow`は0のまま。Piの`throttled`は各回の起動の前と止めた後で`0x0`（Pi Zero Wでは電圧の根拠にならない。`EXP-009`）
- ユーザーの申告：最初の2分に、発熱・異臭・LCDの乱れは無かった。信号線のESP32側の端を先に抜き、その後でUSBを抜いた

### Faults

- 条件6のGNDの線の導通は、この回は測っていない（ユーザーの申告：`EXP-024`の後に、GNDの線の両端とUARTの線のPi側の端を動かしていない）。条件1（各信号線への直列4.7 kΩ）とESP32側の挿し先は、ユーザーの目視の申告だけで、測定はしていない。条件5（別給電・GND共通）のうちGND共通は、同じ申告だけである

### この記録が主張しないこと

- 製品build（featureなし）での動作。`firmware/esp32/README.md`の`build構成と通電`の表は、製品buildの通電を「不可」としている
- `PROTO-TBD-007`の実LCDでの描画時間とRAMの最大使用量。firmwareに計測のログが無いため測っていない
- bring-upの間の`busy`、`stale_session`、`hardware_unavailable`の拒否
- 文字の見え方の細部（どの文が出たか、字形の崩れの有無）。記録しているのは、ユーザーの申告（表示が出ていて読める）だけである
- 電流、`3V3` railの電圧、温度。長時間の運転
- ESP32のログとPiのログの時刻の対応。2つの時計の差は測っていない

### Conclusion

1回目は、受理のACKと表示期限の後の表情の戻りが、ESP32とPiのログで5件ずつ対応した。2回目は、`out_of_range`の拒否が両方のログに出た。

### Next safe step

- 製品buildの通電の手順を決めた後に、同じ確認を製品buildで行う
- 描画時間とRAMの最大使用量を測るには、計測のログを足すfirmwareの変更が要る
- 終わりの状態：ESP32は電源なし、信号線のESP32側の端は外れている。GPIO2・GPIO5の線はESP32から抜いたまま（#514を再開するときに、`power-budget.md`の`DISP-01`追加接続の手順の条件(3)(a)と、#514の承認の範囲を照らす）。Piは電源が入っていて、`deskcatd`は`enabled`・`inactive`

## EXP-027: Pi Zero Wでdeskcatdを直接buildし、HTTPS接続とsystemd credentialと偽ESP32での常駐を観察した

[#522](https://github.com/wachi-yoshitaka-11-dev/deskcat/issues/522)の[ADR-0026](../decisions/0026-cloud-speech-generation.md)の決定2・3・5・7が、クラウド経路を有効にする前に確かめるよう求める項目のうち、Piの上の作業を観察した。**この記録は観察だけを書く。ADRの確認項目を満たしたとは書かない。**`--cloud-speech`は有効にしていない。本物のAPIキーはPiに置いていない。ダミー値（キーではない文字列）の値は、記録に書かない。

| 項目 | 内容 |
|---|---|
| Test ID | `EXP-027` |
| Date | 2026-10-15（JST 00:56〜01:21。最初のbuildと中断）と、2026-10-16（JST 22:11〜23:28。Piの起動から(4)の終了まで。その後の読み出しを除く。build、HTTPS、systemd、常駐）と、2026-10-17（JST 02:39〜02:41。(3)(g)）。時刻は下の各節にUTCで書く（UTC＝JST−9時間） |
| Operator | Piの電源の抜き差しはユーザー。ssh、apt、build、systemctl、journalの読み出し、偽ESP32の実行は作業セッション（AI） |
| Hardware revision／Exact components | `SBC-01`（Raspberry Pi Zero W。`armv6l`、Raspbian GNU/Linux 13〔trixie〕、systemd 257.9-1~deb13u1+rpi1、メモリ426 MiB、swap約425〜426 MiB）。ESP32は使っていない |
| Wiring revision | ESP32側の信号線の端は、外した状態を保つという指示の前提で作業した（Piからは確認できない）。Pi側は動かしていない |
| Power supply and current limit | Piの給電は`EXP-024`以降、確かめていない。`vcgencmd get_throttled`は観察した各時点で`0x0`（Pi Zero Wでは電圧の根拠にならない。`EXP-009`）。電流制限は設けていない |
| Firmware commit/profile | ESP32は無し。Pi：下記のcommitのsourceを直接build（debug）。`rustc 1.97.1 (8bab26f4f 2026-07-14)`、`cargo 1.97.1` |
| Configuration | `ureq =3.4.1`（`json`・`native-tls`）、`ureq-proto 0.6.4`、`native-tls 0.2.18`、`openssl 0.10.81`、`openssl-sys 0.9.117`（`Cargo.lock`）。OSの`openssl`3.5.6-1~deb13u2+rpt1、`ca-certificates`20250419、`pkg-config`1.8.1-4は導入済み。`libssl-dev`は、下の(1)で導入した |
| Measurement equipment | 使っていない。Pi上の`time`、`/proc`、`journalctl`、`systemctl`、`systemd-analyze`、`openssl s_client`、samplingのscript（(1)は`sleep 5`を挟むloop、(4)は5秒ごと） |
| Procedure | 下の(1)〜(4) |
| Expected result | ADR-0026の決定2・3・5・7が確認を求める内容（Piでのbuild、HTTPS接続、systemd credentialの動作、常駐時のmemoryと時間） |
| Measured result | 下記 |
| Faults | 下記 |
| Conclusion | 下記 |
| Next safe step | 下記 |

### (1) 直接build

**commit。**build（1回目・中断）は`2105702dd9079ac6b145d685fabe1ffb8c425cbf`の`apps/`・`crates/`・`Cargo.toml`・`Cargo.lock`、build（3回目）はdevelop `66214235e1becb4e596a5fa5152e78891877afac`の同じ範囲（88 file。`git archive`をsshでPiへ流した）。コマンドは`cargo build --locked -p deskcatd`（debug）。

| 回 | 時刻（UTC） | 結果 |
|---|---|---|
| 1回目（`libssl-dev`無し、`2105702`） | 2026-10-14T15:56:45Z開始 | exit 101、`real 8m16.090s`。`openssl-sys 0.9.117`が`Package openssl was not found in the pkg-config search path`、`Could not find directory of OpenSSL installation`、`Make sure you also have the development packages of openssl installed. For example, libssl-dev on Ubuntu`と表示して停止 |
| 導入 | 2026-10-14（UTC。1回目の後、2回目の前） | `sudo apt-get install -y libssl-dev`：`libssl-dev:armhf 3.5.6-1~deb13u2+rpt1`。取得3,655 kB。`/`の使用量は3,570,632 kBから3,586,108 kBへ増えた（15,476 kB）。**Piのpackageの状態を変えた** |
| 2回目（`libssl-dev`有り、`2105702`） | 2026-10-14T16:06Zごろ開始 | 完走していない。`Compiling http v1.5.0`の表示まで進んだ約15分の時点（最後のsampling 16:21:00Z）で、Piへのsshが切れた。ユーザーの申告：停止は電源を抜いたため。journalに、停止の直前までshutdown・OOM・低電圧・mmcエラーの行は無い（下の「Wi-Fiの切断」） |
| 3回目（`libssl-dev`有り、develop `6621423`、clean） | 2026-10-16T13:17:01Z〜13:56:07Z | exit 0。`Finished dev profile [unoptimized + debuginfo] target(s) in 39m 03s`。`real 39m5.401s`、`user 31m21.649s`、`sys 0m59.155s` |

3回目の観察（`sleep 5`を挟むloopで441 sample。13:17:01Z〜13:56:07Zの約2346秒に対し、実効の間隔は約5.3秒）：

- `MemAvailable`の最小203,152 kB（開始時は335,156 kB）。`SwapFree`の最小344,356 kB（開始時436,220 kB）。OOM・低電圧・I/Oエラーの行は、この起動のカーネルlogに0件（`journalctl -k`）
- 指定したcommand名（`rustc|cc1|cargo|ld|build-script|collect2`。`ld`は部分一致で、`systemd-journald`など他のprocessも含みうる）のprocessのRSSの最大は291,388 kB。**これは「build中の単一processの最大」とは言えない**（下のFaults）
- `/`：使用3,673,960 kB（build前）→3,942,468 kB（後）、空き25,002,292 kB。`target/`は272,760 kB。debugの`deskcatd`は23,322,164 byte
- 比較の事実：[EXP-024](#exp-024-deskcatdの常駐systemdをpiへ導入し電源投入での起動とfailedからの戻しを確かめた)の最初のbuild（`f0925027`のsource。この記録のcommitとは依存が違う）は、`Finished … in 19m 32s`、peak RSS 248,644 kB（5秒ごとのsamplingの最大）だった。**時間の差の原因は切り分けていない**
- この間、Wi-Fiの切断が318回あった（下の「Wi-Fiの切断」）

### (2) Anthropicのendpointへの、キーなしのHTTPS接続

2026-10-16T13:56:57Z〜13:57:50Z。`NTPSynchronized=yes`。`apps/deskcatd/examples/tls_probe.rs`（Piの作業copyにだけ置いた。repositoryへは入れていない）で、`cloud_speech.rs`の`ClaudeClient`と同じTLS設定（`TlsProvider::NativeTls`、`RootCerts::PlatformVerifier`、`https_only`、proxyなし、`max_redirects(0)`、`timeout_global` 5秒）に`http_status_as_error(false)`を足し、**キー・`x-api-key`header・POSTを使わずに**`GET`を送った。example buildは42.34秒。

| 宛先 | 観察 |
|---|---|
| `https://api.anthropic.com/v1/messages`（3回） | `status=405`、1240／1020／1113 ms |
| `https://expired.badssl.com/` | `NativeTls(Ssl(… reason: "certificate verify failed" …))` |
| `https://self-signed.badssl.com/` | 同上 |
| `https://wrong.host.badssl.com/` | 同上 |
| `http://api.anthropic.com/v1/messages` | `RequireHttpsOnly`、0 ms |

参考：`openssl s_client -connect api.anthropic.com:443 -verify_return_error`は`Verification: OK`、`TLSv1.3`、`TLS_AES_256_GCM_SHA384`。この53秒の窓に、Wi-Fiの切断が3回あった。

### (3) systemdのcredential

unitは、develop `6621423`の`deploy/systemd/deskcatd.service`（sha256 `395be6ad34474bc3614109a7050f0b0d249cb9f2f47c1cfeb973a7e8f0c7294a`。最後に変えたcommitは`546bb6d`）。deskcatdそのものは起動していない。unitの複製（`/run/systemd/system/`に一時的に置き、試験の後に削除）は、`[Unit]`・`User=`・`LoadCredential=`・`SetCredential=`・`StateDirectory=`などを変えず、`ExecStart=`だけを短いscript（credentialのbyte数と`id`を表示する）へ、`EnvironmentFile=`と`Restart*`を外して差し替えた。

| 試験 | 観察 |
|---|---|
| (a) `systemd-analyze verify`（上のunit） | `deskcatd.service:23: Invalid syntax, ignoring: anthropic-api-key:`（23行目は`SetCredential=anthropic-api-key:`） |
| (b) 複製、`/etc/deskcatd/anthropic-api-key`が無い | `Failed to set up credentials: Protocol error`、`Failed at step CREDENTIALS`、`status=243/CREDENTIALS`。起動しない |
| (c) 複製から`SetCredential=`の行を外した版、fileが無い | (b)と同じ`status=243/CREDENTIALS` |
| (d) 最小再現：`sudo systemd-run --wait --collect --pipe -p LoadCredential=anthropic-api-key:/etc/deskcatd/anthropic-api-key /bin/true`、fileが無い | `status=243/CREDENTIALS`、`systemd-run`のexit 243。同じ指定に`-p SetCredential=anthropic-api-key:`（空の値）を足すとexit 0（CLI経由。0 byteのcredentialができた） |
| (e) 複製の`SetCredential=`を、空でない値（キーではない11文字。値は書かない）に変えた版、fileが無い | 起動し、`$CREDENTIALS_DIRECTORY/anthropic-api-key`を11 byte読めた（uid 999） |
| (f) ダミー値（キーではない22文字）のfileを、root所有・mode `0600`で`/etc/deskcatd/anthropic-api-key`に置く、unitの複製（credentialの行は元のまま） | 起動した。uid 999（`deskcatd`）が22 byte読めた。`/var/lib/deskcatd`は`drwx------ deskcatd deskcatd`で作られた |
| (g1) develop `3a73475`（#603）の`deploy/systemd/deskcatd.service`（sha256 `d1e81a0fb2df1a8e2f1be7fd66913d0384d70f3660d89d51faa851dc24359c60`。`SetCredential=anthropic-api-key:deskcatd-no-api-key`）に`systemd-analyze verify` | 出力なし |
| (g2) (g1)のunitの複製（上と同じ差し替え）、`/etc/deskcatd/anthropic-api-key`が無い | 起動した（uid 999）。credentialは19 byteで、内容は`SetCredential=`の値`deskcatd-no-api-key`と一致した（`cmp`） |
| (g3) (g1)のunitの複製、ダミー値（キーではない23文字。値は書かない）のfileをroot所有・mode `0600`で置く | 起動した（uid 999）。credentialは23 byteで、内容は`deskcatd-no-api-key`と一致しなかった |

(f)のとき、別の保持用の一時unit（同じ`User=`・`LoadCredential=`）で読める範囲を見た（値は表示せず、byte数と拒否の表示だけ）：

- 一般user（`deskcat`）による元fileの読み出し：`Permission denied`
- `/run/credentials/<unit>/`は`dr-xr-x---+ root root`、中のfileは`-r--r-----+ root root`（`+`はACL。`getfacl`が無く、ACLの中身は見ていない）。一般userと`nobody`：`Permission denied`。同じ`deskcatd`の別process：22 byteを読めた
- unit停止の後、`/run/credentials/<unit>`は無くなった
- 値の文字列は、起動中processの`/proc/<pid>/environ`と`cmdline`、`systemctl show`の出力に無かった（一致0件。`LoadCredential=`は`[unprintable]`と表示された）

(g)は2026-10-16T17:39Z〜17:41Zに行った（Pi上のfileの時刻は2026-10-17 02:39〜02:40 JST）。(g2)・(g3)のとき、(f)と同じ形の保持用の一時unit（`ExecStart=/bin/sleep 25`）で、読める範囲を見た：

- (g2)：`SetCredential=`と`LoadCredential=`は`systemctl show`で`[unprintable]`。`deskcatd-no-api-key`の文字列は、`/proc/<pid>/environ`・`cmdline`・`systemctl show`の出力に0件。`/run/credentials/<unit>/`は`dr-xr-x---+ root root`、中のfileは`-r--r-----+ root root`（19 byte）。一般user（`deskcat`）と`nobody`：`Permission denied`。`deskcatd`のuid：19 byteを読めた。unit停止の後、置き場は無くなった
- (g3)：元fileを一般userが読む：`Permission denied`。service用のcopyを一般userと`nobody`が読む：`Permission denied`。`deskcatd`のuid：23 byteを読めた。ダミー値の文字列は、`/proc/<pid>/environ`・`cmdline`・`systemctl show`の出力に0件
- **rootによる値の読み出しは試していない。**複製のunitだけを使い、`/etc/systemd/system/deskcatd.service`（sha256 `032541225e9ec62d02391dab6bea9b0ea5bb544b85aef4bc1fc4c3a3873ca8de`）は変えていない。ダミー値のfileと一時unitは、確認の後に削除した

**未確認：**空の値の行がunit fileで無視される理由（systemdの仕様か、この版の挙動か）。空の値の行を外しても(b)と同じ結果だった(c)ことと、空でない値の行が働いた(e)ことは観察した。**この作業では、unitを直す方法を試していない。**直しは#603（develop `3a73475`）で行われ、(g)はその版のunitの複製の観察である。実際の`deskcatd`を、このunitの複製（`ExecStart=`を差し替えたもの）で起動したことは無い。

### (4) 偽のESP32（PTY、Python）を相手にした`deskcatd`の常駐のmemoryと時間

**この節の観察は、「偽のESP32（PTY、Python）を相手にした`deskcatd`の常駐のmemoryと時間」である。実ESP32との常駐、`--cloud-speech`有効時の常駐memory、HTTPS client実行中のピークは未確認である。ADR-0026の決定2の「常駐時のmemory・時間」は、この範囲では満たしていない。**

- 偽のESP32：`fake_esp.py`（67行、sha256 `5bdc39ecbd8c50a859989c32850096c3fa4301974d2e2ce11b3954f86b28c688`。この作業の観察の道具で、repositoryへ入れていない）。PTYのmasterを持ち、`deskcatd`の実binaryをPTYのslaveにつなぐ。`hello`（`esp32-pi-protocol.md`§5.1）へ`boot`（§4.1）と`ack`（§6）を返し、`get_status`（§5.6）へ`ack`と`status`（§4.6）を返し、それ以外のPi→ESP32のmessageへ`status: ok`の`ack`を返す。**protocolへの適合の確認ではない**（envelopeの検証、再送、拒否、`reply_sid`の整合などは試していない）。実UARTと実ESP32には触れていない
- 実行：2026-10-16T13:58:08Z〜14:28:11Z。`deskcatd`（sha256 `ebfd1c9dea69e79d52639d87ab12aef59e19681e114df46307a69c5f683bb51f`、`6621423`のdebug build）を、`--speech-min-interval-ms 60000 --speech-duration-ms 5000`で起動した（`--cloud-speech`と`--verbose`は付けていない）。`--duplicate-capacity 8 --duplicate-retention-ms 5000`はunitと同じ値。`--startup-deadline-ms`はunitの`10000`ではなく`60000`を使った。loginユーザーで手で起動し、systemdのunitは使っていない
- 継続：1800秒。`deskcatd`は1800秒の間、終了せず、scriptが1800秒でSIGTERMを送った（script側の表示`exit=-15`は、`deskcatd`自身の終了コードではない）。`deskcatd`のlogは2行（`serial portを開く`と`hello(Startup)を送った`）で、WARN・ERRORは0件
- memory（5秒ごと、360 sample。t=0〜1795秒）：`VmRSS` 4,896〜4,900 kB（t=5秒から。t=0の1回は1,636 kB）、`VmHWM` 4,900 kB。RSSの値は3通り（1,636、4,896、4,900 kB）で、変化は2回
- 偽のESP32が受けたPi→ESP32のmessage：`hello` 1、`ack` 1、`get_status` 2、`show_text` 30（60秒ごと）
- この間、Wi-Fiの切断が257回あった。Piの負荷平均は終わりの時点で0.35（1分）、`throttled=0x0`

### Wi-Fiの切断（観察）

`journalctl`の`wpa_supplicant`の`CTRL-EVENT-DISCONNECTED`（`reason=0 locally_generated=1`）の件数。**network識別子（BSSID、SSID、IP、MAC）は書かない。**

| 起動 | 件数 |
|---|---|
| 2026-10-12の起動（-3）、2026-10-12〜13の起動（-2） | 0、0 |
| 2026-10-14〜15の起動（-1。0の起動の1つ前。起動は2026-10-14 22:56 JSTごろ〔1回目のbuildの前の2026-10-15 00:56:24 JSTの`uptime`が2時間だったことからの逆算〕。journalの最初の行の時刻は2026-10-15 00:00:59 JSTで、この逆算と合わない） | 706。終わりの前の12分間（01:09〜01:20 JST）は1分に6〜10回。切断の直後に再接続していた（journalの`CONNECTED`。1回目のbuildの8分間のssh sessionも切れなかった） |
| 2026-10-16の起動（0。22:11:34 JST起動） | 625（(4)の終了後の確認の時点）。(1)の39分間に318、(4)の30分間に257 |

-1の起動の終わり：journalの最後は2026-10-15 01:20:55 JST（＝2026-10-14T16:20:55Z）で、切断の直後の再接続（`CONNECTED`、DHCPの新規lease）で終わる。shutdownの記録、OOM、低電圧、mmcエラーの行は無い。journalは書き出しの遅れがありうるため、最後の数秒は失われうる。ユーザーの申告：停止は電源を抜いたため。**切断が続いた原因（電源、cable、省電力、AP側）は切り分けていない**（[#446](https://github.com/wachi-yoshitaka-11-dev/deskcat/issues/446)に同種の記録がある）。

### Piに入っているもの（この作業の前後）

- `/etc/systemd/system/deskcatd.service`のsha256は`032541225e9ec62d02391dab6bea9b0ea5bb544b85aef4bc1fc4c3a3873ca8de`のまま（`EXP-024`で導入した版。credentialの行は無い）。`/usr/local/bin/deskcatd`、`/etc/deskcatd/deskcatd.env`も2026-10-12のまま。**この作業ではPiの`deskcatd`のunitとbinaryを入れ替えていない**
- `libssl-dev`を導入した（上の(1)）。ダミー値のfileと一時unitは削除した（`/etc/deskcatd`は`deskcatd.env`だけ）。(3)の試験の複製unitの`StateDirectory=deskcatd`が、`/var/lib/deskcatd`（`drwx------ deskcatd deskcatd`）を作り、残っている。中身は見ていない（(4)の`deskcatd`は予算fileを作らない）。Piの作業dirとして、2回目までの`2105702`のdirと3回目のdirが残っている（約140 MBと約293 MB）
- (g)の後、2026-10-17 02:58 JSTの時点：`deskcatd`は`enabled`・`inactive`、`ExecMainStatus=75`、`NRestarts=0`。`/etc/systemd/system/deskcatd.service`のsha256は上と同じ。`/etc/deskcatd`は`deskcatd.env`だけ。`/run/systemd/system`に一時unitは無く、`failed`のunitは0件
- `deskcatd`は`enabled`のまま。起動の後、ESP32と通信できずに再起動を30回繰り返し、2026-10-16 22:15:46 JSTに`failed`（`Start request repeated too quickly`）になった。**その後、作業セッションが、対象を指定しない`systemctl reset-failed`を1回実行した**（(3)の試験の片付けのとき）。そのため、`failed`の印が消えて`inactive (dead)`、`enabled`、`ExecMainStatus=75`になっている。他のunitの`failed`の印も消えた可能性がある（この起動で他に`failed`のunitがあったかは見ていない）

### Faults

- (1)のRSSのsamplingは、command名の部分一致（`ld`を含む）で選んだprocessの最大であり、cargo・rustc・linkerの単一processの最大とは限らない。システム全体の`MemAvailable`と`SwapFree`は、processに依らない
- (1)の3回目の間（13:19〜13:30Zごろ）に、(3)の短い一時unitの試験とsshでの読み出しを同じPiで行った。build時間への影響は測っていない。Wi-Fiの切断も続いていた
- journalの時刻は、起動の直後は時計の同期の前の値が混ざりうる（-1の起動の最初の数分など。上の起動時刻の食い違いを含む）。-1の起動の件数は、終わりの12分間の1分あたりの値と、全体の合計だけを書いた
- 偽のESP32は、hello・get_status・ackだけを返す。`show_text`の描画、LCD、UARTの電気的な条件、実ESP32のtimingは含まない
- 2026-10-17 02:58 JSTの時点で、`journalctl --list-boots`は現在の起動（0）だけを示し、-1以前の起動は読めない（上の件数は、それ以前の読み出し）。`/etc/systemd/journald.conf.d/50-persistent-storage.conf`は`Storage=persistent`と`SystemMaxUse=32M`で、`/var/log/journal`は4 MiBのfileが約6分ごとに並び、合計は28.3 MiB。古いjournalが消えた理由は調べていない
- ESP32側の信号線が外れていたことは、Piからは確認していない
- `2105702`と`6621423`の`apps/deskcatd/`の差は`cloud_speech.rs`だけ（36行追加、3行削除）で、1回目・2回目は後者の前のsourceである。時刻帯を日本時間で決める版（`25f68fd`、#601）は3回目に含まれる

### この記録が主張しないこと

- ADR-0026の決定2・3・5・7の確認項目を満たしたこと。特に、`--cloud-speech`有効時の常駐memory・時間、HTTPS client実行中のピーク、キーを使うAPI要求、`$2`の月額上限とWorkspaceのscope（決定3・5。人間の作業）
- 実ESP32との常駐、ローカル独り言のLCD表示（別の確認。#16・#595）
- `rustls`構成、他のHTTPS clientとの比較。**`ureq`と`native-tls`を確定した、とも書かない**
- 時間の差（19分32秒と39分03秒）、Wi-Fiの切断の原因、(3)(a)の空の値の行が無視される理由
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
