wachi-yoshitaka-11-dev/deskcat/docs/toolchains/verified-commands.md

# 検証済みコマンド

> 状態: Active
> 適用範囲: build、lint、test、flash の実行コマンドと、その来歴

**この文書が検証済みコマンドの正本である。**以前は[AGENTS.md](../../AGENTS.md)が
コマンドと来歴の両方を持っていた。**`AGENTS.md`は毎sessionのcontextへ全文が入るため、
firmwareを触らないsessionもESP32のbuild手順を読み込んでいた**（[ADR-0018](../decisions/0018-instruction-file-structure.md)）。

**ここへ来歴を集約し、コマンドの実行時参照は`.claude/rules/`が持つ。**
`.claude/rules/`はpath限定で読み込まれ、この文書へリンクする。**コマンドを両方へ書かない。**

## 実行の順序

利用可能な範囲で次を実行する。

1. format
2. lint
3. unit test
4. host integration test
5. ESP32 build
6. 実機単体試験
7. 統合・回帰試験

**実機試験が必要な変更を、PCテストだけで完了扱いにしない。**

## host workspace

repository root で実行する。**ESP32 toolchain は要らない。**

```bash
cargo fmt --all -- --check
cargo clippy --workspace --all-targets --locked
cargo test --workspace --locked
```

**`-D warnings` は付けない。**lint の水準は root `Cargo.toml` の `[workspace.lints]` が持つ。
`unsafe_code = "forbid"` もそこで強制している。

Linux x86_64、Rust stable 1.97.1 で検証した。初回は 2026-08-10 で、これは VM 上の記録である
（[Version Record](version-records/2026-08-10-host-rust-linux.md)）。実機 Linux での検証は
2026-08-15 であり、上の block の command がすべて成功している
（[Version Record](version-records/2026-08-15-host-rust-native-linux.md)）。別端末での再現は
CI の `ubuntu-24.04` runner で満たした（#129。[Version Record](version-records/2026-08-15-host-rust-ci.md)）。
**CI が実行するのは host workspace だけであり、Raspberry Pi 上での build と実行は主張しない。**

## ESP32 firmware

ESP32 Build profile の端末で、`firmware/esp32` にて実行する。

```bash
. "$HOME/export-esp.sh"
cargo fmt --all -- --check
cargo clippy --all-targets --locked -- -D warnings
cargo build --locked
```

`--locked` は追跡している `Cargo.lock` からの逸脱を失敗として扱う。
**`cargo fmt` はこの option を受け付けない。**

Linux x86_64 で検証した。初回は 2026-08-06 で、これは VM 上の初回環境記録である
（[Version Record](version-records/2026-08-06-esp32-build-linux.md)）。実機 Linux での最初の検証は
2026-08-15 である（[Version Record](version-records/2026-08-15-esp32-build-native-linux.md)）。最新の検証は
2026-10-04 であり、Version Record の `Repository commit` の tree（#487 の PR B1 の後の構成。Pi link を含む既定構成）で、`deskcat-servo` を共有した状態で実機 Linux で取得した（[Version Record](version-records/2026-09-29-esp32-build-servo-limiter-native-linux.md)。
初回検証日は 2026-09-29、最終有効な検証日時は 2026-10-04）。
この検証記録は、現在の#487製品build統合前のtreeについてのものである。製品buildと試験構成の
CIでの成否は、この変更を含むPull Requestのcheck結果で確認する。
別端末での再現は CI の `ubuntu-24.04` runner で満たした
（#42。[Version Record](version-records/2026-08-10-esp32-build-ci.md)）。
**build-only であり、flash と実機起動は主張しない。**

**`pi-protocol-mode` featureは[#487](https://github.com/wachi-yoshitaka-11-dev/deskcat/issues/487)で廃止した。**Pi linkは既定構成（製品build）に入った。**上の「Linux x86_64 で検証した」以下の記録のうち、2026-08-15 までの記録は #487 の PR B1 より前の tree についてのものである。2026-09-29 の記録は、2026-10-04 に #487 の PR B1 の後の構成（Pi link を含む既定構成）で再検証した。**2026-09-29の記録のうち、既定構成の分は上の検証記録である。それ以外の構成の分は実施記録であり、検証済みcommandへは格上げしていない。#487のPR B1より前は、`pi-protocol-mode`を有効にした構成も`cargo clippy`と`cargo build`へ`--features pi-protocol-mode`を足して通していた。

**`bringup-i2c-15-16`は、旧・featureなしbuildのセンサー単体試験である。**製品buildの確認に加え、`cargo clippy`と`cargo build`へ`--features bringup-i2c-15-16`を付けたものも通す。`cargo fmt`にはfeatureを付けない。

**`bringup-display-13` feature（[#451](https://github.com/wachi-yoshitaka-11-dev/deskcat/issues/451)）を有効にする場合は、既定構成に加えて`cargo clippy`と`cargo build`（`cargo fmt`は対象外）へ`--features bringup-display-13`を足したものも通す。**#487の製品build統合後、このfeatureは単色fill・四隅patternの試験構成を選び、表情とtapは明示的にfeatureを加えたときだけ有効になる。**以前の実施記録（[Version Records](version-records/README.md)）では、2026-09-29の記録だけが2026-10-04に#487のPR B1後の構成（Pi linkを含む）で再検証された。今回の製品build統合差分は、firmware CIの`Build test modes`がこの構成のClippyとbuildを確認する。**command blockは上の検証済みコマンドにfeatureを付ける方式とし、ここへ重複して写さない。

**`no-touch-487` feature（[#487](https://github.com/wachi-yoshitaka-11-dev/deskcat/issues/487)）を有効にする場合は、既定構成に加えて`cargo clippy`と`cargo build`へ`--features no-touch-487`を足したものも通す。**`cargo fmt`にはfeatureを付けない。他のfeatureとは併用できない（`main.rs`の`compile_error!`）。firmware CIの`Build test modes`が確認する。

**`bringup-led-514` feature（[#514](https://github.com/wachi-yoshitaka-11-dev/deskcat/issues/514)）を有効にする場合は、既定構成に加えて`cargo clippy`と`cargo build`へ`--features bringup-led-514`を足したものも通す。**`bringup-display-13`とも組み合わせられるため、`--features bringup-display-13,bringup-led-514`も通す。**製品build（featureなし）も`crate::led`を持つ**（#514。白の点滅と、`happy`を受理したときの赤の点灯）ため、既定構成の`cargo clippy`と`cargo build`がこのcodeを確認する。firmware CIの`Format, lint, and build`は既定構成を、その中の`Build test modes`は`bringup-led-514`の両構成を確認する。いずれもbuild-onlyであり、host testは無い（firmware crateはhostで動かせない）。実機で動かした記録は点灯試験用のbuildだけである。

**`face-21` feature（[#21](https://github.com/wachi-yoshitaka-11-dev/deskcat/issues/21)）を有効にする場合は、既定構成に加えて`cargo clippy`と`cargo build`へ`--features face-21`を足したものも通す。**`bringup-display-13`とも組み合わせられるため、`--features face-21,bringup-display-13`も通す。今回の差分では、firmware CIの`Build test modes`が両構成を確認する。

**`tap-21` feature（[#21](https://github.com/wachi-yoshitaka-11-dev/deskcat/issues/21)のF1）を有効にする場合は、既定構成に加えて`cargo clippy`と`cargo build`へ`--features tap-21`を足したものも通す。**`face-21`・`bringup-display-13`とも組み合わせられるため、`--features tap-21,face-21,bringup-display-13`も通す。今回の差分では、firmware CIの`Build test modes`が両構成を確認する。

**`accel-sample-15` feature（[#15](https://github.com/wachi-yoshitaka-11-dev/deskcat/issues/15)）を有効にする場合は、既定構成に加えて`cargo clippy`と`cargo build`へ`--features accel-sample-15`を足したものも通す。**他の試験featureとは併用できず（`compile_error!`）、`cargo fmt`にはfeatureを付けない。firmware CIの`Build test modes`は、この構成も`cargo clippy`と`cargo build`で確認する。`crates/deskcat-accel`はhostの`cargo test --locked -p deskcat-accel`と`cargo clippy --locked -p deskcat-accel --all-targets`も通す。2026-10-17に実機LinuxでESP32 Build profileのclippy（`-D warnings --locked`。`accel-sample-15`、既定、`tap-21,face-21,bringup-display-13`）と`cargo build --locked --features accel-sample-15`を通した。**worktreeの下ではfirmwareのcargoが上位のworkspaceを拾うため、build時だけ`firmware/esp32/Cargo.toml`の末尾へ`[workspace]`を足し、終えたら戻した。**build-onlyであり、実機の通電の記録は`docs/hardware/experiment-log.md`の`EXP-033`である。

**`mem-probe-23` feature（[#23](https://github.com/wachi-yoshitaka-11-dev/deskcat/issues/23)）を有効にする場合は、既定構成に加えて`cargo clippy`と`cargo build`へ`--features mem-probe-23,face-21,tap-21`を足したものも通す。**製品buildと同じ構成（`face-21`と`tap-21`は製品経路のcfgを持つ。ただしタッチの撫での判定と`ENV-01`の周期測定・`environment`の送出は製品buildだけが持ち、この構成には入らない）に、空きheapと main taskのstackのlogを足す試験buildである。`bringup-display-13`とも組み合わせられ、`env-sample-16`・`accel-sample-15`・`touch-sample-14`・`touch-lcd-14`・`bringup-i2c-15-16`・`bringup-led-514`・`bench-servo-test-17`・`debug-motion-19`とは併用できない（`compile_error!`）。**このfeatureのbuildだけが`unsafe`を持つ。**`firmware/esp32/src/main.rs`の先頭の`cfg_attr`が`unsafe_code`の水準を持ち、featureなしのbuildは`forbid`のままである。firmware CIの`Build test modes`がこの構成を確認する。build-onlyであり、実機の通電の記録は無い。

**`touch-sample-14` feature（[#14](https://github.com/wachi-yoshitaka-11-dev/deskcat/issues/14)）を有効にする場合は、既定構成に加えて`cargo clippy`と`cargo build`へ`--features touch-sample-14`を足したものも通す。**他の試験featureとは併用できず（`compile_error!`）、`cargo fmt`にはfeatureを付けない。firmware CIの`Build test modes`は、この構成も`cargo clippy`と`cargo build`で確認する。`crates/deskcat-touch`はhostの`cargo test --locked -p deskcat-touch`と`cargo clippy --locked -p deskcat-touch --all-targets`も通す。2026-10-21に作業用のLinux VM（ESP32 Build profileの正式な検証端末ではない）で、既定・`touch-sample-14`・`tap-21,face-21,bringup-display-13`のclippy（`-D warnings`）とbuildを通した。**worktreeの下ではfirmwareのcargoが上位のworkspaceを拾うため、repository外へ複製し、複製側の`firmware/esp32/Cargo.toml`の末尾へ`[workspace]`を足してbuildした**（`firmware/esp32/Cargo.lock`は`--locked`なしの最初のbuildで更新し、書き戻した）。この確認はbuild-onlyである。`touch-sample-14`の実機の通電は、`EXP-038`（develop `79f29ea`のbuild、1回）と`EXP-041`（develop `b9a04e8`のbuild、1回）である。

**`touch-lcd-14` feature（[#14](https://github.com/wachi-yoshitaka-11-dev/deskcat/issues/14)）を有効にする場合は、既定構成に加えて`cargo clippy`と`cargo build`へ`--features touch-lcd-14`を足したものも通す。**LCDを初期化して表情を塗り続けながら、同じSPI hostでタッチを読む試験buildである。他の試験featureとは併用できず（`compile_error!`）、`cargo fmt`にはfeatureを付けない。firmware CIの`Build test modes`は、この構成も`cargo clippy`と`cargo build`で確認する。2026-10-22に作業用のLinux VM（ESP32 Build profileの正式な検証端末ではない）で、repository外へ複製し、複製側の`firmware/esp32/Cargo.toml`の末尾へ`[workspace]`を足して、既定・`touch-sample-14`・`touch-lcd-14`・`tap-21,face-21,bringup-display-13`のclippy（`-D warnings`）とbuildを通した（`--locked`なしで実行し、`Cargo.lock`に差は出なかった）。build-onlyである。実機の通電は、`EXP-041`（develop `b9a04e8`のbuild、1回）である。

**`debug-motion-19` feature（[#19](https://github.com/wachi-yoshitaka-11-dev/deskcat/issues/19)）を有効にする場合は、既定構成に加えて`cargo clippy`と`cargo build`へ`--features debug-motion-19`を足したものも通す。**UART0のconsoleから`MOTION <name> <target>`の行を読み、Pi由来の`play_motion`と同じ`MotionDispatch`のcatalogへ渡す試験buildである。`LimitedServo`も`Limiter`も作らず、catalogが空のため、debugの指示も全て拒否される。製品buildには入らず、`bench-servo-test-17`・`touch-sample-14`・`touch-lcd-14`・`mem-probe-23`・`env-sample-16`・`accel-sample-15`・`bringup-i2c-15-16`・`bringup-led-514`とは併用できない（`compile_error!`）。firmware CIの`Build test modes`は、`debug-motion-19`と`debug-motion-19,face-21,tap-21`を`cargo clippy`と`cargo build`で確認する。build-onlyであり、実機の通電の記録は無い。この文を書いた時点では、VMで`cargo clippy`・`cargo build`を実行しておらず、CIの結果がこの構成を確認する根拠である。

**`bench-servo-calib-18` feature（[#18](https://github.com/wachi-yoshitaka-11-dev/deskcat/issues/18)の校正build）は、`firmware/esp32/src/config.rs`の`SERVO_CALIB_18_*`が1つでも`None`の間はcompileが止まる**（`E0080`。値は回ごとの実行承認が決めるため、既定値を置かない）。したがって、**この文書の検証済みコマンドへ`--features bench-servo-calib-18`を足した構成は、値を書いていない版では通らない。firmware CIの`Build test modes`にも入れない。**他の試験featureとは併用できない（`compile_error!`）。値を書いた版の`cargo clippy`と`cargo build`は、その回の実行承認の前に、値を書いた版で通す。build-onlyであり、実機で動かした記録は無い。

### workspace との関係

`firmware/esp32` は root workspace から `exclude` している。firmware の manifest は
`[workspace]` 節を持たないため、**exclude を外すと firmware の build が壊れる。**

firmware は `crates/deskcat-protocol`、`crates/deskcat-servo`、`crates/deskcat-face`、`crates/deskcat-accel`、`crates/deskcat-tap`、`crates/deskcat-env`、`crates/deskcat-touch` を path dependency で使う
（[ADR-0008](../decisions/0008-firmware-protocol-crate-reuse.md)。`deskcat-servo`、`deskcat-face`、`deskcat-tap`、`deskcat-accel`、`deskcat-touch` は同 ADR の追記。`deskcat-env` には同 ADR の追記が無い）。
**これらの crate の `rust-version` は host と ESP toolchain の両方を満たす下限にしてある。**
上げると firmware の build が compile 前に停止する。
**`crates/deskcat-protocol/`、`crates/deskcat-servo/`、`crates/deskcat-face/`、`crates/deskcat-accel/`、`crates/deskcat-tap/`、`crates/deskcat-env/`、`crates/deskcat-touch/` を変更したら、host だけでなく ESP32 build も回す。**
`deskcat-servo` の下限の根拠は [Version Record](version-records/2026-09-29-esp32-build-servo-limiter-native-linux.md) にある。

### flash と serial monitor

**2026-08-20 に検証した**（[#6](https://github.com/wachi-yoshitaka-11-dev/deskcat/issues/6)。`espflash` 4.5.0）。
artifact の path を渡し、`--port` と `--chip esp32` を明示する。
**非対話 shell では monitor が落ちるため pty を割り当てる。**
**chip 識別は `esptool` で行い、`espflash` では代替できない**（family 名しか返さない）。
実行した command と版は [Version Record](version-records/2026-08-20-esp32-flash-boot-native.md) にある。
**主張するのは flash と起動記録までであり、周辺回路と servo は含まない。**

**この節は意図して command block を持たない。**Version Record が載せている手順は、
同記録自身が「**再現手順であって、追加の実行記録ではない。上の形で再実行して確かめてはいない**」と
断っているものである。**ここへ写すと、再現手順を検証済み command へ格上げすることになる。**
実行する場合は Version Record を開き、**そこに書かれた条件**（ESP32 Flash / HIL profile の端末に限る、
実機を駆動するため[Hardware Safety Policy](../governance/hardware-safety-policy.md)の条件を満たす）
**ごと読む。**

**「非対話 shell では monitor が落ちるため pty を割り当てる」の出所は`AGENTS.md`の旧記述であり、
Version Record に該当する観測は無い**（2026-09-10 に走査して確認）。**実行前に自分で確かめる。**

**USB の抜き差しによる電源再投入は 2026-08-29 に検証した。**3 回とも `reset_reason=power_on`
かつ `uptime_ms` が小さい値であり、**「電源再投入のあと firmware が定常状態へ到達した」まで
主張できる。****ただし起動出力そのものは今も取得していない**（ROM の boot banner と、
heartbeat 1 本目より前の出力。**host 側の serial port が USB enumerate 後にしか存在しないためであり、
再試行では解決しない**）。

## Raspberry Pi

**2026-08-26 に検証した**（[#11](https://github.com/wachi-yoshitaka-11-dev/deskcat/issues/11) の前半）。
Raspberry Pi Direct Build profile の端末で、source tree の root にて実行する。
**ESP32 toolchain は要らない。**

```bash
cargo build --locked -p deskcat-serial
cargo fmt --all -- --check
cargo clippy --locked -p deskcat-serial --all-targets
cargo test --locked -p deskcat-serial
cargo test --locked -p deskcat-protocol
```

**検証したのはこの 2 crate である。**他の crate で通ることは主張しない。
**`-p` で 1 crate ずつ絞る。**Pi Zero W の使用可能 memory は実測 426 MiB であり、
**`--workspace` を一度に回した場合は未検証である。**実行した版と実測値
（依存 16 crate を含む clean build 22 分 24 秒、peak 単一 process RSS 247364 kB、OOM なし、
138 tests passed）は [Version Record](version-records/2026-08-17-pi-direct-build-native.md) の
2026-08-26 再検証節にある。
**主張するのは build と lint と test までであり、実 serial port と ESP32 との通信は含まない。**

## まだコマンドが無いもの

**Raspberry Pi の実機試験（実 serial port、ESP32 との通信）と HIL には、まだ正式なコマンドが無い。**
[ツールチェーン一覧](README.md) と未検証の runbook 手順を、検証済みコマンドとして扱わない。
**clean build の成功ごとにこの文書を更新する。**
