wachi-yoshitaka-11-dev/deskcat/docs/decisions/0006-validation-script-language.md

# ADR-0006: 検証scriptの実装言語をPythonとする

> 状態: Accepted
> 日付: 2026-08-06

## 背景

`scripts/`配下の検証scriptはPowerShell（`.ps1`）で実装し、Pages workflowも`shell: pwsh`で
実行していた。判断時点の内訳は次のとおりである。

| Script | 行数 |
|---|---|
| `test-link-validators.ps1` | 1354 |
| `validate-pages-output.ps1` | 761 |
| `test-pages-guards.ps1` | 449 |
| `lib/publish-guards.ps1` | 318 |
| `prepare-pages.ps1` | 291 |
| `validate-doc-links.ps1` | 291 |

`pwsh`はどのOSにもプリインストールされない。Windowsに入るのはWindows PowerShell 5.1であり、
`scripts/README.md`はそれを対象外と明記していた。

この前提は[ADR-0002](0002-role-based-development-environments.md)と矛盾する。ADR-0002は
Docs / Review profileの必須要件を「Git、Markdownを扱えるエディタ」とし、不要なものにRustを挙げている。
そこには文書検証scriptを実行するruntimeの記載がなく、記述どおりに用意した端末では
`./scripts/validate-doc-links.ps1`を実行できなかった。

[ADR-0005](0005-standard-development-os.md)で開発環境の標準OSを実機Linuxとした結果、
素の端末へ追加させるruntimeを見直す必要が生じた。

## 判断要因

- Docs / Review profileの必須要件を、ADR-0002の水準から不必要に引き上げない
- 標準OS（実機Linux）とCI（`ubuntu-24.04`）の双方で、追加導入なしに実行できる
- 他profileが既に必須化しているruntimeと重複させ、端末が抱えるruntimeの総数を増やさない
- 公開境界のguardを含むため、サードパーティ依存を持ち込まない
- 手書きのtest harnessを、言語標準の仕組みへ置き換える

## 検討した選択肢

### PowerShellを継続する

移行costが不要で、判定logicの同等性を確認する手間もかからない。
しかし`pwsh`の導入をDocs / Review profileの必須要件へ追加することになり、
ADR-0002が「Git、Markdownを扱えるエディタ」で足りるとした前提を引き上げる。
`ubuntu-24.04`のGitHub-hosted runnerには`pwsh`が入っているが、開発端末には入っていない。

### Python 3の標準ライブラリだけで実装する

標準OSである実機Linuxと、CIの`ubuntu-24.04`では、Python 3が既に存在する。
[ADR-0005](0005-standard-development-os.md)はmacOSについて判断していないため、
ここでもmacOSを前提に置かない。macOSを対象へ加える場合は、その時点で
Python 3の導入要件を別途記載する。
加えてESP32 Build profileではESP-IDFが既にPythonを必須化している
（`idf_tools.py`が`python -m venv`を使う）。
`pathlib`、`os`、`stat`、`shutil`、`subprocess`、`re`、`hashlib`、`json`、`html`、
`urllib.parse`、`unicodedata`、`argparse`で現行機能を賄える。標準ライブラリの`unittest`が、手書き1803行のtest harness
（`test-link-validators.ps1` + `test-pages-guards.ps1`）を置き換える。

MarkdownとYAMLには標準parserが無い。ただし現行のPowerShell実装も、そのために
線形走査のhelperを`lib/publish-guards.ps1`へ持っており、この点で後退しない。
asset manifestはPowerShell data file（`.psd1`）を`Import-PowerShellDataFile`で読んでいたが、
これに相当する標準ライブラリが無いため、`json`で読めるJSONへ変える。

### Rust製のCLIを作る

workspace内で完結し、型と所有権による保証が得られる。
しかしDocs / Review profileはRustを「不要なもの」として明示的に排除しており、
文書検証のためにRust toolchainを要求すると、その境界を壊す。
build生成物の配布と版固定も、文書検証のためだけには重い。

## 決定

`scripts/`配下の検証scriptをPython 3で実装し、**標準ライブラリのみを使う**。
サードパーティ依存を追加しない。

判定logicの仕様は変更しない。診断message、exit code、公開境界の判断は、
[意図的に一致させない挙動](#意図的に一致させない挙動)に挙げた3件を除いて現行と同一にする。

**この除外リストが、受容した差分と回帰を区別する唯一の基準である。**
リストに無い差分は回帰として扱い、修正する。挙動を意図的に変える場合は、
先にこのリストへ追記してから変更する。

secretと個人pathのpatternは`scripts/lib/publish_guards.py`だけで定義し、各scriptへ複製しない。
`lib/publish-guards.ps1`が持っていたSingle Source of Truthの方針を維持する。

## 影響

### 利点

- Docs / Review profileの必須要件が、ADR-0002の水準から大きく離れない
- `unittest`がtest実行、結果集計、skip管理を担い、harness自身の実装量が減る
- CI runnerと開発端末で同じruntimeを使える
- ESP32 Build profileが既に導入するruntimeと重なり、端末が抱えるruntimeの総数が増えない

### 欠点

- Docs / Review profileの必須要件へ`python3`を追加する必要がある（ADR-0002の記述だけでは足りない）
- 移行時に判定logicの同等性を確認する作業が発生する
- `.psd1` asset manifestをJSONへ変えるため、manifestのcommentを`documentation` keyへ移す

### リスクと対策

| リスク | 対策 |
|---|---|
| 移行で判定logicが変わり、公開境界が緩む | 二重化してCIで新旧を両方実行し、`validate-doc-links`が出す`DIGEST`の一致を必須にしてから旧実装を削除する。**実施済み。下記「同等性の検証記録」を参照** |
| .NETとPythonの標準関数の差（ordinal比較、拡張子解釈、reparse point判定）で結果が環境ごとに変わる | 差の出る箇所を`publish_guards.py`のhelperへ集約し、旧実装と同じ規則を明示的に再現する |
| 端末に`python3`が無い | `machine-profiles.md`のDocs / Review profileへ必須要件として記載する |
| Pythonのversion差で挙動が変わる | 標準ライブラリのみを使い、`ubuntu-24.04`のCIを判定の基準とする |

## 意図的に一致させない挙動

判定logicは同一にするが、次の3点はPython実装が旧実装と異なる。
いずれもPython実装の方が厳しく、fail-openになる差はない。

| 入力 | PowerShell実装 | Python実装 |
|---|---|---|
| portal file、asset、root documentがsymlink／reparse point | 辿った先の内容を公開する | `docs/`側と同じguardで拒否する |
| `pages/_config.yml`に値なしの`baseurl:`（colonの後ろが空） | `Cannot bind argument to parameter 'Value'`で中断 | `baseurl: ""`と同じくroot Pagesとして扱う |
| 生成siteに0 byteの`.html` | `Cannot bind argument to parameter 'Content'`で中断 | 空の走査結果として扱い、他のguardを最後まで実行する |

1件目は公開境界の穴を塞ぐための、意図した厳格化である。

`.pages-src/`へfileを入れる経路は4つある（portal file、asset、root document、`docs/`）。
旧実装は`docs/`にだけsymlinkとreparse pointのguardを持ち、残る3経路には持っていなかった。
`Test-Path -PathType Leaf`はlinkを辿り、`Copy-Item`はtarget側の内容を書き出す。
staging先は通常fileになるため、stagingの最後にあるreparse point検査でも捕まらない。
binaryのSHA-256も辿った先から計算されて一致する。link 1本でrepository外の内容が公開できた。

移行時に同じ穴を引き継いでいた。review（[#47](https://github.com/wachi-yoshitaka-11-dev/deskcat/pull/47)）で
asset経路の指摘を受けて塞いだ後、同じ欠陥classが他経路にも残っていないかを確認して
portal fileとroot documentでも再現し、判定を`link_rejection`へ集約した。
経路ごとに書くと、今回のように一部だけguardが抜ける。

新旧の差分検証ではこの穴を検出できなかった。「Pythonが旧実装と一致するか」しか
問うていないため、両実装に共通する欠陥は原理的に見えない。移植では、一致の確認とは別に、
判定そのものの妥当性を確認する必要がある。

残る2件は、旧実装の「意図した拒否」ではなく、PowerShellの`[Parameter(Mandatory)][string]`が
空文字列をbindできずに検査そのものを中断していた事故である。同じ事故を再現しない。
中断した旧実装は残りのguardを一切実行しないため、Python実装の方が検査範囲は広い。
現在の`pages/_config.yml`は`baseurl: /deskcat`であり、どちらの入力も現状のrepositoryでは発生しない。

なお`baseurl:`（値なし）と`baseurl: ""`は、YAMLとしては別の値である。前者はnull、
後者は空のscalarになる。**同じなのはこのvalidatorの出す結論**で、どちらもbaseurlなし、
つまりroot Pagesとして扱う。YAML上で同一という意味ではない。

## 検証

- `validate-doc-links`の新旧実装が、同一checkoutに対して同じ`MARKDOWN=` `LINKS=` `BROKEN=0` `DIGEST=`を出す
- `prepare-pages`の新旧実装が、`.pages-src/`へ同一のfile集合と同一内容を生成する
- 既存の回帰caseに相当する検証が`python3 -m unittest`で通る
- 上記を`ubuntu-24.04`のCIで確認する。localの結果だけをCIの根拠にしない

### 同等性の検証記録

削除前の二重実行は実施済みである。旧実装を削除したのは`b7466ea`で、その**直前**の
commit `d8f65df`のCI
[run 31190787234](https://github.com/wachi-yoshitaka-11-dev/deskcat/actions/runs/31190787234)
が両実装を実行し、一致を確認している。

```text
legacy:  MARKDOWN=70 LINKS=271 BROKEN=0 DIGEST=2FDF045F0998E5F7
current: MARKDOWN=70 LINKS=271 BROKEN=0 DIGEST=2FDF045F0998E5F7
```

このrunのworkflowは`Check documentation links`で両者の標準出力を文字列比較し、
異なればjobを落とす構成だった。`Test link validators`、`Prepare public source`、
`Validate output`、`Test publish guards`も同様に両実装を実行し、すべてsuccessである。

比較stepは旧実装の削除とともに撤去した。`.ps1`が存在しない以上、比較対象が無い。
**したがってこの記録が、削除前に同等性を確認した唯一の根拠である。**

`DIGEST`の値そのものは文書の増減で変わる。2026-08-08時点は`D91ADD6063BA55DF`である。
以後の判定条件は「特定の値と一致すること」ではなく、**同一checkoutに対して
WindowsとLinuxで同じ値が出ること**である（ADR-0005）。

見直し条件: Docs / Review profileの必須要件から`python3`を外す必要が生じた場合、
または標準ライブラリだけでは賄えない検査が必要になった場合に再検討する。

## 置き換える決定

なし。[ADR-0002](0002-role-based-development-environments.md)のprofile定義を置き換えるものではなく、
そこに記載が無かった検証script実行runtimeを補う。
