wachi-yoshitaka-11-dev/deskcat/docs/hardware/tbd-register-history.md

# Hardware TBDの判断記録

> 履歴: #467の整理時に、develop `b7cb5290715eded3530c7626d92bef5df3361540` から移した記録。

古い状態・誤記・後続の訂正を含め、当時の本文を残している。現在の判断は[tbd-register.md](tbd-register.md)、[sensor-datasheet-notes.md](sensor-datasheet-notes.md)を読む。
本文中の相対リンクだけを元のbase SHAへの固定リンクにした。「本行」「上記」、行番号、節名は移動前の文脈を指す。
この記録へ現在状態や手動Revisionを追記せず、新しい判断は正本と既存Issue／PR・実験ログへ記録する。

## HW-TBD-004

| ID | 優先度 | 不足している情報／判断 | 必要な根拠 | 妨げる対象 | 対応Issue | Owner | 状態 |
|---|---|---|---|---|---|---|---|
| HW-TBD-004 | P0 | **2026-08-13の現物確認で次が確定した。**(1) **IC刻印は`345B` / `#727` / `750B` / `PHIL`**であり、`345B`はAnalog DevicesのADXL345の刻印である。**これによりICの根拠が、silkと購入履歴からIC自身の刻印になった。**(2) **regulatorは非搭載**（IC＋`C1`×2＋抵抗のみで、3端子部品が無い）。(3) **裏面の半田ジャンパ2箇所はいずれもオープン。**(4) **搭載pull-upは`01C`（EIA-96で10 kΩ、1%）が4個**、ほかに`R2`＝`0`（0 Ωジャンパ）1個。**どのlineへ何個付くかは2026-08-27に現物写真でパターンを追って確定した。**値と判定方法の正は[sensor-datasheet-notes.md](https://github.com/wachi-yoshitaka-11-dev/deskcat/blob/b7cb5290715eded3530c7626d92bef5df3361540/docs/hardware/sensor-datasheet-notes.md)の`Module搭載pull-up`。**ここへ再掲しない。**(5) pin列は上`CS Vs GND VDD`、下`INT1 INT2 SDO SDA SCL`で、**`Vs`と`VDD`が別pinに出ている。****ただしこれはheaderのラベルであって、board上の配線ではない。****2026-09-05の非通電導通測定で、header `Vs`ピンと`VDD`ピンの間が導通している（同一net）ことを確認した。**したがって「2系統電源を個別に受ける設計」ではない。**ただし、この共通netがICの`VS`／`VDD I/O`それぞれへ直結しているか、個別に直列抵抗が入るかは、IC足が小さくプローブを直接当てられずパターンを追っていないため未解決のまま残る。**接写写真では、header〜IC間に`Vs`側・`VDD`側それぞれ1個ずつ、コンデンサ（`C1`）が見える位置にあり、目視ではIC方向へ直接パターンが伸びているように見えるが、断定はしない。(6) local decouplingは`C1`が2個実装されているが、**容量表記が無く値は不明**。**残: 実装済みI2C addressと`moduleへ入れてよい電圧`。**addressは`SDO`の接続で決まるが**基板上で固定されておらず、配線時に決まる**。`moduleへ入れてよい電圧`はregulator非搭載が確定したため**ICの`VS`／`VDD I/O`がheaderへ直結している可能性が高いが、直列抵抗やlevel shiftの有無をパターンで追っていないため断定しない**。module／ICはADXL345（秋月 M-06724）と特定済み。**module boardの資料が現在入手できない**（秋月 M-06724の商品ページは`gM-06724`／`g106724`とも404。2026-08-10確認）ため、jumper構成をIC datasheetから推定せず現物で読む。**`moduleへ入れてよい電圧`は2026-08-12に明示追加した。**[hardware-bom.md](https://github.com/wachi-yoshitaka-11-dev/deskcat/blob/b7cb5290715eded3530c7626d92bef5df3361540/docs/hardware/hardware-bom.md)と[power-budget.md](https://github.com/wachi-yoshitaka-11-dev/deskcat/blob/b7cb5290715eded3530c7626d92bef5df3361540/docs/hardware/power-budget.md)が3.3V給電を確定形で書いていたが、**ICの定格3.6Vはboardの許容値ではない**（regulatorやlevel shiftの有無で変わる）ため、3.3Vを唯一の候補としたうえで確定はこの行に依存させた。**5V直結の禁止は別の主張として維持する。**これは「moduleがregulatorを持たなければ5VがICへ直接掛かる」ことを否定できないための**確認前の安全規則**であって、IC定格からmoduleの許容入力電圧を導いたものではない | 現物のjumper／address pin設定の確認、基板上のregulatorの有無の確認、moduleへ入れてよい電圧の確定、および**board上に実装済みのdecoupling capacitorの確認**（`HW-TBD-029`から2026-08-12に移した。ICへの指定値は同行のcloseで確定しているが、**外付けが要るかはboardの実装でしか決まらない**。値の正は[sensor-datasheet-notes.md](https://github.com/wachi-yoshitaka-11-dev/deskcat/blob/b7cb5290715eded3530c7626d92bef5df3361540/docs/hardware/sensor-datasheet-notes.md)の`Local decoupling`節）。ICの根拠は[Analog Devices ADXL345 datasheet](https://www.analog.com/media/en/technical-documentation/data-sheets/adxl345.pdf)（**Rev. G。2026-08-12にブラウザで取得して確認した**。**「`analog.com`へは接続できない」という旧記載は誤りであったため同日訂正した**。到達できないのはCLI clientだけである。読み取った内容は[sensor-datasheet-notes.md](https://github.com/wachi-yoshitaka-11-dev/deskcat/blob/b7cb5290715eded3530c7626d92bef5df3361540/docs/hardware/sensor-datasheet-notes.md)の`ICの値`）。**ただしdatasheetを得てもこの行は解決しない。**jumper構成、実装済みaddress、regulatorの有無、moduleへ入れてよい電圧は、いずれもICの資料では決まらない。特定の根拠: [hardware-bom.md](https://github.com/wachi-yoshitaka-11-dev/deskcat/blob/b7cb5290715eded3530c7626d92bef5df3361540/docs/hardware/hardware-bom.md) ACCEL-01 | Accelerometer driverとしきい値、**ADXL345への給電電圧の確定**。**残る「moduleへ入れてよい電圧」は`HW-TBD-025`(a)（#3の電源architecture）が待つ値でもあるため、2026-09-06に`#3`を対応Issueへ加えた**（`HW-TBD-023`／`HW-TBD-024`と同じ理由。判定は必要な根拠列が求める作業の範囲で行い、題名や領域の近さでは判定しない）。**I2Cアドレスは配線時に決まる項目であり、現時点でIssueの担い手を要さない** | [#1](https://github.com/wachi-yoshitaka-11-dev/deskcat/issues/1)、[#3](https://github.com/wachi-yoshitaka-11-dev/deskcat/issues/3) | Human | Open（範囲を縮小）。**2026-09-18追記（詳細は[#433](https://github.com/wachi-yoshitaka-11-dev/deskcat/issues/433)）。**「moduleへ入れてよい電圧」を既存記録で埋めようと3つの道を試したが、いずれも埋まらなかった。(1) M-06724の商品ページはJS依存サイトのため機械的に取得できず、取得できても製造者（秋月自社設計か他社製品の販売代理か）が不明なため一次資料として使えるとは限らない。(2) header〜IC間の電源経路のパターン追跡は、この行(5)が既に「IC足が小さくプローブを直接当てられず」到達できなかったと記録済み。(3) 「IC＋C1×2＋抵抗のみで、3端子部品が無い」という2026-08-13の現物確認から、board上に電圧を変える部品が無いと推論する案も検討したが、確認済みの部品リストには網羅の宣言が伴っておらず（[sd-health-check.md](https://github.com/wachi-yoshitaka-11-dev/deskcat/blob/b7cb5290715eded3530c7626d92bef5df3361540/docs/hardware/sd-health-check.md)のRevision 5・12・13が示す前例——確認した範囲を無自覚に網羅として書き、自己レビューで2回訂正した——に照らすと、根拠として採れない）、不成立と判定した。**残る道は、M-06724の基板全体を網羅性を意識して観察すること**（裏面・他部品の下・小さいSMDを含め、板上に存在する全部品を確認する。分解・改変・通電はしない）である。これが得られれば、`HW-TBD-025`(a)の`#430`型の解決（IC自体の動作範囲＝moduleの受け入れ電圧）が見込める。**2026-09-18に写真3枚（正面・背面・IC接写）を再確認した。**写っている範囲は次のとおりであり、2026-08-13／08-27の記録と一致した。**IC接写は正面写真のICを拡大したもので、刻印の判読に使った（下記「正面」のIC刻印はこの接写で確認した）。**正面: IC（刻印`345B`／`#727`／`750B`／`PHIL`）、`C1`×2、`01C`（10 kΩ）の`R1`×4、`R2`＝`0`（0Ωジャンパ）×1、4pinヘッダ（`CS`／`Vs`／`GND`／`VDD`）、5pinヘッダ（`INT1`／`INT2`／`SDO`／`SDA`／`SCL`）。背面: 半田ジャンパ2箇所（シルクに識別がある。片方は`J1`と明瞭に読めたが、もう片方は反射で判読しにくい）、いずれも未橋絡（オープン）で2026-08-13の記録と一致、ほかはtraceのみで部品は無い。**この2枚はMSP2807のようなテープ等の物理的な被覆物こそ写っていないが、写真である以上、フレーム外・影・反射で写らない部分の存在は否定できない。**ただし、**これだけでは網羅宣言にならない。**この観察はAIが写真を見て記述したものであり、この行が2026-08-13の現物確認について既に退けた理由（「確認済みの部品リストには網羅の宣言が伴っておらず…根拠として採れない」）と同じ弱さを持つ。**網羅を言えるのは、現物を手に取り、裏返し、光を傾けて確認した人間だけである。**したがってこの行の判定は変えない。**必要なのは新しい写真ではなく、現物を確認した人間による「これで全部である」という一文の宣言である。****2026-09-18、ユーザーへ確認した。**質問（作業セッション）：「これは、今回撮っていただいた写真を見返しての判断でしょうか、それとも現物を再度手に取って（ヘッダの根元・基板の縁・裏面の空きランドも含めて）確認された上での判断でしょうか。」ユーザーの発言(1)：（原文省略）。ユーザーの発言(2)（上の質問への回答）：（原文省略）。回答により、提示した一覧以外に部品が無いこと、および人間による現物確認に基づくことを、作業セッションは記録した（推論であり、ユーザーの発言そのものではない）。ただし確認の確度には留保がある。発言(2)は、二択の質問への回答である。**「ヘッダの根元・基板の縁・裏面の空きランド」は質問文に含めた項目であり、ユーザー自身が確認項目として個別に挙げたものではない。評価語（「網羅を宣言した」等）はここに足さない。****「M-06724の公式schematic・部品表は存在しない」も全称にしない。**確認した範囲は、秋月電子の商品ページ（`g106724`。2026-08-10および2026-09-18に404を確認）、一般web検索、petitmonteのI2C版／SPI版記事2件、Qiita記事2件（いずれも「秋月電子」「M-06724」への言及はあるが回路図・部品表は無い）、フリマ出品2件（M-06724への言及自体が無い）、および代表的な他のADXL345モジュール（GY-291等。pin配置がこの基板の`CS`／`Vs`／`GND`／`VDD`＋`INT1`／`INT2`／`SDO`／`SDA`／`SCL`と異なる）の回路図検索、の範囲だけである。**この発言から言えること（推論であり、ユーザーの発言そのものではない）。**発言(1)が指す一覧は、作業セッションが2026-09-18にユーザーへ提示した確認用の一覧を指す。発言(1)は、この5行・10個の一覧以外に部品が無いことを述べたものと読める。**この一覧の提示は発言(1)より前である。**その一覧を、提示した形のまま記録する。**提示時の見出しは「数える基準（すでに写真で確認済みの6種）」、本文は「基準は次の6種・8個です」としていたが、**実際に示した表は次の5行・合計10個であり、提示時の呼称（6種8個）自体が誤りだった**（1＋2＋4＋1＋2＝10）。**この誤った呼称は訂正しない。**ユーザーが実際に見て発言(1)で答えたのはこの表そのものであり、後から呼称だけ直すと、発言(1)の指す対象がここに書かれた文言と食い違って見えるようになる。誤りは誤りのまま残し、正しい数（5行・合計10個）を別に添えるにとどめる。提示した5行は、IC（`345B`）×1、`C1`×2、`R1`（`01C`）×4、`R2`（`0`）×1、裏面の半田ジャンパ×2、である。**`R1`／`R2`は、この一覧を作る際にPCBのシルク印字を直接読み取ったreference designatorである。`ACCEL-01`（M-06724）board固有の符号であり、BME280（`AE-BME280`）側の`R1`（4.7 kΩ、[sensor-datasheet-notes.md](https://github.com/wachi-yoshitaka-11-dev/deskcat/blob/b7cb5290715eded3530c7626d92bef5df3361540/docs/hardware/sensor-datasheet-notes.md)）とは別基板の別部品である。混同しない。****このうち裏面の半田ジャンパ2箇所は、上の(3)が「裏面の半田ジャンパ2箇所はいずれもオープン」と記録しているとおり、半田で橋絡されていない銅箔padである。**部品として数えるかどうかに関わらず、未橋絡である以上、現在この2箇所を経由する電流経路は存在せず、`moduleへ入れてよい電圧`の判定には効かない（橋絡されれば別の判定が要るが、今回の申告はオープンの状態を変えていない）。**したがって、提示した10個（うち電流経路上にあり得るのはIC・`C1`×2・`R1`×4・`R2`×1の8個。この8は、上で訂正しないと述べた提示時の誤った呼称「6種8個」の8とは無関係の、別の数え方から出た値である）以外の未知の部品（能動的なlevel shift段、未知の追加抵抗）が`Vs`／`VDD`の経路に入る余地は無い。**既知の受動部品のうち`R1`×4は`ACCEL-SDA`／`ACCEL-SCL`用と特定済み（2026-08-27の写真追跡）であり電源経路ではない。`R2`は`0`Ωのジャンパであり、仮に電源経路上にあっても電圧降下を生まない。**ここで確定できることと、できないことを分ける。**確定したのは、板上に存在する部品が上記の列挙のとおりであり、そのいずれも3.3 V rail（3.234–3.366 V。[power-budget.md](https://github.com/wachi-yoshitaka-11-dev/deskcat/blob/b7cb5290715eded3530c7626d92bef5df3361540/docs/hardware/power-budget.md)）で定格を超えないこと、および電圧を変える能動部品（regulator、level shifter）が存在しないことである。**確定していないのは、headerの共通net（`Vs`／`VDD`。継続性は2026-09-05にheader pin間でのみ確認済み）からICの`VS`／`VDD I/O`各pinまでの経路である。**直結か、`R2`のような`0`Ωを経由するか、あるいは断線しているかは、IC足が小さくプローブを直接当てられずパターンを追っていないため引き続き追跡できていない（既存の記録どおり。上記(5)を参照）。**この未確定は、`moduleへ入れてよい電圧`の判定には効かない。**問うているのは「このmoduleへ何Vを入れてよいか」であり、経路の形によらず、ICが受け取る電圧はheaderに入れた電圧を超えることがない。受動素子（抵抗・`0`Ωジャンパ）は電圧を下げる方向にしか働かず、上げることはない。能動部品は存在しないことが確定している。**これは各pinを対GNDの絶対値として見た場合の議論であり、正しく製造された個体を前提とする**（pin間の相対定格と、製造欠陥を前提とする故障モードは別に扱う。下記2026-09-21の追記を参照）。経路が断線していれば起きるのはmoduleが動作しないことであり、対GNDの過電圧ではない。**したがって、headerに入れてよい電圧の上限は、経路の確認状況によらずIC自体の動作範囲**（`VS` 2.0–3.6 V、`VDD I/O` 1.7 V–`VS`。Analog Devices Rev. G）**を超えないことで決まる。**3.3 V rail（3.234–3.366 V）はこの範囲の内側にあり、5 V直結禁止の規則は変えない。**「headerからICまでの経路を確認した」とは主張しない。**確認できていない経路は、この判定の対象外（module機能の問題であり、安全の問題ではない）として引き続きTBDのまま残す。**この判定は口頭申告を根拠にしており、BME280のような文書上の網羅宣言ではない。****2026-09-21に、ADXL345のAbsolute Maximum Ratings表（Analog Devices、Table 2）を確認した。**行は`Acceleration`、`VS`（−0.3 V〜+3.9 V）、`VDD I/O`（−0.3 V〜+3.9 V）、`Digital Pins`（−0.3 V〜`VDD I/O` + 0.3 Vまたは+3.9 Vのうち小さい方）、`All Other Pins`（−0.3 V〜+3.9 V）、`Output Short-Circuit Duration`、`Temperature Range`である。**事実: `Digital Pins`行は`VDD I/O`を基準とした相対定格であり、`VS`／`VDD I/O`単独の絶対値規定とは別に存在する。**故障モード: headerからICへの経路のうち`VDD I/O`のトレースだけが断線した場合、基板搭載のpull-up（`ACCEL-SDA`／`ACCEL-SCL`。[gpio-assignment.md](https://github.com/wachi-yoshitaka-11-dev/deskcat/blob/b7cb5290715eded3530c7626d92bef5df3361540/docs/hardware/gpio-assignment.md)の`信号inventory`）が`SDA`／`SCL`を約3.3 Vに保つため、`VDD I/O`が浮けばこの相対定格に触れうる。**範囲外: これは購入品の製造欠陥（内部トレースの部分断線）を前提とする故障モードである。**`HW-TBD-004`が問う「moduleへ入れてよい電圧」は、正しく製造された個体について答えるものであり、この故障モードを含まない、と`#0PM`が判定した（2026-09-21。**この判定はPMの判断であり、既存の一次資料や正本の別記述からの導出ではない**）。判定の理由は、内部トレースの導通の証明を要求すると同じ理由でBME280を含むすべての購入moduleが使えなくなること。**`Power Sequencing`（`Bus Disabled`、Table 6）が破損の危険として扱われているかは調べていない**（範囲外と判定した事項の内側であるため）。**残る: headerからICまでの経路の確認は、既存記録のとおり未確認のまま残る**（この行が元から持っている残件であり、この訂正は解いていない）。**BME280（#16）への同型主張は訂正する。**`HW-TBD-005`の既存記録によれば、AE-BME280自身の`J1`／`J2`（module搭載`R1`／`R2`、4.7 kΩ）は**3つとも開放**であり、BME280自身の基板搭載pull-upがSDA/SCLを保持する経路にはなっていない。**ただし、この行(4)がすでに確定しているADXL345側の`01C`（10 kΩ、`ACCEL-SDA`／`ACCEL-SCL`用に4個搭載、2026-08-27に特定済み）が同じ結合を作りうる。**`ACCEL-SDA`／`ACCEL-SCL`はACCEL-01とENV-01の共有bus（同一の物理線。[gpio-assignment.md](https://github.com/wachi-yoshitaka-11-dev/deskcat/blob/b7cb5290715eded3530c7626d92bef5df3361540/docs/hardware/gpio-assignment.md)の`信号inventory`の`ENV-SDA`／`ENV-SCL`行が「ACCEL-01と共有」と記録する）であるため、`01C`がSDA/SCLをheader側の共有net上で3.3 V付近に保持していれば、BME280自身の`R1`／`R2`が開放であっても、同じ物理線を共有するBME280側のpinも同じ電位を受ける、というのがこの機構である。**`01C`の高電位側が実際にheader側のnetに付いているか（IC側の断線した経路の先ではなく）は追跡していない。**ADXL345のIC自体への経路と同様、この機構もパターン追跡による確認はしていない。**ただしこの機構自体は、すでに「製造欠陥前提の故障モードであり範囲外」と判定した事項を敷衍しただけであり、この機構を厳密に確認する必要はない**（範囲外の判定そのものが変わらないため）。**したがって#16へも同じ製造欠陥前提の懸念は及ぶが、`HW-TBD-004`と同じ理由（正しく製造された個体を前提とする。この判定自体は`#0PM`（本作業のPMセッション）が下したものであり、`#16`のstatus:blockedに関わる判定であるため、人間の最終承認を別途要する）で、**承認を得るまでの暫定として**#16の判定も見直さない。**承認が得られなかった場合は、この段落と`#16`側の判定を取り消し、両方を範囲外ではなく未解決へ戻す**（この4文は2026-09-21より前、承認を求める前の記述である）。**2026-09-21追記。この承認を得た。**PMが判定（発火の経路が無く、壊れる条件は既に壊れている個体を掴んでいた場合に限られ、事前に判別する手段が無いため待っても情報が増えない。壊れた場合はADXL345 module 1枚を失う）を提示し、ユーザーが承認した。**この段落と`#16`側の判定を取り消す条件は満たされない。**それでも上で要求した「これで全部である」という宣言の要件を満たしたと判断する理由は次のとおりである。**要求していたのは特定の文言ではなく、AIによる写真の読み取りではなく人間が現物を確認した結果として「他には無い」と言えるかどうかであった。発言(1)はその内容（提示した一覧以外は無い）を述べており、言い方に確信の弱さが残る点は、内容が現物確認に基づくことを否定しない。**したがって、文書上の網羅宣言（BME280のような）の水準には届かないが、この行が要求した人間による確認としては足りると判断する。****残る作業**: 実装済みI2Cアドレスは`SDO`の配線で決まる（配線時に選ぶ。一般値扱いのため未確定でも着手を止めない）。**この判定は2026-09-18に[hardware-bom.md](https://github.com/wachi-yoshitaka-11-dev/deskcat/blob/b7cb5290715eded3530c7626d92bef5df3361540/docs/hardware/hardware-bom.md) ACCEL-01と[power-budget.md](https://github.com/wachi-yoshitaka-11-dev/deskcat/blob/b7cb5290715eded3530c7626d92bef5df3361540/docs/hardware/power-budget.md)の`3.3 V rail`許容電圧範囲へ、日付つきの訂正として隣に反映済みである（過去の記述は書き換えていない）。**[gpio-assignment.md](https://github.com/wachi-yoshitaka-11-dev/deskcat/blob/b7cb5290715eded3530c7626d92bef5df3361540/docs/hardware/gpio-assignment.md)のACCEL行は、この判定で偽になる記述が無いため触っていない（同文書L516の記述は無給電時のdrive有無という別の論点であり、直列抵抗の有無とは独立に成立する）。 |

## HW-TBD-023

| ID | 優先度 | 不足している情報／判断 | 必要な根拠 | 妨げる対象 | 対応Issue | Owner | 状態 |
|---|---|---|---|---|---|---|---|
| HW-TBD-023 | P0 | **ESP32 boardの`3V3` pinから外部負荷を取ってよい条件。**(a) 外部供給可能電流の定格、(b) board上regulatorの種別（LDO／switching）、(c) **過電流保護／短絡保護の有無と動作**（制限電流、折り返し特性、熱shutdownの有無）、(d) **`U2`周辺のdecoupling実装**（参照設計では入出力とも22 µF。`HW-TBD-029`から2026-08-12に移した）。**根拠は2段階に分けて扱う。参照設計の回路図で分かったことは、現物の事実ではない。**現物が公式V4リファレンス設計どおりに実装されている保証は文書だけでは得られない。**`HW-TBD-001`（pin配列の照合）は2026-08-15にcloseしたが、それはpin配列が一致したことを示すだけであり、実装部品が回路図どおりであることまでは保証しない。実際に`U2`は回路図と違う部品であった**（下記）。**参照設計で判明**: `U2 = AMS1117-3.3`（LDO）であり、回路図上にヒューズ・ポリスイッチは無い（`LESD5D5.0CT1G`×3はESD保護であって過電流保護ではない）。参照設計どおりなら、短絡・配線ミス時に電流を制限しうるのは`AMS1117-3.3` IC自身の内蔵保護だけになる。**2026-08-13の現物確認で、参照設計と現物が違うことが判明した。****現物の`U2`の刻印は`LD1117AG` / `33AQVCUV`であり、`AMS1117-3.3`ではない。**どちらもSOT-223の3.3V LDOでpin互換の二次ソースだが、部品が違う。`33`は3.3V版を示すと解される。**これは「参照設計由来の事実を現物の事実として書かない」という扱いが実際に効いた例である。**回路図を信じて`AMS1117`のdatasheetを当てていれば、別部品の仕様で段階B-2aの可否を判定していた。**2026-08-15に`U2`のメーカーを特定した。**現物の刻印は**UMW（UTD Semiconductor Co., Limited）の`LD1117-3.3`（SOT-223）**の刻印規則と一致する（根拠欄）。**これにより(b)が確定し、(c)は一部だけ埋まった。****(b)はLDOである。****(c)のうち確定したのは制限電流と熱shutdownの有無だけである。**内蔵の電流制限（`Ilimit` min 1.25 A／max 1.6 A）と熱shutdown（`TSD` typ 150 ℃）を持つ。**短絡保護の有無と折り返し特性はdatasheetに記載が無い。これは「無い」ことの確認ではない**（[AGENTS.md](https://github.com/wachi-yoshitaka-11-dev/deskcat/blob/b7cb5290715eded3530c7626d92bef5df3361540/AGENTS.md) 推測禁止）。**したがって(c)が求める「短絡・配線ミス時の動作」は未確定であり、(c)はcloseしない。****それでも段階B-2aに不利な事実が1つ確定した。**電流制限のtrip点1.25–1.6 Aは**この品の1 Aという定格より上にある。**したがって**`IOUT` 1.0–1.25 Aの区間は電流制限が動作しない範囲である。**この区間で熱shutdownが働くかは放熱条件次第でありdatasheetからは決まらない。**「熱shutdownが代わりに効く」と読み替えない。****残**: (a)、(c)の短絡・折り返し、(d)。**(a)はメーカーdatasheetでは埋まらない。**ICの供給能力は`3V3` pinが外部へ出せる電流の**上限を与えるだけ**であり、**Espressifは`3V3` pinの外部供給可能電流をboard levelで公開していない。**熱からの導出（datasheetのNote 1が与える`PD(max) = (TJ(max) - Tamb) / Rθja`に`TJ(max)` 150 ℃と`Rθja` 88 ℃/Wを入れる）も**この基板の実力ではない。**同Note 1が**`Rθja`は実装方法で変わると明記している**ためであり、[ESP32-DevKitC V4公式回路図](https://dl.espressif.com/dl/schematics/esp32_devkitc_v4-sch.pdf)は基板の銅箔面積を与えない。**したがって(a)は現物の実測でしか埋まらない。**(d)は2026-09-05の接写で個数まで確認した。`U2`の上に1個、下に横並びで2個、合計最低3個のコンデンサらしき部品（積層セラミック）が実装されている。**容量値は読めていない**（表記が無い）。**2026-09-06に、UMW LD1117 datasheetの`4.Pinning information`図（SOT-223）で足の並びを確認した。**刻印面を見て足が下に出る向きで、左から`ADJ/GND`（pin1）・`VOUT`（pin2）・`VIN`（pin3）である。**`AG`は固定電圧版であり、block diagramの`Fixed: F1 and F2 connect, disconnect A`によりpin1は実質`GND`として働く。**ただし、この並びが分かっても、写真の3個のコンデンサのうちどれがどの足の近くにあるかは別軸（コンデンサは部品の上下、足は部品の左右）であり、対応づけていないため**依然としてどれが入力側でどれが出力側かは未確定である**（推測しない）。回路図に無い保護部品は現物にも見当たらない | 参照設計の根拠: [ESP32-DevKitC V4公式回路図](https://dl.espressif.com/dl/schematics/esp32_devkitc_v4-sch.pdf)。経路は`VBUS → D3 BAT760-7（Schottky）→ EXT_5V → U2 AMS1117-3.3 → VDD33 → J2 pin1`、入出力とも22µF（2026-08-10確認）。**現物の根拠**: 2026-08-13に斜光＋接写で`U2`の刻印を読み取り、`LD1117AG` / `33AQVCUV`を得た。**メーカーは2026-08-15に特定した。**出典は[UMW LD1117 datasheet](https://www.umw-ic.com/static/pdf/a5e0c99cefdefaf03cfa7777b369e45b.pdf)（発行元`UTD Semiconductor Co., Limited`、Mar.2025、14page、sha256は`5dec5c09027316c375c27108cbac9d088ba94060bebacd614a04a3b8bb18a3d3`。2026-08-15取得）である。**同datasheetの`14.Ordering information`はSOT-223の刻印を1行目`LD1117AG`、2行目`xxAQwwT S`（`xx`はVoltage、`ww`はWeek Code）と図示し、発注表に`Order Code: UMW LD1117-xx`／`Marking: LD1117AG xx`／`Package: SOT-223`を載せている。****現物の`LD1117AG` / `33AQVCUV`はこのtemplateと一致する。**1行目はliteralが一致し、2行目は`33`が`xx`（3.3 V）、続く`AQ`がtemplateのliteralと一致し、残る`VCUV`がdate／lotに当たる。**8文字の構成が一致する。****UTC（Unisonic Technologies）は候補から外した。**UTCにも`LD1117AG`系の型番があり、[UTC LD1117/A-K datasheet](http://www.utc-ic.com/uploadfile/2011/0915/20110915031520257.pdf)（文書自身が`UNISONIC TECHNOLOGIES CO., LTD`、文書番号`QW-R125-113.F`、footer `www.unisonic.com.tw`、Copyright 2024を記載する。sha256は`2af2ec5e4cf07cabcf2b76eb66cf24257554bb019d228d43a520460a7b1430b7`。2026-08-15取得。**`www.unisonic.com.tw`は同じPDFを直接返さず、`utc-ic.com`はhttpsの証明書が期限切れのためhttpで取得した。この1点だけはUMW側の資料より出所が弱い**）の`MARKING INFORMATION`は`A`をCurrent Code（1 A）、`G`をHalogen Free、`33`をVoltage Codeと定義するため**`LD1117AG`と`33`を意味の上では説明できる。しかしUTCの刻印templateは`UTC`の社名行を含み、`AQ`というliteralを生まない。**現物の読み取りは2行で社名行が無く、`AQ`を含むため、**UMWの方が一致度が高い。****決め手は刻印単体ではなく、メーカーが公開したtemplateとの一致である。**要件は[power-budget.md](https://github.com/wachi-yoshitaka-11-dev/deskcat/blob/b7cb5290715eded3530c7626d92bef5df3361540/docs/hardware/power-budget.md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段階b-2の測定)の`B-2a: 3V3 pinから給電する経路`、確認項目は[hardware-bom.md](https://github.com/wachi-yoshitaka-11-dev/deskcat/blob/b7cb5290715eded3530c7626d92bef5df3361540/docs/hardware/hardware-bom.md) `MCU-01`と部品受け入れchecklist。**配線規則の正本は[power-budget.md](https://github.com/wachi-yoshitaka-11-dev/deskcat/blob/b7cb5290715eded3530c7626d92bef5df3361540/docs/hardware/power-budget.md)であり、この行では定めない** | **段階B-2a**。**(a)が未確定である限りB-2aを許可しない。**B-2bへ移れば回避できるが、`HW-TBD-024`／`025`は経路によらず必要なため、それらが未解決ならどちらの経路も進まない。**なお(c)が一部埋まったことでB-2aの前提が一つ悪くなった。**B-2aは`故障電流を制限するもの`をregulator自身の保護に置く経路だが（[power-budget.md](https://github.com/wachi-yoshitaka-11-dev/deskcat/blob/b7cb5290715eded3530c7626d92bef5df3361540/docs/hardware/power-budget.md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段階b-2の測定)の経路表）、**電流制限は1.25 Aまで動かず、短絡時の挙動はdatasheetから決まらない。**採否の判断材料としてこの事実を`HW-TBD-009`と`HW-TBD-030`へ渡す | [#1](https://github.com/wachi-yoshitaka-11-dev/deskcat/issues/1)、[#3](https://github.com/wachi-yoshitaka-11-dev/deskcat/issues/3) | Human | Open（**(b)は2026-08-15に確定した。(c)は制限電流と熱shutdownだけが埋まり、短絡保護と折り返し特性はdatasheetに記載が無いため未確定のまま残る。**(a)と(d)も残るためcloseしない。(a)はEspressifがboard levelで公開しておらず、**メーカーdatasheetでは埋まらないことが確定した**ため、残る手段は現物の実測だけになった。**そしてその実測は段階B-2そのものであり、この行がB-2aをBlockedしているため循環する**（`HW-TBD-024`と同じ構造である）。**B-2bを採れば(a)は要らなくなるため、循環を解く必要は無い。経路の選択で回避できる。**(d)は2026-09-05に個数（最低3個）まで確認したが、入力側・出力側の内訳と容量値は未確定のまま残る。**`HW-TBD-001`は2026-08-15にcloseしたが、この行は独立して残る**）。**2026-09-18追記（詳細は[#433](https://github.com/wachi-yoshitaka-11-dev/deskcat/issues/433)）。**`#409`が`#13`について受理した理由（`U2`の`Ilimit`・熱shutdownにより、失敗時の帰結は「熱shutdownで止まる」にとどまる）は、`U2`自身の特性だけに基づいており負荷側の事実に一切触れていない。**module非依存の理由である。**したがって`#430`で負荷側（隠れた高電流経路が無いこと）が確認済みのBME280（ENV-01）にもこの受理理由がそのまま適用できる。ADXL345（ACCEL-01）については負荷側の確認が別Issueへ持ち越されており、この行の適用可否は保留する。**この行自体はcloseしない**（(a)(c)(d)自体はESP32側の一般論として引き続きOpenのまま）。**2026-09-21追記。**`#433`が保留した「負荷側の確認」が何を指すかを特定した。`#430`（この行の下`HW-TBD-025`が持つ判定。commit `a75efd5`）は`#433`（commit `99c1bc3`）の直接の親commitであり（`git show -s --format='%H parents:%P' 99c1bc3`で確認）、`#433`の著者が`#430`の内容を知っていたことは、この行自身の同じ2026-09-18追記（直前の文）が「`#430`で負荷側（隠れた高電流経路が無いこと）が確認済みのBME280（ENV-01）にもこの受理理由がそのまま適用できる」と`#430`の内容を名指しで引用していることから確認できる（親commitの順序は補強材料である）。したがって「負荷側の確認」は`HW-TBD-025`(b)を指していない（`#430`で既に両module分が済んでいた）。`#433`のcommit本文（`99c1bc3`）は「ADXL345（ACCEL-01、`HW-TBD-004`）分は既存記録では埋まらず、試した3つの道…と残る道（基板全体の網羅観察）を記録した」と明記しており、保留の対象は`HW-TBD-004`（moduleへ入れてよい電圧）である。`#433`のcommit本文が挙げる「試した3つの道」「残る道は基板全体の網羅観察」は、`HW-TBD-004`行（本表の別行）が現在も保持している2026-09-18付の同じ記述と文言が一致する。`HW-TBD-004`のうち「moduleへ入れてよい電圧」は`#436`（2026-09-21、commit `4588c91`）で満たされたと判定された（根拠はユーザーの口頭申告（現物再確認）であり、`HW-TBD-004`行が明記するとおりBME280のような文書上の網羅宣言ではない。headerからICまでの経路の確認までは主張していない。この判定は`#0PM`による「製造欠陥前提の故障モードは範囲外」という前提に立っている）。**2026-09-21、この承認を得た**（PMが判定を提示し、ユーザーが承認した。詳細は`HW-TBD-004`行。ここへ再掲しない）。したがってこの保留の解除を取り消す条件は満たされない。`HW-TBD-004`自体は実装済みI2Cアドレスの残件がありcloseしていない（この残件はaddressの配線で決まる一般値であり、この保留の解除には関係しない）。したがって、上記の承認（2026-09-21、人間の承認を得た）の範囲内で、この保留は解ける。`#409`が`#13`について受理した理由（`U2`の`Ilimit`・熱shutdownにより、失敗時の帰結は「熱shutdownで止まる」にとどまる。module非依存の理由）は、ADXL345（ACCEL-01）にも適用できる。**この行自体はcloseしない**（(a)(c)(d)自体はESP32側の一般論として引き続きOpenのまま。この追記は段階B-2（3点合算測定）のgateを開けない。`HW-TBD-024`（MSP2807分）は未解決のまま）。2026-09-22追記（[#445](https://github.com/wachi-yoshitaka-11-dev/deskcat/issues/445)）。**(a)（`3V3` pinの外部供給可能電流のboard level定格）は解決していない。値は今も公開されていない。**ただし2026-09-22、ユーザーが範囲を限定した例外を承認した。**対象は`ACCEL-01`（ADXL345）と`ENV-01`（BME280）の2点に限る。**`DISP-01`（MSP2807）はこの承認の対象外である。**承認の前提として示した残余riskは、ESP32側regulator（`U2`）が`IOUT` 1.0–1.25 Aの区間で電流制限が働かないこと（短絡・配線ミス時の動作がdatasheetから決まらない）であり、これは判断であって証拠ではない。**2026-09-07の決定（[power-budget.md](https://github.com/wachi-yoshitaka-11-dev/deskcat/blob/b7cb5290715eded3530c7626d92bef5df3361540/docs/hardware/power-budget.md)の`B-2b を採る決定`節。3.3V系はESP32の`3V3` pinを使わず外部電源B-2bを使う）は書き換えていない。**MSP2807を含む構成、および将来の合成給電（段階B-2）には引き続き2026-09-07の決定が掛かる。**詳細と計算根拠は[power-budget.md](https://github.com/wachi-yoshitaka-11-dev/deskcat/blob/b7cb5290715eded3530c7626d92bef5df3361540/docs/hardware/power-budget.md)の当該節を参照し、ここへ再掲しない。**2026-09-23追記（[#461](https://github.com/wachi-yoshitaka-11-dev/deskcat/issues/461)）。**上記はこの2026-09-22の承認（`#445`）自体の範囲についての記述であり、変えていない。**別途`#461`によりMSP2807の3.3V系への通常接続（`ACCEL-01`／`ENV-01`が既に接続されている状態への追加を含む）が認められた。値・導出は本台帳の`HW-TBD-024`行を参照し、ここへ再掲しない |

## HW-TBD-024

| ID | 優先度 | 不足している情報／判断 | 必要な根拠 | 妨げる対象 | 対応Issue | Owner | 状態 |
|---|---|---|---|---|---|---|---|
| HW-TBD-024 | P0 | **MSP2807が耐えられる電流の上限。**メーカー未公開である。外部の3.3 V電源から給電する経路（段階B-2b）は**設定した電流制限が唯一の保護**であり、その設定値の上限を決めるにはmodule側の安全な上限が要る。**上限が無いままではMSP2807へ給電できない。**これは`HW-TBD-025`の共通条件(b)の一部であり、**B-2bだけでなくB-2aにも掛かる**（B-2aでもregulatorの保護のtrip点がmoduleにとって安全かを判定できない）。ADXL345とBME280だけ測っても未知数は埋まらないため、B-2自体が成立しない。**この懸念は「周辺module3点を合算して測定する段階B-2」という行為単位にではなく、MSP2807の`VCC`をESP32の`3V3` pinへ接続する構成そのものに帰属する**（2026-09-17に明確化。[#422](https://github.com/wachi-yoshitaka-11-dev/deskcat/issues/422)）。したがってbacklightの`LED` pin（制御信号線であり電力を流さない。LCDWiki公式User Manualが「制御不要なら3.3Vへ直結してよい」と定める配線）を能動制御せず3.3Vへ直結する構成を採っても、`VCC`経由でU2の保護trip点がMSP2807に与える帰結という論点は消えない。**周辺module3点を揃えず、MSP2807単体を`3V3` pinから`VCC`給電するbring-up（3点合算の定常電流測定を伴わないもの）も、この行の対象である** | **一次資料には無いことが確定した。**メーカーdatasheet（[msp2807.pdf](https://akizukidenshi.com/goodsaffix/msp2807.pdf)）の`Power Consumption`欄は`TBD`と印字されている（2026-08-10確認）。[LCD Wiki](http://www.lcdwiki.com/2.8inch_SPI_Module_ILI9341_SKU:MSP2807)にもbacklight駆動回路の記載は無い。**したがって現物のbacklight回路を見る以外に埋める手段が無い。****2026-08-13に現物を確認した結果は次のとおりである。**`R5`＝`6R8`（6.8 Ω）、`R6`＝`102`（1 kΩ）、`Q1`＝SOT-23で刻印`J3Y`、**`U1`＝SOT-23で刻印`662K` / `UMW S4T`**、`C1`＝積層セラミック（容量表記なし）、`J1`＝半田ジャンパで**オープン**。**`662K`はSOT-23の3.3V LDOの標準刻印であり、moduleが「VCC 3.3–5 V」を受けられる理由がboard上のLDOであることを示す。したがってこのLDOの電流能力がmoduleの上限を決める要素になる。****`U1`のメーカーと品番は2026-08-15に特定した。****UMW（UTD Semiconductor Co., Limited）の`XC6206P332MR`（SOT-23、3.3 V）である。**出典は[UMW XC6206 datasheet](https://www.umw-ic.com/static/pdf/e442437afc9daa185da86486e2bfe8c5.pdf)（発行元`UTD Semiconductor Co., Limited`、Mar.2025、13page、sha256は`8d8e3e30dbf48a39e0b4e11122ac242c2849b68ee8225ba0d672d83decf30504`。2026-08-15取得）である。**同datasheetの`13.Ordering information`は発注表に`Order Code: UMW XC6206P332MR`／`Marking: 662K`／`Package: SOT-23`を載せ、SOT-23の刻印図を1行目がmarking code、2行目が`UMW yww`（`yy`はYear Code、`ww`はWeek Code）と示している。****現物の`662K` / `UMW S4T`はこれと一致する。**1行目が3.3 V版のmarking codeと一致し、2行目の`UMW`が社名の位置に来る。**残る`S4T`は復号できない。**datasheetがyear／week codeの対応表を出していないためである。**`662K`は複数社が二次ソースする刻印であり、刻印単体では特定できない。決め手は2行目の`UMW`と、UMWが`662K`を自社の発注表に載せていることの組み合わせである。****供給能力**は次のとおりである。`IOUT(max)`は`VIN=VOUT(T)+1V`で**min 100 mA**、過電流保護`Ilimt`（**datasheetの表記のまま。`HW-TBD-023`の`LD1117`側は`Ilimit`と綴っており、資料が違う**）は**typ 380 mA**、短絡電流`Ishort`は**typ 30 mA**、絶対最大定格は`IOUT` **500 mA**と`PD`（SOT-23）**300 mW**である。**なお同datasheetは`1.Description`と`3.Features`で「`Vin=4.3V`／`Vout=3.3V`で`Iout=250mA`」と述べるが、`8.Electrical characteristics`は同じ条件で`IOUT(max)` min 100 mAしか規定していない。****保証値は100 mAであり、250 mAは本文の記述であって表の保証ではない。**矛盾を平均も統合もせず、両方を記録する（[AI Agent Policy](https://github.com/wachi-yoshitaka-11-dev/deskcat/blob/b7cb5290715eded3530c7626d92bef5df3361540/docs/governance/ai-agent-policy.md)）。**ただしLED個数と接続は確認できない。**パネル端がカプトンテープで覆われており、剥がすのは分解にあたるため目視では不能である。**`J1`がLDOのbypass選択かどうかもパターンを追っていないため断定しない。****`U1`の供給能力が判明しても、それだけではmoduleの上限は決まらない。**`U1`の3本足（入力／`GND`／出力）は2026-09-05の導通測定で識別できた。**`LED` pinは公式User Manual（LCDWIKI）が「backlight control signal」と定める制御信号線であり、`U1`のいずれの足とも非導通（測定結果と整合）である。**したがって`LED` pinの導通確認だけでは「backlightのLED列が`U1`の出力側にあるのか、`VCC`側（`U1`の上流）にあるのか」は決まらない。**実際にLEDへ給電しているライン(`R5`の先)を`VCC`・`U1`出力それぞれと比較する測定を試みたが、`R5`は部品が小さくプローブを確実に当てられず、`Q1`（トランジスタ）は接合の性質上、非通電の単純な抵抗測定では判定できないと判った**（詳細は[sensor-datasheet-notes.md](https://github.com/wachi-yoshitaka-11-dev/deskcat/blob/b7cb5290715eded3530c7626d92bef5df3361540/docs/hardware/sensor-datasheet-notes.md)のBacklight行、Revision 12）。**したがって、この経路は非通電の導通測定では確定できないと結論する。**`U1`のdatasheetで押さえられる上限（供給能力）がbacklight電流に適用できるかも、判定できないまま残る。`R5`／`R6`／`Q1`／`J1`を経た正確な経路（電流値そのもの）もパターンを追っておらず未確定のままである。なおLCD Wikiに現れる「0.31 W」はtypicalの消費であって**耐えられる上限ではないため、この行の答えにしない**。要件は[power-budget.md](https://github.com/wachi-yoshitaka-11-dev/deskcat/blob/b7cb5290715eded3530c7626d92bef5df3361540/docs/hardware/power-budget.md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段階b-2の測定)の`B-2b: 外部の3.3 V電源から給電する経路`の`実施前に満たす条件` | **段階B-2（B-2a／B-2bとも。`HW-TBD-025`の共通条件(b)の一部であるため）。加えて、段階B-2という測定行為に限らず、MSP2807の`VCC`をESP32の`3V3` pinへ接続するいかなる構成（単体bring-up含む）も妨げる**（2026-09-17明確化。[#422](https://github.com/wachi-yoshitaka-11-dev/deskcat/issues/422)）。MSP2807の定常電流の実測が段階Cまで進まない（**2026-09-12訂正。**旧文は「MSP2807の定常電流の実測と、そこから決まる`PSU-INGRESS-01`の選定が段階Cまで進まない」だった。**2026-09-09の案B決定により同品は5 V ingressの経路から外れ**（[hardware-bom.md](https://github.com/wachi-yoshitaka-11-dev/deskcat/blob/b7cb5290715eded3530c7626d92bef5df3361540/docs/hardware/hardware-bom.md)で`Not used`）、**この行が名指ししていた「そこから決まる選定」は対象を失った。**ingressは端子台でM-12001を受ける。**MSP2807の定常電流に従属する他の判断をこの訂正では棚卸ししていない**（`HW-TBD-021`の残条件は同行が持つ）。正は[power-budget.md](https://github.com/wachi-yoshitaka-11-dev/deskcat/blob/b7cb5290715eded3530c7626d92bef5df3361540/docs/hardware/power-budget.md)の`経路部品と定格`であり、**ここへ再掲しない**） | [#1](https://github.com/wachi-yoshitaka-11-dev/deskcat/issues/1)、[#3](https://github.com/wachi-yoshitaka-11-dev/deskcat/issues/3)、[#461](https://github.com/wachi-yoshitaka-11-dev/deskcat/issues/461) | Human | Open（**`U1`のメーカーと供給能力は2026-08-15に確定したが、moduleの上限は出ていない。**LDO経路の上限は資料で押さえた（絶対最大`IOUT` 500 mA、`PD` 300 mW、保証100 mA、過電流保護typ 380 mA）。**`U1`の3本足の識別は2026-09-05に完了した**（[sensor-datasheet-notes.md](https://github.com/wachi-yoshitaka-11-dev/deskcat/blob/b7cb5290715eded3530c7626d92bef5df3361540/docs/hardware/sensor-datasheet-notes.md)のBacklight行、Revision 12）。**backlightがこの経路を通るかは、`R5`・`Q1`を使った追加測定を試みたが、非通電の導通測定では判定できないと結論した。**LED個数は依然としてテープで隠れており、非分解では確認できない。****循環の扱いは2026-08-15に決めた。**datasheetと実測の二択のうち**datasheet側は尽きた。実測（非通電の導通測定）も、この経路については尽きた。**残るのはLED個数（分解を要するためこのIssueの範囲では埋まらない）と、この経路（通電を伴う測定でしか決まらない可能性がある）である。**したがってこの行は段階B-2を引き続きBlockedする。**（2026-09-17追記。**この行がBlockする対象は3点合算測定という行為に限らない。**MSP2807の`VCC`をESP32の`3V3` pinへ接続するいかなる構成（`LED` pinを能動制御せず3.3Vへ直結する単体bring-upを含む）にも及ぶ。[#409](https://github.com/wachi-yoshitaka-11-dev/deskcat/issues/409)は`LED` pin（backlight制御信号線）の配線に関する判定としては正しいが、`VCC`給電経路（backlightの実電流が通る経路）の懸念には答えていない。詳細は[#422](https://github.com/wachi-yoshitaka-11-dev/deskcat/issues/422)））。**2026-09-23追記（[#461](https://github.com/wachi-yoshitaka-11-dev/deskcat/issues/461)、ユーザー承認）。**この行が「MSP2807の`VCC`をESP32の`3V3` pinへ接続する構成そのもの」を一律に妨げるという扱いは、`DISP-01`をESP32の`3V3` pinへ通常接続すること（`LED` pinを3.3Vへ直結しbacklightが点灯する構成を含む。`ACCEL-01`／`ENV-01`が既に同じ`3V3` pinへ接続されている状態への追加を含む）については終了する。**この行が認める範囲はここまでである。**外部の電流制限つき電源から給電する構成（B-2b）と、周辺module3点を合算して定常電流を測る段階B-2は含まない。**この2つは下記のとおり引き続きBlockedのままである。上記の「上限が無いままではMSP2807へ給電できない」「MSP2807単体を`3V3` pinから`VCC`給電するbring-up…も、この行の対象である」、および2026-09-17追記の「MSP2807の`VCC`をESP32の`3V3` pinへ接続するいかなる構成（単体bring-up含む）も妨げる」は、この範囲について本追記が置き換える。**過去の判断の経緯として残し、書き換えない。**[power-budget.md](https://github.com/wachi-yoshitaka-11-dev/deskcat/blob/b7cb5290715eded3530c7626d92bef5df3361540/docs/hardware/power-budget.md)の同種の記述（`単体bring-upとB-2の区別`行、B-2a／B-2bの区別直前の段落、`B-2bを採る決定とMSP2807の電流制限`節の`#445`追記末尾）も同じ範囲で更新する。 **この解除は「MSP2807が耐えられる電流の上限」という、この行が問う値そのものには答えていない。**その上限は今も未公開のままであり、本追記もそれを確定させない。**`HW-TBD-025`(b)が求める「現物回路の確認」という手続きは、MSP2807について引き続き満たされていない。**同行が明記するとおり、「ここで判定しているのは電流の大きさではなく、この行が定める『現物回路の確認』という手続きが満たされたかどうかである」。電流の上界を計算しても、この手続き（backlight回路のLED個数・経路の特定。カプトンテープに隠れ非分解では未確認）自体は満たされない。**それでも、既知の部品（`R5`・`U1`）を通る経路については電流の上界を計算でき、この分析を判断材料の1つとして、ユーザーが残余risk（未知の経路の可能性、後述の熱の余裕の薄さ）を受け入れることとした。**これは`#445`がACCEL-01／ENV-01について行った判断（「これは判断であって証拠ではない」、本台帳の`HW-TBD-023`行）と同じ性質のものである。**上界の計算方法自体は、ACCEL-01（ADXL345）の判定（`#436`、上記`単体bring-upとB-2の区別`行のpull-up計算）が用いた、pull-up抵抗とrail電圧だけから電流の上界を出しIC内部構造には依存させない方法と同じである。**ただしADXL345の場合は`HW-TBD-025`(b)の手続き自体が別途（`#430`の板上部品の網羅的確認により）満たされており、pull-up計算は破損時の帰結を示す補足情報にすぎない。**MSP2807はこの手続き自体が満たされていない点で異なる。** MSP2807の`VCC`から引かれる電流は、少なくとも2つの別の負荷に分かれる。**(A) backlight枝**（`R5`・LED列・`Q1`）。**(B) ILI9341ロジック**（`3.3 V rail下限の設計判断`節が「`Iout`=50 mA相当の最悪ケース」として既に記録している値）。**どちらも、`VCC`に直結しているか`U1`の出力側にあるかは非通電測定では決まっていない**（本行の上記、および`3.3 V rail下限の設計判断`節）。**この節では通常動作（定常）と、`R5`の先が短絡する故障の2つの場合を分けて扱う。** **通常動作（定常）の場合。**電流はLCD Wikiの「0.31 W」を使う。**この値がbacklightだけの消費か、module全体（ロジック込み）の消費かはLCD Wiki側の記載から確認できていない。**したがって両方を計算する。(a) backlightだけの消費（3.3 Vで`0.31 ÷ 3.3 ≈ 93.9 mA`）なら、(B)の50 mAを別途足し、合計は`#445`の101.54 mA＋93.9 mA＋50 mA＝約245.4 mA。(b) module全体の消費なら、(B)を含むため足さず、合計は101.54 mA＋93.9 mA＝約195.4 mA。**(a)がbacklight単独の場合とロジックを足した場合の合計として大きいため、判定には保守側の(a)を使う。**(a)（約245.4 mA）で`U2`の連続定格1 A比の余裕は約4.1倍であり、`#445`の方法（`Vdrop`≈1.7 V、`Iq` max 10 mA、`Rθja` 88 ℃/W、ambient 40 ℃仮定）で熱余裕を計算すると、損失約0.467 W、温度上昇約41.1 ℃、`TJ`約81.1 ℃、`TSD`（typ 150 ℃）まで約68.9 ℃の余裕がある。(b)（約195.4 mA）ではさらに余裕が大きい（約5.1倍、`TSD`まで約76.4 ℃）。**保守側の(a)で見ても、通常動作については電流・熱のいずれも十分な余裕がある。** **`R5`の先が短絡する故障の場合。**rail電圧の上限3.366 V（`3.3 V railの許容電圧範囲`節、ADXL345の計算と同じ側を採用）を`R5`（6.8 Ω、本行が持つ刻印`6R8`の読み取り値。**測定値ではない**。[sensor-datasheet-notes.md](https://github.com/wachi-yoshitaka-11-dev/deskcat/blob/b7cb5290715eded3530c7626d92bef5df3361540/docs/hardware/sensor-datasheet-notes.md)のBacklight行、Revision 12が明記するとおり`R5`は部品が小さくプローブを確実に当てられず、非通電の導通測定でも信頼性が低いと判定されている。**公差は記録が無い。**上界495.0 mAは刻印の公称値によるものであり、公差の分だけ上下しうる。ADXL345の先例（pull-up計算）が公差下限を使えたのは、`01C`（EIA-96、10 kΩ、1%）と公差まで読めたためであり、`R5`は公差が読めていないため同じ扱いができない）で割ると、この枝の電流の上界は`3.366 V ÷ 6.8 Ω ≈ 495.0 mA`である。**`U1`を経由する場合でも、`U1`の出力電流はこの`R5`が縛る電流と同じものであり、別の電流として二重に数えない。**(B)は故障の影響を受けないと仮定し50 mAのまま足すと、この故障時の電流の上界は101.54＋495.0＋50.0＝**約646.5 mA**である。`U2`のIlimit（min 1.25 A）はこの電流では作動しない。**したがってこの場合に働きうる保護は熱shutdown（`TSD` typ 150 ℃）だけである。**`#445`と同じ熱計算の式をこの電流（定常的に流れ続けたと仮定した場合）に当てはめると、損失は約1.15 W、温度上昇は約101 ℃、`TJ`は約141 ℃となり、`TSD`まで約9 ℃しか余裕が無い。**`U2`の`TJ(max)`（絶対最大接合温度）は[UMW LD1117 datasheet](https://www.umw-ic.com/static/pdf/a5e0c99cefdefaf03cfa7777b369e45b.pdf)、`power-budget.md`、本行のいずれにも記録が無い。**141 ℃が`U2`にとって許容される温度かどうかは、正本のどこにも書かれていない。**したがって、電流制限が働かずthermal shutdownにも十分な余裕が無いという帯が実在する。**この計算は故障電流が熱的定常状態に達するまで持続することを仮定しているが、**実際に持続するかは別問題である。**`R5`の先が0 Vへ落ちる状態が実際に起きた場合、`R5`自身の消費電力は`I²R`で約1.67 W（0.495² × 6.8）となるが、`R5`のpackageと定格（刻印`6R8`と値6.8 Ω以外）は本行に記録が無く、`R5`自身が先に定格を超える可能性がある。**この場合に`R5`が開放故障して電流を止めるのか、`U2`が先に熱shutdownへ入るのか、あるいは`U2`が`TJ(max)`（記録が無い）を超えるのかは、いずれも断定しない。** **この帯に入るには`R5`の先が実際に短絡している必要がある。**これは、この行が元々問うていた「module内部の未確認回路」とは別の事象であり、[Hardware Safety Policy](https://github.com/wachi-yoshitaka-11-dev/deskcat/blob/b7cb5290715eded3530c7626d92bef5df3361540/docs/governance/hardware-safety-policy.md)の安全要件5項目のうち「短絡」に近い性質を持つ（`PROT-OC-01`・`HW-TBD-021`／`022`が扱う経路保護の対象であり、この行・この追記はそれらを変更しない）。**`ACCEL-01`（ADXL345）の故障電流の上界（pull-up 10 kΩから、1 line当たり約0.680 mA。上記`単体bring-upとB-2の区別`行）に比べ、`DISP-01`の故障電流の上界（495 mA）は桁が3つ大きい。**`DISP-01`にだけ故障時の熱計算を足したのは、moduleを差別する扱いではなく、`R5`の抵抗値が低く故障電流の上界がそれだけ大きいためである。**この帯（`PROT-OC-01`未実装のため経路に故障電流を制限する部品が1つも無い状態）自体は`DISP-01`が作るものではなく、`power-budget.md`が既に記録するとおりプロジェクト全体に開いている**（`#445`で承認済みの`ACCEL-01`／`ENV-01`も同じ帯の内側にあり、上界が小さいだけである）。**`DISP-01`を足すと、この帯が効く場所（backlight枝）が1つ増える。**「既存の穴だから問題ない」とは書かない。 **この上界の方法にも別の限定がある。**`VCC`から出る枝のうち(A)(B)以外に無いことは確認できていない。ADXL345・BME280の行にある「板上に実装済みの部品は網羅的に確認済み」という言明を、MSP2807のこの行は持たない。パネル端がカプトンテープに隠れ非分解では確認できないため（本行の上記）である。未知の経路があった場合の帰結は、`HW-TBD-023`(c)の`U2`保護（内蔵の電流制限・熱shutdown。module非依存、`#409`が受理し`#445`でACCEL-01／ENV-01への適用が承認された理由）により、上記と同じ帯（電流制限は働かず熱shutdownの余裕も不確か）に留まる。**ただしこの論法はESP32側の条件についてのものであり、`HW-TBD-025`(b)が求める負荷側の確認の代わりに使うものではない。** **新たな残余riskとして、(A)が`U1`の出力側にあった場合、`U1`は(A)と(B)の両方を通すことになる。**`U1`の保証出力`IOUT(max)`はmin 100 mAに過ぎず（本行の上記）、(A)にtypical値93.9 mAと(B)の50 mAを合わせた約144 mAでもこの保証値を超える。**帰結は通常動作の範囲では機能の失敗（backlightが暗くなる・LCDが正常に動かない）にとどまる可能性が高いが、`U1`自身のPD（絶対最大300 mW）を超える負荷条件までは検討していない。**この場合、`3.3 V rail下限の設計判断`節が定める下限3.234 Vの再導出を要する（同節のcaveatが既に明記している）。 **この行が求める「MSP2807が耐えられる電流の上限」自体、およびB-2b（電流制限つき外部3.3 V電源）が要求する「設定する電流制限値の上限」は、引き続き未解決のままである。**上界は「これを超えない」を示すだけであり、「いくつに設定すれば保護になるか」には答えない。段階B-2（3点合算測定）とB-2bの電流制限値決定は引き続きBlockedのままであり、この行はcloseしない。 **この解除は接続を許可するだけであり、実行手順を新設しない。**`ACCEL-01`／`ENV-01`単体bring-upの手順（[power-budget.md](https://github.com/wachi-yoshitaka-11-dev/deskcat/blob/b7cb5290715eded3530c7626d92bef5df3361540/docs/hardware/power-budget.md)の同名節）に相当する、`DISP-01`向けの通電手順はまだ存在しない。作成は`#13`が引き受ける。**2026-09-23追記（`#13`）。**上記の作成は完了した。[power-budget.md](https://github.com/wachi-yoshitaka-11-dev/deskcat/blob/b7cb5290715eded3530c7626d92bef5df3361540/docs/hardware/power-budget.md)の`DISP-01`追加接続のbring-upの手順（ESP32`3V3` pin給電、`#461`承認範囲）節が、この行が計算した電流上界（通常動作約245.4 mA、`R5`先短絡の故障時約646.5 mA）をそのまま前提として使う。この行が求める「MSP2807が耐えられる電流の上限」自体、および`HW-TBD-025`(b)（現物回路の確認）は、上記のとおり引き続き未解決のままである。 |

## HW-TBD-025

| ID | 優先度 | 不足している情報／判断 | 必要な根拠 | 妨げる対象 | 対応Issue | Owner | 状態 |
|---|---|---|---|---|---|---|---|
| HW-TBD-025 | P0 | **段階B-2の共通条件。給電経路によらず必要であり、B-2a／B-2bのどちらを選んでも省略できない。**(a) `3.3 V rail`の許容電圧範囲。周辺module3点が**moduleとして受け入れてよい電圧**の積集合とESP32のlogic levelから決める（**IC単体の動作範囲の積集合ではない**）。(b) 周辺module3点それぞれが耐えられる電流の上限。B-2bでは電源に設定する電流制限値の上限を決めるために、B-2aでは**board上regulatorの保護のtrip点がmoduleにとって安全かを判定する**ために要る。**datasheet調査は2026-08-12に完了した。3点とも絶対最大定格に電流の上限は記載が無く、公開値からは得られない。**残るのは現物回路の確認であり、それも得られないなら当該moduleへB-2で給電しない。**`HW-TBD-023`（B-2a）や`HW-TBD-024`（B-2b）が解決しても、この行が未解決ならB-2を実施できない** | (a)の材料は公開spec（[hardware-bom.md](https://github.com/wachi-yoshitaka-11-dev/deskcat/blob/b7cb5290715eded3530c7626d92bef5df3361540/docs/hardware/hardware-bom.md)の`DISP-01`／`ACCEL-01`／`ENV-01`の電源欄）と[gpio-assignment.md](https://github.com/wachi-yoshitaka-11-dev/deskcat/blob/b7cb5290715eded3530c7626d92bef5df3361540/docs/hardware/gpio-assignment.md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電圧domainすべての外部pull-upに適用)である。**ただし積集合を取る対象は各moduleが受け入れてよい電圧であって、IC単体の動作範囲ではない。****`ACCEL-01`分はこれが未確定である**（`moduleへ入れてよい電圧`は`HW-TBD-004`。ADXL345 ICの`VS` 2.0–3.6 Vからmodule boardの許容入力電圧は決まらない）。**したがって(a)は`HW-TBD-004`が解けるまで確定せず、「現物確認を待つ必要はない」とした旧記載は2026-08-12に撤回した。**`DISP-01`と`ENV-01`分はmodule boardの資料があるため先に置ける。**2026-08-12に、その2点とESP-WROOM-32D moduleから暫定値を置いた**（値の正は[power-budget.md](https://github.com/wachi-yoshitaka-11-dev/deskcat/blob/b7cb5290715eded3530c7626d92bef5df3361540/docs/hardware/power-budget.md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段階b-2の測定)の共通条件表の`許容電圧範囲`行であり、導出は同節の`3.3 V railの許容電圧範囲`。**ここへ再掲しない**）。**同時に、その暫定値の下限がそのままでは成立しないことが判明した。**下限がrailの公称値と同一で下振れの余裕が原理的に無く、さらに参照設計の`U2 = AMS1117-3.3`の出力がdatasheetの与える2行のどちらを採っても下限を割りうる（`HW-TBD-023`。**参照設計由来であり現物の事実ではない**。**2行の条件の違いはdatasheetに明記されていないため、広い方を採る**）。**`msp2807.pdf`はVCCについて`3.3V~5V`の一行しか持たず、下限が公称値か絶対最小値かを決められない。解釈で埋めない**（[AGENTS.md](https://github.com/wachi-yoshitaka-11-dev/deskcat/blob/b7cb5290715eded3530c7626d92bef5df3361540/AGENTS.md) 推測禁止）。**これは(a)そのものの中身であるため、別行を立てず(a)で追跡する。****両立させる経路は3つあり、いずれも人間の判断か現物確認を要する。****(1) MSP2807のmodule level資料に下限の性質を求める → 不可であることを2026-08-12に確認した。****(2) MSP2807のVCCを5 V railへ移す**（module specは3.3–5 Vを許す）**→ `DISP-01`の現物確認待ち**（logic IOが3.3 V TTLであり、5 V給電時に出力が5 VになればESP32のGPIOを壊す。level shiftの有無が未確認。`HW-TBD-002`）。**(3) 周辺module用に別途3.3 V regulatorを置き、設定点とtoleranceで下限を成立させる → 設計判断**（採る場合は[hardware-bom.md](https://github.com/wachi-yoshitaka-11-dev/deskcat/blob/b7cb5290715eded3530c7626d92bef5df3361540/docs/hardware/hardware-bom.md)の購入待ちリストへ部品が増える）。**経路(2)を採る場合、`module VCC 3.3–5 V`の範囲を確認しただけでこの行をcloseしない。**(2)は段階B-2の前提そのものを引き直す。[power-budget.md](https://github.com/wachi-yoshitaka-11-dev/deskcat/blob/b7cb5290715eded3530c7626d92bef5df3361540/docs/hardware/power-budget.md)は現在B-2を**周辺module3点を3.3 Vで測る**測定と定義しており、MSP2807だけ5 V railへ移すと**測定するrail、電流予算の割り付け、許容電圧範囲の積集合、logic levelの保護、decouplingの要否、B-2a／B-2bの依存関係のすべてが変わる。****closeの条件にはこれらの更新を含める**（詳細は[power-budget.md](https://github.com/wachi-yoshitaka-11-dev/deskcat/blob/b7cb5290715eded3530c7626d92bef5df3361540/docs/hardware/power-budget.md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段階b-2の測定)の`暫定値の下限は、そのままでは成立しない`節の経路表）。**(b)** は各moduleのdatasheetの絶対最大定格を当たる。**2026-08-12に当たった結果、ADXL345とBME280はいずれも絶対最大定格を公開しているが、電流の上限は記載が無い**（[ADXL345 Data Sheet](https://www.analog.com/media/en/technical-documentation/data-sheets/adxl345.pdf) Rev. G Table 2 page 5は電圧・加速度・温度・短絡持続時間のみ、[BME280 Data Sheet](https://www.bosch-sensortec.com/media/boschsensortec/downloads/datasheets/bst-bme280-ds002.pdf) Revision 1.24 Table 5 page 13は電圧・温度・圧力・ESDのみである）。**「あるはず」と仮定せずに確認した結果であり、無いことの確認も成果である。**したがって**MSP2807と同じ扱いが3点すべてに及ぶ**（現物回路の確認か、上限を得られないなら当該moduleへB-2で給電しない）。**MSP2807分は`HW-TBD-024`**。要件は[power-budget.md](https://github.com/wachi-yoshitaka-11-dev/deskcat/blob/b7cb5290715eded3530c7626d92bef5df3361540/docs/hardware/power-budget.md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段階b-2の測定)の共通条件表、確認項目は[hardware-bom.md](https://github.com/wachi-yoshitaka-11-dev/deskcat/blob/b7cb5290715eded3530c7626d92bef5df3361540/docs/hardware/hardware-bom.md)の部品受け入れchecklist | **段階B-2（B-2a／B-2bとも）** | [#3](https://github.com/wachi-yoshitaka-11-dev/deskcat/issues/3) | Human | Open（**(a)はBlocked。理由は2つあったが、2026-09-06に両方とも、確定したrail値（3.234–3.366 V）に関する限り解決した。****1つ目（`ACCEL-01`のmoduleとしての許容入力電圧が未確定で積集合を取れないこと）は、`HW-TBD-004`が一般論としては未解決のままだが、このrail値についてはICの`VS`動作範囲2.0–3.6 Vに両端とも余裕を持って入り、下側余裕は直列抵抗8.8 kΩ相当まで許容する（ADXL345のsupply current 140 µAに基づく評価であり、**typ値に基づく評価であってworst-caseの境界ではない**）ことを暫定の根拠に基づく設計判断として確定した**（値・根拠の正は[power-budget.md](https://github.com/wachi-yoshitaka-11-dev/deskcat/blob/b7cb5290715eded3530c7626d92bef5df3361540/docs/hardware/power-budget.md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段階b-2の測定)の`3.3 V railの許容電圧範囲`節`ACCEL-01`行の注記とRevision 89。**ここへ再掲しない。****`HW-TBD-004`自体はcloseしていない**。module一般としての受け入れ電圧範囲の確定はこの議論の範囲外である）。**2つ目（`DISP-01`と`ENV-01`から出る暫定値の下限そのものが成立しないこと）は、`HW-TBD-002`（2026-09-06close）が経路(2)を解かないことを確認したうえで、経路(1)〜(3)のいずれでもなく下限を3.234 V（`U2`のdatasheet値。**条件付きのdatasheet値であり無条件の保証値ではない**）で受け入れる設計判断により解決した**（値・根拠・caveatの正は[power-budget.md](https://github.com/wachi-yoshitaka-11-dev/deskcat/blob/b7cb5290715eded3530c7626d92bef5df3361540/docs/hardware/power-budget.md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段階b-2の測定)の`3.3 V rail下限の設計判断`節。**ここへ再掲しない**）。**この判断はILI9341のロジック単体負荷を前提としており、backlight電流が`U1`を経由すると`HW-TBD-024`で確定した場合は再導出を要する。****したがって(a)は、このrail値（3.234–3.366 V）に関する限り確定した。** **2026-09-08に訂正した。**この行はそれ以前、`U2`の3.234 Vを「保証最小出力」と呼び、ADXL345側の直列抵抗の余裕を「直列抵抗の値によらず結論が変わらないことを個別に確認した」と無条件の結論として書いていた（[PR #366](https://github.com/wachi-yoshitaka-11-dev/deskcat/pull/366)のCodeRabbit `full review`の指摘、[#367](https://github.com/wachi-yoshitaka-11-dev/deskcat/issues/367)）。**どちらも誤りだった。**`U2`の3.234 Vはdatasheetの条件（`IOUT = 10 mA`、`VIN = 5 V`、`TJ = 25 ℃`）付きの値であり無条件の保証値ではなく、ADXL345のsupply current 140 µAはtyp値でありworst-caseの境界ではない（datasheetにmax欄が無く、絶対最大定格にも電流の上限が無いことは(b)が既に確認している）。**上記の記述はこの訂正後の表現である。**結論（(a)はこのrail値に関する限り確定した）は変わらないが、根拠の性質（暫定の設計判断であり、worst-caseの確認済み境界ではない）を明示した。**2026-09-18追記（詳細は[#433](https://github.com/wachi-yoshitaka-11-dev/deskcat/issues/433)）。**(a)が求める「moduleとして受け入れてよい電圧」について、BME280（ENV-01）分は満たされたと判定する。[AE-BME280製品説明書](https://akizukidenshi.com/goodsaffix/AE-BME280_manu_v1.1.pdf)（v1.1、sha256`903c2e49064f279ff2738391ca6beb24a70a3d91a4e2118621381faef66a1e76`、`#430`で独立取得済み）の「◆主な仕様」に「電源電圧：DC1.71V～3.6V」がmodule board自体の仕様として明記されており、IC単体のdatasheet値ではない。ADXL345（ACCEL-01）分は、`HW-TBD-004`が未解決のため一般論としては引き続き未解決のまま残る（(a)の当初の判定「rail値に関する限り確定した」はICのVS動作範囲に基づくものであり、moduleとしての受け入れ電圧を別途要する。ADXL345のmodule上に他の部品が無いことが確認できれば同じ形で解決しうるが、現時点では確認できていない）。(b)のdatasheet調査は2026-08-12に完了し、**3点とも電流上限の公開値が無いことを確認した**。残るのは3点それぞれの現物回路の確認である。MSP2807分は`HW-TBD-024`。**2026-09-18追記（#422の検証を受けた判定、詳細は[#430](https://github.com/wachi-yoshitaka-11-dev/deskcat/issues/430)）。**この行が問うているのは「絶対最大定格に電流の上限記載が無いこと」自体ではなく、その先の「B-2aではboard上regulatorの保護のtrip点がmoduleにとって安全かを判定する」ことである。**代替手段として本行が定める「現物回路の確認」について、3点のうち2点は得られたと判定する。**(1) ADXL345（ACCEL-01）: 得られている。`HW-TBD-004`の現物確認（2026-08-13、斜光＋接写）により、板上の実装がIC本体＋decoupling capacitor(C1×2)＋pull-up抵抗（01C×4個、R2=0Ωジャンパ1個）のみで、regulator等の3端子部品が無いことを確認済み。(2) BME280（ENV-01）: 得られている。**出所はADXL345と異なり、現物確認ではなくメーカー公式の製品説明書による**（[AE-BME280製品説明書](https://akizukidenshi.com/goodsaffix/AE-BME280_manu_v1.1.pdf)、v1.1、秋月電子通商発行、sha256`903c2e49064f279ff2738391ca6beb24a70a3d91a4e2118621381faef66a1e76`、2026-09-18に独立取得）。同説明書は「◆回路図」（実際の回路図）と「◆部品表」を持ち、部品表には**「ピンヘッダ以外は、基板にすべて実装済みです」という網羅宣言**が付く。部品表の全内容はU1(BME280)・C1(0.1μF)・C2(0.1μF)・R1(4.7kΩ、I2C SDIプルアップ)・R2(4.7kΩ、I2C SCKプルアップ)・基板・ピンヘッダのみで、regulator・LED・トランジスタ等は無い。**この網羅宣言があるため「表に記載が無い」は「基板に存在しない」の観察であり、記載の不在からの推論ではない。**秋月電子通商は`AE-`moduleの発行元であり、この説明書は[Hardware Safety Policy](https://github.com/wachi-yoshitaka-11-dev/deskcat/blob/b7cb5290715eded3530c7626d92bef5df3361540/docs/governance/hardware-safety-policy.md)の「甲: メーカーの仕様書」に当たる（同policyが秋月`AE-`moduleを甲の例として明記している）。`hardware-bom.md`のENV-01行が残す「選択jumperの実装状態はTBD（現物確認要）」は、J1〜J3のうちどれが半田付けされているか（I2C/SPIのbus mode選択）という別の問いであり、この行が問う「隠れた追加回路の有無」とは無関係。(3) MSP2807（DISP-01）: 得られていない。backlight回路（`U1`・`R5`・`Q1`）がパネル端のカプトンテープに隠れ、非分解では現物確認できない（`HW-TBD-024`）。この行の「それも得られないなら当該moduleへB-2で給電しない」に該当し、この行はcloseしない。**注意: 「故障時の電流がICの消費電流の範囲にとどまる」とは書かない。**短絡故障時の電流は電源側（`U2`のIlimit、1.25〜1.6 A）が決めるのであり、IC自体の定常消費電流とは無関係である。ここで判定しているのは電流の大きさではなく、**この行が定める「現物回路の確認」という手続きが満たされたかどうか**である。**この判定は段階B-2（3点合算の定常電流測定）のgateそのものは開かない。**MSP2807分（この行）と`HW-TBD-024`（B-2b固有部分）がともに未解決のままであるため、B-2は引き続き実施できない**） |

## sensor文書の接続判断の旧記述

**2026-09-23追記（[#461](https://github.com/wachi-yoshitaka-11-dev/deskcat/issues/461)、ユーザー承認）。**`HW-TBD-024`（このmoduleが耐えられる電流の上限）は今も未公開のまま未解決だが、`LED` pinを3.3Vへ直結する構成（backlight点灯を含む）自体を一律に妨げる扱いは終了した。判断根拠・残る限定は[tbd-register HW-TBD-024](https://github.com/wachi-yoshitaka-11-dev/deskcat/blob/b7cb5290715eded3530c7626d92bef5df3361540/docs/hardware/tbd-register.md)を参照し、ここへ再掲しない
