wachi-yoshitaka-11-dev/deskcat/docs/hardware/power-budget-history.md

# Power Budgetの判断記録

> 履歴: #467の整理時に、develop `b7cb5290715eded3530c7626d92bef5df3361540` から移した記録。

古い状態・誤記・後続の訂正を含め、当時の本文を残している。現在の判断は[power-budget.md](power-budget.md)を読む。
本文中の相対リンクだけを元のbase SHAへの固定リンクにした。「本行」「上記」、行番号、節名は移動前の文脈を指す。
この記録へ現在状態や手動Revisionを追記せず、新しい判断は正本と既存Issue／PR・実験ログへ記録する。

## Revision履歴

| 日付 | Revision | 変更 | 根拠 |
|---|---|---|---|
| 2026-09-22 | 119 | [#454](https://github.com/wachi-yoshitaka-11-dev/deskcat/issues/454)。`5 V ingress`直前の文にあった「単一のACアダプターを入力源とし、複数のACアダプターを並列に用意する構成は採用しない」という制約を削除した。**過去のRevision行は書き換えない。**この制約は2026-08-05にユーザーが決定したもの（[hardware-bom.md](https://github.com/wachi-yoshitaka-11-dev/deskcat/blob/b7cb5290715eded3530c7626d92bef5df3361540/docs/hardware/hardware-bom.md) Revision 5）だが、2026-09-22にユーザーが自分の過去の決定を撤回した。削除した原文と経緯はこのRevision行と本文の注記に残す。現在の単一入力源構成（breadboard上のrail分岐とservo直近のbulk capacitorでrail分離する構成）自体は変えていない | ユーザー指示（2026-09-22） |
| 2026-09-08 | 93 | [#367](https://github.com/wachi-yoshitaka-11-dev/deskcat/issues/367)。[PR #366](https://github.com/wachi-yoshitaka-11-dev/deskcat/pull/366)（`develop`→`main`昇格）の`full review`でCodeRabbitが出した指摘のうち、この文書に関わる3件を直した。**過去のRevision行は書き換えない。**(1) **`3.234 V`を「保証最小出力」と呼ぶのをやめた。**datasheetがこの値に付けている条件（`IOUT = 10 mA`／`VIN = 5 V`／`TJ = 25 ℃`）は同文書の上表に自ら書いてあり、無条件の下限ではない。条件・確定させる手段（`#13`での実測）・`DISP-01`のmodule仕様下端を下回るため機能を保証しないことを明記した。**下限を3.234 Vとする設計判断そのものは維持する**（`hardware-safety-policy.md`の「供給電圧の動作の下限」に当たり安全要件5項目に該当しない。同policyが求める「値・暫定であること・確定させる手段」の記録を満たす形にした）。**この誤りはRevision 39が記録した型と同じである**（条件付きの値を無条件の判定基準として使う）。(2) **`ACCEL-01`の注記が、同節冒頭の「IC単体の動作範囲を代入しない」に反して読める点を直した。**規則が代入を禁じる理由はregulatorとlevel shiftであり、`ACCEL-01`はregulator非搭載が2026-08-13の現物確認で確定している（`HW-TBD-004`）。残る受動部品の電圧降下は下側余裕約1.234 Vが覆う。**規則の例外であって適用の省略ではないこと、この根拠を持たないmoduleへ広げないことを明記した。判断は撤回しない。**(3) **`HW-TBD-028`(a)の状態語を`対象外`へ統一した**（`恒久的にBlocked`が5箇所あった）。あわせて、Revision 88を反映していなかった古い記述を3箇所直した（`3.3 V railは確定しない`、`3.3 V rail側は閾値そのものが未確定`、`許容電圧範囲の下限が決まらないと不等式を評価できない`）。3箇所目は指摘の対象外だが、同じ型であり残すと不整合が戻るため直した | [PR #366](https://github.com/wachi-yoshitaka-11-dev/deskcat/pull/366)のCodeRabbit指摘、および引用先を開いたPMの検証 |
| 2026-07-27 | 0 | 初期architectureと測定計画を作成。部品値は引き続きTBD | — |
| 2026-08-05 | 1 | 単一入力源（秋月 M-12001、5V3A）＋breadboard上2rail分岐の構成に確定。負荷表にESP-WROOM-32D／Pi Zero W／ADXL345／BME280／SG90の文献値（実測前の参考値）を記載。Servo bulk capacitor候補（470μF50V×2〜3個）を記載。DISP-01(MSP2807)は未購入のため電流値Blockedのまま | `hardware-bom.md`のRevision履歴4〜6、ESP32／Raspberry Pi公式資料、各部品datasheet |
| 2026-08-05 | 2 | Oscilloscope未所持のため、測定手段をESP32＋shunt抵抗(セメント抵抗0.1Ω)によるADC loggingに変更。GitHub Issue #3の受け入れ条件も同様に修正（Oscilloscopeを必須から任意に変更） | ユーザーが測定機材を所持していないとの指摘 |
| 2026-08-05 | 3 | Servo rail bulk capacitorを、売り切れだった日本ケミコンLXJ 470μF50V(g107766)からルビコンWXA 470μF16V(g108426、¥10、在庫あり)へ変更 | ユーザーからの売り切れ報告 |
| 2026-08-05 | 4 | 自己レビューで検出: ADXL345(M-06724)とBME280は定格上限3.6Vのregulator非搭載moduleであり、Logic railの5Vへ直結すると定格超過となるため、ESP32 board上の3.3V出力(3V3 pin)から給電する構成に訂正（旧版はこの2部品も5V直結としていた）。typo「coost」を修正。Shunt抵抗のlinkをcategoryページから商品ページ(g117836)へ訂正。`gpio-assignment.md`の存在しないRef ID「LCD-01」を「DISP-01」に訂正。「ESP32board」の表記漏れspaceと「秋月M-」の表記揺れ（秋月 M-へ統一）を全fileで修正 | Akizuki M-06724商品情報、`hardware-bom.md`記載のBME280電源電圧(DC1.71～3.6V)、自己レビュー |
| 2026-08-05 | 5 | 自己レビューで検出: `の spike`の余分なspace、Revision4の記述誤り(発生していなかった修正を記載していた)を訂正。配線・保護表の状態列で和文「選定済み」を英語`Selected`に統一（`hardware-bom.md`の状態label語彙に合わせた）。このRevision履歴表の列数不整合（header 3列に対し追加行が4列）をheader側を4列（`根拠`列を追加、`hardware-bom.md`と同形式）に揃えて解消 | 自己レビュー |
| 2026-08-05 | 6 | 自己レビューで検出: 3V3 pinからのsensor給電について「余裕は十分にある」と根拠なく断定していたのを訂正。この基板の3V3 pin外部供給定格は`hardware-bom.md` MCU-01で未確認(TBD)であり、実測するまで構成の成立を確定としない旨に変更し、測定計画へ3V3 rail実測の項目を追加。合計電流の記述(1mA未満)が負荷表の上限値と矛盾していたため数mA未満に訂正 | `hardware-bom.md` MCU-01の「定格はTBD」記載、自己レビュー |
| 2026-08-05 | 7 | 自己レビューで検出: ESP32のADC入力上限(約3.3V)に関する制約が測定計画に欠落していた。shuntを高側に挿入するとESP32 ADCで測定できずpin破損riskがあるため、**低側(GND戻り経路)への挿入**を明記。5V rail電圧を観測する場合は分圧してからADCへ入れる旨と、共通GNDが前提である旨を追記 | ESP32のADC入力範囲、[servo-safety-limits](https://github.com/wachi-yoshitaka-11-dev/deskcat/blob/b7cb5290715eded3530c7626d92bef5df3361540/docs/hardware/servo-safety-limits.md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拘束stallと過負荷)の「低側shunt抵抗とESP32 ADC」記載、自己レビュー |
| 2026-08-05 | 8 | 自己レビューで検出: MSP2807をLogic 5V railへ接続する構成にしていたが、同moduleのlogic IOは3.3V TTLであり、5V給電時に出力が5VになるとESP32 GPIOを破損しうる。level shiftの有無はメーカー資料でも不明なため、安全側に倒して3.3V給電へ変更。あわせて、3V3 railの負荷にMSP2807(backlight込みで電流未確認)が加わったため、3V3 pinの供給能力を超える場合は別途3.3V regulatorを追加する旨を明記 | [LCD Wiki MSP2807](http://www.lcdwiki.com/2.8inch_SPI_Module_ILI9341_SKU:MSP2807)の「Logic IO port voltage: 3.3V(TTL)」記載、自己レビュー |
| 2026-08-05 | 9 | 自己レビューで検出: 容量計算で`ESP32 3V3出力` railを独立電源のように扱うと入力電源の容量を過小評価するため、3V3 railが5V railから作られている従属関係と、5V側の消費に含める旨を明記。あわせてrail構成図のtree枝記号の誤り（同階層に`└─`が2つ）と冗長行を修正し、「3系統合計」という不正確な表現を「3V3 railに接続する3moduleの合計」へ訂正 | 自己レビュー |
| 2026-08-05 | 10 | 自己レビューで検出: Revision 8でMSP2807を3.3V給電へ変更した際、配線・保護表の`Logic regulator／経路`行と測定計画の3V3実測項目が5V給電のままで、文書内に矛盾が残っていた。両者を3.3V給電（周辺module3点）に統一 | 自己レビュー |
| 2026-08-05 | 11 | レビュー指摘3件を反映。(a) M-12001はMicro-Bオスplugでbreadboardへ直接挿せないが、そこからrailまでの物理interfaceが未定義だったため`5 V ingress`節を新設し、必要な変換基板（未購入）、ESP32の3系統排他制約、Piの給電port分離を明記。あわせてMicro-B connector定格（約1.8 A）に対し文献値の最悪同時peakが2 Aを超えうる問題を記載し、実測または高定格connectorへの変更まで電源経路を承認しない旨をConnector定格行へ反映。(b) `数十kHz程度`のsample rateが115200 baud（実効約11.5 kB/s、16 bit連続で約5.7 kSample/s）では到達不能だったため、連続streamingを止めてburst capture＋事後dump方式へ変更し、必須要件1 kSample/s・目標5〜10 kSample/s・buffer長・log形式を規定。(c) 低側shuntの挿入位置とADCの基準nodeが未定義で、共通GNDだとservo電流がESP32のGND基準を動かす問題があったため、`GND topology`節を新設しstar point構成（shuntはservo戻り専用、ESP32 GNDはstar point直結）を図示。許容GND offsetと、topologyが取れない場合は測定しない旨も明記 | [PR #55レビュー](https://github.com/wachi-yoshitaka-11-dev/deskcat/pull/55)、Raspberry Pi Zero W公式回路（PWR INはdata線未接続）、Espressif ESP32-DevKitC V4文書（電源3系統は排他）、115200 8N1の実効throughput |
| 2026-08-05 | 12 | 自己レビューで検出: Revision 11で追加した`5 V ingress`節が、ESP32を`5V` pinから給電すると書きながら、同じ節で「USB接続と5V pin給電の同時使用を承認しない」とも書いており矛盾していた。Pi linkがUSB serialである以上、Pi接続時点でVBUSは通電するため、この2つは両立しない。`ESP32の給電経路（未決定）`節を新設して案A（USB VBUS単独給電、既定候補）と案B（`5V` pin給電）を並べ、未決定であることを明示。rail構成図、配線・保護表の2行、測定計画も同じ状態へ揃えた。あわせて0.1Ω shuntの低電流側の精度限界（実用域は約1 A以上）を測定計画へ追記し、`受け入れ条件`への記載を「記載する」から「記載している」へ訂正 | 自己レビュー、Espressif ESP32-DevKitC V4文書（電源3系統は排他）、ESP32 ADCの入力直線性 |
| 2026-08-05 | 13 | 自己レビューで検出: `Sample rateとlog形式`表が、ADC sample rateの確定を`HW-TBD-014`と対にすると書いていたが、`HW-TBD-014`はPi linkのbaudと最大line長であり測定treatmentのsample rateとは別物である。誤った対応付けを削除し、dumpに使うbaudは測定用に別途選んでよい旨へ訂正。`GND topology`の図が枝の接続関係を読み取りにくかったため描き直した。`tbd-register.md`側では、BOMで識別済みの`HW-TBD-015`（microSD）と`HW-TBD-016`（color sensor）が識別情報を未反映のまま残っていたため、確定部分と残作業を書き分けた | 自己レビュー、[tbd-register.md](https://github.com/wachi-yoshitaka-11-dev/deskcat/blob/b7cb5290715eded3530c7626d92bef5df3361540/docs/hardware/tbd-register.md)、[hardware-bom.md](https://github.com/wachi-yoshitaka-11-dev/deskcat/blob/b7cb5290715eded3530c7626d92bef5df3361540/docs/hardware/hardware-bom.md) SD-01／COLOR-01 |
| 2026-08-05 | 14 | レビュー指摘1件を反映。Revision 13で「dumpに使うbaudは測定用に別途選んでよい」と書いたのは誤りだった。Pi–ESP32間のUSB serialは1本しかなく、Protocolがそのbaudを共有transport parameterとして持つため、片側だけ別baudにはできない。dumpは`HW-TBD-014`／`PROTO-TBD-001`が決めるbaudをそのまま使うことにし、baudを変える場合はProtocol側と揃えて決定を変える扱いとした。あわせて、生CSVをJSON Lines channelへ流すとProtocolの「送信するすべてのbyteは有効にframe化されたmessageの一部でなければならない」要件に反するため、CSV出力はProtocolが動作していない専用の測定modeに限る条件を明記した | [PR #55レビュー](https://github.com/wachi-yoshitaka-11-dev/deskcat/pull/55)、[protocol](https://github.com/wachi-yoshitaka-11-dev/deskcat/blob/b7cb5290715eded3530c7626d92bef5df3361540/docs/protocol/esp32-pi-protocol.md)§2のtransport表とframing要件 |
| 2026-08-08 | 15 | 5 V ingressの記述が「変換基板が無いと配線を開始できない」と過大だったため、段階表を追加して訂正した。bring-up前半はM-12001をPiの`PWR IN`へ直挿しし、Piの5 V GPIO pinからbreadboard railを作れば**追加購入なしで通電できる**（logic側のみ、servoは繋がない）。servo試験の直前に変換基板構成へ移す。候補変換基板（秋月 g110972）の定格が1ピン1.5 Aと、記載していた「Micro-B一般定格 約1.8 A」より低いことも反映した。購入は前半の実測後で足り、実電流に基づいて品を選べる | ユーザーからの指摘（購入済み5点にingress部品が含まれていない）、[秋月 g110972](https://akizukidenshi.com/catalog/g/g110972/)の定格、Raspberry Pi Zero W公式回路（PWR INと5 V GPIO pinは直結） |
| 2026-08-08 | 16 | レビュー指摘2件を反映。(a) Pi直挿しmodeを「文献値で合計0.5 A程度」と正当化していたが、これは根拠が無い。ESP32のspikeだけで約500 mA、Pi stressで約350 mA、MSP2807は未確認であり、文献値だけでも瞬時に0.85 Aを超えうる。`Pi直挿しmodeの電流gate`節を新設し、実測合計**1.0 Aを上限**として超えたら直ちに中止する条件、その1.0 AをMicro-B定格約1.8 Aに対する約1.8倍の余裕として選んだdesign marginの根拠、および段階的に負荷を足しながら測る手順を定めた。配線・保護表の`Piの5 V入力経路`行、測定計画の`サーボ接続前`、`受け入れ条件`の数値表にも同じgateを反映した。(b) Revision履歴で2026-08-08の行が古い行より前に挿入されていたため日付順へ並べ直した | [PR #57レビュー](https://github.com/wachi-yoshitaka-11-dev/deskcat/pull/57)、負荷表の文献値 |
| 2026-08-09 | 17 | 昇格PR [#61](https://github.com/wachi-yoshitaka-11-dev/deskcat/pull/61)のレビュー指摘4件を反映。(a) **ESP32給電の循環論法を解消。**「案A/Bが確定するまで通電しない」と書きながら、案を決める実測には通電が要る状態だった。通電可否を「案の確定」ではなく「どの経路で通電するか」で決める方式へ変更し、案Aの単一経路・電流制限・監視付きに限ったbring-upを許可した。案Bは秋月基板のVBUS保護diode確認まで通電しない。(b) **1.0 A gateの測定手段が無かった。**servo rail低側shuntはlogic側を通さず、テスターは過渡peakを取り逃がす。定常値と過渡peakで手段を分け、logic側の測定点が未確定であること、確定までgateは定常値しか保証しないことを明記した。(c) ingress上限を「Micro-B一般定格 約1.8 A」から**経路上の最弱部品の定格**（候補構成では変換基板の1ピン1.5 A）へ変更。1.5〜1.8 Aの測定値が合格になる穴を塞いだ。(d) sample rateが必須要件に届かない場合の対処から「buffer長の短縮」を削除。buffer長は時間分解能を改善しないため、ADC改善・要件の見直し・測定手段の追加のいずれかを取ることにした。あわせて見出し階層の飛び（MD001）を修正 | [PR #61レビュー](https://github.com/wachi-yoshitaka-11-dev/deskcat/pull/61) |
| 2026-08-09 | 18 | [PR #64](https://github.com/wachi-yoshitaka-11-dev/deskcat/pull/64)のレビュー指摘3件を反映。(a) **測れないgateを廃止した。**「Pi直挿しで合成給電し、合計1.0 Aを超えたら中止」としていたが、M-12001はMicro-Bオスplugの直結cableでアダプターとPiの間に測定器を挿入できず、**そのgateを測る手段が無かった**。段階をA（Pi単体起動）／B（ESP32をPCのUSBから給電）／C（合成給電）に分け、AとBはgate不要な通常の使い方、Cは変換基板の到着後とした。これにより「追加購入なしで合成給電できる」という前提が誤りだったことも訂正している。(b) 案Aの「電流制限」が未定義だったため、経路ごとに制限を明示した。段階BはPC hostのUSB port OCP、案AはPiのUSB OTG port供給能力（未確認、ingressで実測）、案Bはingress上限。(c) 「十分な余裕」が曖昧だったため、**最弱部品定格の80%**という数値のderatingを定めた（候補構成で1.2 A）。80%とする理由（servo peakの負荷依存、ADC loggingの取りこぼし、接触抵抗）も記載した。あわせて節名を`connector定格の制約`から`ingressの電流制限`へ変更し、配線・保護表・測定計画・受け入れ条件を揃えた | [PR #64レビュー](https://github.com/wachi-yoshitaka-11-dev/deskcat/pull/64) |
| 2026-08-09 | 19 | [PR #64](https://github.com/wachi-yoshitaka-11-dev/deskcat/pull/64)のレビュー指摘を反映。ingress低側shuntをESP32 ADCで測る案が**電気的に成立しない**と判明した。star pointを基準にするとadapter return側は`I × R`だけ負の電位になり、ESP32のADCでは測れない。high-side current sense IC（例: INA219、秋月で¥2,300）で解決できるが、**そもそもpeakで判定する必要が無い**ため部品を追加しない。connectorとtraceの電流定格は`I²R`発熱と放熱の釣り合いで決まる熱の制限であり、時定数は秒から分のorderで、µs〜msのspikeは発熱にほとんど寄与しない。判定量を**定常値（テスター直列）**へ改め、peakによる電圧降下は既存の`ADC-5V`／`ADC-3V3`で捉えることにした。測定計画と受け入れ条件も揃えた | [PR #64レビュー](https://github.com/wachi-yoshitaka-11-dev/deskcat/pull/64)、connector定格の熱的性質 |
| 2026-08-09 | 20 | [PR #64](https://github.com/wachi-yoshitaka-11-dev/deskcat/pull/64)のレビュー指摘を反映。Revision 19で判定量を定常電流へ改めたが、「実測でservoを含む同時**peak**が80%以下に収まることを示す」という要件が残っており矛盾していた。測定不要としたpeakが、合成給電の許可と部品選定を阻む状態だった。判定を定常電流に統一し、peakは電圧droop・brownout・resetの判定にのみ使う旨を明記した。あわせて`変換基板に必要な定格の見積もり`節を追加し、定常電流はbranchごとに測って足せること（peakと違い時間的重なりを仮定しなくてよい）、ESP32＋LCD＋sensorのbranchは段階Bで測れることを示した。これで変換基板の品をingressの実測を待たずに選べる | [PR #64レビュー](https://github.com/wachi-yoshitaka-11-dev/deskcat/pull/64) |
| 2026-08-09 | 21 | [PR #64](https://github.com/wachi-yoshitaka-11-dev/deskcat/pull/64)のレビュー指摘を反映。`変換基板に必要な定格の見積もり`が、servo branchの測定を段階C（変換基板が要る）に限定しており、**購入前に見積もれるという主張と循環していた**。実測できるbranchと、できないbranchを分けた。servoは供給経路がingressしかなく実測できないため、連続動作時の上限として広く示される250 mAを**割り当て予算**として置き、実機がこれを超えないことは`servo-safety-limits.md`のtrajectory制限で担保することにした。stall電流は採らない（connector定格は熱の制限のため）。これで未知数はMSP2807の1つだけになり、段階Bの実測で合計が確定する。足す値が「同時に継続しうる動作条件での定常電流」であることも明記した | [PR #64レビュー](https://github.com/wachi-yoshitaka-11-dev/deskcat/pull/64)、SG90の連続動作電流の一般値 |
| 2026-08-09 | 22 | [PR #64](https://github.com/wachi-yoshitaka-11-dev/deskcat/pull/64)のレビュー指摘を反映。配線・保護表の`Wire gauge／許容電流`が要件を`Peak電流と長さ`としており、判定量を定常電流とした現行規則に反していた。許容電流（ampacity）も導体の発熱と放熱で決まる熱の制限であるため、定常電流と配線長による判定へ改め、peakは配線長による電圧降下としてdroop測定で見ることにした。**前回「全hardware文書を走査した」と記録したが、grepのパターンが狭く（`同時peak`と`Peak電流から`のみ）この行を拾えていなかった。**今回は`peak`の全出現29件を列挙して1件ずつ判定した。`入力電源`行のpeak電流はAC adapterの過渡供給能力を指すもので、熱定格の話ではないため残す | [PR #64レビュー](https://github.com/wachi-yoshitaka-11-dev/deskcat/pull/64) |
| 2026-08-09 | 23 | [#65](https://github.com/wachi-yoshitaka-11-dev/deskcat/issues/65)で[PR #64](https://github.com/wachi-yoshitaka-11-dev/deskcat/pull/64)のレビュー指摘5件を解消。(a) **過電流保護が`TBD`のまま「超えたら人が止める」運用になっていた。**M-12001は3 Aを供給でき、テスターの読みと手動停止では最弱部品が発熱する前に電流を止められない。`過電流保護（段階Cのgate）`節を新設し、挿入位置・選定基準・上限との関係（循環にしない導出順序）を定め、**保護部品の選定と実装を段階Cのgate**とした。(b) **1.2 Aの根拠が変換基板の1ピン1.5 Aだけで、「最弱部品の80%」を名乗れていなかった。**`経路部品と定格`表を新設し、往路・GND戻り・cable・保護部品まで並べて未確定を明示した。上限は`1.2 A以下`であって確定値ではないと改めた。あわせて**gate対象の大電流経路をbreadboard接点とジャンパー線で構成しない**ことを決めた（許容電流がメーカー資料で確認できず、経路の最小定格が原理的に出せないため。保守的な仮定を置く案は`AGENTS.md`の推測禁止に反するため採らない）。(c) **段階Cの説明にPiの5V GPIOからの合成給電が残存**しており、同節の`分岐点`行および`hardware-bom.md`のPi GPIO配電禁止と矛盾していた。変換基板→breadboard rail経由へ訂正した。(d) **段階BがESP32単体と定義されているのに、MSP2807の未知数を段階Bで解消する前提になっていた。**段階BをB-1（ESP32単体）とB-2（周辺module3点を`3V3` pinから給電し3.3 V側の定常電流を測る）に分け、5 V側への換算にはboard上regulatorの種別確認が要ることを明記した。(e) **受け入れ条件の前置きが「数値制限は引き続き`TBD`」なのに同じ節で1.2 Aを確定値として載せていた。**前置きを未確定の項目に限定し、確定しているのは規則であって数値ではないことを書き分けた。参照先の無い`上行に同じ`も解消した | [PR #64レビュー](https://github.com/wachi-yoshitaka-11-dev/deskcat/pull/64)、[#65](https://github.com/wachi-yoshitaka-11-dev/deskcat/issues/65) |
| 2026-08-09 | 24 | Revision 23に対する[PR #64](https://github.com/wachi-yoshitaka-11-dev/deskcat/pull/64)のレビュー指摘4件を反映。(a) **経路表がM-12001の出力から始まっており、M-12001に直付けされたcable・Micro-Bオスplug・嵌合接点の定格が抜けていた。**メーカーは出力定格3 Aを示すがcable導体とplug接点の個別定格は示していないため、2行を追加して`未確定`とした。(b) **`WIRE-PWR-01`の許容電流を「ingressの上限が決まってから確定する」としており、上限がその定格から出る以上、循環していた。**`選定順序（循環にしない）`節を新設し、負荷側の想定定常電流の合計→線材→保護部品→gate値という一方向の順序と、各手順の入力を明示した。手順4の結果を手順2や3の入力に使わない旨も書いた。(c) **段階B-2の実施条件が「PC hostのOCPが効く」だけで、trip値を一般値で仮定していた。**使用するhost portとその公表供給能力の記録、計画上の上限、上限と比べる量（テスターは3.3 V branchしか通らないため合計はESP32自身の消費を足して見積もる）、停止条件、停止手順、上限に達した場合の扱いを定めた。段階B-1も同じ記録の対象とした。(d) **servoの250 mA予算を「ingressの定格を上げる」ことで回避できる書き方になっていた。**予算はservoの動作制限へ渡した値であり経路側の定格とは別の量であるため、既定の対処は制限を締めることとし、予算そのものを変える場合の正式改訂の手順（両文書を同時に改訂し、選定順序をやり直し、受け入れchecklistを通し直す）を定めた。あわせて自己レビューで、末尾の「選定後の実測で見積もりを超えていた場合は、その時点で定格を見直す」も同じ緩め方を許す書き方だったため、branchごとの扱い（servoは正式改訂、それ以外は見積もりを実測値へ改めて選定順序を手順1からやり直す）へ書き分け、**実測値に合わせてgate値だけを引き上げる直し方はしない**と明記した | [PR #64レビュー](https://github.com/wachi-yoshitaka-11-dev/deskcat/pull/64) |
| 2026-08-09 | 25 | `/review`と反復自己レビューで検出した8件を修正。**いずれも「同じ規則が2箇所以上にあり、片方しか直っていない」型である。**(a) 段階Cのgateに過電流保護部品と大電流経路の線材を加えたのに、`案Aと案B`の記述、`変換基板に必要な定格の見積もり`の冒頭、`サーボ接続前`の前置き、段階C行の判定文、`配線・保護表`の`5 V ingress interface`行が「変換基板が到着するまで」「servo試験までに」のままだった。すべてgateの全体へ揃えた。節見出しも`合成給電を変換基板の到着まで行わない理由`から`合成給電を部品が揃うまで行わない理由`へ改めた。(b) B-2の実施条件を「hostのtrip値を一般値で仮定しない」へ改めたのに、B-1行と`経路`表が「多くのhostは1 A前後でtripする」を実施根拠に使ったままだった。B-1も記録の対象へ揃えた。(c) `servo試験以降で用いる構成`を節名のようにcode spanで参照していたが、そのような見出しは存在しなかった。位置の説明へ改めた。(d) **CodeRabbitの指摘に応えて追加したM-12001側の2行が、解消不能なgateになっていた。**メーカーが個別定格を示さない以上`未確定`のままとなり、「`経路部品と定格`表に未確定の行を残さない」というgateを永久に満たせない。直付けcableとplugはM-12001と同一製品であり、メーカーが5 V／3 Aの製品として販売している以上その出力定格に含まれるものとして扱い、嵌合接点はreceptacle側（変換基板1ピン1.5 A）で決まるとした。**別途購入するcableにはこの論法を適用しない**旨も明記した。(e) `CABLE-PI-PWR-01`と`CABLE-PI-LINK-01`（案Aでは給電経路を兼ねる）に、導体の許容電流が公開されている品を選ぶ規則が無かった。`WIRE-PWR-01`と同じ規則へ揃えた。(f) 段階B-2が5 V側への換算根拠にregulatorの種別確認を要求していたが、指し示した`hardware-bom.md`の受け入れchecklistにその項目が無かった。項目を新設した。(g) `容量計算`が電力で議論しているのに対し、段階B-2は電流で換算する。両者を結び、種別が確定するまでどちらの式も使わない旨を書いた | `/review`、自己レビュー（新規指摘0件が2 round続くまで反復） |
| 2026-08-09 | 26 | `0441f10`に対する[PR #64](https://github.com/wachi-yoshitaka-11-dev/deskcat/pull/64)のレビュー指摘3件を反映。**3件とも、段階Cについて直したはずの誤りを段階B-2で作り直していた。**(a) **`3V3` branchに保護が無かった。**B-2は周辺module3点をESP32の`3V3` pinから給電するが、gateをPC hostのUSB OCPに置いていた。**OCPはUSB入力を制限するだけで`3V3` branchを守らず、先に壊れうるのはboard上のregulatorである。**しかも`3V3` pinの外部供給可能電流の定格は`TBD`のままだった。B-2のgateを`3V3`側へ移し、定格の確認を実施条件、その80%を上限、超過を停止条件とした。**定格を確認できない場合はB-2を行わず**、外部の電流制限付き3.3 V電源を使うか段階Cまで延ばす代替を定めた。(b) **公表供給能力をOCPのtrip値として扱っていた。**公表値は能力値であって保護の動作しきい値ではない。hostのOCP特性は未確認であり保護として当てにしない旨と、**USB cableを抜くのは停止手順であって保護機構ではない**旨を明記した。あわせてB-1は「board上のUSB portをメーカーが意図した用途で使うだけ」（段階Aと同じ通常の使い方）としてgate不要へ戻した。**B-2だけが追加購入なしでもgateを要する**理由も書いた。(c) **保護部品の受け入れが「品番とtrip値の記録」だけだった。**「何Aで切れるか」だけでは最弱部品の熱定格を超える前に止まるか判定できない。`記録するtrip動作`節を新設し、定常電流継続時の動作・trip電流・trip時間・3 Aでの遮断時間・確認方法（一次資料か電流制限付き電源での実測か）の5項目を記録するまでgateを通さないことにした | [PR #64レビュー](https://github.com/wachi-yoshitaka-11-dev/deskcat/pull/64) |
| 2026-08-09 | 27 | Revision 26に対する[PR #64](https://github.com/wachi-yoshitaka-11-dev/deskcat/pull/64)のthread返信で残った2件を反映。**同じ誤りの3回目である。**Revision 26でB-2のgateを`3V3`側へ移したが、置いたのは**通常動作の上限**（電流定格の80%）だけで、(a) 許容電圧範囲とその停止条件が無く、(b) **短絡・配線ミス時の電流を制限する手段が無かった**。人による監視を保護の代わりに置いており、これは段階Cについて`過電流保護（段階Cのgate）`で否定したものと同じ構造である。実施前に確定させる項目へ`3V3` railの許容電圧範囲（周辺module3点の動作電圧範囲の積集合とESP32のlogic levelから決める）を加え、停止条件を電流・電圧・その他の3つに分けた。**下限割れはregulatorが電流を出しきれていない兆候であり、電流計の読みが上限内でも中止する**ことも書いた。さらに`通常動作の上限は保護ではない`項を新設し、**故障電流を制限する手段（board上regulatorの過電流／短絡保護を一次資料か現物回路で確認する、または電流制限値を設定できる外部3.3 V電源から給電する）のどちらかが成立するまでB-2を実施しない**ことにした。どちらも成立しない場合はMSP2807の実測を段階Cまで延ばす | [PR #64レビュー](https://github.com/wachi-yoshitaka-11-dev/deskcat/pull/64) |
| 2026-08-09 | 28 | Revision 27に対する[PR #64](https://github.com/wachi-yoshitaka-11-dev/deskcat/pull/64)のthread返信で残った1件を反映。`通常動作の上限は保護ではない`項を新設したにもかかわらず、`PC host側の扱い`に「保護は上記の`3V3`側の上限と、人による監視で担保する」が残っており、**同じ節の中で矛盾していた**。保護を担うのは確認済みのboard上regulatorの過電流／短絡保護か、電流制限値を設定した外部3.3 V電源のどちらかであり、`3V3`側の上限も人による監視も保護ではない、と書き直した | [PR #64レビュー](https://github.com/wachi-yoshitaka-11-dev/deskcat/pull/64) |
| 2026-08-09 | 29 | 昇格PR[#61](https://github.com/wachi-yoshitaka-11-dev/deskcat/pull/61)のレビュー指摘を反映。Revision 27でB-2の代替として外部3.3 V電源からの給電を挙げたが、**gateと停止条件を`3V3` pin経路のぶんしか書いていなかった。**外部電源経路には電流制限値の上限も、測定点も、停止条件も無く、代替として成立していなかった。B-2を**B-2a（`3V3` pinから給電）**と**B-2b（外部の3.3 V電源から給電）**に分け、経路ごとに実施条件・測定点・電流上限・停止条件を定めた。**片方の条件をもう片方へ流用しない**ことも明記した。B-2bでは`3V3` pinの定格もregulatorの保護も条件にならず、**電源に設定した電流制限が唯一の保護**になるため、設定値の決め方（低い値から段階的に上げ、制限が働いている間の読みを定常電流として採用しない）と上限（判明している中で最も低い定格。**MSP2807の定格は未公開のため根拠にできない**）、GNDをESP32と共通化すること、`3V3` pinと同時に繋がないことを定めた | [PR #61レビュー](https://github.com/wachi-yoshitaka-11-dev/deskcat/pull/61) |
| 2026-08-09 | 30 | [PR #66](https://github.com/wachi-yoshitaka-11-dev/deskcat/pull/66)のレビュー指摘を反映。Revision 29でB-2をB-2a／B-2bに分けたが、**B-2b側の保護gateが未完成だった**。(a) **電流制限値の上限をMSP2807を除いた「判明している中で最も低い定格」から導いており、MSP2807の安全な故障電流を超えうる状態だった。**周辺module3点それぞれに安全な電流上限を持つことを実施条件とし、**MSP2807は定格未公開のため現状は上限が無く、得られない限りB-2bで給電しない**ことを明記した。(b) **設定値の表示は「その値で電流を制限する」ことの証明ではない。**module接続前に既知の負荷で制限動作を確認することを実施条件へ加えた。(c) **電流制限は出力電圧の誤りを防がない。**module接続前に無負荷出力電圧が許容範囲内であることを確認する条件を加えた。(d) **B-2bの電流はboard上regulatorを通らない**ため、`3V3` pinの供給能力・regulatorの保護・5 V側への換算のいずれも言えない。`B-2bの結果で言えないこと`を新設し、**測定結果にどちらの経路で得たかを必ず記録する**ことにした。5 V側へ足せるのはB-2aで得た値だけである。(e) 段階表のB-2行が「`3V3` pinから給電」のままだったため、選んだ経路を指す記述へ改めた | [PR #66レビュー](https://github.com/wachi-yoshitaka-11-dev/deskcat/pull/66) |
| 2026-08-09 | 31 | 昇格PR[#61](https://github.com/wachi-yoshitaka-11-dev/deskcat/pull/61)のレビュー指摘（Minor）を反映。Revision 29〜30でB-2をB-2a／B-2bに分けたが、**分割より前に置かれた共通の説明文2箇所が`3V3` pin前提のままだった。**段階表直後の「B-2だけはgateが要る」の段落が「`3V3` pinから外部負荷を取るため、`3V3` pinの電流定格と許容電圧範囲を確認し」としており、`3V3` pinを使わないB-2bには当てはまらなかった。`段階B-2の測定`の導入文も「周辺module3点は…`3V3` pinから給電するため、テスターを`3V3` pinと周辺moduleのrailの間へ」と読め、同じ問題があった。前者はgateの中身を経路別に列挙する形へ、後者は「給電元は`3V3` pinとは限らない」と明示して測定点も経路ごとに違うと書く形へ改めた | [PR #61レビュー](https://github.com/wachi-yoshitaka-11-dev/deskcat/pull/61) |
| 2026-08-09 | 32 | [#3](https://github.com/wachi-yoshitaka-11-dev/deskcat/issues/3)。段階B-2のgateを[TBD台帳](https://github.com/wachi-yoshitaka-11-dev/deskcat/blob/b7cb5290715eded3530c7626d92bef5df3361540/docs/hardware/tbd-register.md)へ登録（`HW-TBD-023`／`024`）したのに合わせ、**この文書側からも台帳を辿れるようにした。**`HW-TBD-021`（過電流保護）と`HW-TBD-022`（大電流経路の線材）は正本側に「追跡は〜」の1文があるのに、B-2のgateだけ台帳→正本の片方向で、B-2a／B-2bの実施条件を読んだ人が台帳のどの項目かを辿れなかった | 自己レビュー |
| 2026-08-09 | 33 | 昇格PR[#61](https://github.com/wachi-yoshitaka-11-dev/deskcat/pull/61)のレビュー指摘（Minor）を反映。**B-2の共通条件が台帳に登録されておらず、`HW-TBD-023`／`024`が解決しても許容電圧範囲が未確定のままB-2を進められる状態だった。**`HW-TBD-025`を追加し、共通条件表の直後から参照させた。あわせて**この文書とhardware-bom.mdの間にあった不整合を直した。**「周辺module3点それぞれの安全な電流上限」を、この文書はB-2b専用としていたが、`hardware-bom.md`の受け入れchecklistは共通条件としていた。**論理的には共通である**（B-2aでもboard上regulatorの保護のtrip点がmoduleにとって安全かを、module側の上限が無ければ判定できない）。`AGENTS.md`の「矛盾する場合はより安全で厳しい規則を適用する」に従い共通条件へ移した。**その帰結として、MSP2807の上限が未確定である限りB-2aも実施できない** | [PR #61レビュー](https://github.com/wachi-yoshitaka-11-dev/deskcat/pull/61) |
| 2026-08-09 | 34 | 昇格PR[#61](https://github.com/wachi-yoshitaka-11-dev/deskcat/pull/61)のfull reviewの指摘を反映。**保護部品の選定条件が方式別に分かれていなかった。**`PROT-OC-01`を「PTCまたはガラス管ヒューズ」としながら、判定条件はPTCの用語（保持電流・trip電流・trip時間）だけで書いており、**ヒューズを選ぶ場合に何を見ればよいか定まらなかった。**ヒューズは定格電流・時間-電流特性・遮断定格（breaking capacity）・`I²t`が公開量である。`選定基準`を「先に方式を決める」＋`方式によらない基準`へ再構成し、`記録するtrip動作`をPTC列とヒューズ列に分けた。あわせて`経路部品と定格`表・`選定順序`・derating式のPTC専用語（保持電流）を、方式非依存の「連続通電できる電流」（PTCなら保持電流、ヒューズなら定格電流）へ改めた | [PR #61レビュー](https://github.com/wachi-yoshitaka-11-dev/deskcat/pull/61) |
| 2026-08-11 | 35 | [#1](https://github.com/wachi-yoshitaka-11-dev/deskcat/issues/1)。**電源rail構成案の図が「M-06724はregulator非搭載」を確定事項として書いていた。**この前提の根拠は秋月 M-06724の商品ページだが、**現在404で入手できない**（2026-08-10確認）。regulatorの有無を現物確認待ちとし、`HW-TBD-004`を参照させた。**3.3V給電とする規則は変えていない。**IC定格の上限が3.6Vであり、regulatorの有無に関わらず5V直結は不可だからである | [PR #82](https://github.com/wachi-yoshitaka-11-dev/deskcat/pull/82)、[hardware-bom.md](https://github.com/wachi-yoshitaka-11-dev/deskcat/blob/b7cb5290715eded3530c7626d92bef5df3361540/docs/hardware/hardware-bom.md) Revision 30 |
| 2026-08-12 | 36 | 昇格PR[#109](https://github.com/wachi-yoshitaka-11-dev/deskcat/pull/109)のレビュー指摘を反映。**Revision 35は電源rail構成案の図に「3.3V給電とする」を確定形で残していた。**regulatorの有無を現物確認待ちへ改めた一方で給電電圧は決定として書いており、[sensor-datasheet-notes.md](https://github.com/wachi-yoshitaka-11-dev/deskcat/blob/b7cb5290715eded3530c7626d92bef5df3361540/docs/hardware/sensor-datasheet-notes.md)が同じmoduleの`moduleへ入れてよい電圧`を`TBD`としているのと食い違っていた。**5V直結を不可とする規則は維持**したうえで、3.3Vを「唯一の候補だが未確定」とし、`HW-TBD-004`の確認対象に`moduleへ入れてよい電圧`が含まれることを図から辿れるようにした。**あわせて、負荷表の`ADXL345`行に「M-06724はregulator非搭載のため3.3V直結必須」が生きた記述として残っていたため削除した。**[PR #82](https://github.com/wachi-yoshitaka-11-dev/deskcat/pull/82)がRevision 35で図から消した断定と同じものが、同じ文書の別の表に残っていた（Revision履歴の2箇所は過去時点の記録であるため残す）。**あわせて[PR #110](https://github.com/wachi-yoshitaka-11-dev/deskcat/pull/110)のレビューで、5V禁止の根拠の書き方も直した。**当初は「定格上限3.6V。5V直結は定格超過となる」とADXL345とBME280を同じ根拠で並べていたが、**BME280は秋月の製品説明書がmodule boardとして電源電圧を示すのに対し、ADXL345のM-06724にはboard資料が無い。**ICの定格からmodule boardの許容入力電圧は決まらないため、ADXL345の5V禁止は**確認前の安全規則**であると書き分けた。**禁止そのものは変えていない。この文書が定める配線規則も変えていない。**段階B-2のgateも開いていない | [PR #109レビュー](https://github.com/wachi-yoshitaka-11-dev/deskcat/pull/109)、[PR #110レビュー](https://github.com/wachi-yoshitaka-11-dev/deskcat/pull/110)、[hardware-bom.md](https://github.com/wachi-yoshitaka-11-dev/deskcat/blob/b7cb5290715eded3530c7626d92bef5df3361540/docs/hardware/hardware-bom.md) Revision 32 |
| 2026-08-12 | 37 | [#1](https://github.com/wachi-yoshitaka-11-dev/deskcat/issues/1)と[#3](https://github.com/wachi-yoshitaka-11-dev/deskcat/issues/3)。ADXL345のメーカー公式datasheet（Rev. G）を入手した結果を反映。(a) **`HW-TBD-025`(b)の前提が変わった。**共通条件表とB-2bの条件表は「ADXL345とBME280に公開値があるかも未確認」と書いていたが、**2026-08-12に確認した結果、両者とも絶対最大定格は公開されているが電流の上限は記載が無い**（ADXL345 Rev. G Table 2 page 5、BME280 Revision 1.24 Table 5 page 13）。**未知数はMSP2807だけではなく3点すべてである。**B-2bが成立しない理由を3点へ広げた。**「1点でも上限が無ければB-2を実施しない」というgateは維持しており、開いていない。**(b) **負荷表のADXL345行の消費電流の出典が、Digi-Keyの解説記事のままであった。**メーカー一次資料へ差し替え、値を`140µA typ（ODR ≥ 100Hz）／standby 0.1µA typ`とした（Rev. G Table 1 page 4、Table 7 page 13）。**datasheetにmax欄は無くtyp値のみである**ことも明記した。これでこの文書からDigi-Keyへの参照は無くなった。(c) **ICの「定格上限3.6V」という記述を、動作上限3.6Vと絶対最大定格3.9Vの書き分けへ訂正した。**従来は両者を混ぜていた。**5V直結の禁止は変えていない。**5Vはそのどちらも超えるため結論に影響せず、禁止が**確認前の安全規則**であるという整理も維持する。**3.3Vが唯一の候補であって未確定であること（`HW-TBD-004`）も変えていない。**この文書が定める配線規則も、段階B-2のgateも変えていない**あわせて[PR #112](https://github.com/wachi-yoshitaka-11-dev/deskcat/pull/112)のreviewで、`HW-TBD-025`(a)が`HW-TBD-004`より先に確定できるかのように書かれていた点も直した。**(a)は3 moduleが**moduleとして受け入れてよい電圧**の積集合であって、IC単体の動作範囲の積集合ではない。`ACCEL-01`分は`moduleへ入れてよい電圧`が未確定（`HW-TBD-004`）であるため、**(a)も`HW-TBD-004`が解けるまで確定しない。**「現物確認を待つ必要はない」とした旧記載を撤回した。**gateは厳しくなる方向にのみ変えており、緩めていない。** | [ADXL345 Data Sheet](https://www.analog.com/media/en/technical-documentation/data-sheets/adxl345.pdf) Rev. G（2026-08-12取得）、[BME280 Data Sheet](https://www.bosch-sensortec.com/media/boschsensortec/downloads/datasheets/bst-bme280-ds002.pdf) Revision 1.24、[sensor-datasheet-notes.md](https://github.com/wachi-yoshitaka-11-dev/deskcat/blob/b7cb5290715eded3530c7626d92bef5df3361540/docs/hardware/sensor-datasheet-notes.md) Revision 5、[hardware-bom.md](https://github.com/wachi-yoshitaka-11-dev/deskcat/blob/b7cb5290715eded3530c7626d92bef5df3361540/docs/hardware/hardware-bom.md) Revision 33 |
| 2026-08-12 | 38 | [#3](https://github.com/wachi-yoshitaka-11-dev/deskcat/issues/3)。`HW-TBD-025`(a)／`028`／`029`／`030`を進め、Espressif公式guideの警告を反映した。**どのgateも開いていない。**(a) **`3.3 V railの許容電圧範囲`節を新設し、`HW-TBD-025`(a)の値の正をここに置いた。**暫定の積集合は`DISP-01` 3.3–5 V ∩ `ENV-01` 1.71–3.6 V ∩ ESP-WROOM-32D module 3.0–3.6 Vで**3.3–3.6 V**である。**確定値ではない**（`ACCEL-01`分は`HW-TBD-004`待ち）。**あわせて、この暫定値がそのままでは成立しないことを記録した。**下限3.3 Vはrailの公称値と同一で下振れ余裕が原理的に無く、さらに参照設計の`U2 = AMS1117-3.3`の出力はdatasheetが与える2行のうち広い方で**3.201–3.399 V**、狭い方でも下限3.251 Vであり、**どちらを採っても3.3 Vを割りうる**。`msp2807.pdf`はVCCについて`3.3V~5V`の一行しか持たず、下限が公称値か絶対最小値かを決められない。**解釈で埋めず、`HW-TBD-025`(a)の中身として両立の3経路を明記した**（別の台帳行は立てていない）。(b) **`電源品質の数値制限`節を新設し、`HW-TBD-028`の5項目の正をここに置いた。****5項目とも規則を定義したが、数値が確定したのは(d)の継続時間0だけである。**(a)は**一次資料に最低電圧も許容範囲も無いことを確認した**（公式documentationは`All models require a 5.1V supply`と述べるのみ。低電圧検出の4.63 Vは`except the Zero range`と明記されPi Zero Wに適用されない。Zero W向けproduct brief／reduced schematicsは非公開）。**undervoltage警告のしきい値で代用しない。**(b)のESP32 board 5 V入力は参照設計のdropout最大1.3 Vから**4.6 V**と導いたが、**現物の`U2`は未確認である**（`HW-TBD-023`）。(c)(d)は推奨動作条件が瞬時値の制約であることから導出規則を定めた。**「継続時間0」はdatasheetが時間領域の許容を示していないために安全側へ倒した判定規則であり、メーカーが述べた値ではない。**照合の分解能がADCのsample rateで決まることも明記した。(e)は規則だけを定め、**一次資料に無い温度上昇値を置かなかった**（経路部品が未選定）。**照合段階の対応表**も追加した。(c) **`local decouplingの外付け要否`節を新設し、`HW-TBD-029`を解決手順1〜8に従ってcloseした。**datasheetが指定する値と配置は4 deviceとも確定した（`DISP-01`は記載が無いことの確認）。`ENV-01`は**外付け不要**である（module上に`C1`／`C2`各0.1 µFを実装済みで、Bosch datasheetの推奨100 nFを満たす）。**残る「boardに何が実装済みか」はdatasheetでは決まらないため、`HW-TBD-004`（`ACCEL-01`）／`HW-TBD-002`（`DISP-01`）／`HW-TBD-023`（`MCU-01`）の確認項目へ移した。gateは維持している。****ICへの推奨値を外付け部品として購入待ちリストへ載せていない。**(d) **`逆極性保護のdesign review`節を新設した。**逆接が起こりうるのは手配線区間だけであり、**ingress 1箇所の保護部品では下流を守れない**ことを示した。方式ごとの電圧降下の代償も並べた。**決定は人間の承認待ちであり、`HW-TBD-030`はOpenのままである。**(e) **`ESP32の給電経路（未決定）`節へ公式警告を帰結ごと入れた。**従来は「3系統は排他」までで、**2つ以上から同時に給電するとboardまたは電源が破損しうる**という帰結が無かった。案Aと案Bを同時に満たす配線が禁止対象であること、および**段階B-2aは`3V3` pinから外部へ供給する側であって排他制約の対象ではない**ことも明記した。(f) **`Pi Zero Wには低電圧検出が無い`節を新設し、測定計画の記述を訂正した。**従来は「Piのbrownoutとreset reasonもあわせて確認する」としていたが、公式documentationが低電圧検出回路を`except the Zero range`と明記しており成立しない。**Pi側は`ADC-5V`の実測でしか捉えられず、分圧用抵抗は未購入である。ESP32のbrownout検出は有効なため区別して残した。**(g) 入力電源行へ、公式が要求する5.1 Vと`PSU-PI-01`の5 Vが一致しないことを記録した（可否の判断は`HW-TBD-007`／`HW-TBD-009`） | [ESP32-WROOM-32D & ESP32-WROOM-32U Datasheet](https://documentation.espressif.com/esp32-wroom-32d_esp32-wroom-32u_datasheet_en.pdf) v2.7 Table 13／Table 14 page 26、[AMS1117 datasheet](http://www.advanced-monolithic.com/pdf/ds1117.pdf) Electrical Characteristics、[msp2807.pdf](https://akizukidenshi.com/goodsaffix/msp2807.pdf) Product Parameters、[AE-BME280説明書](https://akizukidenshi.com/goodsaffix/AE-BME280_manu_v1.1.pdf) v1.1 主な仕様・部品表、[BME280 Data Sheet](https://www.bosch-sensortec.com/media/boschsensortec/downloads/datasheets/bst-bme280-ds002.pdf) Revision 1.24 Figure 17–19、[ADXL345 Data Sheet](https://www.analog.com/media/en/technical-documentation/data-sheets/adxl345.pdf) Rev. G `POWER SUPPLY DECOUPLING` page 29、[Raspberry Pi公式documentation](https://www.raspberrypi.com/documentation/computers/raspberry-pi.html) Power supply、[Espressif ESP32-DevKitC V4公式guide](https://docs.espressif.com/projects/esp-idf/en/v5.1/esp32/hw-reference/esp32/get-started-devkitc.html) |
| 2026-08-12 | 39 | [PR #113](https://github.com/wachi-yoshitaka-11-dev/deskcat/pull/113)のreview指摘を反映。**Revision 38は、条件付きの値を無条件の判定基準として2箇所で使っていた。**(a) `逆極性保護のdesign review`の直列Schottkyの行が、4.6 Vを確定した合格下限のように用いて方式を却下していた。**4.6 Vは`IOUT ≤ 0.8 A`かつ参照設計の`U2`という条件付きの導出値である**（同Revisionの`(b)のESP32 board 5 V入力の導出`で自ら述べている）。**現物の`U2`と実負荷を確認するまで採否を決めない**へ改めた。台帳の`HW-TBD-030`側も揃えた。(b) **`定義した値をどの段階で照合するか`表が、(a)を「段階A・gate不要」としていた。**同じRevisionが「判定値が無く`ADC-5V`の測定系も無い」と書いており、[servo-safety-limits.md](https://github.com/wachi-yoshitaka-11-dev/deskcat/blob/b7cb5290715eded3530c7626d92bef5df3361540/docs/hardware/servo-safety-limits.md)の受け入れchecklistは同じ項目を`Blocked`としているのに、この表だけ照合可能と読めた。**「測れる」と「合否を判定できる」を書き分け、測定はgate不要・判定は`Blocked`とした。**(c) **段階Aの定義そのものにも同じ問題があった。**「gate不要。Pi単体は通常の使い方である」とだけ書いており、**正常に起動したことをもって電源経路を合格と読める状態だった。**探索的な通電であって受け入れではないこと、M-12001の5 Vが公式要求の5.1 Vを満たすかは未判断（`HW-TBD-007`）であることを明記した。**段階Aを実施してよいこと自体は変えていない。**(d) 台帳の`HW-TBD-028`に、廃止した`HW-TBD-033`への参照が残っていたため削除した（Revision履歴の記載は過去時点の記録として残す）。**どのgateも緩めていない。**(a)(b)(c)はいずれも判定を厳しくする方向の変更である。**(f) rippleとdroopの測定が`ADC-5V`／`ADC-3V3`のdivider（未購入）に従属することを、照合段階表の(a)(c)(d)と測定計画のchecklistへ明記した。**表は段階A／B-1の測定gateを「不要」としていたが、**rippleはDMMで捉えられず、この文書が定める手段はADC loggingだけである。**分圧抵抗4本が未購入である以上、段階A／B-1でも測定に着手できない。**(g) 案Bのbackfeed受け入れ試験を明示した。**従来は「VBUS保護diodeの有無を回路で確認する」までで、**在ることを確かめても逆流しないことを測ったことにはならない。**2つの給電組み合わせで非給電側への電流を測り、両方で逆流が測定分解能の範囲で認められないことを合格条件とした。片方だけの確認では通さない。**あわせて、指摘された事例だけでなく同じ型の箇所を全数で潰した。**(b)の指摘は(a)の行だけを名指ししていたが、**同じ混同が(b)〜(e)の全行に残っていた。**表を`測れる段階`／`測定のgate`／`合否判定`の3列へ分け、**5項目とも合否判定は`Blocked`である**ことを明示した（測定はgateさえ満たせば進められるが、判定には確定した閾値と検証済みの測定系の両方が要り、現状はどの項目も揃っていない）。(e) 台帳の`HW-TBD-028`の状態列に、廃止した`033`への参照が**略記形で**残っていた。**完全形の`HW-TBD-033`だけを検索して「0件」と誤って確認していた**ため見落とした（狭いpatternでの「0件」報告は[hardware-bom.md](https://github.com/wachi-yoshitaka-11-dev/deskcat/blob/b7cb5290715eded3530c7626d92bef5df3361540/docs/hardware/hardware-bom.md)の購入待ちリストの節が戒めているのと同じ失敗である）。同文書のRevision 34も`新規HW-TBD-033`のままで、**このPull Requestがもう033を作らない以上、未mergeのrevision記述として誤りだった**ため直した | [PR #113のreview](https://github.com/wachi-yoshitaka-11-dev/deskcat/pull/113)、自己レビュー |
| 2026-08-12 | 40 | [#1](https://github.com/wachi-yoshitaka-11-dev/deskcat/issues/1)。[hardware-bom.md](https://github.com/wachi-yoshitaka-11-dev/deskcat/blob/b7cb5290715eded3530c7626d92bef5df3361540/docs/hardware/hardware-bom.md) Revision 37の訂正を反映した。**この文書は`ADC-5V`／`ADC-3V3`の分圧用抵抗とServo bulk capacitorを「未購入」として複数箇所で扱っていたが、いずれも2026-08-08に着荷済みであった。**(a) `Pi Zero Wには低電圧検出が無い`、`(a)の一次資料は存在しない`、測定計画のchecklist、`定義した値をどの段階で照合するか`表の(a)(c)(d)の各行を、**「部品待ち」から「実装と検証が残る」へ改めた。**(b) `配線・保護表`のServo bulk capacitorを、**10個入手済み・使用個数が実測待ち**へ改めた（従来は`Candidate（実測前）`で未購入扱い）。**判定は緩めていない。**rippleとdroopの合否判定は`HW-TBD-028`(a)と3.3 V rail側の閾値が未確定であるため`Blocked`のままであり、変わったのは**部品の入手状況だけ**である | [hardware-bom.md](https://github.com/wachi-yoshitaka-11-dev/deskcat/blob/b7cb5290715eded3530c7626d92bef5df3361540/docs/hardware/hardware-bom.md) Revision 37、購入履歴（2026-08-08着荷分） |
| 2026-08-12 | 41 | [PR #116](https://github.com/wachi-yoshitaka-11-dev/deskcat/pull/116)のreview指摘。`Pi Zero Wには低電圧検出が無い`と`(a)の一次資料は存在しない`が「**Pi側の低電圧は`ADC-5V`の実測でしか捉えられない**」と書いており、**同じ文書の`定義した値をどの段階で照合するか`表が「DMMで直流値を読むだけなら不要」としているのと食い違っていた。****量によって手段が違う。**定常電圧はDMMで読め、`ADC-5V`が要るのは**droopとripple**である。両者を書き分けた。**合否判定が`Blocked`である点は変えていない**（閾値が(a)として未確定であるため） | [PR #116のreview](https://github.com/wachi-yoshitaka-11-dev/deskcat/pull/116) |
| 2026-08-15 | 42 | [#1](https://github.com/wachi-yoshitaka-11-dev/deskcat/issues/1)。**現物確認の結果、参照設計を根拠にしていた記述の前提が2箇所崩れたため訂正した。**(a) **`U2`が参照設計と違う部品であることが判明した。**現物の刻印は`LD1117AG` / `33AQVCUV`で、参照設計の`AMS1117-3.3`ではない。pin互換の二次ソースだが部品が違うため、**この文書が`HW-TBD-025`(a)と(b)の導出に使っている`AMS1117`のdatasheet値（出力電圧範囲3.201–3.399 V、dropout最大1.3 V）は現物の値ではない。**`LD1117AG`のメーカーが特定できずdatasheetを当てられないため、**現物のdropout電圧と出力電圧範囲は未確定である。**参照設計に基づく暫定値として残すが、**現物の合格判定には使えない**と明記した。(b) 電源rail構成案の図のADXL345行を更新し、**M-06724のregulator非搭載を現物確認した**ことを反映した（`moduleへ入れてよい電圧`は引き続き未確定）。**どのgateも開いていない。**段階B-2aは`HW-TBD-023`が未解決のままである | 現物写真（斜光＋接写）。詳細は[tbd-register.md](https://github.com/wachi-yoshitaka-11-dev/deskcat/blob/b7cb5290715eded3530c7626d92bef5df3361540/docs/hardware/tbd-register.md)の`HW-TBD-023`／`HW-TBD-004` |
| 2026-08-15 | 43 | [PR #122](https://github.com/wachi-yoshitaka-11-dev/deskcat/pull/122)のレビュー指摘を反映。**電源rail構成案の図がADXL345を3.3V railの下に置いたままで、`HW-TBD-004`のclose前に接続を承認したように読めた。**ADXL345の枝を`（接続不可）`とし、**`HW-TBD-004`がcloseするまでこの経路へ接続してはならない**ことを明記した。あわせて本文の「周辺moduleはすべて3.3Vで給電し」という表現を改めた。**未確定のmoduleを含む「すべて」は、接続を承認済みに見せる** | [PR #122レビュー](https://github.com/wachi-yoshitaka-11-dev/deskcat/pull/122) |
| 2026-08-15 | 44 | Revision 43の残存を修正。**図でADXL345を`（接続不可）`とした一方、本文と測定checklistが接続を前提にしたままだった。**(a)「3V3 railに接続する3module」→「接続する予定の3module」とし、**ADXL345分は`HW-TBD-004`がcloseした場合の見積である**ことを明記した。(b) 段階Cの`測定5`と3V3 pin定格確認の項目に、**ADXL345を繋ぐのは`HW-TBD-004`のclose後である**ことを追記した。**見積りの数値も測定手順も変えていない** | [PR #122レビュー](https://github.com/wachi-yoshitaka-11-dev/deskcat/pull/122) |
| 2026-08-15 | 45 | [#3](https://github.com/wachi-yoshitaka-11-dev/deskcat/issues/3)。**現物の`U2`のメーカーを特定し、`AMS1117`由来の導出を現物のdatasheetへ差し替えた。**`U2`は**UMW（UTD Semiconductor Co., Limited）の`LD1117-3.3`（SOT-223）**である。根拠は刻印`LD1117AG` / `33AQVCUV`と、UMW datasheetが図示するSOT-223 template（1行目`LD1117AG`、2行目`xxAQwwT S`。`xx`はVoltage）の一致である。**UTC（Unisonic Technologies）も候補に挙げたが外した**（UTCのtemplateは社名行を含み`AQ`を生まない）。(a) `暫定値の下限は、そのままでは成立しない`節の出力電圧行を**3.201–3.399 V（`AMS1117`）から3.234–3.366 V（現物）へ差し替えた。下限が3.3 Vを割るという結論は変わらない。**(b) `(b)のESP32 board 5 V入力の導出`節を書き換えた。**4.6 Vという数値は変わらないが、根拠が別部品の`IOUT ≤ 0.8 A`条件付きの値から、現物の部品の`IOUT = 1 A`でのdropout最大1.30 Vへ変わった。**(c) **regulatorの種別がLDOと確定したため、5 V側への換算`Iin ≒ Iout + Iq`を使ってよいことにした**（`Iq` typ 5 mA／max 10 mA）。(d) **保護の内容を記録した。**電流制限`Ilimit` min 1.25 A／max 1.6 Aと熱shutdown`TSD` typ 150 ℃までは確定したが、**短絡保護と折り返し特性はdatasheetに記載が無い。記載の不在を保護の不在と読み替えないため、B-2aの`実施条件（保護）`は満たされていないままとした**（[AGENTS.md](https://github.com/wachi-yoshitaka-11-dev/deskcat/blob/b7cb5290715eded3530c7626d92bef5df3361540/AGENTS.md) 推測禁止）。**確定したのは、trip点1.25 Aが1 Aの定格より上にあり、`IOUT` 1.0–1.25 Aの区間が電流制限の動作しない範囲だということである。**この事実をB-2aの`実施条件（保護）`と逆極性保護のdesign reviewへ反映した。**どのgateも開いていない。**B-2aの`実施条件（定格）`は**Espressifがboard levelで公開しておらず、ICのdatasheetでも埋まらないことが確定した**ため、`HW-TBD-023`(a)は未解決のまま残る | [UMW LD1117 datasheet](https://www.umw-ic.com/static/pdf/a5e0c99cefdefaf03cfa7777b369e45b.pdf) Mar.2025（sha256 `5dec5c09027316c375c27108cbac9d088ba94060bebacd614a04a3b8bb18a3d3`、2026-08-15取得）。詳細は[tbd-register.md](https://github.com/wachi-yoshitaka-11-dev/deskcat/blob/b7cb5290715eded3530c7626d92bef5df3361540/docs/hardware/tbd-register.md)の`HW-TBD-023` |
| 2026-08-16 | 46 | [#3](https://github.com/wachi-yoshitaka-11-dev/deskcat/issues/3)の2026-08-16の追記を反映。**電源過渡の測定主張が3つの正本で食い違っている**という指摘に対し、**この文書を測定主張の正とし、材料を揃えて人間の決定を待つ形にした。方式は決めていない。どのgateも開いていない。**(a) **`ESP32自身のADCは測定対象から独立していない`節を新設した。**`ADC-5V`／`ADC-3V3`はESP32自身が給電されているrailであり、**測りたい区間と測定器が止まる区間が同じである。**独立性が要る量と、ESP32自身のADCで測ってよい量を表で分けた。**未観測区間を3種**（sample間、brownout／reset中から再起動完了まで、burst captureのwindowの外）**に整理し、何を保証しないかを明記した。**3つ目はこれまでどの文書にも無かった。`reset reason`は**resetが起きた事実**であって、その区間のrail波形ではない。**`Pi Zero Wには低電圧検出が無い`とは別の問題である**（あちらは検出回路の有無、こちらは測定系の独立性）。(b) **`電源過渡の測定方式のdesign review`節を新設した。**方式1（独立した外部観測）と方式2（ADC loggingへ限定し合格主張を狭める）の材料を並べた。**必要帯域も品番も`TBD`のまま置き、値を推測で埋めていない。**購入待ちリストへは何も足していない（方式が未決定のため）。方式2については**改訂が要る箇所の全数**と、**適用していない改訂案**を表で示した。走査patternも残した。**手持ちのArduino Unoを方式1の候補として記載した。**[hardware-bom.md](https://github.com/wachi-yoshitaka-11-dev/deskcat/blob/b7cb5290715eded3530c7626d92bef5df3361540/docs/hardware/hardware-bom.md)の`Not used`は**controllerとしての判断**であって所持や他用途を否定していない（同文書 Revision 47で役割の限定を明記した）。**同日に現物の刻印で`BOARD MODEL UNO R3`／`ATMEGA328P-PU`／`MEGA16U2`を確定し、Arduino公式のUser Manualとschematicで裏付けた**（`手持ち候補の現物識別`。**通電はしていない**）。**USB給電の経路が監視対象のrailを通らないことは、公式のPower Treeで裏付けが取れた。****同日に`DS40002061B`（現物のSPDIPを対象に含む版）でADCの分解能・sample rate・入力範囲・基準電圧を確定した**（sha256付きで記録）。**必須要件の1 kSample/s以上は満たす見込みである。****入力範囲は0〜V<sub>CC</sub>だが、直結の可否は別条件であり、`5 V railをADCへ直結する条件`節を新設してdividerを既定として残した。**Arduino側のAV<sub>CC</sub>と監視対象の5 V railは独立した電源であり、**対象側の過渡がAV<sub>CC</sub>を超えうる。****それでも採否は決めない。**基準電圧が未解決であり（AV<sub>CC</sub>は精密基準ではなく、内蔵1.1 Vは個体差min 1.0／max 1.2 V）、**校正か外部基準が要る。**USB給電での動作とGND topologyへの影響も未確認である。****あわせてSRAM 2 KBの制約を記録した。**`Sample rateとlog形式`のburst capture（200 ms分）は15 kSPSで6 KBを要し2 KBに収まらないが、**ArduinoのUSBはProtocolと共有していないため連続streamingを選べる。**成立すれば`capture window外`の未観測区間が消える。**実現rateは未測定であり値を置いていない。**先に見つけたautomotive版datasheet（`7810D–AVR–01/15`）は、package（TQFP／VQFN）もchannel数（8）もgradeも現物と一致しないため根拠に採らなかった。**(c) **同日、人間が方式1（独立した外部観測）を採ると決定した。**oscilloscopeは購入せず、手持ちのArduino Uno R3を候補とする。**これにより[技術ガイド](https://github.com/wachi-yoshitaka-11-dev/deskcat/blob/b7cb5290715eded3530c7626d92bef5df3361540/docs/DeskCat_Microcontroller_Development_Guide.md)のゲートAの改訂は不要になり、同文書は変更していない。****方式2の節は`採らない`へ改め、未適用の改訂案の全数表は削除した。**適用先が無い案を正本へ残すと後から誤って適用されうるためである。**方式2の内容と却下の理由は同節に残した。**(c-2) **`HW-TBD-034`はcloseしない。**決まったのは方式であり、**測定器の採否も実装も未了である**（基準電圧の校正、SRAM 2 KBに対する取得方式、GND topologyへの影響の3点。`方式1で残っている未解決3点`）。したがって追記の受け入れ観点のうち**「4文書の合格主張が一致した」は依然として未達である。**(d) `測定計画`、`Sample rateとlog形式`、`Pi Zero Wには低電圧検出が無い`、`サーボ接続前`、`サーボ試験`、`(c)(d)の導出規則`、`定義した値をどの段階で照合するか`から新設節を参照させた。**規則も数値も再掲していない。**(e) **`定義した値をどの段階で照合するか`の(b)(c)(d)の合否判定へ`HW-TBD-034`を追加した。Blockedを解除していない。**(f) **記録として残す。**`a11d32d`（2026-08-16）はこの文書の本文を変えたが**Revision行を追加していない。**その結果、**Revision 45のitem (c)「`Iin ≒ Iout + Iq`を使ってよいことにした」が、同commitによる撤回と食い違ったまま残っている。**Revision 45の行は過去時点の記録として書き換えず、ここに記録する。**本文側の撤回内容は正しいため変更していない**(g) **[PR #138](https://github.com/wachi-yoshitaka-11-dev/deskcat/pull/138)のCodeRabbitの指摘3件を反映した。**(g-1) 方式決定後も「どちらの測定方式を採るかは決まっていない」という旧文言が残っていた。(g-2) **独立給電を「独立した観測」の成立と書いていた。**独立給電は必要条件の1つにすぎず、GND topology・PC groundの影響・入力headroom・実機動作は別に検証が要る。`hardware-bom.md`の`MEAS-02`も揃えた。(g-3) **`5 V railをADCへ直結する条件`節を新設した。****3件とも主張を弱める方向であり、gateは開いていない** | [#3の2026-08-16の追記](https://github.com/wachi-yoshitaka-11-dev/deskcat/issues/3)、`a11d32d`。追跡は[tbd-register.md](https://github.com/wachi-yoshitaka-11-dev/deskcat/blob/b7cb5290715eded3530c7626d92bef5df3361540/docs/hardware/tbd-register.md)の`HW-TBD-034` |
| 2026-08-18 | 47 | [PR #146](https://github.com/wachi-yoshitaka-11-dev/deskcat/pull/146)のreview指摘。**`HW-TBD-034`のclose契約が2文書で一致していなかった。**本文の未解決一覧は「測定器の採否、実装、基準電圧の校正、取得方式、GND topology」の5点を挙げるのに対し、[tbd-register.md](https://github.com/wachi-yoshitaka-11-dev/deskcat/blob/b7cb5290715eded3530c7626d92bef5df3361540/docs/hardware/tbd-register.md)の`HW-TBD-034`のclose条件は「実装と4文書の主張整合」の2点しか挙げておらず、**校正・取得方式・GND topologyが解けないままcloseしうる書き方だった。**本文側へ`必要帯域の一次資料`を足して台帳と同じ集合にし、close条件の全数は台帳側へ置いた（**値と規則の正は本文であり、台帳へ再掲していない**）。**未解決を増やす方向であり、gateは開いていない。**測定値も規則も変えていない | [PR #146のreview指摘](https://github.com/wachi-yoshitaka-11-dev/deskcat/pull/146)、[#147](https://github.com/wachi-yoshitaka-11-dev/deskcat/issues/147)。close条件の全数は[tbd-register.md](https://github.com/wachi-yoshitaka-11-dev/deskcat/blob/b7cb5290715eded3530c7626d92bef5df3361540/docs/hardware/tbd-register.md)の`HW-TBD-034` |
| 2026-08-18 | 48 | [PR #146](https://github.com/wachi-yoshitaka-11-dev/deskcat/pull/146)のreview指摘。**(a) `HW-TBD-034`のclose条件を1つの正本へ寄せた。**本文の未解決参照が「3点」と読める書き方で、台帳のclose条件7項目と件数が併存していた。**方式1の技術的な3点は本文の`方式1で残っている未解決3点`が正、close条件の全数は台帳が正**と役割を分けた。(b) **Power Treeの記述をblock図の粒度と明示した。**`USBVCC → OPAMP → +5V`の`OPAMP`が電源電流経路に直列かMOSFETを制御する側かは**この出典からは決まらない。**`F1`／`T1`／GND／backfeed経路のschematic粒度の一致は未確認であり、**独立給電はそれまで候補条件として扱う**と明記した。**同じ主張が`AV_CC`の行（`USBから`OPAMP`と`T1`（`FDN340P`）を経て作られる`）にもあったため、そちらも同じ扱いへ揃えた。**片方だけ直すと、粒度の違う2つの記述が残る。**あわせて`HW-TBD-034`のclose条件へ`(6b) Power Treeのschematic粒度の確認`を足した。**未確認をここへ送っただけでは、close条件に無いまま解決済みとして閉じうる。**測定値も閾値も変えていない。未確認を増やす方向である** | [PR #146のreview指摘](https://github.com/wachi-yoshitaka-11-dev/deskcat/pull/146)、[#149](https://github.com/wachi-yoshitaka-11-dev/deskcat/issues/149)。close条件の全数は[tbd-register.md](https://github.com/wachi-yoshitaka-11-dev/deskcat/blob/b7cb5290715eded3530c7626d92bef5df3361540/docs/hardware/tbd-register.md)の`HW-TBD-034` |
| 2026-08-18 | 49 | **`HW-TBD-034`方式1の作業1を実施し、作業2の測定側を採った**（実測は2026-08-17。未加工の観測と手順は[experiment-log.md](https://github.com/wachi-yoshitaka-11-dev/deskcat/blob/b7cb5290715eded3530c7626d92bef5df3361540/docs/hardware/experiment-log.md)の`EXP-001`。**この文書には要件と照合する値だけを置いた**）。(a) **`手持ち候補に固有の制約: SRAMと取得方式`の「実現できるsample rateは未測定である」を実測値へ置き換えた。**連続streamingは**必須要件を2 channel同時で満たした**ため、**SRAM 2 KBは取得方式の障害にならない。****既定のADC clockは125 kHz（§24.4の50〜200 kHzの規定内）とし、250 kHzの実測値も規定外である旨を併記して残した。**具体的な値はこのRevision行へ書かず、同節の表に置く**（再測定のたびにRevision行が古くなるのを避けるためである。実際に一度古くしている）。**目標帯へ届かせるには250 kHzが要るが、**目標帯そのものの根拠が`TBD`である**ため、**根拠が未確定の目標のために一次資料が保証する分解能を手放さない**という判断である（2026-08-18、人間の判断）。baud 115200では取りこぼしが出ることも実測した（transportが律速）。(b) **`手持ち候補の現物識別`の「channel切り替えの扱いは§24.5にあり、未確認である」を確定させた。**§24.5.1により**free running modeでは結果のchannel帰属が1変換ぶん遅れる。**現在の`ADMUX`でtagを付けるとlabelが入れ替わり、**値は正常に見えたままlabelだけが誤るため、同一電圧を2 channelへ入れる確認では検出できない。**1 channelあたりのrateが合計をchannel数で割った値になることも実測で確認した。(c) **`基準電圧が未解決である（設計上の論点）`へ、採る校正方法と採れた値を追記した。****比率法**（AV<sub>CC</sub>基準で内蔵1.1 Vを読む）を採る。**AREF pinをテスターで直接測る代替には依らない**（§24.5.2は`VREF`を`high impedance source`と述べ`high impedance voltmeter`を要求するが、**MAS830Lの入力インピーダンスは未取得で判定できない。**満たさないと断定せず、依存しないことを選んだ。比率法はAREFへ何も接続しない）。内蔵1.1 VのAV<sub>CC</sub>に対する比を実測し、**ADC offsetが現分解能では検出されない**ことも記録した。**§24.4の「bandgapは安定するまで最初の値が誤りうる」が実測で見えた**（切替直後の1変換のみ外れる）。**それでも基準電圧は未解決である。**得られたのは比だけで、**AV<sub>CC</sub>自身の実測と、MAS830L自身のrange別確度・基準温度が未取得である。**確度はrepository内のどこにも記録が無く、**テスターの確度を超える主張をしない。**(d) **`方式1で残っている未解決3点`の表へ状態列を追加した。**(2)は解け、(1)は一部進み、**(3) GND topologyは未着手である。**(e) **`HW-TBD-034`はcloseしない。`MEAS-02`の採否も未確定である。**どのgateも開いていない。**未観測区間について新たな主張をしていない。**連続streamingで`capture window外`は消えるが**`sample間`は残り、「電源過渡をすべて実測済み」とは扱わない。**(f) **`手持ち候補の現物識別`の「目標帯（5〜10 kSample/s）にも入る」を訂正した。**この見込みは**ADC clock 200 kHz相当の15 kSPSを前提にしていたが、prescalerの分周比は2の冪しか選べず**（Table 24-5）、16 MHzからは125 kHzの次が250 kHzである。**50〜200 kHzの規定内に収まるのは125 kHzだけであり、規定内で目標帯へ届く設定は存在しない。****したがって(a)の2択に中間は無い。**この訂正は実測で判明した。**主張を弱める方向であり、gateは開いていない。**(g) **[PR #145](https://github.com/wachi-yoshitaka-11-dev/deskcat/pull/145)の自動reviewの指摘で、2026-08-17の初回測定値に集計起因の誤りが2件あったことが判明し、2026-08-18に取り直した。**壁時計rateの分子と分母が同じ区間でなく**実効rateが約0.5 %低く出ていた**こと、および**ADC変換式の分母に1023を使っていた**ことである。後者は§24.7 が `ADC = (V_IN × 1024) / V_REF` と定めており、**1024が正しい。**(a)の表と校正の比を取り直した値へ差し替えた。**結論は変わっていない**（1 channelあたりは依然として目標帯へ届かない）。経緯は[experiment-log.md](https://github.com/wachi-yoshitaka-11-dev/deskcat/blob/b7cb5290715eded3530c7626d92bef5df3361540/docs/hardware/experiment-log.md)の`訂正`にある。(h) **自動reviewの2巡目で4件の指摘を受け、うち2件は測定系のwire formatの誤りだった。**`dropped`が16 bitでbaud 115200では約16秒でwrapし、境界で差が0に見えて時刻復元のguardを誤って通す状態だった。32 bitへ広げ、`micros()`のwrapを跨ぐ取得も弾くようにした。**wire formatが変わったため全条件を再測定し、(a)の表を差し替えた。**あわせて**transportの上限の導出を実baudで直した**（`DS40002061B` Table 20-7 の16 MHz・U2X=1・115.2 kbpsは`UBRRn` 16、誤差+2.1 %。公称baudで計算すると実測より低く出る）。**結論は変わっていない。**(i) **測定値を`HW-TBD-028`(b)(c)(d)の合否判定へ使っていない**（判定は`Blocked`のままである） | [#3](https://github.com/wachi-yoshitaka-11-dev/deskcat/issues/3)、[experiment-log.md](https://github.com/wachi-yoshitaka-11-dev/deskcat/blob/b7cb5290715eded3530c7626d92bef5df3361540/docs/hardware/experiment-log.md)の`EXP-001`、`DS40002061B` §24.4／§24.5／§24.5.1／§24.5.2／Table 24-1／Table 24-3／Table 24-4（sha256は[hardware-bom.md](https://github.com/wachi-yoshitaka-11-dev/deskcat/blob/b7cb5290715eded3530c7626d92bef5df3361540/docs/hardware/hardware-bom.md)の`MEAS-02`行。取得物のsha256一致を2026-08-17に確認した） |
| 2026-08-20 | 50 | **`GND topology（測定前に必ず確定させる）`へ、方式1の記録係を足すときの実施可能範囲を追記した**（`HW-TBD-034`作業3の準備）。**上図のstar pointは`5V ingress GND`を含み、それは変換基板`PSU-INGRESS-01`で作るものだが同品は未購入である。したがって完全な構成は現時点で組めない。****組める範囲は段階B-1に限られる**（同段階はgateも追加購入も要さないと`5 V ingress`が定めている）。段階B-1で確認できるもの（**PCのGNDが経路へ入る影響**、記録係のGNDをESP32 GNDへ落としたときのADC値の妥当性、入力headroom）と、確認できないもの（**servo戻りとshuntを含むstar point**、`5V ingress GND`とstar pointの同一node性、`ADC-SHUNT`の基準電位）を表で分けた。**段階B-1で得た結果を段階Cのtopologyの検証として扱わない。**したがって未解決3点の(3)は、**star point構成そのものの確認を含むため変換基板が揃うまで完了しない。****gateは開いていない。数値も規則も再掲していない** | [#3](https://github.com/wachi-yoshitaka-11-dev/deskcat/issues/3)、[hardware-bom.md](https://github.com/wachi-yoshitaka-11-dev/deskcat/blob/b7cb5290715eded3530c7626d92bef5df3361540/docs/hardware/hardware-bom.md)の購入待ちリスト |
| 2026-08-20 | 51 | **oscilloscopeを所有していないという前提を訂正した。**この文書は#55以来「Oscilloscopeは所有していないため使用しない」と記載し、Revision 46でも「実際にoscilloscopeは購入しない。手持ちのArduino Uno R3を候補とする」としていたが、**2026-08-20に現物の写真で`QUIMAT DSO Shell`の所持が判明した**（[hardware-bom.md](https://github.com/wachi-yoshitaka-11-dev/deskcat/blob/b7cb5290715eded3530c7626d92bef5df3361540/docs/hardware/hardware-bom.md)の`MEAS-05`）。**購入しないという判断は変わらないが、方式1の候補がArduino Uno R3だけではなくなった。**`方式1`の表へ`手持ちの候補（購入不要）その2`の行を足し、筐体の表示・操作部・**入力がBNC 1系統**であることを記録した。**入力が1系統である点は`ADC-5V`と`ADC-3V3`を同時に見られない可能性を示すため、候補の種別(1)（2 ch以上）を満たすかは判定できない。****電源入力の種別（DC jack／USB／電池）も未確認で、独立給電の条件を満たすかも判定できない。**帯域・sample rate・入力範囲・確度はいずれも未取得であり書かない（推測禁止。`必要帯域の根拠`も`TBD`のままである）。**通電していない。****採否は`HW-TBD-034`の`(1) 測定器の採否`であり人間の判断のため、この改訂では判断しない。**あわせて**デジタルテスターの型番を本文9箇所で`MAS830L`から`DT830B`へ訂正した**（現物の本体表示。正は[hardware-bom.md](https://github.com/wachi-yoshitaka-11-dev/deskcat/blob/b7cb5290715eded3530c7626d92bef5df3361540/docs/hardware/hardware-bom.md)の`MEAS-03`）。**Revision履歴の過去行は書き換えていない。****gateは開いていない。数値も規則も再掲していない** | [#3](https://github.com/wachi-yoshitaka-11-dev/deskcat/issues/3)、[hardware-bom.md](https://github.com/wachi-yoshitaka-11-dev/deskcat/blob/b7cb5290715eded3530c7626d92bef5df3361540/docs/hardware/hardware-bom.md)の`MEAS-03`／`MEAS-05` |
| 2026-08-21 | 52 | **`基準電圧が未解決である（設計上の論点）`へ`DT830Bの一次資料で分かったこと（2026-08-21）`を追加した。**付属取扱説明書（ウィキャン株式会社『ミニデジタルテスター 取扱説明書』）を確認した結果、**range別の確度と基準温度は取扱説明書にも本体表示にも無いことが確定した。****確度をこの品の一次資料から得る道は無い。****ただし`最小単位`から不確かさの下限が定まる。**5 V railは20 Vrange（最小単位10 mV）で測るため**AV<sub>CC</sub>の読みの不確かさは少なくとも10 mV（5 V付近で約0.2 %）あり、比率法では相対誤差がそのまま伝わるため1.1 V付近で約±2 mVに相当する。****これは下限であって確度ではない。確度が未取得なので実際はこれより悪い。****「±10 mVである」と書かず「少なくとも±10 mVある」と書く。****本体表示と取扱説明書の上限電圧が食い違っている**ことも記録した（`1000V⎓MAX`／`750V~MAX` 対 `600Vを越える電圧は計測しないで下さい`）。**5 V系の測定には影響せず、原因は特定していない。**低い方を上限として扱う。入力インピーダンスは同書にも記載が無く、**§24.5.2の`high impedance voltmeter`要求の判定には依然として使えない**（比率法を採る判断は変わらない）。**gateは開いていない。合否判定へは使っていない。**測定器の記載の正は[hardware-bom.md](https://github.com/wachi-yoshitaka-11-dev/deskcat/blob/b7cb5290715eded3530c7626d92bef5df3361540/docs/hardware/hardware-bom.md)の`MEAS-03`であり、**そこへ再掲しない値はここにも置かない** | [#3](https://github.com/wachi-yoshitaka-11-dev/deskcat/issues/3)、[hardware-bom.md](https://github.com/wachi-yoshitaka-11-dev/deskcat/blob/b7cb5290715eded3530c7626d92bef5df3361540/docs/hardware/hardware-bom.md)の`MEAS-03` |
| 2026-08-21 | 53 | **`HW-TBD-034`作業2を実施し、方式1の未解決3点のうち(1) 基準電圧の校正が解けた。**AV<sub>CC</sub>を`5V` pinで実測し、周囲温度を記録して`V_INT`のこの個体の実値を絶対電圧として確定した。**`DS40002061B` Table 29-15の規定内であり、同表の個体差の記載と整合する。**`方式1で残っている未解決3点`の表の状態列を2026-08-21時点へ更新した。**具体的な値・不確かさ・限定はこのRevision行へ書かず、同表に置く**（値が更新されるとRevision行が古くなるためである。実際に一度古くしている。Revision 49と同じ扱いにする）。**不確かさは`最小単位`とADC量子化から出した下限であって確度ではない。**DT830Bのrange別確度はメーカーが公開していないことが確定しているため、**それを超える主張をしない。****残る限定を明記した。**測ったのは`5V` pinであり`AVCC` pinと同一nodeではない代理値である。温度補正はしていない（`DS40002061B`にATmega328Pの内蔵基準の温度依存の図が無い）。**別のAV<sub>CC</sub>へこの値を持ち越せない。****未加工の観測は[experiment-log.md](https://github.com/wachi-yoshitaka-11-dev/deskcat/blob/b7cb5290715eded3530c7626d92bef5df3361540/docs/hardware/experiment-log.md)の`EXP-002`にある。この文書には要件と照合する値だけを置いた。****`HW-TBD-028`(b)(c)(d)の合否判定には使っていない**（判定は`Blocked`のままである）。**どのgateも開いていない。残るのは(3) GND topologyだけだが、それが解けてもcloseしない**（close条件の全数は[tbd-register.md](https://github.com/wachi-yoshitaka-11-dev/deskcat/blob/b7cb5290715eded3530c7626d92bef5df3361540/docs/hardware/tbd-register.md)の`HW-TBD-034`が持つ） | [#3](https://github.com/wachi-yoshitaka-11-dev/deskcat/issues/3)、[experiment-log.md](https://github.com/wachi-yoshitaka-11-dev/deskcat/blob/b7cb5290715eded3530c7626d92bef5df3361540/docs/hardware/experiment-log.md)の`EXP-002`、`DS40002061B` §24.4／§24.7／Table 24-3／Table 24-4／Table 29-15 |
| 2026-08-21 | 54 | [PR #158](https://github.com/wachi-yoshitaka-11-dev/deskcat/pull/158)の自動reviewの指摘2件を反映した。**どちらも主張を弱める方向であり、gateは開いていない。**(a) **`方式1で残っている未解決3点`の(1)を、解決済みから`大きく進んだが未解決`へ戻した。**`EXP-002`が測ったのは`5V` pinであり**ATmega328Pの`AVCC` pinと同一nodeではない。****その差を測っておらず上限も与えていないため、絶対電圧としての`V_INT`を主張できない。****限定を書いたうえで解決済みにするのは、限定を書いていないのと同じである。**解けた部分（方法、代理値の実測、周囲温度の記録、再現できる形での記載、確度が取得できないことの確定と不確かさの下限の導出）と、残る作業（`5V` pinと`AVCC` pinの差を測るか上限を与えること）を同表に分けて書いた。**`experiment-log.md`の`EXP-002`と`tbd-register.md`、およびsketchの出力表記も同じ扱いへ揃えた**（sketchは`AVCC_measured`を`AVCC_proxy`へ改め、`V_INT_estimate`という名にした）。(b) **`DT830Bを電流測定に使うときの制約`節を新設した。**この文書の複数の手順がDT830Bで電流を測ることを前提にしていたが、**使う端子も測定時間も余裕も書いていなかった。端子を誤ると測定器を壊し、しきい値を下回る読みが実電流の上限を証明しない。**端子の選択、時間制限、接続の向き、測定後の復帰を一次資料から挙げ、**burden voltageと確度がどちらも未取得であること**を明記した。**この節は測定手順を確定していない。確定していないことを明示するために置いた。****段階B-2以降の電流gateは`Blocked`のままである。**値の正は[hardware-bom.md](https://github.com/wachi-yoshitaka-11-dev/deskcat/blob/b7cb5290715eded3530c7626d92bef5df3361540/docs/hardware/hardware-bom.md)の`MEAS-03`であり再掲しない | [PR #158](https://github.com/wachi-yoshitaka-11-dev/deskcat/pull/158) |
| 2026-08-22 | 55 | **`HW-TBD-034`作業3の段階B-1を実施した。**`方式1で残っている未解決3点`の(3)を**「段階B-1の範囲では解けた」へ更新した。項目としては完了しない**（star point構成そのものの確認が残り、それは変換基板`PSU-INGRESS-01`が揃うまでできない）。`方式1の記録係をこのtopologyへ足すとき（HW-TBD-034 作業3）`へ実施結果を反映した。**事前に確定させていた`確認できる`3項目はすべて実測し、`確認できない`3項目は手を付けていない。****入力headroomの実測が`5 V railをADCへ直結する条件`を定量的に裏付けた。**ADCのfull scaleはArduinoのAV<sub>CC</sub>であり、監視対象の5 V railとの差が**AV<sub>CC</sub>の数%しかない。**railがその差を超えて跳ねればfull scaleを超えて飽和し、**その区間の波形が失われる。したがってdividerを外さない。****これまでこの判断の理由は定性的だった。****具体値はこのRevision行にも本文にも書かず、[experiment-log.md](https://github.com/wachi-yoshitaka-11-dev/deskcat/blob/b7cb5290715eded3530c7626d92bef5df3361540/docs/hardware/experiment-log.md)の`EXP-003`が持つ**（値が更新されるとRevision行が古くなるためである。Revision 49と同じ扱いにする）。**両方ともPCのUSB給電のみで、servoも外部電源も変換基板も過電流保護部品も使っていない。****異常は無かった**（異音・発熱・reset・brownoutのいずれも無し。人間が基板のそばで観察）。**どのgateも開いていない。**`HW-TBD-028`の合否判定には使っていない | [#3](https://github.com/wachi-yoshitaka-11-dev/deskcat/issues/3)、[experiment-log.md](https://github.com/wachi-yoshitaka-11-dev/deskcat/blob/b7cb5290715eded3530c7626d92bef5df3361540/docs/hardware/experiment-log.md)の`EXP-003` |
| 2026-08-22 | 56 | [PR #160](https://github.com/wachi-yoshitaka-11-dev/deskcat/pull/160)の自動reviewの指摘3件を反映した。**いずれも主張を弱める方向であり、gateは開いていない。**(a) **`方式1で残っている未解決3点`の(3)を、`段階B-1の範囲では解けた`から`未解決`へ下げた。****GNDの確認が片側だけである。**単端ADCの`0`は「ESP32の`GND`がArduinoの`GND`より1 LSB以上高くはない」ことしか意味せず、**低い側にずれている場合は測定範囲の外で同じく`0`と観測されうる。****したがって`0`から差の絶対値を結論できない。**両極性を測れる手段が要る。star point構成の確認が残ることも変わらない。**同じ行の`解けないと何が起きるか`欄も古かったため揃えた**（PCのGNDの影響は段階B-1で静的なA/B比較まで評価済み、未完了なのはstar point・5 V ingress・shuntを含む完全なtopologyとGNDの両極性である）。**表の状態時点も2026-08-22へ統一した。**本文が08-22の結果を載せているのに見出しが08-21のままだった。(b) **`2つの手持ち候補は代替ではなく相補である（2026-08-21の材料）`と`方式1`の候補表で、JYE Techのmanualの数値を現物の確定値として扱っていた。****現物は`QUIMAT`であり同一機種である根拠が無いため参考値へ降格した**（正は[hardware-bom.md](https://github.com/wachi-yoshitaka-11-dev/deskcat/blob/b7cb5290715eded3530c7626d92bef5df3361540/docs/hardware/hardware-bom.md)の`MEAS-05`）。**現物の観測に基づくのはchannel数と外部DC給電だけである。****この比較は採否の判断材料であって判断そのものではない**ことも冒頭に明示した。(c) **`独立給電の条件は満たす`に「独立した観測」ではないというguardが無かった**（[PR #138](https://github.com/wachi-yoshitaka-11-dev/deskcat/pull/138)で一度指摘された型である）。候補表の両行へ同じguardを置いた | [PR #160](https://github.com/wachi-yoshitaka-11-dev/deskcat/pull/160) |
| 2026-08-22 | 57 | **`HW-TBD-034`の(1)と(3)を進めた。どちらも未解決のままである。**(a) **`5V` pinと`AVCC` pinの差の経路を一次資料で特定した。**`+5V`から`L2`（10 µH インダクタ）を経て`AVCC`（pin 20）へ至る（[UNO R3 schematic](https://docs.arduino.cc/resources/schematics/A000066-schematics.pdf)の`UNO-TH_Rev3e`。sha256を記録した）。**したがって直流の差は`I_AVCC × DCR(L2)`である。****`DCR(L2)`は同schematicから得られない。**`L2`は値だけで部品番号が無い。**代わりの経路を3つ検討し、いずれも採らなかった**（pin 20の直接プローブは隣ピンとの短絡、`AREF`経由は§24.5.2の`high impedance voltmeter`要求を判定できず読みが下限になる、`5V`のADC入力は飽和して符号しか分からない）。**残る手段は`L2`の両端の実測か、`L2`のDCRの一次資料である。どちらも未実施。****未知の中身が「差が未評価」から「特定された1部品のDCRが未取得」へ変わった。**(b) **`方式1で残っている未解決3点`の(3)のうち、GNDの両極性の確認が解消した。****offsetはADCの死角にあり、`GND`の直結でも消えない。****したがってstar pointの設計は「直結すれば同電位になる」という前提で行えない。**同じ行の`解けないと何が起きるか`欄へこれを反映した。**(ii) star point構成の確認が残るため(3)は未解決のままである。****具体値はこのRevision行にも本文にも書かず、[experiment-log.md](https://github.com/wachi-yoshitaka-11-dev/deskcat/blob/b7cb5290715eded3530c7626d92bef5df3361540/docs/hardware/experiment-log.md)の`EXP-004`が持つ**（Revision 49と同じ扱い）。**どのgateも開いていない。**`HW-TBD-028`の判定には使っていない | [#3](https://github.com/wachi-yoshitaka-11-dev/deskcat/issues/3)、[experiment-log.md](https://github.com/wachi-yoshitaka-11-dev/deskcat/blob/b7cb5290715eded3530c7626d92bef5df3361540/docs/hardware/experiment-log.md)の`EXP-004` |
| 2026-08-22 | 58 | **`方式1で残っている未解決3点`の(1)を解決済みへ更新した。**`5V` pinと`AVCC` pin（pin 20）の差を直接測り、**上限がテスターのゼロ点以下で、`EXP-002`が記録している不確かさに埋もれることを確認した**（[experiment-log.md](https://github.com/wachi-yoshitaka-11-dev/deskcat/blob/b7cb5290715eded3530c7626d92bef5df3361540/docs/hardware/experiment-log.md)の`EXP-005`）。**代理値の限定は実質的に解消した。**その不確かさの範囲で絶対値として扱える。`5V` pinと`AVCC` pinの差（2026-08-22の調査）の節へ結果を反映した。**`L2`のDCRは未取得のままだが、差そのものを上限で縛れたため算出が要らなくなった。****具体値はこのRevision行にも本文にも書かず、[experiment-log.md](https://github.com/wachi-yoshitaka-11-dev/deskcat/blob/b7cb5290715eded3530c7626d92bef5df3361540/docs/hardware/experiment-log.md)の`EXP-005`が持つ**（Revision 49と同じ扱い）。**残るのは(3)のstar point構成の確認だけである。**変換基板`PSU-INGRESS-01`が揃うまでできない。**どのgateも開いていない。**`HW-TBD-028`の判定には使っていない | [#3](https://github.com/wachi-yoshitaka-11-dev/deskcat/issues/3)、[experiment-log.md](https://github.com/wachi-yoshitaka-11-dev/deskcat/blob/b7cb5290715eded3530c7626d92bef5df3361540/docs/hardware/experiment-log.md)の`EXP-005` |
| 2026-08-22 | 59 | [PR #166](https://github.com/wachi-yoshitaka-11-dev/deskcat/pull/166)の自動reviewの指摘に従い、**`それでも基準電圧は未解決である`が解決済みの記述の直後に現行文として残っていた点を直した。**見出しへ`（2026-08-22に解消。以下は当時の記録）`を付け、同節が挙げる未取得2項目の決着先を明記した（AV<sub>CC</sub>の実測は`EXP-002`、`5V` pinと`AVCC` pinの差の上限は`EXP-005`、DT830Bの確度は取得できないことが確定）。**現行の状態は`方式1で残っている未解決3点`の(1)が持つ。****あわせて`EXP-005`のraw dataの訂正により、差の上限が0.2 mVから0.1 mV未満へ変わった**（値の正は[experiment-log.md](https://github.com/wachi-yoshitaka-11-dev/deskcat/blob/b7cb5290715eded3530c7626d92bef5df3361540/docs/hardware/experiment-log.md)の`EXP-005`。**ここへ再掲しない**）。**結論は変わらない。**どちらの値でも記録済みの不確かさに埋もれる | [PR #166](https://github.com/wachi-yoshitaka-11-dev/deskcat/pull/166) |
| 2026-08-22 | 60 | **ESP32の給電経路を案Aで確定させた**（人間の判断、2026-08-22）。**節名を`ESP32の給電経路（未決定）`から`（案Aで確定。実測待ち）`へ変更し、本文の参照を全部追随させた**（Revision履歴の過去行は書き換えていない）。**案Bは削除していない。**案Aが実測で不成立の場合の再検討先として、採らない理由3点（逆流経路の恐れ、帰結が破損であること、受け入れ試験が2通り要ること）と再検討の条件（案Aの不成立の判定後、逆流の実測2通りの合格を条件とする）を残した。`配線・保護表`の`ESP32の5 V入力経路`行を案A確定へ更新し、**残るgateはPiのUSB OTG portの供給能力の実測だけ**とした。**PiのOTG port供給能力に一次資料が存在しないことの調査結果も記録した**（Zero W用のschematicsとproduct briefは公開されておらず、非WのZeroの回路図はテキストが抽出できず手元とは別基板、forumのmoderatorの記述は一次資料ではない）。**次に同じ空振りを繰り返さないためである。****Pi link経路に許容電流の公開要求を課さないことを書き分けた。これが今回の中心である。**AWG／許容電流の公開要求は5 V ingressの大電流経路（`WIRE-PWR-01`／`CABLE-PI-PWR-01`）に対する規則であり、**Pi link経路は電流の桁が違い、上限を決めるものも違い、市販品が軒並みAWGを公開していない。****代わりに判定を実測とし、判定量をESP32入力電圧が下限を割らないことの1つにした。**これでケーブル抵抗による電圧降下とPiのport供給能力を同時に判定できる。**下限は暫定であり確定値ではない**（現物の`U2`は刻印`LD1117AG`で参照設計と異なり未確認。`HW-TBD-023`）。**あわせてESP32の定常電流とpeakを記録する。****5 V ingressへの公開要求は変えていない。`経路部品と定格`表の行も増やしていない。段階Cのgateも緩めていない。****`経路部品と定格`表のM-12001行は変更していない**（`20AWG`の表示は現物根拠だが換算方法が未確定のため定格の主張に使わない）。checkboxを`案の選択は済み、残るのは実測`という実態へ改めた | [#3](https://github.com/wachi-yoshitaka-11-dev/deskcat/issues/3) |
| 2026-08-22 | 61 | [PR #174](https://github.com/wachi-yoshitaka-11-dev/deskcat/pull/174)の自動reviewの指摘3件を反映した。**いずれも主張を弱めるか、誤りの訂正である。**(a) **`ADC-5V`でPi側を判定できるとしていたのは誤りだった。**`ADC-5V`は`GPIO33`でESP32側の5 V nodeを測るものであり、**Piの`PWR IN`やOTGの`VBUS`を測っていない。****したがってOTG負荷がPiの入力電流を増やしたときにPi側の電圧が保たれるかを示せない。**判定をPi側とESP32側の2つに分け、**それぞれの測る点・判定量・下限／停止条件を表にした。****Pi側の下限は未確定であり、両方を測るまで案Aのgateは開かない。**`ロジック電圧、電源経路、起動時 GPIO が未確認なら実機駆動しない`という規則の対象である。checkboxの同じ記述も訂正した。(b) **下限4.6 Vを暫定としていたのは古い記述だった。****`U2`は2026-08-15に現物でUMW `LD1117-3.3`と確定しており、4.6 Vもその datasheet のdropout最大1.30 Vから導いた値である**（この文書自身が`定義した値をどの段階で照合するか`の(b)行でそう記録している）。**暫定という記述は文書内で矛盾していた。**根拠を現物へ直し、**`HW-TBD-023`(a)（`3V3`から取ってよい電流の上限）とPi側の最低電圧が別に未確定である**ことを分けて書いた。(c) **`配線・保護表`の`ESP32の5 V入力`行が`未決定`のままだった。**案A確定へ同期した。`案Aを既定候補とする`という表現も`案Aで確定した`へ改めた | [#3](https://github.com/wachi-yoshitaka-11-dev/deskcat/issues/3)、[PR #174](https://github.com/wachi-yoshitaka-11-dev/deskcat/pull/174) |
| 2026-08-22 | 62 | [PR #175](https://github.com/wachi-yoshitaka-11-dev/deskcat/pull/175)の自動reviewの指摘3件を反映した。(a) **窓が閉じる境界の不等号が誤っていた。**`方式によらない基準`は`80%が想定負荷を上回ること`と定めており**等号を含まない。****下限を`I >= 合計/0.8`と書いていたが正しくは`I > 合計/0.8`**であり、**境界値そのものは窓に入らない。****したがってMSP2807の定常電流が境界値以上で窓が閉じる。**以前は`超えると閉じる`と書いており、**境界値を開いている側に入れていた。**(b) **線材・cableと接続部材で受け入れ条件が違うことを分けた。****`導体抵抗`は導体の証拠であって接点の定格を証明しない。**`許容電流計算式`は絶縁電線の導体についての式であり、接点の発熱や嵌合の抵抗を扱っていない。**それまで両方へ同じ条件を課していた。****cableは導体と接点の両方を持つため、両方の条件を満たす必要がある**ことも書いた。(c) **`TBD`の件数が誤っていた。**6箇所としていたが、`過電流保護部品が連続通電できる電流`の1行は`PROT-OC-01`の未選定に起因するため`WIRE-PWR-01`／`CABLE-PI-PWR-01`に帰せられるのは**5箇所**である。**どのgateも開いていない** | [#3](https://github.com/wachi-yoshitaka-11-dev/deskcat/issues/3)、[PR #175](https://github.com/wachi-yoshitaka-11-dev/deskcat/pull/175) |
| 2026-08-22 | 63 | **`経路部品と定格`表に現れていない経路要素が1つあることを記録した。**`CABLE-PI-PWR-01`をrail側で受ける方法が未決であり、rail側にAメスの口を立てる場合（秋月 通販107429、定格1ピン1.5 A）は**1.5 Aの経路要素が1つ増える。**ケーブルを加工して直付けする場合は現れない。**上限（1500 mA、その80%の1.2 A）は動かない**——1.5 Aは`PSU-INGRESS-01`と同値であり最小値が変わらないためである。**動くのは「1.5 Aの要素が1つか2つか」であり、前者なら変換基板を別品へ替えても上限が上がらなくなる。**表だけを読むと最弱部品が1つだと読め、`変換基板を替えれば上限が上がる`という誤った前提を作るため、条件を明示した。**購入待ちリストへは足していない**（②なら購入自体が不要であり、実装方法の決定が人間待ちである）。**起票も人間の判断とする。****定格1.5 Aと価格¥140は作業指示由来であり、商品ページを一次資料として確認していない。**①を採る場合は選定時に確認する | 2026-08-22の作業指示（`触らないもの`節）。`ingressの電流制限（未解決）`と`窓が閉じる境界（2026-08-22の計算）`へ参照を追加した |
| 2026-08-24 | 64 | [#17](https://github.com/wachi-yoshitaka-11-dev/deskcat/issues/17)。**`負荷表`のServo行の出所だけを訂正した。数値は1つも変えていない。**`HW-TBD-026`の作業で、**TowerPro公式サイトにSG90のdatasheet PDFが存在しないことが確定した**ため、`データシート値0.5〜2A`という表記と`[SG90 datasheet]`というlabelで第三者掲載PDFを指していた記述が**存在しない文書を一次資料として引く形になっていた。**0.5〜2 Aは公式製品ページの仕様表ではなくレビュー欄に由来する。**250 mAの予算、実測必須の扱い、`経路部品と定格`、`受け入れ条件`、gate値はいずれも変えていない。**同じ誤帰属が[hardware-bom.md](https://github.com/wachi-yoshitaka-11-dev/deskcat/blob/b7cb5290715eded3530c7626d92bef5df3361540/docs/hardware/hardware-bom.md) `SERVO-01`と[servo-safety-limits.md](https://github.com/wachi-yoshitaka-11-dev/deskcat/blob/b7cb5290715eded3530c7626d92bef5df3361540/docs/hardware/servo-safety-limits.md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サーボ識別情報)にもあり、**1箇所だけ直すと文書間で食い違うため全数を直した。**正は`SERVO-01`である | [TowerPro公式 SG90 Digital](https://towerpro.com.tw/product/sg90-7/)、[TowerPro Download](https://towerpro.com.tw/download/)（2026-08-24確認） |
| 2026-08-24 | 65 | [PR #190](https://github.com/wachi-yoshitaka-11-dev/deskcat/pull/190)のreview指摘。**`負荷表`のServo行の`0.5〜2 A`の出所が`SG90 Digital`側ページのreview欄に限られることが判明した**（Analog側にreviewは無い）。**現物がどちらの品かが未確定であるため、variantに依存しない値として扱わない旨を併記した。数値は変えていない。****250 mAの予算、`経路部品と定格`、`受け入れ条件`、gate値もいずれも変えていない。**peak値を実測まで`TBD`とするかは`HW-TBD-010`／`011`の範囲であり、この改訂では判断しない | [TowerPro公式 SG90 Digital](https://towerpro.com.tw/product/sg90-7/)、[TowerPro公式 SG90 Analog](https://towerpro.com.tw/product/sg90-analog/)（2026-08-24確認） |
| 2026-08-24 | 66 | [#17](https://github.com/wachi-yoshitaka-11-dev/deskcat/issues/17)。**要約toolの出力に依らず、生HTMLで一次資料を再検証した。**`robots.txt`が指す`wp-sitemap.xml`からsite全体の203 URLを列挙し、`.pdf`が0件であることを確認した。SG90の3ページと`/download/`も`.pdf` link 0件、`datasheet`の語0件、**いずれもHTTP 200で実体を取得している**（403や空応答ではない）。**「公式のdatasheetが無い」という判断は維持される。****一方で、Q&A欄を読んでいなかったという抜けが判明した。****`負荷表`のServo行の`0.5〜2 A`の出所を、Revision 64／65の「レビュー欄」から「`admin`（メーカー側）の回答」へ格上げした**（2021-11-07。`The operation current for our SG90 is about 0.5A - 2A.`）。**匿名のreviewではない。****数値は変えていない。250 mAの予算、`経路部品と定格`、`受け入れ条件`、gate値も変えていない。**実測必須の扱い（`HW-TBD-010`／`011`）も変えていない。**Revision 64／65は書き換えず、ここに訂正として残す** | [TowerPro公式 SG90 Digital](https://towerpro.com.tw/product/sg90-7/)（生HTMLで2026-08-24確認） |
| 2026-08-24 | 67 | [#3](https://github.com/wachi-yoshitaka-11-dev/deskcat/issues/3)。**人間の決定2件を記録し、あわせて自分が書いた定格表記の誤りを一次資料で訂正した。どのgateも開いていない。**(a) **`rail側の受け方`を②（ケーブルを加工して直付け）で確定した**（2026-08-24、人間の判断）。終端は端子台のねじ止めとし、部材の選定は`WIRE-PWR-01`が持つ（**未選定**）。**したがって①の1.5 Aの経路要素は`経路部品と定格`表に現れず、購入待ちリストへも足さない。起票も要らなくなった。**節の見出しを`未決である`から確定した内容へ改め、同じfile内の参照2箇所も同時に直した。(b) **①の候補品の定格表記が誤っていた。**この文書はRevision 63で「定格は1ピンあたり1.5 A」と書いたが、**商品ページの表記は`定格電流(合計)：1.5A`である。**`PSU-INGRESS-01`（秋月 通販110972）の`定格電流(1ピン)：1.5A`とは**同値ではない。**Revision 63が置いた「①を採っても上限は動かない。1.5 Aは`PSU-INGRESS-01`と同値であり、最小値は変わらない」**という主張を撤回した。誤った定格表記の上に立っていた。****「合計」の定義は商品ページに無く、ピンの総和なら通過電流の上限は`1.5 A ÷ 2`まで下がり、`窓が閉じる境界`の上限も同じだけ下がる。**コネクタ全体の通過電流という読みなら同値である。**どちらとも断定していない**（[AGENTS.md](https://github.com/wachi-yoshitaka-11-dev/deskcat/blob/b7cb5290715eded3530c7626d92bef5df3361540/AGENTS.md) 推測禁止）。**②を採ったためこの未確定は経路に入らないが、将来①へ戻す場合はメーカーへの確認が前提になる。****Revision 63の行は過去時点の記録として書き換えず、訂正はここと本文に置く。**あわせて`PSU-INGRESS-01`の商品名が「**DIP化キット**」であり商品ページが基板寸法図を持つことを記録した。**「未組立である」とは断定していない。**商品ページに組立手順もセット内容も無いためであり、確定は着荷時の現物確認へ回した。工具は[hardware-bom.md](https://github.com/wachi-yoshitaka-11-dev/deskcat/blob/b7cb5290715eded3530c7626d92bef5df3361540/docs/hardware/hardware-bom.md)で扱う。(c) **`HW-TBD-030`（逆極性保護の要否と方式）を人間が承認した**（2026-08-24）。ingressへP-ch MOSFETを置き、**下流の手配線区間は保護部品ではなく極性が固定される接続方法と通電前の配線確認手順で守る。****1だけでは閉じないため2を承認範囲に含めた。**接続部材の選定は`WIRE-PWR-01`へ渡し、極性が固定されることを選定条件にした（**規則は再掲していない**）。**品番と定格はTBDのままであり、通電前の配線確認手順も未作成である。**したがって`配線・保護表`の`逆極性保護`行は**`Blocked`を維持した。**`HW-TBD-030`もcloseしていない。(d) **`窓が閉じる境界（2026-08-22の計算）`の境界値360 mAは変えていない。**②では1.5 Aの要素が嵌合接点の1つだけになるため、上限を上げたい場合は変換基板の交換で足りることだけを書き足した | [#3](https://github.com/wachi-yoshitaka-11-dev/deskcat/issues/3)、[秋月 通販107429](https://akizukidenshi.com/catalog/g/g107429/)（2026-08-24取得）、[秋月 通販110972](https://akizukidenshi.com/catalog/g/g110972/)（2026-08-24取得）、ユーザーからの決定 |
| 2026-08-24 | 68 | [PR #192](https://github.com/wachi-yoshitaka-11-dev/deskcat/pull/192)の手動reviewの指摘を反映した。**主張を弱めるか、落ちていた経路要素を足す方向であり、どのgateも開いていない。**(a) **`逆極性保護のdesign review`の逆接可否表で、`rail → Piの PWR IN`を`不可`から`可`へ改めた。**Revision 64で②（直付け）を採ったことによりrail側が手配線になったのに、この表は「Micro-Bオスcableで極性が固定される」という②以前の前提のままだった。**Pi側のMicro-B plugが固定するのはpinの並びであって、どちらの導体が+5 Vかではない。**端子台でVBUSとGNDを入れ替えるとPiへ逆電圧が掛かり、**ingressのP-ch MOSFETはこの区間より上流にあるため守れない。****Piは逆接で壊れうる3 deviceのうちの1つであり、②の決定がこの露出を作っていた。**あわせて`決定（2026-08-24）`の2の対象へ、この区間の端子割り当てを明示的に含めた。(b) **`経路部品と定格`表へ`CABLE-PI-PWR-01`のMicro-B plugとPiの`PWR IN` receptacleの嵌合接点の行を追加した。**②を採ってもPi側のplugとreceptacleは残り、Pi branchの電流を通す。同表の前置きが**経路上の部品を漏れなく並べる**ことを求めているのに、この要素はどの行にも無かった（既存の`Micro-Bオスplugとreceptacleの嵌合接点`はingress側であって別物である）。**定格は`TBD`である。**(c) **「上限を上げたい場合は変換基板の交換で足りる」を撤回した。**Pi側の嵌合接点、`CABLE-PI-PWR-01`の導体、`WIRE-PWR-01`の線材と接続部材がいずれも`TBD`であり、**変換基板の交換で外れるのは「現時点で判明している」最小値だけである。**`窓が閉じる境界（2026-08-22の計算）`側の同じ記述も揃えた。**境界値360 mAは変えていない。****この3件はRevision 67の自己レビュー8 roundが見落としたものである** | [PR #192](https://github.com/wachi-yoshitaka-11-dev/deskcat/pull/192)の手動review |
| 2026-08-24 | 69 | [#193](https://github.com/wachi-yoshitaka-11-dev/deskcat/issues/193)。**`許容電圧範囲`の積集合がservoを含まないことを明記し、代わりの追跡先を示した。**同積集合は3.3 V railの周辺module3点とESP32の`VDD33`だけを対象としており、servoは5 Vのservo railから給電するため対象外である。**しかし`PSU-SERVO-01`が供給する5 Vをservoへ入れてよいかを確認する項目が、どの文書にも無かった。**製品ページの仕様表が載せる電圧は`Operating voltage: 4.8v`だけで、`4.8–6 V`はメーカーのQ&A回答1文にしか出てこない（`HW-TBD-026`の調査で2026-08-24に判明）。**`HW-TBD-035`として登録し、この節からそこへ参照を張った。****数値も判定条件もこの節へ足していない。**`経路部品と定格`、`受け入れ条件`、`測定計画`、gate値、250 mAの予算はいずれも変えていない | [tbd-register.md](https://github.com/wachi-yoshitaka-11-dev/deskcat/blob/b7cb5290715eded3530c7626d92bef5df3361540/docs/hardware/tbd-register.md)の`HW-TBD-035`、[servo-safety-limits.md](https://github.com/wachi-yoshitaka-11-dev/deskcat/blob/b7cb5290715eded3530c7626d92bef5df3361540/docs/hardware/servo-safety-limits.md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サーボ識別情報) Revision 17 |
| 2026-08-25 | 70 | [PR #199](https://github.com/wachi-yoshitaka-11-dev/deskcat/pull/199)のreview指摘。**`負荷表`のServo行の`Transient／peak`欄に、メーカーが`operation current`として述べた値が入っていた。**出所のQ&A回答は`The operation current for our SG90 is about 0.5A - 2A.`であり、**transient／peak／stallの実測ではない。**欄の意味と一致していない旨を追記した。**値は変えていない。欄も移していない**（移すか`TBD`へ戻すかは`HW-TBD-010`／`011`と[#193](https://github.com/wachi-yoshitaka-11-dev/deskcat/issues/193)の範囲。[PR #194](https://github.com/wachi-yoshitaka-11-dev/deskcat/pull/194)が`TBD`へ戻さない判断を下しており、ここで覆さない）。**250 mAの予算、`経路部品と定格`、`受け入れ条件`、`測定計画`、gate値も変えていない。どのgateも開いていない** | [TowerPro公式 SG90 Digital](https://towerpro.com.tw/product/sg90-7/)のQ&A欄（2021-11-07。`admin`の回答） |
| 2026-08-25 | 71 | [#193](https://github.com/wachi-yoshitaka-11-dev/deskcat/issues/193)。**`負荷表`のServo行の`Transient／peak`欄で、値の種別を欄の中で書き分けた。数値は変えていない。**同欄にはメーカーが`operation current`として述べた`0.5〜2 A`が入っており、**欄の意味と一致していなかった**（Revision 70で指摘だけを記録した）。[PR #203](https://github.com/wachi-yoshitaka-11-dev/deskcat/pull/203)が「値を別の欄へ移すこと」を`HW-TBD-010`／`011`と[#193](https://github.com/wachi-yoshitaka-11-dev/deskcat/issues/193)の管轄として明示的に空けていたため、この改訂で扱った。**欄を新設して移すのではなく、同じ欄の中で「動作電流としてのメーカー回答値」と「未取得のtransient／peak実測値」を分けた。****`TBD`へ戻したのでもない**（[PR #194](https://github.com/wachi-yoshitaka-11-dev/deskcat/pull/194)の判断は維持しており、値を欄内に保持している）。**250 mAの予算、`確度`欄の`文献値。実測必須`、`経路部品と定格`、`受け入れ条件`、gate値はいずれも変えていない。**部品情報の正本は[hardware-bom.md](https://github.com/wachi-yoshitaka-11-dev/deskcat/blob/b7cb5290715eded3530c7626d92bef5df3361540/docs/hardware/hardware-bom.md) `SERVO-01`であり、同行の`Peak／stall電流`列も同じ改訂で揃えた（同文書 Revision 69） | [PR #203](https://github.com/wachi-yoshitaka-11-dev/deskcat/pull/203)の対象外節、[PR #194](https://github.com/wachi-yoshitaka-11-dev/deskcat/pull/194)、[hardware-bom.md](https://github.com/wachi-yoshitaka-11-dev/deskcat/blob/b7cb5290715eded3530c7626d92bef5df3361540/docs/hardware/hardware-bom.md) Revision 69 |
| 2026-08-25 | 72 | [#3](https://github.com/wachi-yoshitaka-11-dev/deskcat/issues/3)。**`HW-TBD-030`／`HW-TBD-021`／`HW-TBD-028`について、[#205](https://github.com/wachi-yoshitaka-11-dev/deskcat/issues/205)が決めたことを反映し、残りを限定した。どのgateも開いていない。**(a) **`HW-TBD-030`: 承認内容の2の実体である`通電前の配線確認手順`を作成した**（確認箇所、方法、記録先、通電前であることの明記、**守る区間と守らない区間の書き分け**を含む）。`3V3` pin → 周辺module3点の区間は**承認内容の1でも2でも守らない**ことを明記した。**承認内容の1（ingressのP-ch MOSFET）は2026-08-25に品番が確定した**（東芝`2SJ334`。[#205](https://github.com/wachi-yoshitaka-11-dev/deskcat/issues/205)。**同日に保留され同日のうちに解除された。**経緯と定格の記録は同Issueの作業側が持つため、この改訂では品番と「ingressだけを守る」という限定だけを参照している）。**1と2は択一ではなく守る区間が違う。****closeの判断はHumanへ渡している。**(b) **`HW-TBD-021`: 方式と品番の決定を記録した**（`方式と品番を決定した（2026-08-25）`）。ガラス管ヒューズ（Littelfuse 218 Series `02181.25HXP`、1.25 A）＋ミゼットホルダで、**PTCは採らない。**datasheetは`littelfuse.com`が403のためFarnell hostの同一文書をsha256で同一性確認して用いた。**`Interrupting Rating`列がtext抽出で空に見えるため図で確認し、`0.032`〜`3.15 A`を覆う結合cellであることを確認した。**あわせて**ホルダの定格が一次資料に無いこと**と、**5 Vの往路の直列降下をヒューズとP-ch MOSFETの2素子で見る必要があること**を記録した（ヒューズ150 mV＠定格電流、`2SJ334`最大60 mΩ＠`VGS`−4 V・`ID`−15 A。**条件が違うため合計値は書いていない**）。(c) **保護部品が経路の最小定格になったため、窓とgate値を計算し直した**（`判明している最小定格が1.25 Aへ下がった（2026-08-25）`）。**最小定格1.5 A→1.25 A、上限1.2 A→1.0 A、MSP2807の境界360 mA→160 mA。****上限は下がった。**影響する記述を全数で追随させた。**trip値の締め直しの判断は段階B-2に従属するため、この改訂では行っていない。**(d) **`HW-TBD-028`: 5項目それぞれの`確定／従属／一次資料無し`を列として揃えた**（数値は追加していない）。**(e)についてヒューズホルダの温度上昇条件が存在しないことが確定した。**(f) **2026-08-26に、入手性を確認していないことを明記した**（`入手性はこの節で確認していない（2026-08-26）`）。**方式と定格電流1.25 Aは品が替わっても変わらないが、品番は「一次資料で特性を確認した候補」であって購入が確定した品ではない。**日本の販売店での取り扱いが確認できないという報告が[#205](https://github.com/wachi-yoshitaka-11-dev/deskcat/issues/205)から来ており、**当方からは各販売店が自動アクセスを拒否するため一次で確認できなかった。**(e2) **[PR #218](https://github.com/wachi-yoshitaka-11-dev/deskcat/pull/218)の手動reviewの指摘3件を反映した。****いずれも主張を弱める方向である。****(i) 交流の遮断定格を直流の遮断能力の根拠にしていた。**`Interrupting Rating`は`35 A @ 250 VAC`であり、**同datasheetに`DC`の語は1度も現れない**（全文で確認した）。この経路は5 V DCであるため、`遮断能力はDCで未確定である`を新設し、**`方式によらない基準`の`遮断能力`は満たせていないと明記した。**gateを開けない理由も4つから5つへ増やした。**溶断すること**（関門から言える）**と、溶断時のアークを安全に断ち切れること**（未確定）**を書き分けた。****(ii) `hardware-bom.md`の`PROT-OC-01`行の`定格電圧`が`5V以上`のままで、組立品の定格として読めた。**ホルダの定格電圧が一次資料に無い以上、組立品の定格は出ない。**要求とヒューズ単体の値と未確定を書き分けた。****(iii) 抵抗rangeで読む手順に、測定前の0 V確認と放電、テスター自身の短絡・開放での動作確認、および導通側・開放側の実測値の記録を足した** | [#205](https://github.com/wachi-yoshitaka-11-dev/deskcat/issues/205)（人間が起票した発注Issueの決定と訂正）。ヒューズの一次資料は[Littelfuse 218 Series datasheet](https://www.farnell.com/datasheets/3689252.pdf)（sha256 `a3ad65e22b9514bab92ea69ee1b107be5de8ce42b271f4181401d1b7d031ffec`、2026-08-25取得）。ホルダは[FUC-03~04.pdf](https://akizukidenshi.com/goodsaffix/FUC-03~04.pdf)（**記載が無いことの確認**） |
| 2026-08-26 | 73 | [#3](https://github.com/wachi-yoshitaka-11-dev/deskcat/issues/3)。**人間の判断2件を記録した。値は1つも決めていない。gateも開いていない。**(a) **`HW-TBD-030`をcloseしないと判断した。****closeの条件を「方式が決まったこと」ではなく「守れる状態になったこと」と定めた。**残る3つ（MOSFETが未購入・未実装で実装方法も未決、色分けの接続部材が未選定、`3V3` pin → 周辺module3点を1でも2でも守っていない）は**記録が足りないのではなく実際に守られていない。**解けたら再度Humanが判断する。(b) **`HW-TBD-021`の締め直しについて、servo予算の見直しで窓を広げる方針を採った**（`servo予算の見直しで窓を広げる（2026-08-26、人間の判断）`）。**段階B-2が`HW-TBD-025`の共通条件で実施できず行き止まりになっているのに対し、測定を待たずに動かせる量がservo予算だけだからである。****servo予算は実測値ではなく設計上の割り当て予算である。****まだ実行していない。**新しい予算値が未定であり、決めるには設計判断と`servo-safety-limits.md`側での強制の2つが要る。**実行時は正式改訂の手順を踏む** | 人間の判断（2026-08-26）。関係式は`変換基板に必要な定格の見積もり`と`判明している最小定格が1.25 Aへ下がった（2026-08-25）`の既存の値から導いており、**新しい仮定を置いていない** |
| 2026-08-26 | 74 | [#236](https://github.com/wachi-yoshitaka-11-dev/deskcat/issues/236)。**[PR #235](https://github.com/wachi-yoshitaka-11-dev/deskcat/pull/235)の手動reviewで出た3件を反映した。値は1つも決めていない。****どのgateも開いていない。開けない条件を増やした方向である。**(a) **`通電前の配線確認手順`の確認箇所表で、`3V3` pin → 周辺module3点（段階B-2）を`守らない`から`守る`へ改めた。****文書内で矛盾していた。**同節は「対象は逆接可否表で`可`となっている区間だけである」と定めており、**この区間は同表で`可`である。**除外の理由は`WIRE-PWR-01`の赤黒の色分けが掛かっていないことだったが、**確認の方法の2は既に「色が付いていない導体が1本でも経路にある場合、目視だけで判定しない」と定めており、その場合の手段は3（導通）である。****色分けが掛からないことは確認が要らないことを意味しない。**誤配線は安全要件の`電圧違いのpinへ挿す`に当たる。**人間の監視は保護機構の代わりにならない。**`この手順が主張しないこと`の該当bulletと、`配線・保護表`の`逆極性保護`行の現況記述2箇所も揃えた。**承認内容の1（ingressのP-ch MOSFET）は引き続きこの区間を守らない。**(b) **`Pi link経路に許容電流の公開要求を課さない（2026-08-22）`へ`故障電流と温度上昇はこの判定に入っていない`を新設した。**`代わりの判定方法`が測るのは正常動作時の電圧と電流だけであり、**短絡時の故障電流も温度上昇も見ていない。**制限しうる2つ（PiのUSB OTG portの供給能力と保護＝**未確認**、上流の`PROT-OC-01`＝**未購入・未実装**でありPi branch全体を通す位置にある）を並べ、**どちらも現時点では根拠にできない**ことを書いた。温度上昇はOTG cableのAWGが非公開で、AWGから許容電流への換算方法も`HW-TBD-022`で未確定のため**評価する材料が無い。****案Aのgateを開けない条件を3つ増やした。**(c) **`判明している最小定格が1.25 Aへ下がった（2026-08-25）`の境界計算で、`x`が5 V入力側へ換算済みの値であることを明示した。**同じ文書の`変換基板に必要な定格の見積もり`が「5 V側へ足せるのはB-2aで得た値だけ」「regulatorの種別を確認して5 V側へ換算すれば」と定めているのに、**境界式は`x`の側を定義していなかった。****段階B-2が測るのは3.3 V側であり、換算前の値を代入すると実際のingress電流が上限を超える負荷を窓の中と判定しうる。****境界値160 mAは変えていない。**同じ値を参照する3箇所（比較表の行ラベル、式の直後、`変換基板に必要な定格の見積もり`の後段）も換算値として揃えた。**換算の規則そのものは再掲せず、`PC host側の扱い`を正本として参照した。**(d) **[tbd-register.md](https://github.com/wachi-yoshitaka-11-dev/deskcat/blob/b7cb5290715eded3530c7626d92bef5df3361540/docs/hardware/tbd-register.md)の`HW-TBD-030`の(iv)を書き換えた。**同行は「1でも2でも守っていない」と書いていたが、**「1（ingressのMOSFET）が守らない」は設計上の限定であり恒久的に真であるため、close条件に置くとこの行は永久にcloseできない。****(iv)を「通電前の配線確認手順を実施した記録が無い」へ改め、MOSFETの適用範囲は非blockingの説明として残した。**closeの条件の考え方（守れる状態になったこと）は変えていない。**(e) [PR #238](https://github.com/wachi-yoshitaka-11-dev/deskcat/pull/238)のreview指摘2件を反映した。****(c)で置いた「換算に要る3量」の表を撤回した。**`regulatorの種別`は2026-08-15に確定済み（`U2`はUMW `LD1117-3.3`、LDO。`HW-TBD-023`(b)）、`変換効率`はLDOのため適用外、`quiescent current`も同datasheetで`typ 5 mA／max 10 mA`が確定済みであり、**3量のうち2つを`未確認`と書いたのは誤りだった。**加えて`Iin ≒ Iout + Iq`とその適用条件は`PC host側の扱い`が既に持っており、**表そのものが再掲だった。****判定に使えない本当の理由は3量ではなく、`EXT_5V`の直接負荷を現物で追跡していないことである**（同節が既にそう定めている）。正本を参照する形へ改めた | [#236](https://github.com/wachi-yoshitaka-11-dev/deskcat/issues/236)、[PR #235](https://github.com/wachi-yoshitaka-11-dev/deskcat/pull/235)の手動review、[PR #238](https://github.com/wachi-yoshitaka-11-dev/deskcat/pull/238)のreview |
| 2026-08-26 | 75 | [#205](https://github.com/wachi-yoshitaka-11-dev/deskcat/issues/205)。**発注をまとめ買いへ切り替えたため、範囲が増えた分を記録した。どのgateも開いていない。**(a) **`HW-TBD-030`の承認内容の1（P-ch MOSFET）の保留を、同日のうちに解除した**（人間の判断）。品番は東芝`2SJ334`（秋月 通販102846）で確定した。`VDSS` −60 V／`VGSS` ±20 V／`ID` −30 A／`Vth` −0.8〜−2.0 V／`RDS(on)` `VGS`=−4 Vで標準46 mΩ・最大60 mΩ。**5 V railで1.0 Aでの降下は最大60 mV相当、発熱60 mW**である。**この60 mΩはdatasheetが`VGS`=−4 V、`ID`=−15 Aで規定する最大値である。****実回路の`VGS`≒−5 Vは規定条件の−4 Vより深いため、この値は保守側である。**`ID`は−15 Aから1.0 Aへ条件を移している。 | [#205](https://github.com/wachi-yoshitaka-11-dev/deskcat/issues/205)（発注をまとめ買いへ切り替えた人間の判断）、[2SJ334 datasheet](https://akizukidenshi.com/goodsaffix/2sj334.pdf)（東芝 2006-11-14、sha256 `c01da93643cb1cb11075d9137897655c556989de647c38368d5c487274d5da46`、2026-08-25取得）、[秋月 通販102846](https://akizukidenshi.com/catalog/g/g102846/) |
| 2026-08-26 | 76 | [#205](https://github.com/wachi-yoshitaka-11-dev/deskcat/issues/205)。**[ADR-0016](https://github.com/wachi-yoshitaka-11-dev/deskcat/blob/b7cb5290715eded3530c7626d92bef5df3361540/docs/decisions/0016-evidence-bar-inside-the-safety-requirements.md)（安全要件の中で、判定に効く数と資格として求める数を分ける）が2026-08-26にmergeされたため、私が持つ2行をその水準で書き直した。どのgateも開いていない。**(a) **`CABLE-PI-PWR-01`を`B-2`として明記した。**同品は許容電流もAWGも公開しておらず、**公開されていないこと自体は却下理由にしないが、比較する実在値が無いため`Bで済ませるときの条件`の1を満たしておらず、この行はまだ通っていない。****「非公開だから桁で余裕がある」とは書かない。**負荷側はPi branchの上界350 mAという実在値で押さえてあり、**足りないのは導体側である。**満たす道を3つ（同等品の公開値・実測・保守側に倒した選定）記録し、(3)の候補である通販107666を採ると**1 Aがこの表の新しい最小値になり上限が0.8 Aへ下がる**ことも残した。**あわせて、この表の最小値が幹線だけを見るのか分岐も含むのかをこの文書が定めていない、という未解決を明記した。**(b) **`PROT-RP-01`（`2SJ334`）を`B-1`として通し、`2SJ334をB-1として通す根拠（2026-08-26）`を新設した。**条件4つへの当てはめを表にした。**とくに4（Aを代替しない）については、逆極性保護の成否を決めるのは`RDS(on)`ではなく`Vth` −0.8〜−2.0 Vであり、`VGS`≒−5 Vが最悪値−2.0 Vの2.5倍であることを実在値で示した。****`RDS(on)`を1 A域で確定したとは主張していない。保守側であることを示しただけである** | [#205](https://github.com/wachi-yoshitaka-11-dev/deskcat/issues/205)、[ADR-0016](https://github.com/wachi-yoshitaka-11-dev/deskcat/blob/b7cb5290715eded3530c7626d92bef5df3361540/docs/decisions/0016-evidence-bar-inside-the-safety-requirements.md)、[Hardware Safety Policy](https://github.com/wachi-yoshitaka-11-dev/deskcat/blob/b7cb5290715eded3530c7626d92bef5df3361540/docs/governance/hardware-safety-policy.md)の`Bで済ませるときの条件`、[2SJ334 datasheet](https://akizukidenshi.com/goodsaffix/2sj334.pdf)（東芝 2006-11-14、sha256 `c01da93643cb1cb11075d9137897655c556989de647c38368d5c487274d5da46`）、[秋月 通販109314](https://akizukidenshi.com/catalog/g/g109314/)／[通販107666](https://akizukidenshi.com/catalog/g/g107666/) |
| 2026-08-26 | 77 | [#3](https://github.com/wachi-yoshitaka-11-dev/deskcat/issues/3)と[#205](https://github.com/wachi-yoshitaka-11-dev/deskcat/issues/205)。**`WIRE-PWR-01`（`111641`）の許容電流をグラフから読んだ。**Revision 76 が「数値はまだ読んでいない」として残していた項目であり、#205 の受け入れ条件にも未実施として残っていた。**`0.3sq` 曲線の両端を400 dpiで描画して pixel 座標から読み**（左端 `T1-T`≈10.8 ℃／約3.15 A、右端 ≈97.4 ℃／約10.0 A）、**2点から求めた傾き 0.525 が理論値 0.5 と読み取り誤差の範囲で一致することを確認した。**理論傾きで換算した基準点は **`I(T1-T = 100 ℃) = 10.0 A`**（読み取り幅 約9.6〜10.0 A）である。**周囲30℃・2条密着（`η0=0.85`）で約6.6 A**、25℃で約6.9 A、40℃で約6.0 A。`経路部品と定格` の該当3行（往路2本とGND戻り）へ、読んだ点を添えて入れた。**周囲温度`T`と条数・配列は決めていない**（`T`は`MEAS-04`で実測する量である。Owner: Human）。**ヒューズ`PROT-OC-01`の1.25 Aに対して約5.3倍であり、桁ではない。**`ADR-0016`の`B`が求める余裕として足りるかは判断であり、ここでは決めない。**`HW-TBD-022`はcloseしない**（(4) GND戻り経路が残る） | 住友電気工業『許容電流計算式』PDF（`(2014.02)`、sha256 `31f3293f0c0c84c527eee9f1f5b4800fb5aa759706ccb5d6ec85be4ce1326dc8`。再取得して一致）の p.2 グラフと p.1 の `η0` 表、[秋月 通販111641](https://akizukidenshi.com/catalog/g/g111641/)（`0.3sq (12/0.18)`、`温度max. 90℃`、絶縁体`イラックスA`） |
| 2026-08-27 | 79 | [#3](https://github.com/wachi-yoshitaka-11-dev/deskcat/issues/3)。**Revision 75 と 76 の結論を訂正する。**両 Revision は`PROT-RP-01`について「実回路の`VGS`≒−5 V」を前提に、`Vth`の最悪値との比（2.5倍）や`VGS`=−4 Vの`RDS(on)`規定の適用を書いていた。**Revision 75 と 76 は書き換えない**（履歴は不変として扱う）。ここで訂正を残す。**`VGS`≒−5 Vという前提が確定していない。**同じ`PROT-RP-01`について**ゲート抵抗の回路上の役割も最終値も未決定であり、`VGS`の確定方法も決まっていない。****この状態では、実回路が最悪条件で`VGS` ≤ −4 Vを保つ根拠が無い。****したがって「実回路の`VGS`≒−5 V」「`VGS`=−4 Vの`RDS(on)`規定の適用」「完全導通」を主張しない。**上の数値は`VGS` ≤ −4 Vが成り立つ場合の値であり、成り立つかは実装が決まってから判断する。**判断は`HW-TBD-030`の実装確定に従う。****`2SJ334`をB-1として通す判断そのものは`Vth`が実在値であることに拠っており、この未確定はそれを覆さない。**覆るのは電圧降下と発熱の見積りであり、成否の判定には使っていない | [PR #246](https://github.com/wachi-yoshitaka-11-dev/deskcat/pull/246) の手動 review の指摘、[2SJ334 datasheet](https://akizukidenshi.com/goodsaffix/2sj334.pdf)（東芝 2006-11-14） |
| 2026-08-27 | 80 | [#3](https://github.com/wachi-yoshitaka-11-dev/deskcat/issues/3)（`HW-TBD-021`）。**`equipment-purchase-support-fa06c7-03`セッションから、未commitで進めていた`PROT-OC-01`のPTC変更の控えをpatchで受け取った**（同セッションの worktree には入らず、差分を渡してもらった）。**受け取った数値を検算した**（`1.35 × 0.8 = 1.08 A`、余裕`(1.08 − 0.84) / 0.84 = 29%`、境界`1350 × 0.8 − 840 = 240 mA`、いずれも一致）。控えの内容を反映し、独自の作業を2件足した。**(a) 控えの反映。**`方式をPTCへ変更した（2026-08-26、人間の判断）`と配下4節（`変更した理由`／`datasheetが与える量`／`この変更が主張しないこと`／`最小定格は1.35 Aへ上がった（2026-08-26）`／`境界は240 mAへ広がった（2026-08-26）`）を新設し、`方式と品番を決定した（2026-08-25）`と`遮断能力はDCで未確定である`の先頭へ「現行はPTCを見よ」の参照blockquoteを足した。`hardware-bom.md`の`PROT-OC-01`行をPTC版へ差し替えた（ガラス管ヒューズの記述は残していない。`定格電圧`列も差し替えた。以下(c)）。**(b) `Time to Trip`グラフから3 Aの点を読んだ。**Bourns `MF-R Series` datasheet（sha256確認済み）の4ページ目のグラフを600/1200 dpiでrasterizeし、軸目盛から較正（残差最大0.03 decade）、`I=6.75 A`の`typ`読み値がdatasheetの`max`値7.3秒より短いことで較正を検証した。**結論: 3.00 Aの点は確定値として読めなかった。**`MF-R135`曲線がグラフ描画上限（1000秒）へ入るのは電流約2.97〜3.06 Aであり、3.00 Aはこの範囲をまたぐ。読めたのは下界（少なくとも数百秒、1000秒に達するか超える可能性がある）のみ。`3 Aでのトリップ時間を読み、線材と嵌合接点の判定で止まった（2026-08-27）`に読み取り方法・結果・線材と嵌合接点の判定を記録した。**線材（`111641`）は連続許容電流6.0〜6.9 Aが3 Aを上回るため持つが、嵌合接点（定格1.5 A）が3 Aの200%を数百秒以上通したときに持つかを判定する一次資料が無い。**この判定はPMへ上げた。**`HW-TBD-021`はcloseしていない。****(c) 遮断能力の判断根拠を記録した。**`遮断能力は「制限」で満たしたと判断した（2026-08-27、PMの判断）`を新設し、`Imax` 40 A ≧ 3 Aと「制限」機構の関係、および[Hardware Safety Policy](https://github.com/wachi-yoshitaka-11-dev/deskcat/blob/b7cb5290715eded3530c7626d92bef5df3361540/docs/governance/hardware-safety-policy.md)の「短絡」項目の目的（故障電流を最弱部品の定格以下へ人の介入より速く落とすこと）を判断根拠として書いた。**(d) 派生値を両方向で走査し、`1.25`／`1.0 A以下`／`1.2 A`／`160 mA`の残存を洗い出して直した。**現状（歴史記録として明示的に残す箇所を除く）で最新値に追随していなかった約15箇所（`経路部品と定格`表のPROT-OC-01行、`ingressの電流制限`冒頭、`過電流保護（段階Cのgate）`冒頭、`deratingと判定量`、`配線・保護表`の`過電流保護`行と`Connector定格`行、受け入れ条件の`合成給電時にingressを通る定常電流`行、`受け入れ条件`(b)の電圧降下記述、`rail側の受け方は②`の追記、および複数の相互参照）を1.35 A／1.08 A／240 mA／PTCの記述へ揃えた。**`power-budget.md` L1150-1151（旧行番号）の宙に浮いた参照（`最小定格は1.35 Aへ上がった（2026-08-26）`を指しながら節が無かった）は、その節を新設したことで解消した。**どのgateも開いていない。`HW-TBD-021`はcloseしていない** | `WORK-INSTRUCTIONS-PROT-OC-01-PTC.md`（人間のreviewを経ていないAI作成の指示書。作業者は本人の判断で内容を検証しながら進めた）、[MF-R Series datasheet](https://akizukidenshi.com/goodsaffix/mfr.pdf)（Bourns、sha256 `7d980de97abdadc53465454d48a39c6926f1287a2fcfca77d0520a7512245fe4`、2026-08-27に再取得してhash一致を確認）、[Hardware Safety Policy](https://github.com/wachi-yoshitaka-11-dev/deskcat/blob/b7cb5290715eded3530c7626d92bef5df3361540/docs/governance/hardware-safety-policy.md) |
| 2026-08-27 | 81 | [#3](https://github.com/wachi-yoshitaka-11-dev/deskcat/issues/3)（`HW-TBD-021`）。**PMの判断3件（`プロジェクト進捗管理`セッション）を反映した。値は決めていない。gateは開いていない。**(a) **嵌合接点が3Aを持つとは扱わない**（一次資料が無い。`ADR-0016`の`A`）。(b) **方式は変えない。PTCを維持する。**ただし`変更した理由`の直後へ、**PTCが全ての点でヒューズに勝るわけではないという段落を足した。**`Itrip`直上でのトリップの遅さはPTCの既知の弱点であり、**ガラス管ヒューズ（`02181.25HXP`）は210%（2.625 A）で`120 sec., Maximum`という明確な関門を持っていた**（M-12001の3 Aは定格の240%であり、210%の関門より確実に速く溶断する）。**速度ではヒューズが上である。**(c) **`HW-TBD-021`はcloseしない。**加えて**詰まりの本体はPTCの性能ではなく、変換基板側の嵌合接点1.5 Aであることを明記した。**`Ihold`を定常840 mAより上に置く必要がある限り、方式によらず`Itrip`とM-12001の供給上限3 Aの間に遅い帯が残る。**`HW-TBD-007`へ「`VBUS`を複数pinへ渡せば実効定格が上がる可能性がある」を着荷後の現物確認項目として追加した**（新規行は作らず、既存行へ追記）。**詰まりを解く経路は保護部品の再選定ではなくHW-TBD-007の現物確認である、と切り分けた** | PM判断（2026-08-27、`プロジェクト進捗管理`セッション） |
| 2026-08-29 | 82 | [#3](https://github.com/wachi-yoshitaka-11-dev/deskcat/issues/3)。2点。(a) **`線材の許容電流をどう確定させるか`節が、`PROT-OC-01`のヒューズ→PTC変更（2026-08-26）を反映しないまま「ヒューズの1.25 Aに対して約5倍」と書いていた。**現行の基準1.35 Aへ揃え、**約4.4〜4.9倍**へ訂正した。判定の向き（桁ではない）は変わらない。(b) **その倍率が「桁で余裕がある」の基準として足りるかを、人間が判断した。**「足りる」側で採用する。**判断の経緯は[tbd-register.md](https://github.com/wachi-yoshitaka-11-dev/deskcat/blob/b7cb5290715eded3530c7626d92bef5df3361540/docs/hardware/tbd-register.md)の`HW-TBD-022`の該当追記が正であり、ここへ再掲しない。**`HW-TBD-022`はこの判断だけではcloseしない（GND戻り経路と`CABLE-PI-PWR-01`の短絡安全の受け入れが別に残る）。**gateは開いていない** | 人間の判断（2026-08-29） |
| 2026-09-01 | 83 | [#290](https://github.com/wachi-yoshitaka-11-dev/deskcat/issues/290)。**`Revision履歴`の表の破損3箇所を直した。値は1つも決めていない。どのgateも開いていない。**(a) **Revision 75 の行が3列で末尾のパイプが無く、`根拠`欄が存在しなかったため、記録から出典を入れて4列にした**（`変更`欄は書き換えていない）。(b) **Revision 75 の直後に長さ0の空行があり、Markdownが表をそこで終えるため、Revision 76 以降が表として描画されていなかった。**空行を削除した。(c) **`78`の位置に Revision 73 の行がbyte単位で複製されていたため削除した。**3つとも`9da1545`（[PR #246](https://github.com/wachi-yoshitaka-11-dev/deskcat/pull/246)）が同じhunkで入れたものであり、同commitが足したのは`75, 76, 77, 73, 79`の5行である。**`Revision 78`は、`power-budget.md`を触った45 commitのどの版にも存在したことがない**（各版を取り出して検査した）。**記録が無いため中身を作らない。番号も振り直さない。`77` → `79`の欠番はそのまま残す** | [PR #246](https://github.com/wachi-yoshitaka-11-dev/deskcat/pull/246)（`9da1545`。破損の出所）、および同fileの全commitを対象にした走査（列数、表中の空行、Revision番号の重複と欠番） |
| 2026-09-03 | 84 | [#205](https://github.com/wachi-yoshitaka-11-dev/deskcat/issues/205)。**`PROT-RP-01`の実装方法（向き、ゲート抵抗の値、基板上の配置）を決定した。**`VGSが未確定である（2026-08-27）`が未決定のまま残していた3点である。**`実装方法を決定した（2026-09-03）`を新設した。**(a) 向きはdatasheet 1ページ目のpin配列図（`1.ゲート 2.ドレイン 3.ソース`）に従い、Sourceを`PROT-OC-01`側（入力側）、Drainを分岐点側（出力側）とし、Gateは共通GND戻りへ抵抗を介してつなぐ。(b) ゲート抵抗は`RES-PULL-01`の手持ち10 kΩとし、根拠は`Ciss` 3300 pF（typ）によるRC時定数約33 µsと、`IGSS`最大±10 µAによる基準電位のずれ最大100 mV、および絶対最大定格表が`VDGR`の測定条件として`RGS = 20 kΩ`を明記していることの3点（いずれもdatasheetの実在値）。(c) この向きにより、正しい極性で`VGS`≒−5 V（ON）、逆接時は`VGS`≒+5 V（channel OFF）になることを示した。**あわせて、channelがOFFでも内蔵diode（`VDSF`最大1.7 V、`VDS`が正の値として記載される唯一の項目）がDrain側の電位次第で導通しうることを明記し、完全遮断は主張しないとした。**(d) 基板上の配置は、`PROT-OC-01`と`PROT-RP-01`を`PROTO-02`の入力パッド側（分岐点より手前）に直列配置する方針までを決め、現物合わせの座標は着荷後に決めるとした。**`配線・保護表`の`逆極性保護`行と`hardware-bom.md`の`PROT-RP-01`行、[tbd-register.md](https://github.com/wachi-yoshitaka-11-dev/deskcat/blob/b7cb5290715eded3530c7626d92bef5df3361540/docs/hardware/tbd-register.md)の`HW-TBD-030`(ii)も揃えた。**決定しただけであり実装は済んでいない。`HW-TBD-030`はcloseしていない** | [2SJ334 datasheet](https://akizukidenshi.com/goodsaffix/2sj334.pdf)（東芝、2006-11-14、sha256 `c01da93643cb1cb11075d9137897655c556989de647c38368d5c487274d5da46`。2026-09-03に1・2ページ目を再確認） |
| 2026-09-03 | 86 | [#205](https://github.com/wachi-yoshitaka-11-dev/deskcat/issues/205)。**手動review（CodeRabbit、`full review`）の指摘4件を反映した。Revision 84は書き換えない。**(1) `hardware-bom.md`の`PROT-RP-01`セルが「ゲート抵抗の役割・最終値は未決定」という旧い状態のまま残っていたため、現行状態（10 kΩ・向き・配置は決定済み）へ書き換え、旧い状態は日付付きの記述として残した。(2) `実装方法を決定した（2026-09-03）`の`VGS`の説明が、`Vth`を超えることを`RDS(on)`（`VGS`=−4 V規定）採用の根拠として使っていたが、**`Vth`は導通の開始点であって完全導通の保証ではない。**実装とGND戻りの電圧降下を含む実回路の最悪条件で`VGS` ≤ −4 Vが成り立つ根拠が無いことを明記し、`VGS`≒−5 Vと`RDS(on)`適用は条件付きの見積りに戻した。(3) 同節がゲート抵抗10 kΩの根拠として`VDGR`測定条件の`RGS = 20 kΩ`を挙げていたが、**これは測定条件であって許容範囲の保証ではなく、この回路のGate-GND間抵抗とは電圧の掛かり方も異なる。**Revision 84が挙げていた3点のうち、この1点を取り下げ、根拠を`Ciss`によるRC時定数と`IGSS`による基準電位のずれの2点へ改めた。(4) 同節が`PROT-OC-01`の`Ihold` 1.35 Aを逆電流の「頭打ち値」と書いていたが、**`Ihold`はトリップしない電流の値であって上限を保証する値ではない。**逆電流はPTCの抵抗・電源・負荷・時間・温度に依存し、トリップまで`Ihold`を超えうることを明記し、安全性は未確定のままとした | CodeRabbit `full review`（PR #338、2026-09-04） |
| 2026-09-04 | 87 | [PR #342](https://github.com/wachi-yoshitaka-11-dev/deskcat/pull/342)（`develop`→`main`昇格）の`full review`でCodeRabbitが🟠Majorを1件出した。**`PROT-RP-01`の向き（Revision 84・86）をSource/Drainで入れ替える。**Revision 84・86は書き換えない。**(1) 向きの訂正。**2SJ334の内蔵diodeはDrain-Source間に構造として存在し、channelと並列である。Revision 84・86は「channelがOFFになるか」だけを基準に向きを選んでいたが、**channelがOFFでもdiodeが順バイアスなら電流はdiodeを通り、channelの状態はそれを止めない。**従来の向き（Source=`PROT-OC-01`側／入力側、Drain=分岐点側）では、逆接シナリオでchannelは確実にOFFになる（Revision 84の記述どおり）が、**下流の分岐点（Drain側）が引き上げられうるため内蔵diodeは順バイアスのまま導通し、channelのOFFは電流を止めていなかった。**向きをDrain=`PROT-OC-01`側（入力側）、Source=分岐点側（出力側）へ入れ替えることで、同じ逆接シナリオにおいてDrain（入力側、常に真のGND）がSourceより高くなることがなくなり（Sourceを引き上げる経路はGateと同じstar pointを経由し、star point自身の電位を超えて引き上げることができないため）、**内蔵diodeは逆バイアスで導通せず、`VGS`も0以上でchannel側もOFFに留まる。**両方が阻止側になる点が、従来の向きに対する実質的な変更点である。**正しい極性でのVGSの見積り（≒−5 V、条件付き）は変えていない**（channelが主経路を取れば分岐点はDrain電位にほぼ等しくなるため）。起動直後の短い区間はdiode経由の充電に依存する（起動シーケンス依存が新たに生じる。この区間でdiodeを通る電流は`PROT-OC-01`（PTC）・配線抵抗・分岐先bulk capacitor・電源側供給能力で決まる突入電流であり測っていないため、datasheetの`IDR`と比較できる実在値を持たず「定格に余裕がある」とは主張しない）。**(2) 🟡 Minorの反映。**`33 µs`（RC時定数）は`Ciss`のtyp値に基づく条件付きの見積りであり、datasheetにmax規定は無いことを明記した。`100 mV`（leakageによる基準電位のずれ）は`IGSS`のmax欄の値だが測定条件（`VGS`=±16 V）が実回路（±5 V付近）と異なる条件付きの上限であることを明記した。**いずれもworst-caseや安全上限としては扱わない。**(3) **`hardware-bom.md`の`PROT-RP-01`行と`tbd-register.md`の`HW-TBD-030`を同期した。**`HW-TBD-030`はcloseしていない。**「向きを直したから安全になった」とは書いていない**（他の故障モード・下流耐量・PTC過渡特性は未評価のまま）。**通電は行っていない。**この判定は一次資料（datasheet）とこの文書が既に置いている配線トポロジーの記述だけから導いた | [PR #342](https://github.com/wachi-yoshitaka-11-dev/deskcat/pull/342)のCodeRabbit `full review`、[2SJ334 datasheet](https://akizukidenshi.com/goodsaffix/2sj334.pdf)（東芝、2006-11-14、sha256 `c01da93643cb1cb11075d9137897655c556989de647c38368d5c487274d5da46`。2026-09-04に1・2ページ目を再確認） |
| 2026-09-06 | 88 | [#3](https://github.com/wachi-yoshitaka-11-dev/deskcat/issues/3)。**`3.3 V rail下限の設計判断`節を新設し、`HW-TBD-025`(a)の暫定下限3.3 Vが成立しない件を解決した。**経路(1)〜(3)のいずれでもなく、下限をDISP-01の最小VCC（3.3 V。一次資料の範囲の下端）より下（3.234 V、`U2`の保証最小出力）で運用することを受け入れる形で確定した。分類は`hardware-safety-policy.md`の「供給電圧の動作の下限」（一般値で開始してよい。安全要件5項目に該当しない）。先例は`HW-TBD-028`(a)。あわせて`DISP-01`のboard上LDO（`U1`＝UMW `XC6206P332MR`）のdropout仕様（[UMW XC6206 datasheet](https://www.umw-ic.com/static/pdf/e442437afc9daa185da86486e2bfe8c5.pdf)）から、`VCC`=3.3 Vでも`U1`は既にdropout領域にあることを示し、ILI9341自身の最小動作電圧（[ILI9341 Datasheet V1.11](https://cdn-shop.adafruit.com/datasheets/ILI9341.pdf) §18.2.1 p.236、`VCI` Min 2.5 V）に対し、`VCC`直結・`U1`出力経由のいずれの給電経路でも余裕があることを確認した。**backlight電流が`U1`を経由するかは`HW-TBD-024`で未解決であり、経由すると判明した場合はこの下限の再導出を要するとcaveatを本文に明記した。**`#13`（LCD bring-up）向けに、表示不良時は先にrail電圧と`U1`出力を実測する運用も記録した。`許容電圧範囲`行と`解決経路は3つあり`の表も同期した。**`HW-TBD-002`（2026-09-06close）は経路(2)（MSP2807のVCCを5 V railへ移す）を解かないことも確認し、経路(2)は引き続きBlockedと明記した** | [UMW XC6206 datasheet](https://www.umw-ic.com/static/pdf/e442437afc9daa185da86486e2bfe8c5.pdf) Mar.2025、[ILI9341 Datasheet V1.11](https://cdn-shop.adafruit.com/datasheets/ILI9341.pdf) §18.2.1（2026-09-06取得）、[hardware-safety-policy.md](https://github.com/wachi-yoshitaka-11-dev/deskcat/blob/b7cb5290715eded3530c7626d92bef5df3361540/docs/governance/hardware-safety-policy.md)「5項目以外の扱い」節 |
| 2026-09-06 | 89 | [#3](https://github.com/wachi-yoshitaka-11-dev/deskcat/issues/3)。**`3.3 V railの許容電圧範囲`の`ACCEL-01`行へ、Revision 88で確定したrail値（3.234–3.366 V）に対する個別の安全性確認を追加した。**`ACCEL-01`のmodule一般としての受け入れ電圧範囲は`HW-TBD-004`が未解決のままTBDだが、**このrail値についてはICの`VS`動作範囲2.0–3.6 V（typ 2.5 V。sensor-datasheet-notes.mdに既存記録、値は再掲していない）とADXL345のsupply current 140 µA typ（同）から、両端とも余裕を持って入ることを確認した。**headerとIC足の間の直列抵抗は現物未確認のままだが、下側余裕（約1.234 V）を使い切る抵抗値は`1.234 V ÷ 140 µA ≈ 8.8 kΩ`であり、供給pinに現実的な値と3桁近く離れているため、**直列抵抗の値によらず結論は変わらない**。**これは`HW-TBD-025`(a)（このrail値に対する安全性）の判断であり、`HW-TBD-004`（module一般としての受け入れ電圧範囲。I2Cアドレス等も含む）はcloseしていない。**`sensor-datasheet-notes.md`と`HW-TBD-004`行自体は、`#1`／`#2`との近接を避けるため触っていない | sensor-datasheet-notes.mdの`供給電圧（動作範囲）`行・`Supply Current`行（ADXL345 Rev. G。既存記録） |
| 2026-09-06 | 90 | [#3](https://github.com/wachi-yoshitaka-11-dev/deskcat/issues/3)。**`HW-TBD-028`(a)（Pi入力で許容する最低電圧）を、受け入れ試験の閾値として要求しない（要件から外す）と決定した。**決定はPM（`deskcat-f2`）が下した。「実測で決める」か「要件から外す」の2択のうち後者を採り、根拠（外しても新たに失われる能力が無いこと、安全要件5項目に該当しないこと、実測は調達`#205`の範囲へ出ること）と、外すもの／外さないもの（Pi側の(c)(d)は対象外、ESP32側の(b)(c)(d)と`HW-TBD-007`／`HW-TBD-009`と`#247`の診断は対象外にしない、(d)の継続時間0は確定のまま）、復帰条件（可変電源の調達、またはPi Zero W向け一次資料の公開）を`(a)を要件から外す（2026-09-06、PM決定）`節に記録した。**あわせて、この決定に至る過程で一度`HW-TBD-028`(a)へ暫定値4.63 Vを置き（`d5fc023`）、後に取り下げた（revert）経緯を記録した。**取り下げの理由はPMの誤りである。PMが「policyを正本とし一般値側へ置く」と決定した際、本節（`(a)の一次資料は存在しない`）を読んでおらず、同節が低電圧検出のしきい値4.63 Vを既に検討し名指しで却下していたことを見落としていた。PM自身がこの誤りを発見しrevertを指示した。**`許容電圧範囲`行と`確定／従属／一次資料無し`列、および(c)(d)の状態も同期した** | PMの決定（2026-09-06） |
| 2026-09-07 | 91 | [#3](https://github.com/wachi-yoshitaka-11-dev/deskcat/issues/3)。**段階B-2はB-2b（外部の3.3 V電源。`3V3` pinを使わない）を採ると決定した。**提案はPM（`deskcat-f2`）、承認はユーザー。根拠4点（B-2aの`実施条件（定格）`が循環すること、B-2aが頼るregulatorの短絡・配線ミス時の動作が未確定であること、B-2bなら`HW-TBD-023`の循環を経路ごと回避できること、2026-08-09 Revision 17の先例）を`B-2bを採る決定とMSP2807の電流制限（2026-09-07）`節に記録した。**`HW-TBD-023`(a)はB-2bでは実施条件にならないが、`HW-TBD-023`はcloseしない**（`3V3` pin給電を将来採る場合に要る）。**あわせてMSP2807の初回電流制限値150 mA（暫定の初期候補。単独で通電を許可する値ではなく、厳密な導出は不要で判定に使わない）を同節へ記録した。****`手順と停止条件`の`電流制限値の決め方`（低い値から始めて段階的に上げる）は変えていない。**ただし上げてよい範囲を決める上限は書いていない。**`手順と停止条件`の`電流制限値の上限`行が、上げてよい上限を「`全moduleの安全な上限`の最小値と、給電に使う配線の許容電流の小さい方」と定めており、**入力3つ**（`HW-TBD-024`＝MSP2807の安全な電流上限、`HW-TBD-025`(b)＝ADXL345／BME280の現物回路確認、B-2b用配線の許容電流＝未選定）**がすべて未解決であるため上限は決まらないと記録した。**`U1`（XC6206P332MR）のIlimt typ 380 mA・絶対最大`IOUT` 500 mAは「破壊しないことの参考」に留め、上限の導出には使っていない**（backlight電流が`U1`を経由するかが`HW-TBD-024`で未解決のため）。**`過電流保護（段階Cのgate）`の240 mA境界（5 V入力側へ換算した値）もこの節では使っていない**（正本が「3.3 V側の測定値と直接比べない」と定めており、`B-2bの結果で言えないこと`が`Iin ≒ Iout + Iq`等の換算をB-2bへ適用することも明示的に禁じているため）。**この整理に至る前に、PM（`deskcat-f2`）が240 mAをB-2b側の上限として提案し、単位系の誤りに自ら気づいたが、最初に出した是正案（換算を書いて使う）も正本の上記2箇所に反していたため、`#3`の作業セッションがこれを指摘して止め、PMが上限の提案そのものを撤回した経緯を同節へ注記した。**`HW-TBD-024`はcloseしない。**同節に、この値だけではB-2bが実施できないこと（電流制限の上限が未解決であること、電流制限を設定・確認できる電源が2026-09-07時点で`hardware-bom.md`に存在しないこと）も明記した。**あわせて`電源品質の数値制限`の(e)行のstale記述を訂正した。**2026-08-26のPTC化で経路要素から外れたヒューズホルダ（`FUC-03A`）への言及が残っていたため、その要素が無くなったことを記録し、(e)全体の従属状態（`HW-TBD-021`／`022`／`007`の他の経路要素は引き続き未選定・未確認）は変えていないと明記した。**[PR #364](https://github.com/wachi-yoshitaka-11-dev/deskcat/pull/364)のCodeRabbit `full review`の指摘を受け、150 mAを「保護的な設定値」と書いていた箇所を「暫定の初期候補（単独で通電を許可する値ではない）」へ改めた。**根拠はLCD Wikiのtypical消費を上回るというだけであり、そのtypical値自体が耐えられる上限ではないと同節が既に明記しているため、150 mAがMSP2807を壊さないことは示されていない。**あわせて、B-2bの保護を担うのは開始値ではなく`実施前に満たす条件`の4条件（`全moduleの安全な上限`を含む）と`手順と停止条件`の停止条件であることを1文追記した**（同PRのCodeRabbit指摘。**当初「3条件」と書いて`全moduleの安全な上限`を落としており、PMの指摘で訂正した**） | PMの提案・ユーザーの承認（2026-09-07）、[tbd-register.md](https://github.com/wachi-yoshitaka-11-dev/deskcat/blob/b7cb5290715eded3530c7626d92bef5df3361540/docs/hardware/tbd-register.md) `HW-TBD-024`（既存記録）、[PR #364](https://github.com/wachi-yoshitaka-11-dev/deskcat/pull/364)のCodeRabbit `full review` |
| 2026-09-07 | 92 | `tbd-register.md`に`Owner`列の定義を新設したのに合わせ、`Owner`を「人間が中身を決める根拠」として引用していた箇所を規則として直した。**記録（過去に何が起きたか）は書き換えていない。**指示書が挙げた8か所のうち、理由の書き方を直したのは7か所である: L303（**経路の選択はここでは決めない**（`HW-TBD-023`のOwnerはHumanである）→**経路はB-2bを採った**（`#3`のB-2b決定節を参照）。`#364`でB-2bが決まったため前半も古くなっていた）、L1585（`S`の判断は「人間が決める」→「AIが提案し、人間が承認する」）、L1803（「人間が下記の推奨案を承認した」は記録であり、主体を変える記録が無いためそのまま残し、`HW-TBD-030`のOwnerへの言及だけを外した）、L1922（HW-TBD-030のclose条件を`Owner`理由→実体（MOSFET未実装、逆極性の保護部品が経路に無い）で書いた）、L1953（同様に`Owner: Human`→実体（承認内容の2の手順が書かれ、実装されるまで）。**この節は`以下は保留を決めた時点の記録であり、書き換えていない`という断り書きが既にあり、意図的な過去記録と判定した。理由の書き方だけを直し、記録の内容は変えていない**）、L2253（`HW-TBD-034`のOwnerを決定に従う理由として挙げていた1文を外した。前半の「2026-08-16に人間が方式1を採ると決定した」という記録は残した）。**L942（人間が許容電流の公開を求めないと決めたという記録）は触っていない。**出所（`経路部品と定格`の同行のRevision記録）を確認したが「ユーザーからの決定」とあるのみでAIが案を出したという記録が無く、指示書の規則（記録が無ければ触らない）に従い残した。L944はL942と同じ決定を指す規則文だったため「AIが条件を課さないことを提案し、人間が承認して閉じる」へ直した。**残したもの**（実測・現物作業が要るため正当）: L914／L939／L2285／L2916・L2922／L3196。`tbd-register.md`側は4行5か所（`HW-TBD-021`／`022`／`028`／`030`×2）を同じ規則で直し、`HW-TBD-022`の`T`は`MEAS-04`で実測する量であるという1件は残した。**`Owner`列のセル値（`Human`／`Joint`）は1つも変えていない**（値の精度は各行の対応Issueを進めるセッションが直す） | PM作成の作業指示書（リポジトリ外、正本ではない） |
| 2026-09-08 | 93 | [#3](https://github.com/wachi-yoshitaka-11-dev/deskcat/issues/3)。`PSU-INGRESS-01`（DIP化キット）の組立状態についての古い記述を訂正した。**旧文言は「商品ページは組立手順もセット内容も明記しておらず、『未組立である』と断定できる記載が無い」としていたが、これは着荷前の判定であり、2026-09-03の着荷時現物確認（[hardware-bom.md](https://github.com/wachi-yoshitaka-11-dev/deskcat/blob/b7cb5290715eded3530c7626d92bef5df3361540/docs/hardware/hardware-bom.md)の`PSU-INGRESS-01`行）で未組立であることは既に確定している。**同記述を、確定した事実を反映した文へ差し替えた。`hardware-bom.md`の`TOOL-01`行にも同種の古い記述があったため、あわせて訂正した（同文書のRevision履歴を参照） | [hardware-bom.md](https://github.com/wachi-yoshitaka-11-dev/deskcat/blob/b7cb5290715eded3530c7626d92bef5df3361540/docs/hardware/hardware-bom.md) `PSU-INGRESS-01`行（2026-09-03の着荷時現物確認） |
| 2026-09-08 | 94 | [#3](https://github.com/wachi-yoshitaka-11-dev/deskcat/issues/3)（`HW-TBD-022`残件(4) GND戻り経路）。**「GND戻り経路を確定させた」と一度書いたが、PM（`deskcat-f2`）のレビューで訂正した。**`GND戻り経路（各railからstar pointまで）`行は`WIRE-PWR-01`（秋月`111641`）と同じ品を使い、`戻り経路は往路と同じ電流を通す`（本行の従来からの記述）ため、読み取り値（周囲25〜40℃・2条密着で約6.0〜6.9 A、Revision 77が往路2本とGND戻りの3行へ同時に入れた値）も往路と同一である。**台帳（[tbd-register.md](https://github.com/wachi-yoshitaka-11-dev/deskcat/blob/b7cb5290715eded3530c7626d92bef5df3361540/docs/hardware/tbd-register.md) `HW-TBD-022`）は「この承認は`WIRE-PWR-01`・`CABLE-PI-PWR-01`双方の導体側許容電流の評価にのみ及ぶ」と明言しており、往路・戻り路の使用箇所を区別していない。同じ導体（`111641`）を戻り経路にも使う以上、この評価はここにも及ぶと判定する。したがって導体の評価については新規の人間判断を要さない**（この最後の一文はAI判断としてここに明記する）。**ただし残る2点があり、これらを理由に行が「確定した」とは書けない。**(a) **周囲温度`T`と条数・配列は未確定のまま残る**（`T`は`MEAS-04`で実測する量である。Owner: Human）。(b) 同行は`GND topology`節の構成に従うが、**同節のstar point構成そのものの確認は変換基板が揃うまで完了しない**（`方式1で残っている未解決3点`の3。段階B-1での通電確認）。**`HW-TBD-022`を閉じるために残っていることの(4)もこの範囲に合わせて書き直し、[tbd-register.md](https://github.com/wachi-yoshitaka-11-dev/deskcat/blob/b7cb5290715eded3530c7626d92bef5df3361540/docs/hardware/tbd-register.md) `HW-TBD-022`行の記述も訂正した。**`HW-TBD-022`行自体は、これに加えて`CABLE-PI-PWR-01`の短絡安全の受け入れ（`HW-TBD-007`の着荷後の現物確認項目待ち）も残るためcloseしていない**（別途[#3](https://github.com/wachi-yoshitaka-11-dev/deskcat/issues/3)のA1として記録） | [hardware-bom.md](https://github.com/wachi-yoshitaka-11-dev/deskcat/blob/b7cb5290715eded3530c7626d92bef5df3361540/docs/hardware/hardware-bom.md) `WIRE-PWR-01`行の定義、[tbd-register.md](https://github.com/wachi-yoshitaka-11-dev/deskcat/blob/b7cb5290715eded3530c7626d92bef5df3361540/docs/hardware/tbd-register.md) `HW-TBD-022`（2026-08-29の記録）、PM（`deskcat-f2`）のレビュー（2026-09-08） |
| 2026-09-08 | 95 | [#3](https://github.com/wachi-yoshitaka-11-dev/deskcat/issues/3)（`WORK-INSTRUCTIONS-CLOSE-003-UNMET-4.md`のB3）。**`Micro-Bオスplugとreceptacleの嵌合接点`行へ、`AE-MRUSB-DIP`の現物pin配列確認結果を追記した。**非通電のテスターの導通チェックで、引き出しpin4本のうち2本が`VBUS`（シルク印刷`+`側）として導通し、残り2本が`GND`（シルク印刷`-`側、receptacle金属シェルも同グループ）として導通することを確認した。`VBUS`グループと`GND`グループの間は導通が無く、短絡していない。**ただし、この2本が導通していることと、実効的な電流定格が1ピンあたり1.5 Aより上がることは別である。**receptacle内部の配線（trace幅・銅箔厚）は非公開であり、receptacle内部の単一端子がボトルネックである可能性を排除できないため（[AGENTS.md](https://github.com/wachi-yoshitaka-11-dev/deskcat/blob/b7cb5290715eded3530c7626d92bef5df3361540/AGENTS.md) 推測禁止）、**この行の1.5 Aは変えていない。**詳細は[tbd-register.md](https://github.com/wachi-yoshitaka-11-dev/deskcat/blob/b7cb5290715eded3530c7626d92bef5df3361540/docs/hardware/tbd-register.md) `HW-TBD-007`行に記録した | 現物確認（非通電のテスターの導通チェック）、[tbd-register.md](https://github.com/wachi-yoshitaka-11-dev/deskcat/blob/b7cb5290715eded3530c7626d92bef5df3361540/docs/hardware/tbd-register.md) `HW-TBD-007` |
| 2026-09-09 | 96 | [#3](https://github.com/wachi-yoshitaka-11-dev/deskcat/issues/3)（`WORK-INSTRUCTIONS-INGRESS-PLAN-B.md`）。**2026-09-09に人間が、5 V ingressの受け方を変える決定をした（案B）。**M-12001の出力cableをMicro-Bプラグの手前で切り、導体を端子台（`114217`、6 A、着荷済み）へ直接ネジ止めする。`PSU-INGRESS-01`（`AE-MRUSB-DIP`）は経路から外れる。**理由は`経路部品と定格`の2行（`Micro-Bオスplugとreceptacleの嵌合接点`1.5 A、`Micro-Bメスreceptacle変換基板`1.5 A）が、M-12001の3 Aに対して`HW-TBD-021`が記録する遅いtripの帯を作っていたことである。**2026-09-08の現物確認（Revision 95）で`VBUS`の複数pin化では実効定格が上がらないと判明したため、この2行を経路から外す道を採った。**この反映は机上のみである。cableはまだ切っていない。**`経路部品と定格`表を更新した: (1) `M-12001に直付けされたcableとMicro-Bオスplug`からplugへの言及を外し、cable導体のみへ改めた。(2) `Micro-Bオスplugとreceptacleの嵌合接点`（1.5 A）と`Micro-Bメスreceptacle変換基板`（1.5 A）の2行を経路から外した。(3) `M-12001のcableを受ける端子台`（6 A）を新設した。(4) `変換基板から分岐点までの5 V線`を`端子台から分岐点までの5 V線`へ改称した（品・数値は変わらない）。**最小定格を自分で確かめた。**表を全部足し合わせた結果、`PROT-OC-01`（PTC）の`Ihold` 1.35 Aが引き続き経路の最小値であり、外した2行（1.5 A）はもともと最小値ではなかったため、**最小定格・gate値（1.08 A以下）とも変わらない。**あわせて、`挿入位置`節、`基板上の配置`節（`PROT-RP-01`）、`逆接可否表`（`M-12001 → PSU-INGRESS-01`を`不可`から`可`へ改め、区間名を`M-12001 → 端子台`へ改称）、`通電前の配線確認手順`の確認箇所表（新区間を追加）、`5 V ingress`節の段階表・構成表、`GND topology`節、`合成給電を部品が揃うまで行わない理由`節の入力元の記述を、案Bの構成へ揃えた。**`3 Aでのトリップ時間を読み、線材と嵌合接点の判定で止まった（2026-08-27）`が対象としていた嵌合接点（1.5 A）はこの決定により経路から外れ、その節の未解決の問い自体が対象を失ったことを注記した。**`hardware-bom.md`の`PSU-INGRESS-01`行の状態を`Selected`から`Not used`へ変更する提案をPMへ渡した（確認待ち）。**A1（`CABLE-PI-PWR-01`の短絡安全の受け入れ）はこの反映では解けない**（Pi側の嵌合接点（`経路部品と定格`の該当行）は`TBD`のまま残り、ingressの経路変更の影響を受けない。追跡は`HW-TBD-007`）。**あわせて、`2SJ334をB-1として通す根拠（2026-08-26）`節の「通電前の配線確認手順は、まだ書かれていない」という記述が、同手順を作成したRevision 72（2026-08-25）より後（2026-08-26）に書かれていながら古い状態を参照していたことに気づき、訂正した（過去のRevision行は書き換えず、この節の本文へ訂正を記した）** | PM作成の作業指示書（リポジトリ外、正本ではない）、`power-budget.md`の`経路部品と定格`（現物確認済みのPTC・線材・端子台の値）、人間の決定（2026-09-09） |
| 2026-09-09 | 97 | [#3](https://github.com/wachi-yoshitaka-11-dev/deskcat/issues/3)。**Revision 96は書き換えない。自己レビューで見つけた論点をPM（`deskcat-f2`）へ確認し、訂正した。**Revision 96は`M-12001 → 端子台`区間を`通電前の配線確認手順`の確認箇所表へ追加していたが、**同手順は「MOSFETはingress、この手順は下流の手配線区間」という排他的な分担で設計されている。**この区間はMOSFET（`PROT-RP-01`）の直前（入力側）にあり、MOSFETが本来守る対象そのものであるため、追加すると既存の分担が曖昧になる。**PMが基板上の配置（入力側 → `PROT-OC-01` → `PROT-RP-01`（Drain=入力側／Source=分岐点側）→ 分岐点）を実測で確認し、この区間の逆接はMOSFETが守ると判定した（2026-09-09、PM判断）。**したがってこの区間を確認手順の対象から外し、`逆接可否表`の該当行へPMの判断として記録し直した。**あわせて、案BがMOSFETの実装の重要度を上げること（従来は起こりえなかった逆接が起こりうる区間へ変わるため）と、MOSFET未実装の間はこの区間に保護が無いことを明記した。**実務上の配線手順（cableを切る→下流を繋がない状態でテスターで極性確認→合っていれば下流を繋ぐ）は、確認箇所表ではなく`servo試験以降で用いる構成`の`必要な部品`行（ingress構成の説明箇所）へ移した。**`PROT-OC-01`（PTC、Bourns `MF-R135`）のdatasheetに極性の指定が無いこと（全6ページを確認。`polarity`等の語なし、外形図も対称形状）は、PMの一般知識を鵜呑みにせず自分で確認した** | PM（`deskcat-f2`）とのやり取り（2026-09-09）、[MF-R Series datasheet](https://akizukidenshi.com/goodsaffix/mfr.pdf)（Bourns。全6ページ確認） |
| 2026-09-09 | 98 | [PR #371](https://github.com/wachi-yoshitaka-11-dev/deskcat/pull/371)のCodeRabbit `full review`の指摘2件を反映した。**Revision 96は書き換えない。**(1) `経路部品と定格`の`M-12001に直付けされたcable`行・`GND topology`節の`3 Aでのトリップ時間を読み...`直後の追記・`逆接可否表`の`M-12001 → 端子台`行が、いずれも「端子台へ直接ネジ止めする」と終端方法を断定していたが、`M-12001のcableを受ける端子台`行は終端方法（直接ネジ止めかはんだで太らせるか）を「cableの印字確認待ちで未定」としており、**この文書内で断定した箇所と未定とした箇所が矛盾していた。**指示書はPMの指示（「両方あり得る形で書く。直接留めると断定しない」）に従い未定とすべきだったため、断定していた3箇所を「端子台へ受ける（終端方法は`M-12001のcableを受ける端子台`行を参照）」へ揃え、未定側に合わせて訂正した。**(2) `hardware-bom.md`の`PSU-INGRESS-01`行が、経路から外れた後も段階Cの古い測定手順（変換基板前提）を長く残していた。**正本を`power-budget.md`の`経路部品と定格`・`servo試験以降で用いる構成`に一本化し、同行は短い参照へ整理した（旧い経緯はRevision履歴に残る） | [PR #371](https://github.com/wachi-yoshitaka-11-dev/deskcat/pull/371)のCodeRabbit `full review` |
| 2026-09-09 | 99 | [PR #371](https://github.com/wachi-yoshitaka-11-dev/deskcat/pull/371)のCodeRabbit follow-up指摘を反映した。**Revision 98で(1)の対応をした後も、`変換基板`前提の記述が残っていた箇所をCodeRabbitが追加で指摘した。**`5 V ingress interface`の配線・保護表行（旧候補の変換基板記述のみで案Bの端子台へ更新していなかった）、`方式1の記録係をこのtopologyへ足すとき`節の3箇所（`5V ingress GND`とstar pointの同一node性・`HW-TBD-034`未解決点(3)・確認できない3項目の理由がいずれも「変換基板が無い／揃うまで」としていた）、`サーボ接続前`checklistの合計電流測定点（「変換基板の直後」としていたが、案Bでは端子台の直後・`PROT-OC-01`の手前が正しい測定点である）、`サーボ試験`checklistの移行先構成（「Micro-Bメス変換基板」のまま）の計5箇所を、端子台前提の記述へ揃えた | [PR #371](https://github.com/wachi-yoshitaka-11-dev/deskcat/pull/371)のCodeRabbit follow-up指摘 |
| 2026-09-09 | 100 | [#3](https://github.com/wachi-yoshitaka-11-dev/deskcat/issues/3)。**Revision 96・98・99は書き換えない。**PM（`deskcat-f2`）が`origin/develop`との独立な行単位diffで、Revision 99の後もなお`変換基板`前提の古い記述が5箇所（L570・590・688・1083・1734）残っていることを見つけた。**自分とCodeRabbitのこれまでの走査は「`変換基板`かつ`段階Cのgate`文脈」に絞ったキーワード検索であり、この5箇所を含む独立な全数走査を行っていなかった。**PMの指摘を`grep`で一次確認したうえで反映した。(1) L570・590・688・1083の4箇所は既存の差し替えパターン（「端子台（**2026-09-09、案Bにより「変換基板」から差し替え**）」）へ揃えた。(2) L1734は`### 変換基板に必要な定格の見積もり`節の本文であり、同節の見出しと15箇所以上の本文参照の扱いが判断を要したため、PMへ「節の中身は受け側の部品に依存しない負荷側電流の積算ロジックであり、Revision履歴のような過去の記録ではなく生きた設計ロジックである。したがって履歴化ではなく現行の語へ改名する」という提案を送り、承認を得てから実施した。**節見出しを`### ingressに必要な定格の見積もり`へ改め、本文中の参照13箇所（見出し自身を含む）も揃えた。**Revision履歴内の当時の言及（Revision 20・21・25・73・74）は改名せず当時の表記のまま残した。改名は`power-budget.md`だけでなく、同じ参照を持つ`servo-safety-limits.md`（1箇所）・`tbd-register.md`（1箇所）にも及んだ（`hardware-bom.md`は0件。PMが最初`1件`と報告したが、PM自身の走査が`power-budget.md`だけPR headから読み残り3ファイルは`develop`から読んで混在させた誤りであり、こちらの検証結果が正しいとPMが訂正した）。(3) 節本文にもう1件、`変換基板の品をingressの実測を待たずに選べる`という記述が残っていたため、`保護部品（`PROT-OC-01`）の品を...選べる`へ揃えた（同様の差し替え注記を付けた）。(4) `tbd-register.md`の`HW-TBD-007`行冒頭「残: 5 V ingressの変換部品の購入と、connector定格の検証」のうち、既存の2026-09-09追記が「connector定格の検証」対象の変更のみに触れ「変換部品の購入」の要否に触れていなかったため、案Bにより新規の変換部品購入は不要になったことを追記して補った。**全数走査で`power-budget.md`の残り12箇所（135・722・758・759・766・812・814・817・1089・1541・2208・2818）を確認し、いずれも案Bへの言及または2026-08-24時点の自己完結した過去の分析であり、生きた記述ではないことを確認した。**`experiment-log.md`の6箇所（変換基板／`PSU-INGRESS-01`）はすべてEXP-003〜EXP-010の実験時点の構成記録であり、Revision履歴と同種の不変記録として書き換えなかった。**`AE-MRUSB-DIP`・`110972`・`DIP化キット`の別名でも走査したが、`変換基板`と別に見つかった生きた記述はなかった（すべて発注・現物確認記録などの履歴的記述）** | PM（`deskcat-f2`）の独立走査（2026-09-09）とその検証、PMとの改名提案のやり取り（2026-09-09） |
| 2026-09-09 | 101 | [#3](https://github.com/wachi-yoshitaka-11-dev/deskcat/issues/3)。**ユーザーがM-12001のcable印字を撮影し、`M-12001のcableを受ける端子台`行の終端方法を確定した。**印字は`E520447`／`AWM STYLE 2464`／`20AWG`／`80℃`／`300V`／`VW-1`／`CU AWM I A`／`FTI`／製造元名（末尾は写真で切れており未確認）。**`20AWG`は端子台（`114217`）の適合電線範囲`AWG18〜26`の内側であるため、はんだで線先を太らせる必要はなく、端子台へ直接ネジ止めする。**Revision 98で「未定」としていた終端方法をこれで確定した。**`20AWG`は`hardware-bom.md`の`PSU-SERVO-01`行（Revision 61、2026-08-22）が既に記録していた値と一致し、今回の写真がその裏付けとなった。**他の印字（`E520447`等）は今回新たに得た一次資料であり、同行へ追記した。**`20AWG`の表示は定格の主張には使わない**（換算方法が未確定。`HW-TBD-022`。既存規則を維持し、cableの許容電流は引き続き製品出力定格5 V／3 Aに含まれるものとして扱う）。**芯数（2C／4C等）は印字に無く、不明のまま進める。**切った断面で数え、使わない導体は絶縁する旨を`M-12001のcableを受ける端子台`行へ明記した。**着手前に既存記録（`hardware-bom.md`のPSU-SERVO-01行の20AWG記録）を走査していなかったことをPMに指摘された。**次回以降、現物確認の前に既存記録の走査を行う。**cableを切る作業そのものはまだ承認されていない** | ユーザー提供のcable印字写真（2026-09-09）、[hardware-bom.md](https://github.com/wachi-yoshitaka-11-dev/deskcat/blob/b7cb5290715eded3530c7626d92bef5df3361540/docs/hardware/hardware-bom.md) `PSU-SERVO-01`行（Revision 61）、[秋月 通販114217](https://akizukidenshi.com/catalog/g/g114217/) |
| 2026-09-10 | 102 | [#3](https://github.com/wachi-yoshitaka-11-dev/deskcat/issues/3)。**PM経由で人間からcableを切る作業の承認が出た。**ユーザーがM-12001の出力cableをMicro-Bプラグの手前で切り、端子台（`114217`）へ接続した。**通電はまだ行っていない。**極性（VBUS／GND）の判定は`通電前の配線確認手順`の`確認の方法3`の枠内（電源を接続しない状態でDT830Bの抵抗レンジを使う）で行った。**プラグの金属シェルを基準にした判定は不成立だった**（2026-09-08にreceptacle側で確認した「シェルがGND側」という対応が、このplug側では成立しなかった。原因未特定）。**手元に残っている`PSU-INGRESS-01`（案Bで経路からは外れたが破棄していない現物。2026-09-08にpin配列を実測済み）のreceptacleへ切り落としたplug片を挿して判定し直し、赤導体＝VBUS・黒導体＝GNDと判定した。**この対応で端子台へネジ止めした。芯数は2本（赤・黒のみ）であることも確認した。**詳細な測定記録は[experiment-log.md](https://github.com/wachi-yoshitaka-11-dev/deskcat/blob/b7cb5290715eded3530c7626d92bef5df3361540/docs/hardware/experiment-log.md)の`EXP-012`に置き、ここへ再掲しない。**この区間（M-12001 → 端子台）は`逆接可否表`の設計判断によりMOSFET（`PROT-RP-01`）が保護を担当する扱いであり、`通電前の配線確認手順`の対象外である。**MOSFETは引き続き未実装であり、現時点でこの区間には手順・部品のどちらの保護も無い。**そのため上記の抵抗レンジ判定は、設計上必須の手順ではなく慎重のための追加確認である。`M-12001に直付けされたcable`行・`M-12001のcableを受ける端子台`行を実装済みへ更新した。`tbd-register.md`の`HW-TBD-021`・`HW-TBD-022`へ、この作業でcableの切断・端子台への接続が完了したことと、通電・保護部品（`PROT-OC-01`）の実装はこの作業に含まれないことを追記した。**過去のRevision行は書き換えていない。**「テスター自体の自己確認」はユーザーの申告のみで具体的な表示値の記録が無いことを`EXP-012`に明記した | ユーザーによる現物作業（2026-09-10）、[experiment-log.md](https://github.com/wachi-yoshitaka-11-dev/deskcat/blob/b7cb5290715eded3530c7626d92bef5df3361540/docs/hardware/experiment-log.md) `EXP-012`、PM（`deskcat-f2`）の承認と手順確認（2026-09-10） |
| 2026-09-12 | 103 | [#3](https://github.com/wachi-yoshitaka-11-dev/deskcat/issues/3)。**2026-09-09の案B決定と2026-09-10の`EXP-012`により成立しなくなった阻害要因の記述を、成立しないと明記した。18箇所**（本file 9、[tbd-register.md](https://github.com/wachi-yoshitaka-11-dev/deskcat/blob/b7cb5290715eded3530c7626d92bef5df3361540/docs/hardware/tbd-register.md) 3、[experiment-log.md](https://github.com/wachi-yoshitaka-11-dev/deskcat/blob/b7cb5290715eded3530c7626d92bef5df3361540/docs/hardware/experiment-log.md) 6。**このほか[tbd-register.md](https://github.com/wachi-yoshitaka-11-dev/deskcat/blob/b7cb5290715eded3530c7626d92bef5df3361540/docs/hardware/tbd-register.md)の`HW-TBD-007`へ扱いを記録する1行を足した。訂正には数えない**）。**訂正の根拠は2通りある。**(1) **案Bと`EXP-012`で成立しなくなったもの。**旧文の阻害要因は「変換基板`PSU-INGRESS-01`が揃うまで」「端子台へcableを切って留めるまで」「同品の着荷後／着荷まで」「そこから決まる選定」で、**案Bで同品が経路から外れ**（[hardware-bom.md](https://github.com/wachi-yoshitaka-11-dev/deskcat/blob/b7cb5290715eded3530c7626d92bef5df3361540/docs/hardware/hardware-bom.md)で`Not used`）、**端子台への接続が2026-09-10に完了したことで成立しない**（**通電は未了**）。(2) **部品が無いことを理由にしていた3箇所**（`確認できない`列の「servoも`PROT-OC-01`も未購入である」「shuntが無い」、および`確認できない`3項目の理由のshunt・servo分）。**こちらは案Bとも`EXP-012`とも無関係で、[hardware-bom.md](https://github.com/wachi-yoshitaka-11-dev/deskcat/blob/b7cb5290715eded3530c7626d92bef5df3361540/docs/hardware/hardware-bom.md)の記録（`SERVO-01`のラベル現物確認、Revision 89の2026-09-08の刻印照合、`MEAS-01`の入手）が根拠である。**なお「同品は未購入」は**当時の事実であり訂正していない**（下記）。**あわせて「段階B-1での通電確認」を3箇所から削除した**（`経路部品と定格`の`GND戻り経路（各railからstar pointまで）`行、`HW-TBD-022`を閉じるために残っていることの4(b)、[tbd-register.md](https://github.com/wachi-yoshitaka-11-dev/deskcat/blob/b7cb5290715eded3530c7626d92bef5df3361540/docs/hardware/tbd-register.md)の`HW-TBD-022`行）。**`方式1の記録係をこのtopologyへ足すとき（HW-TBD-034 作業3）`が段階B-1で確認できる3項目を列挙してstar pointをその外へ置いているのと両立していなかった。代わりの段階の記述は置いていない。****この訂正が触ったのは、阻害要因の記述と、上記の「段階B-1での通電確認」の削除だけである**（18箇所にはこの削除だけを行った箇所も含む）。残る理由、実装の状態、この確認をいつどこで行うかは**判定していない**（次のPull Requestで扱う。**判定しない旨を明記した箇所と、旧文の訂正だけを行い何も足していない箇所がある**）。**編集方法は2通りある。**[experiment-log.md](https://github.com/wachi-yoshitaka-11-dev/deskcat/blob/b7cb5290715eded3530c7626d92bef5df3361540/docs/hardware/experiment-log.md)の6箇所と[tbd-register.md](https://github.com/wachi-yoshitaka-11-dev/deskcat/blob/b7cb5290715eded3530c7626d92bef5df3361540/docs/hardware/tbd-register.md)の`HW-TBD-034`は**過去の記述を書き換えず追記で残した。**本fileの9箇所と[tbd-register.md](https://github.com/wachi-yoshitaka-11-dev/deskcat/blob/b7cb5290715eded3530c7626d92bef5df3361540/docs/hardware/tbd-register.md)の`HW-TBD-022`／`HW-TBD-024`は**本文を置き換え、旧文言を訂正の中へ引用して残した**（2026-09-09の差し替え注記も同じ扱い。**いずれも内容は欠落していない**）。「同品は未購入」のように**当時の事実である記述は訂正していない**（判断の根拠は各箇所が持つ）。**残件を1件記録する。**`経路部品と定格`表の直後の「嵌合接点の定格は判明している（1.5 A）」と、同じ値を判明値として使う記述に手を付けていない。**案Bでその要素が経路から外れるとPTCの比較相手が変わり、判定表の`✓`と上限1.08 Aの見直しは`PROT-OC-01`の選定判断に触れる**（同部品は[hardware-safety-policy.md](https://github.com/wachi-yoshitaka-11-dev/deskcat/blob/b7cb5290715eded3530c7626d92bef5df3361540/docs/governance/hardware-safety-policy.md)の安全要件5項目の「短絡」に入り、方式をPTCにしたのも2026-08-26の人間の判断である）。**AIが決めない。**別のPull Requestで人間の決定事項として書き出す。**走査語`PSU-INGRESS-01`／`変換基板`で当たったが扱わなかった箇所が4件あり、次のPull Requestで扱う**（`サーボ接続前`節冒頭、`合成給電を部品が揃うまで行わない理由`、[tbd-register.md](https://github.com/wachi-yoshitaka-11-dev/deskcat/blob/b7cb5290715eded3530c7626d92bef5df3361540/docs/hardware/tbd-register.md)の`HW-TBD-007`、`配線・保護表`の`5 V ingress interface`行）。**過去のRevision行は書き換えていない** | [experiment-log.md](https://github.com/wachi-yoshitaka-11-dev/deskcat/blob/b7cb5290715eded3530c7626d92bef5df3361540/docs/hardware/experiment-log.md)の`EXP-012`、[hardware-bom.md](https://github.com/wachi-yoshitaka-11-dev/deskcat/blob/b7cb5290715eded3530c7626d92bef5df3361540/docs/hardware/hardware-bom.md)の`PSU-INGRESS-01`／`PROT-OC-01`／`SERVO-01`／`MEAS-01`、[#205](https://github.com/wachi-yoshitaka-11-dev/deskcat/issues/205)、`e82dca6`（2026-09-08。「段階B-1での通電確認」を本fileへ入れた唯一のcommit。`git log -S`で特定） |
| 2026-09-12 | 104 | [#392](https://github.com/wachi-yoshitaka-11-dev/deskcat/issues/392)。**`110521`（ヒューズホルダ）の調達の札を外した。**旧文は「ただし`110521`は4個発注済みであり、着荷する」であり、**`発注済み`は買えば偽になり、「着荷する」は未来形で着荷すれば偽になる。**調達（発注・着荷）の状態は`#205`が持つ形へ改めた（[hardware-bom.md](https://github.com/wachi-yoshitaka-11-dev/deskcat/blob/b7cb5290715eded3530c7626d92bef5df3361540/docs/hardware/hardware-bom.md)の6行と同じ書き方である）。**ヒューズホルダが経路から外れるという設計上の結論は変えていない。**`docs/hardware/`配下を3語（`未購入`／`購入待ち`／`発注済み`）と未来形で全数走査した結果、**3語と未来形で当たった生きた札はこの1件だけだった。**意志形（「次に秋月で買う機会にまとめる」「品番を確定し発注する」）で書かれた調達の記述が別に2件あるが、いずれも保存された決定の記録の中にあり、この訂正では扱っていない（所在と判定はPull Request本文） | [#392](https://github.com/wachi-yoshitaka-11-dev/deskcat/issues/392)、[hardware-bom.md](https://github.com/wachi-yoshitaka-11-dev/deskcat/blob/b7cb5290715eded3530c7626d92bef5df3361540/docs/hardware/hardware-bom.md)の`購入待ちリスト` |
| 2026-09-12 | 105 | [#3](https://github.com/wachi-yoshitaka-11-dev/deskcat/issues/3)。**Revision 103が残件として記録した「1.5 Aを判明値として使っている記述」を訂正した。3箇所である**（本file 2、[tbd-register.md](https://github.com/wachi-yoshitaka-11-dev/deskcat/blob/b7cb5290715eded3530c7626d92bef5df3361540/docs/hardware/tbd-register.md) 1）。**全数走査した結果、生きた誤りはこの3箇所だけだった**（走査語は`1.5 A`と`1.5A`、対象は`docs/hardware/`のMarkdown全件、比較対象は`origin/develop`）。**残りは日付つきの過去の記録**（`rail側の受け方は②（直付け）で確定した（2026-08-24、人間の判断）`、`①の候補品の定格は「1ピン」ではなく「合計」だった（2026-08-24の訂正）`、`方式をPTCへ変更した（2026-08-26、人間の判断）`、`窓が閉じる境界（2026-08-22の計算）`の各節とその小節ほか。**この列挙は網羅ではない。**`ingressの電流制限（未解決）`と`それでも判断に効くことが1つある`にも1.5 Aは出るが、**どちらも「現在の最小は1.35 A」と正しく書いており、訂正の対象ではない。****最小値が再び動いたときは、節の列挙ではなく走査語`1.5 A`／`1.5A`で当て直すこと**）**か、候補品の仕様そのもの**（品の定格は案Bで変わらない）**であり、訂正の対象にしない。**(a) `経路部品と定格`表の直後の「嵌合接点の定格は判明している（1.5 A）」。**その1.5 Aは変換基板側の値で、ingress側のMicro-B嵌合行は案Bで上表から外れている。上表に残る嵌合接点はPi側の1行で定格は`TBD`である。**(b) `記録するtrip動作`の「比較対象となる最弱部品（嵌合接点1.5 A）」。**同嵌合接点は案Bで経路から外れた。**比較対象は`経路部品と定格`の**保護対象側の最弱部品であり、`PROT-OC-01`自身を含まない**（同表の判明値の最小は`PROT-OC-01`のPTCであるため、単に「最小値」と書くと循環する。**本文にその旨を明記した**）。**具体の品はこの訂正では特定しない。**(c) [tbd-register.md](https://github.com/wachi-yoshitaka-11-dev/deskcat/blob/b7cb5290715eded3530c7626d92bef5df3361540/docs/hardware/tbd-register.md)の`HW-TBD-022`の「経路の既知の最小値1.5 A」。**当時の最小値であり変換基板側の値である旨を追記した**（過去の記述は書き換えず追記）。**上限1.08 Aと`方式をPTCへ変更した（2026-08-26、人間の判断）`の判定表には手を付けていない。**同節は人間が下した判断の記録であり、**判定表の`✓`が案B後も成立するか、上限を見直すべきかは`PROT-OC-01`の選定判断に触れる**（同部品は[hardware-safety-policy.md](https://github.com/wachi-yoshitaka-11-dev/deskcat/blob/b7cb5290715eded3530c7626d92bef5df3361540/docs/governance/hardware-safety-policy.md)の安全要件5項目の「短絡」に入り、方式をPTCにしたのも2026-08-26の人間の判断である）。**AIが決めない。別のPull Requestで人間の決定事項として扱う。****過去のRevision行は書き換えていない** | [hardware-bom.md](https://github.com/wachi-yoshitaka-11-dev/deskcat/blob/b7cb5290715eded3530c7626d92bef5df3361540/docs/hardware/hardware-bom.md)の`PSU-INGRESS-01`（`Not used`）、`経路部品と定格`の現在の行、2026-09-09の人間の決定（案B） |
| 2026-09-14 | 106 | [#3](https://github.com/wachi-yoshitaka-11-dev/deskcat/issues/3)。**案B後も上限1.08 Aを見直さないと決定した。提案はPM、承認はユーザー（2026-09-13に取得。正本への反映は2026-09-14）。**`上限1.08 Aは据え置く（2026-09-14）`を新設した。**数値は1つも変えていない。**あわせて`方式によらない基準`への当てはめ表の`連続通電できる電流の上限`行を訂正した。**比較相手としていた嵌合接点1.5 Aは変換基板`PSU-INGRESS-01`側の値で、2026-09-09の案Bで経路から外れている。**比較相手は`経路部品と定格`の保護対象側の最弱部品（`PROT-OC-01`自身を含まない）である。**その具体の値はこの訂正では特定しない。**保護対象側がどこから始まるか（`挿入位置`は`PROT-OC-01`をM-12001のcableを受ける端子台の直後に置くため、同端子台は上流である）と、この表の最小値が幹線だけを見るのか分岐も含むのかが、同表の`CABLE-PI-PWR-01`行のとおりこの文書で定まっていないためである。**したがって✓の成否は保留とし、成立するとは書かない。****再検討の引き金が段階B-2でのMSP2807の実測であることは、比較相手の値に依存しない。****過去のRevision行は書き換えていない** | [tbd-register.md](https://github.com/wachi-yoshitaka-11-dev/deskcat/blob/b7cb5290715eded3530c7626d92bef5df3361540/docs/hardware/tbd-register.md)の`HW-TBD-021`、[Hardware Safety Policy](https://github.com/wachi-yoshitaka-11-dev/deskcat/blob/b7cb5290715eded3530c7626d92bef5df3361540/docs/governance/hardware-safety-policy.md)の安全要件5項目 |
| 2026-09-14 | 107 | [#3](https://github.com/wachi-yoshitaka-11-dev/deskcat/issues/3)。**方式1の記録係をArduino Uno R3単独に決定した。QUIMAT DSO Shellは記録係としては採らない（捨てない）。提案はPM、承認はユーザー（2026-09-13に取得。正本への反映は2026-09-14）。**`測定器の採否を決定した（2026-09-14）`を新設した。[tbd-register.md](https://github.com/wachi-yoshitaka-11-dev/deskcat/blob/b7cb5290715eded3530c7626d92bef5df3361540/docs/hardware/tbd-register.md)の`HW-TBD-034`の項目1である。**採用の範囲は記録係の役割に限り、必要帯域を満たす主張を含まない。**同`HW-TBD-034`の項目6（必要帯域の一次資料）は独立に残る。**Arduinoのsample rateも「足りる」根拠として書かない。****DSO Shellは項目6が解けた後に帯域側の計測器として別途判断する。****gateは1つも開かない。**方式1の実装（項目2）は別に残る | [experiment-log.md](https://github.com/wachi-yoshitaka-11-dev/deskcat/blob/b7cb5290715eded3530c7626d92bef5df3361540/docs/hardware/experiment-log.md)の`EXP-001`、[hardware-bom.md](https://github.com/wachi-yoshitaka-11-dev/deskcat/blob/b7cb5290715eded3530c7626d92bef5df3361540/docs/hardware/hardware-bom.md)の`MEAS-05` |
| 2026-09-15 | 108 | [#3](https://github.com/wachi-yoshitaka-11-dev/deskcat/issues/3)（C3、`CABLE-PI-PWR-01`の短絡安全の設計判断）。**`CABLE-PI-PWR-01`をrail側で受ける端子台の行の「この端子台が`CABLE-PI-PWR-01`を受けられることは未確認である」を解いた。**範囲はC3のまま（広げていない。提案はPM、確認は作業セッション）。**導体（22AWG/2C）は`hardware-bom.md`の`CABLE-PI-PWR-01`行（2026-09-03記録の被覆印字）に既に記録されており、この訂正では再掲せず参照した。**同じ印字を2026-09-15に別セッションが独立に再読し、判断に効く`22AWG/2C`の部分が2026-09-03の記録と一致したことも本行へ追記した。**端子台の適合電線範囲（`AWG18〜26`）の内側であるため適合を確認したが、この適合は許容電流の適合ではない。**`CABLE-PI-PWR-01`行のB-2分類（許容電流・導体断面積が非公開）は解いていない。**AWGから許容電流を出す換算方法は`HW-TBD-022`が未確定のままであり、印字が読めたことは換算方法が決まったことを意味しない。****Pi側`PWR IN` receptacleの嵌合接点（定格`TBD`）はC3で扱わない。**`HW-TBD-007`の残件として引き続き同台帳が追跡する。**受け入れ条件5はこの訂正だけでは未達のままである**（接点側が残るため） | [hardware-bom.md](https://github.com/wachi-yoshitaka-11-dev/deskcat/blob/b7cb5290715eded3530c7626d92bef5df3361540/docs/hardware/hardware-bom.md)の`CABLE-PI-PWR-01`行（2026-09-03記録）、現物の被覆印字の独立な再読（2026-09-15） |
| 2026-09-16 | 109 | [#407](https://github.com/wachi-yoshitaka-11-dev/deskcat/issues/407)（昇格[PR #383](https://github.com/wachi-yoshitaka-11-dev/deskcat/pull/383)のCodeRabbit指摘、🟠Major 1件）。**`EXP-013`が記録した正本との食い違いを、正本側で解消した。****この文書を全数走査し、同じ主張を持つ箇所を5つ直した。**(a) `servo試験以降で用いる構成`の`必要な部品`行の「**(2)(3)の下流接続はまだ行っていない**（…通電もまだ行っていない）」へ、**(2)の実施と通電を反映する訂正を足した**（`EXP-013`、2026-09-14〜09-15）。**(3)を満たしたかどうかを`EXP-013`は判定しておらず、そこは未決のまま残した。**`PROT-OC-01`と分岐点は`PROTO-02`への実装が未了である（`EXP-013`はブレッドボード上の仮組み）。(b) `経路部品と定格`の`M-12001のcableを受ける端子台`行の「**通電はまだ行っていない**」へ、通電済みである旨の訂正を足した。**同じ行の「同手順としては未完了のまま」は真のまま残した。**`EXP-013`の試験0が同定したのは各導体が端子台のどちらの足へ出るかであり、**赤＝VBUS・黒＝GNDの同定そのものは`EXP-012`のplug破片による判定に依存していて、`確認の方法3`(ii)の記録要件は依然として満たされていない**（[experiment-log.md](https://github.com/wachi-yoshitaka-11-dev/deskcat/blob/b7cb5290715eded3530c7626d92bef5df3361540/docs/hardware/experiment-log.md)の`EXP-013`の試験0）。**過去の記述は書き換えず、日付つきの訂正を隣へ置いた。****測定値もgateも1つも動かしていない。上限1.08 Aも動かしていない。**(c) 同じ主張が**この文書のほかの3箇所**にも残っていた。`M-12001に直付けされたcable`行（`経路部品と定格`）、`M-12001のcableを受ける端子台`行の**`状態`列**（(b)は同じ行の`根拠`列であり、そちらだけを直すと同じ行の中で逆を言う）、`過電流保護（段階Cのgate）`の`選定基準`節。**3箇所とも同じ日付つきの訂正を足した。****残した箇所がある。**`2026-09-12更新`等の訂正ブロックの内側にある括弧書き（`EXP-012`。**通電は未了**）が6箇所ある。**分けた基準は日付の有無ではない**（直した5箇所も日付つきである）。**その文が現在の状態を述べているか、過去の判断の経緯を述べているかで分けた。**この6箇所は「2026-09-12の時点で何を根拠にそう判断したか」を述べており、**動かすとその判断が読めなくなるため残した。****あわせて照合した派生2 fileの結果。**[tbd-register.md](https://github.com/wachi-yoshitaka-11-dev/deskcat/blob/b7cb5290715eded3530c7626d92bef5df3361540/docs/hardware/tbd-register.md)に同じ趣旨の記述を持つ行が**4行**ある（3行は`通電はまだ行っていない`、1行は`通電は未了`で、文字列は同一ではない）。**上と同じ基準で分けると3対1である。**`HW-TBD-007`（現`通電はまだ行っていない`）／`021`／`022`の**3行は現在の状態を述べており、`EXP-013`により偽になっている。**`HW-TBD-034`の1行は**過去の判断の経緯（2026-09-12の訂正）の内側**にあり、上で残した6箇所と同じ形である。**この訂正ではいずれも直していない**（`#407`の範囲外。**引き受け先は[#3](https://github.com/wachi-yoshitaka-11-dev/deskcat/issues/3)である**）。[hardware-bom.md](https://github.com/wachi-yoshitaka-11-dev/deskcat/blob/b7cb5290715eded3530c7626d92bef5df3361540/docs/hardware/hardware-bom.md)の`PROT-OC-01`行に偽になった記述は無い（**同行に「未了」「実装」の語は無く、「通電」は`連続通電できる電流`という定格の説明語として1件あるだけで、通電の状態を述べた記述ではない。**同品の実装が未了であることを書いているのはこの文書であり（`経路部品と定格`と`配線・保護表`）、[hardware-bom.md](https://github.com/wachi-yoshitaka-11-dev/deskcat/blob/b7cb5290715eded3530c7626d92bef5df3361540/docs/hardware/hardware-bom.md)ではない） | [experiment-log.md](https://github.com/wachi-yoshitaka-11-dev/deskcat/blob/b7cb5290715eded3530c7626d92bef5df3361540/docs/hardware/experiment-log.md)の`EXP-013`、[PR #383](https://github.com/wachi-yoshitaka-11-dev/deskcat/pull/383)のCodeRabbit `full review` |
| 2026-09-17 | 110 | [#410](https://github.com/wachi-yoshitaka-11-dev/deskcat/issues/410)。**`経路部品と定格`表の`CABLE-PI-PWR-01`行から、`B-2`／`まだ通っていない`等の判定語を落とし、事実の記述へ差し替えた。**きっかけは[#412](https://github.com/wachi-yoshitaka-11-dev/deskcat/issues/412)の設計判定（[hardware-safety-policy.md L96-99](https://github.com/wachi-yoshitaka-11-dev/deskcat/blob/b7cb5290715eded3530c7626d92bef5df3361540/docs/governance/hardware-safety-policy.md)は甲乙丙の区分を安全要件5項目に効く値だけへ限っており、この行は[hardware-bom.md](https://github.com/wachi-yoshitaka-11-dev/deskcat/blob/b7cb5290715eded3530c7626d92bef5df3361540/docs/hardware/hardware-bom.md)が既に「5項目のいずれでもない」と記録している。すなわち`B-2`は最初からこの行に掛かっていなかった可能性が高い）。**`満たす道`（同等品の公開値／実測／107666への変更）は事実の列挙として残し、`条件1を満たす`「採否は未決」という判定の文言だけ落とした。**`107666`については`定格電流(1ピン)：1A`という公開値のみ書き、採否には触れていない。**測定値は1つも変えていない。上限1.08 Aも動かしていない。**同じ行の`状態`列（`未確定（B-2。条件1が未充足）`）は変更していない**（`状態`欄の書き方自体は#412の設計判定を待つため。残件として[Issue #410](https://github.com/wachi-yoshitaka-11-dev/deskcat/issues/410)に残す）。**過去のRevision行は書き換えていない** | [#412](https://github.com/wachi-yoshitaka-11-dev/deskcat/issues/412)、[hardware-bom.md](https://github.com/wachi-yoshitaka-11-dev/deskcat/blob/b7cb5290715eded3530c7626d92bef5df3361540/docs/hardware/hardware-bom.md)の`CABLE-PI-PWR-01`行 |
| 2026-09-17 | 111 | [#422](https://github.com/wachi-yoshitaka-11-dev/deskcat/issues/422)。**`#409`が`#13`〜`#16`のIssue本文から`HW-TBD-024`／`025`(b)への依存を外した判定を検証し、不完全だったと判定した。**`#409`はLCDWiki公式User Manual（Pin 8`LED`「制御不要なら3.3V直結可」、sha256 `0e0d3e57ca24213841907d845e509545819ec7303f0f43584c521a3f57a1d72c`。独立に再取得し照合済み）を根拠に、backlightの能動制御（PWM等）に外部可変電流制限電源を設定する必要が無くなることを示した。**これは正しい。**しかし`LED` pinはbacklightの制御信号線であり電力を流さない（[gpio-assignment.md:411](https://github.com/wachi-yoshitaka-11-dev/deskcat/blob/b7cb5290715eded3530c7626d92bef5df3361540/docs/hardware/gpio-assignment.md)、[sensor-datasheet-notes.md:50](https://github.com/wachi-yoshitaka-11-dev/deskcat/blob/b7cb5290715eded3530c7626d92bef5df3361540/docs/hardware/sensor-datasheet-notes.md)）。backlightの実電流は`MSP2807`の`VCC` pin→`R5`(6.8 Ω、現物確認済み)→LED列という別経路を通り、`VCC`は`LED` pinの配線方法によらずESP32の`3V3` pinから給電する設計である（[sensor-datasheet-notes.md:574](https://github.com/wachi-yoshitaka-11-dev/deskcat/blob/b7cb5290715eded3530c7626d92bef5df3361540/docs/hardware/sensor-datasheet-notes.md)）。`HW-TBD-024`はこの`VCC`経路の懸念をB-2aにも明記しており（`regulatorの保護のtrip点がmoduleにとって安全かを判定できない`）、`#409`はこの懸念に答えていなかった。**したがってこの懸念は「段階B-2（3点合算の定常電流測定）」という行為単位ではなく、MSP2807の`VCC`をESP32の`3V3` pinへ接続する構成そのもの（測定を伴わない単体bring-upを含む）に帰属する。**`合成給電を部品が揃うまで行わない理由`節の`B-2a`／`B-2b`の説明の直後へこの旨を追記し、`HW-TBD-024`行（不足している情報／判断・妨げる対象・状態の3箇所）へも同日付で追記した（[tbd-register.md](https://github.com/wachi-yoshitaka-11-dev/deskcat/blob/b7cb5290715eded3530c7626d92bef5df3361540/docs/hardware/tbd-register.md)）。**Espressif公式docsを独立に取得し、`3V3`pinが単に`3.3 V power supply`（type `P`）とだけ記載され、外部供給を明示的に禁じても許容してもいないことを確認した**（[ESP32-DevKitC get-started guide](https://docs.espressif.com/projects/esp-idf/en/v5.1/esp32/hw-reference/esp32/get-started-devkitc.html)）。**これにより「`3V3` pinの外部利用がboardの設計想定を超える」という論点は一次資料からは立たないことを確認したが、結論は変わらない。**問われているのは設計想定の許否ではなく、**確認済みの`U2`（UMW `LD1117-3.3`）の過電流保護trip電流（`Ilimit` min 1.25 A／max 1.6 A）が、未確認のMSP2807 backlight回路（`R5`の先）にとって安全かという、接続そのものの安全判断である。**この懸念はMSP2807固有の事実（backlightのLED経路が非分解では確認できないこと）に基づくものであり、**ADXL345／BME280を含む3.3V周辺module一般に同型の懸念が及ぶかどうかは、本Issueでは判定していない別の問いとして残す**（`#15`／`#16`の可否に関わりうる。引き受け先は未定）。**HW-TBD-024／025(b)はcloseしていない。段階Cのgateも開けていない。測定値・上限1.08 Aも変更していない。`#13`〜`#16`のIssue本文の訂正は本Revisionの範囲外とし、後続Issueへ引き継ぐ**（引き受け先は未定） | [#422](https://github.com/wachi-yoshitaka-11-dev/deskcat/issues/422)、[gpio-assignment.md](https://github.com/wachi-yoshitaka-11-dev/deskcat/blob/b7cb5290715eded3530c7626d92bef5df3361540/docs/hardware/gpio-assignment.md)、[sensor-datasheet-notes.md](https://github.com/wachi-yoshitaka-11-dev/deskcat/blob/b7cb5290715eded3530c7626d92bef5df3361540/docs/hardware/sensor-datasheet-notes.md)、[tbd-register.md](https://github.com/wachi-yoshitaka-11-dev/deskcat/blob/b7cb5290715eded3530c7626d92bef5df3361540/docs/hardware/tbd-register.md) `HW-TBD-024`、[ESP32-DevKitC get-started guide](https://docs.espressif.com/projects/esp-idf/en/v5.1/esp32/hw-reference/esp32/get-started-devkitc.html)（独立取得） |
| 2026-09-17 | 112 | [#424](https://github.com/wachi-yoshitaka-11-dev/deskcat/issues/424)。**`経路部品と定格`表の`CABLE-PI-PWR-01`行の`状態`列から、ADR-0016の分類名（`B-2`）を落とし、事実（許容電流がメーカー資料に無い）へ差し替えた。**きっかけは[#421](https://github.com/wachi-yoshitaka-11-dev/deskcat/pull/421)（developへmerge済み）が新設した「ハードウェア文書の行は事実を書く。判定を書かない」節で、同節は`状態`欄などの分類名・判定表現を禁じ、`CABLE-PI-PWR-01`（[hardware-bom.md](https://github.com/wachi-yoshitaka-11-dev/deskcat/blob/b7cb5290715eded3530c7626d92bef5df3361540/docs/hardware/hardware-bom.md)）を理由の実例に挙げている。**`未確定`という評価そのものは変えていない。**この経路の最小値へ算入するかどうかの判定は、ingressの上限1.08 Aと安全要件5項目の「短絡」に触れるため本Issueでは扱わず、[tbd-register.md](https://github.com/wachi-yoshitaka-11-dev/deskcat/blob/b7cb5290715eded3530c7626d92bef5df3361540/docs/hardware/tbd-register.md)の`HW-TBD-022`を引き受け先とした。**測定値は1つも変えていない。gateも開けていない。**過去のRevision行は書き換えていない | [#421](https://github.com/wachi-yoshitaka-11-dev/deskcat/pull/421)、[hardware-safety-policy.md](https://github.com/wachi-yoshitaka-11-dev/deskcat/blob/b7cb5290715eded3530c7626d92bef5df3361540/docs/governance/hardware-safety-policy.md)、[tbd-register.md](https://github.com/wachi-yoshitaka-11-dev/deskcat/blob/b7cb5290715eded3530c7626d92bef5df3361540/docs/hardware/tbd-register.md)の`HW-TBD-022` |
| 2026-09-18 | 113 | [#15](https://github.com/wachi-yoshitaka-11-dev/deskcat/issues/15)。**`ACCEL-01`（M-06724）について、ユーザーへ確認したところ回答を得た**（質問と回答の逐語は[tbd-register.md](https://github.com/wachi-yoshitaka-11-dev/deskcat/blob/b7cb5290715eded3530c7626d92bef5df3361540/docs/hardware/tbd-register.md)の`HW-TBD-004`。**ここへ再掲しない**）。同行が示すとおり、これにより作業セッションが提示した一覧（5行・合計10個。提示時の呼称「6種8個」は誤りだった）以外の未知の部品（level shiftや未知の直列部品）が経路に入る余地が無いと判断できるため、段階B-2共通条件の`許容電圧範囲`行へ日付つきの訂正を隣に置き、`3.3 V railの許容電圧範囲`節では「能動的なlevel shiftについては断定しない」の2段落の直後（かつ次段落「したがってheaderの電圧は…」の直前）へ訂正段落を1つ置いた（同段落内で、上のtableの`ACCEL-01`行にも言及している。**table自体のcellは書き換えていない**）。**過去の記述は書き換えていない。****`ACCEL-01`分は満たされたと判定した**（`#433`のBME280判定と同じ形）。`moduleへ入れてよい電圧`はIC自体の動作範囲（`VS` 2.0–3.6 V）と同一とする。**`MSP2807`分（`HW-TBD-024`）は残る。`HW-TBD-004`自体はI2Cアドレスの残件があり、closeしていない。**測定値は1つも変えていない。段階B-2のgateは`全moduleの安全な電流上限`（`HW-TBD-024`）が未解決のため引き続き開かない | [tbd-register.md](https://github.com/wachi-yoshitaka-11-dev/deskcat/blob/b7cb5290715eded3530c7626d92bef5df3361540/docs/hardware/tbd-register.md)の`HW-TBD-004`、[#433](https://github.com/wachi-yoshitaka-11-dev/deskcat/issues/433)（同型の判定） |
| 2026-09-21 | 114 | [#436](https://github.com/wachi-yoshitaka-11-dev/deskcat/pull/436)のCodeRabbit review 3件目の指摘（`tbd-register.md` L18への指摘）への対応。**PM（`#0PM`）が指摘を検証し、Revision 113の「経路の形は電圧の上限に効かない」を対GNDの絶対値に限る形へ狭めるよう判定した**（`許容電圧範囲`行、`3.3 V railの許容電圧範囲`節の訂正段落、`ACCEL-01`行の3箇所）。ADXL345のAbsolute Maximum Ratings表を確認し、`VDD I/O`を基準とする`Digital Pins`の相対定格が別に存在することを記録した（headerから`VDD I/O`への経路だけが断線し基板搭載pull-upがSDA/SCLを保持すればこの相対定格に触れうる）。**この懸念は購入品の製造欠陥を前提とする故障モードであり、判定の範囲外とした**（`#0PM`の判定。一次資料からの導出ではないことを明記。`#16`のstatus:blockedにも関わるため人間の最終承認を別途要する）。**headerからICへの経路の確認自体は、既存記録のとおり未確認のままTBDで残す。**BME280（`#16`）へも同型の懸念が及ぶが、同じ理由で`#16`の判定は見直さない（詳細は[tbd-register.md](https://github.com/wachi-yoshitaka-11-dev/deskcat/blob/b7cb5290715eded3530c7626d92bef5df3361540/docs/hardware/tbd-register.md)の`HW-TBD-004`。**ここへ再掲しない**）。**あわせて同じ`ACCEL-01`行（3.3 V railの許容電圧範囲節の訂正段落）で、「能動部品が存在しないことを確定した」という記述に「推論であり、ユーザーの発言そのものではない」という留保を明記した**（CodeRabbit review 2件目の指摘、`power-budget.md` L161への指摘、の対応の一部として直した）。測定値は1つも変えていない | [tbd-register.md](https://github.com/wachi-yoshitaka-11-dev/deskcat/blob/b7cb5290715eded3530c7626d92bef5df3361540/docs/hardware/tbd-register.md)の`HW-TBD-004`、[PR #436](https://github.com/wachi-yoshitaka-11-dev/deskcat/pull/436)のCodeRabbit review |
| 2026-09-21 | 115 | [#15](https://github.com/wachi-yoshitaka-11-dev/deskcat/issues/15)。**`#422`が「本節では判定しない（未解決点として残す）」と留保していた問い（ADXL345／BME280に、MSP2807のbacklight回路と同型の懸念が及ぶか）へ結論を記録した。**及ばない（ADXL345は`#430`のHW-TBD-025(b)判定と`#436`のHW-TBD-004判定、BME280は`#430`のHW-TBD-025(b)判定。両moduleとも板上の部品を網羅的に確認済みで隠れた高電流経路が無い）。**MSP2807には引き続き及ぶ（backlight回路がカプトンテープに隠れ非分解では未確認。`HW-TBD-024`はcloseしていない）。**したがってADXL345／BME280の単体bring-upはこの懸念を理由に止めない。MSP2807の単体bring-upは引き続き止める。**段階B-2（3点合算測定）のgateは、MSP2807分が未解決のため引き続きBlockedのままである。**測定値は1つも変えていない。新しい調査ではなく、既存の`#430`／`#436`の判定を足し合わせた結論である | [#422](https://github.com/wachi-yoshitaka-11-dev/deskcat/issues/422)、[#430](https://github.com/wachi-yoshitaka-11-dev/deskcat/issues/430)、[#436](https://github.com/wachi-yoshitaka-11-dev/deskcat/pull/436) |
| 2026-09-22 | 116 | [#13](https://github.com/wachi-yoshitaka-11-dev/deskcat/issues/13)。**`段階B-2の測定`節の末尾へ2つの小節を追加した。**(1) `B-2bの電流制限値の上限が決められない理由（要約）`は当初LED個数・`R5`/`Q1`経路・`U1`供給能力を再掲していたが、PM（`#0PM`）の指摘（「正本へ再掲しない」規則。実際に本文書L162が2026-08-12の古い記述のまま残り`#443`で直したばかりという実例あり）を受け、それらの事実は[tbd-register.md](https://github.com/wachi-yoshitaka-11-dev/deskcat/blob/b7cb5290715eded3530c7626d92bef5df3361540/docs/hardware/tbd-register.md)のHW-TBD-024行のみに残し、ここには「B-2bの電流制限値の上限が決められない」という帰結の一文とlinkだけを残す形へ縮小した。(2) `DISP-01`初回通電の手順（給電構成の確定待ち）は、通電前チェック（[gpio-assignment.md](https://github.com/wachi-yoshitaka-11-dev/deskcat/blob/b7cb5290715eded3530c7626d92bef5df3361540/docs/hardware/gpio-assignment.md)の新設小節）が完了した後の初回通電手順を、人間とAIの役割を分けた1本の順序として定義した。**給電構成（電源型番・電流制限値・表示方法）は空欄のままにし、`実施前に満たす条件`が揃っていないことを明記した。**通電はしていない | PM（`#0PM`）の指摘、新規追加（LCD bring-up作業） |
| 2026-09-22 | 117 | [#445](https://github.com/wachi-yoshitaka-11-dev/deskcat/issues/445)。`B-2b を採る決定`（Revision 91、2026-09-07）は書き換えず維持したまま、ADXL345（`ACCEL-01`）とBME280（`ENV-01`）の2点に限り、ESP32自身の`3V3` pinから給電することをユーザーが2026-09-22に承認した旨を同節へ追記した。`DISP-01`（MSP2807）はこの承認の対象外であり、MSP2807を含む構成・将来の合成給電（段階B-2）には引き続き2026-09-07の決定が掛かる。`HW-TBD-023`(a)（`3V3` pinの外部供給可能電流のboard level定格）は解決していない。あわせて、この2点限定の給電について`U2`（UMW LD1117-3.3）の余裕を計算した。ESP32-WROOM-32D boardの電流は既存の負荷表（Wi-Fi idle、文献値約80〜100mA）を用いた。Espressif公式ESP32 Series Datasheet v5.3のTable 4-2（chip単体のModem-sleep上限68mA）はboard-levelの内訳（flash、USB-UARTブリッジ、電源LED分）を含まないため、100mAが十分保守的とは断定していない。合計約101.5mA（ADXL345 0.14mA＋BME280 1.4mA＋ESP32 100mA＝101.54mA。BME280はBoschの湿度340µA/気圧714µA/温度350µA各max値の単純合算約1.4mAを使用。`負荷表`の「<1mA」より保守的な値である）に対し電流の余裕は`U2`の連続定格1A比で約9.85倍。損失の計算には`U2`自身の`Iq`（quiescent current、UMW LD1117 datasheetの規格値でmax 10mA）も保守側として加えた。損失約222.6mW、温度上昇は約19.6℃（ambient 40℃、`TJ`約59.6℃）、`Rθja`がdatasheetの88℃/W（[tbd-register.md](https://github.com/wachi-yoshitaka-11-dev/deskcat/blob/b7cb5290715eded3530c7626d92bef5df3361540/docs/hardware/tbd-register.md)の`HW-TBD-023`が持つ既存記録の値。table／page番号までは同行も記録していない）・`U2`の`TSD` typ 150℃（`TJ(max)`ではなく熱shutdown温度）より約5.62倍（`TSD`とambientの差110℃÷温度上昇19.590℃）悪化すると`TSD`に届く。ESP32の項を仮に2倍（約200mA）へ置いても、合計約201.5mA・電流の余裕約4.96倍・損失約392.6mW（`Iq`込み）・`TSD`までの悪化許容倍率約3.18倍（基準ケースと同じ丸め方）であり、board-levelの内訳を確認していない不確かさは結論に影響しないことを確認した。Espressifが電源側に要求する`I_VDD` min 0.5Aも上回ることを確認した。測定値ではなく計算による見積りであり、Wi-Fi/BT不使用・ambient 40℃（仮定）・Vin=5V（保守側）の前提でのみ成立する。`tbd-register.md`のHW-TBD-023行にも同日付で対応する追記を行った | [#445](https://github.com/wachi-yoshitaka-11-dev/deskcat/issues/445)、[ESP32 Series Datasheet v5.3](https://documentation.espressif.com/esp32_datasheet_en.pdf) Table 4-2、[ESP32-WROOM-32D & ESP32-WROOM-32U Datasheet v2.8](https://documentation.espressif.com/esp32-wroom-32d_esp32-wroom-32u_datasheet_en.pdf) Table 14、[UMW LD1117 datasheet](https://www.umw-ic.com/static/pdf/a5e0c99cefdefaf03cfa7777b369e45b.pdf) |
| 2026-09-22 | 118 | [#15](https://github.com/wachi-yoshitaka-11-dev/deskcat/issues/15)／[#16](https://github.com/wachi-yoshitaka-11-dev/deskcat/issues/16)。**`段階B-2の測定`節へ、`ACCEL-01`／`ENV-01`単体bring-upの手順（ESP32`3V3` pin給電、`#445`承認範囲）の節を新設した。**`DISP-01`初回通電の手順（Revision 116、[#447](https://github.com/wachi-yoshitaka-11-dev/deskcat/pull/447)）と対になる、`ACCEL-01`／`ENV-01`向けの手順である。給電経路が異なる（`DISP-01`はB-2b＝外部電源、この2点は`#445`承認によりESP32自身の`3V3` pin）ため、`DISP-01`の手順を流用せず並べて置いた。**手順はB-2のgateを開けない**（MSP2807分の`HW-TBD-024`が未解決のため、段階B-2＝3点合算測定は引き続き実施できない）。通電はしていない。**fresh-context自己レビュー（1〜13巡目）で多数の指摘を受け、都度本文を修正した。**指摘の種類は、引用先の誤り（doc commentの所在、見出し名の空白、pin名、実験記録の極性ラベル）、欠落していた実施前提（Wi-Fi/BT不使用、`DISP-01`未接続、`CS`／`CSB`／`SDO`の配線、既存2項目の未実施状態、人間の明示的な go-ahead）、手順内の相互参照のずれと循環（停止条件と観測結果が同じ事象を指す形になっていた）、手順の順序そのものの欠陥（firmwareの書き込みがUSB接続＝通電を伴うにもかかわらず、給電停止準備・待機時間決定より前に置かれていた）、余裕計算の丸め誤りと前提の書き漏れ、`main()`が`display bringup`を先に無条件実行する事実の欠落、`信号inventory`との不整合、boldマーカーの欠落など多岐にわたる。**個々の指摘内容と巡ごとの件数はこの行では再掲しない**（本文が正であり、数値・手順番号をここに書き写すと本文の版が変わるたびに乖離するため。乖離自体を複数巡のfresh-context自己レビューが指摘した）。収束（新規指摘0件が2巡連続）には至っていない時点でこのRevisionを記録しており、**引き続き自己レビューを継続する** | [#445](https://github.com/wachi-yoshitaka-11-dev/deskcat/issues/445)、[gpio-assignment.md](https://github.com/wachi-yoshitaka-11-dev/deskcat/blob/b7cb5290715eded3530c7626d92bef5df3361540/docs/hardware/gpio-assignment.md) Revision 36、[#447](https://github.com/wachi-yoshitaka-11-dev/deskcat/pull/447)、fresh-context自己レビュー（1〜13巡目） |
| 2026-09-23 | 120 | [#451](https://github.com/wachi-yoshitaka-11-dev/deskcat/issues/451)。**firmwareの`run_display_bringup`が`bringup-display-13` feature（既定off）付きbuildだけの経路になったことに追随した。**4箇所。(1) `実施前に満たす条件`の条件(2)へ「**既定build**（`bringup-display-13` featureを付けない構成）で」という限定を足した。featureを付けた構成は`DISP-01`のbring-upを実行するため、条件(4)と両立しない。**この限定はこのPRが作った必要であり、以前は書きようが無かった。**(2) `条件(4)の根拠`は、条件の主たる根拠を「`main()`が無条件に`run_display_bringup`を呼ぶ」に置いていた。その記述が偽になったため、変更の事実と、**それでも条件(4)を外さない理由3点**（電流の余裕計算が`DISP-01`を含まないこと、`EXP-011`で確認したのはESP32側の信号レベルまでであること、この手順が`#445`承認の範囲に閉じていること）へ書き換えた。(3) `手順10の根拠`は、display側のlogが`run_i2c_bringup`より先に出ることを「異常ではない」と説明していた。既定buildではもう出ないため、その旨と、**`#451`でI2C読み出しが有限timeoutになったこと**（値と上限の効き方はfirmware側が正本。ここへ再掲しない）へ書き換えた。**実機で`Err`が返るまでの実測時間は取っていないため、手順6の待機時間の上限はこの未実測を前提に置いたままにする。**(4) `手順10`の(b)は、`J3`未はんだを選んだ場合の予期された結果として「失敗（error）」と「出力が無いまま止まる」の2つを挙げていた。**有限timeoutになった以上、後者はもう予期された結果ではない。**後者を削り、`env_chip_id_read_failed`が出ることを予期された結果とし、**`ENV-01`分のlogがどちらも出ないまま止まるのは`J3`の選択によらず異常である**と明記し、**その状態に至った場合の扱いを(c)と同じ（手順9の停止条件）に揃え、手順9の停止条件の一覧へも行を足した**（手動review（CodeRabbit、`full review`）の指摘。同(c)が既に「`ACCEL-01`分すら出ない」場合を異常としており、(b)の旧記述はそれと両立しなくなっていた）。**値・gate・手順の順序・既存の停止条件は1つも変えていない。**(4)で手順9の停止条件が1件増えるが、**これは停止する側へ倒す変更であり、既存の停止条件を緩めたものではない。**増やす必要が生じたのは、有限timeoutによって「出力が無いまま止まる」が予期された結果でなくなり、異常として扱う先が要るためである。 | [#451](https://github.com/wachi-yoshitaka-11-dev/deskcat/issues/451)、`firmware/esp32/src/main.rs`、`firmware/esp32/src/config.rs`、手動review（CodeRabbit、`full review`、[PR #459](https://github.com/wachi-yoshitaka-11-dev/deskcat/pull/459)） |
| 2026-09-23 | 121 | [#461](https://github.com/wachi-yoshitaka-11-dev/deskcat/issues/461)。**`HW-TBD-024`が「`DISP-01`を3.3 V系へ通常接続すること自体」を一律に妨げる扱いを終える（ユーザー承認）。**B-2b・段階B-2（3点合算測定）のgateは変えない。**`HW-TBD-025`(b)（現物回路の確認という手続き）はMSP2807について引き続き満たされない。**それでも、既知の部品（`R5`・`U1`）を通る経路の電流の上界（`R5`経由495.0 mA、`3.3 V rail下限の設計判断`節が持つILI9341ロジック50 mAと合わせ、通常動作は保守側で約245.4 mA＝101.54＋93.9＋50、`U2`連続定格1 A比で約4.1倍・`TSD`まで約68.9 ℃、`R5`先短絡の故障では約646.5 mA＝101.54＋495.0＋50.0、`U2`のIlimit min 1.25 Aは効かず`TSD`まで約9 ℃しか余裕が無い）を判断材料の1つとして、ユーザーが残余risk（未知の経路の可能性、故障時の熱余裕の薄さ、`R5`の公差不明、`U2`の`TJ(max)`未記録）を受け入れた。**これは`#445`と同じ性質の判断（判断であって証拠ではない）である。**値・導出・限定の正は[tbd-register.md](https://github.com/wachi-yoshitaka-11-dev/deskcat/blob/b7cb5290715eded3530c7626d92bef5df3361540/docs/hardware/tbd-register.md)の`HW-TBD-024`行であり、ここへ再掲しない。5箇所。(1) `単体bring-upとB-2の区別`行の末尾へ追記。(2) 145行目付近の段落を書き換え。(3) `DISP-01`初回通電の手順（給電構成の確定待ち）の冒頭へ、この節が扱うB-2bの要求はそのまま残ることを明記。(4) `条件(4)の根拠`を書き換え。(5) `B-2bを採る決定とMSP2807の電流制限（2026-09-07）`節の`#445`追記の末尾へ追記（`#445`自体の範囲は変えていない）。**維持したもの:** B-2b・B-2の要求、`PROT-OC-01`未実装の記述、`HW-TBD-021`／`022`、過去のRevision履歴、既存の停止条件。**変えたもの:** `DISP-01`の`3V3`通常接続を一律に止める扱い。**自己レビューの経緯（複数巡にわたる根拠の訂正）はここへ書かない。**Issue本文とPR本文が持つ | [#461](https://github.com/wachi-yoshitaka-11-dev/deskcat/issues/461)、[tbd-register.md](https://github.com/wachi-yoshitaka-11-dev/deskcat/blob/b7cb5290715eded3530c7626d92bef5df3361540/docs/hardware/tbd-register.md)の`HW-TBD-024`行、[#445](https://github.com/wachi-yoshitaka-11-dev/deskcat/issues/445)、[#409](https://github.com/wachi-yoshitaka-11-dev/deskcat/issues/409) |
| 2026-09-23 | 122 | [#13](https://github.com/wachi-yoshitaka-11-dev/deskcat/issues/13)。**`ACCEL-01`／`ENV-01`単体bring-upの手順の直後へ、`DISP-01`追加接続のbring-upの手順（ESP32`3V3` pin給電、`#461`承認範囲）を新設した。**`#461`（Revision 121）は`DISP-01`の`3V3` pin接続を許可するだけで、実行手順は新設しないと明記しており（`tbd-register.md`の`HW-TBD-024`行）、`main.rs`のmodule docも同じ理由でこの節の作成を`#13`へ送っていた。新設した手順は、`ACCEL-01`／`ENV-01`が`3V3` pinへ接続済みの状態（`#445`、`EXP-015`）へ`DISP-01`を追加する場合を扱い、B-2b手順（Revision 116）とは給電元・前提とも別であることを明記した（節名を「単体bring-up」ではなく「追加接続のbring-up」としたのも、`ACCEL-01`／`ENV-01`の接続を前提とする内容と一致させるためである）。電流余裕は`HW-TBD-024`行の2026-09-23追記（ESP32＋`ACCEL-01`＋`ENV-01`＋`DISP-01`の負荷合計。計算であり段階B-2の定常電流測定ではない。通常動作約245.4 mA・故障時約646.5 mA）をそのまま参照し、この節では再計算しない。`ACCEL-01`／`ENV-01`単体bring-upの手順の条件(4)（`DISP-01`未接続）は、同節を単独実施する場合の前提であり、この新設手順（`DISP-01`追加）には適用しないことを新設手順側に明記した。あわせて`ACCEL-01`／`ENV-01`単体bring-upの手順の手順4へも、この前提が同節を単独実施する場合に限ることと新設手順への参照を追記した（両節を揃えた）。firmwareは`--features bringup-display-13`付きbuildを要求する（既定buildは`run_display_bringup`を呼ばず、受け入れ条件の確認材料が得られないため）。あわせて、[gpio-assignment.md](https://github.com/wachi-yoshitaka-11-dev/deskcat/blob/b7cb5290715eded3530c7626d92bef5df3361540/docs/hardware/gpio-assignment.md)の`電源pinの短絡・誤配線の確認（非通電）`表の項目4（給電経路の重複確認）を、経路により参照先が変わる形へ同commit内で更新した（Revision 39）。**PM（`#0PM`）のレビューを経て、初回commit案から次の点を修正した。**(a) 「すべて満たすまで通電しない」対象の手順番号が、実際の最初の通電（手順7＝firmware書き込み）とずれていた（手順9→手順7）。(b) 待機時間を決める手順番号の参照が誤っていた（手順6→手順5、2箇所）。(c) LED pin配線とbacklight実電流経路の分離の根拠が、`#422`本文を引用しない`tbd-register.md`のHW-TBD-023行を誤って指していた。正しくは[sensor-datasheet-notes.md](https://github.com/wachi-yoshitaka-11-dev/deskcat/blob/b7cb5290715eded3530c7626d92bef5df3361540/docs/hardware/sensor-datasheet-notes.md)の`Backlight回路／電流／polarity`行。(d) `条件(1)の根拠`が、同commit内で書き換えたはずのgpio-assignment.md項目4を「B-2bを採用済みの経路と記す（読み替えて適用する）」という書き換え前の記述のまま説明しており自己矛盾していた。(e) `条件(5)の根拠`の「実施者・PMが別途判断する」を「人間が判断する（条件(7)）」へ訂正（PMの判断は人間の承認の代替にならない）。(f) 停止条件に「テスターでの異常値（`VCC`–`GND`間抵抗が通電中に急変する等）」をB-2b節から誤って複製していた。削除し、`ACCEL-01`／`ENV-01`単体bring-upの手順`手順9の根拠`（この手順のどの段階にも通電中に計器を当てる手段を設定していないという実施上の理由。実施者が独自に安全に監視できる場合はその手段を追加の停止根拠として使ってよい）を参照する形にした。(g) 節名を「単体bring-up」から「追加接続のbring-up」へ改め、参照箇所（power-budget.mdの見出しと小見出し、gpio-assignment.mdの項目4とRevision履歴行、main.rs）を揃えた。通電はしていない | [#461](https://github.com/wachi-yoshitaka-11-dev/deskcat/issues/461)、[tbd-register.md](https://github.com/wachi-yoshitaka-11-dev/deskcat/blob/b7cb5290715eded3530c7626d92bef5df3361540/docs/hardware/tbd-register.md)の`HW-TBD-024`行、[#445](https://github.com/wachi-yoshitaka-11-dev/deskcat/issues/445)、`experiment-log.md`の`EXP-015`、`firmware/esp32/src/main.rs`のmodule doc、PM（`#0PM`）のレビュー |
| 2026-09-28 | 123 | [#489](https://github.com/wachi-yoshitaka-11-dev/deskcat/issues/489)。**2つのbring-up手順（`ACCEL-01`／`ENV-01`単体の手順8、`DISP-01`追加接続の手順7）の書き込みについて、`espflash`の実行を人間の立ち会い・監視のもとで実機LinuxのAIセッションが行ってよいと明記した。**2026-09-28のユーザー決定による。USBの接続（通電の開始）と給電を止める判断は人間のまま変えていない。`EXP-016`／`EXP-017`が逸脱として記録した運用に正本を合わせたものであり、両記録は書き換えていない | 2026-09-28のユーザー決定（[#489](https://github.com/wachi-yoshitaka-11-dev/deskcat/issues/489)に記録） |
| 2026-09-28 | 124 | [#17](https://github.com/wachi-yoshitaka-11-dev/deskcat/issues/17)。**`サーボ試験`節の冒頭へ、はんだ付け前のservoの確認はservo専用の別電源と故障電流の制限手段で行うというユーザー決定（2026-09-28）への参照を追記し、下段構成への移行ははんだ付け後の最終構成でservoを試験する場合に適用すると明記した。**条件と状態の正は`servo-safety-limits.md`の`承認の状態`の項目6であり、ここへ再掲しない。値・gate・停止条件は変えていない | 2026-09-28のユーザー決定（#17に記録） |
| 2026-09-28 | 125 | [#3](https://github.com/wachi-yoshitaka-11-dev/deskcat/issues/3)。**`DT830Bを電流測定に使うときの制約（2026-08-21）`節へ、2026-09-28のユーザー決定を追記した。**電流は`MEAS-01`の両端電圧から求める。測定器は追加で購入せず、段階B-2の電流は今の接続のまま手持ちの`DT830B`で読む。`MEAS-01`ははんだ付けせずに使い、許容差±5 %・温度係数±300 ppm/℃で扱う。`DT830B`の確度が取得できないことは測定結果とあわせて記録する。確度が未取得の読みをしきい値との照合にそのまま使わないという既存の規則は変えていない。段階B-2の実施条件の改訂は別のPull Requestで行う | 2026-09-28のユーザー決定（#3、#488に記録） |
| 2026-09-28 | 126 | [#13](https://github.com/wachi-yoshitaka-11-dev/deskcat/issues/13)。`DISP-01`追加接続のbring-upの手順の手順5と手順9を、条件1・3・4の実機確認用に変えた`bringup-display-13` buildのlogへ合わせた。手順9(a)へ`display_rdid`（Read ID1〜3の生byte）と`display_rdid_failed`、(b)へ各色を`hold_ms`だけ保つことと色ごとの写真、(c)へ`display_pattern_element`・`display_pattern_hold`・`display_axis_failed`と`J2`のheaderを写すことを足した。手順5へ、fillとpatternを保つ分だけ(d)のlogが遅れることを足した。**停止条件、実施前の条件(1)〜(7)、電流の余裕計算は変えていない。**firmwareの変更は同じPull Requestにある。通電はしていない | [#13の2026-09-28のコメント](https://github.com/wachi-yoshitaka-11-dev/deskcat/issues/13#issuecomment-5860773100)（条件1・4の扱い、ユーザー承認） |
| 2026-09-28 | 127 | [#3](https://github.com/wachi-yoshitaka-11-dev/deskcat/issues/3)。**`段階B-2の測定`へ、2026-09-28のユーザー決定（今の接続のままB-2aとして電流を測る）を追記した。**対象は#445・#461で`3V3` pinへの接続が認められて通電している構成で、`MEAS-01`の両端電圧を`DT830B`で読む。「B-2aもB-2bも実施できない」とB-2aの実施条件はこの測定を止めないとし、同じ文を持つ3か所（`ACCEL-01`／`ENV-01`単体bring-upの手順、B-2a節、`判明している最小定格が1.25 Aへ下がった（2026-08-25）`節）へ例外を注記した。MSP2807の電流上限が未公開であること、確度が未取得の読みをしきい値との照合に使わないこと、B-2aの電圧とその他の停止条件は変えていない | 2026-09-28のユーザー決定（#488に記録） |

## 電源rail構成案の旧記述

## 電源rail構成案

```text
スイッチングACアダプター(USB ACアダプター) MicroBオス 5V3A（秋月 M-12001）— 単一入力源
│  ※plugをbreadboardへ引き込む変換部品の調達（発注・着荷）の状態は[#205](https://github.com/wachi-yoshitaka-11-dev/deskcat/issues/205)が持つ（`5 V ingress`節）
├─ 過電流保護部品（`PROT-OC-01`、5V往路へ直列。調達の状態は[#205](https://github.com/wachi-yoshitaka-11-dev/deskcat/issues/205)が持つ）
│  ※これが無い間は段階C（合成給電）へ進まない（`過電流保護（段階Cのgate）`節）
├─ Logic/Pi rail 5V（breadboard上で分岐、追加regulatorなし）
│  ├─ Raspberry Pi Zero W（PWR IN portへ）
│  │  └─ USB OTG port ──[USB cable、Pi link]── ESP-WROOM-32D開発ボード（秋月電子 M-13628）
│  │        ※案Aではこのcableのみで給電する
│  └─ （案Bの場合のみ）ESP-WROOM-32Dの`5V` pinへ直接
│        ESP32の給電経路は案Aで確定。gateはPiのOTG port供給能力の実測（`ESP32の給電経路（案Aで確定。実測待ち）`節）
│        board上regulatorが3.3Vを生成し、board上の3V3 pinから出力
│        ├─ （接続不可）ADXL345
│        │     **HW-TBD-004がcloseするまで、この経路へ接続してはならない。**
│        │     ICのVS動作範囲2.0–3.6V、絶対最大定格3.9V。
│        │     5V直結は禁止＝確認前の安全規則。
│        │     M-06724のregulator非搭載は2026-08-13に現物確認したが、
│        │     **moduleへ入れてよい電圧は未確定である。**
│        │     `Vs`と`VDD`が別pinに出ており、board上でICへ
│        │     どう配線されているか（直列抵抗、level shiftの有無）を
│        │     追っていない。IC定格からmoduleの許容入力電圧は決まらない
│        ├─ BME280（電源電圧DC1.71～3.6V。5V直結不可）
│        └─ MSP2807（LCD＋touch。VCC 3.3–5V対応だがlogic IOは3.3V TTL。
│              下記理由により3.3Vで給電する）
└─ Servo rail 5V（breadboard上で分岐、直近にbulk capacitor）
   └─ SERVO-01（TowerPro SG90）

周辺moduleは5V railへ直結しない。**5V railへ直結しないことは確定した規則である。**
3.3Vで給電することはBME280とMSP2807では確定しているが、**ADXL345は未確定であり、
`HW-TBD-004`がcloseするまで3.3V railへ接続してはならない**（上図の`（接続不可）`）。
**「周辺moduleはすべて3.3Vで給電する」とは書かない。**ADXL345を含む表現は、
未確定のmoduleへの接続を承認済みに見せるためである。理由は次のとおり。

- BME280（K-09421）は、秋月の製品説明書が**module boardとして**電源電圧DC1.71～3.6Vを
  示している。5V直結は定格超過となる。**これはmodule boardの資料に基づく判定である。**
- ADXL345（M-06724）は**ICの動作上限が3.6V、絶対最大定格が3.9V**である
  （Rev. G Table 1 page 4／Table 2 page 5。**動作上限と絶対最大定格は別物である**）。
  5Vはそのどちらも超える。**ただしこれはICの定格であって、
  module boardの許容入力電圧ではない。**board上のregulatorやlevel shiftの有無で変わり、
  M-06724のboard資料は入手できない（商品ページが404）。**したがってmoduleの許容入力電圧は
  IC定格からは決まらない。**
  **それでも5V直結は禁止する。**moduleがregulatorを持たない場合、5VはICへ直接掛かって
  定格を超える。**その可能性を否定できない以上、確認前の安全規則として禁止する**
  （[AGENTS.md](https://github.com/wachi-yoshitaka-11-dev/deskcat/blob/b7cb5290715eded3530c7626d92bef5df3361540/AGENTS.md)の「矛盾する場合はより安全で厳しい規則を適用する」）。
  **3.3Vも同じ理由で確定ではない。**IC定格と整合する唯一の候補ではあるが、moduleが
  受け入れる根拠は別に要る。どちらも`HW-TBD-004`で確定する。
- MSP2807はVCC 3.3–5V対応だがlogic IOは3.3V TTLである。5Vで給電した場合に
  module側の出力（MISO等）が5Vになるか3.3Vに留まるかは、メーカー資料でも明示されていない。
  5V出力になるとESP32のGPIOが定格超過となり破損しうる。level shiftの有無を現物の
  回路で確認するまでは、安全側に倒して3.3V給電とする。

3V3 railへ接続する予定の3module（**ADXL345は`HW-TBD-004`がcloseするまで接続しないため、
closeした場合の見積である**）の合計消費電流は、ADXL345とBME280が文献値で数mA未満と小さい一方、
**MSP2807のbacklightを含む消費電流は未確認**（負荷表参照）である。加えて
**この基板の3V3 pinが外部へ供給できる電流の定格も未確認**（`hardware-bom.md` MCU-01で
「定格はTBD」）である。`測定計画`で3V3 railの供給能力とMSP2807の実消費電流を測るまで、
この給電構成が成立することを確定としない。MSP2807の実測値が3V3 pinの供給能力を超える場合は、
別途3.3V regulatorを追加する構成へ変更する。

すべての信号domainで、意図的に基準GNDを共有する。
接続前に、USBと外部電源間のbackfeed経路をreviewする。
```

この図はarchitecture案であり、最終配線図ではない。

**単一ACアダプター構成への限定は削除した（2026-09-22）。**この節はかつて
「単一のACアダプターを入力源とし、複数のACアダプターを並列に用意する構成は採用しない
（Piの電圧低下riskを避けるためのrail分離は、adapter本体を分けるのではなくbreadboard上の
rail分岐とservo直近のbulk capacitorで行う）」と書いていた。**この制約は2026-08-05に
ユーザーが決定したものである**（[hardware-bom.md](https://github.com/wachi-yoshitaka-11-dev/deskcat/blob/b7cb5290715eded3530c7626d92bef5df3361540/docs/hardware/hardware-bom.md) Revision 5。根拠欄
「ユーザーからの指摘」。当初AIが提案していた「ACアダプター2個を別々に用意する」構成を、
ユーザーが誤りとして訂正させた経緯である）。文言自体はcommit `3c53afe`
（2026-08-08、[PR #55](https://github.com/wachi-yoshitaka-11-dev/deskcat/pull/55)）で
この文書へ入ったが、決定そのものの記録は`hardware-bom.md`側にある。
**2026-09-22、ユーザーが同じ制約を外すと判断した**（原文省略）。**自分が過去に決めた制約を、自分で撤回したものである。**
**複数ACアダプター構成を採用するとは決めていない。**削除したのは「採用しない」という
禁止だけであり、現在の`電源rail構成案`（単一入力源、breadboard上のrail分岐とservo直近の
bulk capacitorでrail分離する構成）はこの削除で変わらない。単一入力源にしている理由が
「規則で禁じられているから」ではなくなっただけであり、複数アダプター構成の要否は未検討の
まま残る。

## 接続判断の経緯

**この`B-2a`／`B-2b`の区別と条件は「周辺module3点を合算して測る」という段階B-2の測定行為に紐づく説明だが、条件そのもの（`3V3` pinの故障電流とmodule側の耐性の対応）は行為単位ではなく接続そのものに帰属する。**2026-09-17に、MSP2807単体を`3V3` pinから`VCC`給電する構成（測定を伴わない単体bring-up）について、`HW-TBD-024`の懸念（B-2a側regulator保護のtrip点がmoduleにとって安全かを判定できない）が同様に掛かることを確認した（[#422](https://github.com/wachi-yoshitaka-11-dev/deskcat/issues/422)）。**`#409`はbacklightの`LED` pin（制御信号線）を能動制御せず3.3Vへ直結する構成について「外部の調整可能な電流制限電源を設定する」という論点（B-2b固有）が発生しないことを示したが、backlightの実電流が通る`VCC`→`R5`→LED列という経路（B-2a・B-2b共通の懸念）には答えていない。**`#409`が示したのはこの論点だけであり、B-2bの`実施前に満たす条件`と`手順と停止条件`は1つも変えていない。ここへ再掲しない。**この経路の懸念はMSP2807固有の事実（`R5`(6.8 Ω)を経た先の電流経路がカプトンテープに隠れ非分解では未確認であること）に基づく。**ADXL345／BME280には及ばない（2026-09-21判定）。**両moduleとも板上に実装済みの部品は網羅的に確認済みであり、他に高電流経路になりうる未知の能動部品は無い（ADXL345: [#430](https://github.com/wachi-yoshitaka-11-dev/deskcat/issues/430)のHW-TBD-025(b)判定、および[#436](https://github.com/wachi-yoshitaka-11-dev/deskcat/pull/436)のHW-TBD-004判定。BME280: [#430](https://github.com/wachi-yoshitaka-11-dev/deskcat/issues/430)のHW-TBD-025(b)判定）。**`HW-TBD-023`／`HW-TBD-025`(a)は別の論点（ESP32側regulator自身の保護特性、rail許容電圧範囲）であり、ここでは使わない。**[tbd-register.md](https://github.com/wachi-yoshitaka-11-dev/deskcat/blob/b7cb5290715eded3530c7626d92bef5df3361540/docs/hardware/tbd-register.md)のHW-TBD-023行は、ADXL345分の適用可否を保留したままである（負荷側の確認は別Issueへ持ち越し）。**`#436`のHW-TBD-004判定は、headerからICへの経路そのものの確認までは主張していない（同判定のRevision 114行が明記するとおり、この経路は未確認のままTBDで残る）。ここで確定しているのは「板上に未知の高電流経路を作りうる部品が無い」ことだけであり、経路の確認自体とは別である。MSP2807は、この経路の物理的な特定（LED個数、`R5`の先が`U1`出力側かVCC側か）が非分解では確認できないため、引き続き確認できていない。**したがって「周辺module3点」のうちADXL345とBME280の単体bring-upは、この懸念を理由に止めない。**`HW-TBD-024`はcloseしていない。**MSP2807の`3V3`通常接続については、2026-09-23（[#461](https://github.com/wachi-yoshitaka-11-dev/deskcat/issues/461)、ユーザー承認）にこの判断が変わった。**経路の特定ではなく、`R5`（直列抵抗、刻印`6R8`の読み取り値。測定値ではない。公差は記録が無い。詳細は[tbd-register.md](https://github.com/wachi-yoshitaka-11-dev/deskcat/blob/b7cb5290715eded3530c7626d92bef5df3361540/docs/hardware/tbd-register.md)の`HW-TBD-024`行を参照し、ここへ再掲しない）とrail電圧だけから電流の上界を出す方法（上記ADXL345のpull-up計算と同じ方法）を、backlight枝とILI9341ロジック（別負荷）それぞれに適用した。**`HW-TBD-025`(b)が求める現物回路の確認という手続き自体は引き続き満たされないが、この上界の分析を判断材料の1つとして、ユーザーが残余riskを受け入れ、`ACCEL-01`／`ENV-01`が既に接続されている状態への追加を含めMSP2807の通常接続を認めた。**値・導出・限定（既知の経路以外が無いことは確認できていないという残余、通常動作と故障時の熱余裕の違い）の正は[tbd-register.md](https://github.com/wachi-yoshitaka-11-dev/deskcat/blob/b7cb5290715eded3530c7626d92bef5df3361540/docs/hardware/tbd-register.md)の`HW-TBD-024`行であり、ここへ再掲しない。**段階B-2（3点合算測定）のgateは、MSP2807分の`HW-TBD-025`(b)（現物回路の確認）が満たされないため引き続きBlockedのままである。**

## 許容電圧範囲の判断記録

| 項目 | 内容 |
|---|---|
| 許容電圧範囲 | 周辺module3点が**moduleとして受け入れてよい電圧**の**積集合**（各下限の最大値〜各上限の最小値）と、ESP32のlogic levelから決める。**積集合を取る対象はIC単体の動作範囲ではない。****この行がこの値の正である**（`3.3 V railの許容電圧範囲`節に導出を置く）。**2026-08-12時点の暫定値は3.3–3.6 Vだが、確定値ではない。****`ACCEL-01`のmodule一般としての受け入れ電圧範囲は満たされたと判定した（2026-09-18。詳細は`3.3 V railの許容電圧範囲`節と[tbd-register.md](https://github.com/wachi-yoshitaka-11-dev/deskcat/blob/b7cb5290715eded3530c7626d92bef5df3361540/docs/hardware/tbd-register.md)の`HW-TBD-004`）。**この判定を支える「製造欠陥前提の故障モードは範囲外」という前提は`#0PM`の判定である。**2026-09-21、この前提について人間の承認を得た**（PMが判定を提示し、ユーザーが承認した。詳細は[tbd-register.md](https://github.com/wachi-yoshitaka-11-dev/deskcat/blob/b7cb5290715eded3530c7626d92bef5df3361540/docs/hardware/tbd-register.md)の`HW-TBD-004`。**ここへ再掲しない**）。**2026-09-21より前は「人間の最終承認が未了である。承認されなければこの判定も未解決へ戻る」としていた。**残るのは実装済みI2Cアドレスのみであり、`moduleへ入れてよい電圧`自体はTBDではない。**この判定は口頭申告（現物再確認）を根拠とし、headerからICの`VS`／`VDD I/O`までの経路は未確認のまま残るが、経路の形は電圧の上限に効かないため判定を妨げない**（対GNDの絶対値として見た場合であり、正しく製造された個体を前提とする。受動素子は電圧を上げず、能動部品が存在しないことは確定している。理由の全文は[tbd-register.md](https://github.com/wachi-yoshitaka-11-dev/deskcat/blob/b7cb5290715eded3530c7626d92bef5df3361540/docs/hardware/tbd-register.md)の`HW-TBD-004`を参照し、ここへ再掲しない）。**2026-09-18より前は「module一般としての受け入れ電圧範囲は依然TBDである（`moduleへ入れてよい電圧`は`HW-TBD-004`。ADXL345 ICの2.0–3.6 Vからmodule boardの許容入力電圧は決まらない。`HW-TBD-004`はcloseしていない）」としていた。この過去の記述は、`HW-TBD-004`がcloseしていない状態が続いていたことを述べる過去の判断の経緯として残し、書き換えない。下限3.3 Vがrailの公称値と同一で下振れの余裕が原理的に無い件は、2026-09-06に`3.3 V rail下限の設計判断`節で解決した。**下限は3.234 V（`U2`のdatasheet値。**条件付きの値である。**`3.3 V rail下限の設計判断`節を見る）を受け入れる形で確定した。**あわせて同日、この具体的なrail値（3.234–3.366 V）について`ACCEL-01`の暫定の根拠に基づく設計判断を`ACCEL-01`行の注記に置いた**（typ値に基づく評価であり、worst-caseの境界ではない。詳細は同注記）。**したがってこのrail値に関する`許容電圧範囲`は暫定の根拠に基づく設計判断として運用する。****ただしB-2は`全moduleの安全な電流上限`が別途未解決のため、確認できるまで実施しない** |

## 電流上限の判断記録

| 項目 | 内容 |
|---|---|
| **全moduleの安全な電流上限** | 周辺module3点それぞれについて、耐えられる電流の上限を持つこと。**経路によらず必要である。**B-2bでは電源に設定する電流制限値の上限を決めるために、B-2aでは**board上regulatorの保護のtrip点がmoduleにとって安全かを判定する**ために要る。**1点でも上限が無ければB-2を実施しない**（全体の追跡は`HW-TBD-025`、MSP2807分は`HW-TBD-024`）。**2026-08-12にADXL345とBME280のdatasheetを確認した結果、両者とも絶対最大定格に電流の上限は記載が無い**（ADXL345 Rev. G Table 2 page 5、BME280 Revision 1.24 Table 5 page 13）。**したがって3点すべてについて、公開値からは上限を得られない。**現物回路の確認が要る。**この条件は満たされていないため、B-2は実施できない** |

## 単体bring-upの判断とpull-up計算

| 項目 | 内容 |
|---|---|
| **単体bring-upとB-2の区別（2026-09-21追記）** | 上の`全moduleの安全な電流上限`行が2026-08-12時点で述べた「この条件は満たされていないため、B-2は実施できない」は、周辺module3点を合算して定常電流を測る段階B-2そのものについてである。「現物回路の確認」（＝`HW-TBD-025`(b)が求める、隠れた高電流経路の有無の確認。電流の大きさそのものを判定するものではない）は、ADXL345（ACCEL-01）／BME280（ENV-01）の2点分は得られたと判定された（2026-09-18、`#430`。詳細は[tbd-register.md](https://github.com/wachi-yoshitaka-11-dev/deskcat/blob/b7cb5290715eded3530c7626d92bef5df3361540/docs/hardware/tbd-register.md)の`HW-TBD-025`。ここへ再掲しない）。MSP2807（DISP-01）分は未解決のまま残る（`HW-TBD-024`）。**単体bring-up（ADXL345・BME280の2点だけを`3V3` pinから給電する）と、B-2（周辺module3点を合算して定常電流を測る段階）は別である。**ADXL345・BME280の単体bring-upがこの懸念を理由に止まらないという判定は、次の事実確認に基づく。ESP32側の条件（`HW-TBD-023`(a)＝`3V3` pinの外部供給可能電流の定格。B-2aの`3V3`給電に必要）はここでは扱わない。`HW-TBD-023`(a)は未確定のままだが、`#409`が受理した理由（`U2`のIlimit・熱shutdownによる帰結。module非依存）はこの(a)の確定を必要としない（詳細は[tbd-register.md](https://github.com/wachi-yoshitaka-11-dev/deskcat/blob/b7cb5290715eded3530c7626d92bef5df3361540/docs/hardware/tbd-register.md)の`HW-TBD-023`。ここへ再掲しない）。負荷側で満たすべき条件は2行にまたがり、これで尽きる。(1) 上の`全moduleの安全な電流上限`行が定める「現物回路の確認」（＝`HW-TBD-025`(b)。隠れた高電流経路の有無。**同行は「公開値からは上限を得られない場合、現物回路の確認が要る」と定めており、公開値の不在自体は条件未達を意味しない。現物回路の確認が得られれば足りる**）。(2) `許容電圧範囲`行（上記）が定める`HW-TBD-025`(a)、「moduleとして受け入れてよい電圧」。事実確認は次のとおり。(1) 隠れた高電流経路が無いこと（`HW-TBD-025`(b)、両module分とも`#430`、2026-09-18）。(2) moduleへ入れてよい電圧（ADXL345は`HW-TBD-004`、`#436`、2026-09-21。BME280は`HW-TBD-025`(a)、`#433`、2026-09-18）。(2)のADXL345分（`#436`）は`#0PM`の判定（製造欠陥前提の故障モードは範囲外）に立っており、**2026-09-21、この判定について人間の承認を得た**（PMが判定を提示し、ユーザーが承認した。詳細は[tbd-register.md](https://github.com/wachi-yoshitaka-11-dev/deskcat/blob/b7cb5290715eded3530c7626d92bef5df3361540/docs/hardware/tbd-register.md)の`HW-TBD-004`・`HW-TBD-023`。ここへ再掲しない）。壊れる場合に何が起きるかは次のとおり。片側断線でADXL345の基板搭載pull-up（`01C`、10 kΩ（1%）×2本がSDA・SCLそれぞれに並列、実効nominal 5.00 kΩ。値の正は[sensor-datasheet-notes.md](https://github.com/wachi-yoshitaka-11-dev/deskcat/blob/b7cb5290715eded3530c7626d92bef5df3361540/docs/hardware/sensor-datasheet-notes.md)の`Module搭載pull-up`行、確定の経緯は[gpio-assignment.md](https://github.com/wachi-yoshitaka-11-dev/deskcat/blob/b7cb5290715eded3530c7626d92bef5df3361540/docs/hardware/gpio-assignment.md)697行目のRevision履歴）が信号線をrail電圧（3.234–3.366 V）に保持する場合を考える。pull-upが供給しうる電流の上界（＝pull-up先を0 Vへ短絡した場合に流れる電流。rail電圧とpull-up抵抗だけで決まり、ICの内部構造に依存しない。worst-caseの上界のため、railの上限3.366 Vと、抵抗の1%公差下限（各9.9 kΩ、並列4.95 kΩ）を使う）は、**1 line当たり約0.680 mA、2 line合計で最大約1.36 mA**である。同条件でpull-up抵抗自身が消費する電力の上界は、**1 line当たり約2.29 mW、2 line合計で最大約4.58 mW**である。これらは上界であり、ICへ実際に流れ込む電流・消費される電力ではない（ADXL345内部の保護回路構成はdatasheetに記載が無く、実際の値は確定しない）。**使った入力（値・出所・採った側）**: rail電圧はrail範囲3.234–3.366 Vのうち上限3.366 V（`3.3 V railの許容電圧範囲`節、本file 171行目付近）。pull-up抵抗はADXL345module搭載の`01C`10 kΩ±1%×2本並列のうち下限側（各9.9 kΩ→並列4.95 kΩ、出所[sensor-datasheet-notes.md](https://github.com/wachi-yoshitaka-11-dev/deskcat/blob/b7cb5290715eded3530c7626d92bef5df3361540/docs/hardware/sensor-datasheet-notes.md)`Module搭載pull-up`行。`RES-PULL-01`（[hardware-bom.md](https://github.com/wachi-yoshitaka-11-dev/deskcat/blob/b7cb5290715eded3530c7626d92bef5df3361540/docs/hardware/hardware-bom.md)）とは別の部品であり、ESP32側の外部pull-up／pull-down用の手持ち抵抗一式を指す）。line数は2（SDA・SCL）。**含めていない入力**: 抵抗の温度係数（datasheetに記載が無いため）、ADXL345内部の保護回路構成（同上）、断線が同時に複数箇所で起きる場合。**この上界は次の前提のもとで成立する。**BME280側の`J1`／`J2`（4.7 kΩ pull-up）が開放であること（2026-08-22実測、[gpio-assignment.md](https://github.com/wachi-yoshitaka-11-dev/deskcat/blob/b7cb5290715eded3530c7626d92bef5df3361540/docs/hardware/gpio-assignment.md)285行目・417行目）。開放でなければ同じ共有line（SDA・SCL）へBME280側pull-upが並列に載り、実効抵抗が下がって上界は上がるため再計算が要る。ESP32内蔵のweak pull-upが無効化されていること（`main.rs`の`run_i2c_bringup`が`sda_enable_pullup(false)`／`scl_enable_pullup(false)`を設定）。（`#422`は「懸念は段階B-2という行為単位ではなく、moduleの`VCC`をESP32の`3V3` pinへ接続する構成そのものに帰属する」という枠組みを示しただけであり、この枠組みの適用結果としてMSP2807には引き続き懸念が及ぶ。ADXL345・BME280が止まらないのはこの枠組みからではなく、上記(1)(2)の module別の事実確認から導かれる）。**B-2（3点合算測定）は、MSP2807分の`HW-TBD-024`が未解決のため引き続き実施できない。**この行はB-2のgateを開けない。**2026-09-23追記（[#461](https://github.com/wachi-yoshitaka-11-dev/deskcat/issues/461)、ユーザー承認）。**`HW-TBD-025`(b)が求める「隠れた高電流経路の有無の確認」という手続きは、MSP2807について引き続き満たされていない。**それでも、既知の部品を通る経路については上記のpull-up計算と同じ方法（抵抗とrail電圧だけから電流の上界を出す）で電流の上界を計算でき、この分析を判断材料の1つとして、ユーザーが残余riskを受け入れ、`DISP-01`のESP32`3V3` pinへの通常接続（backlight点灯を含む。`ACCEL-01`／`ENV-01`が既に同じ`3V3` pinへ接続されている状態への追加を含む）を認めた。**これは`#445`がACCEL-01／ENV-01について行った判断（「判断であって証拠ではない」）と同じ性質のものである。**`U2`の余裕は、`ACCEL-01`／`ENV-01`が既に接続されている状態（`#445`、`EXP-015`）へ`DISP-01`を足した合計で確認済みである。**値・導出・限定（既知の経路以外が無いことは確認できていないという残余、通常動作と故障時の熱余裕の違い）の正は[tbd-register.md](https://github.com/wachi-yoshitaka-11-dev/deskcat/blob/b7cb5290715eded3530c7626d92bef5df3361540/docs/hardware/tbd-register.md)の`HW-TBD-024`行であり、ここへ再掲しない。**ただしB-2（3点合算測定）は、MSP2807分の`HW-TBD-025`(b)（現物回路の確認）が満たされないため引き続き実施できないままである。**この上界はB-2b（電流制限つき外部電源）が要求する「設定する電流制限値をいくつにするか」という具体的な数値は与えない |

## B-2bと通常接続の判断経緯

2026-09-22追記（[#445](https://github.com/wachi-yoshitaka-11-dev/deskcat/issues/445)）。この決定(B-2bを採る、`3V3` pinは使わない)は書き換えていない。ただし2026-09-22、ユーザーが範囲を限定した例外を承認した。対象は`ACCEL-01`(ADXL345)と`ENV-01`(BME280)の2点に限り、この2点だけをESP32自身の`3V3` pinから給電することを認める。`DISP-01`(MSP2807)はこの承認の対象外であり、MSP2807を含む構成、および将来の合成給電(段階B-2)には引き続きこの決定(B-2b)が掛かる。`HW-TBD-023`(a)は**解決していない**(値は今も公開されていない)。承認の前提として示した残余riskは、`U2`が`IOUT` 1.0–1.25 Aの区間で電流制限が働かないことであり、これは判断であり証拠ではない。**この帯は下記の想定合計電流（約101.5 mA、正常時）ではなく、短絡・配線ミス時に流れうる故障電流を指す**（`U2`の過電流保護のtrip特性がdatasheetから決まらないため、正常動作を超える電流が生じた場合に`U2`自身がどこで制限を掛けるかは未確認のまま残る）。詳細（`U2`のIlimit値、datasheetの記載範囲）は[tbd-register.md](https://github.com/wachi-yoshitaka-11-dev/deskcat/blob/b7cb5290715eded3530c7626d92bef5df3361540/docs/hardware/tbd-register.md)のHW-TBD-023行を参照する。**2026-09-23追記（[#461](https://github.com/wachi-yoshitaka-11-dev/deskcat/issues/461)）。**上記「`DISP-01`はこの承認の対象外であり…将来の合成給電（段階B-2）には引き続きこの決定（B-2b）が掛かる」は、この2026-09-22の`#445`（B-2b、外部電源、`3V3` pinは使わない決定）自体の範囲についての記述であり、変えていない。**別途`#461`により、`DISP-01`をESP32自身の`3V3` pinへ通常接続すること（`ACCEL-01`／`ENV-01`が既に接続されている状態への追加を含む）が認められた。**値・導出は[tbd-register.md](https://github.com/wachi-yoshitaka-11-dev/deskcat/blob/b7cb5290715eded3530c7626d92bef5df3361540/docs/hardware/tbd-register.md)の`HW-TBD-024`行を参照し、ここへ再掲しない。将来の合成給電（段階B-2）にはこの決定（B-2b）が引き続き掛かる。
