wachi-yoshitaka-11-dev/deskcat/docs/hardware/gpio-assignment-history.md

# GPIO Assignmentの判断記録

> 履歴: #467の整理時に、develop `b7cb5290715eded3530c7626d92bef5df3361540` から移した記録。

古い状態・誤記・後続の訂正を含め、当時の本文を残している。現在の判断は[gpio-assignment.md](gpio-assignment.md)を読む。
本文中の相対リンクだけを元のbase SHAへの固定リンクにした。「本行」「上記」、行番号、節名は移動前の文脈を指す。
この記録へ現在状態や手動Revisionを追記せず、新しい判断は正本と既存Issue／PR・実験ログへ記録する。

## GPIO承認とbring-up範囲の経緯

> 状態: Blocked — ただし理由は`#2`のchecklistではない。**`#2`（GPIO割り当ての承認）の受け入れ条件に対応するchecklist5件（1・2・4・6・7）は2026-09-07にすべて解消した**（1・2・6・7は達成、4は`#13`へ送った。下記）。**この文書がなお`Blocked`である理由は、サーボ出力を有効化してよいかの判断（[servo-safety-limits.md](https://github.com/wachi-yoshitaka-11-dev/deskcat/blob/b7cb5290715eded3530c7626d92bef5df3361540/docs/hardware/servo-safety-limits.md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サーボ出力を有効化してよい条件)のgate）が未解決であることであり、`#2`のGPIO割り当て承認とは別のgateである。**
>
> **`#2`のclose条件（2026-09-07にPM `deskcat-f2`が再スコープ）: 1行ずつ書く。**
> (1) `ADC-5V`／`ADC-3V3`分圧器（`MEAS-01`の10 kΩ×4） → **2026-09-07にブレッドボードへ実装完了**。
> (2) `ACCEL-SDA`／`ACCEL-SCL`の外部4.7 kΩ pull-upと`LCD-BL`の外部4.7 kΩ pull-down → **2026-09-07に実装完了**（`LCD-CS`／`LCD-RST`／`TOUCH-CS`の3本は実装済み・3.3V接続確認済み）。
> (6) `LCD-RST`／`LCD-CS`／`LCD-BL`が`EN`でresetに保持した状態で安全な状態にあること → **2026-09-07に再測定し達成**（`experiment-log.md` `EXP-011`）。
> (7) `TOUCH-CS`が同じく`EN`保持で安全な状態にあること → **2026-09-07に再測定し達成**（同上）。
> **`#2`のclose条件はこの4件で全て達成した。**
>
> **`#2`のclose条件ではない（moduleをESP32へ配線した時点で満たす。`#13`／`#15`／`#16`側。2026-09-07にPM `deskcat-f2`が判定）:**
> (3) I2C実効pull-upが有効範囲内であることの確認待ち（`Cb`未測定。詳細は下記）。
> (4) MSP2807のlogic IO levelが非通電の現物確認待ち → 追跡を試みず`#13`（LCD bring-up）の通電実測へ送った。
> (5) ESP32電源投入前の外部moduleによるpin駆動有無が非通電の導通check待ち → moduleがESP32へ配線されるまで検証対象が存在しない。
>
> **servo起動時状態（`SERVO-PWM`のGPIO27起動時state）の安全reviewは2026-09-06に机上で完了し、上記のいずれにも含まれない。**サーボ出力を有効化してよいかの判断も別であり、[servo-safety-limits.md](https://github.com/wachi-yoshitaka-11-dev/deskcat/blob/b7cb5290715eded3530c7626d92bef5df3361540/docs/hardware/servo-safety-limits.md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サーボ出力を有効化してよい条件)のgateが未解決のまま`Blocked`である。
> **I2C実効pull-upの有効範囲（(3)）は、2026-09-06に初回bring-upのmodeをStandard-modeと決定したことで一旦「達成」へ改めたが、同日PR #358のCodeRabbit手動reviewの指摘を受けて未達へ戻した。**mode決定（Standard-mode）自体は取り消していない。rise timeの制約（`Rp(max)`）には実配線の`Cb`が400 pFを超えても488 pFまで余裕があるが、**Standard-modeの規定`Cb`上限400 pFがrise time以外の制約（fall time等）にも由来する可能性を、この文書が引用した一次資料の範囲では排除できないため、`Cb`の実測または設計上の根拠を得るまで達成にしない。**根拠は[初回bring-upのmode決定](https://github.com/wachi-yoshitaka-11-dev/deskcat/blob/b7cb5290715eded3530c7626d92bef5df3361540/docs/hardware/gpio-assignment.md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初回bring-upのmode決定)節と競合checklistの当該項目。
> **(6)(7)は`#247`が止めている案A（Pi→ESP32のUSB OTG給電）を待たない。**`EN`保持測定はESP32単体・PC USB給電（段階B-1）で足り、`power-budget.md`は段階Aと段階B-1をgate不要・追加購入不要と定めている
> （**touch controller型番は2026-08-13に`XPT2046`と確定し、`HW-TBD-003`は2026-08-15にcloseした**）
> 正本とする情報: ESP32 boardのpin割り当て

## Revision履歴

| 日付 | Revision | 変更 | 根拠 |
|---|---|---|---|
| 2026-09-08 | 33 | [#367](https://github.com/wachi-yoshitaka-11-dev/deskcat/issues/367)。[PR #366](https://github.com/wachi-yoshitaka-11-dev/deskcat/pull/366)（`develop`→`main`昇格）の`full review`でCodeRabbitが出した指摘のうち、この文書に関わる2件を直した。**過去のRevision行は書き換えない。**(1) **`信号inventory`の`LCD-BL`行が古かった。**「実装と起動時の状態確認は未実施」と書いていたが、`受け入れchecklist`の2項目（Revision 32で更新）が2026-09-07の実装と`EN`保持測定（GPIO4＝0.00 V）を記録している。実装済み・reset中の安全状態を確認済み・**ただしGPIO4は内部weak pull-downが有効なため電圧測定だけでは外部pull-downの存在を証明しない**の3点へ揃えた。**外部pull-downの存在そのものの確認は残る。**(2) **導通checkの判定基準に抵抗値の上限を入れた。**それまで判定基準は「導通していること」だけで、計器は「buzzer**または**2000 Ωレンジ」であり、どちらを使うかで判定が変わった。このboard上には直結でない導電経路が実在する（`ACCEL-SDA`／`ACCEL-SCL`は、module側のADXL345`01C`並列5.00 kΩとESP32側の外部4.7 kΩの両方でpull-upされているため、jumperが欠けていても約9.7 kΩの導通が読める）。判定を**2000 Ωレンジでフルスケール未満（2 kΩ未満）**と定め、**buzzer単独では判定しない**ことにした（鳴る閾値が計器仕様として定まらない）。あわせて、**導通checkで言えるのは「独立電源が無いこと」と「意図しない導通が無いこと」までであり、直結（1:1）の同一性の証明ではない**ことを明記した（同一性を要求する場合はパターン追跡が要る） | [PR #366](https://github.com/wachi-yoshitaka-11-dev/deskcat/pull/366)のCodeRabbit指摘、および引用先を開いたPMの検証 |
| 2026-07-27 | 0 | 信号inventoryを作成。実GPIO割り当てはすべて引き続きTBD | — |
| 2026-08-05 | 1 | Board識別情報を確定（ESP-WROOM-32D開発ボード、秋月電子 M-13628）。Espressif公式ESP32-DevKitC V4のpin制約（flash pin6-11、strapping pin0/2/5/12/15、input-only pin34/35/36/39、WROOM専用pin16/17）を反映し、全信号にGPIOを割り当てた。LCD/Touch CSとLCD RSTには起動時safe state確保のため外部pull-up追加を推奨。競合checkのうち実機確認が必要な項目（電源off導通、pull-up実効抵抗、servo PWM起動時状態）は未完了のまま残した | [Espressif ESP32-DevKitC V4 pinout](https://docs.espressif.com/projects/esp-idf/en/v5.1/esp32/hw-reference/esp32/get-started-devkitc.html)、`hardware-bom.md` |
| 2026-08-05 | 2 | 自己レビューで検出: 外部pull-upの接続先電圧を明記していなかったため、`電圧domain`節を追加し、すべてのpull-upを3.3Vへ接続する（5Vへ接続しない）ことを規定。MSP2807はVCC 3.3–5V対応だがlogic IOが3.3V TTLであり、5V給電時の出力levelがメーカー資料でも不明なため、現物確認項目を競合checkへ追加。存在しないRef ID「LCD-01」を「DISP-01」に訂正 | [LCD Wiki MSP2807](http://www.lcdwiki.com/2.8inch_SPI_Module_ILI9341_SKU:MSP2807)の「Logic IO port voltage: 3.3V(TTL)」記載、自己レビュー |
| 2026-08-05 | 3 | 自己レビューで検出: pull-up電圧の競合check項目を`[x]`（完了）としていたが、実配線が存在しないため検証不能であり`[ ]`へ訂正。文書冒頭の状態にMSP2807のlogic IO level確認を追加 | 自己レビュー |
| 2026-08-05 | 4 | レビュー指摘3件を反映。(a) `power-budget.md`のADC測定計画に対応するADC pinが未予約だったため、`ADC-SHUNT`(GPIO32)／`ADC-5V`(GPIO33)／`ADC-3V3`(GPIO36)をADC1で予約し、分圧比1/2と減衰設定を明記。ADC2をWi-Fi併用下で使わない旨も記載。(b) GPIO4／GPIO27のboot stateを「floating（Low相当）」と記載していたが、Lowにdriveされる保証はないため「不定」へ訂正し、`SERVO-PWM`の外部pull-downを推奨から**必須**へ格上げ。(c) Pi linkがUSB serialとGPIO UARTのどちらか曖昧だったため、Protocolの`物理／論理link` を `USB serial` とする決定に合わせUSB serialへ統一し、GPIO1／GPIO3をboard上ブリッジの予約pinと明記。USB OTG変換cableが未購入である旨も記載 | [PR #55レビュー](https://github.com/wachi-yoshitaka-11-dev/deskcat/pull/55)、[Protocol](https://github.com/wachi-yoshitaka-11-dev/deskcat/blob/b7cb5290715eded3530c7626d92bef5df3361540/docs/protocol/esp32-pi-protocol.md)の物理link決定、ESP32のreset時GPIO state |
| 2026-08-05 | 5 | 自己レビューで検出: ADC行の分圧抵抗の参照先が`hardware-bom.md` PROTO-01のままだったが、測定用部品は同fileに新設した`MEAS-01`へ移したため参照を訂正。ADC行の`Device`列を他行と同じRef ID表記（`MEAS-01`）へ揃え、shunt測定の低電流側精度限界への参照を追加 | 自己レビュー、[hardware-bom.md](https://github.com/wachi-yoshitaka-11-dev/deskcat/blob/b7cb5290715eded3530c7626d92bef5df3361540/docs/hardware/hardware-bom.md) MEAS-01 |
| 2026-08-09 | 6 | [PR #64](https://github.com/wachi-yoshitaka-11-dev/deskcat/pull/64)のレビューで、ingress低側shuntをESP32 ADCで測る案が**電気的に成立しない**と判明した。star pointを基準にするとadapter return側は`I × R`だけ負の電位になり、ESP32のADCでは測れない（pin破損のriskもある）。一度`ADC-INGRESS`をGPIO39へ予約したが、`power-budget.md`側でingressの判定量を定常値（connector定格は熱の制限のため）へ改めた結果、この測定点自体が不要になったため予約を取り消した。peakによる電圧降下は既存の`ADC-5V`／`ADC-3V3`で捉える | [PR #64レビュー](https://github.com/wachi-yoshitaka-11-dev/deskcat/pull/64)、[power-budget.md](https://github.com/wachi-yoshitaka-11-dev/deskcat/blob/b7cb5290715eded3530c7626d92bef5df3361540/docs/hardware/power-budget.md)の`ingressの電流制限` |
| 2026-08-09 | 7 | [#65](https://github.com/wachi-yoshitaka-11-dev/deskcat/issues/65)の発注前走査で、**この文書が要求する部品が`hardware-bom.md`の購入待ちリストに載っていなかった**ことが判明した。`ADC-5V`／`ADC-3V3`の分圧用10 kΩ（計4本）と、`SERVO-PWM`の外部pull-down（`RES-PULL-01`）が該当する。前者は本文が「購入する」と書いているだけ、後者はBOMに行すら無い状態だった。両行から購入待ちリストへ辿れるようにした | [#65](https://github.com/wachi-yoshitaka-11-dev/deskcat/issues/65)、[hardware-bom.md](https://github.com/wachi-yoshitaka-11-dev/deskcat/blob/b7cb5290715eded3530c7626d92bef5df3361540/docs/hardware/hardware-bom.md) |
| 2026-08-10 | 8 | [#1](https://github.com/wachi-yoshitaka-11-dev/deskcat/issues/1)。**Board識別情報の照合先を、実在するEspressif公式資料へ訂正した。**従来は「秋月商品ページ添付データシート」を照合先としていたが、**秋月の添付はESP-WROOM-32Dモジュールとチップのdatasheetだけで、boardのpin配列表も回路図も含まない**ことが判明した（照合先が存在しなかった）。[公式回路図](https://dl.espressif.com/dl/schematics/esp32_devkitc_v4-sch.pdf)と公式guideのpin description表を照合先とし、両者が一致することを確認した。あわせて根拠の無い断定「秋月オリジナル基板のため」「秋月独自基板のため」を削除した（詳細は[hardware-bom.md](https://github.com/wachi-yoshitaka-11-dev/deskcat/blob/b7cb5290715eded3530c7626d92bef5df3361540/docs/hardware/hardware-bom.md) Revision 29）。**現物pin表記との対応確認は引き続き必要である**（理由が「独自基板だから」から「文書だけでは実装を保証できないから」へ変わった）。表記ゆれ`秋月 M-13628`を`秋月電子 M-13628`へ揃えた（2箇所） | [ESP32-DevKitC V4公式回路図](https://dl.espressif.com/dl/schematics/esp32_devkitc_v4-sch.pdf)、[Espressif公式guide](https://docs.espressif.com/projects/esp-idf/en/v5.1/esp32/hw-reference/esp32/get-started-devkitc.html)、[秋月商品ページ](https://akizukidenshi.com/catalog/g/g113628/) |
| 2026-08-12 | 9 | [#1](https://github.com/wachi-yoshitaka-11-dev/deskcat/issues/1)。ADXL345のメーカー公式datasheet（Rev. G）を入手して照合したところ、**`ACCEL-IRQ`行のpull欄が事実に反していた。**「ADXL345のINT1/INT2はpush-pull／open-drainを設定可能」と書いていたが、Rev. G page 19は`Both interrupt pins are push-pull, low impedance pins`と定めており、**設定で切り替えられない。**この誤りは外部pull-upの要否の判断を誤らせるため、**ICはpush-pull固定である**と訂正した。あわせて「既定active-highの想定」は正しかったが**ICについては想定ではなく確定である**ため書き改めた。`DATA_FORMAT` register（`0x31`）の`INT_INVERT` bitで選び、同registerのreset値が`00000000`であることをRev. G Table 19 page 23とpage 27で確認した。**ただし`外部pull要確認`は残した。**[PR #112](https://github.com/wachi-yoshitaka-11-dev/deskcat/pull/112)のreviewで指摘を受けて自己点検したところ、**当初の改訂案は「外部pullは不要である」とmodule levelの結論まで書いており、ICの定格からmodule boardの配線条件を導いていた。**M-06724のboard上でINT pinがheaderへ直結しているかを示す資料は無く、`HW-TBD-004`のままである。**ICの事実とmodule levelの未確認を書き分けた。****GPIO割り当て（`ACCEL-IRQ`＝GPIO35）もEdge想定も変更していない** | [ADXL345 Data Sheet](https://www.analog.com/media/en/technical-documentation/data-sheets/adxl345.pdf) Rev. G（2026-08-12取得）、[sensor-datasheet-notes.md](https://github.com/wachi-yoshitaka-11-dev/deskcat/blob/b7cb5290715eded3530c7626d92bef5df3361540/docs/hardware/sensor-datasheet-notes.md) Revision 5 |
| 2026-08-12 | 10 | [#1](https://github.com/wachi-yoshitaka-11-dev/deskcat/issues/1)。`ADC-5V`行が分圧用10 kΩ抵抗を「計4本が必要であり、**未購入である**」とし、`hardware-bom.md`の購入待ちリストを参照していたが、**抵抗は2026-08-08に着荷済みであった**（同文書 Revision 37。発注漏れではなく記録漏れ）。**参照先の購入待ちリストの行も同時に削除されたため、この記述は宛先を失っていた。**「入手済み。残るのは実装と検証」へ改めた。**分圧比1/2もpin割当ても変えていない** | 購入履歴（2026-08-08着荷分）、[hardware-bom.md](https://github.com/wachi-yoshitaka-11-dev/deskcat/blob/b7cb5290715eded3530c7626d92bef5df3361540/docs/hardware/hardware-bom.md) Revision 37 |
| 2026-08-12 | 11 | [PR #116](https://github.com/wachi-yoshitaka-11-dev/deskcat/pull/116)のreview指摘。`SERVO-PWM`行が`RES-PULL-01`を「**未購入**・抵抗値未選定」としていたが、**10 kΩと4.7 kΩが各1袋入手済みである**（[hardware-bom.md](https://github.com/wachi-yoshitaka-11-dev/deskcat/blob/b7cb5290715eded3530c7626d92bef5df3361540/docs/hardware/hardware-bom.md) Revision 37）。二重発注を招くため「一部の抵抗値は入手済み。ただし必要な本数と抵抗値が未選定であり、手元の2種で足りるとは限らない」へ改めた。**外部pull-downを必須とする規則も`HW-TBD-027`のgateも変えていない** | [PR #116のreview](https://github.com/wachi-yoshitaka-11-dev/deskcat/pull/116)、[hardware-bom.md](https://github.com/wachi-yoshitaka-11-dev/deskcat/blob/b7cb5290715eded3530c7626d92bef5df3361540/docs/hardware/hardware-bom.md) Revision 37 |
| 2026-08-15 | 12 | [#1](https://github.com/wachi-yoshitaka-11-dev/deskcat/issues/1)。**現物写真の読み取り結果を反映した。**(a) **`HW-TBD-001`のpin照合が完了し、一致した。**38pinヘッダ両側のsilkが公式`J2`／`J3`と19pin×2列すべてで一致した（GNDの位置を含む）。`Board識別情報`の`公式回路図revision`欄へ読み取った並びを記録した。(b) 基板裏面silkscreenの大文字小文字を**`ESP32_DevKitc_V4`**へ訂正した（旧記載`ESP32_DevkitC_V4`。現物と公式回路図のtitle blockが一致する）。(c) Touch controllerを**`XPT2046`と確定**し、`LCD-MISO`と`TOUCH-CS`の「想定」「現物確認待ち」を確定表現へ改めた。(d) `ACCEL-SDA`と競合checklistへ、**ADXL345が`01C`＝10 kΩのpull-upを4個搭載している**ことを記録した。**ただしどのpinへ付くかはパターンを追っておらず、BME280側は半田の有無が光学判別できないため、実効抵抗は両方が確定するまで計算しない** | 現物写真（斜光＋接写）。詳細は[tbd-register.md](https://github.com/wachi-yoshitaka-11-dev/deskcat/blob/b7cb5290715eded3530c7626d92bef5df3361540/docs/hardware/tbd-register.md)の`HW-TBD-001`／`003`／`004`／`005` |
| 2026-08-15 | 13 | [PR #122](https://github.com/wachi-yoshitaka-11-dev/deskcat/pull/122)のレビュー指摘を反映。文書冒頭の状態行が`touch controller型番`を現物確認待ちに挙げたままだったため、**`XPT2046`確定と`HW-TBD-003`のcloseを反映した** | [PR #122レビュー](https://github.com/wachi-yoshitaka-11-dev/deskcat/pull/122) |
| 2026-08-22 | 14 | **`I2C sensor bus`行へ、BME280側のjumperの実測結果を反映した。**`J1`／`J2`はどちらも開放であり、**module搭載の4.7 kΩプルアップはbusへ繋がっていない**（正は[sensor-datasheet-notes.md](https://github.com/wachi-yoshitaka-11-dev/deskcat/blob/b7cb5290715eded3530c7626d92bef5df3361540/docs/hardware/sensor-datasheet-notes.md)の`現物の実装状態を実測で確定させた（2026-08-22）`。**ここへ再掲しない**）。**したがって実効pull-upの計算にBME280側の4.7 kΩを入れない。**同じbusのADXL345モジュールは`01C`（10 kΩ）を搭載しており、計算はそちら側だけを数える形になる。**`J1`／`J2`をはんだ付けするかは計算の結果で決める。まだ決めていない。****あわせて`J3`が開放であるため、I2Cで使うには`J3`のはんだ付けが要る** | [#1](https://github.com/wachi-yoshitaka-11-dev/deskcat/issues/1) |
| 2026-08-22 | 15 | [PR #173](https://github.com/wachi-yoshitaka-11-dev/deskcat/pull/173)の自動reviewの指摘を反映した。**BME280の実測結果を記録したのに、同じ文書に古い記述が残っていた。**`ENV-SDA`行の`選択jumperの現物確認が必要`、`I2C sensor bus`行の`両moduleのinterface選択jumperの現物確認`、受け入れchecklistの`半田の有無が光学的に判別できず未確定`である。**いずれも実測結果へ更新した。**未解決として残す対象を**ADXL345側のpin接続の確認と実効pull-up計算に限定**し、**BME280の`J3`は実装作業、`J1`／`J2`は計算後の判断**として記録した | [#1](https://github.com/wachi-yoshitaka-11-dev/deskcat/issues/1) |
| 2026-08-22 | 16 | [PR #174](https://github.com/wachi-yoshitaka-11-dev/deskcat/pull/174)の自動reviewの指摘を反映した。**USB OTG cableを`未購入`としていた記述が2箇所残っていた**（`追加部品`行と`USB serial（Pi link）`行）。**`CABLE-PI-LINK-01`は2026-08-22に手持ちで充当と確定し購入待ちリストから外している**（正は[hardware-bom.md](https://github.com/wachi-yoshitaka-11-dev/deskcat/blob/b7cb5290715eded3530c7626d92bef5df3361540/docs/hardware/hardware-bom.md)の`CABLE-PI-LINK-01`）。両方を更新した | [#3](https://github.com/wachi-yoshitaka-11-dev/deskcat/issues/3) |
| 2026-08-25 | 17 | [#1](https://github.com/wachi-yoshitaka-11-dev/deskcat/issues/1)。**`I2C busの実効pull-up`節と`I2C addressの選択`節を新設した。**`I2C sensor bus`行と受け入れchecklistが「実効pull-upの計算はまだできない」と書きながら、**式も規定値も前提もどこにも無かった。**そのため何が足りないのかを行の記述から読み取れなかった。一次資料（**I2C-bus specification and user manual UM10204 Rev. 7.0、NXP、2021-10-01**）の§7.1から`Rp(max) = tr / (0.8473 × Cb)`と`Rp(min) = (VDD(max) - VOL(max)) / IOL`、およびTable 10／Table 11の規定値（`tr` max、`Cb` max、`IOL`）を取り、**VDD = 3.3 Vでの`Rp(min)`（約967 Ω）と、`Rp`候補ごとに許される`Cb`の上限を算出した。****値そのものは確定させていない。**確定できない入力を3つ明示した（ADXL345側の`01C`がどのpinへ付くか、bus容量`Cb`、採るmode）。**あわせて、Fast-modeで`Cb`が規定上限の400 pFに達すると`Rp(max)`が`Rp(min)`を下回り、3.3 Vの受動pull-upでは成立しないことを示した。**addressについては、ADXL345の候補（`0x1D`／`0x53`）とBME280の候補（`0x76`／`0x77`）が**全4通りで衝突しない**ことを確認し、**選択が衝突回避では決まらない**ことを判断材料として記録した。**決定は行っていない。**`J1`／`J2`のはんだ付けもaddressの配線も未実施である | [UM10204 Rev. 7.0 §7.1、Table 10、Table 11](https://web.archive.org/web/2023/https://www.nxp.com/docs/en/user-guide/UM10204.pdf)（**NXPの直リンクは404を返すため同一pathのarchive snapshotを参照先にした。**2026-08-25確認）、[sensor-datasheet-notes.md](https://github.com/wachi-yoshitaka-11-dev/deskcat/blob/b7cb5290715eded3530c7626d92bef5df3361540/docs/hardware/sensor-datasheet-notes.md)、[tbd-register.md](https://github.com/wachi-yoshitaka-11-dev/deskcat/blob/b7cb5290715eded3530c7626d92bef5df3361540/docs/hardware/tbd-register.md) `HW-TBD-004`／`HW-TBD-005` |
| 2026-08-25 | 18 | [#2](https://github.com/wachi-yoshitaka-11-dev/deskcat/issues/2)。**`起動時状態を確定させる外部pull`節を新設し、`信号inventory`の`Pull`列へ選定した値と本数を入れた。****確定した内訳（4本）**: `SERVO-PWM`のpull-downが**4.7 kΩ×1本**、`LCD-CS`／`LCD-RST`／`TOUCH-CS`のpull-upが**各10 kΩ×1本**。**`LCD-BL`の1本は未選定のまま残る。**したがって**手元の2種で全体が足りるとは、まだ確定していない。****`SERVO-PWM`の振り分け（一般値側か一次資料側か）は2026-08-26に人間が一般値側と決めた。****`LCD-BL`は未選定のまま**（極性とbacklight回路の入力条件が未確定で上限を出せない）。**`TOUCH-IRQ`は外部pullを付けない（0本）へ改めた。**根拠は一次資料である（**ESP32 Series Datasheet v5.3** の Table 5-3 と Appendix `IO_MUX` と §3.2、**ILI9341 Datasheet V1.11** の §18.2.1 と §12.1／§12.2、**XPT2046 Datasheet**（2007.5）の`DIGITAL INPUT/OUTPUT`と`PENIRQ Output`）。**一次資料で分かった重要な点が4つある。**(a) **`SERVO-PWM`（GPIO27）のreset時状態は`oe=0, ie=0`で内部pullが無く、真のhigh-Zである。**外部pull-downが必須である理由が`IO_MUX`の値として裏付いた。(b) **`LCD-CS`／`LCD-RST`／`TOUCH-CS`のpolarityは現物確認を要しない。**ILI9341が`CSX`と`RESX`をactive low、XPT2046が`CS`をactive lowと明記している。**旧記載の`要現物のpolarity確認`を削除した。**(c) **`TOUCH-IRQ`へ外部pull-upを付けると有害である。**XPT2046の`PENIRQ`は内部pull-up付きの出力（公称50 kΩ）であり、外部10 kΩを並列に足すと実効8.33 kΩになり、datasheetが`logic low 0.35×(+VCC)`を保証する条件（X+とY−間21 kΩ未満）に対してlowが**0.716×VCC**まで上がる。**touchがLowとして読めなくなる。**旧記載の`外部pull-up推奨`はcontroller未確定時のものであった。(d) **`LCD-RST`（GPIO16）は`VDD_SDIO` domainにある。**3.3 Vへのpull-upが定格内である前提は同domainが3.3 Vであることに依り、それは`MTDI`（GPIO12）のreset時の内部weak pull-downと、module内flashが動作している事実から成り立つ。**`SERVO-PWM`だけは上限を計算できない**（SG90の`logic閾値`が一次資料に無い。`HW-TBD-026`(a)）。**駆動側の下限に余裕がある範囲で未知に強い側を採り、4.7 kΩ×1本を選定した。****この変更は値と本数の選定であって実装ではない。5本とも未実装である。****この文書の状態`Blocked`は解除していない。checkboxも1つも開いていない** | [ESP32 Series Datasheet v5.3](https://www.espressif.com/sites/default/files/documentation/esp32_datasheet_en.pdf)、[ILI9341 Datasheet V1.11](https://cdn-shop.adafruit.com/datasheets/ILI9341.pdf)、[XPT2046 Datasheet](https://grobotronics.com/images/datasheets/xpt2046-datasheet.pdf)、[tbd-register.md](https://github.com/wachi-yoshitaka-11-dev/deskcat/blob/b7cb5290715eded3530c7626d92bef5df3361540/docs/hardware/tbd-register.md) `HW-TBD-026`／`HW-TBD-027`／`HW-TBD-032`、[hardware-bom.md](https://github.com/wachi-yoshitaka-11-dev/deskcat/blob/b7cb5290715eded3530c7626d92bef5df3361540/docs/hardware/hardware-bom.md) `RES-PULL-01` |
| 2026-08-27 | 19 | [#1](https://github.com/wachi-yoshitaka-11-dev/deskcat/issues/1)。**`I2C busの実効pull-up`節の未確定だった3入力のうち1つを、現物写真でパターンを追って確定した。**ADXL345モジュールの`01C`（10 kΩ）4個は、**SDAへ2本、SCLへ2本**が付いている。したがって各lineの並列合成値は**5.00 kΩ**であり、`Rp`候補表の該当行が候補から確定値へ変わった。`ACCEL-SDA`行と受け入れchecklistの該当項目を合わせて更新した。**残る未確定入力は`bus容量Cb`と`採るmode`の2つのみである。**`J1`／`J2`をはんだ付けするかの判断はこの2入力が埋まるまで引き続き未着手 | 現物写真（ADXL345基板の`01C`4個とパターンの接写） |
| 2026-08-27 | 20 | [#2](https://github.com/wachi-yoshitaka-11-dev/deskcat/issues/2)。**Revision 18で選定した4本のpull抵抗を、ブレッドボード上へ実装した。**`SERVO-PWM`(GPIO27)の4.7 kΩ pull-down、`LCD-CS`／`LCD-RST`／`TOUCH-CS`の各10 kΩ pull-upの計4本である。ESP32基板はブレッドボードへ直接挿さず、対象ピンからジャンパー線で引き出し、抵抗を経由して電源用の帯(`GND`または`3.3V`)へ接続する形で実装した。**通電しての起動時状態の検証は未了。**`LCD-BL`は値が未選定のままで対象外 | 現物作業（ブレッドボード配線） |
| 2026-08-27 | 21 | [#2](https://github.com/wachi-yoshitaka-11-dev/deskcat/issues/2)。**Revision 20の配線について、線の色と対象の対応を記録した。**`緑`＝GPIO27(`SERVO-PWM`、抵抗はGND側)、`黄色`＝GPIO22(`LCD-CS`、抵抗は3V3側)、`紫`＝GPIO16(`LCD-RST`、抵抗は3V3側)、`茶色`＝GPIO21(`TOUCH-CS`、抵抗は3V3側)、`オレンジ`＝`GND`、`赤`＝`3V3`。**`SERVO-PWM`の抵抗がGND側(pull-down)、残り3本の抵抗が3V3側(pull-up)であることを本人に確認した** | 現物作業（配線色の確認） |
| 2026-08-28 | 22 | PR #254のCodeRabbitレビュー指摘（PM経由で受領）。**`Rp`候補表（L268-271）が、外部`4.7 kΩ` pull-up（`ACCEL-SDA`／`ACCEL-SCL`、Revision 18で選定済み）を含んでいなかった。**3行ともmodule搭載のpull-upだけを数えており、実際に選定済みの外部抵抗が候補にも実構成にも現れていなかった。**加えて3行目（`3.20 kΩ`＝`J1`／`J2`の4.7 kΩを足す構成）は、`J1`／`J2`が開放と実測済み（L249）であるため現状は成立しない。**表をmodule搭載分だけの参考値と明示し、**外部4.7 kΩを含む実構成（ADXL345側5.00 kΩ ∥ 外部4.7 kΩ ≈ 2.42 kΩ）を受け入れ計算用の値として追加した。**安全要件5項目には該当しない（`Rp(min)`約967 Ωを上回り、sink電流は`IOL`の範囲内） | PR #254 CodeRabbitレビュー |
| 2026-08-29 | 23 | work-instructions文書に基づく初回通電（人間の監視下、ESP32単体、サーボ・LCD本体は未接続）。**`SERVO-PWM`(GPIO27)＝0 V、`LCD-CS`(GPIO22)＝3.30 V、`LCD-RST`(GPIO16)＝3.30 Vを実測し、いずれも期待どおりであることを確認した（USB抜き差しによる再現性も確認）。**受け入れchecklistの該当2項目へ実測値を反映した（値は`HW-TBD-026`の閾値未確定のため項目自体はまだ満たしていない）。**あわせて、`TOUCH-CS`(GPIO21)の起動時状態がこれまでどの受け入れ項目にも`HW-TBD`にも追跡されていなかったことが判明した**（`HW-TBD-032`は`LCD-RST`／`LCD-CS`／`LCD-BL`の3信号だけを対象と明記しており、`TOUCH-CS`を含まない）。**同信号は`LCD-CS`と同じ理由で10 kΩ pull-upを実装済みであるため、その場でGPIO21＝3.30 Vを実測し（期待どおり）、新設した受け入れ項目を満たした** | 現物実測（テスターDT830B、DC電圧20Vレンジ） |
| 2026-09-06 | 24 | [#2](https://github.com/wachi-yoshitaka-11-dev/deskcat/issues/2)。**自己レビューで検出: `I2C busの実効pull-up`節が、未確定入力の数を「3つ」（L209、`J1`／`J2`の判断節）と「2つ」（旧L253見出し）の両方で書いていた。**Revision 19（2026-08-27）でADXL345側のpin接続を確定させ見出しと`ACCEL-SDA`行・受け入れchecklistは更新したが、**同節内の他2箇所（値そのものが確定していないと述べる文と`J1`／`J2`の判断節）は「3つ」のまま取り残されていた。**実際に未確定なのは`bus容量Cb`と`採るmode`の2つであるため、両箇所を「2つ」へ訂正した。**あわせて、`LCD-BLを決められない理由`節が`HW-TBD-002`を未解決の引用先としていたが、`HW-TBD-002`は2026-09-06にcloseしている**（[#1](https://github.com/wachi-yoshitaka-11-dev/deskcat/issues/1)）。**同行の close記録自身が「backlight回路のLED接続経路の判定は`HW-TBD-024`の範囲であり、`HW-TBD-002`には含まれない」と明記しているため、closeはこの回路modelの未確定を解消していない。**参照を`HW-TBD-024`単独へ訂正し、`HW-TBD-002`がcloseした事実と、それでも解消していない理由を明記した。**GPIO割り当てそのものは変えていない** | 自己レビュー（file全体の走査）、[tbd-register.md](https://github.com/wachi-yoshitaka-11-dev/deskcat/blob/b7cb5290715eded3530c7626d92bef5df3361540/docs/hardware/tbd-register.md) `HW-TBD-002`（2026-09-06 close記録） |
| 2026-09-06 | 25 | [#2](https://github.com/wachi-yoshitaka-11-dev/deskcat/issues/2)。**文書冒頭`状態`行と競合checklistの「Servo PWMがdisabledまたは承認済みの安全状態で起動する」項目について、机上reviewを行い達成へ改めた。**従来は`HW-TBD-026`（SG90の`logic閾値`が一次資料に無い）が未確定であることを理由に、GPIO27＝0 V実測（2026-08-29）を得てもこの項目は満たしていないとしていた。**RC servoのPWM制御信号は周期的なedgeとpulse幅で位置commandを符号化する方式であり、受信側は一定のDC levelからpulse幅を測れない。**GPIO27の起動時state（外部4.7 kΩ pull-downで確定させた定常0 V）は、SG90側の`VIH`／`VIL`の具体的な値によらず——0 Vはどのような正の閾値よりも低い——edgeを持たないDC levelとしてしか受信されず、有効なPWM pulseとして復号され得ない。**したがって「起動時に動きえない状態で止まっているか」は`HW-TBD-026`の数値によらず判定できる。**`HW-TBD-026`が実際に要るのは、firmware初期化後の能動的な3.3 V drive PWMがSG90側に正しく認識されるかという別の判定である。**この判定が閉じるのはGPIO27起動時state reviewだけであり、`servo-safety-limits.md`の`サーボ出力を有効化してよい条件`gate（`HW-TBD-007`／`009`／`010`／`011`／`019`／`020`／`026`／`035`ほかProtocol側TBDを含む）は依然`Blocked`のまま変えていない。**`HW-TBD-019`（起動時とdriver故障時の動作、全6サブ項目）も「PWM driver初期化前のGPIO state」1点が埋まっただけで、他5項目は未解決のまま`tbd-register.md`で追跡する。**あわせて文書冒頭の`状態`行から、この理由（servo起動時状態の安全review待ち）を外し、residualな2件（電源off導通check、MSP2807 logic IO level現物確認）だけを残した | 自己レビュー（`servo-safety-limits.md`の`サーボ出力を有効化してよい条件`節、`tbd-register.md` `HW-TBD-019`／`026`／`027`）、RC servo PWM信号の一般的な符号化方式（周期的edgeとpulse幅） |
| 2026-09-06 | 26 | [#2](https://github.com/wachi-yoshitaka-11-dev/deskcat/issues/2)。PM検査の指摘を反映した。**(a) Revision 25のservo項目に、2026-08-29のGPIO27＝0 V実測がservo・LCD本体を未接続の状態（Revision 23）で行われたことを明記し、edgeの有無は電圧levelそのものではなく波形の形に依るため接続後も結論が変わらない旨を追記した。**(b) 文書冒頭`状態`行が「電源off導通check」「MSP2807 logic IO level現物確認」の2件しか挙げていなかったが、**競合checklistには`[ ]`が7件残っており過少申告だった。**7件を1行ずつ列挙する形へ書き直した。**(c) checklist L388（ADC分圧器）とL391（外部pull-up全体の3.3V接続）の「実配線が存在しない」が何を指すか曖昧だったため、具体化した。**L388は`MEAS-01`の分圧用10 kΩ×4本自体が未実装であることを明記。L391は`LCD-CS`／`LCD-RST`／`TOUCH-CS`の3本がRevision 20-21で実装済み・3.3V接続確認済みであり、**未検証で残るのは`ACCEL-SDA`／`ACCEL-SCL`の外部4.7 kΩ pull-upと`LCD-BL`のpull-down（値未選定）の2本だけであると内訳を分けた。**(d) L392（I2C実効pull-upの有効範囲）を`SERVO-PWM`項目と同じ形（値によらず判定できるか）で検討したが、**同じ形では閉じられないと判定した。**`Rp(min)`側は`Cb`／modeによらず常に成立するが、`Rp(max)`側は`Fast-modeかつ高Cb`の組み合わせで不成立になることが既に判明しており、servoの「どんな閾値でも復号されない」という否定形の議論とは性質が異なる。**Standard-modeに限定すれば実配線の`Cb`を測らなくても有効範囲内と言えることを条件付きの結論として記録したが、modeが未決定のため項目自体は未達のまま残した。****GPIO割り当てそのものは変えていない** | PM（deskcat-f2）検査コメント、`power-budget.md`の段階A／B-1定義 |
| 2026-09-06 | 27 | [#2](https://github.com/wachi-yoshitaka-11-dev/deskcat/issues/2)。PMの決定と質問を反映した。**(a) 初回bring-upで採るI2C modeをStandard-mode（100 kHz）と決定した（人間の判断）。**`I2C busの実効pull-up`節に`初回bring-upのmode決定`小節を新設し、根拠（実構成`Rp`約2.42 kΩはStandard-modeの規定`Cb`上限400 pFでも`Rp(max)`約2.945 kΩを下回り成立、Fast-modeは`Rp(max)`約885 Ωで不成立）、下流要件の確認結果（`#12`／`#15`／`#22`の受け入れ条件に具体的な下限bus速度の要求は無く、`ACCEL-IRQ`によるhardware割り込み設計とBME280の秒order pollingであればStandard-modeで足りる）、見直し条件（Fast-modeが要るならpull-up値の再設計から。`sensor-datasheet-notes.md`の`検証済み最大bus速度`は変更しない）を記録した。checklist「Moduleのpull-upを並列合成した実効抵抗が有効範囲内である」を`[x]`へ改めた。**`J1`／`J2`をはんだ付けするかの判断はこの決定の対象外のまま残した（`bus容量Cb`が未確定）。**(b) `LCD-BL`のpull-down値が`HW-TBD-024`待ちだとしていた記載を訂正した。**`HW-TBD-024`（MSP2807が耐えられる電流の上限）は backlightを点灯させるときの電流制限設定に要る値であり、firmware初期化前にGPIO4をLowへ保って消灯を維持するpull-downの仕事とは無関係である。**`LCD-BL`が決まらない実際の理由は極性の現物未確認（`HW-TBD-032`）1点であると判定した。`LCD-BLを決められない理由`節、`信号inventory`の`LCD-BL`行、checklist L391の該当箇所を訂正した。**値の選定自体（`4.7 kΩ`か`10 kΩ`か）は極性確定後に`SERVO-PWM`と同じ一般値の方法で決められる見込みであることも記録したが、極性の現物確認はこの作業指示書の範囲（机上）では行っていないため、値そのものは選定していない。**(c) 文書冒頭`状態`行を、(a)(b)の変更を反映して未達6件へ更新した | PM（deskcat-f2）の決定・質問、[#12](https://github.com/wachi-yoshitaka-11-dev/deskcat/issues/12)／[#15](https://github.com/wachi-yoshitaka-11-dev/deskcat/issues/15)／[#22](https://github.com/wachi-yoshitaka-11-dev/deskcat/issues/22)の受け入れ条件、[tbd-register.md](https://github.com/wachi-yoshitaka-11-dev/deskcat/blob/b7cb5290715eded3530c7626d92bef5df3361540/docs/hardware/tbd-register.md) `HW-TBD-024`／`HW-TBD-032` |
| 2026-09-06 | 28 | [#2](https://github.com/wachi-yoshitaka-11-dev/deskcat/issues/2)。**Revision 27の判定は、それ自体が古い前提に基づいていた。**PMから`HW-TBD-032`（owner `#2`）のstale記述（後述）を指摘された過程で判明した。**`LCD-BL`の極性は2026-09-05にすでに一次資料で確定していた**（MSP2807公式User Manual、LCDWIKI、Interface Description表が`LED` pinを「high level lighting」と定める。正は[sensor-datasheet-notes.md](https://github.com/wachi-yoshitaka-11-dev/deskcat/blob/b7cb5290715eded3530c7626d92bef5df3361540/docs/hardware/sensor-datasheet-notes.md)の`Backlight回路／電流／polarity`行、Revision 12）。**Revision 27はこの確定を見落とし、「極性の現物未確認が残る」と誤って報告した。**`gpio-assignment.md`側（この文書）が2026-09-05の確定を反映していなかったため、`tbd-register.md`・`sensor-datasheet-notes.md`を照合せずに判定した結果である。**訂正する。**極性が確定済みである以上、Revision 27で示した「極性確定後に`SERVO-PWM`と同じ一般値の方法で決められる」という条件は満たされたため、**`LCD-BL`のpull-downを`4.7 kΩ`×1本に確定した。**`選定した値と本数`表、`LCD-BLを4.7 kΩにした理由`節（旧`LCD-BLを決められない理由`。見出しも実体に合わせて改めた）、`信号inventory`の`LCD-BL`行、checklist L391／L395、文書冒頭`状態`行を更新した。**あわせて`tbd-register.md`の`HW-TBD-032`（owner `#2`）を、実装状況（`LCD-CS`／`LCD-RST`は実装済み、未実装は`LCD-BL`のみ）と極性確定の反映が遅れていた点を含めて訂正した（別途同file側のRevisionで記録）。**このRevisionは、今日指摘・修正してきた「実体が進んだのに参照側が取り残される」型の不整合を、自分自身の直前の判定でも起こしていたことの記録である | PM（deskcat-f2）指摘、[sensor-datasheet-notes.md](https://github.com/wachi-yoshitaka-11-dev/deskcat/blob/b7cb5290715eded3530c7626d92bef5df3361540/docs/hardware/sensor-datasheet-notes.md) Revision 12、[tbd-register.md](https://github.com/wachi-yoshitaka-11-dev/deskcat/blob/b7cb5290715eded3530c7626d92bef5df3361540/docs/hardware/tbd-register.md) `HW-TBD-032` |
| 2026-09-06 | 29 | [#2](https://github.com/wachi-yoshitaka-11-dev/deskcat/issues/2)。**commit前の自己レビュー（要件照合Passとfresh-context Pass）で検出した3件を反映した。**(a) `LCD-BLを4.7 kΩにした理由`節末尾の結論文が、直前の箇条書き（極性確定・値確定）と矛盾していた。「`LCD-BL`の値と向きは`HW-TBD-032`（極性の現物確認）の後に決める」「極性の現物確認は…この作業指示書の範囲では行っていない」という、Revision 28以前の未確定を前提にした文をRevision 28後も直しておらず、同じ節の中で「確定した」と「未確定」が両方書かれていた。**値・向き・本数が確定済みであることを述べる形へ書き直した。**(b) checklist L392（I2C実効pull-upの有効範囲）の本文中に、mode決定（Revision 27で`[x]`化した同じ文の中）より後ろの文で「残る未確定入力は`bus容量Cb`と`採るmode`の2つである」という、mode決定前の文言が残っていた。**採るmodeは決定済みである旨へ訂正した。**(c) 受け入れ条件7件目「最初のbring-up範囲について未解決GPIOがない」の範囲定義を、これまでPMへの報告（chat）でのみ述べており、**正本である本文書には一度も書いていなかった。**新設した`初回bring-upの範囲`節（`競合check`の直後）に、含める範囲（ESP32単体・PC USB給電・`信号inventory`の全信号へのGPIO割り当てと起動時state確定）と含めない範囲（`#247`のPi給電、servoの実actuator動作）を明記し、この定義の下で未解決GPIOが無いことを示した。**要件照合Passはこの3件で1 round目に0件へ収束していない。****fresh-context Passで(a)(b)を、要件照合Passで(c)を検出した。**この訂正後に改めて両Passを実施し、新規指摘0件を確認した（2 round目） | 自己レビュー（`CONTRIBUTING.md`「自己レビュー」の2つのPass） |
| 2026-09-06 | 30 | [#2](https://github.com/wachi-yoshitaka-11-dev/deskcat/issues/2)。**PR #358へ手動で依頼したCodeRabbit reviewの指摘2件を反映した。**(a) `信号inventory`の`ACCEL-SDA`行が、初回bring-upのmode決定（Standard-mode、Revision 27）の後も「400kHz(Fast-mode)を想定、要実測」というmode決定前の記述のままだった。**Standard-mode採用と、Fast-modeへ変更する場合はpull-up再設計が要る旨へ訂正した。**(b) checklist「Moduleのpull-upを並列合成した実効抵抗が有効範囲内である」を、Revision 27で「Standard-mode採用により実配線の`Cb`を測らなくても有効範囲内」として`[x]`にしていたが、**この判定は不十分だった。**`Rp(max)`約2.945 kΩ（Standard-modeの規定`Cb`上限400 pFから導いた値）は**rise timeの制約から`Rp`側で導いた上限であり、実配線の`Cb`が規定上限400 pFの範囲内であることを示すものではない。**実構成`Rp`（約2.42 kΩ）を使えばrise timeの制約だけなら`Cb`は約488 pFまで許容されるが、**Standard-modeの`Cb`上限400 pFがrise time以外の制約（fall time等、`Rp`の選定では動かせない可能性がある制約）にも由来するかどうかを、この文書が引用した一次資料（`tr`／`Cb`／`IOL`の列のみ）の範囲では確認できていない。**したがって、実配線の`Cb`が400〜488 pFの間にある場合、rise timeの計算は通ってもStandard-modeとして規定範囲内と言い切れない可能性が残る。**mode決定（Standard-mode採用）自体は取り消さない**（初回bring-upの選択としては変わらず有効）が、**この checklist項目は`Cb`の実測または設計上の根拠を得るまで未達へ戻した。**文書冒頭`状態`行も未達7件へ戻した。**受け入れ条件5件目（I2C addressとpull-upに互換性がある）の判定は変えていない。**同判定は`Rp(min)`（`Cb`／modeによらず常に成立し、素子の破損に至らないことの根拠）に基づくものであり、今回reopenしたのは`Rp(max)`側（通信の正しさに関わるが、外れても安全要件5項目には該当しない一般値tierの論点）である | PR #358のCodeRabbit手動review（2026-09-06、`@coderabbitai full review`） |
| 2026-09-06 | 31 | [#2](https://github.com/wachi-yoshitaka-11-dev/deskcat/issues/2)。**競合checklistの2項目（MSP2807のlogic IO確認、ESP32電源投入前に外部moduleがpinをdriveしないこと）が確認方法を持っていなかったため、`実機check（電源off）の確認方法`節を新設して定義した。**`#2`本文の範囲（電源offでの導通とpin header対応だけ）を超えないこと、推測禁止（一般値や記憶で判定基準を作らない）を守った。**(1) driveしないことの確認は、非通電の導通checkだけで判定できると判定した。**周辺module3点はいずれもESP32の`3V3` pinから給電され独立電源を持たない（[power-budget.md](https://github.com/wachi-yoshitaka-11-dev/deskcat/blob/b7cb5290715eded3530c7626d92bef5df3361540/docs/hardware/power-budget.md)の測定点定義）ため、ESP32電源offの状態では周辺moduleも無給電であり、無給電のICは内部topology（`HW-TBD-004`の直列抵抗未追跡、MSP2807の`U1`経路未追跡）によらず能動的にdriveできない。**したがってmodule側の出力段の性質はこの判定に効かない。**確認すべきは(a)module電源pinがESP32の`3V3`と同一netであること（独立電源が無いこと）、(b)pin header対応（配線ミスが無いこと）の2点であり、測定点・計器・判定基準を表にまとめた。**(2) MSP2807のlogic IO確認は、メーカー記載（3.3 V TTL）だけでは足りないと判定した。**`DISP-01`のVCCはESP32の3.3 V rail（3.234–3.366 V）から給電されるが、[power-budget.md](https://github.com/wachi-yoshitaka-11-dev/deskcat/blob/b7cb5290715eded3530c7626d92bef5df3361540/docs/hardware/power-budget.md)が2026-09-06に確認したとおり同rail電圧では`DISP-01`board上の`U1`（3.3 V LDO）は常時dropout領域にあり、出力は3.3 Vへ完全収束しない。**controller IC（ILI9341／XPT2046）が`U1`出力側から給電されているかVCC直結かは、どちらの一次資料にも記録が無い。**したがってメーカー記載はこのboardの実際のlogic供給node電圧を保証しない。**非通電で追加確認できる方法（`U1`出力側の脚とcontroller IC電源pinの導通追跡）を1つ定義したが、backlight LED給電経路の追跡（`R5`／`Q1`）がすでに部品サイズを理由に非通電では決められないと結論しており、同程度のIC pinで同じ制約に当たる可能性が高いことも明記した。**解決しない場合、残る手段は通電を伴う実測であり`#2`の範囲を超え、実際の動作確認はLCD bring-up（`#13`）で行うと整理した。**PMの検査を受け、2点を追記した。**(a) (1)の項目へ「見ていないもの」を明記した。**`ACCEL-01`の`01C`（10 kΩ×4）のような module側pull-upがESP32起動時levelへ与える影響は、この項目（moduleが能動的にdriveしないこと）の対象外であり、`起動時状態を確定させる外部pull`節とbootstrap pinのreviewが扱う範囲であると書き分けた。**(b) (2)へ、ILI9341とXPT2046のdatasheetを2026-09-06に新たに取得し`VOH`（それぞれ`0.8×VDDI`、`IOVDD×0.8`）を確認したうえでの計算を追記した。**ESP32の`VIH`（rail 3.234–3.366 Vで2.4255–2.5245 V）と突き合わせると、logic供給nodeが`VCC`直結なら約160–170 mVの余裕があるが、`U1`出力経由（dropout、約2.99 V）なら`VOH`min約2.392 Vとなり約34–133 mV不足する。**計算だけではこの項目を閉じられず、答えは非通電追跡（logic供給nodeの特定）に懸かっていることを示した。**あわせて、ESP32からmoduleへの向き（`SCLK`等）はどちらのnode想定でも余裕があり、不足しうるのはmoduleからESP32への向き（`DOUT`／`PENIRQ`等）だけであることも明記した。**GPIO割り当てそのものは変えていない | PM（deskcat-f2）の追加依頼・検査、`WORK-INSTRUCTIONS-BENCH-2026-09-06.md`（PM作成、gitignore対象）、[power-budget.md](https://github.com/wachi-yoshitaka-11-dev/deskcat/blob/b7cb5290715eded3530c7626d92bef5df3361540/docs/hardware/power-budget.md)、[sensor-datasheet-notes.md](https://github.com/wachi-yoshitaka-11-dev/deskcat/blob/b7cb5290715eded3530c7626d92bef5df3361540/docs/hardware/sensor-datasheet-notes.md)、[ILI9341 Datasheet V1.11](https://cdn-shop.adafruit.com/datasheets/ILI9341.pdf) §18.2.1（2026-09-06取得）、[XPT2046 Datasheet](https://grobotronics.com/images/datasheets/xpt2046-datasheet.pdf)（2026-09-06取得） |
| 2026-09-07 | 32 | [#2](https://github.com/wachi-yoshitaka-11-dev/deskcat/issues/2)。**`#2`のclose作業。**(a) 残っていた7本の抵抗（ADC分圧器4本、外部pull3本。`ADC-5V`／`ADC-3V3`分圧器`10 kΩ`×4、`ACCEL-SDA`／`ACCEL-SCL`pull-up`4.7 kΩ`×2、`LCD-BL`pull-down`4.7 kΩ`×1）をブレッドボードへ実装した。配線色は`ADC-5V`＝青、`ADC-3V3`＝白、`ACCEL-SDA`＝青、`ACCEL-SCL`＝緑、`LCD-BL`＝紫（人間の申告）。**抵抗の個別実測（DT830B）は行わない。**5%許容差の着荷済み品であり`Rp`等の余裕は桁で足りるため、人間と合意のうえ個別実測をしないと決めた。**やっていないことをやったと書かないため、この決定自体を記録する。**(b) `EN`を押し続けてESP32をresetに保持した状態で、`LCD-CS`(GPIO22)＝3.31 V、`LCD-RST`(GPIO16)＝3.31 V、`TOUCH-CS`(GPIO21)＝3.31 V、`LCD-BL`(GPIO4)＝0.00 Vを実測した（いずれも`EN`押下の有無で値が変化しないことを確認。`fc42332`の`SERVO-PWM`測定と同じ方法）。**2026-08-29の実測はpull-upの効果とfirmwareのHigh駆動を区別できていなかったが、今回`EN`保持により切り分けた。**記録は[experiment-log.md](https://github.com/wachi-yoshitaka-11-dev/deskcat/blob/b7cb5290715eded3530c7626d92bef5df3361540/docs/hardware/experiment-log.md)の`EXP-011`。(c) **PM（`deskcat-f2`）が2026-09-07に`#2`のclose条件を再スコープした。**checklist項目3（I2C実効pull-up有効範囲）と項目5（外部moduleがpinをdriveしないこと）は、いずれもmoduleをESP32へ配線することが検証の前提であり、`初回bring-upの範囲`節が定める`#2`の範囲に含まれないため、close条件から外した（満たすのはmoduleを配線した時点。`#13`／`#15`／`#16`側）。**項目4（MSP2807のlogic IO）も、`#360`自身が「`R5`／`Q1`と同じ理由で決まらない可能性が高い」としていることと、`#2`本文の受け入れ条件7件のどれにも対応せず安全要件5項目にも該当しないことから、追跡を試みず`#13`（LCD bring-up）の通電実測へ送った。**checklistからは削除せず、理由と送り先を項目の記述へ書き足した。**文書冒頭`状態`行を、`#2`のclose条件（達成した4件）と、close条件ではない3件（module配線時に満たす）とに分けた。**`#2`のclose条件（項目1・2・6・7）はすべて達成した。**(d) [sensor-datasheet-notes.md](https://github.com/wachi-yoshitaka-11-dev/deskcat/blob/b7cb5290715eded3530c7626d92bef5df3361540/docs/hardware/sensor-datasheet-notes.md) Revision 12にあった誤りをRevision 14で訂正した（Revision 12の本文は書き換えていない。詳細は同文書のRevision履歴）。**`U1`の脚の識別結果（`VCC`／`GND`導通による入力／GND／出力の判定）は電気的関係に基づく再現可能な識別であり、有効なまま残す** | 人間の現物作業（配線、`EN`保持測定）、PM（deskcat-f2）の判定（2026-09-07）、[experiment-log.md](https://github.com/wachi-yoshitaka-11-dev/deskcat/blob/b7cb5290715eded3530c7626d92bef5df3361540/docs/hardware/experiment-log.md) `EXP-011` |
| 2026-09-22 | 33 | [#13](https://github.com/wachi-yoshitaka-11-dev/deskcat/issues/13)。**`実機check（電源off）の確認方法`節へ、`電源pinの短絡・誤配線の確認（非通電）`小節を追加した。**既存2項目（driveしないこと、pin header対応）は信号pinの導通を扱うが、`DISP-01`初回通電に先立つ`VCC`–`GND`間短絡検出・一覧との目視照合・逆極性確認・給電経路の重複確認は電源経路そのものを扱うため対象が異なり、分けて追加した。新しい数値の正はここに置かず、[sensor-datasheet-notes.md](https://github.com/wachi-yoshitaka-11-dev/deskcat/blob/b7cb5290715eded3530c7626d92bef5df3361540/docs/hardware/sensor-datasheet-notes.md)の`pin定義（LCDWiki公式User Manual原文）`と[power-budget.md](https://github.com/wachi-yoshitaka-11-dev/deskcat/blob/b7cb5290715eded3530c7626d92bef5df3361540/docs/hardware/power-budget.md)のB-2b決定を参照するだけである | 新規追加（LCD bring-up作業） |
| 2026-09-22 | 34 | [#13](https://github.com/wachi-yoshitaka-11-dev/deskcat/issues/13)。**PM（`#0PM`）の指摘を受け、Revision 33の項目4（給電経路の重複確認）を`DISP-01`限定と明記した。**`ACCEL-01`／`ENV-01`が`3V3` pinから給電する構成を採るかは別途[#445](https://github.com/wachi-yoshitaka-11-dev/deskcat/issues/445)で扱われており、同じ節が異なる給電経路を一般則のように書いてしまうことを避けるため、項目名と本文へ`DISP-01`限定である旨を追記した。この文書は`#445`の決定を先取りしない | PM（`#0PM`）の指摘 |
| 2026-09-22 | 35 | [#13](https://github.com/wachi-yoshitaka-11-dev/deskcat/issues/13)。**`#15`／`#16`のsessionが見つけた事実（PM（`#0PM`）経由）を受け、Revision 33の項目1（`VCC`–`GND`間短絡検出）の判定基準を訂正した。**`EXP-013`試験0（[experiment-log.md](https://github.com/wachi-yoshitaka-11-dev/deskcat/blob/b7cb5290715eded3530c7626d92bef5df3361540/docs/hardware/experiment-log.md)）を開いて確認したところ、放電した状態の別対象へプローブを当てた瞬間は0 Ω付近を示し、decoupling capacitorの充電が進むにつれ値が上昇して安定する現象と、瞬時値を導通の判定に使うと正常品を短絡と誤判定しかけたという教訓が記録されていた。**固定した抵抗値のしきい値（当初「数Ω以下」としていた）では、この現象を持つ正常なmoduleを短絡と誤判定しうる。**`DISP-01`（MSP2807）で同じ挙動が起きることは確認されていないが（[sensor-datasheet-notes.md](https://github.com/wachi-yoshitaka-11-dev/deskcat/blob/b7cb5290715eded3530c7626d92bef5df3361540/docs/hardware/sensor-datasheet-notes.md)の`Local decoupling`節、MSP2807行は`TBD`）、起きうるものとして扱い、判定基準を「読みが低い値から始まり上昇していく＝正常」「低いまま動かない＝短絡」という挙動ベースへ変更した | `#15`／`#16`のsession、PM（`#0PM`）の指摘、[experiment-log.md](https://github.com/wachi-yoshitaka-11-dev/deskcat/blob/b7cb5290715eded3530c7626d92bef5df3361540/docs/hardware/experiment-log.md)の`EXP-013`試験0 |
| 2026-09-22 | 36 | [#15](https://github.com/wachi-yoshitaka-11-dev/deskcat/issues/15)／[#16](https://github.com/wachi-yoshitaka-11-dev/deskcat/issues/16)。**`電源pinの短絡・誤配線の確認（非通電）`表へ、`ACCEL-01`／`ENV-01`向けの項目5〜7を追加し、節の前書きと項目1の説明段落を`DISP-01`限定の記述から周辺module3点を対象とする記述へ書き直した。**表へ`対象`列を追加し、各行が共通／`DISP-01`限定／`ACCEL-01`・`ENV-01`限定のいずれかを判別できるようにした。項目1（`VCC`–`GND`間短絡検出、Revision 35で挙動ベースへ訂正済み）の判定基準そのもの（2値：上昇して安定＝正常、低いまま動かない＝短絡）は作り直さず、`ACCEL-01`／`ENV-01`にもそのまま適用する形で参照した。ただしfresh-context自己レビューでの訂正を経て、判定基準に3つ目の帰結（最初から高い値で安定している場合も正常）を追加し、説明段落（`DISP-01`より`ACCEL-01`／`ENV-01`の方が根拠が強い点、`EXP-013`の引用範囲）も書き直している。項目5〜7の判定基準・照合先は、PM（`#0PM`）の指摘とfresh-context自己レビュー（1〜13巡目）を経て複数回訂正されている。**個々の指摘内容と巡ごとの件数はこの行では再掲しない**（本文が正であり、数値・pin名をここに書き写すと本文の版が変わるたびに乖離するため。実際にこの行の旧稿は、本文で訂正済みのpin名・現象の記述をそのまま複製しており、本文と食い違っていた）。収束（新規指摘0件が2巡連続）には至っていない時点でこのRevisionを記録しており、**引き続き自己レビューを継続する** | [#445](https://github.com/wachi-yoshitaka-11-dev/deskcat/issues/445)の2026-09-22承認、[sensor-datasheet-notes.md](https://github.com/wachi-yoshitaka-11-dev/deskcat/blob/b7cb5290715eded3530c7626d92bef5df3361540/docs/hardware/sensor-datasheet-notes.md)、[tbd-register.md](https://github.com/wachi-yoshitaka-11-dev/deskcat/blob/b7cb5290715eded3530c7626d92bef5df3361540/docs/hardware/tbd-register.md)の`HW-TBD-004`／`HW-TBD-005`、`firmware/esp32/src/main.rs`、PM（`#0PM`）の指摘、fresh-context自己レビュー（1〜13巡目） |
| 2026-09-22 | 37 | [#446](https://github.com/wachi-yoshitaka-11-dev/deskcat/issues/446)。UART0関連の用途記述（`ESP32の使用制限pin`表の`UART0`行、`信号inventory`の`UART-TX`／`UART-RX`行とその`共有先`列、`競合check`の該当項目）を書き直した。**旧記述「firmware flashingとdebug log専用」「Pi linkはこの2本を使わない」は誤りだった。**USB-UARTブリッジがUART0（GPIO1／GPIO3）へ内部接続すること自体はRevision 4（2026-08-05）から記録済みだったが、**Pi linkがそのUSB serial経由で同じUART0を使うことをこの用途記述へ反映していなかった**（`#446`調査で判明）。**GPIO割り当てそのものは変えていない。**設計の詳細は`docs/protocol/esp32-pi-protocol.md`§2、`firmware/esp32/src/console.rs`参照。**実機へflashしての確認はしていない。**（本Revisionの番号は、rebase前に`#15`／`#16`が既に使っていた「36」との衝突を避けるため37とした。両者は互いに独立した変更である。） | [#446](https://github.com/wachi-yoshitaka-11-dev/deskcat/issues/446)、`firmware/esp32/src/console.rs` |
| 2026-09-22 | 38 | [#453](https://github.com/wachi-yoshitaka-11-dev/deskcat/issues/453)（[#16](https://github.com/wachi-yoshitaka-11-dev/deskcat/issues/16)の残件1件の記録。**`#16`自体はcloseしない**）。**`ENV-01`（AE-BME280）の`J3`が2026-09-07にはんだ付けされていたことが、2026-09-22にユーザーの言明で判明した。****実施から15日間、この文書は`J3`を`開放`・`はんだ付けが要る`と書き続けていた。****正本のどこにも、はんだ付け済みであるという記録が無かった**（この文書・[sensor-datasheet-notes.md](https://github.com/wachi-yoshitaka-11-dev/deskcat/blob/b7cb5290715eded3530c7626d92bef5df3361540/docs/hardware/sensor-datasheet-notes.md)・[tbd-register.md](https://github.com/wachi-yoshitaka-11-dev/deskcat/blob/b7cb5290715eded3530c7626d92bef5df3361540/docs/hardware/tbd-register.md)・Issue `#16`は`未実施`／`開放`と書き、[experiment-log.md](https://github.com/wachi-yoshitaka-11-dev/deskcat/blob/b7cb5290715eded3530c7626d92bef5df3361540/docs/hardware/experiment-log.md)は`J3`に関する記述を1件も持っていなかった。**誤りではなく不在である**）。この文書はjumper実装状態の正本ではないため、**状態そのものと確認方法はここへ再掲せず、正本（[sensor-datasheet-notes.md](https://github.com/wachi-yoshitaka-11-dev/deskcat/blob/b7cb5290715eded3530c7626d92bef5df3361540/docs/hardware/sensor-datasheet-notes.md)の`J3をはんだ付けした（2026-09-07）`節、Revision 16）を指す追記を4箇所へ入れた。**(a) `信号inventory`の`ENV-SDA`行（`ENV-SCL`は`同上`で追従する）。(b) `Bus計画`の`I2C sensor bus`行。**実効pull-upの計算にBME280側の4.7 kΩを入れるかどうかは`J1`／`J2`で決まり`J3`では変わらないこと、`J1`／`J2`の現在の状態は正本が持つことを明記した。**(c) `電源pinの短絡・誤配線の確認（非通電）`の項目5の判定基準。**`ENV-01`の`CSB`→`VDD`は`J3`未はんだを理由に対象外とする必要がなくなったが、未接合の可能性を判定していないため電気的な接続は主張しないこと、項目5が求める非通電での現物確認自体は手順の実施時に行うこと、はんだ付けの品質の判定基準はこの変更で足していないこと**を明記した（正本節が明記するとおり、この変更を書いたAIセッションは`J3`の閉を確認しておらず、測定点・レンジ・読みの記録も残っていない）。(d) `I2C addressの選択`節の「実装は配線であり、`J3`のはんだ付けと同じ機会に行う作業である」。**`J3`は済んだがアドレスの配線が行われた記録は無いため、この前提は少なくとも記録上は成立していない**（**現況をユーザーへ訊いてはいない。記録の不在であって未実施の確認ではない**）。**いつ行うかの代わりの規定は置いていない。****`J3`以外の項目の現在の状態は正本の`closeまでに要ること（実装と確認を含む）`表が持つ。ここへ再掲しない。****2026-08-22時点の記述は1箇所も書き換えていない。****GPIO割り当ては変えていない。****`J1`／`J2`をはんだ付けするかの判断（`bus容量Cb`待ち）も動かしていない** | ユーザーの言明（2026-09-22）、[sensor-datasheet-notes.md](https://github.com/wachi-yoshitaka-11-dev/deskcat/blob/b7cb5290715eded3530c7626d92bef5df3361540/docs/hardware/sensor-datasheet-notes.md) Revision 16、[experiment-log.md](https://github.com/wachi-yoshitaka-11-dev/deskcat/blob/b7cb5290715eded3530c7626d92bef5df3361540/docs/hardware/experiment-log.md) `EXP-014` |
| 2026-09-23 | 39 | [#13](https://github.com/wachi-yoshitaka-11-dev/deskcat/issues/13)。**`電源pinの短絡・誤配線の確認（非通電）`表の項目4（給電経路の重複確認）を更新した。**旧記述は「採用済みの経路はB-2b」と、`DISP-01`の給電経路をB-2b（外部の3.3 V電源）だけに固定して書いていたが、[#461](https://github.com/wachi-yoshitaka-11-dev/deskcat/issues/461)（2026-09-23）でESP32自身の`3V3` pinからの通常接続も認められたため、この記述は経路を1つに限定できなくなった。**判定基準（単一経路であること）自体は変えず**、給電元がB-2bか`3V3` pinかで参照先の節が変わることを明記し、[power-budget.md](https://github.com/wachi-yoshitaka-11-dev/deskcat/blob/b7cb5290715eded3530c7626d92bef5df3361540/docs/hardware/power-budget.md)の新設節（`DISP-01`追加接続のbring-upの手順、`#461`承認範囲）へ相互参照を足した。**項目2・3（一覧照合、逆極性確認）はいずれの経路でも判定内容が変わらないため触っていない。****GPIO割り当て・他項目の判定基準は変えていない** | [#461](https://github.com/wachi-yoshitaka-11-dev/deskcat/issues/461)、[power-budget.md](https://github.com/wachi-yoshitaka-11-dev/deskcat/blob/b7cb5290715eded3530c7626d92bef5df3361540/docs/hardware/power-budget.md)の`DISP-01`追加接続のbring-upの手順（ESP32`3V3` pin給電、`#461`承認範囲） |
| 2026-09-23 | 40 | [#13](https://github.com/wachi-yoshitaka-11-dev/deskcat/issues/13)。**`module電源pinの独立性`行の直後にある`DISP-01`の扱いを訂正した。**旧記述は「`DISP-01`はこの節の対象外」と一律に書いていたが、同じ行自体は`DISP-01`の`VCC`を測定対象に含めている。B-2b経由（`3V3` pinを使わない）では測定自体が発生しないため対象外という説明は成立するが、[#461](https://github.com/wachi-yoshitaka-11-dev/deskcat/issues/461)（2026-09-23）でESP32自身の`3V3` pinへの通常接続が認められたため、その経路では`ACCEL-01`／`ENV-01`と同様にこの測定が未実施のまま残ることを明記した。測定自体は`power-budget.md`の`DISP-01`追加接続のbring-upの手順が扱う。**表の判定基準・GPIO割り当ては変えていない** | [#461](https://github.com/wachi-yoshitaka-11-dev/deskcat/issues/461)、[power-budget.md](https://github.com/wachi-yoshitaka-11-dev/deskcat/blob/b7cb5290715eded3530c7626d92bef5df3361540/docs/hardware/power-budget.md)の`DISP-01`追加接続のbring-upの手順 |
| 2026-09-24 | 41 | [#472](https://github.com/wachi-yoshitaka-11-dev/deskcat/issues/472)（[PR #471](https://github.com/wachi-yoshitaka-11-dev/deskcat/pull/471)のCodeRabbit review指摘）。`I2C sensor bus`行が、実効pull-upの値が決まらない理由に「ADXL345側のpin接続」と「採るmode」を数え、残作業にも「ADXL345側のpin接続の確認」を挙げていた。前者は2026-08-27に、後者は2026-09-06に確定済みであり（`I2C busの実効pull-up`節の`確定した入力・まだ確定できない1つの入力`）、**残る入力は`Cb`の1つである**と同じセルの末尾へ日付つきで追記した。あわせて、同節の「まだ確定できない2つの入力」（残る入力の数）と「実配線が存在しない」（`EXP-015`で配線済み）、`競合check`節の「実配線の`Cb`が存在しない現状」の計3箇所へ、日付つきの追記を入れた。**既存の文言は書き換えていない。****値そのもの、判定基準、GPIO割り当ては変えていない** | PR #471のreview thread、同文書の`I2C busの実効pull-up`節 |
| 2026-09-25 | 42 | [#446](https://github.com/wachi-yoshitaka-11-dev/deskcat/issues/446)のPR B。`ESP32の使用制限pin`表の`UART0`行と`信号inventory`の`UART-RX`行が、「このfirmwareは受信loopを実装していない」「RXを読まない」と書いていたが、`pi-protocol-mode`が`boot`のACK受信にRXを読む実装（`crate::boot_session`）が入ったため偽になっていた。既定buildはRXを読まないままであることは変えず、`pi-protocol-mode`だけの挙動として書き分けた。**GPIO割り当てそのものは変えていない。実機での受信確認（software ring buffer溢れの有無、`boot`→ACK成立）はまだ無い** | [#446](https://github.com/wachi-yoshitaka-11-dev/deskcat/issues/446)、`firmware/esp32/src/boot_session.rs` |
