wachi-yoshitaka-11-dev/deskcat/hardware/deskcat.kicad_sch

## KiCad design hardware/deskcat.kicad_sch (2026-10-24)

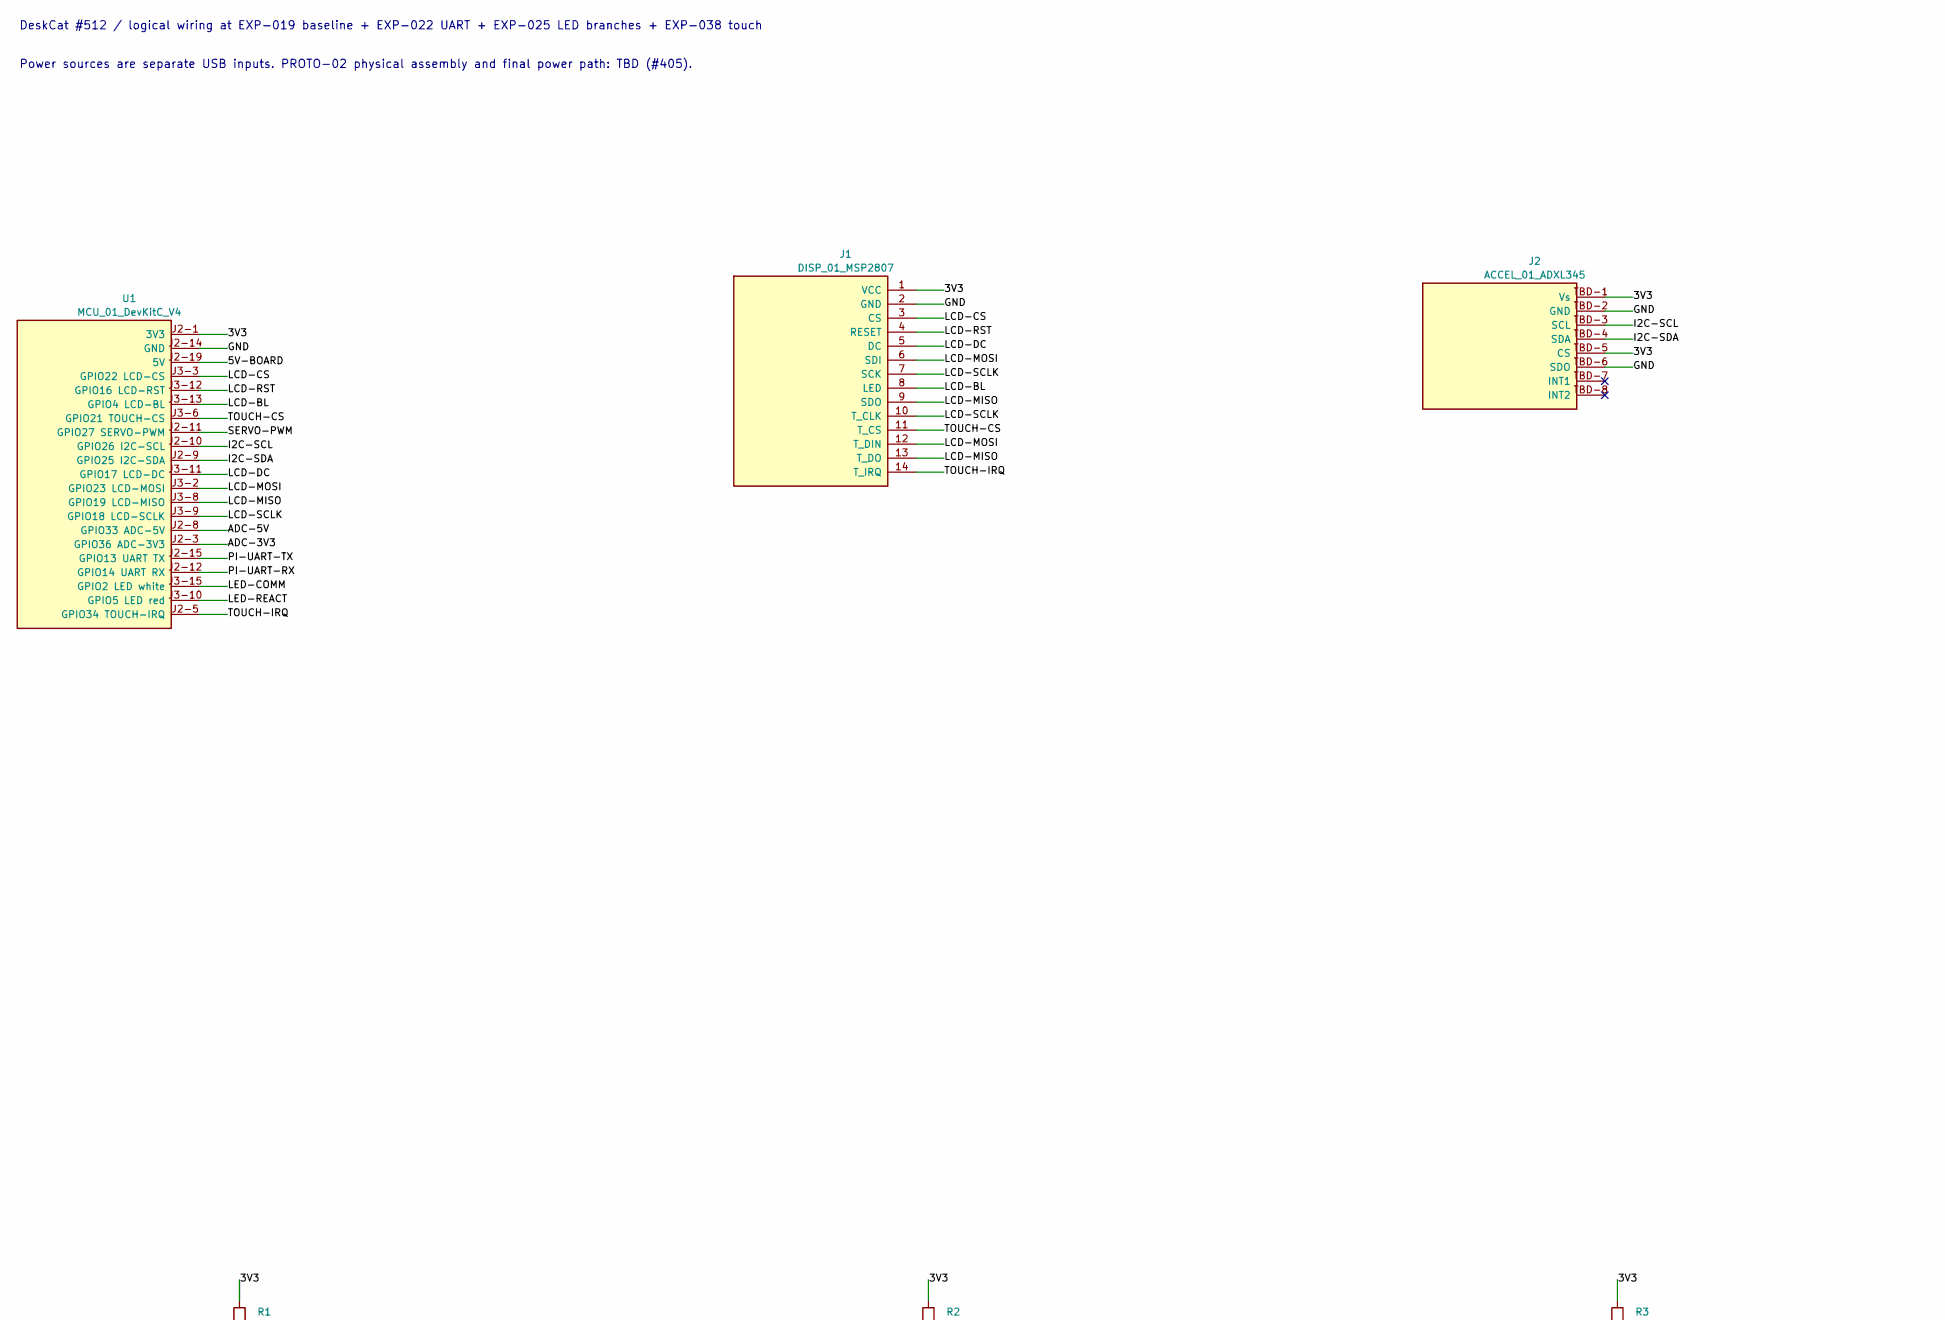
[picture p2: schematic deskcat.kicad_sch, part in row 1, column 1]

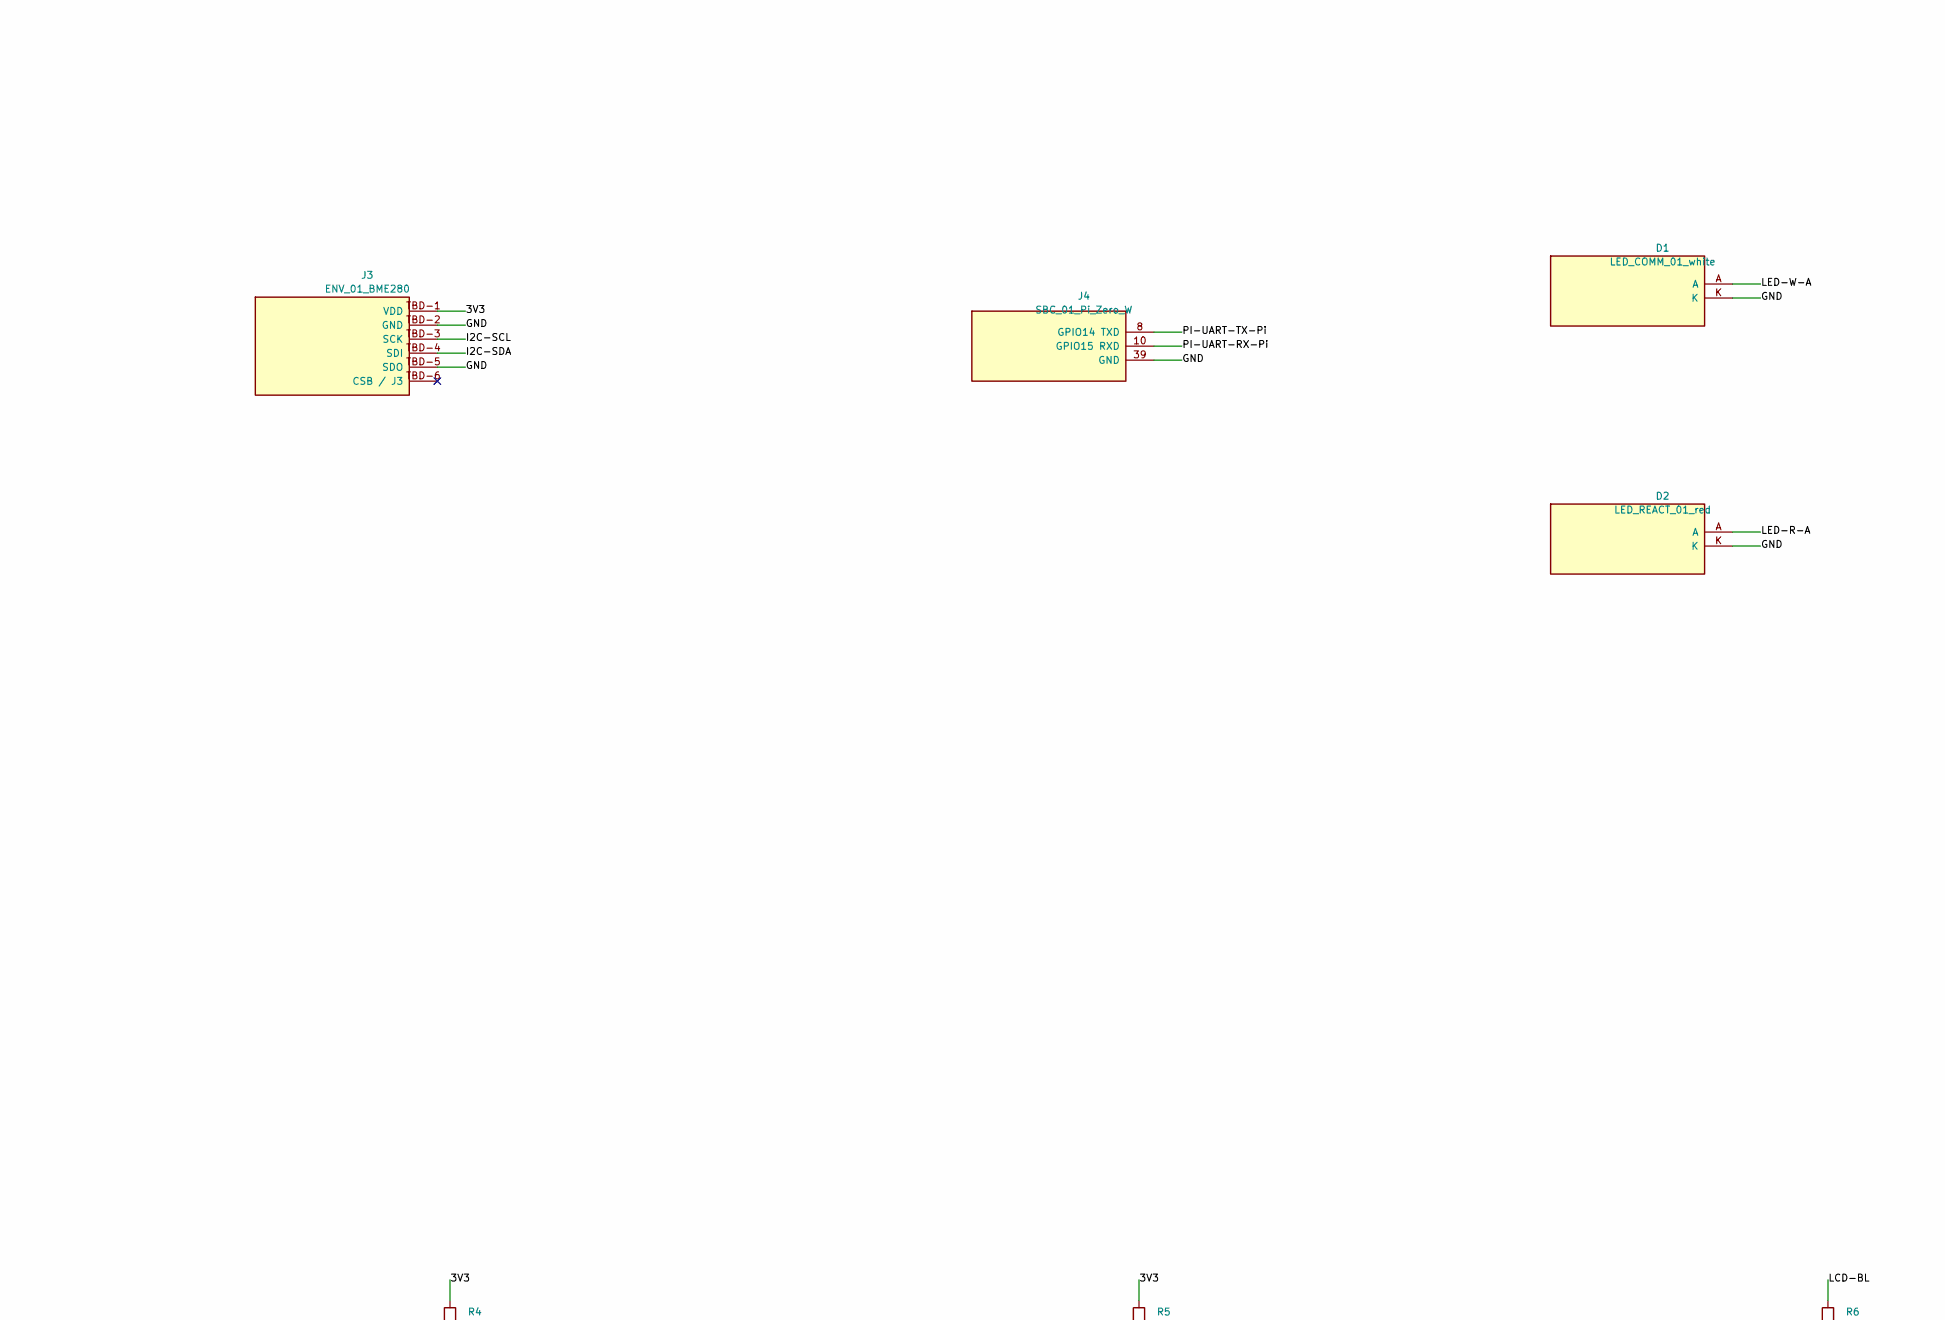
[picture p3: schematic deskcat.kicad_sch, part in row 1, column 2]

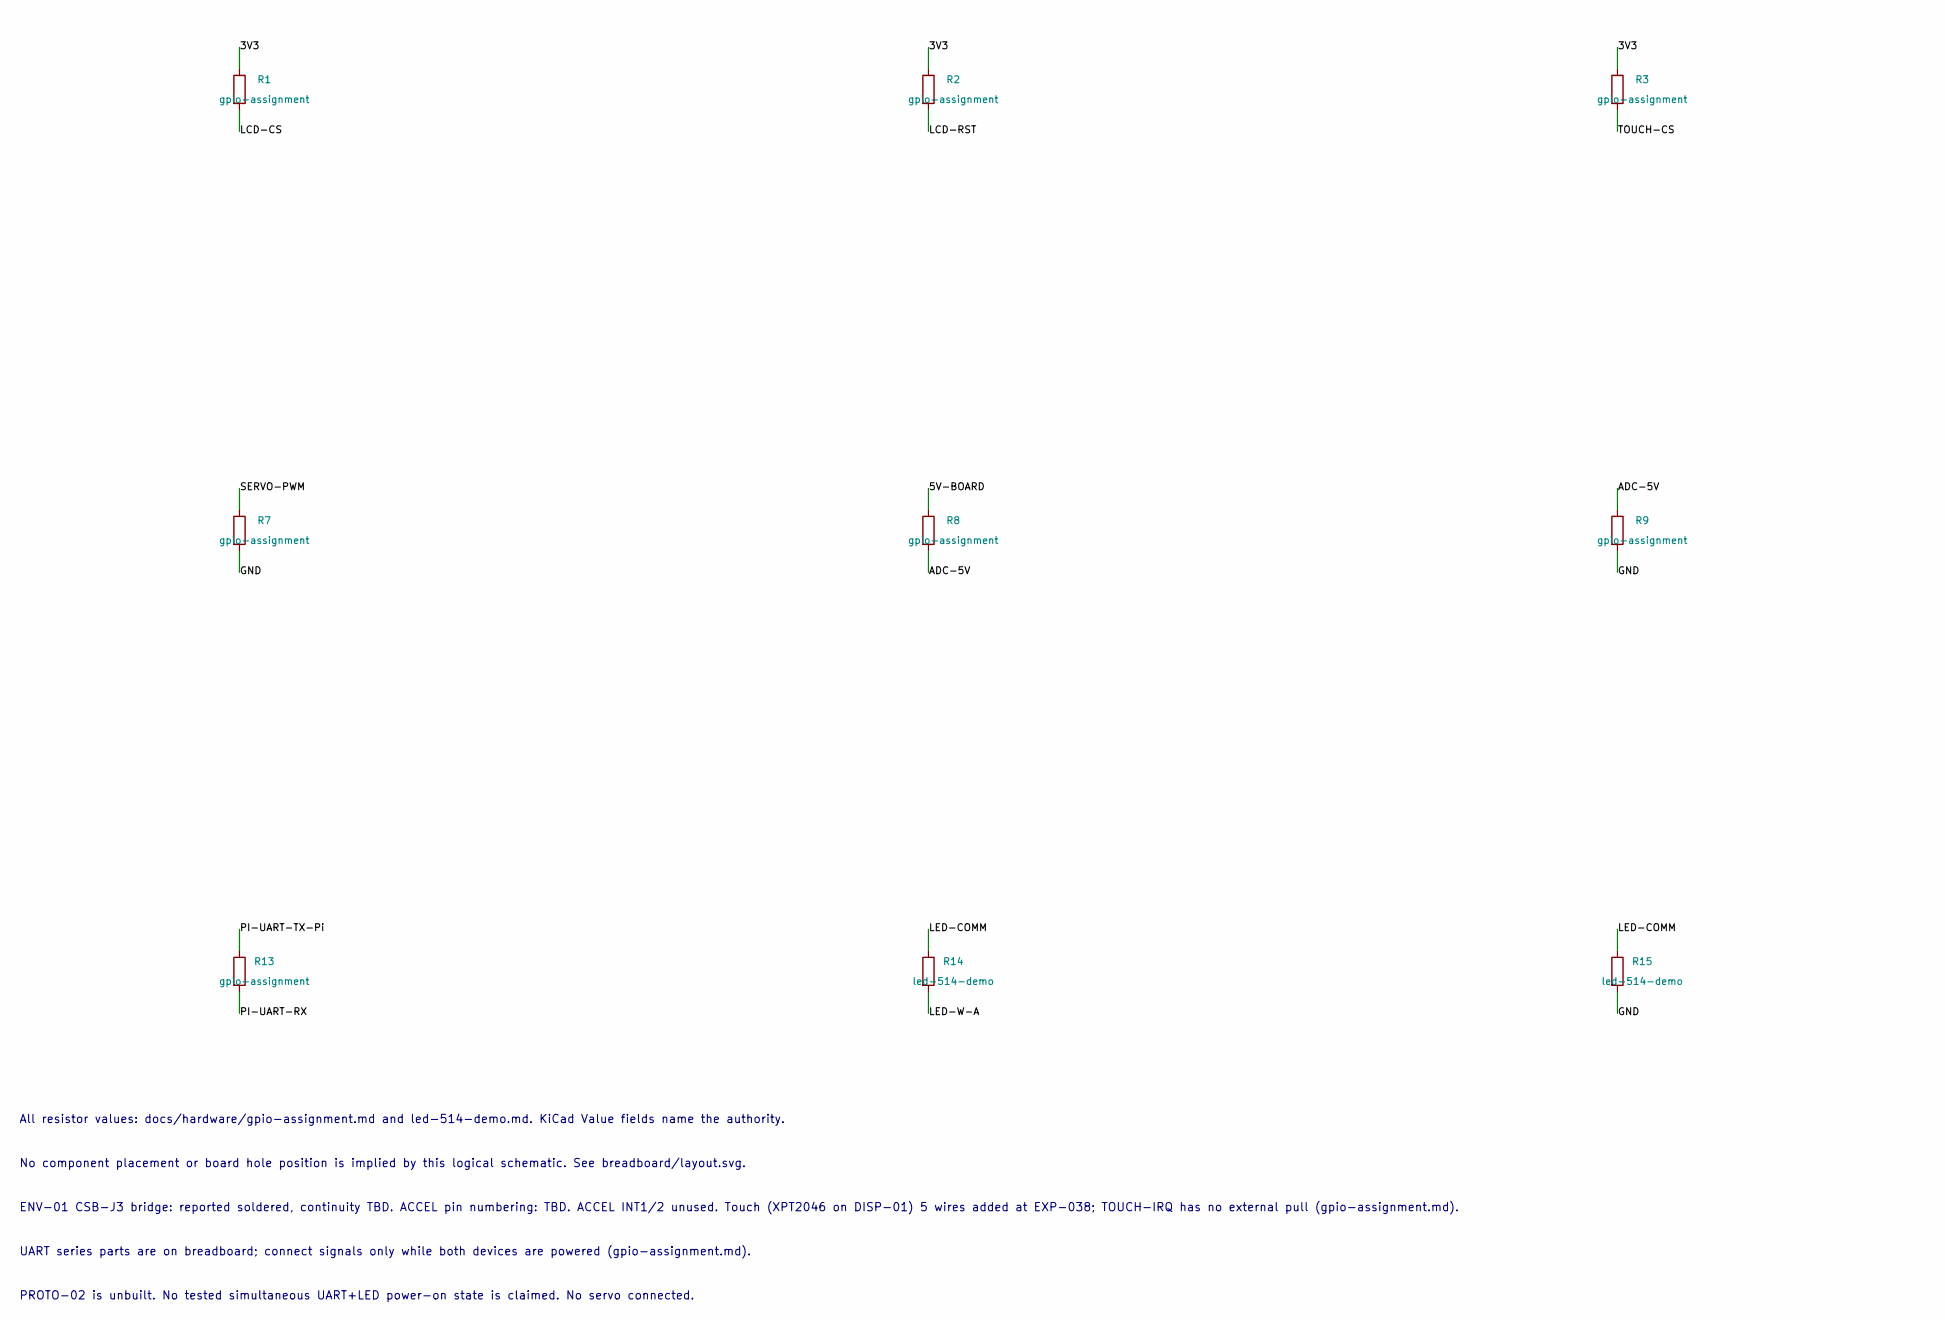
[picture p4: schematic deskcat.kicad_sch, part in row 2, column 1]

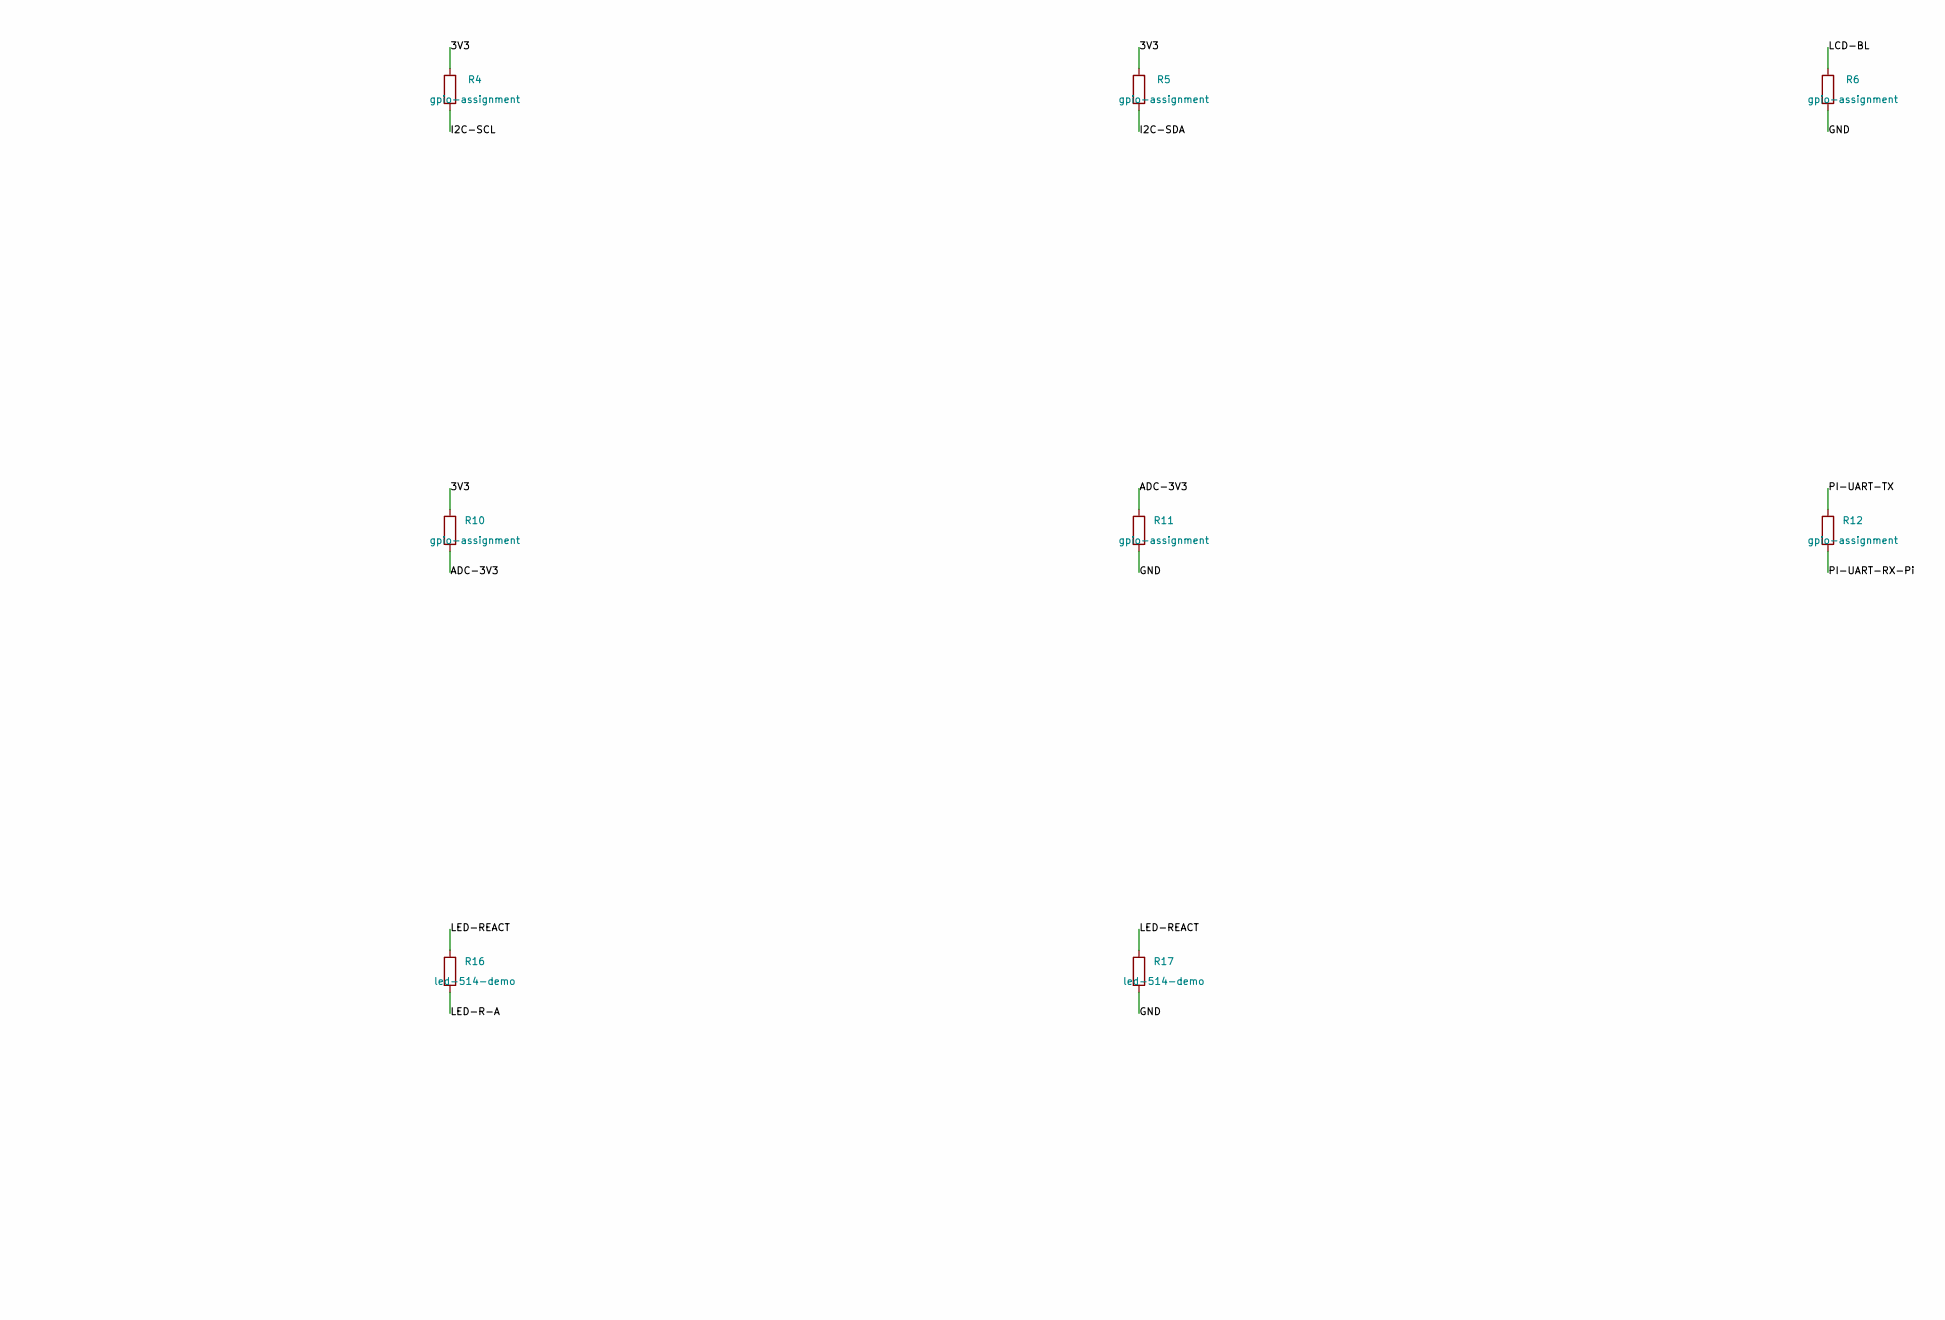
[picture p5: schematic deskcat.kicad_sch, part in row 2, column 2]

Parts:
D1: LED_COMM_01_white
D2: LED_REACT_01_red
J1: DISP_01_MSP2807
J2: ACCEL_01_ADXL345
J3: ENV_01_BME280
J4: SBC_01_Pi_Zero_W
R1, R2, R3, R4, R5, R6, R7, R8, R9, R10, R11, R12, R13: gpio-assignment
R14, R15, R16, R17: led-514-demo
U1: MCU_01_DevKitC_V4

Connections:
3V3: J1.1 (VCC), J2.TBD-1 (Vs), J2.TBD-5 (CS), J3.TBD-1 (VDD), R1.1, R2.1, R3.1, R4.1, R5.1, R10.1, U1.J2-1 (3V3)
5V-BOARD: R8.1, U1.J2-19 (5V)
ADC-3V3: R10.2, R11.1, U1.J2-3 (GPIO36 ADC-3V3)
ADC-5V: R8.2, R9.1, U1.J2-8 (GPIO33 ADC-5V)
GND: D1.K, D2.K, J1.2 (GND), J2.TBD-2 (GND), J2.TBD-6 (SDO), J3.TBD-2 (GND), J3.TBD-5 (SDO), J4.39 (GND), R6.2, R7.2, R9.2, R11.2, R15.2, R17.2, U1.J2-14 (GND)
I2C-SCL: J2.TBD-3 (SCL), J3.TBD-3 (SCK), R4.2, U1.J2-10 (GPIO26 I2C-SCL)
I2C-SDA: J2.TBD-4 (SDA), J3.TBD-4 (SDI), R5.2, U1.J2-9 (GPIO25 I2C-SDA)
LCD-BL: J1.8 (LED), R6.1, U1.J3-13 (GPIO4 LCD-BL)
LCD-CS: J1.3 (CS), R1.2, U1.J3-3 (GPIO22 LCD-CS)
LCD-DC: J1.5 (DC), U1.J3-11 (GPIO17 LCD-DC)
LCD-MISO: J1.9 (SDO), J1.13 (T_DO), U1.J3-8 (GPIO19 LCD-MISO)
LCD-MOSI: J1.6 (SDI), J1.12 (T_DIN), U1.J3-2 (GPIO23 LCD-MOSI)
LCD-RST: J1.4 (RESET), R2.2, U1.J3-12 (GPIO16 LCD-RST)
LCD-SCLK: J1.7 (SCK), J1.10 (T_CLK), U1.J3-9 (GPIO18 LCD-SCLK)
LED-COMM: R14.1, R15.1, U1.J3-15 (GPIO2 LED white)
LED-R-A: D2.A, R16.2
LED-REACT: R16.1, R17.1, U1.J3-10 (GPIO5 LED red)
LED-W-A: D1.A, R14.2
PI-UART-RX: R13.2, U1.J2-12 (GPIO14 UART RX)
PI-UART-RX-Pi: J4.10 (GPIO15 RXD), R12.2
PI-UART-TX: R12.1, U1.J2-15 (GPIO13 UART TX)
PI-UART-TX-Pi: J4.8 (GPIO14 TXD), R13.1
SERVO-PWM: R7.1, U1.J2-11 (GPIO27 SERVO-PWM)
TOUCH-CS: J1.11 (T_CS), R3.2, U1.J3-6 (GPIO21 TOUCH-CS)
TOUCH-IRQ: J1.14 (T_IRQ), U1.J2-5 (GPIO34 TOUCH-IRQ)

Notes on the sheet:
DeskCat #512 / logical wiring at EXP-019 baseline + EXP-022 UART + EXP-025 LED branches + EXP-038 touch
Power sources are separate USB inputs. PROTO-02 physical assembly and final power path: TBD (#405).
All resistor values: docs/hardware/gpio-assignment.md and led-514-demo.md. KiCad Value fields name the authority.
No component placement or board hole position is implied by this logical schematic. See breadboard/layout.svg.
ENV-01 CSB-J3 bridge: reported soldered, continuity TBD. ACCEL pin numbering: TBD. ACCEL INT1/2 unused. Touch (XPT2046 on DISP-01) 5 wires added at EXP-038; TOUCH-IRQ has no external pull (gpio-assignment.md).
UART series parts are on breadboard; connect signals only while both devices are powered (gpio-assignment.md).
PROTO-02 is unbuilt. No tested simultaneous UART+LED power-on state is claimed. No servo connected.
