wachi-yoshitaka-11-dev/deskcat/firmware/esp32/src/main.rs

//! DeskCat ESP32 の最小firmware。
//!
//! [Issue #6](https://github.com/wachi-yoshitaka-11-dev/deskcat/issues/6)、
//! [Issue #7](https://github.com/wachi-yoshitaka-11-dev/deskcat/issues/7)、
//! [Issue #13](https://github.com/wachi-yoshitaka-11-dev/deskcat/issues/13)
//! の受け入れ条件に対応する。
//!
//! - firmware build identity を出す
//! - board-configuration ID を出す
//! - reset reason を出す
//! - **rate limit 付きの heartbeat と health snapshot を出し続ける**（#7）
//! - `ACCEL-01`（ADXL345）／`ENV-01`（BME280）のDevice ID／Chip IDを読み、生byteを
//!   logへ出す（[#15](https://github.com/wachi-yoshitaka-11-dev/deskcat/issues/15)／
//!   [#16](https://github.com/wachi-yoshitaka-11-dev/deskcat/issues/16)）。
//!   **一致判定は、`run_i2c_bringup`自身は行わない。**生byteをlogへ残すだけで、識別の断定は
//!   log を読む人間の責務とする（[`run_i2c_bringup`]参照）。**ただし製品buildと`tap-21`付きbuildでは、呼び出し側（`start_product_sensors`、`start_tap`）が
//!   `ACCEL-01`のDevice IDを`0xE5`と比べ、一致したときだけtapの設定を書く。**
//!   **製品buildは、起動後にこのbusを`ENV-01`の周期測定と共有する**（`crate::i2c_bus`、`crate::env_report`）。
//! - Pi link（UART1、`PI-UART-TX`＝GPIO13、`PI-UART-RX`＝GPIO14）で`boot`のACK待ち・再送・
//!   `sid`選び直しを行う（`crate::boot_session`。[#446](https://github.com/wachi-yoshitaka-11-dev/deskcat/issues/446)
//!   PR B、[#487](https://github.com/wachi-yoshitaka-11-dev/deskcat/issues/487)）。受信の異常
//!   （ring bufferの満杯など）を数える（`drain_uart_events`）。制約は`crate::console`の
//!   module docにまとめてある
//! - **既定の製品buildは`ENV-01`（BME280）を60 sごとに測り、session確立後に`environment`をPiへ送る**（`crate::env_report`。
//!   forced・×1・IIR off。変換を待つ間もmain loopを止めない。送る条件は`docs/protocol/esp32-pi-protocol.md`の§4.5）。**実機では動かしていない。**
//! - **既定の製品buildは`DISP-01`（LCD）を描画し、tap入力を読む。`SERVO-PWM`・`ADC-*`はdriveしない。**
//!   **`TOUCH-*`のうち`TOUCH-CS`（GPIO21）を使い、LCDと同じbusでtouchを読む。**`TOUCH-IRQ`は取らない。
//!   状態機械で撫でを判定し、bootのACK後に`head_touched`を送る（#21、`crate::touch::StrokeDetector`。
//!   送る条件はprotocol §4.2）。busは`SpiDriver`を共有し、転送ごとに取る（`crate::spi_port`）。
//!   **この型の製品buildを実機で動かした記録はまだ無い。**共有の型が実機で動いた記録は`touch-lcd-14`の`EXP-041`だけで、
//!   `EXP-039`〜`EXP-041`の製品build（develop `4a1ad55`の版）は、移す前のbusを握り続ける型である。
//!   [`crate::servo`]はcross-compile確認用にcompileするだけであり、既定buildの`main()`からは呼ばない。
//!   製品buildと`bringup-display-13`／`face-21`の試験buildは、
//!   [`run_display_bringup`]経由でLCDを初期化してbacklightを点ける。`bringup-display-13`は単色fill・四隅patternを
//!   main loopの中で1段ずつ進め、`face-21`は点けたまま`set_expression`の表情を描く（`crate::face`）（`crate::display_test`、[Issue #13](https://github.com/wachi-yoshitaka-11-dev/deskcat/issues/13)。
//!   **試験buildでの有効化の手順は下の「`DISP-01`のbring-upを有効にする手順」節。**）。
//!   `bench-servo-test-17` feature付きbuildが[`run_servo_bench_test`]経由で、`bench-servo-calib-18` feature付きbuildが
//!   `crate::servo_calib`経由で、servoを呼ぶ（[Issue #17](https://github.com/wachi-yoshitaka-11-dev/deskcat/issues/17)。
//!   詳細は[`crate::servo`]と[`run_servo_bench_test`]のdoc参照）。
//! - **#514の追加LED（`LED-COMM`＝GPIO2、`LED-REACT`＝GPIO5）は`crate::led`が駆動する**
//!   （[Issue #514](https://github.com/wachi-yoshitaka-11-dev/deskcat/issues/514)）。既定の製品buildは、
//!   白の点滅（通信の成立と継続を確認できていない間の表示。点灯へ切り替える判定は無い）と、`set_expression`で
//!   `happy`を受理したときの赤の1秒点灯を行う。`bringup-led-514` feature付きbuildは、その前に点灯試験
//!   （赤→白→両方）を行う。このfeatureは`bringup-display-13`とも組み合わせられる（pinが重ならない）。
//!   **実機で動かした記録は、点灯試験用のbuildだけである。**
//!
//! # buildの構成（[#487](https://github.com/wachi-yoshitaka-11-dev/deskcat/issues/487)）
//!
//! **製品buildは既定build（featureなし）である。**Pi link、LCDの表情描画、tap入力、
//! heartbeat／health snapshotを1本のmain loopで回す（thread は使わない）。
//! I2Cのbring-upは起動時に1回走る（`bringup-display-13`付きbuildでは、LCDの
//! bring-upの後にmain loopの中で1回。下の`i2c_pending`を参照）。logはどのbuildでもUART0（USB）へ出る
//! （`crate::console`）。表の試験featureを指定すると既存の試験構成を選び、
//! 試験feature同士は加える向きにする。**例外は`bench-servo-test-17`（`bench-servo-90-17`を含む）と`bench-servo-calib-18`だけであり、Pi linkを
//! 外す**（下の表。正本の要求による）。そのため、Pi linkで送る`tap-21`とは併用できない（`compile_error!`で止める）。
//!
//! | 試験feature | その試験buildで有効になるもの | 製品buildとの関係 |
//! |---|---|---|
//! | `bringup-i2c-15-16` | ACCEL-01／ENV-01のID読み出し。LCDに触れず、ADXL345へ設定を書かない | 従来のfeatureなしbuildの単体bring-upを保つ |
//! | `env-sample-16` | BME280のChip IDが一致した場合だけ補正係数を読み、forced測定を1回行う。raw・補償値・faultはUART0にlog | 単独指定のみ。実機未確認で通電不可。Pi linkのpayloadは変更しない |
//! | `env-sample-16-slow` | `env-sample-16`に加え、BME280の温度・気圧・湿度のoversamplingを×16にして変換を遅くする（Bosch §9.1でmax 112.8 ms）。変換の所要時間を`env_conversion`としてlogする | `env-sample-16`を含み、同じく単独指定のみ。実機未確認で通電不可 |
//! | `env-sample-16-repeat` | `env-sample-16-slow`に加え、×16の変換を最初の変換の開始から30秒、130 ms周期で繰り返し、変換がheartbeatの時刻を何度もまたぐ状態を作る（#16の「遅い変換が上位taskをblockしない」の観察用）。`env_conversion`は毎回`seq`・`started_ms`付きで、`env_raw`・`env_reading`は1回目だけlogする | `env-sample-16-slow`を含み、同じく単独指定のみ。実機未確認で通電不可 |
//! | `accel-sample-15` | ADXL345のDevice IDが`0xE5`のときだけ、±2 g・100 Hz・FIFO Streamの連続測定を設定し、raw値と窓ごとの統計をUART0にlog（#15、`crate::accel_sample`）。tapの機能は止める（`INT_ENABLE`＝0） | 単独指定のみ。通電は2026-10-17の1回だけ（`EXP-033`）で、新しい書き込みを含む構成の通電手順と承認は未確定。Pi linkのpayloadは変更しない |
//! | `touch-sample-14` | `TOUCH-01`（XPT2046）の raw 読み出し。SPI3（GPIO18/23/19）、`TOUCH-CS`＝GPIO21、`TOUCH-IRQ`＝GPIO34 で X・Y・Z1・Z2 を読み、IRQ の level とあわせて UART0 に log（#14、`crate::touch`）。`T_IRQ` の変化の時刻と、console から受けた `MARK` の時刻も log する（条件 6 の突き合わせ用）。LCD は初期化せず、`LCD-CS`（GPIO22）を High に固定する。状態機械は配線しない | 単独指定のみ。touch 用 5 本を足した配線で、`EXP-038`（develop `79f29ea`。raw を取った）と `EXP-041`（develop `b9a04e8`。`T_IRQ` の変化と `MARK` の log、`crate::spi_port` の bus の持ち方を含む版で、`MARK` 31 件に `touch_mark` 31 件、SPI の失敗 0 件）の版を実機に書き込んで動かした。次の通電・書き込みにも実機側の新たな承認が要る。Pi link の payload は変更しない |
//! | `touch-lcd-14` | LCDを初期化して点灯し、表情（neutral→happy→surprised）を帯1本ずつ塗り続けながら、同じSPI host（SPI3）で`TOUCH-01`のrawを読む（#14の受け入れ条件「LCD通信による許容できないdata lossがない」の観察用、`crate::touch_lcd`）。LCDとタッチは`SpiDriver`を共有し、busは転送ごとに取る。帯の途中ではタッチを読まない。console（stdin）は読まず、`MARK`は受け付けない（`T_IRQ`の変化は`touch-sample-14`と同じくlogする）。状態機械は配線しない | 単独指定のみ。**製品buildも同じ共有の型を使う。busを握り続ける型は`touch-sample-14`だけ**（`crate::spi_port`）。`set_expression`は`hardware_unavailable`で拒否する。`EXP-041`で、develop `b9a04e8`の版を、LCDのVCC・9本・touch用5本が挿さった配線に書き込み、157秒動かした（帯7000本、`lcd_errors_total=0`、`touch_spi_errors_total=0`、LCDの乱れは目視の申告に無い）。次の通電・書き込みにも実機側の新たな承認が要る。Pi linkのpayloadは変更しない |
//! | `bringup-display-13` | LCDの初期化、backlightの点灯、単色fillと四隅pattern | 表情とtapは有効にしない。描画の間のPi linkの受信とheartbeatは`crate::display_test`のmodule docを参照 |
//! | `no-touch-487` | 製品buildと同じ。ただし`TOUCH-CS`（GPIO21）は`IdleTouch`が出力Highにして保ち、touchを読まず、`head_touched`を送らず、LED（GPIO2・GPIO5）に触れない（#487） | 単独で使う。`build.rs`はこのfeatureだけ製品経路のcfgから外さず、併用は`compile_error!`で止める。通電の条件は`docs/hardware/power-budget.md`の`touchを読まない製品build（no-touch-487）の通電の条件` |
//! | `bringup-led-514` | #514の追加LED（GPIO2／GPIO5）の点灯試験（赤→白→両方）と、その後の白の点滅（`crate::led`）。製品buildにある赤の`happy`点灯も同じ経路を持つ。このfeatureだけのbuildは表情を持たないため`set_expression`を受理せず、赤は点灯試験の区間だけ点く。`face-21`と組み合わせたbuildは`happy`を受理し、赤を1秒点ける（この併用は`compile_error!`で止めていない） | 表情とtapは有効にしない。`bringup-display-13`とも組み合わせられる |
//! | `face-21` | LCDの初期化とbacklightの点灯を保ち、`set_expression`の表情を描く。Pi commandを受けなくても、描ける状態になった時点で`neutral`を1回描く（#21、`crate::face`） | `bringup-display-13`とも組み合わせられる。**表情を持たない試験buildは`set_expression`を`hardware_unavailable`で拒否する** |
//! | `tap-21` | ADXL345のtap検出を設定し、`INT_SOURCE`をI2Cで読み、bootのACK後に`tapped`を送る（#21のF1、`crate::tap`）。ADXL345のDevice IDが`0xE5`のときだけ設定を書き、I2Cのdriverを持ち続ける（一致しなければ何も書かず、driverを手放す） | INT線は使わない（配線は要らない）。`face-21`・`bringup-display-13`とも組み合わせられる。**試験buildのうち`tap-21`も`accel-sample-15`も持たないものは、ADXL345へ書き込まず、Device IDを読むだけである**（既定・製品buildは`tap-21`と同じく書く） |
//! | `mem-probe-23` | health snapshotと同じ周期で、空きheap・起動からの最小の空きheap・main taskのstackのhigh water markを1行logへ出す（#23の`PROTO-TBD-007`、`crate::mem_probe`）。**このfeatureのbuildだけが`unsafe`を持つ**（`unsafe_code`を`deny`へ下げ、`mem_probe`の3呼び出しだけ`allow`） | logを足すだけで、LCD・Pi link・tapの挙動は変えない。featureを指定すると製品経路のcfgが外れるので、製品buildと同じ構成で測るときは`face-21`と`tap-21`を足す（タッチの撫での判定と`ENV-01`の周期測定・`environment`の送出は製品buildだけが持ち、この構成には入らない）。`bringup-display-13`とも組み合わせられる。単独の試験build（`env-sample-16`・`accel-sample-15`・`touch-sample-14`・`touch-lcd-14`）、`bringup-i2c-15-16`、`bringup-led-514`、`bench-servo-test-17`、`debug-motion-19`とは併用できない（`compile_error!`） |
//! | `debug-motion-19` | UART0のconsoleから`MOTION <name> <target>`の行を別threadで読み、Pi由来の`play_motion`と同じ`MotionDispatch`のcatalogへ渡す（#19の受け入れ条件3、`crate::debug_motion`、`crate::pi_link::PiLink::on_debug_line`）。**servoを駆動せず、`LimitedServo`も`Limiter`も作らない。catalogが空のため、debugの指示も全て拒否される。同じ`Limiter`（同じcounter）を通ることは、`deskcat_servo`のhost testが示す範囲である** | **製品buildには入らない**（featureなし）。featureを指定すると製品経路のcfgが外れる。Pi linkを持つ。`bench-servo-test-17`・`touch-sample-14`・`touch-lcd-14`・`mem-probe-23`・`env-sample-16`・`accel-sample-15`・`bringup-i2c-15-16`・`bringup-led-514`とは併用できない（`compile_error!`）。実機では動かしていない |
//! | `bench-servo-test-17` | servoの単発bench試験（#17の測定用build） | **Pi linkを外す。**正本`docs/hardware/servo-safety-limits.md`の`測定のための駆動（承認の状態の項目6）`節が、測定用のbuildは「Piとの通信linkを持たない」と定めているためである |
//! | `bench-servo-calib-18` | #18の校正build。UART0のconsoleから`GO18`を受けた後、`MOTION calib <deg>`・`STOP`・`END`だけを受け、`LimitedServo`（`Limiter`を通る）だけでservoを駆動する（`crate::servo_calib`。仕様は`docs/hardware/servo-safety-limits.md`の`校正buildの仕様（案）`）。NVSのlatchは使わず、起動のたびに`GO18`を待つ | **Pi link・heartbeat・I2C・LCDを持たない。専用の`main`を持つ。**`config.rs`の`SERVO_CALIB_18_*`が`None`の間はcompileが止まる（値は回ごとの実行承認が決める）。単独の試験buildで、他の試験featureとは併用できない（`compile_error!`）。実機では動かしていない |
//! | `bench-wdt-711` | #711のtask WDTの検証build。main taskをTWDTへ登録し、**その後は一度もfeedしない**。約timeout（sdkconfigの値）でpanicしてresetし、再起動後の`reset_reason`が`task_watchdog`になることを実機で見る（`crate::task_wdt`） | **servo・LEDC・GPIO27・Pi link・I2C・LCDに触れない。専用の`main`を持つ。**製品buildと校正buildには、hangを起こすcommandを入れていない。単独の試験buildで、他の試験featureとは併用できない（`compile_error!`）。**実機では動かしていない** |
//! | `bench-servo-90-17` | 上の単発bench試験で、指令角だけを規約上の90度にする | `bench-servo-test-17`を含む。90度が機械的中央かどうかは未確認（`HW-TBD-010`） |
//!
//! `#487`のPR B1より前は、`pi-protocol-mode` featureを付けたbuildだけがPi linkを持ち、LCD／I2Cの
//! bring-upと排他だった。`#487`でfeatureをやめ、Pi linkを製品buildへ入れた。
//!
//! **既定buildは、起動のたびにGPIO13（`PI-UART-TX`）をUARTのTXとして駆動する。**`#487`のPR B1より前は、
//! `pi-protocol-mode`を付けたときだけだった（PR Aより前は、どのbuildもGPIO13をUARTに使っていなかった）。GPIO13／GPIO14に基板上の部品はつながっていない
//! （`docs/hardware/gpio-assignment.md`の`Pi–ESP32間のtransport`節、公式回路図で確かめたもの。
//! 現物の導通は測っていない）。**GPIO13／GPIO14はJTAG（`MTCK`／`MTMS`）を兼ねるため、既定buildでは
//! JTAG debugを使えない**（同文書の`PI-UART-TX`／`PI-UART-RX`行）。
//!
//! 既定buildで`Peripherals::take()`の戻り値から実際にdriverへ渡すのは、I2C関連2本
//! （`crate::accel`・`crate::env`のmodule doc参照）、Pi link関連（`peripherals.uart1`、GPIO13＝TX、
//! GPIO14＝RX）、LCD関連6+1本（`crate::display`のmodule doc参照）、`TOUCH-CS`（GPIO21。idleはHigh、touchの転送の間だけLow）である。
//! LCDに触れない試験buildはLCD関連pinを渡さない。`bench-servo-test-17` feature付きbuildは`SERVO-PWM`（GPIO27）と
//! `peripherals.ledc.timer0`／`channel0`を追加で渡し、Pi link関連を渡さない。製品buildと`bringup-led-514` feature付きbuildは
//! GPIO2とGPIO5を`crate::led`へ渡す。
//!
//! **I2Cはこの版でも実機通電していない。**この版の検証は`cargo build`でのcross-compile
//! 確認までであり、実機へflashして確認するのは別工程である（[Hardware Safety
//! Policy](../../../docs/governance/hardware-safety-policy.md)「人間の監視が必要な
//! 操作」。初回配線revisionでの初回通電は人間監視下で行う）。
//! **2026-09-24追記（#472）: 上の2文は`4486de5`の時点の記述である。**2026-09-22に`35bcc36`の
//! buildで`ACCEL-01`／`ENV-01`へ初回通電し、Device ID読み出しに応答を得た記録が
//! [EXP-015](../../../docs/hardware/experiment-log.md)にある。それより後のbuildの実機の記録は、
//! 構成ごとに同じ文書の`EXP-021`（`tap-21`）、`EXP-033`（`accel-sample-15`）などにあり、記録の無い構成は実機で動かしていない。
//!
//! **Protocol sessionはまだ確立を主張しない。**`boot`のACK待ち・再送・`stale_session`受信時の
//! `sid`選び直しは実装した（[#446](https://github.com/wachi-yoshitaka-11-dev/deskcat/issues/446) PR B、
//! `crate::boot_session`参照）が、実機での動作確認（受信経路がring buffer溢れなく動くか、実際に
//! `boot`→ACKが成立するか）はまだ無い（`crate::pi_link`のmodule doc「確かめていないこと」）。
//! Pi→ESP32方向の受信は、main loopから`crate::pi_link::PiLink`へ渡す。
//! `#446`より前は`boot=`というlog行を出していたが、その行は`#446`のPR Aで削除した。
//! `boot=`行を目視で確認していた作業（`#7`／`#13`等）があれば、`boot=`行が
//! 無くなったことを踏まえて確認し直すこと。
//!
//! **Task Watchdog Timer の timeout は ESP-IDF の既定値のままである。**`sdkconfig.defaults` が足した watchdog の項目は
//! `CONFIG_ESP_TASK_WDT_PANIC=y` だけである（[Issue #711](https://github.com/wachi-yoshitaka-11-dev/deskcat/issues/711)。
//! 発火したら警告で止めず panic して reset する）。**全ての build が同じ `sdkconfig` を使うので、この設定は全 build に効く**
//! （製品 build を含む。従来は警告だけだった）。登録するのは idle task（既定。両 core）で、main task を登録するのは
//! `bench-servo-calib-18` の build だけである（`crate::task_wdt::register_main_task`。`bench-wdt-711` の検証 build も登録するが、servo に触れない）。**実機では確かめていない。**heartbeat loop は
//! [`FreeRtos::delay_ms`] で待つ。同 API は
//! 「Delays bigger than `1000 /` `TICK_RATE_HZ` milliseconds … used in a loop would
//! starve the FreeRTOS IDLE tasks as they are low prio tasks and hence the IDLE task's
//! watchdog could trigger. **This delayer avoids that by yielding to the OS during the
//! delay.**」と doc に明記しており、これが「logging が watchdog の進行を block しない」
//! 根拠である。Pi linkを持つbuildは、[`FreeRtos::delay_ms`]の代わりに`UartDriver::read`の
//! timeoutで待つ（main loop参照）。どちらもbusy wait をしないよう、待ち時間は必ず 1 ms 以上へ
//! 丸める（`sleep_ms_until`とmain loopのcomment参照。IDLE taskへ時間が回る条件は、main loopのcomment）。LCDのbring-up（`bringup-display-13`
//! feature付きbuild）は描画を1段ずつ進め、段と段の間でmain loopへ戻る（`crate::display_test`）。
//!
//! # `DISP-01`のbring-upを有効にする手順
//!
//! この節は`bringup-display-13`を使う試験の通電条件を扱う。製品buildの通電条件は、
//! `docs/hardware/power-budget.md`の正式な手順が揃うまで未確定である。
//! `run_display_bringup`は、二つの給電経路のいずれかで使う。**元々は**電流制限つき外部3.3 V
//! 電源（段階B-2b）を使った`DISP-01`（MSP2807）の初回通電手順に対応していた。**この段階B-2bが要求する「設定する
//! 電流制限値の上限を決めるためのmodule側の安全な上限」は引き続き未解決のままである**
//! （[tbd-register.md](../../../docs/hardware/tbd-register.md)の`HW-TBD-024`行）。
//! B-2bの給電構成も確定していない（[power-budget.md](../../../docs/hardware/power-budget.md)の
//! `DISP-01`初回通電の手順（給電構成の確定待ち）が、B-2bを採る場合の実行前提として
//! 2点を挙げている）。**[Issue #451](https://github.com/wachi-yoshitaka-11-dev/deskcat/issues/451)より前、
//! `run_display_bringup`は既定buildでも無条件に呼ばれ、その中で`lcd.backlight_on()`を
//! 実行していた。**そのため`DISP-01`が配線されているだけでbacklightへ給電された。
//! **#451当時は、このfeatureを指定した試験buildだけがLCDを使う構成へ変えた。**
//! #487以後、featureなしの製品buildもLCDを使う。`bringup-display-13`は、
//! 試験構成で単色fill・四隅patternを描くモードを選ぶ。
//!
//! **`#461`（2026-09-23）が認めたのは、B-2bではなくESP32`3V3` pinからの通常接続である。**
//! `#445`が`ACCEL-01`／`ENV-01`に採った経路（B-2bではなく`3V3` pin）と同じであり、
//! B-2bの前提2点は`3V3` pin経路には掛からない。**`3V3` pin経路での`DISP-01`
//! bring-up手順は[power-budget.md](../../../docs/hardware/power-budget.md)の
//! `DISP-01`追加接続のbring-upの手順（ESP32`3V3` pin給電、`#461`承認範囲）節が持つ**（`#13`が
//! 作成した。`ACCEL-01`／`ENV-01`が同じ`3V3` railへ既に接続済みの状態
//! （[EXP-015](../../../docs/hardware/experiment-log.md)）へ`DISP-01`を追加する場合を扱い、
//! `ACCEL-01`／`ENV-01`単体bring-upの手順とは別節である）。`#461`は接続そのものを
//! 許可するだけで、`run_display_bringup`（初期化・backlight点灯を行い、fill・四隅patternをmain loopの中で進める。`#487`）を
//! `3V3` pin経路で呼んでよいかは決めない。**`#461`の余裕解析はbacklightが点灯した状態を含む
//! （通常動作の合計にbacklightのtypical値とILI9341ロジック50 mAが入っている）。
//! `run_display_bringup`が追加で引く負荷は無い。**したがって上記の新設手順は、この余裕解析を
//! そのまま前提とし（[tbd-register.md](../../../docs/hardware/tbd-register.md)の`HW-TBD-024`行、
//! 2026-09-23追記）、余裕の再計算はしていない。**
//! `3V3` pin経路の初回接続も、B-2bと同じく人間の監視下で行い、異音・発熱・変色・異臭を
//! 認めたら直ちに停止する（[Hardware Safety Policy](../../../docs/governance/hardware-safety-policy.md)
//! 「人間の監視が必要な操作」、[tbd-register.md](../../../docs/hardware/tbd-register.md)の
//! `HW-TBD-024`行が持つ停止基準）。結果は[Hardware Safety Policy](../../../docs/governance/hardware-safety-policy.md)
//! 「ベンチ試験記録」の形式で記録する。**`#13`が書く手順にも、これらは`#461`を待たずに
//! 掛かっている**（§7は「新しい配線revisionの初回通電」、§10はbench試験記録の形式を、
//! いずれも条件なしで定めている）。
//!
//! **B-2b経由でこのfeatureを有効にする場合、B-2bの前提2つが解けたら、人間が次の手順で行う。**
//!
//! 1. `power-budget.md`の`DISP-01`初回通電の手順（給電構成の確定待ち）が挙げる
//!    B-2bの前提2点を満たす。
//! 2. `--features bringup-display-13`を付けてbuildする（`face-21`の通電は`face-21,bringup-display-13`で行う。
//!    `docs/hardware/power-budget.md`の条件(2)）。**commandの正本は
//!    [検証済みコマンド](../../../docs/toolchains/verified-commands.md)であり、
//!    ここへ写さない。**
//! 3. ESP32 Flash / HIL profileの端末で人間がflashし、人間の監視下で通電する
//!    （[Machine Profiles](../../../docs/toolchains/machine-profiles.md)、
//!    [Hardware Safety Policy](../../../docs/governance/hardware-safety-policy.md)
//!    「人間の監視が必要な操作」）。
//!
//! **`3V3` pin経路でこのfeatureを有効にする場合は、上記1〜3の代わりに`power-budget.md`の
//! `DISP-01`追加接続のbring-upの手順（ESP32`3V3` pin給電、`#461`承認範囲）節が持つ実施前提条件と
//! 手順に従う。**同節もこのfeatureを要求する（条件(2)）。
//!
//! **このfeatureはB-2bのgateを開けない。**開けてよいかの判定は上記の正本文書が
//! 持つ。**このfeatureの試験buildは単色fill・四隅patternを描き、表情とtapを有効にしない。**
//! I2Cのbring-upはLCDのbring-upの後にmain loopの中で走り、その所要時間は
//! `overrun`と`max_read_gap_ms`に入る（下の`i2c_pending`）。回路側の制約も、`DISP-01`を接続してよいかの
//! 判定も、これで変わらない。

// **`unsafe_code`の水準はここで持つ**（`Cargo.toml`の`[lints.rust]`には置かない。`forbid`は
// moduleの`allow`で下げられないため）。featureなしのbuild（製品build）は`forbid`のままである。
// `mem-probe-23`（#23の計測用。`src/mem_probe.rs`のmodule doc）を付けたbuildだけが`deny`へ下げ、
// `mem_probe`の中の`#![allow(unsafe_code)]`が3つの`unsafe`を許す。他のmoduleの`unsafe`は`deny`で止まる。
#![cfg_attr(not(feature = "mem-probe-23"), forbid(unsafe_code))]
#![cfg_attr(feature = "mem-probe-23", deny(unsafe_code))]
// `bench-servo-calib-18`のbuildは専用の`main`（`servo_calib::run`）を持ち、このfileの製品経路の`main`と
// それだけが呼ぶmodule・importを使わない。使われない分の警告だけをこのfeatureで止める
// （他のbuildの水準は変えない）。
#![cfg_attr(
    any(feature = "bench-servo-calib-18", feature = "bench-wdt-711"),
    allow(dead_code, unused_imports)
)]

// `no-touch-487`は単独で使う。他のfeatureを足すと製品経路（`build.rs`の`deskcat_product_mode`）が外れ、touchを読まない製品buildにならない。
#[cfg(all(feature = "no-touch-487", not(deskcat_product_mode)))]
compile_error!("no-touch-487は単独で使う。他のfeatureと併用しない。");

mod accel;
#[cfg(feature = "accel-sample-15")]
mod accel_sample;
// Pi link（UART1）の`boot`の受理確認・再送。**`bench-servo-test-17`を有効にするbuild（`bench-servo-90-17`を含む）と`bench-servo-calib-18`のbuildだけは持たない。**
// 正本`docs/hardware/servo-safety-limits.md`の`測定のための駆動（承認の状態の項目6）`節が、
// 測定用のbuildは「Piとの通信linkを持たない」と定めているためである（`#487`でfeatureの排他を
// やめたときの例外である（`bench-servo-calib-18`も同じ）。featureどうしの排他ではない。Pi linkを外すだけである）。
// `tap-21`は、検出を`tapped`としてPi linkで送る。測定用build（`bench-servo-test-17`）はPi linkを
// 持たないため、この2つは併用できない。併用すると`boot_session`と`pi_link`が無いことで
// 分かりにくいcompile errorになるので、ここで理由を示して止める。
#[cfg(all(feature = "bench-servo-test-17", feature = "tap-21"))]
compile_error!(
    "bench-servo-test-17とtap-21は併用できない。tapの検出はPi linkで送るが、\
     測定用buildはPi linkを持たない。"
);
#[cfg(all(
    feature = "env-sample-16",
    any(
        feature = "bringup-i2c-15-16",
        feature = "bringup-display-13",
        feature = "bringup-led-514",
        feature = "face-21",
        feature = "tap-21",
        feature = "bench-servo-test-17"
    )
))]
compile_error!("env-sample-16 は単独の試験 build として使う");
#[cfg(all(
    feature = "accel-sample-15",
    any(
        feature = "bringup-i2c-15-16",
        feature = "bringup-display-13",
        feature = "bringup-led-514",
        feature = "face-21",
        feature = "tap-21",
        feature = "bench-servo-test-17",
        feature = "env-sample-16"
    )
))]
compile_error!("accel-sample-15 は単独の試験 build として使う");
#[cfg(all(
    feature = "touch-sample-14",
    any(
        feature = "bringup-i2c-15-16",
        feature = "bringup-display-13",
        feature = "bringup-led-514",
        feature = "face-21",
        feature = "tap-21",
        feature = "bench-servo-test-17",
        feature = "env-sample-16",
        feature = "accel-sample-15"
    )
))]
compile_error!("touch-sample-14 は単独の試験 build として使う（SPI3 を LCD と共有できない）");
#[cfg(all(
    feature = "touch-lcd-14",
    any(
        feature = "bringup-i2c-15-16",
        feature = "bringup-display-13",
        feature = "bringup-led-514",
        feature = "face-21",
        feature = "tap-21",
        feature = "bench-servo-test-17",
        feature = "env-sample-16",
        feature = "accel-sample-15",
        feature = "touch-sample-14",
        feature = "mem-probe-23"
    )
))]
compile_error!("touch-lcd-14 は単独の試験 build として使う");
#[cfg(all(
    feature = "mem-probe-23",
    any(
        feature = "bringup-i2c-15-16",
        feature = "bringup-led-514",
        feature = "bench-servo-test-17",
        feature = "env-sample-16",
        feature = "accel-sample-15",
        feature = "touch-sample-14"
    )
))]
compile_error!(
    "mem-probe-23は、製品経路（face-21、tap-21、bringup-display-13）と組み合わせる。\
     単独の試験buildや別の試験featureとは併用しない。"
);
// `debug-motion-19`は、UART0のconsoleから読んだ行を、Pi linkの`MotionDispatch`へ渡す。Pi linkを持たない
// 測定用build（`bench-servo-test-17`）、UART0のstdinを別の目的で読む`touch-sample-14`、
// 単独の試験build（`touch-lcd-14`・`env-sample-16`・`accel-sample-15`・`bringup-i2c-15-16`・`bringup-led-514`）、
// `unsafe`を持つ`mem-probe-23`とは併用できない。**製品build（featureなし）には入らない。**
#[cfg(all(
    feature = "debug-motion-19",
    any(
        feature = "bench-servo-test-17",
        feature = "touch-sample-14",
        feature = "touch-lcd-14",
        feature = "mem-probe-23",
        feature = "env-sample-16",
        feature = "accel-sample-15",
        feature = "bringup-i2c-15-16",
        feature = "bringup-led-514"
    )
))]
compile_error!(
    "debug-motion-19は、Pi linkを持ち、UART0のstdinを他の目的で読まないbuildとだけ使う。\
     bench-servo-test-17、touch-sample-14、touch-lcd-14、mem-probe-23、env-sample-16、accel-sample-15、\
     bringup-i2c-15-16、bringup-led-514とは併用しない。"
);
// `bench-servo-calib-18`（#18の校正build）も、Pi link（`boot_session`、UART1）をcompileしない
// （`docs/hardware/servo-safety-limits.md`の`校正buildの仕様`の`Pi link`行）。単独の試験buildである。
#[cfg(all(
    feature = "bench-servo-calib-18",
    any(
        feature = "bench-servo-test-17",
        feature = "bench-servo-90-17",
        feature = "bringup-i2c-15-16",
        feature = "bringup-display-13",
        feature = "bringup-led-514",
        feature = "face-21",
        feature = "tap-21",
        feature = "env-sample-16",
        feature = "accel-sample-15",
        feature = "touch-sample-14",
        feature = "touch-lcd-14",
        feature = "mem-probe-23",
        feature = "debug-motion-19"
    )
))]
compile_error!(
    "bench-servo-calib-18は単独の試験buildとして使う。Pi linkを持たず、UART0のstdinをこのbuildだけが読む。\
     他の試験feature（bench-servo-test-17、bench-servo-90-17、bringup-*、*-sample-*、touch-*、face-21、tap-21、\
     mem-probe-23、debug-motion-19）とは併用しない。"
);
// `bench-wdt-711`（#711のtask WDTの検証build）も単独の試験buildである。servoに触れず、Pi link・I2C・LCDを持たない。
#[cfg(all(
    feature = "bench-wdt-711",
    any(
        feature = "bench-servo-test-17",
        feature = "bench-servo-90-17",
        feature = "bench-servo-calib-18",
        feature = "bringup-i2c-15-16",
        feature = "bringup-display-13",
        feature = "bringup-led-514",
        feature = "face-21",
        feature = "tap-21",
        feature = "env-sample-16",
        feature = "accel-sample-15",
        feature = "touch-sample-14",
        feature = "touch-lcd-14",
        feature = "mem-probe-23",
        feature = "debug-motion-19"
    )
))]
compile_error!("bench-wdt-711は単独の試験buildとして使う。他の試験featureとは併用しない。");
#[cfg(not(any(
    feature = "bench-servo-test-17",
    feature = "bench-servo-calib-18",
    feature = "bench-wdt-711"
)))]
mod boot_session;
mod config;
mod console;
#[cfg(any(feature = "debug-motion-19", feature = "bench-servo-calib-18"))]
mod debug_motion;
mod display;
#[cfg(feature = "bringup-display-13")]
mod display_test;
mod env;
#[cfg(deskcat_product_mode)]
mod env_report;
#[cfg(feature = "env-sample-16")]
mod env_sample;
mod face;
mod health;
mod i2c_bus;
#[cfg(any(feature = "bringup-led-514", deskcat_product_led))]
mod led;
#[cfg(feature = "mem-probe-23")]
mod mem_probe;
#[cfg(not(any(
    feature = "bench-servo-test-17",
    feature = "bench-servo-calib-18",
    feature = "bench-wdt-711"
)))]
mod pi_link;
#[cfg(not(any(
    feature = "bench-servo-test-17",
    feature = "bench-servo-calib-18",
    feature = "bench-wdt-711"
)))]
mod protocol;
mod servo;
#[cfg(feature = "bench-servo-calib-18")]
mod servo_calib;
mod servo_path;
mod spi_port;
mod tap;
#[cfg(any(feature = "bench-servo-calib-18", feature = "bench-wdt-711"))]
mod task_wdt;
// 製品buildは`touch::StrokeDetector`、LCDを描く試験build（`bringup-display-13`・`face-21`）と`no-touch-487`は読まない`touch::IdleTouch`だけを使う。
// 試験buildの読み出しの型（`TouchSampler`）はdead_codeになる。
#[cfg(any(
    feature = "touch-sample-14",
    feature = "touch-lcd-14",
    feature = "bringup-display-13",
    feature = "face-21",
    deskcat_product_mode
))]
#[cfg_attr(
    not(any(feature = "touch-sample-14", feature = "touch-lcd-14")),
    allow(dead_code)
)]
mod touch;
#[cfg(feature = "touch-lcd-14")]
mod touch_lcd;

use esp_idf_svc::hal::delay::FreeRtos;
use esp_idf_svc::hal::gpio::{InputPin, OutputPin};
use esp_idf_svc::hal::i2c::{I2cConfig, I2cDriver, I2C0};
use esp_idf_svc::hal::peripherals::Peripherals;
#[cfg(any(
    feature = "bringup-display-13",
    feature = "face-21",
    feature = "touch-sample-14",
    feature = "touch-lcd-14",
    deskcat_product_mode
))]
use esp_idf_svc::hal::spi::SpiAnyPins;
#[cfg(not(any(
    feature = "bench-servo-test-17",
    feature = "bench-servo-calib-18",
    feature = "bench-wdt-711"
)))]
use esp_idf_svc::hal::uart::{config::Config as UartConfig, UartDriver, UartEventPayload};
use esp_idf_svc::hal::units::Hertz;

use crate::accel::Adxl345;
#[cfg(feature = "accel-sample-15")]
use crate::accel_sample::AccelSampler;
#[cfg(not(any(
    feature = "bench-servo-test-17",
    feature = "bench-servo-calib-18",
    feature = "bench-wdt-711"
)))]
use crate::boot_session::{BootRetryPolicy, BootSession};
#[cfg(any(
    feature = "bringup-display-13",
    feature = "face-21",
    feature = "touch-lcd-14",
    deskcat_product_mode
))]
use crate::display::Ili9341;
#[cfg(feature = "bringup-display-13")]
use crate::display_test::DisplayBringup;
use crate::env::Bme280;
#[cfg(deskcat_product_mode)]
use crate::env_report::EnvReporter;
#[cfg(feature = "env-sample-16")]
use crate::env_sample::EnvSampler;
#[cfg(any(feature = "face-21", deskcat_product_mode))]
use crate::face::FaceDrawer;
use crate::face::FaceState;
use crate::health::Health;
#[cfg(any(feature = "bringup-led-514", deskcat_product_led))]
use crate::led::Leds;
#[cfg(not(any(
    feature = "bench-servo-test-17",
    feature = "bench-servo-calib-18",
    feature = "bench-wdt-711"
)))]
use crate::pi_link::{FaceTargets, PiLink};
#[cfg(any(feature = "tap-21", deskcat_product_mode))]
use crate::tap::TapDetector;
#[cfg(any(
    feature = "no-touch-487",
    all(
        not(deskcat_product_mode),
        any(feature = "bringup-display-13", feature = "face-21")
    )
))]
use crate::touch::IdleTouch;
#[cfg(deskcat_reads_touch)]
use crate::touch::StrokeDetector;
#[cfg(any(feature = "touch-sample-14", feature = "touch-lcd-14"))]
use crate::touch::TouchSampler;
#[cfg(feature = "touch-lcd-14")]
use crate::touch_lcd::TouchLcd;
#[cfg(deskcat_reads_touch)]
use deskcat_protocol::HeadTouched;
#[cfg(any(feature = "tap-21", deskcat_product_mode))]
use deskcat_protocol::Message;

/// `run_display_bringup`がLCDと同じbusに足すtouchの型。製品buildは撫でを判定し、LCDを描く試験buildは読まない（`crate::touch`）。
#[cfg(deskcat_reads_touch)]
type BusTouch = StrokeDetector;
#[cfg(any(
    feature = "no-touch-487",
    all(
        not(deskcat_product_mode),
        any(feature = "bringup-display-13", feature = "face-21")
    )
))]
type BusTouch = IdleTouch;

/// `ACCEL-01`（ADXL345）のI2C address。**`SDO`を`GND`へ配線する前提の値である。**
///
/// `SDO`／`ALT ADDRESS`をGNDへ配線すると`0x53`になる
/// （[`docs/hardware/sensor-datasheet-notes.md`](../../../docs/hardware/sensor-datasheet-notes.md)
/// の`Accelerometer`節`ICの値`表の`I2Cアドレスの選択方式`行。**ただしどちらになるかはmodule board上の実装で決まり、現物確認まで確定しない**
/// （[`HW-TBD-004`](../../../docs/hardware/tbd-register.md)）。この定数は`SDO`→GND前提の値である）。
/// **`EXP-015`は、この配線でこのaddress（`0x53`）にDevice ID `0xE5`（期待値と同じ値）の読み出しを得た記録である**
/// （記録は`docs/hardware/experiment-log.md`が正本であり、ここへ再掲しない。
/// **台帳（`HW-TBD-004`）の状態は、このdocでは更新していない**）。
/// addressは一般値で開始してよい側であり
/// （[`docs/hardware/gpio-assignment.md`](../../../docs/hardware/gpio-assignment.md)
/// `I2C addressの選択`節「addressは一般値で開始してよい側である」（hardware-safety-policy.mdの
/// 対応表に基づく分類）、同節「どちらのaddressを採るか」の項「上の材料には電気的な優劣が無く、実装コストの差だけ
/// である」）、`SDO`配線を決める側（現物作業）がこの値と異なる配線を選ぶ場合は、この
/// 定数を実際の配線へ合わせて直す。`ENV-01`側も`GND`側を前提にした
/// （[`ENV_I2C_ADDRESS`]参照）。
const ACCEL_I2C_ADDRESS: u8 = 0x53;

/// `ENV-01`（BME280）のI2C address。**`SDO`を`GND`へ配線する前提の値である。**
///
/// `SDO`をGNDへ配線すると`0x76`になる
/// （[`docs/hardware/sensor-datasheet-notes.md`](../../../docs/hardware/sensor-datasheet-notes.md)
/// の`Environmental sensor`節の`Address／select pin`行）。module資料の既定でもある
/// （[`docs/hardware/gpio-assignment.md`](../../../docs/hardware/gpio-assignment.md)の
/// `I2C addressの選択`節「`0x76`はmodule資料が「既定」と記す側である」行）。
/// [`ACCEL_I2C_ADDRESS`]と同じ根拠（一般値で開始してよい側、`gpio-assignment.md`の
/// `I2C addressの選択`節「addressは一般値で開始してよい側である」行）で、GND側を
/// 前提にした。**現物確認まで確定しない点も`ACCEL_I2C_ADDRESS`と同じである。**
const ENV_I2C_ADDRESS: u8 = 0x76;

/// I2C busのbaudrate。Standard-mode（100 kHz）。
///
/// [`docs/hardware/gpio-assignment.md`](../../../docs/hardware/gpio-assignment.md)
/// `初回bring-upのmode決定`節「2026-09-06に、初回bring-upで採るmodeをStandard-mode（100 kHz）と決定した」。
/// 同節が根拠（実効pull-up 約2.42 kΩは規定`Cb`上限でもStandard-modeの
/// rise time制約を満たす。Fast-modeは成立しない）。**ただし同節が明記するとおり、
/// 「rise timeの制約に余裕がある」ことと「実効抵抗がStandard-modeの規定範囲内にあることの
/// 確認」は別であり、後者はこの変更の時点でも未達のまま残る**（[#2](https://github.com/wachi-yoshitaka-11-dev/deskcat/issues/2)
/// の受け入れchecklist項目。この変更はその項目を閉じない）。
const I2C_BAUDRATE_HZ: u32 = 100_000;

/// `ResetReason` を Protocol の語彙（snake_case）へ写す。
///
/// **列挙値の意味を推測で足さない。**`esp_idf_svc::hal::reset::ResetReason` は
/// `#[non_exhaustive]` ではないため、variant が増えたときは compile error で気付く。
/// **`_ =>` で受けない。**受けると、この性質が失われる。
fn reset_reason_str(reason: esp_idf_svc::hal::reset::ResetReason) -> &'static str {
    use esp_idf_svc::hal::reset::ResetReason;

    match reason {
        ResetReason::Software => "software",
        ResetReason::ExternalPin => "external_pin",
        ResetReason::Watchdog => "watchdog",
        ResetReason::Sdio => "sdio",
        ResetReason::Panic => "panic",
        ResetReason::InterruptWatchdog => "interrupt_watchdog",
        ResetReason::PowerOn => "power_on",
        ResetReason::Unknown => "unknown",
        ResetReason::Brownout => "brownout",
        ResetReason::TaskWatchdog => "task_watchdog",
        ResetReason::DeepSleep => "deep_sleep",
        ResetReason::USBPeripheral => "usb_peripheral",
        ResetReason::JTAG => "jtag",
        ResetReason::EfuseError => "efuse_error",
        ResetReason::PowerGlitch => "power_glitch",
        ResetReason::CPULockup => "cpu_lockup",
    }
}

/// 次の期限を返す。**これが rate limit の実装である。**
///
/// 通常は `deadline + period` を返す。log の所要時間で周期が漸進的にずれないよう、
/// 経過時間ではなく期限を基準に積む。
///
/// `deadline + period` が既に `now` を過ぎている場合（出力が 1 周期以上かかった場合）は、
/// **遅れた分を取り戻そうとしない。**`now + period` へ整列し直し、`overrun` へ
/// `true` を返す。
///
/// **`now` には出力が終わった後の時刻を渡す。**出力の前の時刻を渡すと、出力自体が
/// 1 周期以上かかっても `deadline + period` が未来に見えるため、overrun を検出できない。
///
/// # 保証の範囲
///
/// 保証するのは **slot ごとに 1 回**（burst 1）である。slot は `period` の倍数で区切る。
/// 長期の出力 rate は `1 / period` を超えない。**ただし、ある回が 1 周期未満だけ遅れた
/// 場合、その次の回は前回の出力から 1 周期未満で来うる**（schedule へ整列し直すため）。
/// 「連続する 2 回の間隔が必ず `period` 以上」までは保証しない。そこまで保証するには
/// 出力時刻を基準に積むことになり、毎回の出力費用が周期へ積み上がって drift する。
fn next_deadline(deadline: u64, period_ms: u32, now: u64) -> (u64, bool) {
    let period = u64::from(period_ms);
    let next = deadline.saturating_add(period);
    if next > now {
        (next, false)
    } else {
        (now.saturating_add(period), true)
    }
}

/// `until` まで待つ。
///
/// **必ず 1 ms 以上を渡す。**`delay_ms(0)` は yield せずに戻るため、loop に置くと
/// busy wait になり、優先度の低い IDLE task を starve させる。IDLE task が回らないと
/// Task Watchdog Timer が進まないため、これは watchdog の前提を壊す。
///
/// 待ち時間が `u32` に収まらない場合は `u32::MAX` で頭打ちにする。頭打ちにしても
/// 次の周回で残りを待ち直すだけであり、期限を飛ばさない。
///
/// Pi linkを持つbuild（`bench-servo-test-17`を有効にするbuild（`bench-servo-90-17`を含む）と`bench-servo-calib-18`以外のすべて）は、この関数の代わりに
/// `UartDriver::read`のtimeoutで待つ（main loop参照。同じく1 ms以上へ丸める）。
#[cfg(feature = "bench-servo-test-17")]
fn sleep_ms_until(until: u64, now: u64) {
    let remaining = until.saturating_sub(now);
    let ms = u32::try_from(remaining).unwrap_or(u32::MAX).max(1);
    FreeRtos::delay_ms(ms);
}

/// `bench-servo-calib-18`のbuildの`main`。製品経路の`main`（下）は、このbuildにcompileしない。
/// Pi link・heartbeat・I2C・LCDを持たず、`GO18`を待ってから`crate::servo_calib`が回を進める。
#[cfg(feature = "bench-servo-calib-18")]
fn main() {
    // `main`の先頭の`link_patches`と同じ理由で、1回呼ぶ。
    esp_idf_svc::sys::link_patches();
    console::init_log_mode();
    let profile = if cfg!(debug_assertions) {
        "debug"
    } else {
        "release"
    };
    log::info!(
        "firmware={} version={} profile={} feature=bench-servo-calib-18",
        env!("CARGO_PKG_NAME"),
        env!("CARGO_PKG_VERSION"),
        profile
    );
    log::info!("board={}", config::BOARD);
    let reason = esp_idf_svc::hal::reset::ResetReason::get();
    log::info!("reset_reason={} raw={reason:?}", reset_reason_str(reason));
    servo_calib::run()
}

/// `bench-wdt-711`のbuildの`main`。main taskをTWDTへ登録し、その後は一度もfeedしない（`crate::task_wdt`）。
/// servo・LEDC・GPIO27・Pi link・I2C・LCDに触れない。
#[cfg(feature = "bench-wdt-711")]
fn main() {
    esp_idf_svc::sys::link_patches();
    console::init_log_mode();
    let profile = if cfg!(debug_assertions) {
        "debug"
    } else {
        "release"
    };
    log::info!(
        "firmware={} version={} profile={} feature=bench-wdt-711",
        env!("CARGO_PKG_NAME"),
        env!("CARGO_PKG_VERSION"),
        profile
    );
    log::info!("board={}", config::BOARD);
    let reason = esp_idf_svc::hal::reset::ResetReason::get();
    log::info!("reset_reason={} raw={reason:?}", reset_reason_str(reason));
    task_wdt::run_wdt_test()
}

#[cfg(not(any(feature = "bench-servo-calib-18", feature = "bench-wdt-711")))]
fn main() {
    // It is necessary to call this function once. Otherwise, some patches to the runtime
    // implemented by esp-idf-sys might not link properly. See https://github.com/esp-rs/esp-idf-template/issues/71
    esp_idf_svc::sys::link_patches();

    // UART0はdebug logに使う（`bench-servo-test-17`は確認の語、`touch-sample-14`は`MARK`、`debug-motion-19`は`MOTION`の行も読む。`crate::console`のmodule doc参照）。
    console::init_log_mode();

    // build identity。profile は `Cargo.toml` の `[profile.dev]`／`[profile.release]` に対応する。
    // **`esp_app_desc!()` は使わない。**`#[no_mangle]`／`#[link_section]` を展開するため
    // `main.rs` 先頭の `forbid(unsafe_code)`（`mem-probe-23` なしの build）に触れる。
    let profile = if cfg!(debug_assertions) {
        "debug"
    } else {
        "release"
    };
    log::info!(
        "firmware={} version={} profile={}",
        env!("CARGO_PKG_NAME"),
        env!("CARGO_PKG_VERSION"),
        profile
    );

    log::info!("board={}", config::BOARD);

    // `ResetReason::get()` は safe fn である。`unsafe` は esp-idf-hal 内部にあり、
    // `unsafe_code` は crate 単位の lint なのでこの crate には効かない。
    let reason = esp_idf_svc::hal::reset::ResetReason::get();
    let reset_reason = reset_reason_str(reason);
    log::info!("reset_reason={reset_reason} raw={reason:?}");

    // **`Health`はbring-upより前に作る。**I2Cのbring-upの段の境界でheartbeatを刻むため
    // である（`service_bringup_step`参照）。heartbeatのdeadline計算（`next_heartbeat`／
    // `next_snapshot`）は、起動時のbring-upの後で初期化する。
    let mut health = Health::new(reset_reason);

    // **どのbuildでも`Peripherals::take()`を呼ぶ。**1度しか成功しないため`expect`で即座に気付く。
    let peripherals = Peripherals::take().expect("Peripherals::take must succeed exactly once");

    // **bring-upより前に作る。**両LEDを早く消灯側へ固定するためである（`crate::led`の
    // module doc「起動からの状態」）。点灯試験の時計は`bringup_done_ms`から数える。
    // 失敗してもfirmwareは止めない。LEDは表示だけを担い、ほかの機能はLEDに依存しない。
    #[cfg(any(feature = "bringup-led-514", deskcat_product_led))]
    let mut leds = match Leds::new(peripherals.pins.gpio2, peripherals.pins.gpio5) {
        Ok(leds) => Some(leds),
        Err(err) => {
            log::error!("led_init_error err={err}");
            None
        }
    };

    // **bring-up経路ごとに1 fieldで出す。**行ごと`#[cfg]`で分けると、featureの組み合わせの数
    // だけ同じ行を書くことになる。`cfg!`はcompile時に定数へ畳まれるため、有効でない経路の
    // 文字列が実行時に選ばれることはない。
    let display_state = if cfg!(all(
        any(feature = "face-21", deskcat_product_mode),
        feature = "bringup-display-13"
    )) {
        "bringup_and_face_enabled"
    } else if cfg!(any(feature = "face-21", deskcat_product_mode)) {
        "face_enabled"
    } else if cfg!(feature = "bringup-display-13") {
        "bringup_enabled"
    } else if cfg!(feature = "touch-lcd-14") {
        "touch_lcd_enabled"
    } else {
        "not_driven"
    };
    let servo_state = if cfg!(feature = "bench-servo-test-17") {
        "bench_test_pending"
    } else {
        "not_driven"
    };
    let touch_state = if cfg!(feature = "touch-sample-14") {
        "raw_sample"
    } else if cfg!(feature = "touch-lcd-14") {
        "raw_sample_with_lcd"
    } else if cfg!(deskcat_reads_touch) {
        "stroke"
    } else if cfg!(any(
        feature = "no-touch-487",
        feature = "bringup-display-13",
        feature = "face-21"
    )) {
        "cs_high_not_read"
    } else {
        "not_driven"
    };
    let pi_link = if cfg!(feature = "bench-servo-test-17") {
        "none"
    } else {
        "uart1"
    };
    log::info!(
        "peripherals=taken display={display_state} servo={servo_state} i2c=id_read_attempt pi_link={pi_link} adc=not_driven touch={touch_state}"
    );
    log::info!(
        "i2c_addresses accel=0x{ACCEL_I2C_ADDRESS:02x} env=0x{ENV_I2C_ADDRESS:02x} baudrate_hz={I2C_BAUDRATE_HZ}"
    );

    // 製品buildとLCDを有効にする試験buildだけがこのblockを持つ（`run_display_bringup`のdoc参照）。
    // 初期化とbacklightの点灯だけをここで行い、fillと四隅patternはmain loopの中で1段ずつ
    // 進める（`crate::display_test`）。`face-21`単独のbuildは進めず、表情を描く（`crate::face`）。
    // `bus_touch`はmain loopが終わらないかぎり持ち続ける（dropすると`TOUCH-CS`のdriverが戻る）。製品buildはmain loopで読む。
    #[cfg(any(
        feature = "bringup-display-13",
        feature = "face-21",
        deskcat_product_mode
    ))]
    #[cfg_attr(not(deskcat_reads_touch), allow(unused_mut, unused_variables))]
    let (lcd, mut bus_touch) = run_display_bringup(
        peripherals.spi3,
        peripherals.pins.gpio18,
        peripherals.pins.gpio23,
        peripherals.pins.gpio19,
        peripherals.pins.gpio22,
        peripherals.pins.gpio17,
        peripherals.pins.gpio16,
        peripherals.pins.gpio4,
        peripherals.pins.gpio21,
        health.uptime_ms(),
    );
    // `set_expression`を受理できるか（`crate::face`）。LCDを描けるbuild（`face-21`）だけが立てる。
    // `bench-servo-test-17`だけのbuildはPi linkも表情も持たず、これを読まない。
    #[cfg_attr(feature = "bench-servo-test-17", allow(unused_mut, unused_variables))]
    let mut face = FaceState::new();
    #[cfg(feature = "bringup-display-13")]
    let mut display = lcd.map(DisplayBringup::new);
    // `bringup-display-13`と組み合わせたbuildは、bring-upが終わった後にdriverを受け取る（main loop）。
    #[cfg(all(
        any(feature = "face-21", deskcat_product_mode),
        feature = "bringup-display-13"
    ))]
    let mut face_drawer: Option<FaceDrawer<'static>> = None;
    #[cfg(all(
        any(feature = "face-21", deskcat_product_mode),
        feature = "bringup-display-13"
    ))]
    if display.is_some() {
        face.set_busy();
    }
    #[cfg(all(
        any(feature = "face-21", deskcat_product_mode),
        not(feature = "bringup-display-13")
    ))]
    let mut face_drawer = lcd.map(FaceDrawer::new);
    #[cfg(all(
        any(feature = "face-21", deskcat_product_mode),
        not(feature = "bringup-display-13")
    ))]
    if let Some(drawer) = face_drawer.as_mut() {
        face.set_ready();
        drawer.show(deskcat_protocol::ExpressionName::Neutral);
    }

    // **I2Cのbring-upは、`bringup-display-13`付きbuildではLCDのbring-upが終わってから行う。**
    // 1回で描き切っていた頃と同じlogの順（LCDの初期化、fill、四隅pattern、I2C）を保つため
    // である。`docs/hardware/power-budget.md`の`DISP-01`追加接続の手順は、この順を前提に
    // 待機時間の上限（手順5）と停止の条件（手順8）を決めている。`bringup-display-13`を
    // 持たないbuild（`face-21`単独を含む）では、今までどおり起動時に行う。
    #[cfg(feature = "bringup-display-13")]
    let mut i2c_pending = Some((
        peripherals.i2c0,
        peripherals.pins.gpio25,
        peripherals.pins.gpio26,
    ));
    #[cfg(not(feature = "bringup-display-13"))]
    let i2c_driver = run_i2c_bringup(
        peripherals.i2c0,
        peripherals.pins.gpio25,
        peripherals.pins.gpio26,
        &mut health,
    );
    // 製品buildと`tap-21`付き試験buildは、ADXL345のDevice IDが一致したときだけ、
    // tap検出を始める（`crate::tap`）。一致しなければ、`tap-21`付き試験buildはI2Cのdriverを手放し、
    // 製品buildは`ENV-01`の周期測定のためにdriverを持ち続ける（`start_product_sensors`）。
    #[cfg(all(
        any(feature = "tap-21", deskcat_product_mode),
        feature = "bringup-display-13"
    ))]
    let mut tap: Option<TapDetector> = None;
    #[cfg(all(feature = "tap-21", not(feature = "bringup-display-13")))]
    let mut tap = start_tap(i2c_driver, health.uptime_ms());
    // 製品buildは、tapと`ENV-01`の周期測定が同じI2C busを共有する（`crate::i2c_bus`）。
    #[cfg(deskcat_product_mode)]
    let (mut tap, mut env_reporter) = start_product_sensors(i2c_driver, health.uptime_ms());
    #[cfg(feature = "env-sample-16")]
    let mut env_sampler =
        i2c_driver.map(|bringup| EnvSampler::new(bringup.driver, bringup.env_id, ENV_I2C_ADDRESS));
    #[cfg(feature = "accel-sample-15")]
    let mut accel_sampler =
        i2c_driver.and_then(|bringup| start_accel_sample(bringup, health.uptime_ms()));
    #[cfg(feature = "touch-sample-14")]
    let mut touch_sampler = run_touch_sample(
        peripherals.spi3,
        peripherals.pins.gpio18,
        peripherals.pins.gpio23,
        peripherals.pins.gpio19,
        peripherals.pins.gpio21,
        peripherals.pins.gpio34,
        peripherals.pins.gpio22,
        health.uptime_ms(),
    );
    #[cfg(feature = "touch-lcd-14")]
    let mut touch_lcd = run_touch_lcd(
        peripherals.spi3,
        peripherals.pins.gpio18,
        peripherals.pins.gpio23,
        peripherals.pins.gpio19,
        peripherals.pins.gpio22,
        peripherals.pins.gpio17,
        peripherals.pins.gpio16,
        peripherals.pins.gpio4,
        peripherals.pins.gpio21,
        peripherals.pins.gpio34,
        health.uptime_ms(),
    );
    #[cfg(all(
        not(any(feature = "tap-21", deskcat_product_mode)),
        not(feature = "bringup-display-13"),
        not(feature = "env-sample-16"),
        not(feature = "accel-sample-15")
    ))]
    drop(i2c_driver);

    // featureが無ければこのblockはbuildへ含まれない（`run_servo_bench_test`のdoc参照）。
    #[cfg(feature = "bench-servo-test-17")]
    run_servo_bench_test(
        peripherals.ledc.timer0,
        peripherals.ledc.channel0,
        peripherals.pins.gpio27,
    );

    // 周期は `config` が持つ。**ここへ数値を直接書かない。**暫定値である根拠は
    // `config` の doc comment にある。
    log::info!(
        "heartbeat_period_ms={} health_snapshot_period_ms={}",
        config::HEARTBEAT_PERIOD_MS,
        config::HEALTH_SNAPSHOT_PERIOD_MS
    );

    // **`health.uptime_ms()`起点で最初の締切を積む。**`0`起点で固定すると、起動時の
    // bring-up（LCDの初期化、I2CのID読み出し）の所要時間だけで最初のloop周回が即座に
    // `overrun`と判定されてしまう。bring-up自体の遅延であってmain loopの遅延ではないため、
    // 混同しない。**ただし`bringup-display-13`付きbuildでは、I2Cのbring-upはmain loopの中で
    // 動く**（下の`i2c_pending`）。その所要時間はloopの遅延として`overrun`と`max_read_gap_ms`に入る。
    let bringup_done_ms = health.uptime_ms();
    let mut next_heartbeat = bringup_done_ms + u64::from(config::HEARTBEAT_PERIOD_MS);
    let mut next_snapshot = bringup_done_ms + u64::from(config::HEALTH_SNAPSHOT_PERIOD_MS);
    #[cfg(any(feature = "bringup-led-514", deskcat_product_led))]
    let led_start_ms = bringup_done_ms;

    // Pi linkの送信も受信も、protocol専用の`UartDriver`経由に揃える。**UART0は使わない**
    // （debug log専用。`crate::console`のmodule doc参照）。UART0以外のUARTをGPIO matrixで
    // `PI-UART-TX`＝GPIO13、`PI-UART-RX`＝GPIO14へ割り当てる（`docs/hardware/gpio-assignment.md`の
    // `Pi–ESP32間のtransport`節。同節は「UART0以外」とだけ定める。UART1とUART2のどちらでもよく、
    // 番号の小さいUART1を使う。UART1の既定のpinはTX＝GPIO10、RX＝GPIO9で、どちらもflash用の
    // 使用禁止pinである（ESP-IDF v5.5.3 `soc/esp32/include/soc/uart_pins.h`20〜21行、
    // gpio-assignment.mdの`ESP32の使用制限pin`節）。`UartDriver::new`は渡したGPIO13／GPIO14だけを
    // 設定し、既定のpinには触れない。esp-idf-hal 0.46.2 `uart.rs`2023行〜の`new_common`が
    // `uart_set_pin`へ渡すのはこの2本だけであり、ESP-IDF v5.5.3 `esp_driver_uart/src/uart.c`819行〜の
    // `uart_set_pin`は負の番号のpinを設定しない）。8N1でflow control（RTS／CTS）なし
    // （`esp32-pi-protocol.md`§2の`UART framing`、`Candidate`）は`UartConfig::default()`のまま得る
    // （esp-idf-hal 0.46.2 `uart.rs`579〜596行の`Config::new`）。baudは
    // `config::PI_PROTOCOL_UART_BAUDRATE_HZ`、ring buffer容量は
    // `config::PI_PROTOCOL_UART_RX_BUFFER_BYTES`、event queueの長さは
    // `config::PI_PROTOCOL_UART_EVENT_QUEUE_LEN`のdoc参照。
    #[cfg(not(feature = "bench-servo-test-17"))]
    let mut uart = {
        let uart_config = UartConfig::default()
            .baudrate(Hertz(config::PI_PROTOCOL_UART_BAUDRATE_HZ))
            .rx_fifo_size(config::PI_PROTOCOL_UART_RX_BUFFER_BYTES)
            .tx_fifo_size(config::PI_PROTOCOL_UART_TX_BUFFER_BYTES)
            .queue_size(config::PI_PROTOCOL_UART_EVENT_QUEUE_LEN);
        UartDriver::new(
            peripherals.uart1,
            peripherals.pins.gpio13,
            peripherals.pins.gpio14,
            Option::<esp_idf_svc::hal::gpio::AnyIOPin>::None,
            Option::<esp_idf_svc::hal::gpio::AnyIOPin>::None,
            &uart_config,
        )
        .expect("UartDriver::new for the Pi link UART must succeed exactly once")
    };
    // event queueが無ければ、受信の異常を数えられない（`drain_uart_events`のdoc「数えられない場合」）。
    // 起動時に1回だけ確かめてlogへ出す。
    #[cfg(not(feature = "bench-servo-test-17"))]
    if uart.event_queue().is_none() {
        log::error!("pi_uart_event_queue_missing (受信の異常を数えない)");
    }

    // `boot`のACK待ち・再送sessionを開始する（`#446` PR B、`crate::boot_session`参照）。
    // `sid`は起動のたびに1回だけ選ぶ（§3）。`stale_session`を受けたときの選び直しは
    // `BootSession`内部が行うため、ここで選び直さない。
    #[cfg(not(feature = "bench-servo-test-17"))]
    let mut boot_session = BootSession::start(
        BootRetryPolicy::provisional(),
        generate_sid(&health),
        reset_reason,
        &health,
        &mut uart,
    );
    // 受信を読みに行く間隔を測る起点（`crate::health::UartObservations::max_read_gap_ms`）。
    #[cfg(not(feature = "bench-servo-test-17"))]
    let mut last_read_ms = health.uptime_ms();
    // Pi→ESP32方向の受信を振り分ける（`crate::pi_link`）。
    #[cfg(not(feature = "bench-servo-test-17"))]
    let mut pi_link = PiLink::new(servo_path::product(), health.uptime_ms());
    // debug consoleの読み取り（`crate::debug_motion`。`debug-motion-19`付きのbuildだけ）。
    #[cfg(feature = "debug-motion-19")]
    let debug_console = debug_motion::DebugConsole::start();

    // **`main()` から戻らない。**#6 の firmware は戻っていたため、task が進み続けて
    // いるかを外から確認できなかった。
    loop {
        let now = health.uptime_ms();
        // 制御周期の期限が来たときだけ`tick`する。`LimitedServo`が無い間は何もしない（`PiLink::tick_servo`）。
        #[cfg(not(feature = "bench-servo-test-17"))]
        pi_link.check_link(now);
        #[cfg(not(feature = "bench-servo-test-17"))]
        pi_link.tick_servo(now);
        // debug consoleの行を、Pi由来と同じ`MotionDispatch`へ渡す（`PiLink::on_debug_line`）。
        #[cfg(feature = "debug-motion-19")]
        while let Some(event) = debug_console.try_recv() {
            match event {
                debug_motion::ConsoleEvent::Line(line) => {
                    pi_link.on_debug_line(&line, boot_session.is_established());
                }
                debug_motion::ConsoleEvent::TooLong(len) => {
                    log::warn!("debug_motion_unparsed reason=TooLong len={len}")
                }
                debug_motion::ConsoleEvent::ReadFailed(err) => {
                    log::error!("debug_motion_console_read_failed error={err}");
                }
            }
        }

        if now >= next_heartbeat {
            let seq = health.next_heartbeat_seq();
            log::info!("hb seq={seq} uptime_ms={now}");
            // **出力の後の時刻で積む。**出力前の時刻では、出力自体が 1 周期以上
            // かかっても overrun を検出できない。
            let after = health.uptime_ms();
            let (next, overrun) = next_deadline(next_heartbeat, config::HEARTBEAT_PERIOD_MS, after);
            next_heartbeat = next;
            if overrun {
                health.record_overrun();
                log::warn!(
                    "heartbeat_overrun uptime_ms={now} period_ms={} overrun_ticks={}",
                    config::HEARTBEAT_PERIOD_MS,
                    health.overrun_ticks()
                );
            }
        }

        if now >= next_snapshot {
            #[cfg(not(feature = "bench-servo-test-17"))]
            let limiter = pi_link.servo_counters();
            #[cfg(feature = "bench-servo-test-17")]
            let limiter = None;
            emit_health_snapshot(&mut health, now, limiter);
            #[cfg(feature = "mem-probe-23")]
            mem_probe::log(now);
            let after = health.uptime_ms();
            let (next, overrun) =
                next_deadline(next_snapshot, config::HEALTH_SNAPSHOT_PERIOD_MS, after);
            next_snapshot = next;
            if overrun {
                health.record_overrun();
                log::warn!(
                    "health_snapshot_overrun uptime_ms={now} period_ms={} overrun_ticks={}",
                    config::HEALTH_SNAPSHOT_PERIOD_MS,
                    health.overrun_ticks()
                );
            }
        }

        // LCDのbring-upを1段だけ進める（`crate::display_test`）。終わったら、持ち越していた
        // I2Cのbring-upを1回だけ行う（上の`i2c_pending`のcomment）。
        #[cfg(feature = "bringup-display-13")]
        {
            if let Some(bringup) = display.take() {
                display = match bringup.poll(health.uptime_ms()) {
                    Some(done) if done.is_done() => {
                        let lcd = done.into_lcd();
                        // `face-21`付きbuildは、driverを手放さず表情の描画へ渡す（backlightは点いたまま）。
                        // それ以外は手放し、backlightを消す（bring-upの試験手順のとおり）。
                        #[cfg(any(feature = "face-21", deskcat_product_mode))]
                        {
                            let mut drawer = FaceDrawer::new(lcd);
                            face.set_ready();
                            drawer.show(deskcat_protocol::ExpressionName::Neutral);
                            face_drawer = Some(drawer);
                        }
                        #[cfg(not(any(feature = "face-21", deskcat_product_mode)))]
                        drop(lcd);
                        None
                    }
                    Some(running) => Some(running),
                    // bring-upが失敗して終わった。driverは手放され、以後も描けない。
                    None => {
                        #[cfg(any(feature = "face-21", deskcat_product_mode))]
                        face.set_unavailable();
                        None
                    }
                };
            }
            if display.is_none() {
                if let Some((i2c0, sda, scl)) = i2c_pending.take() {
                    let i2c_driver = run_i2c_bringup(i2c0, sda, scl, &mut health);
                    #[cfg(any(feature = "tap-21", deskcat_product_mode))]
                    {
                        tap = start_tap(i2c_driver, health.uptime_ms());
                    }
                    #[cfg(not(any(feature = "tap-21", deskcat_product_mode)))]
                    drop(i2c_driver);
                }
            }
        }

        // 受理した表情を描く。帯を1本だけ塗って戻る（`crate::face`）。
        #[cfg(any(feature = "face-21", deskcat_product_mode))]
        if let Some(drawer) = face_drawer.as_mut() {
            if let Some(name) = face.take_request() {
                drawer.show(name);
            }
            drawer.poll(health.uptime_ms());
        }

        #[cfg(not(feature = "bench-servo-test-17"))]
        boot_session.on_deadline(&health, &mut uart);

        // 製品buildとtap試験buildで検出を1回読み、送ってよいときだけ`tapped`を送る（`crate::tap`）。
        #[cfg(any(feature = "tap-21", deskcat_product_mode))]
        if let Some(detector) = tap.as_mut() {
            // `poll`内のI2C readと検出logも含む、検出→描画時間の保守的な始点。**ただし製品buildは保留する（`TAP_CONFIRM_MS`）ので、`poll`が`tapped`を`true`にする周期は検出より保留（`TAP_CONFIRM_MS`）の分以上後であり、始点は検出から保留の分だけ遅れる。**
            let poll_started_at_ms = health.uptime_ms();
            // 製品buildは、タッチの接触中と離れた直後のtapを送らない（撫でる力がtapと判定されると推定している。`crate::touch::TAP_HOLDOFF_AFTER_RELEASE_MS`）。
            // また、tapを見つけても`deskcat_tap::TAP_CONFIRM_MS`の間は送らず保留し、その間に接触が始まれば捨てる（`crate::tap`）。
            #[cfg(deskcat_reads_touch)]
            let touch_blocks = bus_touch
                .as_ref()
                .is_some_and(|touch| touch.tap_blocked(poll_started_at_ms));
            #[cfg(not(deskcat_reads_touch))]
            let touch_blocks = false;
            let events = detector.poll(
                poll_started_at_ms,
                boot_session.is_established(),
                boot_session.session_epoch(),
                touch_blocks,
            );
            if events.tapped {
                log::info!("tap_event_poll_start uptime_ms={poll_started_at_ms}");
                pi_link::send_event(Message::Tapped, &mut boot_session, &health, &mut uart);
            }
            // 揺れは、`deskcat_tap::shake::SHAKE`が`None`なら`false`のままで、送らない。
            if events.shaken {
                log::info!("shake_event_poll uptime_ms={poll_started_at_ms}");
                pi_link::send_event(Message::Shaken, &mut boot_session, &health, &mut uart);
            }
        }

        // 製品buildでtouchを1 sample読み、撫でと判定して送ってよいときだけ`head_touched`を送る（`crate::touch::StrokeDetector`）。
        #[cfg(deskcat_reads_touch)]
        if let Some(detector) = bus_touch.as_mut() {
            if let Some(duration_ms) =
                detector.poll(health.uptime_ms(), boot_session.is_established())
            {
                pi_link::send_event(
                    Message::HeadTouched(HeadTouched { duration_ms }),
                    &mut boot_session,
                    &health,
                    &mut uart,
                );
            }
        }

        // 製品buildで`ENV-01`の測定を1段進め、sessionが確立していれば、測れた`environment`を送る（`crate::env_report`）。
        // 確立前に測れた最新の1件は持ち越す。送った後は持たない。
        #[cfg(deskcat_product_mode)]
        if let Some(reporter) = env_reporter.as_mut() {
            reporter.poll(health.uptime_ms());
            if boot_session.is_established() {
                if let Some(environment) = reporter.take_event() {
                    pi_link::send_event(
                        Message::Environment(environment),
                        &mut boot_session,
                        &health,
                        &mut uart,
                    );
                }
            }
        }

        // FIFOを読み、窓ごとの統計をUART0へlogする（`crate::accel_sample`）。
        #[cfg(feature = "accel-sample-15")]
        if let Some(sampler) = accel_sampler.as_mut() {
            if sampler.poll(health.uptime_ms()) {
                accel_sampler = None;
            }
        }

        // XPT2046 の raw を1 sample 読み、UART0 へ log する（`crate::touch`）。
        #[cfg(feature = "touch-sample-14")]
        if let Some(sampler) = touch_sampler.as_mut() {
            sampler.poll(health.uptime_ms());
        }

        // LCDの帯を1本塗り、タッチを1 sample読む（`crate::touch_lcd`）。
        #[cfg(feature = "touch-lcd-14")]
        if let Some(touch_lcd) = touch_lcd.as_mut() {
            touch_lcd.poll(health.uptime_ms());
        }

        // 変換時間を待たず、1周回で1段だけ進める。UART0 の log のみ。
        #[cfg(feature = "env-sample-16")]
        if let Some(sampler) = env_sampler.as_mut() {
            if sampler.poll(health.uptime_ms()) {
                env_sampler = None;
            }
        }

        // 期限を積み直した後の時刻で残りを測る。log の所要時間を待ち時間から差し引く。
        #[cfg_attr(
            all(
                feature = "bench-servo-test-17",
                not(feature = "bringup-display-13"),
                not(feature = "bringup-led-514")
            ),
            allow(unused_mut)
        )]
        let mut until = next_heartbeat.min(next_snapshot);
        #[cfg(not(feature = "bench-servo-test-17"))]
        if let Some(retry_deadline) = boot_session.next_deadline_ms() {
            until = until.min(retry_deadline);
        }
        // `tick`の期限（制御周期）。待ちはこの下のUART read timeoutで行い、blockingしない。
        #[cfg(not(feature = "bench-servo-test-17"))]
        if let Some(deadline) = pi_link.next_servo_deadline_ms() {
            until = until.min(deadline);
        }
        // Piからの受信が途切れたと判定する時刻。
        #[cfg(not(feature = "bench-servo-test-17"))]
        if let Some(deadline) = pi_link.next_link_deadline_ms() {
            until = until.min(deadline);
        }
        #[cfg(feature = "bringup-display-13")]
        if let Some(bringup) = &display {
            until = until.min(bringup.next_deadline_ms(health.uptime_ms()));
        }
        // 塗る帯が残っている間は、待たずに次の周回へ進む（read timeoutは1 tick以上で、IDLE taskへ回る）。
        #[cfg(any(feature = "face-21", deskcat_product_mode))]
        if face_drawer.as_ref().is_some_and(FaceDrawer::is_drawing) {
            until = until.min(health.uptime_ms());
        }
        #[cfg(any(feature = "face-21", deskcat_product_mode))]
        if let Some(deadline) = face_drawer.as_ref().and_then(FaceDrawer::text_deadline_ms) {
            until = until.min(deadline);
        }
        #[cfg(any(feature = "tap-21", deskcat_product_mode))]
        if let Some(deadline) = tap.as_ref().and_then(TapDetector::next_deadline_ms) {
            until = until.min(deadline);
        }
        #[cfg(deskcat_reads_touch)]
        if let Some(deadline) = bus_touch
            .as_ref()
            .and_then(StrokeDetector::next_deadline_ms)
        {
            until = until.min(deadline);
        }
        #[cfg(deskcat_product_mode)]
        if let Some(deadline) = env_reporter
            .as_ref()
            .and_then(EnvReporter::next_deadline_ms)
        {
            until = until.min(deadline);
        }
        #[cfg(feature = "env-sample-16")]
        if let Some(deadline) = env_sampler.as_ref().and_then(EnvSampler::next_deadline_ms) {
            until = until.min(deadline);
        }
        #[cfg(feature = "accel-sample-15")]
        if let Some(deadline) = accel_sampler
            .as_ref()
            .and_then(AccelSampler::next_deadline_ms)
        {
            until = until.min(deadline);
        }
        #[cfg(feature = "touch-sample-14")]
        if let Some(deadline) = touch_sampler
            .as_ref()
            .and_then(TouchSampler::next_deadline_ms)
        {
            until = until.min(deadline);
        }
        #[cfg(feature = "touch-lcd-14")]
        if let Some(deadline) = touch_lcd
            .as_ref()
            .and_then(|t| t.next_deadline_ms(health.uptime_ms()))
        {
            until = until.min(deadline);
        }
        #[cfg(any(feature = "bringup-led-514", deskcat_product_led))]
        if let Some(leds) = leds.as_mut() {
            let now_led = health.uptime_ms();
            // 受理した`happy`を取り出すのはLEDがあるときだけにする（初期化に失敗したら点ける先が無い）。
            if face.take_react_pulse() {
                leds.pulse_react(now_led);
            }
            leds.update(led_start_ms, now_led);
            until = until.min(leds.next_deadline_ms(led_start_ms, now_led));
        }

        // sleepの代わりに`UartDriver::read`へ残り時間をtimeoutとして渡す。data到着があれば
        // timeoutいっぱいまで待たず即座に戻る（`config::PI_PROTOCOL_UART_RX_BUFFER_BYTES`の
        // doc「容量の根拠」参照）ため、busy-waitにならずACK受信への反応latencyも下がる。
        //
        // **必ず1 ms以上を渡す**（`sleep_ms_until`と同じ理由）。LCDのbring-upの描く段は、締切を
        // 「すぐ」として返す（`crate::display_test::DisplayBringup::next_deadline_ms`）。0 tickの
        // `read`はdataが無ければyieldせずに戻るため、帯を続けて描く間、優先度の低いIDLE taskが
        // 回らず、Task Watchdog Timerの前提を壊す。1 msは`TickType::new_millis`（esp-idf-hal
        // 0.46.2 `delay.rs`89〜95行）が1 tickへ切り上げ、`CONFIG_FREERTOS_HZ=100`（生成された`sdkconfig`、
        // debug profile）では1 tick＝10 msになる。1 tickのblockは次のtickの割り込みで解けるため、
        // 実際の待ちは0〜10 msであり、dataが届けばそれより早く戻る。ring bufferにdataが残っている間は
        // `read`がblockせずに戻るため、その周は下の`post_read_yield_ms`で譲る（Issue #713）。
        #[cfg(not(feature = "bench-servo-test-17"))]
        {
            drain_uart_events(&uart, &mut health);
            let now2 = health.uptime_ms();
            let gap_ms = now2.saturating_sub(last_read_ms);
            let observations = health.uart_mut();
            observations.max_read_gap_ms = observations.max_read_gap_ms.max(gap_ms);
            let remaining_ms = until.saturating_sub(now2).max(1);
            let ticks = boot_session::ticks_until(std::time::Duration::from_millis(remaining_ms));
            let mut buf = [0_u8; config::PI_PROTOCOL_UART_READ_CHUNK_BYTES];
            // **`Err`を無視する。**esp-idf-hal 0.46.2の`UartRxDriver::read`
            // （`uart.rs`1179〜1246行）は、timeout（data未到着、毎周回起こりうる
            // 正常系）と`uart_read_bytes`自体の失敗（`-1`）を、どちらも同じ
            // `Err(ESP_ERR_TIMEOUT)`に畳んでおり、この版のAPIでは型で区別できない
            // （`len`が`-1`でも`0`でも同じ分岐、doc commentも「timeoutならErr」と
            // 明記している）。両者を区別する手段（別のAPIや`unsafe`）は導入しない。
            // `uart_read_bytes`の`ESP_RETURN_ON_FALSE`（不正な`uart_num`／
            // null buffer／未installのdriver。`uart.c`1662〜1666行）は即時
            // returnであり、繰り返し起きればbusy-waitになる。ここではinstall
            // 済みの`uart`・固定長の`buf`しか渡さないためこの経路は実質
            // 到達しないという前提に立つ。`rx_mux`取得待ち（同1670〜1671行）は
            // `ticks`の間blockするため問題にならない。
            let read = uart.read(&mut buf, ticks);
            last_read_ms = health.uptime_ms();
            if let Ok(n) = read {
                if n > 0 {
                    #[cfg(any(feature = "face-21", deskcat_product_mode))]
                    let drawer = face_drawer.as_mut();
                    #[cfg(not(any(feature = "face-21", deskcat_product_mode)))]
                    let drawer = None;
                    let mut face_targets = FaceTargets {
                        state: &mut face,
                        drawer,
                    };
                    pi_link.on_bytes(
                        &buf[..n],
                        health.uptime_ms(),
                        &mut boot_session,
                        &health,
                        &mut face_targets,
                        &mut uart,
                    );
                }
            }
            // ring bufferにdataがあった周は、最初の`NON_BLOCK`の読みで戻り、blockしない
            // （esp-idf-hal 0.46.2 `uart.rs`1179〜1246行）。受信が続くと毎周この経路になり、
            // IDLE taskへ時間が回らないため、dataを返した周は処理の後にFreeRTOSへ譲る（Issue #713）。
            // blockした後にdataが届いた周も`Ok(n)`を返すので、その周は余分に1 tick譲る。
            if let Some(ms) = post_read_yield_ms(read.as_ref().map_or(0, |n| *n)) {
                FreeRtos::delay_ms(ms);
            }
        }
        #[cfg(feature = "bench-servo-test-17")]
        sleep_ms_until(until, health.uptime_ms());
    }
}

/// `UartDriver::read`が`read_bytes`（1以上）を返した周の後に、FreeRTOSへ譲る時間（ms）。
/// 譲らない周は`None`を返す。
///
/// `read`はdataがあると最初の`NON_BLOCK`の読みで戻り、blockしない。dataが無い周は、timeout
/// （1 tick以上）のblockで既に譲っている。**譲るときは必ず1 ms以上を返す**（`delay_ms(0)`の
/// `vTaskDelay(0)`は同じ優先度以上のtaskにしか譲らず、優先度の低いIDLE taskは回らない。
/// `sleep_ms_until`と同じ理由）。1 msは1 tickへ切り上がる
/// （`CONFIG_FREERTOS_HZ=100`では10 ms）ため、値は新しく置かず、1 tickに任せる（Issue #713）。
///
/// firmware crateは`harness = false`でhostのtestを持たない。この関数の性質は、下の定数式が
/// build時に確かめる（満たさなければ、このfirmwareはcompileできない）。
#[cfg(not(any(
    feature = "bench-servo-test-17",
    feature = "bench-servo-calib-18",
    feature = "bench-wdt-711"
)))]
const fn post_read_yield_ms(read_bytes: usize) -> Option<u32> {
    if read_bytes > 0 {
        Some(1)
    } else {
        None
    }
}

#[cfg(not(any(
    feature = "bench-servo-test-17",
    feature = "bench-servo-calib-18",
    feature = "bench-wdt-711"
)))]
const _: () = {
    // dataが無い周は、既にblockしているので譲らない。
    assert!(post_read_yield_ms(0).is_none());
    // dataがある周は、必ず譲る。0 msは譲ったことにならない。
    match post_read_yield_ms(1) {
        Some(ms) => assert!(ms >= 1),
        None => panic!("data read must yield"),
    }
    match post_read_yield_ms(config::PI_PROTOCOL_UART_READ_CHUNK_BYTES) {
        Some(ms) => assert!(ms >= 1),
        None => panic!("full chunk read must yield"),
    }
};

/// Pi linkのUARTのevent queueを空になるまで吸い上げ、受信の異常を数えてlogへ出す。
///
/// 数えるのは、受信のring bufferの満杯（`UART_BUFFER_FULL`）とhardware FIFOの溢れ
/// （`UART_FIFO_OVF`）である（`crate::health::UartObservations`）。`UART_DATA`等のそれ以外のeventは
/// 読み捨てる。**frame errorとparity errorは数えない。**`UartConfig::default()`のevent設定
/// （esp-idf-hal 0.46.2 `uart.rs`の`EventConfig::new`）はframe errorの割り込みを有効にせず、
/// parityは`ParityNone`（ESP-IDF v5.5.3の`uart_ll_set_parity`が`parity_en`を0にする）である。**待たない**（`recv_front`へ0 tickを渡す）。
///
/// # 数えられない場合
///
/// **event queueが作れなかった場合は何も数えない**（`config::PI_PROTOCOL_UART_EVENT_QUEUE_LEN`は0では
/// ないため作られる見込みだが、無ければ起動時に`pi_uart_event_queue_missing`を1回出す）。
///
/// **ここで数えた回数は、起きた回数の下限である。**ESP-IDFのUART driverは、event queueが
/// 満杯の間に起きたeventを捨てる（ESP-IDF v5.5.3 `esp_driver_uart/src/uart.c`の`UART event queue full`）。main loopが
/// 長く戻らない間（LCDの1段、NVSの書き込み、長いlog）にqueueが`UART_DATA`で埋まると、その後の
/// 溢れのeventは数えられない。**0件でも、溢れなかったことの証明にはならない。**
///
/// **ring bufferが満杯になったとき、ESP-IDFのdriverは受信のinterruptを止め、`read`で空きが
/// できるまでbyteをhardware FIFOに残す**（ESP-IDF v5.5.3 `esp_driver_uart/src/uart.c`の
/// `rx_buffer_full_flg`）。FIFOも溢れたbyteは失われる。どちらの場合も、行が壊れれば
/// `crate::pi_link::PiLink::on_bytes`が壊れた行として捨て、`boot`は§4.1の再送で
/// 送り直される見込みである（確かめていない）。
#[cfg(not(any(
    feature = "bench-servo-test-17",
    feature = "bench-servo-calib-18",
    feature = "bench-wdt-711"
)))]
fn drain_uart_events(uart: &UartDriver<'_>, health: &mut Health) {
    let Some(queue) = uart.event_queue() else {
        return;
    };
    while let Some((event, _)) = queue.recv_front(esp_idf_svc::hal::delay::NON_BLOCK) {
        let observations = health.uart_mut();
        let (name, count) = match event.payload() {
            UartEventPayload::RxBufferFull => {
                observations.rx_buffer_full = observations.rx_buffer_full.saturating_add(1);
                ("rx_buffer_full", observations.rx_buffer_full)
            }
            UartEventPayload::RxFifoOverflow => {
                observations.rx_fifo_overflow = observations.rx_fifo_overflow.saturating_add(1);
                ("rx_fifo_overflow", observations.rx_fifo_overflow)
            }
            _ => continue,
        };
        log::warn!("pi_uart_event kind={name} count={count}");
    }
}

/// NVS namespace。`bench17`（`run_servo_bench_test`が使うnamespace）とは別の名前にする。
/// 用途が異なるnamespaceを共有すると、片方のkey追加がもう片方の`erase_all`等を
/// 誤って巻き込みうる。
#[cfg(not(any(
    feature = "bench-servo-test-17",
    feature = "bench-servo-calib-18",
    feature = "bench-wdt-711"
)))]
const SID_NVS_NAMESPACE: &str = "pi_session";
/// 次回起動が使う`sid`をこのkeyへ保存する。
#[cfg(not(any(
    feature = "bench-servo-test-17",
    feature = "bench-servo-calib-18",
    feature = "bench-wdt-711"
)))]
const SID_NVS_KEY_NEXT: &str = "next_sid";

/// 起動のたびに新しい`sid`を選ぶ（`PROTO-TBD-011`のうち`sid`の生成方法に
/// 当たる部分。§3.1参照。生成方法は確定するが、衝突許容確率は未確定のまま
/// 残る。下の「衝突許容確率」節参照）。
///
/// # 生成方法: NVSの不揮発counter
///
/// **乱数ではなく不揮発counterを使う。**§3.1は生成方法を§13の`PROTO-TBD-011`の行で
/// 確定済みとしている（ESP32は不揮発counter）。この crate は`mem-probe-23`なしの build で`main.rs`先頭の`forbid(unsafe_code)`
/// としており、`esp_random()`／`bootloader_random_enable()`（ESP-IDF v5.5.3
/// `components/esp_hw_support/include/esp_random.h`・`bootloader_random.h`）は
/// `unsafe extern "C"` fnであるため直接呼べない。加えて、ESP-IDF公式資料
/// （`docs/en/api-reference/system/random.rst`）は、Wi-Fi／Bluetoothが有効か、
/// `bootloader_random_enable()`を呼んでいるか、second-stage bootloader実行中の
/// いずれかを満たさない限り、RNGの出力は「pseudo-random only」と明記する。
/// このfirmwareはWi-Fi／Bluetoothを一切初期化しない（`Peripherals::take()`は呼ぶが、
/// Wi-Fi／Bluetoothの初期化は別の話であり行わない。`#446` PR B、`#487`。根拠は、`docs/hardware/power-budget.md`の
/// `ACCEL-01`／`ENV-01`単体bring-upの手順`条件(3)の根拠`が記録する走査である。#487のPR B1の後にも、
/// `src`・`Cargo.toml`・`sdkconfig.defaults`でcommentを除いて0件だった）。`bootloader_random_enable()`も呼ばない
/// （呼ぶには`unsafe`が要る）。**したがって乱数側を使っても、
/// 上記の非衝突要件に対する根拠のある確率は示せない。**
///
/// 不揮発counterは`unsafe`もWi-Fi／Bluetoothの初期化も要らず、§3.1の要件
/// （再起動のたびに新しい値を選ぶ）を確率ではなく構造で満たそうとする。
/// [`EspNvs::get_u32`]で前回保存した値を読み、1加算し、**使う前に**
/// [`EspNvs::set_u32`]で保存する（保存後に停電しても、次回起動は保存済みの
/// 値から続くため、このboot分の値が失われるだけで、値の再利用は起きない）。
///
/// # 衝突許容確率
///
/// **0ではない。**`u32`一周（`u32::MAX`回のcommit）は実運用で起こらないが、
/// counterが`0`へ戻る経路が一周以外にもある。
///
/// `EspDefaultNvsPartition::take()`は`take_with(true)`（`reinit=true`）を呼ぶ
/// （esp-idf-svc 0.52.1 `src/nvs.rs`の`EspNvsPartition<NvsDefault>::take`）。
/// `NvsDefault::init(reinit=true)`は、`nvs_flash_init()`が
/// `ESP_ERR_NVS_NO_FREE_PAGES`または`ESP_ERR_NVS_NEW_VERSION_FOUND`を返すと、
/// **`nvs_flash_erase()`でdefault partition全体を消去してから再初期化する**
/// （同fileの`NvsDefault::init`）。この経路を通ると[`SID_NVS_KEY_NEXT`]も失われ、
/// counterは`0`から数え直しになり、以前使った小さい`sid`を再び選びうる。
/// 人がflash全体を消去した場合も同じ結果になる。**したがって「commitが
/// 成功する限り再利用しない」だけでは正しくない。**
///
/// この消去は`run_servo_bench_test`の単発latch（namespace `bench17`）も消す。
/// servoの安全に関わる性質であり、正本は`docs/hardware/servo-safety-limits.md`の
/// `初回動作の実行手順`の`再武装`stepへの2026-09-30追記である（ここへ書き写さない）。
///
/// counterが`0`から数え直された後にESP32が送る小さい`sid`が、受信側のretired
/// session集合に残っている値と一致すれば衝突する。この衝突は、protocol側の
/// `stale_session`回復（§3.1「`sid`が衝突した場合」。ACKで`stale_session`を
/// 受けたら新しい`sid`を選び直して再送する）で扱う対象である。**この回復経路は
/// `crate::boot_session::BootSession::reselect_sid`が実装している
/// （`#446` PR B）。**選び直しの回数には上限がある（`BootRetryPolicy`の
/// `sid_reselect_limit`）ため、counterが`0`から数え直された後に連続して選ぶ
/// `sid`が、上限+1回分以上retired session集合に含まれていると衝突から
/// 抜けられないまま終端しうる。
///
/// # NVSが使えない場合
///
/// `EspDefaultNvsPartition::take()`／`EspNvs::new`／`get_u32`／`set_u32`の
/// いずれかが失敗した場合、`health.uptime_ms()`の下位32 bitへ縮退する
/// （旧`sid_from_uptime`と同じ値）。**この経路では非衝突を主張しない。**
/// 値は起動からの経過時間であり、`generate_sid`より前に走る処理（bring-up）の所要時間が
/// 起動ごとに大きく変わらなければ、起動ごとに近い小さい値になる。§3の要件を
/// 満たさないまま`boot`を送る。エラーは`log::error!`で分類し、UART0（USB）の
/// debug logへ出る（`#487`のPR Aより前、Pi linkを持つbuild（当時の`pi-protocol-mode`）は
/// loggingを止めており、出力されなかった）。
/// counterは持たない（`boot_session`のmodule doc「停止理由の区別」参照）。
#[cfg(not(any(
    feature = "bench-servo-test-17",
    feature = "bench-servo-calib-18",
    feature = "bench-wdt-711"
)))]
fn generate_sid(health: &Health) -> u32 {
    use esp_idf_svc::nvs::{EspDefaultNvsPartition, EspNvs};

    let nvs_partition = match EspDefaultNvsPartition::take() {
        Ok(partition) => partition,
        Err(err) => {
            log::error!("sid_nvs_partition_failed error={err}");
            return sid_from_uptime(health.uptime_ms());
        }
    };
    let nvs = match EspNvs::new(nvs_partition, SID_NVS_NAMESPACE, true) {
        Ok(nvs) => nvs,
        Err(err) => {
            log::error!("sid_nvs_open_failed error={err}");
            return sid_from_uptime(health.uptime_ms());
        }
    };

    // `None`（keyが無い＝初回起動）は`0`とみなす。protocolはsid=0を特別扱いしない
    // ため（Envelope §3、`u32`の正当な値）、「保存されていない」と「0が保存されている」を
    // 区別する必要は無い。どちらでも次のsidは`1`加算した値になる（最初の起動なら`1`）。
    let previous = match nvs.get_u32(SID_NVS_KEY_NEXT) {
        Ok(value) => value.unwrap_or(0),
        Err(err) => {
            log::error!("sid_nvs_get_failed error={err}");
            return sid_from_uptime(health.uptime_ms());
        }
    };
    // **`wrapping_add`のままにする。**`u32`一周（`generate_sid`のdoc「衝突許容確率」
    // 参照）は実運用では起こらないため、その先のsidが`0`や過去の小さい値と
    // 見た目上一致しても、`max(1)`のような補正は入れない。補正を入れると、
    // 一周した直後のsidが常に同じ値（`1`）へ寄せられ、実際に一周する状況では
    // 逆に衝突を作り込む。
    let sid = previous.wrapping_add(1);

    // **実際に返す前にcommitする。**`run_servo_bench_test`の「実際に動かす前に
    // latchをcommitする」と同じ順序（module doc参照）。
    if let Err(err) = nvs.set_u32(SID_NVS_KEY_NEXT, sid) {
        log::error!("sid_nvs_set_failed error={err}");
        return sid_from_uptime(health.uptime_ms());
    }

    sid
}

/// [`generate_sid`]のNVS不使用時の縮退経路が使う。`ts_ms`（`u64`）を`sid`（`u32`）へ
/// 切り詰める（下位32 bit）。**非衝突を主張しない**（[`generate_sid`]のdoc参照）。
#[cfg(not(any(
    feature = "bench-servo-test-17",
    feature = "bench-servo-calib-18",
    feature = "bench-wdt-711"
)))]
const fn sid_from_uptime(ts_ms: u64) -> u32 {
    ts_ms as u32
}

/// I2Cのbring-upの各段階の境界で1回、heartbeatを刻みOSへyieldする。
///
/// `main`のloopが使う`next_heartbeat`によるdeadline schedulingとは別の、bring-up専用の
/// 簡易版である。[`FreeRtos::delay_ms`]はmodule doc冒頭が引用するとおりOSへyieldする。
///
/// **LCDのbring-upはもうこの関数を使わない**（`#487`）。CodeRabbitのreview
/// （[#415](https://github.com/wachi-yoshitaka-11-dev/deskcat/pull/415)）は、`run_display_bringup`が
/// main loopの開始より前に複数のSPI転送（単色fill×5、四隅pattern）を連続実行しており、その間
/// heartbeatが一度も出ないことを指摘した。この関数はそのとき足した簡易版だった。`#487`からは、
/// LCDの描画をmain loopの中で1段ずつ進め（`crate::display_test`）、本来のheartbeatを描画の間も
/// 回す構造にした（見込みの範囲は`crate::display_test`のmodule doc）。
fn service_bringup_step(health: &mut Health, step: &str) {
    FreeRtos::delay_ms(1);
    // **`bringup_hb`と`hb`は別の名前にする。**main loopの`hb seq=`（`config::HEARTBEAT_PERIOD_MS`
    // 周期の本来のheartbeat）とlog上の接頭辞を分け、読み手が混同しないようにする。
    // `bringup_hb`と`hb`は`Health`の同じcounterを使うため、両方の行を合わせると連番になる。
    // `hb`のseqの始まりと欠番の位置は、bring-upの経路（buildと、失敗の有無）で変わる。
    // **`hb`のseqだけを見て、行が抜けたと判断しない。**
    let seq = health.next_heartbeat_seq();
    log::info!(
        "bringup_hb seq={seq} uptime_ms={} bringup_step={step}",
        health.uptime_ms()
    );
}

/// `DISP-01`を初期化してbacklightを点け、driverを返す。あわせて、同じbusにtouchのdeviceを足して`TOUCH-CS`をHighに保つ
/// （[`BusTouch`]。製品buildは`crate::touch::StrokeDetector`でmain loopから読み、LCDを描く試験buildと`no-touch-487`は`crate::touch::IdleTouch`で読まない）。
///
/// `bringup-display-13`付きbuildでは、呼び出し側がfillと四隅patternをmain loopの中で進める（`crate::display_test`。
/// `#487`のPR B1より前は、この関数が1回の呼び出しで描き切っていた）。controllerのIDは読まない（`crate::display`のmodule doc）。
/// 初期化の後に、書き込んだMADCTLの値と論理座標の幅・高さを`display_madctl`の行としてlogへ出す。
///
/// **どの段階で失敗しても、この関数はpanicしない。**driverの作成か初期化に失敗したら
/// `log::error!`へ分類してLCDに`None`を返し、main loopはLCDを描かずに進む。touchのdeviceを作れなくてもLCDは続ける。
///
/// **製品buildと、`bringup-display-13`か`face-21`の試験buildだけがこの関数を持つ。**
/// LCDを持たない試験buildはこの関数をcompileせず、`main()`から呼ばない。
/// そのbuildは`LCD-BL`（GPIO4）を含むLCD関連pinへ触れない。
#[cfg(any(
    feature = "bringup-display-13",
    any(feature = "face-21", deskcat_product_mode)
))]
#[allow(clippy::too_many_arguments)]
fn run_display_bringup<SPI: SpiAnyPins + 'static>(
    spi3: SPI,
    sclk: impl OutputPin + 'static,
    mosi: impl OutputPin + 'static,
    miso: impl InputPin + 'static,
    cs: impl OutputPin + 'static,
    dc: impl OutputPin + 'static,
    rst: impl OutputPin + 'static,
    bl: impl OutputPin + 'static,
    touch_cs: impl OutputPin + 'static,
    now_ms: u64,
) -> (Option<Ili9341<'static>>, Option<BusTouch>) {
    use esp_idf_svc::hal::spi::config::DriverConfig;
    use esp_idf_svc::hal::spi::SpiDriver;
    use std::rc::Rc;

    // pinは`docs/hardware/gpio-assignment.md`の`信号inventory`に従う
    // （`LCD-SCLK`=18, `LCD-MOSI`=23, `LCD-MISO`=19, `LCD-CS`=22, `LCD-DC`=17,
    // `LCD-RST`=16, `LCD-BL`=4, `TOUCH-CS`=21）。
    // **`Peripherals`全体ではなく個々のfieldを受け取る。**`main()`がI2C用とPi link用の
    // fieldも同じ`Peripherals`から取り出す必要があるため、呼び出し元でfieldを分けてから渡す。
    // **busは`touch-lcd-14`と同じ共有の型で持つ**（`SpiDriver`を共有し、転送ごとにbusを取る。`crate::spi_port`）。
    let bus = match SpiDriver::new(spi3, sclk, mosi, Some(miso), &DriverConfig::new()) {
        Ok(driver) => Rc::new(driver),
        Err(err) => {
            // 以前は`Ili9341::new`の中で失敗し、同じ名前で出ていた（`docs/hardware/power-budget.md`の`DISP-01`追加接続の手順が待つ名前）。
            log::error!("display_driver_new_failed error={err}");
            return (None, None);
        }
    };
    // **`TOUCH-CS`をHighにするため、touchのdeviceをLCDの初期化より前に作る。**この段では何も送らない。
    // 作れなくてもLCDは続ける（GPIO21の外部pull-upがHighを保つ。`gpio-assignment.md`）。その場合、製品build（`no-touch-487`を除く）は撫でを判定しない。
    #[cfg(deskcat_reads_touch)]
    let created = StrokeDetector::with_shared_bus(Rc::clone(&bus), touch_cs, now_ms);
    #[cfg(not(deskcat_reads_touch))]
    let created = {
        let _ = now_ms;
        IdleTouch::with_shared_bus(Rc::clone(&bus), touch_cs)
    };
    let bus_touch_new = match created {
        Ok(touch) => Some(touch),
        Err(err) => {
            log::error!("touch_device_new_failed error={err}");
            None
        }
    };
    let lcd = match Ili9341::with_shared_bus(bus, cs, dc, rst, bl) {
        Ok(lcd) => lcd,
        Err(err) => {
            log::error!("display_driver_new_failed error={err}");
            return (None, bus_touch_new);
        }
    };
    (init_lcd(lcd), bus_touch_new)
}

/// 作ったLCD driverを初期化し、向きの設定をlogへ残し、backlightを点ける。`run_display_bringup`の後半と同じ手順で、
/// `touch-lcd-14`も使う。失敗したら`log::error!`へ分類して`None`を返す。
#[cfg(any(
    feature = "bringup-display-13",
    feature = "touch-lcd-14",
    any(feature = "face-21", deskcat_product_mode)
))]
fn init_lcd(mut lcd: Ili9341<'static>) -> Option<Ili9341<'static>> {
    if let Err(err) = lcd.init() {
        log::error!("display_init_failed error={err}");
        return None;
    }

    // 初期化で書き込んだ向きの設定を残す（`docs/hardware/power-budget.md`の`DISP-01`
    // 追加接続の手順9(a)）。
    log::info!(
        "display_madctl value=0x{:02x} width={} height={}",
        display::MADCTL_LANDSCAPE,
        display::WIDTH,
        display::HEIGHT
    );

    if let Err(err) = lcd.backlight_on() {
        log::error!("display_backlight_on_failed error={err}");
    }

    Some(lcd)
}

/// `touch-lcd-14`付きbuildで、LCDを初期化して点灯し、同じSPI hostでタッチを読む準備をする。**タッチへは何も送らない**（最初の転送は`TouchLcd::poll`）。
///
/// pinは`docs/hardware/gpio-assignment.md`の`信号inventory`に従う（`LCD-SCLK`=18、`LCD-MOSI`=23、`LCD-MISO`=19、`LCD-CS`=22、`LCD-DC`=17、
/// `LCD-RST`=16、`LCD-BL`=4、`TOUCH-CS`=21、`TOUCH-IRQ`=34）。`SpiDriver`を1つ作って共有する。失敗してもpanicせず、
/// `log::error!`へ出して`None`を返す（LCDが描けなければ、タッチだけを読んでも条件の観察にならないため、タッチも始めない）。
#[cfg(feature = "touch-lcd-14")]
#[allow(clippy::too_many_arguments)]
fn run_touch_lcd<SPI: SpiAnyPins + 'static>(
    spi3: SPI,
    sclk: impl OutputPin + 'static,
    mosi: impl OutputPin + 'static,
    miso: impl InputPin + 'static,
    lcd_cs: impl OutputPin + 'static,
    dc: impl OutputPin + 'static,
    rst: impl OutputPin + 'static,
    bl: impl OutputPin + 'static,
    touch_cs: impl OutputPin + 'static,
    touch_irq: impl InputPin + 'static,
    now_ms: u64,
) -> Option<TouchLcd> {
    use esp_idf_svc::hal::spi::config::DriverConfig;
    use esp_idf_svc::hal::spi::SpiDriver;
    use std::rc::Rc;

    let bus = match SpiDriver::new(spi3, sclk, mosi, Some(miso), &DriverConfig::new()) {
        Ok(driver) => Rc::new(driver),
        Err(err) => {
            log::error!("touch_lcd_bus_new_failed error={err}");
            return None;
        }
    };
    // **`TOUCH-CS`をHighにするため、タッチのdriverをLCDの初期化より前に作る。**初期化のcommandは共有のSCLK／MOSIへ流れる。
    let sampler = match TouchSampler::with_shared_bus(Rc::clone(&bus), touch_cs, touch_irq, now_ms)
    {
        Ok(sampler) => sampler,
        Err(err) => {
            log::error!("touch_driver_new_failed error={err}");
            return None;
        }
    };
    let lcd = match Ili9341::with_shared_bus(bus, lcd_cs, dc, rst, bl) {
        Ok(lcd) => lcd,
        Err(err) => {
            log::error!("display_driver_new_failed error={err}");
            return None;
        }
    };
    let lcd = init_lcd(lcd)?;
    log::info!(
        "touch_lcd_started lcd_clock_hz={} touch_clock_hz={} band_rows={} stripes_per_window={} poll_interval_ms={}",
        display::SPI_CLOCK_HZ,
        touch::SPI_CLOCK_HZ,
        touch_lcd::BAND_ROWS,
        touch_lcd::WINDOW_STRIPES,
        touch::POLL_INTERVAL_MS
    );
    Some(TouchLcd::new(lcd, sampler))
}

/// `touch-sample-14`付きbuildで、`TOUCH-01`（XPT2046）の読み出しを始める。**この段では何も送らない**（最初の転送は`TouchSampler::poll`）。
///
/// pinは`docs/hardware/gpio-assignment.md`の`信号inventory`に従う（`LCD-SCLK`=18、`LCD-MOSI`=23、`LCD-MISO`=19、`TOUCH-CS`=21、
/// `TOUCH-IRQ`=34、`LCD-CS`=22。`LCD-CS`はHighに固定してLCDを選択させない）。失敗してもpanicせず、`log::error!`へ出して`None`を返す。
#[cfg(feature = "touch-sample-14")]
#[allow(clippy::too_many_arguments)]
fn run_touch_sample<SPI: SpiAnyPins + 'static>(
    spi3: SPI,
    sclk: impl OutputPin + 'static,
    mosi: impl OutputPin + 'static,
    miso: impl InputPin + 'static,
    touch_cs: impl OutputPin + 'static,
    touch_irq: impl InputPin + 'static,
    lcd_cs: impl OutputPin + 'static,
    now_ms: u64,
) -> Option<TouchSampler> {
    match TouchSampler::new(spi3, sclk, mosi, miso, touch_cs, touch_irq, lcd_cs, now_ms) {
        Ok(sampler) => {
            log::info!(
                "touch_sample_started spi_clock_hz={} poll_interval_ms={} window={}",
                touch::SPI_CLOCK_HZ,
                touch::POLL_INTERVAL_MS,
                touch::WINDOW_SAMPLES
            );
            Some(sampler)
        }
        Err(err) => {
            log::error!("touch_driver_new_failed error={err}");
            None
        }
    }
}

/// I2C bring-upが返したdriverで、tap検出を設定して始める（`tap-21`付きbuildだけ。製品buildは`start_product_sensors`）。driverが無い、またはDevice IDが`0xE5`でない（読めなかった場合を含む）ときは、何も書かず`None`を返す。
#[cfg(feature = "tap-21")]
fn start_tap(bringup: Option<I2cBringup>, now_ms: u64) -> Option<TapDetector> {
    let bringup = bringup?;
    // **ADXL345のDevice IDを確かめてから設定を書く。**IDが違う（別のdeviceがこのaddressにいる、配線が違う）、
    // または読めなかったときは、何も書かず、検出を始めない（失敗はlogへ出す）。
    if bringup.accel_id != Some(accel::EXPECTED_DEVICE_ID) {
        // 16進で出す（`accel_device_id raw=0x..`の行と同じ基数。読めなかったときは`none`）。
        let found = bringup
            .accel_id
            .map_or_else(|| "none".to_owned(), |raw| format!("0x{raw:02x}"));
        log::error!(
            "tap_not_started accel_id={found} expected=0x{:02x}",
            accel::EXPECTED_DEVICE_ID
        );
        return None;
    }
    Some(configured_tap(i2c_bus::share(bringup.driver), now_ms))
}

/// `bus`でtap検出を作り、設定を書く。Device IDの確認は呼び出し側が済ませている。
#[cfg(any(feature = "tap-21", deskcat_product_mode))]
fn configured_tap(bus: i2c_bus::SharedI2c, now_ms: u64) -> TapDetector {
    let mut detector = TapDetector::new(Adxl345::new(ACCEL_I2C_ADDRESS), bus);
    detector.configure(now_ms);
    detector
}

/// 製品buildで、tapの検出と`ENV-01`の周期測定を、1つのI2C busの上に作る（`crate::i2c_bus`）。
///
/// tapは`ACCEL-01`のDevice IDが`0xE5`のときだけ作る（[`start_tap`]と同じ条件）。**`ENV-01`は、tapの有無によらず作る。**
/// Chip IDは`crate::env_report`が自分で読んで確かめる（一致するまで何も書かない）。I2C driverを作れなかったときは、どちらも作らない。
#[cfg(deskcat_product_mode)]
fn start_product_sensors(
    bringup: Option<I2cBringup>,
    now_ms: u64,
) -> (Option<TapDetector>, Option<EnvReporter>) {
    let Some(bringup) = bringup else {
        return (None, None);
    };
    let bus = i2c_bus::share(bringup.driver);
    let tap = if bringup.accel_id == Some(accel::EXPECTED_DEVICE_ID) {
        Some(configured_tap(bus.clone(), now_ms))
    } else {
        let found = bringup
            .accel_id
            .map_or_else(|| "none".to_owned(), |raw| format!("0x{raw:02x}"));
        log::error!(
            "tap_not_started accel_id={found} expected=0x{:02x}",
            accel::EXPECTED_DEVICE_ID
        );
        None
    };
    (tap, Some(EnvReporter::new(bus, ENV_I2C_ADDRESS, now_ms)))
}

/// `accel-sample-15`付きbuildで、ADXL345のDevice IDが`0xE5`のときだけ連続測定の設定を始める。
/// 一致しなければ何も書かず、driverを手放す（`start_tap`と同じ形）。**設定の書き込みは`AccelSampler::poll`の最初の周回で行う。**
#[cfg(feature = "accel-sample-15")]
fn start_accel_sample(bringup: I2cBringup, now_ms: u64) -> Option<AccelSampler> {
    if bringup.accel_id != Some(accel::EXPECTED_DEVICE_ID) {
        let found = bringup
            .accel_id
            .map_or_else(|| "none".to_owned(), |raw| format!("0x{raw:02x}"));
        log::error!(
            "accel_sample_not_started accel_id={found} expected=0x{:02x}",
            accel::EXPECTED_DEVICE_ID
        );
        return None;
    }
    Some(AccelSampler::new(
        bringup.driver,
        Adxl345::new(ACCEL_I2C_ADDRESS),
        now_ms,
    ))
}

/// [`run_i2c_bringup`]が返す、I2Cのdriverと、`ACCEL-01`のDevice IDの読み出し結果（読めなければ`None`）。
#[cfg_attr(
    not(any(feature = "tap-21", feature = "accel-sample-15", deskcat_product_mode)),
    allow(dead_code)
)]
struct I2cBringup {
    driver: I2cDriver<'static>,
    accel_id: Option<u8>,
    #[cfg(feature = "env-sample-16")]
    env_id: Result<u8, esp_idf_svc::sys::EspError>,
}

/// `ACCEL-01`（ADXL345）と`ENV-01`（BME280）のDevice ID／Chip IDを読み、生byteをlogへ出す。
///
/// [Issue #15](https://github.com/wachi-yoshitaka-11-dev/deskcat/issues/15)／
/// [Issue #16](https://github.com/wachi-yoshitaka-11-dev/deskcat/issues/16)の
/// bring-up手順の1工程である。**一致判定はここでは行わない。**`crate::accel::Adxl345`・
/// `crate::env::Bme280`が返す生byteをそのままlogへ出すだけであり、期待値
/// （`0xE5`／`0x60`）との一致は、logを読む人間の判断とする。**この関数へ判定を持ち込まない。**
/// **ただし製品buildと`tap-21`付きbuildでは、この関数が返す生byte（`ACCEL-01`の`accel_id`）を、呼び出し側の`start_product_sensors`／`start_tap`が`0xE5`と比べ、
/// 一致したときだけtapの設定を書く**（判定するのは呼び出し側であり、この関数ではない）。
///
/// 2つのsensorは同じI2C bus（`GPIO25`＝SDA、`GPIO26`＝SCL）を共有するため
/// （`docs/hardware/gpio-assignment.md`の`信号inventory`の`ACCEL-SDA`／`ACCEL-SCL`／
/// `ENV-SDA`／`ENV-SCL`各行）、`I2cDriver`は
/// この関数の中で1つだけ作り、両方のdriverへ順に貸す（`crate::accel`・`crate::env`
/// のmodule docが定める設計）。**どの段階で失敗しても、この関数はpanicしない。**
///
/// **両deviceがI2Cモードでbusに応答する前提は、まだ現物で確定していない。**
/// ADXL345は`CS` pinを`VDD I/O`へ配線する必要がある（Analog Devices ADXL345 Data
/// Sheet **Rev. 0**（SparkFunがhostする版、`docs/hardware/sensor-datasheet-notes.md`
/// の「Rev. 0（Revision 4までの出典）とRev. Gには差がある」の節が「Revision 4までの出典」と記録する版と同一）「I2C mode is enabled if
/// the CS pin is tied high to VDD I/O... there is no default mode if the CS pin
/// is left unconnected」page 8・10。**この版とRev. G（同文書が正とする版）の既知の
/// 差異一覧（同節「Rev. 0とRev. Gには差がある」以下のtable）にSerial Communications／I2Cの記載は含まれない
/// が、CLIからRev. Gを取得できないため、Rev. G側でこの記述が同一であることは
/// 独立に確認していない**）。
/// 裏面はんだジャンパ2箇所は開放だが何を選ぶ設定かboard資料が無く不明
/// （[`docs/hardware/sensor-datasheet-notes.md`](../../../docs/hardware/sensor-datasheet-notes.md)
/// の`module boardの値（秋月 M-06724）`の表の`実装されているinterface（jumper設定）`行「TBD」）。BME280側の`J3`（`CSB`→`VDD`）は
/// **はんだ付けされた**（実施日・状態・根拠の水準は
/// [`docs/hardware/sensor-datasheet-notes.md`](../../../docs/hardware/sensor-datasheet-notes.md)の
/// `jumper（AE-BME280）`節が正であり、ここへ再掲しない。実施の記録は同dir の
/// `experiment-log.md`の`EXP-014`）。**ただしこの記述を書いたAIセッションは閉を確認しておらず、
/// 測定値も無い。**
/// **したがってこの関数の読み出しが失敗（`Err`）しても、原因をdriverやbus配線に限らない。**
/// 上に挙げた`CS`の配線要求が満たされていない場合がありうる。`J3`についても、はんだ付け済みという記述は
/// ユーザーの申告であって測定で確かめられておらず、**付いていない場合と、付いていても
/// 品質に問題がある場合の両方が残る。**下記のbus配線側の未完了も併せて見る。
///
/// **bus自体の配線も、まだ完了していない。**`ACCEL-SDA`／`ACCEL-SCL`の外部pull-upは
/// breadboardへ実装済みだが（`docs/hardware/gpio-assignment.md`の`競合check`節の
/// 受け入れchecklist「すべての外部pull-upが3.3Vへ接続され」の項目、2026-09-07）、
/// I2C実効pull-upが有効範囲内であることの確認（`Cb`未測定）と、ESP32電源投入前に
/// 外部moduleがpinを駆動していないことの非通電導通checkは、**moduleがESP32へ配線
/// されるまで検証対象が存在しない**として`#15`／`#16`側へ送られている
/// （同文書冒頭の`#2`のclose条件ではない項目一覧、(3)・(5)）。**したがってこの関数を
/// 実機で動かす前に、これらの現物確認が要る。**
/// **2026-09-24追記（#472）: この段落の配線についての記述は、2026-09-22の
/// [EXP-015](../../../docs/hardware/experiment-log.md)の記録と合わない。**同記録は、両moduleを
/// GPIO25／GPIO26・`3V3`・`GND`へ配線して通電したと書いている。同記録は、`module電源pinの独立性`／
/// `pin header対応`の確認（`docs/hardware/power-budget.md`の`ACCEL-01／ENV-01単体bring-upの手順`の
/// 条件(5)(a)）が未達のまま、`Cb`が未測定のまま通電したと書いている。
///
/// 生byteの解釈は、この前提込みでlogを読む人間の判断とする。
///
/// # 通信timeout
///
/// **無期限（`esp_idf_svc::hal::delay::BLOCK`）は使わない。**`crate::accel`・`crate::env`が
/// [`crate::config::I2C_TRANSACTION_TIMEOUT_MS`]から換算したtick数を
/// `I2cDriver::write_read`へ渡す（[#451](https://github.com/wachi-yoshitaka-11-dev/deskcat/issues/451)。
/// 値と導出は同定数のdocが正本であり、**ここへ再掲しない**）。**これにより、busが低のまま
/// 固着した状態（`SDA`の地絡、jumper未設定など）でもこの関数は`Err`を分類してlogへ出し、
/// `main()`のheartbeat loopへ到達する。**「ハングした」と「センサが応答しない」を、人が
/// logの有無から区別できる。
///
/// **上限が効くのはdriver呼び出し側のtick数である。**ESP-IDF v5.5.3の
/// `i2c_master_cmd_begin`（`components/driver/i2c/i2c.c`）は、`ticks_to_wait`を
/// `xSemaphoreTake`の待ち時間として使い、その後の完了待ちloopでも
/// `elapsed >= ticks_to_wait`で打ち切って`ESP_ERR_TIMEOUT`を返す。`ticks_start`は
/// semaphore取得より前に取るため、**この2区間を合わせた「待ち」の上限が渡したtick数**
/// になる。
///
/// **関数が戻るまでの時間は、その待ちより少し長い。**timeoutを検出した側は
/// `i2c_hw_fsm_reset`を呼び、同関数のbus clear待ちが最大`I2C_CLR_BUS_TIMEOUT_MS`
/// （同版で50 ms）かかりうる（同file）。**有限であることは変わらないが、
/// 「渡したtick数ちょうどで戻る」とは書かない。**
///
/// **`esp_idf_svc::hal::i2c::config::Config`の`timeout`フィールドは設定しない。**同
/// フィールドが書き換えるのはI2C周辺回路側のbus timeoutレジスタ（`i2c_set_timeout`）で
/// あり、ESP32ではこの値をbaudrateから導出して`i2c_param_config`の時点で既に設定して
/// いる（同版`components/hal/esp32/include/hal/i2c_ll.h`の`i2c_ll_cal_bus_clk`。
/// `clk_cal->tout = half_cycle * 20; //default we set the timeout value to 10 bus cycles.`）。
/// **ここへ定数を与えると、baudrateへ連動している既定値を、根拠の無い固定値で置き換える
/// ことになる。**上限の保証は上のtick数側で取るため、その必要が無い。
///
/// **実機で`Err`が返るまでの実測時間は、まだ取っていない。**上の上限はESP-IDF実装を
/// 読んだ結果であって実機観測ではない（この変更の検証は`cargo build`までである）。
fn run_i2c_bringup(
    i2c0: I2C0<'static>,
    sda: impl InputPin + OutputPin + 'static,
    scl: impl InputPin + OutputPin + 'static,
    health: &mut Health,
) -> Option<I2cBringup> {
    // ESP32内蔵のweak pull-upは有効にしない。`gpio-assignment.md`の実効pull-up計算が
    // 外部pull-upだけを前提にしているため（`crate::env`のmodule doc「bus speedは
    // Standard-mode」節と同じ根拠。**ここへ再掲しない**）。
    // **`timeout`（hardware側のbus timeoutレジスタ）は設定しない。**理由はこの関数の
    // doc comment「通信timeout」節。**ここへ再掲しない。**
    let config = I2cConfig::new()
        .baudrate(Hertz(I2C_BAUDRATE_HZ))
        .sda_enable_pullup(false)
        .scl_enable_pullup(false);

    let mut i2c = match I2cDriver::new(i2c0, sda, scl, &config) {
        Ok(i2c) => i2c,
        Err(err) => {
            #[cfg(feature = "env-sample-16")]
            crate::env_sample::report_bus_init_fault(&err);
            #[cfg(not(feature = "env-sample-16"))]
            log::error!("i2c_driver_new_failed error={err}");
            return None;
        }
    };

    let accel = Adxl345::new(ACCEL_I2C_ADDRESS);
    let accel_id = match accel.read_device_id(&mut i2c) {
        Ok(raw) => {
            log::info!("accel_device_id raw=0x{raw:02x}");
            Some(raw)
        }
        Err(err) => {
            log::error!("accel_device_id_read_failed error={err}");
            None
        }
    };
    service_bringup_step(health, "accel_device_id");

    let env = Bme280::new(ENV_I2C_ADDRESS);
    let env_id = env.read_chip_id(&mut i2c);
    match &env_id {
        Ok(raw) => log::info!("env_chip_id raw=0x{raw:02x}"),
        Err(err) => log::error!("env_chip_id_read_failed error={err}"),
    }
    #[cfg(not(feature = "env-sample-16"))]
    let _ = env_id;
    service_bringup_step(health, "env_chip_id");
    // 製品buildと`tap-21`付きbuildは、Device IDが一致したとき、このdriverでtap検出を続ける（`crate::tap`）。一致しないとき、`tap-21`付きbuildは呼び出し側が手放し、製品buildは`ENV-01`の周期測定が持ち続ける。
    Some(I2cBringup {
        driver: i2c,
        accel_id,
        #[cfg(feature = "env-sample-16")]
        env_id,
    })
}

/// `SERVO-01`（SG90）の単発bench試験（[Issue #17](https://github.com/wachi-yoshitaka-11-dev/deskcat/issues/17)）。
/// `bench-servo-test-17` feature付きbuildだけがこの関数を呼ぶ。承認の状態は
/// [servo-safety-limits.md](../../../docs/hardware/servo-safety-limits.md)の
/// `承認の状態`節が正本（ここへ再掲しない）。
///
/// # NVSによる単発latch
///
/// この関数はESP32起動のたびに呼ばれる。**起動だけでは動かさない。**latchが立っていなければ、
/// 人間がUART0のconsoleへ[`BENCH_CONFIRM_TOKEN`]を入力して改行するまで待つ
/// （[`wait_for_bench_confirmation`]）。書き込みの後のreset、記録用の読み取りがportを開いたときの
/// DTR／RTSのreset、brownout resetなど、人間が意図しない起動では動かない（#17）。
/// 確認を受けた後、**実際にPWMで動かす前に**NVSへ実行済みflagをcommitする
/// （`EspNvs::set_u8`。`unsafe`は増やさない）。commit済みなら次回起動時にskipする。
/// flagのcommit自体に失敗した場合はservoを動かさずに抜ける（誤判定を避けるため
/// 動かさない側へ倒す）。再武装（NVS消去して再実行）には改めて承認が要る
/// （[servo-safety-limits.md](../../../docs/hardware/servo-safety-limits.md)の
/// `再武装`step参照）。
///
/// 確認の入力を待つ間と`config::SERVO_BENCH_TEST_ARM_DELAY_MS`の間、heartbeatは出ない。人間は
/// `servo_bench_test_waiting_for_confirmation`／`servo_bench_test_arm_delay_start`等のlogで状況を判断する
/// （検討経緯・前提の検証状況はPR本文参照）。
///
/// 既存の`bench-servo-test-17`単独では、規約上の中央から
/// `config::SERVO_FIRST_MOTION_MAX_DEVIATION_DEG`だけ+側の角度を1回指令する。
/// `bench-servo-90-17`では指令角だけを規約上の中央にする。
/// どちらも`config::SERVO_BENCH_TEST_EXPOSURE_MS`を挟んでdutyを0へ戻す。
#[cfg(feature = "bench-servo-test-17")]
fn run_servo_bench_test(
    timer0: esp_idf_svc::hal::ledc::TIMER0<'static>,
    channel0: esp_idf_svc::hal::ledc::CHANNEL0<'static>,
    pin: impl OutputPin + 'static,
) {
    use crate::servo::Sg90;
    use esp_idf_svc::nvs::{EspDefaultNvsPartition, EspNvs};

    const NVS_NAMESPACE: &str = "bench17";
    const NVS_KEY_RAN: &str = "ran";

    let nvs_partition = match EspDefaultNvsPartition::take() {
        Ok(partition) => partition,
        Err(err) => {
            log::error!("servo_bench_test_nvs_partition_failed error={err}");
            return;
        }
    };
    let nvs = match EspNvs::new(nvs_partition, NVS_NAMESPACE, true) {
        Ok(nvs) => nvs,
        Err(err) => {
            log::error!("servo_bench_test_nvs_open_failed error={err}");
            return;
        }
    };

    match nvs.get_u8(NVS_KEY_RAN) {
        Ok(Some(1)) => {
            log::warn!(
                "servo_bench_test_skipped_already_ran reason=nvs_latch_set. \
                 このESP32は既に本試験を1回実行済みである（reset後の再実行を防ぐ）。\
                 改めて承認を得てNVSを消去するまで再実行しない"
            );
            return;
        }
        Ok(_) => {}
        Err(err) => {
            log::error!("servo_bench_test_nvs_get_failed error={err}");
            return;
        }
    }

    // 人間の明示の確認を待つ。確認の前にresetされても、latchは消費されず、次の起動でも待つ。
    if !wait_for_bench_confirmation() {
        return;
    }

    // **実際に動かす前にlatchをcommitする。**動作中・動作直後のbrownout resetでも
    // 次回起動でこのflagが読め、再実行しない（module doc「NVSによる単発latch」参照）。
    if let Err(err) = nvs.set_u8(NVS_KEY_RAN, 1) {
        log::error!("servo_bench_test_nvs_set_failed error={err}");
        return;
    }
    log::info!("servo_bench_test_nvs_latch_set");

    log::info!(
        "servo_bench_test_arm_delay_start ms={}",
        config::SERVO_BENCH_TEST_ARM_DELAY_MS
    );
    FreeRtos::delay_ms(config::SERVO_BENCH_TEST_ARM_DELAY_MS);
    log::info!("servo_bench_test_arm_delay_done");

    let mut servo = match Sg90::new(timer0, channel0, pin) {
        Ok(servo) => servo,
        Err(err) => {
            log::error!("servo_bench_test_new_failed error={err}");
            return;
        }
    };

    #[cfg(not(feature = "bench-servo-90-17"))]
    let target_deg =
        config::SERVO_ANGLE_CONVENTION_NEUTRAL_DEG + config::SERVO_FIRST_MOTION_MAX_DEVIATION_DEG;
    #[cfg(feature = "bench-servo-90-17")]
    let target_deg = config::SERVO_ANGLE_CONVENTION_NEUTRAL_DEG;
    match servo.move_to_angle_once(target_deg) {
        Ok(()) => log::info!("servo_bench_test_move target_deg={target_deg}"),
        Err(err) => log::error!("servo_bench_test_move_failed error={err}"),
    }

    // 露出時間の技術的な最小化。「この秒数まで安全」の主張ではない（定数doc参照）。
    FreeRtos::delay_ms(config::SERVO_BENCH_TEST_EXPOSURE_MS);

    match servo.stop() {
        Ok(()) => log::info!("servo_bench_test_stop"),
        Err(err) => log::error!("servo_bench_test_stop_failed error={err}"),
    }
}

/// `bench-servo-test-17`で、人間がUART0のconsoleへ入力してservoの動作を確かめる語。
/// 秘密ではない。誤って改行だけ・別の語を送っても動かないよう、完全一致だけを受ける。
#[cfg(feature = "bench-servo-test-17")]
const BENCH_CONFIRM_TOKEN: &str = "GO17";

/// [`BENCH_CONFIRM_TOKEN`]の長さを超える入力行を捨てる上限（byte）。
#[cfg(feature = "bench-servo-test-17")]
const BENCH_CONFIRM_MAX_LINE: usize = 16;

/// UART0のconsole（stdin）から1行ずつ読み、[`BENCH_CONFIRM_TOKEN`]と完全一致した行を
/// 受けたら`true`を返す。一致しない行は捨てて待ち続ける。読み取りの失敗（データが無い場合を除く）は
/// `false`を返し、servoを動かさない側へ倒す。
///
/// 期限は置かない（人間が入力するまで、servoへ信号を出さずに待つ）。データが無いときは
/// `FreeRtos::delay_ms`でtaskを譲る。
#[cfg(feature = "bench-servo-test-17")]
fn wait_for_bench_confirmation() -> bool {
    use std::io::{ErrorKind, Read};

    log::warn!(
        "servo_bench_test_waiting_for_confirmation token={BENCH_CONFIRM_TOKEN}. \
         servo電源を入れ、立ち会いを確かめてから、このconsoleへ{BENCH_CONFIRM_TOKEN}と入力して改行する"
    );
    let mut stdin = std::io::stdin();
    let mut line: Vec<u8> = Vec::with_capacity(BENCH_CONFIRM_MAX_LINE);
    let mut overflowed = false;
    let mut byte = [0_u8; 1];
    loop {
        match stdin.read(&mut byte) {
            Ok(1) => match byte[0] {
                b'\r' | b'\n' => {
                    if overflowed {
                        log::warn!("servo_bench_test_confirmation_rejected reason=too_long");
                    } else if line == BENCH_CONFIRM_TOKEN.as_bytes() {
                        log::info!("servo_bench_test_confirmed");
                        return true;
                    } else if !line.is_empty() {
                        log::warn!(
                            "servo_bench_test_confirmation_rejected reason=mismatch len={}",
                            line.len()
                        );
                    }
                    line.clear();
                    overflowed = false;
                }
                other => {
                    if line.len() < BENCH_CONFIRM_MAX_LINE {
                        line.push(other);
                    } else {
                        overflowed = true;
                    }
                }
            },
            Ok(_) => FreeRtos::delay_ms(20),
            Err(err) if matches!(err.kind(), ErrorKind::WouldBlock | ErrorKind::Interrupted) => {
                FreeRtos::delay_ms(20);
            }
            Err(err) => {
                log::error!("servo_bench_test_console_read_failed error={err}");
                return false;
            }
        }
    }
}

/// Health snapshot を 1 行の JSON として log へ出す。
///
/// `crates/deskcat-protocol` の `Status` をそのまま serialize する。
/// **これが「counter schema を protocol status へ使用できる」ことの実物である。**
/// 出力するのは `status` の payload であり、envelope を付けた wire line ではない
/// （health snapshotをwireへ送るにはsessionが要る。#12。Pi linkの`boot`用に選ぶ`sid`は
/// `generate_sid`参照。両者は別の判断である）。
///
/// Pi linkのUARTの観測（`crate::health::UartObservations`）も同じ行に出し、受信を読みに行く
/// 間隔の最大値（`max_read_gap_ms`）はこの行を出すたびに0へ戻す。
///
/// **error を握りつぶさない。**serialize は事実上失敗しないが、`expect()` で潰さず
/// 分類して log し、counter を進める。
fn emit_health_snapshot(
    health: &mut Health,
    now: u64,
    limiter: Option<deskcat_servo::LimiterCounters>,
) {
    let status = health.to_status(limiter);
    let uart = health.uart();
    match serde_json::to_string(&status) {
        Ok(payload) => log::info!(
            "health uptime_ms={now} overrun_ticks={} snapshot_errors={} pi_uart_rx_buffer_full={} pi_uart_rx_fifo_overflow={} max_read_gap_ms={} status={payload}",
            health.overrun_ticks(),
            health.snapshot_errors(),
            uart.rx_buffer_full,
            uart.rx_fifo_overflow,
            uart.max_read_gap_ms,
        ),
        Err(err) => {
            health.record_snapshot_error();
            log::warn!(
                "health_snapshot_serialize_failed uptime_ms={now} snapshot_errors={} error={err}",
                health.snapshot_errors()
            );
        }
    }
    // 次の行の`max_read_gap_ms`は、この行から後の最大値にする。
    health.uart_mut().max_read_gap_ms = 0;
}
