wachi-yoshitaka-11-dev/deskcat/crates/deskcat-serial/src/config.rs

//! Serial linkの設定値。
//!
//! **port名とbaudはsecretではなく設定として扱う**（Issue #11の受け入れ条件）。
//! このcrateは値を埋め込まず、呼び出し側から受け取る。
//!
//! `deskcat-config`（型付き設定と検証）は未作成である。将来そちらへ移す前提で、
//! 当面はこのcrate内に置く。移すときも、**既定値を持たないfieldがどれか**という
//! 性質は保つ。

use core::num::NonZeroUsize;
use core::time::Duration;

/// 設定値が不正であること。
///
/// **panicにしない。**これらは呼び出し側から渡る値であり、`assert!`で落とすと
/// host processごと終わる。分類して返し、初期化側がlogとcounterへ落とせるように
/// する（AGENTS.mdの「エラーを握りつぶさず、分類、ログ、カウンタを用意する」）。
#[derive(Debug, Clone, Copy, PartialEq, Eq)]
#[non_exhaustive]
pub enum ConfigError {
    /// port pathが空である。
    EmptyPort,
    /// baudが0である。
    ZeroBaud,
    /// 送信queueの容量が0である。0容量のqueueは送信を常にdropする。
    ZeroOutboxCapacity,
    /// backoffの初期値が0である。**0にするとrate limitが実質的に無くなる。**
    ZeroInitialBackoff,
    /// backoffの初期値が上限を超えている。
    BackoffBoundsInverted,
    /// ACK timeoutが0である。**0にすると、ACKを受け取る前に即timeoutし、
    /// 送るそばから再送することになる。**
    ZeroAckTimeout,
    /// duplicate履歴の保持件数が0である。**0にすると、処理した直後の再送も
    /// 履歴に無く、保持した結果をreplayできない。**
    ZeroDuplicateCapacity,
    /// duplicate履歴の保持期間が0である。0件と同じく、記録した結果が即座に失われる。
    ZeroDuplicateRetention,
}

impl core::fmt::Display for ConfigError {
    fn fmt(&self, f: &mut core::fmt::Formatter<'_>) -> core::fmt::Result {
        let text = match self {
            Self::EmptyPort => "port pathが空である",
            Self::ZeroBaud => "baudが0である",
            Self::ZeroOutboxCapacity => "送信queueの容量が0である",
            Self::ZeroInitialBackoff => "backoffの初期値が0である",
            Self::BackoffBoundsInverted => "backoffの初期値が上限を超えている",
            Self::ZeroAckTimeout => "ACK timeoutが0である",
            Self::ZeroDuplicateCapacity => "duplicate履歴の保持件数が0である",
            Self::ZeroDuplicateRetention => "duplicate履歴の保持期間が0である",
        };
        f.write_str(text)
    }
}

impl core::error::Error for ConfigError {}

/// Serial linkのport設定。
///
/// **既定値を持たない。**`Default`を実装していないのは意図的である。
/// device名（`/dev/serial0`など）を「たぶんこれ」で埋めると、確認していない値が
/// 設定の既定として固定される。`/dev/serial0`が`ttyAMA0`を指すことは`docs/hardware/experiment-log.md`の`EXP-020`で確かめたが、
/// 開けることとUARTでの通信は確認されていない
/// （[Issue #8]の受け入れ条件に含まれず、確定は[Issue #11]の後半に残る）。
///
/// baudも同様に呼び出し側が渡す。仕様§2の`115200`は`Candidate`であり、
/// 確定値は`PROTO-TBD-001`である。
///
/// [Issue #8]: https://github.com/wachi-yoshitaka-11-dev/deskcat/issues/8
/// [Issue #11]: https://github.com/wachi-yoshitaka-11-dev/deskcat/issues/11
#[derive(Debug, Clone, PartialEq, Eq)]
pub struct SerialConfig {
    /// Serial deviceのpath。
    ///
    /// **この型は値を保持するだけである。**openするのは
    /// [`SerialDevice::open`](crate::SerialDevice::open)であり、そちらがこのpathを使う。
    port: String,
    /// Baud rate。確定値は`PROTO-TBD-001`。
    baud: u32,
    /// 送信queueの容量（message数）。**型として0を排除する。**
    outbox_capacity: NonZeroUsize,
    /// 再接続の方針。
    reconnect: ReconnectPolicy,
    /// ACK timeoutと再送の方針。
    retry: RetryPolicy,
}

impl SerialConfig {
    /// port名とbaudを指定して設定を作る。
    ///
    /// `outbox_capacity`と`reconnect`は[`Self::with_outbox_capacity`]と
    /// [`Self::with_reconnect`]で置き換える。既定は[`ReconnectPolicy::provisional`]と
    /// [`Self::DEFAULT_OUTBOX_CAPACITY`]であり、**いずれも暫定値である。**
    ///
    /// # Errors
    ///
    /// `port`が空なら[`ConfigError::EmptyPort`]、`baud`が0なら
    /// [`ConfigError::ZeroBaud`]を返す。**panicしない。**呼び出し側から渡る値を
    /// processの終了で扱わない。
    pub fn new(port: impl Into<String>, baud: u32) -> Result<Self, ConfigError> {
        let port = port.into();
        if port.is_empty() {
            return Err(ConfigError::EmptyPort);
        }
        if baud == 0 {
            return Err(ConfigError::ZeroBaud);
        }
        Ok(Self {
            port,
            baud,
            outbox_capacity: Self::DEFAULT_OUTBOX_CAPACITY,
            reconnect: ReconnectPolicy::provisional(),
            retry: RetryPolicy::provisional(),
        })
    }

    /// 送信queue容量の暫定既定値。
    ///
    /// **正本は`PROTO-TBD-012`（応答の送出上限と保留table）であり、負荷試験待ちである。**
    /// この値は「上限が存在する」という性質を満たすための暫定値であって、
    /// 測定に基づく確定値ではない。
    pub const DEFAULT_OUTBOX_CAPACITY: NonZeroUsize = NonZeroUsize::new(32).expect("32は0ではない");

    /// 送信queueの容量を差し替える。
    ///
    /// # Errors
    ///
    /// `capacity`が0なら[`ConfigError::ZeroOutboxCapacity`]を返す。
    /// 0容量のqueueは送信を常にdropする。
    pub fn with_outbox_capacity(mut self, capacity: usize) -> Result<Self, ConfigError> {
        self.outbox_capacity =
            NonZeroUsize::new(capacity).ok_or(ConfigError::ZeroOutboxCapacity)?;
        Ok(self)
    }

    /// 再接続方針を差し替える。
    #[must_use]
    pub fn with_reconnect(mut self, reconnect: ReconnectPolicy) -> Self {
        self.reconnect = reconnect;
        self
    }

    /// ACK timeoutと再送の方針を差し替える。
    #[must_use]
    pub fn with_retry(mut self, retry: RetryPolicy) -> Self {
        self.retry = retry;
        self
    }

    /// Serial deviceのpath。
    #[must_use]
    pub fn port(&self) -> &str {
        &self.port
    }

    /// Baud rate。
    #[must_use]
    pub const fn baud(&self) -> u32 {
        self.baud
    }

    /// 送信queueの容量。**0になりえない型で返す。**
    #[must_use]
    pub const fn outbox_capacity(&self) -> NonZeroUsize {
        self.outbox_capacity
    }

    /// 再接続方針。
    #[must_use]
    pub const fn reconnect(&self) -> &ReconnectPolicy {
        &self.reconnect
    }

    /// ACK timeoutと再送の方針。
    #[must_use]
    pub const fn retry(&self) -> &RetryPolicy {
        &self.retry
    }
}

/// 再接続の上限とrate limit。
///
/// **受け入れ条件は「Reconnectに上限とrate limitがある」ことであり、
/// 具体的な数値はこのcrateが決めない。**正本は`PROTO-TBD-017`（`boot`再送契約の
/// parameter）と`PROTO-TBD-012`（cooldownと送出上限）であり、
/// **どちらも負荷試験・reconnect試験待ちである。**
///
/// [`Self::provisional`]が返す値は暫定であり、確定値として扱わない。
#[derive(Debug, Clone, PartialEq, Eq)]
pub struct ReconnectPolicy {
    max_attempts: u32,
    initial_backoff: Duration,
    max_backoff: Duration,
}

impl ReconnectPolicy {
    /// 上限とbackoffを指定して方針を作る。
    ///
    /// # Errors
    ///
    /// `initial_backoff`が0なら[`ConfigError::ZeroInitialBackoff`]を返す。
    /// **0を許すと[`Self::backoff`]が常に0を返し、rate limitが消える。**
    /// `initial_backoff`が`max_backoff`を超える場合は
    /// [`ConfigError::BackoffBoundsInverted`]を返す。
    pub fn new(
        max_attempts: u32,
        initial_backoff: Duration,
        max_backoff: Duration,
    ) -> Result<Self, ConfigError> {
        if initial_backoff.is_zero() {
            return Err(ConfigError::ZeroInitialBackoff);
        }
        if initial_backoff > max_backoff {
            return Err(ConfigError::BackoffBoundsInverted);
        }
        Ok(Self {
            max_attempts,
            initial_backoff,
            max_backoff,
        })
    }

    /// 暫定の既定値を返す。
    ///
    /// **確定値ではない。**`PROTO-TBD-017`と`PROTO-TBD-012`が決まるまでの仮置きであり、
    /// 「上限が有限である」「試行間隔が単調に伸びる」という性質だけを満たす。
    /// 数値そのものに根拠は無い。
    #[must_use]
    pub const fn provisional() -> Self {
        // ここの値は規則（初期値が0でなく、上限以下）を満たすことが自明なため、
        // [`Self::new`]を通さず直接組む。**panicしうる経路を作らない。**
        Self {
            max_attempts: 5,
            initial_backoff: Duration::from_millis(100),
            max_backoff: Duration::from_secs(5),
        }
    }

    /// 再接続試行の上限回数。
    #[must_use]
    pub const fn max_attempts(&self) -> u32 {
        self.max_attempts
    }

    /// `attempt`回目（0起点）の試行前に待つ時間。
    ///
    /// `initial_backoff`を2倍ずつ伸ばし、`max_backoff`で頭打ちにする。
    /// これがrate limitである。上限に達した後も一定間隔で試行し続けないよう、
    /// 回数の上限は[`Self::max_attempts`]が別に持つ。
    #[must_use]
    pub fn backoff(&self, attempt: u32) -> Duration {
        let factor = 1_u32.checked_shl(attempt).unwrap_or(u32::MAX);
        self.initial_backoff
            .saturating_mul(factor)
            .min(self.max_backoff)
    }
}

/// ACK timeoutと、同じ`(sid, id)`での再送回数の上限。
///
/// **[`ReconnectPolicy`]とは別の量である。**引き金も単位も違う。前者はtransportの
/// 再接続（portを開き直す回数と間隔）、こちらはmessageの再送（ACKが返らないことの
/// 検知と、同じ`id`での送り直し）を扱う。1つの型に混ぜると、片方の暫定値を
/// 動かしたときにもう片方が巻き添えになる。
///
/// **2つの値の確定状況は異なる。**ACK timeoutの数値は`PROTO-TBD-004`が未確定であり、
/// [`Self::provisional`]の`ack_timeout`は暫定値である。一方、再送回数の上限は
/// `docs/protocol/esp32-pi-protocol.md`§9のDraft 2 policyが「ACKが必要なcommandは
/// timeout後に1回retryする」と既に確定している（`boot`は対象外。§4.1に従う）。
/// `ping`／`get_status`はどちらもACKを要する通常commandであり、この1回制限の
/// 対象である。`PROTO-TBD-011`の最大retry回数は`hello`専用であり、ここには
/// 当たらない（同TBDの定義、および§3.1「`boot`の無応答時はこの`hello`規則ではなく
/// §4.1に従う」の記述参照——この一文が、§3.1の規則自体は`hello`のものであり
/// `boot`は対象外であることを裏づける）。
#[derive(Debug, Clone, PartialEq, Eq)]
pub struct RetryPolicy {
    ack_timeout: Duration,
    max_retries: u32,
}

impl RetryPolicy {
    /// ACK timeoutと再送回数の上限を指定して方針を作る。
    ///
    /// # Errors
    ///
    /// `ack_timeout`が0なら[`ConfigError::ZeroAckTimeout`]を返す。
    pub fn new(ack_timeout: Duration, max_retries: u32) -> Result<Self, ConfigError> {
        if ack_timeout.is_zero() {
            return Err(ConfigError::ZeroAckTimeout);
        }
        Ok(Self {
            ack_timeout,
            max_retries,
        })
    }

    /// 既定値を返す。
    ///
    /// **`ack_timeout`は暫定値であり、確定値ではない。**`PROTO-TBD-004`が
    /// 決まるまでの仮置きであり、数値そのものに根拠は無い。
    ///
    /// **`max_retries`は確定値である。**`docs/protocol/esp32-pi-protocol.md`§9が
    /// 定める「ACKが必要なcommandはtimeout後に1回retryする」に従う（`ping`／
    /// `get_status`はどちらもこれに当たる）。
    #[must_use]
    pub const fn provisional() -> Self {
        // [`ReconnectPolicy::provisional`]と同じ理由で、[`Self::new`]を通さず直接組む。
        Self {
            ack_timeout: Duration::from_millis(500),
            max_retries: 1,
        }
    }

    /// ACKを待つ時間。この時間を過ぎても届かなければ、同じ`id`で再送してよい。
    #[must_use]
    pub const fn ack_timeout(&self) -> Duration {
        self.ack_timeout
    }

    /// 同じ`(sid, id)`での再送回数の上限。これを使い切ったら取り下げる。
    #[must_use]
    pub const fn max_retries(&self) -> u32 {
        self.max_retries
    }
}

/// 現在sessionのduplicate履歴の保持件数と保持期間（§9、`PROTO-TBD-005`）。
///
/// **定義は`deskcat_protocol::DuplicatePolicy`にある**（Issue #19で、hostとfirmwareが共用する
/// ために移した）。以前のpath（`deskcat_serial::config::DuplicatePolicy`）を保つためにre-exportする。
/// **既定値を持たない**ことも、[`ReconnectPolicy::provisional`]や[`RetryPolicy::provisional`]の
/// ような仮の値を持たないことも、移す前と同じである。
/// **`DuplicatePolicy::new`のerror型は、[`ConfigError`]から`deskcat_protocol::DuplicatePolicyError`に
/// 変わった。**[`ConfigError`]が要る呼び出し側は、下の`From`で変換する（`?`、`map_err(ConfigError::from)`）。
pub use deskcat_protocol::DuplicatePolicy;

/// `DuplicatePolicy::new`の拒否（`deskcat_protocol::DuplicatePolicyError`）を、このcrateの
/// [`ConfigError`]の同名の2つへ写す。種類は変えない。
impl From<deskcat_protocol::DuplicatePolicyError> for ConfigError {
    fn from(err: deskcat_protocol::DuplicatePolicyError) -> Self {
        match err {
            deskcat_protocol::DuplicatePolicyError::ZeroDuplicateCapacity => {
                Self::ZeroDuplicateCapacity
            }
            deskcat_protocol::DuplicatePolicyError::ZeroDuplicateRetention => {
                Self::ZeroDuplicateRetention
            }
        }
    }
}

#[cfg(test)]
mod tests {
    use core::time::Duration;

    use super::{ConfigError, DuplicatePolicy, RetryPolicy};

    /// `max_retries`は§9のDraft 2 policy（「ACKが必要なcommandはtimeout後に
    /// 1回retryする」）が確定した値であり、`PROTO-TBD-011`（`hello`専用）待ちの
    /// 暫定値ではない。当初この値を誤って暫定扱い（5）にしていた回帰を防ぐ。
    #[test]
    fn provisional_max_retries_matches_the_confirmed_protocol_value() {
        assert_eq!(
            RetryPolicy::provisional().max_retries(),
            1,
            "§9のDraft 2 policyが確定した値"
        );
    }

    /// 保持件数・保持期間の0は、どちらも記録した結果を即座に失う設定であり、受け付けない。
    #[test]
    fn a_duplicate_policy_rejects_zero_capacity_and_zero_retention() {
        assert_eq!(
            DuplicatePolicy::new(0, Duration::from_secs(1)).map_err(ConfigError::from),
            Err(ConfigError::ZeroDuplicateCapacity)
        );
        assert_eq!(
            DuplicatePolicy::new(1, Duration::ZERO).map_err(ConfigError::from),
            Err(ConfigError::ZeroDuplicateRetention)
        );
        assert!(DuplicatePolicy::new(1, Duration::from_millis(1)).is_ok());
    }
}
