wachi-yoshitaka-11-dev/deskcat/crates/deskcat-protocol/src/decode.rs

//! 1 lineのdecodeとencode。
//!
//! 検証の順序は`docs/protocol/esp32-pi-protocol.md` §8手順7および§5.1
//! 「遷移は完全な検証を通してから確定する」の手順1〜3に一致させる。
//! **順序自体がconformanceの対象**であり、入れ替えると返すべきcodeが変わる。

use std::borrow::Cow;

use serde::{Deserialize, Serialize};
use serde_json::value::RawValue;

use crate::envelope::{Envelope, Frame};
use crate::error::{DecodeError, ErrorCode};
use crate::limits;
use crate::message::{
    Ack, Boot, Environment, HeadTouched, Hello, Lifted, Message, PlayMotion, SetExpression,
    ShowText, Status,
};

/// envelopeだけを解釈し、payloadは未解釈のまま保持する中間表現。
///
/// payloadを[`RawValue`]で受けるのは、`unknown_type`と`invalid_payload`を区別するためである。
/// serdeのadjacently tagged enum（`#[serde(tag = "type", content = "payload")]`）では
/// 失敗理由が「どのvariantにも一致しない」に潰れ、§8手順7が要求する
/// 「typeに対応するschemaが解決できない時点で拒否する」を表現できない。
#[derive(Deserialize)]
struct RawEnvelope<'a> {
    v: u16,
    sid: u32,
    id: u32,
    ts_ms: u64,
    /// `&str`ではなく[`Cow`]で受ける。escape sequenceを含むJSON stringは借用できず、
    /// `&str`で受けると`invalid_envelope`になってしまう。escapeの有無で同じtypeの
    /// 判定が変わるのは、仕様上の根拠がない。
    #[serde(rename = "type", borrow)]
    type_name: Cow<'a, str>,
    #[serde(borrow)]
    payload: &'a RawValue,
}

/// encode時のwire表現。field順が§3の例と一致するよう宣言順を保つ。
#[derive(Serialize)]
struct WireEnvelope<'a> {
    v: u16,
    sid: u32,
    id: u32,
    ts_ms: u64,
    #[serde(rename = "type")]
    type_name: &'a str,
    payload: &'a RawValue,
}

/// 1 lineをdecodeする。
///
/// 入力は改行を含んでも含まなくてもよい。含まない場合も、[`limits::MAX_LINE_BYTES`]の
/// 判定では改行1 byteを加えて数える。§2の「受信可能なline ending」に従い、末尾の`\n`と
/// その直前の`\r`は取り除く。
///
/// byte列としての受信、分割されたlineの結合、invalid UTF-8の分類はこの関数の外側であり、
/// [`crate::receiver::LineReceiver`]が扱う。**この関数は`&str`を取る。**byte列から`str`への
/// 境界はreceiver側にある。
///
/// # 検証順序
///
/// | # | 判定 | 失敗時のcode |
/// |---|---|---|
/// | 1 | 改行を含むline長 | [`ErrorCode::LineTooLong`] |
/// | 2 | JSONとして解析でき、envelope fieldが型どおり | [`ErrorCode::InvalidEnvelope`] |
/// | 3 | `payload`がobject | [`ErrorCode::InvalidEnvelope`] |
/// | 4 | `v`が対応major version | [`ErrorCode::UnsupportedVersion`] |
/// | 5 | `type`が既知 | [`ErrorCode::UnknownType`] |
/// | 6 | type固有payload schemaと、field間の整合（`Message::check_shape`） | [`ErrorCode::InvalidPayload`] |
/// | 7 | 上限のある値の範囲（[`Message::check_bounds`]） | [`ErrorCode::OutOfRange`] |
///
/// 手順6と7は[`encode_line`]も同じ関数で行う。**送信側と受信側で規則を二重実装しない。**
///
/// # 分類であって、送出の判断ではない
///
/// 返す[`ErrorCode`]は**分類**である。そのcodeを相手へ返すかどうかはこの関数では決まらない。
/// 送出の可否は方向（§8の拒否時の動作）と§8.2の送出上限に従い、session stateを持つ
/// 呼び出し側（Issue #11、#12）が判断する。とくに次の2つは、分類できても応答しない場合がある。
///
/// - [`ErrorCode::LineTooLong`]は、§7により`(sid, id)`を**復元できた場合にだけ**返してよい。
///   復元は上限付きprefix（`PROTO-TBD-002`）に対して行う。**この関数はprefixからの
///   identity復元を行わない。**行全体を受け取る以上、上限を超えた行のどこまでを保持するかは
///   byte受信を持つ層の判断だからである。復元は[`crate::receiver::LineReceiver`]が行い、
///   結果を[`crate::receiver::Rejection::identity`]で返す。復元できなければ、呼び出し側は
///   応答せず`oversize_lines`の計数だけを行う。
///   なお[`crate::receiver::LineReceiver::with_protocol_limit`]の容量では、この関数の
///   行長判定へ到達しない。receiver側が先に検知するためである。
/// - [`ErrorCode::UnknownType`]は、§3によりPi→ESP32でidentityを復元できる場合に相関ACKを
///   返し、ESP32→Piでは応答せず計数だけを行う。方向はこの関数の入力に含まれない。
///
/// # Errors
///
/// 上表のいずれかに違反した場合、対応する[`ErrorCode`]を持つ[`DecodeError`]を返す。
pub fn decode_line(line: &str) -> Result<Frame, DecodeError> {
    let wire_len = if line.ends_with('\n') {
        line.len()
    } else {
        line.len() + 1
    };
    if wire_len > limits::MAX_LINE_BYTES {
        return Err(DecodeError::new(
            ErrorCode::LineTooLong,
            format!(
                "line is {wire_len} bytes including the newline, limit is {}",
                limits::MAX_LINE_BYTES
            ),
        ));
    }

    let body = line.strip_suffix('\n').unwrap_or(line);
    let body = body.strip_suffix('\r').unwrap_or(body);

    let raw: RawEnvelope<'_> = serde_json::from_str(body)
        .map_err(|err| DecodeError::new(ErrorCode::InvalidEnvelope, err.to_string()))?;

    if !payload_is_object(raw.payload) {
        return Err(DecodeError::new(
            ErrorCode::InvalidEnvelope,
            "`payload` must be an object; use `{}` instead of `null` for an empty payload",
        ));
    }

    if raw.v != limits::PROTOCOL_VERSION {
        return Err(DecodeError::new(
            ErrorCode::UnsupportedVersion,
            format!(
                "`v` is {}, this implementation accepts {}",
                raw.v,
                limits::PROTOCOL_VERSION
            ),
        ));
    }

    let message = decode_payload(raw.type_name.as_ref(), raw.payload)?;
    message.check_shape()?;
    message.check_bounds()?;

    Ok(Frame::new(
        Envelope {
            v: raw.v,
            sid: raw.sid,
            id: raw.id,
            ts_ms: raw.ts_ms,
        },
        message,
    ))
}

/// `type`を既知typeへ解決し、そのschemaでpayloadをdeserializeする。
fn decode_payload(type_name: &str, payload: &RawValue) -> Result<Message, DecodeError> {
    match type_name {
        "boot" => parse::<Boot>(payload).map(Message::Boot),
        "hello" => parse::<Hello>(payload).map(Message::Hello),
        "ping" => parse_empty(payload).map(|()| Message::Ping),
        "get_status" => parse_empty(payload).map(|()| Message::GetStatus),
        "status" => parse::<Status>(payload).map(|status| Message::Status(Box::new(status))),
        "ack" => parse::<Ack>(payload).map(Message::Ack),
        "set_expression" => parse::<SetExpression>(payload).map(Message::SetExpression),
        "show_text" => parse::<ShowText>(payload).map(Message::ShowText),
        "head_touched" => parse::<HeadTouched>(payload).map(Message::HeadTouched),
        "tapped" => parse_empty(payload).map(|()| Message::Tapped),
        "shaken" => parse_empty(payload).map(|()| Message::Shaken),
        "lifted" => parse::<Lifted>(payload).map(Message::Lifted),
        "environment" => parse::<Environment>(payload).map(Message::Environment),
        "play_motion" => parse::<PlayMotion>(payload).map(Message::PlayMotion),
        unknown => Err(DecodeError::new(
            ErrorCode::UnknownType,
            format!("unknown message type `{unknown}`"),
        )),
    }
}

/// type固有schemaでpayloadを解釈する。未知の追加fieldは§3に従って無視する。
fn parse<T: serde::de::DeserializeOwned>(payload: &RawValue) -> Result<T, DecodeError> {
    serde_json::from_str(payload.get())
        .map_err(|err| DecodeError::new(ErrorCode::InvalidPayload, err.to_string()))
}

/// payloadを持たないtypeを検査する。objectであることは呼び出し前に確認済みである。
fn parse_empty(payload: &RawValue) -> Result<(), DecodeError> {
    serde_json::from_str::<serde::de::IgnoredAny>(payload.get())
        .map(|_| ())
        .map_err(|err| DecodeError::new(ErrorCode::InvalidPayload, err.to_string()))
}

/// raw payloadがJSON objectかを判定する。
fn payload_is_object(payload: &RawValue) -> bool {
    payload.get().trim_start().starts_with('{')
}

/// frameを1 lineへencodeする。末尾に`\n`を付ける。
///
/// field順は§3の例と同じ`v`、`sid`、`id`、`ts_ms`、`type`、`payload`になる。
///
/// # 送信前の検証
///
/// serializeの前に`Message::check_shape`（crate内部）と[`Message::check_bounds`]を、
/// **[`decode_line`]の手順6→7と同じ順で**呼ぶ。この関数が、自分のdecoderが受理しない
/// frameをwireへ出さないための検査である。
///
/// 順序を揃えるのは、両方に違反するframeで返るcodeを送受信で一致させるためである。
/// 逆順にすると、`rejected`かつ`code`無しで`detail`も上限超過のACKが、encodeでは
/// [`ErrorCode::OutOfRange`]、decodeでは[`ErrorCode::InvalidPayload`]になる。
///
/// 行長は最後に見る。escapeで膨らむ分はserializeしないと分からないためであり、
/// field上限を満たしても行長を超えることがある（[`limits`]のmodule doc）。
///
/// # Errors
///
/// field間の整合に違反する場合は[`ErrorCode::InvalidPayload`]、上限のある値が範囲外の
/// 場合は[`ErrorCode::OutOfRange`]を返す。encode結果が[`limits::MAX_LINE_BYTES`]を
/// 超える場合は[`ErrorCode::LineTooLong`]を返す。payloadのserializeに失敗した場合は
/// [`ErrorCode::InvalidPayload`]を返す。
pub fn encode_line(frame: &Frame) -> Result<String, DecodeError> {
    frame.message.check_shape()?;
    frame.message.check_bounds()?;

    let payload = encode_payload(&frame.message)?;
    let payload = RawValue::from_string(payload)
        .map_err(|err| DecodeError::new(ErrorCode::InvalidPayload, err.to_string()))?;

    let wire = WireEnvelope {
        v: frame.envelope.v,
        sid: frame.envelope.sid,
        id: frame.envelope.id,
        ts_ms: frame.envelope.ts_ms,
        type_name: frame.message.type_str(),
        payload: &payload,
    };

    let mut line = serde_json::to_string(&wire)
        .map_err(|err| DecodeError::new(ErrorCode::InvalidPayload, err.to_string()))?;
    line.push('\n');

    if line.len() > limits::MAX_LINE_BYTES {
        return Err(DecodeError::new(
            ErrorCode::LineTooLong,
            format!(
                "encoded line is {} bytes including the newline, limit is {}",
                line.len(),
                limits::MAX_LINE_BYTES
            ),
        ));
    }

    Ok(line)
}

/// type固有payloadをJSON文字列へserializeする。
fn encode_payload(message: &Message) -> Result<String, DecodeError> {
    let result = match message {
        Message::Boot(boot) => serde_json::to_string(boot),
        Message::Hello(hello) => serde_json::to_string(hello),
        Message::Ping | Message::GetStatus | Message::Tapped | Message::Shaken => {
            Ok("{}".to_owned())
        }
        Message::Status(status) => serde_json::to_string(status),
        Message::Ack(ack) => serde_json::to_string(ack),
        Message::SetExpression(set_expression) => serde_json::to_string(set_expression),
        Message::ShowText(show_text) => serde_json::to_string(show_text),
        Message::HeadTouched(head_touched) => serde_json::to_string(head_touched),
        Message::Lifted(lifted) => serde_json::to_string(lifted),
        Message::Environment(environment) => serde_json::to_string(environment),
        Message::PlayMotion(play_motion) => serde_json::to_string(play_motion),
    };
    result.map_err(|err| DecodeError::new(ErrorCode::InvalidPayload, err.to_string()))
}
