wachi-yoshitaka-11-dev/deskcat/crates/deskcat-tap/src/shake.rs

//! `ACCEL-01`（ADXL345）の揺れの検出（`shaken`。Protocol §4.3a。Issue #685）。
//!
//! tapと同じく、I2Cを知らない。Activityの設定の(address, 値)の列と、`INT_SOURCE`のActivity bitの読み方と、
//! 「窓の中でActivityがN回立ったら揺れ」の判定と、送出の条件を返すだけである（I2Cを動かすのは`firmware/esp32`の`crate::tap`）。
//!
//! # 方式
//!
//! ADXL345のActivityは、`THRESH_ACT`を超える加速度が参加軸のどれかに出たときに`INT_SOURCE`のD4を立てる（読むまで残る）。
//! **tapが読んでいる`INT_SOURCE`と同じ1回のreadでActivityも取れる**ので、I2Cの読みは増えず、tapの検出は遅れない。
//! 1回の叩きでもActivityは1回立ちうるため、**窓の中で[`ShakeConfig::required_hits`]回（2以上）立ったときだけ揺れとする**。
//!
//! # 出所
//!
//! `THRESH_ACT`（address 0x24、unsigned、62.5 mg/LSB、0は予期しない動作になりうる）、`ACT_INACT_CTL`（address 0x27。D7が
//! ACT ac/dc、D6〜D4がACT_X／Y／Z enable）、`INT_ENABLE`と`INT_SOURCE`のD4（Activity）は、**Analog Devices ADXL345 Data Sheet
//! Rev. E**（`datasheet.octopart.com`が配る販売店の写し。2026-11-11にPDFから文字を抽出して読んだ）による。
//! **公式のRev. Gとは照合していない**（CLIから取得できない）。`docs/hardware/sensor-datasheet-notes.md`にも同じことを書いた。
//!
//! # 値の扱い
//!
//! **値は全て`TBD`である。**[`SHAKE`]が`None`の間は、揺れの検出を有効にしない（Activityの設定を書かず、`INT_ENABLE`はtapだけのまま、
//! eventを送らない）。値は実機で決める（机とサーボの振動の試料は#15の受け入れ条件の後）。値は安全要件の5項目に効かない
//! （外れても、揺れの誤検出か検出漏れになるだけで、何も壊れない）。

use crate::{
    BW_RATE_100_HZ, DUR, INT_ENABLE_SINGLE_TAP, POWER_CTL_MEASURE, REG_BW_RATE, REG_DUR,
    REG_INT_ENABLE, REG_POWER_CTL, REG_TAP_AXES, REG_THRESH_TAP, TAP_AXES, THRESH_TAP,
};

/// `THRESH_ACT`（address 0x24）。Activityの閾値。unsigned、62.5 mg/LSB。
pub const REG_THRESH_ACT: u8 = 0x24;
/// `ACT_INACT_CTL`（address 0x27）。D7がACT ac/dc（1でac結合）、D6〜D4がACT_X／Y／Zの有効。
pub const REG_ACT_INACT_CTL: u8 = 0x27;
/// `ACT_INACT_CTL`のD6〜D4（ACT_X／Y／Z enable）。
pub const ACT_AXES_MASK: u8 = 0b0111_0000;
/// `INT_ENABLE`のD4（Activity）。
pub const INT_ENABLE_ACTIVITY: u8 = 1 << 4;
/// `INT_SOURCE`のD4（Activity）。
pub const INT_SOURCE_ACTIVITY: u8 = 1 << 4;

/// `INT_SOURCE`のbyteが、Activityを示すか。
#[must_use]
pub const fn is_activity(int_source: u8) -> bool {
    int_source & INT_SOURCE_ACTIVITY != 0
}

/// 揺れの検出の設定。**全ての値が`TBD`である**（[`SHAKE`]）。
#[derive(Debug, Clone, Copy, PartialEq, Eq)]
pub struct ShakeConfig {
    /// `THRESH_ACT`。62.5 mg/LSB。0は不可。
    pub thresh_act: u8,
    /// `ACT_INACT_CTL`。ac/dcと軸。ACTの軸（[`ACT_AXES_MASK`]）が1つ以上要る。
    pub act_inact_ctl: u8,
    /// 窓の長さ（ms）。最初のActivityからこの時間以内に[`Self::required_hits`]回立たなければ、数え直す。
    pub window_ms: u64,
    /// 揺れとするActivityの回数。**2以上**（1回の叩きでもActivityは立ちうるため）。
    pub required_hits: u32,
    /// `shaken`を続けて送る最小の間隔（ms）。
    pub min_interval_ms: u64,
}

impl ShakeConfig {
    /// 値が使える形か。`THRESH_ACT`が0でなく、ACTの軸が1つ以上あり、窓が正で、回数が2以上であること。
    #[must_use]
    pub const fn is_valid(&self) -> bool {
        self.thresh_act != 0
            && self.act_inact_ctl & ACT_AXES_MASK != 0
            && self.window_ms > 0
            && self.required_hits >= 2
    }
}

/// 揺れの検出の値。**`None`は`TBD`で、揺れの検出を有効にしない**（Activityの設定を書かず、eventを送らない。今の挙動と同じ）。
/// 値は実機で決める。値を入れる変更は、実機の確認の後にする。
pub const SHAKE: Option<ShakeConfig> = None;

/// 検出に使える設定。`SHAKE`が`None`か、値が使えない形（[`ShakeConfig::is_valid`]）なら`None`。
#[must_use]
pub fn active(config: Option<ShakeConfig>) -> Option<ShakeConfig> {
    config.filter(ShakeConfig::is_valid)
}

/// 検出を始めるために書く(address, 値)の列（[`registers`]が返す）。最大8件。
#[derive(Debug, Clone, Copy, PartialEq, Eq)]
pub struct Writes {
    buf: [(u8, u8); 8],
    len: usize,
}

impl Writes {
    const fn new() -> Self {
        Self {
            buf: [(0, 0); 8],
            len: 0,
        }
    }

    fn push(&mut self, write: (u8, u8)) {
        self.buf[self.len] = write;
        self.len += 1;
    }

    /// 書く順の列。
    #[must_use]
    pub fn as_slice(&self) -> &[(u8, u8)] {
        &self.buf[..self.len]
    }
}

/// 検出を始めるために書く(address, 値)の列。**この順に書く。**
/// `shake`が`None`なら[`crate::SETUP`]と同じ（Activityを設定しない）。`Some`なら、`INT_ENABLE`へActivityを足し、
/// `THRESH_ACT`と`ACT_INACT_CTL`を割り込みの有効化より前に書く。**測定を始める書き込みは最後のまま**である。
#[must_use]
pub fn registers(shake: Option<&ShakeConfig>) -> Writes {
    let mut writes = Writes::new();
    writes.push((REG_BW_RATE, BW_RATE_100_HZ));
    writes.push((REG_THRESH_TAP, THRESH_TAP));
    writes.push((REG_DUR, DUR));
    writes.push((REG_TAP_AXES, TAP_AXES));
    let int_enable = match shake {
        Some(config) => {
            writes.push((REG_THRESH_ACT, config.thresh_act));
            writes.push((REG_ACT_INACT_CTL, config.act_inact_ctl));
            INT_ENABLE_SINGLE_TAP | INT_ENABLE_ACTIVITY
        }
        None => INT_ENABLE_SINGLE_TAP,
    };
    writes.push((REG_INT_ENABLE, int_enable));
    writes.push((REG_POWER_CTL, POWER_CTL_MEASURE));
    writes
}

/// Activityを見つけたときの扱い。
#[derive(Debug, Clone, Copy, PartialEq, Eq)]
pub enum ShakeDecision {
    /// まだ回数に届かない。
    Counting,
    /// `shaken`を送る。
    Send,
    /// 揺れと判定したが、bootのACKを受けておらず、Piのsessionが確立していない。捨てる。
    DropNoSession,
    /// 揺れと判定したが、前の`shaken`から[`ShakeConfig::min_interval_ms`]未満である。捨てる。
    DropTooSoon,
}

/// 揺れの扱いの内訳。
#[derive(Debug, Clone, Copy, Default, PartialEq, Eq)]
pub struct ShakeCounters {
    /// 見つけたActivityの数。
    pub activity_hits: u32,
    /// 送ると決めた数（wireへ書けたかは数えない）。
    pub sent: u32,
    /// sessionが確立していない間に揺れと判定して捨てた数。
    pub dropped_no_session: u32,
    /// 間隔が短くて捨てた数。
    pub dropped_too_soon: u32,
}

/// 「窓の中でActivityがN回」を数え、`shaken`を送ってよいかを決める。
///
/// 窓は固定である（最初のActivityから[`ShakeConfig::window_ms`]。過ぎたら数え直し、そのActivityを新しい窓の最初とする）。
/// 揺れと判定したら、送る・捨てるに関わらず数えを0へ戻す。
#[derive(Debug, Clone)]
pub struct ShakeFilter {
    config: ShakeConfig,
    window_start_ms: Option<u64>,
    hits: u32,
    last_sent_ms: Option<u64>,
    counters: ShakeCounters,
}
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
